ciaa/Hardware/README.md

Hardware
========

CIAA Hardware repository. It contains KiCad project files and documentation for each CIAA profile.

Folder structure:

[Doc](Doc): Common documents.

[PCB](PCB): KiCad PCB project files.

--[CIAA-ACC](PCB/ACC/CIAA_ACC): Xilinx Zynq XC7Z030 files.

--[EDU-FSL](PCB/EDU-FSL): EDU-CIAA-FSL (K60 MCU) files.

--[EDU-INTEL](PCB/EDU-INTEL): EDU-CIAA-INTEL (SOM Edison) files.

--[EDU-NXP](PCB/EDU-NXP): EDU-CIAA-NXP (LPC4337 MCU) files.

--[EDU-XILINX](PCB/EDU-XILINX): EDU-CIAA-XILINX (Artix7 FPGA) files.

--[FSL-MINI](PCB/FSL-MINI): CIAA-Freescale (K60 MCU) files.

--[FSL](PCB/FSL): CIAA-Freescale (K60 MCU) files.

--[NXP](PCB/NXP): CIAA-NXP (LPC4337 MCU) files.

--[PIC](PCB/PIC): CIAA-PIC (PIC32 MCU) files.

--[RX](PCB/RX): CIAA-Renesas files.

--[Safety](PCB/Safety): CIAA-Safety (RM48L952-PGE MCU) files.

--[Z3R0](PCB/Z3R0): CIAA-Z3R0 (EFM32HG MCU) files.

--[pico-CIAA](PCB/pico): pico-CIAA (LPC54102 MCU) files.
