ciaa/Hardware/PCB/Z3R0/README.md

# CIAA-Z3R0

Here you will find KiCad design files, [gerber files](gerbers) and [documentation](docs) for this board developed by Eric Pernia.

Also you can visit [CIAA-Z3R0 Wiki Page](http://www.proyecto-ciaa.com.ar/devwiki/doku.php?id=desarrollo:ciaa-z3r0).

 - [Authors](AUTHORS.md).
 - License: [CIAA Hardware license](LICENSE).

## Board description

This board is designed for low cost, low power consumption and robotics applications.

### Schematic

[Schematic in pdf](ciaa-z3r0.pdf)

board schematic

### 3D view

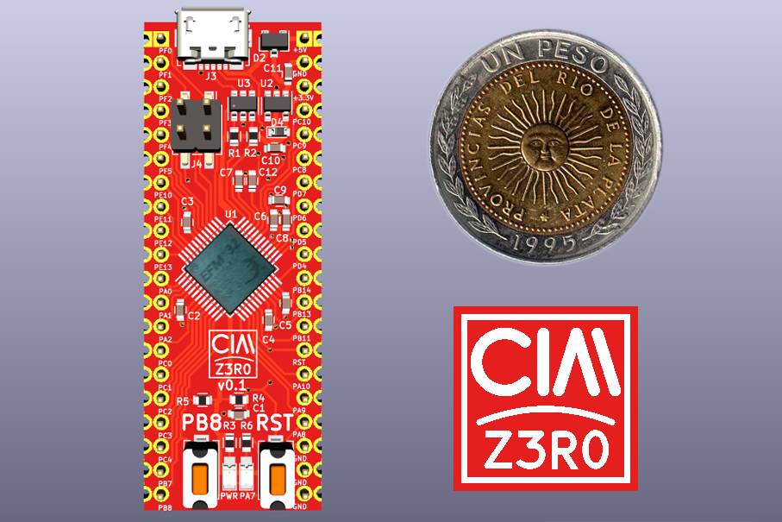
[picture p3: PCB/Z3R0/CIAA-Z3R0.png]
boar dimage
