ciaa/Hardware/PCB/ACC/CIAA_ACC/README.md

# CIAA-ACC

Here you will find KiCad design files, [gerber files](output_files) and some [documentation](doc) for this board
developed by [INTI Argentina](http://www.inti.gob.ar/) - [CMNB](http://www.inti.gob.ar/microynanoelectronica/) with the collaboration of [ACSE](http://www.sase.com.ar/asociacion-civil-sistemas-embebidos), [CADIEEL](http://www.cadieel.org.ar) and [Emtech S.A.](http://www.emtech.com.ar) as part of the [CIAA project](http://www.proyecto-ciaa.com.ar/).
Also you can visit [CIAA-ACC Wiki Page](http://www.proyecto-ciaa.com.ar/devwiki/doku.php?id=desarrollo:ciaa_acc:ciaa_acc_inicio).

 - [Authors](doc/AUTHORS.md).
 - License: [CIAA Hardware license](../../../LICENSE).
