ciaa/Hardware/PCB/FSL/CIAA_K60/doc/entradas_salidas/error_out_an.pdf

### Análsis sobre las salida analógica

El texto aquí presentado, tiene por finalidad analizar el funcionamiento en detalle del circuito de las salidas analógicas, comprender cuales son los elementos que causan el error mayor y elaborar una conclusión que justifique la elección de los componentes.

Circuito a analizar

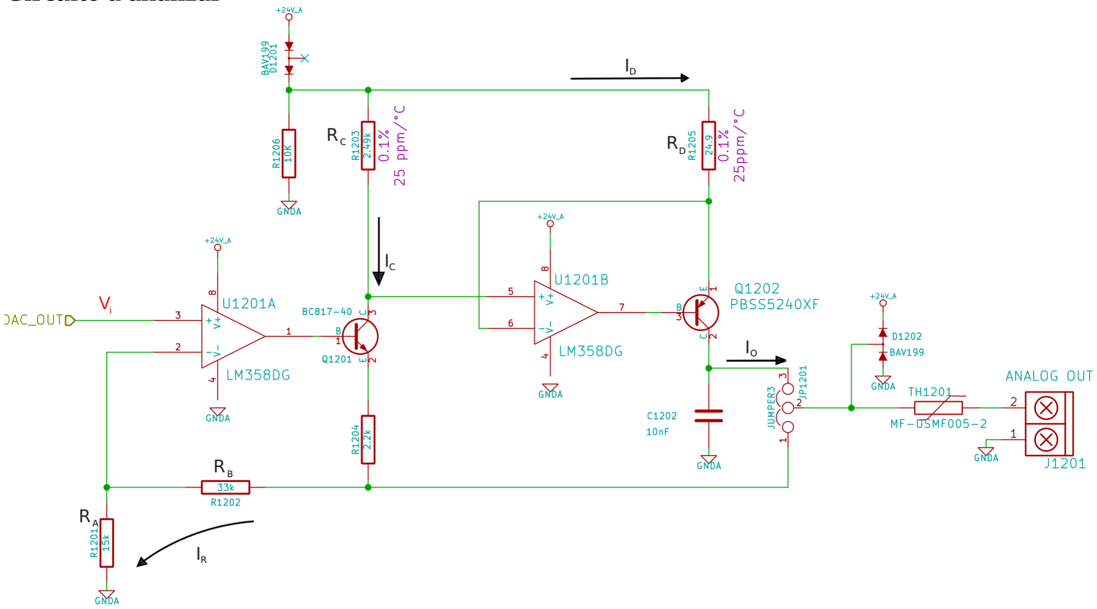
[picture p21: figure]

Si se toma al circuito ideal, pueden encontrarse las siguientes expresiones a través de su análisis:

I R=

Vi
RA
Si se estima que: IC≈I R

VR C=I R RC=VR D=I D RD

I D=I R

RC
RD

=Vi

RC
RA RD
Como I D≈I O

IO=Vi

RC
RA RD

Los 20mA se producen para una tensión de entrada de:

Vi

(20mA)=3V

Los 4 mA se producen para una tensión de entrada de: Vi

(4mA)=0,6V

Estimación de los errores:
A continuación, se resumen los elementos que provocan el mayor error en la conversión tensión/corriente, ya que en la conversión de

Error del DAC:
Teniendo un DAC de 12bit, el paso mínimo, con una tensión de alimentación de 3.3V es de: 805,664 µV. El error inferido por el DAC siempre será de medio bit, para el mejor de los casos, es decir de: 402,832 µV . Este error acompañará a Vi.

Error de Offset de los operacionales:
Para el LM358, a 25ºC, el offset máximo puede llegar a los 7mV.

Dispersión del hFE de los transistores:
El BC817 a 25ºC, tiene un hFE de 400
El PBSS5240XF a 25ºC, tiene un hFE de 450

Calculo real

I R=

Vi±(ΔV DAC+ΔV OP)
RA

Como: I R=

hfe1+1
hfe1

I C=

1
ΔQ1

IC

VR C=I C RC=Q1RC

Vi±(ΔV DAC +ΔV OP)
RA

I D=

V RC±ΔV OP
RD

=

Q1RC

Vi±(ΔV DAC+ΔV OP)
RA

±ΔV OP

RD

Como IO=I D

hfe2+1
hfe2

=I D Q2

IO=

Q1RC

Vi±(ΔV DAC+ΔV OP)
RA

±ΔV OP

RD

Q2

IO=Q1Q2RC

Vi
RA RD

±(Q1Q2

RC
(RA RD
)

(ΔV DAC+ΔV OP)+Q2

ΔV OP
RD

)

Puede verse en esta última expresión, que los transistores bipolares introducen una variación en el valor de la conversión de la corriente.
El corrimiento producido debido a los transistores, respecto al valor ideal absoluto, es:

EIOQ=100 %

Q1Q2RC

Vi
RA RD

−RC

Vi
RA RD

RC

Vi
RA RD

=100%(Q1Q2−1)

EI OQ=0,0278%
Mientras mayor sea el hFE de cada transistor, menor será este error.
Si se hacen las propagaciones de errores sobre la última expresión, se obtiene que el error relativo será:

EI O=

Δ I O
I O

=

Δ RA
RA

+

Δ RC
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
ΔV DAC
Vi

+

ΔV OP
Vi

+

ΔV OP
VR D

El error de cada resitencia será 0,1%, dado por el fabricante. Para los transistores, se sabe que:

Q1=

hfe1
hfe1+1

→

ΔQ1
Q1

=

Δhfe1
hfe1

(hfe1+1)

Si la dispersión del hfe puede causar una variación del 10% en el hfe, el error resulta:

ΔQ1
Q1

=0,025%

Q2=

hfe2+1
hfe2

→

ΔQ2
Q2

=

Δhfe 2
hfe2

(hfe2+1)

Si la dispersión del hfe puede causar una variación del 10% en el hfe, el error resulta:

ΔQ2
Q2

=0,0222%

El error del operacional y del DAC, se da para la mínima tensión de entrada, que son los 0,6V.
ΔV DAC

V DAC

=0,0671 %

ΔV OP
Vi

=1,1667%

ΔV OP
V RD

=

7mV
0,0996V

=7,0281%

El Error total de conversión, para la mínima corriente será:

EIO=

Δ I O
I O

=8,6091 %

Para el valor de máximo de corriente de salida (20mA) el error será:

EIO=

Δ I O
I O

=1,872%

Como puede observarse, todo el error se debe principalemente al operacional utilizado y son más severos mientras menor sea la tensión de entrada.

Conclusión:

En función de la precisión que se requiera en el circuito, deben tomarse precausiones en la elección de los componentes que introducen el mayor el error en la conversión. Ordenandolos según su participación en el error: Operacional, transistores, resolución del DAC .

Todos los errores introducidos por los operacionales y los transistores bipolares pueden reducirse por hardware, pero esto implica una calibración y puesta a punto de cada circuito antes de ser utilizado. Esto puede ser un ajuste mecánico al comienzo de su uso o una calibración por firmware. Una forma de reducir el error, mediante un circuito externo puede verse en:
Nulling Input Offset Voltage of Operational Amplifiers - Texas Instrument: http://www.ti.com/lit/an/sloa045/sloa045.pdf

Sería conveniente, para evitar esta puesta a punto, seleccionar operacionales con un offset de entrada menor a 1mV. Con estos, el error será menor al 2% para el caso más crítico.

También resulta conveniente utilizar FET en vez de BJT, para reducir más aún el error.
Se recomienda la nota
Convert 1 to 5V signal to 4-20mA output – EDN Network http://www.edn.com/design/power-management/4371307/Convert-1-to-5V-signal-to-4-to-20-mA-output (http://www.edn.com/design/power-management/4371307/Convert-1-to-5V-signal-to-4-to-20-mA-output)
