ciaa/Hardware/PCB/ACC/CIAA_ACC/doc/simulaciones/hyperlynx/Batch_report/ciaa_acc-Si.ods

Overview [Pass/Fail] | Net(s) | Coupled Net(s) | Driver(s) [RefDes.Pin] | Receiver [RefDes.Pin] | Simulation Corner | Rise Min Delay [ns] | Rise Max Delay [ns] | Rise Ref Time-to-Vmeas [ns] | Fall Min Delay [ns] | Fall Max Delay [ns] | Fall Ref Time-to-Vmeas [ns] | Flight Time Comp. [Yes/No] | Driver Meas [Pin/Die] | Receiver Meas [Pin/Die] | Diff Meas [Yes/No] | Rise Rail Overshoot [mV] | Rise Rail Overshoot Threshold [mV] | Rise Static Rail Overshoot Limit [mV] | Rise Static Rail Overshoot Margin [mV] | Rise Dynamic Rail Overshoot Limit [mV] | Rise Dynamic Rail Overshoot Margin [mV] | Rise Dynamic Rail Overshoot Time [ps] | Rise Dynamic Rail Overshoot Time Limit [ps] | Rise Dynamic Rail Overshoot Time Margin [ps] | Rise Rail Overshoot [Pass/Fail] | Rise SI Overshoot [mV] | Rise SI Overshoot [Pass/Fail] | Fall Rail Overshoot [mV] | Fall Rail Overshoot Threshold [mV] | Fall Static Rail Overshoot Limit [mV] | Fall Static Rail Overshoot Margin [mV] | Fall Dynamic Rail Overshoot Limit [mV] | Fall Dynamic Rail Overshoot Margin [mV] | Fall Dynamic Rail Overshoot Time [ps] | Fall Dynamic Rail Overshoot Time Limit [ps] | Fall Dynamic Rail Overshoot Time Margin [ps] | Fall Rail Overshoot [Pass/Fail] | Fall SI Overshoot [mV] | Fall SI Overshoot [Pass/Fail] | Ringback Delay [ps] | Rise Closest Ringback [mV] | Rise Closest Ringback Threshold [mV] | Rise Closest Ringback Limit [mV] | Rise Closest Ringback Margin [mV] | Fall Closest Ringback [mV] | Fall Closest Ringback Threshold [mV] | Fall Closest Ringback Limit [mV] | Fall Closest Ringback Margin [mV] | Ringback [Pass/Fail] | Rise/Fall Crosstalk [mV] | Rise/Fall Crosstalk Limit [mV] | Rise/Fall Crosstalk Margin [mV] | Rise/Fall Crosstalk [Pass/Fail] | Rise/Fall Monotonic [Pass/Fail] | Rise/Fall Multi Cross [Pass/Fail] | Rise/Fall Threshold [Pass/Fail] | Rise/Fall Delay Error [Pass/Fail] | Driver Model File | Driver Model Name
Pass | /Principal/BANK_502/DDR_A0 |  | U1.K22 | U2.N3 | Fast-Strong | 0,429 | 0,507 | 0,409 | 0,402 | 0,480 | 0,429 | Yes | Pin | Pin | No | -214 | 1575 | 300 | 514 | NA | NA | NA | NA | NA | Pass | 42 | Pass | -168 | 0 | 300 | 468 | NA | NA | NA | NA | NA | Pass | 39 | Pass | NA | NA | NA | NA | NA | NA | NA | NA | NA | Pass | NA | NA | NA | Pass | Pass | Pass | Pass | Pass | zynq_ddr3_diffpin.ibs | SSTL15_S_PSDDR
Pass | /Principal/BANK_502/DDR_A0 |  | U1.K22 | U3.N3 | Fast-Strong | 0,567 | 0,652 | 0,409 | 0,537 | 0,621 | 0,429 | Yes | Pin | Pin | No | -233 | 1575 | 300 | 533 | NA | NA | NA | NA | NA | Pass | 24 | Pass | -183 | 0 | 300 | 483 | NA | NA | NA | NA | NA | Pass | 25 | Pass | NA | NA | NA | NA | NA | NA | NA | NA | NA | Pass | NA | NA | NA | Pass | Pass | Pass | Pass | Pass | zynq_ddr3_diffpin.ibs | SSTL15_S_PSDDR
Pass | /Principal/BANK_502/DDR_A0 |  | U1.K22 | U2.N3 | Typical | 0,403 | 0,504 | 0,543 | 0,392 | 0,502 | 0,554 | Yes | Pin | Pin | No | -247 | 1500 | 300 | 547 | NA | NA | NA | NA | NA | Pass | 26 | Pass | -226 | 0 | 300 | 526 | NA | NA | NA | NA | NA | Pass | 21 | Pass | NA | NA | NA | NA | NA | NA | NA | NA | NA | Pass | NA | NA | NA | Pass | Pass | Pass | Pass | Pass | zynq_ddr3_diffpin.ibs | SSTL15_S_PSDDR
Pass | /Principal/BANK_502/DDR_A0 |  | U1.K22 | U3.N3 | Typical | 0,541 | 0,646 | 0,543 | 0,530 | 0,640 | 0,554 | Yes | Pin | Pin | No | -261 | 1500 | 300 | 561 | NA | NA | NA | NA | NA | Pass | 13 | Pass | -235 | 0 | 300 | 535 | NA | NA | NA | NA | NA | Pass | 12 | Pass | NA | NA | NA | NA | NA | NA | NA | NA | NA | Pass | NA | NA | NA | Pass | Pass | Pass | Pass | Pass | zynq_ddr3_diffpin.ibs | SSTL15_S_PSDDR
Pass | /Principal/BANK_502/DDR_A0 |  | U1.K22 | U2.N3 | Slow-Weak | 0,347 | 0,507 | 0,715 | 0,382 | 0,599 | 0,720 | Yes | Pin | Pin | No | -291 | 1425 | 300 | 591 | NA | NA | NA | NA | NA | Pass | 9 | Pass | -310 | 0 | 300 | 610 | NA | NA | NA | NA | NA | Pass | 4 | Pass | NA | NA | NA | NA | NA | NA | NA | NA | NA | Pass | NA | NA | NA | Pass | Pass | Pass | Pass | Pass | zynq_ddr3_diffpin.ibs | SSTL15_S_PSDDR
Pass | /Principal/BANK_502/DDR_A0 |  | U1.K22 | U3.N3 | Slow-Weak | 0,488 | 0,648 | 0,715 | 0,522 | 0,714 | 0,720 | Yes | Pin | Pin | No | -298 | 1425 | 300 | 598 | NA | NA | NA | NA | NA | Pass | 2 | Pass | -315 | 0 | 300 | 615 | NA | NA | NA | NA | NA | Pass | 0 | Pass | NA | NA | NA | NA | NA | NA | NA | NA | NA | Pass | NA | NA | NA | Pass | Pass | Pass | Pass | Pass | zynq_ddr3_diffpin.ibs | SSTL15_S_PSDDR
Pass | /Principal/BANK_502/DDR_A1 |  | U1.K20 | U2.P7 | Fast-Strong | 0,428 | 0,505 | 0,387 | 0,400 | 0,481 | 0,408 | Yes | Pin | Pin | No | -218 | 1575 | 300 | 518 | NA | NA | NA | NA | NA | Pass | 37 | Pass | -172 | 0 | 300 | 472 | NA | NA | NA | NA | NA | Pass | 34 | Pass | NA | NA | NA | NA | NA | NA | NA | NA | NA | Pass | NA | NA | NA | Pass | Pass | Pass | Pass | Pass | zynq_ddr3_diffpin.ibs | SSTL15_S_PSDDR
Pass | /Principal/BANK_502/DDR_A1 |  | U1.K20 | U3.P7 | Fast-Strong | 0,569 | 0,653 | 0,387 | 0,535 | 0,622 | 0,408 | Yes | Pin | Pin | No | -237 | 1575 | 300 | 537 | NA | NA | NA | NA | NA | Pass | 19 | Pass | -186 | 0 | 300 | 486 | NA | NA | NA | NA | NA | Pass | 21 | Pass | NA | NA | NA | NA | NA | NA | NA | NA | NA | Pass | NA | NA | NA | Pass | Pass | Pass | Pass | Pass | zynq_ddr3_diffpin.ibs | SSTL15_S_PSDDR
Pass | /Principal/BANK_502/DDR_A1 |  | U1.K20 | U2.P7 | Typical | 0,400 | 0,501 | 0,523 | 0,388 | 0,502 | 0,535 | Yes | Pin | Pin | No | -250 | 1500 | 300 | 550 | NA | NA | NA | NA | NA | Pass | 22 | Pass | -228 | 0 | 300 | 528 | NA | NA | NA | NA | NA | Pass | 18 | Pass | NA | NA | NA | NA | NA | NA | NA | NA | NA | Pass | NA | NA | NA | Pass | Pass | Pass | Pass | Pass | zynq_ddr3_diffpin.ibs | SSTL15_S_PSDDR
Pass | /Principal/BANK_502/DDR_A1 |  | U1.K20 | U3.P7 | Typical | 0,538 | 0,653 | 0,523 | 0,530 | 0,645 | 0,535 | Yes | Pin | Pin | No | -261 | 1500 | 300 | 561 | NA | NA | NA | NA | NA | Pass | 12 | Pass | -234 | 0 | 300 | 534 | NA | NA | NA | NA | NA | Pass | 12 | Pass | NA | NA | NA | NA | NA | NA | NA | NA | NA | Pass | NA | NA | NA | Pass | Pass | Pass | Pass | Pass | zynq_ddr3_diffpin.ibs | SSTL15_S_PSDDR
Pass | /Principal/BANK_502/DDR_A1 |  | U1.K20 | U2.P7 | Slow-Weak | 0,337 | 0,516 | 0,700 | 0,377 | 0,614 | 0,705 | Yes | Pin | Pin | No | -287 | 1425 | 300 | 587 | NA | NA | NA | NA | NA | Pass | 12 | Pass | -304 | 0 | 300 | 604 | NA | NA | NA | NA | NA | Pass | 10 | Pass | NA | NA | NA | NA | NA | NA | NA | NA | NA | Pass | NA | NA | NA | Pass | Pass | Pass | Pass | Pass | zynq_ddr3_diffpin.ibs | SSTL15_S_PSDDR
Pass | /Principal/BANK_502/DDR_A1 |  | U1.K20 | U3.P7 | Slow-Weak | 0,478 | 0,650 | 0,700 | 0,518 | 0,723 | 0,705 | Yes | Pin | Pin | No | -291 | 1425 | 300 | 591 | NA | NA | NA | NA | NA | Pass | 8 | Pass | -307 | 0 | 300 | 607 | NA | NA | NA | NA | NA | Pass | 8 | Pass | NA | NA | NA | NA | NA | NA | NA | NA | NA | Pass | NA | NA | NA | Pass | Pass | Pass | Pass | Pass | zynq_ddr3_diffpin.ibs | SSTL15_S_PSDDR
Pass | /Principal/BANK_502/DDR_A2 |  | U1.N21 | U2.P3 | Fast-Strong | 0,425 | 0,496 | 0,396 | 0,398 | 0,472 | 0,417 | Yes | Pin | Pin | No | -195 | 1575 | 300 | 495 | NA | NA | NA | NA | NA | Pass | 62 | Pass | -152 | 0 | 300 | 452 | NA | NA | NA | NA | NA | Pass | 55 | Pass | NA | NA | NA | NA | NA | NA | NA | NA | NA | Pass | NA | NA | NA | Pass | Pass | Pass | Pass | Pass | zynq_ddr3_diffpin.ibs | SSTL15_S_PSDDR
Pass | /Principal/BANK_502/DDR_A2 |  | U1.N21 | U3.P3 | Fast-Strong | 0,560 | 0,637 | 0,396 | 0,529 | 0,610 | 0,417 | Yes | Pin | Pin | No | -183 | 1575 | 300 | 483 | NA | NA | NA | NA | NA | Pass | 74 | Pass | -134 | 0 | 300 | 434 | NA | NA | NA | NA | NA | Pass | 74 | Pass | NA | NA | NA | NA | NA | NA | NA | NA | NA | Pass | NA | NA | NA | Pass | Pass | Pass | Pass | Pass | zynq_ddr3_diffpin.ibs | SSTL15_S_PSDDR
Pass | /Principal/BANK_502/DDR_A2 |  | U1.N21 | U2.P3 | Typical | 0,397 | 0,489 | 0,531 | 0,385 | 0,486 | 0,542 | Yes | Pin | Pin | No | -236 | 1500 | 300 | 536 | NA | NA | NA | NA | NA | Pass | 38 | Pass | -216 | 0 | 300 | 516 | NA | NA | NA | NA | NA | Pass | 31 | Pass | NA | NA | NA | NA | NA | NA | NA | NA | NA | Pass | NA | NA | NA | Pass | Pass | Pass | Pass | Pass | zynq_ddr3_diffpin.ibs | SSTL15_S_PSDDR
Pass | /Principal/BANK_502/DDR_A2 |  | U1.N21 | U3.P3 | Typical | 0,535 | 0,631 | 0,531 | 0,523 | 0,624 | 0,542 | Yes | Pin | Pin | No | -239 | 1500 | 300 | 539 | NA | NA | NA | NA | NA | Pass | 35 | Pass | -220 | 0 | 300 | 520 | NA | NA | NA | NA | NA | Pass | 28 | Pass | NA | NA | NA | NA | NA | NA | NA | NA | NA | Pass | NA | NA | NA | Pass | Pass | Pass | Pass | Pass | zynq_ddr3_diffpin.ibs | SSTL15_S_PSDDR
Pass | /Principal/BANK_502/DDR_A2 |  | U1.N21 | U2.P3 | Slow-Weak | 0,338 | 0,492 | 0,706 | 0,372 | 0,564 | 0,710 | Yes | Pin | Pin | No | -288 | 1425 | 300 | 588 | NA | NA | NA | NA | NA | Pass | 11 | Pass | -312 | 0 | 300 | 612 | NA | NA | NA | NA | NA | Pass | 3 | Pass | NA | NA | NA | NA | NA | NA | NA | NA | NA | Pass | NA | NA | NA | Pass | Pass | Pass | Pass | Pass | zynq_ddr3_diffpin.ibs | SSTL15_S_PSDDR
Pass | /Principal/BANK_502/DDR_A2 |  | U1.N21 | U3.P3 | Slow-Weak | 0,473 | 0,626 | 0,706 | 0,513 | 0,686 | 0,710 | Yes | Pin | Pin | No | -301 | 1425 | 300 | 601 | NA | NA | NA | NA | NA | Pass | 0 | Pass | -318 | 0 | 300 | 618 | NA | NA | NA | NA | NA | Pass | 0 | Pass | NA | NA | NA | NA | NA | NA | NA | NA | NA | Pass | NA | NA | NA | Pass | Pass | Pass | Pass | Pass | zynq_ddr3_diffpin.ibs | SSTL15_S_PSDDR
Pass | /Principal/BANK_502/DDR_A3 |  | U1.L22 | U2.N2 | Fast-Strong | 0,433 | 0,497 | 0,389 | 0,402 | 0,473 | 0,409 | Yes | Pin | Pin | No | -177 | 1575 | 300 | 477 | NA | NA | NA | NA | NA | Pass | 77 | Pass | -131 | 0 | 300 | 431 | NA | NA | NA | NA | NA | Pass | 74 | Pass | NA | NA | NA | NA | NA | NA | NA | NA | NA | Pass | NA | NA | NA | Pass | Pass | Pass | Pass | Pass | zynq_ddr3_diffpin.ibs | SSTL15_S_PSDDR
Pass | /Principal/BANK_502/DDR_A3 |  | U1.L22 | U3.N2 | Fast-Strong | 0,557 | 0,638 | 0,389 | 0,527 | 0,611 | 0,409 | Yes | Pin | Pin | No | -208 | 1575 | 300 | 508 | NA | NA | NA | NA | NA | Pass | 47 | Pass | -156 | 0 | 300 | 456 | NA | NA | NA | NA | NA | Pass | 50 | Pass | NA | NA | NA | NA | NA | NA | NA | NA | NA | Pass | NA | NA | NA | Pass | Pass | Pass | Pass | Pass | zynq_ddr3_diffpin.ibs | SSTL15_S_PSDDR
Pass | /Principal/BANK_502/DDR_A3 |  | U1.L22 | U2.N2 | Typical | 0,404 | 0,496 | 0,524 | 0,392 | 0,497 | 0,536 | Yes | Pin | Pin | No | -231 | 1500 | 300 | 531 | NA | NA | NA | NA | NA | Pass | 41 | Pass | -210 | 0 | 300 | 510 | NA | NA | NA | NA | NA | Pass | 35 | Pass | NA | NA | NA | NA | NA | NA | NA | NA | NA | Pass | NA | NA | NA | Pass | Pass | Pass | Pass | Pass | zynq_ddr3_diffpin.ibs | SSTL15_S_PSDDR
Pass | /Principal/BANK_502/DDR_A3 |  | U1.L22 | U3.N2 | Typical | 0,528 | 0,633 | 0,524 | 0,520 | 0,630 | 0,536 | Yes | Pin | Pin | No | -252 | 1500 | 300 | 552 | NA | NA | NA | NA | NA | Pass | 21 | Pass | -224 | 0 | 300 | 524 | NA | NA | NA | NA | NA | Pass | 22 | Pass | NA | NA | NA | NA | NA | NA | NA | NA | NA | Pass | NA | NA | NA | Pass | Pass | Pass | Pass | Pass | zynq_ddr3_diffpin.ibs | SSTL15_S_PSDDR
Pass | /Principal/BANK_502/DDR_A3 |  | U1.L22 | U2.N2 | Slow-Weak | 0,343 | 0,510 | 0,701 | 0,371 | 0,614 | 0,705 | Yes | Pin | Pin | No | -290 | 1425 | 300 | 590 | NA | NA | NA | NA | NA | Pass | 9 | Pass | -307 | 0 | 300 | 607 | NA | NA | NA | NA | NA | Pass | 6 | Pass | NA | NA | NA | NA | NA | NA | NA | NA | NA | Pass | NA | NA | NA | Pass | Pass | Pass | Pass | Pass | zynq_ddr3_diffpin.ibs | SSTL15_S_PSDDR
Pass | /Principal/BANK_502/DDR_A3 |  | U1.L22 | U3.N2 | Slow-Weak | 0,471 | 0,631 | 0,701 | 0,505 | 0,697 | 0,705 | Yes | Pin | Pin | No | -300 | 1425 | 300 | 600 | NA | NA | NA | NA | NA | Pass | 0 | Pass | -315 | 0 | 300 | 615 | NA | NA | NA | NA | NA | Pass | 0 | Pass | NA | NA | NA | NA | NA | NA | NA | NA | NA | Pass | NA | NA | NA | Pass | Pass | Pass | Pass | Pass | zynq_ddr3_diffpin.ibs | SSTL15_S_PSDDR
Pass | /Principal/BANK_502/DDR_A4 |  | U1.M20 | U2.P8 | Fast-Strong | 0,430 | 0,507 | 0,399 | 0,403 | 0,480 | 0,419 | Yes | Pin | Pin | No | -216 | 1575 | 300 | 516 | NA | NA | NA | NA | NA | Pass | 40 | Pass | -168 | 0 | 300 | 468 | NA | NA | NA | NA | NA | Pass | 38 | Pass | NA | NA | NA | NA | NA | NA | NA | NA | NA | Pass | NA | NA | NA | Pass | Pass | Pass | Pass | Pass | zynq_ddr3_diffpin.ibs | SSTL15_S_PSDDR
Pass | /Principal/BANK_502/DDR_A4 |  | U1.M20 | U3.P8 | Fast-Strong | 0,571 | 0,655 | 0,399 | 0,538 | 0,625 | 0,419 | Yes | Pin | Pin | No | -232 | 1575 | 300 | 532 | NA | NA | NA | NA | NA | Pass | 24 | Pass | -181 | 0 | 300 | 481 | NA | NA | NA | NA | NA | Pass | 26 | Pass | NA | NA | NA | NA | NA | NA | NA | NA | NA | Pass | NA | NA | NA | Pass | Pass | Pass | Pass | Pass | zynq_ddr3_diffpin.ibs | SSTL15_S_PSDDR
Pass | /Principal/BANK_502/DDR_A4 |  | U1.M20 | U2.P8 | Typical | 0,404 | 0,501 | 0,533 | 0,393 | 0,503 | 0,544 | Yes | Pin | Pin | No | -247 | 1500 | 300 | 547 | NA | NA | NA | NA | NA | Pass | 26 | Pass | -225 | 0 | 300 | 525 | NA | NA | NA | NA | NA | Pass | 21 | Pass | NA | NA | NA | NA | NA | NA | NA | NA | NA | Pass | NA | NA | NA | Pass | Pass | Pass | Pass | Pass | zynq_ddr3_diffpin.ibs | SSTL15_S_PSDDR
Pass | /Principal/BANK_502/DDR_A4 |  | U1.M20 | U3.P8 | Typical | 0,542 | 0,652 | 0,533 | 0,531 | 0,646 | 0,544 | Yes | Pin | Pin | No | -260 | 1500 | 300 | 560 | NA | NA | NA | NA | NA | Pass | 14 | Pass | -233 | 0 | 300 | 533 | NA | NA | NA | NA | NA | Pass | 14 | Pass | NA | NA | NA | NA | NA | NA | NA | NA | NA | Pass | NA | NA | NA | Pass | Pass | Pass | Pass | Pass | zynq_ddr3_diffpin.ibs | SSTL15_S_PSDDR
Pass | /Principal/BANK_502/DDR_A4 |  | U1.M20 | U2.P8 | Slow-Weak | 0,344 | 0,516 | 0,706 | 0,378 | 0,614 | 0,711 | Yes | Pin | Pin | No | -286 | 1425 | 300 | 586 | NA | NA | NA | NA | NA | Pass | 14 | Pass | -304 | 0 | 300 | 604 | NA | NA | NA | NA | NA | Pass | 10 | Pass | NA | NA | NA | NA | NA | NA | NA | NA | NA | Pass | NA | NA | NA | Pass | Pass | Pass | Pass | Pass | zynq_ddr3_diffpin.ibs | SSTL15_S_PSDDR
Pass | /Principal/BANK_502/DDR_A4 |  | U1.M20 | U3.P8 | Slow-Weak | 0,484 | 0,651 | 0,706 | 0,525 | 0,723 | 0,711 | Yes | Pin | Pin | No | -292 | 1425 | 300 | 592 | NA | NA | NA | NA | NA | Pass | 7 | Pass | -308 | 0 | 300 | 608 | NA | NA | NA | NA | NA | Pass | 6 | Pass | NA | NA | NA | NA | NA | NA | NA | NA | NA | Pass | NA | NA | NA | Pass | Pass | Pass | Pass | Pass | zynq_ddr3_diffpin.ibs | SSTL15_S_PSDDR
Pass | /Principal/BANK_502/DDR_A5 |  | U1.N22 | U2.P2 | Fast-Strong | 0,430 | 0,501 | 0,395 | 0,403 | 0,477 | 0,416 | Yes | Pin | Pin | No | -192 | 1575 | 300 | 492 | NA | NA | NA | NA | NA | Pass | 64 | Pass | -142 | 0 | 300 | 442 | NA | NA | NA | NA | NA | Pass | 64 | Pass | NA | NA | NA | NA | NA | NA | NA | NA | NA | Pass | NA | NA | NA | Pass | Pass | Pass | Pass | Pass | zynq_ddr3_diffpin.ibs | SSTL15_S_PSDDR
Pass | /Principal/BANK_502/DDR_A5 |  | U1.N22 | U3.P2 | Fast-Strong | 0,558 | 0,639 | 0,395 | 0,527 | 0,611 | 0,416 | Yes | Pin | Pin | No | -218 | 1575 | 300 | 518 | NA | NA | NA | NA | NA | Pass | 39 | Pass | -162 | 0 | 300 | 462 | NA | NA | NA | NA | NA | Pass | 45 | Pass | NA | NA | NA | NA | NA | NA | NA | NA | NA | Pass | NA | NA | NA | Pass | Pass | Pass | Pass | Pass | zynq_ddr3_diffpin.ibs | SSTL15_S_PSDDR
Pass | /Principal/BANK_502/DDR_A5 |  | U1.N22 | U2.P2 | Typical | 0,402 | 0,499 | 0,530 | 0,390 | 0,501 | 0,542 | Yes | Pin | Pin | No | -238 | 1500 | 300 | 538 | NA | NA | NA | NA | NA | Pass | 35 | Pass | -214 | 0 | 300 | 514 | NA | NA | NA | NA | NA | Pass | 32 | Pass | NA | NA | NA | NA | NA | NA | NA | NA | NA | Pass | NA | NA | NA | Pass | Pass | Pass | Pass | Pass | zynq_ddr3_diffpin.ibs | SSTL15_S_PSDDR
Pass | /Principal/BANK_502/DDR_A5 |  | U1.N22 | U3.P2 | Typical | 0,531 | 0,637 | 0,530 | 0,519 | 0,629 | 0,542 | Yes | Pin | Pin | No | -258 | 1500 | 300 | 558 | NA | NA | NA | NA | NA | Pass | 16 | Pass | -228 | 0 | 300 | 528 | NA | NA | NA | NA | NA | Pass | 19 | Pass | NA | NA | NA | NA | NA | NA | NA | NA | NA | Pass | NA | NA | NA | Pass | Pass | Pass | Pass | Pass | zynq_ddr3_diffpin.ibs | SSTL15_S_PSDDR
Pass | /Principal/BANK_502/DDR_A5 |  | U1.N22 | U2.P2 | Slow-Weak | 0,337 | 0,510 | 0,707 | 0,377 | 0,620 | 0,712 | Yes | Pin | Pin | No | -293 | 1425 | 300 | 593 | NA | NA | NA | NA | NA | Pass | 6 | Pass | -310 | 0 | 300 | 610 | NA | NA | NA | NA | NA | Pass | 4 | Pass | NA | NA | NA | NA | NA | NA | NA | NA | NA | Pass | NA | NA | NA | Pass | Pass | Pass | Pass | Pass | zynq_ddr3_diffpin.ibs | SSTL15_S_PSDDR
Pass | /Principal/BANK_502/DDR_A5 |  | U1.N22 | U3.P2 | Slow-Weak | 0,471 | 0,631 | 0,707 | 0,511 | 0,697 | 0,712 | Yes | Pin | Pin | No | -299 | 1425 | 300 | 599 | NA | NA | NA | NA | NA | Pass | 1 | Pass | -312 | 0 | 300 | 612 | NA | NA | NA | NA | NA | Pass | 3 | Pass | NA | NA | NA | NA | NA | NA | NA | NA | NA | Pass | NA | NA | NA | Pass | Pass | Pass | Pass | Pass | zynq_ddr3_diffpin.ibs | SSTL15_S_PSDDR
Pass | /Principal/BANK_502/DDR_A6 |  | U1.L20 | U2.R8 | Fast-Strong | 0,429 | 0,500 | 0,399 | 0,399 | 0,476 | 0,419 | Yes | Pin | Pin | No | -215 | 1575 | 300 | 515 | NA | NA | NA | NA | NA | Pass | 41 | Pass | -168 | 0 | 300 | 468 | NA | NA | NA | NA | NA | Pass | 39 | Pass | NA | NA | NA | NA | NA | NA | NA | NA | NA | Pass | NA | NA | NA | Pass | Pass | Pass | Pass | Pass | zynq_ddr3_diffpin.ibs | SSTL15_S_PSDDR
Pass | /Principal/BANK_502/DDR_A6 |  | U1.L20 | U3.R8 | Fast-Strong | 0,571 | 0,655 | 0,399 | 0,537 | 0,624 | 0,419 | Yes | Pin | Pin | No | -235 | 1575 | 300 | 535 | NA | NA | NA | NA | NA | Pass | 22 | Pass | -186 | 0 | 300 | 486 | NA | NA | NA | NA | NA | Pass | 22 | Pass | NA | NA | NA | NA | NA | NA | NA | NA | NA | Pass | NA | NA | NA | Pass | Pass | Pass | Pass | Pass | zynq_ddr3_diffpin.ibs | SSTL15_S_PSDDR
Pass | /Principal/BANK_502/DDR_A6 |  | U1.L20 | U2.R8 | Typical | 0,403 | 0,495 | 0,533 | 0,392 | 0,497 | 0,545 | Yes | Pin | Pin | No | -250 | 1500 | 300 | 550 | NA | NA | NA | NA | NA | Pass | 23 | Pass | -229 | 0 | 300 | 529 | NA | NA | NA | NA | NA | Pass | 18 | Pass | NA | NA | NA | NA | NA | NA | NA | NA | NA | Pass | NA | NA | NA | Pass | Pass | Pass | Pass | Pass | zynq_ddr3_diffpin.ibs | SSTL15_S_PSDDR
Pass | /Principal/BANK_502/DDR_A6 |  | U1.L20 | U3.R8 | Typical | 0,541 | 0,651 | 0,533 | 0,530 | 0,644 | 0,545 | Yes | Pin | Pin | No | -267 | 1500 | 300 | 567 | NA | NA | NA | NA | NA | Pass | 7 | Pass | -240 | 0 | 300 | 540 | NA | NA | NA | NA | NA | Pass | 7 | Pass | NA | NA | NA | NA | NA | NA | NA | NA | NA | Pass | NA | NA | NA | Pass | Pass | Pass | Pass | Pass | zynq_ddr3_diffpin.ibs | SSTL15_S_PSDDR
Pass | /Principal/BANK_502/DDR_A6 |  | U1.L20 | U2.R8 | Slow-Weak | 0,341 | 0,502 | 0,709 | 0,375 | 0,586 | 0,713 | Yes | Pin | Pin | No | -289 | 1425 | 300 | 589 | NA | NA | NA | NA | NA | Pass | 11 | Pass | -306 | 0 | 300 | 606 | NA | NA | NA | NA | NA | Pass | 8 | Pass | NA | NA | NA | NA | NA | NA | NA | NA | NA | Pass | NA | NA | NA | Pass | Pass | Pass | Pass | Pass | zynq_ddr3_diffpin.ibs | SSTL15_S_PSDDR
Pass | /Principal/BANK_502/DDR_A6 |  | U1.L20 | U3.R8 | Slow-Weak | 0,489 | 0,649 | 0,709 | 0,522 | 0,714 | 0,713 | Yes | Pin | Pin | No | -295 | 1425 | 300 | 595 | NA | NA | NA | NA | NA | Pass | 5 | Pass | -309 | 0 | 300 | 609 | NA | NA | NA | NA | NA | Pass | 6 | Pass | NA | NA | NA | NA | NA | NA | NA | NA | NA | Pass | NA | NA | NA | Pass | Pass | Pass | Pass | Pass | zynq_ddr3_diffpin.ibs | SSTL15_S_PSDDR
Pass | /Principal/BANK_502/DDR_A7 |  | U1.J21 | U2.R2 | Fast-Strong | 0,418 | 0,492 | 0,407 | 0,387 | 0,465 | 0,428 | Yes | Pin | Pin | No | -191 | 1575 | 300 | 491 | NA | NA | NA | NA | NA | Pass | 65 | Pass | -141 | 0 | 300 | 441 | NA | NA | NA | NA | NA | Pass | 66 | Pass | NA | NA | NA | NA | NA | NA | NA | NA | NA | Pass | NA | NA | NA | Pass | Pass | Pass | Pass | Pass | zynq_ddr3_diffpin.ibs | SSTL15_S_PSDDR
Pass | /Principal/BANK_502/DDR_A7 |  | U1.J21 | U3.R2 | Fast-Strong | 0,546 | 0,633 | 0,407 | 0,515 | 0,603 | 0,428 | Yes | Pin | Pin | No | -214 | 1575 | 300 | 514 | NA | NA | NA | NA | NA | Pass | 43 | Pass | -162 | 0 | 300 | 462 | NA | NA | NA | NA | NA | Pass | 46 | Pass | NA | NA | NA | NA | NA | NA | NA | NA | NA | Pass | NA | NA | NA | Pass | Pass | Pass | Pass | Pass | zynq_ddr3_diffpin.ibs | SSTL15_S_PSDDR
Pass | /Principal/BANK_502/DDR_A7 |  | U1.J21 | U2.R2 | Typical | 0,391 | 0,492 | 0,541 | 0,380 | 0,490 | 0,552 | Yes | Pin | Pin | No | -234 | 1500 | 300 | 534 | NA | NA | NA | NA | NA | Pass | 39 | Pass | -211 | 0 | 300 | 511 | NA | NA | NA | NA | NA | Pass | 36 | Pass | NA | NA | NA | NA | NA | NA | NA | NA | NA | Pass | NA | NA | NA | Pass | Pass | Pass | Pass | Pass | zynq_ddr3_diffpin.ibs | SSTL15_S_PSDDR
Pass | /Principal/BANK_502/DDR_A7 |  | U1.J21 | U3.R2 | Typical | 0,520 | 0,630 | 0,541 | 0,509 | 0,624 | 0,552 | Yes | Pin | Pin | No | -252 | 1500 | 300 | 552 | NA | NA | NA | NA | NA | Pass | 22 | Pass | -226 | 0 | 300 | 526 | NA | NA | NA | NA | NA | Pass | 21 | Pass | NA | NA | NA | NA | NA | NA | NA | NA | NA | Pass | NA | NA | NA | Pass | Pass | Pass | Pass | Pass | zynq_ddr3_diffpin.ibs | SSTL15_S_PSDDR
Pass | /Principal/BANK_502/DDR_A7 |  | U1.J21 | U2.R2 | Slow-Weak | 0,330 | 0,503 | 0,713 | 0,371 | 0,621 | 0,717 | Yes | Pin | Pin | No | -284 | 1425 | 300 | 584 | NA | NA | NA | NA | NA | Pass | 15 | Pass | -301 | 0 | 300 | 601 | NA | NA | NA | NA | NA | Pass | 13 | Pass | NA | NA | NA | NA | NA | NA | NA | NA | NA | Pass | NA | NA | NA | Pass | Pass | Pass | Pass | Pass | zynq_ddr3_diffpin.ibs | SSTL15_S_PSDDR
Pass | /Principal/BANK_502/DDR_A7 |  | U1.J21 | U3.R2 | Slow-Weak | 0,465 | 0,631 | 0,713 | 0,506 | 0,691 | 0,717 | Yes | Pin | Pin | No | -282 | 1425 | 300 | 582 | NA | NA | NA | NA | NA | Pass | 18 | Pass | -298 | 0 | 300 | 598 | NA | NA | NA | NA | NA | Pass | 17 | Pass | NA | NA | NA | NA | NA | NA | NA | NA | NA | Pass | NA | NA | NA | Pass | Pass | Pass | Pass | Pass | zynq_ddr3_diffpin.ibs | SSTL15_S_PSDDR
Pass | /Principal/BANK_502/DDR_A8 |  | U1.T20 | U2.T8 | Fast-Strong | 0,405 | 0,476 | 0,407 | 0,375 | 0,452 | 0,427 | Yes | Pin | Pin | No | -215 | 1575 | 300 | 515 | NA | NA | NA | NA | NA | Pass | 41 | Pass | -166 | 0 | 300 | 466 | NA | NA | NA | NA | NA | Pass | 41 | Pass | NA | NA | NA | NA | NA | NA | NA | NA | NA | Pass | NA | NA | NA | Pass | Pass | Pass | Pass | Pass | zynq_ddr3_diffpin.ibs | SSTL15_S_PSDDR
Pass | /Principal/BANK_502/DDR_A8 |  | U1.T20 | U3.T8 | Fast-Strong | 0,543 | 0,631 | 0,407 | 0,513 | 0,600 | 0,427 | Yes | Pin | Pin | No | -224 | 1575 | 300 | 524 | NA | NA | NA | NA | NA | Pass | 33 | Pass | -175 | 0 | 300 | 475 | NA | NA | NA | NA | NA | Pass | 33 | Pass | NA | NA | NA | NA | NA | NA | NA | NA | NA | Pass | NA | NA | NA | Pass | Pass | Pass | Pass | Pass | zynq_ddr3_diffpin.ibs | SSTL15_S_PSDDR
Pass | /Principal/BANK_502/DDR_A8 |  | U1.T20 | U2.T8 | Typical | 0,378 | 0,470 | 0,540 | 0,367 | 0,468 | 0,551 | Yes | Pin | Pin | No | -252 | 1500 | 300 | 552 | NA | NA | NA | NA | NA | Pass | 21 | Pass | -229 | 0 | 300 | 529 | NA | NA | NA | NA | NA | Pass | 17 | Pass | NA | NA | NA | NA | NA | NA | NA | NA | NA | Pass | NA | NA | NA | Pass | Pass | Pass | Pass | Pass | zynq_ddr3_diffpin.ibs | SSTL15_S_PSDDR
Pass | /Principal/BANK_502/DDR_A8 |  | U1.T20 | U3.T8 | Typical | 0,516 | 0,626 | 0,540 | 0,510 | 0,620 | 0,551 | Yes | Pin | Pin | No | -270 | 1500 | 300 | 570 | NA | NA | NA | NA | NA | Pass | 4 | Pass | -243 | 0 | 300 | 543 | NA | NA | NA | NA | NA | Pass | 4 | Pass | NA | NA | NA | NA | NA | NA | NA | NA | NA | Pass | NA | NA | NA | Pass | Pass | Pass | Pass | Pass | zynq_ddr3_diffpin.ibs | SSTL15_S_PSDDR
Pass | /Principal/BANK_502/DDR_A8 |  | U1.T20 | U2.T8 | Slow-Weak | 0,319 | 0,479 | 0,712 | 0,353 | 0,552 | 0,716 | Yes | Pin | Pin | No | -293 | 1425 | 300 | 593 | NA | NA | NA | NA | NA | Pass | 7 | Pass | -308 | 0 | 300 | 608 | NA | NA | NA | NA | NA | Pass | 6 | Pass | NA | NA | NA | NA | NA | NA | NA | NA | NA | Pass | NA | NA | NA | Pass | Pass | Pass | Pass | Pass | zynq_ddr3_diffpin.ibs | SSTL15_S_PSDDR
Pass | /Principal/BANK_502/DDR_A8 |  | U1.T20 | U3.T8 | Slow-Weak | 0,466 | 0,626 | 0,712 | 0,500 | 0,686 | 0,716 | Yes | Pin | Pin | No | -293 | 1425 | 300 | 593 | NA | NA | NA | NA | NA | Pass | 7 | Pass | -308 | 0 | 300 | 608 | NA | NA | NA | NA | NA | Pass | 6 | Pass | NA | NA | NA | NA | NA | NA | NA | NA | NA | Pass | NA | NA | NA | Pass | Pass | Pass | Pass | Pass | zynq_ddr3_diffpin.ibs | SSTL15_S_PSDDR
Pass | /Principal/BANK_502/DDR_A9 |  | U1.U20 | U2.R3 | Fast-Strong | 0,433 | 0,507 | 0,415 | 0,403 | 0,480 | 0,436 | Yes | Pin | Pin | No | -184 | 1575 | 300 | 484 | NA | NA | NA | NA | NA | Pass | 73 | Pass | -135 | 0 | 300 | 435 | NA | NA | NA | NA | NA | Pass | 73 | Pass | NA | NA | NA | NA | NA | NA | NA | NA | NA | Pass | NA | NA | NA | Pass | Pass | Pass | Pass | Pass | zynq_ddr3_diffpin.ibs | SSTL15_S_PSDDR
Pass | /Principal/BANK_502/DDR_A9 |  | U1.U20 | U3.R3 | Fast-Strong | 0,561 | 0,645 | 0,415 | 0,531 | 0,618 | 0,436 | Yes | Pin | Pin | No | -211 | 1575 | 300 | 511 | NA | NA | NA | NA | NA | Pass | 47 | Pass | -156 | 0 | 300 | 456 | NA | NA | NA | NA | NA | Pass | 53 | Pass | NA | NA | NA | NA | NA | NA | NA | NA | NA | Pass | NA | NA | NA | Pass | Pass | Pass | Pass | Pass | zynq_ddr3_diffpin.ibs | SSTL15_S_PSDDR
Pass | /Principal/BANK_502/DDR_A9 |  | U1.U20 | U2.R3 | Typical | 0,406 | 0,502 | 0,549 | 0,395 | 0,505 | 0,560 | Yes | Pin | Pin | No | -232 | 1500 | 300 | 532 | NA | NA | NA | NA | NA | Pass | 42 | Pass | -208 | 0 | 300 | 508 | NA | NA | NA | NA | NA | Pass | 39 | Pass | NA | NA | NA | NA | NA | NA | NA | NA | NA | Pass | NA | NA | NA | Pass | Pass | Pass | Pass | Pass | zynq_ddr3_diffpin.ibs | SSTL15_S_PSDDR
Pass | /Principal/BANK_502/DDR_A9 |  | U1.U20 | U3.R3 | Typical | 0,534 | 0,645 | 0,549 | 0,524 | 0,638 | 0,560 | Yes | Pin | Pin | No | -250 | 1500 | 300 | 550 | NA | NA | NA | NA | NA | Pass | 25 | Pass | -222 | 0 | 300 | 522 | NA | NA | NA | NA | NA | Pass | 27 | Pass | NA | NA | NA | NA | NA | NA | NA | NA | NA | Pass | NA | NA | NA | Pass | Pass | Pass | Pass | Pass | zynq_ddr3_diffpin.ibs | SSTL15_S_PSDDR
Pass | /Principal/BANK_502/DDR_A9 |  | U1.U20 | U2.R3 | Slow-Weak | 0,348 | 0,521 | 0,721 | 0,382 | 0,638 | 0,725 | Yes | Pin | Pin | No | -282 | 1425 | 300 | 582 | NA | NA | NA | NA | NA | Pass | 18 | Pass | -300 | 0 | 300 | 600 | NA | NA | NA | NA | NA | Pass | 15 | Pass | NA | NA | NA | NA | NA | NA | NA | NA | NA | Pass | NA | NA | NA | Pass | Pass | Pass | Pass | Pass | zynq_ddr3_diffpin.ibs | SSTL15_S_PSDDR
Pass | /Principal/BANK_502/DDR_A9 |  | U1.U20 | U3.R3 | Slow-Weak | 0,483 | 0,649 | 0,721 | 0,517 | 0,709 | 0,725 | Yes | Pin | Pin | No | -287 | 1425 | 300 | 587 | NA | NA | NA | NA | NA | Pass | 13 | Pass | -301 | 0 | 300 | 601 | NA | NA | NA | NA | NA | Pass | 15 | Pass | NA | NA | NA | NA | NA | NA | NA | NA | NA | Pass | NA | NA | NA | Pass | Pass | Pass | Pass | Pass | zynq_ddr3_diffpin.ibs | SSTL15_S_PSDDR
Pass | /Principal/BANK_502/DDR_A10 |  | U1.M22 | U2.L7 | Fast-Strong | 0,429 | 0,496 | 0,396 | 0,402 | 0,472 | 0,417 | Yes | Pin | Pin | No | -209 | 1575 | 300 | 509 | NA | NA | NA | NA | NA | Pass | 47 | Pass | -168 | 0 | 300 | 468 | NA | NA | NA | NA | NA | Pass | 39 | Pass | NA | NA | NA | NA | NA | NA | NA | NA | NA | Pass | NA | NA | NA | Pass | Pass | Pass | Pass | Pass | zynq_ddr3_diffpin.ibs | SSTL15_S_PSDDR
Pass | /Principal/BANK_502/DDR_A10 |  | U1.M22 | U3.L7 | Fast-Strong | 0,560 | 0,634 | 0,396 | 0,530 | 0,607 | 0,417 | Yes | Pin | Pin | No | -231 | 1575 | 300 | 531 | NA | NA | NA | NA | NA | Pass | 25 | Pass | -182 | 0 | 300 | 482 | NA | NA | NA | NA | NA | Pass | 26 | Pass | NA | NA | NA | NA | NA | NA | NA | NA | NA | Pass | NA | NA | NA | Pass | Pass | Pass | Pass | Pass | zynq_ddr3_diffpin.ibs | SSTL15_S_PSDDR
Pass | /Principal/BANK_502/DDR_A10 |  | U1.M22 | U2.L7 | Typical | 0,402 | 0,498 | 0,531 | 0,390 | 0,495 | 0,543 | Yes | Pin | Pin | No | -247 | 1500 | 300 | 547 | NA | NA | NA | NA | NA | Pass | 26 | Pass | -228 | 0 | 300 | 528 | NA | NA | NA | NA | NA | Pass | 18 | Pass | NA | NA | NA | NA | NA | NA | NA | NA | NA | Pass | NA | NA | NA | Pass | Pass | Pass | Pass | Pass | zynq_ddr3_diffpin.ibs | SSTL15_S_PSDDR
Pass | /Principal/BANK_502/DDR_A10 |  | U1.M22 | U3.L7 | Typical | 0,530 | 0,631 | 0,531 | 0,518 | 0,628 | 0,543 | Yes | Pin | Pin | No | -259 | 1500 | 300 | 559 | NA | NA | NA | NA | NA | Pass | 15 | Pass | -235 | 0 | 300 | 535 | NA | NA | NA | NA | NA | Pass | 12 | Pass | NA | NA | NA | NA | NA | NA | NA | NA | NA | Pass | NA | NA | NA | Pass | Pass | Pass | Pass | Pass | zynq_ddr3_diffpin.ibs | SSTL15_S_PSDDR
Pass | /Principal/BANK_502/DDR_A10 |  | U1.M22 | U2.L7 | Slow-Weak | 0,336 | 0,509 | 0,707 | 0,370 | 0,594 | 0,712 | Yes | Pin | Pin | No | -290 | 1425 | 300 | 590 | NA | NA | NA | NA | NA | Pass | 9 | Pass | -309 | 0 | 300 | 609 | NA | NA | NA | NA | NA | Pass | 5 | Pass | NA | NA | NA | NA | NA | NA | NA | NA | NA | Pass | NA | NA | NA | Pass | Pass | Pass | Pass | Pass | zynq_ddr3_diffpin.ibs | SSTL15_S_PSDDR
Pass | /Principal/BANK_502/DDR_A10 |  | U1.M22 | U3.L7 | Slow-Weak | 0,471 | 0,631 | 0,707 | 0,504 | 0,696 | 0,712 | Yes | Pin | Pin | No | -298 | 1425 | 300 | 598 | NA | NA | NA | NA | NA | Pass | 2 | Pass | -316 | 0 | 300 | 616 | NA | NA | NA | NA | NA | Pass | 0 | Pass | NA | NA | NA | NA | NA | NA | NA | NA | NA | Pass | NA | NA | NA | Pass | Pass | Pass | Pass | Pass | zynq_ddr3_diffpin.ibs | SSTL15_S_PSDDR
Pass | /Principal/BANK_502/DDR_A11 |  | U1.H21 | U2.R7 | Fast-Strong | 0,390 | 0,467 | 0,408 | 0,363 | 0,444 | 0,429 | Yes | Pin | Pin | No | -213 | 1575 | 300 | 513 | NA | NA | NA | NA | NA | Pass | 43 | Pass | -164 | 0 | 300 | 464 | NA | NA | NA | NA | NA | Pass | 42 | Pass | NA | NA | NA | NA | NA | NA | NA | NA | NA | Pass | NA | NA | NA | Pass | Pass | Pass | Pass | Pass | zynq_ddr3_diffpin.ibs | SSTL15_S_PSDDR
Pass | /Principal/BANK_502/DDR_A11 |  | U1.H21 | U3.R7 | Fast-Strong | 0,531 | 0,615 | 0,408 | 0,497 | 0,588 | 0,429 | Yes | Pin | Pin | No | -235 | 1575 | 300 | 535 | NA | NA | NA | NA | NA | Pass | 21 | Pass | -184 | 0 | 300 | 484 | NA | NA | NA | NA | NA | Pass | 23 | Pass | NA | NA | NA | NA | NA | NA | NA | NA | NA | Pass | NA | NA | NA | Pass | Pass | Pass | Pass | Pass | zynq_ddr3_diffpin.ibs | SSTL15_S_PSDDR
Pass | /Principal/BANK_502/DDR_A11 |  | U1.H21 | U2.R7 | Typical | 0,362 | 0,463 | 0,542 | 0,356 | 0,462 | 0,553 | Yes | Pin | Pin | No | -250 | 1500 | 300 | 550 | NA | NA | NA | NA | NA | Pass | 23 | Pass | -227 | 0 | 300 | 527 | NA | NA | NA | NA | NA | Pass | 19 | Pass | NA | NA | NA | NA | NA | NA | NA | NA | NA | Pass | NA | NA | NA | Pass | Pass | Pass | Pass | Pass | zynq_ddr3_diffpin.ibs | SSTL15_S_PSDDR
Pass | /Principal/BANK_502/DDR_A11 |  | U1.H21 | U3.R7 | Typical | 0,505 | 0,615 | 0,542 | 0,494 | 0,609 | 0,553 | Yes | Pin | Pin | No | -263 | 1500 | 300 | 563 | NA | NA | NA | NA | NA | Pass | 11 | Pass | -236 | 0 | 300 | 536 | NA | NA | NA | NA | NA | Pass | 11 | Pass | NA | NA | NA | NA | NA | NA | NA | NA | NA | Pass | NA | NA | NA | Pass | Pass | Pass | Pass | Pass | zynq_ddr3_diffpin.ibs | SSTL15_S_PSDDR
Pass | /Principal/BANK_502/DDR_A11 |  | U1.H21 | U2.R7 | Slow-Weak | 0,303 | 0,476 | 0,715 | 0,344 | 0,568 | 0,719 | Yes | Pin | Pin | No | -290 | 1425 | 300 | 590 | NA | NA | NA | NA | NA | Pass | 9 | Pass | -305 | 0 | 300 | 605 | NA | NA | NA | NA | NA | Pass | 9 | Pass | NA | NA | NA | NA | NA | NA | NA | NA | NA | Pass | NA | NA | NA | Pass | Pass | Pass | Pass | Pass | zynq_ddr3_diffpin.ibs | SSTL15_S_PSDDR
Pass | /Principal/BANK_502/DDR_A11 |  | U1.H21 | U3.R7 | Slow-Weak | 0,451 | 0,617 | 0,715 | 0,485 | 0,683 | 0,719 | Yes | Pin | Pin | No | -292 | 1425 | 300 | 592 | NA | NA | NA | NA | NA | Pass | 8 | Pass | -306 | 0 | 300 | 606 | NA | NA | NA | NA | NA | Pass | 9 | Pass | NA | NA | NA | NA | NA | NA | NA | NA | NA | Pass | NA | NA | NA | Pass | Pass | Pass | Pass | Pass | zynq_ddr3_diffpin.ibs | SSTL15_S_PSDDR
Pass | /Principal/BANK_502/DDR_A12 |  | U1.P20 | U2.N7 | Fast-Strong | 0,430 | 0,504 | 0,402 | 0,399 | 0,480 | 0,422 | Yes | Pin | Pin | No | -214 | 1575 | 300 | 514 | NA | NA | NA | NA | NA | Pass | 42 | Pass | -167 | 0 | 300 | 467 | NA | NA | NA | NA | NA | Pass | 39 | Pass | NA | NA | NA | NA | NA | NA | NA | NA | NA | Pass | NA | NA | NA | Pass | Pass | Pass | Pass | Pass | zynq_ddr3_diffpin.ibs | SSTL15_S_PSDDR
Pass | /Principal/BANK_502/DDR_A12 |  | U1.P20 | U3.N7 | Fast-Strong | 0,568 | 0,652 | 0,402 | 0,537 | 0,625 | 0,422 | Yes | Pin | Pin | No | -231 | 1575 | 300 | 531 | NA | NA | NA | NA | NA | Pass | 26 | Pass | -180 | 0 | 300 | 480 | NA | NA | NA | NA | NA | Pass | 27 | Pass | NA | NA | NA | NA | NA | NA | NA | NA | NA | Pass | NA | NA | NA | Pass | Pass | Pass | Pass | Pass | zynq_ddr3_diffpin.ibs | SSTL15_S_PSDDR
Pass | /Principal/BANK_502/DDR_A12 |  | U1.P20 | U2.N7 | Typical | 0,401 | 0,502 | 0,536 | 0,389 | 0,500 | 0,547 | Yes | Pin | Pin | No | -246 | 1500 | 300 | 546 | NA | NA | NA | NA | NA | Pass | 27 | Pass | -224 | 0 | 300 | 524 | NA | NA | NA | NA | NA | Pass | 22 | Pass | NA | NA | NA | NA | NA | NA | NA | NA | NA | Pass | NA | NA | NA | Pass | Pass | Pass | Pass | Pass | zynq_ddr3_diffpin.ibs | SSTL15_S_PSDDR
Pass | /Principal/BANK_502/DDR_A12 |  | U1.P20 | U3.N7 | Typical | 0,543 | 0,649 | 0,536 | 0,532 | 0,647 | 0,547 | Yes | Pin | Pin | No | -259 | 1500 | 300 | 559 | NA | NA | NA | NA | NA | Pass | 15 | Pass | -233 | 0 | 300 | 533 | NA | NA | NA | NA | NA | Pass | 14 | Pass | NA | NA | NA | NA | NA | NA | NA | NA | NA | Pass | NA | NA | NA | Pass | Pass | Pass | Pass | Pass | zynq_ddr3_diffpin.ibs | SSTL15_S_PSDDR
Pass | /Principal/BANK_502/DDR_A12 |  | U1.P20 | U2.N7 | Slow-Weak | 0,340 | 0,513 | 0,710 | 0,381 | 0,611 | 0,714 | Yes | Pin | Pin | No | -285 | 1425 | 300 | 585 | NA | NA | NA | NA | NA | Pass | 14 | Pass | -303 | 0 | 300 | 603 | NA | NA | NA | NA | NA | Pass | 11 | Pass | NA | NA | NA | NA | NA | NA | NA | NA | NA | Pass | NA | NA | NA | Pass | Pass | Pass | Pass | Pass | zynq_ddr3_diffpin.ibs | SSTL15_S_PSDDR
Pass | /Principal/BANK_502/DDR_A12 |  | U1.P20 | U3.N7 | Slow-Weak | 0,488 | 0,654 | 0,710 | 0,522 | 0,720 | 0,714 | Yes | Pin | Pin | No | -292 | 1425 | 300 | 592 | NA | NA | NA | NA | NA | Pass | 8 | Pass | -308 | 0 | 300 | 608 | NA | NA | NA | NA | NA | Pass | 7 | Pass | NA | NA | NA | NA | NA | NA | NA | NA | NA | Pass | NA | NA | NA | Pass | Pass | Pass | Pass | Pass | zynq_ddr3_diffpin.ibs | SSTL15_S_PSDDR
Pass | /Principal/BANK_502/DDR_A13 |  | U1.J20 | U2.T3 | Fast-Strong | 0,417 | 0,491 | 0,405 | 0,390 | 0,464 | 0,425 | Yes | Pin | Pin | No | -187 | 1575 | 300 | 487 | NA | NA | NA | NA | NA | Pass | 70 | Pass | -138 | 0 | 300 | 438 | NA | NA | NA | NA | NA | Pass | 69 | Pass | NA | NA | NA | NA | NA | NA | NA | NA | NA | Pass | NA | NA | NA | Pass | Pass | Pass | Pass | Pass | zynq_ddr3_diffpin.ibs | SSTL15_S_PSDDR
Pass | /Principal/BANK_502/DDR_A13 |  | U1.J20 | U3.T3 | Fast-Strong | 0,545 | 0,629 | 0,405 | 0,515 | 0,602 | 0,425 | Yes | Pin | Pin | No | -216 | 1575 | 300 | 516 | NA | NA | NA | NA | NA | Pass | 42 | Pass | -162 | 0 | 300 | 462 | NA | NA | NA | NA | NA | Pass | 46 | Pass | NA | NA | NA | NA | NA | NA | NA | NA | NA | Pass | NA | NA | NA | Pass | Pass | Pass | Pass | Pass | zynq_ddr3_diffpin.ibs | SSTL15_S_PSDDR
Pass | /Principal/BANK_502/DDR_A13 |  | U1.J20 | U2.T3 | Typical | 0,393 | 0,485 | 0,539 | 0,382 | 0,488 | 0,550 | Yes | Pin | Pin | No | -235 | 1500 | 300 | 535 | NA | NA | NA | NA | NA | Pass | 38 | Pass | -212 | 0 | 300 | 512 | NA | NA | NA | NA | NA | Pass | 35 | Pass | NA | NA | NA | NA | NA | NA | NA | NA | NA | Pass | NA | NA | NA | Pass | Pass | Pass | Pass | Pass | zynq_ddr3_diffpin.ibs | SSTL15_S_PSDDR
Pass | /Principal/BANK_502/DDR_A13 |  | U1.J20 | U3.T3 | Typical | 0,517 | 0,628 | 0,539 | 0,511 | 0,621 | 0,550 | Yes | Pin | Pin | No | -254 | 1500 | 300 | 554 | NA | NA | NA | NA | NA | Pass | 20 | Pass | -225 | 0 | 300 | 525 | NA | NA | NA | NA | NA | Pass | 22 | Pass | NA | NA | NA | NA | NA | NA | NA | NA | NA | Pass | NA | NA | NA | Pass | Pass | Pass | Pass | Pass | zynq_ddr3_diffpin.ibs | SSTL15_S_PSDDR
Pass | /Principal/BANK_502/DDR_A13 |  | U1.J20 | U2.T3 | Slow-Weak | 0,332 | 0,504 | 0,712 | 0,366 | 0,622 | 0,717 | Yes | Pin | Pin | No | -284 | 1425 | 300 | 584 | NA | NA | NA | NA | NA | Pass | 15 | Pass | -301 | 0 | 300 | 601 | NA | NA | NA | NA | NA | Pass | 13 | Pass | NA | NA | NA | NA | NA | NA | NA | NA | NA | Pass | NA | NA | NA | Pass | Pass | Pass | Pass | Pass | zynq_ddr3_diffpin.ibs | SSTL15_S_PSDDR
Pass | /Principal/BANK_502/DDR_A13 |  | U1.J20 | U3.T3 | Slow-Weak | 0,466 | 0,633 | 0,712 | 0,500 | 0,692 | 0,717 | Yes | Pin | Pin | No | -286 | 1425 | 300 | 586 | NA | NA | NA | NA | NA | Pass | 14 | Pass | -300 | 0 | 300 | 600 | NA | NA | NA | NA | NA | Pass | 15 | Pass | NA | NA | NA | NA | NA | NA | NA | NA | NA | Pass | NA | NA | NA | Pass | Pass | Pass | Pass | Pass | zynq_ddr3_diffpin.ibs | SSTL15_S_PSDDR
Pass | /Principal/BANK_502/DDR_A14 |  | U1.R20 | U2.T7 | Fast-Strong | 0,391 | 0,465 | 0,407 | 0,364 | 0,441 | 0,428 | Yes | Pin | Pin | No | -214 | 1575 | 300 | 514 | NA | NA | NA | NA | NA | Pass | 42 | Pass | -167 | 0 | 300 | 467 | NA | NA | NA | NA | NA | Pass | 40 | Pass | NA | NA | NA | NA | NA | NA | NA | NA | NA | Pass | NA | NA | NA | Pass | Pass | Pass | Pass | Pass | zynq_ddr3_diffpin.ibs | SSTL15_S_PSDDR
Pass | /Principal/BANK_502/DDR_A14 |  | U1.R20 | U3.T7 | Fast-Strong | 0,532 | 0,613 | 0,407 | 0,498 | 0,583 | 0,428 | Yes | Pin | Pin | No | -233 | 1575 | 300 | 533 | NA | NA | NA | NA | NA | Pass | 24 | Pass | -183 | 0 | 300 | 483 | NA | NA | NA | NA | NA | Pass | 25 | Pass | NA | NA | NA | NA | NA | NA | NA | NA | NA | Pass | NA | NA | NA | Pass | Pass | Pass | Pass | Pass | zynq_ddr3_diffpin.ibs | SSTL15_S_PSDDR
Pass | /Principal/BANK_502/DDR_A14 |  | U1.R20 | U2.T7 | Typical | 0,368 | 0,460 | 0,542 | 0,357 | 0,462 | 0,553 | Yes | Pin | Pin | No | -250 | 1500 | 300 | 550 | NA | NA | NA | NA | NA | Pass | 24 | Pass | -228 | 0 | 300 | 528 | NA | NA | NA | NA | NA | Pass | 19 | Pass | NA | NA | NA | NA | NA | NA | NA | NA | NA | Pass | NA | NA | NA | Pass | Pass | Pass | Pass | Pass | zynq_ddr3_diffpin.ibs | SSTL15_S_PSDDR
Pass | /Principal/BANK_502/DDR_A14 |  | U1.R20 | U3.T7 | Typical | 0,506 | 0,611 | 0,542 | 0,495 | 0,609 | 0,553 | Yes | Pin | Pin | No | -262 | 1500 | 300 | 562 | NA | NA | NA | NA | NA | Pass | 13 | Pass | -236 | 0 | 300 | 536 | NA | NA | NA | NA | NA | Pass | 12 | Pass | NA | NA | NA | NA | NA | NA | NA | NA | NA | Pass | NA | NA | NA | Pass | Pass | Pass | Pass | Pass | zynq_ddr3_diffpin.ibs | SSTL15_S_PSDDR
Pass | /Principal/BANK_502/DDR_A14 |  | U1.R20 | U2.T7 | Slow-Weak | 0,304 | 0,477 | 0,714 | 0,344 | 0,575 | 0,719 | Yes | Pin | Pin | No | -288 | 1425 | 300 | 588 | NA | NA | NA | NA | NA | Pass | 12 | Pass | -304 | 0 | 300 | 604 | NA | NA | NA | NA | NA | Pass | 11 | Pass | NA | NA | NA | NA | NA | NA | NA | NA | NA | Pass | NA | NA | NA | Pass | Pass | Pass | Pass | Pass | zynq_ddr3_diffpin.ibs | SSTL15_S_PSDDR
Pass | /Principal/BANK_502/DDR_A14 |  | U1.R20 | U3.T7 | Slow-Weak | 0,451 | 0,617 | 0,714 | 0,485 | 0,683 | 0,719 | Yes | Pin | Pin | No | -292 | 1425 | 300 | 592 | NA | NA | NA | NA | NA | Pass | 8 | Pass | -307 | 0 | 300 | 607 | NA | NA | NA | NA | NA | Pass | 8 | Pass | NA | NA | NA | NA | NA | NA | NA | NA | NA | Pass | NA | NA | NA | Pass | Pass | Pass | Pass | Pass | zynq_ddr3_diffpin.ibs | SSTL15_S_PSDDR
Pass | /Principal/BANK_502/DDR_BA0 |  | U1.U22 | U2.M2 | Fast-Strong | 0,427 | 0,495 | 0,411 | 0,400 | 0,471 | 0,431 | Yes | Pin | Pin | No | -211 | 1575 | 300 | 511 | NA | NA | NA | NA | NA | Pass | 46 | Pass | -158 | 0 | 300 | 458 | NA | NA | NA | NA | NA | Pass | 50 | Pass | NA | NA | NA | NA | NA | NA | NA | NA | NA | Pass | NA | NA | NA | Pass | Pass | Pass | Pass | Pass | zynq_ddr3_diffpin.ibs | SSTL15_S_PSDDR
Pass | /Principal/BANK_502/DDR_BA0 |  | U1.U22 | U3.M2 | Fast-Strong | 0,552 | 0,629 | 0,411 | 0,525 | 0,602 | 0,431 | Yes | Pin | Pin | No | -213 | 1575 | 300 | 513 | NA | NA | NA | NA | NA | Pass | 45 | Pass | -162 | 0 | 300 | 462 | NA | NA | NA | NA | NA | Pass | 47 | Pass | NA | NA | NA | NA | NA | NA | NA | NA | NA | Pass | NA | NA | NA | Pass | Pass | Pass | Pass | Pass | zynq_ddr3_diffpin.ibs | SSTL15_S_PSDDR
Pass | /Principal/BANK_502/DDR_BA0 |  | U1.U22 | U2.M2 | Typical | 0,401 | 0,493 | 0,545 | 0,390 | 0,496 | 0,556 | Yes | Pin | Pin | No | -234 | 1500 | 300 | 534 | NA | NA | NA | NA | NA | Pass | 40 | Pass | -210 | 0 | 300 | 510 | NA | NA | NA | NA | NA | Pass | 38 | Pass | NA | NA | NA | NA | NA | NA | NA | NA | NA | Pass | NA | NA | NA | Pass | Pass | Pass | Pass | Pass | zynq_ddr3_diffpin.ibs | SSTL15_S_PSDDR
Pass | /Principal/BANK_502/DDR_BA0 |  | U1.U22 | U3.M2 | Typical | 0,525 | 0,626 | 0,545 | 0,514 | 0,624 | 0,556 | Yes | Pin | Pin | No | -248 | 1500 | 300 | 548 | NA | NA | NA | NA | NA | Pass | 27 | Pass | -221 | 0 | 300 | 521 | NA | NA | NA | NA | NA | Pass | 27 | Pass | NA | NA | NA | NA | NA | NA | NA | NA | NA | Pass | NA | NA | NA | Pass | Pass | Pass | Pass | Pass | zynq_ddr3_diffpin.ibs | SSTL15_S_PSDDR
Pass | /Principal/BANK_502/DDR_BA0 |  | U1.U22 | U2.M2 | Slow-Weak | 0,346 | 0,512 | 0,717 | 0,380 | 0,642 | 0,721 | Yes | Pin | Pin | No | -278 | 1425 | 300 | 578 | NA | NA | NA | NA | NA | Pass | 22 | Pass | -297 | 0 | 300 | 597 | NA | NA | NA | NA | NA | Pass | 17 | Pass | NA | NA | NA | NA | NA | NA | NA | NA | NA | Pass | NA | NA | NA | Pass | Pass | Pass | Pass | Pass | zynq_ddr3_diffpin.ibs | SSTL15_S_PSDDR
Pass | /Principal/BANK_502/DDR_BA0 |  | U1.U22 | U3.M2 | Slow-Weak | 0,474 | 0,627 | 0,717 | 0,508 | 0,693 | 0,721 | Yes | Pin | Pin | No | -286 | 1425 | 300 | 586 | NA | NA | NA | NA | NA | Pass | 14 | Pass | -299 | 0 | 300 | 599 | NA | NA | NA | NA | NA | Pass | 16 | Pass | NA | NA | NA | NA | NA | NA | NA | NA | NA | Pass | NA | NA | NA | Pass | Pass | Pass | Pass | Pass | zynq_ddr3_diffpin.ibs | SSTL15_S_PSDDR
Pass | /Principal/BANK_502/DDR_BA1 |  | U1.T22 | U2.N8 | Fast-Strong | 0,425 | 0,496 | 0,417 | 0,398 | 0,472 | 0,437 | Yes | Pin | Pin | No | -216 | 1575 | 300 | 516 | NA | NA | NA | NA | NA | Pass | 41 | Pass | -172 | 0 | 300 | 472 | NA | NA | NA | NA | NA | Pass | 36 | Pass | NA | NA | NA | NA | NA | NA | NA | NA | NA | Pass | NA | NA | NA | Pass | Pass | Pass | Pass | Pass | zynq_ddr3_diffpin.ibs | SSTL15_S_PSDDR
Pass | /Principal/BANK_502/DDR_BA1 |  | U1.T22 | U3.N8 | Fast-Strong | 0,563 | 0,644 | 0,417 | 0,533 | 0,617 | 0,437 | Yes | Pin | Pin | No | -227 | 1575 | 300 | 527 | NA | NA | NA | NA | NA | Pass | 31 | Pass | -177 | 0 | 300 | 477 | NA | NA | NA | NA | NA | Pass | 31 | Pass | NA | NA | NA | NA | NA | NA | NA | NA | NA | Pass | NA | NA | NA | Pass | Pass | Pass | Pass | Pass | zynq_ddr3_diffpin.ibs | SSTL15_S_PSDDR
Pass | /Principal/BANK_502/DDR_BA1 |  | U1.T22 | U2.N8 | Typical | 0,400 | 0,492 | 0,551 | 0,389 | 0,490 | 0,561 | Yes | Pin | Pin | No | -248 | 1500 | 300 | 548 | NA | NA | NA | NA | NA | Pass | 26 | Pass | -228 | 0 | 300 | 528 | NA | NA | NA | NA | NA | Pass | 19 | Pass | NA | NA | NA | NA | NA | NA | NA | NA | NA | Pass | NA | NA | NA | Pass | Pass | Pass | Pass | Pass | zynq_ddr3_diffpin.ibs | SSTL15_S_PSDDR
Pass | /Principal/BANK_502/DDR_BA1 |  | U1.T22 | U3.N8 | Typical | 0,538 | 0,639 | 0,551 | 0,527 | 0,637 | 0,561 | Yes | Pin | Pin | No | -265 | 1500 | 300 | 565 | NA | NA | NA | NA | NA | Pass | 10 | Pass | -241 | 0 | 300 | 541 | NA | NA | NA | NA | NA | Pass | 7 | Pass | NA | NA | NA | NA | NA | NA | NA | NA | NA | Pass | NA | NA | NA | Pass | Pass | Pass | Pass | Pass | zynq_ddr3_diffpin.ibs | SSTL15_S_PSDDR
Pass | /Principal/BANK_502/DDR_BA1 |  | U1.T22 | U2.N8 | Slow-Weak | 0,341 | 0,495 | 0,722 | 0,376 | 0,574 | 0,726 | Yes | Pin | Pin | No | -291 | 1425 | 300 | 591 | NA | NA | NA | NA | NA | Pass | 9 | Pass | -312 | 0 | 300 | 612 | NA | NA | NA | NA | NA | Pass | 3 | Pass | NA | NA | NA | NA | NA | NA | NA | NA | NA | Pass | NA | NA | NA | Pass | Pass | Pass | Pass | Pass | zynq_ddr3_diffpin.ibs | SSTL15_S_PSDDR
Pass | /Principal/BANK_502/DDR_BA1 |  | U1.T22 | U3.N8 | Slow-Weak | 0,482 | 0,636 | 0,722 | 0,523 | 0,702 | 0,726 | Yes | Pin | Pin | No | -300 | 1425 | 300 | 600 | NA | NA | NA | NA | NA | Pass | 0 | Pass | -318 | 0 | 300 | 618 | NA | NA | NA | NA | NA | Pass | 0 | Pass | NA | NA | NA | NA | NA | NA | NA | NA | NA | Pass | NA | NA | NA | Pass | Pass | Pass | Pass | Pass | zynq_ddr3_diffpin.ibs | SSTL15_S_PSDDR
Pass | /Principal/BANK_502/DDR_BA2 |  | U1.R22 | U2.M3 | Fast-Strong | 0,427 | 0,487 | 0,398 | 0,396 | 0,467 | 0,419 | Yes | Pin | Pin | No | -200 | 1575 | 300 | 500 | NA | NA | NA | NA | NA | Pass | 56 | Pass | -158 | 0 | 300 | 458 | NA | NA | NA | NA | NA | Pass | 49 | Pass | NA | NA | NA | NA | NA | NA | NA | NA | NA | Pass | NA | NA | NA | Pass | Pass | Pass | Pass | Pass | zynq_ddr3_diffpin.ibs | SSTL15_S_PSDDR
Pass | /Principal/BANK_502/DDR_BA2 |  | U1.R22 | U3.M3 | Fast-Strong | 0,558 | 0,629 | 0,398 | 0,527 | 0,605 | 0,419 | Yes | Pin | Pin | No | -194 | 1575 | 300 | 494 | NA | NA | NA | NA | NA | Pass | 63 | Pass | -146 | 0 | 300 | 446 | NA | NA | NA | NA | NA | Pass | 62 | Pass | NA | NA | NA | NA | NA | NA | NA | NA | NA | Pass | NA | NA | NA | Pass | Pass | Pass | Pass | Pass | zynq_ddr3_diffpin.ibs | SSTL15_S_PSDDR
Pass | /Principal/BANK_502/DDR_BA2 |  | U1.R22 | U2.M3 | Typical | 0,395 | 0,487 | 0,533 | 0,383 | 0,484 | 0,545 | Yes | Pin | Pin | No | -242 | 1500 | 300 | 542 | NA | NA | NA | NA | NA | Pass | 32 | Pass | -221 | 0 | 300 | 521 | NA | NA | NA | NA | NA | Pass | 26 | Pass | NA | NA | NA | NA | NA | NA | NA | NA | NA | Pass | NA | NA | NA | Pass | Pass | Pass | Pass | Pass | zynq_ddr3_diffpin.ibs | SSTL15_S_PSDDR
Pass | /Principal/BANK_502/DDR_BA2 |  | U1.R22 | U3.M3 | Typical | 0,528 | 0,624 | 0,533 | 0,516 | 0,622 | 0,545 | Yes | Pin | Pin | No | -253 | 1500 | 300 | 553 | NA | NA | NA | NA | NA | Pass | 21 | Pass | -234 | 0 | 300 | 534 | NA | NA | NA | NA | NA | Pass | 14 | Pass | NA | NA | NA | NA | NA | NA | NA | NA | NA | Pass | NA | NA | NA | Pass | Pass | Pass | Pass | Pass | zynq_ddr3_diffpin.ibs | SSTL15_S_PSDDR
Pass | /Principal/BANK_502/DDR_BA2 |  | U1.R22 | U2.M3 | Slow-Weak | 0,335 | 0,489 | 0,708 | 0,369 | 0,574 | 0,713 | Yes | Pin | Pin | No | -292 | 1425 | 300 | 592 | NA | NA | NA | NA | NA | Pass | 8 | Pass | -310 | 0 | 300 | 610 | NA | NA | NA | NA | NA | Pass | 4 | Pass | NA | NA | NA | NA | NA | NA | NA | NA | NA | Pass | NA | NA | NA | Pass | Pass | Pass | Pass | Pass | zynq_ddr3_diffpin.ibs | SSTL15_S_PSDDR
Pass | /Principal/BANK_502/DDR_BA2 |  | U1.R22 | U3.M3 | Slow-Weak | 0,470 | 0,623 | 0,708 | 0,503 | 0,683 | 0,713 | Yes | Pin | Pin | No | -302 | 1425 | 300 | 602 | NA | NA | NA | NA | NA | Pass | 0 | Pass | -318 | 0 | 300 | 618 | NA | NA | NA | NA | NA | Pass | 0 | Pass | NA | NA | NA | NA | NA | NA | NA | NA | NA | Pass | NA | NA | NA | Pass | Pass | Pass | Pass | Pass | zynq_ddr3_diffpin.ibs | SSTL15_S_PSDDR
Pass | /Principal/BANK_502/DDR_CAS |  | U1.Y23 | U2.K3 | Fast-Strong | 0,426 | 0,490 | 0,436 | 0,399 | 0,467 | 0,456 | Yes | Pin | Pin | No | -231 | 1575 | 300 | 531 | NA | NA | NA | NA | NA | Pass | 27 | Pass | -188 | 0 | 300 | 488 | NA | NA | NA | NA | NA | Pass | 21 | Pass | NA | NA | NA | NA | NA | NA | NA | NA | NA | Pass | NA | NA | NA | Pass | Pass | Pass | Pass | Pass | zynq_ddr3_diffpin.ibs | SSTL15_S_PSDDR
Pass | /Principal/BANK_502/DDR_CAS |  | U1.Y23 | U3.K3 | Fast-Strong | 0,557 | 0,631 | 0,436 | 0,527 | 0,605 | 0,456 | Yes | Pin | Pin | No | -232 | 1575 | 300 | 532 | NA | NA | NA | NA | NA | Pass | 26 | Pass | -188 | 0 | 300 | 488 | NA | NA | NA | NA | NA | Pass | 22 | Pass | NA | NA | NA | NA | NA | NA | NA | NA | NA | Pass | NA | NA | NA | Pass | Pass | Pass | Pass | Pass | zynq_ddr3_diffpin.ibs | SSTL15_S_PSDDR
Pass | /Principal/BANK_502/DDR_CAS |  | U1.Y23 | U2.K3 | Typical | 0,399 | 0,487 | 0,570 | 0,384 | 0,485 | 0,580 | Yes | Pin | Pin | No | -256 | 1500 | 300 | 556 | NA | NA | NA | NA | NA | Pass | 19 | Pass | -235 | 0 | 300 | 535 | NA | NA | NA | NA | NA | Pass | 13 | Pass | NA | NA | NA | NA | NA | NA | NA | NA | NA | Pass | NA | NA | NA | Pass | Pass | Pass | Pass | Pass | zynq_ddr3_diffpin.ibs | SSTL15_S_PSDDR
Pass | /Principal/BANK_502/DDR_CAS |  | U1.Y23 | U3.K3 | Typical | 0,528 | 0,629 | 0,570 | 0,517 | 0,623 | 0,580 | Yes | Pin | Pin | No | -266 | 1500 | 300 | 566 | NA | NA | NA | NA | NA | Pass | 10 | Pass | -242 | 0 | 300 | 542 | NA | NA | NA | NA | NA | Pass | 7 | Pass | NA | NA | NA | NA | NA | NA | NA | NA | NA | Pass | NA | NA | NA | Pass | Pass | Pass | Pass | Pass | zynq_ddr3_diffpin.ibs | SSTL15_S_PSDDR
Pass | /Principal/BANK_502/DDR_CAS |  | U1.Y23 | U2.K3 | Slow-Weak | 0,342 | 0,489 | 0,740 | 0,377 | 0,582 | 0,743 | Yes | Pin | Pin | No | -284 | 1425 | 300 | 584 | NA | NA | NA | NA | NA | Pass | 16 | Pass | -303 | 0 | 300 | 603 | NA | NA | NA | NA | NA | Pass | 12 | Pass | NA | NA | NA | NA | NA | NA | NA | NA | NA | Pass | NA | NA | NA | Pass | Pass | Pass | Pass | Pass | zynq_ddr3_diffpin.ibs | SSTL15_S_PSDDR
Pass | /Principal/BANK_502/DDR_CAS |  | U1.Y23 | U3.K3 | Slow-Weak | 0,477 | 0,630 | 0,740 | 0,511 | 0,691 | 0,743 | Yes | Pin | Pin | No | -294 | 1425 | 300 | 594 | NA | NA | NA | NA | NA | Pass | 7 | Pass | -311 | 0 | 300 | 611 | NA | NA | NA | NA | NA | Pass | 4 | Pass | NA | NA | NA | NA | NA | NA | NA | NA | NA | Pass | NA | NA | NA | Pass | Pass | Pass | Pass | Pass | zynq_ddr3_diffpin.ibs | SSTL15_S_PSDDR
Pass | /Principal/BANK_502/DDR_CKE | /Principal/BANK_502/DDR_CLK_P;/Principal/BANK_502/DDR_CLK_N | U1.U21 | U2.K9 | Fast-Strong | 0,426 | 0,497 | 0,402 | 0,399 | 0,473 | 0,423 | Yes | Pin | Pin | No | -217 | 1575 | 300 | 517 | NA | NA | NA | NA | NA | Pass | 39 | Pass | -174 | 0 | 300 | 474 | NA | NA | NA | NA | NA | Pass | 33 | Pass | NA | NA | NA | NA | NA | NA | NA | NA | NA | Pass | -26 | 150 | 124 | Pass | Pass | Pass | Pass | Pass | zynq_ddr3_diffpin.ibs | SSTL15_S_PSDDR
Pass | /Principal/BANK_502/DDR_CKE | /Principal/BANK_502/DDR_CLK_P;/Principal/BANK_502/DDR_CLK_N | U1.U21 | U3.K9 | Fast-Strong | 0,557 | 0,635 | 0,402 | 0,527 | 0,608 | 0,423 | Yes | Pin | Pin | No | -236 | 1575 | 300 | 536 | NA | NA | NA | NA | NA | Pass | 22 | Pass | -186 | 0 | 300 | 486 | NA | NA | NA | NA | NA | Pass | 22 | Pass | NA | NA | NA | NA | NA | NA | NA | NA | NA | Pass | 16 | 150 | 134 | Pass | Pass | Pass | Pass | Pass | zynq_ddr3_diffpin.ibs | SSTL15_S_PSDDR
Pass | /Principal/BANK_502/DDR_CKE | /Principal/BANK_502/DDR_CLK_P;/Principal/BANK_502/DDR_CLK_N | U1.U21 | U2.K9 | Typical | 0,400 | 0,497 | 0,536 | 0,389 | 0,495 | 0,548 | Yes | Pin | Pin | No | -250 | 1500 | 300 | 550 | NA | NA | NA | NA | NA | Pass | 24 | Pass | -230 | 0 | 300 | 530 | NA | NA | NA | NA | NA | Pass | 17 | Pass | NA | NA | NA | NA | NA | NA | NA | NA | NA | Pass | NA | NA | NA | Pass | Pass | Pass | Pass | Pass | zynq_ddr3_diffpin.ibs | SSTL15_S_PSDDR
Pass | /Principal/BANK_502/DDR_CKE | /Principal/BANK_502/DDR_CLK_P;/Principal/BANK_502/DDR_CLK_N | U1.U21 | U3.K9 | Typical | 0,529 | 0,630 | 0,536 | 0,522 | 0,628 | 0,548 | Yes | Pin | Pin | No | -261 | 1500 | 300 | 561 | NA | NA | NA | NA | NA | Pass | 13 | Pass | -237 | 0 | 300 | 537 | NA | NA | NA | NA | NA | Pass | 11 | Pass | NA | NA | NA | NA | NA | NA | NA | NA | NA | Pass | NA | NA | NA | Pass | Pass | Pass | Pass | Pass | zynq_ddr3_diffpin.ibs | SSTL15_S_PSDDR
Pass | /Principal/BANK_502/DDR_CKE | /Principal/BANK_502/DDR_CLK_P;/Principal/BANK_502/DDR_CLK_N | U1.U21 | U2.K9 | Slow-Weak | 0,340 | 0,507 | 0,710 | 0,374 | 0,592 | 0,714 | Yes | Pin | Pin | No | -292 | 1425 | 300 | 592 | NA | NA | NA | NA | NA | Pass | 8 | Pass | -311 | 0 | 300 | 611 | NA | NA | NA | NA | NA | Pass | 3 | Pass | NA | NA | NA | NA | NA | NA | NA | NA | NA | Pass | NA | NA | NA | Pass | Pass | Pass | Pass | Pass | zynq_ddr3_diffpin.ibs | SSTL15_S_PSDDR
Pass | /Principal/BANK_502/DDR_CKE | /Principal/BANK_502/DDR_CLK_P;/Principal/BANK_502/DDR_CLK_N | U1.U21 | U3.K9 | Slow-Weak | 0,475 | 0,628 | 0,710 | 0,508 | 0,694 | 0,714 | Yes | Pin | Pin | No | -298 | 1425 | 300 | 598 | NA | NA | NA | NA | NA | Pass | 2 | Pass | -316 | 0 | 300 | 616 | NA | NA | NA | NA | NA | Pass | 0 | Pass | NA | NA | NA | NA | NA | NA | NA | NA | NA | Pass | NA | NA | NA | Pass | Pass | Pass | Pass | Pass | zynq_ddr3_diffpin.ibs | SSTL15_S_PSDDR
Pass | /Principal/BANK_502/DDR_CS |  | U1.Y21 | U2.L2 | Fast-Strong | 0,429 | 0,496 | 0,430 | 0,402 | 0,473 | 0,450 | Yes | Pin | Pin | No | -208 | 1575 | 300 | 508 | NA | NA | NA | NA | NA | Pass | 51 | Pass | -158 | 0 | 300 | 458 | NA | NA | NA | NA | NA | Pass | 51 | Pass | NA | NA | NA | NA | NA | NA | NA | NA | NA | Pass | NA | NA | NA | Pass | Pass | Pass | Pass | Pass | zynq_ddr3_diffpin.ibs | SSTL15_S_PSDDR
Pass | /Principal/BANK_502/DDR_CS |  | U1.Y21 | U3.L2 | Fast-Strong | 0,553 | 0,634 | 0,430 | 0,523 | 0,608 | 0,450 | Yes | Pin | Pin | No | -214 | 1575 | 300 | 514 | NA | NA | NA | NA | NA | Pass | 45 | Pass | -162 | 0 | 300 | 462 | NA | NA | NA | NA | NA | Pass | 48 | Pass | NA | NA | NA | NA | NA | NA | NA | NA | NA | Pass | NA | NA | NA | Pass | Pass | Pass | Pass | Pass | zynq_ddr3_diffpin.ibs | SSTL15_S_PSDDR
Pass | /Principal/BANK_502/DDR_CS |  | U1.Y21 | U2.L2 | Typical | 0,401 | 0,493 | 0,563 | 0,390 | 0,496 | 0,574 | Yes | Pin | Pin | No | -242 | 1500 | 300 | 542 | NA | NA | NA | NA | NA | Pass | 33 | Pass | -216 | 0 | 300 | 516 | NA | NA | NA | NA | NA | Pass | 33 | Pass | NA | NA | NA | NA | NA | NA | NA | NA | NA | Pass | NA | NA | NA | Pass | Pass | Pass | Pass | Pass | zynq_ddr3_diffpin.ibs | SSTL15_S_PSDDR
Pass | /Principal/BANK_502/DDR_CS |  | U1.Y21 | U3.L2 | Typical | 0,530 | 0,631 | 0,563 | 0,519 | 0,625 | 0,574 | Yes | Pin | Pin | No | -252 | 1500 | 300 | 552 | NA | NA | NA | NA | NA | Pass | 24 | Pass | -224 | 0 | 300 | 524 | NA | NA | NA | NA | NA | Pass | 25 | Pass | NA | NA | NA | NA | NA | NA | NA | NA | NA | Pass | NA | NA | NA | Pass | Pass | Pass | Pass | Pass | zynq_ddr3_diffpin.ibs | SSTL15_S_PSDDR
Pass | /Principal/BANK_502/DDR_CS |  | U1.Y21 | U2.L2 | Slow-Weak | 0,348 | 0,508 | 0,734 | 0,376 | 0,620 | 0,738 | Yes | Pin | Pin | No | -290 | 1425 | 300 | 590 | NA | NA | NA | NA | NA | Pass | 11 | Pass | -308 | 0 | 300 | 608 | NA | NA | NA | NA | NA | Pass | 7 | Pass | NA | NA | NA | NA | NA | NA | NA | NA | NA | Pass | NA | NA | NA | Pass | Pass | Pass | Pass | Pass | zynq_ddr3_diffpin.ibs | SSTL15_S_PSDDR
Pass | /Principal/BANK_502/DDR_CS |  | U1.Y21 | U3.L2 | Slow-Weak | 0,476 | 0,630 | 0,734 | 0,511 | 0,696 | 0,738 | Yes | Pin | Pin | No | -298 | 1425 | 300 | 598 | NA | NA | NA | NA | NA | Pass | 3 | Pass | -314 | 0 | 300 | 614 | NA | NA | NA | NA | NA | Pass | 2 | Pass | NA | NA | NA | NA | NA | NA | NA | NA | NA | Pass | NA | NA | NA | Pass | Pass | Pass | Pass | Pass | zynq_ddr3_diffpin.ibs | SSTL15_S_PSDDR
Pass | /Principal/BANK_502/DDR_ODT |  | U1.Y22 | U2.K1 | Fast-Strong | 0,425 | 0,493 | 0,437 | 0,399 | 0,469 | 0,457 | Yes | Pin | Pin | No | -231 | 1575 | 300 | 531 | NA | NA | NA | NA | NA | Pass | 27 | Pass | -185 | 0 | 300 | 485 | NA | NA | NA | NA | NA | Pass | 24 | Pass | NA | NA | NA | NA | NA | NA | NA | NA | NA | Pass | NA | NA | NA | Pass | Pass | Pass | Pass | Pass | zynq_ddr3_diffpin.ibs | SSTL15_S_PSDDR
Pass | /Principal/BANK_502/DDR_ODT |  | U1.Y22 | U3.K1 | Fast-Strong | 0,557 | 0,634 | 0,437 | 0,530 | 0,608 | 0,457 | Yes | Pin | Pin | No | -219 | 1575 | 300 | 519 | NA | NA | NA | NA | NA | Pass | 40 | Pass | -173 | 0 | 300 | 473 | NA | NA | NA | NA | NA | Pass | 36 | Pass | NA | NA | NA | NA | NA | NA | NA | NA | NA | Pass | NA | NA | NA | Pass | Pass | Pass | Pass | Pass | zynq_ddr3_diffpin.ibs | SSTL15_S_PSDDR
Pass | /Principal/BANK_502/DDR_ODT |  | U1.Y22 | U2.K1 | Typical | 0,399 | 0,486 | 0,570 | 0,388 | 0,489 | 0,581 | Yes | Pin | Pin | No | -252 | 1500 | 300 | 552 | NA | NA | NA | NA | NA | Pass | 23 | Pass | -230 | 0 | 300 | 530 | NA | NA | NA | NA | NA | Pass | 19 | Pass | NA | NA | NA | NA | NA | NA | NA | NA | NA | Pass | NA | NA | NA | Pass | Pass | Pass | Pass | Pass | zynq_ddr3_diffpin.ibs | SSTL15_S_PSDDR
Pass | /Principal/BANK_502/DDR_ODT |  | U1.Y22 | U3.K1 | Typical | 0,532 | 0,628 | 0,570 | 0,522 | 0,627 | 0,581 | Yes | Pin | Pin | No | -263 | 1500 | 300 | 563 | NA | NA | NA | NA | NA | Pass | 12 | Pass | -239 | 0 | 300 | 539 | NA | NA | NA | NA | NA | Pass | 10 | Pass | NA | NA | NA | NA | NA | NA | NA | NA | NA | Pass | NA | NA | NA | Pass | Pass | Pass | Pass | Pass | zynq_ddr3_diffpin.ibs | SSTL15_S_PSDDR
Pass | /Principal/BANK_502/DDR_ODT |  | U1.Y22 | U2.K1 | Slow-Weak | 0,342 | 0,489 | 0,740 | 0,377 | 0,575 | 0,744 | Yes | Pin | Pin | No | -284 | 1425 | 300 | 584 | NA | NA | NA | NA | NA | Pass | 17 | Pass | -303 | 0 | 300 | 603 | NA | NA | NA | NA | NA | Pass | 12 | Pass | NA | NA | NA | NA | NA | NA | NA | NA | NA | Pass | NA | NA | NA | Pass | Pass | Pass | Pass | Pass | zynq_ddr3_diffpin.ibs | SSTL15_S_PSDDR
Pass | /Principal/BANK_502/DDR_ODT |  | U1.Y22 | U3.K1 | Slow-Weak | 0,476 | 0,630 | 0,740 | 0,517 | 0,690 | 0,744 | Yes | Pin | Pin | No | -293 | 1425 | 300 | 593 | NA | NA | NA | NA | NA | Pass | 8 | Pass | -310 | 0 | 300 | 610 | NA | NA | NA | NA | NA | Pass | 6 | Pass | NA | NA | NA | NA | NA | NA | NA | NA | NA | Pass | NA | NA | NA | Pass | Pass | Pass | Pass | Pass | zynq_ddr3_diffpin.ibs | SSTL15_S_PSDDR
Pass | /Principal/BANK_502/DDR_RAS |  | U1.V23 | U2.J3 | Fast-Strong | 0,426 | 0,490 | 0,426 | 0,399 | 0,466 | 0,446 | Yes | Pin | Pin | No | -225 | 1575 | 300 | 525 | NA | NA | NA | NA | NA | Pass | 32 | Pass | -183 | 0 | 300 | 483 | NA | NA | NA | NA | NA | Pass | 25 | Pass | NA | NA | NA | NA | NA | NA | NA | NA | NA | Pass | NA | NA | NA | Pass | Pass | Pass | Pass | Pass | zynq_ddr3_diffpin.ibs | SSTL15_S_PSDDR
Pass | /Principal/BANK_502/DDR_RAS |  | U1.V23 | U3.J3 | Fast-Strong | 0,557 | 0,631 | 0,426 | 0,527 | 0,604 | 0,446 | Yes | Pin | Pin | No | -236 | 1575 | 300 | 536 | NA | NA | NA | NA | NA | Pass | 22 | Pass | -191 | 0 | 300 | 491 | NA | NA | NA | NA | NA | Pass | 18 | Pass | NA | NA | NA | NA | NA | NA | NA | NA | NA | Pass | NA | NA | NA | Pass | Pass | Pass | Pass | Pass | zynq_ddr3_diffpin.ibs | SSTL15_S_PSDDR
Pass | /Principal/BANK_502/DDR_RAS |  | U1.V23 | U2.J3 | Typical | 0,395 | 0,487 | 0,560 | 0,385 | 0,486 | 0,570 | Yes | Pin | Pin | No | -252 | 1500 | 300 | 552 | NA | NA | NA | NA | NA | Pass | 23 | Pass | -233 | 0 | 300 | 533 | NA | NA | NA | NA | NA | Pass | 15 | Pass | NA | NA | NA | NA | NA | NA | NA | NA | NA | Pass | NA | NA | NA | Pass | Pass | Pass | Pass | Pass | zynq_ddr3_diffpin.ibs | SSTL15_S_PSDDR
Pass | /Principal/BANK_502/DDR_RAS |  | U1.V23 | U3.J3 | Typical | 0,529 | 0,630 | 0,560 | 0,518 | 0,624 | 0,570 | Yes | Pin | Pin | No | -264 | 1500 | 300 | 564 | NA | NA | NA | NA | NA | Pass | 11 | Pass | -241 | 0 | 300 | 541 | NA | NA | NA | NA | NA | Pass | 8 | Pass | NA | NA | NA | NA | NA | NA | NA | NA | NA | Pass | NA | NA | NA | Pass | Pass | Pass | Pass | Pass | zynq_ddr3_diffpin.ibs | SSTL15_S_PSDDR
Pass | /Principal/BANK_502/DDR_RAS |  | U1.V23 | U2.J3 | Slow-Weak | 0,339 | 0,493 | 0,730 | 0,374 | 0,579 | 0,734 | Yes | Pin | Pin | No | -284 | 1425 | 300 | 584 | NA | NA | NA | NA | NA | Pass | 17 | Pass | -303 | 0 | 300 | 603 | NA | NA | NA | NA | NA | Pass | 12 | Pass | NA | NA | NA | NA | NA | NA | NA | NA | NA | Pass | NA | NA | NA | Pass | Pass | Pass | Pass | Pass | zynq_ddr3_diffpin.ibs | SSTL15_S_PSDDR
Pass | /Principal/BANK_502/DDR_RAS |  | U1.V23 | U3.J3 | Slow-Weak | 0,480 | 0,627 | 0,730 | 0,515 | 0,694 | 0,734 | Yes | Pin | Pin | No | -294 | 1425 | 300 | 594 | NA | NA | NA | NA | NA | Pass | 7 | Pass | -311 | 0 | 300 | 611 | NA | NA | NA | NA | NA | Pass | 4 | Pass | NA | NA | NA | NA | NA | NA | NA | NA | NA | Pass | NA | NA | NA | Pass | Pass | Pass | Pass | Pass | zynq_ddr3_diffpin.ibs | SSTL15_S_PSDDR
Pass | /Principal/BANK_502/DDR_WE |  | U1.V22 | U2.L3 | Fast-Strong | 0,427 | 0,491 | 0,428 | 0,400 | 0,468 | 0,448 | Yes | Pin | Pin | No | -225 | 1575 | 300 | 525 | NA | NA | NA | NA | NA | Pass | 34 | Pass | -182 | 0 | 300 | 482 | NA | NA | NA | NA | NA | Pass | 28 | Pass | NA | NA | NA | NA | NA | NA | NA | NA | NA | Pass | NA | NA | NA | Pass | Pass | Pass | Pass | Pass | zynq_ddr3_diffpin.ibs | SSTL15_S_PSDDR
Pass | /Principal/BANK_502/DDR_WE |  | U1.V22 | U3.L3 | Fast-Strong | 0,559 | 0,633 | 0,428 | 0,528 | 0,606 | 0,448 | Yes | Pin | Pin | No | -210 | 1575 | 300 | 510 | NA | NA | NA | NA | NA | Pass | 50 | Pass | -165 | 0 | 300 | 465 | NA | NA | NA | NA | NA | Pass | 45 | Pass | NA | NA | NA | NA | NA | NA | NA | NA | NA | Pass | NA | NA | NA | Pass | Pass | Pass | Pass | Pass | zynq_ddr3_diffpin.ibs | SSTL15_S_PSDDR
Pass | /Principal/BANK_502/DDR_WE |  | U1.V22 | U2.L3 | Typical | 0,398 | 0,485 | 0,562 | 0,387 | 0,488 | 0,573 | Yes | Pin | Pin | No | -250 | 1500 | 300 | 550 | NA | NA | NA | NA | NA | Pass | 26 | Pass | -230 | 0 | 300 | 530 | NA | NA | NA | NA | NA | Pass | 19 | Pass | NA | NA | NA | NA | NA | NA | NA | NA | NA | Pass | NA | NA | NA | Pass | Pass | Pass | Pass | Pass | zynq_ddr3_diffpin.ibs | SSTL15_S_PSDDR
Pass | /Principal/BANK_502/DDR_WE |  | U1.V22 | U3.L3 | Typical | 0,531 | 0,628 | 0,562 | 0,520 | 0,626 | 0,573 | Yes | Pin | Pin | No | -263 | 1500 | 300 | 563 | NA | NA | NA | NA | NA | Pass | 13 | Pass | -240 | 0 | 300 | 540 | NA | NA | NA | NA | NA | Pass | 10 | Pass | NA | NA | NA | NA | NA | NA | NA | NA | NA | Pass | NA | NA | NA | Pass | Pass | Pass | Pass | Pass | zynq_ddr3_diffpin.ibs | SSTL15_S_PSDDR
Pass | /Principal/BANK_502/DDR_WE |  | U1.V22 | U2.L3 | Slow-Weak | 0,343 | 0,490 | 0,733 | 0,377 | 0,582 | 0,737 | Yes | Pin | Pin | No | -282 | 1425 | 300 | 582 | NA | NA | NA | NA | NA | Pass | 19 | Pass | -303 | 0 | 300 | 603 | NA | NA | NA | NA | NA | Pass | 13 | Pass | NA | NA | NA | NA | NA | NA | NA | NA | NA | Pass | NA | NA | NA | Pass | Pass | Pass | Pass | Pass | zynq_ddr3_diffpin.ibs | SSTL15_S_PSDDR
Pass | /Principal/BANK_502/DDR_WE |  | U1.V22 | U3.L3 | Slow-Weak | 0,477 | 0,625 | 0,733 | 0,512 | 0,691 | 0,737 | Yes | Pin | Pin | No | -294 | 1425 | 300 | 594 | NA | NA | NA | NA | NA | Pass | 8 | Pass | -311 | 0 | 300 | 611 | NA | NA | NA | NA | NA | Pass | 5 | Pass | NA | NA | NA | NA | NA | NA | NA | NA | NA | Pass | NA | NA | NA | Pass | Pass | Pass | Pass | Pass | zynq_ddr3_diffpin.ibs | SSTL15_S_PSDDR
Fail | /Principal/BANK_502/DDR_CLK_N;/Principal/BANK_502/DDR_CLK_P | /Principal/BANK_502/DDR_RAS | U1.P21 | U2.K7 | Fast-Strong | 0,385 | 0,448 | 0,398 | 0,385 | 0,448 | 0,398 | Yes | Pin | Pin | Yes | -201 | 1575 | 300 | 501 | NA | NA | NA | NA | NA | Pass | 427 | Fail | -123 | 0 | 300 | 423 | NA | NA | NA | NA | NA | Pass | 430 | Fail | NA | NA | NA | NA | NA | NA | NA | NA | NA | Pass | -31 | 150 | 119 | Pass | Pass | Pass | Pass | Pass | zynq_ddr3_diffpin.ibs | SSTL15_F_PSDDR
Pass | /Principal/BANK_502/DDR_CLK_N;/Principal/BANK_502/DDR_CLK_P | /Principal/BANK_502/DDR_RAS | U1.P21 | U3.K7 | Fast-Strong | 0,511 | 0,596 | 0,398 | 0,513 | 0,596 | 0,398 | Yes | Pin | Pin | Yes | -383 | 1575 | 300 | 683 | NA | NA | NA | NA | NA | Pass | 133 | Pass | -257 | 0 | 300 | 557 | NA | NA | NA | NA | NA | Pass | 137 | Pass | NA | NA | NA | NA | NA | NA | NA | NA | NA | Pass | 17 | 150 | 133 | Pass | Pass | Pass | Pass | Pass | zynq_ddr3_diffpin.ibs | SSTL15_F_PSDDR
Fail | /Principal/BANK_502/DDR_CLK_N;/Principal/BANK_502/DDR_CLK_P | /Principal/BANK_502/DDR_RAS | U1.R21 | U2.J7 | Fast-Strong | 0,385 | 0,448 | 0,398 | 0,385 | 0,448 | 0,398 | Yes | Pin | Pin | Yes | -202 | 1575 | 300 | 502 | NA | NA | NA | NA | NA | Pass | 430 | Fail | -124 | 0 | 300 | 424 | NA | NA | NA | NA | NA | Pass | 427 | Fail | NA | NA | NA | NA | NA | NA | NA | NA | NA | Pass | 31 | 150 | 119 | Pass | Pass | Pass | Pass | Pass | zynq_ddr3_diffpin.ibs | SSTL15_F_PSDDR
Pass | /Principal/BANK_502/DDR_CLK_N;/Principal/BANK_502/DDR_CLK_P | /Principal/BANK_502/DDR_RAS | U1.R21 | U3.J7 | Fast-Strong | 0,513 | 0,596 | 0,398 | 0,511 | 0,596 | 0,398 | Yes | Pin | Pin | Yes | -365 | 1575 | 300 | 665 | NA | NA | NA | NA | NA | Pass | 137 | Pass | -242 | 0 | 300 | 542 | NA | NA | NA | NA | NA | Pass | 133 | Pass | NA | NA | NA | NA | NA | NA | NA | NA | NA | Pass | -17 | 150 | 133 | Pass | Pass | Pass | Pass | Pass | zynq_ddr3_diffpin.ibs | SSTL15_F_PSDDR
Fail | /Principal/BANK_502/DDR_CLK_N;/Principal/BANK_502/DDR_CLK_P | /Principal/BANK_502/DDR_RAS | U1.P21 | U2.K7 | Typical | 0,351 | 0,443 | 0,519 | 0,351 | 0,443 | 0,519 | Yes | Pin | Pin | Yes | -286 | 1500 | 300 | 586 | NA | NA | NA | NA | NA | Pass | 329 | Fail | -188 | 0 | 300 | 488 | NA | NA | NA | NA | NA | Pass | 333 | Fail | NA | NA | NA | NA | NA | NA | NA | NA | NA | Pass | NA | NA | NA | Pass | Pass | Pass | Pass | Pass | zynq_ddr3_diffpin.ibs | SSTL15_F_PSDDR
Pass | /Principal/BANK_502/DDR_CLK_N;/Principal/BANK_502/DDR_CLK_P | /Principal/BANK_502/DDR_RAS | U1.P21 | U3.K7 | Typical | 0,480 | 0,593 | 0,519 | 0,480 | 0,593 | 0,519 | Yes | Pin | Pin | Yes | -398 | 1500 | 300 | 698 | NA | NA | NA | NA | NA | Pass | 85 | Pass | -286 | 0 | 300 | 586 | NA | NA | NA | NA | NA | Pass | 88 | Pass | NA | NA | NA | NA | NA | NA | NA | NA | NA | Pass | NA | NA | NA | Pass | Pass | Pass | Pass | Pass | zynq_ddr3_diffpin.ibs | SSTL15_F_PSDDR
Fail | /Principal/BANK_502/DDR_CLK_N;/Principal/BANK_502/DDR_CLK_P | /Principal/BANK_502/DDR_RAS | U1.R21 | U2.J7 | Typical | 0,351 | 0,443 | 0,519 | 0,351 | 0,443 | 0,519 | Yes | Pin | Pin | Yes | -288 | 1500 | 300 | 588 | NA | NA | NA | NA | NA | Pass | 333 | Fail | -190 | 0 | 300 | 490 | NA | NA | NA | NA | NA | Pass | 329 | Fail | NA | NA | NA | NA | NA | NA | NA | NA | NA | Pass | NA | NA | NA | Pass | Pass | Pass | Pass | Pass | zynq_ddr3_diffpin.ibs | SSTL15_F_PSDDR
Pass | /Principal/BANK_502/DDR_CLK_N;/Principal/BANK_502/DDR_CLK_P | /Principal/BANK_502/DDR_RAS | U1.R21 | U3.J7 | Typical | 0,480 | 0,593 | 0,519 | 0,480 | 0,593 | 0,519 | Yes | Pin | Pin | Yes | -401 | 1500 | 300 | 701 | NA | NA | NA | NA | NA | Pass | 88 | Pass | -271 | 0 | 300 | 571 | NA | NA | NA | NA | NA | Pass | 85 | Pass | NA | NA | NA | NA | NA | NA | NA | NA | NA | Pass | NA | NA | NA | Pass | Pass | Pass | Pass | Pass | zynq_ddr3_diffpin.ibs | SSTL15_F_PSDDR
Pass | /Principal/BANK_502/DDR_CLK_N;/Principal/BANK_502/DDR_CLK_P | /Principal/BANK_502/DDR_RAS | U1.P21 | U2.K7 | Slow-Weak | 0,321 | 0,448 | 0,671 | 0,321 | 0,452 | 0,671 | Yes | Pin | Pin | Yes | -370 | 1425 | 300 | 670 | NA | NA | NA | NA | NA | Pass | 230 | Pass | -277 | 0 | 300 | 577 | NA | NA | NA | NA | NA | Pass | 232 | Pass | NA | NA | NA | NA | NA | NA | NA | NA | NA | Pass | NA | NA | NA | Pass | Pass | Pass | Pass | Pass | zynq_ddr3_diffpin.ibs | SSTL15_F_PSDDR
Pass | /Principal/BANK_502/DDR_CLK_N;/Principal/BANK_502/DDR_CLK_P | /Principal/BANK_502/DDR_RAS | U1.P21 | U3.K7 | Slow-Weak | 0,443 | 0,607 | 0,671 | 0,443 | 0,612 | 0,671 | Yes | Pin | Pin | Yes | -432 | 1425 | 300 | 732 | NA | NA | NA | NA | NA | Pass | 58 | Pass | -342 | 0 | 300 | 642 | NA | NA | NA | NA | NA | Pass | 60 | Pass | NA | NA | NA | NA | NA | NA | NA | NA | NA | Pass | NA | NA | NA | Pass | Pass | Pass | Pass | Pass | zynq_ddr3_diffpin.ibs | SSTL15_F_PSDDR
Pass | /Principal/BANK_502/DDR_CLK_N;/Principal/BANK_502/DDR_CLK_P | /Principal/BANK_502/DDR_RAS | U1.R21 | U2.J7 | Slow-Weak | 0,321 | 0,452 | 0,671 | 0,321 | 0,448 | 0,671 | Yes | Pin | Pin | Yes | -371 | 1425 | 300 | 671 | NA | NA | NA | NA | NA | Pass | 232 | Pass | -279 | 0 | 300 | 579 | NA | NA | NA | NA | NA | Pass | 230 | Pass | NA | NA | NA | NA | NA | NA | NA | NA | NA | Pass | NA | NA | NA | Pass | Pass | Pass | Pass | Pass | zynq_ddr3_diffpin.ibs | SSTL15_F_PSDDR
Pass | /Principal/BANK_502/DDR_CLK_N;/Principal/BANK_502/DDR_CLK_P | /Principal/BANK_502/DDR_RAS | U1.R21 | U3.J7 | Slow-Weak | 0,443 | 0,612 | 0,671 | 0,443 | 0,607 | 0,671 | Yes | Pin | Pin | Yes | -435 | 1425 | 300 | 735 | NA | NA | NA | NA | NA | Pass | 60 | Pass | -332 | 0 | 300 | 632 | NA | NA | NA | NA | NA | Pass | 58 | Pass | NA | NA | NA | NA | NA | NA | NA | NA | NA | Pass | NA | NA | NA | Pass | Pass | Pass | Pass | Pass | zynq_ddr3_diffpin.ibs | SSTL15_F_PSDDR
Fail | /Principal/BANK_502/DDR_RESET
Fail | /Principal/BANK_502/DDR_DQ1 |  | U1.F25 | U2.A3 | Fast-Strong | 0,341 | 0,390 | 0,448 | 0,335 | 0,385 | 0,437 | Yes | Pin | Pin | No | 473 | 1575 | 300 | -173 | NA | NA | NA | NA | NA | Fail | 475 | Fail | 500 | 0 | 300 | -200 | NA | NA | NA | NA | NA | Fail | 500 | Fail | NA | NA | NA | NA | NA | NA | NA | NA | NA | Pass | NA | NA | NA | Pass | Pass | Pass | Pass | Pass | zynq_ddr3_diffpin.ibs | SSTL15_DCI_F_PSDDR_O
Fail | /Principal/BANK_502/DDR_DQ1 |  | U1.F25 | U2.A3 | Typical | 0,361 | 0,425 | 0,543 | 0,362 | 0,421 | 0,516 | Yes | Pin | Pin | No | 247 | 1500 | 300 | 53 | NA | NA | NA | NA | NA | Pass | 249 | Pass | 340 | 0 | 300 | -40 | NA | NA | NA | NA | NA | Fail | 340 | Fail | NA | NA | NA | NA | NA | NA | NA | NA | NA | Pass | NA | NA | NA | Pass | Pass | Pass | Pass | Pass | zynq_ddr3_diffpin.ibs | SSTL15_DCI_F_PSDDR_O
Pass | /Principal/BANK_502/DDR_DQ1 |  | U1.F25 | U2.A3 | Slow-Weak | 0,406 | 0,510 | 0,663 | 0,416 | 0,515 | 0,606 | Yes | Pin | Pin | No | 27 | 1425 | 300 | 273 | NA | NA | NA | NA | NA | Pass | 29 | Pass | 27 | 0 | 300 | 273 | NA | NA | NA | NA | NA | Pass | 27 | Pass | NA | NA | NA | NA | NA | NA | NA | NA | NA | Pass | NA | NA | NA | Pass | Pass | Pass | Pass | Pass | zynq_ddr3_diffpin.ibs | SSTL15_DCI_F_PSDDR_O
Pass | /Principal/BANK_502/DDR_DM0 |  | U1.G24 | U2.D3 | Fast-Strong | 0,264 | 0,339 | 0,443 | 0,248 | 0,321 | 0,432 | Yes | Pin | Pin | No | -236 | 1575 | 300 | 536 | NA | NA | NA | NA | NA | Pass | 12 | Pass | -202 | 0 | 300 | 502 | NA | NA | NA | NA | NA | Pass | 15 | Pass | NA | NA | NA | NA | NA | NA | NA | NA | NA | Pass | NA | NA | NA | Pass | Pass | Pass | Pass | Pass | zynq_ddr3_diffpin.ibs | SSTL15_DCI_F_PSDDR_O
Pass | /Principal/BANK_502/DDR_DM0 |  | U1.G24 | U2.D3 | Typical | 0,260 | 0,353 | 0,538 | 0,261 | 0,350 | 0,511 | Yes | Pin | Pin | No | -221 | 1500 | 300 | 521 | NA | NA | NA | NA | NA | Pass | 19 | Pass | -194 | 0 | 300 | 494 | NA | NA | NA | NA | NA | Pass | 24 | Pass | NA | NA | NA | NA | NA | NA | NA | NA | NA | Pass | NA | NA | NA | Pass | Pass | Pass | Pass | Pass | zynq_ddr3_diffpin.ibs | SSTL15_DCI_F_PSDDR_O
Pass | /Principal/BANK_502/DDR_DM0 |  | U1.G24 | U2.D3 | Slow-Weak | 0,242 | 0,388 | 0,658 | 0,270 | 0,404 | 0,601 | Yes | Pin | Pin | No | -261 | 1425 | 300 | 561 | NA | NA | NA | NA | NA | Pass | 0 | Pass | -231 | 0 | 300 | 531 | NA | NA | NA | NA | NA | Pass | 10 | Pass | NA | NA | NA | NA | NA | NA | NA | NA | NA | Pass | NA | NA | NA | Pass | Pass | Pass | Pass | Pass | zynq_ddr3_diffpin.ibs | SSTL15_DCI_F_PSDDR_O
Fail | /Principal/BANK_502/DDR_DQS0_N;/Principal/BANK_502/DDR_DQS0_P |  | U1.G25 | U2.B7 | Fast-Strong | 0,339 | 0,391 | 0,420 | 0,339 | 0,391 | 0,420 | Yes | Pin | Pin | Yes | 450 | 1575 | 300 | -150 | NA | NA | NA | NA | NA | Fail | 932 | Fail | 480 | 0 | 300 | -180 | NA | NA | NA | NA | NA | Fail | 933 | Fail | NA | NA | NA | NA | NA | NA | NA | NA | NA | Pass | NA | NA | NA | Pass | Pass | Pass | Pass | Pass | zynq_ddr3_diffpin.ibs | SSTL15_DCI_F_PSDDR_O
Fail | /Principal/BANK_502/DDR_DQS0_N;/Principal/BANK_502/DDR_DQS0_P |  | U1.H24 | U2.C7 | Fast-Strong | 0,339 | 0,391 | 0,420 | 0,339 | 0,391 | 0,420 | Yes | Pin | Pin | Yes | 451 | 1575 | 300 | -151 | NA | NA | NA | NA | NA | Fail | 933 | Fail | 481 | 0 | 300 | -181 | NA | NA | NA | NA | NA | Fail | 932 | Fail | NA | NA | NA | NA | NA | NA | NA | NA | NA | Pass | NA | NA | NA | Pass | Pass | Pass | Pass | Pass | zynq_ddr3_diffpin.ibs | SSTL15_DCI_F_PSDDR_O
Fail | /Principal/BANK_502/DDR_DQS0_N;/Principal/BANK_502/DDR_DQS0_P |  | U1.G25 | U2.B7 | Typical | 0,361 | 0,428 | 0,509 | 0,361 | 0,428 | 0,509 | Yes | Pin | Pin | Yes | 205 | 1500 | 300 | 95 | NA | NA | NA | NA | NA | Pass | 513 | Fail | 305 | 0 | 300 | -5 | NA | NA | NA | NA | NA | Fail | 514 | Fail | NA | NA | NA | NA | NA | NA | NA | NA | NA | Pass | NA | NA | NA | Pass | Pass | Pass | Pass | Pass | zynq_ddr3_diffpin.ibs | SSTL15_DCI_F_PSDDR_O
Fail | /Principal/BANK_502/DDR_DQS0_N;/Principal/BANK_502/DDR_DQS0_P |  | U1.H24 | U2.C7 | Typical | 0,361 | 0,428 | 0,509 | 0,361 | 0,428 | 0,509 | Yes | Pin | Pin | Yes | 208 | 1500 | 300 | 92 | NA | NA | NA | NA | NA | Pass | 514 | Fail | 307 | 0 | 300 | -7 | NA | NA | NA | NA | NA | Fail | 513 | Fail | NA | NA | NA | NA | NA | NA | NA | NA | NA | Pass | NA | NA | NA | Pass | Pass | Pass | Pass | Pass | zynq_ddr3_diffpin.ibs | SSTL15_DCI_F_PSDDR_O
Pass | /Principal/BANK_502/DDR_DQS0_N;/Principal/BANK_502/DDR_DQS0_P |  | U1.G25 | U2.B7 | Slow-Weak | 0,413 | 0,529 | 0,615 | 0,413 | 0,529 | 0,615 | Yes | Pin | Pin | Yes | 37 | 1425 | 300 | 263 | NA | NA | NA | NA | NA | Pass | 78 | Pass | 40 | 0 | 300 | 260 | NA | NA | NA | NA | NA | Pass | 79 | Pass | NA | NA | NA | NA | NA | NA | NA | NA | NA | Pass | NA | NA | NA | Pass | Pass | Pass | Pass | Pass | zynq_ddr3_diffpin.ibs | SSTL15_DCI_F_PSDDR_O
Pass | /Principal/BANK_502/DDR_DQS0_N;/Principal/BANK_502/DDR_DQS0_P |  | U1.H24 | U2.C7 | Slow-Weak | 0,413 | 0,529 | 0,615 | 0,413 | 0,529 | 0,615 | Yes | Pin | Pin | Yes | 37 | 1425 | 300 | 263 | NA | NA | NA | NA | NA | Pass | 79 | Pass | 39 | 0 | 300 | 261 | NA | NA | NA | NA | NA | Pass | 78 | Pass | NA | NA | NA | NA | NA | NA | NA | NA | NA | Pass | NA | NA | NA | Pass | Pass | Pass | Pass | Pass | zynq_ddr3_diffpin.ibs | SSTL15_DCI_F_PSDDR_O
Fail | /Principal/BANK_502/DDR_DQ3 |  | U1.G26 | U2.C2 | Fast-Strong | 0,347 | 0,396 | 0,442 | 0,341 | 0,387 | 0,431 | Yes | Pin | Pin | No | 467 | 1575 | 300 | -167 | NA | NA | NA | NA | NA | Fail | 469 | Fail | 487 | 0 | 300 | -187 | NA | NA | NA | NA | NA | Fail | 487 | Fail | NA | NA | NA | NA | NA | NA | NA | NA | NA | Pass | NA | NA | NA | Pass | Pass | Pass | Pass | Pass | zynq_ddr3_diffpin.ibs | SSTL15_DCI_F_PSDDR_O
Fail | /Principal/BANK_502/DDR_DQ3 |  | U1.G26 | U2.C2 | Typical | 0,367 | 0,431 | 0,537 | 0,368 | 0,427 | 0,510 | Yes | Pin | Pin | No | 246 | 1500 | 300 | 54 | NA | NA | NA | NA | NA | Pass | 247 | Pass | 334 | 0 | 300 | -34 | NA | NA | NA | NA | NA | Fail | 334 | Fail | NA | NA | NA | NA | NA | NA | NA | NA | NA | Pass | NA | NA | NA | Pass | Pass | Pass | Pass | Pass | zynq_ddr3_diffpin.ibs | SSTL15_DCI_F_PSDDR_O
Pass | /Principal/BANK_502/DDR_DQ3 |  | U1.G26 | U2.C2 | Slow-Weak | 0,411 | 0,515 | 0,658 | 0,422 | 0,521 | 0,600 | Yes | Pin | Pin | No | 31 | 1425 | 300 | 269 | NA | NA | NA | NA | NA | Pass | 32 | Pass | 31 | 0 | 300 | 269 | NA | NA | NA | NA | NA | Pass | 31 | Pass | NA | NA | NA | NA | NA | NA | NA | NA | NA | Pass | NA | NA | NA | Pass | Pass | Pass | Pass | Pass | zynq_ddr3_diffpin.ibs | SSTL15_DCI_F_PSDDR_O
Fail | /Principal/BANK_502/DDR_DQ5 |  | U1.H23 | U2.A2 | Fast-Strong | 0,340 | 0,396 | 0,442 | 0,338 | 0,387 | 0,431 | Yes | Pin | Pin | No | 459 | 1575 | 300 | -159 | NA | NA | NA | NA | NA | Fail | 461 | Fail | 485 | 0 | 300 | -185 | NA | NA | NA | NA | NA | Fail | 485 | Fail | NA | NA | NA | NA | NA | NA | NA | NA | NA | Pass | NA | NA | NA | Pass | Pass | Pass | Pass | Pass | zynq_ddr3_diffpin.ibs | SSTL15_DCI_F_PSDDR_O
Fail | /Principal/BANK_502/DDR_DQ5 |  | U1.H23 | U2.A2 | Typical | 0,362 | 0,435 | 0,537 | 0,363 | 0,427 | 0,511 | Yes | Pin | Pin | No | 234 | 1500 | 300 | 66 | NA | NA | NA | NA | NA | Pass | 236 | Pass | 328 | 0 | 300 | -28 | NA | NA | NA | NA | NA | Fail | 328 | Fail | NA | NA | NA | NA | NA | NA | NA | NA | NA | Pass | NA | NA | NA | Pass | Pass | Pass | Pass | Pass | zynq_ddr3_diffpin.ibs | SSTL15_DCI_F_PSDDR_O
Pass | /Principal/BANK_502/DDR_DQ5 |  | U1.H23 | U2.A2 | Slow-Weak | 0,411 | 0,521 | 0,658 | 0,422 | 0,521 | 0,600 | Yes | Pin | Pin | No | 26 | 1425 | 300 | 274 | NA | NA | NA | NA | NA | Pass | 28 | Pass | 27 | 0 | 300 | 273 | NA | NA | NA | NA | NA | Pass | 27 | Pass | NA | NA | NA | NA | NA | NA | NA | NA | NA | Pass | NA | NA | NA | Pass | Pass | Pass | Pass | Pass | zynq_ddr3_diffpin.ibs | SSTL15_DCI_F_PSDDR_O
Fail | /Principal/BANK_502/DDR_DQ4 |  | U1.H26 | U2.C3 | Fast-Strong | 0,341 | 0,387 | 0,441 | 0,336 | 0,378 | 0,430 | Yes | Pin | Pin | No | 476 | 1575 | 300 | -176 | NA | NA | NA | NA | NA | Fail | 478 | Fail | 503 | 0 | 300 | -203 | NA | NA | NA | NA | NA | Fail | 503 | Fail | NA | NA | NA | NA | NA | NA | NA | NA | NA | Pass | NA | NA | NA | Pass | Pass | Pass | Pass | Pass | zynq_ddr3_diffpin.ibs | SSTL15_DCI_F_PSDDR_O
Fail | /Principal/BANK_502/DDR_DQ4 |  | U1.H26 | U2.C3 | Typical | 0,359 | 0,419 | 0,536 | 0,360 | 0,415 | 0,510 | Yes | Pin | Pin | No | 249 | 1500 | 300 | 51 | NA | NA | NA | NA | NA | Pass | 250 | Pass | 340 | 0 | 300 | -40 | NA | NA | NA | NA | NA | Fail | 340 | Fail | NA | NA | NA | NA | NA | NA | NA | NA | NA | Pass | NA | NA | NA | Pass | Pass | Pass | Pass | Pass | zynq_ddr3_diffpin.ibs | SSTL15_DCI_F_PSDDR_O
Pass | /Principal/BANK_502/DDR_DQ4 |  | U1.H26 | U2.C3 | Slow-Weak | 0,401 | 0,505 | 0,656 | 0,417 | 0,510 | 0,599 | Yes | Pin | Pin | No | 30 | 1425 | 300 | 270 | NA | NA | NA | NA | NA | Pass | 32 | Pass | 29 | 0 | 300 | 271 | NA | NA | NA | NA | NA | Pass | 29 | Pass | NA | NA | NA | NA | NA | NA | NA | NA | NA | Pass | NA | NA | NA | Pass | Pass | Pass | Pass | Pass | zynq_ddr3_diffpin.ibs | SSTL15_DCI_F_PSDDR_O
Fail | /Principal/BANK_502/DDR_DQ7 | /Principal/BANK_500/UART_485_RX | U1.J23 | U2.B8 | Fast-Strong | 0,365 | 0,421 | 0,420 | 0,360 | 0,412 | 0,409 | Yes | Pin | Pin | No | 478 | 1575 | 300 | -178 | NA | NA | NA | NA | NA | Fail | 480 | Fail | 515 | 0 | 300 | -215 | NA | NA | NA | NA | NA | Fail | 515 | Fail | NA | NA | NA | NA | NA | NA | NA | NA | NA | Pass | NA | NA | NA | Pass | Pass | Pass | Pass | Pass | zynq_ddr3_diffpin.ibs | SSTL15_DCI_F_PSDDR_O
Fail | /Principal/BANK_502/DDR_DQ7 | /Principal/BANK_500/UART_485_RX | U1.J23 | U2.B8 | Typical | 0,384 | 0,460 | 0,516 | 0,389 | 0,453 | 0,489 | Yes | Pin | Pin | No | 235 | 1500 | 300 | 65 | NA | NA | NA | NA | NA | Pass | 236 | Pass | 328 | 0 | 300 | -28 | NA | NA | NA | NA | NA | Fail | 328 | Fail | NA | NA | NA | NA | NA | NA | NA | NA | NA | Pass | NA | NA | NA | Pass | Pass | Pass | Pass | Pass | zynq_ddr3_diffpin.ibs | SSTL15_DCI_F_PSDDR_O
Pass | /Principal/BANK_502/DDR_DQ7 | /Principal/BANK_500/UART_485_RX | U1.J23 | U2.B8 | Slow-Weak | 0,430 | 0,540 | 0,639 | 0,449 | 0,548 | 0,579 | Yes | Pin | Pin | No | 26 | 1425 | 300 | 274 | NA | NA | NA | NA | NA | Pass | 27 | Pass | 27 | 0 | 300 | 273 | NA | NA | NA | NA | NA | Pass | 27 | Pass | NA | NA | NA | NA | NA | NA | NA | NA | NA | Pass | NA | NA | NA | Pass | Pass | Pass | Pass | Pass | zynq_ddr3_diffpin.ibs | SSTL15_DCI_F_PSDDR_O
Fail | /Principal/BANK_502/DDR_DQ6 |  | U1.J24 | U2.D7 | Fast-Strong | 0,340 | 0,383 | 0,422 | 0,334 | 0,377 | 0,411 | Yes | Pin | Pin | No | 453 | 1575 | 300 | -153 | NA | NA | NA | NA | NA | Fail | 455 | Fail | 479 | 0 | 300 | -179 | NA | NA | NA | NA | NA | Fail | 479 | Fail | NA | NA | NA | NA | NA | NA | NA | NA | NA | Pass | NA | NA | NA | Pass | Pass | Pass | Pass | Pass | zynq_ddr3_diffpin.ibs | SSTL15_DCI_F_PSDDR_O
Fail | /Principal/BANK_502/DDR_DQ6 |  | U1.J24 | U2.D7 | Typical | 0,356 | 0,420 | 0,518 | 0,357 | 0,417 | 0,491 | Yes | Pin | Pin | No | 226 | 1500 | 300 | 74 | NA | NA | NA | NA | NA | Pass | 227 | Pass | 316 | 0 | 300 | -16 | NA | NA | NA | NA | NA | Fail | 316 | Fail | NA | NA | NA | NA | NA | NA | NA | NA | NA | Pass | NA | NA | NA | Pass | Pass | Pass | Pass | Pass | zynq_ddr3_diffpin.ibs | SSTL15_DCI_F_PSDDR_O
Pass | /Principal/BANK_502/DDR_DQ6 |  | U1.J24 | U2.D7 | Slow-Weak | 0,400 | 0,504 | 0,640 | 0,412 | 0,511 | 0,581 | Yes | Pin | Pin | No | 35 | 1425 | 300 | 265 | NA | NA | NA | NA | NA | Pass | 36 | Pass | 36 | 0 | 300 | 264 | NA | NA | NA | NA | NA | Pass | 36 | Pass | NA | NA | NA | NA | NA | NA | NA | NA | NA | Pass | NA | NA | NA | Pass | Pass | Pass | Pass | Pass | zynq_ddr3_diffpin.ibs | SSTL15_DCI_F_PSDDR_O
Fail | /Principal/BANK_502/DDR_DQ2 |  | U1.J25 | U2.A7 | Fast-Strong | 0,346 | 0,395 | 0,429 | 0,340 | 0,390 | 0,418 | Yes | Pin | Pin | No | 468 | 1575 | 300 | -168 | NA | NA | NA | NA | NA | Fail | 470 | Fail | 490 | 0 | 300 | -190 | NA | NA | NA | NA | NA | Fail | 490 | Fail | NA | NA | NA | NA | NA | NA | NA | NA | NA | Pass | NA | NA | NA | Pass | Pass | Pass | Pass | Pass | zynq_ddr3_diffpin.ibs | SSTL15_DCI_F_PSDDR_O
Fail | /Principal/BANK_502/DDR_DQ2 |  | U1.J25 | U2.A7 | Typical | 0,366 | 0,430 | 0,525 | 0,367 | 0,427 | 0,498 | Yes | Pin | Pin | No | 247 | 1500 | 300 | 53 | NA | NA | NA | NA | NA | Pass | 249 | Pass | 333 | 0 | 300 | -33 | NA | NA | NA | NA | NA | Fail | 333 | Fail | NA | NA | NA | NA | NA | NA | NA | NA | NA | Pass | NA | NA | NA | Pass | Pass | Pass | Pass | Pass | zynq_ddr3_diffpin.ibs | SSTL15_DCI_F_PSDDR_O
Pass | /Principal/BANK_502/DDR_DQ2 |  | U1.J25 | U2.A7 | Slow-Weak | 0,411 | 0,515 | 0,646 | 0,423 | 0,521 | 0,588 | Yes | Pin | Pin | No | 31 | 1425 | 300 | 269 | NA | NA | NA | NA | NA | Pass | 33 | Pass | 32 | 0 | 300 | 268 | NA | NA | NA | NA | NA | Pass | 32 | Pass | NA | NA | NA | NA | NA | NA | NA | NA | NA | Pass | NA | NA | NA | Pass | Pass | Pass | Pass | Pass | zynq_ddr3_diffpin.ibs | SSTL15_DCI_F_PSDDR_O
Fail | /Principal/BANK_502/DDR_DQ0 |  | U1.J26 | U2.C8 | Fast-Strong | 0,346 | 0,395 | 0,433 | 0,340 | 0,386 | 0,422 | Yes | Pin | Pin | No | 473 | 1575 | 300 | -173 | NA | NA | NA | NA | NA | Fail | 475 | Fail | 493 | 0 | 300 | -193 | NA | NA | NA | NA | NA | Fail | 493 | Fail | NA | NA | NA | NA | NA | NA | NA | NA | NA | Pass | NA | NA | NA | Pass | Pass | Pass | Pass | Pass | zynq_ddr3_diffpin.ibs | SSTL15_DCI_F_PSDDR_O
Fail | /Principal/BANK_502/DDR_DQ0 |  | U1.J26 | U2.C8 | Typical | 0,363 | 0,431 | 0,528 | 0,364 | 0,423 | 0,501 | Yes | Pin | Pin | No | 254 | 1500 | 300 | 46 | NA | NA | NA | NA | NA | Pass | 256 | Pass | 346 | 0 | 300 | -46 | NA | NA | NA | NA | NA | Fail | 346 | Fail | NA | NA | NA | NA | NA | NA | NA | NA | NA | Pass | NA | NA | NA | Pass | Pass | Pass | Pass | Pass | zynq_ddr3_diffpin.ibs | SSTL15_DCI_F_PSDDR_O
Pass | /Principal/BANK_502/DDR_DQ0 |  | U1.J26 | U2.C8 | Slow-Weak | 0,409 | 0,513 | 0,648 | 0,425 | 0,518 | 0,591 | Yes | Pin | Pin | No | 29 | 1425 | 300 | 271 | NA | NA | NA | NA | NA | Pass | 31 | Pass | 30 | 0 | 300 | 270 | NA | NA | NA | NA | NA | Pass | 30 | Pass | NA | NA | NA | NA | NA | NA | NA | NA | NA | Pass | NA | NA | NA | Pass | Pass | Pass | Pass | Pass | zynq_ddr3_diffpin.ibs | SSTL15_DCI_F_PSDDR_O
Fail | /Principal/BANK_502/DDR_DQ11 |  | U1.K23 | U2.E3 | Fast-Strong | 0,318 | 0,361 | 0,411 | 0,313 | 0,355 | 0,400 | Yes | Pin | Pin | No | 446 | 1575 | 300 | -146 | NA | NA | NA | NA | NA | Fail | 448 | Fail | 482 | 0 | 300 | -182 | NA | NA | NA | NA | NA | Fail | 482 | Fail | NA | NA | NA | NA | NA | NA | NA | NA | NA | Pass | NA | NA | NA | Pass | Pass | Pass | Pass | Pass | zynq_ddr3_diffpin.ibs | SSTL15_DCI_F_PSDDR_O
Pass | /Principal/BANK_502/DDR_DQ11 |  | U1.K23 | U2.E3 | Typical | 0,334 | 0,393 | 0,507 | 0,335 | 0,394 | 0,480 | Yes | Pin | Pin | No | 198 | 1500 | 300 | 102 | NA | NA | NA | NA | NA | Pass | 200 | Pass | 286 | 0 | 300 | 14 | NA | NA | NA | NA | NA | Pass | 286 | Pass | NA | NA | NA | NA | NA | NA | NA | NA | NA | Pass | NA | NA | NA | Pass | Pass | Pass | Pass | Pass | zynq_ddr3_diffpin.ibs | SSTL15_DCI_F_PSDDR_O
Pass | /Principal/BANK_502/DDR_DQ11 |  | U1.K23 | U2.E3 | Slow-Weak | 0,375 | 0,480 | 0,629 | 0,394 | 0,481 | 0,570 | Yes | Pin | Pin | No | 32 | 1425 | 300 | 268 | NA | NA | NA | NA | NA | Pass | 33 | Pass | 34 | 0 | 300 | 266 | NA | NA | NA | NA | NA | Pass | 34 | Pass | NA | NA | NA | NA | NA | NA | NA | NA | NA | Pass | NA | NA | NA | Pass | Pass | Pass | Pass | Pass | zynq_ddr3_diffpin.ibs | SSTL15_DCI_F_PSDDR_O
Pass | /Principal/BANK_502/DDR_DM1 |  | U1.K25 | U2.E7 | Fast-Strong | 0,239 | 0,311 | 0,434 | 0,224 | 0,296 | 0,423 | Yes | Pin | Pin | No | -231 | 1575 | 300 | 531 | NA | NA | NA | NA | NA | Pass | 15 | Pass | -195 | 0 | 300 | 495 | NA | NA | NA | NA | NA | Pass | 20 | Pass | NA | NA | NA | NA | NA | NA | NA | NA | NA | Pass | NA | NA | NA | Pass | Pass | Pass | Pass | Pass | zynq_ddr3_diffpin.ibs | SSTL15_DCI_F_PSDDR_O
Pass | /Principal/BANK_502/DDR_DM1 |  | U1.K25 | U2.E7 | Typical | 0,234 | 0,324 | 0,529 | 0,235 | 0,320 | 0,503 | Yes | Pin | Pin | No | -217 | 1500 | 300 | 517 | NA | NA | NA | NA | NA | Pass | 22 | Pass | -191 | 0 | 300 | 491 | NA | NA | NA | NA | NA | Pass | 27 | Pass | NA | NA | NA | NA | NA | NA | NA | NA | NA | Pass | NA | NA | NA | Pass | Pass | Pass | Pass | Pass | zynq_ddr3_diffpin.ibs | SSTL15_DCI_F_PSDDR_O
Pass | /Principal/BANK_502/DDR_DM1 |  | U1.K25 | U2.E7 | Slow-Weak | 0,216 | 0,355 | 0,650 | 0,244 | 0,377 | 0,592 | Yes | Pin | Pin | No | -257 | 1425 | 300 | 557 | NA | NA | NA | NA | NA | Pass | 0 | Pass | -227 | 0 | 300 | 527 | NA | NA | NA | NA | NA | Pass | 12 | Pass | NA | NA | NA | NA | NA | NA | NA | NA | NA | Pass | NA | NA | NA | Pass | Pass | Pass | Pass | Pass | zynq_ddr3_diffpin.ibs | SSTL15_DCI_F_PSDDR_O
Fail | /Principal/BANK_502/DDR_DQ8 |  | U1.K26 | U2.H3 | Fast-Strong | 0,316 | 0,365 | 0,433 | 0,314 | 0,360 | 0,422 | Yes | Pin | Pin | No | 480 | 1575 | 300 | -180 | NA | NA | NA | NA | NA | Fail | 482 | Fail | 500 | 0 | 300 | -200 | NA | NA | NA | NA | NA | Fail | 500 | Fail | NA | NA | NA | NA | NA | NA | NA | NA | NA | Pass | NA | NA | NA | Pass | Pass | Pass | Pass | Pass | zynq_ddr3_diffpin.ibs | SSTL15_DCI_F_PSDDR_O
Fail | /Principal/BANK_502/DDR_DQ8 |  | U1.K26 | U2.H3 | Typical | 0,333 | 0,401 | 0,528 | 0,338 | 0,393 | 0,502 | Yes | Pin | Pin | No | 261 | 1500 | 300 | 39 | NA | NA | NA | NA | NA | Pass | 263 | Pass | 345 | 0 | 300 | -45 | NA | NA | NA | NA | NA | Fail | 345 | Fail | NA | NA | NA | NA | NA | NA | NA | NA | NA | Pass | NA | NA | NA | Pass | Pass | Pass | Pass | Pass | zynq_ddr3_diffpin.ibs | SSTL15_DCI_F_PSDDR_O
Pass | /Principal/BANK_502/DDR_DQ8 |  | U1.K26 | U2.H3 | Slow-Weak | 0,378 | 0,483 | 0,650 | 0,396 | 0,489 | 0,591 | Yes | Pin | Pin | No | 33 | 1425 | 300 | 267 | NA | NA | NA | NA | NA | Pass | 35 | Pass | 34 | 0 | 300 | 266 | NA | NA | NA | NA | NA | Pass | 34 | Pass | NA | NA | NA | NA | NA | NA | NA | NA | NA | Pass | NA | NA | NA | Pass | Pass | Pass | Pass | Pass | zynq_ddr3_diffpin.ibs | SSTL15_DCI_F_PSDDR_O
Fail | /Principal/BANK_502/DDR_DQ9 |  | U1.L23 | U2.H8 | Fast-Strong | 0,359 | 0,405 | 0,413 | 0,357 | 0,399 | 0,402 | Yes | Pin | Pin | No | 505 | 1575 | 300 | -205 | NA | NA | NA | NA | NA | Fail | 508 | Fail | 521 | 0 | 300 | -221 | NA | NA | NA | NA | NA | Fail | 521 | Fail | NA | NA | NA | NA | NA | NA | NA | NA | NA | Pass | NA | NA | NA | Pass | Pass | Pass | Pass | Pass | zynq_ddr3_diffpin.ibs | SSTL15_DCI_F_PSDDR_O
Fail | /Principal/BANK_502/DDR_DQ9 |  | U1.L23 | U2.H8 | Typical | 0,378 | 0,442 | 0,509 | 0,379 | 0,439 | 0,482 | Yes | Pin | Pin | No | 281 | 1500 | 300 | 19 | NA | NA | NA | NA | NA | Pass | 283 | Pass | 364 | 0 | 300 | -64 | NA | NA | NA | NA | NA | Fail | 364 | Fail | NA | NA | NA | NA | NA | NA | NA | NA | NA | Pass | NA | NA | NA | Pass | Pass | Pass | Pass | Pass | zynq_ddr3_diffpin.ibs | SSTL15_DCI_F_PSDDR_O
Pass | /Principal/BANK_502/DDR_DQ9 |  | U1.L23 | U2.H8 | Slow-Weak | 0,419 | 0,535 | 0,632 | 0,439 | 0,537 | 0,572 | Yes | Pin | Pin | No | 38 | 1425 | 300 | 262 | NA | NA | NA | NA | NA | Pass | 39 | Pass | 35 | 0 | 300 | 265 | NA | NA | NA | NA | NA | Pass | 35 | Pass | NA | NA | NA | NA | NA | NA | NA | NA | NA | Pass | NA | NA | NA | Pass | Pass | Pass | Pass | Pass | zynq_ddr3_diffpin.ibs | SSTL15_DCI_F_PSDDR_O
Fail | /Principal/BANK_502/DDR_DQS1_P;/Principal/BANK_502/DDR_DQS1_N |  | U1.L24 | U2.F3 | Fast-Strong | 0,304 | 0,347 | 0,412 | 0,304 | 0,347 | 0,412 | Yes | Pin | Pin | Yes | 425 | 1575 | 300 | -125 | NA | NA | NA | NA | NA | Fail | 890 | Fail | 466 | 0 | 300 | -166 | NA | NA | NA | NA | NA | Fail | 888 | Fail | NA | NA | NA | NA | NA | NA | NA | NA | NA | Pass | NA | NA | NA | Pass | Pass | Pass | Pass | Pass | zynq_ddr3_diffpin.ibs | SSTL15_DCI_F_PSDDR_O
Fail | /Principal/BANK_502/DDR_DQS1_P;/Principal/BANK_502/DDR_DQS1_N |  | U1.L25 | U2.G3 | Fast-Strong | 0,304 | 0,347 | 0,412 | 0,304 | 0,347 | 0,412 | Yes | Pin | Pin | Yes | 424 | 1575 | 300 | -124 | NA | NA | NA | NA | NA | Fail | 888 | Fail | 467 | 0 | 300 | -167 | NA | NA | NA | NA | NA | Fail | 890 | Fail | NA | NA | NA | NA | NA | NA | NA | NA | NA | Pass | NA | NA | NA | Pass | Pass | Pass | Pass | Pass | zynq_ddr3_diffpin.ibs | SSTL15_DCI_F_PSDDR_O
Fail | /Principal/BANK_502/DDR_DQS1_P;/Principal/BANK_502/DDR_DQS1_N |  | U1.L24 | U2.F3 | Typical | 0,322 | 0,381 | 0,501 | 0,322 | 0,381 | 0,501 | Yes | Pin | Pin | Yes | 158 | 1500 | 300 | 142 | NA | NA | NA | NA | NA | Pass | 411 | Fail | 252 | 0 | 300 | 48 | NA | NA | NA | NA | NA | Pass | 411 | Fail | NA | NA | NA | NA | NA | NA | NA | NA | NA | Pass | NA | NA | NA | Pass | Pass | Pass | Pass | Pass | zynq_ddr3_diffpin.ibs | SSTL15_DCI_F_PSDDR_O
Fail | /Principal/BANK_502/DDR_DQS1_P;/Principal/BANK_502/DDR_DQS1_N |  | U1.L25 | U2.G3 | Typical | 0,322 | 0,381 | 0,501 | 0,322 | 0,381 | 0,501 | Yes | Pin | Pin | Yes | 157 | 1500 | 300 | 143 | NA | NA | NA | NA | NA | Pass | 411 | Fail | 251 | 0 | 300 | 49 | NA | NA | NA | NA | NA | Pass | 411 | Fail | NA | NA | NA | NA | NA | NA | NA | NA | NA | Pass | NA | NA | NA | Pass | Pass | Pass | Pass | Pass | zynq_ddr3_diffpin.ibs | SSTL15_DCI_F_PSDDR_O
Pass | /Principal/BANK_502/DDR_DQS1_P;/Principal/BANK_502/DDR_DQS1_N |  | U1.L24 | U2.F3 | Slow-Weak | 0,374 | 0,485 | 0,607 | 0,374 | 0,485 | 0,607 | Yes | Pin | Pin | Yes | 37 | 1425 | 300 | 263 | NA | NA | NA | NA | NA | Pass | 84 | Pass | 45 | 0 | 300 | 255 | NA | NA | NA | NA | NA | Pass | 83 | Pass | NA | NA | NA | NA | NA | NA | NA | NA | NA | Pass | NA | NA | NA | Pass | Pass | Pass | Pass | Pass | zynq_ddr3_diffpin.ibs | SSTL15_DCI_F_PSDDR_O
Pass | /Principal/BANK_502/DDR_DQS1_P;/Principal/BANK_502/DDR_DQS1_N |  | U1.L25 | U2.G3 | Slow-Weak | 0,374 | 0,485 | 0,607 | 0,374 | 0,485 | 0,607 | Yes | Pin | Pin | Yes | 37 | 1425 | 300 | 263 | NA | NA | NA | NA | NA | Pass | 83 | Pass | 45 | 0 | 300 | 255 | NA | NA | NA | NA | NA | Pass | 84 | Pass | NA | NA | NA | NA | NA | NA | NA | NA | NA | Pass | NA | NA | NA | Pass | Pass | Pass | Pass | Pass | zynq_ddr3_diffpin.ibs | SSTL15_DCI_F_PSDDR_O
Fail | /Principal/BANK_502/DDR_DQ14 |  | U1.M24 | U2.H7 | Fast-Strong | 0,310 | 0,359 | 0,426 | 0,307 | 0,353 | 0,415 | Yes | Pin | Pin | No | 465 | 1575 | 300 | -165 | NA | NA | NA | NA | NA | Fail | 467 | Fail | 489 | 0 | 300 | -189 | NA | NA | NA | NA | NA | Fail | 489 | Fail | NA | NA | NA | NA | NA | NA | NA | NA | NA | Pass | NA | NA | NA | Pass | Pass | Pass | Pass | Pass | zynq_ddr3_diffpin.ibs | SSTL15_DCI_F_PSDDR_O
Fail | /Principal/BANK_502/DDR_DQ14 |  | U1.M24 | U2.H7 | Typical | 0,327 | 0,391 | 0,521 | 0,332 | 0,388 | 0,495 | Yes | Pin | Pin | No | 232 | 1500 | 300 | 68 | NA | NA | NA | NA | NA | Pass | 234 | Pass | 322 | 0 | 300 | -22 | NA | NA | NA | NA | NA | Fail | 322 | Fail | NA | NA | NA | NA | NA | NA | NA | NA | NA | Pass | NA | NA | NA | Pass | Pass | Pass | Pass | Pass | zynq_ddr3_diffpin.ibs | SSTL15_DCI_F_PSDDR_O
Pass | /Principal/BANK_502/DDR_DQ14 |  | U1.M24 | U2.H7 | Slow-Weak | 0,374 | 0,479 | 0,642 | 0,385 | 0,484 | 0,585 | Yes | Pin | Pin | No | 32 | 1425 | 300 | 268 | NA | NA | NA | NA | NA | Pass | 34 | Pass | 34 | 0 | 300 | 266 | NA | NA | NA | NA | NA | Pass | 34 | Pass | NA | NA | NA | NA | NA | NA | NA | NA | NA | Pass | NA | NA | NA | Pass | Pass | Pass | Pass | Pass | zynq_ddr3_diffpin.ibs | SSTL15_DCI_F_PSDDR_O
Fail | /Principal/BANK_502/DDR_DQ12 | /Principal/BANK_502/DDR_DQ10 | U1.M25 | U2.F7 | Fast-Strong | 0,313 | 0,359 | 0,432 | 0,308 | 0,354 | 0,421 | Yes | Pin | Pin | No | 470 | 1575 | 300 | -170 | NA | NA | NA | NA | NA | Fail | 472 | Fail | 493 | 0 | 300 | -193 | NA | NA | NA | NA | NA | Fail | 493 | Fail | NA | NA | NA | NA | NA | NA | NA | NA | NA | Pass | -55 | 150 | 95 | Pass | Pass | Pass | Pass | Pass | zynq_ddr3_diffpin.ibs | SSTL15_DCI_F_PSDDR_O
Fail | /Principal/BANK_502/DDR_DQ12 | /Principal/BANK_502/DDR_DQ10 | U1.M25 | U2.F7 | Typical | 0,329 | 0,393 | 0,528 | 0,330 | 0,390 | 0,501 | Yes | Pin | Pin | No | 237 | 1500 | 300 | 63 | NA | NA | NA | NA | NA | Pass | 239 | Pass | 322 | 0 | 300 | -22 | NA | NA | NA | NA | NA | Fail | 322 | Fail | NA | NA | NA | NA | NA | NA | NA | NA | NA | Pass | NA | NA | NA | Pass | Pass | Pass | Pass | Pass | zynq_ddr3_diffpin.ibs | SSTL15_DCI_F_PSDDR_O
Pass | /Principal/BANK_502/DDR_DQ12 | /Principal/BANK_502/DDR_DQ10 | U1.M25 | U2.F7 | Slow-Weak | 0,373 | 0,483 | 0,649 | 0,391 | 0,484 | 0,591 | Yes | Pin | Pin | No | 34 | 1425 | 300 | 266 | NA | NA | NA | NA | NA | Pass | 35 | Pass | 35 | 0 | 300 | 265 | NA | NA | NA | NA | NA | Pass | 35 | Pass | NA | NA | NA | NA | NA | NA | NA | NA | NA | Pass | NA | NA | NA | Pass | Pass | Pass | Pass | Pass | zynq_ddr3_diffpin.ibs | SSTL15_DCI_F_PSDDR_O
Fail | /Principal/BANK_502/DDR_DQ10 | /Principal/BANK_502/DDR_DQ12;/Principal/BANK_502/DDR_DQ18 | U1.M26 | U2.F8 | Fast-Strong | 0,315 | 0,361 | 0,441 | 0,309 | 0,355 | 0,430 | Yes | Pin | Pin | No | 478 | 1575 | 300 | -178 | NA | NA | NA | NA | NA | Fail | 480 | Fail | 500 | 0 | 300 | -200 | NA | NA | NA | NA | NA | Fail | 500 | Fail | NA | NA | NA | NA | NA | NA | NA | NA | NA | Pass | -97 | 150 | 53 | Pass | Pass | Pass | Pass | Pass | zynq_ddr3_diffpin.ibs | SSTL15_DCI_F_PSDDR_O
Fail | /Principal/BANK_502/DDR_DQ10 | /Principal/BANK_502/DDR_DQ12;/Principal/BANK_502/DDR_DQ18 | U1.M26 | U2.F8 | Typical | 0,334 | 0,397 | 0,536 | 0,335 | 0,390 | 0,510 | Yes | Pin | Pin | No | 251 | 1500 | 300 | 49 | NA | NA | NA | NA | NA | Pass | 253 | Pass | 341 | 0 | 300 | -41 | NA | NA | NA | NA | NA | Fail | 341 | Fail | NA | NA | NA | NA | NA | NA | NA | NA | NA | Pass | NA | NA | NA | Pass | Pass | Pass | Pass | Pass | zynq_ddr3_diffpin.ibs | SSTL15_DCI_F_PSDDR_O
Pass | /Principal/BANK_502/DDR_DQ10 | /Principal/BANK_502/DDR_DQ12;/Principal/BANK_502/DDR_DQ18 | U1.M26 | U2.F8 | Slow-Weak | 0,377 | 0,482 | 0,656 | 0,388 | 0,487 | 0,599 | Yes | Pin | Pin | No | 31 | 1425 | 300 | 269 | NA | NA | NA | NA | NA | Pass | 33 | Pass | 30 | 0 | 300 | 270 | NA | NA | NA | NA | NA | Pass | 30 | Pass | NA | NA | NA | NA | NA | NA | NA | NA | NA | Pass | NA | NA | NA | Pass | Pass | Pass | Pass | Pass | zynq_ddr3_diffpin.ibs | SSTL15_DCI_F_PSDDR_O
Fail | /Principal/BANK_502/DDR_DQ15 |  | U1.N23 | U2.G2 | Fast-Strong | 0,316 | 0,362 | 0,420 | 0,311 | 0,357 | 0,409 | Yes | Pin | Pin | No | 465 | 1575 | 300 | -165 | NA | NA | NA | NA | NA | Fail | 467 | Fail | 491 | 0 | 300 | -191 | NA | NA | NA | NA | NA | Fail | 491 | Fail | NA | NA | NA | NA | NA | NA | NA | NA | NA | Pass | NA | NA | NA | Pass | Pass | Pass | Pass | Pass | zynq_ddr3_diffpin.ibs | SSTL15_DCI_F_PSDDR_O
Fail | /Principal/BANK_502/DDR_DQ15 |  | U1.N23 | U2.G2 | Typical | 0,334 | 0,397 | 0,515 | 0,335 | 0,390 | 0,488 | Yes | Pin | Pin | No | 239 | 1500 | 300 | 61 | NA | NA | NA | NA | NA | Pass | 241 | Pass | 325 | 0 | 300 | -25 | NA | NA | NA | NA | NA | Fail | 325 | Fail | NA | NA | NA | NA | NA | NA | NA | NA | NA | Pass | NA | NA | NA | Pass | Pass | Pass | Pass | Pass | zynq_ddr3_diffpin.ibs | SSTL15_DCI_F_PSDDR_O
Pass | /Principal/BANK_502/DDR_DQ15 |  | U1.N23 | U2.G2 | Slow-Weak | 0,374 | 0,484 | 0,637 | 0,392 | 0,485 | 0,578 | Yes | Pin | Pin | No | 33 | 1425 | 300 | 267 | NA | NA | NA | NA | NA | Pass | 34 | Pass | 34 | 0 | 300 | 266 | NA | NA | NA | NA | NA | Pass | 34 | Pass | NA | NA | NA | NA | NA | NA | NA | NA | NA | Pass | NA | NA | NA | Pass | Pass | Pass | Pass | Pass | zynq_ddr3_diffpin.ibs | SSTL15_DCI_F_PSDDR_O
Fail | /Principal/BANK_502/DDR_DQ13 |  | U1.N24 | U2.F2 | Fast-Strong | 0,317 | 0,363 | 0,428 | 0,312 | 0,358 | 0,417 | Yes | Pin | Pin | No | 462 | 1575 | 300 | -162 | NA | NA | NA | NA | NA | Fail | 464 | Fail | 488 | 0 | 300 | -188 | NA | NA | NA | NA | NA | Fail | 488 | Fail | NA | NA | NA | NA | NA | NA | NA | NA | NA | Pass | NA | NA | NA | Pass | Pass | Pass | Pass | Pass | zynq_ddr3_diffpin.ibs | SSTL15_DCI_F_PSDDR_O
Fail | /Principal/BANK_502/DDR_DQ13 |  | U1.N24 | U2.F2 | Typical | 0,333 | 0,397 | 0,524 | 0,335 | 0,394 | 0,497 | Yes | Pin | Pin | No | 235 | 1500 | 300 | 65 | NA | NA | NA | NA | NA | Pass | 237 | Pass | 321 | 0 | 300 | -21 | NA | NA | NA | NA | NA | Fail | 321 | Fail | NA | NA | NA | NA | NA | NA | NA | NA | NA | Pass | NA | NA | NA | Pass | Pass | Pass | Pass | Pass | zynq_ddr3_diffpin.ibs | SSTL15_DCI_F_PSDDR_O
Pass | /Principal/BANK_502/DDR_DQ13 |  | U1.N24 | U2.F2 | Slow-Weak | 0,377 | 0,487 | 0,645 | 0,395 | 0,488 | 0,587 | Yes | Pin | Pin | No | 32 | 1425 | 300 | 268 | NA | NA | NA | NA | NA | Pass | 34 | Pass | 33 | 0 | 300 | 267 | NA | NA | NA | NA | NA | Pass | 33 | Pass | NA | NA | NA | NA | NA | NA | NA | NA | NA | Pass | NA | NA | NA | Pass | Pass | Pass | Pass | Pass | zynq_ddr3_diffpin.ibs | SSTL15_DCI_F_PSDDR_O
Fail | /Principal/BANK_502/DDR_DQ18 | /Principal/BANK_502/DDR_DM2;/Principal/BANK_502/DDR_DQ10 | U1.N26 | U3.A3 | Fast-Strong | 0,328 | 0,380 | 0,451 | 0,326 | 0,372 | 0,440 | Yes | Pin | Pin | No | 482 | 1575 | 300 | -182 | NA | NA | NA | NA | NA | Fail | 484 | Fail | 504 | 0 | 300 | -204 | NA | NA | NA | NA | NA | Fail | 504 | Fail | NA | NA | NA | NA | NA | NA | NA | NA | NA | Pass | 100 | 150 | 50 | Pass | Pass | Pass | Pass | Pass | zynq_ddr3_diffpin.ibs | SSTL15_DCI_F_PSDDR_O
Fail | /Principal/BANK_502/DDR_DQ18 | /Principal/BANK_502/DDR_DM2;/Principal/BANK_502/DDR_DQ10 | U1.N26 | U3.A3 | Typical | 0,349 | 0,413 | 0,546 | 0,350 | 0,410 | 0,519 | Yes | Pin | Pin | No | 264 | 1500 | 300 | 36 | NA | NA | NA | NA | NA | Pass | 266 | Pass | 355 | 0 | 300 | -55 | NA | NA | NA | NA | NA | Fail | 355 | Fail | NA | NA | NA | NA | NA | NA | NA | NA | NA | Pass | NA | NA | NA | Pass | Pass | Pass | Pass | Pass | zynq_ddr3_diffpin.ibs | SSTL15_DCI_F_PSDDR_O
Pass | /Principal/BANK_502/DDR_DQ18 | /Principal/BANK_502/DDR_DM2;/Principal/BANK_502/DDR_DQ10 | U1.N26 | U3.A3 | Slow-Weak | 0,391 | 0,501 | 0,666 | 0,407 | 0,500 | 0,609 | Yes | Pin | Pin | No | 26 | 1425 | 300 | 274 | NA | NA | NA | NA | NA | Pass | 27 | Pass | 24 | 0 | 300 | 276 | NA | NA | NA | NA | NA | Pass | 24 | Pass | NA | NA | NA | NA | NA | NA | NA | NA | NA | Pass | NA | NA | NA | Pass | Pass | Pass | Pass | Pass | zynq_ddr3_diffpin.ibs | SSTL15_DCI_F_PSDDR_O
Fail | /Principal/BANK_502/DDR_DQ19 |  | U1.P23 | U3.A2 | Fast-Strong | 0,336 | 0,392 | 0,419 | 0,334 | 0,383 | 0,408 | Yes | Pin | Pin | No | 453 | 1575 | 300 | -153 | NA | NA | NA | NA | NA | Fail | 456 | Fail | 480 | 0 | 300 | -180 | NA | NA | NA | NA | NA | Fail | 480 | Fail | NA | NA | NA | NA | NA | NA | NA | NA | NA | Pass | NA | NA | NA | Pass | Pass | Pass | Pass | Pass | zynq_ddr3_diffpin.ibs | SSTL15_DCI_F_PSDDR_O
Pass | /Principal/BANK_502/DDR_DQ19 |  | U1.P23 | U3.A2 | Typical | 0,359 | 0,431 | 0,515 | 0,360 | 0,424 | 0,488 | Yes | Pin | Pin | No | 200 | 1500 | 300 | 100 | NA | NA | NA | NA | NA | Pass | 202 | Pass | 298 | 0 | 300 | 2 | NA | NA | NA | NA | NA | Pass | 298 | Pass | NA | NA | NA | NA | NA | NA | NA | NA | NA | Pass | NA | NA | NA | Pass | Pass | Pass | Pass | Pass | zynq_ddr3_diffpin.ibs | SSTL15_DCI_F_PSDDR_O
Pass | /Principal/BANK_502/DDR_DQ19 |  | U1.P23 | U3.A2 | Slow-Weak | 0,408 | 0,513 | 0,637 | 0,421 | 0,520 | 0,578 | Yes | Pin | Pin | No | 26 | 1425 | 300 | 274 | NA | NA | NA | NA | NA | Pass | 28 | Pass | 28 | 0 | 300 | 272 | NA | NA | NA | NA | NA | Pass | 28 | Pass | NA | NA | NA | NA | NA | NA | NA | NA | NA | Pass | NA | NA | NA | Pass | Pass | Pass | Pass | Pass | zynq_ddr3_diffpin.ibs | SSTL15_DCI_F_PSDDR_O
Fail | /Principal/BANK_502/DDR_DQ17 | /Principal/BANK_502/DDR_DM2 | U1.P24 | U3.C2 | Fast-Strong | 0,378 | 0,434 | 0,426 | 0,376 | 0,426 | 0,415 | Yes | Pin | Pin | No | 497 | 1575 | 300 | -197 | NA | NA | NA | NA | NA | Fail | 499 | Fail | 511 | 0 | 300 | -211 | NA | NA | NA | NA | NA | Fail | 511 | Fail | NA | NA | NA | NA | NA | NA | NA | NA | NA | Pass | 21 | 150 | 129 | Pass | Pass | Pass | Pass | Pass | zynq_ddr3_diffpin.ibs | SSTL15_DCI_F_PSDDR_O
Fail | /Principal/BANK_502/DDR_DQ17 | /Principal/BANK_502/DDR_DM2 | U1.P24 | U3.C2 | Typical | 0,399 | 0,467 | 0,522 | 0,400 | 0,464 | 0,495 | Yes | Pin | Pin | No | 287 | 1500 | 300 | 13 | NA | NA | NA | NA | NA | Pass | 289 | Pass | 369 | 0 | 300 | -69 | NA | NA | NA | NA | NA | Fail | 369 | Fail | NA | NA | NA | NA | NA | NA | NA | NA | NA | Pass | NA | NA | NA | Pass | Pass | Pass | Pass | Pass | zynq_ddr3_diffpin.ibs | SSTL15_DCI_F_PSDDR_O
Pass | /Principal/BANK_502/DDR_DQ17 | /Principal/BANK_502/DDR_DM2 | U1.P24 | U3.C2 | Slow-Weak | 0,443 | 0,553 | 0,643 | 0,461 | 0,559 | 0,585 | Yes | Pin | Pin | No | 31 | 1425 | 300 | 269 | NA | NA | NA | NA | NA | Pass | 33 | Pass | 41 | 0 | 300 | 259 | NA | NA | NA | NA | NA | Pass | 41 | Pass | NA | NA | NA | NA | NA | NA | NA | NA | NA | Pass | NA | NA | NA | Pass | Pass | Pass | Pass | Pass | zynq_ddr3_diffpin.ibs | SSTL15_DCI_F_PSDDR_O
Fail | /Principal/BANK_502/DDR_DQS2_P;/Principal/BANK_502/DDR_DQS2_N |  | U1.P25 | U3.C7 | Fast-Strong | 0,358 | 0,411 | 0,424 | 0,358 | 0,411 | 0,424 | Yes | Pin | Pin | Yes | 366 | 1575 | 300 | -66 | NA | NA | NA | NA | NA | Fail | 793 | Fail | 433 | 0 | 300 | -133 | NA | NA | NA | NA | NA | Fail | 789 | Fail | NA | NA | NA | NA | NA | NA | NA | NA | NA | Pass | NA | NA | NA | Pass | Pass | Pass | Pass | Pass | zynq_ddr3_diffpin.ibs | SSTL15_DCI_F_PSDDR_O
Fail | /Principal/BANK_502/DDR_DQS2_P;/Principal/BANK_502/DDR_DQS2_N |  | U1.R25 | U3.B7 | Fast-Strong | 0,358 | 0,411 | 0,424 | 0,358 | 0,411 | 0,424 | Yes | Pin | Pin | Yes | 371 | 1575 | 300 | -71 | NA | NA | NA | NA | NA | Fail | 789 | Fail | 426 | 0 | 300 | -126 | NA | NA | NA | NA | NA | Fail | 793 | Fail | NA | NA | NA | NA | NA | NA | NA | NA | NA | Pass | NA | NA | NA | Pass | Pass | Pass | Pass | Pass | zynq_ddr3_diffpin.ibs | SSTL15_DCI_F_PSDDR_O
Pass | /Principal/BANK_502/DDR_DQS2_P;/Principal/BANK_502/DDR_DQS2_N |  | U1.P25 | U3.C7 | Typical | 0,383 | 0,450 | 0,513 | 0,383 | 0,450 | 0,513 | Yes | Pin | Pin | Yes | 93 | 1500 | 300 | 207 | NA | NA | NA | NA | NA | Pass | 293 | Pass | 195 | 0 | 300 | 105 | NA | NA | NA | NA | NA | Pass | 289 | Pass | NA | NA | NA | NA | NA | NA | NA | NA | NA | Pass | NA | NA | NA | Pass | Pass | Pass | Pass | Pass | zynq_ddr3_diffpin.ibs | SSTL15_DCI_F_PSDDR_O
Pass | /Principal/BANK_502/DDR_DQS2_P;/Principal/BANK_502/DDR_DQS2_N |  | U1.R25 | U3.B7 | Typical | 0,383 | 0,450 | 0,513 | 0,383 | 0,450 | 0,513 | Yes | Pin | Pin | Yes | 112 | 1500 | 300 | 188 | NA | NA | NA | NA | NA | Pass | 289 | Pass | 202 | 0 | 300 | 98 | NA | NA | NA | NA | NA | Pass | 293 | Pass | NA | NA | NA | NA | NA | NA | NA | NA | NA | Pass | NA | NA | NA | Pass | Pass | Pass | Pass | Pass | zynq_ddr3_diffpin.ibs | SSTL15_DCI_F_PSDDR_O
Pass | /Principal/BANK_502/DDR_DQS2_P;/Principal/BANK_502/DDR_DQS2_N |  | U1.P25 | U3.C7 | Slow-Weak | 0,433 | 0,549 | 0,618 | 0,433 | 0,549 | 0,618 | Yes | Pin | Pin | Yes | 28 | 1425 | 300 | 272 | NA | NA | NA | NA | NA | Pass | 59 | Pass | 32 | 0 | 300 | 268 | NA | NA | NA | NA | NA | Pass | 61 | Pass | NA | NA | NA | NA | NA | NA | NA | NA | NA | Pass | NA | NA | NA | Pass | Pass | Pass | Pass | Pass | zynq_ddr3_diffpin.ibs | SSTL15_DCI_F_PSDDR_O
Pass | /Principal/BANK_502/DDR_DQS2_P;/Principal/BANK_502/DDR_DQS2_N |  | U1.R25 | U3.B7 | Slow-Weak | 0,433 | 0,549 | 0,618 | 0,433 | 0,549 | 0,618 | Yes | Pin | Pin | Yes | 27 | 1425 | 300 | 273 | NA | NA | NA | NA | NA | Pass | 61 | Pass | 29 | 0 | 300 | 271 | NA | NA | NA | NA | NA | Pass | 59 | Pass | NA | NA | NA | NA | NA | NA | NA | NA | NA | Pass | NA | NA | NA | Pass | Pass | Pass | Pass | Pass | zynq_ddr3_diffpin.ibs | SSTL15_DCI_F_PSDDR_O
Pass | /Principal/BANK_502/DDR_DM2 | /Principal/BANK_502/DDR_DQ17;/Principal/BANK_502/DDR_DQ18 | U1.P26 | U3.D3 | Fast-Strong | 0,258 | 0,334 | 0,444 | 0,246 | 0,319 | 0,434 | Yes | Pin | Pin | No | -233 | 1575 | 300 | 533 | NA | NA | NA | NA | NA | Pass | 14 | Pass | -198 | 0 | 300 | 498 | NA | NA | NA | NA | NA | Pass | 17 | Pass | NA | NA | NA | NA | NA | NA | NA | NA | NA | Pass | 59 | 150 | 91 | Pass | Pass | Pass | Pass | Pass | zynq_ddr3_diffpin.ibs | SSTL15_DCI_F_PSDDR_O
Pass | /Principal/BANK_502/DDR_DM2 | /Principal/BANK_502/DDR_DQ17;/Principal/BANK_502/DDR_DQ18 | U1.P26 | U3.D3 | Typical | 0,258 | 0,347 | 0,539 | 0,255 | 0,344 | 0,513 | Yes | Pin | Pin | No | -222 | 1500 | 300 | 522 | NA | NA | NA | NA | NA | Pass | 17 | Pass | -196 | 0 | 300 | 496 | NA | NA | NA | NA | NA | Pass | 23 | Pass | NA | NA | NA | NA | NA | NA | NA | NA | NA | Pass | NA | NA | NA | Pass | Pass | Pass | Pass | Pass | zynq_ddr3_diffpin.ibs | SSTL15_DCI_F_PSDDR_O
Pass | /Principal/BANK_502/DDR_DM2 | /Principal/BANK_502/DDR_DQ17;/Principal/BANK_502/DDR_DQ18 | U1.P26 | U3.D3 | Slow-Weak | 0,240 | 0,385 | 0,660 | 0,268 | 0,402 | 0,603 | Yes | Pin | Pin | No | -260 | 1425 | 300 | 560 | NA | NA | NA | NA | NA | Pass | 0 | Pass | -235 | 0 | 300 | 535 | NA | NA | NA | NA | NA | Pass | 5 | Pass | NA | NA | NA | NA | NA | NA | NA | NA | NA | Pass | NA | NA | NA | Pass | Pass | Pass | Pass | Pass | zynq_ddr3_diffpin.ibs | SSTL15_DCI_F_PSDDR_O
Fail | /Principal/BANK_502/DDR_DQ23 |  | U1.R23 | U3.A7 | Fast-Strong | 0,334 | 0,383 | 0,422 | 0,328 | 0,378 | 0,411 | Yes | Pin | Pin | No | 468 | 1575 | 300 | -168 | NA | NA | NA | NA | NA | Fail | 470 | Fail | 491 | 0 | 300 | -191 | NA | NA | NA | NA | NA | Fail | 491 | Fail | NA | NA | NA | NA | NA | NA | NA | NA | NA | Pass | NA | NA | NA | Pass | Pass | Pass | Pass | Pass | zynq_ddr3_diffpin.ibs | SSTL15_DCI_F_PSDDR_O
Fail | /Principal/BANK_502/DDR_DQ23 |  | U1.R23 | U3.A7 | Typical | 0,353 | 0,421 | 0,517 | 0,354 | 0,413 | 0,490 | Yes | Pin | Pin | No | 234 | 1500 | 300 | 66 | NA | NA | NA | NA | NA | Pass | 236 | Pass | 324 | 0 | 300 | -24 | NA | NA | NA | NA | NA | Fail | 324 | Fail | NA | NA | NA | NA | NA | NA | NA | NA | NA | Pass | NA | NA | NA | Pass | Pass | Pass | Pass | Pass | zynq_ddr3_diffpin.ibs | SSTL15_DCI_F_PSDDR_O
Pass | /Principal/BANK_502/DDR_DQ23 |  | U1.R23 | U3.A7 | Slow-Weak | 0,395 | 0,506 | 0,638 | 0,413 | 0,512 | 0,580 | Yes | Pin | Pin | No | 32 | 1425 | 300 | 268 | NA | NA | NA | NA | NA | Pass | 33 | Pass | 33 | 0 | 300 | 267 | NA | NA | NA | NA | NA | Pass | 33 | Pass | NA | NA | NA | NA | NA | NA | NA | NA | NA | Pass | NA | NA | NA | Pass | Pass | Pass | Pass | Pass | zynq_ddr3_diffpin.ibs | SSTL15_DCI_F_PSDDR_O
Fail | /Principal/BANK_502/DDR_DQ16 |  | U1.R26 | U3.C3 | Fast-Strong | 0,328 | 0,374 | 0,441 | 0,322 | 0,368 | 0,430 | Yes | Pin | Pin | No | 468 | 1575 | 300 | -168 | NA | NA | NA | NA | NA | Fail | 471 | Fail | 491 | 0 | 300 | -191 | NA | NA | NA | NA | NA | Fail | 491 | Fail | NA | NA | NA | NA | NA | NA | NA | NA | NA | Pass | NA | NA | NA | Pass | Pass | Pass | Pass | Pass | zynq_ddr3_diffpin.ibs | SSTL15_DCI_F_PSDDR_O
Fail | /Principal/BANK_502/DDR_DQ16 |  | U1.R26 | U3.C3 | Typical | 0,346 | 0,410 | 0,536 | 0,347 | 0,407 | 0,510 | Yes | Pin | Pin | No | 244 | 1500 | 300 | 56 | NA | NA | NA | NA | NA | Pass | 245 | Pass | 335 | 0 | 300 | -35 | NA | NA | NA | NA | NA | Fail | 335 | Fail | NA | NA | NA | NA | NA | NA | NA | NA | NA | Pass | NA | NA | NA | Pass | Pass | Pass | Pass | Pass | zynq_ddr3_diffpin.ibs | SSTL15_DCI_F_PSDDR_O
Pass | /Principal/BANK_502/DDR_DQ16 |  | U1.R26 | U3.C3 | Slow-Weak | 0,388 | 0,498 | 0,657 | 0,405 | 0,498 | 0,599 | Yes | Pin | Pin | No | 33 | 1425 | 300 | 267 | NA | NA | NA | NA | NA | Pass | 35 | Pass | 34 | 0 | 300 | 266 | NA | NA | NA | NA | NA | Pass | 34 | Pass | NA | NA | NA | NA | NA | NA | NA | NA | NA | Pass | NA | NA | NA | Pass | Pass | Pass | Pass | Pass | zynq_ddr3_diffpin.ibs | SSTL15_DCI_F_PSDDR_O
Fail | /Principal/BANK_502/DDR_DQ22 |  | U1.T23 | U3.C8 | Fast-Strong | 0,332 | 0,384 | 0,417 | 0,326 | 0,376 | 0,406 | Yes | Pin | Pin | No | 464 | 1575 | 300 | -164 | NA | NA | NA | NA | NA | Fail | 466 | Fail | 488 | 0 | 300 | -188 | NA | NA | NA | NA | NA | Fail | 488 | Fail | NA | NA | NA | NA | NA | NA | NA | NA | NA | Pass | NA | NA | NA | Pass | Pass | Pass | Pass | Pass | zynq_ddr3_diffpin.ibs | SSTL15_DCI_F_PSDDR_O
Fail | /Principal/BANK_502/DDR_DQ22 |  | U1.T23 | U3.C8 | Typical | 0,353 | 0,421 | 0,512 | 0,354 | 0,414 | 0,486 | Yes | Pin | Pin | No | 228 | 1500 | 300 | 72 | NA | NA | NA | NA | NA | Pass | 229 | Pass | 317 | 0 | 300 | -17 | NA | NA | NA | NA | NA | Fail | 317 | Fail | NA | NA | NA | NA | NA | NA | NA | NA | NA | Pass | NA | NA | NA | Pass | Pass | Pass | Pass | Pass | zynq_ddr3_diffpin.ibs | SSTL15_DCI_F_PSDDR_O
Pass | /Principal/BANK_502/DDR_DQ22 |  | U1.T23 | U3.C8 | Slow-Weak | 0,394 | 0,504 | 0,634 | 0,412 | 0,511 | 0,575 | Yes | Pin | Pin | No | 31 | 1425 | 300 | 269 | NA | NA | NA | NA | NA | Pass | 33 | Pass | 33 | 0 | 300 | 267 | NA | NA | NA | NA | NA | Pass | 33 | Pass | NA | NA | NA | NA | NA | NA | NA | NA | NA | Pass | NA | NA | NA | Pass | Pass | Pass | Pass | Pass | zynq_ddr3_diffpin.ibs | SSTL15_DCI_F_PSDDR_O
Fail | /Principal/BANK_502/DDR_DQ20 |  | U1.T24 | U3.B8 | Fast-Strong | 0,379 | 0,431 | 0,429 | 0,373 | 0,426 | 0,418 | Yes | Pin | Pin | No | 507 | 1575 | 300 | -207 | NA | NA | NA | NA | NA | Fail | 510 | Fail | 521 | 0 | 300 | -221 | NA | NA | NA | NA | NA | Fail | 521 | Fail | NA | NA | NA | NA | NA | NA | NA | NA | NA | Pass | NA | NA | NA | Pass | Pass | Pass | Pass | Pass | zynq_ddr3_diffpin.ibs | SSTL15_DCI_F_PSDDR_O
Fail | /Principal/BANK_502/DDR_DQ20 |  | U1.T24 | U3.B8 | Typical | 0,400 | 0,468 | 0,525 | 0,401 | 0,465 | 0,498 | Yes | Pin | Pin | No | 285 | 1500 | 300 | 15 | NA | NA | NA | NA | NA | Pass | 287 | Pass | 366 | 0 | 300 | -66 | NA | NA | NA | NA | NA | Fail | 366 | Fail | NA | NA | NA | NA | NA | NA | NA | NA | NA | Pass | NA | NA | NA | Pass | Pass | Pass | Pass | Pass | zynq_ddr3_diffpin.ibs | SSTL15_DCI_F_PSDDR_O
Pass | /Principal/BANK_502/DDR_DQ20 |  | U1.T24 | U3.B8 | Slow-Weak | 0,446 | 0,562 | 0,646 | 0,463 | 0,562 | 0,588 | Yes | Pin | Pin | No | 32 | 1425 | 300 | 268 | NA | NA | NA | NA | NA | Pass | 33 | Pass | 28 | 0 | 300 | 272 | NA | NA | NA | NA | NA | Pass | 28 | Pass | NA | NA | NA | NA | NA | NA | NA | NA | NA | Pass | NA | NA | NA | Pass | Pass | Pass | Pass | Pass | zynq_ddr3_diffpin.ibs | SSTL15_DCI_F_PSDDR_O
Fail | /Principal/BANK_502/DDR_DQ21 |  | U1.T25 | U3.D7 | Fast-Strong | 0,369 | 0,415 | 0,439 | 0,364 | 0,410 | 0,428 | Yes | Pin | Pin | No | 499 | 1575 | 300 | -199 | NA | NA | NA | NA | NA | Fail | 501 | Fail | 513 | 0 | 300 | -213 | NA | NA | NA | NA | NA | Fail | 513 | Fail | NA | NA | NA | NA | NA | NA | NA | NA | NA | Pass | NA | NA | NA | Pass | Pass | Pass | Pass | Pass | zynq_ddr3_diffpin.ibs | SSTL15_DCI_F_PSDDR_O
Fail | /Principal/BANK_502/DDR_DQ21 |  | U1.T25 | U3.D7 | Typical | 0,387 | 0,450 | 0,534 | 0,388 | 0,447 | 0,508 | Yes | Pin | Pin | No | 288 | 1500 | 300 | 12 | NA | NA | NA | NA | NA | Pass | 290 | Pass | 371 | 0 | 300 | -71 | NA | NA | NA | NA | NA | Fail | 371 | Fail | NA | NA | NA | NA | NA | NA | NA | NA | NA | Pass | NA | NA | NA | Pass | Pass | Pass | Pass | Pass | zynq_ddr3_diffpin.ibs | SSTL15_DCI_F_PSDDR_O
Pass | /Principal/BANK_502/DDR_DQ21 |  | U1.T25 | U3.D7 | Slow-Weak | 0,431 | 0,536 | 0,655 | 0,442 | 0,541 | 0,597 | Yes | Pin | Pin | No | 34 | 1425 | 300 | 266 | NA | NA | NA | NA | NA | Pass | 35 | Pass | 41 | 0 | 300 | 259 | NA | NA | NA | NA | NA | Pass | 41 | Pass | NA | NA | NA | NA | NA | NA | NA | NA | NA | Pass | NA | NA | NA | Pass | Pass | Pass | Pass | Pass | zynq_ddr3_diffpin.ibs | SSTL15_DCI_F_PSDDR_O
Fail | /Principal/BANK_502/DDR_DQ26 |  | U1.U24 | U3.G2 | Fast-Strong | 0,334 | 0,380 | 0,431 | 0,329 | 0,375 | 0,420 | Yes | Pin | Pin | No | 467 | 1575 | 300 | -167 | NA | NA | NA | NA | NA | Fail | 469 | Fail | 495 | 0 | 300 | -195 | NA | NA | NA | NA | NA | Fail | 495 | Fail | NA | NA | NA | NA | NA | NA | NA | NA | NA | Pass | NA | NA | NA | Pass | Pass | Pass | Pass | Pass | zynq_ddr3_diffpin.ibs | SSTL15_DCI_F_PSDDR_O
Fail | /Principal/BANK_502/DDR_DQ26 |  | U1.U24 | U3.G2 | Typical | 0,352 | 0,416 | 0,526 | 0,353 | 0,408 | 0,500 | Yes | Pin | Pin | No | 241 | 1500 | 300 | 59 | NA | NA | NA | NA | NA | Pass | 243 | Pass | 333 | 0 | 300 | -33 | NA | NA | NA | NA | NA | Fail | 333 | Fail | NA | NA | NA | NA | NA | NA | NA | NA | NA | Pass | NA | NA | NA | Pass | Pass | Pass | Pass | Pass | zynq_ddr3_diffpin.ibs | SSTL15_DCI_F_PSDDR_O
Pass | /Principal/BANK_502/DDR_DQ26 |  | U1.U24 | U3.G2 | Slow-Weak | 0,393 | 0,497 | 0,647 | 0,410 | 0,503 | 0,589 | Yes | Pin | Pin | No | 32 | 1425 | 300 | 268 | NA | NA | NA | NA | NA | Pass | 33 | Pass | 32 | 0 | 300 | 268 | NA | NA | NA | NA | NA | Pass | 32 | Pass | NA | NA | NA | NA | NA | NA | NA | NA | NA | Pass | NA | NA | NA | Pass | Pass | Pass | Pass | Pass | zynq_ddr3_diffpin.ibs | SSTL15_DCI_F_PSDDR_O
Fail | /Principal/BANK_502/DDR_DQ27 |  | U1.U25 | U3.H7 | Fast-Strong | 0,345 | 0,391 | 0,440 | 0,339 | 0,385 | 0,429 | Yes | Pin | Pin | No | 462 | 1575 | 300 | -162 | NA | NA | NA | NA | NA | Fail | 464 | Fail | 484 | 0 | 300 | -184 | NA | NA | NA | NA | NA | Fail | 484 | Fail | NA | NA | NA | NA | NA | NA | NA | NA | NA | Pass | NA | NA | NA | Pass | Pass | Pass | Pass | Pass | zynq_ddr3_diffpin.ibs | SSTL15_DCI_F_PSDDR_O
Fail | /Principal/BANK_502/DDR_DQ27 |  | U1.U25 | U3.H7 | Typical | 0,360 | 0,423 | 0,536 | 0,361 | 0,420 | 0,509 | Yes | Pin | Pin | No | 242 | 1500 | 300 | 58 | NA | NA | NA | NA | NA | Pass | 244 | Pass | 333 | 0 | 300 | -33 | NA | NA | NA | NA | NA | Fail | 333 | Fail | NA | NA | NA | NA | NA | NA | NA | NA | NA | Pass | NA | NA | NA | Pass | Pass | Pass | Pass | Pass | zynq_ddr3_diffpin.ibs | SSTL15_DCI_F_PSDDR_O
Pass | /Principal/BANK_502/DDR_DQ27 |  | U1.U25 | U3.H7 | Slow-Weak | 0,406 | 0,511 | 0,657 | 0,418 | 0,516 | 0,599 | Yes | Pin | Pin | No | 31 | 1425 | 300 | 269 | NA | NA | NA | NA | NA | Pass | 33 | Pass | 31 | 0 | 300 | 269 | NA | NA | NA | NA | NA | Pass | 31 | Pass | NA | NA | NA | NA | NA | NA | NA | NA | NA | Pass | NA | NA | NA | Pass | Pass | Pass | Pass | Pass | zynq_ddr3_diffpin.ibs | SSTL15_DCI_F_PSDDR_O
Fail | /Principal/BANK_502/DDR_DQ25 |  | U1.U26 | U3.H8 | Fast-Strong | 0,334 | 0,380 | 0,448 | 0,329 | 0,375 | 0,437 | Yes | Pin | Pin | No | 456 | 1575 | 300 | -156 | NA | NA | NA | NA | NA | Fail | 458 | Fail | 484 | 0 | 300 | -184 | NA | NA | NA | NA | NA | Fail | 484 | Fail | NA | NA | NA | NA | NA | NA | NA | NA | NA | Pass | NA | NA | NA | Pass | Pass | Pass | Pass | Pass | zynq_ddr3_diffpin.ibs | SSTL15_DCI_F_PSDDR_O
Fail | /Principal/BANK_502/DDR_DQ25 |  | U1.U26 | U3.H8 | Typical | 0,348 | 0,412 | 0,543 | 0,354 | 0,409 | 0,516 | Yes | Pin | Pin | No | 232 | 1500 | 300 | 68 | NA | NA | NA | NA | NA | Pass | 233 | Pass | 319 | 0 | 300 | -19 | NA | NA | NA | NA | NA | Fail | 319 | Fail | NA | NA | NA | NA | NA | NA | NA | NA | NA | Pass | NA | NA | NA | Pass | Pass | Pass | Pass | Pass | zynq_ddr3_diffpin.ibs | SSTL15_DCI_F_PSDDR_O
Pass | /Principal/BANK_502/DDR_DQ25 |  | U1.U26 | U3.H8 | Slow-Weak | 0,394 | 0,498 | 0,663 | 0,410 | 0,498 | 0,606 | Yes | Pin | Pin | No | 29 | 1425 | 300 | 271 | NA | NA | NA | NA | NA | Pass | 31 | Pass | 29 | 0 | 300 | 271 | NA | NA | NA | NA | NA | Pass | 29 | Pass | NA | NA | NA | NA | NA | NA | NA | NA | NA | Pass | NA | NA | NA | Pass | Pass | Pass | Pass | Pass | zynq_ddr3_diffpin.ibs | SSTL15_DCI_F_PSDDR_O
Fail | /Principal/BANK_502/DDR_DQ24 |  | U1.V24 | U3.H3 | Fast-Strong | 0,335 | 0,381 | 0,437 | 0,329 | 0,375 | 0,426 | Yes | Pin | Pin | No | 472 | 1575 | 300 | -172 | NA | NA | NA | NA | NA | Fail | 474 | Fail | 499 | 0 | 300 | -199 | NA | NA | NA | NA | NA | Fail | 499 | Fail | NA | NA | NA | NA | NA | NA | NA | NA | NA | Pass | NA | NA | NA | Pass | Pass | Pass | Pass | Pass | zynq_ddr3_diffpin.ibs | SSTL15_DCI_F_PSDDR_O
Fail | /Principal/BANK_502/DDR_DQ24 |  | U1.V24 | U3.H3 | Typical | 0,354 | 0,414 | 0,532 | 0,355 | 0,410 | 0,506 | Yes | Pin | Pin | No | 246 | 1500 | 300 | 54 | NA | NA | NA | NA | NA | Pass | 248 | Pass | 338 | 0 | 300 | -38 | NA | NA | NA | NA | NA | Fail | 338 | Fail | NA | NA | NA | NA | NA | NA | NA | NA | NA | Pass | NA | NA | NA | Pass | Pass | Pass | Pass | Pass | zynq_ddr3_diffpin.ibs | SSTL15_DCI_F_PSDDR_O
Pass | /Principal/BANK_502/DDR_DQ24 |  | U1.V24 | U3.H3 | Slow-Weak | 0,398 | 0,497 | 0,653 | 0,409 | 0,502 | 0,596 | Yes | Pin | Pin | No | 30 | 1425 | 300 | 270 | NA | NA | NA | NA | NA | Pass | 32 | Pass | 29 | 0 | 300 | 271 | NA | NA | NA | NA | NA | Pass | 29 | Pass | NA | NA | NA | NA | NA | NA | NA | NA | NA | Pass | NA | NA | NA | Pass | Pass | Pass | Pass | Pass | zynq_ddr3_diffpin.ibs | SSTL15_DCI_F_PSDDR_O
Pass | /Principal/BANK_502/DDR_DM3 |  | U1.V26 | U3.E7 | Fast-Strong | 0,275 | 0,354 | 0,444 | 0,263 | 0,335 | 0,434 | Yes | Pin | Pin | No | -234 | 1575 | 300 | 534 | NA | NA | NA | NA | NA | Pass | 14 | Pass | -201 | 0 | 300 | 501 | NA | NA | NA | NA | NA | Pass | 15 | Pass | NA | NA | NA | NA | NA | NA | NA | NA | NA | Pass | NA | NA | NA | Pass | Pass | Pass | Pass | Pass | zynq_ddr3_diffpin.ibs | SSTL15_DCI_F_PSDDR_O
Pass | /Principal/BANK_502/DDR_DM3 |  | U1.V26 | U3.E7 | Typical | 0,271 | 0,364 | 0,539 | 0,272 | 0,361 | 0,513 | Yes | Pin | Pin | No | -218 | 1500 | 300 | 518 | NA | NA | NA | NA | NA | Pass | 22 | Pass | -190 | 0 | 300 | 490 | NA | NA | NA | NA | NA | Pass | 28 | Pass | NA | NA | NA | NA | NA | NA | NA | NA | NA | Pass | NA | NA | NA | Pass | Pass | Pass | Pass | Pass | zynq_ddr3_diffpin.ibs | SSTL15_DCI_F_PSDDR_O
Pass | /Principal/BANK_502/DDR_DM3 |  | U1.V26 | U3.E7 | Slow-Weak | 0,252 | 0,397 | 0,660 | 0,286 | 0,414 | 0,603 | Yes | Pin | Pin | No | -250 | 1425 | 300 | 550 | NA | NA | NA | NA | NA | Pass | 8 | Pass | -223 | 0 | 300 | 523 | NA | NA | NA | NA | NA | Pass | 17 | Pass | NA | NA | NA | NA | NA | NA | NA | NA | NA | Pass | NA | NA | NA | Pass | Pass | Pass | Pass | Pass | zynq_ddr3_diffpin.ibs | SSTL15_DCI_F_PSDDR_O
Fail | /Principal/BANK_502/DDR_DQ31 |  | U1.W23 | U3.F7 | Fast-Strong | 0,345 | 0,394 | 0,437 | 0,343 | 0,386 | 0,426 | Yes | Pin | Pin | No | 464 | 1575 | 300 | -164 | NA | NA | NA | NA | NA | Fail | 466 | Fail | 488 | 0 | 300 | -188 | NA | NA | NA | NA | NA | Fail | 488 | Fail | NA | NA | NA | NA | NA | NA | NA | NA | NA | Pass | NA | NA | NA | Pass | Pass | Pass | Pass | Pass | zynq_ddr3_diffpin.ibs | SSTL15_DCI_F_PSDDR_O
Fail | /Principal/BANK_502/DDR_DQ31 |  | U1.W23 | U3.F7 | Typical | 0,363 | 0,427 | 0,532 | 0,364 | 0,424 | 0,506 | Yes | Pin | Pin | No | 239 | 1500 | 300 | 61 | NA | NA | NA | NA | NA | Pass | 241 | Pass | 324 | 0 | 300 | -24 | NA | NA | NA | NA | NA | Fail | 324 | Fail | NA | NA | NA | NA | NA | NA | NA | NA | NA | Pass | NA | NA | NA | Pass | Pass | Pass | Pass | Pass | zynq_ddr3_diffpin.ibs | SSTL15_DCI_F_PSDDR_O
Pass | /Principal/BANK_502/DDR_DQ31 |  | U1.W23 | U3.F7 | Slow-Weak | 0,410 | 0,520 | 0,653 | 0,421 | 0,520 | 0,595 | Yes | Pin | Pin | No | 32 | 1425 | 300 | 268 | NA | NA | NA | NA | NA | Pass | 34 | Pass | 33 | 0 | 300 | 267 | NA | NA | NA | NA | NA | Pass | 33 | Pass | NA | NA | NA | NA | NA | NA | NA | NA | NA | Pass | NA | NA | NA | Pass | Pass | Pass | Pass | Pass | zynq_ddr3_diffpin.ibs | SSTL15_DCI_F_PSDDR_O
Fail | /Principal/BANK_502/DDR_DQS3_P;/Principal/BANK_502/DDR_DQS3_N |  | U1.W24 | U3.F3 | Fast-Strong | 0,335 | 0,378 | 0,433 | 0,335 | 0,378 | 0,433 | Yes | Pin | Pin | Yes | 442 | 1575 | 300 | -142 | NA | NA | NA | NA | NA | Fail | 918 | Fail | 474 | 0 | 300 | -174 | NA | NA | NA | NA | NA | Fail | 919 | Fail | NA | NA | NA | NA | NA | NA | NA | NA | NA | Pass | NA | NA | NA | Pass | Pass | Pass | Pass | Pass | zynq_ddr3_diffpin.ibs | SSTL15_DCI_F_PSDDR_O
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
