ciaa/Hardware/Readme/HACKING.md

# Pautas generales para desarrolladores y contribuciones al repositorio #

## Uso del git ##

### Mensajes Commit ###
*  Commit messages en inglés.
*  Siempre citar, como mínimo un issue en el commit, a fin de hacer un seguimiento de los cambios que vamos haciendo.

### Archivos de texto ###
*  Utilizar preferentemente UTF-8.
