ciaa/Hardware/PCB/NXP/docs/gabinete-pablo.pptx

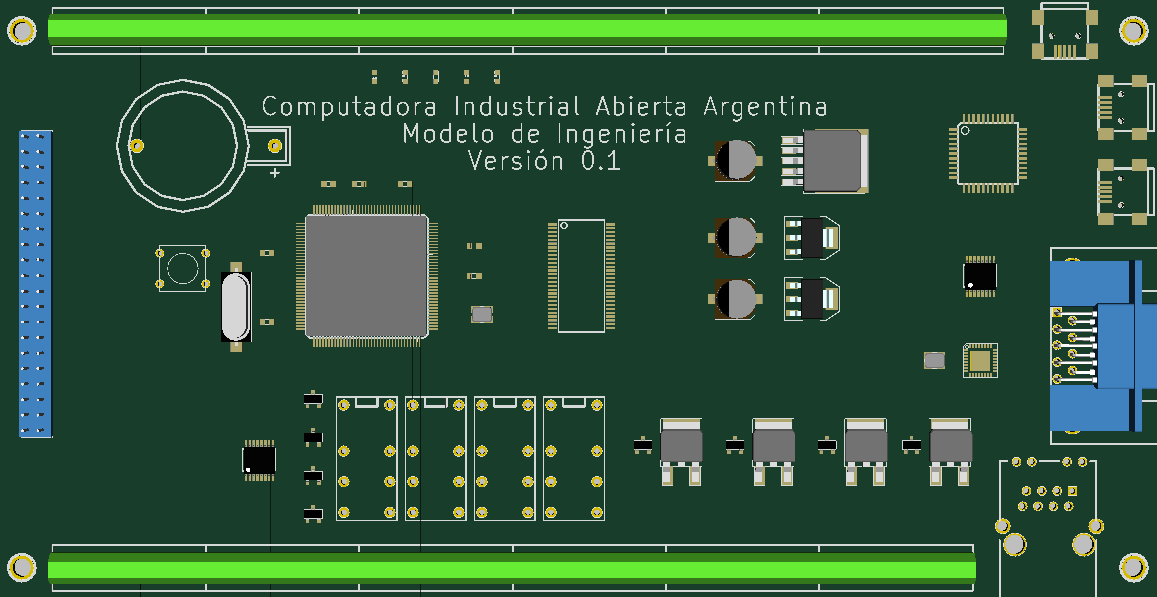
[picture p22: figure]
