ciaa/Hardware/PCB/ACC/CIAA_ACC/doc/stackup/EDADOC_calculos.pdf

=============================================================================================================== 阻抗模型表 | 档案号：101208248

### 文档密级:企密A

Impedance value: | OHMS | Tol +/-
| 40 | +/-5.0 Ω
Layer | Ref Layer
L3 | L2 / L4

## 内层单线 1

Nominal (mm)
Er1 | 4.15
Er2 | 3.85
H1 | 0.130
H2 | 0.149
T1 | 0.031
W1 | 0.155
W2 | 0.135
Zo | 40

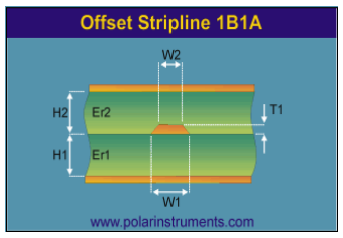
[picture p23: figure]

Impedance value: | OHMS | Tol +/-
| 40 | +/-5.0 Ω
Layer | Ref Layer
L10 | L11 / L9

## 内层单线 2

Nominal (mm)
Er1 | 4.15
Er2 | 3.85
H1 | 0.130
H2 | 0.149
T1 | 0.031
W1 | 0.155
W2 | 0.135
Zo | 40

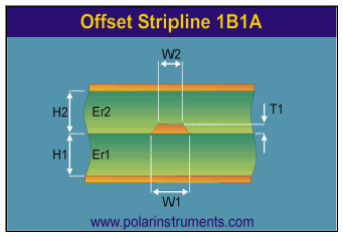
[picture p24: figure]

Impedance value: | OHMS | Tol +/-
| 40 | +/-5.0 Ω
Layer | Ref Layer
L5 | L4 / L6

## 内层单线 3

Nominal (mm)
Er1 | 4.15
Er2 | 3.85
H1 | 0.130
H2 | 0.156
T1 | 0.031
W1 | 0.160
W2 | 0.140
Zo | 40
Impedance value: | OHMS | Tol +/-
| 40 | +/-5.0 Ω
Layer | Ref Layer
L8 | L9 / L7

## 内层单线 4

Nominal (mm)
Er1 | 4.15
Er2 | 3.85
H1 | 0.130
H2 | 0.148
T1 | 0.031
W1 | 0.152
W2 | 0.132
Zo | 40
Impedance value: | OHMS | Tol +/-
| 40 | +/-5.0 Ω
Layer | Ref Layer
L1 | L2
第1页,共8页 | 此资料属无锡深南电路有限公司所有,未经许可,不得扩散。

## 外层单线(含绿油) 5

## ★ 半成品:43.8Ω

Nominal (mm)
C1 | 0.070
C2 | 0.017
CEr | 4.00
Er1 | 4.25
H1 | 0.118
T1 | 0.070
W1 | 0.254
W2 | 0.214
Zo | 41
Impedance value: | OHMS | Tol +/-
| 40 | +/-5.0 Ω
Layer | Ref Layer
L12 | L11

## 外层单线(含绿油) 6

## ★ 半成品:43.8Ω

Nominal (mm)
C1 | 0.070
C2 | 0.017
CEr | 4.00
Er1 | 4.25
H1 | 0.118
T1 | 0.070
W1 | 0.254
W2 | 0.214
Zo | 41

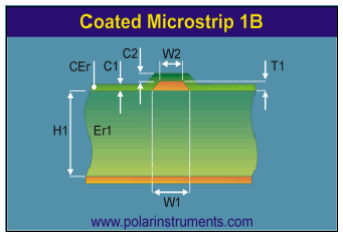
[picture p25: figure]

Impedance value: | OHMS | Tol +/-
| 50 | +/-10.0%
Layer | Ref Layer
L5 | L4 / L6

## 内层单线 7

Nominal (mm)
Er1 | 4.15
Er2 | 3.85
H1 | 0.130
H2 | 0.156
T1 | 0.031
W1 | 0.102
W2 | 0.082
Zo | 50

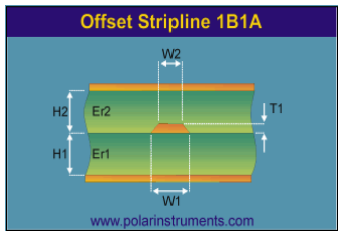
[picture p26: figure]

Impedance value: | OHMS | Tol +/-
| 50 | +/-10.0%
Layer | Ref Layer
L8 | L9 / L7

## 内层单线 8

Nominal (mm)
Er1 | 4.15
Er2 | 3.85
H1 | 0.130
H2 | 0.148
T1 | 0.031
W1 | 0.097
W2 | 0.077
Zo | 50
Impedance value: | OHMS | Tol +/-
| 50 | +/-10.0%
Layer | Ref Layer
L3 | L2 / L4
第2页,共8页 | 此资料属无锡深南电路有限公司所有,未经许可,不得扩散。

## 内层单线 9

Nominal (mm)
Er1 | 4.15
Er2 | 3.85
H1 | 0.130
H2 | 0.149
T1 | 0.031
W1 | 0.097
W2 | 0.077
Zo | 50
Impedance value: | OHMS | Tol +/-
| 50 | +/-10.0%
Layer | Ref Layer
L10 | L11 / L9

## 内层单线 10

Nominal (mm)
Er1 | 4.15
Er2 | 3.85
H1 | 0.130
H2 | 0.149
T1 | 0.031
W1 | 0.097
W2 | 0.077
Zo | 50
Impedance value: | OHMS | Tol +/-
| 56 | +/-10.0%
Layer | Ref Layer
L1 | L2

## 外层单线(含绿油) 11

## ★ 半成品:62.7Ω

Nominal (mm)
C1 | 0.070
C2 | 0.017
CEr | 4.00
Er1 | 4.25
H1 | 0.118
T1 | 0.070
W1 | 0.122
W2 | 0.082
Zo | 56

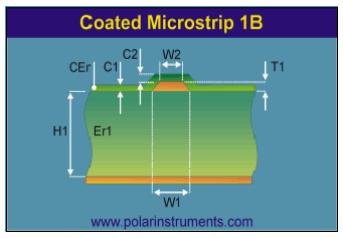
[picture p27: figure]

Impedance value: | OHMS | Tol +/-
| 56 | +/-10.0%
Layer | Ref Layer
L12 | L11

## 外层单线(含绿油) 12

## ★ 半成品:62.7Ω

Nominal (mm)
C1 | 0.070
C2 | 0.017
CEr | 4.00
Er1 | 4.25
H1 | 0.118
T1 | 0.070
W1 | 0.122
W2 | 0.082
Zo | 56
Impedance value: | OHMS | Tol +/-
| 80 | +/-10.0%
Layer | Ref Layer
L5 | L4 / L6
第3页,共8页 | 此资料属无锡深南电路有限公司所有,未经许可,不得扩散。

## 内层差分 13

Nominal (mm)
Er1 | 4.15
Er2 | 3.85
H1 | 0.130
H2 | 0.156
S1 | 0.203
T1 | 0.031
W1 | 0.147
W2 | 0.127
original_S | 0.203
Zo | 80
Impedance value: | OHMS | Tol +/-
| 80 | +/-10.0%
Layer | Ref Layer
L3 | L2 / L4

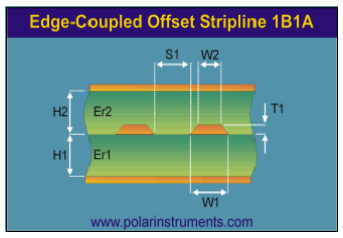
[picture p28: figure]

## 内层差分 14

Nominal (mm)
Er1 | 4.15
Er2 | 3.85
H1 | 0.130
H2 | 0.149
S1 | 0.208
T1 | 0.031
W1 | 0.142
W2 | 0.122
original_S | 0.203
Zo | 80
Impedance value: | OHMS | Tol +/-
| 80 | +/-10.0%
Layer | Ref Layer
L10 | L11 / L9

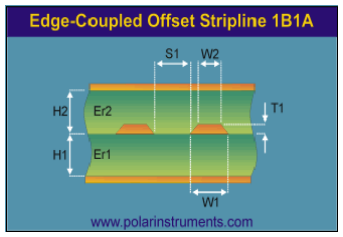
[picture p29: figure]

## 内层差分 15

Nominal (mm)
Er1 | 4.15
Er2 | 3.85
H1 | 0.130
H2 | 0.149
S1 | 0.208
T1 | 0.031
W1 | 0.142
W2 | 0.122
original_S | 0.203
Zo | 80
Impedance value: | OHMS | Tol +/-
| 80 | +/-10.0%
Layer | Ref Layer
L1 | L2

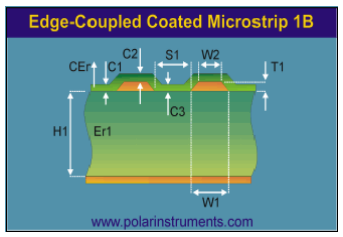
[picture p30: figure]

## 外层差分(含绿油) 16

## ★ 半成品:92.0Ω

Nominal (mm)
C1 | 0.070
C2 | 0.017
C3 | 0.070
CEr | 4.00
Er1 | 4.25
H1 | 0.118
S1 | 0.152
T1 | 0.070
W1 | 0.165
W2 | 0.125
original_S | 0.152
Zo | 80
Impedance value: | OHMS | Tol +/-
| 85 | +/-10.0%
Layer | Ref Layer
第4页,共8页 | 此资料属无锡深南电路有限公司所有,未经许可,不得扩散。

L3 L2 / L4

## 内层差分 17

Nominal (mm)
Er1 | 4.15
Er2 | 3.85
H1 | 0.130
H2 | 0.149
S1 | 0.198
T1 | 0.031
W1 | 0.124
W2 | 0.104
original_S | 0.191
Zo | 85
Impedance value: | OHMS | Tol +/-
| 85 | +/-10.0%
Layer | Ref Layer
L1 | L2

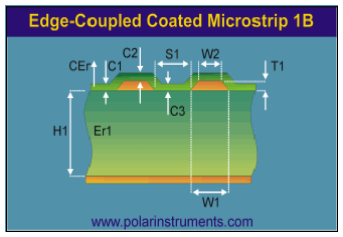
[picture p31: figure]

## 外层差分(含绿油) 18

## ★ 半成品:96.7Ω

Nominal (mm)
C1 | 0.070
C2 | 0.017
C3 | 0.070
CEr | 4.00
Er1 | 4.25
H1 | 0.118
S1 | 0.203
T1 | 0.070
W1 | 0.165
W2 | 0.125
original_S | 0.203
Zo | 86
Impedance value: | OHMS | Tol +/-
| 85 | +/-10.0%
Layer | Ref Layer
L12 | L11

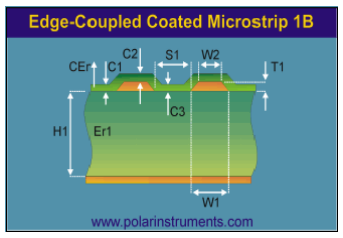
[picture p32: figure]

## 外层差分(含绿油) 19

## ★ 半成品:96.7Ω

Nominal (mm)
C1 | 0.070
C2 | 0.017
C3 | 0.070
CEr | 4.00
Er1 | 4.25
H1 | 0.118
S1 | 0.203
T1 | 0.070
W1 | 0.165
W2 | 0.125
original_S | 0.203
Zo | 86
Impedance value: | OHMS | Tol +/-
| 90 | +/-10.0%
Layer | Ref Layer
L3 | L2 / L4

## 内层差分 20

Nominal (mm)
Er1 | 4.15
Er2 | 3.85
H1 | 0.130
H2 | 0.149
S1 | 0.196
T1 | 0.031
W1 | 0.109
W2 | 0.089
original_S | 0.191
Zo | 90
第5页,共8页 | 此资料属无锡深南电路有限公司所有,未经许可,不得扩散。

Impedance value: | OHMS | Tol +/-
| 90 | +/-10.0%
Layer | Ref Layer
L1 | L2

## 外层差分(含绿油) 21

## ★ 半成品:102.0Ω

Nominal (mm)
C1 | 0.070
C2 | 0.017
C3 | 0.070
CEr | 4.00
Er1 | 4.25
H1 | 0.118
S1 | 0.229
T1 | 0.070
W1 | 0.152
W2 | 0.112
original_S | 0.229
Zo | 90
Impedance value: | OHMS | Tol +/-
| 90 | +/-10.0%
Layer | Ref Layer
L12 | L11

## 外层差分(含绿油) 22

## ★ 半成品:102.0Ω

Nominal (mm)
C1 | 0.070
C2 | 0.017
C3 | 0.070
CEr | 4.00
Er1 | 4.25
H1 | 0.118
S1 | 0.229
T1 | 0.070
W1 | 0.152
W2 | 0.112
original_S | 0.229
Zo | 90
Impedance value: | OHMS | Tol +/-
| 100 | +/-10.0%
Layer | Ref Layer
L5 | L4 / L6

## 内层差分 23

Nominal (mm)
Er1 | 4.15
Er2 | 3.85
H1 | 0.130
H2 | 0.156
S1 | 0.193
T1 | 0.031
W1 | 0.086
W2 | 0.066
original_S | 0.191
Zo | 100
Impedance value: | OHMS | Tol +/-
| 100 | +/-10.0%
Layer | Ref Layer
L1 | L2
第6页,共8页 | 此资料属无锡深南电路有限公司所有,未经许可,不得扩散。

## 外层差分(含绿油) 24

## ★ 半成品:114.1Ω

Nominal (mm)
C1 | 0.070
C2 | 0.017
C3 | 0.070
CEr | 4.00
Er1 | 4.25
H1 | 0.118
S1 | 0.259
T1 | 0.070
W1 | 0.122
W2 | 0.082
original_S | 0.254
Zo | 100
Impedance value: | OHMS | Tol +/-
| 100 | +/-10.0%
Layer | Ref Layer
L12 | L11

## 外层差分(含绿油) 25

## ★ 半成品:114.1Ω

Nominal (mm)
C1 | 0.070
C2 | 0.017
C3 | 0.070
CEr | 4.00
Er1 | 4.25
H1 | 0.118
S1 | 0.259
T1 | 0.070
W1 | 0.122
W2 | 0.082
original_S | 0.254
Zo | 100
Impedance value: | OHMS | Tol +/-
| 100 | +/-10.0%
Layer | Ref Layer
L8 | L9 / L7

## 内层差分 26

Nominal (mm)
Er1 | 4.15
Er2 | 3.85
H1 | 0.130
H2 | 0.148
S1 | 0.196
T1 | 0.031
W1 | 0.084
W2 | 0.064
original_S | 0.191
Zo | 100
Impedance value: | OHMS | Tol +/-
| 100 | +/-10.0%
Layer | Ref Layer
L3 | L2 / L4

## 内层差分 27

Nominal (mm)
Er1 | 4.15
Er2 | 3.85
H1 | 0.130
H2 | 0.149
S1 | 0.196
T1 | 0.031
W1 | 0.084
W2 | 0.064
original_S | 0.191
Zo | 101
第7页,共8页 | 此资料属无锡深南电路有限公司所有,未经许可,不得扩散。

Impedance value: | OHMS | Tol +/-
| 100 | +/-10.0%
Layer | Ref Layer
L10 | L11 / L9

## 内层差分 28

Nominal (mm)
Er1 | 4.15
Er2 | 3.85
H1 | 0.130
H2 | 0.149
S1 | 0.196
T1 | 0.031
W1 | 0.084
W2 | 0.064
original_S | 0.191
Zo | 101
第8页,共8页 | 此资料属无锡深南电路有限公司所有,未经许可,不得扩散。
