ciaa/Hardware/PCB/ACC/CIAA_ACC/output_files/vistas_3D/ciaa-acc_v1.1_top.png

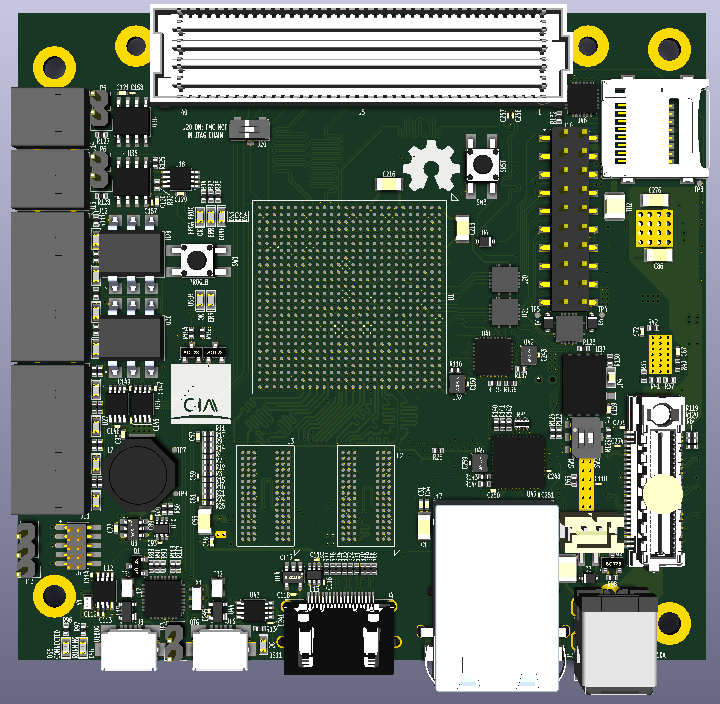
PCB/ACC/CIAA_ACC/output_files/vistas_3D/ciaa-acc_v1.1_top.png
