ciaa/Hardware/PCB/ACC/CIAA_ACC/output_files/vistas_3D/ciaa_acc_bot_con_bga.png

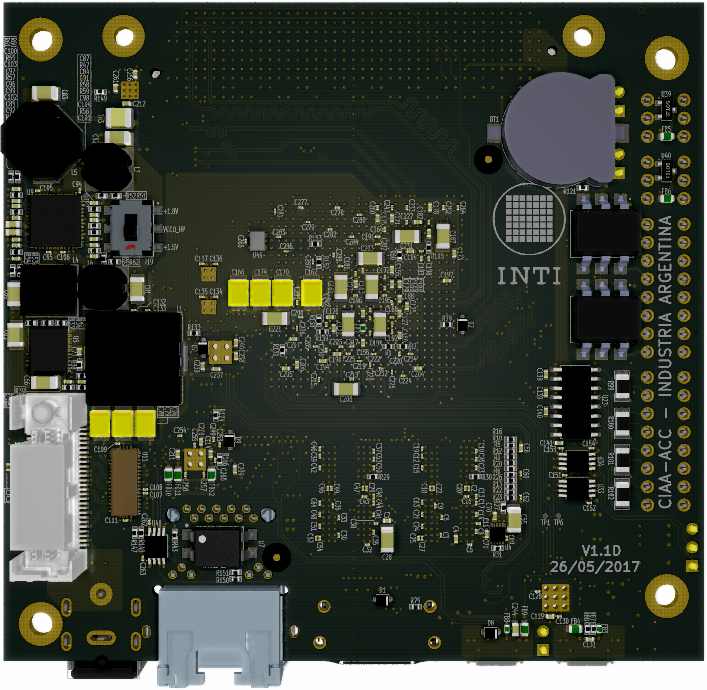
PCB/ACC/CIAA_ACC/output_files/vistas_3D/ciaa_acc_bot_con_bga.png
