ciaa/Hardware/PCB/ACC/CIAA_ACC/output_files/vistas_3D/ciaa_acc_v1.1_iso.png

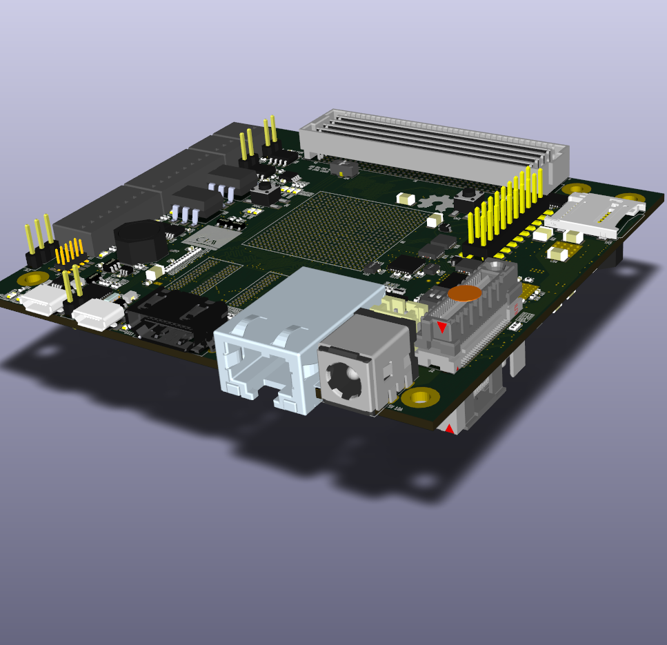
PCB/ACC/CIAA_ACC/output_files/vistas_3D/ciaa_acc_v1.1_iso.png
