ciaa/Hardware/PCB/ACC/CIAA_ACC/output_files/vistas_3D/PCIe104.png

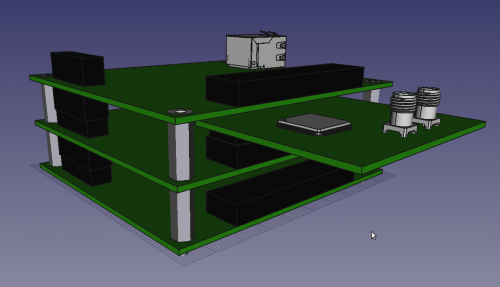
PCB/ACC/CIAA_ACC/output_files/vistas_3D/PCIe104.png
