ciaa/Hardware/PCB/EDU-FPGA/Images/UTN Haedo - ASE.bmp

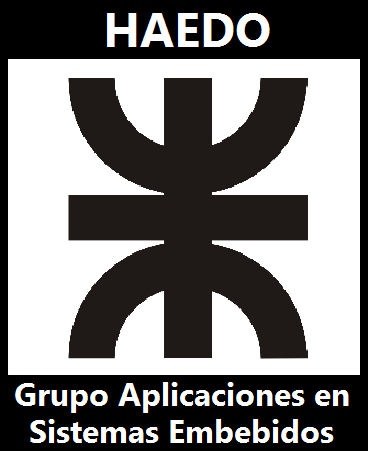
PCB/EDU-FPGA/Images/UTN Haedo - ASE.bmp
