ciaa/Hardware/PCB/EDU-INTEL/doc/2015-03-12 12.09.56.jpg

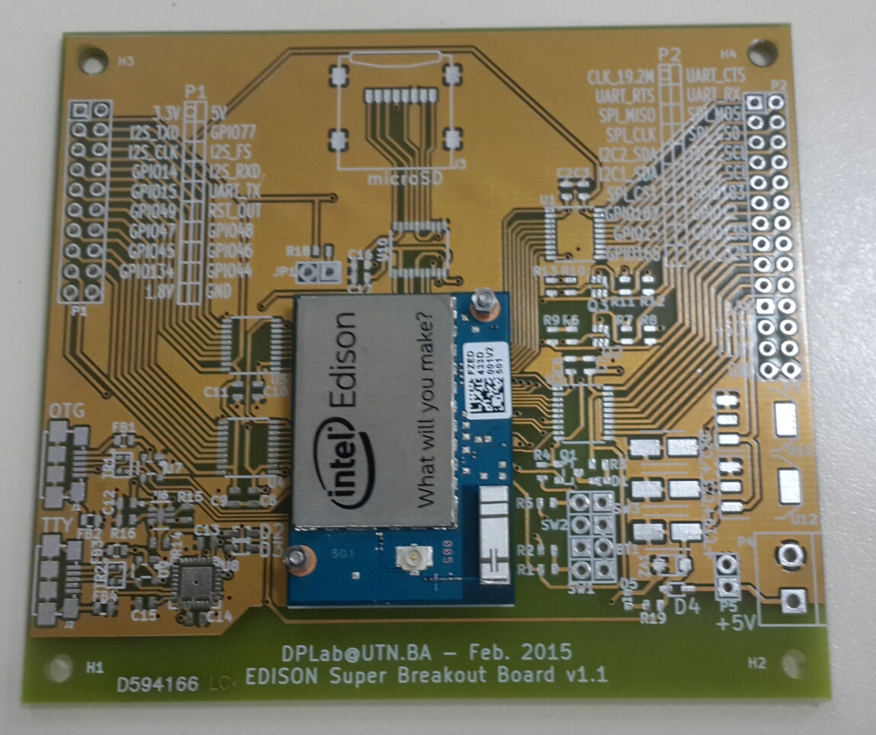
PCB/EDU-INTEL/doc/2015-03-12 12.09.56.jpg
