ciaa/Hardware/PCB/EDU-INTEL/doc/20150417_000237.jpg

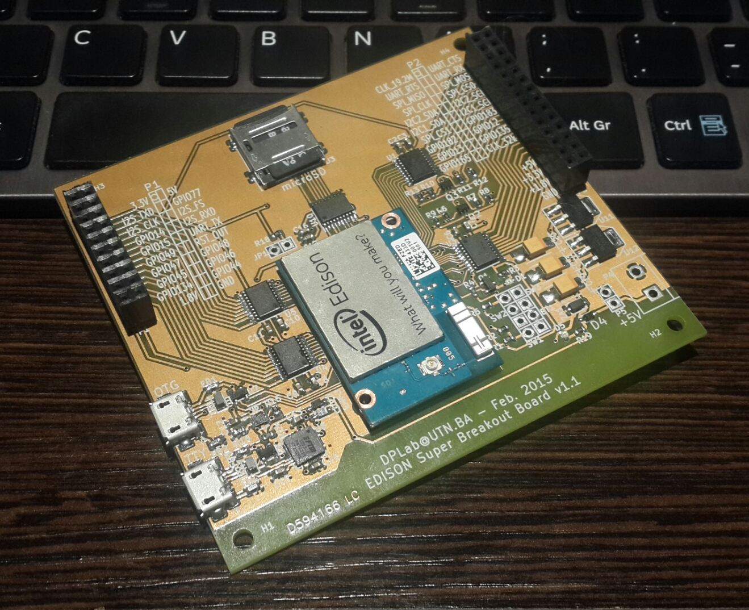
PCB/EDU-INTEL/doc/20150417_000237.jpg
