ciaa/Hardware/PCB/EDU-INTEL/doc/edk-back.png

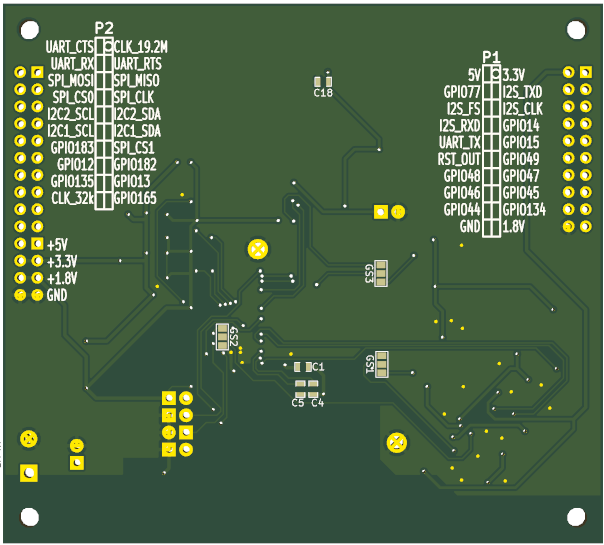
PCB/EDU-INTEL/doc/edk-back.png
