ciaa/Hardware/PCB/EDU-INTEL/doc/edk-front.png

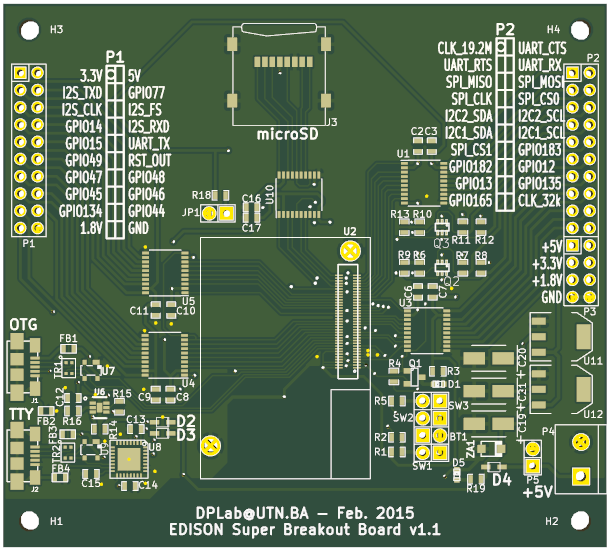
PCB/EDU-INTEL/doc/edk-front.png
