ciaa/Hardware/PCB/NXP/docs/3D/ciaa-nxp-BOT.jpg

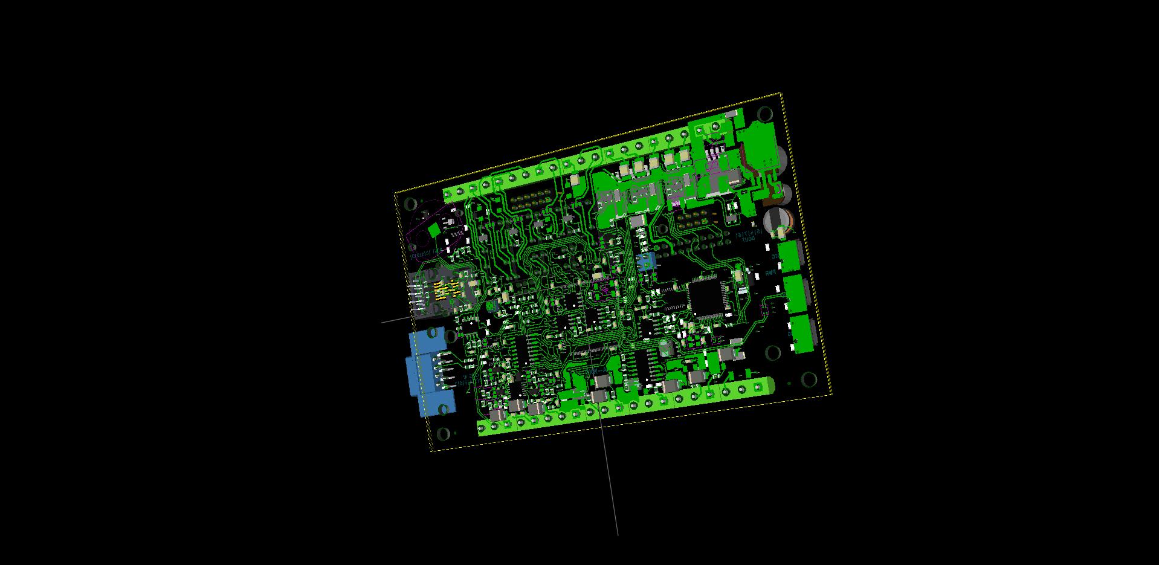
PCB/NXP/docs/3D/ciaa-nxp-BOT.jpg
