ciaa/Hardware/PCB/NXP/docs/3D/ciaa-nxp-TOP.jpg

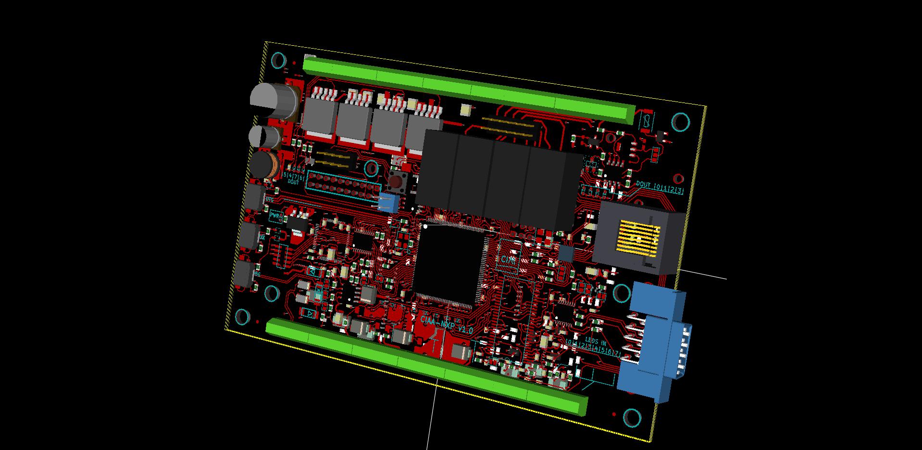
PCB/NXP/docs/3D/ciaa-nxp-TOP.jpg
