ciaa/Hardware/PCB/NXP/docs/3D/ciaa-nxp.jpg

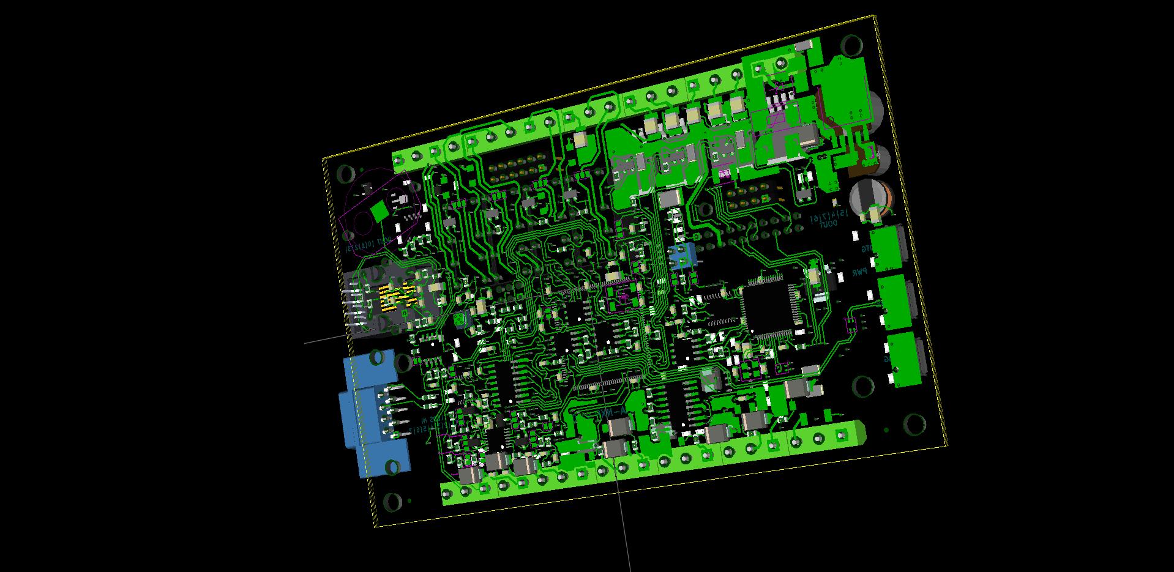
PCB/NXP/docs/3D/ciaa-nxp.jpg
