ciaa/Hardware/PCB/NXP/docs/ciaa-gabinete.png

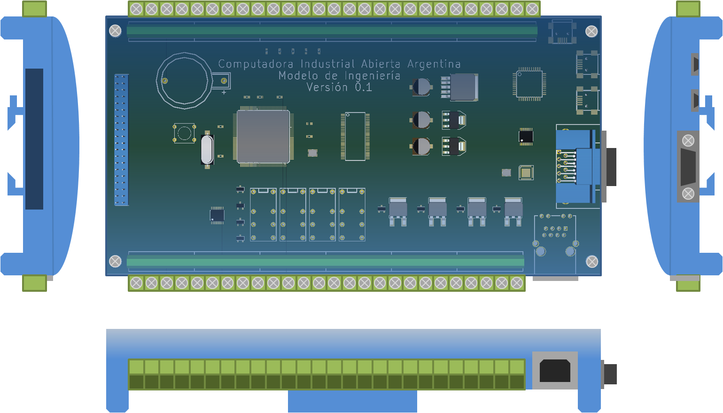
PCB/NXP/docs/ciaa-gabinete.png
