ciaa/Hardware/PCB/NXP/docs/ciaa-nxp-mi.png

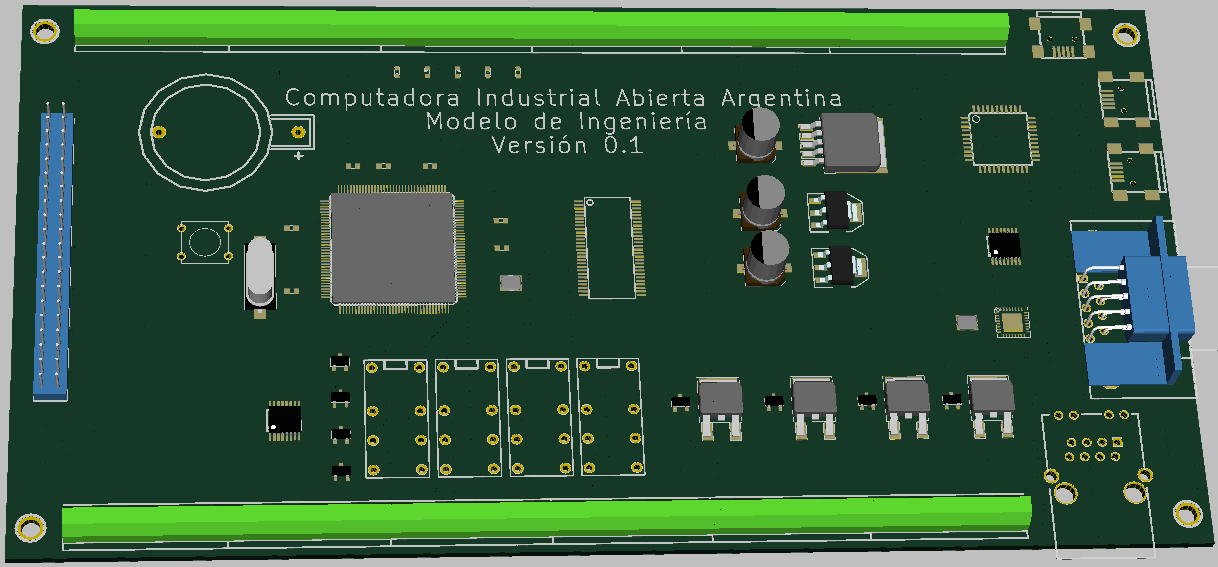
PCB/NXP/docs/ciaa-nxp-mi.png
