ciaa/Hardware/PCB/PIC/Documents/ciaa-picAll.png

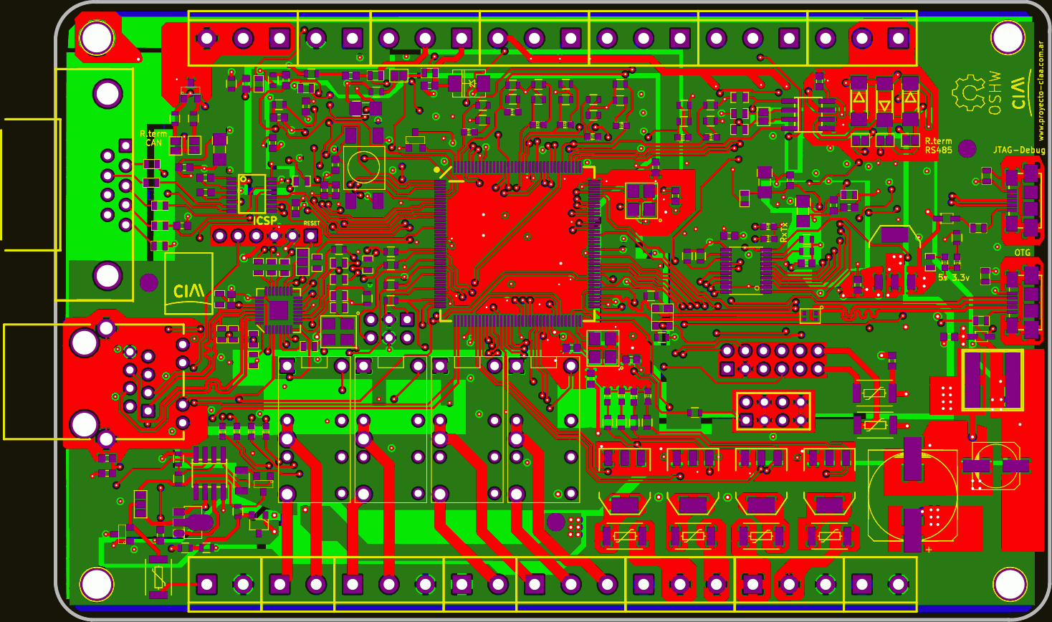
PCB/PIC/Documents/ciaa-picAll.png
