ciaa/Hardware/PCB/PIC/Documents/ciaa-picB.png

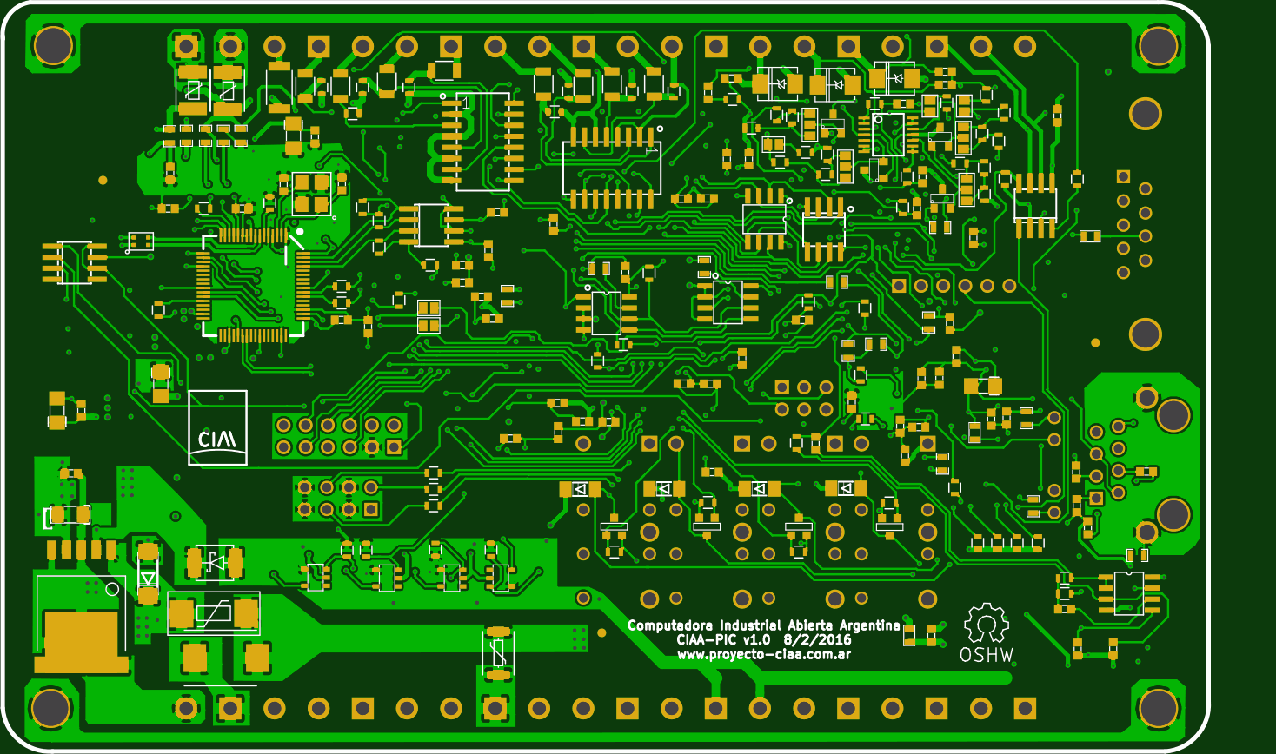
PCB/PIC/Documents/ciaa-picB.png
