ciaa/Hardware/PCB/PIC/Documents/ciaa-picGND.png

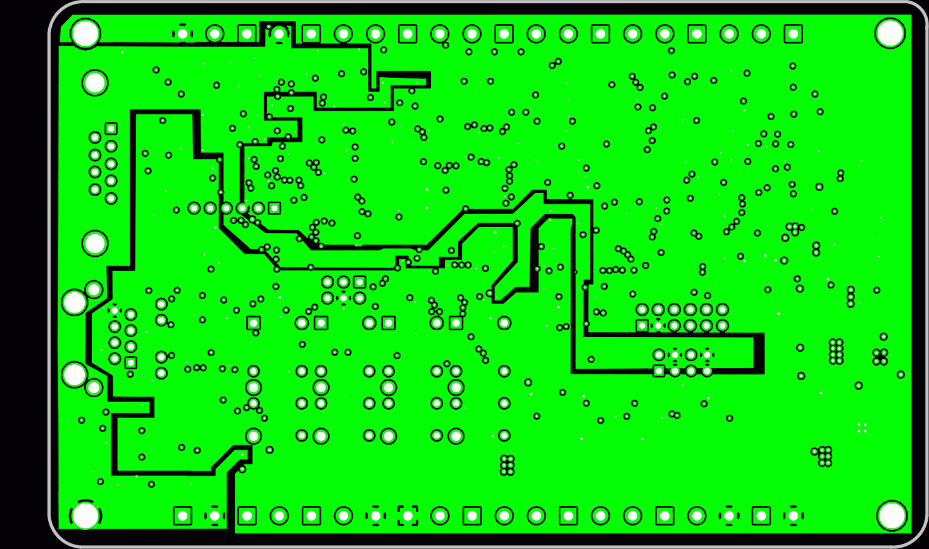
PCB/PIC/Documents/ciaa-picGND.png
