ciaa/Hardware/PCB/PIC/Documents/ciaa-picPWR.png

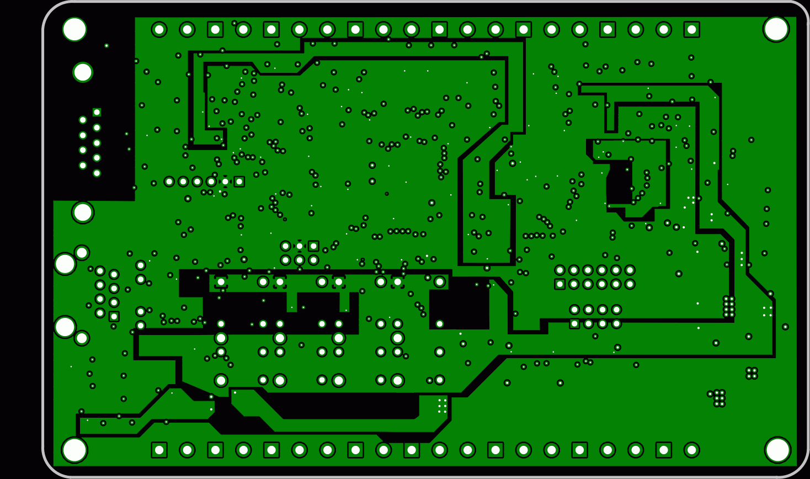
PCB/PIC/Documents/ciaa-picPWR.png
