ciaa/Hardware/PCB/PIC/Documents/ciaa-picTop.png

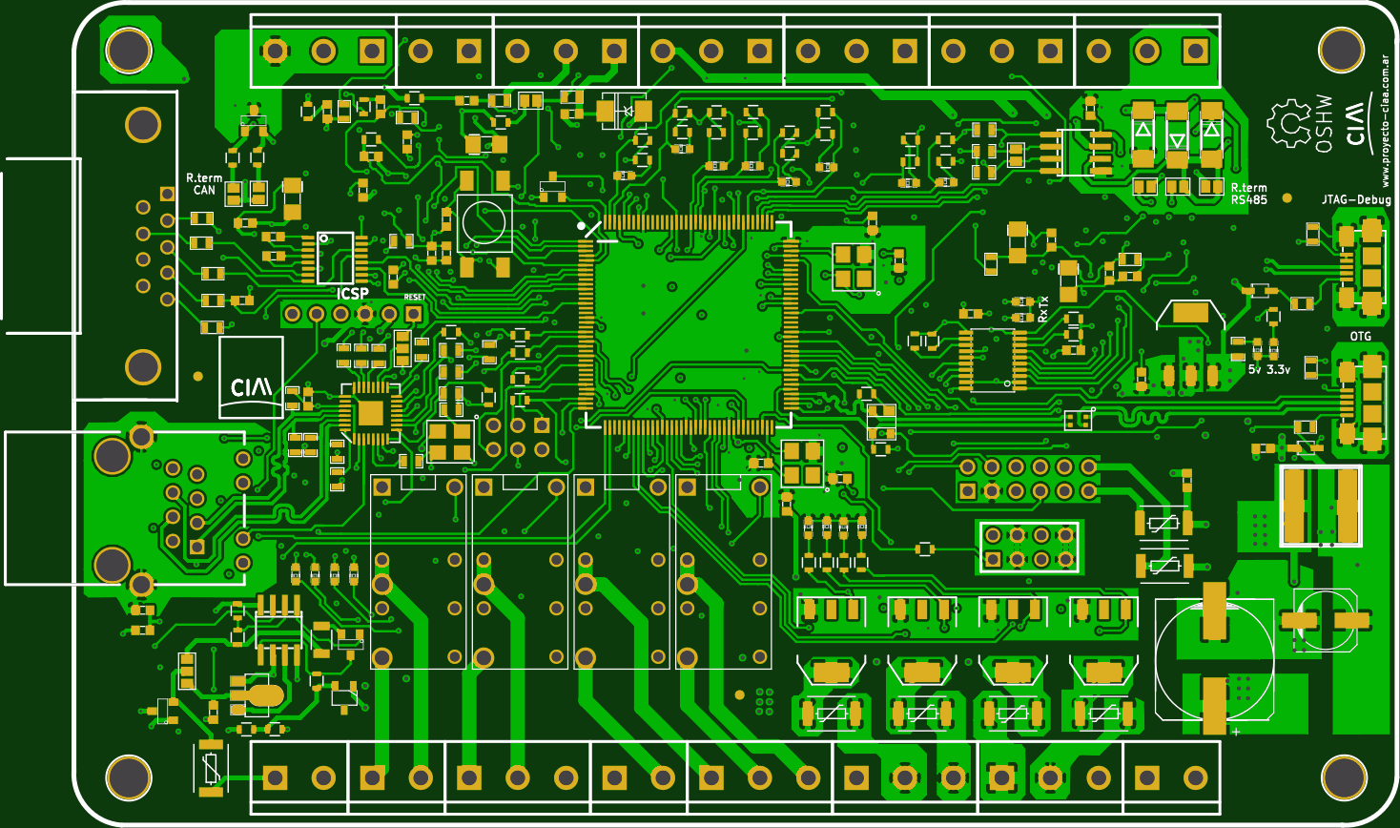
PCB/PIC/Documents/ciaa-picTop.png
