ciaa/Hardware/PCB/pico/doc/picociaa_back.png

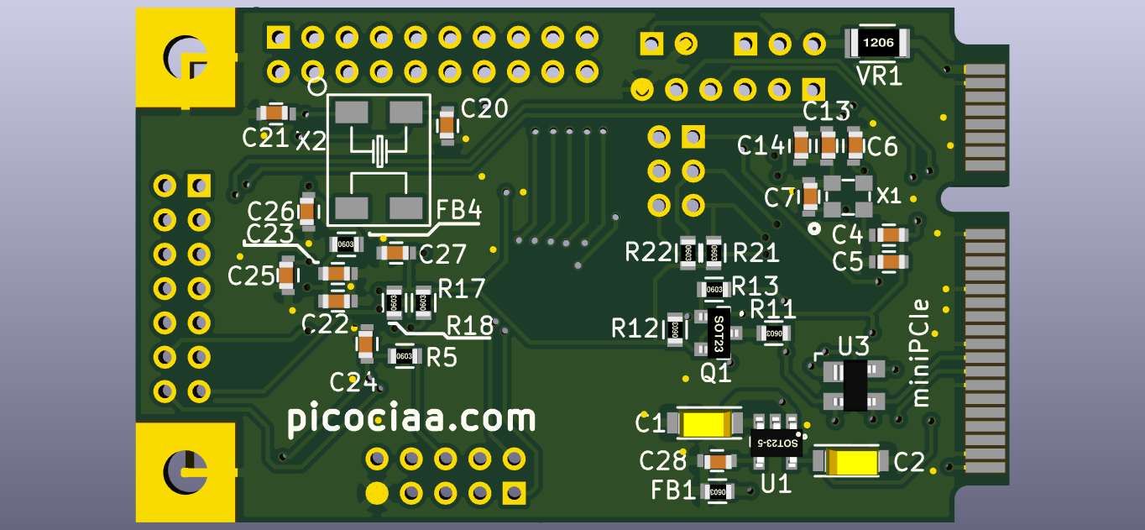
PCB/pico/doc/picociaa_back.png
