ciaa/Hardware/PCB/pico/doc/picociaa_front.png

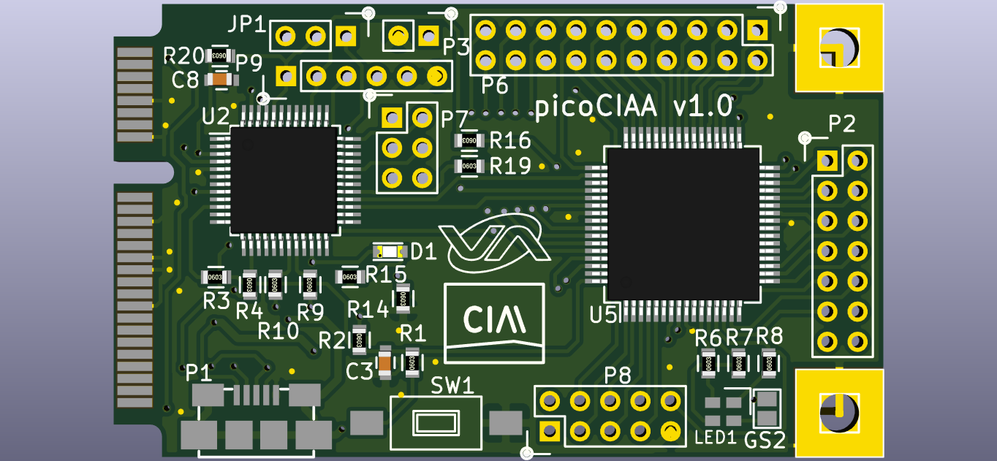
PCB/pico/doc/picociaa_front.png
