ciaa/Hardware/PCB/Z3R0/CIAA-Z3R0_0.png

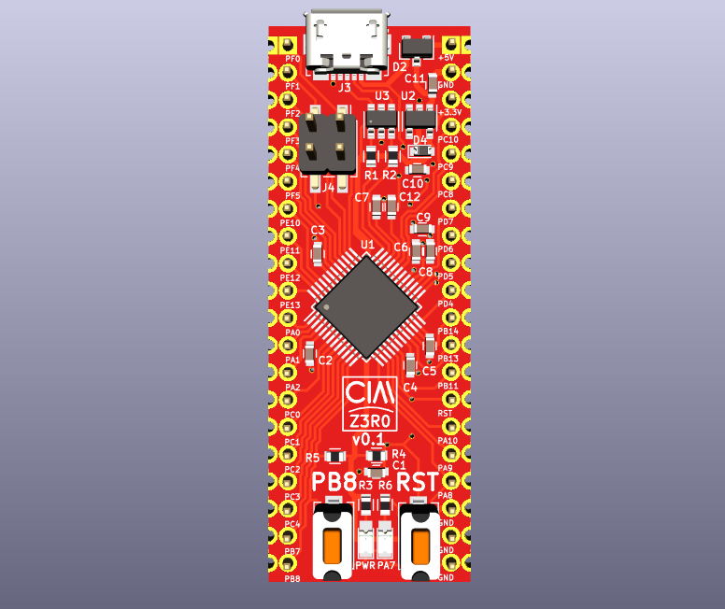
PCB/Z3R0/CIAA-Z3R0_0.png
