ciaa/Hardware/PCB/Z3R0/CIAA-Z3R0_1.jpg

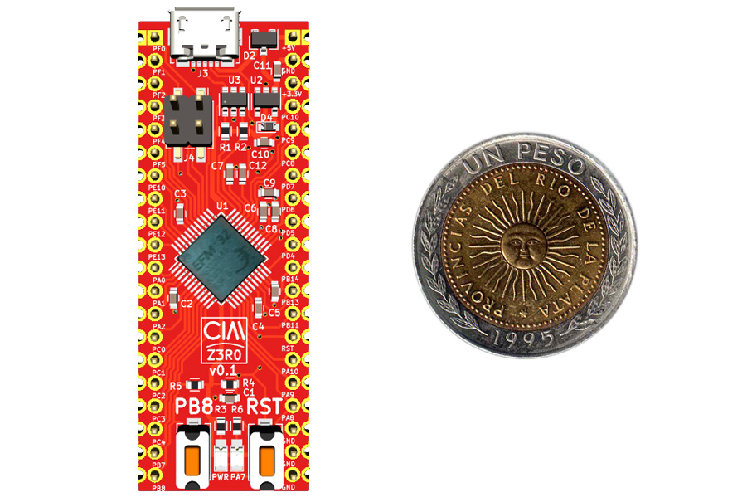
PCB/Z3R0/CIAA-Z3R0_1.jpg
