ciaa/Hardware/PCB/Z3R0/docs/3dview001.png

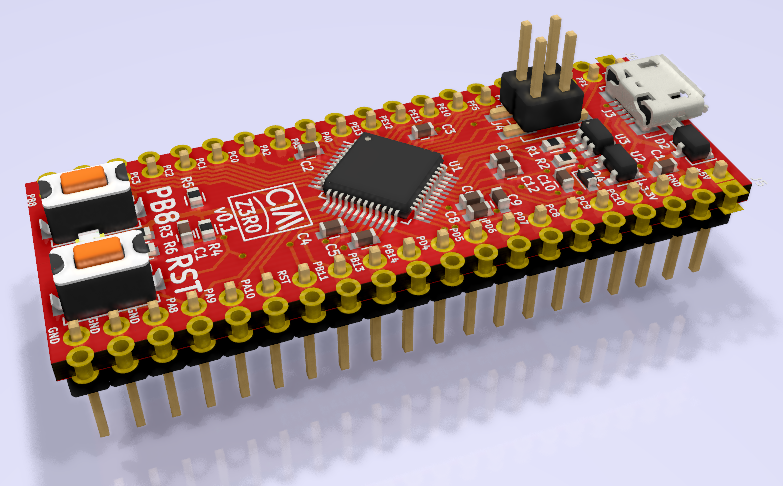
PCB/Z3R0/docs/3dview001.png
