ciaa/Hardware/PCB/Z3R0/docs/3dview002.png

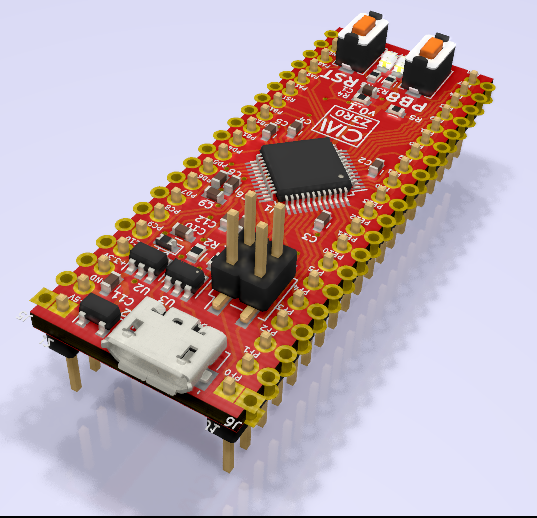
PCB/Z3R0/docs/3dview002.png
