ciaa/Hardware/PCB/pico/doc/picociaa-bom.ods

Item | Qty | Reference(s) | Value | Link Mouser | Nro. Parte
1 | 2 | C1, C2 | 10uF | T491A106K010AT (http://ar.mouser.com/Search/Refine.aspx?Keyword=) | T491A106K010AT
2 | 9 | C13, C23, C24, C25, C26, C27, C3, C4, C8 | 100nF | 80-C0603C104K5R (http://ar.mouser.com/Search/Refine.aspx?Keyword=) | 80-C0603C104K5R
3 | 4 | C14, C22, C28, C5 | 10nF | 80-C0603C103K5R (http://ar.mouser.com/Search/Refine.aspx?Keyword=) | 80-C0603C103K5R
4 | 2 | C20, C21 | 20pF | 81-GRM39C200J50 (http://ar.mouser.com/Search/Refine.aspx?Keyword=) | 81-GRM39C200J50
5 | 2 | C6, C7 | 18pF | 81-GRM39C180J50 (http://ar.mouser.com/Search/Refine.aspx?Keyword=) | 81-GRM39C180J50
6 | 1 | D1 | LED | 78-VLMS1300-GS08 (http://ar.mouser.com/Search/Refine.aspx?Keyword=) | 78-VLMS1300-GS08
7 | 2 | FB1, FB4 | FILTER | 810-MMZ1608B601C (http://ar.mouser.com/Search/Refine.aspx?Keyword=) | 810-MMZ1608B601C
8 | 1 | G1 | LOGO | 0 (http://ar.mouser.com/Search/Refine.aspx?Keyword=)
9 | 1 | GS2 | GS2 | 0 (http://ar.mouser.com/Search/Refine.aspx?Keyword=)
10 | 1 | J1 | PCIE-MINI | 0 (http://ar.mouser.com/Search/Refine.aspx?Keyword=)
11 | 1 | JP1 | VDD Sel. JUMPER | 855-M22-1920005 (http://ar.mouser.com/Search/Refine.aspx?Keyword=) | 855-M22-1920005
 |  |  | VDD Sel. Pines | 855-M22-2510305 (http://ar.mouser.com/Search/Refine.aspx?Keyword=) | 855-M22-2510305 | pines 2mm 1 fila
12 | 1 | LED1 | RGB | 859-LTST-C19FD1WT (http://ar.mouser.com/Search/Refine.aspx?Keyword=) | 859-LTST-C19FD1WT
13 | 1 | P1 | MicroUSB tipo B | 649-10118192-0001LF (http://ar.mouser.com/Search/Refine.aspx?Keyword=) | 649-10118192-0001LF |  | housings
14 | 1 | P2 | IO2 | 855-M22-2520705 (http://ar.mouser.com/Search/Refine.aspx?Keyword=) | 855-M22-2520705 | pines 2mm 2 filas | 538-511101451
15 | 1 | P3 | PWR | 855-M22-2510205 (http://ar.mouser.com/Search/Refine.aspx?Keyword=) | 855-M22-2510205 | pines 2mm 1 fila | 538-51090-0200
16 | 2 | P4, P5 | MOUNTING_HOLE | 0 (http://ar.mouser.com/Search/Refine.aspx?Keyword=)
17 | 1 | P6 | IO1 | 855-M22-2521005 (http://ar.mouser.com/Search/Refine.aspx?Keyword=) | 855-M22-2521005 | pines 2mm 2 filas | 538-511102051
18 | 1 | P7 | DBG_IO | 855-M22-2520305 (http://ar.mouser.com/Search/Refine.aspx?Keyword=) | 855-M22-2520305 | pines 2mm 2 filas | 538-51110-0660
19 | 1 | P8 | IO3 | 855-M22-2520505 (http://ar.mouser.com/Search/Refine.aspx?Keyword=) | 855-M22-2520505 | pines 2mm 2 filas | 538-51110-1050
20 | 1 | P9 | DBG_SWD | 855-M22-2510605 (http://ar.mouser.com/Search/Refine.aspx?Keyword=) | 855-M22-2510605 | pines 2mm 1 fila | 538-51090-0600
21 | 1 | Q1 | BC857 | 863-BC857BLT1G (http://ar.mouser.com/Search/Refine.aspx?Keyword=) | 863-BC857BLT1G
22 | 2 | R1, R3 | 100 | 71-CRCW0603-100-E3 (http://ar.mouser.com/Search/Refine.aspx?Keyword=) | 71-CRCW0603-100-E3
23 | 2 | R10, R9 | 33 | 71-CRCW0603-33-E3 (http://ar.mouser.com/Search/Refine.aspx?Keyword=) | 71-CRCW0603-33-E3
24 | 2 | R11, R8 | 1.5k | 71-CRCW0603-1.5K-E3 (http://ar.mouser.com/Search/Refine.aspx?Keyword=) | 71-CRCW0603-1.5K-E3
25 | 3 | R12, R16, R19 | 24k | 71-CRCW0603-24K-E3 (http://ar.mouser.com/Search/Refine.aspx?Keyword=) | 71-CRCW0603-24K-E3
26 | 5 | R13, R15, R4, R21, R22 | 2k | 71-CRCW0603-2.0K-E3 (http://ar.mouser.com/Search/Refine.aspx?Keyword=) | 71-CRCW0603-2.0K-E3
27 | 1 | R14 | UL | 0 (http://ar.mouser.com/Search/Refine.aspx?Keyword=)
28 | 2 | R17, R18 | 2.2k | 71-CRCW0603-2.2K-E3 (http://ar.mouser.com/Search/Refine.aspx?Keyword=) | 71-CRCW0603-2.2K-E3
29 | 2 | R2, R5 | 100k | 71-CRCW0603-100K-E3 (http://ar.mouser.com/Search/Refine.aspx?Keyword=) | 71-CRCW0603-100K-E3
30 | 1 | R20 | 10k | 71-CRCW0603-10K-E3 (http://ar.mouser.com/Search/Refine.aspx?Keyword=) | 71-CRCW0603-10K-E3
31 | 2 | R6, R7 | 270 | 71-CRCW0603-270-E3 (http://ar.mouser.com/Search/Refine.aspx?Keyword=) | 71-CRCW0603-270-E3
32 | 1 | SW1 | RESET | 506-FSMSM (http://ar.mouser.com/Search/Refine.aspx?Keyword=) | 506-FSMSM
33 | 1 | U1 | MIC5319-3.3YD5 | 998-MIC5319-3.3YD5TR (http://ar.mouser.com/Search/Refine.aspx?Keyword=) | 998-MIC5319-3.3YD5TR
34 | 1 | U2 | LPC11U35FBD48 | 771-LPC11U35FBD48401 (http://ar.mouser.com/Search/Refine.aspx?Keyword=) | 771-LPC11U35FBD48401
35 | 1 | U3 | PRTR5V0U2X | 771-PRTR5V0U2X-T/R (http://ar.mouser.com/Search/Refine.aspx?Keyword=) | 771-PRTR5V0U2X-T/R
36 | 1 | U5 | LPC54102J512BD64 | 771-LPC54102J512BD64 (http://ar.mouser.com/Search/Refine.aspx?Keyword=) | 771-LPC54102J512BD64
37 | 1 | VR1 | VR | 504-PTS12066V100 (http://ar.mouser.com/Search/Refine.aspx?Keyword=) | 504-PTS12066V100
38 | 1 | X1 | 12MHz | 581-CX2520DB1C0WLSC1 (http://ar.mouser.com/Search/Refine.aspx?Keyword=) | 581-CX2520DB1C0WLSC1
39 | 1 | X2 | 32.768kHz | 815-ABS25-32.768KHZT (http://ar.mouser.com/Search/Refine.aspx?Keyword=) | 815-ABS25-32.768KHZT
