ciaa/Hardware/PCB/EDU-NXP/Doc/edu-ciaa-bom_x100_v2.5.ods

Componente | Cantidad por PCB | Referencia | Descripción | Código Digi-Key
BK-913 | 1 | BT1 | Soporte batería CR2032 | BK-913-ND (http://www.digikey.com/product-search/en?KeyWords=BK-913-ND)
20pF | 6 | C11 C12 C13 C14 C15 C16 | Cap. Cerámico 0805 | 399-8033-1-ND (http://www.digikey.com/product-detail/en/C0805C200J5GACTU/399-8033-1-ND/3471756)
100nF | 37 | C2 C4 C7 C8 C9 C10 C17 C18 C19 C20 C21 C22 C23 C24 C25 C26 C27 C28 C29 C30 C31 C32 C34 C36 C38 C40 C41 C42 C43 C44 C45 C46 C47 C48 C49 C50 C51 | Cap. Cerámico 0805 | 399-1167-1-ND (http://www.digikey.com/product-detail/en/C0805C104K4RACTU/399-1167-1-ND/411442)
3.3uF | 1 | C35 | Cap. Cerámico 0805 | 445-7582-1-ND (http://www.digikey.com/product-detail/en/C2012X7R1C335K125AB/445-7582-1-ND/2733654)
10uF | 5 | C1 C3 C33 C37 C39 | Cap. Cerámico 1206 | 399-3525-1-ND (http://www.digikey.com/product-detail/en/C1206C106K4RACTU/399-3525-1-ND/789665)
10uF | 2 | C5 C6 | Cap. Tantalio 1206 | 399-3684-2-ND (http://www.digikey.com/product-detail/en/T491A106K010AT/399-3684-2-ND/818545)
PSD12C | 3 | D1 D2 D3 | TVS | P6SMB12CAT3GOSCT-ND (http://www.digikey.com/product-detail/en/P6SMB12CAT3G/P6SMB12CAT3GOSCT-ND/1967278)
PMEG3020EH | 3 | D4 D5 D10 | Diodo Schottky | 568-4129-1-ND (http://www.digikey.com/product-detail/en/PMEG3020EH,115/568-4129-1-ND/1589944)
LED | 2 | D6 D8 | LED Rojo 0805 | 1080-1412-1-ND (http://www.digikey.com/product-detail/en/QTLP630C7TR/1080-1412-1-ND/2676146)
LED | 1 | D7 | LED Amarillo 0805 | 1080-1410-1-ND (http://www.digikey.com/product-detail/en/QTLP630C3TR/1080-1410-1-ND/2676144)
LED | 1 | D9 | LED Verde 0805 | 1080-1411-1-ND (http://www.digikey.com/product-detail/en/QTLP630C4TR/1080-1411-1-ND/2676145)
LL4148 | 1 | D11 | Diodo propósito general | LL4148FSTR-ND (http://www.digikey.com/product-detail/es/LL4148/LL4148FSCT-ND/1923118)
MI0805M221R-10 | 5 | FB1 FB5 FB6 FB9 FB10 | EMI Filter 0805 | 240-2392-1-ND (http://www.digikey.com/product-detail/en/MI0805M221R-10/240-2392-1-ND/806752)
HZ0805E601R-10 | 5 | FB2 FB3 FB4 FB7 FB8 | EMI Filter 0805 | 240-2399-1-ND (http://www.digikey.com/product-detail/en/HZ0805E601R-10/240-2399-1-ND/806759)
TB_1X3 | 1 | J1 | Bornera 1x3 | ED2610-ND (http://www.digikey.com/product-search/en?KeyWords=ED2610-ND)
ZX62D-AB-5P8 | 2 | J2 J3 | Conector micro USB tipo AB | H11494CT-ND (http://www.digikey.com/product-detail/en/ZX62D-AB-5P8/H11494CT-ND/1589864)
LED RGB | 1 | LED1 | led RGB SDM | 160-2022-1-ND (http://www.digikey.com/product-detail/en/LTST-C19FD1WT/160-2022-1-ND/3711419)
Conector IDE | 1 | P3 | Conector 2x5 1.27mm SMD para DEBUG | FTSH-105-01-L-DV-K-TR-ND (http://www.digikey.com/product-search/en?KeyWords=FTSH-105-01-L-DV-K-TR-ND&WT.z_header=search_go)
USMF020 | 2 | PS1 PS2 | Polyswitch | MF-USMF020-2CT-ND (http://www.digikey.com/product-detail/en/MF-USMF020-2/MF-USMF020-2CT-ND/1014928)
2N7002 | 6 | Q1 Q3 Q4 Q5 Q9 Q10 | Mosfet canal N SOT23 | 2N7002NCT-ND (http://www.digikey.com/product-detail/en/2N7002/2N7002NCT-ND/244664)
0 | 6 | R107 R108 R109 R110 R11 R15 | Resistor SMD 0805 | 311-0.0ARCT-ND (http://www.digikey.com/product-detail/en/RC0805JR-070RL/311-0.0ARCT-ND/731163)
4K7 | 3 | R1 R2 R3 | Resistor SMD 0805 | 1276-5544-1-ND (http://www.digikey.com/product-detail/en/RC2012J472CS/1276-5544-1-ND/3968516)
100K | 3 | R4 R5 R90 | Resistor SMD 0805 | P100KACT-ND (http://www.digikey.com/product-detail/en/ERJ-6GEYJ104V/P100KACT-ND/692)
680 | 6 | R68 R72 R73 R76 R84 R85 | Resistor SMD 0805 | RR12P680DCT-ND (http://www.digikey.com/product-detail/en/RR1220P-681-D/RR12P680DCT-ND/432826)
390 | 2 | R6 R8 | Resistor SMD 0805 | RR12P390DCT-ND (http://www.digikey.com/product-detail/en/RR1220P-391-D/RR12P390DCT-ND/432820)
200 | 1 | R7 | Resistor SMD 0805 | RR12P200DCT-ND (http://www.digikey.com/product-detail/en/RR1220P-201-D/RR12P200DCT-ND/432813)
100 1/2W | 1 | R9 | Resistor SMD 0805 1/2W | P16057CT-ND (http://www.digikey.com/product-detail/en/ERJ-P06F1000V/P16057CT-ND/3982404)
330K | 6 | R10 R12 R13 R14 R18 R19 | Resistor SMD 0805 | RMCF0805JT330KCT-ND (http://www.digikey.com/product-detail/en/RMCF0805JT330K/RMCF0805JT330KCT-ND/1942597)
470 | 1 | R20 | Resistor SMD 0805 | P470ACT-ND (http://www.digikey.com/product-detail/en/ERJ-6GEYJ471V/P470ACT-ND/90029)
1K2 | 3 | R21 R22 R23 | Resistor SMD 0805 | RMCF0805JT1K20CT-ND (http://www.digikey.com/product-detail/en/RMCF0805JT1K20/RMCF0805JT1K20CT-ND/1942559)
1K | 6 | R57 R58 R59 R60 R61 R104 | Resistor SMD 0805 | 311-1.0KARCT-ND (http://www.digikey.com/product-detail/en/RC0805JR-071KL/311-1.0KARCT-ND/731165)
10K | 18 | R16 R17 R62 R63 R64 R65 R66 R70 R71 R74 R82 R83 R93 R94 R99 R100 R102 R106 | Resistor SMD 0805 | P10KACT-ND (http://www.digikey.com/product-detail/en/ERJ-6GEYJ103V/P10KACT-ND/43118)
10M | 1 | R91 | Resistor SMD 0805 | RMCF0805JT10M0CT-ND (http://www.digikey.com/product-detail/en/RMCF0805JT10M0/RMCF0805JT10M0CT-ND/1942604)
12K | 2 | R92 R103 | Resistor SMD 0805 1% | 311-12.0KCRCT-ND (http://www.digikey.com/product-detail/en/RC0805FR-0712KL/311-12.0KCRCT-ND/730515)
2K2 | 3 | R95 R97 R101 | Resistor SMD 0805 | RMCF0805JT2K20CT-ND (http://www.digikey.com/product-detail/en/RMCF0805JT2K20/RMCF0805JT2K20CT-ND/1942563)
15K | 2 | R96 R98 | Resistor SMD 0805 | RR12P15.0KDCT-ND (http://www.digikey.com/product-detail/en/RR1220P-153-D/RR12P15.0KDCT-ND/432858)
270 | 1 | R105 | Resistor SMD 0805 | RHM270CPCT-ND (http://www.digikey.com/product-detail/en/MCR10ERTJ271/RHM270CPCT-ND/4085165)
PULSADOR | 5 | TEC_1 TEC_2 TEC_3 TEC_4 RESET | Tact switch | 450-1804-ND (http://www.digikey.com/product-detail/en/1825910-7/450-1804-ND/1731414)
MF-MSMF030-2 | 4 | TH1 TH2 TH3 TH3 | Polyswitch 0.3A SMD | MF-MSMF030-2CT-ND (http://www.digikey.com/product-detail/en/MF-MSMF030-2/MF-MSMF030-2CT-ND/662841)
DLW21HN900SQ2 | 2 | TR1 TR2 | Choke USB | 490-1064-2-ND (http://www.digikey.com/product-detail/en/DLW21HN900SQ2L/490-1064-1-ND/584510)
SN65HVD1176DR | 1 | U1 | Transceptor RS485 SOIC8 | 296-26337-1-ND (http://www.digikey.com/product-detail/en/SN65HVD1176DR/296-26337-1-ND/2254974)
PRTR5V0U2X | 2 | U2 U8 | TVS para USB SOT143 | 568-4140-1-ND (http://www.digikey.com/product-detail/en/PRTR5V0U2X,215/568-4140-1-ND/1589981)
NCP1117ST33T3G | 1 | U3 | Regulador 3.3V SOT223 | NCP1117ST33T3GOSCT-ND (http://www.digikey.com/product-detail/en/NCP1117ST33T3G/NCP1117ST33T3GOSCT-ND/660708)
LPC4337JBD144 | 1 | U4 | Microcontrolador LQFP144 | 568-10159-ND (http://www.digikey.com/product-search/en?KeyWords=568-10159-ND)
93C46 | 1 | U5 | EEPROM SOIC8 | AT93C46DN-SH-TCT-ND (http://www.digikey.com/product-detail/en/AT93C46DN-SH-T/AT93C46DN-SH-TCT-ND/3440828)
FT2232H | 1 | U6 | USB IC 64-LQFP | 768-1024-1-ND (http://www.digikey.com/product-detail/en/FT2232HL-REEL/768-1024-1-ND/1986057)
TXB0108 | 1 | U7 | Buffer bidireccional 20-TSSOP | 296-21527-1-ND (http://www.digikey.com/product-detail/en/TXB0108PWR/296-21527-1-ND/1305700)
32.768K | 1 | X1 | Cristal 4SOJ | 535-9166-1-ND (http://www.digikey.com/product-detail/en/ABS25-32.768KHZ-T/535-9166-1-ND/675683)
12MHz | 2 | X2 X3 | Cristal SMD | 887-1831-1-ND (http://www.digikey.com/product-detail/en/7S-12.000MAHE-T/887-1831-1-ND/3598028)
SMAZ5V6 | 1 | ZA1 | Zener SMD | MMSZ5V6T1GOSCT-ND (http://www.digikey.com/product-detail/en/MMSZ5V6T1G/MMSZ5V6T1GOSCT-ND/919785)
MIC2025 | 1 | U9 | Power distribution IC | 576-1058-ND (http://www.digikey.com/product-detail/en/MIC2025-2YM/576-1058-ND/771527)
5125 | 1 | TP1 | TEST POINT | 36-5125-ND (http://www.digikey.com/product-detail/en/5125/36-5125-ND/2170328)
