ciaa/Hardware/PCB/NXP/docs/ciaa-nxp-bom.xls

Sheet: ciaa-nxp
Componente | Cantidad por PCB | Referencia | Descripción | Código Digi-Key | Código Mouser | Cantidad para 100 PCBs | Costo unitario (USD FOB DigiKey) | Costo por PCB (USD FOB DigiKey)
BK-913 | 1 | BT1 | Soporte batería CR2032 | BK-913-ND | 534-3003 | 100 | $0.27000 | $0.27000 | BK-913-ND | 534-3003
15p | 2 | C79 C81 | Cap. Cerámico 0603 | 1276-1296-1-ND | 77-VJ0603A150JXACBC | 200 | $0.01210 | $0.02420 | 1276-1296-1-ND | 77-VJ0603A150JXACBC
18pF | 4 | C11 C12 C13 C14 | Cap. Cerámico 0603 | 399-1052-1-ND | 80-C0603C180J5G | 400 | $0.01540 | $0.06160 | 399-1052-1-ND | 80-C0603C180J5G
20p | 2 | C82 C83 | Cap. Cerámico 0603 | 1276-1187-1-ND | 81-GRM39C200J50 | 200 | $0.01380 | $0.02760 | 1276-1187-1-ND | 81-GRM39C200J50
22p | 2 | C84 C85 | Cap. Cerámico 0603 | 445-1273-1-ND | 80-C0603C220J5G | 200 | $0.01380 | $0.02760 | 445-1273-1-ND | 80-C0603C220J5G
470pF | 5 | C7 C38 C40 C44 C92 | Cap. Cerámico 0603 | 399-1075-1-ND | 80-C0603C471K5R | 500 | $0.01652 | $0.08260 | 399-1075-1-ND | 80-C0603C471K5R
1nF | 5 | C8 C36 C42 C91 C93 | Cap. Cerámico 0603 | 399-1082-1-ND | 80-C0603C102K5R | 500 | $0.01120 | $0.05600 | 399-1082-1-ND | 80-C0603C102K5R
10nF | 2 | C69 C88 | Cap. Cerámico 0603 | 399-1091-1-ND | 80-C0603C103K5R | 200 | $0.00900 | $0.01800 | 399-1091-1-ND | 80-C0603C103K5R
100nF | 61 | C2 C3 C4 C6 C9 C10 C15 C19 C20 C22 C23 C24 C25 C26 C27 C29 C30 C32 C33 C35 C37 C39 C41 C43 C45 C46 C47 C48 C49 C50 C51 C52 C53 C54 C55 C56 C57 C58 C59 C61 C62 C63 C64 C65 C66 C67 C70 C71 C72 C73 C74 C75 C76 C77 C86 C87 C89 C90 C94 C95 C96 | Cap. Cerámico 0603 | 399-5089-1-ND | 80-C0603C104K5R | 6100 | $0.00782 | $0.47702 | 399-5089-1-ND | 80-C0603C104K5R
1uF | 4 | C97 C98 C99 C100 | Cap. Cerámico 0603 | 399-7848-1-ND | 80-C0603C105K9P | 400 | $0.01836 | $0.07344 | 399-7848-1-ND | 80-C0603C105K9P
3.3uF | 1 | C80 | Cap. Cerámico SMD | 399-5502-1-ND | 80-C0603C335M9P | 100 | $0.01470 | $0.01470 | 399-5502-1-ND | 80-C0603C335M9P
10uF | 10 | C1 C5 C18 C31 C34 C60 C68 C78 C21 C28 | Cap. Tantáleo SMD | 399-10116-1-ND | 80-T491A106K0067280 | 1000 | $0.09200 | $0.92000 | 399-10116-1-ND | 80-T491A106K0067280
330uF/16V | 1 | C17 | Cap. Aluminio SMD | 493-9415-1-ND | 647-UCW1C331MNL1GS | 100 | $0.40610 | $0.40610 | 493-9415-1-ND | 647-UCW1C331MNL1GS
470uF/35V | 1 | C16 | Cap. Aluminio SMD | 493-3961-1-ND | 647-UCL1V471MNL1GS | 100 | $1.51700 | $1.51700 | 493-3961-1-ND | 647-UCL1V471MNL1GS
BAV199 | 6 | D9 D10 D11 D12 D46 D48 | Array de diodos SMD | BAV199LT1GOSCT-ND | 863-BAV199LT1G | 600 | $0.08646 | $0.51876 | BAV199LT1GOSCT-ND | 863-BAV199LT1G
PMEG3020EH | 3 | D1 D5 D45 | Diodo Schottky | 568-4129-1-ND | 771-PMEG3020EH-T/R | 300 | $0.20752 | $0.62256 | 568-4129-1-ND | 771-PMEG3020EH-T/R
MURS360T3G | 1 | D2 | Diodo 600V 3A | MURS360T3GOSCT-ND | 863-MURS360T3G | 100 | $0.46700 | $0.46700 | MURS360T3GOSCT-ND | 863-MURS360T3G
B540C-13-F | 1 | D3 | Diodo Schottky | B540C-FDICT-ND | 621-B540C-F | 100 | $0.73440 | $0.73440 | B540C-FDICT-ND | 621-B540C-F
LED red | 17 | D4 D13 D14 D15 D16 D17 D18 D19 D20 D21 D22 D23 D24 D33 D34 D35 D36 | LED Rojo 0603 | 1080-1400-1-ND | 78-VLMS1300-GS08 | 1700 | $0.07500 | $1.27500 | 1080-1400-1-ND | 78-VLMS1300-GS08
PSD12C | 3 | D6 D7 D8 | TVS | P6SMB12CAT3GOSCT-ND | 863-P6SMB12CAT3G | 300 | $0.23832 | $0.71496 | P6SMB12CAT3GOSCT-ND | 863-P6SMB12CAT3G
LL4148 | 4 | D27 D28 D30 D31 | Diodo SOD80 | LL4148FSCT-ND | 78-LL4148 | 400 | $0.01483 | $0.05932 | LL4148FSCT-ND | 78-LL4148
MMZ1608B601C | 11 | FB8 FB9 FB1 FB2 FB3 FB4 FB5 FB6 FB10 FB20 FB21 | EMI Filter 0603 | 445-2166-1-ND | 810-MMZ1608B601C | 1100 | $0.02508 | $0.27588 | 445-2166-1-ND | 810-MMZ1608B601C
BLM18KG221SN1 | 5 | FB7 FB11 FB14 FB15 FB16 | EMI Filter 0603 | 490-5255-1-ND | 81-BLM18KG221SN1D | 500 | $0.03484 | $0.17420 | 490-5255-1-ND | 81-BLM18KG221SN1D
BLM18BD470SN1 | 5 | FB12 FB13 FB17 FB18 FB19 | EMI Filter 0603 | 490-5211-1-ND | 81-BLM18BD470SN1D | 500 | $0.03484 | $0.17420 | 490-5211-1-ND | 81-BLM18BD470SN1D
PS2805C-4 | 2 | IC1 IC2 | Optoacoplador SMD AC. | PS2805C-4-A-ND | 551-PS2805C-4-F3-A | 200 | $2.09100 | $4.18200 | PS2805C-4-A-ND | 551-PS2805C-4-F3-A
DB9 | 1 | J3 | Conector DB9 macho para PCB Thru-hole | S9575-ND | 806-K22X-E9P-NJ | 100 | $0.54450 | $0.54450 | S9575-ND | 806-K22X-E9P-NJ
ZX62-AB-5PA | 1 | J6 | Conector micro USB tipo AB | H11635TR-ND | 798-ZX62-AB-5PA11 | 100 | $0.77440 | $0.77440 | H11635TR-ND | 798-ZX62-AB-5PA11
ZX62-B-5PA | 2 | J7 P16 | Conector micro USB tipo B | H11634CT-ND | 798-ZX62-B-5PA11 | 200 | $0.72600 | $1.45200 | H11634CT-ND | 798-ZX62-B-5PA11
TB_1X3 | 10 | J1 J8 J9 J10 J12 J13 J15 J16 J2 J4 | Bornes fijos x3 | ED2610-ND | FIX | 1000 | $0.26400 | $2.64000 | ED2610-ND | FIX
TB_1X2 | 5 | J11 J14 J17 J18 J19 | Bornes fijos x2 | ED2609-ND | FIX | 500 | $0.23100 | $1.15500 | ED2609-ND | FIX
JUMPER | 5 | JP1 JP2 JP4 JP5 JP6 | Jumper | 3M9580-ND | 649-68786-102LF | 500 | $0.04200 | $0.21000 | 3M9580-ND | 649-68786-102LF
PINES 1x40 | 1 | JP1 JP2 JP4 JP5 JP6 | Tira de pines 1x40 2.54mm | S1212EC-40-ND | 855-M20-9994045 | 100 | $0.47040 | $0.47040 | S1212EC-40-ND | 855-M20-9994045
G5V-2-DC5 | 4 | K1 K2 K3 K4 | Relé DPDT | Z767-ND | 653-G5V-2-DC5 | 400 | $1.98024 | $7.92096 | Z767-ND | 653-G5V-2-DC5
47uH | 1 | L2 | Inductor 3A SMD | SRN1060-470MCT-ND | 652-SRN1060-470M | 100 | $0.45000 | $0.45000 | SRN1060-470MCT-ND | 652-SRN1060-470M
BK1608HS220-T | 1 | L1 | Ferrite | MH1608-221YCT-ND | 963-BK1608HS220-T | 100 | $0.03480 | $0.03480 | MH1608-221YCT-ND | 963-BK1608HS220-T
SI-52003-F | 1 | P1 | Conector Ethernet con trafos y LEDs integrados con salidas PoE. | 380-1119-ND | Ver en ARROW | 100 | $4.68600 | $4.68600 | 380-1119-ND | FIX | Ver en ARROW!!!
PINES 2x40 | 2 | P2 P3 P12 P13 P14 P15 | Tira de pines 2x40 2.54mm | S2012EC-40-ND | 571-41037770 | 200 | $0.83370 | $1.66740 | S2012EC-40-ND | 571-41037770
Cortex-Debug | 1 | P8 | Conector 10 pines SMD 1.27mm | 952-1389-ND | 855-M50-3600542 | 100 | $0.88000 | $0.88000 | 952-1389-ND | 855-M50-3600542
USMF020 | 2 | PS1 PS2 | Polyswitch | MF-USMF020-2CT-ND | 652-MF-USMF020-2 | 200 | $0.22640 | $0.45280 | MF-USMF020-2CT-ND | 652-MF-USMF020-2
PBSS5240XF | 1 | Q1 | Transistor PNP 40V 2A | 568-10522-1-ND | 771-PBSS5240XF | 100 | $0.21770 | $0.21770 | 568-10522-1-ND | 771-PBSS5240XF
BC817-40 | 1 | Q14 | Transistor NPN 45V 0.5A | BC817-40LT3GOSCT-ND | 863-BC817-40LT3G | 100 | $0.07970 | $0.07970 | BC817-40LT3GOSCT-ND | 863-BC817-40LT3G
FQT13N06L | 4 | Q2 Q3 Q4 Q5 | MOSFET-N de potencia SMD | FQT13N06LTFCT-ND | 512-FQT13N06LTF | 400 | $1.00600 | $4.02400 | FQT13N06LTFCT-ND | 512-FQT13N06LTF
NDS7002A | 4 | Q6 Q7 Q11 Q12 | MOSFET-N SMD SOT-23 | NDS7002ACT-ND | 512-NDS7002A | 400 | $0.11542 | $0.46168 | NDS7002ACT-ND | 512-NDS7002A
0 | 17 | R7 R8 R9 R13 R14 R23 R24 R25 R26 R27 R28 R29 R30 R86 R87 R88 R89 | Resistor SMD 0603 | 311-0.0GRCT-ND | 71-CRCW0603-0-E3 | 1700 | $0.00204 | $0.03468 | 311-0.0GRCT-ND | 71-CRCW0603-0-E3
4.7 | 4 | R53 R61 R123 R128 | Resistor SMD 0603 | 311-4.7GRCT-ND | 71-CRCW0603-4.7 | 400 | $0.00348 | $0.01392 | 311-4.7GRCT-ND | 71-CRCW0603-4.7
22 | 3 | R10 R11 R12 | Resistor SMD 0603 | 311-22GRCT-ND | 71-CRCW060322R0FKEAH | 300 | $0.00348 | $0.01044 | 311-22GRCT-ND | 71-CRCW060322R0FKEAH
24.9 0.1% 25ppm/°C | 2 | R20 R83 | Resistor SMD 0603 | A109954CT-ND | 660-RN731JTTD24R9B25 | 200 | $0.28230 | $0.56460 | A109954CT-ND | 660-RN731JTTD24R9B25
50 | 4 | R3 R4 R5 R6 | Resistor SMD 0603 | 311-49.9HRCT-ND | 71-CRCW0603-50-E3 | 400 | $0.00456 | $0.01824 | 311-49.9HRCT-ND | 71-CRCW0603-50-E3
60 | 2 | R43 R46 | Resistor SMD 0603 | 311-59.0HRCT-ND | 71-CRCW0603-59-E3 | 200 | $0.00600 | $0.01200 | 311-59.0HRCT-ND | 71-CRCW0603-59-E3
100 | 4 | R51 R54 R57 R60 | Resistor SMD 0603 | 311-100GRCT-ND | 71-CRCW0603-100-E3 | 400 | $0.00204 | $0.00816 | 311-100GRCT-ND | 71-CRCW0603-100-E3
220 | 1 | R35 | Resistor SMD 0603 | 311-220GRCT-ND | 71-CRCW0603-220-E3 | 100 | $0.00450 | $0.00450 | 311-220GRCT-ND | 71-CRCW0603-220-E3
237 0.1% 25ppm/°C | 4 | R55 R62 R124 R129 | Resistor SMD 0603 | P237DBCT-ND | 667-ERA-3AEB2370V | 400 | $0.11000 | $0.44000 | P237DBCT-ND | 667-ERA-3AEB2370V
270 | 4 | R17 R18 R84 R44 | Resistor SMD 0603 | 311-270GRCT-ND | 71-CRCW0603-270-E3 | 400 | $0.00348 | $0.01392 | 311-270GRCT-ND | 71-CRCW0603-270-E3
330 | 8 | R131 R132 R133 R134 R135 R136 R137 R138 | Resistor SMD 0603 | 311-330GRCT-ND | 71-CRCW0603-330-E3 | 800 | $0.00278 | $0.02224 | 311-330GRCT-ND | 71-CRCW0603-330-E3
390 | 2 | R32 R39 | Resistor SMD 0603 | 311-390GRCT-ND | 71-CRCW0603-390-E3 | 200 | $0.00450 | $0.00900 | 311-390GRCT-ND | 71-CRCW0603-390-E3
1k | 2 | R22 R98 | Resistor SMD 0603 | 311-1.0KGRCT-ND | 71-CRCW0603-1.0K-E3 | 200 | $0.00450 | $0.00900 | 311-1.0KGRCT-ND | 71-CRCW0603-1.0K-E3
1k5 | 3 | R1 R42 R45 | Resistor SMD 0603 | 311-1.5KGRCT-ND | 71-CRCW0603-1.5K-E3 | 300 | $0.00348 | $0.01044 | 311-1.5KGRCT-ND | 71-CRCW0603-1.5K-E3
2.2k 250mW | 1 | R107 | Resistor SMD 1206 | P2.2KECT-ND | 667-ERJ-8GEYJ222V | 100 | $0.02100 | $0.02100 | P2.2KECT-ND | 667-ERJ-8GEYJ222V
2.2k | 11 | R99 R100 R141 R142 R144 R146 R148 R150 R152 R154 R104 | Resistor SMD 0603 | 311-2.2KGRCT-ND | 71-CRCW0603-2.2K-E3 | 1100 | $0.00348 | $0.03828 | 311-2.2KGRCT-ND | 71-CRCW0603-2.2K-E3
2.49k 0.1% 25ppm/°C | 1 | R105 | Resistor SMD 0603 | P2.49KDBCT-ND | 756-PCF0603R-2K49BT1 | 100 | $0.14340 | $0.14340 | P2.49KDBCT-ND | 756-PCF0603R-2K49BT1
3.3k 250mW | 8 | R65 R66 R67 R68 R69 R70 R71 R72 | Resistor SMD 1206 | P3.3KECT-ND | 667-ERJ-8GEYJ332V | 800 | $0.01152 | $0.09216 | P3.3KECT-ND | 667-ERJ-8GEYJ332V
4.7k | 13 | R34 R36 R37 R41 R47 R73 R74 R75 R76 R77 R78 R79 R140 | Resistor SMD 0603 | 311-4.7KGRCT-ND | 71-CRCW0603-4.7K-E3 | 1300 | $0.00278 | $0.03614 | 311-4.7KGRCT-ND | 71-CRCW0603-4.7K-E3
10k | 15 | R2 R15 R16 R48 R49 R85 R117 R118 R119 R120 R91 R101 R102 R103 R109 | Resistor SMD 0603 | 311-10KGRCT-ND | 71-CRCW0603-10K-E3 | 1500 | $0.00177 | $0.02655 | 311-10KGRCT-ND | 71-CRCW0603-10K-E3
12.1k 1% | 3 | R19 R95 R97 | Resistor SMD 0603 | 311-12.1KHRCT-ND | 71-CRCW0603-12.1K-E3 | 300 | $0.00456 | $0.01368 | 311-12.1KHRCT-ND | 71-CRCW0603-12.1K-E3
15k | 15 | R50 R52 R56 R58 R59 R63 R82 R121 R122 R125 R126 R127 R130 R93 R94 | Resistor SMD 0603 | RG16P15.0KBCT-ND | 756-PCF0603R-15KBT1 | 1500 | $0.07461 | $1.11915 | RG16P15.0KBCT-ND | 756-PCF0603R-15KBT1
33k | 1 | R80 | Resistor SMD 0603 | P33KDBCT-ND | 754-RG1608P-333-BT5 | 100 | $0.14340 | $0.14340 | P33KDBCT-ND | 754-RG1608P-333-BT5
100k | 21 | R21 R31 R64 R81 R106 R108 R111 R112 R115 R116 R143 R145 R147 R149 R151 R153 R155 R33 R38 R90 R92 | Resistor SMD 0603 | 311-100KGRCT-ND | 71-CRCW0603-100K-E3 | 2100 | $0.00204 | $0.04284 | 311-100KGRCT-ND | 71-CRCW0603-100K-E3
10M | 1 | R96 | Resistor SMD 0603 | 311-10MGRCT-ND | 71-CRCW0603-10M-E3 | 100 | $0.00450 | $0.00450 | 311-10MGRCT-ND | 71-CRCW0603-10M-E3
100 / 1/2W | 1 | R40 | Resistor SMD 2010 | CR2010-JW-101ELFCT-ND | 660-SG73P2ETTD1000F | 100 | $0.13780 | $0.13780 | CR2010-JW-101ELFCT-ND | 660-SG73P2ETTD1000F
SW_PUSH | 1 | SW1 | Tact switch SPST | 450-1792-1-ND | 612-TL3301BF260QG | 100 | $0.15820 | $0.15820 | 450-1792-1-ND | 612-TL3301BF260QG
MF-USMF005-2 | 1 | TH10 | Polyswitch 50mA | MF-USMF005-2CT-ND | 652-MF-USMF005-2 | 100 | $0.22640 | $0.22640 | MF-USMF005-2CT-ND | 652-MF-USMF005-2
PTS18126V300 | 1 | TH1 | Polyswitch 3A SMD | MF-SM300-2CT-ND | 504-PTS18126V300 | 100 | $0.41580 | $0.41580 | MF-SM300-2CT-ND | 504-PTS18126V300
PTS12066V100 | 6 | TH3 TH4 TH5 TH6 TH7 TH9 | Polyswitch 1A SMD | MF-USMF110-2CT-ND | 504-PTS12066V100 | 600 | $0.16800 | $1.00800 | MF-USMF110-2CT-ND | 504-PTS12066V100
MF-MSMF030-2 | 1 | TH8 | Polyswitch 0.3A SMD | MF-MSMF030-2CT-ND | 652-MF-MSMF030-2 | 100 | $0.24260 | $0.24260 | MF-MSMF030-2CT-ND | 652-MF-MSMF030-2
DLW21HN900SQ2 | 3 | TR1 TR2 TR3 | Choke USB | SRF2012-900YCT-ND | 81-DLW21HN900SQ2L | 300 | $0.29924 | $0.89772 | SRF2012-900YCT-ND | 81-DLW21HN900SQ2L
LAN8720A-CP | 1 | U1 | Ethernet PHY | LAN8720A-CP-CT-ND | 886-LAN8720A-CP-TR | 100 | $0.76000 | $0.76000 | LAN8720A-CP-CT-ND | 886-LAN8720A-CP-TR
ST3232E | 1 | U6 | Transceiver RS232 16-TSSOP | 497-6538-1-ND | 511-ST3232EC | 100 | $0.71820 | $0.71820 | 497-6538-1-ND | 511-ST3232EC
TJA1040 | 1 | U7 | Transceiver CAN 8-SOIC | 568-10289-1-ND | 771-TJA1040T/CM118 | 100 | $0.92330 | $0.92330 | 568-10289-1-ND | 771-TJA1040T/CM118
PESD1CAN | 1 | U8 | TVS para CAN | 568-4032-1-ND | 771-PESD1CAN-T/R | 100 | $0.25370 | $0.25370 | 568-4032-1-ND | 771-PESD1CAN-T/R
MIC2025-2YM | 1 | U10 | Switch USB 8-TSSOP | 576-1058-ND | 998-MIC2025-2YMTR | 100 | $0.76710 | $0.76710 | 576-1058-ND | 998-MIC2025-2YMTR
MCP6024 | 1 | U11 | OpAmp 14-TSSOP | MCP6024-I/ST-ND | 579-MCP6024-I/ST | 100 | $1.44000 | $1.44000 | MCP6024-I/ST-ND | 579-MCP6024-I/ST
24AA1025 | 1 | U12 | EEPROM 1Mb | 24AA1025-I/SN-ND | 579-24AA1025T-I/SN | 100 | $2.67500 | $2.67500 | 24AA1025-I/SN-ND | 579-24AA1025T-I/SN
24AA025E48 | 1 | U13 | EEPROM 2kb | 24AA025E48-I/SN-ND | 579-24AA025E48T-I/SN | 100 | $0.26520 | $0.26520 | 24AA025E48-I/SN-ND | 579-24AA025E48T-I/SN
TXB0108 | 1 | U14 | Buffer bidireccional 20-TSSOP | 296-21527-1-ND | 595-TXB0108PWR | 100 | $1.67040 | $1.67040 | 296-21527-1-ND | 595-TXB0108PWR
IS42S16800F-7TL | 1 | U15 | SDRAM 128Mb 54-TSOP | IS42S16800F-7TL-TR | 870-IS42S16800F-7TL | 100 | $3.53760 | $3.53760 | IS42S16800F-7TL-TR | 870-IS42S16800F-7TL
FT2232H | 1 | U17 | USB IC 64-LQFP | 768-1024-1-ND | 895-FT2232HL | 100 | $5.40000 | $5.40000 | 768-1024-1-ND | 895-FT2232HL
LM358 | 1 | U18 | Dual OpAmp | LM358DGOS-ND | 863-LM358DG | 100 | $0.26050 | $0.26050 | LM358DGOS-ND | 863-LM358DG
93C46 | 1 | U19 | EEPROM 8-TSSOP, MicroWire | AT93C46DN-SH-B-ND | 579-93C46A-I/SN | 100 | $0.20860 | $0.20860 | AT93C46DN-SH-B-ND | 579-93C46A-I/SN
SN75HVD1176DR | 1 | U5 | Transceiver RS485/Profibus 8-SOIC | SN75HVD1176DR | 595-SN75HVD1176DR | 100 | $3.10170 | $3.10170 | SN75HVD1176DR | 595-SN75HVD1176DR
SI502 | 1 | U2 | Oscilador 50MHz SMD, 30ppm | 535-10829-1-ND | 815-ASV-50.000M-EK-T | 100 | $1.00170 | $1.00170 | 535-10829-1-ND | 815-ASV-50.000M-EK-T
LM2596-5.0 | 1 | U3 | Regulador 5V TO263-5 | LM2596SX-5.0/NOPBCT-ND | 926-LM2596SX-5.0NOPB | 100 | $3.41820 | $3.41820 | LM2596SX-5.0/NOPBCT-ND | 926-LM2596SX-5.0NOPB
NCP1117ST33T3G | 1 | U4 | Regulador 3.3V SOT223 | NCP1117ST33T3GOSCT-ND | 863-NCP1117ST33T3G | 100 | $0.31270 | $0.31270 | NCP1117ST33T3GOSCT-ND | 863-NCP1117ST33T3G
PRTR5V0U2X | 1 | U9 | TVS para USB | 568-4140-1-ND | 771-PRTR5V0U2X-T/R | 100 | $0.35780 | $0.35780 | 568-4140-1-ND | 771-PRTR5V0U2X-T/R
LPC4337JBD144 rev. A | 1 | U16 | Microcontrolador LPC4337 Rev. A | 568-10159-ND | 771-LPC4337JBD144E | 100 | $11.05000 | $11.05000 | 568-10159-ND | 771-LPC4337JBD144E
S25FL127SABNFI101 | 1 | U20 | Flash qSPI 128Mb WSON-8 | 1274-1046-ND | 797-25FL127SABNFI101 | 100 | $2.12000 | $2.12000 | 1274-1046-ND | 797-25FL127SABNFI101
MCP1416T | 4 | U21 U22 U23 U24 | Driver MOSFET | MCP1416T-E/OTCT-ND | 579-MCP1416T-E/OT | 400 | $0.47000 | $1.88000 | MCP1416T-E/OTCT-ND | 579-MCP1416T-E/OT
32.768K | 1 | X1 | Cristal SMD | 535-9166-1-ND | 815-ABS25-32.768KHZT | 100 | $0.43200 | $0.43200 | 535-9166-1-ND | 815-ABS25-32.768KHZT
12MHz | 2 | X2 X3 | Cristal SMD | SER3683CT-ND | 732-FA-238V12MB-W3 | 200 | $0.80000 | $1.60000 | SER3683CT-ND | 732-FA-238V12MB-W3
SMBJ20CA | 4 | ZA2 ZA3 ZA4 ZA5 | TVS SMD | P6SMB20CAT3GOSCT-ND | 576-P6SMB20CA | 400 | $0.24968 | $0.99872 | P6SMB20CAT3GOSCT-ND | 576-P6SMB20CA
P6SMB33CA | 1 | ZA1 | TVS SMD | P6SMB33CA-E3/52GICT-ND | 576-P6SMB33CA | 100 | $0.22992 | $0.22992 | P6SMB33CA-E3/52GICT-ND | 576-P6SMB33CA
SMAZ5V6 | 1 | ZA14 | Zener SMD | MMSZ5V6T1GOSCT-ND | 78-BZT52C5V6-E3-08 | 100 | $0.12470 | $0.12470 | MMSZ5V6T1GOSCT-ND | 78-BZT52C5V6-E3-08
 |  |  |  |  |  | Costo de componentes FOB: |  | $92.74128
 |  |  |  |  |  |  | Envío: | $40.00
 |  |  |  |  |  | Impuestos de importación (%): |  | 30%
 |  |  |  |  |  |  | Impuestos de importación ($): | $27.94238
 |  |  |  |  |  |  | Montaje: | tbd
 |  |  |  |  |  |  | PCB: | tbd
 |  |  |  |  |  |  | Gabinete: | tbd
 |  |  |  |  | Costo por CIAA, fabricando 100 CIAAs: |  |  | $121.08
Opción: CIAA con Borneras Desmontables
TBP_1X8 | 4 |  | Borneras enchufables 8P (bornes) | ED1723-ND | 538-39530-0008 | 400 | $3.03624 | $12.14496 | ED1723-ND | 538-39530-0008
TBP_1X4 | 2 |  | Borneras enchufables 4P (bornes) | ED2910-ND | 538-39530-0004 | 200 | $1.19700 | $2.39400 | ED2910-ND | 538-39530-0004
TBH_1X8 | 4 |  | Borneras enchufables 8P (header) | 277-1101-ND | 651-1757307 | 400 | $1.86740 | $7.46960 | 277-1101-ND | 651-1757307
TBH_1X4 | 2 |  | Borneras enchufables 4P (header) | A98067-ND | 571-282814-4 | 200 | $0.79400 | $1.58800 | A98067-ND | 571-282814-4
 |  |  |  |  | Costo de componentes FOB: |  |  | $112.54284
 |  |  |  |  |  | Diferencia usando bornes fijos: |  | $19.80156
 |  |  |  |  |  |  | Impuestos de importación ($): | $33.88285
 |  |  |  |  | Costo por CIAA, fabricando 100 CIAAs: |  |  | $146.83

Sheet: ciaa-nxp-industrial
Componente | Cantidad por PCB | Referencia | Descripción | Código Digi-Key | Código Mouser | Cantidad para 100 PCBs | Costo unitario (USD FOB DigiKey) | Costo por PCB (USD FOB DigiKey)
LAN8720AI-CP | 1 | U1 | Ethernet PHY | LAN8720AI-CP-TR-ND | 886-LAN8720AI-CP-TR | 100 |  | $0.00000 | LAN8720AI-CP-TR-ND | 886-LAN8720AI-CP-TR
ST3232E | 1 | U6 | Transceiver RS232 16-TSSOP | 497-6536-1-ND | 511-ST3232EB | 100 |  | $0.00000 | 497-6536-1-ND | 511-ST3232EB
TXB0108 | 1 | U14 | Buffer bidireccional 20-TSSOP | 296-21527-1-ND | 595-TXB0108PWR | 100 |  | $0.00000 | 296-21527-1-ND | 595-TXB0108PWR
IS42S16400F | 1 | U15 | SDRAM 64Mb 54-TSOP | IS42S16400F-7TLI | 870-42S16400F-7TLI | 100 |  | $0.00000 | IS42S16400F-7TLI | 870-42S16400F-7TLI
LM258 | 1 | U18 | Dual OpAmp | LM258DGOS-ND | 863-LM258DG | 100 |  | $0.00000 | LM258DGOS-ND | 863-LM258DG
SN65HVD1176DR | 1 | U5 | Transceiver RS485/Profibus 8-SOIC | 296-26337-1-ND | 595-SN65HVD1176DR | 100 |  | $0.00000 | 296-26337-1-ND | 595-SN65HVD1176DR
SI502 | 1 | U2 | Oscilador 50MHz SMD 30ppm | 535-10829-1-ND | 815-ASV-50.000M-NK-T | 100 |  | $0.00000 | 535-10829-1-ND | 815-ASV-50.000M-NK-T
NCV1117ST33T3G | 1 | U4 | Regulador 3.3V SOT223 | NCV1117ST33T3GOSCT-ND | 863-NCV1117ST33T3G | 100 |  | $0.00000 | NCV1117ST33T3GOSCT-ND | 863-NCV1117ST33T3G
