ciaa/Hardware/PCB/EDU-INTEL/doc/edk-bom.ods

Value | Qty | Ref | Part Link | PN | Unit Price | Price
BATTERY | 1 | BT1 | Not mounted |  |  | $0,00
100nF | 17 | C1 C2 C3 C4 C5 C6 C7 C8 C9 C10 C11 C13 C14 C15 C16 C17 C18 | VJ0603Y104JXJPW1BC (http://www.mouser.com/Search/Refine.aspx?Keyword=) | VJ0603Y104JXJPW1BC | $0,06 | $1,02
2.2uF | 1 | C12 | 06036C225KAT2A (http://www.mouser.com/Search/Refine.aspx?Keyword=) | 06036C225KAT2A | $0,10 | $0,10
10uF | 3 | C19 C20 C21 | TAJB106K016RNJ (http://www.mouser.com/Search/Refine.aspx?Keyword=) | TAJB106K016RNJ | $0,10 | $0,30
5V_IN | 1 | P5 | KLDX-0202-AP-LT (http://www.mouser.com/Search/Refine.aspx?Keyword=) | KLDX-0202-AP-LT | $0,79 | $0,79
LED | 2 | D1 D5 | VLMS1300-GS08 (http://www.mouser.com/Search/Refine.aspx?Keyword=) | VLMS1300-GS08 | $0,08 | $0,16
PMEG3020EJ | 3 | D2 D3 D4 | PMEG3020EJ (http://www.mouser.com/Search/Refine.aspx?Keyword=) | PMEG3020EJ | $0,42 | $1,26
BLM18KG221SN1D | 2 | FB1 FB3 | BLM18KG221SN1D (http://www.mouser.com/Search/Refine.aspx?Keyword=) | BLM18KG221SN1D | $0,11 | $0,22
MMZ1608B601C | 2 | FB2 FB4 | MMZ1608B601C (http://www.mouser.com/Search/Refine.aspx?Keyword=) | MMZ1608B601C | $0,10 | $0,20
GS3 | 3 | GS1 GS2 GS3 | Not mounted |  |  | $0,00
SD-CON | 1 | J3 | 47219-2001 (http://www.mouser.com/Search/Refine.aspx?Keyword=) | 47219-2001 | $1,11 | $1,11
ZX62-AB-5PA | 2 | J1 J2 | ZX62-AB-5PA(11) (http://www.mouser.com/Search/Refine.aspx?Keyword=) | ZX62-AB-5PA(11) | $0,92 | $1,84
CARD_DET | 1 | JP1 | Not mounted |  |  | $0,00
I/O | 2 | P1 P2 | Not mounted |  |  | $0,00
BSS138DP | 2 | Q2 Q3 | BSS138DW-7-F (http://www.mouser.com/Search/Refine.aspx?Keyword=) | BSS138DW-7-F | $0,50 | $1,00
BSS138 | 1 | Q1 | BSS138 (http://www.mouser.com/Search/Refine.aspx?Keyword=) | BSS138 | $0,22 | $0,22
220 | 2 | R2 R5 | MCT06030C2200FP500 (http://www.mouser.com/Search/Refine.aspx?Keyword=) | MCT06030C2200FP500 | $0,06 | $0,12
1k | 1 | R19 | CRCW06031K00FKEA (http://www.mouser.com/Search/Refine.aspx?Keyword=) | CRCW06031K00FKEA | $0,08 | $0,08
4.7k | 8 | R6 R7 R8 R9 R10 R11 R12 R13 | MCT06030C4701FP500 (http://www.mouser.com/Search/Refine.aspx?Keyword=) | MCT06030C4701FP500 | $0,03 | $0,24
10k | 6 | R1 R3 R4 R14 R17 R18 | CRCW060310K0FKEA (http://www.mouser.com/Search/Refine.aspx?Keyword=) | CRCW060310K0FKEA | $0,08 | $0,48
100k | 1 | R15 | CRCW0603100KFKEA (http://www.mouser.com/Search/Refine.aspx?Keyword=) | CRCW0603100KFKEA | $0,08 | $0,08
576 1% | 1 | R16 | CRCW0603576RFKEA (http://www.mouser.com/Search/Refine.aspx?Keyword=) | CRCW0603576RFKEA | $0,08 | $0,08
POWER_BTN | 1 | SW1 | Not mounted |  |  | $0,00
RCVR_MODE | 1 | SW2 | Not mounted |  |  | $0,00
FWR_RCVR | 1 | SW3 | Not mounted |  |  | $0,00
SRF2012 | 2 | TR1 TR2 | SRF2012-900YA (http://www.mouser.com/Search/Refine.aspx?Keyword=) | SRF2012-900YA | $0,26 | $0,52
TXS0206-29 | 1 | U10 | TXS0206-29YFPRB (http://www.mouser.com/Search/Refine.aspx?Keyword=) | TXS0206-29YFPRB | $1,87 | $1,87
MIC2039EYMT | 1 | U6 | MIC2039EYMT T5 (http://www.mouser.com/Search/Refine.aspx?Keyword=) | MIC2039EYMT T5 | $1,75 | $1,75
INTEL_EDISON | 1 | U2 | EDI1.SPON.AL.S (http://www.mouser.com/Search/Refine.aspx?Keyword=) | EDI1.SPON.AL.S | $59,19 | $59,19
EDISON_CONN | 1 |  | DF40C(2.0)-70DS-0.4V(51) (http://www.mouser.com/Search/Refine.aspx?Keyword=) | DF40C(2.0)-70DS-0.4V(51) | $1,33 | $1,33
EDISON_SCREW | 2 |  | Not mounted |  |  | $0,00
PRTR5V0U2X | 2 | U7 U9 | PRTR5V0U2X (http://www.mouser.com/Search/Refine.aspx?Keyword=) | PRTR5V0U2X | $0,50 | $1,00
FT232RQ | 1 | U8 | FT232RQ-REEL (http://www.mouser.com/Search/Refine.aspx?Keyword=) | FT232RQ-REEL | $4,50 | $4,50
NCP1117ST33T3G | 1 | U11 | NCP1117ST33T3G (http://www.mouser.com/Search/Refine.aspx?Keyword=) | NCP1117ST33T3G | $0,48 | $0,48
NCP1117ST18T3G | 1 | U12 | NCP1117ST18T3G (http://www.mouser.com/Search/Refine.aspx?Keyword=) | NCP1117ST18T3G | $0,48 | $0,48
TXB0108 | 4 | U1 U3 U4 U5 | TXB0108PWR (http://www.mouser.com/Search/Refine.aspx?Keyword=) | TXB0108PWR | $2,30 | $9,20
BZT52C5V6 | 1 | ZA1 | BZT52C5V6-E3-08 (http://www.mouser.com/Search/Refine.aspx?Keyword=) | BZT52C5V6-E3-08 | $0,09 | $0,09
 |  |  |  |  | Total | $89,71
