ciaa/Hardware/PCB/EDU-FPGA/Schematic/BOM/BOM.ods

BOM – EDU-FPGA v1.2 – 19/04/2020
Component | Part | Description | References | Value | Quantity Per PCB | DatasheetName | DatasheetLink | Manufacturer | OrderCode | ProviderLink | ProviderOrderCode | ComponentTechnology
1 | C | Decoupling cap | C2 C5 C13 C15 C17 C18 C19 C20 C21 C22 C23 C24 C30 C35 C37 C42 C47 C49 C54 C56 C57 C58 C59 | 100nF | 23 | SURFACE-MOUNT CERAMIC MULTILAYER CAPACITORS | https://ar.mouser.com/datasheet/2/447/UPY-GPHC_X7R_6.3V-to-50V_18-1154002.pdf | YAGEO | CC0805KRX7R5BB104 | https://ar.mouser.com/ProductDetail/Yageo/CC0805KRX7R5BB104?qs=UgE%2F0m3bTsYCB3fBtxx4RA%3D%3D | 603-CC0805KRX75BB104 | Ceramic - X7R TC material
2 | C | Decoupling cap | C1 C25 C27 C31 C32 C33 C38 C39 C40 C43 C44 C45 C50 C51 C52 | 10nF | 15 | SURFACE-MOUNT CERAMIC MULTILAYER CAPACITORS | https://ar.mouser.com/datasheet/2/447/UPY-GPHC_X7R_6.3V-to-50V_18-1154002.pdf | YAGEO | CC0805KRX7R7BB103 | https://ar.mouser.com/ProductDetail/Yageo/CC0805KRX7R7BB103 | 603-CC0805KRX77BB103 | Ceramic - X7R TC material
3 | C | Debouncing and decoupling caps | C8 C9 C10 C11 C34 C46 | 10uF | 6 | SURFACE MOUNT MULTILAYER CERAMIC CAPACITORS | https://ar.mouser.com/datasheet/2/447/UPY-GPHC_X5R_4V-to-50V_25-1131599.pdf | YAGEO | CC0805KFX5R5BB106 | https://ar.mouser.com/ProductDetail/Yageo/CC0805KFX5R5BB106 | 603-CC805KFX5R5BB106 | ceramic - X5R series chip capacitors
4 | CP1_Small | Decoupling capacitor | C3 C4 C6 C7 | 10uF | 4 | TPS SeriesLow ESR | https://ar.mouser.com/datasheet/2/40/tps-776850.pdf | AVX | TPSR106K006R1000 | https://ar.mouser.com/ProductDetail/AVX/TPSR106K006R1000?qs=sGAEpiMZZMuEN2agSAc2pkIWJcW2hAcik2daETREIlI%3D | 581-TPSR106K006R1000 | Tantalum
5 | C | Decoupling cap | C26 C28 C29 C36 C41 C48 C53 C55 | 1uF | 8 | SURFACE MOUNT MULTILAYER CERAMIC CAPACITORS | https://ar.mouser.com/datasheet/2/447/UPY-GPHC_X5R_4V-to-50V_25-1131599.pdf | YAGEO | CC0805KKX5R5BB105 | https://ar.mouser.com/ProductDetail/Yageo/CC0805KKX5R5BB105?qs=sGAEpiMZZMs0AnBnWHyRQItaX7oCOlrYATfCxbY6oYM%3D | 603-CC0805KR5BB105 | ceramic - X5R series chip capacitors
6 | C | Multilayer Ceramic Capacitors MLCC - SMD/SMT 3.3uF Y5V -20/+80% 10V – for FTDI 1.8V output | C16 | 3.3uF | 1 | SURFACE-MOUNT CERAMIC MULTILAYER CAPACITORS | https://ar.mouser.com/datasheet/2/447/UPY-GPHC_Y5V_6.3V-to-50V_8-1280790.pdf | YAGEO | CC0805ZKY5V6BB335 | https://ar.mouser.com/ProductDetail/Yageo/CC0805ZKY5V6BB335 | 603-CC805ZKY5V6BB335 | Y5Vseries chip capacitors with lead-free terminations
7 | CP1_Small | Decoupling capacitor for FTDI VPHY and VPLL | C12 C14 | 4.7uF | 2 | TPS SeriesLow ESR | https://ar.mouser.com/datasheet/2/40/tps-776850.pdf | AVX | TPSR475K010R3000 | https://ar.mouser.com/ProductDetail/AVX/TPSR475K010R3000?qs=sGAEpiMZZMuEN2agSAc2pkIWJcW2hAciSH1NL3QtlaI%3D | 581-TPSR475K010R3000 | Tantalum
8 | D_Schottky | Schottky Diodes & Rectifiers 40volts 0.5A SIZE 0805 | D7 | D_Schottky | 1 | Schottky Barrier Rectifier Diode | https://ar.mouser.com/datasheet/2/40/schottky-776407.pdf | AVX | SD0805S040S0R5 | https://ar.mouser.com/ProductDetail/AVX/SD0805S040S0R5 | 581-SD0805S040S0R5 | -
9 | D_Zener | Zener Diodes 5.6V 1W – Protection | D1 | D_Zener | 1 | SMAZ5V1 -SMAZ39 - 1.0W SURFACE MOUNT ZENER DIODE | https://ar.mouser.com/datasheet/2/115/ds18015-38228.pdf | Diodes Incorporated | SMAZ5V6-13-F | https://ar.mouser.com/ProductDetail/Diodes-Incorporated/SMAZ5V6-13-F | 621-SMAZ5V6-F | -
10 | LED_ALT | Standard LEDs - SMD Blue 470nm 36mcd InGaN 68mW 2.9V | D2 | LED_ALT | 1 | SML-M13x/MN2x Series | https://ar.mouser.com/datasheet/2/348/sml-m13x_mn2x-e-1139175.pdf | ROHM Semiconductor | SMLMN2BCTT86C | https://ar.mouser.com/ProductDetail/ROHM-Semiconductor/SMLMN2BCTT86C | 755-SMLMN2BCTT86C | InGaN
11 | LED_ALT | Standard LEDs - SMD 2.0X1.2MM LOW CRNT | D3 | LED_ALT | 1 | APT2012LVBC/D | https://ar.mouser.com/datasheet/2/216/APT2012LVBC-D-535767.pdf | Kingbright | APT2012LVBC/D | https://ar.mouser.com/ProductDetail/Kingbright/APT2012LVBC-D | 604-APT2012LVBCD | InGaN
12 | LED_ALT | YELLOW 1.9V - 2mA smd 0805 LED | D4 | LED_ALT | 1 | SURFACE MOUNT LED YELLOW, 0805 PACKAGE, 2mA | https://ar.mouser.com/datasheet/2/50/SM0805YCL-881017.pdf | Bivar | SM0805YCL | https://ar.mouser.com/ProductDetail/Bivar/SM0805YCL?qs=sGAEpiMZZMuCm2JlHBGefs8jWBpsrBhrCjZpwmPMDI8%3D | 749-SM0805YCL | AlGaInP
13 | LED_ALT | RED 1.9V - 2mA smd 0805 LED | D5 | LED_ALT | 1 | SURFACE MOUNT LED HE RED, 0805 PACKAGE, 2mA | https://ar.mouser.com/datasheet/2/50/SM0805HCL-880819.pdf | Bivar | SM0805HCL | https://ar.mouser.com/ProductDetail/Bivar/SM0805HCL?qs=jaLxTFIJCiunRhy8mE7Amw%3D%3D | 749-SM0805HCL | AlGaInP
14 | LED_ALT | GREEN 1.9V - 2mA smd 0805 LED | D6 D8 | LED_ALT | 2 | SURFACE MOUNT LED GREEN, 0805 PACKAGE, 2mA | https://ar.mouser.com/datasheet/2/50/SM0805GCL-880857.pdf | Bivar | SM0805GCL | https://ar.mouser.com/ProductDetail/Bivar/SM0805GCL | 749-SM0805GCL | AlGaInP
15 | Ferrite_Bead | Núcleos de ferrita WE-CBF 0805 SMD Bead 100MHz 1500Ohm 1KmA | FB1 FB2 FB3 FB4 FB5 | Ferrite_Bead | 5 | WE-CBF SMD EMI Suppression Ferrite Bead | https://ar.mouser.com/datasheet/2/445/742792097-538337.pdf | Wurth Electronics | 742792097 | https://ar.mouser.com/ProductDetail/Wurth-Electronics/742792097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 | 710-742792097 | FerriteBead
16 | 2x6_pmod | Headers & Wire Housings 06+06 DIL VERTICAL SOCKET TIN | J5 J6 | 2x6_pmod | 2 | 2.54mm PITCH DIL VERTICAL PC TAIL SOCKET ASSEMBLY | https://www.mouser.com/datasheet/2/181/M20-783-1133465.pdf | Harwin | M20-7830646 | https://www.mouser.com/ProductDetail/Harwin/M20-7830646 | 855-M20-7830646 | -
17 | Conn_01x08 | 8 Position Header Connector 0.100" (2.54mm) Through Hole Tin | J4 | Conn_01x08 | 1 | 2.54mm PITCH SIL VERTICAL PC TAIL SOCKET ASSEMBLY | https://ar.mouser.com/datasheet/2/181/M20-782-1220556.pdf | Harwin | M20-7820842 | https://ar.mouser.com/ProductDetail/Harwin/M20-7820842 | 855-M20-7820842 | -
18 | Conn_02x08_Odd_Even | 16 Position Header Connector 0.100" (2.54mm) Through Hole Tin | J3 | Conn_02x08_Odd_Even | 1 | 2.54mm PITCH DIL VERTICAL PC TAIL SOCKET ASSEMBLY | https://ar.mouser.com/datasheet/2/181/M20-783-1133465.pdf | Harwin | M20-7830846 | https://ar.mouser.com/ProductDetail/Harwin/M20-7830846 | 855-M20-7830846 | -
19 | Conn_02x10_Odd_Even | 20 Position Header Connector 0.100" (2.54mm) Through Hole Gold | J2 | Conn_02x10_Odd_Even | 1 | 2.54mm PITCH DIL VERTICAL PC TAIL SOCKET ASSEMBLY | https://ar.mouser.com/datasheet/2/181/M20-783-1133465.pdf | Harwin | M20-7831046 | https://ar.mouser.com/ProductDetail/Harwin/M20-7831046?qs=sGAEpiMZZMu6TJb8E8Cjr5%2F8vbP7TedM | 855-M20-7831046 | -
20 | micro_usb_b | USB Connectors MICRO AB RECEPT RA TH BTTM MNT | J1 | micro_usb_b | 1 | ZX62D-AB-5P8(30) Datasheet | https://ar.mouser.com/datasheet/2/185/X_CL0242-0027-5-30_2d-1620404.pdf | Hirose Connector | ZX62D-AB-5P8(30) | https://ar.mouser.com/ProductDetail/Hirose-Connector/ZX62D-AB-5P830 | 798-ZX62D-AB-5P830 | -
21 | R_Small | 0 ohm resistor | R1 R36 | 0 | 2 | THICK FILM CHIP RESISTORS AUTOMOTIVE GRADE | https://ar.mouser.com/datasheet/2/447/PYu-AC_51_RoHS_L_6-1152827.pdf | YAGEO | AC0805JR-070RL | https://ar.mouser.com/ProductDetail/Yageo/AC0805JR-070RL | 603-AC0805JR-070RL | Thick film chip resistor
22 | R | Thick Film Resistors - SMD 100 OHM 1% | R34 R35 | 100 | 2 | GENERAL PURPOSE CHIP RESISTORS | https://ar.mouser.com/datasheet/2/447/PYu-RC_Group_51_RoHS_L_10-1527934.pdf | YAGEO | RC0805FR-13100RL | https://ar.mouser.com/ProductDetail/Yageo/RC0805FR-13100RL | 603-RC0805FR-13100RL | -
23 | R | Thin Film Resistors - SMD 1/8W 10K ohm 1% 50ppm | R9 R11 R13 R15 R18 R19 R20 R22 R23 R29 R32 R33 | 10k | 12 | THIN FILMCHIP RESISTORS High precision-high stability | https://ar.mouser.com/datasheet/2/447/PYu-RT_1-to-0.01_RoHS_L_9-1222720.pdf | YAGEO | RT0805FRE0710KL | https://ar.mouser.com/ProductDetail/Yageo/RT0805FRE0710KL?qs=sGAEpiMZZMu61qfTUdNhGxEjuuBLd0B41oWml1pU2QE%3D | 603-RT0805FRE0710KL | THIN FILMCHIP RESISTORS
24 | R | 1.2V Regulator output resistor – Tolerance 1% | R3 | 120 | 1 | THICK FILM CHIP RESISTORS AUTOMOTIVE GRADE | https://ar.mouser.com/datasheet/2/447/PYu-AC_51_RoHS_L_6-1152827.pdf | YAGEO | AC0805FR-07120RL | https://ar.mouser.com/ProductDetail/Yageo/AC0805FR-07120RL?qs=sGAEpiMZZMu61qfTUdNhG19HzxXL1i6iscRfwJYXkks%3D | 603-AC0805FR-07120RL | Thick film chip resistor
25 | R | Thin Film Resistors - SMD 1/8W 12K ohm .5% 50ppm | R16 | 12k | 1 | THIN FILMCHIP RESISTORS High precision-high stability | https://ar.mouser.com/datasheet/2/447/PYu-RT_1-to-0.01_RoHS_L_9-1222720.pdf | YAGEO | RT0805DRE0712KL | https://ar.mouser.com/ProductDetail/Yageo/RT0805DRE0712KL?qs=sGAEpiMZZMu61qfTUdNhGxEjuuBLd0B4O1bYpE0Lxxo%3D | 603-RT0805DRE0712KL | THIN FILMCHIP RESISTORS
26 | R | Resistor 1k – 0805 | R2 R17 R24 | 1k | 3 | THICK FILM CHIP RESISTORS AUTOMOTIVE GRADE | https://ar.mouser.com/datasheet/2/447/PYu-AC_51_RoHS_L_6-1152827.pdf | YAGEO | AC0805JR-071KL | https://ar.mouser.com/ProductDetail/Yageo/AC0805JR-071KL?qs=sGAEpiMZZMu61qfTUdNhG2gsBIEdmNIDDxLhejvEQGw%3D | 603-AC0805JR-071KL | Thick film chip resistor
27 | R | Thin Film Resistors - SMD 1/8W 220 ohm 1% 50ppm | R4 R5 R6 R7 R8 R10 R12 R14 R25 R26 R27 R28 R30 R31 | 220 | 14 | THIN FILMCHIP RESISTORS High precision-high stability | https://ar.mouser.com/datasheet/2/447/PYu-RT_1-to-0.01_RoHS_L_9-1222720.pdf | YAGEO | RT0805FRE07220RL | https://ar.mouser.com/ProductDetail/Yageo/RT0805FRE07220RL?qs=sGAEpiMZZMu61qfTUdNhGzNxiTetzVBnVuRR09dJyS0%3D | 603-RT0805FRE07220RL | THIN FILM CHIP RESISTORS
28 | R | Thin Film Resistors - SMD 1/8W 2.2K ohm 1% 50ppm | R21 | 2k2 | 1 | THIN FILMCHIP RESISTORS High precision-high stability | https://ar.mouser.com/datasheet/2/447/PYu-RT_1-to-0.01_RoHS_L_9-1222720.pdf | YAGEO | RT0805FRE072K2L | https://ar.mouser.com/ProductDetail/Yageo/RT0805FRE072K2L | 603-RT0805FRE072K2L | THIN FILMCHIP RESISTORS
30 | SW_Push | Tactile Switches FLAT ACT 2.6NF 6x6x4.3mm | S1 S2 S3 S4 | SW_Push | 4 | 6mm Square Middle Travel SMD - Light Touch Switch | https://ar.mouser.com/datasheet/2/315/ATK0000C432-1596775.pdf | Panasonic Electronic Components | EVP-BFAC1A000 | https://ar.mouser.com/ProductDetail/Panasonic/EVP-BFAC1A000 | 667-EVP-BFAC1A000 | -
31 | W25X40CL | NOR Flash spiFlash, 4M-bit, 4Kb Uniform Sector | U6 | W25X40CL | 1 | 2.5/3/3.3 V 4M-Bit Serial Flash Memory With 4kb sectors and dual i/o spi | https://ar.mouser.com/datasheet/2/949/w25x40cl_f_20140325-1489812.pdf | Winbond | W25X40CLSNIG | https://ar.mouser.com/ProductDetail/Winbond/W25X40CLSNIG | 454-W25X40CLSNIG | -
32 | Interface_USB_FT2232H | USB Interface IC USB HS to Dual UART/ FIFO/SPI/JTAG/I2C | U4 | Interface_USB_FT2232H | 1 | Future Technology Devices International Ltd FT2232H Dual High Speed USB to Multipurpose UART/FIFO IC | https://ar.mouser.com/datasheet/2/163/DS_FT2232H-17353.pdf | FTDI | FT2232HL-REEL | https://ar.mouser.com/ProductDetail/FTDI/FT2232HL-REEL?qs=sGAEpiMZZMs5ceO8zL%252BTx6ksD1BB0CN5 | 895-FT2232HL | -
33 | LD1117S12 | 5V in to 3.3V, 1.2V output | U2 | LD1117S12CTR_SOT223 | 1 | LD1117 - Adjustable and fixed low drop positive voltage regulator | http://www.st.com/st-web-ui/static/active/en/resource/technical/document/datasheet/CD00000544.pdf | STMicroelectronics | LD1117S12CTR | https://ar.mouser.com/ProductDetail/STMicroelectronics/LD1117S12CTR | 511-LD1117S12CTR | -
34 | LD1117S33 | 5V in to 3.3V output | U1 | LD1117S33CTR_SOT223 | 1 | LD1117 - Adjustable and fixed low drop positive voltage regulator | http://www.st.com/st-web-ui/static/active/en/resource/technical/document/datasheet/CD00000544.pdf | STMicroelectronics | LD1117S33CTR | https://ar.mouser.com/ProductDetail/STMicroelectronics/LD1117S33CTR?qs=sGAEpiMZZMv1cg40gLeF3niL8zTTD8ml | 511-LD1117S33C | -
35 | M93C66 | EEPROM 2.5 V to 5.5 V 4K | U5 | M93C66 | 1 | 16-Kbit, 8-Kbit, 4-Kbit, 2-Kbit and 1-Kbit (8-bit or 16-bit wide) MICROWIRE™ serial access EEPROM | https://ar.mouser.com/datasheet/2/389/m93c46-w-955034.pdf | STMicroelectronics | M93C66-WMN6TP | https://ar.mouser.com/ProductDetail/STMicroelectronics/M93C66-WMN6TP | 511-M93C66-WMN6TP | -
36 | iCE40-HX4K-TQ144 | FPGA - Field Programmable Gate Array iCE40HX 3520 LUTs 1.2V Ultra Low-Power | U3 | iCE40-HX4K-TQ144 | 1 | iCE40 LP/HX Family | https://ar.mouser.com/datasheet/2/225/FPGA-DS-02029-3-5-iCE40-LP-HX-Family-Data-Sheet-1022803.pdf | Lattice | iCE40HX4K-TQ144 | https://ar.mouser.com/ProductDetail/Lattice/iCE40HX4K-TQ144 | 842-ICE40HX4K-TQ144 | -
37 | ECS-3225MV-120-CN-TR | Standard Clock Oscillators 12MHz 1.6-3.6V 25ppm -40C +85C | X1 | ECS-3225MV-120-CN-TR | 1 | ECS-3225MV-120-CN-TR Datasheet | https://ar.mouser.com/datasheet/2/122/ECS-3225MV-1479682.pdf | ECS | ECS-3225MV-120-CN-TR | https://ar.mouser.com/ProductDetail/ECS/ECS-3225MV-120-CN-TR | 520-3225MV-120-CNT | -
Component Groups: |  | 33
Component Count: |  | 125
Fitted Components: |  | 125
Number of PCBs: |  | 1
Total components: |  | 125
