ciaa/Hardware/PCB/ACC/CIAA_ACC/output_files/BOM_ciaa_acc_v1.3.xlsx

Source: | /home/noelia/git/CIAA_gitlab/CIAA-ACC/pcb/ciaa_acc.sch
Date: | Fri 29 Mar 2019 08:47:07 AM -03
Tool: | Eeschema 5.0.2+dfsg1-1~bpo9+1
Generator: | bom_csv_grouped_by_value.py
Component Count: | 561
Item | Qty | Reference(s) | Value | Footprint | Desc | Digikey# | Manf | Manf# | Mouser# | Reemplazo
1 | 1 | BT1 | CR1220 | conn:BC501SM | HOLDER COIN CELL FOR CR1220 SMD | BC501SM-ND | MPD | BC501SM
2 | 23 | C1, C28, C55, C56, C65, C66, C80, C81, C82, C83, C86, C161, C163, C167, C180, C199, C203, C208, C216, C218, C221, C231, C276 | 100uF | chip_rlc:c_1206 | 100µF ±20% 6.3V X6T Ceramic Capacitor -55°C ~ 105°C Surface Mount, MLCC 1206 (3216 Metric) 0.126" L x 0.063" W (3.20mm x 1.60mm) | 490-10525-1-ND | Murata | GRM31CD80J107ME39L
3 | 97 | C2, C5, C10, C13, C16, C19, C22, C25, C29, C32, C37, C40, C43, C46, C49, C52, C59, C60, C69, C89, C93, C94, C95, C105, C106, C107, C108, C109, C110, C111, C114, C115, C116, C117, C118, C128, C130, C132, C133, C134, C135, C136, C137, C146, C147, C148, C149, C151, C152, C153, C154, C157, C158, C220, C222, C224, C226, C227, C228, C229, C230, C232, C233, C234, C245, C246, C247, C248, C249, C250, C251, C252, C253, C254, C255, C257, C258, C260, C262, C263, C264, C265, C266, C267, C268, C277, C278, C279, C280, C281, C282, C283, C284, C285, C286, C287, C288 | 100nF | chip_rlc:c_0201 | CAP CER 0.1UF 10V X5R 0201 | 490-5405-1-ND | Murata | GRM033R61A104ME15D
4 | 47 | C3, C6, C8, C9, C11, C12, C14, C15, C17, C18, C20, C21, C23, C24, C26, C27, C30, C33, C35, C36, C38, C39, C41, C42, C44, C45, C47, C48, C50, C51, C53, C54, C61, C62, C63, C64, C150, C223, C225, C242, C243, C259, C269, C270, C273, C274, C275 | 10nF | chip_rlc:c_0201 | 10000pF ±10% 16V X5R Ceramic Capacitor -55°C ~ 85°C Surface Mount, MLCC 0201 (0603 Metric) 0.024" L x 0.012" W (0.60mm x 0.30mm) | 490-7223-1-ND | Murata | GRM033R61C103KA12D
5 | 45 | C4, C7, C31, C34, C57, C58, C68, C70, C77, C90, C96, C119, C120, C121, C122, C123, C124, C125, C126, C127, C155, C156, C160, C165, C169, C171, C173, C175, C178, C182, C184, C186, C188, C190, C194, C197, C204, C205, C206, C207, C209, C210, C211, C212, C214 | 10uF | chip_rlc:c_0402 | 10µF 6.3V Ceramic Capacitor X6S 0402 (1005 Metric) 0.039" L x 0.020" W (1.00mm x 0.50mm) | 490-13233-1-ND | Murata | GRM155C80J106ME11D
6 | 1 | C67 | 470nF | chip_rlc:c_0402 | 0.47µF ±10% 35V X5R Ceramic Capacitor -55°C ~ 85°C Surface Mount, MLCC 0402 (1005 Metric) 0.039" L x 0.020" W (1.00mm x 0.50mm) | 490-10462-1-ND | Murata | GRM155R6YA474KE01D
7 | 1 | C71 | 220nF | chip_rlc:c_0402 | 0.22µF ±10% 35V X6S Ceramic Capacitor -55°C ~ 105°C Surface Mount, MLCC 0402 (1005 Metric) 0.039" L x 0.020" W (1.00mm x 0.50mm) | 490-10445-1-ND | Murata | GRM155C8YA224KE01D
8 | 2 | C72, C87 | 2.2nF | chip_rlc:c_0402 | 2200pF ±10% 16V X7R Ceramic Capacitor -55°C ~ 125°C Surface Mount, MLCC 0402 (1005 Metric) 0.039" L x 0.020" W (1.00mm x 0.50mm) | 490-6330-1-ND | Murata | GRM155R71C222KA01D
9 | 1 | C73 | 47nF | chip_rlc:c_0402 | 0.047µF ±10% 25V X7R Ceramic Capacitor -55°C ~ 125°C Surface Mount, MLCC 0402 (1005 Metric) 0.039" L x 0.020" W (1.00mm x 0.50mm) | 490-6347-1-ND | Murata | GRM155R71E473KA88J
10 | 1 | C74 | 22nF | chip_rlc:c_0402 | 0.022µF ±10% 50V X7R Ceramic Capacitor -55°C ~ 125°C Surface Mount, MLCC 0402 (1005 Metric) 0.039" L x 0.020" W (1.00mm x 0.50mm) | 490-3884-1-ND | Murata | GRM155R71H223KA12D
11 | 1 | C75 | 1nF | chip_rlc:c_0402 | CAP CER 1000PF 50V NP0 0402 | 399-10034-1-ND | Murata | C0402C102J5GACTU
12 | 7 | C76, C78, C79, C162, C166, C170, C174 | 330uF | tantalum:tant_B_3528 | CAP TANT 330UF 2.5V 20% SMD | 399-11709-1-ND | Kemet | T520B337M2R5ATE009
13 | 4 | C84, C85, C97, C98 | 68nF | chip_rlc:c_0402 | 0.068µF ±10% 50V X7R Ceramic Capacitor -55°C ~ 125°C Surface Mount, MLCC 0402 (1005 Metric) 0.039" L x 0.020" W (1.00mm x 0.50mm) | 490-12709-1-ND | Murata | GRM155R71H683KE14D
14 | 2 | C88, C101 | 1.2nF | chip_rlc:c_0402 | 1200pF ±10% 50V X7R Ceramic Capacitor -55°C ~ 125°C Surface Mount, MLCC 0402 (1005 Metric) 0.039" L x 0.020" W (1.00mm x 0.50mm) | 490-1304-1-ND | Murata | GRM155R71H122KA01D
15 | 1 | C91 | 24pF | chip_rlc:c_0402 | 24pF ±5% 50V C0G, NP0 Ceramic Capacitor -55°C ~ 125°C Surface Mount, MLCC 0402 (1005 Metric) 0.039" L x 0.020" W (1.00mm x 0.50mm) | 490-5931-1-ND | Murata | GRM1555C1H240JA01D
16 | 1 | C92 | 11pF | chip_rlc:c_0402 | 11pF ±5% 50V C0G, NP0 Ceramic Capacitor -55°C ~ 125°C Surface Mount, MLCC 0402 (1005 Metric) 0.039" L x 0.020" W (1.00mm x 0.50mm) | 490-5923-1-ND | Murata | GRM1555C1H110JA01D
17 | 2 | C99, C244 | 4.7uF | chip_rlc:c_0603 | CAP CER 4.7UF 10V X5R 0603 | 490-10477-1-ND | Murata | GRM188R61A475KE15D
18 | 5 | C100, C138, C139, C140, C141 | 1.5nF | chip_rlc:c_0402 | 1500pF ±10% 50V X7R Ceramic Capacitor -55°C ~ 125°C Surface Mount, MLCC 0402 (1005 Metric) 0.039" L x 0.020" W (1.00mm x 0.50mm) | 490-3245-1-ND | Murata | GRM155R71H152KA01D
19 | 1 | C102 | 3.3uF | chip_rlc:c_0603 | 3.3µF ±10% 10V X5R Ceramic Capacitor -55°C ~ 85°C Surface Mount, MLCC 0603 (1608 Metric) 0.063" L x 0.031" W (1.60mm x 0.80mm) | 490-6411-1-ND | Murata | GRM188R61A335KE15D
20 | 1 | C103 | 16pF | chip_rlc:c_0402 | 16pF ±5% 50V C0G, NP0 Ceramic Capacitor -55°C ~ 125°C Surface Mount, MLCC 0402 (1005 Metric) 0.039" L x 0.020" W (1.00mm x 0.50mm) | 490-5926-1-ND | Murata | GRM1555C1H160JA01D
21 | 1 | C104 | 13pF | chip_rlc:c_0402 | 13pF ±5% 50V C0G, NP0 Ceramic Capacitor -55°C ~ 125°C Surface Mount, MLCC 0402 (1005 Metric) 0.039" L x 0.020" W (1.00mm x 0.50mm) | 490-5925-1-ND | Murata | GRM1555C1H130JA01D
22 | 2 | C112, C113 | 18pF | chip_rlc:c_0201 | CAP CER 18PF 50V NP0 0201 | 490-6117-2-ND | Murata | GRM0335C1H180JA01D
23 | 8 | C129, C131, C159, C238, C239, C240, C256, C261 | 100nF | chip_rlc:c_0402 | CAP CER 0.1UF 10V X5R 0402 | 311-1336-1-ND | Yageo | CC0402KRX5R6BB104
24 | 27 | C164, C168, C172, C176, C177, C179, C181, C183, C185, C187, C189, C191, C192, C193, C195, C196, C198, C200, C201, C202, C213, C215, C217, C219, C235, C236, C241 | 1uF | chip_rlc:c_0201 | 1µF 10V Ceramic Capacitor X5R 0201 (0603 Metric) 0.024" L x 0.012" W (0.60mm x 0.30mm) | 1276-6816-1-ND | Samsung | CL03A105MP3ZSNH
25 | 1 | C237 | 2.2uF | chip_rlc:c_0402 | CAP CER 2.2UF 6.3V X5R 0402 | 490-12532-2-ND | Murata | GRM155R60J225KE95D
26 | 3 | D1, D4, D5 | PESD3V3U1UA | to-sod-sot:SOD-323 | TVS DIODE 3.3VWM SOD323 | 568-4667-1-ND | NXP | PESD3V3U1UA,115
27 | 5 | D2, D3, D6, D7, D9 | 1N4148 | to-sod-sot:SOD-323 | DIODE GEN PURP 75V 150MA SOD323 | 1N4148WXTPMSCT-ND | Micro Commercial | 1N4148WX-TP
28 | 1 | D8 | SD05T1G | to-sod-sot:SOD-323 | TVS DIODE 5VWM 9.8VC SOD323 | SD05T1GOSCT-ND | ON Semiconductor | SD05T1G
29 | 2 | DS2, DS13 | ERR | misc:LED-0603 | LED RED CLEAR 0603 SMD | 1080-1400-1-ND | Everlight | QTLP600C7TR
30 | 2 | DS3, DS12 | OK | misc:LED-0603 | LED GREEN CLEAR 0603 SMD | 1080-1399-1-ND | Everlight | QTLP600C4TR
31 | 1 | DS4 | DONE | misc:LED-0603 | LED BLUE CLEAR 0603 SMD | 1080-1401-1-ND | Everlight | QTLP600CBTR
32 | 1 | DS5 | CONNECTED | misc:LED-0603 | LED GREEN CLEAR 0603 SMD | 1080-1399-1-ND | Everlight | QTLP600C4TR
33 | 1 | DS6 | RUNNING | misc:LED-0603 | LED BLUE CLEAR 0603 SMD | 1080-1401-1-ND | Everlight | QTLP600CBTR
34 | 8 | DS7, DS8, DS9, DS10, DS14, DS15, DS16, DS17 | LED | misc:LED-0603 | LED RED CLEAR 0603 SMD | 1080-1400-1-ND | Everlight | QTLP600C7TR
35 | 1 | DS11 | OVERCURRENT | misc:LED-0603 | LED RED CLEAR 0603 SMD | 1080-1400-1-ND | Everlight | QTLP600C7TR
36 | 4 | F1, F2, F3, F4 | FIDUCIAL | misc:Fiducial_1mm | FIDUCIAL
37 | 3 | FB3, FB7, FB8 | BLM15PX221SN1D | chip_rlc:l_0402 | 220 Ohm Impedance Ferrite Bead 0402 (1005 Metric) Surface Mount Power Line 1.4A 1 Lines 100 mOhm Max DCR -55°C ~ 125°C | 490-11021-1-ND | Murata | BLM15PX221SN1D
38 | 4 | FB4, FB5, FB6, FB9 | MMZ1608B601CTAH0 | chip_rlc:l_0603 | FERRITE BEAD 600 OHM 0603 1LN | 445-2166-1-ND | TDK | MMZ1608B601CTAH0
39 | 3 | FB10, FB11, FB12 | MPZ1608S601ATA00 | chip_rlc:l_0603 | FERRITE BEAD 600 OHM 0603 1LN | 445-2205-1-ND | TDK | MPZ1608S601ATA00
44 | 1 | J1 | 5V 10A | conn:PJ-082BH | Power Barrel Connector Jack 2.50mm ID (0.098"), 5.50mm OD (0.217") Through Hole, Right Angle | CP-082BHCT-ND | CUI | PJ-082BH
45 | 1 | J2 | OneBank Top | samtec:ASP-129637-13 | PCIe104 OneBank Top |  | Samtec | ASP-129637-13
46 | 1 | J3 | OneBank Bottom | samtec:ASP-129646-22 | PCIe104 OneBank Bottom |  | Samtec | ASP-129646-22
47 | 1 | J4 | HDMI | conn:10029449-111RLF | HDMI Receptacle Connector 19 Position Surface Mount, Right Angle, Horizontal | 609-4614-1-ND | Amphenol FCI | 10029449-111RLF
48 | 1 | J5 | FMC_HPC | samtec:ASP-134486-01 | FMC HPC |  | Samtec | ASP-134486-01 |  | ASP-134485-01
49 | 1 | J6 | JTAG DIRECT | conn:PIN_ARRAY_5x2_1.27_SMD | CONN HDR 1.27MM SMD AU 10POS | 952-1389-ND | Harwin | M50-3600542
50 | 1 | J7 | CAS-D20TA | misc:CAS-D20TA | SLIDE SWITCH SPDT 2POS J HOOK 6V | CASD20JCT-ND | Copal Electronics | CAS-D20TA
51 | 1 | J8 | USB Micro B | conn:ZX62-AB-5PA | USB - micro B USB 2.0 Receptacle Connector 5 Position Surface Mount, Right Angle, Horizontal | H125270CT-ND | Hirose | ZX62-B-5PA(33)
52 | 1 | J9 | FAN | conn:B2B-PH-SM4-TB | 2 Positions Header, Shrouded Connector 0.079" (2.00mm) Surface Mount Tin | 455-1734-1-ND | JST | B2B-PH-SM4-TB(LF)(SN)
53 | 1 | J10 | DNP | conn:Pin_Header_Straight_2x10_SMD | 20 Positions Header, Unshrouded, Breakaway Connector 0.100" (2.54mm) Surface Mount Gold | 952-2550-ND | Harwin | M20-8761042
54 | 1 | J11 | DIGITAL IN | conn:1770940 | CONN TERM BLK 8POS 2.5MM | 277-2085-1-ND | Phoenix Contact | 1770940
55 | 1 | J12 | DIGITAL OUT | conn:1770940 | CONN TERM BLK 8POS 2.5MM | 277-2085-1-ND | Phoenix Contact | 1770940
56 | 1 | J13 | UART2 | conn:Pin_Header_Straight_1x03 | CONN HEADER 3POS .100 VERT GOLD | WM50016-03-ND | Molex | 22284033
57 | 1 | J14 | CAN | conn:1770898 | CONN TERM BLK 3POS 2.5MM | 277-2080-1-ND | Phoenix Contact | 1770898
58 | 1 | J15 | RS485 | conn:1770898 | CONN TERM BLK 3POS 2.5MM | 277-2080-1-ND | Phoenix Contact | 1770898
59 | 1 | J16 | USB Micro AB | conn:ZX62-AB-5PA | USB - micro AB USB 2.0 Receptacle Connector 5 Position Surface Mount, Right Angle, Horizontal | H125279CT-ND | Hirose | ZX62-AB-5PA(31)
60 | 1 | J17 | 1840461-1 | conn:1840461-1 | 1x1 GIGABIT TAB DOWN LOW PROFILE OFFSET W/LED | 1419-1060-1-ND | BEL TRP | 1840461-1 | 530-1840437-1 | 1840437-1
61 | 1 | J18 | microSD | conn:MicroSD_Hinged | CONN MICRO SD CARD HINGED TYPE | WM6698CT-ND | Molex | 472192001
62 | 1 | J19 | 452403012014 | misc:452403012014 | Slide Switch DPDT Surface Mount | 732-10145-1-ND | Wurth Electronics | 452403012014
63 | 1 | J20 | CJS-1200TA | misc:CJS-1200TA | SWITCH SLIDE SPDT SMD J-LEAD 6V | 563-1021-1-ND | Copal Electronics | CJS-1200TA
64 | 3 | JP3, JP5, JP6 | JUMPER | conn:Pin_Header_Straight_1x02 | CONN HEADER 2POS .100 VERT GOLD | WM50016-02-ND | Molex | 22284023
65 | 1 | JP4 | PLL | misc:JUMPER3_0603 | RES 20K OHM 5% 1/10W 0603 | RMCF0603JT20K0CT-ND | Stackpole | RMCF0603JT20K0
66 | 1 | L1 | 220nH | inductor:SRP1238A | FIXED IND 220NH 38.5A 0.81 MOHM | SRP1238A-R22MCT-ND | Bourns | SRP1238A-R22M
67 | 2 | L2, L5 | 3uH | inductor:SRU1048 | FIXED IND 3UH 6.2A 7.2 MOHM SMD | SRU1048-3R0YCT-ND | Bourns | SRU1048-3R0Y
68 | 2 | L3, L6 | 4.7uH | inductor:SRN6045 | FIXED IND 4.7UH 3A 37.6 MOHM SMD | SRN6045-4R7YCT-ND | Bourns | SRN6045-4R7Y
69 | 1 | L4 | 6.2uH | inductor:SRR6038 | FIXED IND 6.2UH 2.5A 27 MOHM SMD | SRR6038-6R2YCT-ND | Bourns | SRR6038-6R2Y
70 | 1 | Q1 | DMP3099L | to-sod-sot:SOT-23 | MOSFET P-CH 30V SOT23 | DMP3099L-7DICT-ND | Diodes Incorporated | DMP3099L-7
71 | 3 | Q2, Q3, Q4 | BSS806N | to-sod-sot:SOT-23 | MOSFET N-CH 20V 2.3A SOT23 | BSS806N H6327CT-ND | Infineon | BSS806N H6327
72 | 3 | R1, R2, R27 | 80.6 | chip_rlc:r_0402 | RES SMD 80.6 OHM 1% 1/16W 0402 | 311-80.6LRCT-ND | Yageo | RC0402FR-0780R6L
73 | 24 | R3, R4, R5, R6, R7, R8, R9, R10, R11, R12, R13, R14, R15, R16, R17, R18, R19, R20, R21, R22, R23, R24, R25, R26 | 40.2 | chip_rlc:r_0402 | RES SMD 40.2 OHM 1% 1/16W 0402 | 311-40.2LRCT-ND | Yageo | RC0402FR-0740R2L
74 | 9 | R28, R79, R80, R92, R125, R130, R131, R133, R140 | 4.7K | chip_rlc:r_0402 | RES SMD 4.7K OHM 5% 1/16W 0402 | 311-4.7KJRCT-ND | Yageo | RC0402JR-074K7L
75 | 2 | R29, R30 | 240 | chip_rlc:r_0402 | RES SMD 240 OHM 1% 1/16W 0402 | 311-240LRCT-ND | Yageo | RC0402FR-07240RL
76 | 13 | R31, R45, R46, R50, R57, R59, R64, R65, R119, R120, R141, R142, R146 | 10K | chip_rlc:r_0402 | RES SMD 10K OHM 5% 1/16W 0402 | 311-10KJRCT-ND | Yageo | RC0402JR-0710KL
77 | 1 | R33 | 200K | chip_rlc:r_0402 | RES SMD 200K OHM 5% 1/16W 0402 | 311-200KJRCT-ND | Yageo | RC0402JR-07200KL
78 | 4 | R34, R36, R49, R98 | 100K | chip_rlc:r_0402 | RES SMD 100K OHM 5% 1/16W 0402 | 311-100KJRCT-ND | Yageo | RC0402JR-07100KL
79 | 9 | R35, R103, R104, R105, R106, R135, R147, R148, R152 | 1K | chip_rlc:r_0402 | RES SMD 1K OHM 5% 1/16W 0402 | 311-1.0KJRCT-ND | Yageo | RC0402JR-071KL
80 | 1 | R37 | 309K | chip_rlc:r_0402 | RES SMD 309K OHM 1% 1/16W 0402 | YAG3108CT-ND | Yageo | RC0402FR-07309KL
81 | 1 | R38 | 2 | chip_rlc:r_0402 | RES SMD 2 OHM 5% 1/16W 0402 | 311-2.0JRCT-ND | Yageo | RC0402JR-072RL
82 | 1 | R39 | 10.7K | chip_rlc:r_0402 | RES SMD 10.7K OHM 1% 1/16W 0402 | 311-10.7KLRCT-ND | Yageo | RC0402FR-0710K7L
83 | 1 | R40 | 174K | chip_rlc:r_0402 | RES SMD 174K OHM 1% 1/16W 0402 | YAG3008CT-ND | Yageo | RC0402FR-07174KL
84 | 1 | R41 | 39.2K | chip_rlc:r_0402 | RES SMD 39.2K OHM 1% 1/16W 0402 | 311-39.2KLRCT-ND | Yageo | RC0402FR-0739K2L
85 | 1 | R42 | 3 | chip_rlc:r_0402 | RES SMD 3 OHM 5% 1/16W 0402 | 311-3.0JRCT-ND | Yageo | RC0402JR-073RL
86 | 6 | R43, R115, R116, R137, R143, R153 | 100 | chip_rlc:r_0402 | RES SMD 100 OHM 1% 1/16W 0402 | 311-100LRCT-ND | Yageo | RC0402FR-07100RL
87 | 1 | R44 | 6.49K | chip_rlc:r_0402 | RES SMD 6.49K OHM 1% 1/16W 0402 | 311-6.49KLRCT-ND | Yageo | RC0402FR-076K49L
88 | 1 | R47 | 6.81K | chip_rlc:r_0402 | RES SMD 6.81K OHM 1% 1/16W 0402 | 311-6.81KLRCT-ND | Yageo | RC0402FR-076K81L | 603-RC0402FR-076K81L
89 | 1 | R48 | 8.87K | chip_rlc:r_0402 | RES SMD 8.87K OHM 1% 1/16W 0402 | 311-8.87KLRCT-ND | Yageo | RC0402FR-078K87L
90 | 7 | R51, R121, R122, R123, R124, R126, R129 | 20K | chip_rlc:r_0402 | RES SMD 20K OHM 1% 1/16W 0402 | 311-20.0KLRCT-ND | Yageo | RC0402FR-0720KL
91 | 2 | R52, R63 | 16K | chip_rlc:r_0402 | RES SMD 16K OHM 1% 1/16W 0402 | 311-16.0KLRCT-ND | Yageo | RC0402FR-0716KL
92 | 1 | R53 | 6.65K | chip_rlc:r_0402 | RES SMD 6.65K OHM 1% 1/16W 0402 | YAG3219CT-ND | Yageo | RC0402FR-076K65L
93 | 1 | R54 | 13.3K | chip_rlc:r_0402 | RES SMD 13.3K OHM 1% 1/16W 0402 | YAG2974CT-ND | Yageo | RC0402FR-0713K3L
94 | 1 | R55 | 11.3K | chip_rlc:r_0402 | RES SMD 11.3K OHM 1% 1/16W 0402 | 311-11.3KLRCT-ND | Yageo | RC0402FR-0711K3L
95 | 1 | R56 | 11K | chip_rlc:r_0402 | RES SMD 11K OHM 1% 1/16W 0402 | 311-11.0KLRCT-ND | Yageo | RC0402FR-0711KL
96 | 1 | R58 | 182K | chip_rlc:r_0402 | RES SMD 182K OHM 1% 1/16W 0402 | YAG3015CT-ND | Yageo | RC0402FR-07182KL
97 | 1 | R60 | 75K | chip_rlc:r_0402 | RES SMD 75K OHM 1% 1/16W 0402 | 311-75KLRCT-ND | Yageo | RC0402FR-0775KL
98 | 1 | R61 | 24K | chip_rlc:r_0402 | RES SMD 24K OHM 1% 1/16W 0402 | 311-24KLRCT-ND | Yageo | RC0402FR-0724KL
99 | 1 | R62 | 14K | chip_rlc:r_0402 | RES SMD 14K OHM 1% 1/16W 0402 | 311-14.0KLRCT-ND | Yageo | RC0402FR-0714KL
100 | 2 | R66, R149 | DNP | chip_rlc:r_0402
101 | 9 | R68, R69, R70, R71, R72, R73, R74, R76, R132 | 49R9 | chip_rlc:r_0402 | RES SMD 49.9 OHM 1% 1/16W 0402 | 311-49.9LRCT-ND | Yageo | RC0402FR-0749R9L
102 | 1 | R75 | 51K | chip_rlc:r_0402 | RES SMD 51K OHM 5% 1/16W 0402 | 311-51KJRCT-ND | Yageo | RC0402JR-0751KL
103 | 1 | R77 | 27K | chip_rlc:r_0402 | 27k Ohm ±5% 0.063W, 1/16W Surface Mount Resistor Thick Film ±100ppm/°C 0402 | 311-27KJRCT-ND | Yageo | RC0402JR-0727KL
104 | 1 | R87 | 2K2 | chip_rlc:r_0402 | RES SMD 2.2K OHM 5% 1/16W 0402 | 311-2.2KJRCT-ND | Yageo | RC0402JR-072K2L
105 | 1 | R88 | 3K3 | chip_rlc:r_0402 | RES SMD 3.3K OHM 5% 1/16W 0402 | 311-3.3KJRCT-ND | Yageo | RC0402JR-073K3L
106 | 1 | R89 | 1.5K | chip_rlc:r_0402 | RES SMD 1.5K OHM 5% 1/16W 0402 | 311-1.5KJRCT-ND | Yageo | RC0402JR-071K5L
107 | 4 | R90, R91, R95, R97 | 33 | chip_rlc:r_0402 | RES SMD 33 OHM 5% 1/16W 0402 | 311-33JRCT-ND | Yageo | RC0402JR-0733RL
108 | 2 | R93, R155 | 330 | chip_rlc:r_0402 | 330 Ohm ±5% 0.063W, 1/16W Surface Mount Resistor Thick Film ±100ppm/°C 0402 | 311-330JRCT-ND | Yageo | RC0402JR-07330RL
109 | 5 | R94, R96, R150, R151, R154 | 220 | chip_rlc:r_0402 | RES SMD 220 OHM 5% 1/16W 0402 | 311-220JRCT-ND | Yageo | RC0402JR-07220RL
110 | 4 | R99, R100, R101, R102 | 3.3K 1/4W | chip_rlc:r_1206 | RES SMD 3.3K OHM 5% 1/4W 1206 | 311-3.3KERCT-ND | Yageo | RC1206JR-073K3L
111 | 4 | R107, R108, R109, R110 | 33K | chip_rlc:r_0402 | RES SMD 33K OHM 5% 1/16W 0402 | 311-33KJRCT-ND | Yageo | RC0402JR-0733KL
112 | 4 | R111, R112, R113, R114 | 39 | chip_rlc:r_0402 | RES SMD 39 OHM 5% 1/16W 0402 | 311-39JRCT-ND | Yageo | RC0402JR-0739RL
113 | 2 | R117, R118 | 2.2K | chip_rlc:r_0402 | RES SMD 2.2K OHM 5% 1/16W 0402 | 311-2.2KJRCT-ND | Yageo | RC0402JR-072K2L
114 | 2 | R127, R128 | 120 | chip_rlc:r_0402 | RES SMD 120 OHM 5% 1/16W 0402 | 311-120JRCT-ND | Yageo | RC0402JR-07120RL
115 | 1 | R134 | 680 | chip_rlc:r_0402 | RES SMD 680 OHM 5% 1/16W 0402 | 311-680JRCT-ND | Yageo | RC0402JR-07680RL
116 | 1 | R136 | 8.06K | chip_rlc:r_0402 | RES SMD 8.06K OHM 1% 1/16W 0402 | 311-8.06KLRCT-ND | Yageo | RC0402FR-078K06L
117 | 2 | R138, R139 | 1.0K | chip_rlc:r_0402 | RES SMD 1K OHM 1% 1/16W 0402 | 311-1.00KLRCT-ND | Yageo | RC0402FR-071KL
118 | 1 | R144 | 12.1K | chip_rlc:r_0402 | RES SMD 12.1K OHM 1% 1/16W 0402 | 311-12.1KLRCT-ND | Yageo | RC0402FR-0712K1L
119 | 1 | RP1 | 10K | chip_rlc:r_0402_4 | RES ARRAY 4 RES 10K OHM 0804 | CAT10-103J4LFCT-ND | Bourns | CAT10-103J4LF
120 | 1 | SW1 | PROG_B | misc:TACT_SMD_4.5X4.5 | SWITCH TACTILE SPST-NO 0.05A 12V | 732-7003-1-ND | Wurth Electronics | 430181038816
121 | 1 | SW3 | SRST | misc:TACT_SMD_4.5X4.5 | SWITCH TACTILE SPST-NO 0.05A 12V | 732-7003-1-ND | Wurth Electronics | 430181038816
122 | 3 | TH1, TH2, TH3 | PTC 0.5A | misc:ptc_1210 | PTC RESTTBLE 0.50A 16V CHIP 1210 | 507-1786-1-ND | Bel Fuse | 0ZCH0050FF2G
123 | 2 | TR1, TR2 | SRF2012 | misc:SRF2012 | INDUCTOR COMMON MODE 90 OHM 25% | SRF2012-900YCT-ND | Bourns Inc. | SRF2012-900Y
124 | 1 | U1 | XC7Z030-2FBG676I | bga:FBG676 | IC SOC CORTEX-A9 KINTEX7 676FBGA | XC7Z030-2FBG676I-ND | Xilinx | XC7Z030-2FBG676I
125 | 2 | U2, U3 | MT41K256M16TW-107 IT | bga:FBGA96 | IC DDR3 SDRAM 4GBIT 800MHZ FBGA |  | Micron | MT41K256M16TW-107 IT | 913-A4C25616D3B12BAN | AS4C256M16D3B-12BAN
126 | 1 | U4 | TPS51206 | dfn-qfn:TPS51206 | IC REG SINK/SOURCE DDR 10SON | 296-28767-1-ND | Texas Instruments | TPS51206DSQR
127 | 1 | U5 | TPS53355 | dfn-qfn:TPS53355 | IC REG BUCK ADJ 30A SYNC 22SON | 296-29538-1-ND | Texas Instruments | TPS53355DQPR |  | TPS53355DQPT
128 | 1 | U7 | LTV-817S | misc:OPTO_SMD | OPTOISOLATR 5KV TRANSISTOR 4-SMD | 160-1367-5-ND | Lite-On | LTV-817S
129 | 1 | U8 | TPS563209 | to-sod-sot:SOT-23-6 | IC REG BUCK ADJ 3A SYNC SOT23 | 296-40813-1-ND | Texas Instruments | TPS563209DDCR
130 | 1 | U9 | TPS65400 | dfn-qfn:TPS65400 | IC REG BUCK ADJ 4A/2A QD 48VQFN | 296-40902-1-ND | Texas Instruments | TPS65400RGZR |  | TPS65400RGZT
131 | 1 | U10 | MCP4017 | to-sod-sot:SC-70-6 | IC DGTL POT 50K 128TAPS SC70-6 | MCP4017T-503E/LTCT-ND | Microchip | MCP4017T-503E/LT
132 | 1 | U11 | CBTL04083A | dfn-qfn:HVQFN42 | IC MUX/DEMUX 2:1 4CH 42HVQFN | 568-6655-1-ND | NXP | CBTL04083ABS,518
133 | 1 | U12 | MCP79410 | soic-sop-tssop:MSOP-8 | IC RTC CLK/CALENDAR I2C 8-MSOP | MCP79410-I/MS-ND | Microchip | MCP79410-I/MS
134 | 1 | U13 | TXB0101 | to-sod-sot:SC-70-6 | IC VOLT-LVL TRANSL BI-DIR SC70-6 | 296-22861-1-ND | Texas Instruments | TXB0101DCKR
135 | 1 | U14 | MIC2090 | to-sod-sot:SOT-23-5 | IC DISTRIBUTION SW 50MA SOT-23-5 | 576-3890-1-ND | Microchip | MIC2090-1YM5-TR
136 | 1 | U17 | LPC11U35FHI33 | dfn-qfn:LPC11U35 | IC MCU 32BIT 64KB FLASH 32HVQFN | 568-9586-ND | NXP | LPC11U35FHI33/501
137 | 6 | U18, U26, U27, U33, U34, U48 | 74AVC2T45 | soic-sop-tssop:MSOP-8 | IC BUS TRANSCVR TRI-ST DL 8TSSOP | 568-8845-1-ND | NXP | 74AVC2T45DP,125
138 | 2 | U19, U44 | CM1213A | to-sod-sot:SOT-143 | TVS DIODE 3.3VWM 10VC SOT1434 | CM1213A-02SROSCT-ND | ON Semiconductor | CM1213A-02SR
139 | 3 | U20, U21, U22 | LSF0204D | dfn-qfn:LSF0204D | IC LEVEL TRANSLATOR 4BIT 14VQFN | 296-40401-1-ND | Texas Instruments | LSF0204DRGYR
140 | 1 | U23 | TLP290-4 | soic-sop-tssop:SOIC-16 | OPTOISOLTR 2.5KV 4CH TRANS 16-SO | TLP290-4(TPECT-ND | Toshiba | TLP290-4(TP,E
141 | 4 | U28, U29, U30, U31 | VO14642AABTR | soic-sop-tssop:DIP-6-SMD | RELAY SSR SPST-NO 2A 60V 6SMD | VO14642AABCT-ND | Vishay | VO14642AABTR
142 | 1 | U32 | 33.33MHz | xtal-res-osc:ABRACON-ASDMB | OSC MEMS 33.333MHZ CMOS SMD | 535-11196-1-ND | Abracon | ASDMB-33.333MHZ-LY-T
143 | 1 | U35 | XR33038 | soic-sop-tssop:SOIC-8 | IC TXRX RS422/RS485 8SOIC | 1016-2002-5-ND | Exar | XR33038ID-F
144 | 1 | U36 | TCAN332 | soic-sop-tssop:SOIC-8 | IC TXRX CAN 3.3V 8SOIC | 296-43711-1-ND | Texas Instruments | TCAN332DR
145 | 1 | U37 | QSPI | dfn-qfn:WSON-8 | IC FLASH 128MBIT 133MHZ 8WSON | S25FL128SAGNFI011-ND | Spansion | S25FL128SAGNFI011
146 | 2 | U39, U40 | PESD1CAN | to-sod-sot:SOT-23 | TVS DIODE 24VWM 70VC SOT23 | 568-4032-1-ND | NXP | PESD1CAN,215
147 | 1 | U41 | USB3320C | dfn-qfn:USB3320C | MULTI-FREQ USB 2.0 ULPI PHY | USB3320C-EZK-ND | Microchip | USB3320C-EZK
148 | 1 | U42 | 24MHz | xtal-res-osc:ABRACON-ASDMB | OSC MEMS 24.000MHZ CMOS SMD 10ppm | 535-11186-1-ND | Abracon | ASDMB-24.000MHZ-LY-T
149 | 1 | U43 | MIC2025 | soic-sop-tssop:MSOP-8 | IC DISTRIBUTION SW SGL 8-MSOP | 576-1691-5-ND | Microchip | MIC2025-1YMM
150 | 1 | U45 | KSZ9031RNXIC | dfn-qfn:KSZ9031RNX | Gigabit Ethernet PHY RGMII | KSZ9031RNXIC-ND | Microchip | KSZ9031RNXIC
151 | 1 | U46 | TXS02612 | dfn-qfn:TXS02612 | IC SDIO PORT EXPANDER 24WQFN | 296-23869-1-ND | Texas Instruments | TXS02612RTWR
152 | 1 | U47 | 25MHz | xtal-res-osc:ABRACON-ASDMB | OSC MEMS 25.000MHZ CMOS SMD 10ppm | 535-11188-1-ND | Abracon | ASDMB-25.000MHZ-LY-T
153 | 1 | U49 | DSC1123DL5-200.0000 | xtal-res-osc:DSC1123D | OSC MEMS 200.000MHZ LVDS SMD | DSC1123DL5-200.0000-ND | Microchip | DSC1123DL5-200.0000
154 | 1 | X1 | 12MHz | xtal-res-osc:CSTCE_G | CER RES 12.0000MHZ 33PF SMD | 490-1220-1-ND | Murata | CSTCE12M0G55Z-R0 |  | CSTCE12M0G55-R0
155 | 1 | Y1 | 32.768kHz | xtal-res-osc:ABRACON-ABS06 | 32.768kHz ±10ppm Crystal 9pF 90 kOhm -40°C ~ 85°C Surface Mount 2-SMD | 535-10247-1-ND | Abracon | ABS06-32.768KHZ-9-1-T
