ciaa/Hardware/PCB/FSL/CIAA_K60/doc/CIAA_K60_KiCost.xlsx

 |  |  |  |  |  |  | Board Qty: | 50
 |  |  |  |  |  |  | Total Cost: | $5075.21 | $5282.03 |  | $11539.60 |  | $4071.50
 |  |  |  |  |  |  | Unit Cost: | $101.50
Global Part Info
Refs | Value | Desc | Footprint | Manf | Manf# | Qty | Unit$ | Ext$ | Ext$ |  | Ext$ |  | Ext$
J902 | ANALOG INPUT 2 | TERM BLOCK 5.08MM VERT 2POS PCB | bornier2 | TE Connectivity | 796949-2 | 50 | $0.54 | $27.10 | $31.19 | http://www.digikey.com/scripts/DkSearch/dksus.dll?WT.z_header=search_go&lang=en | $29.50 | http://www.mouser.com/ProductDetail/TE-Connectivity/796949-2/ | $27.10
Q1001 | FDN340P | MOSFET P-CH 20V 2A SSOT3 | SOT-23 | ON Semiconductor | FDN340P | 50 | $0.29 | $14.35 | $15.75 | http://www.digikey.com/scripts/DkSearch/dksus.dll?WT.z_header=search_go&lang=en | $14.35 | http://www.mouser.com/ProductDetail/Fairchild-Semiconductor/FDN340P/ | $14.40
U701,U702 | TLP290-4 | OPTOISOLTR 2.5KV 4CH TRANS 16-SO | SSOP-16 | Toshiba Semiconductor and Storage | TLP290-4(TP,E | 100 | $1.11 | $111.38 | $111.38
R801-R803,R807,R809,R814-R816,R1101 | 1k | RES 1.0K OHM 1/10W 5% 0603 SMD | r_0603 | Yageo | RC0603JR-071KL | 450 | $0.003 | $1.35 | $1.51 | http://www.digikey.com/scripts/DkSearch/dksus.dll?WT.z_header=search_go&lang=en | $1.35 | http://www.mouser.com/Search/Refine.aspx?Keyword=RC0603JR-071KL%20Yageo | $1.35
J803 | RELAY_OUTD | TERM BLOCK 5.08MM VERT 3POS PCB | bornier3 | TE Connectivity | 796949-3 | 50 | $0.88 | $44.00 | $54.33 | http://www.digikey.com/scripts/DkSearch/dksus.dll?WT.z_header=search_go&lang=en | $53.50 | http://www.mouser.com/ProductDetail/TE-Connectivity/796949-3/ | $44.00
R411 | 270R | RES 270 OHM 1/10W 5% 0603 SMD | r_0603 | Yageo | RC0603JR-07270RL | 50 | $0.01 | $0.35 | $0.40 | http://www.digikey.com/scripts/DkSearch/dksus.dll?WT.z_header=search_go&lang=en | $0.40 | http://www.mouser.com/Search/Refine.aspx?Keyword=RC0603JR-07270RL%20Yageo | $0.35
JP901-JP904 | JUMPER | JUMPER 2 TERM | PIN_ARRAY_2x1 |  |  | 200 | $0.00 | $0.00
D1107 | P6SMB33CA | TVS DIODE 28.2VWM 45.7VC SMB | DO-214AA_SMB | Vishay Semiconductor Diodes Division | P6SMB33CA-E3/52 | 50 | $0.32 | $16.20 | $17.90 | http://www.digikey.com/scripts/DkSearch/dksus.dll?WT.z_header=search_go&lang=en | $16.20
FB402-FB405 | BLM18BD470SN1 | FERRITE CHIP 47 OHM 500MA 0603 | fb_0603 | Murata Electronics North America | BLM18BD470SN1D | 200 | $0.05 | $10.46 | $10.46
J301 | ETHERNET | CONN MAGJACK 1PORT 100 BASE-TX | RJ45_Pulse_J403-A | Pulse | J0011D01BNL | 50 | $6.58 | $329.00 | $330.00 | http://www.digikey.com/scripts/DkSearch/dksus.dll?WT.z_header=search_go&lang=en | $329.00
U302 | KSZ8041TLI | Ethernet 10/100 PHY W/AUTO MDIX | TQFP48 | Micrel | KSZ8041TLI | 50 | $2.31 | $115.50 | $117.00 | http://www.digikey.com/scripts/DkSearch/dksus.dll?WT.z_header=search_go&lang=en | $115.50
D202 | ST1 | LED GRN WATER CLEAR 0603 SMD | LED-0603 | Everlight Electronics Co Ltd | QTLP600C4TR | 50 | $0.28 | $14.04 | $14.04
C1104,C1302,C1305-C1307,C1311-C1318 | 100nF | CAP CER 0,1UF 16V 10% X7R | c_0603 | Kemet | C0603C104K4RACTU | 650 | $0.01 | $4.51 | $4.51 | http://www.digikey.com/scripts/DkSearch/dksus.dll?WT.z_header=search_go&lang=en | $4.55 | http://www.mouser.com/ProductDetail/Kemet/C0603C104K4RACTU/ | $5.20
C201,C205,C206,C209,C210,C213,C214,C217,C218,C221,C223,C224,C227,C230,C1106,C1301 | 100nF | CAP CER 0.1UF 16V 10% X7R | c_0603 | Kemet | C0603C104K4RACTU | 800 | $0.01 | $5.55 | $5.55 | http://www.digikey.com/scripts/DkSearch/dksus.dll?WT.z_header=search_go&lang=en | $5.60 | http://www.mouser.com/ProductDetail/Kemet/C0603C104K4RACTU/ | $6.40
FB1101,FB1102,FB1201 | MMZ1608B601C | FERRITE CHIP 600 OHM 500MA 0603 | fb_0603 | TDK | MMZ1608B601C | 150 | $0.03 | $4.35 | $6.54 | http://www.digikey.com/scripts/DkSearch/dksus.dll?WT.z_header=search_go&lang=en | $4.35 | http://www.mouser.com/ProductDetail/TDK/MMZ1608B601C/ | $8.55
J1303 | JTAG DIRECTO | CONECTOR HDR 1,27MM SMD AU 10POS | PIN_ARRAY_5x2_1.27_SMD | HARWIN | M50-3600542 | 50 | $0.95 | $47.75 | $53.70 | http://www.digikey.com/scripts/DkSearch/dksus.dll?WT.z_header=search_go&lang=en | $47.75 | http://www.mouser.com/ProductDetail/Harwin/M50-3600542/ | $48.45
J1302 | JTAG DEBUG USB | CONNECTOR RECEPTACLE MICRO USB B SMD | USB_MicroAB | HIROSE ELECTRIC | ZX62-B-5PA(11) | 50 | $0.57 | $28.40 |  | http://www.digikey.com/scripts/DkSearch/dksus.dll?WT.z_header=search_go&lang=en | $28.40
C501,C503,C1319 | 100nF | CAP CER 0,1UF 16V X7R 10% 0603 | c_0603 | Kemet | C0603C104K4RACTU | 150 | $0.01 | $1.05 | $1.49 | http://www.digikey.com/scripts/DkSearch/dksus.dll?WT.z_header=search_go&lang=en | $1.05 | http://www.mouser.com/ProductDetail/Kemet/C0603C104K4RACTU/ | $1.50
R901-R904 | 4.7 | RES 4.7 OHM 1/10W 5% 0603 SMD | r_0603 | Yageo | RC0603JR-074R7L | 200 | $0.003 | $0.60 | $0.88 | http://www.digikey.com/scripts/DkSearch/dksus.dll?WT.z_header=search_go&lang=en | $0.60 | http://www.mouser.com/Search/Refine.aspx?Keyword=RC0603JR-074R7L%20Yageo | $0.80
U1304 | PRTR5V0U2X | IC TVS DIODE 2 CHANNEL 10V CLAMP SOT1434 | SOT-143-4 | NXP | PRTR5V0U2X,215 | 50 | $0.41 | $20.60 | $22.40 | http://www.digikey.com/scripts/DkSearch/dksus.dll?WT.z_header=search_go&lang=en | $20.60 | http://www.mouser.com/Search/Refine.aspx?Keyword=PRTR5V0U2X%2C215%20NXP | $20.90
C1105,C1201 | 100nF | CAP CER 0.1UF 50V 10% X7R 0603 | c_0603 | Samsung | CL10B104KB8SFNC | 100 | $0.01 | $1.25 | $1.25
R301,R1206 | 10K | RES 10K OHM 1/10W 5% 0603 SMD | r_0603 | Yageo | RC0603JR-0710KL | 100 | $0.003 | $0.30 | $0.44 | http://www.digikey.com/scripts/DkSearch/dksus.dll?WT.z_header=search_go&lang=en | $0.30 | http://www.mouser.com/Search/Refine.aspx?Keyword=RC0603JR-0710KL%20Yageo | $0.40
C203 | 2.2uF | CAP CER 2.2UF 10V 10% X7R 0603 | c_0603 | Taiyo Yuden | LMK107B7225KA-T | 50 | $0.12 | $5.97 | $5.97 | http://www.digikey.com/scripts/DkSearch/dksus.dll?WT.z_header=search_go&lang=en | $6.05
R709-R716,R1304 | 1K | RES 1.0K OHM 1/10W 5% 0603 SMD | r_0603 | Yageo | RC0603JR-071KL | 450 | $0.003 | $1.35 | $1.51 | http://www.digikey.com/scripts/DkSearch/dksus.dll?WT.z_header=search_go&lang=en | $1.35 | http://www.mouser.com/Search/Refine.aspx?Keyword=RC0603JR-071KL%20Yageo | $1.35
U303 | NB2304AI2DG | 3.3 V Zero Delay Clock Buffer | SOIC-8 | ON Semi | NB2304A | 50 | $1.07 | $53.50 | $57.75 | http://www.digikey.com/scripts/DkSearch/dksus.dll?WT.z_header=search_go&lang=en | $53.50 | http://www.mouser.com/ProductDetail/ON-Semiconductor/NB2304AI2DG/ | $66.50
R309 | 6,49k 1% | RES 6,49K OHM 1/10W 1% 0603 SMD | r_0603 | Yageo | RC0603FR-076K49L | 50 | $0.01 | $0.50 | $0.50 | http://www.digikey.com/scripts/DkSearch/dksus.dll?WT.z_header=search_go&lang=en | $0.50
D201,D301,D302 | LL4148 | DIODE SMALL SIG 100V 0.2A | SOD-123 | Fairchild | LL4148 | 150 | $0.03 | $3.75 | $6.30 | http://www.digikey.com/scripts/DkSearch/dksus.dll?WT.z_header=search_go&lang=en | $3.90 | http://www.mouser.com/ProductDetail/Fairchild-Semiconductor/LL4148/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 | $3.75
C905-C908 | 470pF | CAP CER 470PF 50V 10% X7R 0603 | c_0603 | Kemet | C0603C471K5RACTU | 200 | $0.01 | $2.80 | $3.96 | http://www.digikey.com/scripts/DkSearch/dksus.dll?WT.z_header=search_go&lang=en | $2.80 | http://www.mouser.com/ProductDetail/Kemet/C0603C471K5RACTU/ | $2.80
J1001 | SD CARD | CONN MEMORY CARD R/A 8POS SMD | MicroSD_Hinged | Molex Inc. | 0472192001 | 50 | $0.44 | $22.20 |  |  | $47.05 | http://www.mouser.com/ProductDetail/Molex/47219-2001/?qs=sGAEpiMZZMtaN%252bleAIfjrFeXAX1l9kTj | $22.20
Q1201 | BC817-40 | TRANS NPN 45V 500MA SOT-23 | SOT-23 | ON Semiconductor | BC817-40LT3G | 50 | $0.10 | $4.95 | $5.25 | http://www.digikey.com/product-detail/en/on-semiconductor/BC817-40LT3G/BC817-40LT3GOSCT-ND/2704954 | $4.95
D1201,D1202 | BAV199 | DIODE ARRAY 70V 215MA SOT23 | SOT-23 | ON Semiconductor | BAV199LT1G | 100 | $0.08 | $7.80 | $12.15 | http://www.digikey.com/product-detail/en/on-semiconductor/BAV199LT1G/BAV199LT1GOSCT-ND/917816 | $7.80 | http://www.mouser.com/ProductDetail/ON-Semiconductor/BAV199LT1G/ | $8.10
BT1101 | CR2032 | HOLDER BATTERY FOR 2032 CELL | 2032batPTH | MPD | BH32T-C | 50 | $1.10 | $55.00 | $55.00
C909,C1103 | 10uF | CAP TANT 10UF 6.3V 10% 1206 | c_1206POL | Kemet | T491A106K006AT7280 | 100 | $0.13 | $13.40 |  |  | $13.40
J1102 | DC-OUT | BORNERA 5.08MM VERT 2 POS PCB | bornier2 | TE Connectivity | 796949-2 | 50 | $0.54 | $27.10 | $31.19 | http://www.digikey.com/scripts/DkSearch/dksus.dll?WT.z_header=search_go&lang=en | $29.50 | http://www.mouser.com/ProductDetail/TE-Connectivity/796949-2/ | $27.10
D404 | PESD1CAN | TVS DIODE 24VWM 70VC SOT23 | SOT-23 | NXP Semiconductors | PESD1CAN,215 | 50 | $0.31 | $15.65 | $17.60 | http://www.digikey.com/scripts/DkSearch/dksus.dll?WT.z_header=search_go&lang=en | $15.65
X202 | 32.768KHZ | CRYSTAL 32.768KHZ 12.5PF | 4SOJ | Abracon Corporation | ABS25-32.768KHZ-T | 50 | $0.28 | $14.16 | $14.16 | http://www.digikey.com/scripts/DkSearch/dksus.dll?WT.z_header=search_go&lang=en |  |  | $24.70
FB502,FB1301-FB1303 | MMZ1608B601C | FERRITE CHIP 600 OHM 500MA 0603 | fb_0603 | TDK | MMZ1608B601C | 200 | $0.03 | $5.80 | $8.72 | http://www.digikey.com/scripts/DkSearch/dksus.dll?WT.z_header=search_go&lang=en | $5.80 | http://www.mouser.com/ProductDetail/TDK/MMZ1608B601C/ | $11.40
J602 | I2C | CONN HEADER .100" DUAL STR 80POS | PIN_ARRAY_2x2 | Sullins Connector Solutions | S2012EC-40-ND | 50 | $1.01 | $50.60 | $50.60 | http://www.digikey.com/scripts/DkSearch/dksus.dll?WT.z_header=search_go&lang=en | $121.00
R203,R921-R924,R1302 | 100 | RES 100 OHM 1/10W 5% 0603 SMD | r_0603 | Yageo | RC0603JR-07100RL | 300 | $0.003 | $0.90 | $1.01 | http://www.digikey.com/scripts/DkSearch/dksus.dll?WT.z_header=search_go&lang=en | $0.90 | http://www.mouser.com/Search/Refine.aspx?Keyword=RC0603JR-07100RL%20Yageo | $0.90
U1002 | 24AA1025 | IC EEPROM 1MBIT 400KHZ 8SOIC | SOIC-8 | Microchip Technology | 24AA1025-I/SN | 50 | $2.73 | $136.50 | $138.00 | http://www.digikey.com/scripts/DkSearch/dksus.dll?WT.z_header=search_go&lang=en | $136.50
D1106 | MMSZ5V6T1G | DIODE ZENER 5.6V 500MW SOD123 | SOD-123 | ON Semiconductor | MMSZ5V6T1G | 50 | $0.16 | $7.90 | $9.60 | http://www.digikey.com/scripts/DkSearch/dksus.dll?WT.z_header=search_go&lang=en | $7.90 | http://www.mouser.com/ProductDetail/ON-Semiconductor/MMSZ5V6T1G/ | $8.00
D1108 | BAT54C | DIODE SCHOTTKY 30V 200MA | SOT-23 | Fairchild Semiconductor | BAT54 | 50 | $0.13 | $6.45 | $6.75 | http://www.digikey.com/scripts/DkSearch/dksus.dll?WT.z_header=search_go&lang=en | $6.45
U401 | SP1486EEN-L | IC TXRX RS485/422 PROFIBUS 8SOIC | SOIC-8 | Exar Corporation | SP1486EEN-L | 50 | $1.73 | $86.50 | $86.50
Q805-Q808 | FQT13N06L | MOSFET N-CH 60V 2.8A SOT-223 | SOT-223 | Fairchild | FQT13N06LTF | 200 | $0.33 | $65.00 | $85.54 | http://www.digikey.com/scripts/DkSearch/dksus.dll?WT.z_header=search_go&lang=en | $65.00 | http://www.mouser.com/Search/Refine.aspx?Keyword=FQT13N06LTF%20Fairchild | $121.20
R804-R806,R808 | 100k | RES 100K OHM 1/10W 5% 0603 SMD | r_0603 | Yageo | RC0603JR-07100KL | 200 | $0.003 | $0.60 | $0.88 | http://www.digikey.com/scripts/DkSearch/dksus.dll?WT.z_header=search_go&lang=en | $0.60 | http://www.mouser.com/Search/Refine.aspx?Keyword=RC0603JR-07100KL%20Yageo | $0.80
R1301,R1309-R1311 | 10K | RES 10K 1/10W 5% 0603 SMD | r_0603 | Yageo | RC0603JR-0710KL | 200 | $0.003 | $0.60 | $0.88 | http://www.digikey.com/scripts/DkSearch/dksus.dll?WT.z_header=search_go&lang=en | $0.60 | http://www.mouser.com/Search/Refine.aspx?Keyword=RC0603JR-0710KL%20Yageo | $0.80
TH1101 | MF-SM300 | FUSE RESETTABLE 3.0A HOLD SMD | MF-SM300 | Bourns | MF-SM300-2 | 50 | $0.50 | $25.02 | $25.02 | http://www.digikey.com/scripts/DkSearch/dksus.dll?WT.z_header=search_go&lang=en | $25.85 | http://www.mouser.com/ProductDetail/Bourns/MF-SM300-2/ | $25.05
R413,R414 | 1K5 | RES 1.5K OHM 1/10W 5% 0603 SMD | r_0603 | Yageo | RC0603JR-071K5L | 100 | $0.003 | $0.30 | $0.44 | http://www.digikey.com/scripts/DkSearch/dksus.dll?WT.z_header=search_go&lang=en | $0.30 | http://www.mouser.com/Search/Refine.aspx?Keyword=RC0603JR-071K5L%20Yageo | $0.40
C1101 | 470uF | CAP ALUM 470UF 35V 20% SMD | c_elec_10x13_5 | Nichicon | UCL1V471MNL1GS | 50 | $0.72 | $36.10 | $36.18 | http://www.digikey.com/scripts/DkSearch/dksus.dll?WT.z_header=search_go&lang=en | $36.10 | http://www.mouser.com/Search/Refine.aspx?Keyword=UCL1V471MNL1GS%20Nichicon | $44.65
JP401-JP406 | JUMPER | JUMPER 2 TERM | PIN_ARRAY_2x1 | Sullins Connector Solutions | PREC040SFAN-RC | 300 | $0.47 | $141.12 | $141.12 | http://www.digikey.com/scripts/DkSearch/dksus.dll?WT.z_header=search_go&lang=en | $4665.00
R206 | 10K | RES 4.7K OHM 1/10W 5% | r_0603 | Yageo | RC0603JR-0710KL | 50 | $0.01 | $0.35 | $0.40 | http://www.digikey.com/scripts/DkSearch/dksus.dll?WT.z_header=search_go&lang=en | $0.40 | http://www.mouser.com/Search/Refine.aspx?Keyword=RC0603JR-0710KL%20Yageo | $0.35
R1303 | 12K 1% | RES 12.0K OHM 1/10W 1% 0603 SMD | r_0603 | Yageo | RC0603FR-0712KL | 50 | $0.01 | $0.50 | $0.50 | http://www.digikey.com/scripts/DkSearch/dksus.dll?WT.z_header=search_go&lang=en | $0.50 | http://www.mouser.com/Search/Refine.aspx?Keyword=RC0603FR-0712KL%20Yageo | $0.50
U901 | MCP6024 | IC OPAMP GP 10MHZ RRO 14TSSOP | TSSOP-14 | Microchip Technology | MCP6024-I/ST | 50 | $1.57 | $78.50 | $79.50 | http://www.digikey.com/scripts/DkSearch/dksus.dll?WT.z_header=search_go&lang=en | $78.50
R415,R416 | 60 1% | RES 59.0 OHM 1/10W 1% 0603 SMD | r_0603 | Yageo | RC0603FR-0759RL | 100 | $0.003 | $0.30 | $0.57 | http://www.digikey.com/scripts/DkSearch/dksus.dll?WT.z_header=search_go&lang=en | $0.30
R1202 | 33k | RES 33.0K OHM 1/10W .1% 0603 SMD | r_0603 | Susumu | RG1608P-333-B-T5 | 50 | $0.18 | $9.05 | $9.05 | http://www.digikey.com/scripts/DkSearch/dksus.dll?WT.z_header=search_go&lang=en | $10.25
TH605,TH801-TH804,TH1102 | 1812L110/33MR | PTC RESETTABLE 33V 1.10A 1812L | ptc_1812 | Littelfuse Inc | 1812L110/33MR | 300 | $0.34 | $101.44 | $101.44 | http://www.digikey.com/scripts/DkSearch/dksus.dll?WT.z_header=search_go&lang=en |  | http://www.mouser.com/Search/Refine.aspx?Keyword=1812L110%2F33MR%20Littelfuse%20Inc | $101.70
C303 | 10uF | CAP TANT 10UF 6.3V 10% 1206 | c_1206POL | Kemet | T491A106K006AT7280 | 50 | $0.20 | $10.20 |  |  | $10.20
JP1201 | JUMPER3 | JUMPER 3 TERM | PIN_ARRAY_3x1 | Sullins Connector Solutions | PREC040SFAN-RC | 50 | $0.57 | $28.55 | $28.55 | http://www.digikey.com/scripts/DkSearch/dksus.dll?WT.z_header=search_go&lang=en | $821.00
U1101 | LM2596-5.0 | IC REG BUCK 5V 3A TO263-5 | LM2596 | Texas Instruments | LM2596SX-5.0/NOPB | 50 | $3.72 | $186.00 | $220.50 | http://www.digikey.com/scripts/DkSearch/dksus.dll?WT.z_header=search_go&lang=en | $186.00 | http://www.mouser.com/ProductDetail/Texas-Instruments/LM2596SX-50-NOPB/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 | $189.00
FB301-FB304,FB501,FB1304 | BLM18KG221SN1D | FERRITE CHIP 220 OHM 2200MA 0603 | fb_0603 | MURATA | BLM18KG221SN1D | 300 | $0.03 | $7.80 | $9.82 | http://www.digikey.com/scripts/DkSearch/dksus.dll?WT.z_header=search_go&lang=en | $10.50 | http://www.mouser.com/Search/Refine.aspx?Keyword=BLM18KG221SN1D%20MURATA | $7.80
C1303,C1308,C1309 | 4,7uF | CAP TANT 4,7UF 6,3V 10% 1206 | c_1206POL | Kemet | T491A475K006AT | 150 | $0.11 | $16.05 | $22.05 | http://www.digikey.com/scripts/DkSearch/dksus.dll?WT.z_header=search_go&lang=en | $16.05 | http://www.mouser.com/ProductDetail/Kemet/T491A475K006AT/?qs=sGAEpiMZZMuEN2agSAc2phEL9R1A1xf6yqKTKEm9DDg%3D | $22.50
U502 | PRTR5V0U2X | IC TVS DIODE 2 CHANNEL 10V CLAMP SOT1434 | SOT-143-4 | ON SEMICONDUCTOR | CM1213A-02SR | 50 | $0.37 | $18.40 | $20.05 | http://www.digikey.com/scripts/DkSearch/dksus.dll?WT.z_header=search_go&lang=en | $18.40
U1102 | NCP1117ST33T3G | IC REG LDO 3.3V 1A SOT223 | SOT-223 | ON Semiconductor | NCP1117ST33T3G | 50 | $0.36 | $18.00 | $19.60 | http://www.digikey.com/scripts/DkSearch/dksus.dll?WT.z_header=search_go&lang=en | $18.00 | http://www.mouser.com/Search/Refine.aspx?Keyword=NCP1117ST33T3G%20ON%20Semiconductor | $18.30
C701-C708 | 1,5nF | CAP CER 1500PF 50V 10% X7R 0603 | c_0603 | Kemet | C0603C152K5RACTU | 400 | $0.01 | $4.80 | $5.22 | http://www.digikey.com/scripts/DkSearch/dksus.dll?WT.z_header=search_go&lang=en | $4.80 | http://www.mouser.com/ProductDetail/Kemet/C0603C152K5RACTU/?qs=sGAEpiMZZMs0AnBnWHyRQKPqox8s7SFQcAbfUCQjQ6M%3D | $5.20
TP1101,TP1102 | TESTPOINT_PDN |  | TESTPOINT_PDN |  |  | 100 | $0.00 | $0.00
D801,D803,D805,D807 | LL4148 | DIODE SMALL SIG 100V 0.2A SOD80 | SOD-123 | Fairchild | LL4148 | 200 | $0.03 | $5.00 | $8.40 | http://www.digikey.com/scripts/DkSearch/dksus.dll?WT.z_header=search_go&lang=en | $5.20 | http://www.mouser.com/ProductDetail/Fairchild-Semiconductor/LL4148/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 | $5.00
H1-H4 | PCB_HOLE | PCB HOLE | PCB_HOLE |  |  | 200 | $0.00 | $0.00
K801-K804 | 1461353-2 | RELAY GENERAL PURPOSE SPST 5A 5V | 1461353-2 | TE Connectivity | 1461353-2 | 200 | $1.09 | $218.00 | $218.00 | http://www.digikey.com/scripts/DkSearch/dksus.dll?WT.z_header=search_go&lang=en | $226.00
JP905-JP908 | JUMPER3 | JUMPER 3 TERM | PIN_ARRAY_3x1 |  |  | 200 | $0.00 | $0.00
D401-D403 | P6SMB12CAT3G | TVS DIODE 10.2VWM 16.7VC SMB | DO-214AA_SMB | ON Semiconductor | P6SMB12CAT3G | 150 | $0.18 | $27.45 | $38.27 | http://www.digikey.com/scripts/DkSearch/dksus.dll?WT.z_header=search_go&lang=en | $27.45 | http://www.mouser.com/ProductDetail/ON-Semiconductor/P6SMB12CAT3G/?qs=sGAEpiMZZMtqO%252bWUGLBzeL0IHlZqTEbU | $28.65
Q801-Q804 | NDS7002A | MOSFET N-CH 60V 280MA SOT-23 | SOT-23 | Fairchild | NDS7002A | 200 | $0.11 | $22.20 | $35.10 | http://www.digikey.com/scripts/DkSearch/dksus.dll?WT.z_header=search_go&lang=en | $22.20 | http://www.mouser.com/Search/Refine.aspx?Keyword=NDS7002A%20Fairchild | $23.00
R406,R408 | 390 | RES 390 OHM 1/10W 5% 0603 SMD | r_0603 | Yageo | RC0603JR-07390RL | 100 | $0.003 | $0.30 | $0.44 | http://www.digikey.com/scripts/DkSearch/dksus.dll?WT.z_header=search_go&lang=en | $0.30 | http://www.mouser.com/Search/Refine.aspx?Keyword=RC0603JR-07390RL%20Yageo | $0.40
J1101 | DC-INPUT | TERM BLOCK 5.08MM VERT 3POS PCB | bornier3 | TE Connectivity | 796949-3 | 50 | $0.88 | $44.00 | $54.33 | http://www.digikey.com/scripts/DkSearch/dksus.dll?WT.z_header=search_go&lang=en | $53.50 | http://www.mouser.com/ProductDetail/TE-Connectivity/796949-3/ | $44.00
F1-F6 | FIDUCIAL | FIDUCIAL | Fiducial_1mm |  |  | 300 | $0.00 | $0.00
J401 | RS485 | TERM BLOCK 5.08MM VERT 3POS PCB | bornier3 | TE Connectivity | 796949-3 | 50 | $0.88 | $44.00 | $54.33 | http://www.digikey.com/scripts/DkSearch/dksus.dll?WT.z_header=search_go&lang=en | $53.50 | http://www.mouser.com/ProductDetail/TE-Connectivity/796949-3/ | $44.00
R401 | 4K7 | RES 4.7K OHM 1/10W 5% 0603 SMD | r_0603 | Yageo | RC0603JR-074K7L | 50 | $0.01 | $0.35 | $0.40 | http://www.digikey.com/scripts/DkSearch/dksus.dll?WT.z_header=search_go&lang=en | $0.40 | http://www.mouser.com/Search/Refine.aspx?Keyword=RC0603JR-074K7L%20Yageo | $0.35
FB201,FB202 | ACML0603101 | FERRITE CHIP 100 OHM 200MA 0603 | fb_0603 | Abracon Corporation | ACML-0603-101-T | 100 | $0.04 | $4.36 | $4.36
R410 | 100 | RES 100 OHM 1/2W 5% 2010 SMD | r_2010 | Bourns | CR2010-JW-101ELF | 50 | $0.19 | $9.27 | $9.27 | http://www.digikey.com/scripts/DkSearch/dksus.dll?WT.z_header=search_go&lang=en | $9.60
R204,R207,R1016 | 680 | RES 680 OHM 1/10W 5% 0603 SMD | r_0603 | Yageo | RC0603JR-07680RL | 150 | $0.003 | $0.45 | $0.66 | http://www.digikey.com/scripts/DkSearch/dksus.dll?WT.z_header=search_go&lang=en | $0.45 | http://www.mouser.com/Search/Refine.aspx?Keyword=RC0603JR-07680RL%20Yageo | $0.60
J402 | DB9 | CONN D-SUB RCPT 9POS RA GOLD | DB9_F_TH | Sullins | SDS107-PRP1-F09-SN63-11 | 50 | $0.00 | $0.00
TH601 | MF-USMF035-2 | FUSE RESETTABLE .35A HOLD SMD | ptc_1210 | Bourns | MF-USMF035-2 | 50 | $0.24 | $12.16 | $12.16 | http://www.digikey.com/scripts/DkSearch/dksus.dll?WT.z_header=search_go&lang=en | $12.60
R1203 | 2.49k | RES 2.49K OHM 1/10W .1% 0603 SMD | r_0603 | Susumu | RG1608P-2491-B-T5 | 50 | $0.17 | $8.56 | $8.56 | http://www.digikey.com/scripts/DkSearch/dksus.dll?WT.z_header=search_go&lang=en | $10.25
L1101 | 47uH | INDUCTOR POWER SHIELD 47UH SMD | L_10x9.8_SMD | Bourns | SRN1060-470M | 50 | $0.52 | $26.00 | $26.00 | http://www.digikey.com/scripts/DkSearch/dksus.dll?WT.z_header=search_go&lang=en | $26.80 | http://www.mouser.com/Search/Refine.aspx?Keyword=SRN1060-470M%20Bourns | $27.80
C402-C404,C406-C410 | 100nF | CAP CER 0.1UF 16V 10% X7R 0603 | c_0603 | Kemet | C0603C104K4RACTU | 400 | $0.01 | $2.80 | $3.25 | http://www.digikey.com/scripts/DkSearch/dksus.dll?WT.z_header=search_go&lang=en | $2.80 | http://www.mouser.com/ProductDetail/Kemet/C0603C104K4RACTU/ | $3.20
D905-D908 | P6SMB20CAT3G | TVS DIODE 17.1VWM 27.7VC SMB | DO-214AA_SMB | ON Semiconductor | P6SMB20CAT3G | 200 | $0.19 | $38.00 | $52.94 | http://www.digikey.com/scripts/DkSearch/dksus.dll?WT.z_header=search_go&lang=en | $38.00
J901 | ANALOG INPUT 1 | TERM BLOCK 5.08MM VERT 3POS PCB | bornier3 | TE Connectivity | 796949-3 | 50 | $0.88 | $44.00 | $54.33 | http://www.digikey.com/scripts/DkSearch/dksus.dll?WT.z_header=search_go&lang=en | $53.50 | http://www.mouser.com/ProductDetail/TE-Connectivity/796949-3/ | $44.00
U1003 | 24AA025E48 | IC EEPROM 2KBIT 400KHZ 8SOIC | SOIC-8 | Microchip Technology | 24AA025E48-I/SN | 50 | $0.27 | $13.30 | $13.50 | http://www.digikey.com/scripts/DkSearch/dksus.dll?WT.z_header=search_go&lang=en | $13.30 | http://www.mouser.com/ProductDetail/Microchip-Technology/24AA025E48-I-SN/ | $13.80
R909-R920,R1201 | 15k | RES 15.0K OHM 1/10W .1% 0603 SMD | r_0603 | Susumu | RG1608P-153-B-T5 | 650 | $0.09 | $57.13 | $57.13 | http://www.digikey.com/scripts/DkSearch/dksus.dll?WT.z_header=search_go&lang=en | $66.30
J703 | DIG_INC | TERM BLOCK 5.08MM VERT 3POS PCB | bornier3 | TE Connectivity | 796949-3 | 50 | $0.88 | $44.00 | $54.33 | http://www.digikey.com/scripts/DkSearch/dksus.dll?WT.z_header=search_go&lang=en | $53.50 | http://www.mouser.com/ProductDetail/TE-Connectivity/796949-3/ | $44.00
D501 | SMAJ5.0A | TVS DIODE 5VWM SMD | DO-214AC_SMA | Bourns | SMAJ5.0A | 50 | $0.29 | $14.35 | $15.48 | http://www.digikey.com/scripts/DkSearch/dksus.dll?WT.z_header=search_go&lang=en | $14.35 | http://www.mouser.com/Search/Refine.aspx?Keyword=SMAJ5.0A%20Bourns | $15.50
R302-R305,R307,R308 | 33 | RES 33 OHM 1/10W 5% 0603 SMD | r_0603 | Bourns | CR0603-JW-330GLF | 300 | $0.01 | $2.10 | $2.68 | http://www.digikey.com/scripts/DkSearch/dksus.dll?WT.z_header=search_go&lang=en | $2.70 | http://www.mouser.com/Search/Refine.aspx?Keyword=CR0603-JW-330GLF%20Bourns | $2.10
U301 | FXO-HC735-25 | HCMOS 7 x 5mm 3.3V Oscillator | FXODFN4 | Fox Electronics | FXO-HC735-25 | 50 | $0.88 | $43.96 | $43.96
C204,C207 | 18pF | CAP CER 18PF 50V 5% NP0 0603 | c_0603 | Kemet | C0603C180J5GACTU | 100 | $0.01 | $1.10 | $1.54 | http://www.digikey.com/scripts/DkSearch/dksus.dll?WT.z_header=search_go&lang=en | $1.10 | http://www.mouser.com/ProductDetail/Kemet/C0603C180J5GACTU/?qs=sGAEpiMZZMs0AnBnWHyRQJIiGvDVk92VyAyEaQH0tQM%3D | $1.50
R310-R313 | 49,9 1% | RES 49,9 OHM 1/10W 1% 0603 SMD | r_0603 | Yageo | RC0603FR-0749R9L | 200 | $0.003 | $0.60 | $1.14 | http://www.digikey.com/scripts/DkSearch/dksus.dll?WT.z_header=search_go&lang=en | $0.60 | http://www.mouser.com/Search/Refine.aspx?Keyword=RC0603FR-0749R9L%20Yageo | $1.20
D1103,D1104 | MBRS130LT3G | DIODE SCHOTTKY 30V 2A SMB | DO-214AA_SMB | ON Semiconductor | MBRS130LT3G | 100 | $0.13 | $13.30 | $19.80 | http://www.digikey.com/scripts/DkSearch/dksus.dll?WT.z_header=search_go&lang=en | $13.30 | http://www.mouser.com/ProductDetail/ON-Semiconductor/MBRS130LT3G/ | $13.40
G101 | OSHWA | LOGO DE OPEN SOURCE HARDWARE | OSHWA |  |  | 50 | $0.00 | $0.00
SW201 | RESET | SWITCH TACTILE SPST-NO 0.05A 12V | TACT_SMD_4 | TE Connectivity | 2-1437565-9 | 50 | $0.23 | $11.60 | $11.60 | http://www.digikey.com/product-detail/en/te-connectivity-alcoswitch-switches/FSM2JSMAATR/450-1792-1-ND/3503931 | $12.10 | http://www.mouser.com/Search/Refine.aspx?Keyword=2-1437565-9%20TE%20Connectivity | $11.60
R1001-R1007,R1014 | 0R | RES 0.0 OHM 1/10W JUMP 0603 SMD | r_0603 | Yageo | RC0603JR-070RL | 400 | $0.003 | $1.20 | $1.39 | http://www.digikey.com/scripts/DkSearch/dksus.dll?WT.z_header=search_go&lang=en | $1.20 | http://www.mouser.com/Search/Refine.aspx?Keyword=RC0603JR-070RL%20Yageo | $1.20
R717-R724 | 33K | RES 33K OHM 1/10W 5% 0603 SMD | r_0603 | Yageo | RC0603JR-0733KL | 400 | $0.003 | $1.20 | $1.34 | http://www.digikey.com/scripts/DkSearch/dksus.dll?WT.z_header=search_go&lang=en | $1.20 | http://www.mouser.com/Search/Refine.aspx?Keyword=RC0603JR-0733KL%20Yageo | $1.20
J603 | ANALOG AUX | CONN HEADER .100" DUAL STR 80POS | PIN_ARRAY_4x2 | Sullins Connector Solutions | S2012EC-40-ND | 50 | $1.01 | $50.60 | $50.60 | http://www.digikey.com/scripts/DkSearch/dksus.dll?WT.z_header=search_go&lang=en | $121.00
C208,C212,C1202 | 10nF | CAP CER 10000PF 50V 10% X7R | c_0603 | Kemet | C0603C103K5RACTU | 150 | $0.01 | $1.05 | $1.32 | http://www.digikey.com/scripts/DkSearch/dksus.dll?WT.z_header=search_go&lang=en | $1.05 | http://www.mouser.com/ProductDetail/Kemet/C0603C103K5RACTU/ | $1.50
J502 | USB OTG | CONNECTOR RECEPTACLE MICRO USB AB SMD BOTTOM MOUNT | USB_MicroAB | HIROSE ELECTRIC | ZX62-AB-5PA(11) | 50 | $0.46 | $23.20 | $23.20 | http://www.digikey.com/scripts/DkSearch/dksus.dll?WT.z_header=search_go&lang=en | $28.40
C308,C311,C313,C316 | 22uF | CAP TANT 22UF 6.3V 10% 1206 | c_1206POL | Kemet | T491A226K006AT | 200 | $0.13 | $26.00 | $36.20 | http://www.digikey.com/scripts/DkSearch/dksus.dll?WT.z_header=search_go&lang=en | $26.00 | http://www.mouser.com/ProductDetail/Kemet/T491A226K006AT/?qs=sGAEpiMZZMuEN2agSAc2plg9mRgM350BaRAWDx4lClw%3D | $26.00
R317 | 1M | RES 1.0M OHM 1/10W 5% 0603 SMD | r_0603 | Yageo | RC0603JR-071ML | 50 | $0.01 | $0.35 | $0.40 | http://www.digikey.com/scripts/DkSearch/dksus.dll?WT.z_header=search_go&lang=en | $0.40 | http://www.mouser.com/Search/Refine.aspx?Keyword=RC0603JR-071ML%20Yageo | $0.35
J601 | GPIO | CONN HEADER .100" DUAL STR 80POS | PIN_ARRAY_11x2 | Sullins Connector Solutions | S2012EC-40-ND | 50 | $1.01 | $50.60 | $50.60 | http://www.digikey.com/scripts/DkSearch/dksus.dll?WT.z_header=search_go&lang=en | $121.00
TR501,TR1301 | SRF2012 | INDUCTOR COMMON MODE 90 OHM SMD | SRF2012 | BOURNS | SRF2012-900Y | 100 | $0.20 | $19.70 | $33.60 | http://www.digikey.com/scripts/DkSearch/dksus.dll?WT.z_header=search_go&lang=en | $34.70 | http://www.mouser.com/ProductDetail/Bourns/SRF2012-900Y/ | $19.70
J1201 | ANALOG OUT | TERM BLOCK 5.08MM VERT 2POS PCB | bornier2 | TE Connectivity | 796949-2 | 50 | $0.54 | $27.10 | $31.19 | http://www.digikey.com/scripts/DkSearch/dksus.dll?WT.z_header=search_go&lang=en | $29.50 | http://www.mouser.com/ProductDetail/TE-Connectivity/796949-2/ | $27.10
C401,C405 | 10uF | CAP TANT 10UF 6.3V 10% 1206 | c_1206POL | Kemet | T491A106K006AT7280 | 100 | $0.13 | $13.40 |  |  | $13.40
U1302 | FT2232H | IC FT2232H DUAL HIGH SPEED USB TO MULTIPURPOSE UART/FIFO | TQFP64 | FTDI CHIP | FT2232HL | 50 | $5.76 | $288.00 | $288.50 | http://www.digikey.com/scripts/DkSearch/dksus.dll?WT.z_header=search_go&lang=en | $288.00
C301 | 10nF | CAP CER 10000PF 50V 10% X7R 0603 | c_0603 | Kemet | C0603C103K5RACTU | 50 | $0.01 | $0.52 | $0.52 | http://www.digikey.com/scripts/DkSearch/dksus.dll?WT.z_header=search_go&lang=en | $0.55 | http://www.mouser.com/ProductDetail/Kemet/C0603C103K5RACTU/ | $0.60
C502,C1310 | 4,7uF | CAP TANT 4,7uF 6,3V 10% 1206 | c_1206POL | Kemet | T491A475K006AT | 100 | $0.11 | $10.70 | $14.70 | http://www.digikey.com/scripts/DkSearch/dksus.dll?WT.z_header=search_go&lang=en | $10.70 | http://www.mouser.com/ProductDetail/Kemet/T491A475K006AT/?qs=sGAEpiMZZMuEN2agSAc2phEL9R1A1xf6yqKTKEm9DDg%3D | $15.00
R817-R820 | 0R-DNP | RES 0.0 OHM 1/10W JUMP 0603 SMD | r_0603 | Yageo | RC0603JR-070RL | 200 | $0.003 | $0.60 | $0.90 | http://www.digikey.com/scripts/DkSearch/dksus.dll?WT.z_header=search_go&lang=en | $0.60 | http://www.mouser.com/Search/Refine.aspx?Keyword=RC0603JR-070RL%20Yageo | $0.80
R601-R604,R1008,R1010-R1013,R1015 | 10k | RES 10K OHM 1/10W 5% 0603 SMD | r_0603 | Yageo | RC0603JR-0710KL | 500 | $0.0027 | $1.35 | $1.35 | http://www.digikey.com/scripts/DkSearch/dksus.dll?WT.z_header=search_go&lang=en | $1.50 | http://www.mouser.com/Search/Refine.aspx?Keyword=RC0603JR-0710KL%20Yageo | $1.50
U402 | ST3232E | IC DRVR/RCVR RS232 ESD 16-TSSOP | TSSOP-16 | STMicroelectronics | ST3232ECTR | 50 | $0.79 | $39.35 | $43.30 | http://www.digikey.com/scripts/DkSearch/dksus.dll?WT.z_header=search_go&lang=en | $39.35
J802 | OPDRAIN_OUTB | BORNERA 5.08MM VERT 2 POS PCB | bornier2 | TE Connectivity | 796949-2 | 50 | $0.54 | $27.10 | $31.19 | http://www.digikey.com/scripts/DkSearch/dksus.dll?WT.z_header=search_go&lang=en | $29.50 | http://www.mouser.com/ProductDetail/TE-Connectivity/796949-2/ | $27.10
U1301 | 74HC244 | IC BUFF/DVR TRI-ST DUAL 20TSSOP | TSSOP-20 | NXP | 74HC244PW,112 | 50 | $0.36 | $18.05 | $19.05 | http://www.digikey.com/scripts/DkSearch/dksus.dll?WT.z_header=search_go&lang=en | $18.05
J604 | SPI | CONN HEADER .100" DUAL STR 80POS | PIN_ARRAY_3x2 | Sullins Connector Solutions | S2012EC-40-ND | 50 | $1.01 | $50.60 | $50.60 | http://www.digikey.com/scripts/DkSearch/dksus.dll?WT.z_header=search_go&lang=en | $121.00
FB901-FB904 | MMZ1608B601C | FERRITE CHIP 600 OHM 500MA 0603 | fb_0603 | TDK | MMZ1608B601C | 200 | $0.03 | $5.80 | $8.72 | http://www.digikey.com/scripts/DkSearch/dksus.dll?WT.z_header=search_go&lang=en | $5.80 | http://www.mouser.com/ProductDetail/TDK/MMZ1608B601C/ | $11.40
D1102 | MBRS540T3G | DIODE SCHOTTKY 40V 5A SMC | DO-214AB_SMC | ON Semiconductor | MBRS540T3G | 50 | $0.50 | $25.10 | $27.25 | http://www.digikey.com/scripts/DkSearch/dksus.dll?WT.z_header=search_go&lang=en | $25.10 | http://www.mouser.com/Search/Refine.aspx?Keyword=MBRS540T3G%20ON%20Semiconductor | $25.45
U1201 | LM358DG | IC OPAMP GP 1MHZ 8SOIC | SOIC-8 | ON Semiconductor | LM358DG | 50 | $0.21 | $10.60 | $17.55 | http://www.digikey.com/scripts/DkSearch/dksus.dll?WT.z_header=search_go&lang=en | $15.40 | http://www.mouser.com/ProductDetail/ON-Semiconductor/LM358DG/ | $10.60
J702 | DIG_INB | TERM BLOCK 5.08MM VERT 3POS PCB | bornier3 | TE Connectivity | 796949-3 | 50 | $0.88 | $44.00 | $54.33 | http://www.digikey.com/scripts/DkSearch/dksus.dll?WT.z_header=search_go&lang=en | $53.50 | http://www.mouser.com/ProductDetail/TE-Connectivity/796949-3/ | $44.00
D1101,D1109 | MURS360 | DIODE ULTRAFAST 600V 3A SMC | DO-214AB_SMC | ON Semiconductor | MURS360T3G | 100 | $0.33 | $33.10 | $43.68 | http://www.digikey.com/scripts/DkSearch/dksus.dll?WT.z_header=search_go&lang=en | $33.10 | http://www.mouser.com/Search/Refine.aspx?Keyword=MURS360T3G%20ON%20Semiconductor | $33.60
J804,J805 | RELAY_OUTB | TERM BLOCK 5.08MM VERT 3POS PCB | bornier3 | TE Connectivity | 796949-3 | 100 | $0.81 | $81.00 | $106.00 | http://www.digikey.com/scripts/DkSearch/dksus.dll?WT.z_header=search_go&lang=en | $101.00 | http://www.mouser.com/ProductDetail/TE-Connectivity/796949-3/ | $81.00
U501 | MIC2025-2YM | IC SINGLE CHANNEL POWER DISTRIBUTION SWITCH 500mA | SOIC-8 | MICREL | MIC2025-2YM | 50 | $0.67 | $33.50 | $34.00 | http://www.digikey.com/scripts/DkSearch/dksus.dll?WT.z_header=search_go&lang=en | $33.50 | http://www.mouser.com/ProductDetail/Microchip-Technology-Micrel/MIC2025-2YM/ | $47.75
TH603 | MF-USMF110-2 | FUSE RESETTABLE 1.10A 6V HLD SMD | ptc_1210 | Bourns | MF-USMF110-2 | 50 | $0.21 | $10.40 | $12.16 | http://www.digikey.com/scripts/DkSearch/dksus.dll?WT.z_header=search_go&lang=en | $12.60 | http://www.mouser.com/Search/Refine.aspx?Keyword=MF-USMF110-2%20Bourns | $10.40
C910-C914,C1001-C1003,C1005 | 100nF | CAP CER 0,1UF 16V 10% X7R 0603 | c_0603 | Kemet | C0603C104K4RACTU | 450 | $0.01 | $3.15 | $3.65 | http://www.digikey.com/scripts/DkSearch/dksus.dll?WT.z_header=search_go&lang=en | $3.15 | http://www.mouser.com/ProductDetail/Kemet/C0603C104K4RACTU/ | $3.60
C901-C904 | 1nF | CAP CER 1000PF 50V 10% X7R 0603 | c_0603 | Kemet | C0603C102K5RACTU | 200 | $0.01 | $1.60 | $2.20 | http://www.digikey.com/scripts/DkSearch/dksus.dll?WT.z_header=search_go&lang=en | $1.60 | http://www.mouser.com/ProductDetail/Kemet/C0603C102K5RACTU/?qs=sGAEpiMZZMs0AnBnWHyRQI7HfOv1V98Mz5yd65dk19I%3D | $2.00
C805-C808 | 1uF | CAP CER 1UF 16V 10% X7R 0603 | c_0603 | Kemet | C0603C105K4RACTU | 200 | $0.03 | $6.60 | $13.86 | http://www.digikey.com/scripts/DkSearch/dksus.dll?WT.z_header=search_go&lang=en | $14.00 | http://www.mouser.com/ProductDetail/Kemet/C0603C105K4RACTU/ | $6.60
TH401,TH402 | USMF020 | FUSE RESETTABLE .20A 30V HLD SMD | ptc_1210 | Bourns | MF-USMF020-2 | 100 | $0.21 | $21.40 | $22.64 | http://www.digikey.com/scripts/DkSearch/dksus.dll?WT.z_header=search_go&lang=en | $23.40 | http://www.mouser.com/Search/Refine.aspx?Keyword=MF-USMF020-2%20Bourns | $21.40
G102 | LOGO_CIAA | LOGO CIAA | LOGO-CIAA |  |  | 50 | $0.00 | $0.00
R1009 | 750k | RES 750K OHM 1/10W 5% 0603 SMD | r_0603 | Yageo | RC0603JR-07750KL | 50 | $0.01 | $0.40 | $0.40 | http://www.digikey.com/scripts/DkSearch/dksus.dll?WT.z_header=search_go&lang=en | $0.40
C302,C304-C307,C310,C312,C314,C315,C317,C801-C804 | 100nF | CAP CER 0,1UF 16V 10% X7R 0603 | c_0603 | Kemet | C0603C104K4RACTU | 700 | $0.01 | $4.86 | $4.86 | http://www.digikey.com/scripts/DkSearch/dksus.dll?WT.z_header=search_go&lang=en | $4.90 | http://www.mouser.com/ProductDetail/Kemet/C0603C104K4RACTU/ | $5.60
U1303 | 93C56 | IC EEPROM 1KBIT 2MHZ 8SOIC | SOIC-8 | ATMEL | AT93C46DN-SH-B | 50 | $0.23 | $11.62 | $11.62 | http://www.digikey.com/scripts/DkSearch/dksus.dll?WT.z_header=search_go&lang=en |  | http://www.mouser.com/ProductDetail/Atmel/AT93C46DN-SH-B/?qs=sGAEpiMZZMuVhdAcoizlRQCaxkOsAon3BDCZyNl1pHY%3D | $11.65
R402,R403 | 4K7 | RES 4.7K OHM 1/10W 5% 0603 SMD | r_0603 | Yageo | RC0603JR-074K7L | 100 | $0.003 | $0.30 | $0.44 | http://www.digikey.com/scripts/DkSearch/dksus.dll?WT.z_header=search_go&lang=en | $0.30 | http://www.mouser.com/Search/Refine.aspx?Keyword=RC0603JR-074K7L%20Yageo | $0.40
C231 | 10uF | CAP TANT 10UF 6.3V 10% | c_1206POL | Kemet | T491A106K006AT7280 | 50 | $0.20 | $10.20 |  |  | $10.20
U201 | MK60FX512VLQ15 | MCU ARM 512KB FLASH | LQFP144 | Freescale Semiconductor | MCIMX6D5EYM10AC | 50 | $12.75 | $637.60 | $637.60 | http://www.digikey.com/scripts/DkSearch/dksus.dll?WT.z_header=search_go&lang=en | $1864.00 | http://www.mouser.com/ProductDetail/NXP-Freescale/MCIMX6D5EYM10AC/ | $1950.50
J403 | CAN | TERM BLOCK 5.08MM VERT 3POS PCB | bornier3 | TE Connectivity | 796949-3 | 50 | $0.88 | $44.00 | $54.33 | http://www.digikey.com/scripts/DkSearch/dksus.dll?WT.z_header=search_go&lang=en | $53.50 | http://www.mouser.com/ProductDetail/TE-Connectivity/796949-3/ | $44.00
TH1201 | MF-USMF005-2 | FUSE RESETTABLE .05A 30V HLD SMD | ptc_1210 | Bourns | MF-USMF005-2 | 50 | $0.24 | $12.16 | $12.16 | http://www.digikey.com/scripts/DkSearch/dksus.dll?WT.z_header=search_go&lang=en | $12.60 | http://www.mouser.com/Search/Refine.aspx?Keyword=MF-USMF005-2%20Bourns | $13.40
R701-R708 | 4,7K 1/4W | RES 4.7K OHM 1/4W 5% 1206 SMD | r_1206 | Yageo | RC1206JR-074K7L | 400 | $0.01 | $2.80 | $3.01 | http://www.digikey.com/scripts/DkSearch/dksus.dll?WT.z_header=search_go&lang=en | $2.80 | http://www.mouser.com/Search/Refine.aspx?Keyword=RC1206JR-074K7L%20Yageo | $2.80
D1105 | LED +5V | LED ALG RED WTR CLR 0603 SMD | LED-0603 | Everlight Electronics Co Ltd | QTLP600C7TR | 50 | $0.23 | $11.38 | $11.38
J801 | OPDRAIN_OUTA | BORNERA 5.08MM VERT 2 POS PCB | bornier2 | TE Connectivity | 796949-2 | 50 | $0.54 | $27.10 | $31.19 | http://www.digikey.com/scripts/DkSearch/dksus.dll?WT.z_header=search_go&lang=en | $29.50 | http://www.mouser.com/ProductDetail/TE-Connectivity/796949-2/ | $27.10
D601-D607,D609,D611,D612,D614-D622,D624,D626,D627,D629-D632,D901-D904 | BAV199 | DIODE ARRAY 70V 215MA SOT23 | SOT-23 | ON Semiconductor | BAV199LT1G | 1500 | $0.05 | $79.50 | $81.66 | http://www.digikey.com/product-detail/en/on-semiconductor/BAV199LT1G/BAV199LT1GOSCT-ND/917816 | $79.50 | http://www.mouser.com/ProductDetail/ON-Semiconductor/BAV199LT1G/ | $82.50
R205 | 22 | RES 22 OHM 1/10W 5% | r_0603 | Yageo | RC0603JR-0722RL | 50 | $0.01 | $0.35 | $0.40 | http://www.digikey.com/scripts/DkSearch/dksus.dll?WT.z_header=search_go&lang=en | $0.40 | http://www.mouser.com/Search/Refine.aspx?Keyword=RC0603JR-0722RL%20Yageo | $0.35
Q1202 | PBSS5240XF | TRANS PNP 40V 2A SOT89 | SOT-89 | NXP Semiconductors | PBSS5240XF | 50 | $0.26 | $13.20 | $14.60 | http://www.digikey.com/scripts/DkSearch/dksus.dll?WT.z_header=search_go&lang=en | $13.20
R201,R202 | 2K2 | RES 2.2K OHM 1/10W 5% | r_0603 | Yageo | RC0603JR-072K2L | 100 | $0.003 | $0.30 | $0.44 | http://www.digikey.com/scripts/DkSearch/dksus.dll?WT.z_header=search_go&lang=en | $0.30 | http://www.mouser.com/Search/Refine.aspx?Keyword=RC0603JR-072K2L%20Yageo | $0.50
U801-U804 | MCP1416T | IC MOSFET DVR 1.5A HS SOT23-5 | SOT-23-5 | Microchip | MCP1416T-E/OT | 200 | $0.46 | $92.60 | $94.00 | http://www.digikey.com/scripts/DkSearch/dksus.dll?WT.z_header=search_go&lang=en | $92.60 | http://www.mouser.com/Search/Refine.aspx?Keyword=MCP1416T-E%2FOT%20Microchip | $109.60
R1312 | 2K2 | RES 2.2K OHM 1/10W 5% 0603 SMD | r_0603 | Yageo | RC0603JR-072K2L | 50 | $0.01 | $0.40 | $0.40 | http://www.digikey.com/scripts/DkSearch/dksus.dll?WT.z_header=search_go&lang=en | $0.40 | http://www.mouser.com/Search/Refine.aspx?Keyword=RC0603JR-072K2L%20Yageo | $0.40
D203 | ST2 | LED ALG RED WTR CLR 0603 SMD | LED-0603 | Everlight Electronics Co Ltd | QTLP600C7TR | 50 | $0.23 | $11.38 | $11.38
R306,R316,R810-R813 | 4K7 | RES 4,7K OHM 1/10W 5% 0603 SMD | r_0603 | Yageo | RC0603JR-074K7L | 300 | $0.003 | $0.90 | $1.01 | http://www.digikey.com/scripts/DkSearch/dksus.dll?WT.z_header=search_go&lang=en | $0.90 | http://www.mouser.com/Search/Refine.aspx?Keyword=RC0603JR-074K7L%20Yageo | $0.90
C1102 | 330uF | CAP ALUM 330UF 25V 20% SMD | c_elec_8x10 | Nichicon | UCW1E331MNL1GS | 50 | $0.42 | $21.20 | $21.22 | http://www.digikey.com/scripts/DkSearch/dksus.dll?WT.z_header=search_go&lang=en | $21.20
R409 | 4K7 | RES 4.7K OHM 1/10W 5% 0603 SMD | r_0603 | Yageo | RC0603JR-074K7L | 50 | $0.01 | $0.35 | $0.40 | http://www.digikey.com/scripts/DkSearch/dksus.dll?WT.z_header=search_go&lang=en | $0.40 | http://www.mouser.com/Search/Refine.aspx?Keyword=RC0603JR-074K7L%20Yageo | $0.35
D1001 | SD CARD | LED GRN WATER CLEAR 0603 SMD | LED-0603 | Everlight Electronics Co Ltd | QTLP600C4TR | 50 | $0.28 | $14.04 | $14.04
U202,U1305 | SI501 | OSC MEMS 12.000MHZ CMOS SMD | SI501_C | Silicon Laboratories | 501HCA12M0000CAG | 100 | $0.79 | $78.70 | $97.60 | http://www.digikey.com/scripts/DkSearch/dksus.dll?WT.z_header=search_go&lang=en | $78.70
U1001 | S25FL032P0XMFI013 | IC NOR FLASH 32MBIT 104MHZ | SOIC-8_WIDE | Spansion Inc. | S25FL032P0XMFI013 | 50 | $1.77 | $88.50 |  |  | $99.00 | http://www.mouser.com/ProductDetail/Cypress-Semiconductor/S25FL032P0XMFI013/ | $88.50
R905-R908 | 237 | RES 237 OHM 1/10W .1% 0603 SMD | r_0603 | Panasonic Electronic Components | ERA-3AEB2370V | 200 | $0.10 | $21.00 | $38.48 | http://www.digikey.com/scripts/DkSearch/dksus.dll?WT.z_header=search_go&lang=en | $21.00
R407 | 220 | RES 220 OHM 1/10W 5% 0603 SMD | r_0603 | Yageo | RC0603JR-07220RL | 50 | $0.01 | $0.35 | $0.40 | http://www.digikey.com/scripts/DkSearch/dksus.dll?WT.z_header=search_go&lang=en | $0.40 | http://www.mouser.com/Search/Refine.aspx?Keyword=RC0603JR-07220RL%20Yageo | $0.35
C1004 | 10uF | CAP TANT 10UF 6.3V 10% 1206 | c_1206POL | Kemet | T491A106K006AT7280 | 50 | $0.20 | $10.20 |  |  | $10.20
R314,R315 | 270 | RES 270 OHM 1/10W 5% 0603 SMD | r_0603 | Yageo | RC0603JR-07270RL | 100 | $0.003 | $0.30 | $0.44 | http://www.digikey.com/scripts/DkSearch/dksus.dll?WT.z_header=search_go&lang=en | $0.30 | http://www.mouser.com/Search/Refine.aspx?Keyword=RC0603JR-07270RL%20Yageo | $0.40
R501,R502 | 10k | RESISTOR 10k 1/10W 5% 0603 | r_0603 | Yageo | RC0603JR-0710KL | 100 | $0.003 | $0.30 | $0.44 | http://www.digikey.com/scripts/DkSearch/dksus.dll?WT.z_header=search_go&lang=en | $0.30 | http://www.mouser.com/Search/Refine.aspx?Keyword=RC0603JR-0710KL%20Yageo | $0.40
C309 | 100pF | CAP CER 100PF 50V 10% X7R 0603 | c_0603 | Kemet | C0603C101K5RACTU | 50 | $0.10 | $4.95 | $5.00 | http://www.digikey.com/scripts/DkSearch/dksus.dll?WT.z_header=search_go&lang=en | $4.95
J701 | DIG_INA | TERM BLOCK 5.08MM VERT 3POS PCB | bornier3 | TE Connectivity | 796949-3 | 50 | $0.88 | $44.00 | $54.33 | http://www.digikey.com/scripts/DkSearch/dksus.dll?WT.z_header=search_go&lang=en | $53.50 | http://www.mouser.com/ProductDetail/TE-Connectivity/796949-3/ | $44.00
U403 | AMIS42665TJAA1RG | TRANSCEIVER CAN HS LO PWR 8-SOIC | SOIC-8 | ON Semiconductor | AMIS42665TJAA1RG | 50 | $0.97 | $48.35 | $53.20 | http://www.digikey.com/scripts/DkSearch/dksus.dll?WT.z_header=search_go&lang=en | $48.35 | http://www.mouser.com/Search/Refine.aspx?Keyword=AMIS42665TJAA1RG%20ON%20Semiconductor | $49.00
R1205 | 24.9 | RES 24.9 OHM 1/10W .1% SMD 0603 | r_0603 | Yageo | RT0603BRD0724R9L | 50 | $0.06 | $2.79 | $2.79
D701-D708,D802,D804,D806,D808-D812 | LED red | LED ALG RED WTR CLR 0603 SMD | LED-0603 | Everlight Electronics Co Ltd | QTLP600C7TR | 800 | $0.09 | $73.92 | $73.92
R1204 | 2.2k | RES 2.2K OHM 1/10W 5% 0603 SMD | r_0603 | Yageo | RC0603JR-072K2L | 50 | $0.01 | $0.40 | $0.40 | http://www.digikey.com/scripts/DkSearch/dksus.dll?WT.z_header=search_go&lang=en | $0.40 | http://www.mouser.com/Search/Refine.aspx?Keyword=RC0603JR-072K2L%20Yageo | $0.40
