ciaa/Hardware/PCB/EDU-XILINX/UserGuides/xtp306-MIG-IP-7-Series-Design-Checklist.xlsx

Sheet: Title & Project Page
 |  | MIG 7 Series Design Checklist
 |  | XTP306 -- Revision 1.0.3
 |  | Release 2014.2
Instructions: |  | Review the items in each section to ensure that you have followed the MIG IP design rules. Read the appropriate sections of the UG 586 for more information about any of the issues.
Customer Design Information
Customer name:
Design Project Name:
Project Revision:
Date:
Key Contacts:
Notes:
 |  | Xilinx, Inc. Xilinx, the Xilinx logo, Artix, ISE, Kintex, Spartan, Virtex, Vivado, Zynq, and other designated brands included herein are trademarks of Xilinx in the United States and other countries. All other trademarks are the property of their respective owners.
 |  | DISCLAIMER
 |  | The information disclosed to you hereunder (the “Materials”) is provided solely for the selection and use of Xilinx products. To the maximum extent permitted by applicable law: (1) Materials are made available "AS IS" and with all faults, Xilinx hereby DISCLAIMS ALL WARRANTIES AND CONDITIONS, EXPRESS, IMPLIED, OR STATUTORY, INCLUDING BUT NOT LIMITED TO WARRANTIES OF MERCHANTABILITY, NON-INFRINGEMENT, OR FITNESS FOR ANY PARTICULAR PURPOSE; and (2) Xilinx shall not be liable (whether in contract or tort, including negligence, or under any other theory of liability) for any loss or damage of any kind or nature related to, arising under, or in connection with, the Materials (including your use of the Materials), including for any direct, indirect, special, incidental, or consequential loss or damage (including loss of data, profits, goodwill, or any type of loss or damage suffered as a result of any action brought by a third party) even if such damage or loss was reasonably foreseeable or Xilinx had been advised of the possibility of the same. Xilinx assumes no obligation to correct any errors contained in the Materials or to notify you of updates to the Materials or to product specifications. You may not reproduce, modify, distribute, or publicly display the Materials without prior written consent. Certain products are subject to the terms and conditions of Xilinx’s limited warranty, please refer to Xilinx’s Terms of Sale which can be viewed at http://www.xilinx.com/legal.htm#tos; IP cores may be subject to war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
Revision History
Date | Revision |  | Software Release
2013-10-24 | 1.0.2 |  | 2013.3
2014-07-10 | 1.0.3 |  | 2014.2

Sheet: 1.0 DDR3_DDR2 IP Def.&Generate
Core Definition and Generation for DDR3 and DDR2
ID | Description and Actions to Take | Links to Relevant Information | More Details | Status and Notes
1.1 | Xilinx Documentation and Training
1.1.1 | Read Users Guides and Datasheets
 | 7 Series FPGA Memory Interface User Guide - UG586 | MIG 7 Series Documentation (http://www.xilinx.com/support/index.html/content/xilinx/en/supportNav/ip_documentation/memory_interface_and_storage_element/memory_interface_and_controller/mi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)
 | 7 Series FPGA Memory Interface Data Sheet - DS176 | MIG 7 Series Documentation (http://www.xilinx.com/support/index.html/content/xilinx/en/supportNav/ip_documentation/memory_interface_and_storage_element/memory_interface_and_controller/mi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)
 | 7 Series FPGA AC and DC Switching Characteristics Datasheets. Includes memory interface performance specifications by device and package - See Maximum Physical Interface (PHY) Rate for Memory Interfaces. | 7 Series Data Sheets > Select the appropriate DC and AC Switching Characteristics datasheet (http://www.xilinx.com/cgi-bin/search/support.pl?proxystylesheet=support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) | Maximum data rate is based on the device, package, I/O column and target memory interface. The DC and AC Switching Characteristics datasheet and the MIG 7 Series tool include the correct limits.
1.1.2 | Check the Xilinx MIG Solution Center | Xilinx Answer 34243 (http://www.xilinx.com/support/answers/34243.html) | Whether starting a new design with MIG or troubleshooting a problem, use the MIG Solution Center to guide you to the right information
 | Design Assistant | Xilinx Answer 51313 (http://www.xilinx.com/support/answers/51313.html) | Helpful design and debug information for MIG 7 Series
 | Top Issues | Xilinx Answer 46227 (http://www.xilinx.com/support/answers/46227.html) | Browse through common questions on MIG 7 Series
1.1.3 | Read MIG 7 Series Release Notes |  | Includes release information as well as known and resolved issues per release.
 | ISE MIG 7 Series Releases (Includes Vivado 2012.4 and earlier) | Xilinx Answer 45195 (http://www.xilinx.com/support/answers/45195.html)
 | Vivado MIG 7 Series Releases (Starting with Vivado 2013.1) | Xilinx Answer 54025 (http://www.xilinx.com/support/answers/54025.html)
1.1.4 | Read Device and IP Notifications
 | Have you subscribed to appropriate Design Advisories? | Xilinx Answer 18683 (http://www.xilinx.com/support/answers/18683.htm)
 | MIG Design Advisories - See issues that are important to designs currently in progress | Xilinx Answer 33566 (http://www.xilinx.com/support/answers/33566.html)
1.1.5 | See Video Demonstrations and White Papers | http://www.xilinx.com/products/technology/memory-interfacing/index.htm
1.2 | Understand Core Generation
1.2.1 | Using the MIG 7 Series Tool | UG586 > DDR3/DDR2 > Getting Started (http://www.xilinx.com/cgi-bin/docs/ipdoc?c=mig_7series;v=latest;d=ug586_7Series_MIS.pdf)
 | Create Design | UG586 > DDR3/DDR2 > Getting Started (http://www.xilinx.com/cgi-bin/docs/ipdoc?c=mig_7series;v=latest;d=ug586_7Series_MIS.pdf)
 | Pin Compatible FPGAs - Use to create UCF/XDC files for compatible FPGAs | UG586 > DDR3/DDR2 > Getting Started (http://www.xilinx.com/cgi-bin/docs/ipdoc?c=mig_7series;v=latest;d=ug586_7Series_MIS.pdf)
 | NOTE: Available max data rate may be reduced in pin compatible designs due to inabilty to meet the trace matching requirements | See 2.1 PCB Layout Requirements
 | Memory Selection - Select the target memory standard | UG586 > DDR3/DDR2 > Getting Started (http://www.xilinx.com/cgi-bin/docs/ipdoc?c=mig_7series;v=latest;d=ug586_7Series_MIS.pdf)
 | Controller Option - Configure the memory interface | UG586 > DDR3/DDR2 > Getting Started (http://www.xilinx.com/cgi-bin/docs/ipdoc?c=mig_7series;v=latest;d=ug586_7Series_MIS.pdf) | MIG supports up to 72-bit interfaces
 | Create Custom Part - Use when the desired memory part is not selectable in the MIG 7 Series tool. | UG586 > DDR3/DDR2 > Getting Started (http://www.xilinx.com/cgi-bin/docs/ipdoc?c=mig_7series;v=latest;d=ug586_7Series_MIS.pdf) | Customize a base part to meet the target part's datasheet requirements.
 | Memory Options - Customize how the controller interfaces with the memory | UG586 > DDR3/DDR2 > Getting Started (http://www.xilinx.com/cgi-bin/docs/ipdoc?c=mig_7series;v=latest;d=ug586_7Series_MIS.pdf)
 | FPGA Options | UG586 > DDR3/DDR2 > Getting Started (http://www.xilinx.com/cgi-bin/docs/ipdoc?c=mig_7series;v=latest;d=ug586_7Series_MIS.pdf)
 | Define the clocking structure for the memory interface | 1.3 Clocks
 | Set the Reset Polarity | 1.4 Resets
 | Debug Signals - Enable to use the provided Chipscope debug cores for calibration failure and data error debug. | 5.0 Hardware Debug
 | Internal Vref - Supported below 800Mbps | UG586 > DDR3/DDR2 Design Guidelines (http://www.xilinx.com/cgi-bin/docs/ipdoc?c=mig_7series;v=latest;d=ug586_7Series_MIS.pdf)
 | IO Power Reduction - Enabled by default to reduce the average IO power | UG586 > DDR3/DDR2 > Getting Started (http://www.xilinx.com/cgi-bin/docs/ipdoc?c=mig_7series;v=latest;d=ug586_7Series_MIS.pdf) | Disables the DQ/DQS IBUF and internal termination during writes and idle periods
 | XADC Instantiation | UG586 > DDR3/DDR2 > Getting Started (http://www.xilinx.com/cgi-bin/docs/ipdoc?c=mig_7series;v=latest;d=ug586_7Series_MIS.pdf)
 | Extended FPGA Options | UG586 > DDR3/DDR2 > Getting Started (http://www.xilinx.com/cgi-bin/docs/ipdoc?c=mig_7series;v=latest;d=ug586_7Series_MIS.pdf)
 | IO Planning Options | UG586 > DDR3/DDR2 > Getting Started (http://www.xilinx.com/cgi-bin/docs/ipdoc?c=mig_7series;v=latest;d=ug586_7Series_MIS.pdf)
 | New Design - Use for new boards where pin locations are not yet defined. | UG586 > DDR3/DDR2 > Getting Started (http://www.xilinx.com/cgi-bin/docs/ipdoc?c=mig_7series;v=latest;d=ug586_7Series_MIS.pdf)
 | Fixed Pin-Out - Use for boards where pin locations are defined. Manually entering pins or uploading a UCF/XDC are both supported. | UG586 > DDR3/DDR2 > Getting Started (http://www.xilinx.com/cgi-bin/docs/ipdoc?c=mig_7series;v=latest;d=ug586_7Series_MIS.pdf)
 | DRC check ensures pin/bank rules are followed | UG586 > DDR3/DDR2 Design Guidelines (http://www.xilinx.com/cgi-bin/docs/ipdoc?c=mig_7series;v=latest;d=ug586_7Series_MIS.pdf)
 | Bank Selection - Use to select the banks and byte groups for the memory interface signal groups | UG586 > DDR3/DDR2 > Getting Started (http://www.xilinx.com/cgi-bin/docs/ipdoc?c=mig_7series;v=latest;d=ug586_7Series_MIS.pdf)
 | DRC check ensures pin/bank rules are followed | UG586 > DDR3/DDR2 Design Guidelines (http://www.xilinx.com/cgi-bin/docs/ipdoc?c=mig_7series;v=latest;d=ug586_7Series_MIS.pdf)
 | System Signals Selection | UG586 > DDR3/DDR2 > Getting Started (http://www.xilinx.com/cgi-bin/docs/ipdoc?c=mig_7series;v=latest;d=ug586_7Series_MIS.pdf)
 | System and Reference Clocks | 2.2.3 Clock Pin Planning
 | Status Signals - May be connected internally or driven to an external IO | UG586 > DDR3/DDR2 > Getting Started (http://www.xilinx.com/cgi-bin/docs/ipdoc?c=mig_7series;v=latest;d=ug586_7Series_MIS.pdf)
 | Verify Pin Changes and Update Design - Use to verify any pin changes and generate an updated design to match the new pin-out. Additionally, use to upgrade a MIG 7 Series IP to a newer release. | UG586 > DDR3/DDR2 > Getting Started (http://www.xilinx.com/cgi-bin/docs/ipdoc?c=mig_7series;v=latest;d=ug586_7Series_MIS.pdf)
 |  | UG586 > DDR3/DDR2 Design Guidelines (http://www.xilinx.com/cgi-bin/docs/ipdoc?c=mig_7series;v=latest;d=ug586_7Series_MIS.pdf)
1.3 | Understand Clocks
1.3.1 | Check Clocking Requirements | Xilinx Answer 40603 (http://www.xilinx.com/support/answers/40603.htm)
1.3.2 | Clocking Architecture | UG586 > DDDR3/DDR2 > Core Architecture > Clocking Architecture (http://www.xilinx.com/cgi-bin/docs/ipdoc?c=mig_7series;v=latest;d=ug586_7Series_MIS.pdf)
1.3.3 | Clocking Parameters and RTL | UG586 > DDR3/DDR2 > Customizing the Core (http://www.xilinx.com/cgi-bin/docs/ipdoc?c=mig_7series;v=latest;d=ug586_7Series_MIS.pdf)
 | All clock parameters are set based on the MIG 7 Series tool settings. Items such as the frequencies of the input and clocks, how the IDELYCTRL reference clock is generated, etc. Changes to the clocking should be done through the MIG 7 Series tool and not by making manual changes to these parameters.
 | Clock pin and placement planning | See 2.2.3 Clock Pin Planning and 2.2.4 Clock Resource Planning
1.4 | Understand Resets
1.4.1 | System Reset (sys_rst) - Used to reset the MIG 7 Series core and restart initialization and calibration |  | Asynchronous assertion. Synchronous deassertion
 | Can be internally or externally generated
 | Can be selected through the MIG 7 Series tool as either active high or active low. Drives top level rtl parameter RST_ACT_LOW (1=Active Low; 0=Active High) | UG586 > DDR3/DDR2 > Customizing the Core (http://www.xilinx.com/cgi-bin/docs/ipdoc?c=mig_7series;v=latest;d=ug586_7Series_MIS.pdf)
 | Reset synchronization handled within MIG 7 Series rtl | Generated Design Directory = core_name/user_design/rtl/clocking/mig_7series_vx_x_infrastructure.v
1.4.2 | ui_clk_sync_rst - User Interface Active High Reset. Synchronous to ui_clk (User Interface Clock). | UG586 > DDR3/DDR2 > Core Architecture > User Interface (http://www.xilinx.com/cgi-bin/docs/ipdoc?c=mig_7series;v=latest;d=ug586_7Series_MIS.pdf)
1.4.3 | RESET_N - DDR3 Reset | 2.0 Pin and Board Planning
1.5 | Understand XADC and Temperature Monitor
1.5.1 | The XADC block is a required part of the temperature monitor system which keeps the read DQS centered in the read DQ window across temperature drift | UG586 > DDR3/DDR2 > Core Architecture > PHY (http://www.xilinx.com/cgi-bin/docs/ipdoc?c=mig_7series;v=latest;d=ug586_7Series_MIS.pdf)
 | MIG 7 Series can instantiate the XADC or, if the user design already includes the XADC, receive the device temperature on a device_temp input to the MIG 7 Series core | Xilinx Answer 51867 (http://www.xilinx.com/support/answers/51687.html)
1.6 | Understand Top-Level RTL Parameters
1.6.1 | The MIG 7 Series lower level rtl source files do not change. The options selected within the MIG 7 Series tool are used to set top-level rtl parameters to properly configure the lower level rtl source code. For information on these parameters, reference the relevant documenation. | UG586 > DDR3/DDR2 > Customizing the Core (http://www.xilinx.com/cgi-bin/docs/ipdoc?c=mig_7series;v=latest;d=ug586_7Series_MIS.pdf)
1.7 | Understand PHY Only Support
1.7.1 | Usage of the MIG 7 Series PHY independently is supported.
 | The MIG 7 Series tool will always generate the full design with controller and user interface included. The PHY rtl is broken out for independent usage. | Generated Design Directory = core_name/user_design/rtl/phy
 | Full documentation on the PHY only solution is available. | UG586 > DDR3/DDR2 > Interfacing to the Core > Physical Layer Interface (http://www.xilinx.com/cgi-bin/docs/ipdoc?c=mig_7series;v=latest;d=ug586_7Series_MIS.pdf)

Sheet: 1.1 QDRII+IP Def&Generate
Core Definition and Generation for QDR II+
ID | Description and Actions to Take | Links to Relevant Information | More Details | Status and Notes
1.1 | Xilinx Documentation and Training
1.1.1 | Read Users Guides and Datasheets
 | 7 Series FPGA Memory Interface User Guide - UG586 | MIG 7 Series Documentation (http://www.xilinx.com/support/index.html/content/xilinx/en/supportNav/ip_documentation/memory_interface_and_storage_element/memory_interface_and_controller/mi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)
 | 7 Series FPGA Memory Interface Data Sheet - DS176 | MIG 7 Series Documentation (http://www.xilinx.com/support/index.html/content/xilinx/en/supportNav/ip_documentation/memory_interface_and_storage_element/memory_interface_and_controller/mi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)
 | 7 Series FPGA AC and DC Switching Characteristics Datasheets. Includes memory interface performance specifications by device - See Maximum Physical Interface (PHY) Rate for Memory Interfaces. | 7 Series Data Sheets > Select the appropriate DC and AC Switching Characteristics datasheet (http://www.xilinx.com/cgi-bin/search/support.pl?proxystylesheet=support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)
1.1.2 | Check Xilinx MIG Solution Center | Xilinx Answer 34243 (http://www.xilinx.com/support/answers/34243.html)
 | Design Assistant - Helpful design and debug information for MIG 7 Series | Xilinx Answer 51313 (http://www.xilinx.com/support/answers/51313.html)
 | Top Issues - Browse through common questions on MIG 7 Series | Xilinx Answer 46227 (http://www.xilinx.com/support/answers/46227.html)
 | Design Advisories - See issues that are important to designs currently in progress | Xilinx Answer 33566 (http://www.xilinx.com/support/answers/33566.html)
1.1.3 | Read MIG 7 Series Release Notes
 | ISE MIG 7 Series Releases (Includes Vivado 2012.4 and earlier) | Xilinx Answer 45195 (http://www.xilinx.com/support/answers/45195.html)
 | Vivado MIG 7 Series Releases (Starting with Vivado 2013.1) | Xilinx Answer 54025 (http://www.xilinx.com/support/answers/54025.html)
1.1.4 | Read Device and IP Notifications
 | Have you subscribed to appropriate Design Advisories? | http://www.xilinx.com/support/myalerts
 | MIG Design Advisories - See issues that are important to designs currently in progress | Xilinx Answer 33566 (http://www.xilinx.com/support/answers/33566.html)
1.1.5 | See Video Demonstrations and White Papers | http://www.xilinx.com/products/technology/memory-interfacing/index.htm
1.2 | Understand Core Generation
1.2.1 | Using the MIG 7 Series Tool | UG586 > QDRII+ > Getting Started (http://www.xilinx.com/cgi-bin/docs/ipdoc?c=mig_7series;v=latest;d=ug586_7Series_MIS.pdf)
 | Create Design | UG586 > QDRII+ > Getting Started (http://www.xilinx.com/cgi-bin/docs/ipdoc?c=mig_7series;v=latest;d=ug586_7Series_MIS.pdf)
 | Pin Compatible FPGAs - Use to create UCF/XDC files for compatible FPGAs | UG586 > QDRII+ > Getting Started (http://www.xilinx.com/cgi-bin/docs/ipdoc?c=mig_7series;v=latest;d=ug586_7Series_MIS.pdf)
 | NOTE: Available max data rate may be reduced in pin compatible designs due to inabilty to meet the trace matching requirements | See 2.1 PCB Layout Requirements
 | Memory Selection - Select the target memory standard | UG586 > QDRII+ > Getting Started (http://www.xilinx.com/cgi-bin/docs/ipdoc?c=mig_7series;v=latest;d=ug586_7Series_MIS.pdf)
 | Controller Option - Configure the memory interface | UG586 > QDRII+ > Getting Started (http://www.xilinx.com/cgi-bin/docs/ipdoc?c=mig_7series;v=latest;d=ug586_7Series_MIS.pdf)
 | Create Custom Part - Use when the desired memory part is not selectable in the MIG 7 Series tool. | UG586 > QDRII+ > Getting Started (http://www.xilinx.com/cgi-bin/docs/ipdoc?c=mig_7series;v=latest;d=ug586_7Series_MIS.pdf) | Customize a base part to meet the target part's datasheet requirements.
 | Memory Options - Customize how the controller interfaces with the memory | UG586 > QDRII+ > Getting Started (http://www.xilinx.com/cgi-bin/docs/ipdoc?c=mig_7series;v=latest;d=ug586_7Series_MIS.pdf)
 | FPGA Options | UG586 > QDRII+ > Getting Started (http://www.xilinx.com/cgi-bin/docs/ipdoc?c=mig_7series;v=latest;d=ug586_7Series_MIS.pdf)
 | Define the clocking structure for the memory interface | 1.3 Clocks
 | Set the Reset Polarity | 1.4 Resets
 | Debug Signals - Enable to use the provided Chipscope debug cores for calibration failure and data error debug. | 5.0 Hardware Debug
 | Internal Vref - Supported below 400MHz | UG586 > QDRII+ > Getting Started (http://www.xilinx.com/cgi-bin/docs/ipdoc?c=mig_7series;v=latest;d=ug586_7Series_MIS.pdf)
 | Extended FPGA Options | UG586 > QDRII+ > Getting Started (http://www.xilinx.com/cgi-bin/docs/ipdoc?c=mig_7series;v=latest;d=ug586_7Series_MIS.pdf)
 | IO Planning Options | UG586 > QDRII+ > Getting Started (http://www.xilinx.com/cgi-bin/docs/ipdoc?c=mig_7series;v=latest;d=ug586_7Series_MIS.pdf)
 | New Design - Use for new boards where pin locations are not yet defined. | UG586 > QDRII+ > Getting Started (http://www.xilinx.com/cgi-bin/docs/ipdoc?c=mig_7series;v=latest;d=ug586_7Series_MIS.pdf)
 | Fixed Pin-Out - Use for boards where pin locations are defined. Manually entering pins or uploading a UCF/XDC are both supported. | UG586 > QDRII+ > Getting Started (http://www.xilinx.com/cgi-bin/docs/ipdoc?c=mig_7series;v=latest;d=ug586_7Series_MIS.pdf)
 | DRC check ensures pin/bank rules are followed | UG586 > QDRII+ > Design Guidelines (http://www.xilinx.com/cgi-bin/docs/ipdoc?c=mig_7series;v=latest;d=ug586_7Series_MIS.pdf)
 | Bank Selection - Use to select the banks and byte groups for the memory interface signal groups | UG586 > QDRII+ > Getting Started (http://www.xilinx.com/cgi-bin/docs/ipdoc?c=mig_7series;v=latest;d=ug586_7Series_MIS.pdf)
 | DRC check ensures pin/bank rules are followed | UG586 > QDRII+ > Design Guidelines (http://www.xilinx.com/cgi-bin/docs/ipdoc?c=mig_7series;v=latest;d=ug586_7Series_MIS.pdf)
 | System Signals Selection | UG586 > QDRII+ > Getting Started (http://www.xilinx.com/cgi-bin/docs/ipdoc?c=mig_7series;v=latest;d=ug586_7Series_MIS.pdf)
 | System and Reference Clocks | 2.2.2 Clock Pin Planning
 | Status Signals - May be connected internally or driven to an external IO | UG586 > QDRII+ > Getting Started (http://www.xilinx.com/cgi-bin/docs/ipdoc?c=mig_7series;v=latest;d=ug586_7Series_MIS.pdf)
 | Verify Pin Changes and Update Design - Use to verify any pin changes and generate an updated design to match the new pin-out. Additionally, use to upgrade a MIG 7 Series IP to a newer release. | UG586 > QDRII+ > Getting Started (http://www.xilinx.com/cgi-bin/docs/ipdoc?c=mig_7series;v=latest;d=ug586_7Series_MIS.pdf)
 |  | UG586 > QDRII+ > Design Guidelines (http://www.xilinx.com/cgi-bin/docs/ipdoc?c=mig_7series;v=latest;d=ug586_7Series_MIS.pdf)
1.3 | Understand Clocks
1.3.1 | Clocking Requirements | UG586 > QDRII+ Design Guidelines > Pinout Requirements (http://www.xilinx.com/cgi-bin/docs/ipdoc?c=mig_7series;v=latest;d=ug586_7Series_MIS.pdf)
 |  | AR40603 (http://www.xilinx.com/support/answers/40603.htm)
1.3.2 | Clocking Architecture | UG586 > QDRII+ Design Guidelines > Core Architecture > Clocking Architecture (http://www.xilinx.com/cgi-bin/docs/ipdoc?c=mig_7series;v=latest;d=ug586_7Series_MIS.pdf)
1.3.3 | Clocking Parameters and RTL | UG586 > QDRII+ Design Guidelines > Customizing the Core (http://www.xilinx.com/cgi-bin/docs/ipdoc?c=mig_7series;v=latest;d=ug586_7Series_MIS.pdf)
 | All clock parameters are set based on the MIG 7 Series tool settings. Items such as the frequencies of the input and clocks, how the IDELYCTRL reference clock is generated, etc. Changes to the clocking should be done through the MIG 7 Series tool and not by making manual changes to these parameters.
 | Clock pin and placement planning | See 2.2.2 Clock Pin Planning
1.4 | Understand Resets
1.4.1 | System Reset (sys_rst) - Used to reset the MIG 7 Series core and restart initialization and calibration |  | Asynchronous assertion. Synchronous deassertion
 | Can be internally or externally generated
 | Can be selected through the MIG 7 Series tool as either active high or active low. Drives top level rtl parameter RST_ACT_LOW (1=Active Low; 0=Active High) | UG586 > QDRII+ Design Guidelines > Customizing the Core (http://www.xilinx.com/cgi-bin/docs/ipdoc?c=mig_7series;v=latest;d=ug586_7Series_MIS.pdf)
 | Reset synchronization handled within MIG 7 Series rtl | Generated Design Directory = core_name/user_design/rtl/clocking/mig_7series_vx_x_infrastructure.v
1.4.2 | ui_clk_sync_rst - User Interface Active High Reset. Synchronous to ui_clk (User Interface Clock). | UG586 > QDRII+ Design Guidelines > Core Architecture > Client Interface (http://www.xilinx.com/cgi-bin/docs/ipdoc?c=mig_7series;v=latest;d=ug586_7Series_MIS.pdf)
1.5 | Understand Top-Level RTL Parameters
1.5.1 | The MIG 7 Series lower level rtl source files do not change. The options selected within the MIG 7 Series tool are used to set top-level rtl parameters to properly configure the lower level rtl source code. For information on these parameters, reference the relevant documenation. | UG586 > QDRII+ Design Guidelines > Customizing the Core (http://www.xilinx.com/cgi-bin/docs/ipdoc?c=mig_7series;v=latest;d=ug586_7Series_MIS.pdf)

Sheet: 1.2 RLDRAM II_III IP Def.&Gen.
Core Definition and Generation for RLDRAM II and RLDRAM III
ID | Description and Actions to Take | Links to Relevant Information | More Details | Status and Notes
1.1 | Xilinx Documentation and Training
1.1.1 | Read Users Guides and Datasheets
 | 7 Series FPGA Memory Interface User Guide - UG586 | MIG 7 Series Documentation (http://www.xilinx.com/support/index.html/content/xilinx/en/supportNav/ip_documentation/memory_interface_and_storage_element/memory_interface_and_controller/mi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)
 | 7 Series FPGA Memory Interface Data Sheet - DS176 | MIG 7 Series Documentation (http://www.xilinx.com/support/index.html/content/xilinx/en/supportNav/ip_documentation/memory_interface_and_storage_element/memory_interface_and_controller/mi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)
 | 7 Series FPGA AC and DC Switching Characteristics Datasheets. Includes memory interface performance specifications by device - See Maximum Physical Interface (PHY) Rate for Memory Interfaces. | 7 Series Data Sheets > Select the appropriate DC and AC Switching Characteristics datasheet (http://www.xilinx.com/cgi-bin/search/support.pl?proxystylesheet=support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)
1.1.2 | Check Xilinx MIG Solution Center | Xilinx Answer 34243 (http://www.xilinx.com/support/answers/34243.html)
 | Design Assistant - Helpful design and debug information for MIG 7 Series | Xilinx Answer 51313 (http://www.xilinx.com/support/answers/51313.html)
 | Top Issues - Browse through common questions on MIG 7 Series | Xilinx Answer 46227 (http://www.xilinx.com/support/answers/46227.html)
 | Design Advisories - See issues that are important to designs currently in progress | Xilinx Answer 33566 (http://www.xilinx.com/support/answers/33566.html)
1.1.3 | Read MIG 7 Series Release Notes
 | ISE MIG 7 Series Releases (Includes Vivado 2012.4 and earlier) | Xilinx Answer 45195 (http://www.xilinx.com/support/answers/45195.html)
 | Vivado MIG 7 Series Releases (Starting with Vivado 2013.1) | Xilinx Answer 54025 (http://www.xilinx.com/support/answers/54025.html)
1.1.4 | Read Device and IP Notifications
 | Have you subscribed to appropriate Design Advisories? | http://www.xilinx.com/support/myalerts
 | MIG Design Advisories - See issues that are important to designs currently in progress | Xilinx Answer 33566 (http://www.xilinx.com/support/answers/33566.html)
1.1.5 | See Video Demonstrations and White Papers | http://www.xilinx.com/products/technology/memory-interfacing/index.htm
1.2 | Understand Core Generation
1.2.1 | Using the MIG 7 Series Tool | UG586 > RLDRAM II and RLDRAM III > Getting Started (http://www.xilinx.com/cgi-bin/docs/ipdoc?c=mig_7series;v=latest;d=ug586_7Series_MIS.pdf)
 | Create Design | UG586 > RLDRAM II and RLDRAM III > Getting Started (http://www.xilinx.com/cgi-bin/docs/ipdoc?c=mig_7series;v=latest;d=ug586_7Series_MIS.pdf)
 | Pin Compatible FPGAs - Use to create UCF/XDC files for compatible FPGAs | UG586 > RLDRAM II and RLDRAM III > Getting Started (http://www.xilinx.com/cgi-bin/docs/ipdoc?c=mig_7series;v=latest;d=ug586_7Series_MIS.pdf)
 | NOTE: Available max data rate may be reduced in pin compatible designs due to inabilty to meet the trace matching requirements | See 2.1 PCB Layout Requirements
 | Memory Selection - Select the target memory standard | UG586 > RLDRAM II and RLDRAM III > Getting Started (http://www.xilinx.com/cgi-bin/docs/ipdoc?c=mig_7series;v=latest;d=ug586_7Series_MIS.pdf)
 | Controller Option - Configure the memory interface | UG586 > RLDRAM II and RLDRAM III > Getting Started (http://www.xilinx.com/cgi-bin/docs/ipdoc?c=mig_7series;v=latest;d=ug586_7Series_MIS.pdf)
 | Create Custom Part - Use when the desired memory part is not selectable in the MIG 7 Series tool. | UG586 > RLDRAM II and RLDRAM III > Getting Started (http://www.xilinx.com/cgi-bin/docs/ipdoc?c=mig_7series;v=latest;d=ug586_7Series_MIS.pdf) | Customize a base part to meet the target part's datasheet requirements.
 | Memory Options - Customize how the controller interfaces with the memory | UG586 > RLDRAM II and RLDRAM III > Getting Started (http://www.xilinx.com/cgi-bin/docs/ipdoc?c=mig_7series;v=latest;d=ug586_7Series_MIS.pdf)
 | FPGA Options | UG586 > RLDRAM II and RLDRAM III > Getting Started (http://www.xilinx.com/cgi-bin/docs/ipdoc?c=mig_7series;v=latest;d=ug586_7Series_MIS.pdf)
 | Define the clocking structure for the memory interface | 1.3 Clocks
 | Set the Reset Polarity | 1.4 Resets
 | Debug Signals - Enable to use the provided Chipscope debug cores for calibration failure and data error debug. | 5.0 Hardware Debug
 | Internal Vref - Supported below 400MHz | UG586 > RLDRAM II and RLDRAM III > Getting Started (http://www.xilinx.com/cgi-bin/docs/ipdoc?c=mig_7series;v=latest;d=ug586_7Series_MIS.pdf)
 | Extended FPGA Options | UG586 > RLDRAM II and RLDRAM III > Getting Started (http://www.xilinx.com/cgi-bin/docs/ipdoc?c=mig_7series;v=latest;d=ug586_7Series_MIS.pdf)
 | IO Planning Options | UG586 > RLDRAM II and RLDRAM III > Getting Started (http://www.xilinx.com/cgi-bin/docs/ipdoc?c=mig_7series;v=latest;d=ug586_7Series_MIS.pdf)
 | New Design - Use for new boards where pin locations are not yet defined. | UG586 > RLDRAM II and RLDRAM III > Getting Started (http://www.xilinx.com/cgi-bin/docs/ipdoc?c=mig_7series;v=latest;d=ug586_7Series_MIS.pdf)
 | Fixed Pin-Out - Use for boards where pin locations are defined. Manually entering pins or uploading a UCF/XDC are both supported. | UG586 > RLDRAM II and RLDRAM III > Getting Started (http://www.xilinx.com/cgi-bin/docs/ipdoc?c=mig_7series;v=latest;d=ug586_7Series_MIS.pdf)
 | DRC check ensures pin/bank rules are followed | UG586 > RLDRAMII and RLDRAM III > Design Guidelines (http://www.xilinx.com/cgi-bin/docs/ipdoc?c=mig_7series;v=latest;d=ug586_7Series_MIS.pdf)
 | Bank Selection - Use to select the banks and byte groups for the memory interface signal groups | UG586 > RLDRAM II and RLDRAM III > Getting Started (http://www.xilinx.com/cgi-bin/docs/ipdoc?c=mig_7series;v=latest;d=ug586_7Series_MIS.pdf)
 | DRC check ensures pin/bank rules are followed | UG586 > RLDRAMII and RLDRAM III > Design Guidelines (http://www.xilinx.com/cgi-bin/docs/ipdoc?c=mig_7series;v=latest;d=ug586_7Series_MIS.pdf)
 | System Signals Selection | UG586 > RLDRAM II and RLDRAM III > Getting Started (http://www.xilinx.com/cgi-bin/docs/ipdoc?c=mig_7series;v=latest;d=ug586_7Series_MIS.pdf)
 | System and Reference Clocks | 2.2.2 Clock Pin Planning
 | Status Signals - May be connected internally or driven to an external IO | UG586 > RLDRAM II and RLDRAM III > Getting Started (http://www.xilinx.com/cgi-bin/docs/ipdoc?c=mig_7series;v=latest;d=ug586_7Series_MIS.pdf)
 | Verify Pin Changes and Update Design - Use to verify any pin changes and generate an updated design to match the new pin-out. Additionally, use to upgrade a MIG 7 Series IP to a newer release. | UG586 > RLDRAM II and RLDRAM III > Getting Started (http://www.xilinx.com/cgi-bin/docs/ipdoc?c=mig_7series;v=latest;d=ug586_7Series_MIS.pdf)
 |  | UG586 > RLDRAMII and RLDRAM III > Design Guidelines (http://www.xilinx.com/cgi-bin/docs/ipdoc?c=mig_7series;v=latest;d=ug586_7Series_MIS.pdf)
1.3 | Understand Clocks
1.3.1 | Clocking Requirements | UG586 > RLDRAM II and RLDRAM III Design Guidelines > Pinout Requirements (http://www.xilinx.com/cgi-bin/docs/ipdoc?c=mig_7series;v=latest;d=ug586_7Series_MIS.pdf)
 |  | AR40603 (http://www.xilinx.com/support/answers/40603.htm)
1.3.2 | Clocking Architecture | UG586 > RLDRAM II and RLDRAM III Design Guidelines > Core Architecture > Clocking Architecture (http://www.xilinx.com/cgi-bin/docs/ipdoc?c=mig_7series;v=latest;d=ug586_7Series_MIS.pdf)
1.3.3 | Clocking Parameters and RTL | UG586 > RLDRAM II and RLDRAM III Design Guidelines > Customizing the Core (http://www.xilinx.com/cgi-bin/docs/ipdoc?c=mig_7series;v=latest;d=ug586_7Series_MIS.pdf)
 | All clock parameters are set based on the MIG 7 Series tool settings. Items such as the frequencies of the input and clocks, how the IDELYCTRL reference clock is generated, etc. Changes to the clocking should be done through the MIG 7 Series tool and not by making manual changes to these parameters.
 | Clock pin and placement planning | See 2.2.2 Clock Pin Planning
1.4 | Understand Resets
1.4.1 | System Reset (sys_rst) - Used to reset the MIG 7 Series core and restart initialization and calibration |  | Asynchronous assertion. Synchronous deassertion
 | Can be internally or externally generated
 | Can be selected through the MIG 7 Series tool as either active high or active low. Drives top level rtl parameter RST_ACT_LOW (1=Active Low; 0=Active High) | UG586 > RLDRAM II and RLDRAM III Design Guidelines > Customizing the Core (http://www.xilinx.com/cgi-bin/docs/ipdoc?c=mig_7series;v=latest;d=ug586_7Series_MIS.pdf)
 | Reset synchronization handled within MIG 7 Series rtl | Generated Design Directory = core_name/user_design/rtl/clocking/mig_7series_vx_x_infrastructure.v
1.4.2 | ui_clk_sync_rst - User Interface Active High Reset. Synchronous to ui_clk (User Interface Clock). | UG586 > RLDRAM II and RLDRAM III Design Guidelines > Core Architecture > Client Interface (http://www.xilinx.com/cgi-bin/docs/ipdoc?c=mig_7series;v=latest;d=ug586_7Series_MIS.pdf)
1.5 | Understand Top-Level RTL Parameters
1.5.1 | The MIG 7 Series lower level rtl source files do not change. The options selected within the MIG 7 Series tool are used to set top-level rtl parameters to properly configure the lower level rtl source code. For information on these parameters, reference the relevant documenation. | UG586 > RLDRAM II and RLDRAM III Design Guidelines > Customizing the Core (http://www.xilinx.com/cgi-bin/docs/ipdoc?c=mig_7series;v=latest;d=ug586_7Series_MIS.pdf)

Sheet: 2.0 DDR3_DDR2 Pin and Board
Pin and Board Planning for DDR3 and DDR2
ID | Description and Actions to Take | Links to Relevant Information | More Details | Status and Notes
2.1 | Check PCB Layout Requirements
2.1.1 | Termination | UG586 > DDR3/DDR2 Design Guidelines (http://www.xilinx.com/cgi-bin/docs/ipdoc?c=mig_7series;v=latest;d=ug586_7Series_MIS.pdf)
 | DQ/DQS/DM - DCI (HP Banks) or IN_TERM (HR Banks) are required at the FPGA. ODT is required at the memory
 | Addr/Cont/Cmd/CK - External termination is required. See relevant link for additional requirements at the memory.
 | RESET_N is not terminated but should be pulled low during memory initialization. See relavant link for requirements
 | CKE requirements vary between DDR3 and DDR2. DDR3 CKE should be terminated similar to addr/cont. DDR2 CKE should be pulled low during memory initialization. See relavant link for requirements.
2.1.2 | IBIS Simulation is highly recommended for all interfaces | UG586 > DDR3/DDR2 Design Guidelines (http://www.xilinx.com/cgi-bin/docs/ipdoc?c=mig_7series;v=latest;d=ug586_7Series_MIS.pdf)
 | Ensure DQ/DQS lines and addr/cont lines are all simulated
2.1.3 | Fly-By Topology is required for all DDR3 interfaces | UG586 > DDR3/DDR2 Design Guidelines (http://www.xilinx.com/cgi-bin/docs/ipdoc?c=mig_7series;v=latest;d=ug586_7Series_MIS.pdf)
 | MIG 7 Series performs write leveling for all DDR3 interfaces
2.1.4 | 40 Ohm Trace Impedance is required for interfaces above 1333Mbps. Below 1333Mbps can use 50 Ohm Trace Impedance. | UG586 > DDR3/DDR2 Design Guidelines (http://www.xilinx.com/cgi-bin/docs/ipdoc?c=mig_7series;v=latest;d=ug586_7Series_MIS.pdf)
 | NOTE: 40 Ohm traces required 80 Ohm VRN/VRP resistors
2.1.5 | Internal Vref is supported below 800Mbps. Above 800Mbps requires external Vref. | UG586 > DDR3/DDR2 Design Guidelines (http://www.xilinx.com/cgi-bin/docs/ipdoc?c=mig_7series;v=latest;d=ug586_7Series_MIS.pdf)
2.1.6 | VCCAUX_IO can be set to either 2.0V or 1.8V depending on device, I/O Column, and target memory data rate. | 7 Series Data Sheets (http://www.xilinx.com/cgi-bin/search/support.pl?proxystylesheet=support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)
2.1.7 | Power System and Plane Disontinuities | UG483 7 Series FPGAs PCB Design and Pin Planning Guide (http://www.xilinx.com/support/documentation/user_guides/ug483_7Series_PCB.pdf)
2.1.8 | Optimal SelectIO Interface VREF Generation Circuits | XAPP1087 (http://www.xilinx.com/support/documentation/application_notes/xapp1087-optimal-selectio-vref.pdf)
2.1.9 | Trace Length Matching is required and must include package delays. Trace length matching is required between the following groups. The relavant documentation should be referenced for specific delays. | UG586 > DDR3/DDR2 Design Guidelines (http://www.xilinx.com/cgi-bin/docs/ipdoc?c=mig_7series;v=latest;d=ug586_7Series_MIS.pdf)
 | DQ/DM and assoiciated DQS/DQS#
 | Address and Control and the corresponding CK/CK#
 | CK/CK# and the DQS/DQS# signals
 | Package Delays can be found running PartGen or within the Vivado Pinout Table
 | Trace length matching can be derated when running below the maximum supported data rate for a given configuration. Review the Trace Derating tables for derating details. | UG586 > DDR3/DDR2 Design Guidelines (http://www.xilinx.com/cgi-bin/docs/ipdoc?c=mig_7series;v=latest;d=ug586_7Series_MIS.pdf)
 | For Pin Compatible Designs, because package delays vary across parts, the max available data rate may be reduced due to the inability to meet the trace matching reqruiements. The worst case delays should be used to determine the available max data rate. | UG586 > DDR3/DDR2 Design Guidelines (http://www.xilinx.com/cgi-bin/docs/ipdoc?c=mig_7series;v=latest;d=ug586_7Series_MIS.pdf)
2.1.10 | Understand Simultaneous Switching Noise (SSN) | Xilinx Answer 34569 (http://www.xilinx.com/support/answers/34569.html)
2.2 | Understand I/O and Clock Pin Planning
2.2.1 | I/O Pin Planning
 | MIG 7 Series requires specific pin/bank placement. The MIG 7 Series tool must be used to generate or modify a pin-out. The generated design (UCF/XDC constraints and rtl parameters) are custom to the selected pin-out. | UG586 > DDR3/DDR2 Design Guidelines (http://www.xilinx.com/cgi-bin/docs/ipdoc?c=mig_7series;v=latest;d=ug586_7Series_MIS.pdf)
 | New Design option in the MIG 7 Series tool creates a pin-out based on banks selected. | UG586 > DDR3/DDR2 > Getting Started (http://www.xilinx.com/cgi-bin/docs/ipdoc?c=mig_7series;v=latest;d=ug586_7Series_MIS.pdf)
 | Fixed Pin-Out flow can be used to upload a desired pin-out and run a DRC check | UG586 > DDR3/DDR2 > Getting Started (http://www.xilinx.com/cgi-bin/docs/ipdoc?c=mig_7series;v=latest;d=ug586_7Series_MIS.pdf)
 | Verify UCF and Update Design can be used to verify a modified pin-out, run a DRC check and create an updated design to match the modified pin-out. | UG586 > DDR3/DDR2 > Getting Started (http://www.xilinx.com/cgi-bin/docs/ipdoc?c=mig_7series;v=latest;d=ug586_7Series_MIS.pdf)
 | Fitting a x16 in a single bank. | Xilinx Answer 41752 (http://www.xilinx.com/support/answers/41752.htm)
 | Sharing banks between multiple memory interfaces is not permitted | UG586 > DDR3/DDR2 Design Guidelines (http://www.xilinx.com/cgi-bin/docs/ipdoc?c=mig_7series;v=latest;d=ug586_7Series_MIS.pdf)
 |  | Xilinx Answer 41706 (http://www.xilinx.com/support/answers/41706.htm)
 | Usage of unused VRN/VRP I/O (HP banks) when DCI Cascade is used or non-byte group I/O (HR banks) is permitted for Address/Control or Reset_N pins. See the referenced documentation for specific rules. | UG586 > DDR3/DDR2 Design Guidelines (http://www.xilinx.com/cgi-bin/docs/ipdoc?c=mig_7series;v=latest;d=ug586_7Series_MIS.pdf)
 | Enabling Dynamic ODT special use case to remove ODT pin | Xilinx Answer 46082 (http://www.xilinx.com/support/answers/46082.htm)
 | Usage of the PUDC_B configuration pin | Xilinx Answer 50739 (http://www.xilinx.com/support/answers/50739.htm)
 | For Artix-7/Kintex-7, when CFGBVS is set to VCCO of Bank 0, then Banks 14 and 15 are limited to 3.3V or 2.5V for Configuration | Xilinx Answer 57045 (http://www.xilinx.com/support/answers/57045.htm)
2.2.2 | RESET_N Pin Planning
 | RESET_N can be connected to any available pin within the device, including the VRN/VRP pins if DCI cascade is used, as long as timing is met and an appropriate I/O voltage standard is used. The GUI restricts this pin to the banks used for the interface to help with timing, but this is not a requirement. | UG586 > DDR3 Design Guidelines (http://www.xilinx.com/cgi-bin/docs/ipdoc?c=mig_7series;v=latest;d=ug586_7Series_MIS.pdf)
 | RESET_N Termination - Pull low with 4.7 kΩ resistor | UG586 > DDR3 Design Guidelines (http://www.xilinx.com/cgi-bin/docs/ipdoc?c=mig_7series;v=latest;d=ug586_7Series_MIS.pdf)
 | Driving a 1.35V LVCMOS Reset to a DDR3L device | Xilinx Answer 47232 (http://www.xilinx.com/support/answers/47232.html)
2.2.3 | Clock Pin Planning
 | MIG 7 Series has specific requirements for the system input clock (sys_clk). All supported clocking structures can be generated through the MIG 7 Series tool. | Xilinx Answer 40603 (http://www.xilinx.com/support/answers/40603.htm)
 | CCIO Input placement requirements | Xilinx Answer 40603 (http://www.xilinx.com/support/answers/40603.htm)
 | Sys_clk sharing requirements | Xilinx Answer 40603 (http://www.xilinx.com/support/answers/40603.htm)
 | Sys_clk jitter requirements | Xilinx Answer 40603 (http://www.xilinx.com/support/answers/40603.htm)
 | PLL multiply and divide requirements to reduce jitter | Xilinx Answer 40603 (http://www.xilinx.com/support/answers/40603.htm)
 | MIG 7 Series requires a 200MHz IDELAYCTRL reference clock (ref_clk). The general FPGA requirements of this clock must be followed. | 7 Series Data Sheets > Select the appropriate DC and AC Switching Characteristics datasheet (http://www.xilinx.com/cgi-bin/search/support.pl?proxystylesheet=support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)
 | If the input sys_clk and memory data rate allow generation of a 200MHz clock, the ref_clk can be generated by the MIG 7 Series clocking structure. | UG586 > DDR3/DDR2 > Getting Started (http://www.xilinx.com/cgi-bin/docs/ipdoc?c=mig_7series;v=latest;d=ug586_7Series_MIS.pdf)
2.2.4 | Clock Resource Planning
 | MIG 7 Series requires a PLL and an MMCM for each interface within the bank selected for Address/Control | UG586 > DDR3 Design Guidelines (http://www.xilinx.com/cgi-bin/docs/ipdoc?c=mig_7series;v=latest;d=ug586_7Series_MIS.pdf)
 | The generated MIG UCF/XDC file includes all appropriate placement constraints. | UG586 > DDR3 Design Guidelines (http://www.xilinx.com/cgi-bin/docs/ipdoc?c=mig_7series;v=latest;d=ug586_7Series_MIS.pdf)
2.3 | Understand Power Planning and Analysis | Power Efficiency Website (http://www.xilinx.com/products/technology/power/index.htm)
2.3.1 | Design
 | Power System Design | UG483 7 Series FPGAs PCB Design and Pin Planning Guide (http://www.xilinx.com/support/documentation/user_guides/ug483_7Series_PCB.pdf)
2.3.2 | Analysis
 | Power Analysis | ISE - UG440 Xilinx Power Estimator User Guide (http://www.xilinx.com/cgi-bin/docs/rdoc?v=latest;d=ug440-xilinx-power-estimator.pdf)
 |  | Vivado - UG907 Power Analysis and Optimization (http://www.xilinx.com/cgi-bin/docs/rdoc?v=latest;d=ug907-vivado-power-analysis-optimization.pdf)
 | Download XPE | Power Efficiency Website (http://www.xilinx.com/products/technology/power/index.htm)
2.4 | Understand XADC Board Setup
2.4.1 | XADC is required with the continuous Temperature Monitor calibration | Xilinx Answer 51867 (http://www.xilinx.com/support/answers/51687.html)
 |  | LogiCORE IP XADC Wizard Product Guide - PG091 (http://www.xilinx.com/cgi-bin/docs/ipdoc?c=xadc_wiz;v=latest;d=pg091-xadc-wiz.pdf)
 |  | UG586 > Core Architecture > PHY (http://www.xilinx.com/cgi-bin/docs/ipdoc?c=mig_7series;v=latest;d=ug586_7Series_MIS.pdf)

Sheet: 2.1 QDRII+ Pin and Board
Pin and Board Planning for QDR II+
ID | Description and Actions to Take | Links to Relevant Information | More Details | Status and Notes
2.1 | Check PCB Layout Requirements
 | Termination - DCI (HP Banks) or IN_TERM (HR Banks) are required at the FPGA. See relevant link for additional requirements at the memory. | UG586 > QDRII+ > Design Guidelines (http://www.xilinx.com/cgi-bin/docs/ipdoc?c=mig_7series;v=latest;d=ug586_7Series_MIS.pdf)
 | IBIS Simulation is highly recommended for all interfaces | UG586 > QDRII+ > Design Guidelines (http://www.xilinx.com/cgi-bin/docs/ipdoc?c=mig_7series;v=latest;d=ug586_7Series_MIS.pdf)
 | Internal Vref is supported below 400MHz. Above 400MHz requires external Vref. | UG586 > QDRII+ > Design Guidelines (http://www.xilinx.com/cgi-bin/docs/ipdoc?c=mig_7series;v=latest;d=ug586_7Series_MIS.pdf)
 | VCCAUX_IO can be set to either 2.0V or 1.8V depending on device, I/O Column, and target memory data rate.
 | Power System and Plane Disontinuities | UG586 > QDRII+ > Design Guidelines (http://www.xilinx.com/cgi-bin/docs/ipdoc?c=mig_7series;v=latest;d=ug586_7Series_MIS.pdf)
 | Trace Length Matching is required and must include package delays | 7 Series Data Sheets (http://www.xilinx.com/cgi-bin/search/support.pl?proxystylesheet=support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)
 | Package Delays can be found running PartGen or within the Vivado Pinout Table | UG483 7 Series FPGAs PCB Design and Pin Planning Guide (http://www.xilinx.com/support/documentation/user_guides/ug483_7Series_PCB.pdf)
 | Review Trace Derating tables for slower data rates | UG586 > QDRII+ > Design Guidelines (http://www.xilinx.com/cgi-bin/docs/ipdoc?c=mig_7series;v=latest;d=ug586_7Series_MIS.pdf)
 | For Pin Compatible Designs, because package delays vary across parts, the max available data rate may be reduced due to the inability to meet the trace matching reqruiements. The worst case delays should be used to determine the available max data rate. | UG586 > QDRII+ > Design Guidelines (http://www.xilinx.com/cgi-bin/docs/ipdoc?c=mig_7series;v=latest;d=ug586_7Series_MIS.pdf)
 | Simutaneous Switching Noise (SSN) | Xilinx Answer 34569 (http://www.xilinx.com/support/answers/34569.html)
2.2 | Understand I/O and Clock Pin Planning
2.2.1 | I/O Pin Planning
 | MIG 7 Series requires specific pin/bank placement. The MIG 7 Series tool must be used to generate or modify a pin-out. The generated design (UCF/XDC constraints and rtl parameters) are custom to the selected pin-out. | UG586 > QDRII+ > Design Guidelines (http://www.xilinx.com/cgi-bin/docs/ipdoc?c=mig_7series;v=latest;d=ug586_7Series_MIS.pdf)
 | New Design option in the MIG 7 Series tool creates a pin-out based on banks selected. | UG586 > QDRII+ > Design Guidelines (http://www.xilinx.com/cgi-bin/docs/ipdoc?c=mig_7series;v=latest;d=ug586_7Series_MIS.pdf)
 | Fixed Pin-Out flow can be used to upload a desired pin-out and run a DRC check | UG586 > QDRII+ > Design Guidelines (http://www.xilinx.com/cgi-bin/docs/ipdoc?c=mig_7series;v=latest;d=ug586_7Series_MIS.pdf)
 | Verify UCF and Update Design can be used to verify a modified pin-out, run a DRC check and create an updated design to match the modified pin-out. | UG586 > QDRII+ > Design Guidelines (http://www.xilinx.com/cgi-bin/docs/ipdoc?c=mig_7series;v=latest;d=ug586_7Series_MIS.pdf)
 | Fitting a x18 in a single bank. | Xilinx Answer 53811 (http://www.xilinx.com/support/answers/53811.htm)
 | Sharing banks between multiple memory interfaces is not permitted | UG586 > QDRII+ > Design Guidelines (http://www.xilinx.com/cgi-bin/docs/ipdoc?c=mig_7series;v=latest;d=ug586_7Series_MIS.pdf)
 | Try to avoid using configuration Bank(s) 14, 15. If bank(s) 14, 15 are selected for your memory controller, UCF/XDC should be verified to ensure no conflicts with the configuration pin. For more information please refer to UG586 Bank and Pin Rules and UG470 7 Series Configuration User Guide. | UG586 > QDRII+ > Design Guidelines (http://www.xilinx.com/cgi-bin/docs/ipdoc?c=mig_7series;v=latest;d=ug586_7Series_MIS.pdf)
 |  | UG470 7 Series FPGAs Configuration User Guide (http://www.xilinx.com/support/documentation/user_guides/ug470_7Series_Config.pdf)
 | Avoid using PUDC_B pin located in Bank 14, Byte T0. | AR50739 (http://www.xilinx.com/support/answers/50739.htm) | This pin requires a strong pull-up or pull-down during configuration and cannot be used for memory pins.
 | MIG 7 Series has specific requirements for the system input clock (sys_clk). All supported clocking structures can be generated through the MIG 7 Series tool. | UG586 > QDRII+ Design Guidelines > Pinout Requirements (http://www.xilinx.com/cgi-bin/docs/ipdoc?c=mig_7series;v=latest;d=ug586_7Series_MIS.pdf)
 | CCIO Input placement requirements | UG586 > QDRII+ Design Guidelines > Pinout Requirements (http://www.xilinx.com/cgi-bin/docs/ipdoc?c=mig_7series;v=latest;d=ug586_7Series_MIS.pdf)
 | Sys_clk sharing requirements | Xilinx Answer 40603 (http://www.xilinx.com/support/answers/40603.htm)
 | PLL multiply and divide requirements to reduce jitter | Xilinx Answer 40603 (http://www.xilinx.com/support/answers/40603.htm)
 | MIG 7 Series requires a 200MHz IDELAYCTRL reference clock (ref_clk). The general FPGA requirements of this clock must be followed. | 7 Series Data Sheets > Select the appropriate DC and AC Switching Characteristics datasheet (http://www.xilinx.com/cgi-bin/search/support.pl?proxystylesheet=support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)
 | MIG 7 Series requires a PLL and an MMCM for each interface within the bank selected for Address/Control | UG586 > QDRII+ > Design Guidelines (http://www.xilinx.com/cgi-bin/docs/ipdoc?c=mig_7series;v=latest;d=ug586_7Series_MIS.pdf)
 | The generated MIG UCF/XDC file includes the appropriate placement constraints. | UG586 > QDRII+ > Design Guidelines (http://www.xilinx.com/cgi-bin/docs/ipdoc?c=mig_7series;v=latest;d=ug586_7Series_MIS.pdf)
2.3 | Understand Power Planning and Analysis
2.3.1 | Up Front Power Considerations
 | Has XPE been run? Does the result from XPE fit within the power budget of the board? | FPGA Device Power and the Overall System Design Process. For the latest XPE spreadsheet - www.xilinx.com/power
 | Has the design exceeded Max Junction Temperature? | Environmental Factors Impacting Power: Cooling Strategies
2.3.1 | Design
 |  | Vivado - UG907 Power Analysis and Optimization (http://www.xilinx.com/cgi-bin/docs/rdoc?v=latest;d=ug907-vivado-power-analysis-optimization.pdf)

Sheet: 2.2 RLDRAM II_III Pin and Board
Pin and Board Planning
ID | Description and Actions to Take | Links to Relevant Information | More Details | Status and Notes
2.1 | Check PCB Layout Requirements
 | Termination - DCI (HP Banks) or IN_TERM (HR Banks) are required at the FPGA. See relevant link for additional requirements at the memory. | UG586 > RLDRAM II and RLDRAM III > Design Guidelines (http://www.xilinx.com/cgi-bin/docs/ipdoc?c=mig_7series;v=latest;d=ug586_7Series_MIS.pdf)
 | IBIS Simulation is highly recommended for all interfaces | UG586 > RLDRAM II and RLDRAM III > Design Guidelines (http://www.xilinx.com/cgi-bin/docs/ipdoc?c=mig_7series;v=latest;d=ug586_7Series_MIS.pdf)
 | Internal Vref is supported below 400MHz. Above 400MHz requires external Vref. | UG586 > RLDRAM II and RLDRAM III > Design Guidelines (http://www.xilinx.com/cgi-bin/docs/ipdoc?c=mig_7series;v=latest;d=ug586_7Series_MIS.pdf)
 | VCCAUX_IO can be set to either 2.0V or 1.8V depending on device, I/O Column, and target memory data rate.
 | Power System and Plane Disontinuities | UG586 > RLDRAM II and RLDRAM III > Design Guidelines (http://www.xilinx.com/cgi-bin/docs/ipdoc?c=mig_7series;v=latest;d=ug586_7Series_MIS.pdf)
 | Trace Length Matching is required and must include package delays | 7 Series Data Sheets (http://www.xilinx.com/cgi-bin/search/support.pl?proxystylesheet=support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)
 | Package Delays can be found running PartGen or within the Vivado Pinout Table | UG483 7 Series FPGAs PCB Design and Pin Planning Guide (http://www.xilinx.com/support/documentation/user_guides/ug483_7Series_PCB.pdf)
 | Review Trace Derating tables for slower data rates | UG586 > RLDRAM II and RLDRAM III > Design Guidelines (http://www.xilinx.com/cgi-bin/docs/ipdoc?c=mig_7series;v=latest;d=ug586_7Series_MIS.pdf)
 | For Pin Compatible Designs, because package delays vary across parts, the max available data rate may be reduced due to the inability to meet the trace matching reqruiements. The worst case delays should be used to determine the available max data rate. | UG586 > RLDRAM II and RLDRAM III > Design Guidelines (http://www.xilinx.com/cgi-bin/docs/ipdoc?c=mig_7series;v=latest;d=ug586_7Series_MIS.pdf)
 | Simutaneous Switching Noise (SSN) | Xilinx Answer 34569 (http://www.xilinx.com/support/answers/34569.html)
2.2 | Understand I/O and Clock Pin Planning
2.2.1 | I/O Pin Planning
 | MIG 7 Series requires specific pin/bank placement. The MIG 7 Series tool must be used to generate or modify a pin-out. The generated design (UCF/XDC constraints and rtl parameters) are custom to the selected pin-out. | UG586 > RLDRAM II and RLDRAM III > Design Guidelines (http://www.xilinx.com/cgi-bin/docs/ipdoc?c=mig_7series;v=latest;d=ug586_7Series_MIS.pdf)
 | New Design option in the MIG 7 Series tool creates a pin-out based on banks selected. | UG586 > RLDRAM II and RLDRAM III > Getting Started (http://www.xilinx.com/cgi-bin/docs/ipdoc?c=mig_7series;v=latest;d=ug586_7Series_MIS.pdf)
 | Fixed Pin-Out flow can be used to upload a desired pin-out and run a DRC check | UG586 > RLDRAM II and RLDRAM III > Getting Started (http://www.xilinx.com/cgi-bin/docs/ipdoc?c=mig_7series;v=latest;d=ug586_7Series_MIS.pdf)
 | Verify UCF and Update Design can be used to verify a modified pin-out, run a DRC check and create an updated design to match the modified pin-out. | UG586 > RLDRAM II and RLDRAM III > Getting Started (http://www.xilinx.com/cgi-bin/docs/ipdoc?c=mig_7series;v=latest;d=ug586_7Series_MIS.pdf)
 | Fitting a x18 in a single bank. | Xilinx Answer 53811 (http://www.xilinx.com/support/answers/53811.htm)
 | Sharing banks between multiple memory interfaces is not permitted | UG586 > RLDRAM II and RLDRAM III > Design Guidelines (http://www.xilinx.com/cgi-bin/docs/ipdoc?c=mig_7series;v=latest;d=ug586_7Series_MIS.pdf)
 | Try to avoid using configuration Bank(s) 14, 15. If bank(s) 14, 15 are selected for your memory controller, UCF/XDC should be verified to ensure no conflicts with the configuration pin. For more information please refer to UG586 Bank and Pin Rules and UG470 7 Series Configuration User Guide. | UG586 > RLDRAMII and RLDRAM III > Design Guidelines (http://www.xilinx.com/cgi-bin/docs/ipdoc?c=mig_7series;v=latest;d=ug586_7Series_MIS.pdf)
 |  | UG470 7 Series FPGAs Configuration User Guide (http://www.xilinx.com/support/documentation/user_guides/ug470_7Series_Config.pdf)
 | Avoid using PUDC_B pin located in Bank 14, Byte T0. | AR50739 (http://www.xilinx.com/support/answers/50739.htm) | This pin requires a strong pull-up or pull-down during configuration and cannot be used for memory pins.
 | MIG 7 Series has specific requirements for the system input clock (sys_clk). All supported clocking structures can be generated through the MIG 7 Series tool. | UG586 > RLDRAM II and RLDRAM III Design Guidelines > Pinout Requirements (http://www.xilinx.com/cgi-bin/docs/ipdoc?c=mig_7series;v=latest;d=ug586_7Series_MIS.pdf)
 | CCIO Input placement requirements | UG586 > RLDRAM II and RLDRAM III Design Guidelines > Pinout Requirements (http://www.xilinx.com/cgi-bin/docs/ipdoc?c=mig_7series;v=latest;d=ug586_7Series_MIS.pdf)
 | Sys_clk sharing requirements | Xilinx Answer 40603 (http://www.xilinx.com/support/answers/40603.htm)
 | PLL multiply and divide requirements to reduce jitter | Xilinx Answer 40603 (http://www.xilinx.com/support/answers/40603.htm)
 | MIG 7 Series requires a 200MHz IDELAYCTRL reference clock (ref_clk). The general FPGA requirements of this clock must be followed. | 7 Series Data Sheets > Select the appropriate DC and AC Switching Characteristics datasheet (http://www.xilinx.com/cgi-bin/search/support.pl?proxystylesheet=support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)
 | MIG 7 Series requires a PLL and an MMCM for each interface within the bank selected for Address/Control | UG586 > RLDRAM II and RLDRAM III > Design Guidelines (http://www.xilinx.com/cgi-bin/docs/ipdoc?c=mig_7series;v=latest;d=ug586_7Series_MIS.pdf)
 | The generated MIG UCF/XDC file includes the appropriate placement constraints. | UG586 > RLDRAM II and RLDRAM III > Design Guidelines (http://www.xilinx.com/cgi-bin/docs/ipdoc?c=mig_7series;v=latest;d=ug586_7Series_MIS.pdf)
2.3 | Understand Power Planning and Analysis
2.3.1 | Up Front Power Considerations
 | Has XPE been run? Does the result from XPE fit within the power budget of the board? | FPGA Device Power and the Overall System Design Process. For the latest XPE spreadsheet - www.xilinx.com/power
 | Has the design exceeded Max Junction Temperature? | Environmental Factors Impacting Power: Cooling Strategies
2.3.1 | Design
 |  | Vivado - UG907 Power Analysis and Optimization (http://www.xilinx.com/cgi-bin/docs/rdoc?v=latest;d=ug907-vivado-power-analysis-optimization.pdf)

Sheet: 3.0 DDR3_DDR2 Simulation
Simulation for DDR3 and DDR2
ID | Description and Actions to Take | Links to Relevant Information | More Details | Status and Notes
3.1 | Understand Supported Simulators | 7 Series FPGAs Memory Interface Solutions Datasheet - DS176 (http://www.xilinx.com/support/documentation/ip_documentation/mig_7series/v1_9/ds176_7Series_MIS.pdf)
3.1.1 | Additional Information | Xilinx Answer 51671 (http://www.xilinx.com/support/answers/51671.html)
 | Timing Simulation is not supported for MIG 7 Series IP
3.2 | Check Simulation Parameters | Xilinx Answer 51668 (http://www.xilinx.com/support/answers/51668.html)
3.2.1 | Speeding up simulation run time | UG586 > Customizing the Core (http://www.xilinx.com/cgi-bin/docs/ipdoc?c=mig_7series;v=latest;d=ug586_7Series_MIS.pdf)
 | Set SIM_BYPASS_INIT_CAL = "FAST";
3.3 | Understand Simulation Analysis
 | Using the provided Example Design with Traffic Generator | UG586 > DDR3/DDR2 > Getting Started > Quick Start Example Design (http://www.xilinx.com/cgi-bin/docs/ipdoc?c=mig_7series;v=latest;d=ug586_7Series_MIS.pdf)
 |  | UG586 > DDR3/DDR2 > Getting Started > Modifying the Example Design (http://www.xilinx.com/cgi-bin/docs/ipdoc?c=mig_7series;v=latest;d=ug586_7Series_MIS.pdf)
 | Calculating and Improving Efficiency | Xilinx Answer 36719 (http://www.xilinx.com/support/answers/36719.html)
 | Simulation Debug | Xilinx Answer 51667 (http://www.xilinx.com/support/answers/51667.html)

Sheet: 3.1 QDRII+ Simulation
Simulation for QDR II+
ID | Description and Actions to Take | Links to Relevant Information | More Details | Status and Notes
3.1 | Understand Supported Simulators | 7 Series FPGAs Memory Interface Solutions Datasheet - DS176 (http://www.xilinx.com/support/documentation/ip_documentation/mig_7series/v1_9/ds176_7Series_MIS.pdf)
3.1.1 | Additional Information | Xilinx Answer 51671 (http://www.xilinx.com/support/answers/51671.html)
 | Timing Simulation is not supported for MIG 7 Series IP
3.2 | Check Simulation Parameters | Xilinx Answer 51668 (http://www.xilinx.com/support/answers/51668.html)
3.2.1 | Speeding up simulation run time | UG586 > QDRII+ Design Guidelines > Customizing the Core (http://www.xilinx.com/cgi-bin/docs/ipdoc?c=mig_7series;v=latest;d=ug586_7Series_MIS.pdf)
 | Set SIM_BYPASS_INIT_CAL = "FAST";
3.3 | Understand Simulation Analysis
 | Using the provided Example Design with Traffic Generator | UG586 > QDRII+ > Getting Started > Quick Start Example Design (http://www.xilinx.com/cgi-bin/docs/ipdoc?c=mig_7series;v=latest;d=ug586_7Series_MIS.pdf)
 |  | UG586 > QDRII+ > Getting Started > Modifying the Example Design (http://www.xilinx.com/cgi-bin/docs/ipdoc?c=mig_7series;v=latest;d=ug586_7Series_MIS.pdf)
 | Calculating and Improving Efficiency | Xilinx Answer 36719 (http://www.xilinx.com/support/answers/36719.html)
 | Simulation Debug | UG586 > QDRII+ > Debugging > Simulation Debug (http://www.xilinx.com/cgi-bin/docs/ipdoc?c=mig_7series;v=latest;d=ug586_7Series_MIS.pdf)

Sheet: 3.2 RLDRAM II_III Simulation
Simulation for RLDRAM II and RLDRAM III
ID | Description and Actions to Take | Links to Relevant Information | More Details | Status and Notes
3.1 | Understand Supported Simulators | 7 Series FPGAs Memory Interface Solutions Datasheet - DS176 (http://www.xilinx.com/support/documentation/ip_documentation/mig_7series/v1_9/ds176_7Series_MIS.pdf)
3.1.1 | Additional Information | Xilinx Answer 51671 (http://www.xilinx.com/support/answers/51671.html)
 | Timing Simulation is not supported for MIG 7 Series IP
3.2 | Check Simulation Parameters | Xilinx Answer 51668 (http://www.xilinx.com/support/answers/51668.html)
3.2.1 | Speeding up simulation run time | UG586 > RLDRAM II and RLDRAM III Design Guidelines > Customizing the Core (http://www.xilinx.com/cgi-bin/docs/ipdoc?c=mig_7series;v=latest;d=ug586_7Series_MIS.pdf)
 | Set SIM_BYPASS_INIT_CAL = "FAST";
3.3 | Understand Simulation Analysis
 | Using the provided Example Design with Traffic Generator | UG586 > RLDRAM II and RLDRAM III > Getting Started > Quick Start Example Design (http://www.xilinx.com/cgi-bin/docs/ipdoc?c=mig_7series;v=latest;d=ug586_7Series_MIS.pdf)
 |  | UG586 > RLDRAM II and RLDRAM III > Getting Started > Modifying the Example Design (http://www.xilinx.com/cgi-bin/docs/ipdoc?c=mig_7series;v=latest;d=ug586_7Series_MIS.pdf)
 | Calculating and Improving Efficiency | Xilinx Answer 36719 (http://www.xilinx.com/support/answers/36719.html)
 | Simulation Debug | UG586 > RLDRAM II and RLDRAM III > Debugging > Simulation Debug (http://www.xilinx.com/cgi-bin/docs/ipdoc?c=mig_7series;v=latest;d=ug586_7Series_MIS.pdf)

Sheet: 4.0 DDR3 _DDR2 Design Flow
Design Flows for DDR3 and DDR2
ID | Description and Actions to Take | Links to Relevant Information | More Details | Status and Notes
4.1 | Understand Design Flow Options
4.1.1 | ISE Flow Options
 | CORE Generator Flow | UG586 > DDR3/DDR2 > Getting Started (http://www.xilinx.com/cgi-bin/docs/ipdoc?c=mig_7series;v=latest;d=ug586_7Series_MIS.pdf)
 | Generating a MIG 7 Series core from an existing ISE project | Xilinx Answer 37424 (http://www.xilinx.com/support/answers/37424.htm)
 | Creating an ISE project with a generated MIG 7 Series core | UG586 > Creating ISE Project Navigator Flow for MIG Example Design (http://www.xilinx.com/cgi-bin/docs/ipdoc?c=mig_7series;v=latest;d=ug586_7Series_MIS.pdf)
4.1.2 | Vivado Flow Options | UG586 > Using MIG in Vivado Design Suite (http://www.xilinx.com/cgi-bin/docs/ipdoc?c=mig_7series;v=latest;d=ug586_7Series_MIS.pdf)
 | Generate the MIG Example Design using the Open IP Example Design Vivado option | UG586 > Using MIG in Vivado Design Suite (http://www.xilinx.com/cgi-bin/docs/ipdoc?c=mig_7series;v=latest;d=ug586_7Series_MIS.pdf)
4.2 | Running Synthesis and Implementation
4.2.1 | ISE Synthesis and Implementation
 | Execute the ise_flow.bat/.sh script file located in the example_design/par directory. The ise_flow.bat/.sh script file ensures the necessary synthesis and implementation options are enabled. | UG586 > DDR3/DDR2 > Getting Started (http://www.xilinx.com/cgi-bin/docs/ipdoc?c=mig_7series;v=latest;d=ug586_7Series_MIS.pdf)
 | OR
 | Use the generated ISE project to implement the design | See 4.1.1 ISE Flow Options
4.2.2 | Vivado Synthesis and Implementation
 | Generate with either the user or example design Vivado project | See 4.1.2 Vivado Flow Options
4.2.3 | Debugging the Synthesized/Implemented Design
 | Does the design close timing post-synthesis or post-implementation? If not, was any portion of the generated design modified? The generated design will not fail timing. | See 4.4 Timing Closure
 | Were any rtl parameters or code modified? The generated design will not fail synthesis or implementation. | UG586 > DDR3/DDR2 > Customizing the Core (http://www.xilinx.com/cgi-bin/docs/ipdoc?c=mig_7series;v=latest;d=ug586_7Series_MIS.pdf)
 | The top-level parameters and UCF/XDC constraints are generated based on the user input within the MIG 7 Series tool. Any required modifications must be made through the MIG 7 Series tool to generate a new set of rtl and constraints. | UG586 > DDR3/DDR2 > Getting Started (http://www.xilinx.com/cgi-bin/docs/ipdoc?c=mig_7series;v=latest;d=ug586_7Series_MIS.pdf)
4.3 | Understand IP Constraints
4.3.1 | MIG 7 Series cores are generated with required UCF/XDC constraints. | See the example_design/par and user_design/constraints directories
 | Constraint Documentation | UG586 > DDR3/DDR2 Design Guidelines (http://www.xilinx.com/cgi-bin/docs/ipdoc?c=mig_7series;v=latest;d=ug586_7Series_MIS.pdf)
4.3.2 | When DCI Cascade is implemented, users must manually enter the appropraite DCI Cascade constraint specifying the master and slave banks within the generated UCF/XDC. | Xilinx Constraints Guide (http://www.xilinx.com/support/index.html/content/xilinx/en/supportNav/design_tools.html)
4.3.3 | Compatible UCF/XDC files will be generated if a device is selected on the Pin Compatible FPGAs screen within the MIG 7 Series tool | See the example_design/par/compatible_ucf and user_design/constraint/compatible_ucf directories
4.4 | Understand Timing Closure
4.5.1 | Preliminary Timing Closure
 | The MIG 7 Series IP should not fail timing out of the box. If there is a timing error in the default configuration, please open a webcase. | Webcase (http://www.xilinx.com/support/clearexpress/websupport.htm)
 | Ensure all timing constraints provided in the MIG 7 Series generated UCF/XDC are being applied. MIG 7 Series provides all necessary constraints for the IP. | See 4.3 Constraints
 | Determine if the timing error is within the user logic or the MIG 7 Series design.
4.5 | Understand Floorplanning
 | Floorplanning is generally not needed to close timing with the MIG core.
4.6 | Migrating to new Software Releases
4.6.1 | ISE
 | Use the Verify UCF and Update Design MIG 7 Series feature | UG586 > DDR3/DDR2 > Getting Started (http://www.xilinx.com/cgi-bin/docs/ipdoc?c=mig_7series;v=latest;d=ug586_7Series_MIS.pdf)
4.6.2 | Vivado
 | Upgrading ISE/CORE Generator MIG 7 Series cores in Vivado | UG586 > Upgrading the ISE/CORE Generator MIG Core in Vivado (http://www.xilinx.com/cgi-bin/docs/ipdoc?c=mig_7series;v=latest;d=ug586_7Series_MIS.pdf)
4.7 | Working with Third Party Tools
4.7.1 | Third Party Synthesis Tools
 | MIG 7 Series can be synthesized with Synplify Pro | Search www.xilinx.com/support for answer records on Synplify Pro support
 | Other Third party synthesis tools have not been tested with MIG 7 Series IP
4.7.2 | Third Party Simulation Tools
 | MIG 7 Series can be simulated using Modelsim | 7 Series FPGAs Memory Interface Solutions Datasheet - DS176 (http://www.xilinx.com/cgi-bin/docs/ipdoc?c=mig_7series;v=latest;d=ds176_7Series_MIS.pdf)
 | Other third party simulation tools as VCS from Synopsys or NC-Sim from Cadence Design Systems have not been tested with MIG 7 Series IP | Xilinx Answer 51671 (http://www.xilinx.com/support/answers/51671.html)
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
