ciaa/Hardware/PCB/ACC/CIAA_ACC/doc/leer_fabricadas.txt

En este archivo se documenta quiénes tienen los PCBs fabricados al momento.

Última actualización: 19/09/2019

PRIMERA TANDA 5 PCBS ARMADOS EN ASEMBLI
17W30L165INT001 EDGARDO MARCHI INTI
17W30L165INT002 RODRIGO MELO INTI
17W30L165INT003 RODRIGO MELO INTI
17W30L165INT004/5 GUILLERMO GUICHAL EMTECH
17W30L165INT004/5 GUILLERMO GUICHAL EMTECH

SEGUNDA TANDA 5 PCBS ARMADOS EN ASEMBLI
18W33L202INT001 JUAN MAYA (ACTUALMENTE EN MANOS DE DIEGO ALAMON SATELLOGIC)
18W33L202INT002	ARIEL LUTENBERG (ACTUALMENTE EN MANOS DE GUICHAL EMTECH)
18W33L202INT003 ARIEL LUTENBERG (ACTUALMENTE EN MANOS DE GUICHAL EMTECH)
18W33L202INT004 ARIEL LUTENBERG (ACTUALMENTE EN MANOS DE NOELIA SCOTTI INTI)
18W33L202INT005 ARIEL LUTENBERG (ACTUALMENTE EN MANOS DE NOELIA SCOTTI INTI)

Marking code de las Zynq de la segunda tanda:
Placa 18W33L202INT002
XC7Z030 FBG676ABX1745 DD5476638A

Placa 18W33L202INT003 y 18W33L202INT004
XC7Z030 FBG676ABX1745 DD5500874A
