ciaa/Hardware/PCB/ACC/CIAA_ACC/doc/simulaciones/hyperlynx/DDR_Results_Jan-23-2018_10h-07m/DRV_Waveforms_Typ/net-_Principal_BANK_502_DDR_A0_drv-U1.K22_W1.csv

.HEADER
..NAMES
Time | V U1.K22
.DATA
0.0e+000 | 0.2440
4.59e-011 | 0.2440
9.18e-011 | 0.2440
1.378e-010 | 0.2440
1.837e-010 | 0.2440
2.296e-010 | 0.2440
2.755e-010 | 0.2440
3.215e-010 | 0.2440
3.674e-010 | 0.2447
4.133e-010 | 0.3174
4.592e-010 | 0.4914
5.052e-010 | 0.6291
5.511e-010 | 0.8130
5.970e-010 | 0.9769
6.430e-010 | 1.0873
6.889e-010 | 1.1594
7.348e-010 | 1.1892
7.807e-010 | 1.2099
8.266e-010 | 1.2206
8.726e-010 | 1.2256
9.185e-010 | 1.2301
9.644e-010 | 1.2263
1.0104e-009 | 1.2162
1.0563e-009 | 1.2228
1.1022e-009 | 1.2314
1.1481e-009 | 1.2449
1.1940e-009 | 1.2639
1.2400e-009 | 1.2488
1.2859e-009 | 1.2180
1.3318e-009 | 1.1839
1.3778e-009 | 1.1526
1.4237e-009 | 1.1539
1.4696e-009 | 1.1765
1.5155e-009 | 1.2024
1.5614e-009 | 1.2189
1.6074e-009 | 1.2111
1.6533e-009 | 1.1929
1.6992e-009 | 1.1734
1.7452e-009 | 1.1657
1.7911e-009 | 1.1813
1.8370e-009 | 1.2068
1.8829e-009 | 1.2312
1.9288e-009 | 1.2468
1.9748e-009 | 1.2463
2.0207e-009 | 1.2389
2.0666e-009 | 1.2340
2.1125e-009 | 1.2298
2.1585e-009 | 1.2287
2.2044e-009 | 1.2278
2.2503e-009 | 1.2243
2.2963e-009 | 1.2230
2.3422e-009 | 1.2236
2.3881e-009 | 1.2298
2.4340e-009 | 1.2399
2.4800e-009 | 1.2472
2.5259e-009 | 1.2496
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
