ciaa/Hardware/PCB/ACC/CIAA_ACC/doc/simulaciones/hyperlynx/DDR_Results_Jan-23-2018_10h-07m/DRV_Waveforms_Typ/net-_Principal_BANK_502_DDR_A10_drv-U1.M22_W1.csv

.HEADER
..NAMES
Time | V U1.M22
.DATA
0.0e+000 | 1.2291
4.59e-011 | 1.2291
9.18e-011 | 1.2291
1.378e-010 | 1.2291
1.837e-010 | 1.2291
2.296e-010 | 1.2291
2.755e-010 | 1.2291
3.215e-010 | 1.2291
3.674e-010 | 1.2159
4.133e-010 | 1.1025
4.592e-010 | 0.9585
5.052e-010 | 0.8323
5.511e-010 | 0.6854
5.970e-010 | 0.5354
6.430e-010 | 0.4041
6.889e-010 | 0.3299
7.348e-010 | 0.2842
7.807e-010 | 0.2634
8.266e-010 | 0.2511
8.726e-010 | 0.2458
9.185e-010 | 0.2495
9.644e-010 | 0.2512
1.0104e-009 | 0.2427
1.0563e-009 | 0.2317
1.1022e-009 | 0.2192
1.1481e-009 | 0.2141
1.1940e-009 | 0.2149
1.2400e-009 | 0.2350
1.2859e-009 | 0.2632
1.3318e-009 | 0.2854
1.3778e-009 | 0.2861
1.4237e-009 | 0.2740
1.4696e-009 | 0.2719
1.5155e-009 | 0.2726
1.5614e-009 | 0.2745
1.6074e-009 | 0.2690
1.6533e-009 | 0.2656
1.6992e-009 | 0.2663
1.7452e-009 | 0.2643
1.7911e-009 | 0.2546
1.8370e-009 | 0.2398
1.8829e-009 | 0.2292
1.9288e-009 | 0.2262
1.9748e-009 | 0.2279
2.0207e-009 | 0.2317
2.0666e-009 | 0.2363
2.1125e-009 | 0.2421
2.1585e-009 | 0.2459
2.2044e-009 | 0.2467
2.2503e-009 | 0.2585
2.2963e-009 | 0.3905
2.3422e-009 | 0.5409
2.3881e-009 | 0.6944
2.4340e-009 | 0.8703
2.4800e-009 | 1.0220
2.5259e-009 | 1.1210
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
