ciaa/Hardware/PCB/ACC/CIAA_ACC/doc/simulaciones/hyperlynx/DDR_Results_Jan-23-2018_10h-07m/DRV_Waveforms_Typ/net-_Principal_BANK_502_DDR_A11_drv-U1.H21_W1.csv

.HEADER
..NAMES
Time | V U1.H21
.DATA
0.0e+000 | 1.2292
4.59e-011 | 1.2292
9.18e-011 | 1.2292
1.378e-010 | 1.2292
1.837e-010 | 1.2292
2.296e-010 | 1.2292
2.755e-010 | 1.2292
3.215e-010 | 1.2292
3.674e-010 | 1.2266
4.133e-010 | 1.1568
4.592e-010 | 1.0180
5.052e-010 | 0.8759
5.511e-010 | 0.7214
5.970e-010 | 0.5518
6.430e-010 | 0.3977
6.889e-010 | 0.3020
7.348e-010 | 0.2403
7.807e-010 | 0.2095
8.266e-010 | 0.1961
8.726e-010 | 0.1976
9.185e-010 | 0.1938
9.644e-010 | 0.1923
1.0104e-009 | 0.1913
1.0563e-009 | 0.1956
1.1022e-009 | 0.2076
1.1481e-009 | 0.2350
1.1940e-009 | 0.2679
1.2400e-009 | 0.2967
1.2859e-009 | 0.3127
1.3318e-009 | 0.3114
1.3778e-009 | 0.2962
1.4237e-009 | 0.2773
1.4696e-009 | 0.2650
1.5155e-009 | 0.2644
1.5614e-009 | 0.2757
1.6074e-009 | 0.2903
1.6533e-009 | 0.2978
1.6992e-009 | 0.2919
1.7452e-009 | 0.2746
1.7911e-009 | 0.2520
1.8370e-009 | 0.2326
1.8829e-009 | 0.2225
1.9288e-009 | 0.2236
1.9748e-009 | 0.2328
2.0207e-009 | 0.2462
2.0666e-009 | 0.2586
2.1125e-009 | 0.2654
2.1585e-009 | 0.2641
2.2044e-009 | 0.2560
2.2503e-009 | 0.2447
2.2963e-009 | 0.2348
2.3422e-009 | 0.2304
2.3881e-009 | 0.2324
2.4340e-009 | 0.2387
2.4800e-009 | 0.2454
2.5259e-009 | 0.2487
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
