ciaa/Hardware/PCB/ACC/CIAA_ACC/doc/simulaciones/hyperlynx/DDR_Results_Jan-23-2018_10h-07m/DRV_Waveforms_Typ/net-_Principal_BANK_502_DDR_A12_drv-U1.P20_W1.csv

.HEADER
..NAMES
Time | V U1.P20
.DATA
0.0e+000 | 0.2439
4.59e-011 | 0.2439
9.18e-011 | 0.2439
1.378e-010 | 0.2439
1.837e-010 | 0.2439
2.296e-010 | 0.2439
2.755e-010 | 0.2439
3.215e-010 | 0.2439
3.674e-010 | 0.2475
4.133e-010 | 0.3314
4.592e-010 | 0.4909
5.052e-010 | 0.6582
5.511e-010 | 0.8398
5.970e-010 | 1.0255
6.430e-010 | 1.1439
6.889e-010 | 1.2079
7.348e-010 | 1.2454
7.807e-010 | 1.2618
8.266e-010 | 1.2631
8.726e-010 | 1.2702
9.185e-010 | 1.2759
9.644e-010 | 1.2767
1.0104e-009 | 1.2763
1.0563e-009 | 1.2790
1.1022e-009 | 1.2799
1.1481e-009 | 1.2796
1.1940e-009 | 1.2722
1.2400e-009 | 1.2488
1.2859e-009 | 1.2135
1.3318e-009 | 1.1802
1.3778e-009 | 1.1607
1.4237e-009 | 1.1639
1.4696e-009 | 1.1859
1.5155e-009 | 1.2101
1.5614e-009 | 1.2205
1.6074e-009 | 1.2111
1.6533e-009 | 1.1873
1.6992e-009 | 1.1646
1.7452e-009 | 1.1587
1.7911e-009 | 1.1742
1.8370e-009 | 1.2035
1.8829e-009 | 1.2329
1.9288e-009 | 1.2503
1.9748e-009 | 1.2513
2.0207e-009 | 1.2409
2.0666e-009 | 1.2276
2.1125e-009 | 1.2176
2.1585e-009 | 1.2136
2.2044e-009 | 1.2147
2.2503e-009 | 1.2048
2.2963e-009 | 1.1118
2.3422e-009 | 0.9742
2.3881e-009 | 0.8300
2.4340e-009 | 0.6777
2.4800e-009 | 0.5050
2.5259e-009 | 0.3738
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
