ciaa/Hardware/PCB/ACC/CIAA_ACC/doc/CHANGES.txt

Cambios realizados a la CIAA-ACC
================================

* Fecha: 18/07/2016
* Archivos: Archivos Kicad del esquemático y el PCB V0.0 con sus librerías. 
* Autores: Diego Alamon (INTI-CMNB) <dalamon EN inti.gob.ar>
* Descripción: Se publica la primera versión V0.0 sin revisar del esquemático finalizado y del PCB ruteado.

* Fecha: 11/10/2016
* Archivos: Archivos Kicad del esquemático y el PCB V1.0 con sus librerías. 
* Autores: Diego Alamon (INTI-CMNB) <dalamon EN inti.gob.ar>
* Descripción: Se publica la versión V1.0 del esquemático finalizado y del PCB ruteado. 

* Fecha: 17/10/2016
* Archivos: Archivos Kicad del esquemático y el PCB V1.1 con sus librerías. 
* Autores: Diego Alamon (INTI-CMNB) <dalamon EN inti.gob.ar>
* Descripción: Se publica la versión V1.1 con el cambio del conector de power.

* Fecha: 10/05/2017
* Archivos: Archivos Kicad del PCB V1.1B. Se agregó la identificación de capas en cobre. 
* Autores: Diego Alamon (INTI-CMNB) <dalamon EN inti.gob.ar>
* Descripción: Se publica la versión V1.1B con la identificación de capas.

* Fecha: 22/05/2017
* Archivos: Archivos Kicad del PCB V1.1C. Se agregaron cuatro fiduciales. 
* Autores: Diego Alamon (INTI-CMNB) <dalamon EN inti.gob.ar>
* Descripción: Se publica la versión V1.1C con los fiduciales.

* Fecha: 05/06/2017
* Archivos: Archivos Kicad del PCB V1.1D con gerber files. 
* Autores: Diego Alamon (INTI-CMNB) <dalamon EN inti.gob.ar>
* Descripción: Se publica la versión V1.1D con las modificaciones que solicitó
el fabricante del PCB en la máscara antisoldante y la pasta. 

* Fecha: 21/06/2017
* Archivos: Gerber editados por el fabricante del PCB EDADOC. Versión V1.1E. 
* Autores: EDADOC 
* Descripción: Se publica la versión V1.1E con las modificaciones que realizó el fabricante
EDADOC.

* Fecha: 24/05/18
* Archivos: Archivos Kicad del esquemático V1.2. 
* Autores: Diego Alamon (INTI-CMNB) <dalamon EN inti.gob.ar>
* Descripción: Se publica la versión V1.2 con el cambio del jumper JP4 y correcciones en 
el diagrama en bloques. Se cambian los códigos de Digikey de los componentes obsoletos. 

* Fecha: 28/03/2019
* Archivos: Archivos Kicad del esquemático V1.3. 
* Autores: Noelia Scotti (INTI-CMNB) <nscotti EN inti.gob.ar>
* Descripción: Se publica la versión V1.3 adecuada para Kicad 5. Corrección de
campos para Kicost. Notas aclaratorias sobre algunos componentes.

* Fecha: 29/03/2019
* Archivos: PCB, footprints y gerber files. Versión V1.1F. 
* Autores: Noelia Scotti (INTI-CMNB) <nscotti EN inti.gob.ar>
Bruno Valinoti  (INTI-CMNB) <valinoti EN inti.gob.ar>
* Descripción: Se publica la versión V1.1F con modificaciones menores. Se cambiaron
los componentes SMD que no aparecían en los pos files. Se corrigió la ubicación
de los designators U45 y U47. Se cambió el texto IND. ARG. por DISEÑADO EN ARG.  

* Fecha: 28/08/2019
* Archivos: Archivos Kicad del esquemático V1.4. 
* Autores: Noelia Scotti (INTI-CMNB) <nscotti EN inti.gob.ar>
* Descripción: Se publica la versión V1.4 del sch con una corrección en la hoja 
UART acerca del jumper JP4.
