ciaa/Hardware/(threads)

Thread 41 (2014-08-16):

Change gate voltage for IRF820 mosfets to +5V instead of +24V. Remove CCRs.

pridolfi, 2014-08-16:

pridolfi, 2015-04-20:
This issue has been enhanced in the production-candidate design. We can close this issue.

Closed 2015-04-20.

Thread 44 (2014-08-18):

MOSFET IRF820 son obsoletos, cambiar por FQT13N06L

jcecconi, 2014-08-18:
Actualmente existen MOSFET con mucha menor Rds (incluso con menor Vgs), menor Qg, menor disipación para igual ID, menor footprint,  etc...incluso a menor precio. Por lo tanto estuvimos viendo un poco lo disponible y encontramos los siguientes transistores (bajamos la Vds requerida a 60V aprox. porque la CIAA esta pensado para un tablero de 24V, no tiene sentido tener Vds de 500V)

Opcion para 60V: FQT13N06L

Opcion para 100V (alternativa 2): FDT86106LZ

La Rds en general pasó de 3 ohm a 100mOhm aprox. como dato más relevante y el footprint se redujo de D2PAK (TO-263) a SOT223

pridolfi, 2015-03-25:
Done, closed.

Closed 2015-03-25.

Thread 45 (2014-08-18):

Pines de Expansion con soporte para módulo PoE

jcecconi, 2014-08-18:
Agregar el ruteo de los pines del RJ45 ethernet para llevar eventualmente la entrada de PoE a un modulo de expansión y que luego este baje nuevamente hacia la CIAA alimentación de 24V => PoE opcional x expansión

pridolfi, 2015-03-25:
Done, closed.

Closed 2015-03-25.

Thread 47 (2014-08-21):

Jumpers para terminaciones en RS485 / CAN mediante pines de .1

jcecconi, 2014-08-21:
De esta manera se puede modificar en el campo, sin necesidad de tener un soldador!
Aquellos jumpers que no requieren modificación en el campo y que deben permanecer fijas, como por ejemplo una asignación de una GPIO para otra función, pueden realizarse con el puente de estaño

pridolfi, 2015-04-20:
Done, closed.

Closed 2015-04-20.

Thread 49 (2015-01-29):

CIAA-FSL: Entradas digitales

nscotti, 2015-01-29:
Los desarrolladores que tengan en sus manos una CIAA-FSL CEIBO v1.0 con wire wrap en las entradas digitales tengan en consideración lo siguiente:
Luego de las pruebas efectuadas a la versión CEIBO V1.0, se detectó que los pines utilizados para las entradas digitales, eran únicamente para entradas analógicas diferenciales. Por este motivo, se cablearon con wire wrap todas las placas armadas hasta el momento utilizando el conector de expansión GPIO de la siguiente manera:

Nro. Entrada | Pin GPIO Expansión |  Pin CPU
------------ | ------------- | -------------
I0 |GPIO14|PTC4
I1 |GPIO12|PTC5
I2 |GPIO10|PTC6
I3 |GPIO8|PTC7
I4 |GPIO6|PTC8
I5 |GPIO4|PTC9
I6 |GPIO2|PTC10
I7 |GPIO0|PTC11

Aunque este inconveniente está solucionado en la versión CEIBO v1.1, no se pudo mantener la misma disposición de pines aquí presentada.

Closed 2015-04-27.

Thread 53 (2015-04-27):

CIAA-FSL: Test points

nscotti, 2015-04-27:
The PDN test points like TP1101 and TP1102 have a 0.75 mm hole and 1.05 mm pad width in CIAA-FSL CEIBO 1.0 and CIAA-FSL CEIBO 1.1.
Ernesto Mayer S.A., the PCB manufacturer, told us that they will change the hole test points to 0.7 mm because of their manufacturing limitations.
It would be better to change the test points in the future PCB versions.

Thread 55 (2015-05-21):

CIAA-NXP: DOUT0 ~ 3 LED indicators are inverted, should be corrected

elpablogomez, 2015-05-21:
Regarding DOUT0 ~ DOUT3, the silkscreens in the PCB seems not to be correspondent with the ones in the schematics.

For instance, DOUT0 is related to led D23 but in the PCB silkscreen below D0 the led is named D35.

Here some pictures of this issue:
https://drive.google.com/file/d/0BzDUEsyhMBU3c1Z1dURrYkVFSjA/view?usp=sharing
https://drive.google.com/file/d/0BzDUEsyhMBU3aVppNEZtdnozMWM/view?usp=sharing

jcecconi, 2015-05-21:
Please check Terminal Blocks and LEDs of digital inputs (DINx), related
with this pdf file. I think They are wrong too.
POSIX dio driver must be checked too with this file.

2015-05-21 10:13 GMT-03:00 elpablogomez <notifications@github.com>:

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

Thread 56 (2015-05-24):

CIAA-NXP and EDU-CIAA-NXP: 15kOhm pull-down resistors are required for USB Host operation

pridolfi, 2015-05-24:
Current schematic for EDU-CIAA-NXP:
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

Current schematic for CIAA-NXP:
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

See reference (Xplorer LPC43xx):
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

pridolfi, 2015-05-24:
False alarm: Pull-down resistors are located in CPU sheet. :-)
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

Closed 2015-05-24.

Thread 57 (2015-06-02):

CIAA-FSL and CIAA-NXP: Input PTC should be replaced.

nscotti, 2015-06-02:
MF-SM300 (TH1101 in CIAA-FSL, TH1 in CIAA-NXP) should be replaced by another PTC because of the VDC parameter. VDC should be greater than 24 V.
One option is use the Littelfuse part number **1812110/33** (http://www.littelfuse.com/~/media/electronics/datasheets/resettable_ptcs/littelfuse_ptc_1812l_datasheet.pdf.pdf). This part number is already used in CIAA-FSL board. **The footprint is smaller** but is the best option for not adding a new component.
Another option is use a Bourns part number with the same size of MF-SM300: **MF-SM100** (http://www.bourns.com/data/global/pdfs/mfsm.pdf).

pridolfi, 2015-06-02:
We need to check all PTCs, VDC parameter seems to be wrong. :-(

pridolfi, 2015-08-10:
TH1 recomendable: 2A 24V 2920
0ZCF0200FF2C
http://ar.mouser.com/ProductDetail/Bel-Fuse/0ZCF0200FF2C/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

Thread 58 (2015-06-05):

CIAA-FSL: D1108 Digikey code

nscotti, 2015-06-05:
Replace the Digikey field value of the D1108 diode in the schematics and generate a new BOM.
WRONG: BAT54FSCT-ND
CORRECT: BAT54CLT1GOSCT-ND

Thread 59 (2015-06-12):

Reset al tocar battery holder

mirkovich0, 2015-06-12:
Se resetea el microcontrolador (no necesariamente siempre) al tocar con la mano el zócalo de la batería (metálico, accesible desde afuera) si no se encuentra la batería presente (posiblemente poniendo la batería no suceda).

Se encuentra que el pin está conectado directo al micro, sin ningún filtrado.

cuencagonzalo, 2015-06-18:
Revisando los esquemáticos, veo que ambas NXP (CIAA y EDU-CIAA), están conectadas de la misma manera.  La CIAA-FSL tiene un capacitor de 100nF filtrando.

mabeett, 2016-11-08:
Confirmo problema con edu-ciaa-nxp A45570756.

mabeett, 2016-11-09:
Confirmo el problema en CIAA-NXP sin número de serie, de prelanzamiento, con soporte para batería y sin batería montada.
También en CIAA-NXP Número de código de barras CIAA0192, que tiene pila soldada. La pila tiene poca carga (0.9V en vez de 3) la inestabilidad con el ruido existe también.

Thread 60 (2015-07-16):

Flash qSPI (U20) package should be replaced.

pridolfi, 2015-07-16:
WSOIC8 (S25FL127SABMFI101) is too big for current footprint. WSON8 (S25FL127SABNFI101) may fit better.

Thread 61 (2015-07-21):

CR2032 battery shorts resistor R137

elpablogomez, 2015-07-21:
When the CR2032 battery is inserted in the slot and pushed all the way, GND (back part of the battery) shorts one terminal of resistor R137.

After inserting the battery, the prototype I´m using doesn´t seem to work anymore.

pridolfi, 2015-08-03:
CR2032 battery should be placed with the board unplugged and taking care of this issue. R137 is tied to +5V and possibly made a shortcircuit with VBAT pin on LPC4337 :-(
@elpablogomez, can you confirm that the microcontroller in your board is not working anymore?

elpablogomez, 2015-08-05:
@pridolfi I don't have the board with me anymore.
Thank you!

Thread 64 (2015-11-06):

CIAA-FSL: D301 is inverted on CEIBO 1.0 and CEIBO 1.1 schematics.

nscotti, 2015-11-06:
D301 is connected to the Ethernet PHY Reset but it is inverted. It has to be corrected in the next version.

Thread 73 (2017-08-05):

Problemas en arranque cuando se usa el oscilador a XT (CIAA NXP y EDU CIAA NXP)

jcecconi, 2017-08-05:
Descripción:
    Cuando la placa se pone a funcionar con el código de arranque de lpcopen, el mismo a veces es errático. Hay que resetearlo varias veces para que funcione porque parece quedarse colgada

Causa:
        Por un problema de HW, el cristal indicado como X2 que se ha colocado es incorrecto. El LPC4337 indica en su datasheet que la Max. ESR tolerable para el cristal es de 160 ohm, si esto no se respeta el arranque puede no ocurrir, o bien en vez de hacerlo en pocos uS puede tardar varios mS

- **BOM CIAA NXP Full**: Los XT de 12MHz indicados son
    mouser: [732-FA-238V12MB-W3](http://www.mouser.com/ProductDetail/Epson/FA-238V-120000MB-W3/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)
   digikey: [SER3683CT-ND](https://www.digikey.com/products/en?keywords=SER3683CT-ND)
    Ambos corresponden al mismo Nro de Parte FA-238V 12.0000MB-W3 , que en TEORIA sería el correcto, tiene ESR 100 ohm (max. admisible x datasheet 160 ohm)

    **Conclusión CIAA NXP Full**:
            Respetando la BOM debería funcionar. Posiblemente los componentes de reemplazo que se utilizaron no fueron verificados que cumplan dicha condición. Se encontré fallas en algunos que se los pudo identificar como de la marca [NDK](http://www.ndk.com/en/products/search/crystal/index.html) aunque se desconoce el modelo exacto elegido.

    **Workaround**:
           Para quien no le anda, tiene que usar un retardo luego que se habilita el XT ([ver issue de FW](https://github.com/ciaa/firmware_v2/issues/35))

- **BOM EDU CIAA NXP**: Los XT de 12MHz indicados son
    mouser: [732-FA-238V12MB-W3](http://www.mouser.com/ProductDetail/Epson/FA-238V-120000MB-W3/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)
    digikey: [887-1831-1-ND](https://www.digikey.com/products/en?keywords=887-1831-1-ND)

Ambos corresponden al DISTINTO Nro de Parte, el de mouser es igual al original de la BOM de la CIAA NXP full FA-238V 12.0000MB-W3 , que en TEORIA sería el correcto (ESR 100 ohm). Pero el de MOUSER ES INCORRECTO, tiene ESR 200 ohm (max. admisible x datasheet 160 ohm)

    **Conclusión EDU CIAA NXP**:
     Problema en la BOM para XT de Digikey!!!...Se detectó que el XT colocado está fuera de las especificaciones, tal como se ve en una de las imagenes adjuntas

    **Workaround**:
     Para quien no le anda, puede usarlo en modo IRC o bien tiene que usar un retardo luego que se habilita el XT ([ver issue de FW](https://github.com/ciaa/firmware_v2/issues/35))

**Solución de fondo**:
    Cambiar el XT por el que corresponde

X2 encontrado en EDU-CIAA-NXP de Digikey
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

Arranque lento (7,5ms) debido a X2 incorrecto
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

Arranque correcto (300 uS) usando un X2 correcto
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

Cristal usado cno arranque correcto  (footprint incompatible, solo para prueba)
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

Thread 76 (2017-10-30):

CIAA-ACC: JP4 resistor must be a 20K resistor.

nscotti, 2017-10-30:
The BOM includes a 0 ohm resistor for JP4 but this pin is also used for QSPI_SCK signal. Replace JP4 jumper with a 20K resistor.

nscotti, 2019-03-29:
This bug is fixed on schematic V1.3 and BOM V1.3.

Closed 2019-03-29.

Thread 77 (2017-10-30):

CIAA-ACC: SD card detect signal is necessary for booting from SD.

nscotti, 2017-10-30:
In the 1.0 schematic version the SD card detect signal was not considered.
Although some boards boot fine from SD, others don't boot (perhaps because of different chip versions). In the future schematic versions it is recommended to connect the MIO_0 pin to SD card detect signal.
https://www.xilinx.com/support/answers/52016.html
https://www.xilinx.com/support/answers/61064.html
https://www.xilinx.com/support/answers/59476.html

Thread 79 (2018-10-08):

RESET GPIO

martinribelotta, 2018-10-08:
### Description

The reset state of GPIO pins contains weak pullup (40-47K ~80uA). This cause spureous output activation in reset state and program download.

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

The output pulldown is 100K for CIAA-NXP and 330K for EDU-CIAA. this put the FET or BJT in polarized state.

### FIX recomendation

  - Shrink the pulldown to ~10K due to prevent output transistor polarization, or...
  - Invert activation polarity of output circuit, or...
  - Detect in and-fashion circuit reset condition and disable all outputs

Thread 80 (2019-03-28):

CIAA-ACC: There is no 12V on FMC connector.

nscotti, 2019-03-28:
The hardware designer decided to not use 12V on board in order to achieve the maximal efficiency of the power supply. In future versions of the board it is necessary to evaluate the 12V voltage need.

Thread 81 (2019-07-06):

Not an issue: Would you want your project geographically re-annotated?

BrianAtDocumentedDesigns, 2019-07-06:
Hello

I am Brian Piccioni. I wrote a utility RenumKiCadPCB (www.documenteddesigns.com) which re-annotates PCBs geographically and back-annotates the schematics. Because components are ordered logically (left to right, top to bottom usually) this makes assembly and debug much easier. I hope to integrate the function into KiCad V6.

I was directed to your project because it is complex so I use it to test my software. Most test projects I use such as icezum and DIY-Laptop are already geographically annotated however I noticed yours is not.  If you wish, please email me at brian@documenteddesigns.com and I will re-annotate your project for you. If you wish you can download RenumKiCadPCB from https://github.com/BrianAtDocumentedDesigns/RenumKiCadPCBo410 and do it yourself.

regards

Brian Piccioni

Closed 2020-02-19.

Thread 82 (2019-10-08):

The schematic v1.4 (pdf) was turned to the left and is not possible to find text on it

rodrigomelo9, 2019-10-08:
Check the [schematic v1.4](https://github.com/ciaa/Hardware/blob/master/PCB/ACC/CIAA_ACC/output_files/ciaa_acc_sch_v1.4.pdf) to see the problem. v1.3 is ok.

nscotti, 2019-10-18:
Fixed!

Closed 2019-10-18.

Thread 83 (2019-11-26):

CIAA-ACC: 3.3V to CAN IC U36 feeds through to VCCO_HR (Vadj) on FPGA banks.

gguichal, 2019-11-26:
#CIAA-ACC

3.3V at U36 feeds through to VCCO_HR on the FPGA input pins. Potential solutions include reviewing U36 to find an alternative chip that allows using variable voltage levels at VCC or using a level shifter on the Rx pin.

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

Thread 87 (2020-05-23):

BOM Consolidation

hjf, 2020-05-23:
Buenas. Este proyecto fue mostrado como ejemplo de una mala consolidacion de BOM por el youtuber EEVBlog y dio varios consejos para simplificar el proyecto para manufactura. Link del video: https://www.youtube.com/watch?v=RwVzLOI4cmA

En particular, el BOM para este producto contiene 161 componentes distintos. Las pick and place mas avanzadas tienen espacio para 80 componentes como maximo y 161 valores implicaria 3 pasadas por la maquina, por UN componente, en lugar de dos, aumentando significativamente el costo.

Las sugerencias que da:

Existen varios valores de componentes muy especificos que pueden ser reemplazados, en particular en los pines de compensacion de los reguladores de voltaje, que requieren de valores de capacitanciad de 11 y 13pf. El autor del video se pregunta si es necesario en este pin, que es basicamente un filtro, que los valores sean tan criticos.

Para el feedback de voltaje se usa 2 valores de resistencias E96 pudiendo reducirse a solo 1 valor, si se fija una de ellas a un valor E12 estandar (10K) y se elige otra (o una combinacion) para la otra resistencia del divisor de feedback.

nscotti, 2020-05-26:
Muchas Gracias por las sugerencias!
Saludos,
Noelia

Quoting hjf <notifications@github.com>:

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

Thread 88 (2020-09-10):

CIAA-Safety V1.0: U1 and U3 have no connection to GND on pin 2.

nscotti, 2020-09-10:
In order to use CAN interfaces it is necessary to connect U1 and U3 to GND. In the V2.0 version it will be fixed.

Thread 91 (2020-10-10):

Include construction layout

juhas83, 2020-10-10:
It would be useful to include an image, that shows the PCB board with important distances. For example: distances from mounting holes, distances from connectors, overall board dimensions, etc.

Thread 94 (2024-10-18):

Updating the files to KiCAD V8

Daniel-Ismail, 2024-10-18:
This issue involves updating existing KiCad project files to be **compatible** with **KiCad V8**. The update process includes:

1. Ensuring all schematic and PCB layout files are migrated without data loss or errors.
2. Verifying the integrity of libraries and footprints to align with the latest version.
3. Resolving any symbol or footprint conflicts that may arise from the update.
4. Updating custom scripts or plugins, if applicable, to ensure compatibility with KiCad V8.
