ciaa/Hardware/PCB/EDU-FPGA/Pinout/Pinout EDU FPGA.pdf

# Asignación de Pines

## UART

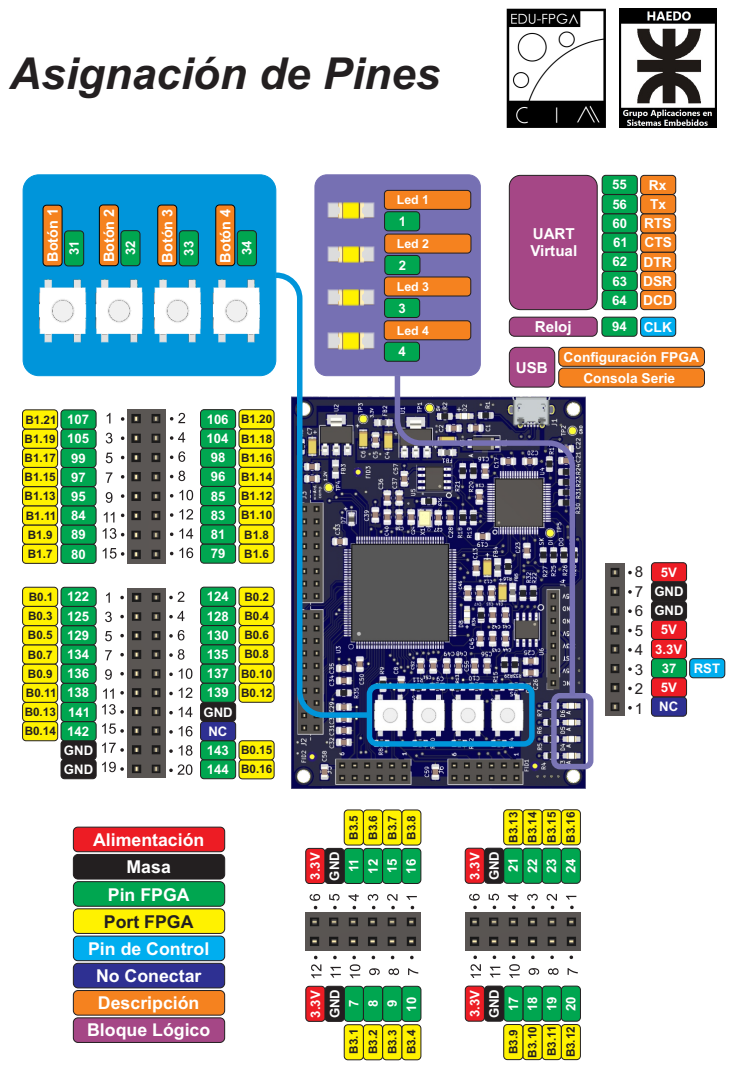
[picture p94: page 1]
GND; Consola Serie; Botón 1; Botón 3; Botón 2; Botón 4; 37 RST; Led 1; CLK; DCD; DSR; DTR; CTS; RTS; Virtual; Reloj; Led 2; Led 3; Led 4

USB Configuración FPGA

Alimentación
Masa
Pin FPGA
Port FPGA
Pin de Control
No Conectar
Descripción
Bloque Lógico
