ciaa/Hardware/PCB/EDU-XILINX/OtherBoards/Arty/Schematics-Artix-35T-Arty.pdf

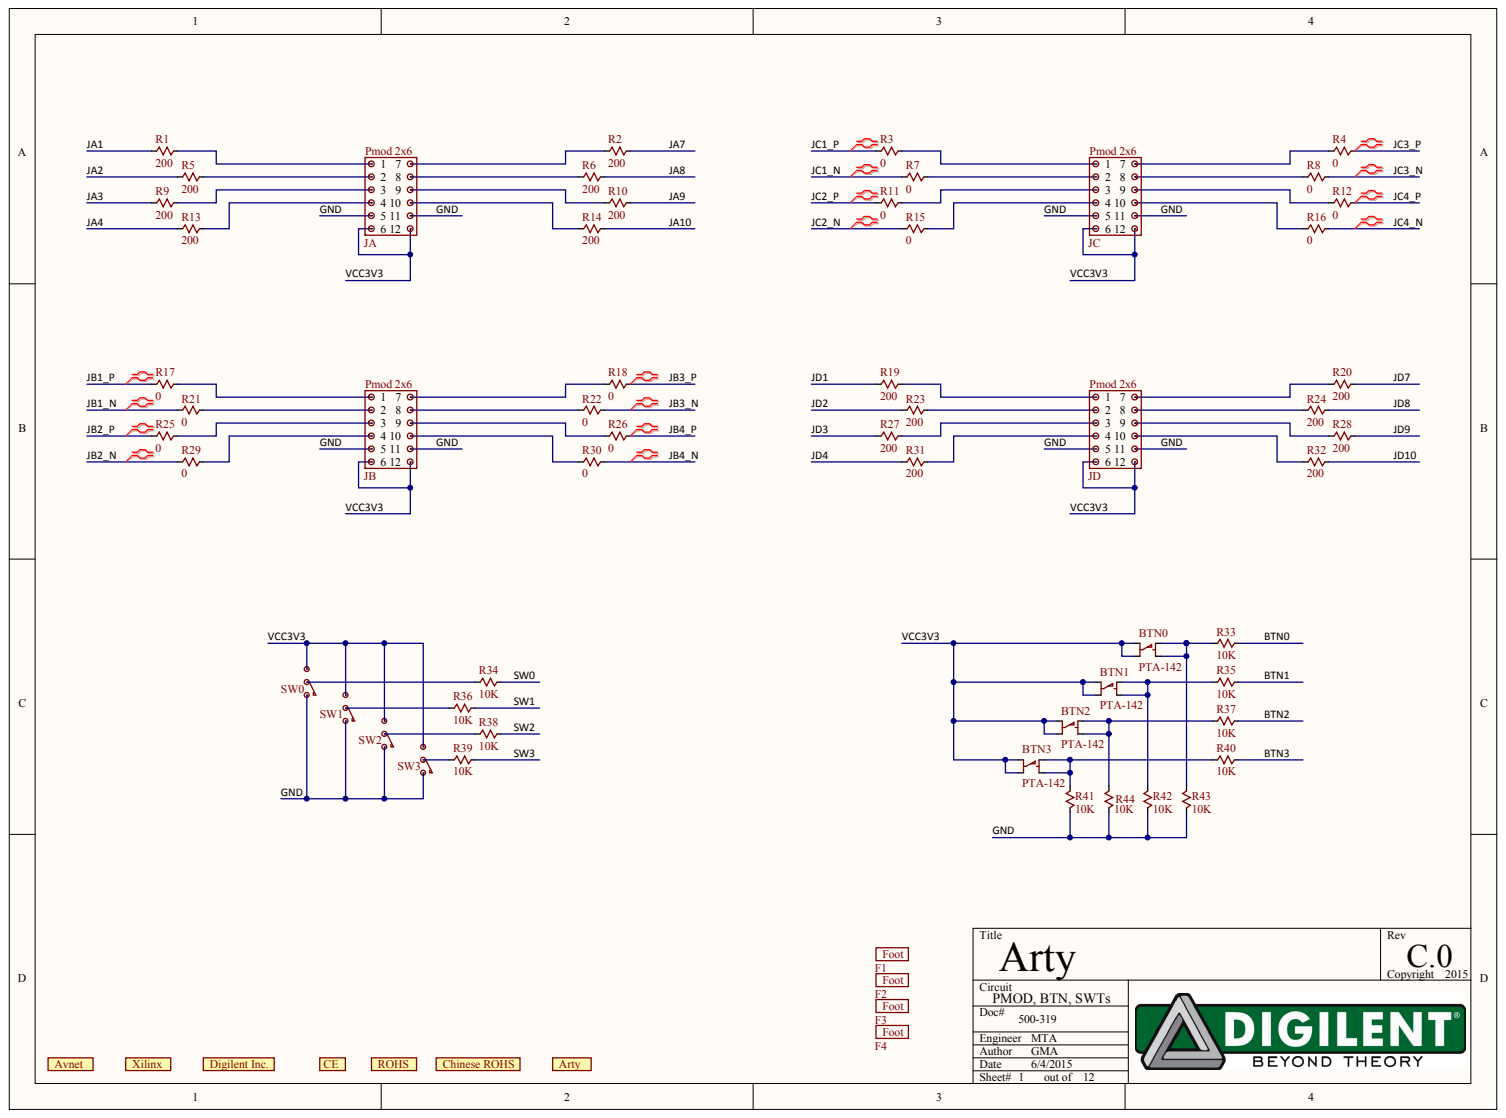
[picture p95: page 1]

Title Arty | Rev C.0 Copyright 2015

Circuit PMOD, BTN, SWTs

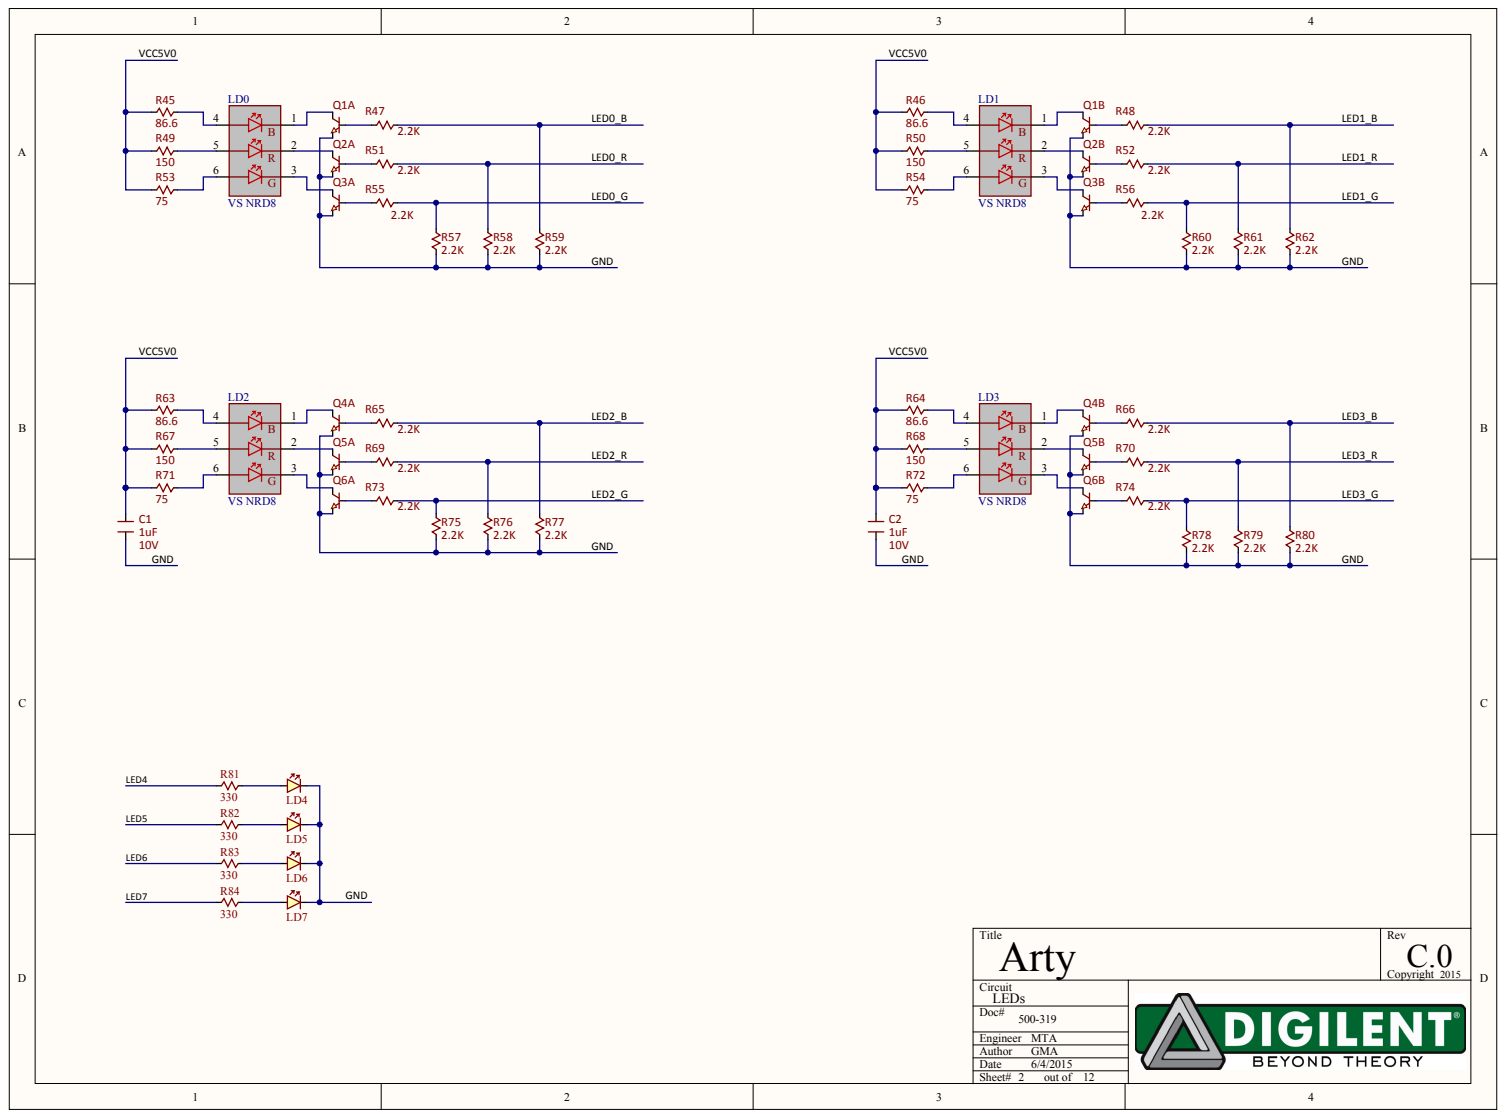
[picture p96: page 2]

Title | Rev Co p yrig h t 2015
Arty Circuit LED s | C.0 out of 12

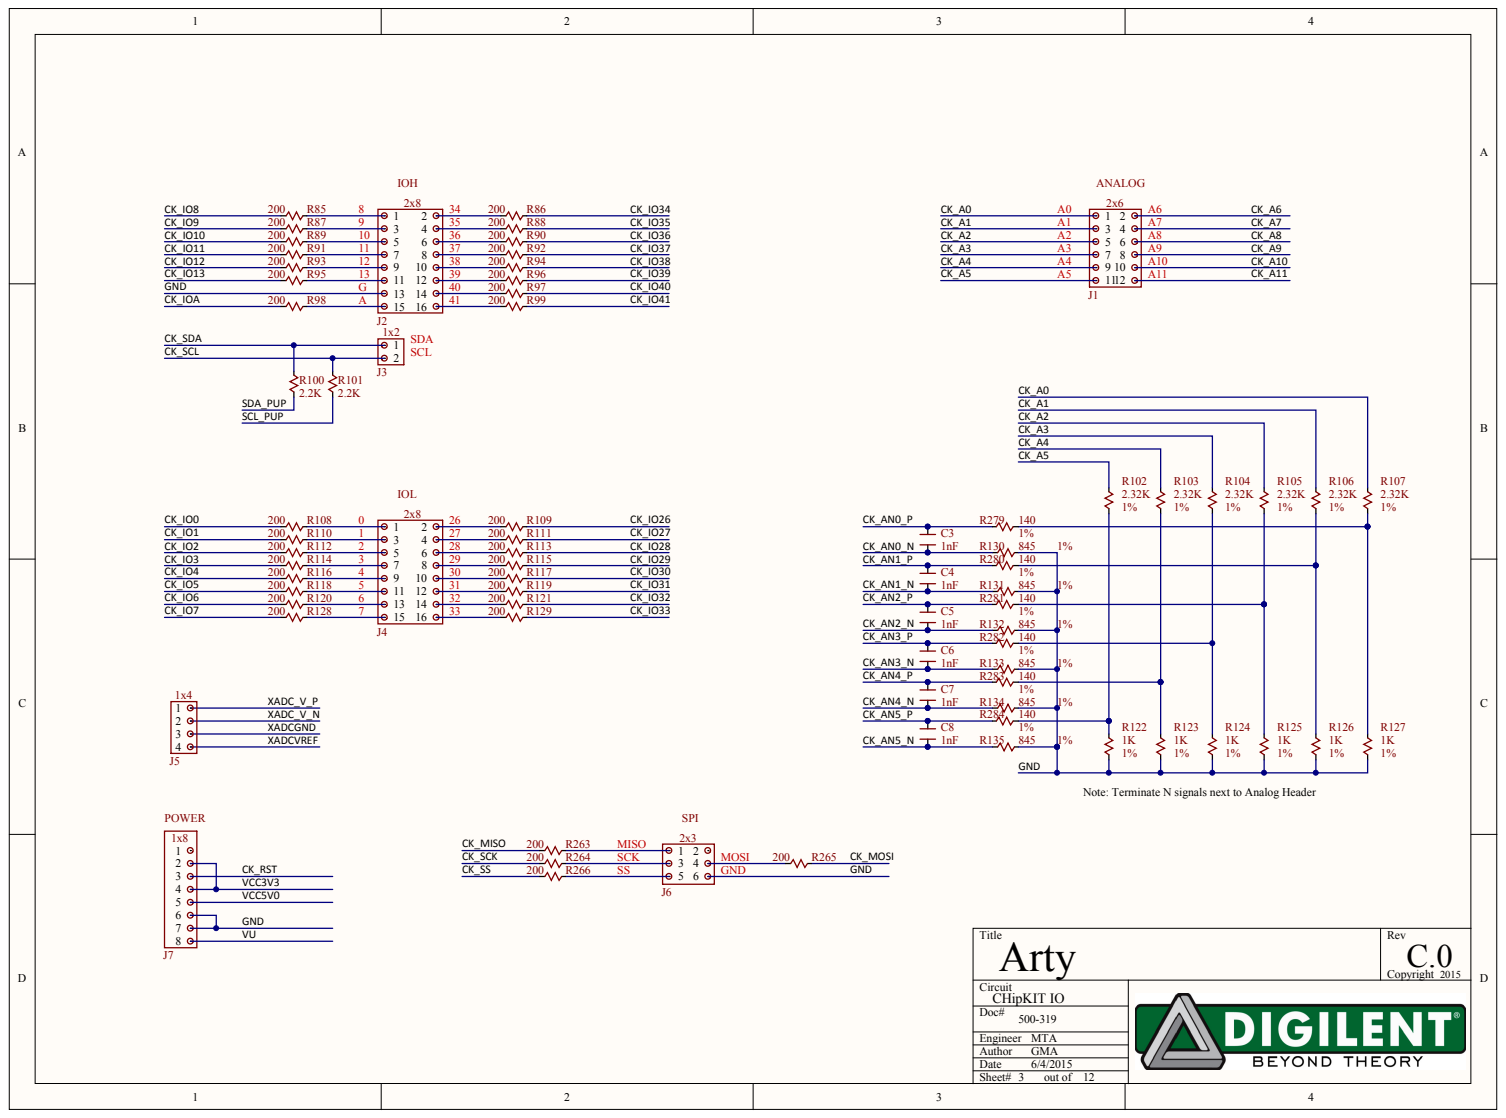
[picture p97: page 3]

nals next to Analo

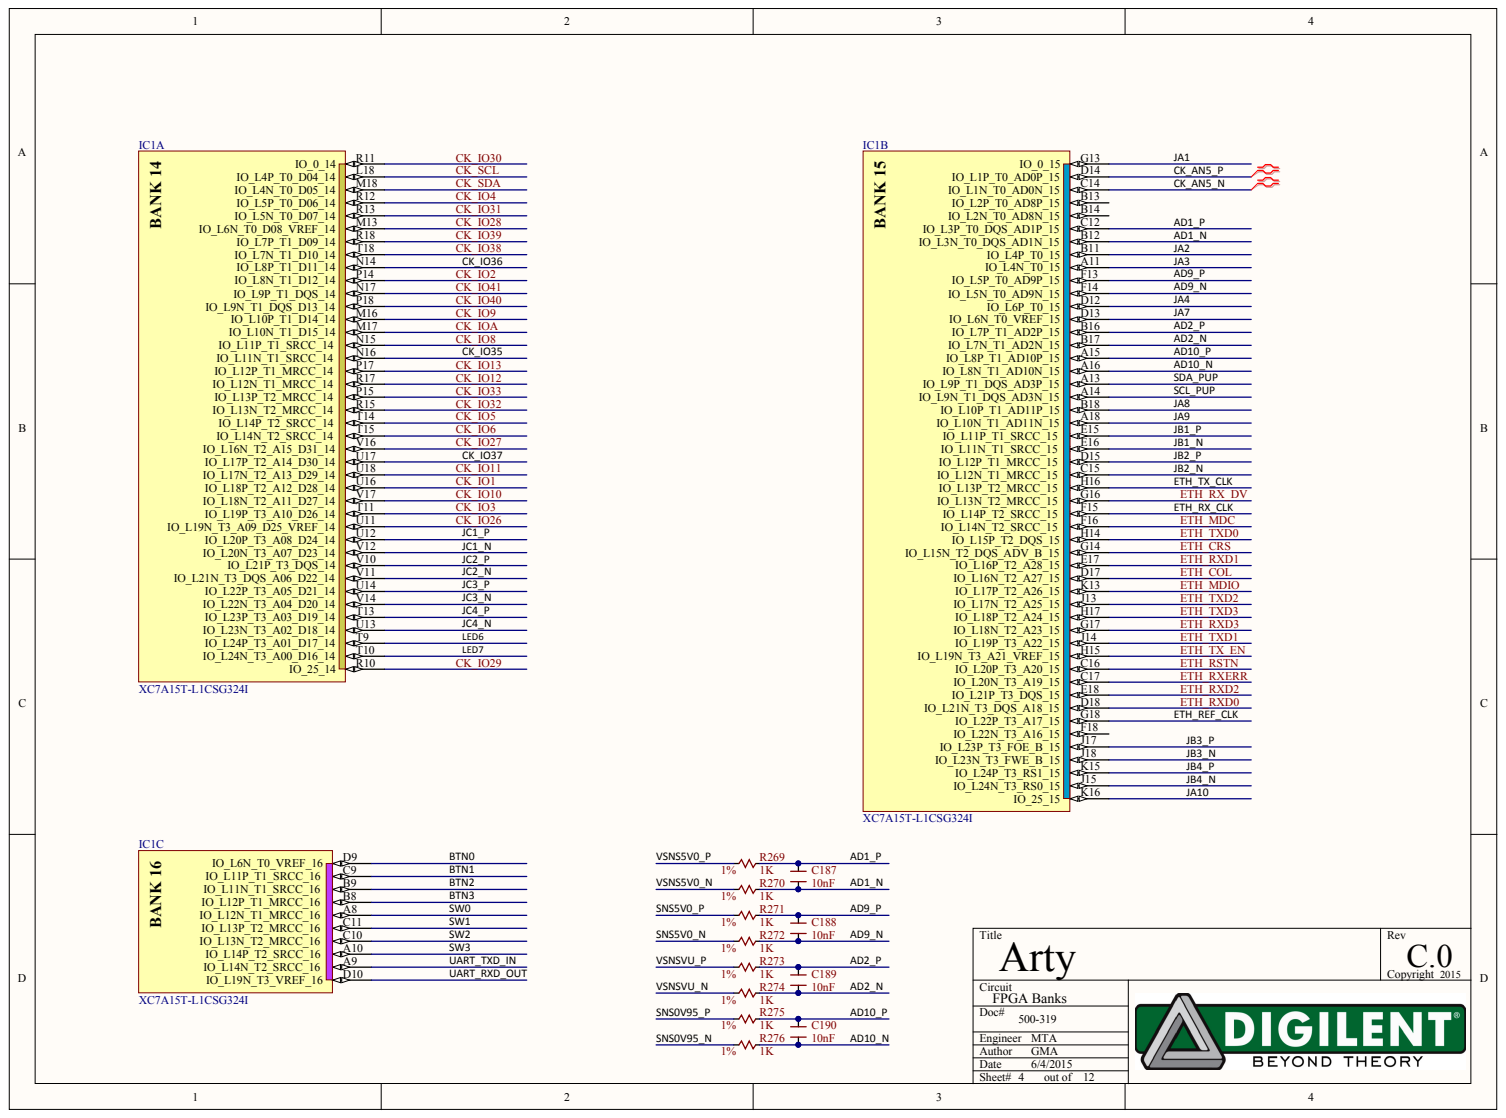
[picture p98: page 4]

Title | Rev Co p yrig h t 2015
Arty Circuit A Banks | C.0 out of 12

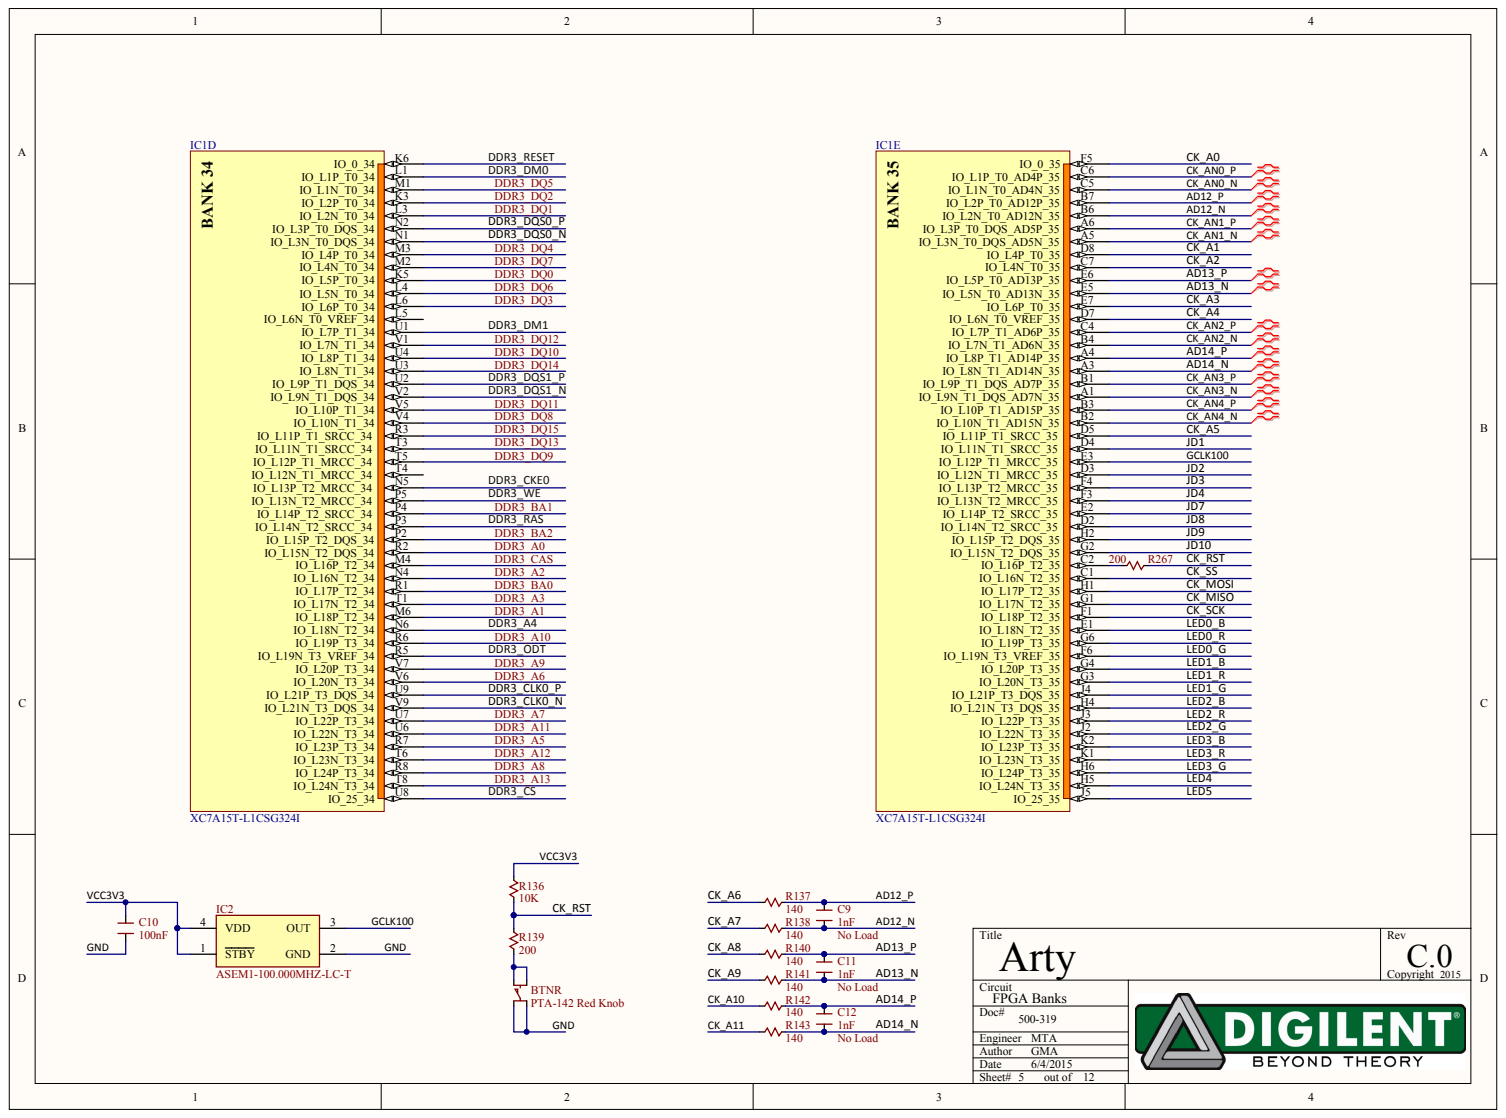
[picture p99: page 5]

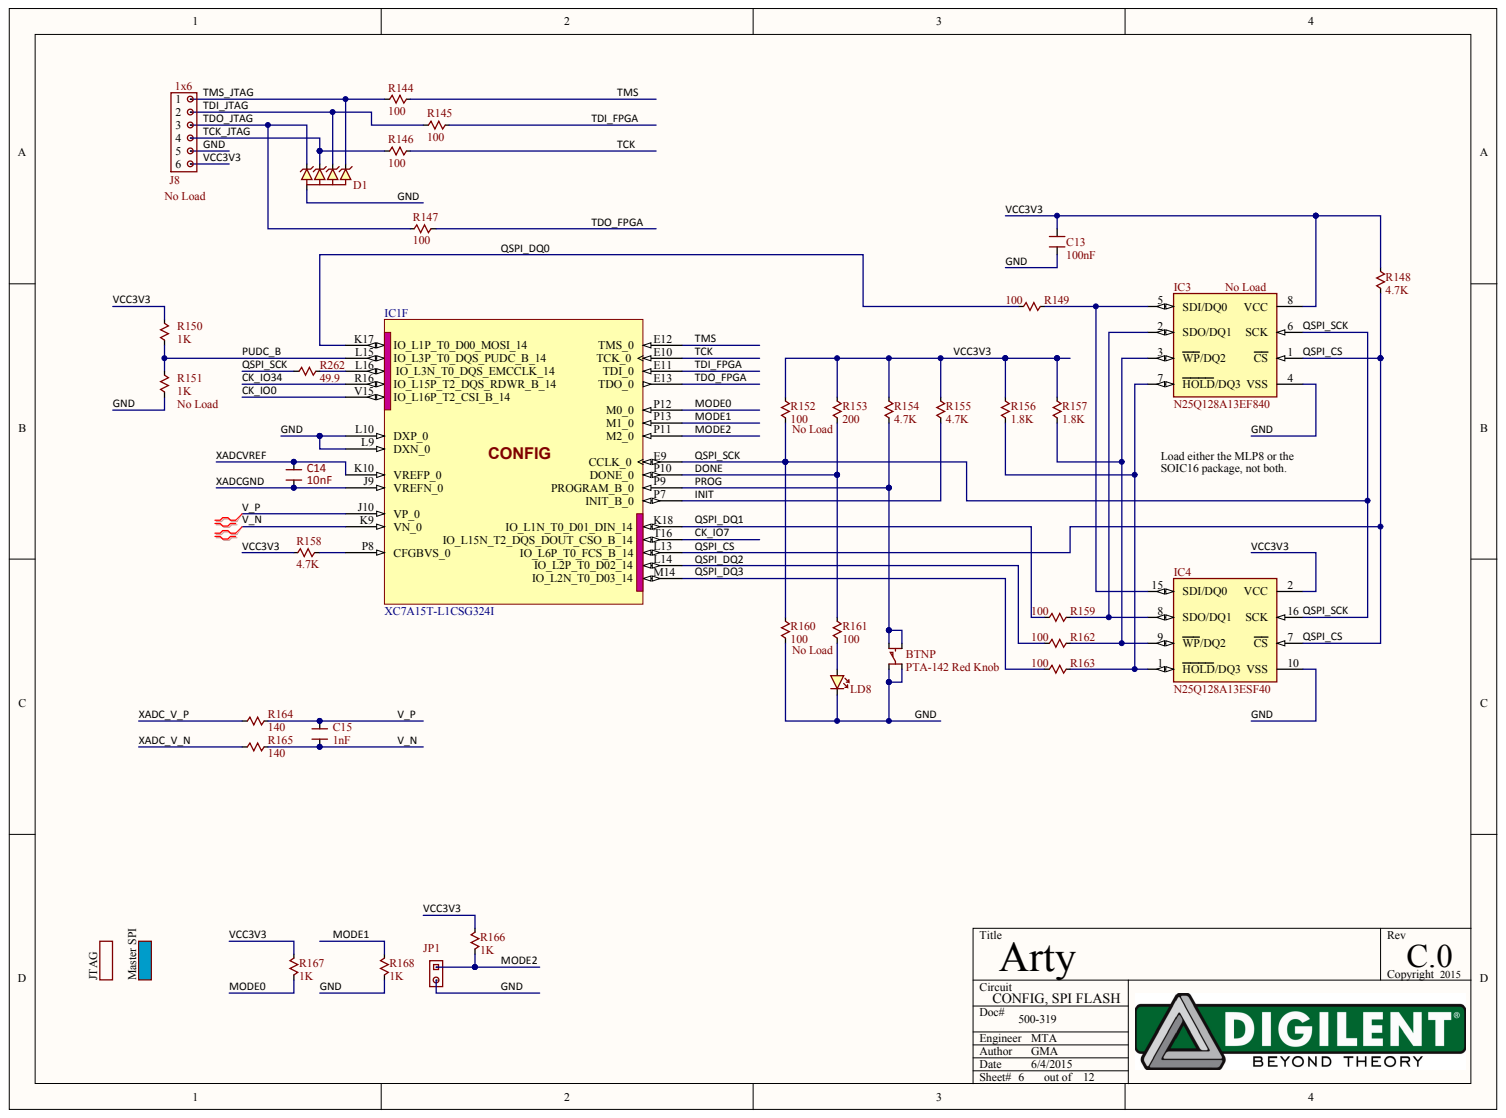
[picture p100: page 6]

TDO_JTAG
TCK_JTAG
R146 GND
VCC3V3 | | D1

Load either the MLP8 or the
SOIC16 package, not both.

VP_0 J10 VN_0 K9 CFGBVS_0 P8 | | INIT

QSPI_DQ1
CK_IO7 | | VCC3V3

QSPI_DQ2 | IC4 | QSPI_SCK
QSPI_DQ3

No Load | BTNP

LD8 | GND

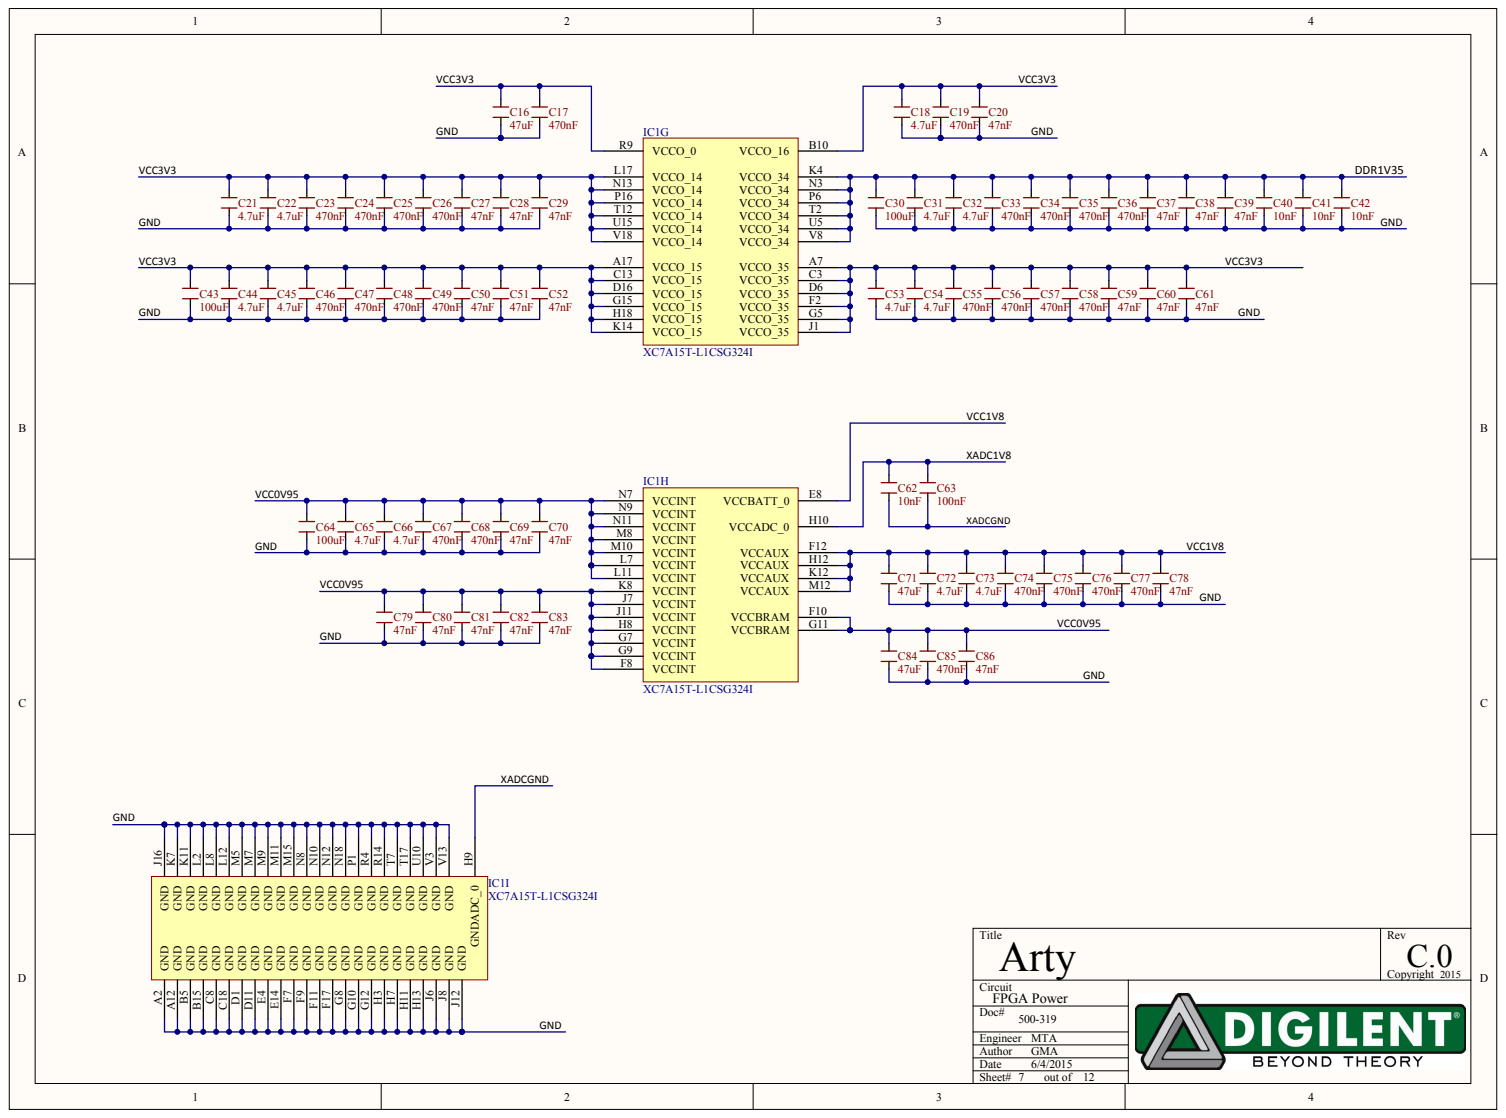
[picture p101: page 7]

GND M15 GND M11 GND M9 GND M7 GND M5

GND N18 GND N12 GND N10 GND N8

Title Arty | Rev C.0 Copyright 2015

GND F17 GND F11 GND F9 GND F7

GND H13 GND H11 GND H7 GND H3

Circuit FPGA Power

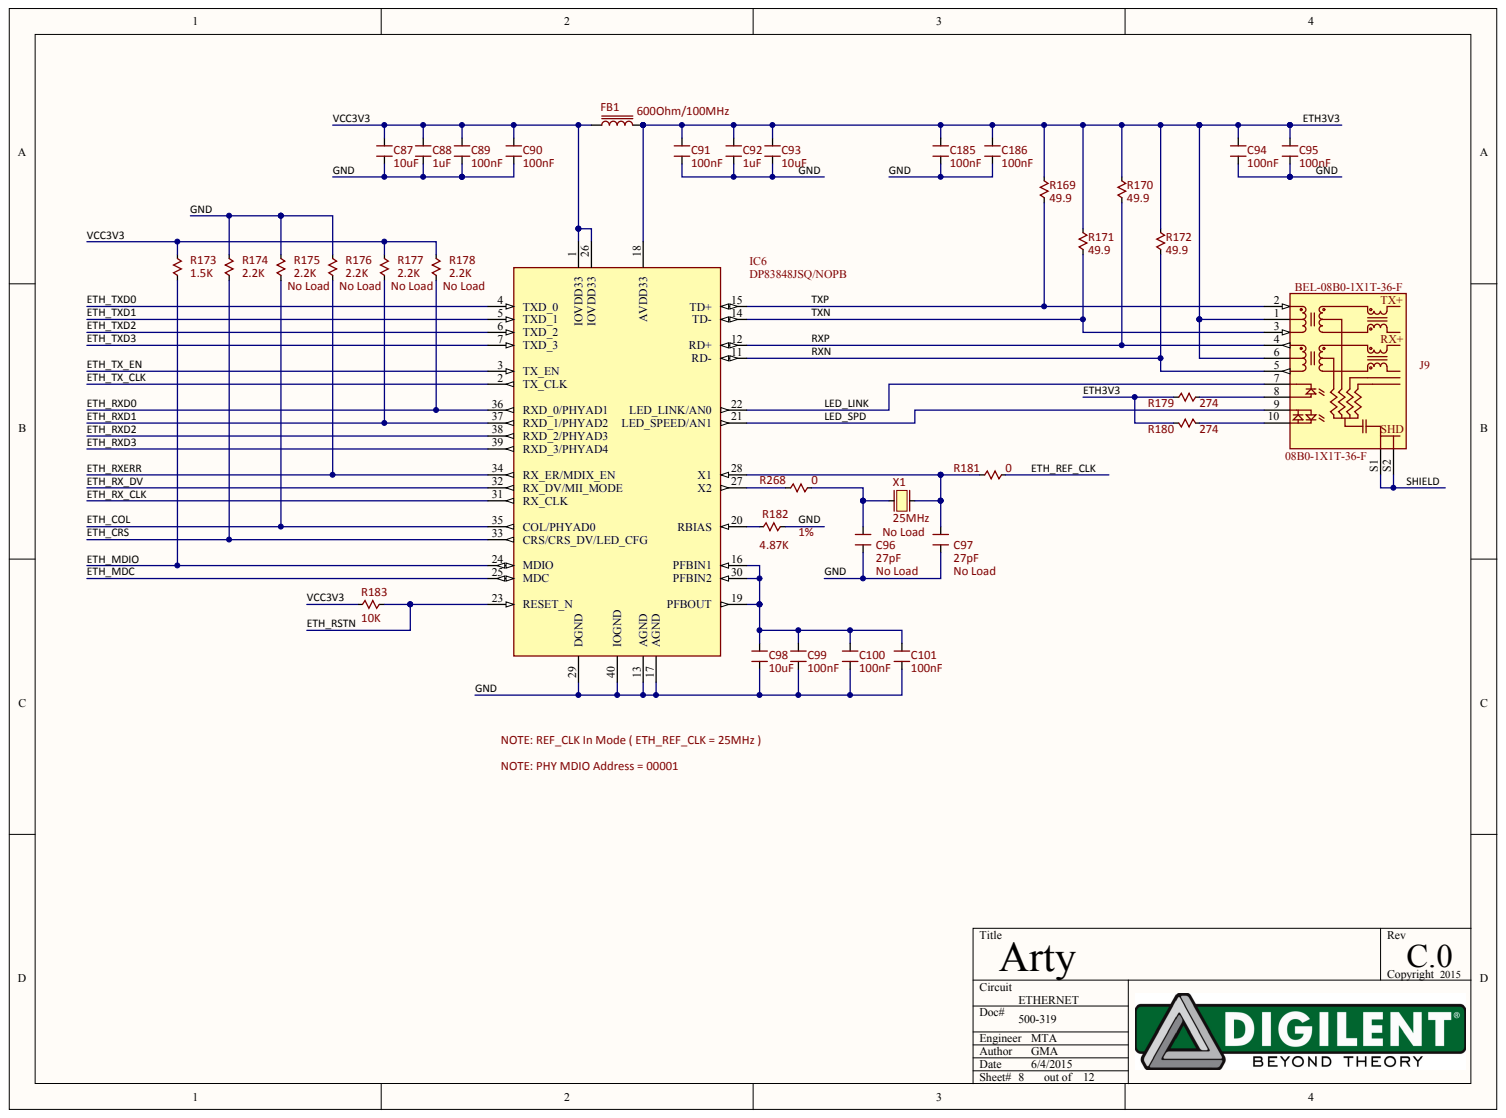
[picture p102: page 8]

TXD_1 5
TXD_2 6 | RXN
TXD_3 7

TX_CLK 2 TX_EN 3

RXD_1/PHYAD2 37 | LED_SPD | 10
RXD_2/PHYAD3 38

RX_ER/MDIX_EN 34

GND | 27pF No Load

RESET_N 23

NOTE: PHY MDIO Address = 00001

Title Arty | Rev C.0 Copyright 2015

Circuit ETHERNET

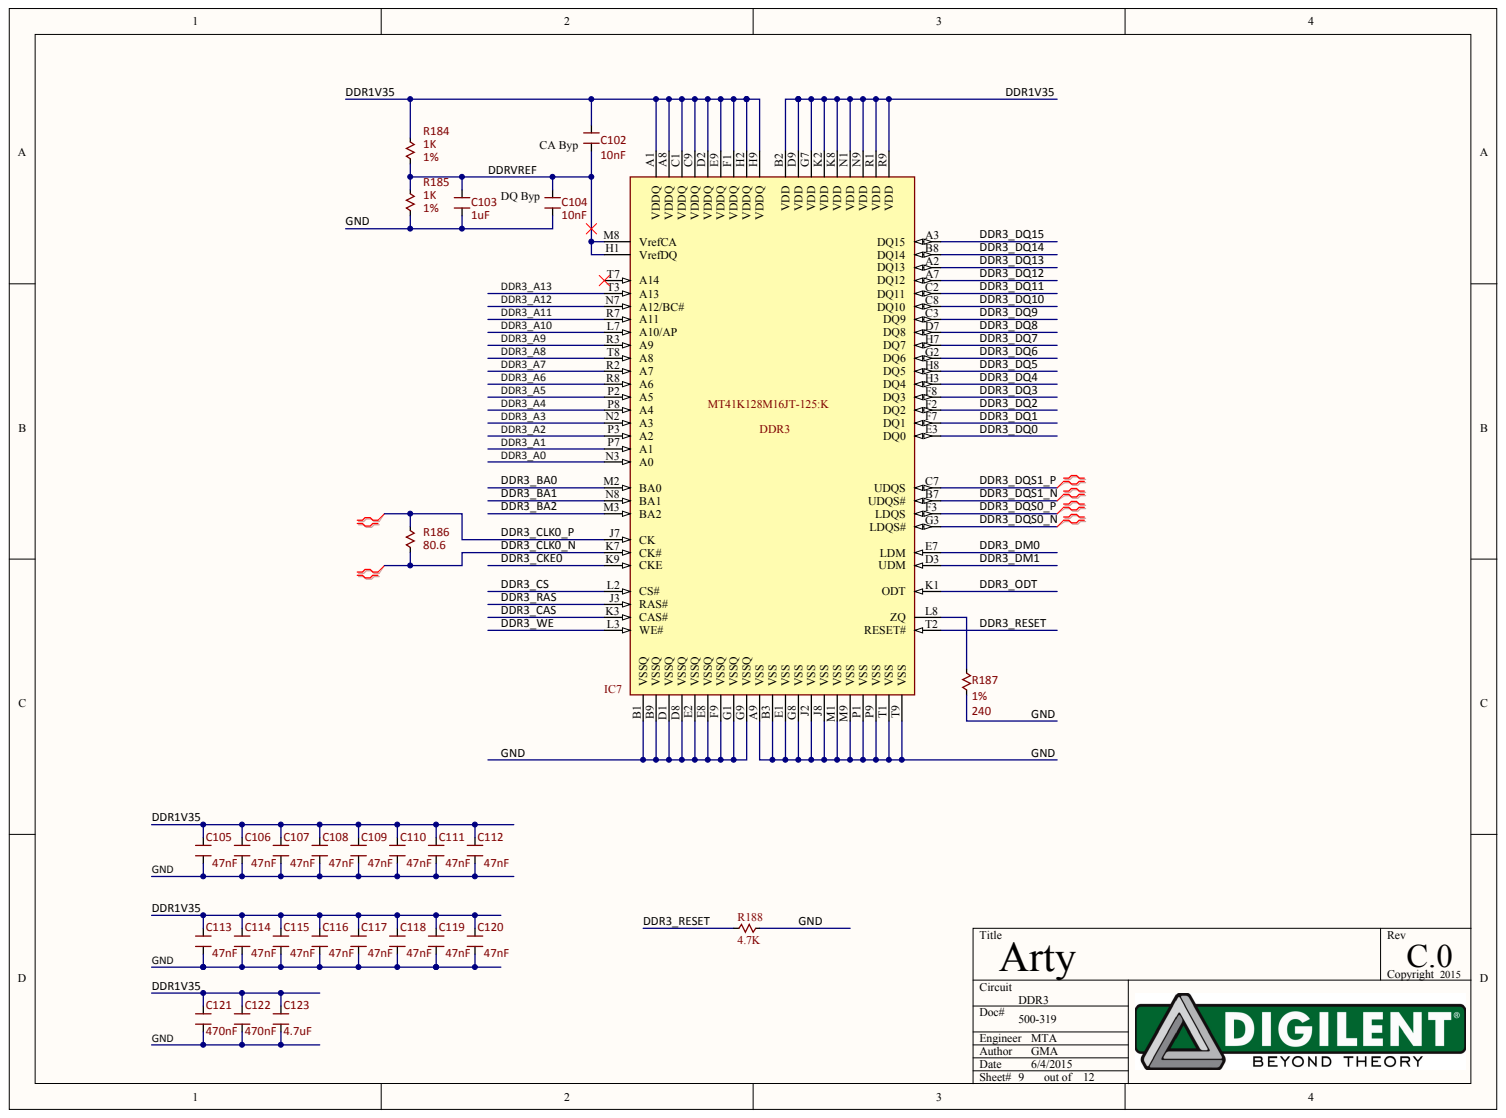
[picture p103: page 9]

R186 DDR3_CLK0_P | CK J7

DDR3_CKE0 | CKE K9

Title Arty | Rev C.0 Copyright 2015

Circuit DDR3

# This Page Intentionally Left Blank

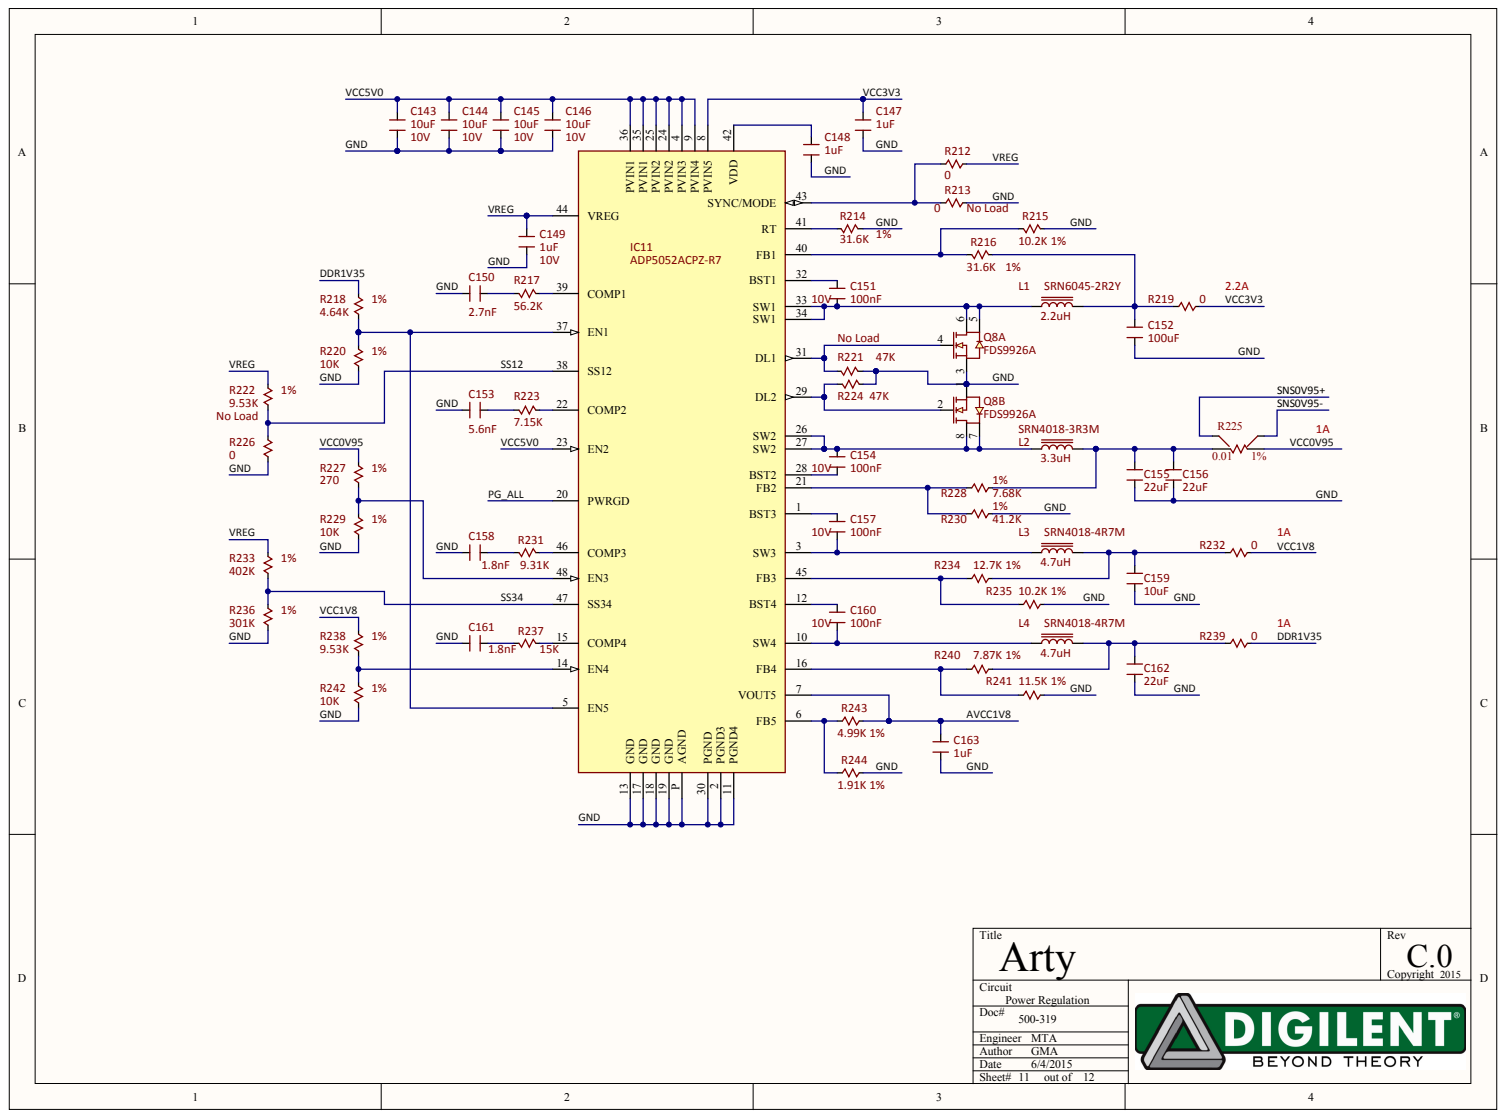
[picture p104: page 11]

GN D | C153 GND R223 7.15K | 2 2 2 3

C158 GND R231 1.8nF 9.31K | 4 6 4 8

C161 GND | R237 | 1 5 1 4

Title | Rev Co p yrig h t 2015
Arty Circuit Power Reg ulatio n | C.0 out of 12

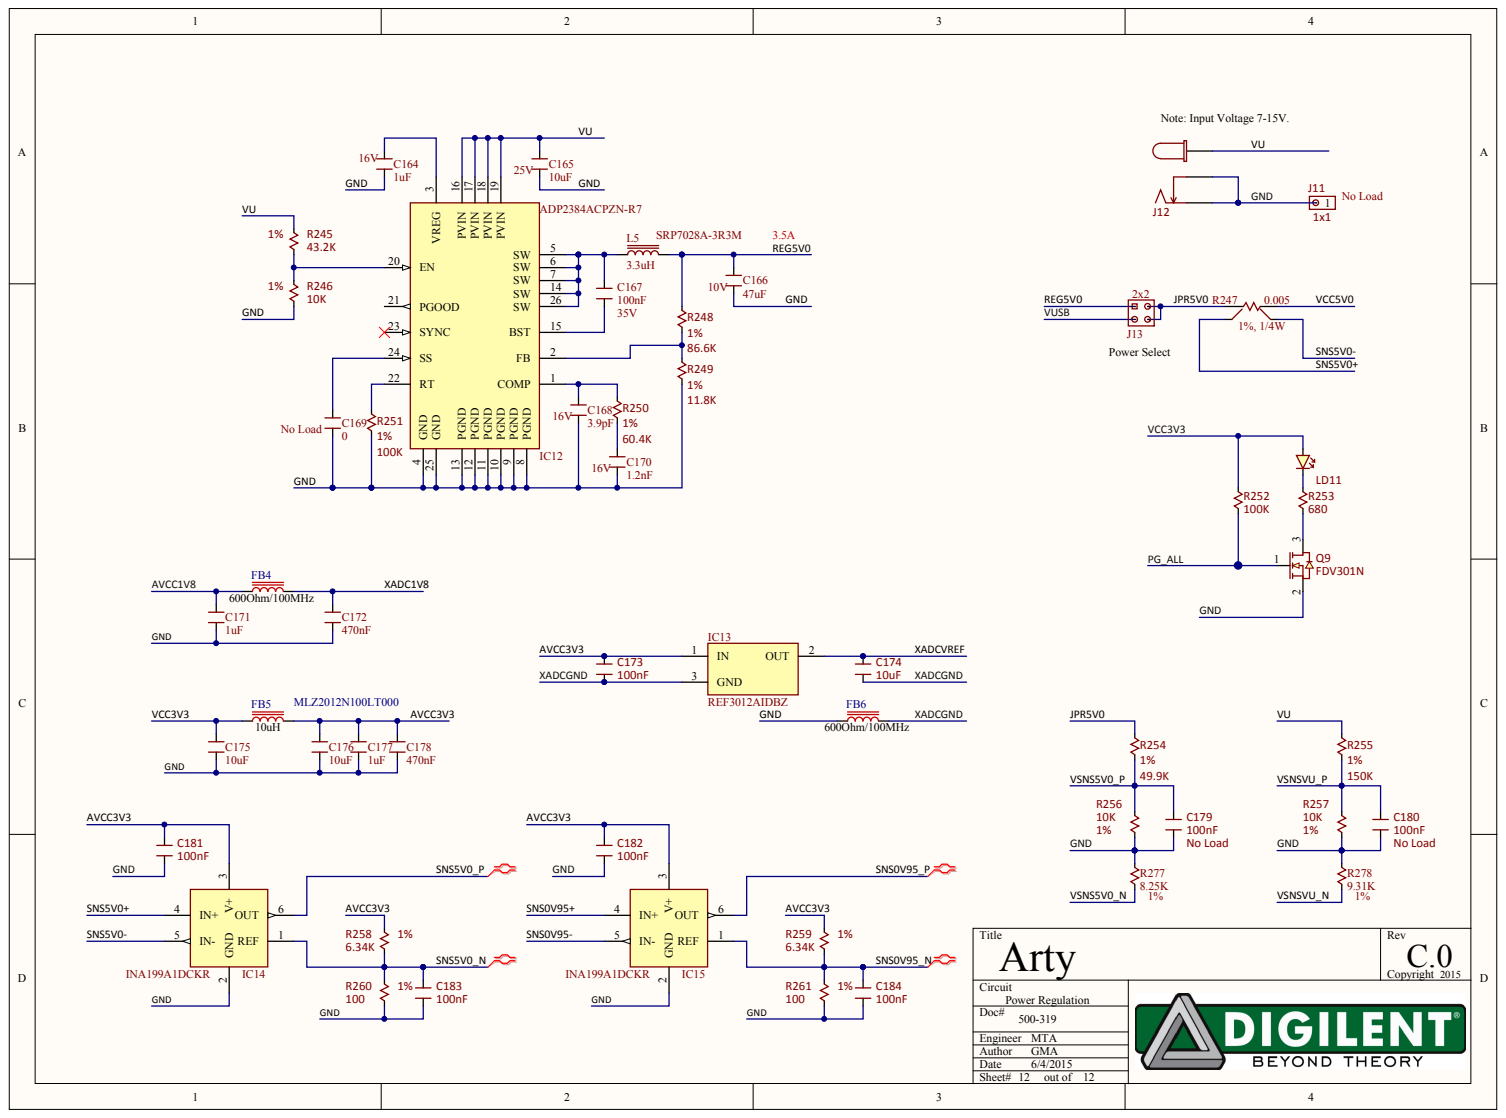
[picture p105: page 12]

1%, 1/4W | SNS5V0-

PGND 9 PGND 10 PGND 11 PGND 12 PGND 13
