ciaa/Hardware/PCB/Safety/doc/CIAA_Safety_VTI_1.0.pdf

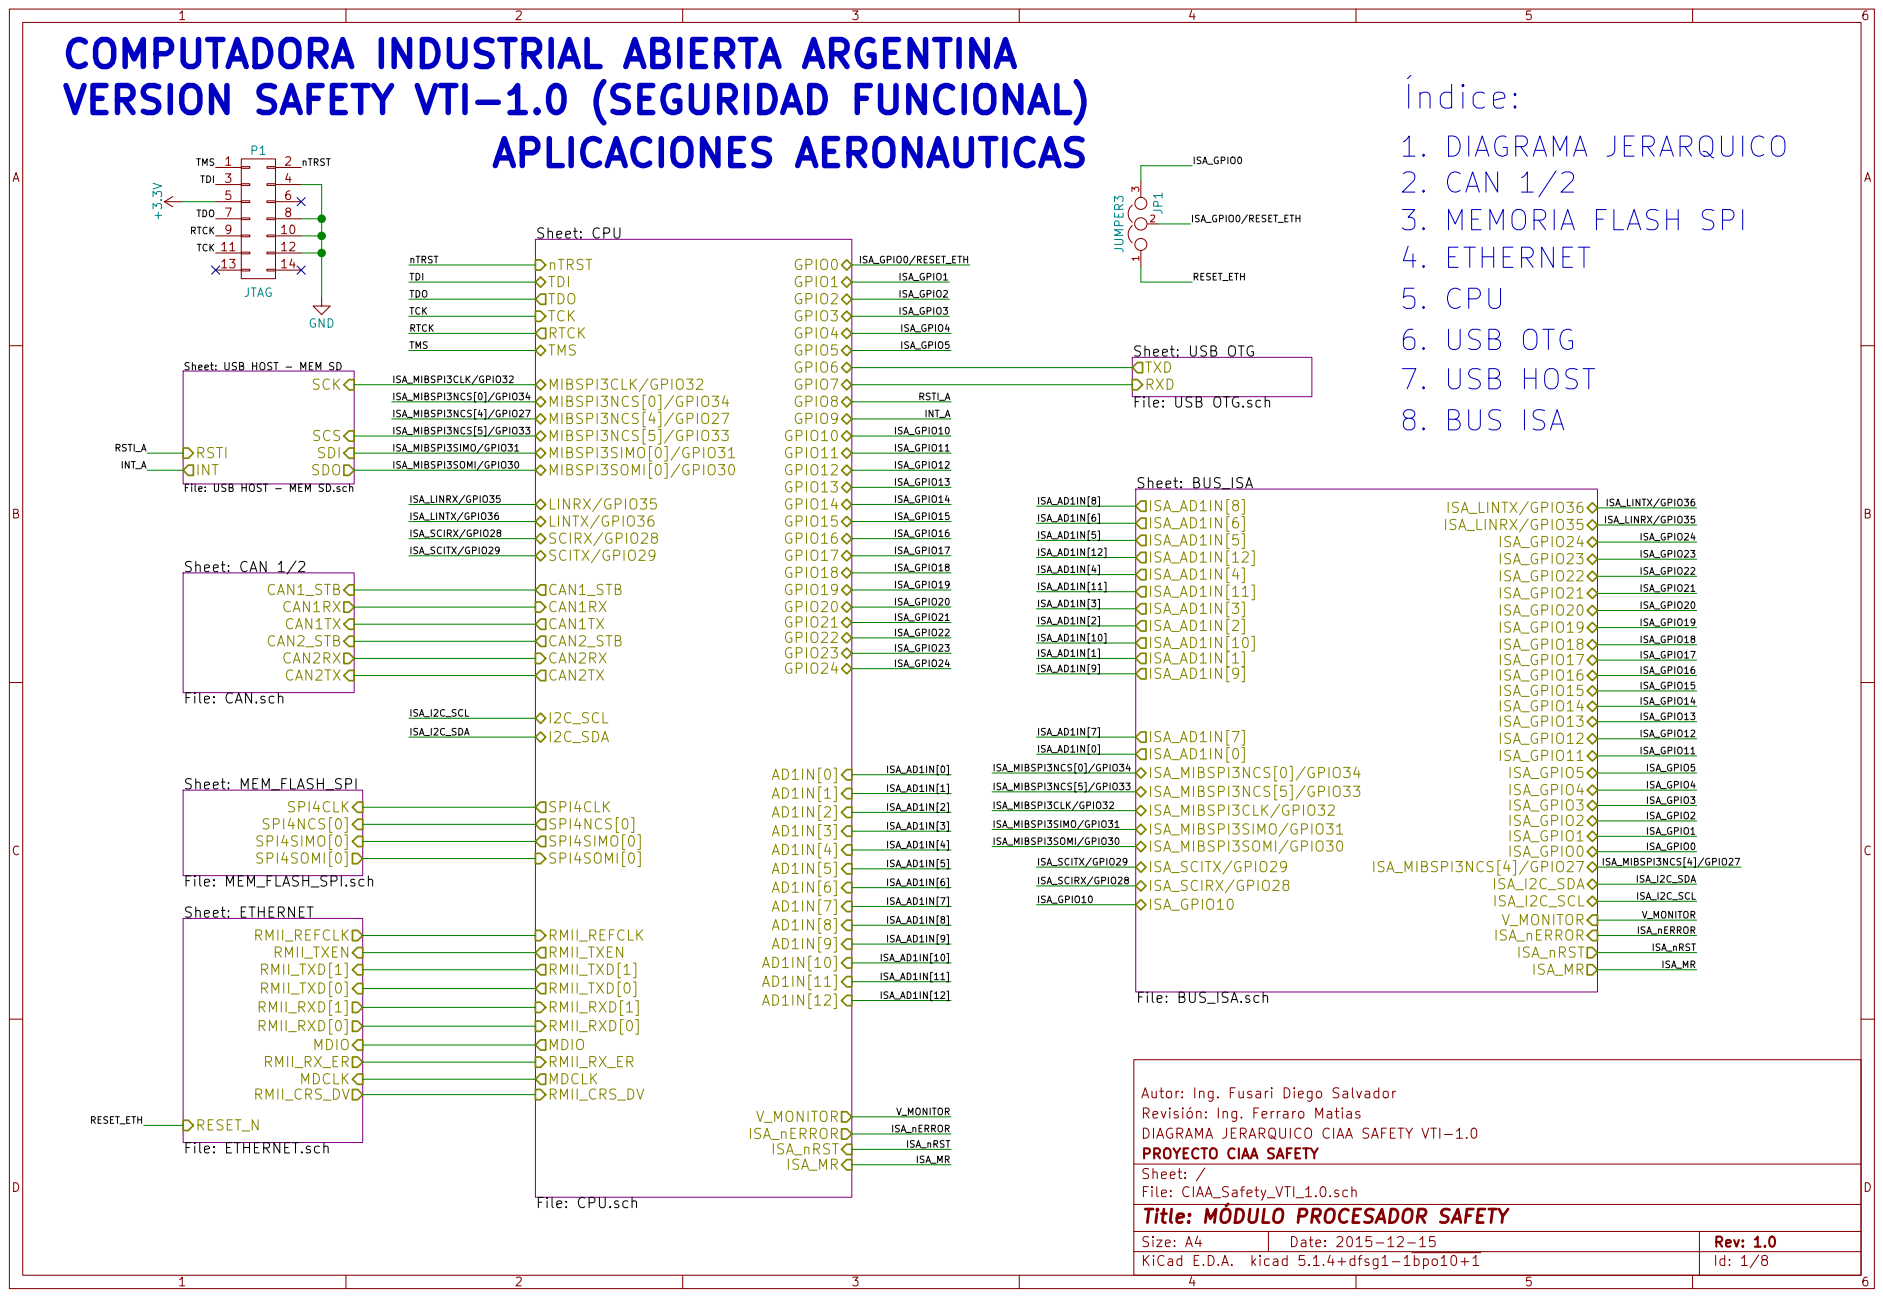
[picture p106: page 1]

COMPUTADORA INDUSTRIAL ABIERTA ARGENTINA
VERSION SAFETY VTI-1.0 (SEGURIDAD FUNCIONAL)

Sheet: USB HOST - MEM SD

File: USB OTG.sch TXD
RXD

RSTI
File: USB HOST - MEM SD.sch SDO

Autor: Ing. Fusari Diego Salvador
Revisión: Ing. Ferraro Matias
File: CIAA_Safety_VTI_1.0.sch Sheet: / PROYECTO CIAA SAFETY DIAGRAMA JERARQUICO CIAA SAFETY VTI-1.0

Id: 1/8 Title: MÓDULO PROCESADOR SAFETY

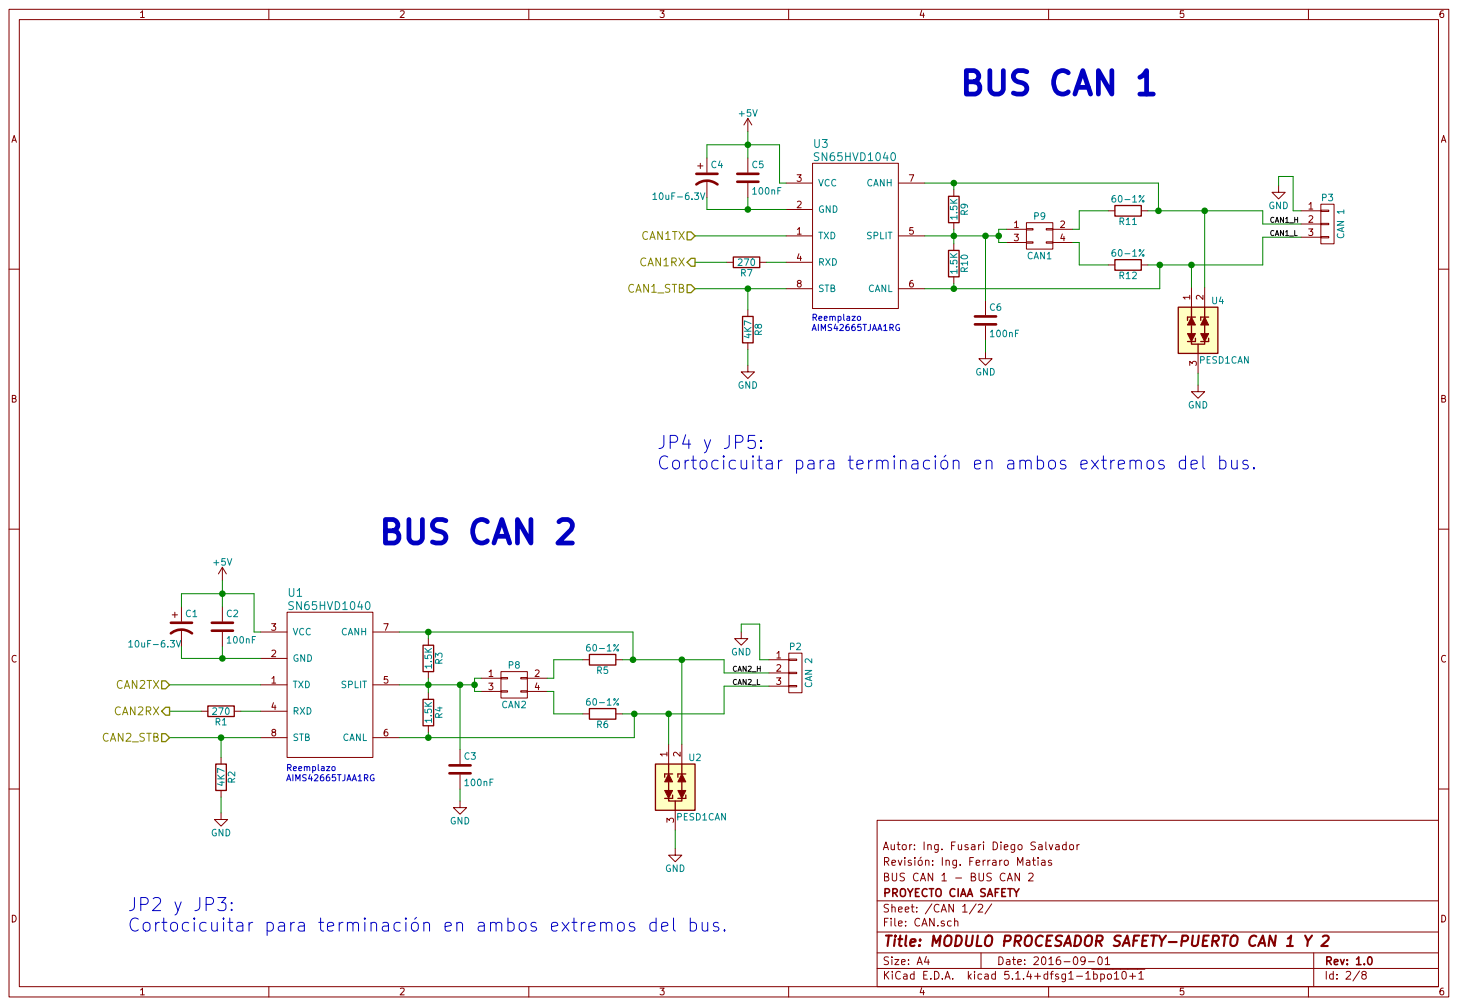
[picture p107: page 2]

CAN1_STB
Cortocicuitar para terminación en ambos extremos del bus. Reemplazo AIMS42665TJAA1RG

Autor: Ing. Fusari Diego Salvador GND

BUS CAN 1 - BUS CAN 2 Revisión: Ing. Ferraro Matias

File: CAN.sch Sheet: /CAN 1/2/ PROYECTO CIAA SAFETY

Cortocicuitar para terminación en ambos extremos del bus.

Id: 2/8 Title: MODULO PROCESADOR SAFETY-PUERTO CAN 1 Y 2

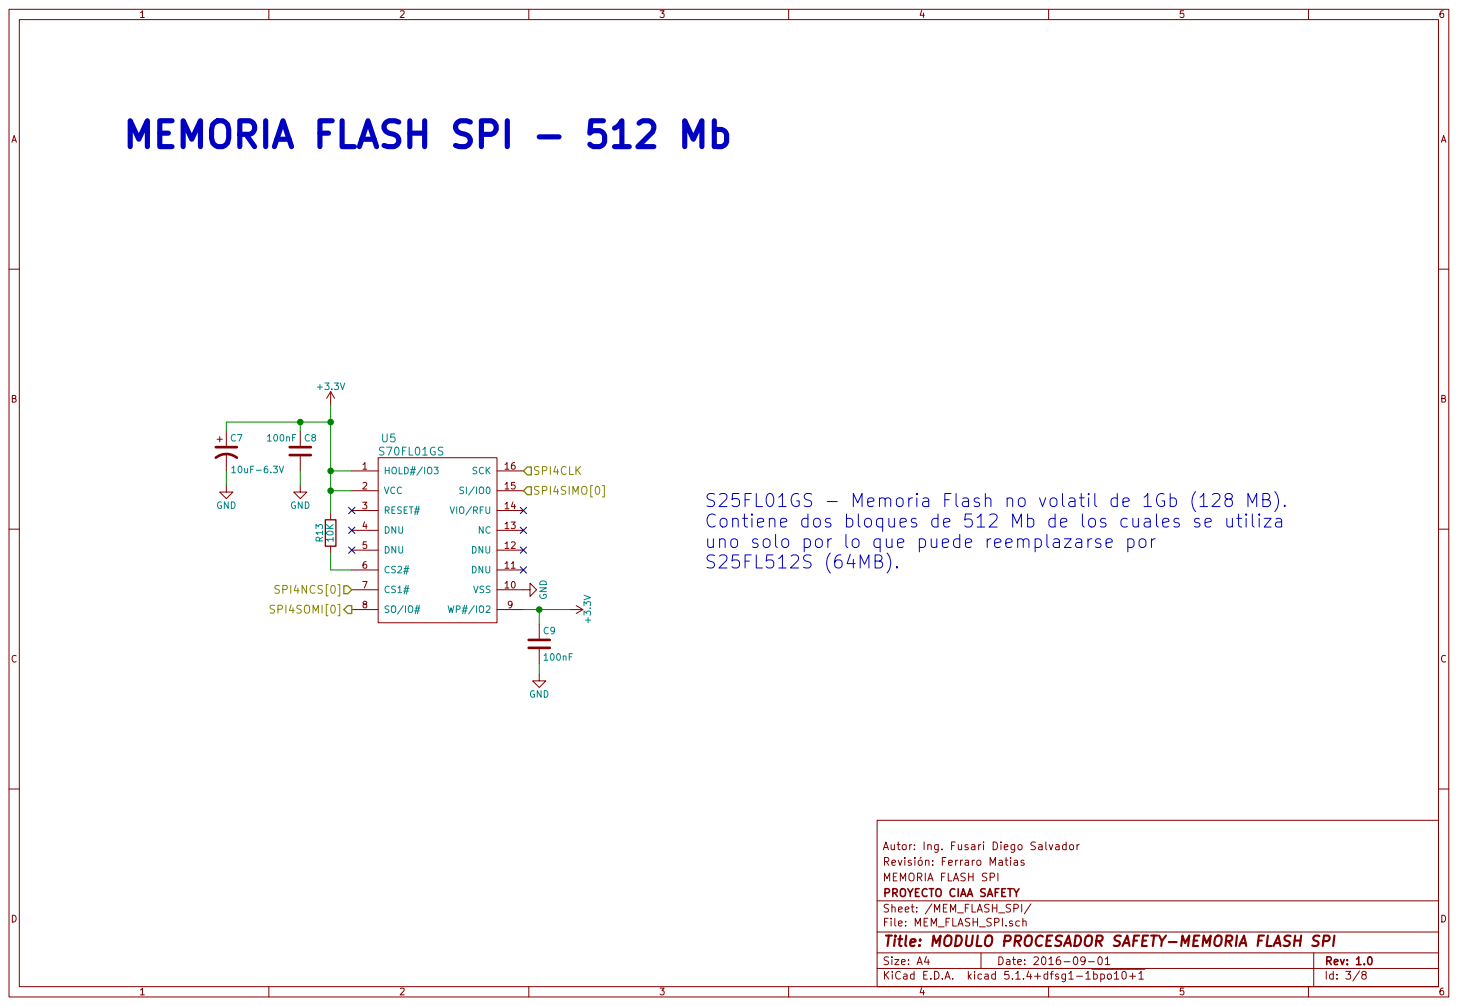
[picture p108: page 3]

MEMORIA FLASH SPI - 512 Mb

S25FL01GS - Memoria Flash no volatil de 1Gb (128 MB).
Contiene dos bloques de 512 Mb de los cuales se utiliza
uno solo por lo que puede reemplazarse por

Sheet: /MEM_FLASH_SPI/ PROYECTO CIAA SAFETY MEMORIA FLASH SPI Revisión: Ferraro Matias Autor: Ing. Fusari Diego Salvador C9

File: MEM_FLASH_SPI.sch
Id: 3/8 Title: MODULO PROCESADOR SAFETY-MEMORIA FLASH SPI

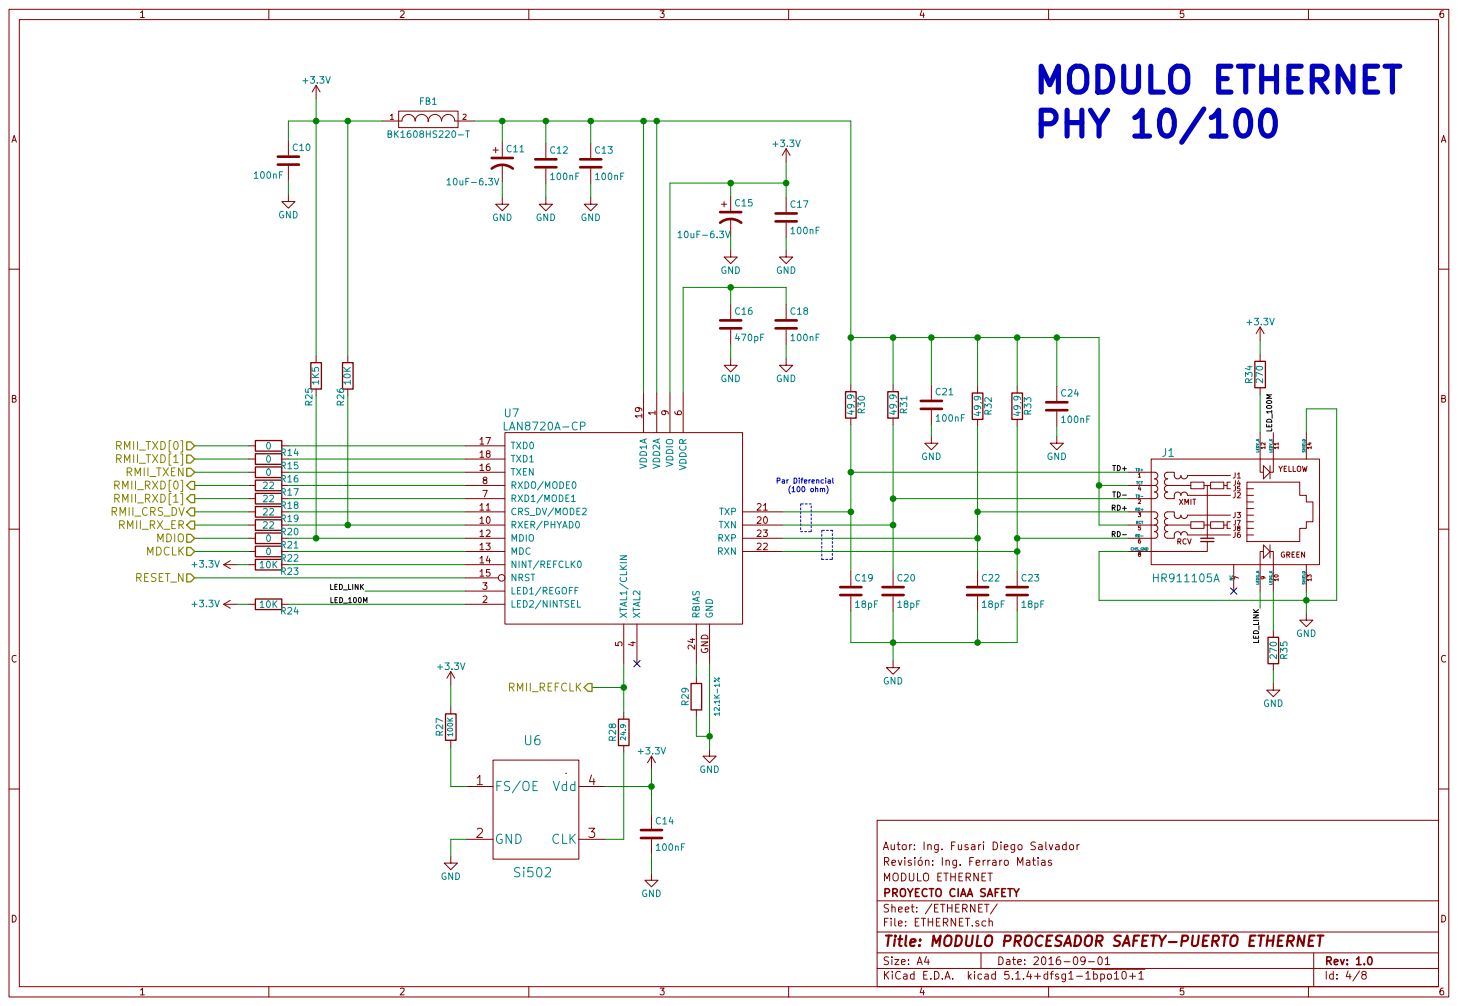
[picture p109: page 4]

1 RXER/PHYAD0 10 CRS_DV/MODE2 11 MDIO 12 MDC 13 NINT/REFCLK0 14 NRST 15 TXEN 16 TXD0 17 TXD1 18 VDD1A 19

TCT4

File: ETHERNET.sch Sheet: /ETHERNET/ PROYECTO CIAA SAFETY MODULO ETHERNET Revisión: Ing. Ferraro Matias

Id: 4/8 Title: MODULO PROCESADOR SAFETY-PUERTO ETHERNET

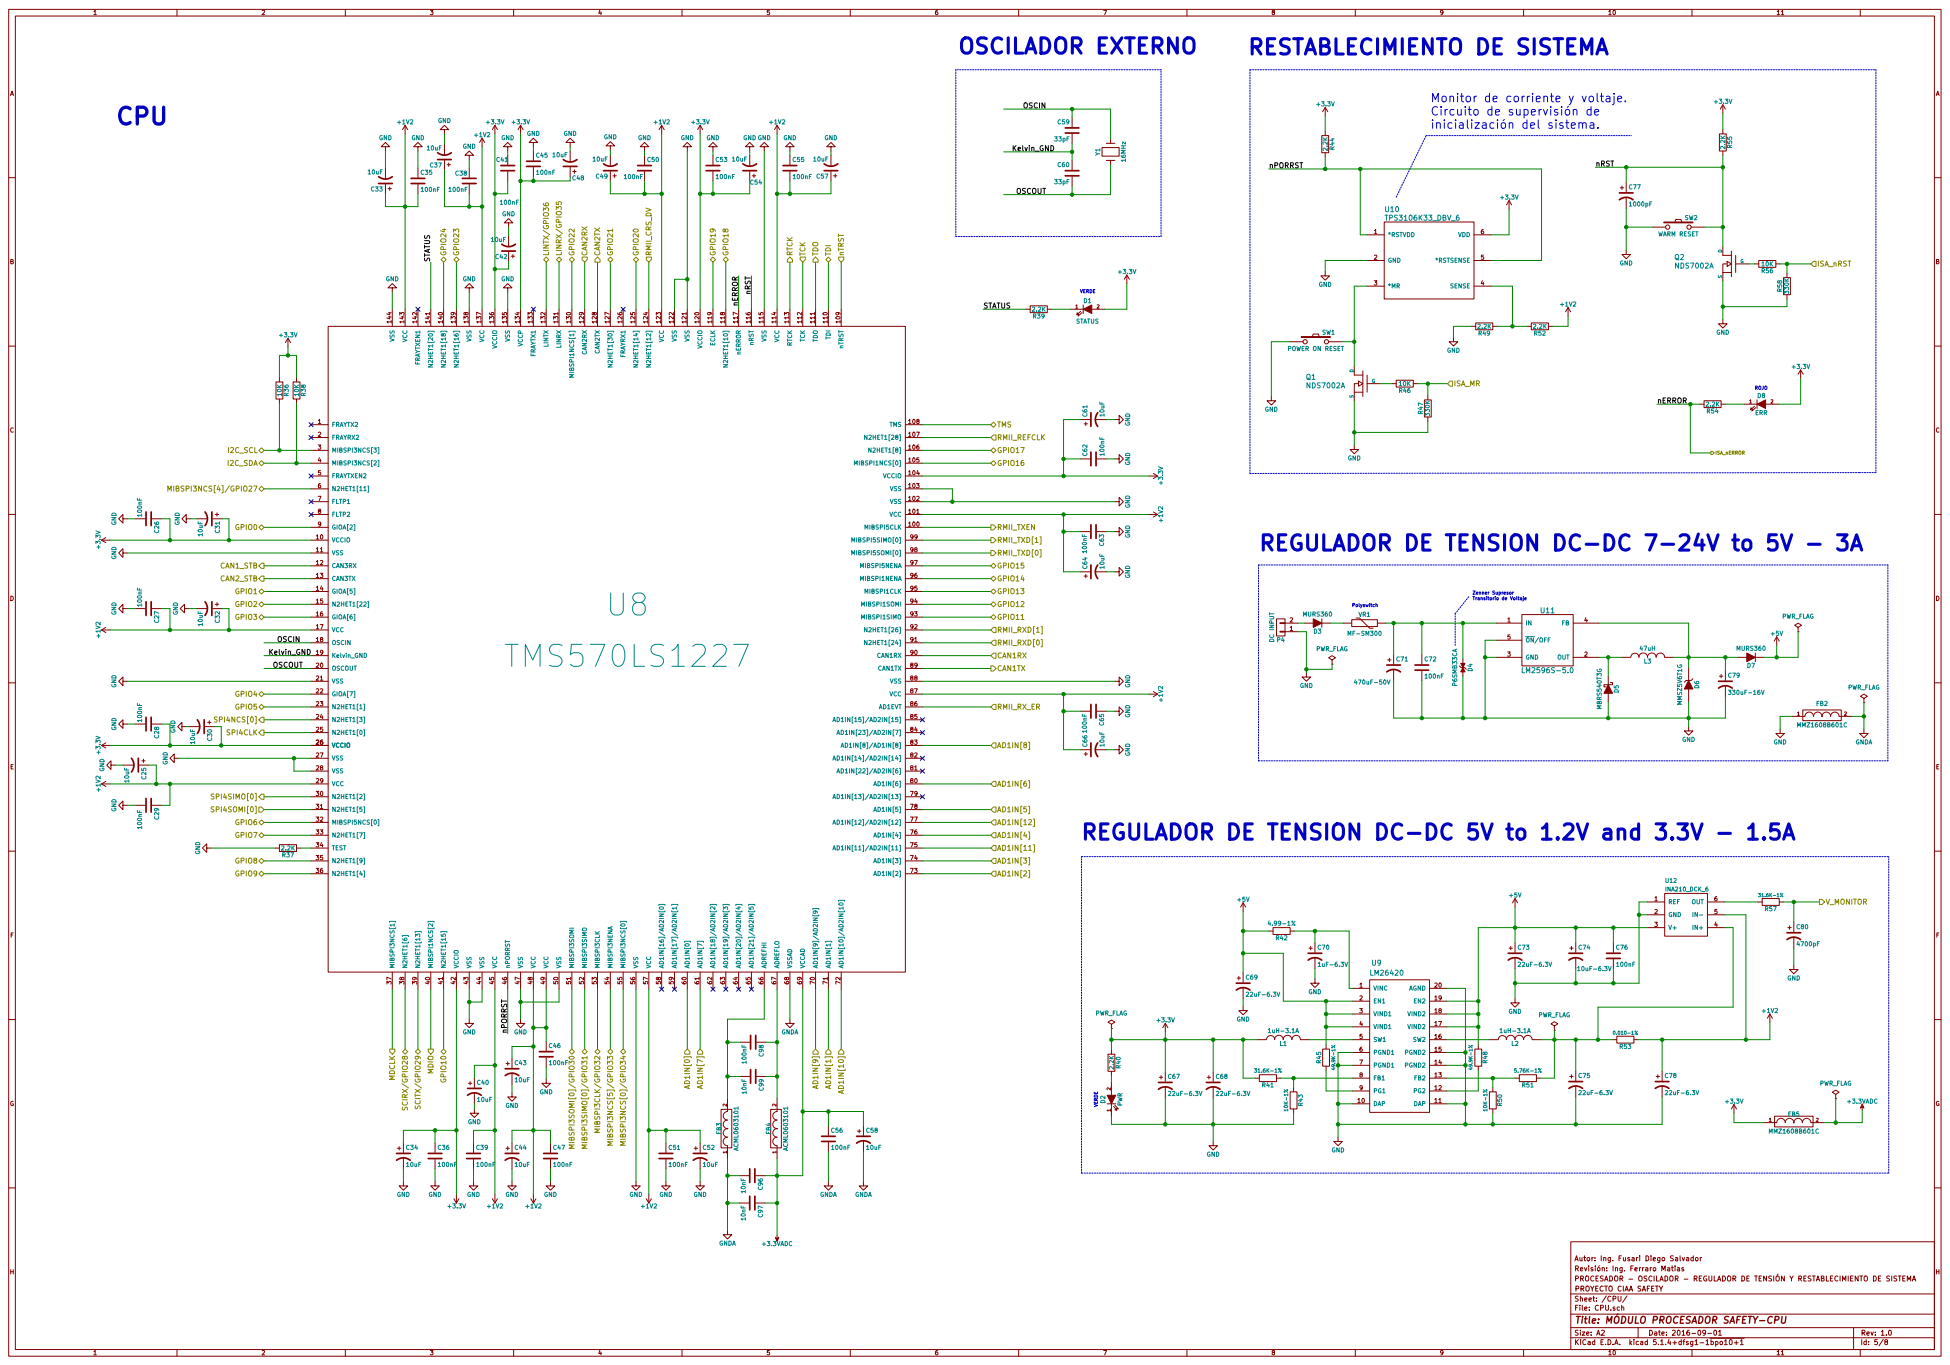
[picture p110: page 5]

OSCILADOR EXTERNO VERDE
Kelvin_GND OSCOUT OSCIN
inicialización del sistema. REGULADOR DE TENSION DC-DC 5V to 1.2V and 3.3V - 1.5A

Monitor de corriente y voltaje.
Circuito de supervisión de

Zenner Supresor Transitorio de Voltaje REGULADOR DE TENSION DC-DC 7-24V to 5V - 3A

PROCESADOR - OSCILADOR - REGULADOR DE TENSIÓN Y RESTABLECIMIENTO DE SISTEMA Revisión: Ing. Ferraro Matias Autor: Ing. Fusari Diego Salvador

File: CPU.sch Sheet: /CPU/ PROYECTO CIAA SAFETY

Id: 5/8 Title: MÓDULO PROCESADOR SAFETY-CPU

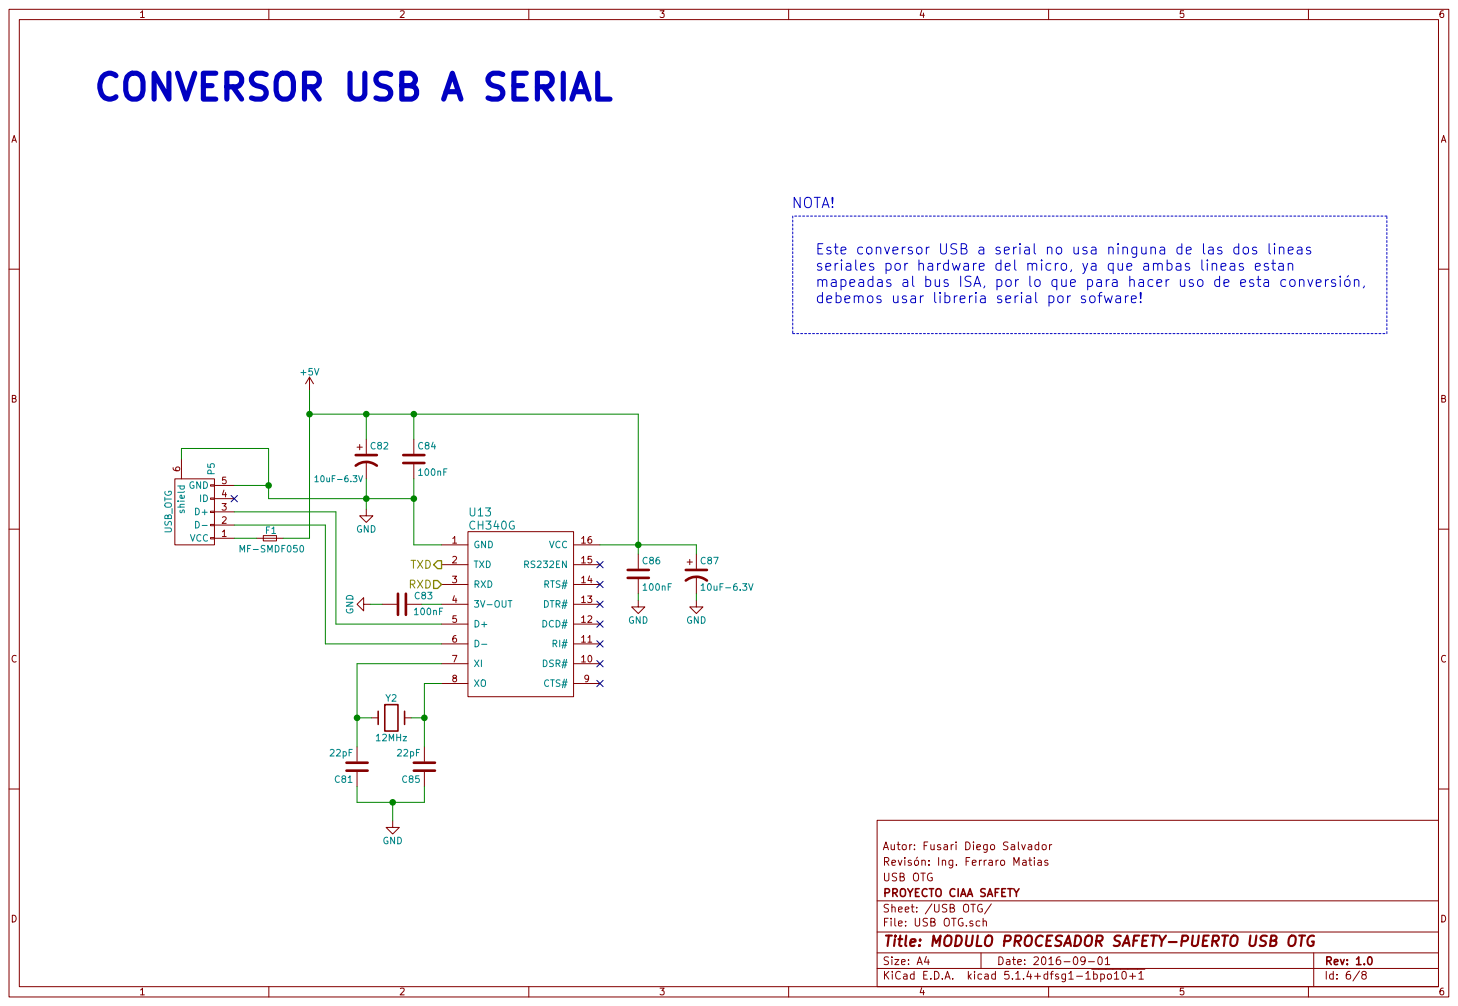
[picture p111: page 6]

RXD CONVERSOR USB A SERIAL

Este conversor USB a serial no usa ninguna de las dos lineas
seriales por hardware del micro, ya que ambas lineas estan
mapeadas al bus ISA, por lo que para hacer uso de esta conversión,
debemos usar libreria serial por sofware!

Autor: Fusari Diego Salvador C84

Revisón: Ing. Ferraro Matias
File: USB OTG.sch Sheet: /USB OTG/ PROYECTO CIAA SAFETY USB OTG

Id: 6/8 Title: MODULO PROCESADOR SAFETY-PUERTO USB OTG

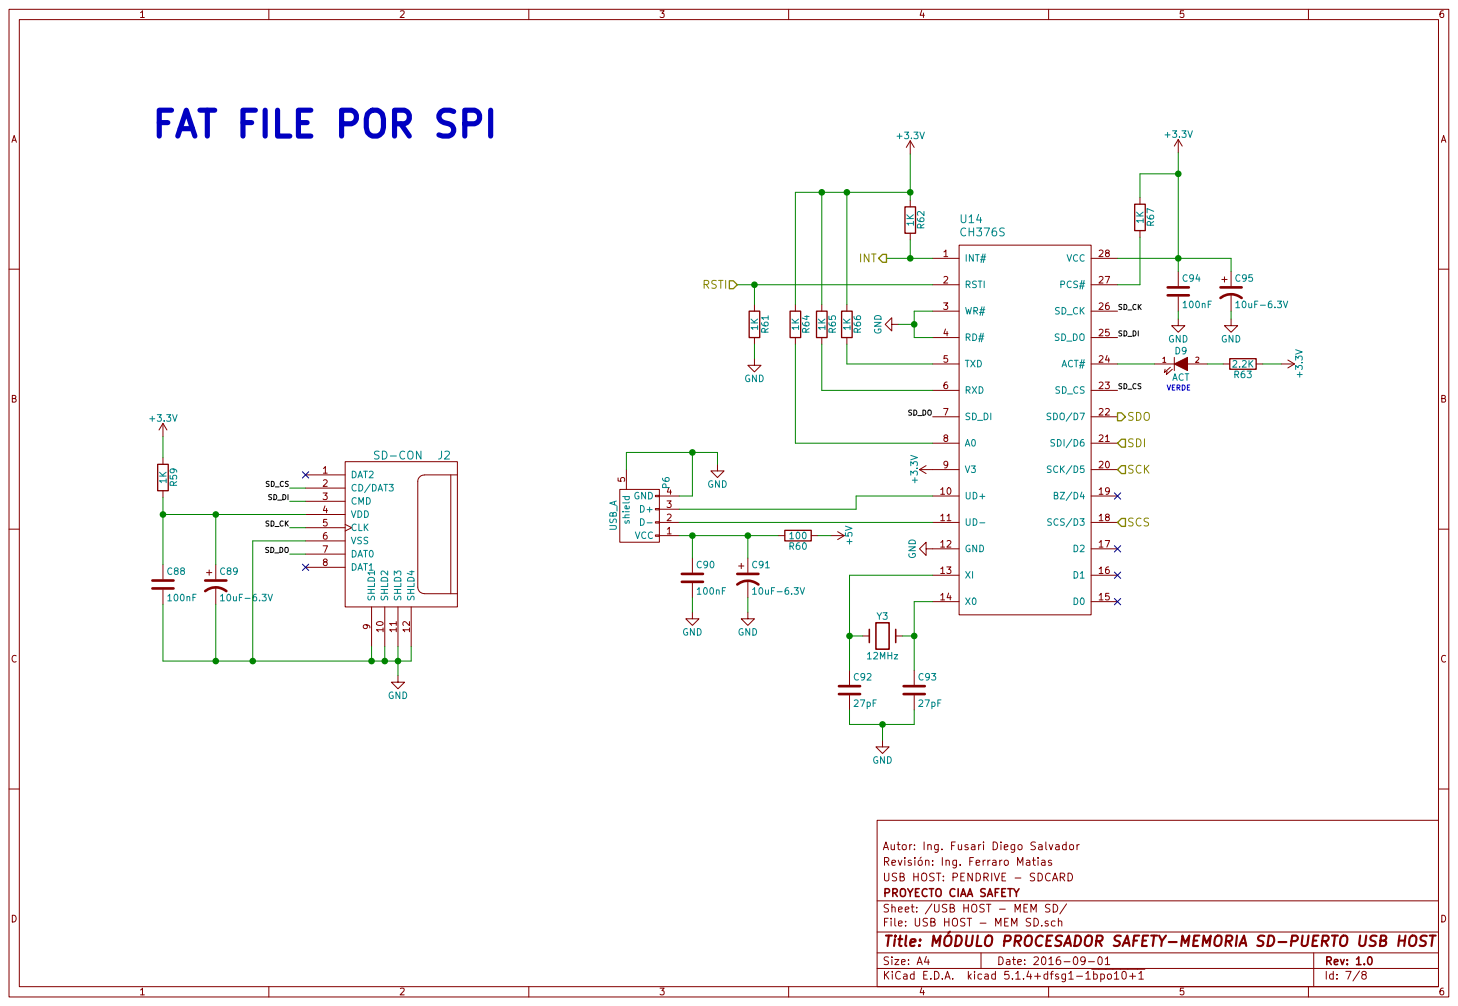
[picture p112: page 7]

VERDE FAT FILE POR SPI

Revisión: Ing. Ferraro Matias
File: USB HOST - MEM SD.sch Sheet: /USB HOST - MEM SD/ PROYECTO CIAA SAFETY USB HOST: PENDRIVE - SDCARD

Id: 7/8 Title: MÓDULO PROCESADOR SAFETY-MEMORIA SD-PUERTO USB HOST

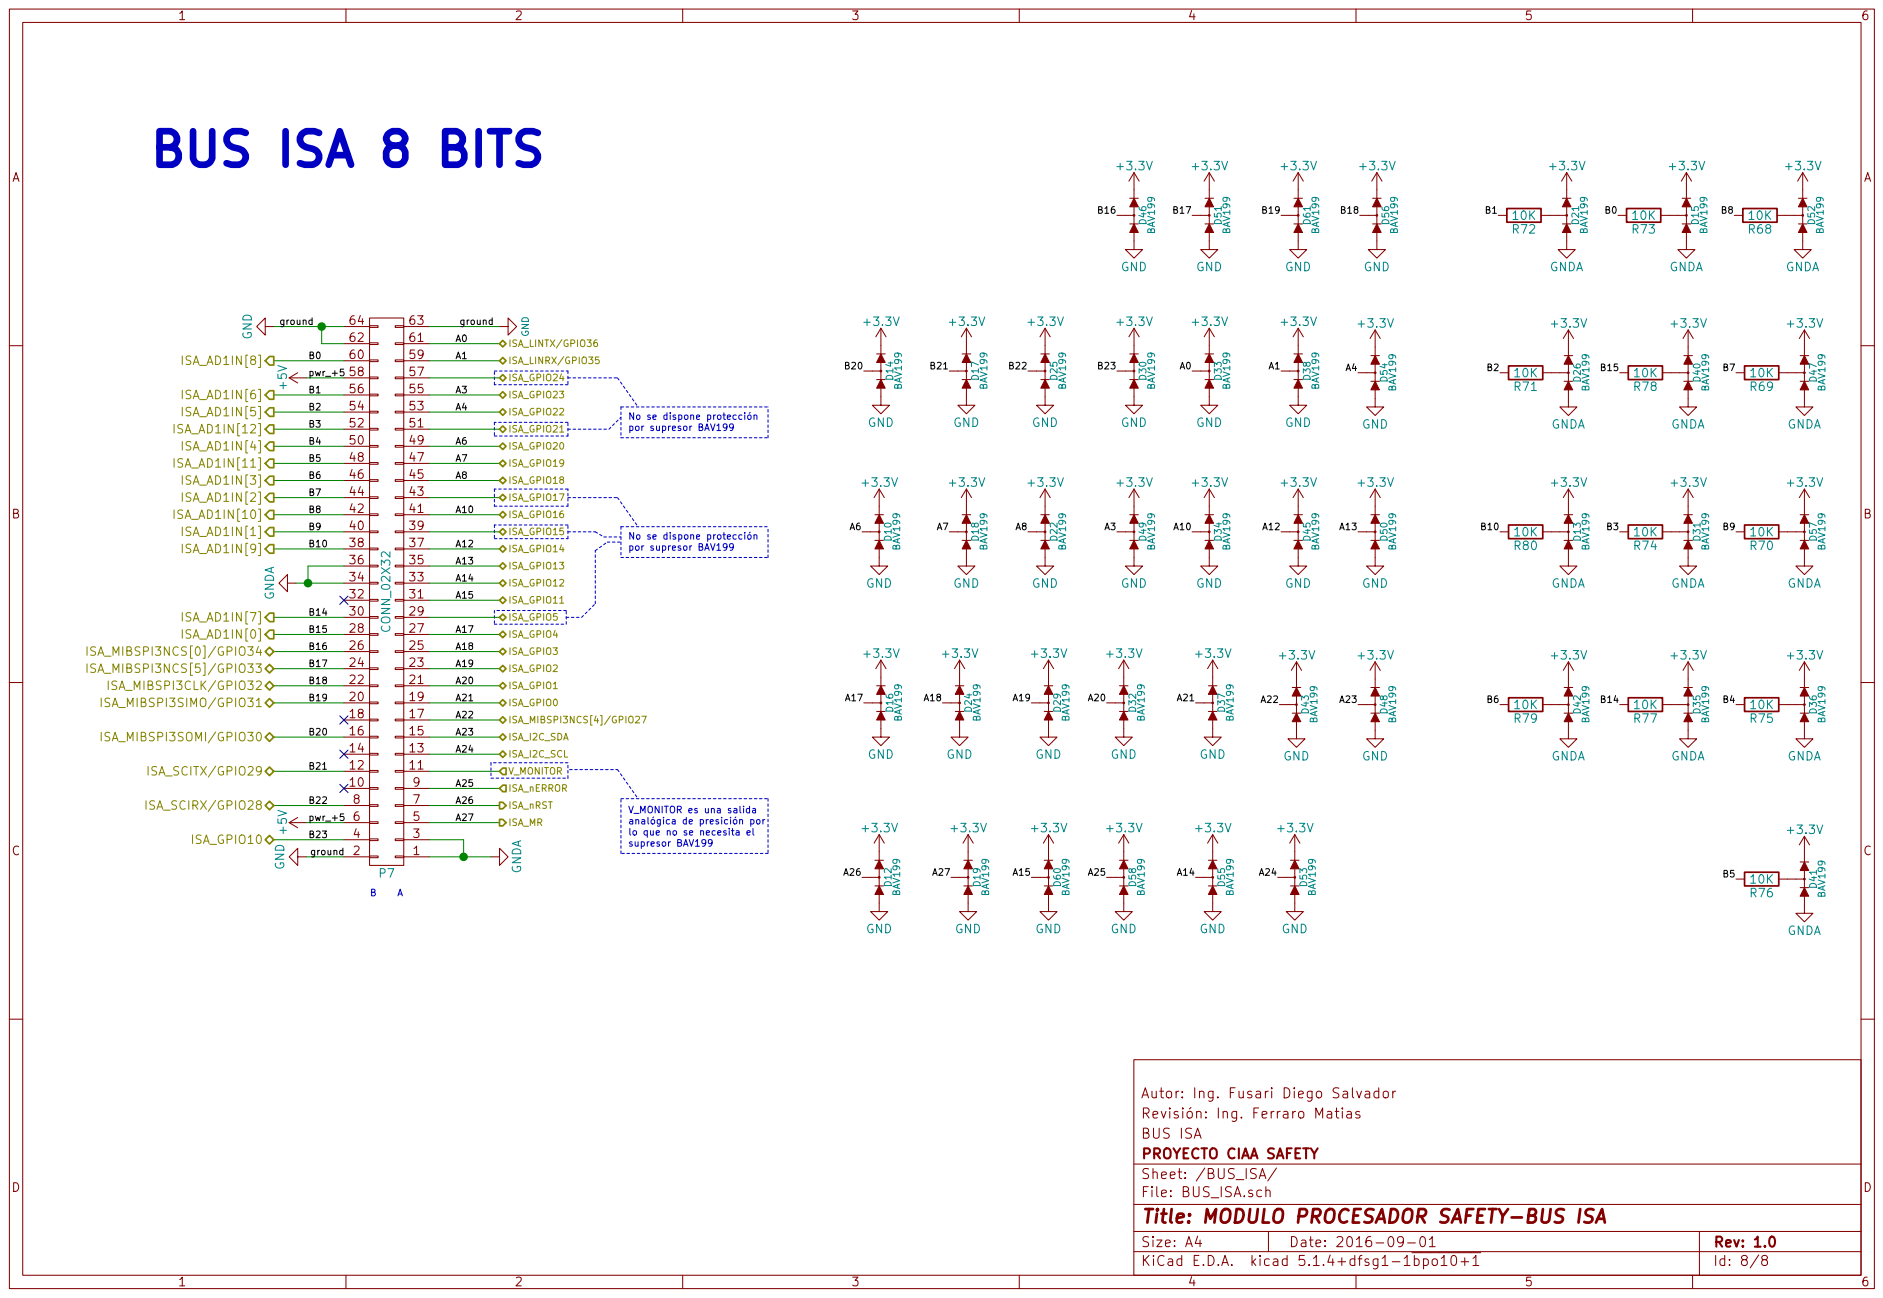
[picture p113: page 8]

No se dispone protección por supresor BAV199

Autor: Ing. Fusari Diego Salvador
BUS ISA Revisión: Ing. Ferraro Matias

Sheet: /BUS_ISA/ PROYECTO CIAA SAFETY

File: BUS_ISA.sch
Id: 8/8 Title: MODULO PROCESADOR SAFETY-BUS ISA
