ciaa/Hardware/PCB/EDU-INTEL/doc/edk.pdf

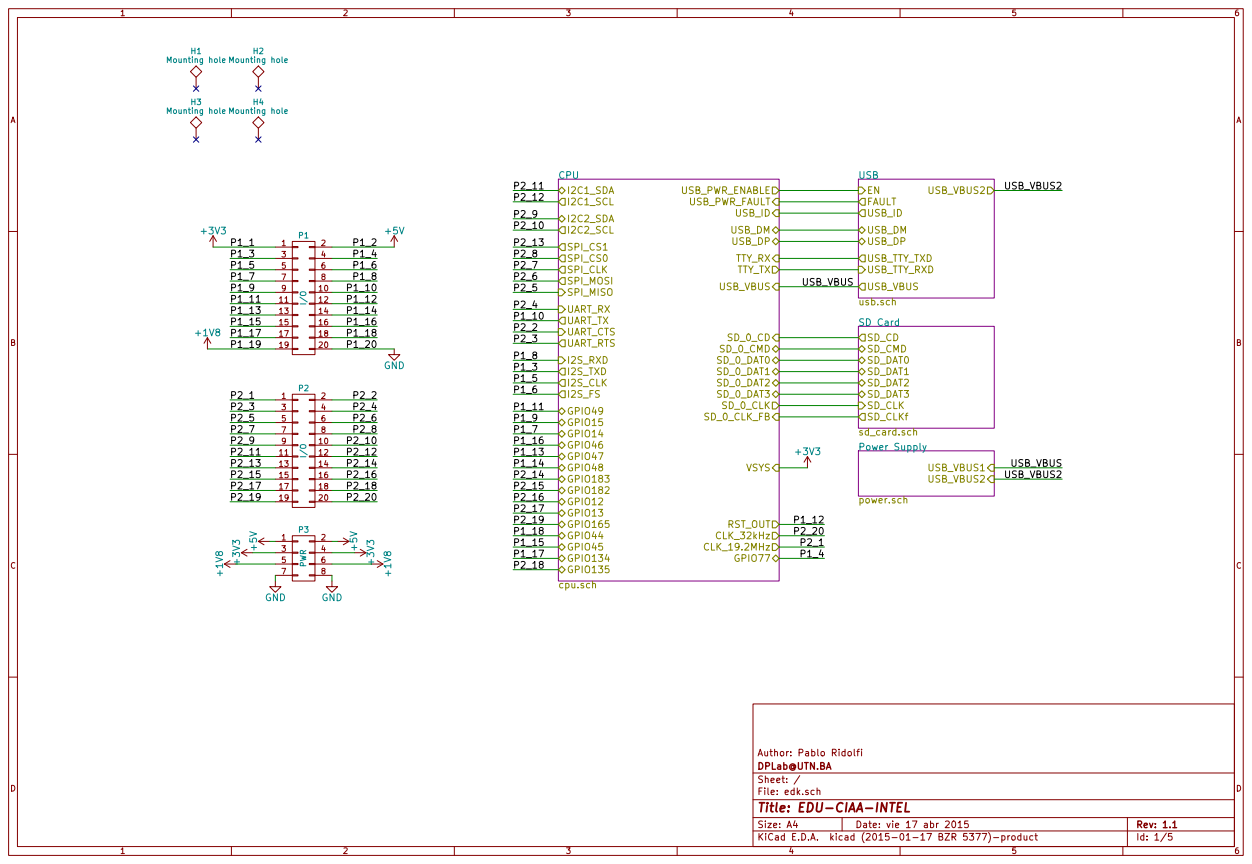
[picture p126: page 1]

Author: Pablo Ridolfi
File: edk.sch Sheet: / DPLab@UTN.BA

Id: 1/5 Title: EDU-CIAA-INTEL

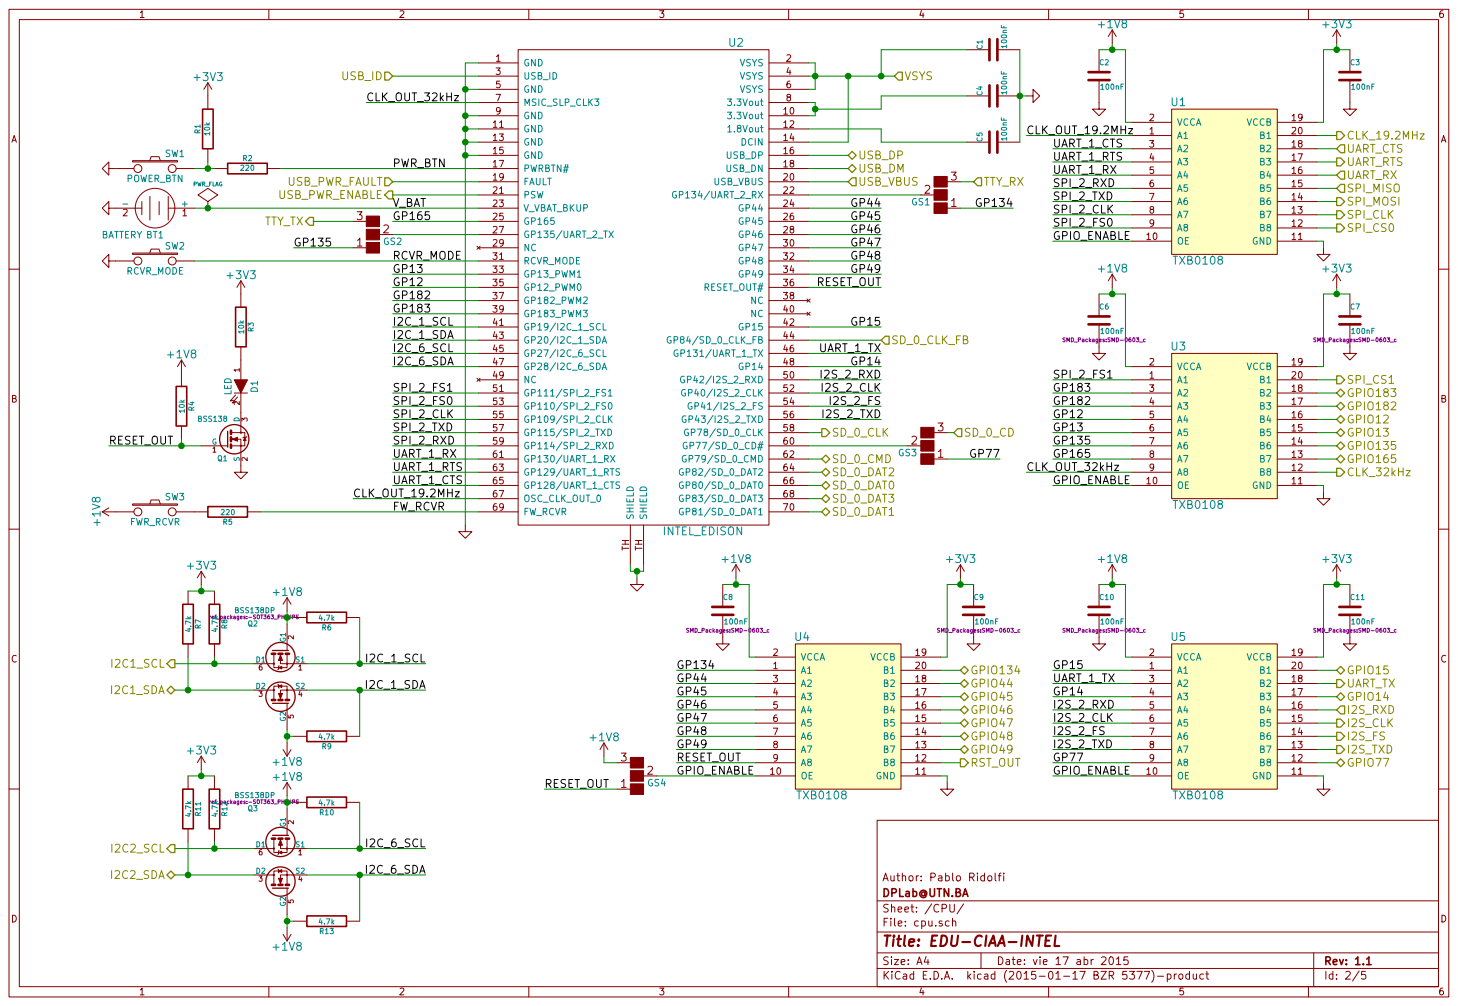
[picture p127: page 2]

I2C_1_SCL
I2C_1_SDA
I2C_6_SCL
I2C_6_SDA | GP14

Author: Pablo Ridolfi
File: cpu.sch Sheet: /CPU/ DPLab@UTN.BA

Id: 2/5 Title: EDU-CIAA-INTEL

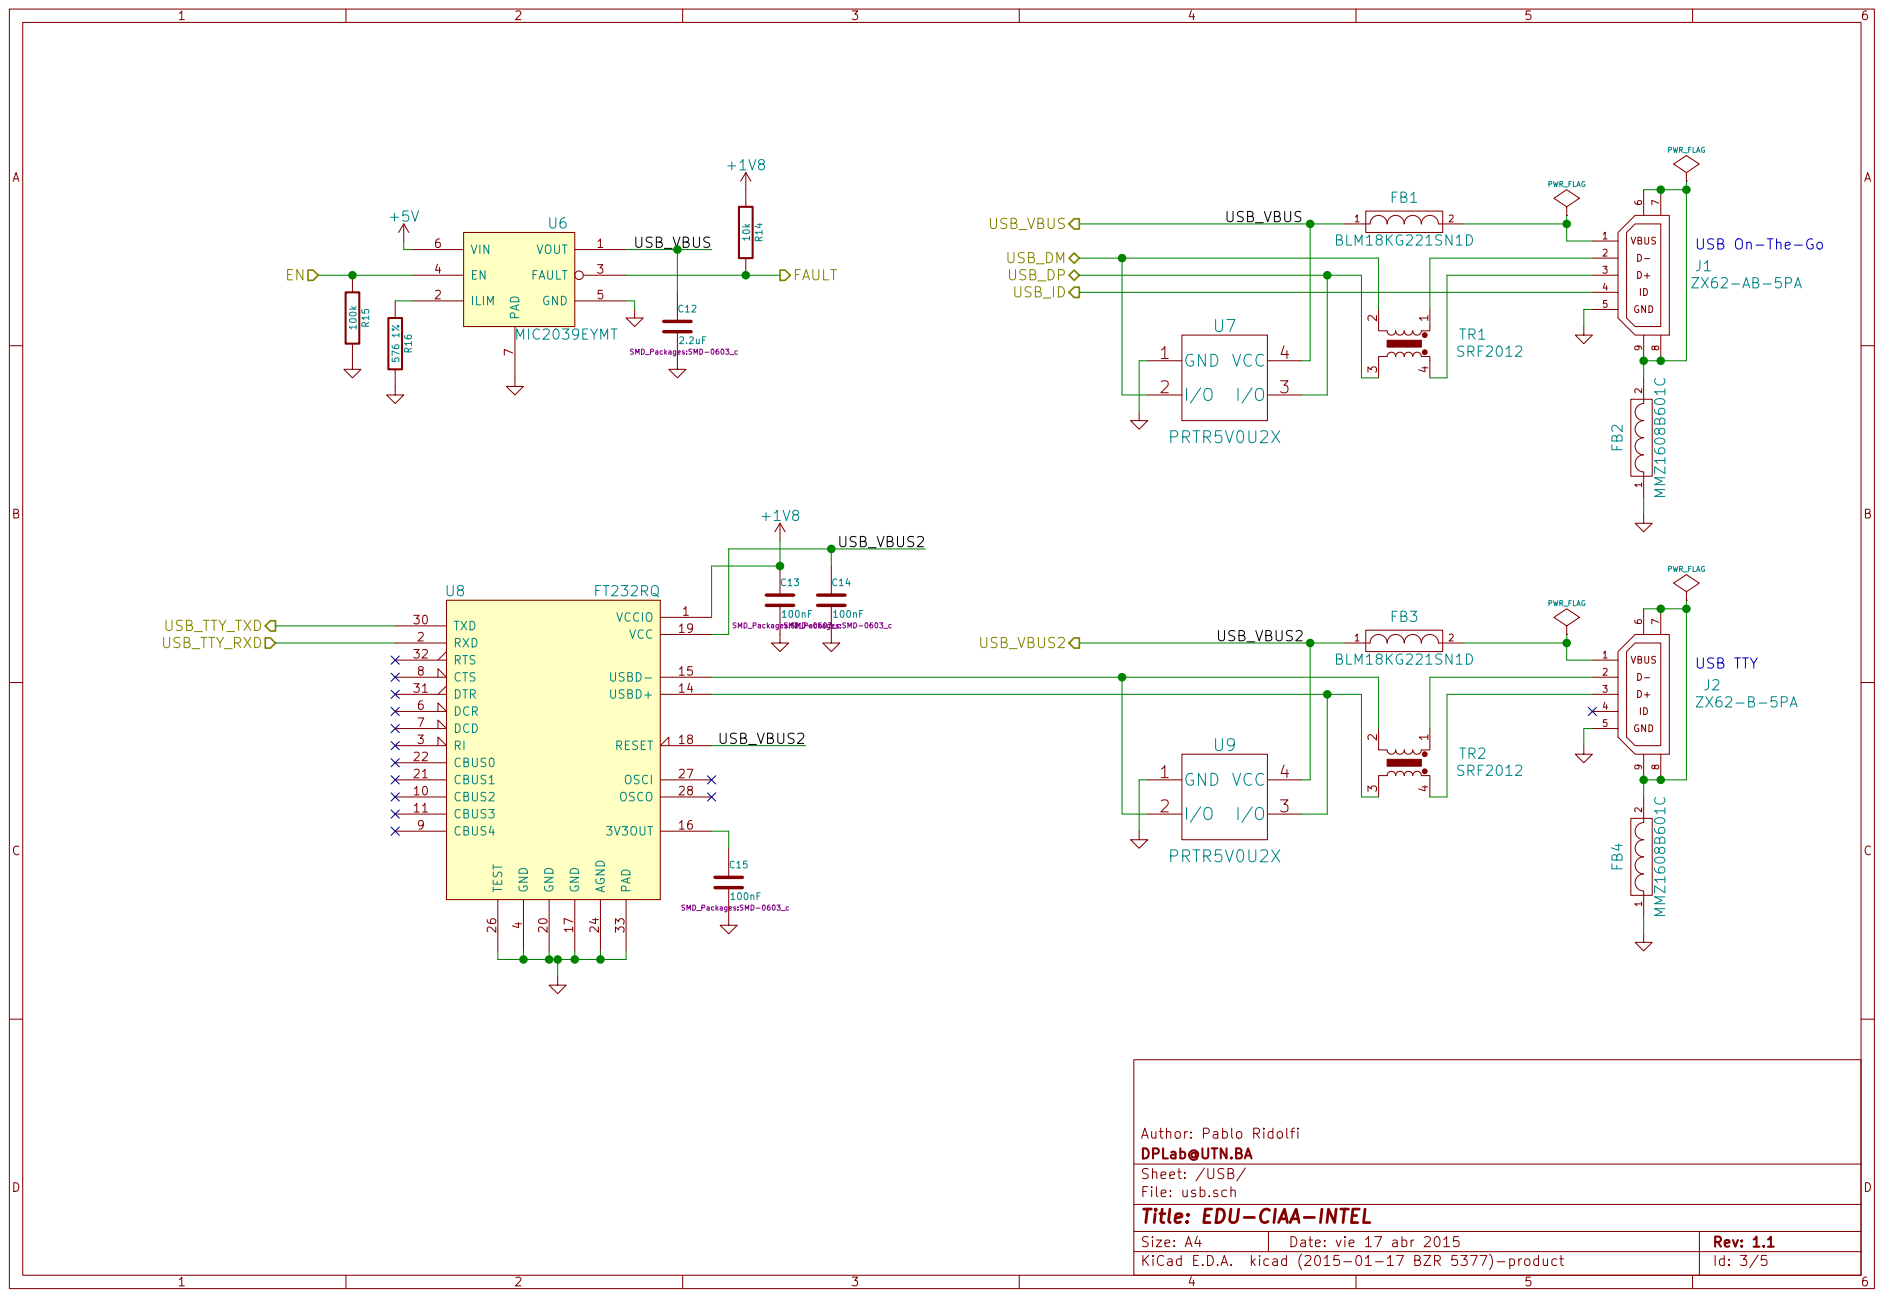
[picture p128: page 3]

USB On-The-Go

4 DCR 6 DCD 7 CTS 8 CBUS4 9 CBUS2 10 GND 20 TXD 30 CBUS3 11 CBUS1 21 DTR 31 CBUS0 22 RTS 32 PAD 33 USBD+ 14 AGND 24 USBD- 15

Author: Pablo Ridolfi
File: usb.sch Sheet: /USB/ DPLab@UTN.BA

Id: 3/5 Title: EDU-CIAA-INTEL

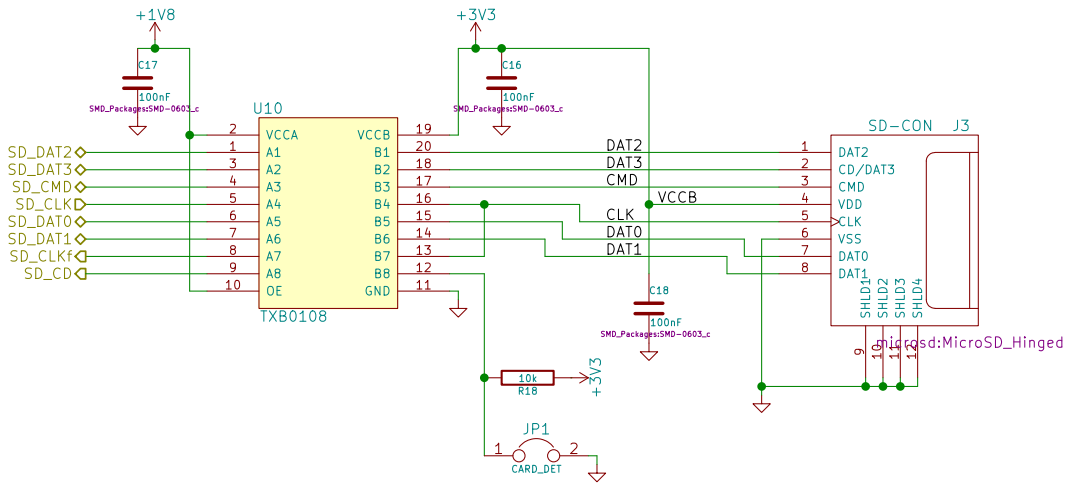
[picture p129: page 4]

Author: Pablo Ridolfi
File: sd_card.sch Sheet: /SD Card/ DPLab@UTN.BA

Id: 4/5 Title: EDU-CIAA-INTEL

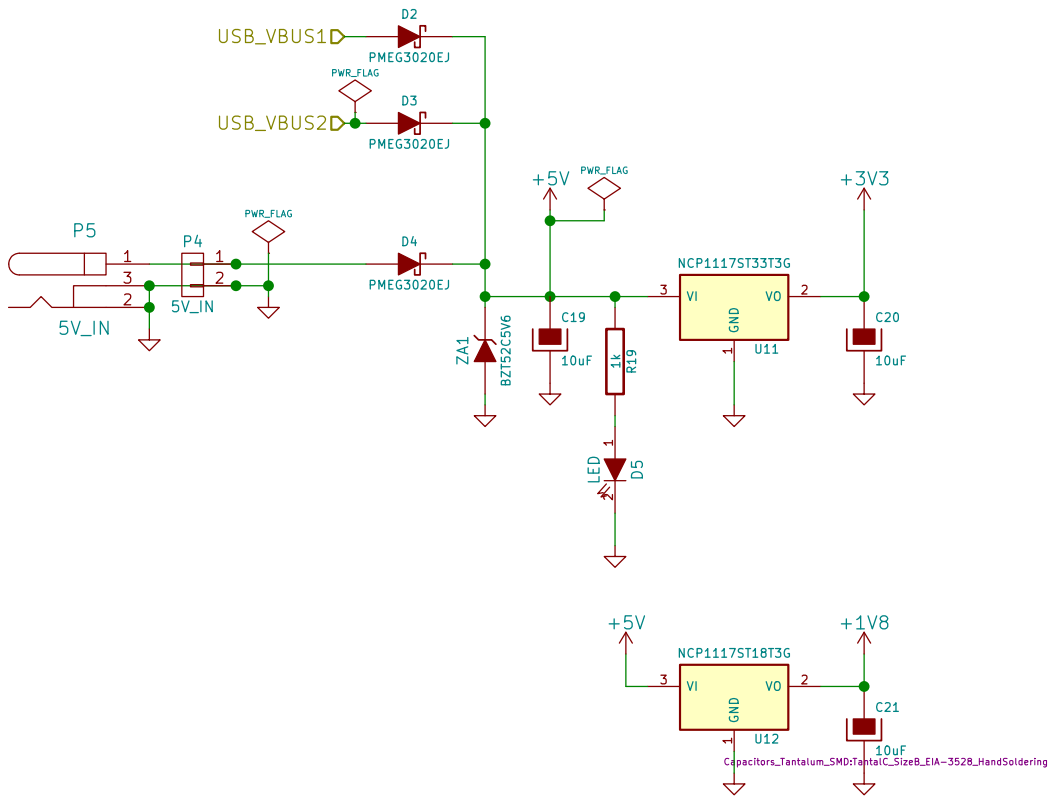
[picture p130: page 5]

Author: Pablo Ridolfi GND

DPLab@UTN.BA
Sheet: /Power Supply/
File: power.sch
Id: 5/5 Title: EDU-CIAA-INTEL
