ciaa/Hardware/PCB/ACC/CIAA_ACC/output_files/ciaa_acc_sch_v1.4.pdf

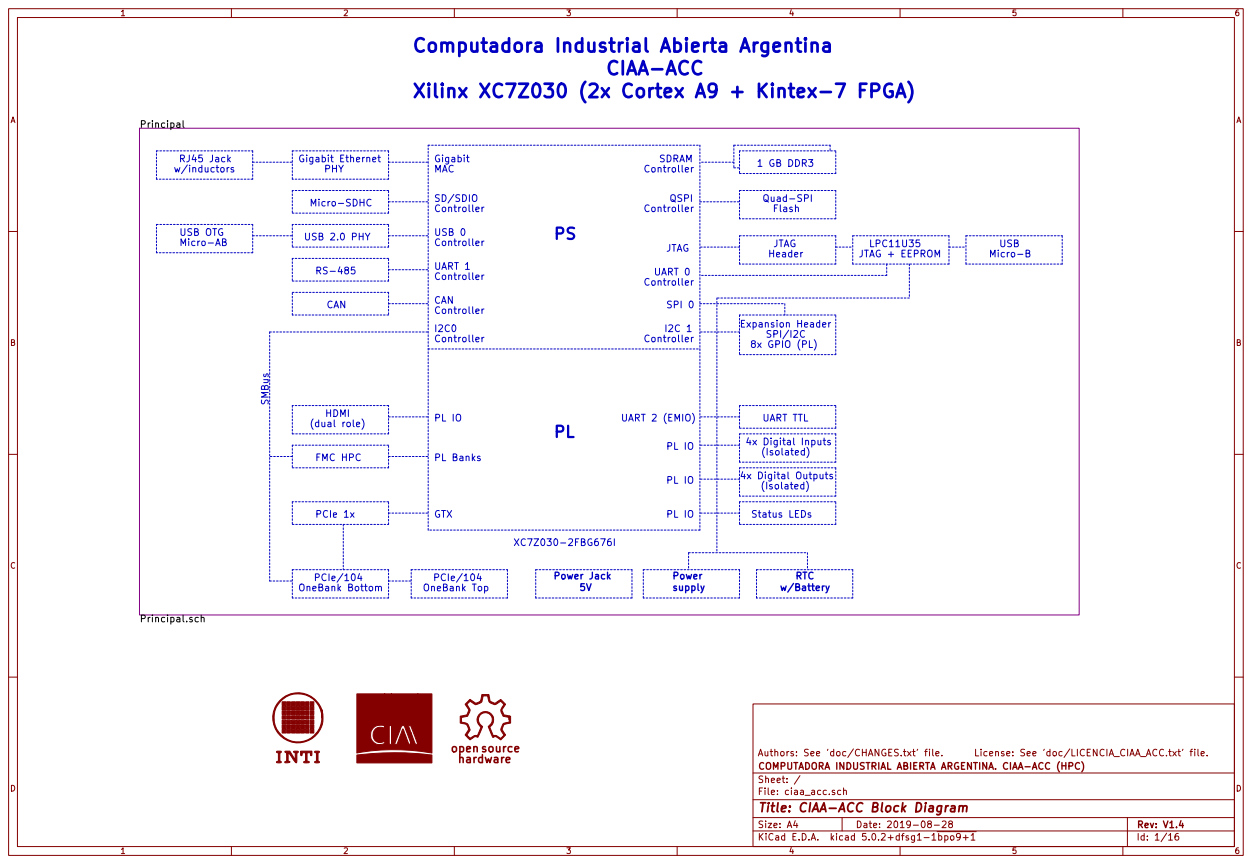
[picture p131: page 1]

open source Computadora Industrial Abierta Argentina

Xilinx XC7Z030 (2x Cortex A9 + Kintex-7 FPGA)

Expansion Header
SPI/I2C
8x GPIO (PL) UART TTL

Status LEDs Power Jack

File: ciaa_acc.sch Sheet: / COMPUTADORA INDUSTRIAL ABIERTA ARGENTINA. CIAA-ACC (HPC)

Id: 1/16 Title: CIAA-ACC Block Diagram

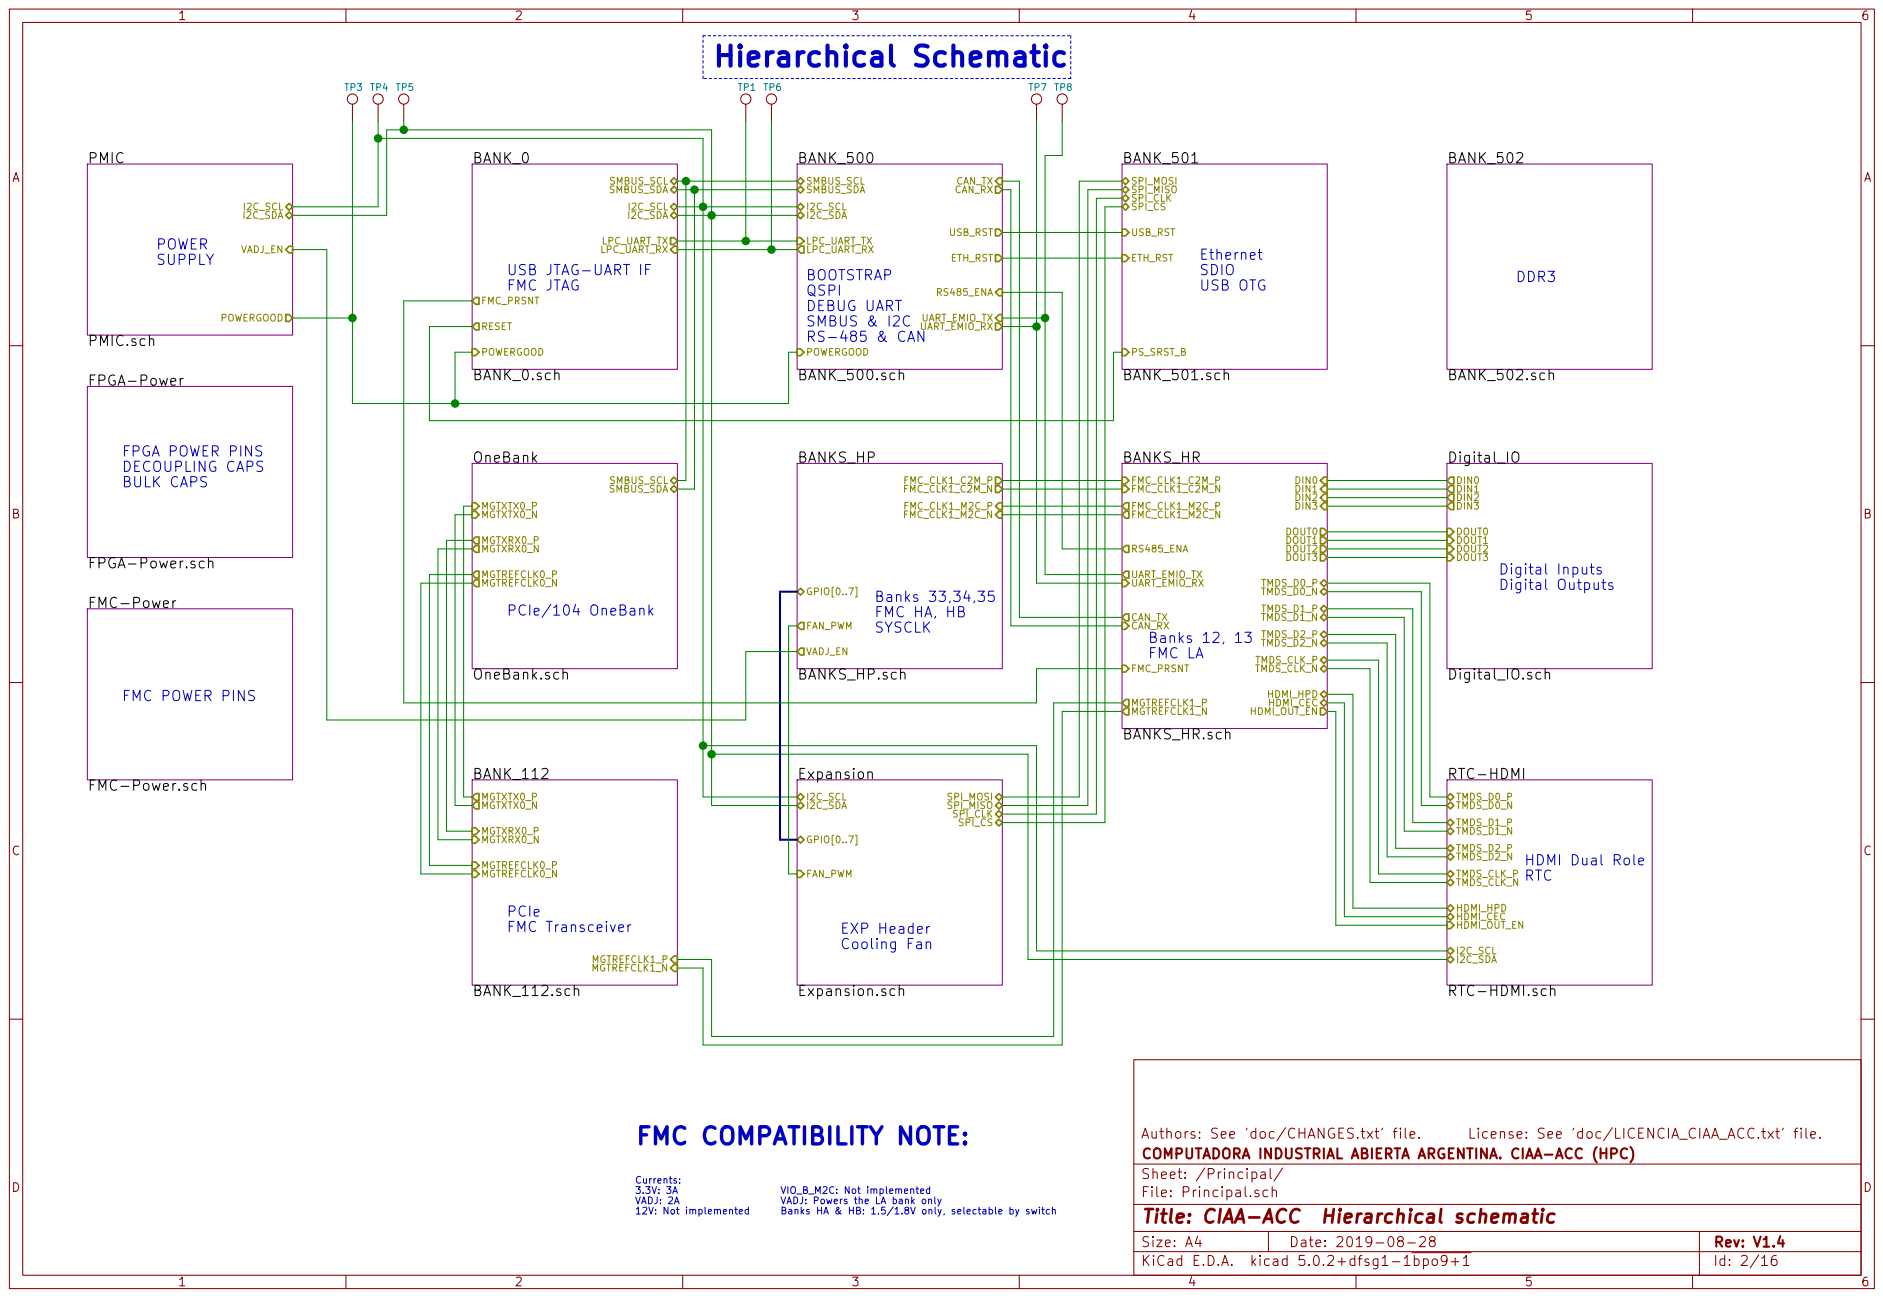
[picture p132: page 2]

LPC_UART_RX RESET
DDR3 USB JTAG-UART IF
FMC JTAG

BANK_502.sch
Digital Outputs HDMI Dual Role RTC

COMPUTADORA INDUSTRIAL ABIERTA ARGENTINA. CIAA-ACC (HPC)
Sheet: /Principal/
File: Principal.sch
Id: 2/16 Title: CIAA-ACC Hierarchical schematic

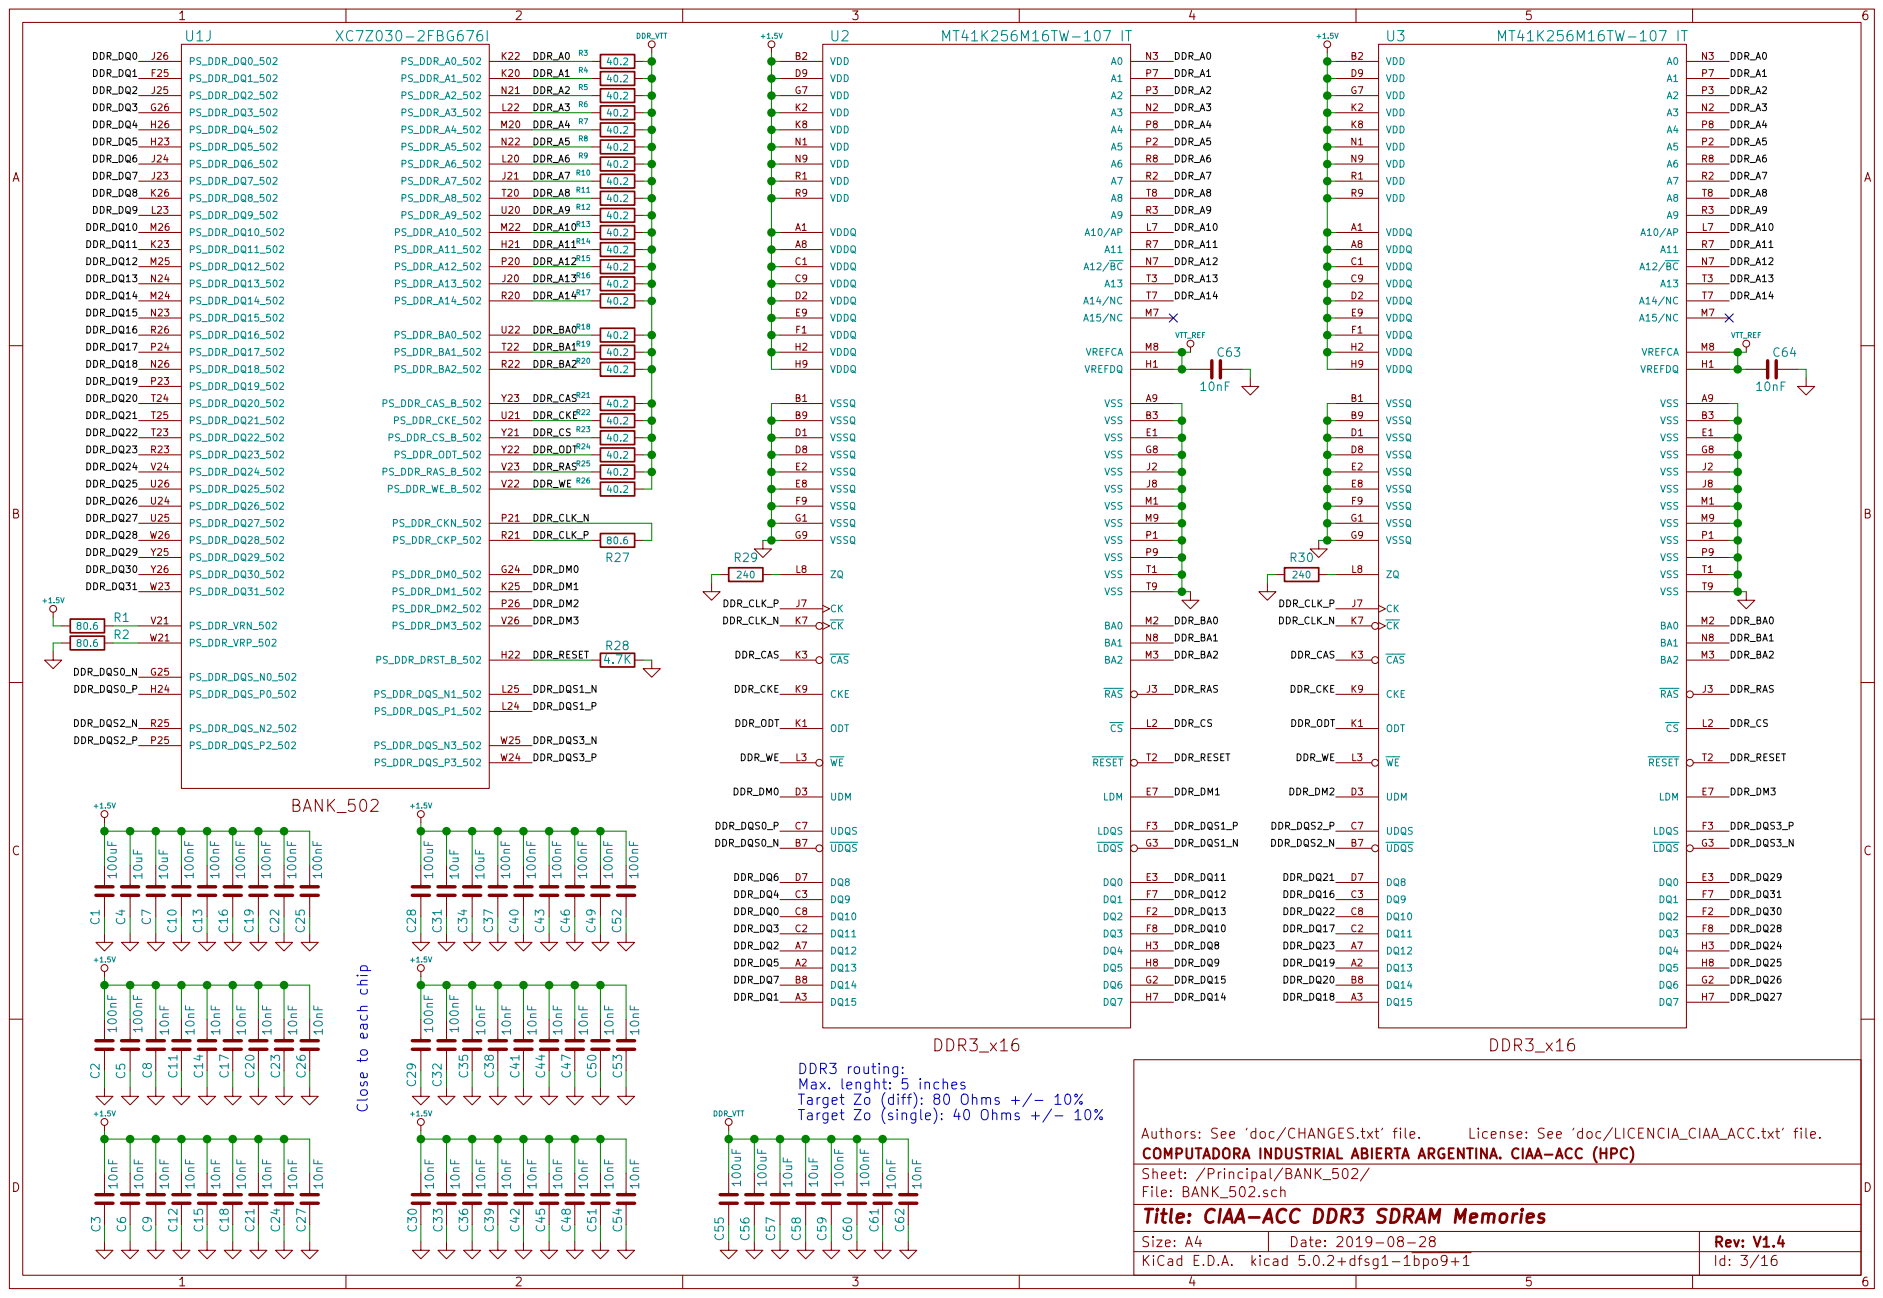
[picture p133: page 3]

DDR3 routing:
Max. lenght: 5 inches
Target Zo (diff): 80 Ohms +/- 10%

COMPUTADORA INDUSTRIAL ABIERTA ARGENTINA. CIAA-ACC (HPC)
Sheet: /Principal/BANK_502/
File: BANK_502.sch
Id: 3/16 Title: CIAA-ACC DDR3 SDRAM Memories

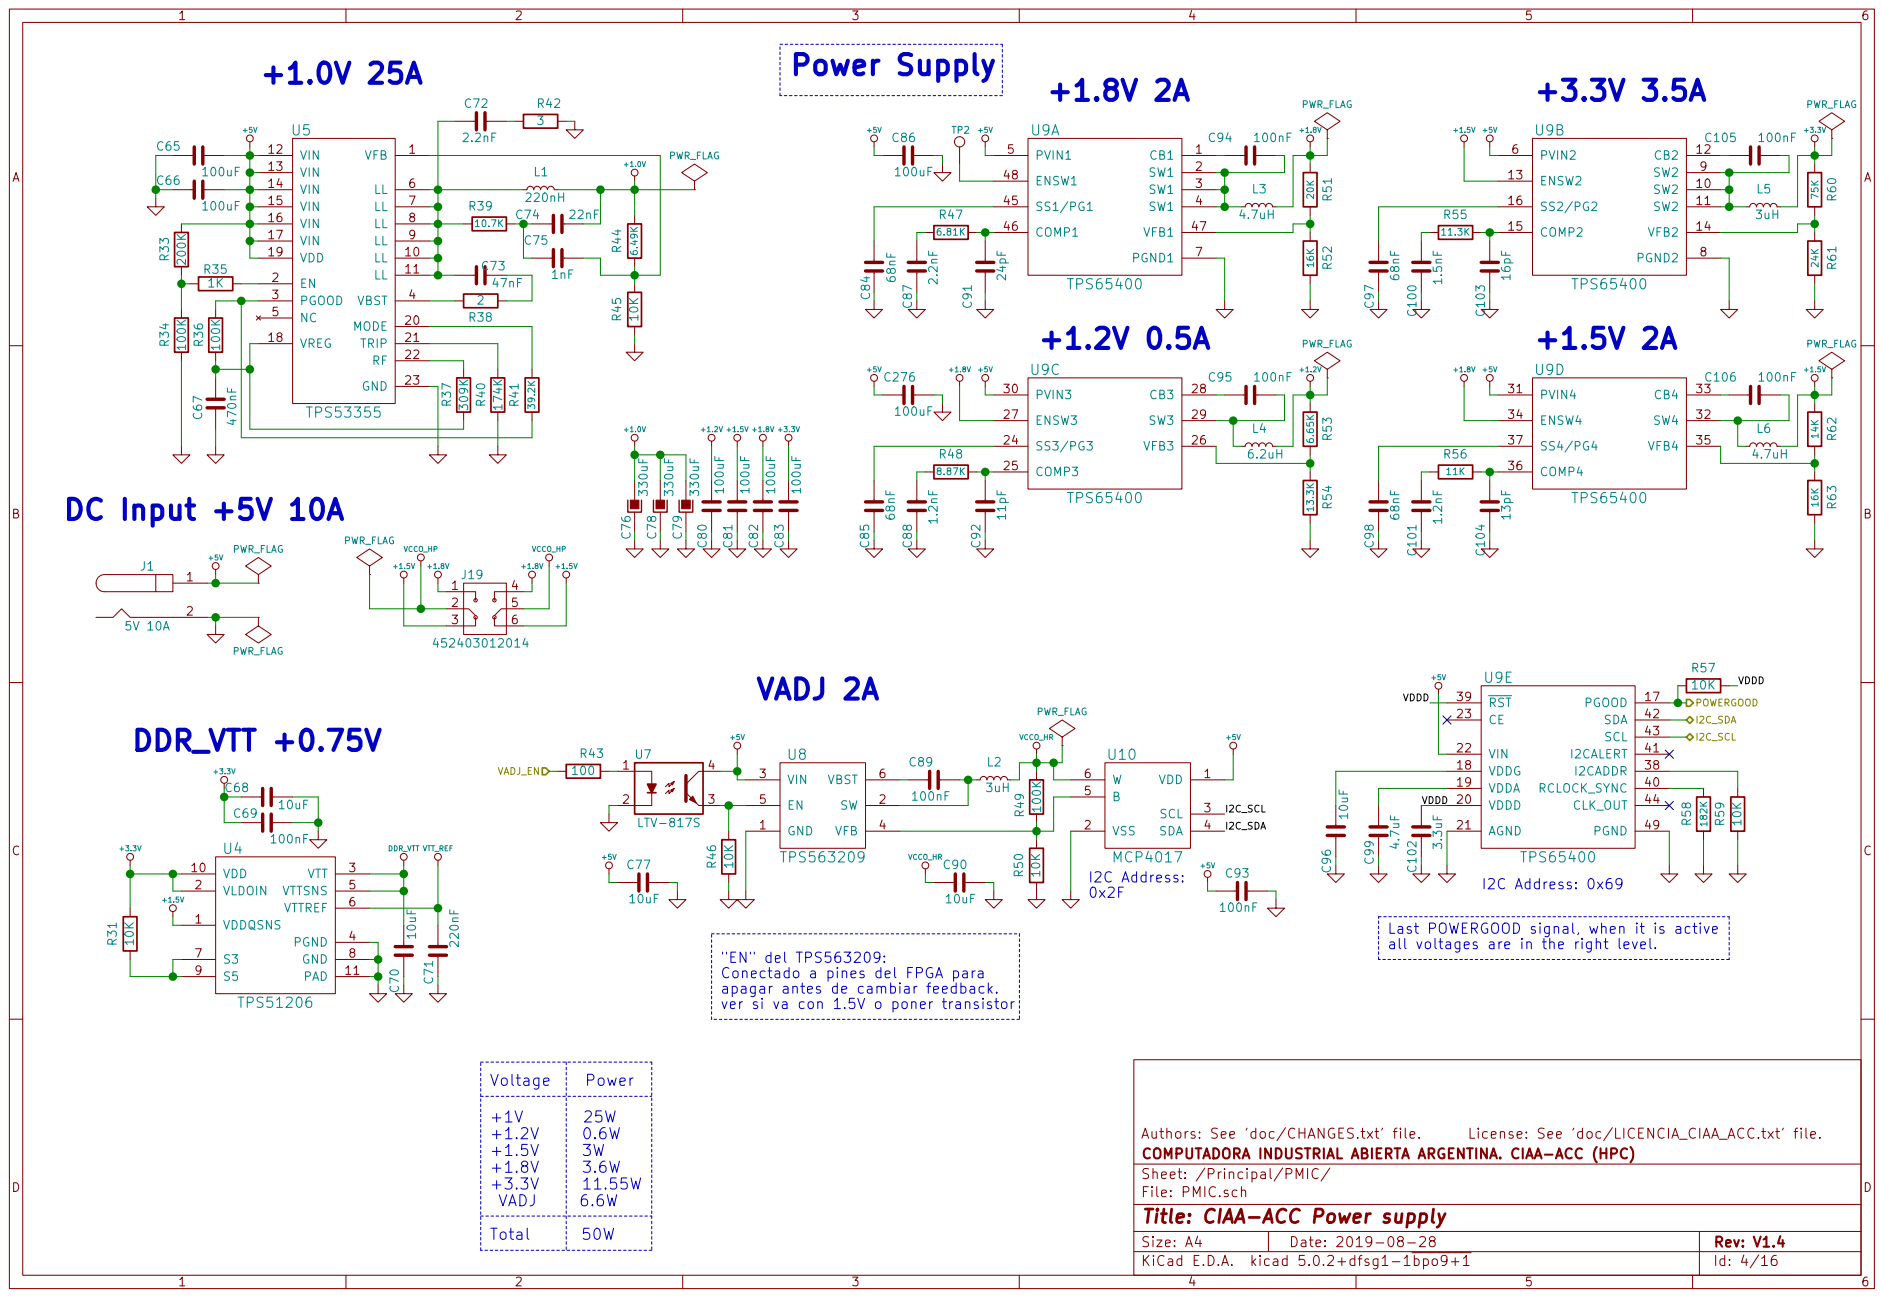
[picture p134: page 4]

Last POWERGOOD signal, when it is active
all voltages are in the right level.

"EN" del TPS563209:
Conectado a pines del FPGA para
apagar antes de cambiar feedback.

COMPUTADORA INDUSTRIAL ABIERTA ARGENTINA. CIAA-ACC (HPC)
File: PMIC.sch Sheet: /Principal/PMIC/
Id: 4/16 Title: CIAA-ACC Power supply

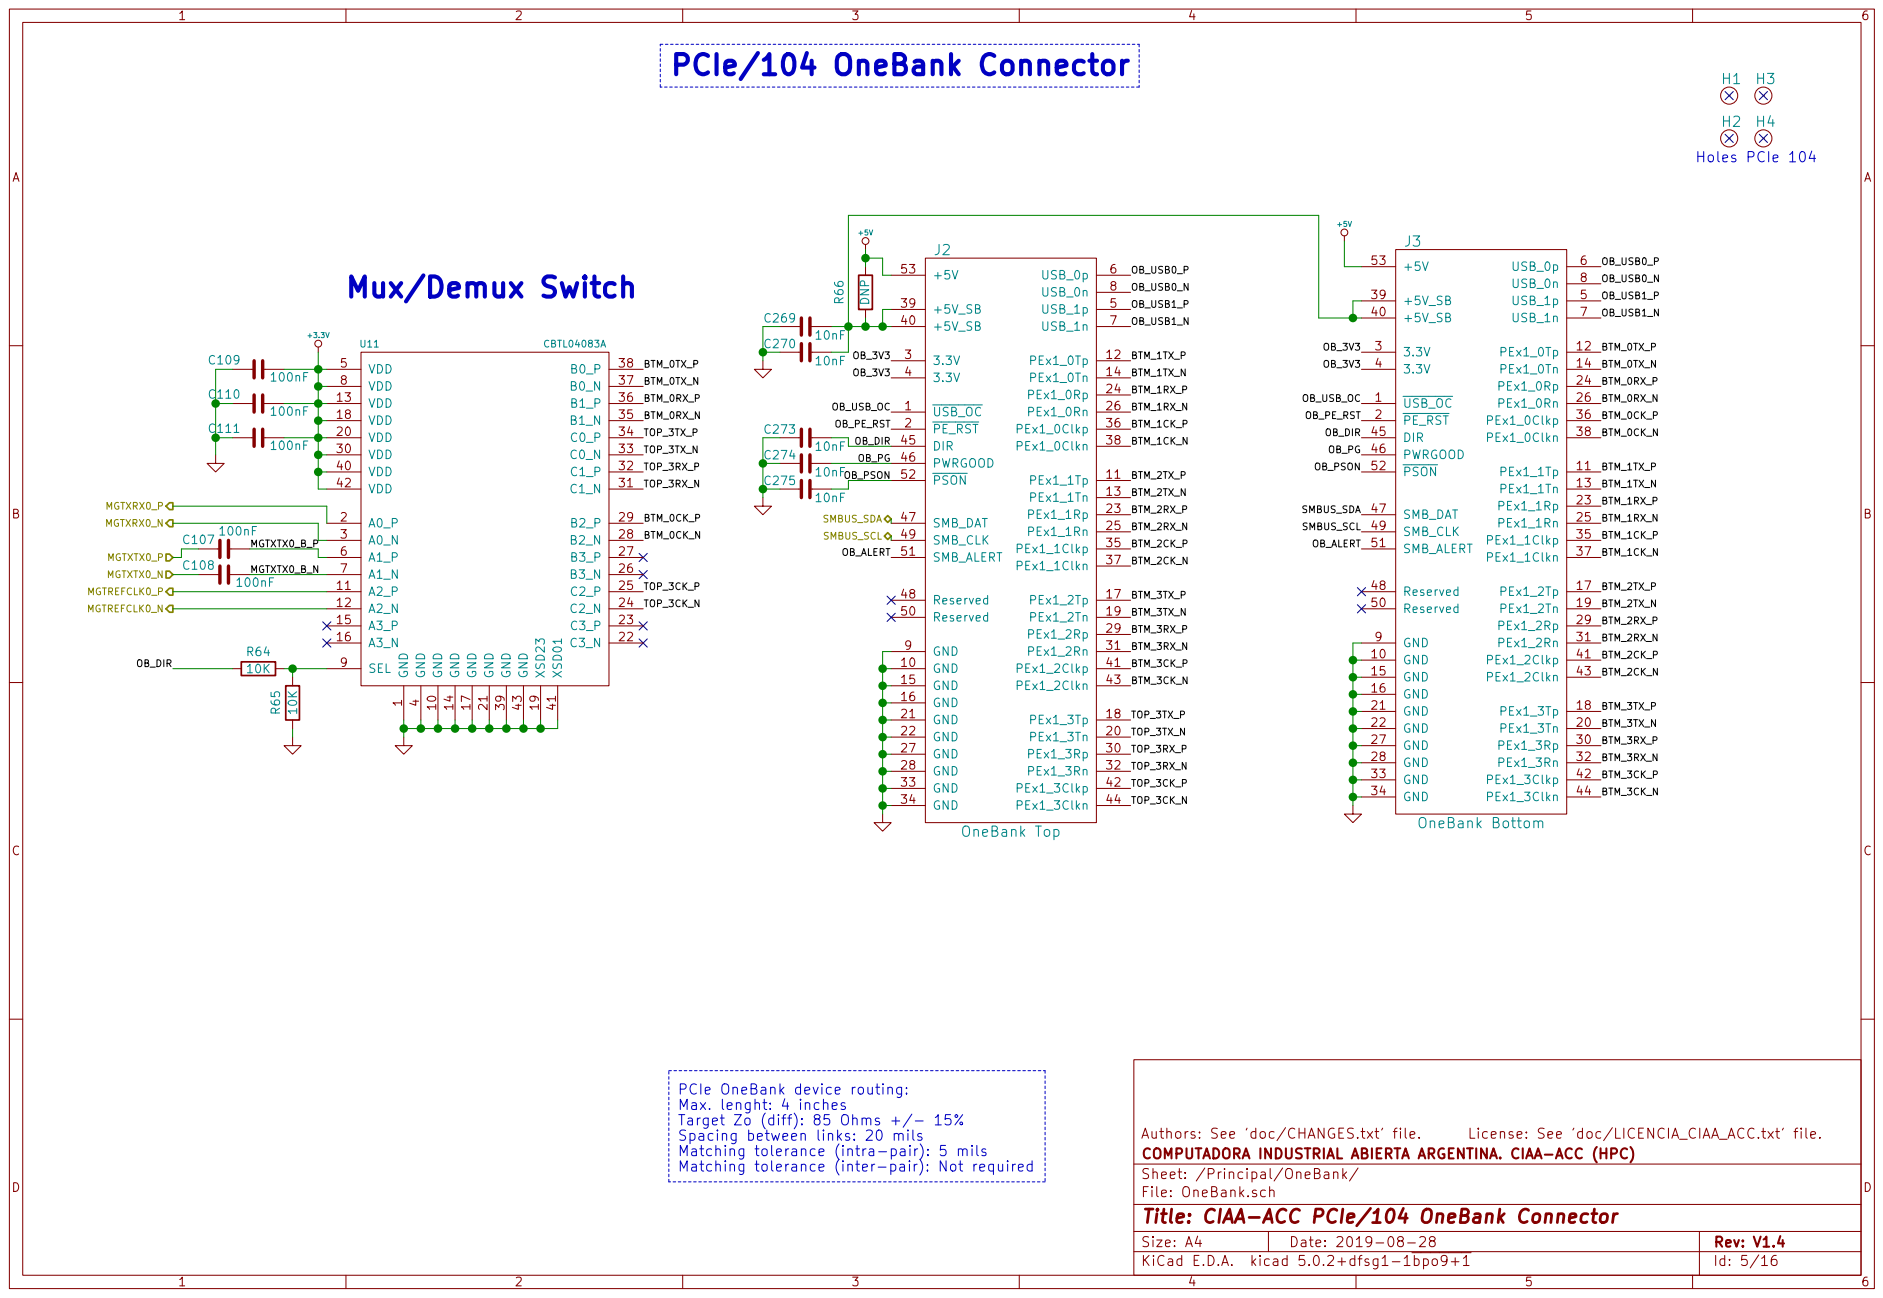
[picture p135: page 5]

4 VDD 5 A1_P 6 A1_N 7 VDD 8 SEL 9 GND 10 VDD 20 VDD 30 VDD 40 A2_P 11 GND 21 C1_N 31 XSD01 41 A2_N 12 C3_N 22 C1_P 32 VDD 42 VDD 13 C3_P 23 C0_N 33 GND 43 GND 14 C2_N 24 C0_P 34 A3_P 15 C2_P 25 B1_N 35 A3_N 16 B3_N 26 B1_P 36 GND 17 B3_P 27 B0_N 37 VDD 18 B2_N 28 B0_P 38 XSD23 19 B2_P 29 GND 39 U11 CBTL04083A

Max. lenght: 4 inches
Target Zo (diff): 85 Ohms +/- 15%
Spacing between links: 20 mils
Matching tolerance (intra-pair): 5 mils
Matching tolerance (inter-pair): Not required

COMPUTADORA INDUSTRIAL ABIERTA ARGENTINA. CIAA-ACC (HPC)
Id: 5/16 Title: CIAA-ACC PCIe/104 OneBank Connector File: OneBank.sch Sheet: /Principal/OneBank/

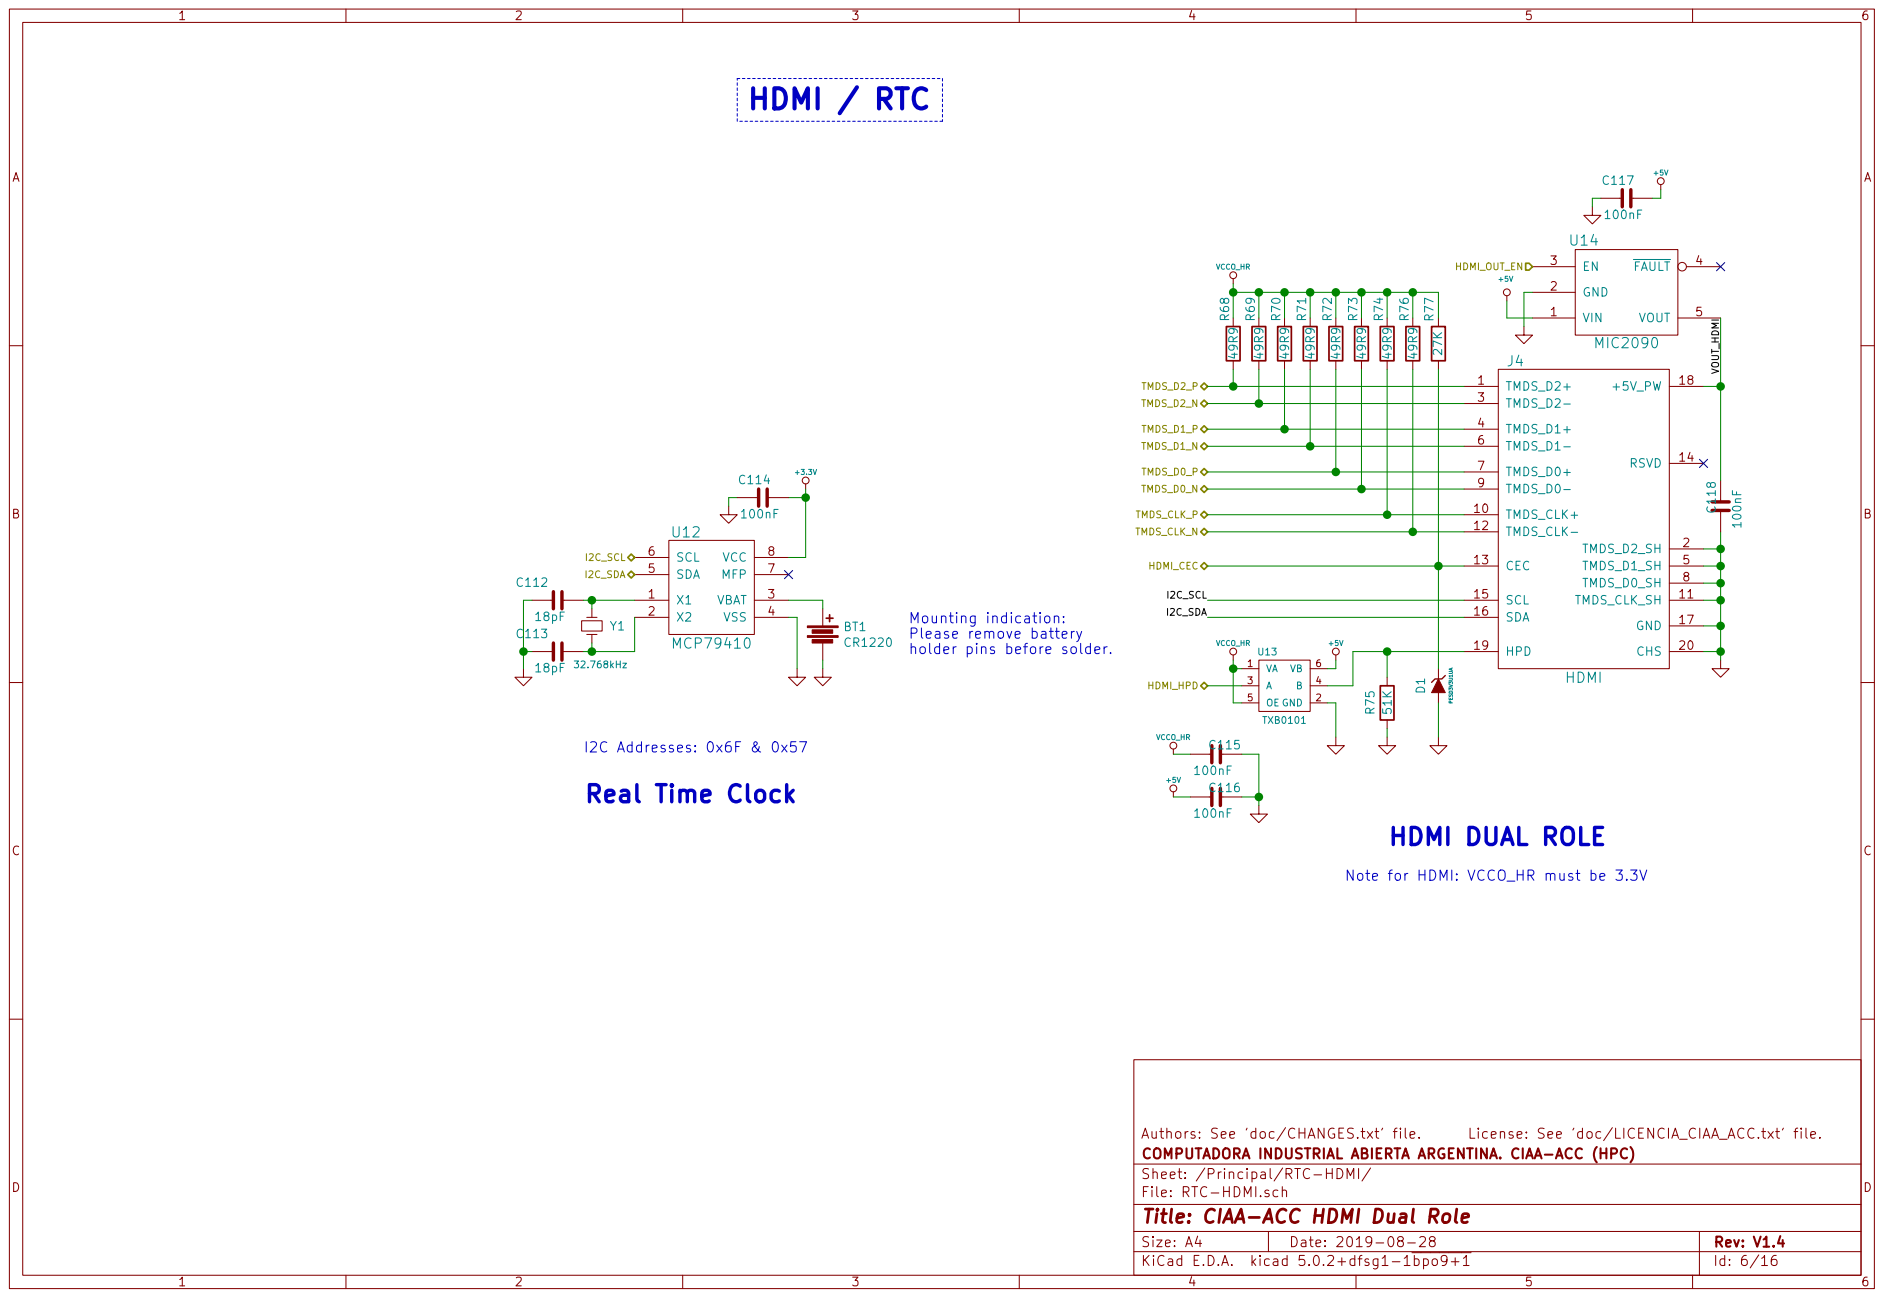
[picture p136: page 6]

Mounting indication:
Please remove battery
holder pins before solder.

COMPUTADORA INDUSTRIAL ABIERTA ARGENTINA. CIAA-ACC (HPC)
File: RTC-HDMI.sch Sheet: /Principal/RTC-HDMI/
Id: 6/16 Title: CIAA-ACC HDMI Dual Role

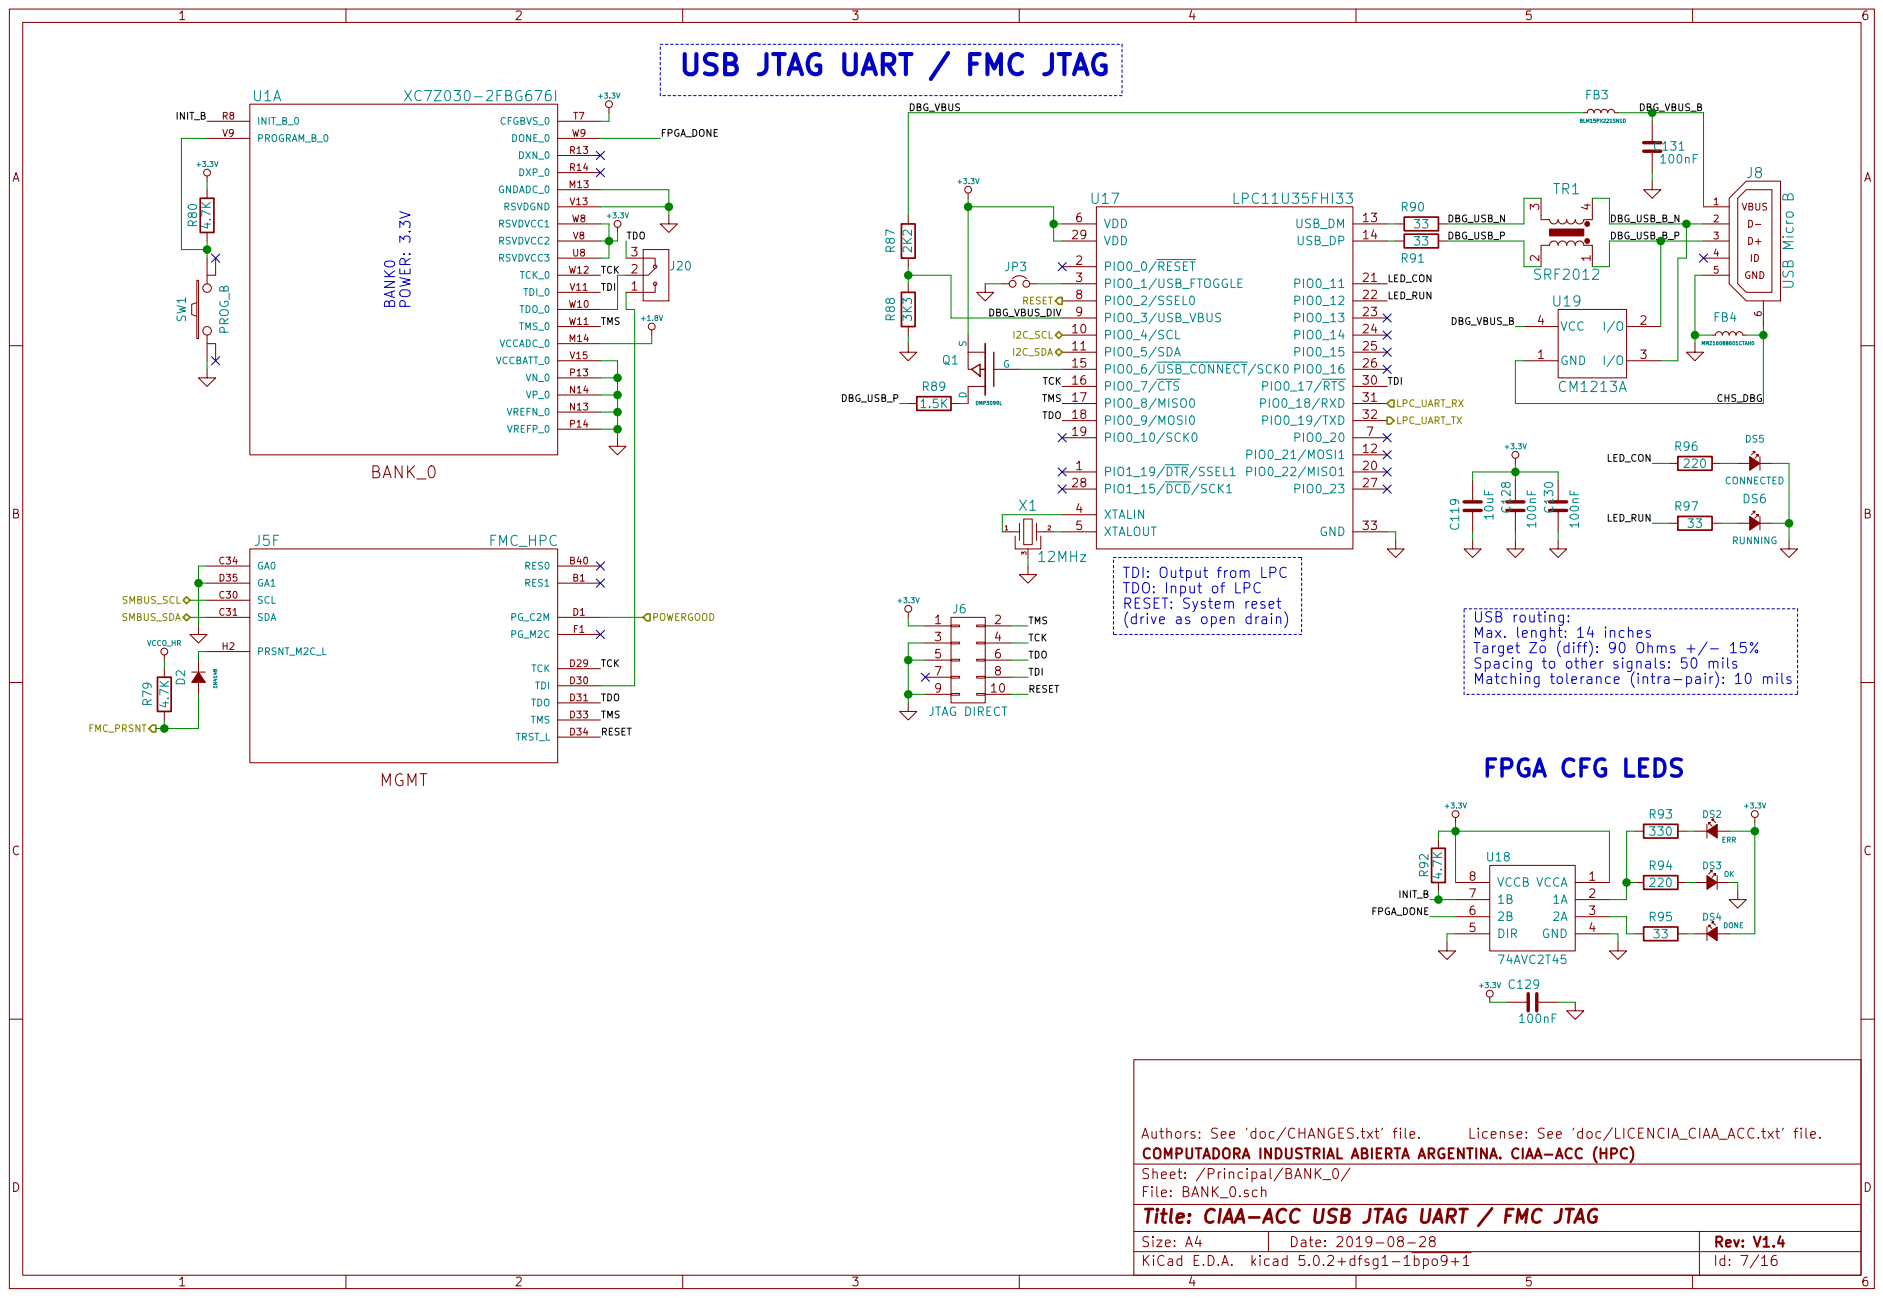
[picture p137: page 7]

USB JTAG UART / FMC JTAG

TDO: Input of LPC
RESET: System reset

Max. lenght: 14 inches
Target Zo (diff): 90 Ohms +/- 15%
Spacing to other signals: 50 mils
Matching tolerance (intra-pair): 10 mils

COMPUTADORA INDUSTRIAL ABIERTA ARGENTINA. CIAA-ACC (HPC)
Sheet: /Principal/BANK_0/
File: BANK_0.sch
Id: 7/16 Title: CIAA-ACC USB JTAG UART / FMC JTAG

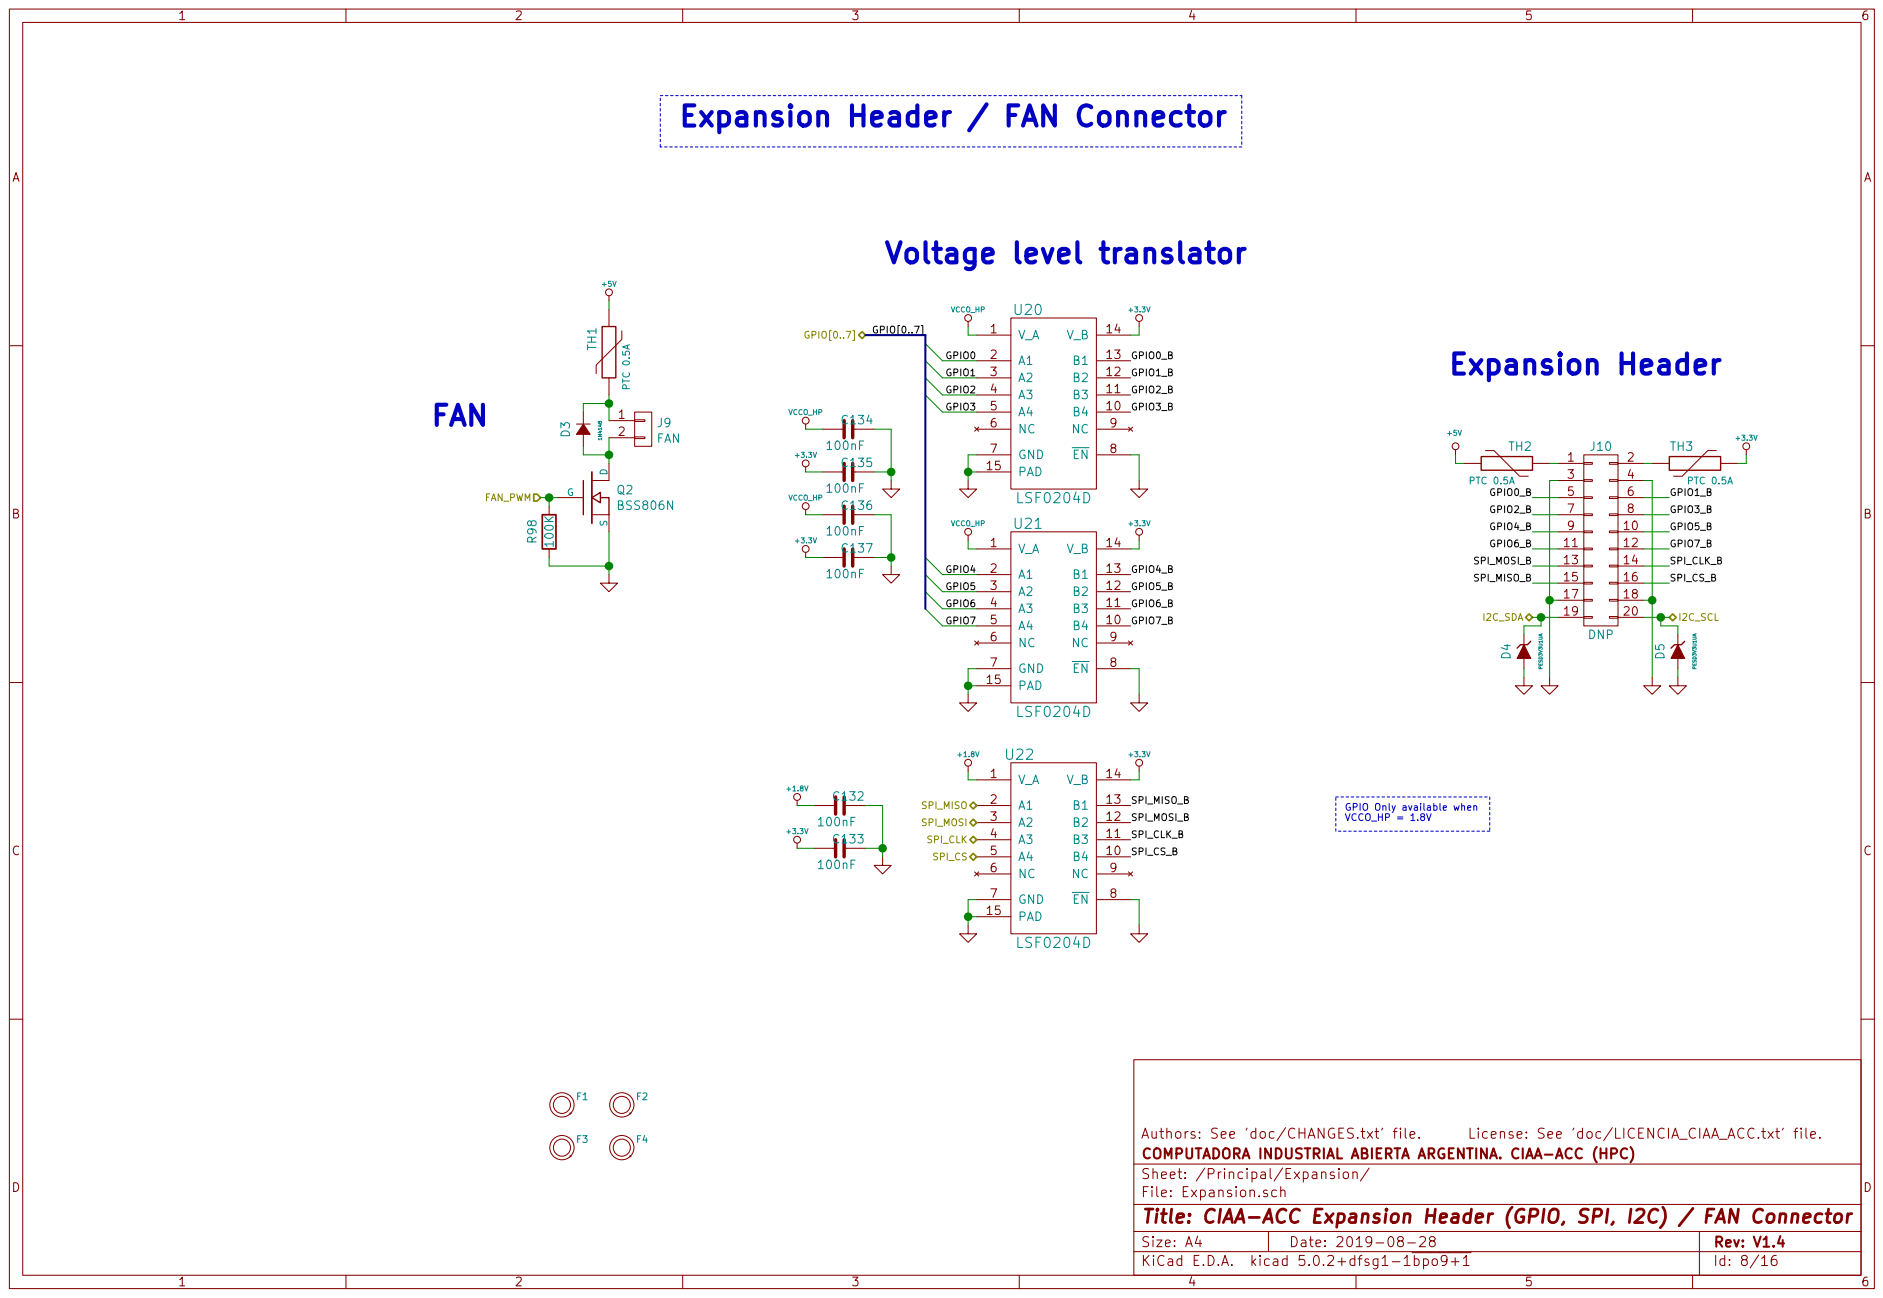
[picture p138: page 8]

VCCO_HP Expansion Header / FAN Connector

9 | 10
11 | 12
13 | 14
15 | 16
17 | 18

COMPUTADORA INDUSTRIAL ABIERTA ARGENTINA. CIAA-ACC (HPC)
Sheet: /Principal/Expansion/
File: Expansion.sch
Id: 8/16 Title: CIAA-ACC Expansion Header (GPIO, SPI, I2C) / FAN Connector

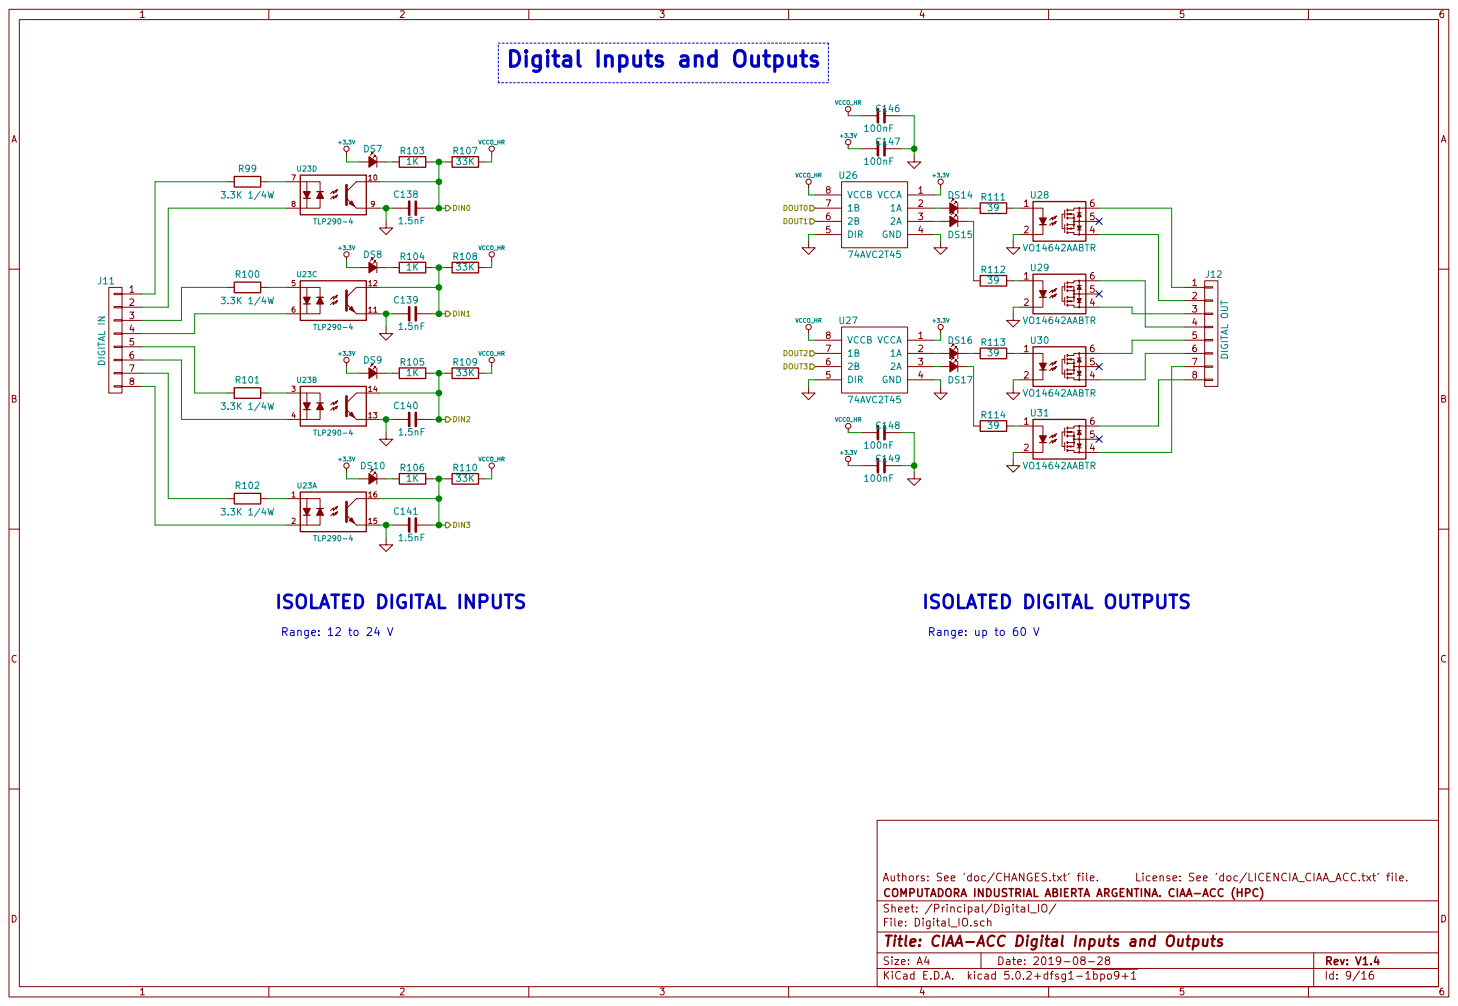
[picture p139: page 9]

COMPUTADORA INDUSTRIAL ABIERTA ARGENTINA. CIAA-ACC (HPC)
Sheet: /Principal/Digital_IO/
File: Digital_IO.sch
Id: 9/16 Title: CIAA-ACC Digital Inputs and Outputs

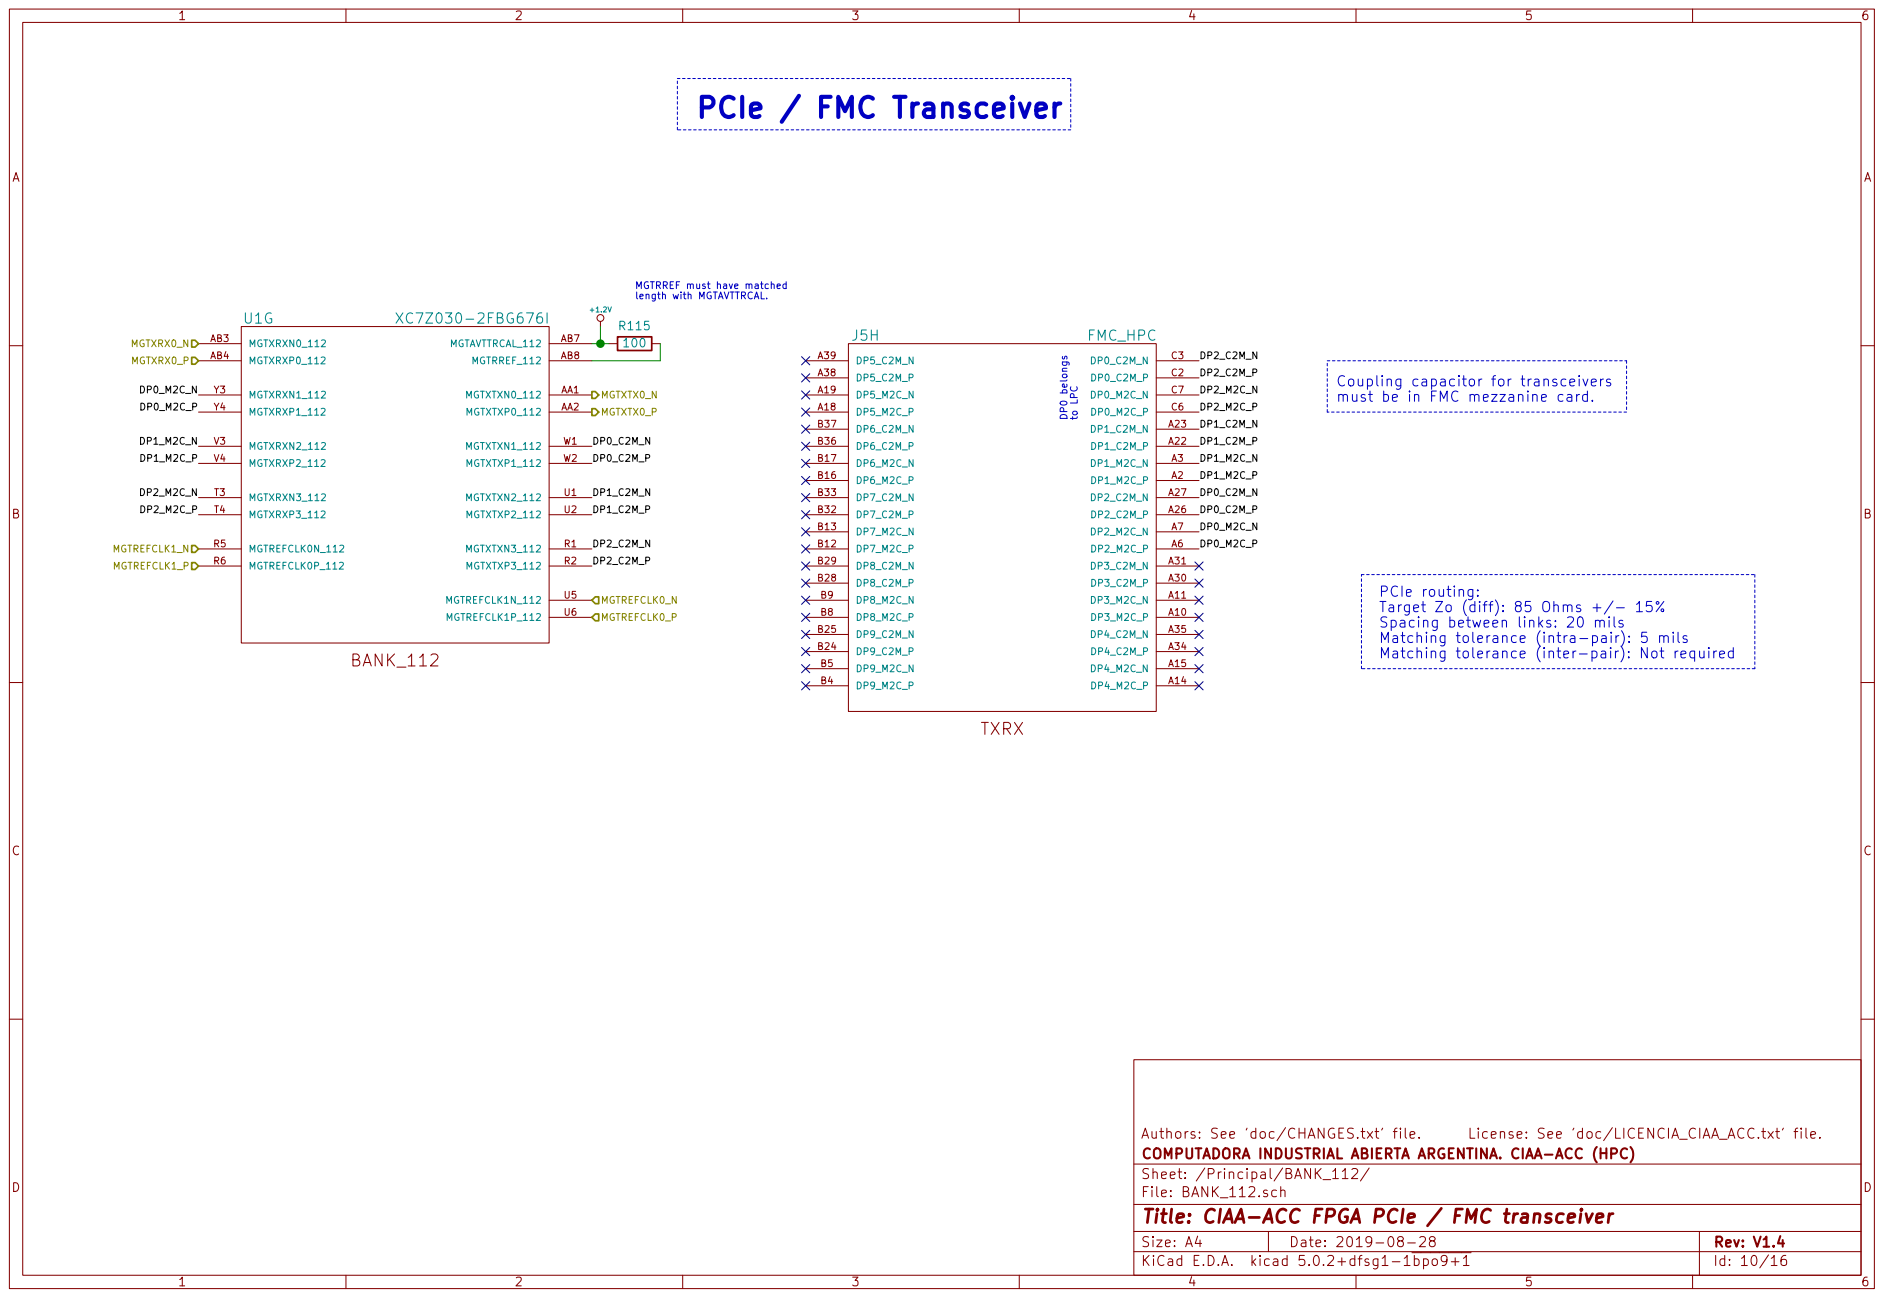
[picture p140: page 10]

length with MGTAVTTRCAL. PCIe / FMC Transceiver

must be in FMC mezzanine card. R115

Coupling capacitor for transceivers

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

COMPUTADORA INDUSTRIAL ABIERTA ARGENTINA. CIAA-ACC (HPC)
Sheet: /Principal/BANK_112/
File: BANK_112.sch
Id: 10/16 Title: CIAA-ACC FPGA PCIe / FMC transceiver

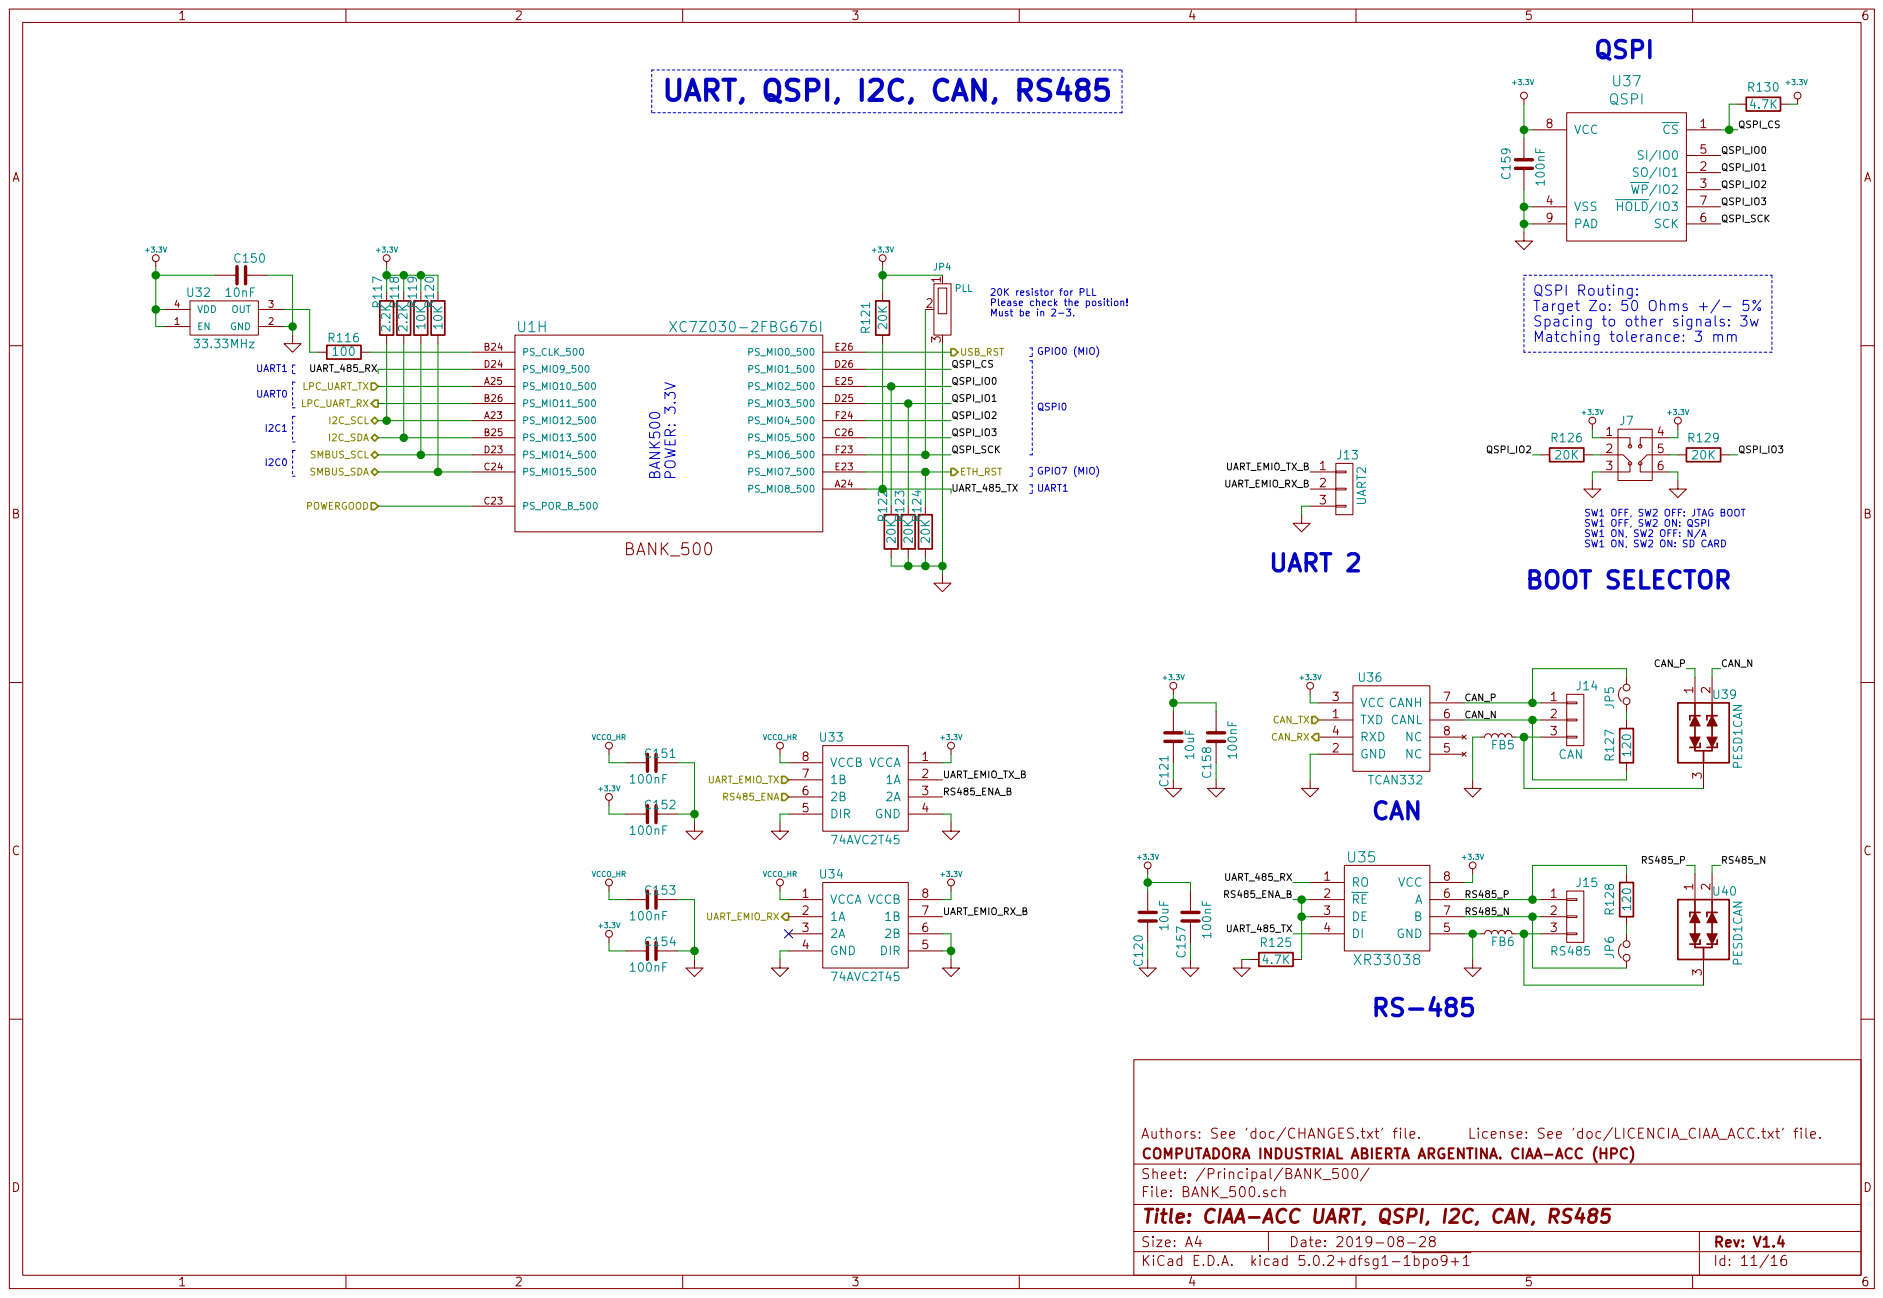
[picture p141: page 11]

20K resistor for PLL Please check the position! Must be in 2-3.

QSPI Routing:
Target Zo: 50 Ohms +/- 5%
Spacing to other signals: 3w
Matching tolerance: 3 mm

+3.3V SW1 OFF, SW2 OFF: JTAG BOOT SW1 OFF, SW2 ON: QSPI SW1 ON, SW2 OFF: N/A

SW1 ON, SW2 ON: SD CARD

COMPUTADORA INDUSTRIAL ABIERTA ARGENTINA. CIAA-ACC (HPC)
Sheet: /Principal/BANK_500/
File: BANK_500.sch
Id: 11/16 Title: CIAA-ACC UART, QSPI, I2C, CAN, RS485

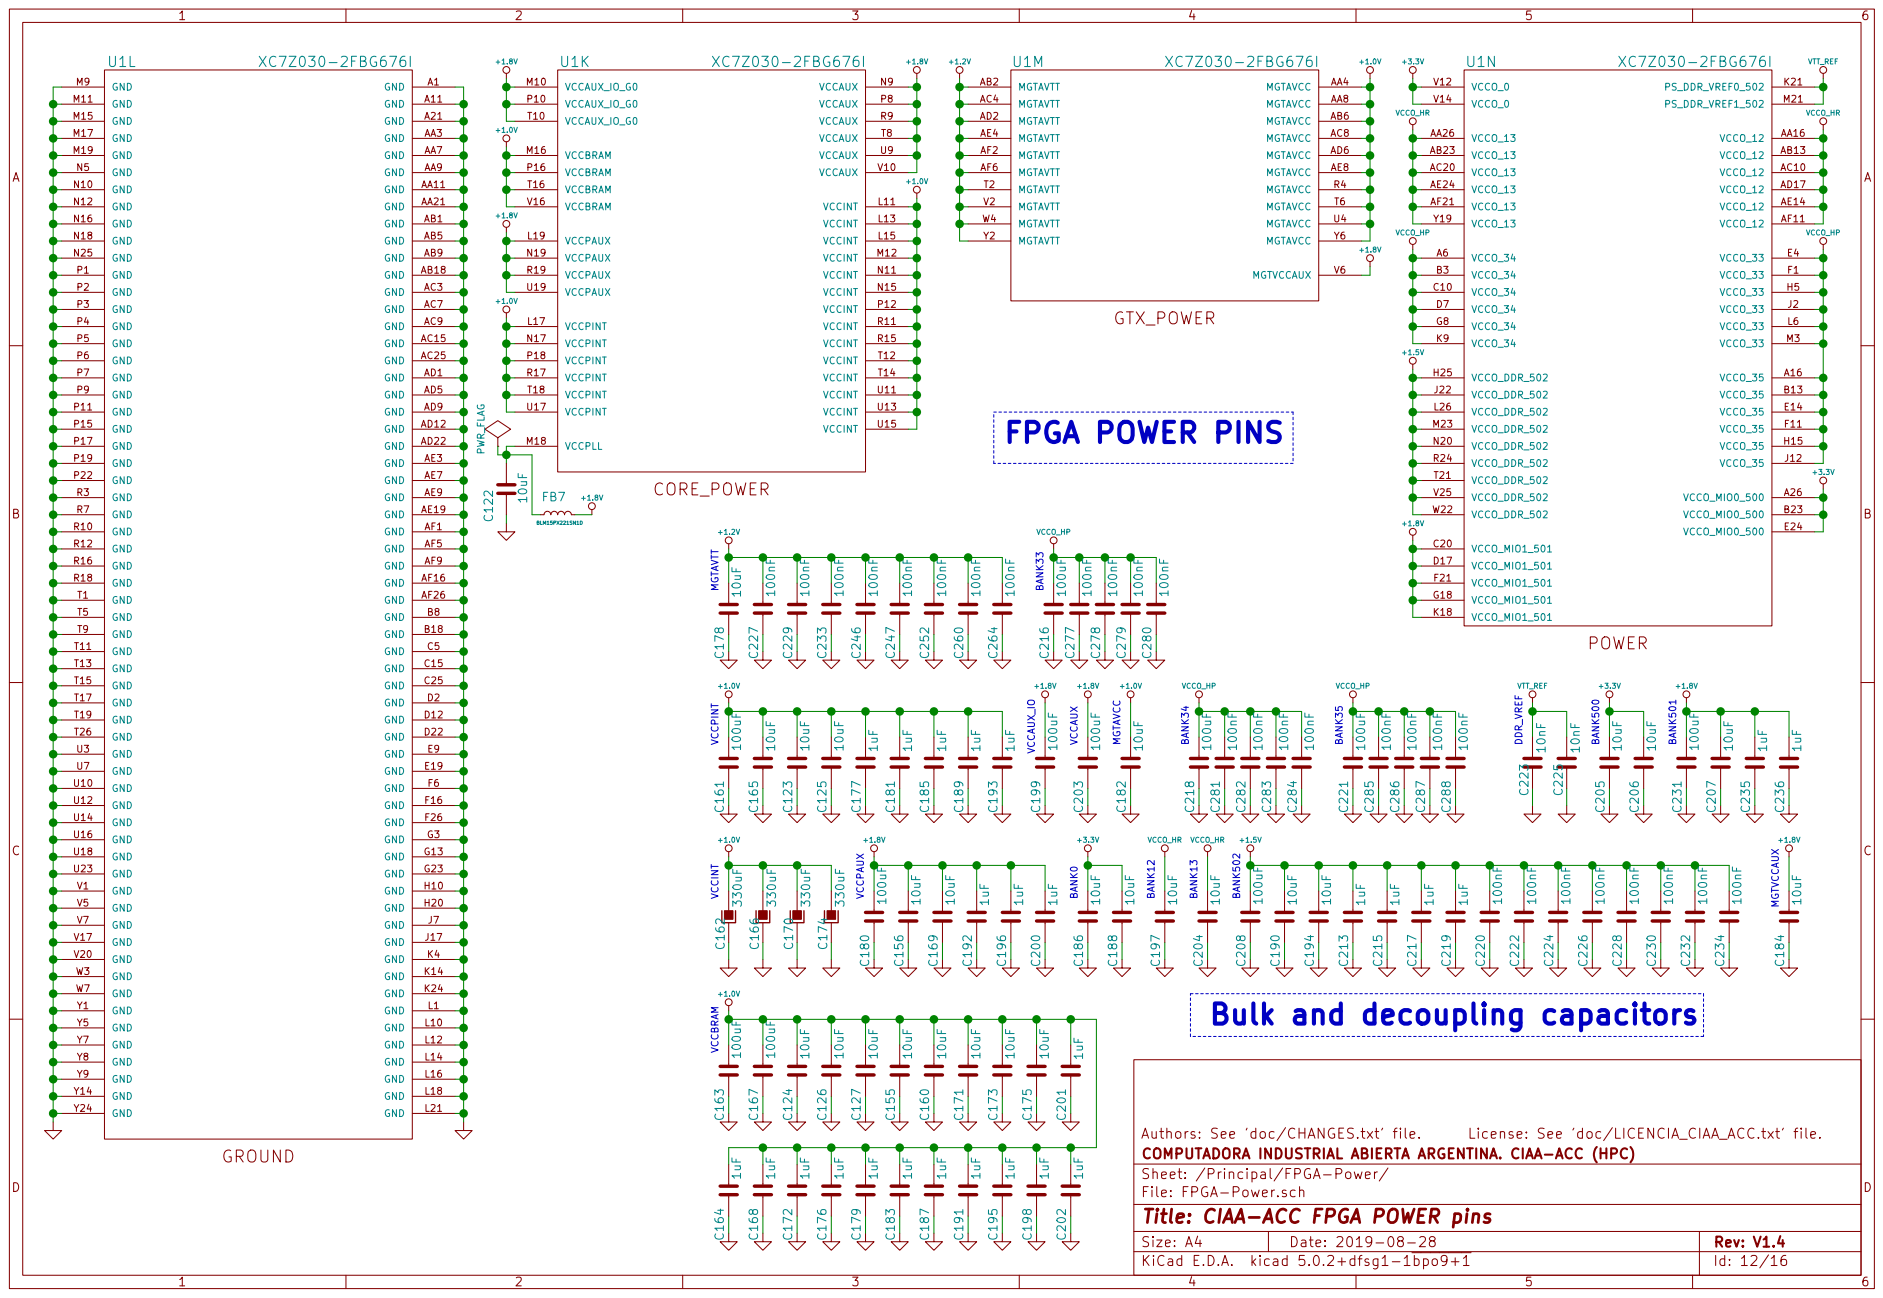
[picture p142: page 12]

Bulk and decoupling capacitors

COMPUTADORA INDUSTRIAL ABIERTA ARGENTINA. CIAA-ACC (HPC)
File: FPGA-Power.sch Sheet: /Principal/FPGA-Power/
Id: 12/16 Title: CIAA-ACC FPGA POWER pins

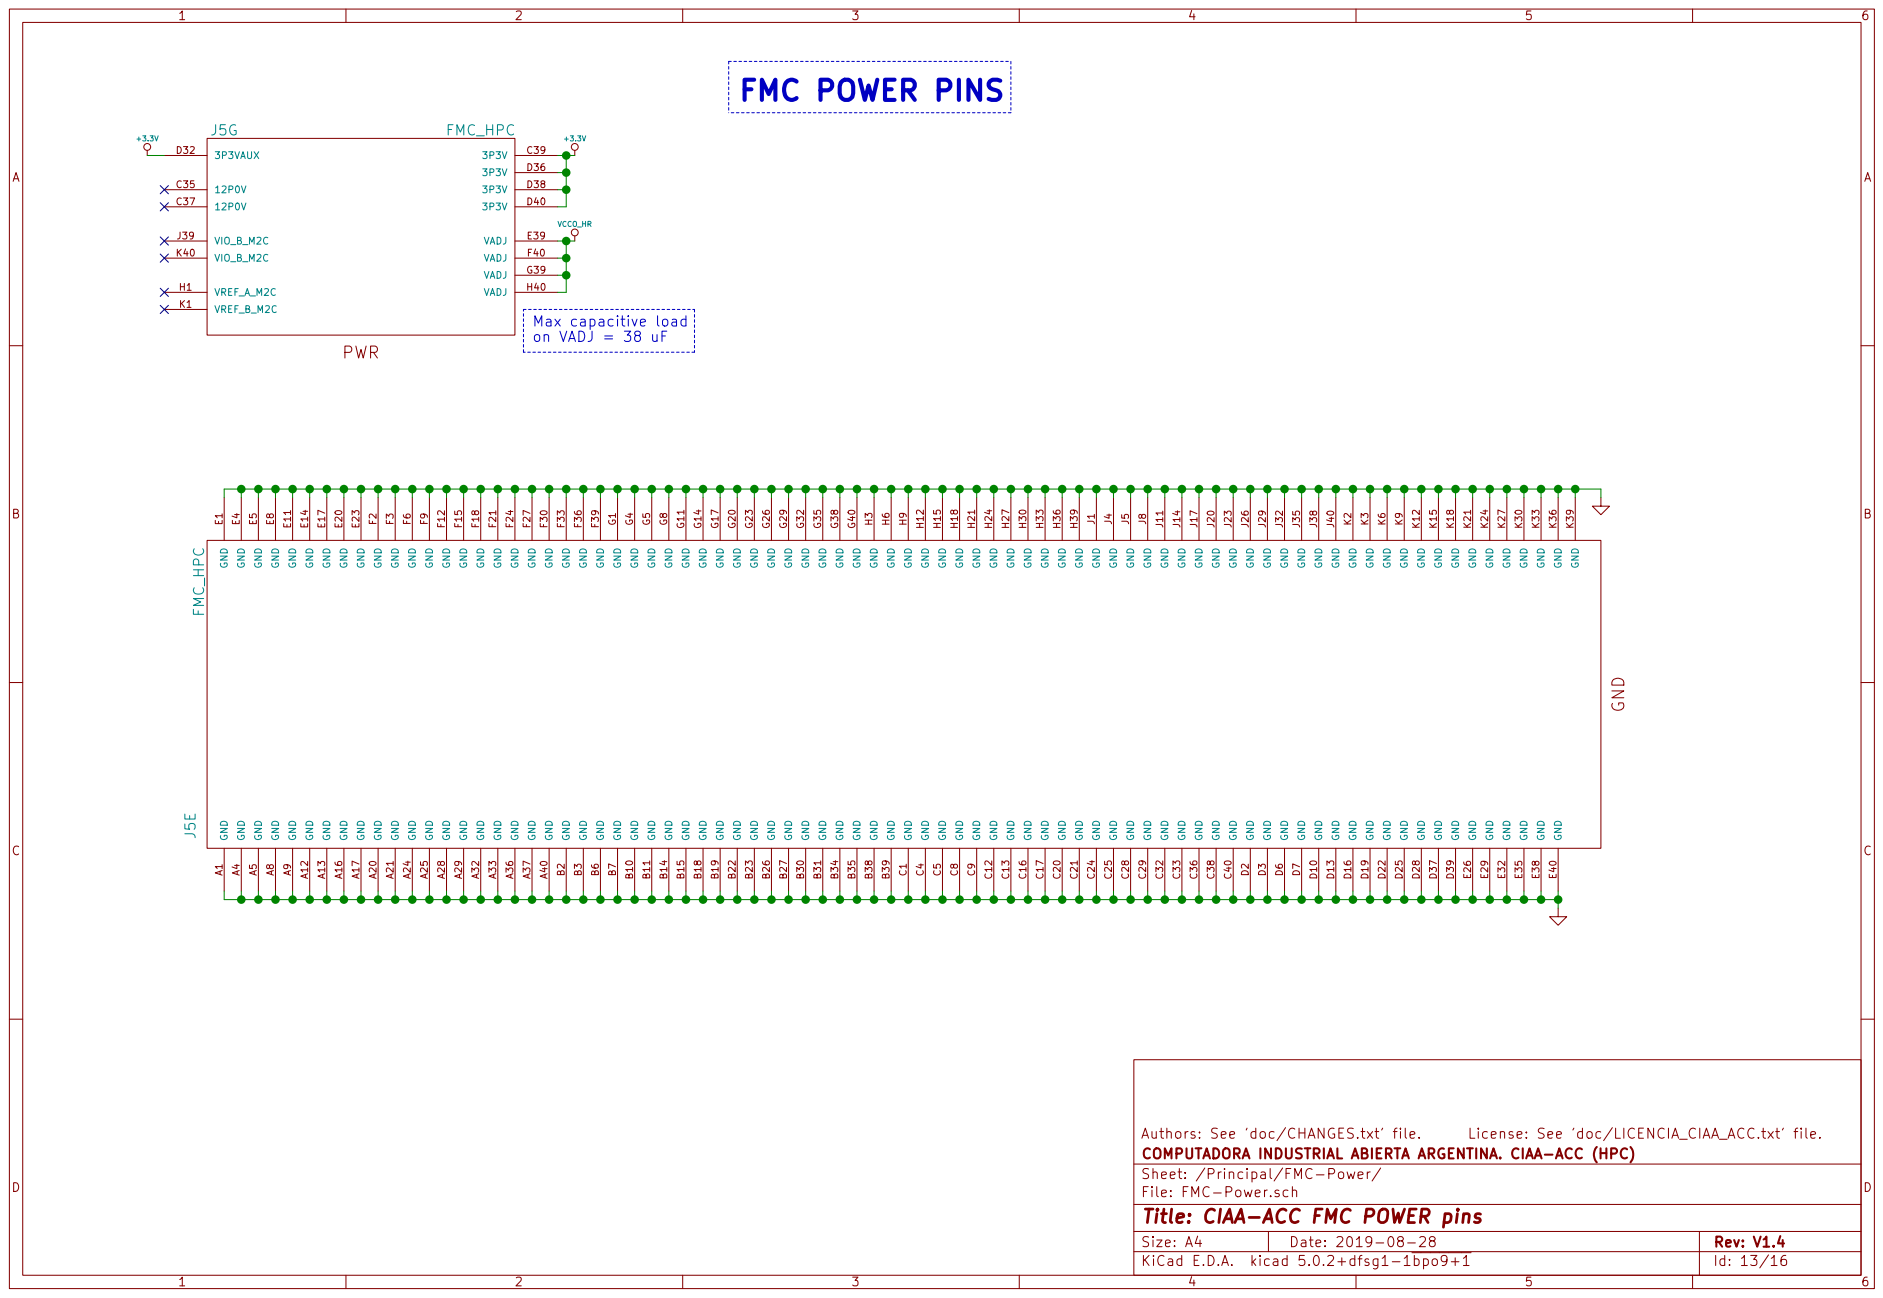
[picture p143: page 13]

Max capacitive load on VADJ = 38 uF

COMPUTADORA INDUSTRIAL ABIERTA ARGENTINA. CIAA-ACC (HPC)
File: FMC-Power.sch Sheet: /Principal/FMC-Power/
Id: 13/16 Title: CIAA-ACC FMC POWER pins

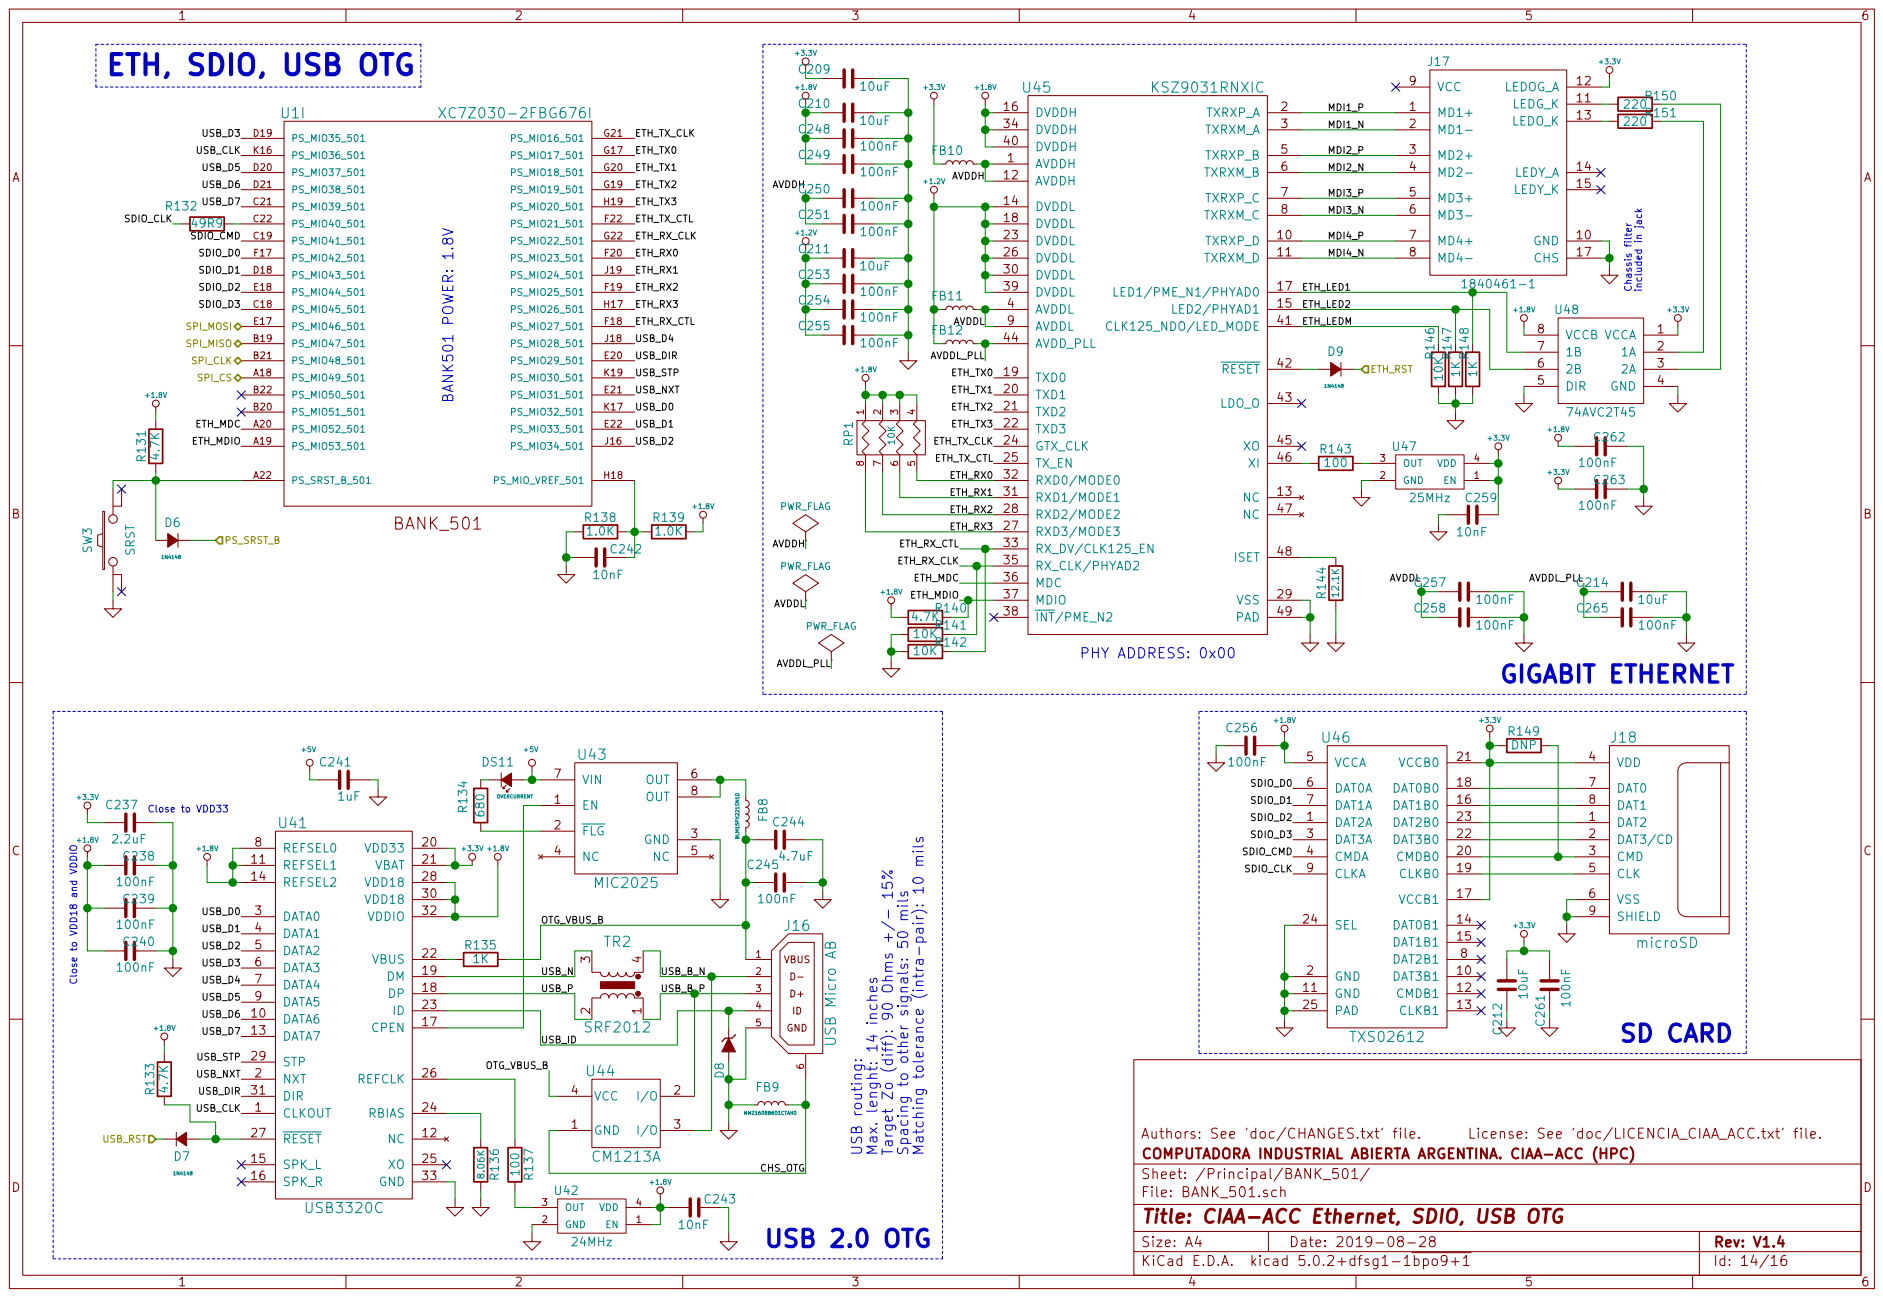
[picture p144: page 14]

100nF ETH, SDIO, USB OTG

6 J16 USB Micro AB D8 USB routing: Max. lenght: 14 inches Target Zo (diff): 90 Ohms +/- 15% Spacing to other signals: 50 mils Matching tolerance (intra-pair): 10 mils DAT2 1 DAT3/CD 2 CMD 3 VDD 4 CLK 5 VSS 6 DAT0 7 DAT1 8 SHIELD 9 J18 microSD

+3.3V Close to VDD18 and VDDIO

COMPUTADORA INDUSTRIAL ABIERTA ARGENTINA. CIAA-ACC (HPC)
Sheet: /Principal/BANK_501/
File: BANK_501.sch
Id: 14/16 Title: CIAA-ACC Ethernet, SDIO, USB OTG

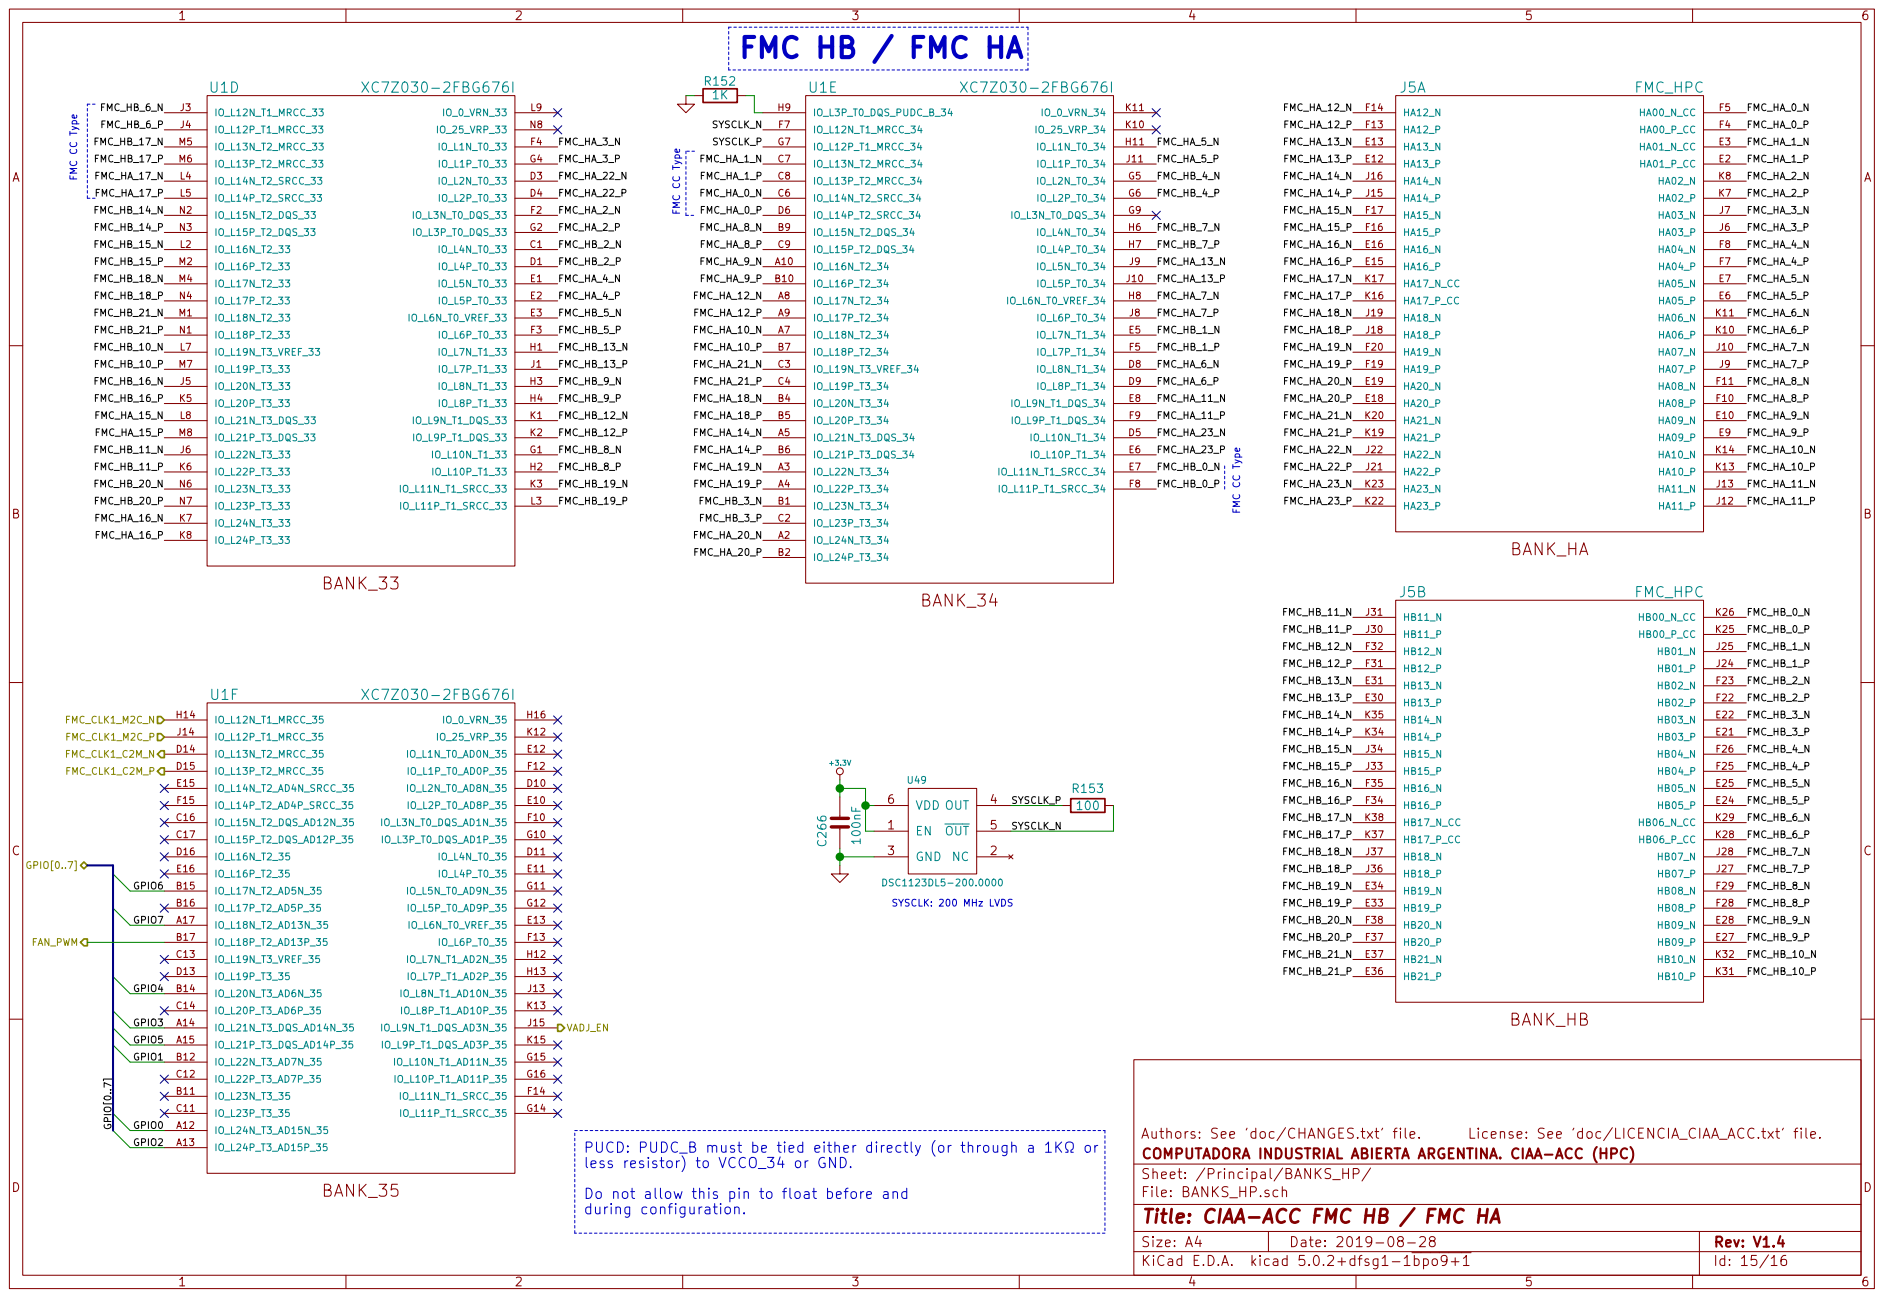
[picture p145: page 15]

FMC HB / FMC HA

COMPUTADORA INDUSTRIAL ABIERTA ARGENTINA. CIAA-ACC (HPC)
Sheet: /Principal/BANKS_HP/
File: BANKS_HP.sch
Id: 15/16 Title: CIAA-ACC FMC HB / FMC HA

less resistor) to VCCO_34 or GND.
Do not allow this pin to float before and
during configuration.

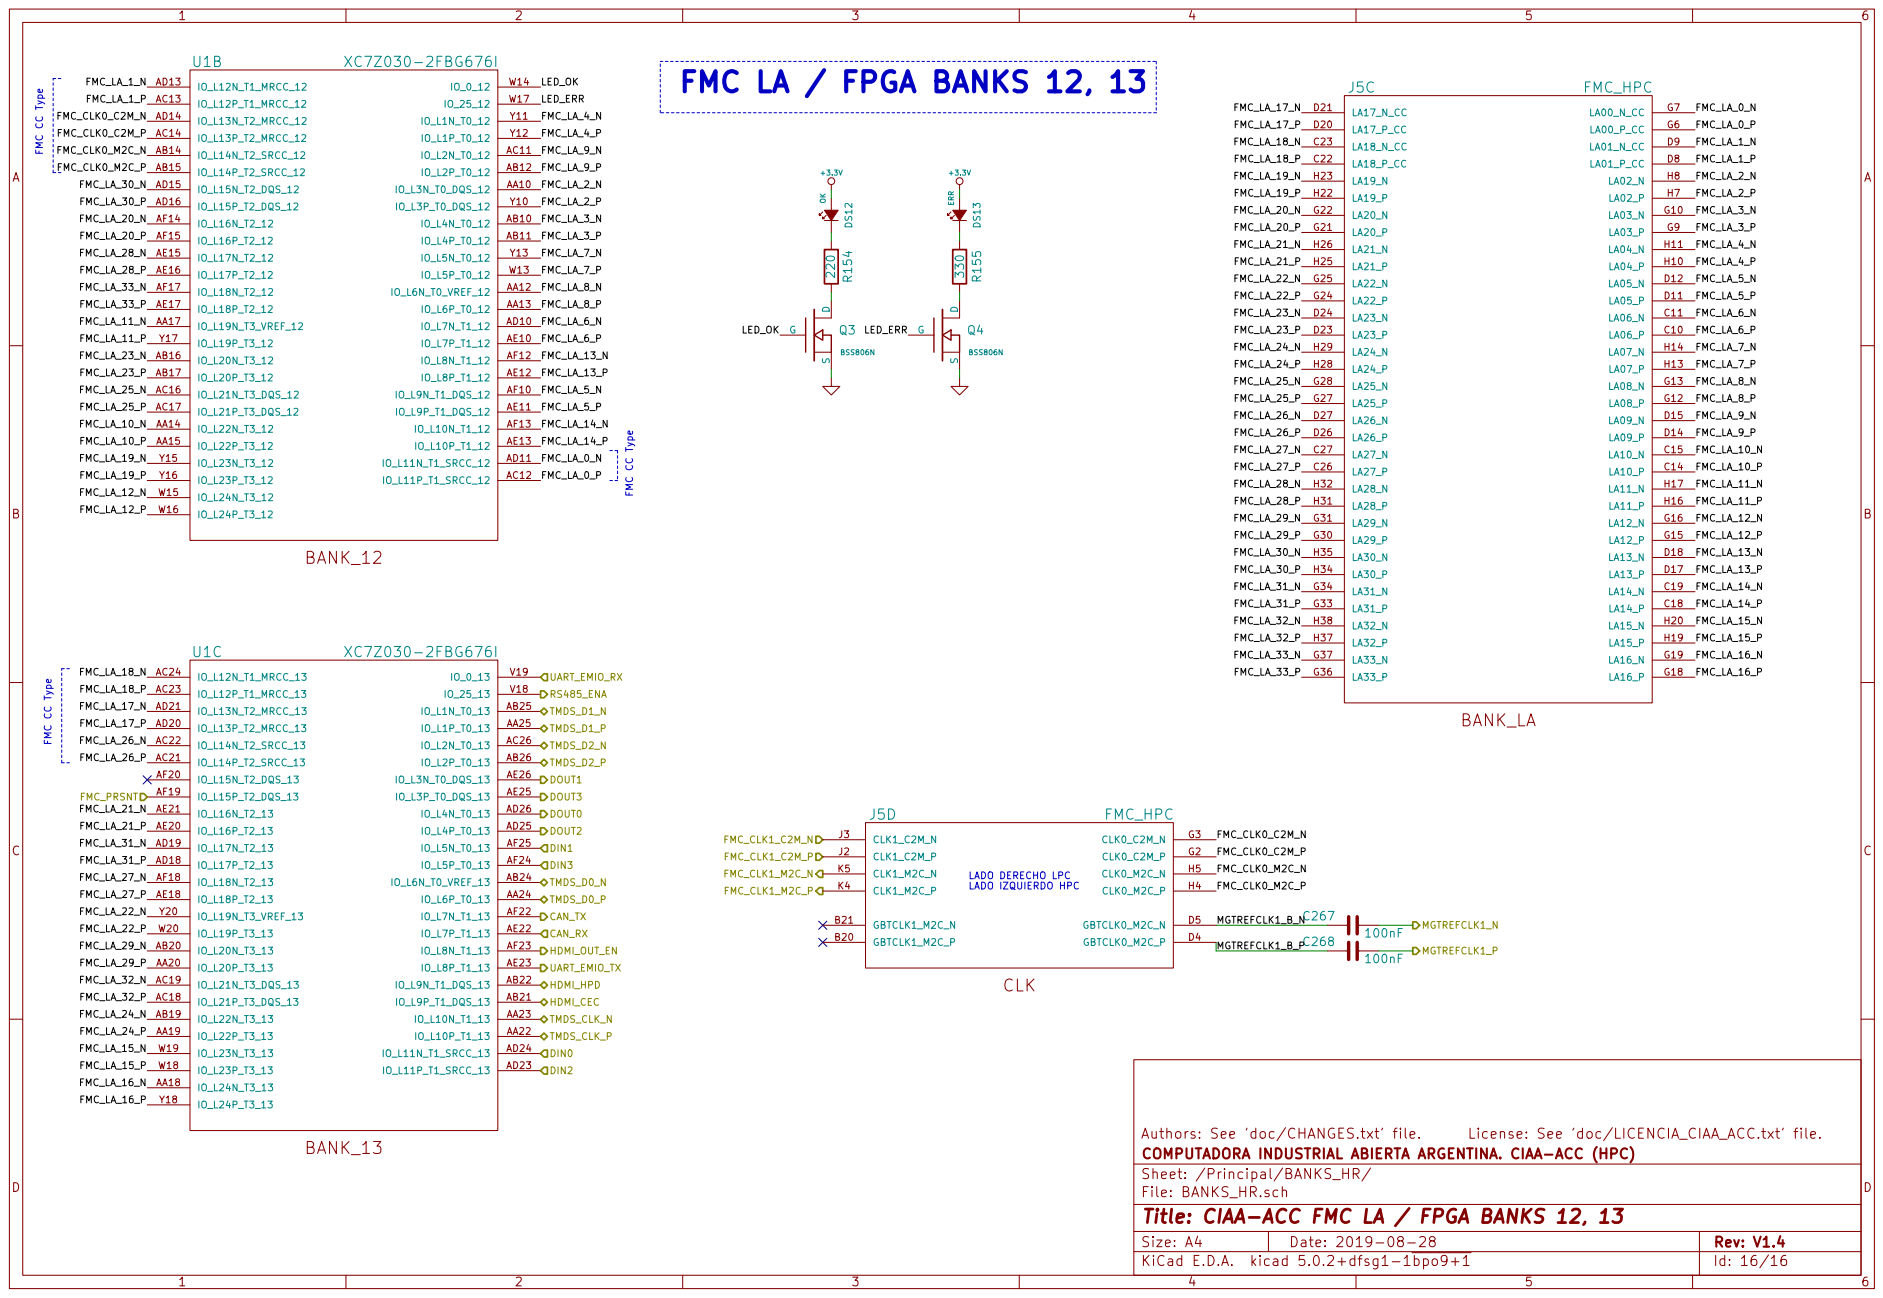
[picture p146: page 16]

FMC LA / FPGA BANKS 12, 13

COMPUTADORA INDUSTRIAL ABIERTA ARGENTINA. CIAA-ACC (HPC)
Sheet: /Principal/BANKS_HR/
File: BANKS_HR.sch
Id: 16/16 Title: CIAA-ACC FMC LA / FPGA BANKS 12, 13
