ciaa/Hardware/PCB/EDU-XILINX/OtherBoards/Basys3/basys_3_sch_public.pdf

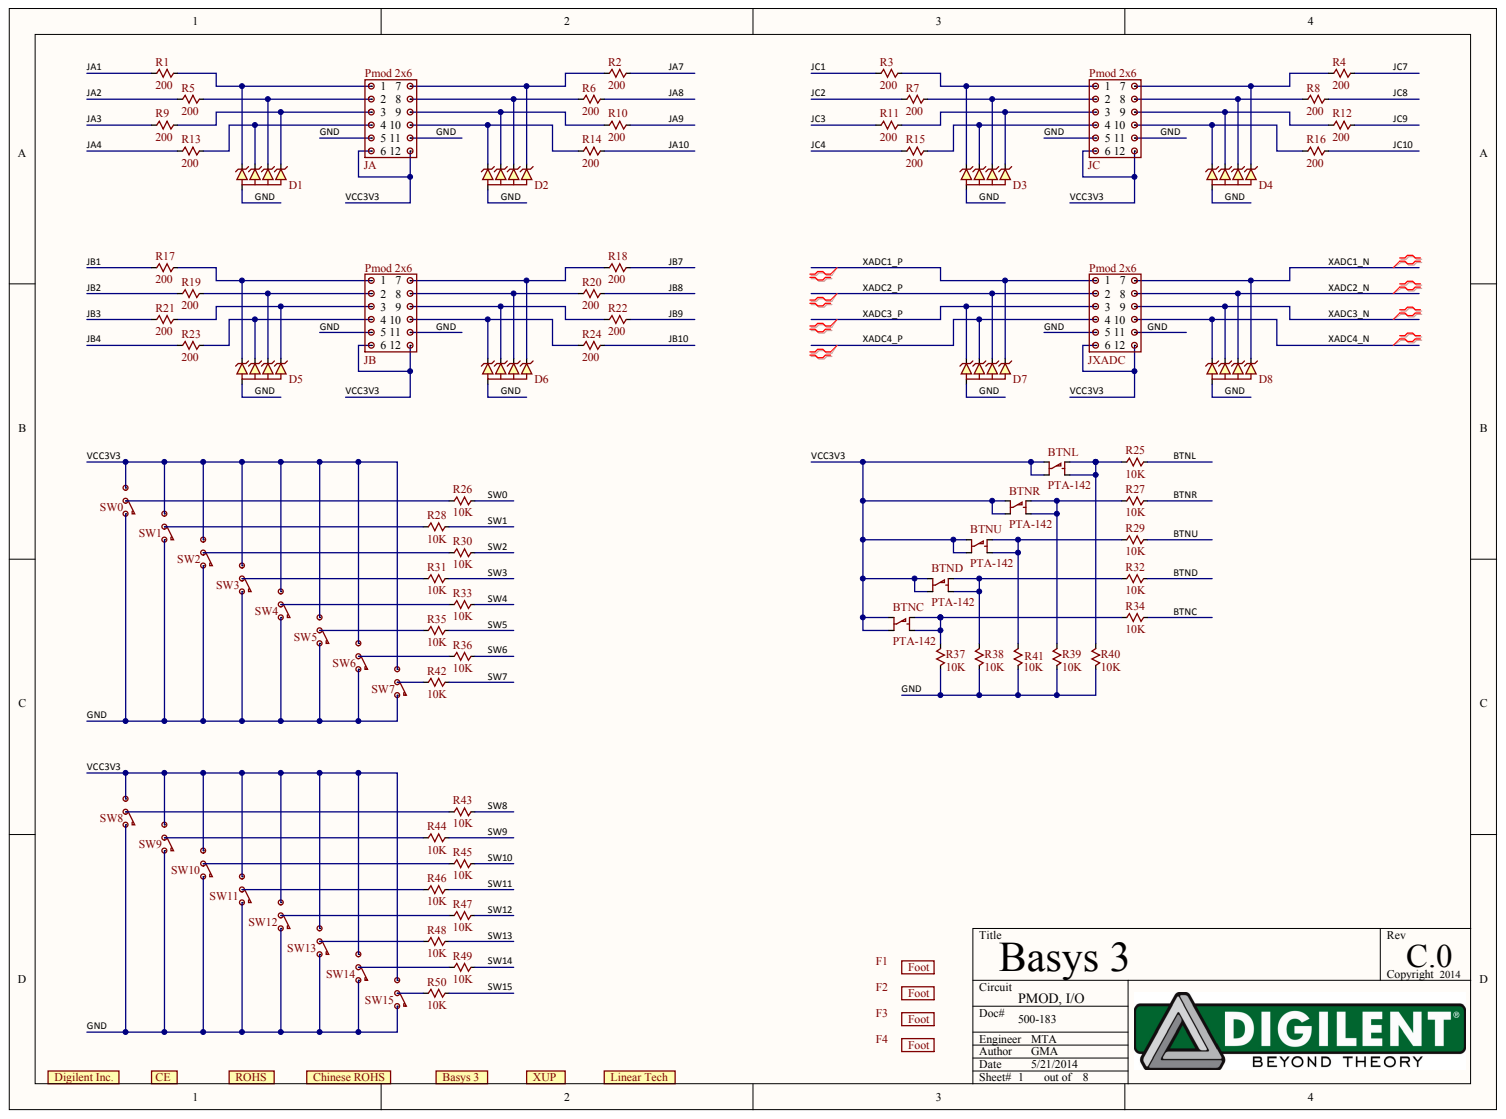
[picture p147: page 1]

Title Basys 3 | Rev C.0 Copyright 2014

Circuit PMOD, I/O

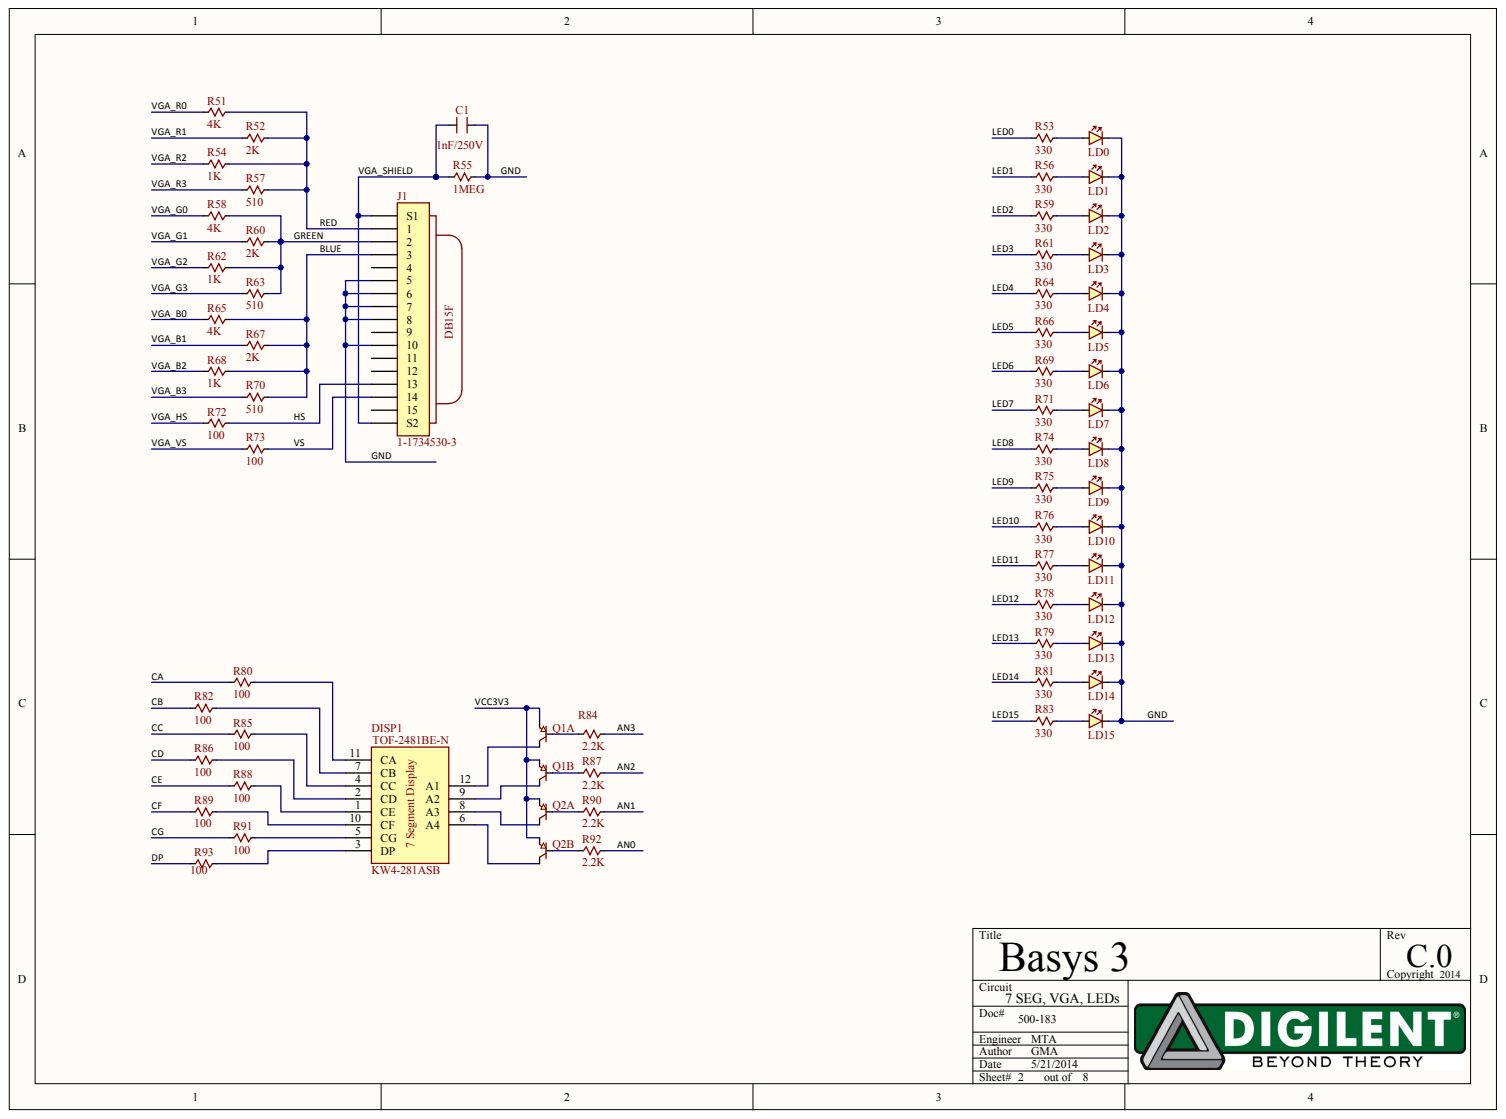
[picture p148: page 2]

Title | Rev Co p yrig h t 2014
Basys 3 Circuit 7 SEG, V G A, LED s | C.0 out of 8

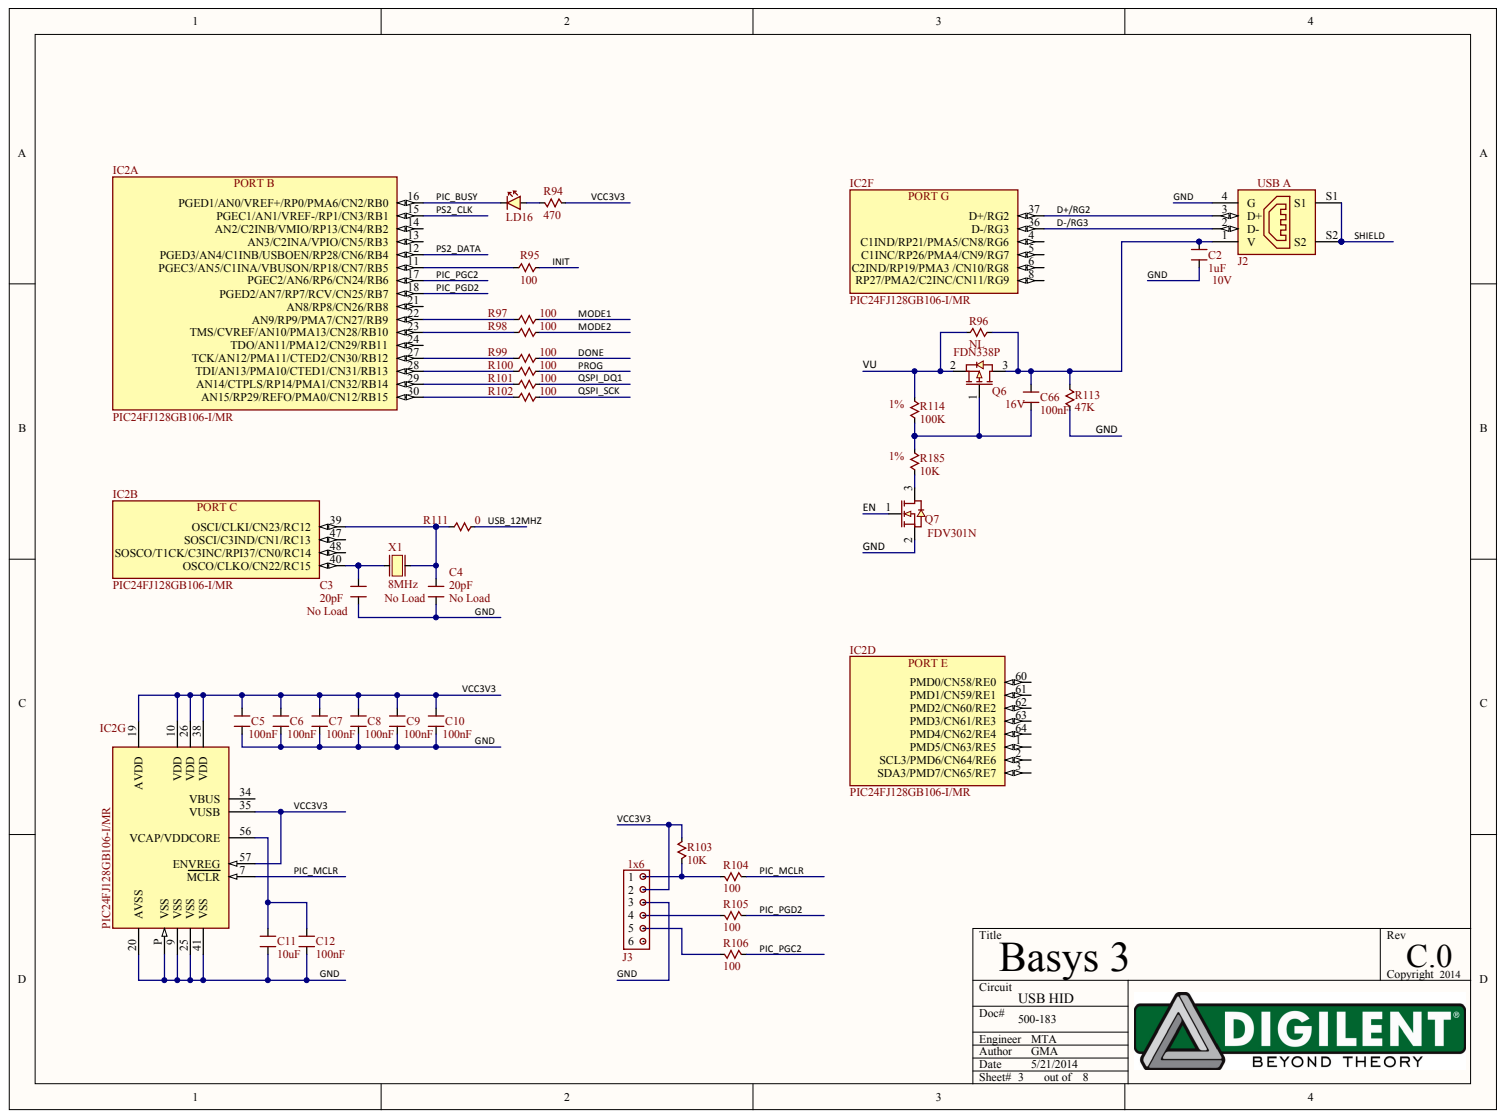
[picture p149: page 3]

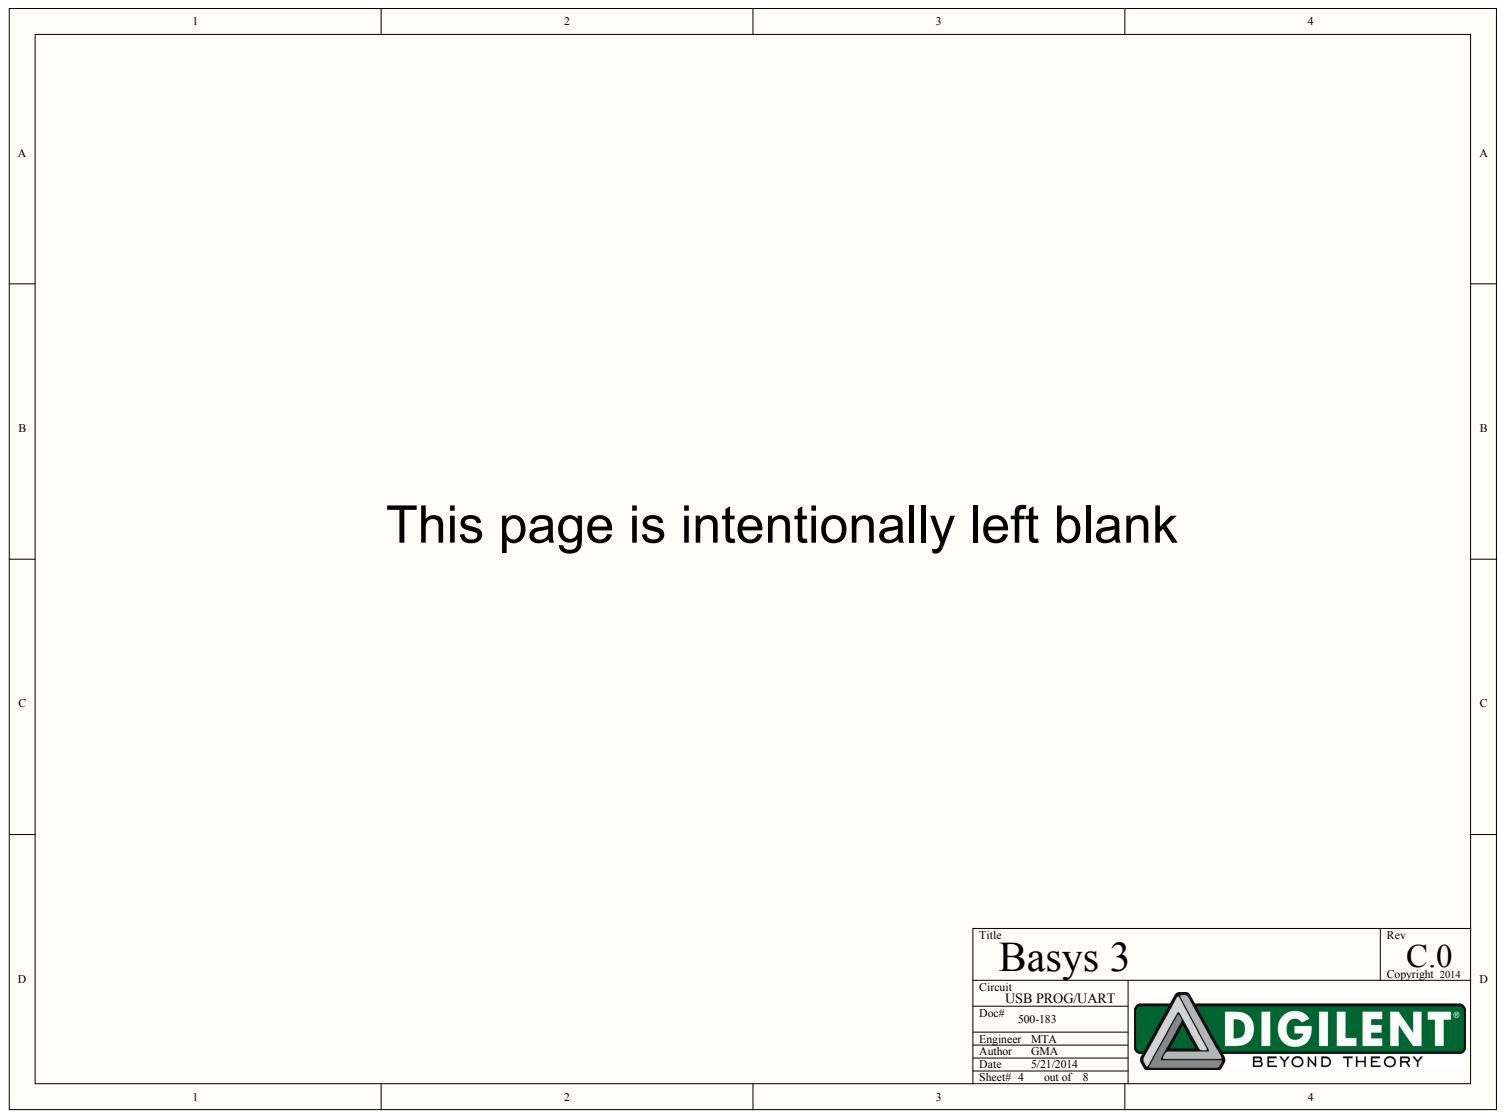
[picture p150: page 4]

This page is intentionally left blank

Title Basys 3 | Rev C.0 Copyright 2014

Circuit USB PROG/UART

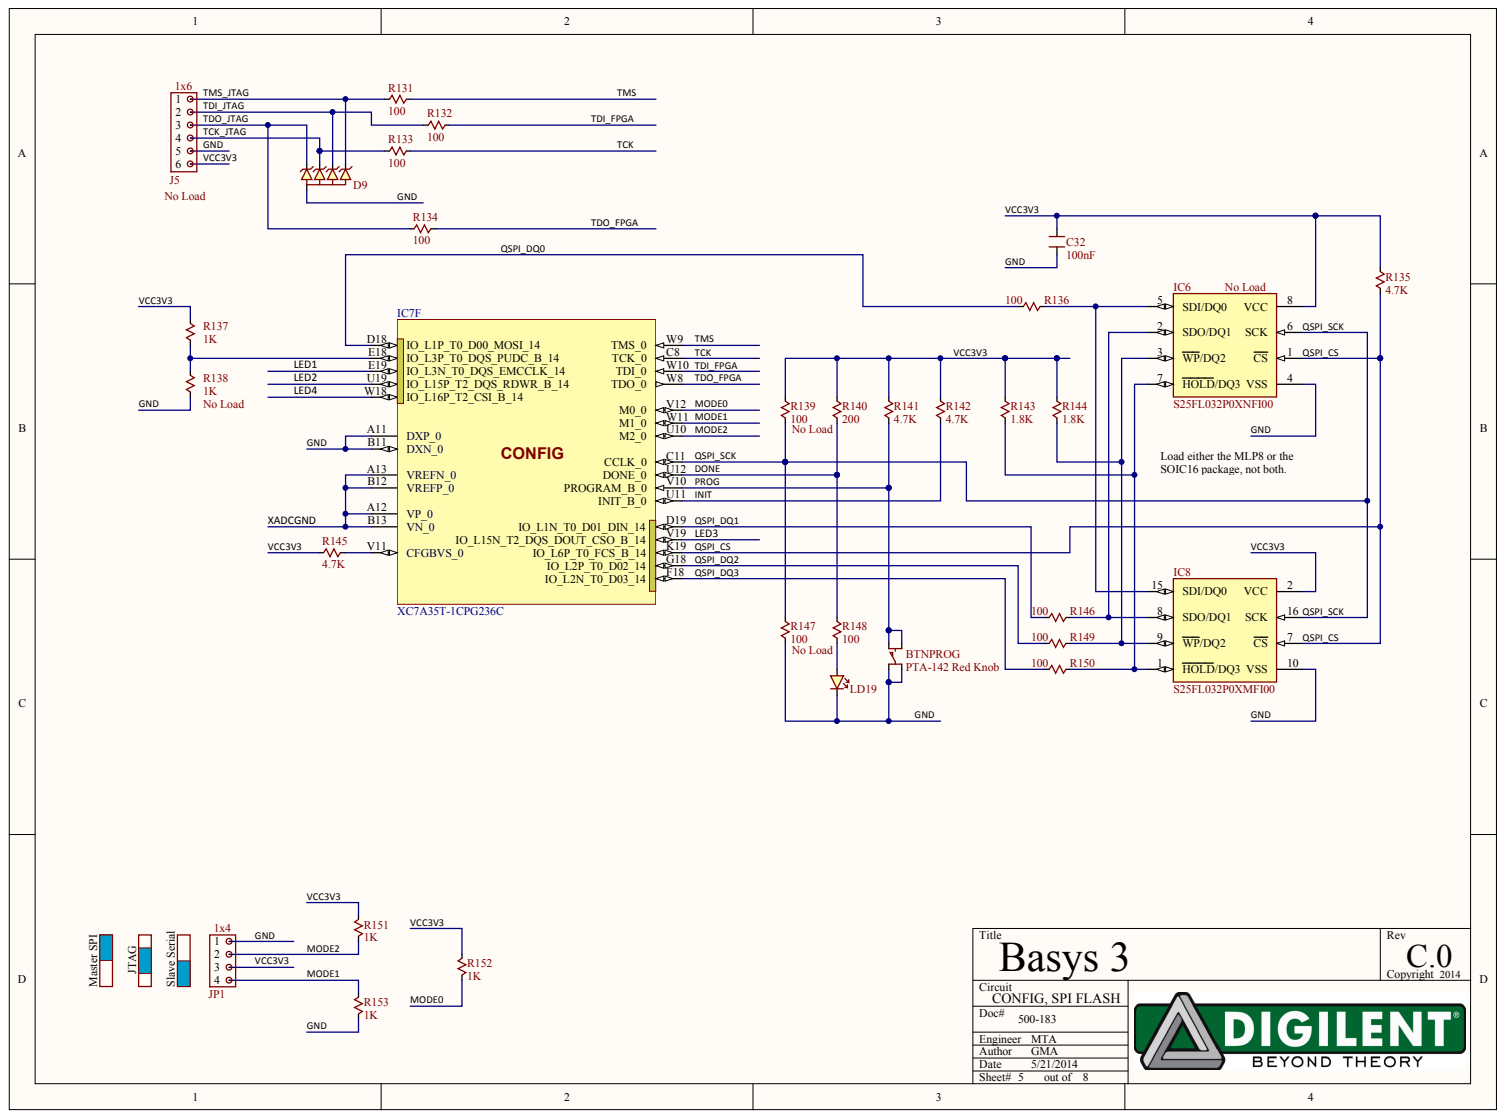
[picture p151: page 5]

TDO_JTAG
TCK_JTAG
R133 GND
VCC3V3 | | D9

Load either the MLP8 or the
SOIC16 package, not both.

VP_0 A12 | INIT

QSPI_DQ1

QSPI_DQ2 | IC8 | QSPI_SCK
QSPI_DQ3

No Load | BTNPROG

LD19 | GND

Title Basys 3 | Rev C.0 Copyright 2014

Circuit CONFIG, SPI FLASH

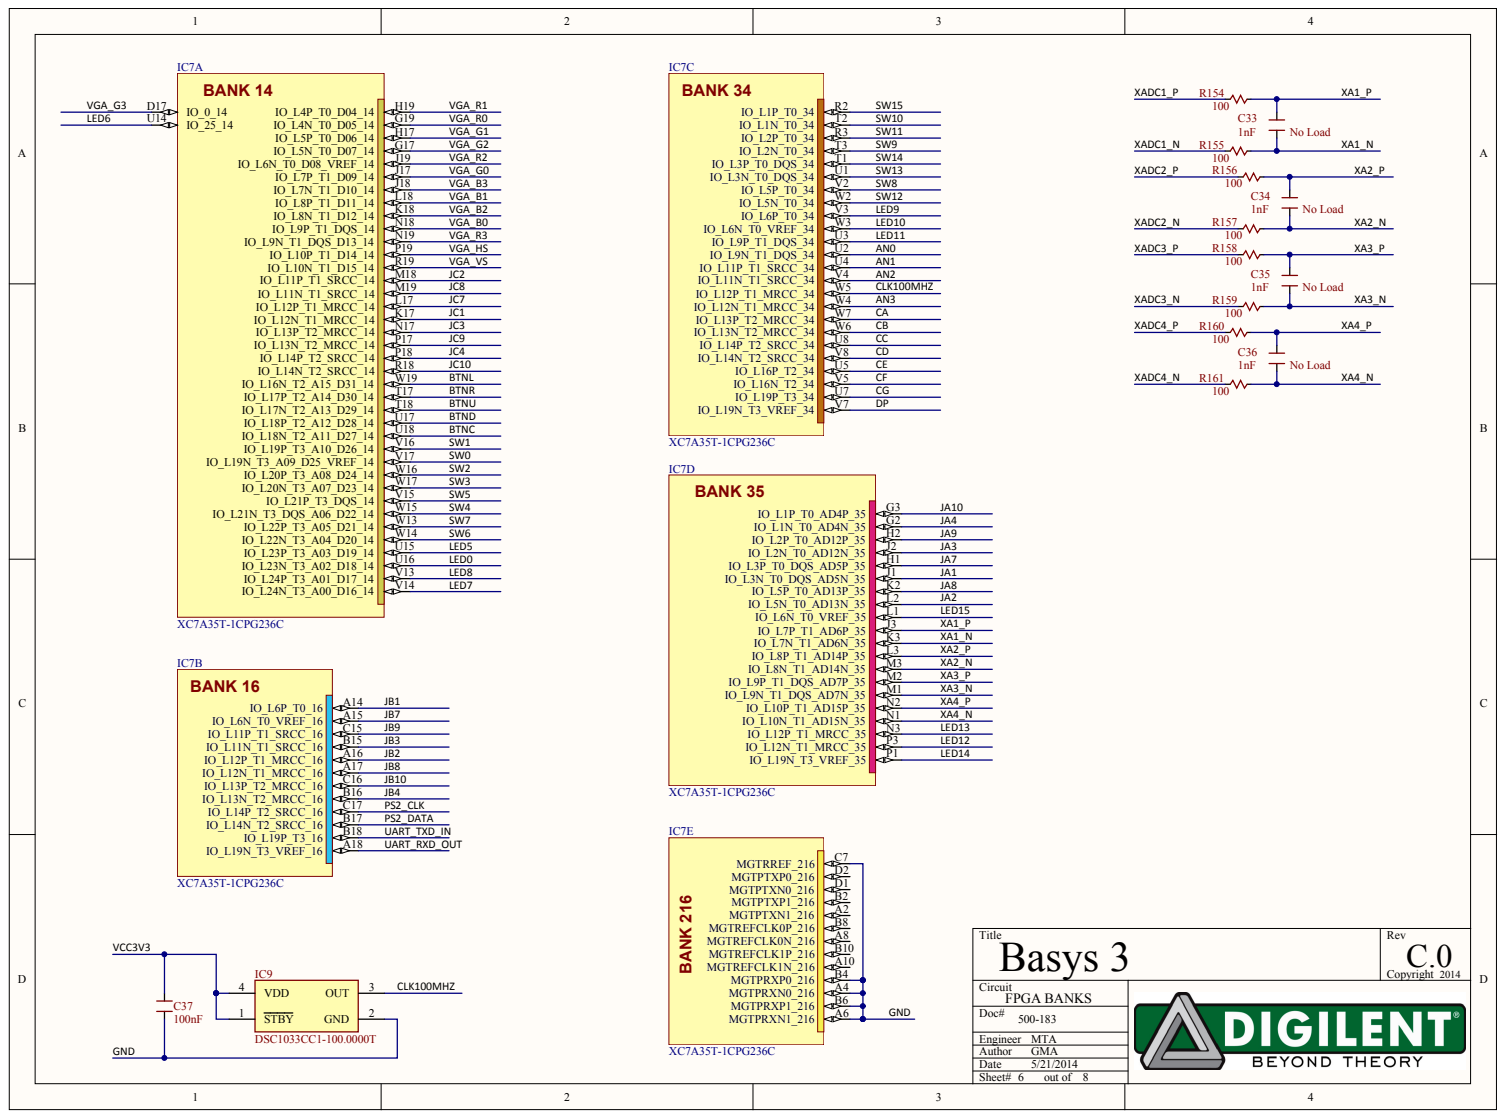
[picture p152: page 6]

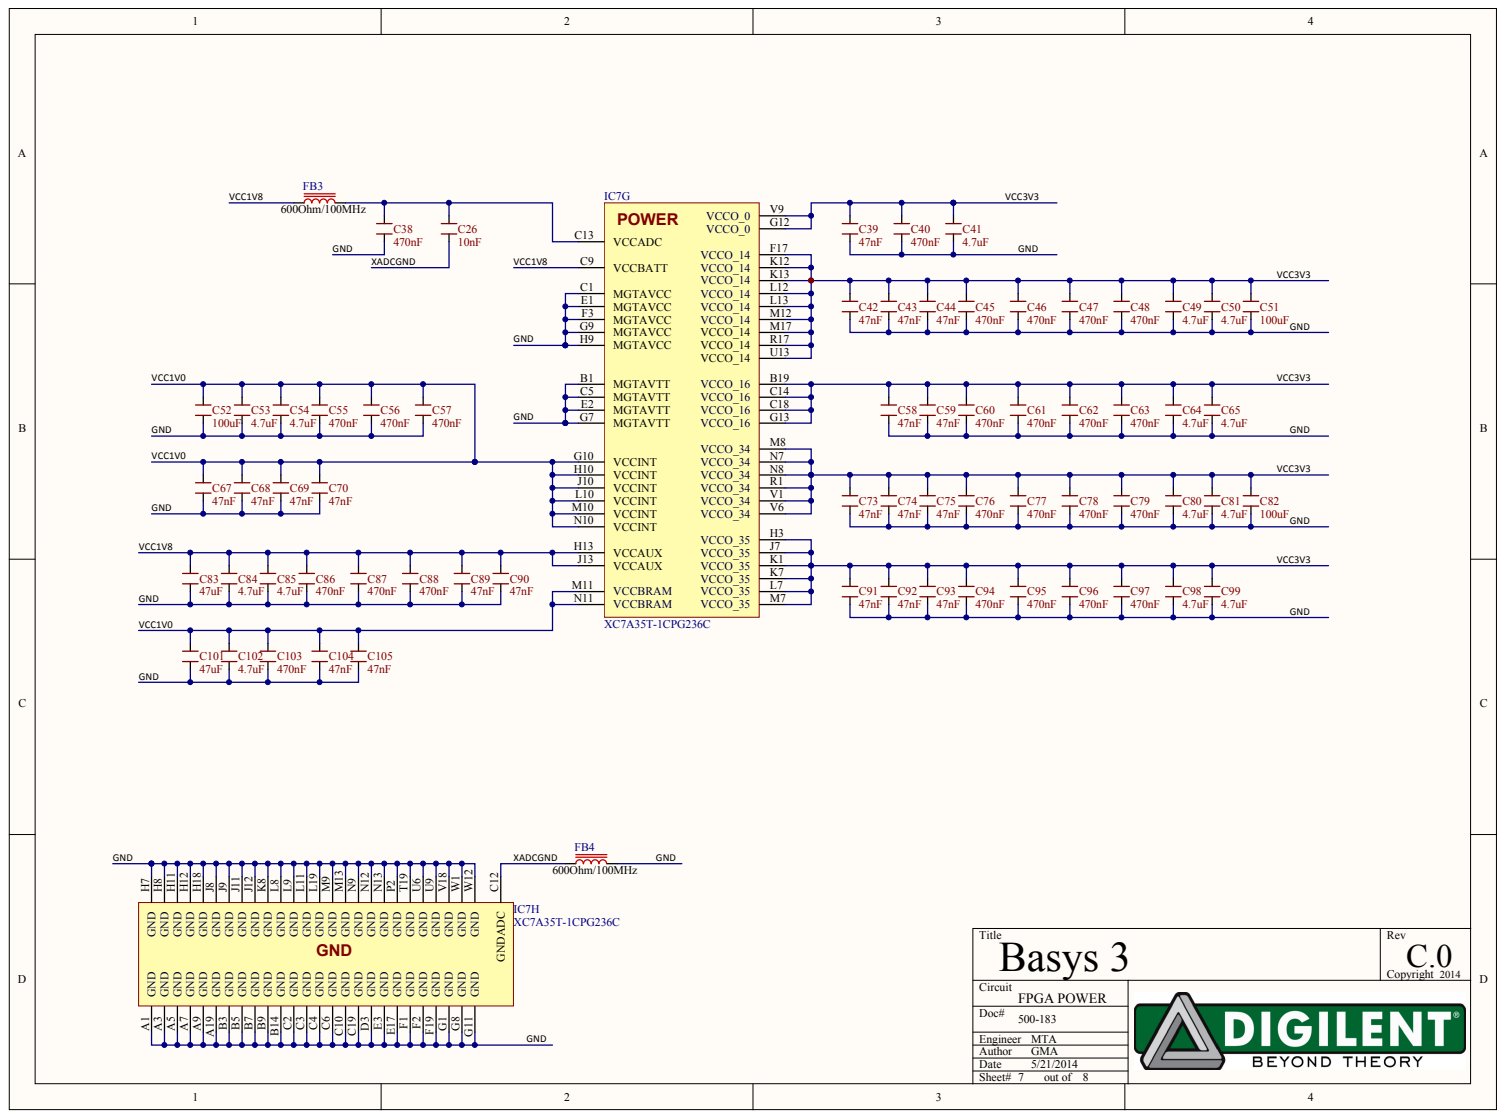
[picture p153: page 7]

MGTAVTT E2
MGTAVTT G7

VCCINT H10

VCCINT L10

VCCINT N10 | GND

GND | 4.7uF
VCC1V0 | | GND

GND W12 GND W1 GND V18 GND U9 GND U6 GND T19 GND P2 GND N13 GND N12 GND N9

GND H18 GND H12 GND H11 GND H8 GND H7

GND L19 GND L11 GND L9 GND L8

Title Basys 3 | Rev C.0 Copyright 2014

GND B14 GND B9 GND B7 GND B5

GND G11 GND G8 GND G1 GND F19 GND F2 GND F1 GND E17 GND E3 GND D3

Circuit FPGA POWER

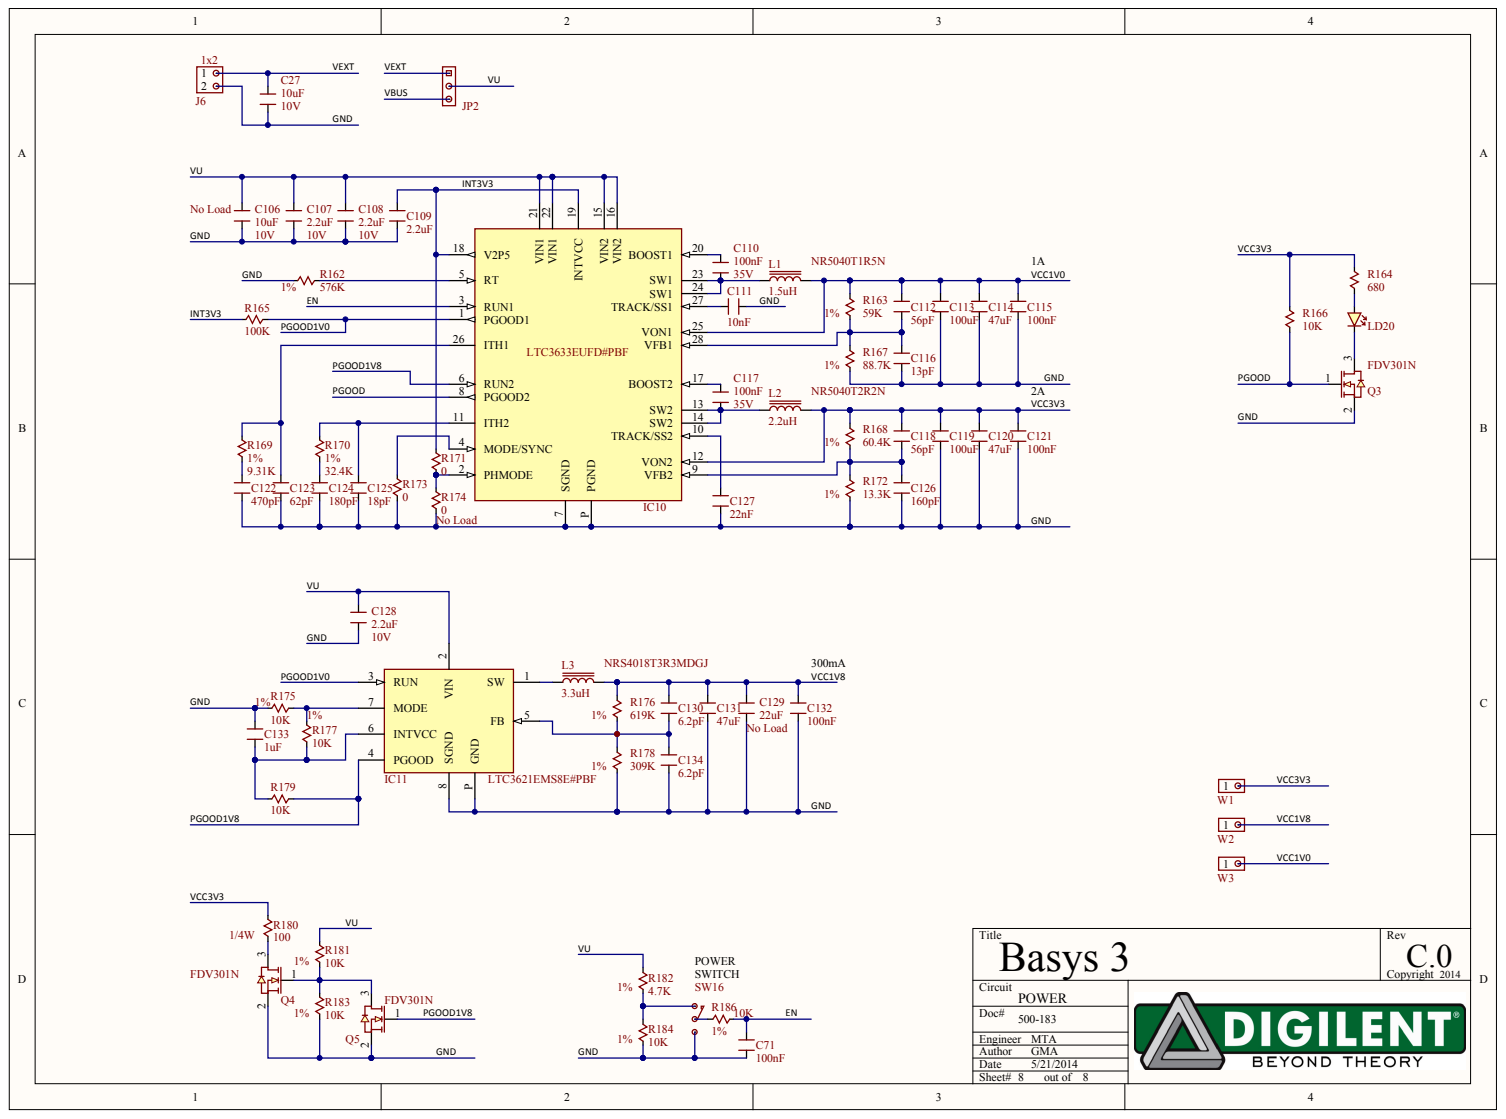
[picture p154: page 8]

PGOOD1V8 | RUN2 6

GND
