ciaa/Hardware/PCB/FSL/CIAA_K60/doc/CIAA_K60.pdf

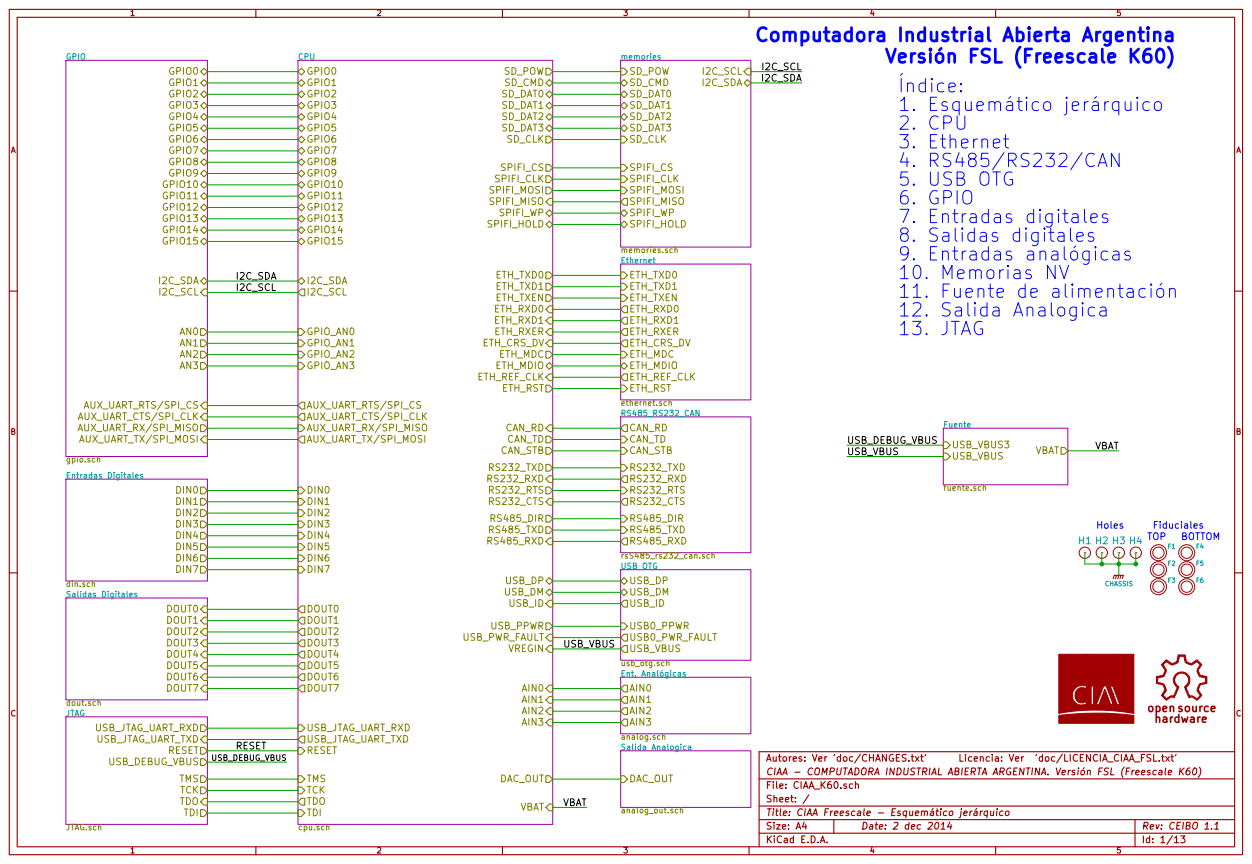
[picture p155: page 1]

Computadora Industrial Abierta Argentina

RESET

CIAA - COMPUTADORA INDUSTRIAL ABIERTA ARGENTINA. Versión FSL (Freescale K60)
File: CIAA_K60.sch
Sheet: /
Title: CIAA Freescale - Esquemático jerárquico

DAC_OUT

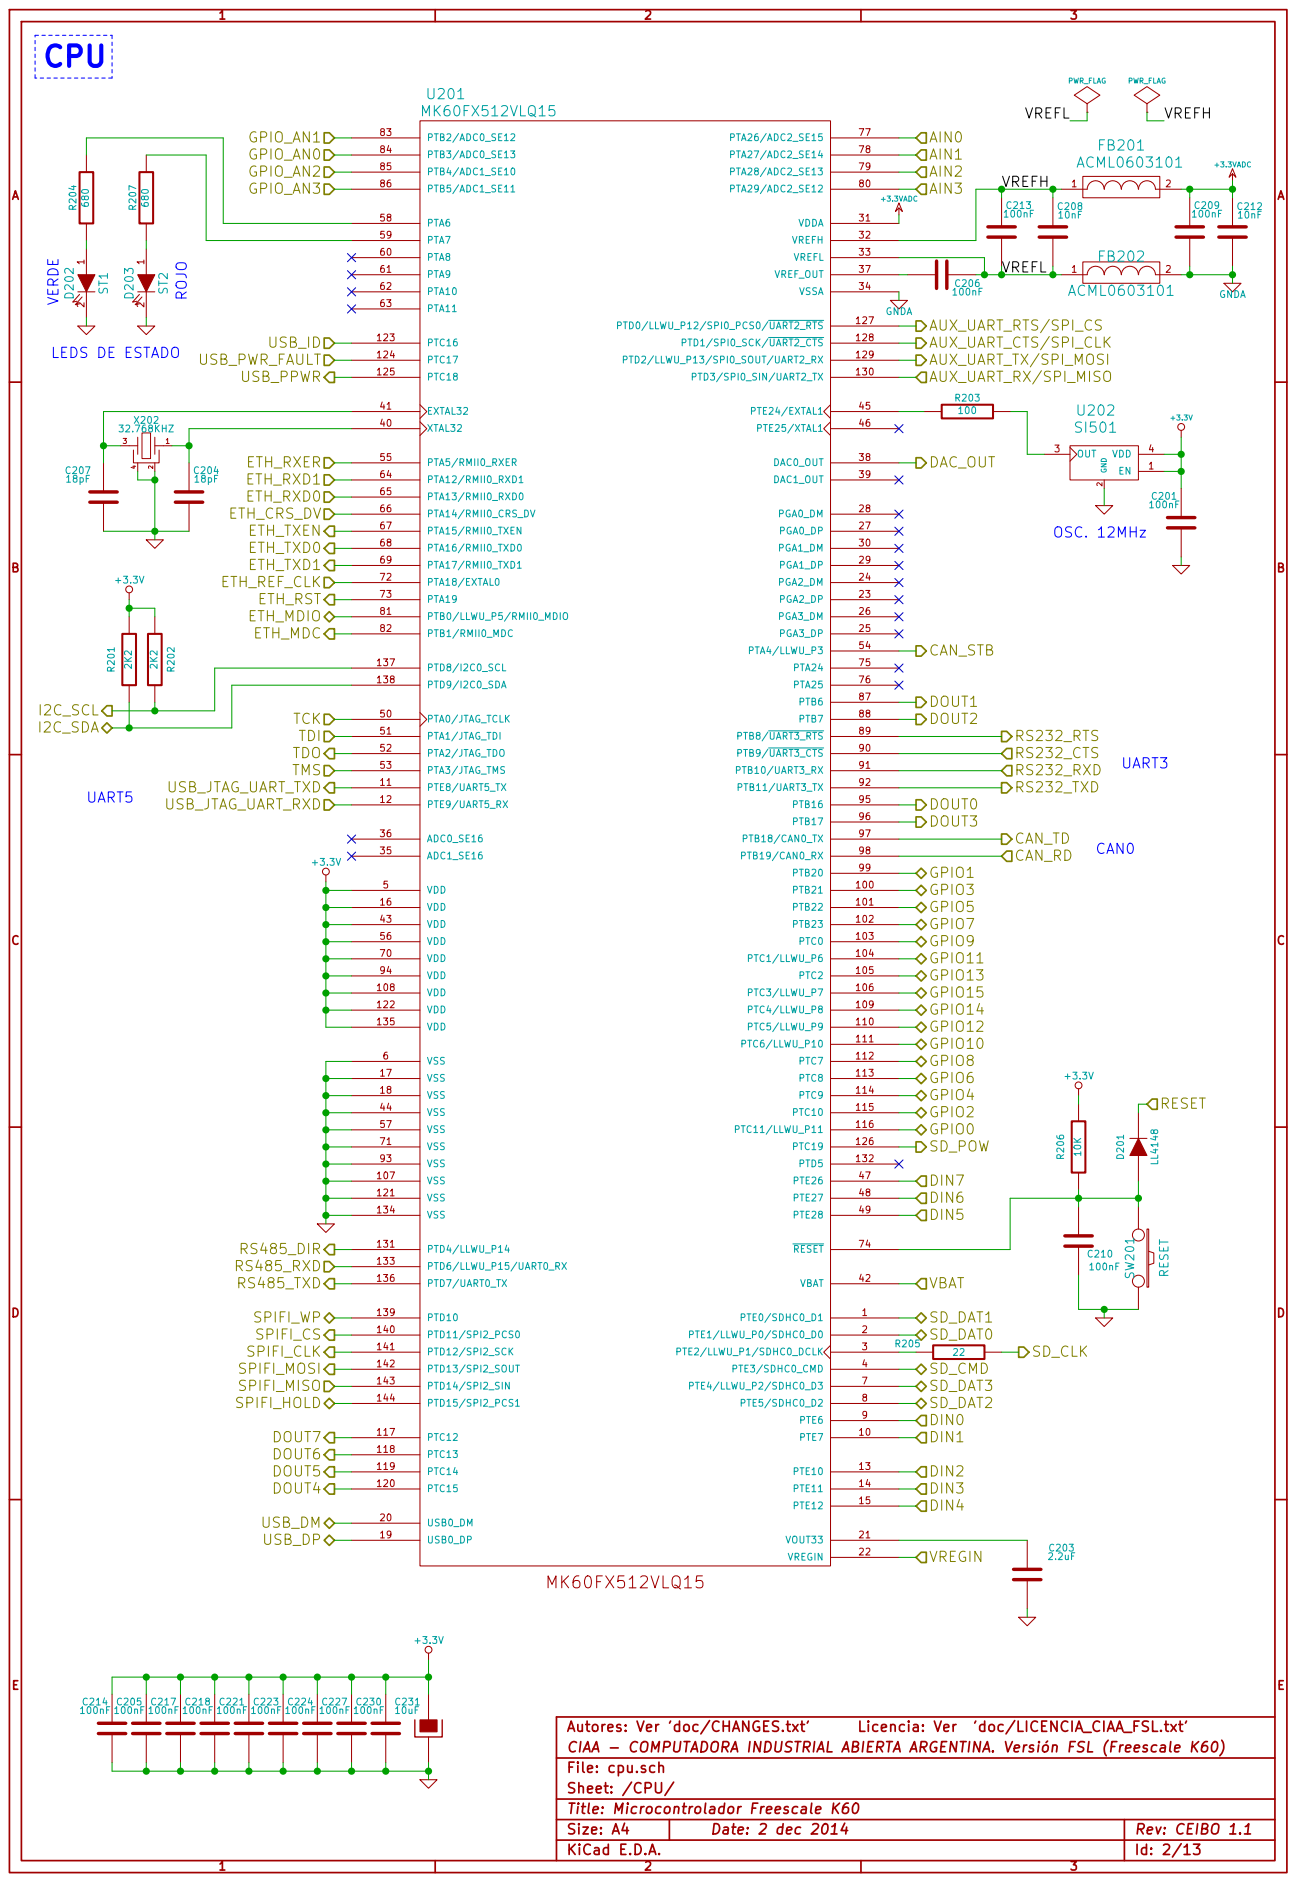
[picture p156: page 2]

CIAA - COMPUTADORA INDUSTRIAL ABIERTA ARGENTINA. Versión FSL (Freescale K60)
Id: 2/13 Title: Microcontrolador Freescale K60 File: cpu.sch
Sheet: /CPU/

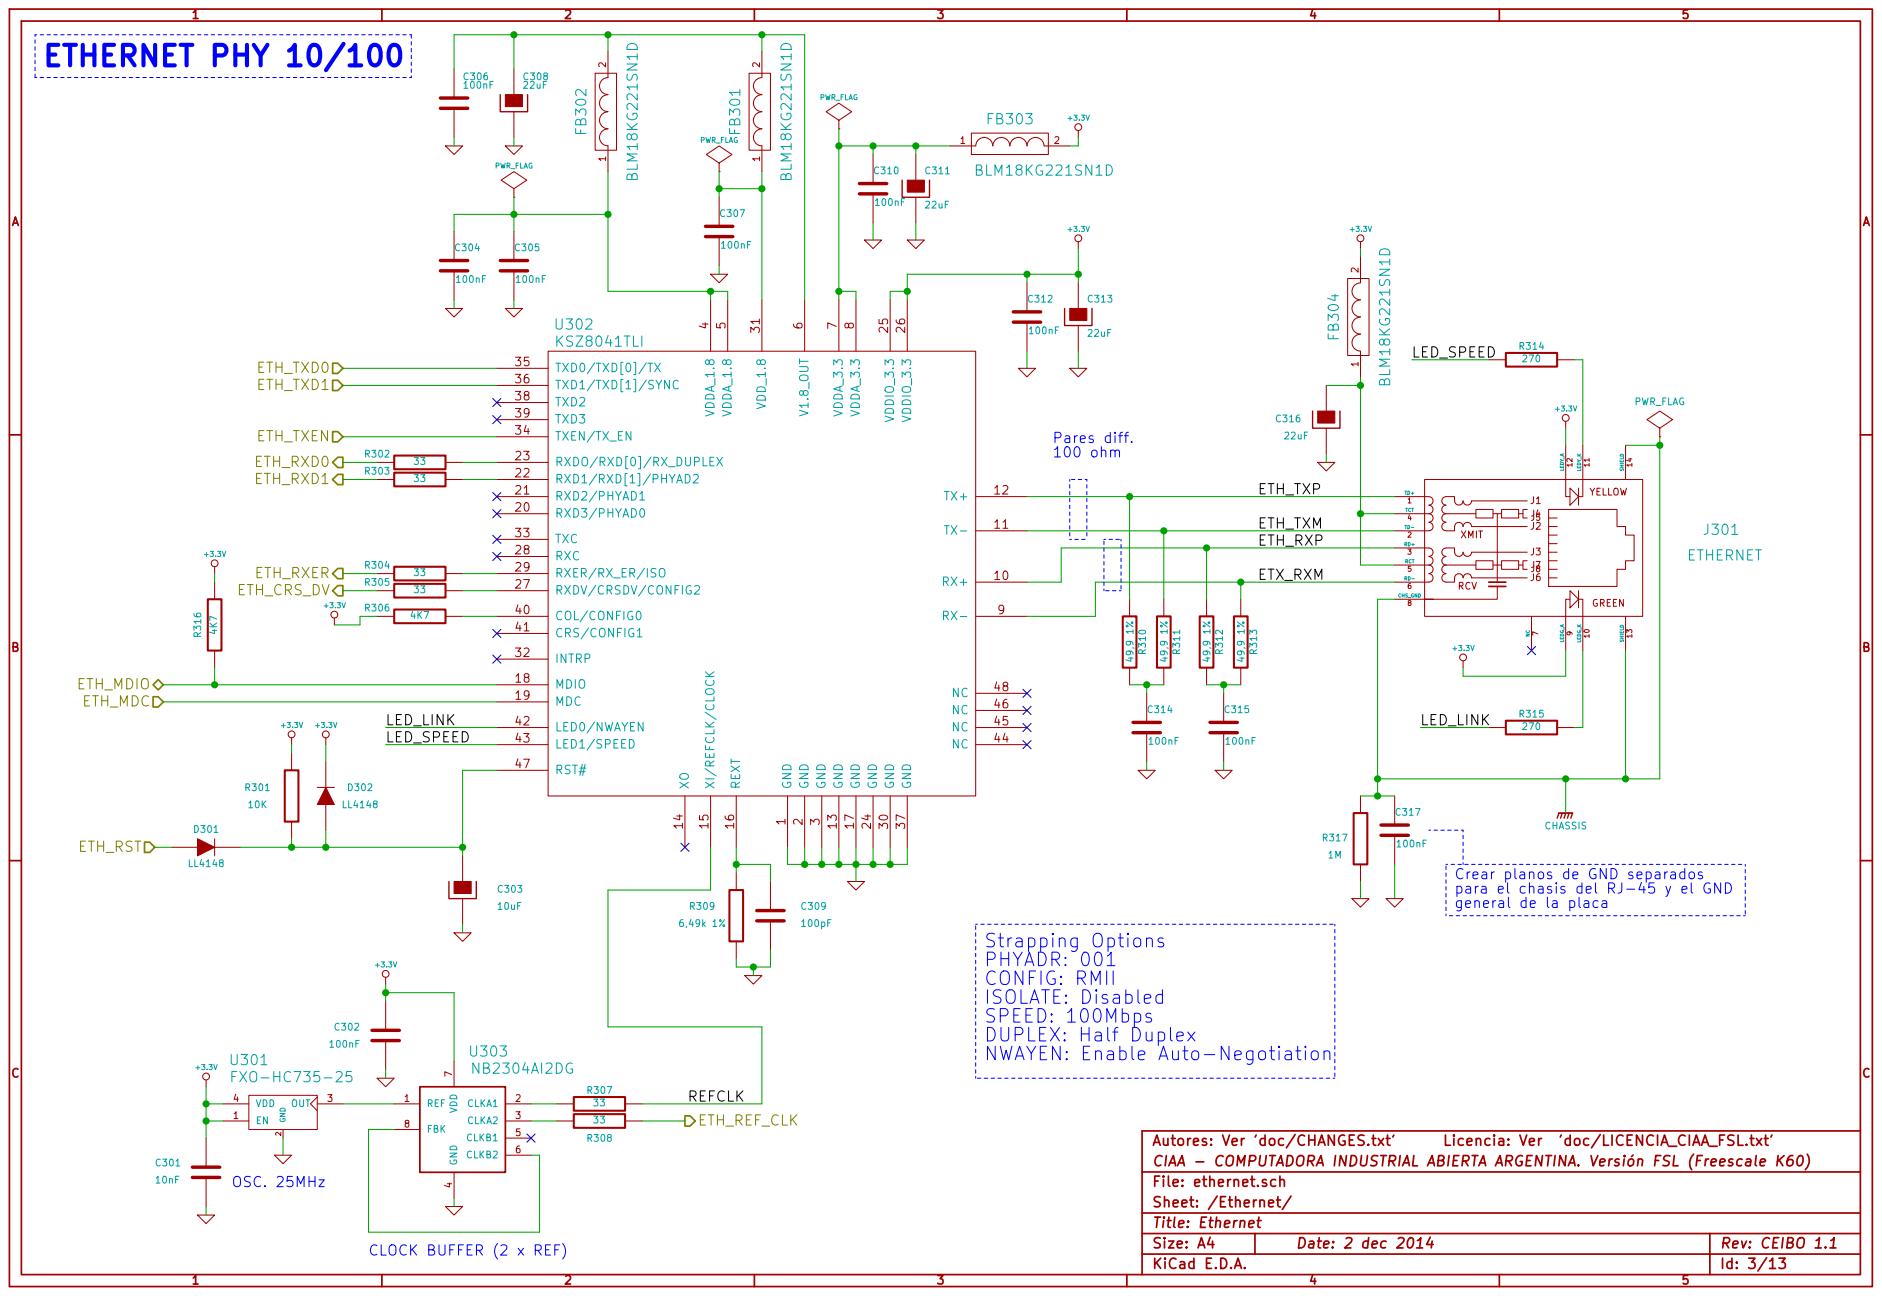
[picture p157: page 3]

8 RX- 9 RX+ 10 RXD3/PHYAD0 20 GND 30 COL/CONFIG0 40 TX- 11 RXD2/PHYAD1 21 VDD_1.8 31 CRS/CONFIG1 41 TX+ 12 RXD1/RXD[1]/PHYAD2 22

para el chasis del RJ-45 y el GND

Strapping Options
PHYADR: 001
CONFIG: RMII
ISOLATE: Disabled
SPEED: 100Mbps
DUPLEX: Half Duplex
NWAYEN: Enable Auto-Negotiation

CIAA - COMPUTADORA INDUSTRIAL ABIERTA ARGENTINA. Versión FSL (Freescale K60)
Id: 3/13 Title: Ethernet File: ethernet.sch Sheet: /Ethernet/

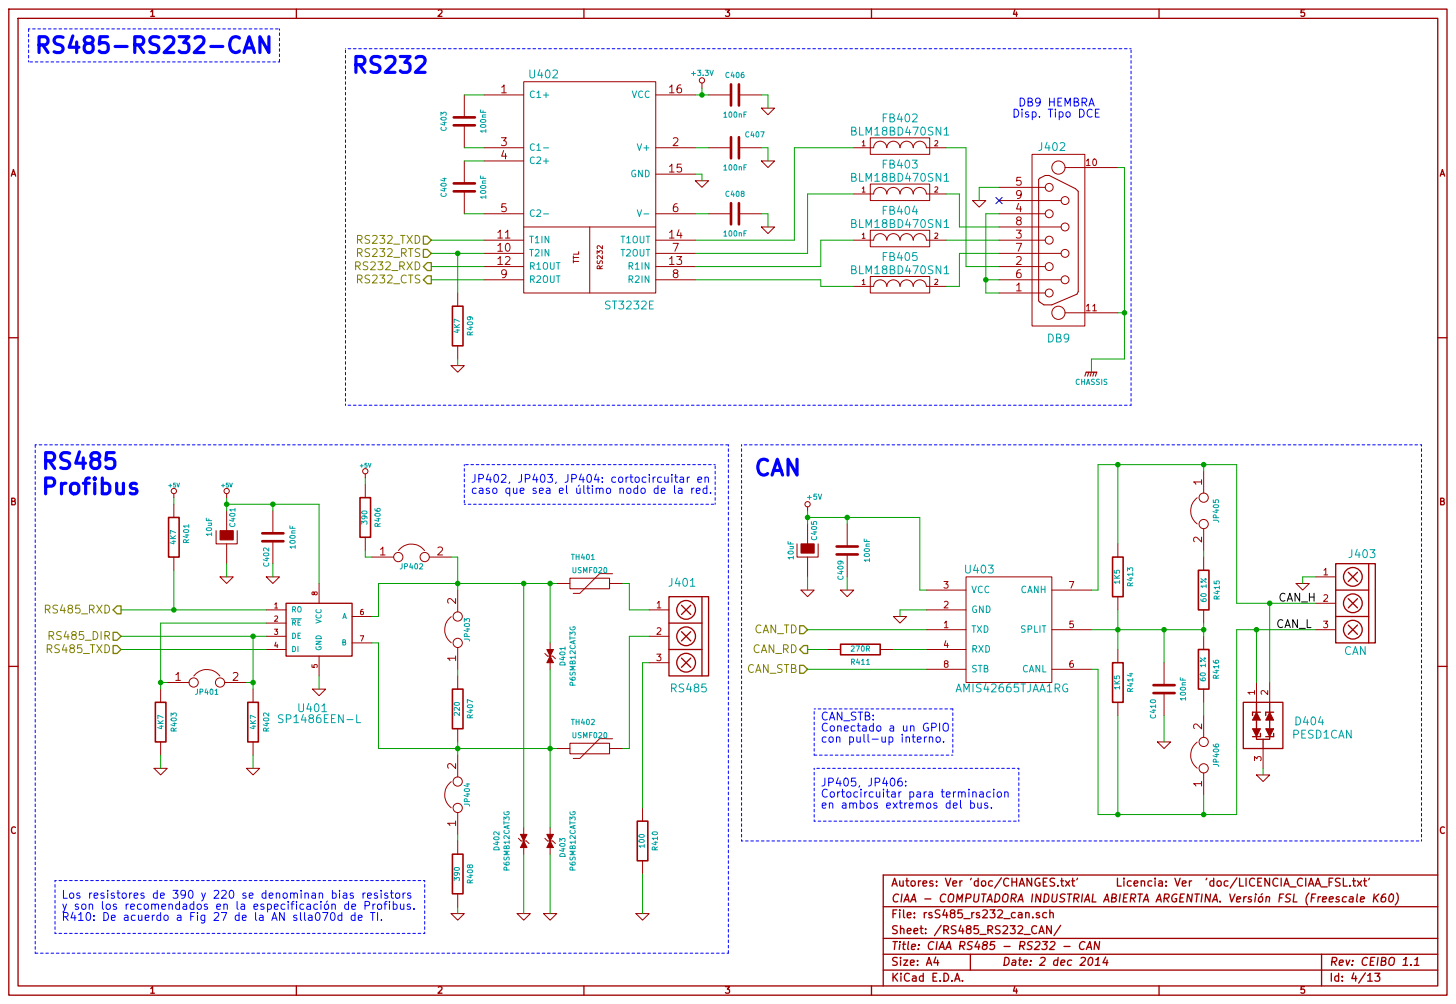
[picture p158: page 4]

DB9 HEMBRA Disp. Tipo DCE R408 390

Conectado a un GPIO
con pull-up interno.

Los resistores de 390 y 220 se denominan bias resistors
y son los recomendados en la especificación de Profibus.
R410: De acuerdo a Fig 27 de la AN slla070d de TI.

CIAA - COMPUTADORA INDUSTRIAL ABIERTA ARGENTINA. Versión FSL (Freescale K60)
File: rsS485_rs232_can.sch
Sheet: /RS485_RS232_CAN/
Title: CIAA RS485 - RS232 - CAN

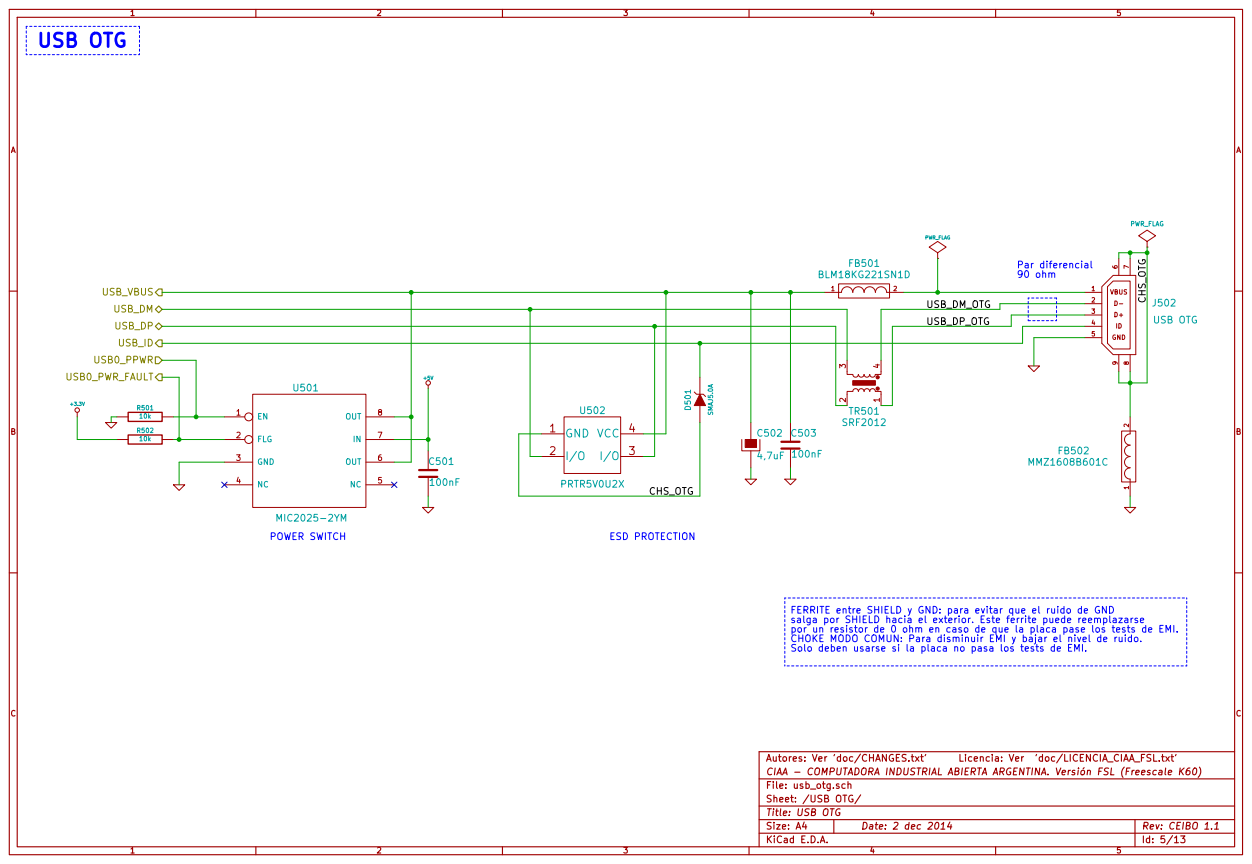
[picture p159: page 5]

FERRITE entre SHIELD y GND: para evitar que el ruido de GND
salga por SHIELD hacia el exterior. Este ferrite puede reemplazarse
por un resistor de 0 ohm en caso de que la placa pase los tests de EMI.
CHOKE MODO COMUN: Para disminuir EMI y bajar el nivel de ruido.
Solo deben usarse si la placa no pasa los tests de EMI.

CIAA - COMPUTADORA INDUSTRIAL ABIERTA ARGENTINA. Versión FSL (Freescale K60)
File: usb_otg.sch
Sheet: /USB OTG/
Title: USB OTG

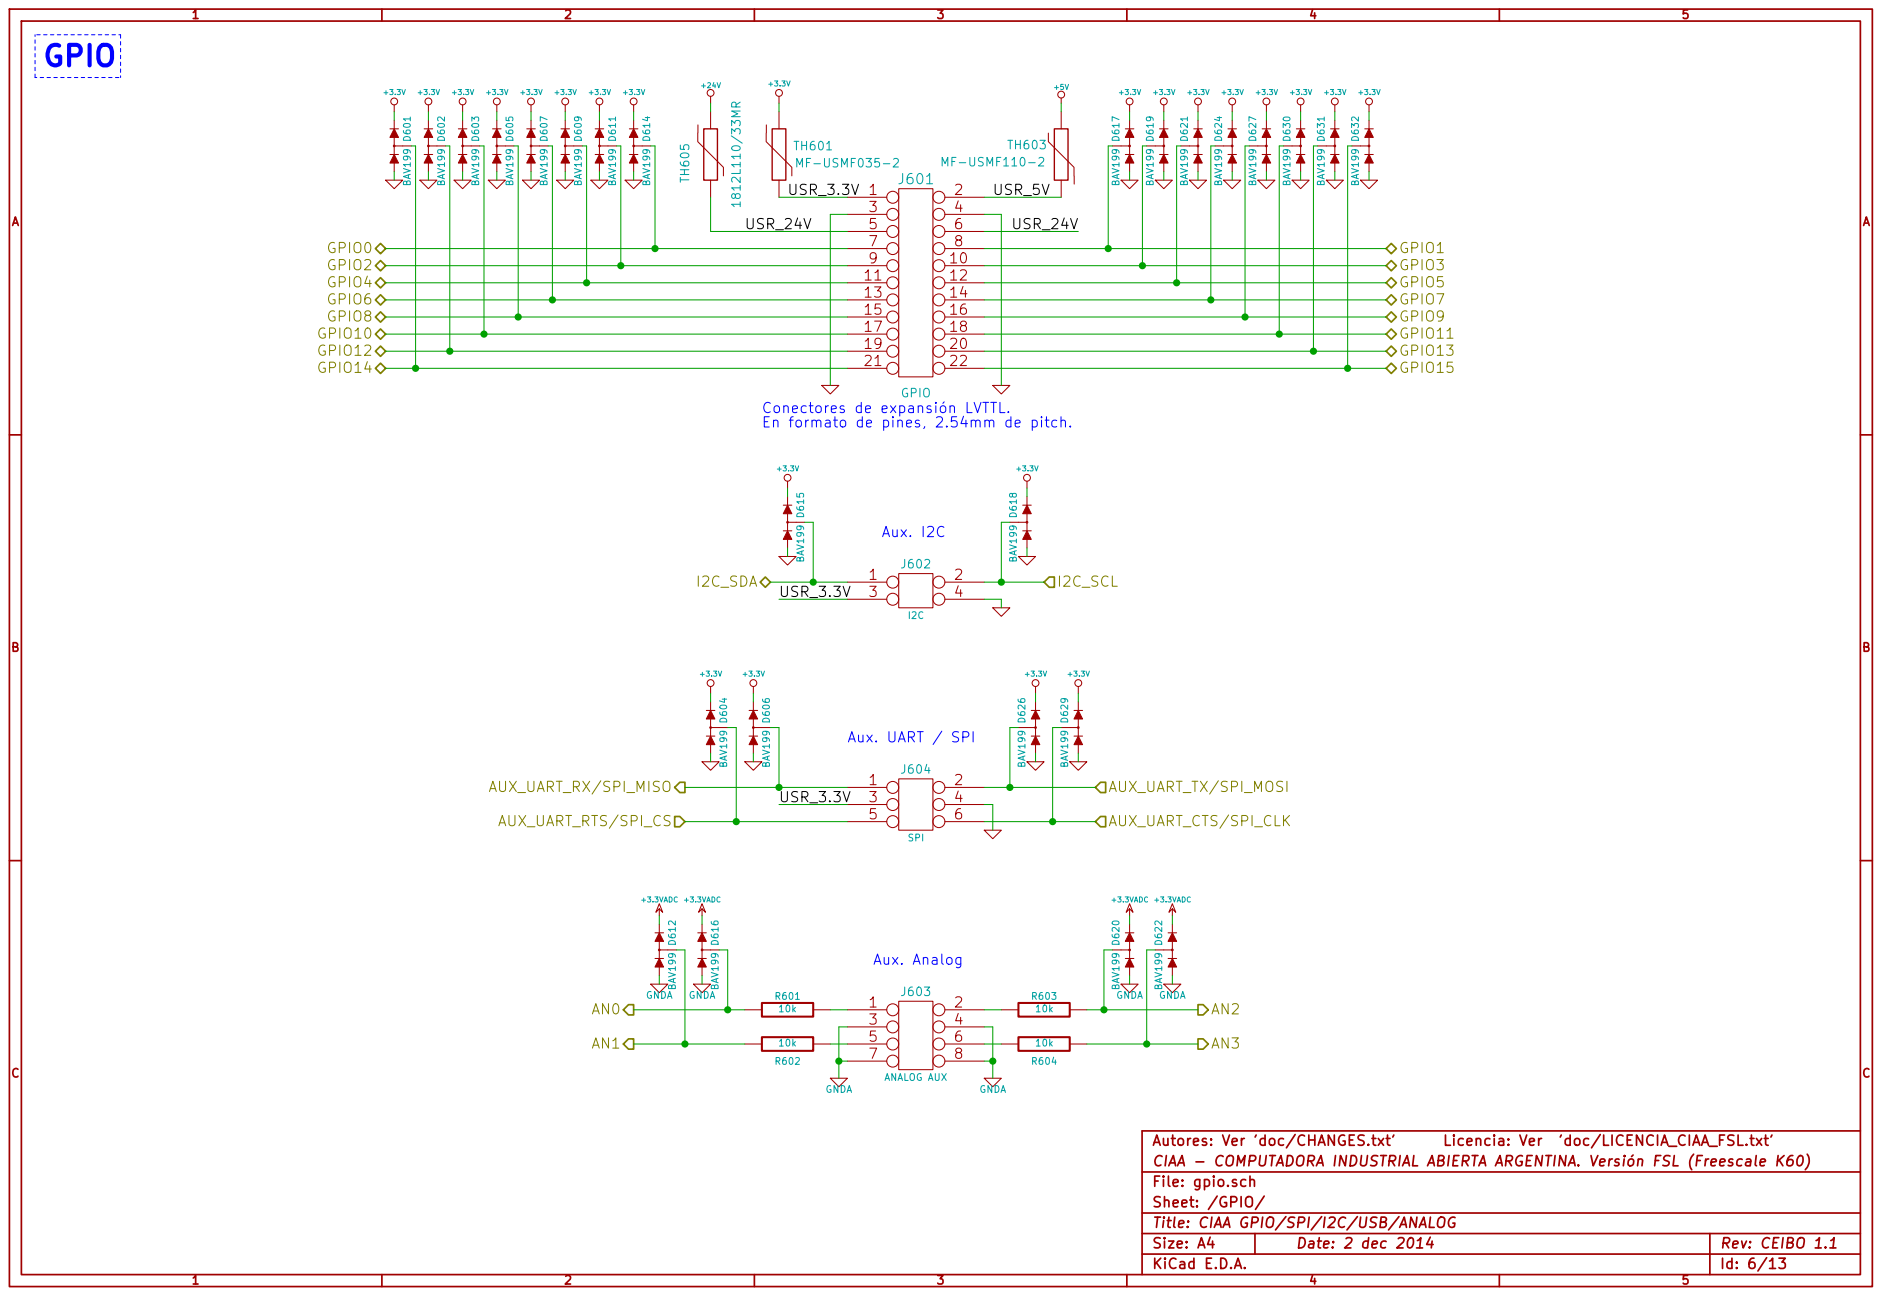
[picture p160: page 6]

+24V GPIO
J601 GPIO
ANALOG AUX Conectores de expansión LVTTL.
En formato de pines, 2.54mm de pitch.

CIAA - COMPUTADORA INDUSTRIAL ABIERTA ARGENTINA. Versión FSL (Freescale K60)
File: gpio.sch
Sheet: /GPIO/
Title: CIAA GPIO/SPI/I2C/USB/ANALOG

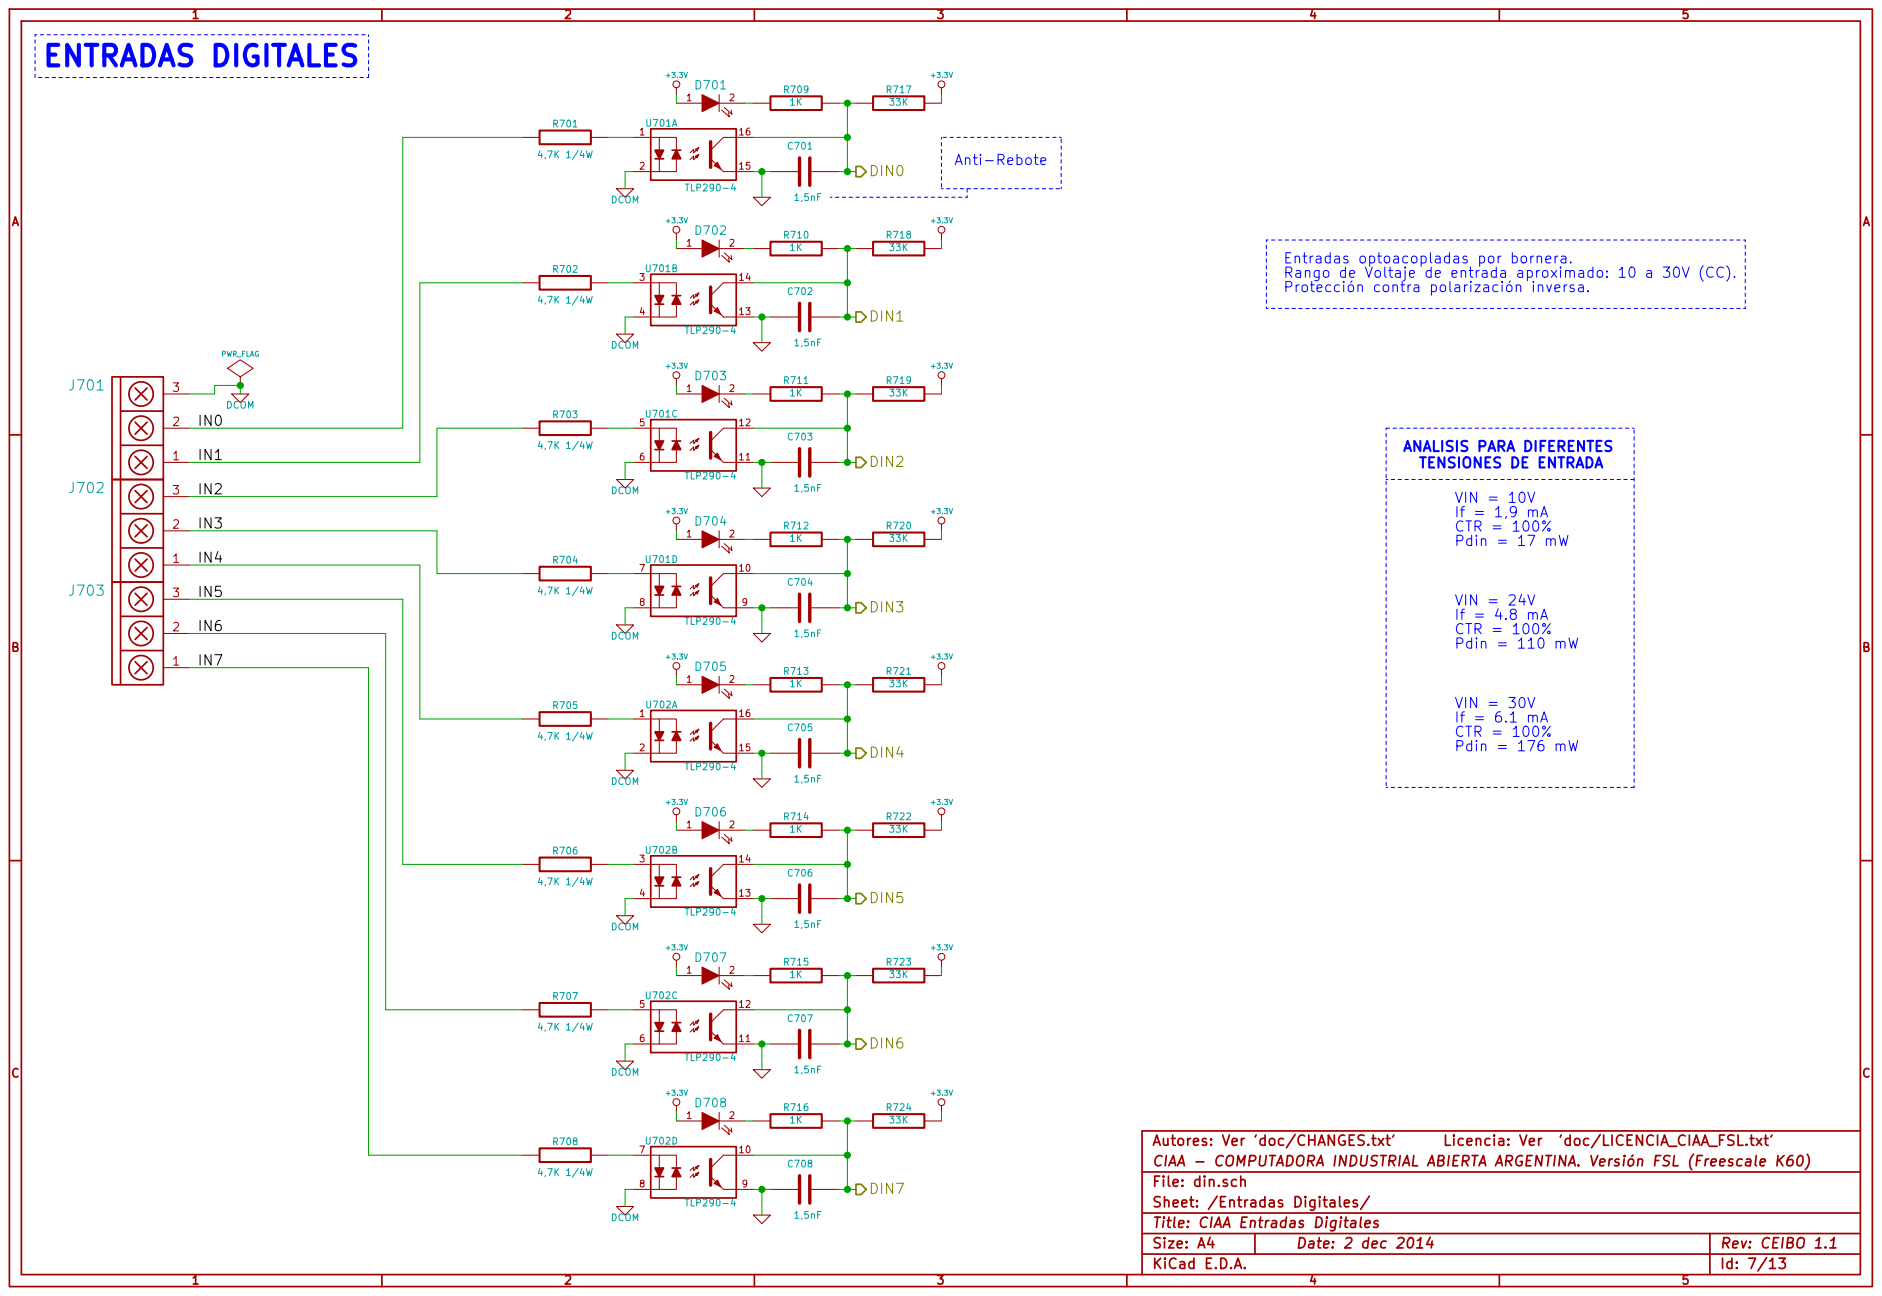
[picture p161: page 7]

Pdin = 176 mW ENTRADAS DIGITALES

Rango de Voltaje de entrada aproximado: 10 a 30V (CC).

CIAA - COMPUTADORA INDUSTRIAL ABIERTA ARGENTINA. Versión FSL (Freescale K60)
Title: CIAA Entradas Digitales File: din.sch Sheet: /Entradas Digitales/

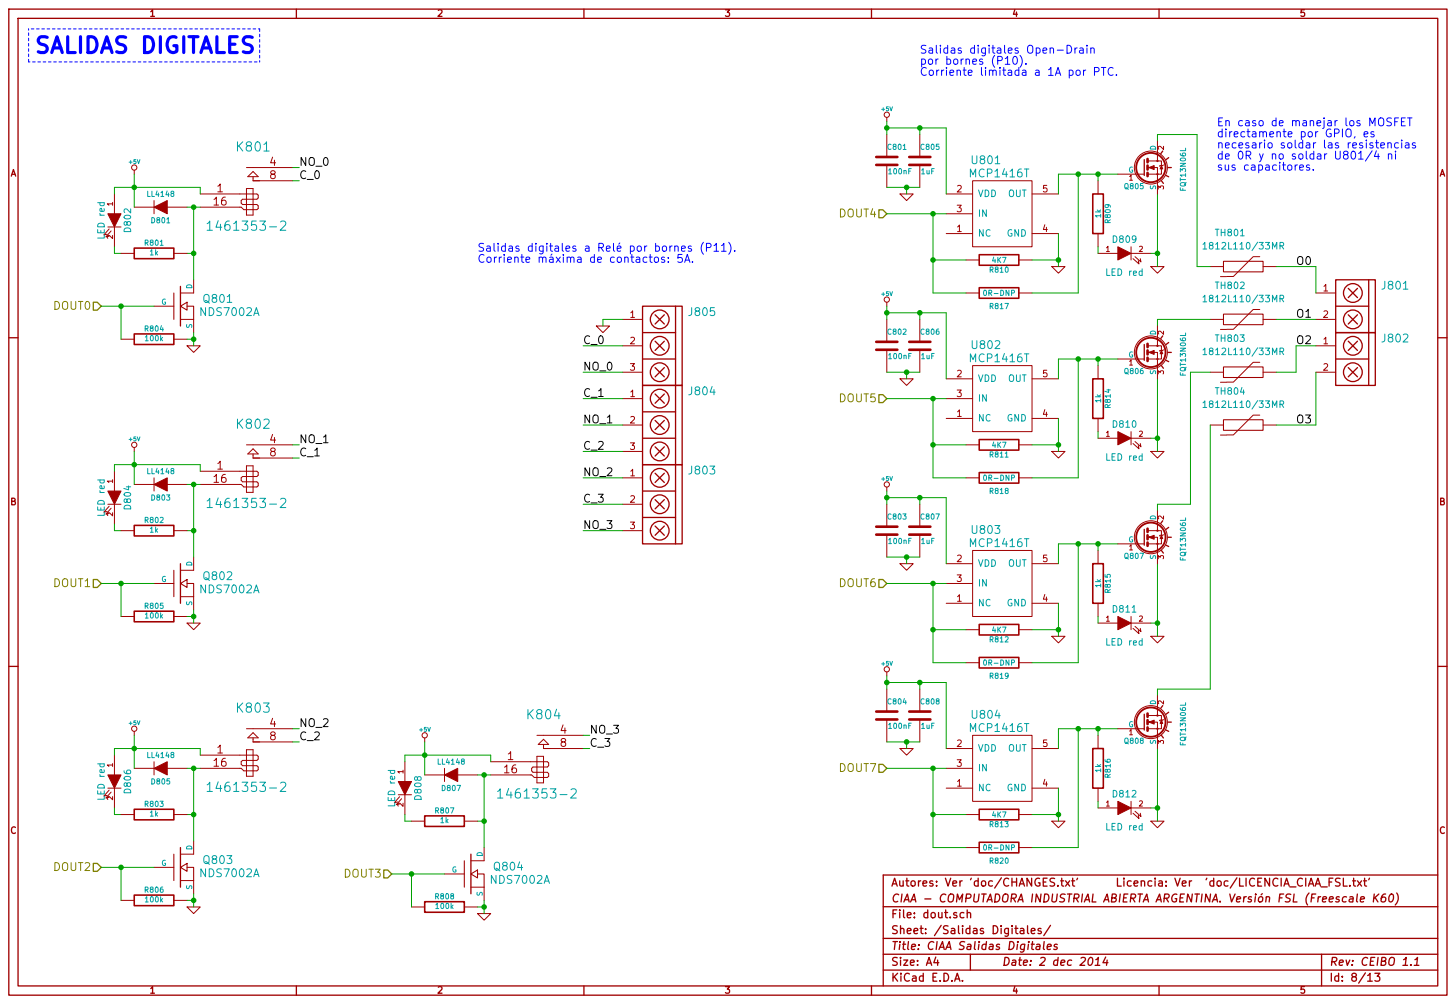
[picture p162: page 8]

Corriente limitada a 1A por PTC. 1

En caso de manejar los MOSFET
directamente por GPIO, es necesario soldar las resistencias de 0R y no soldar U801/4 ni

Salidas digitales a Relé por bornes (P11).

CIAA - COMPUTADORA INDUSTRIAL ABIERTA ARGENTINA. Versión FSL (Freescale K60)
Title: CIAA Salidas Digitales File: dout.sch Sheet: /Salidas Digitales/

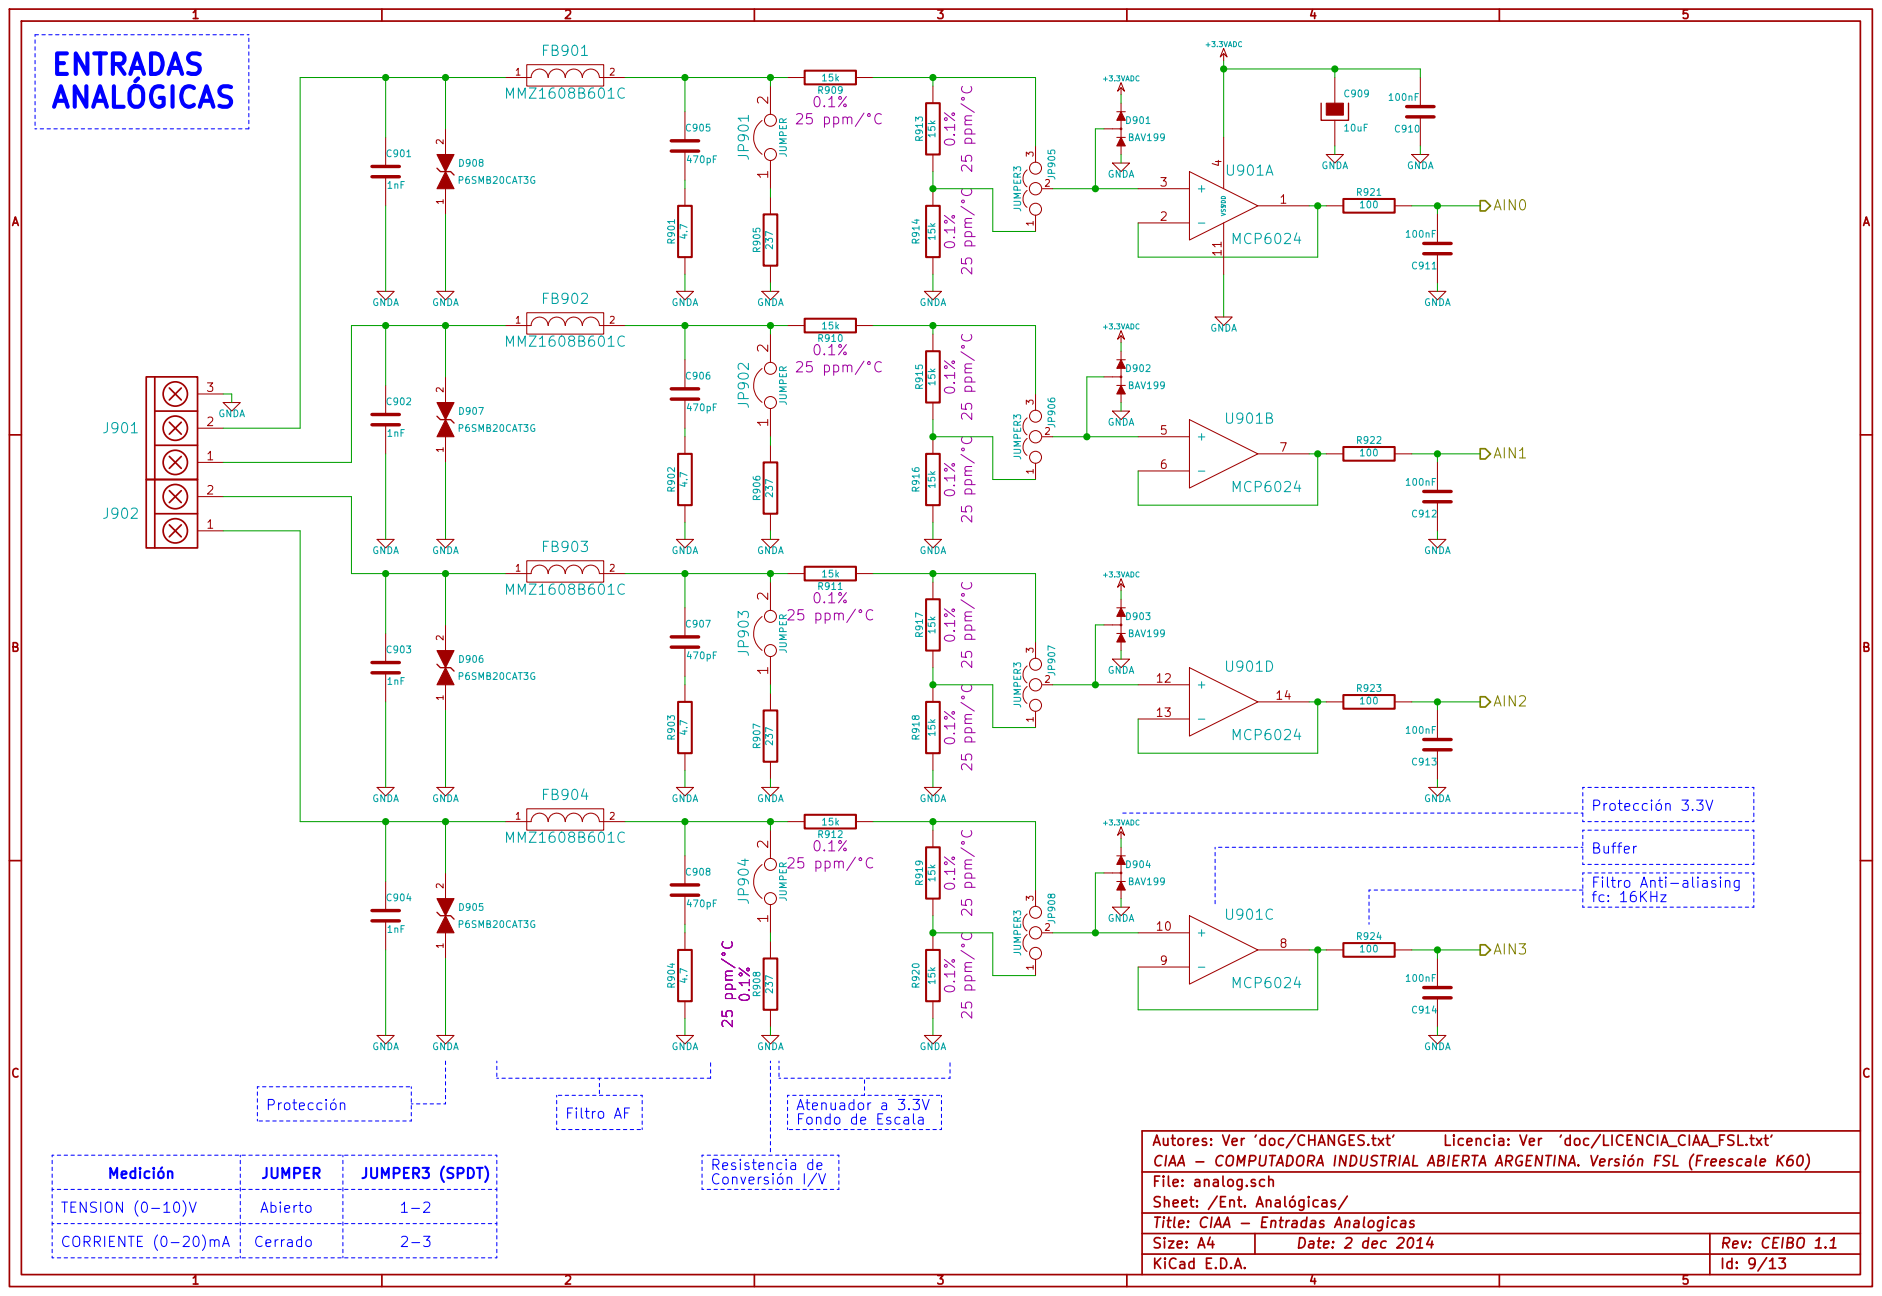
[picture p163: page 9]

Buffer Filtro Anti-aliasing

CIAA - COMPUTADORA INDUSTRIAL ABIERTA ARGENTINA. Versión FSL (Freescale K60)
File: analog.sch
Sheet: /Ent. Analógicas/
Title: CIAA - Entradas Analogicas

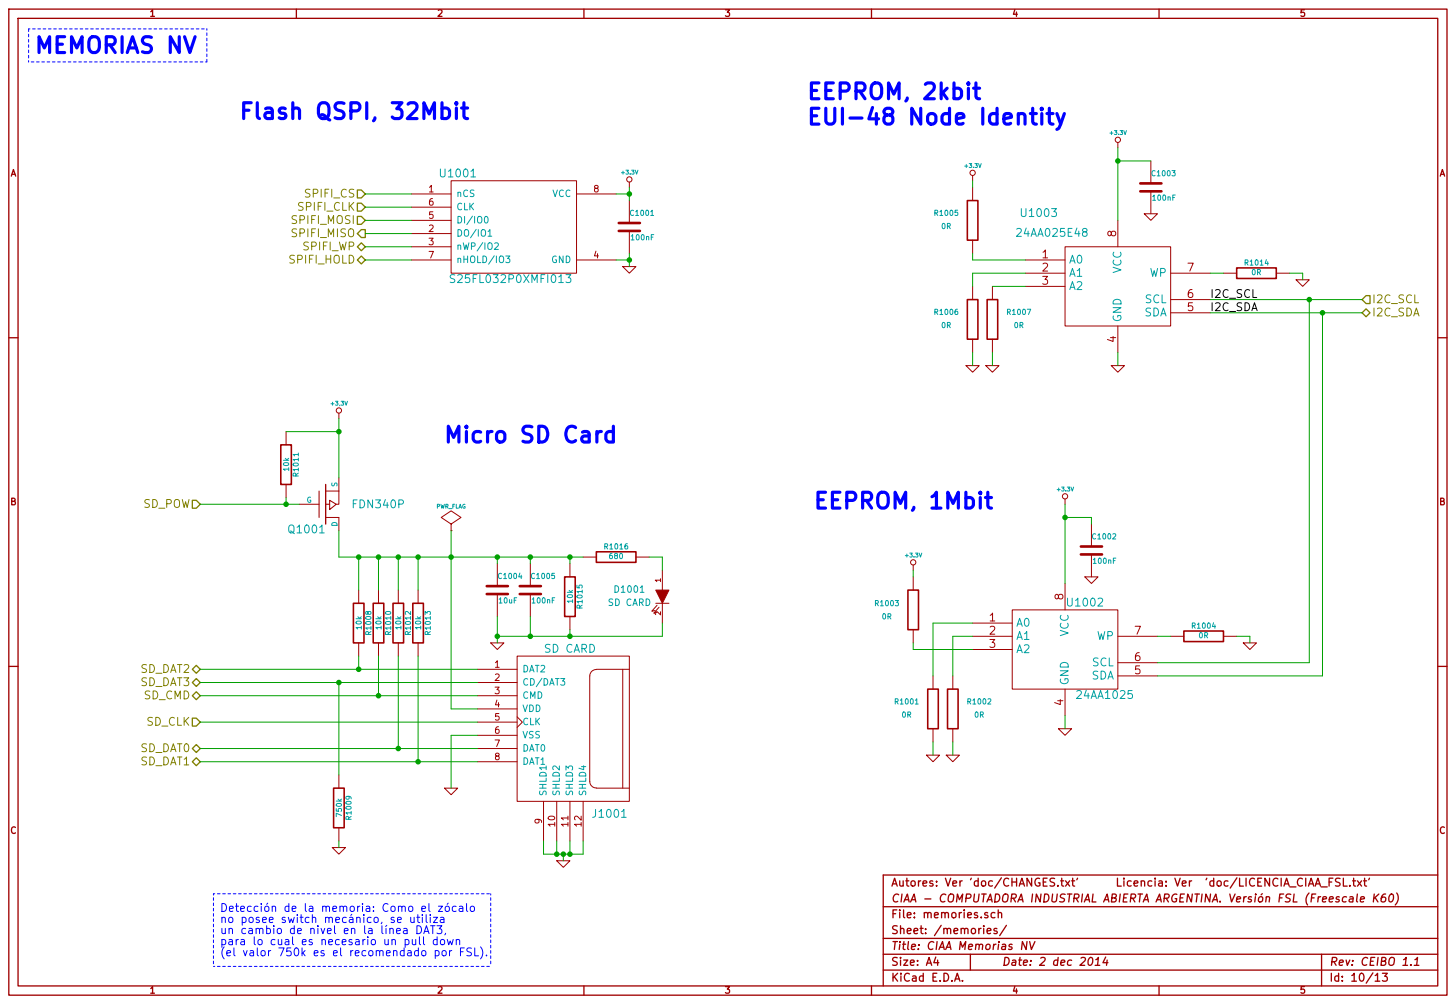
[picture p164: page 10]

PWR_FLAG Detección de la memoria: Como el zócalo

(el valor 750k es el recomendado por FSL). R1009 750k

CIAA - COMPUTADORA INDUSTRIAL ABIERTA ARGENTINA. Versión FSL (Freescale K60)
File: memories.sch Sheet: /memories/

no posee switch mecánico, se utiliza
un cambio de nivel en la línea DAT3,
para lo cual es necesario un pull down

Title: CIAA Memorias NV

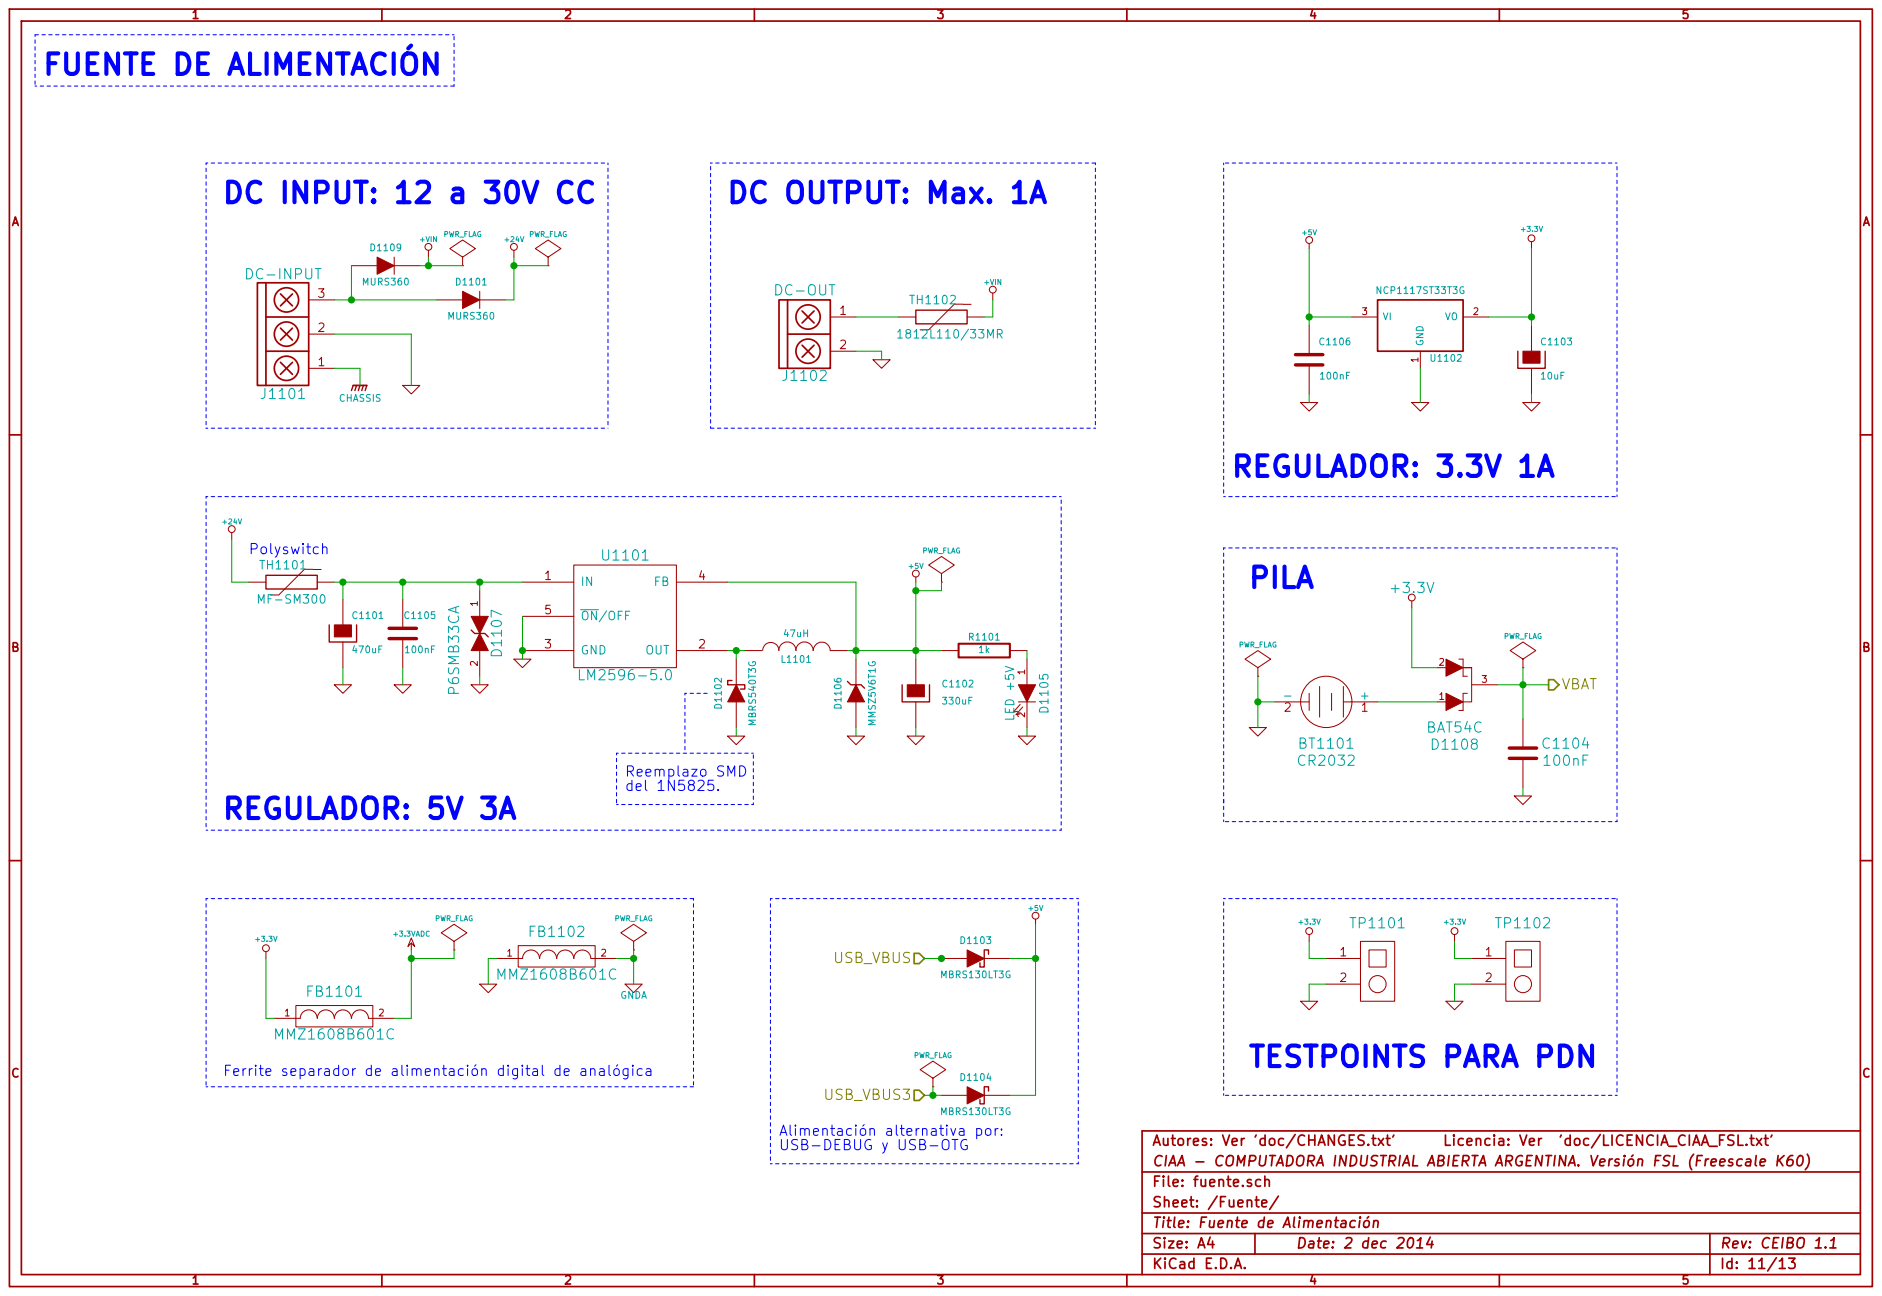
[picture p165: page 11]

1 VO 2 VI 3 U1102 NCP1117ST33T3G FUENTE DE ALIMENTACIÓN

+VIN DC OUTPUT: Max. 1A

USB-DEBUG y USB-OTG

CIAA - COMPUTADORA INDUSTRIAL ABIERTA ARGENTINA. Versión FSL (Freescale K60)
Title: Fuente de Alimentación File: fuente.sch Sheet: /Fuente/

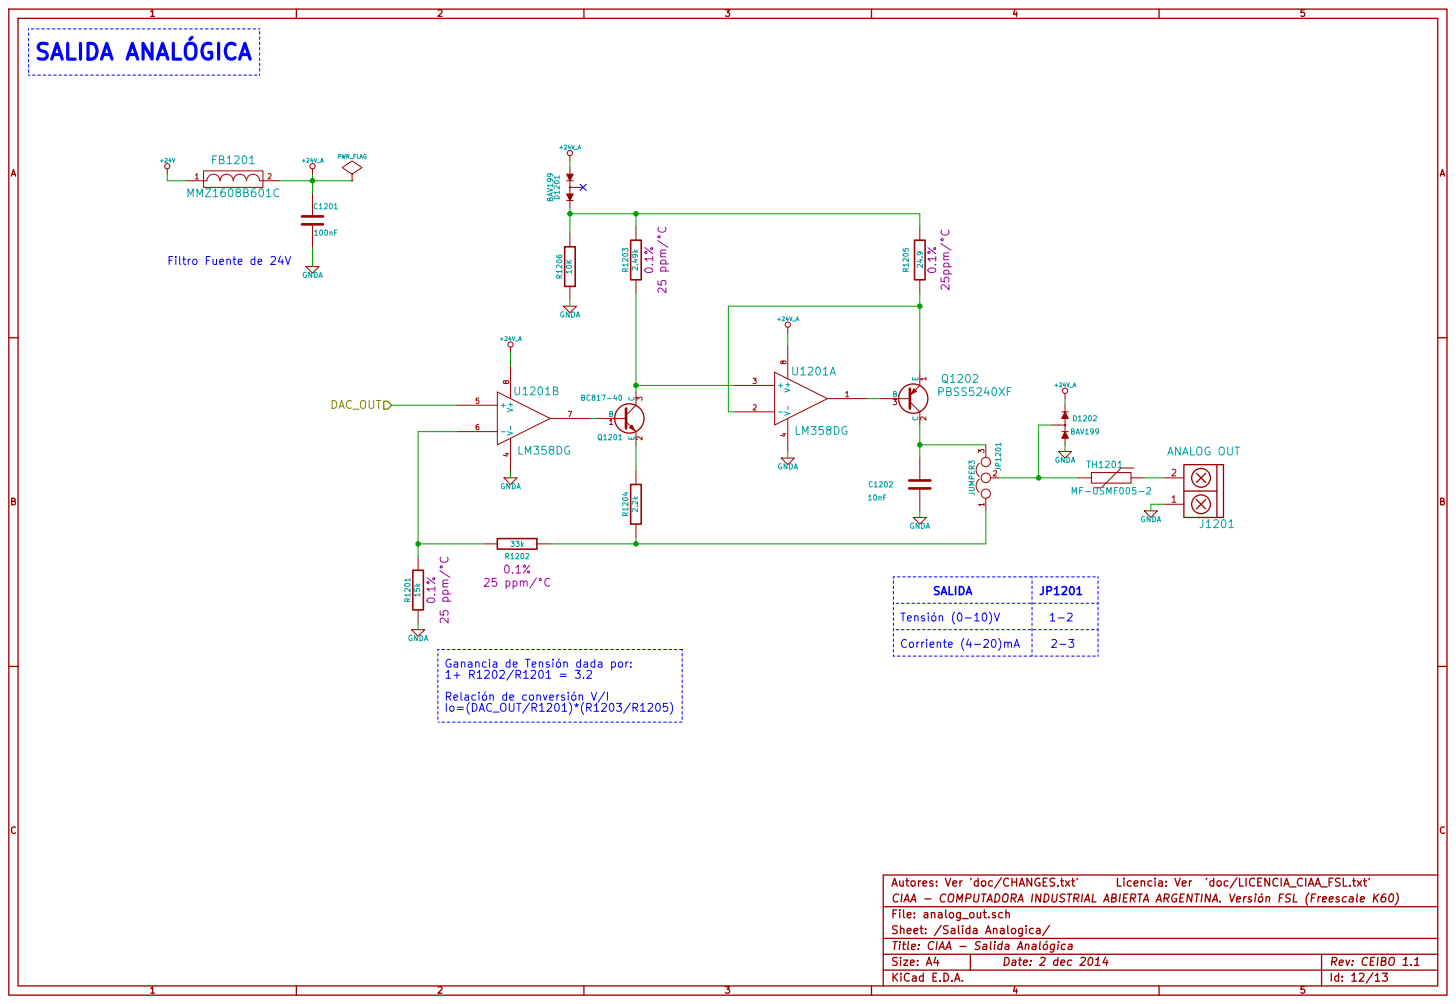
[picture p166: page 12]

CIAA - COMPUTADORA INDUSTRIAL ABIERTA ARGENTINA. Versión FSL (Freescale K60)
File: analog_out.sch
Sheet: /Salida Analogica/
Title: CIAA - Salida Analógica

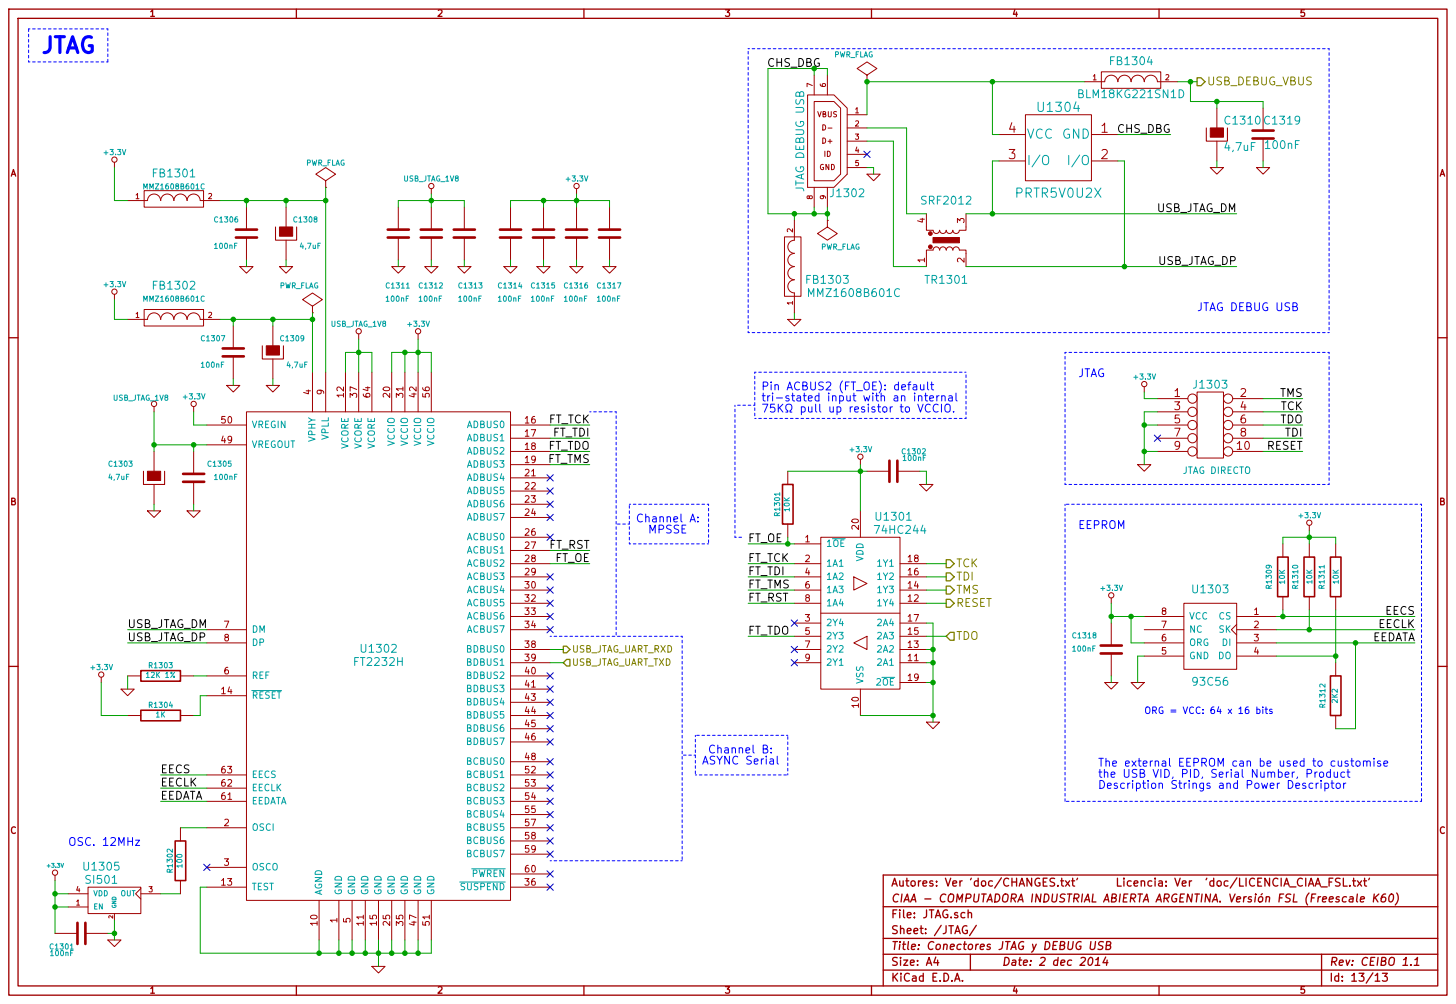
[picture p167: page 13]

9 AGND 10 VCCIO 20 ACBUS4 30 BDBUS2 40 VREGIN 50 PWREN 60 GND 11 ADBUS4 21 VCCIO 31 BDBUS3 41 GND 51 EEDATA 61 VCORE 12 ADBUS5 22 ACBUS5 32 VCCIO 42 BCBUS1 52 EECLK 62 TEST 13 ADBUS6 23 ACBUS6 33 BDBUS4 43 BCBUS2 53 EECS 63 RESET 14 ADBUS7 24 ACBUS7 34 BDBUS5 44 BCBUS3 54 VCORE 64 GND 15 GND 25 GND 35 BDBUS6 45 BCBUS4 55 ADBUS0 16 ACBUS0 26 SUSPEND 36 BDBUS7 46 VCCIO 56 ADBUS1 17 ACBUS1 27 VCORE 37 GND 47 BCBUS5 57 ADBUS2 18 ACBUS2 28 BDBUS0 38 BCBUS0 48 BCBUS6 58 ADBUS3 19 ACBUS3 29 BDBUS1 39 VREGOUT 49 BCBUS7 59 U1302 FT2232H

Pin ACBUS2 (FT_OE): default tri-stated input with an internal

75K pull up resistor to VCCIO. R1301 10K

5 | 6 TDO

5 REF 6 DM 7 DP 8 VPLL

ORG = VCC: 64 x 16 bits C1305 1A1 2

FT_TDI | 1A2 4

The external EEPROM can be used to customise
the USB VID, PID, Serial Number, Product
Description Strings and Power Descriptor

EECLK
EEDATA

CIAA - COMPUTADORA INDUSTRIAL ABIERTA ARGENTINA. Versión FSL (Freescale K60)
File: JTAG.sch
Sheet: /JTAG/
Title: Conectores JTAG y DEBUG USB
