ciaa/Hardware/PCB/EDU-FPGA/Schematic/schematic.pdf

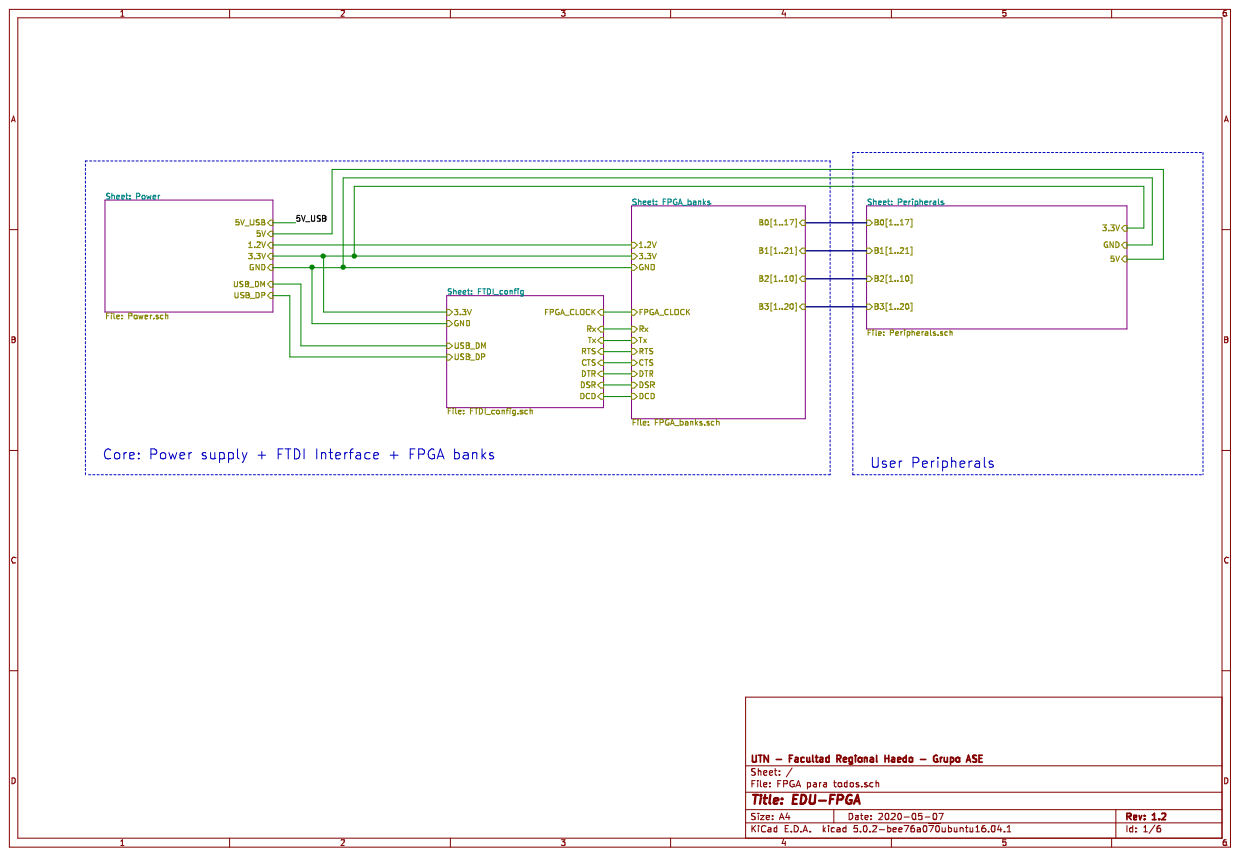
[picture p168: page 1]

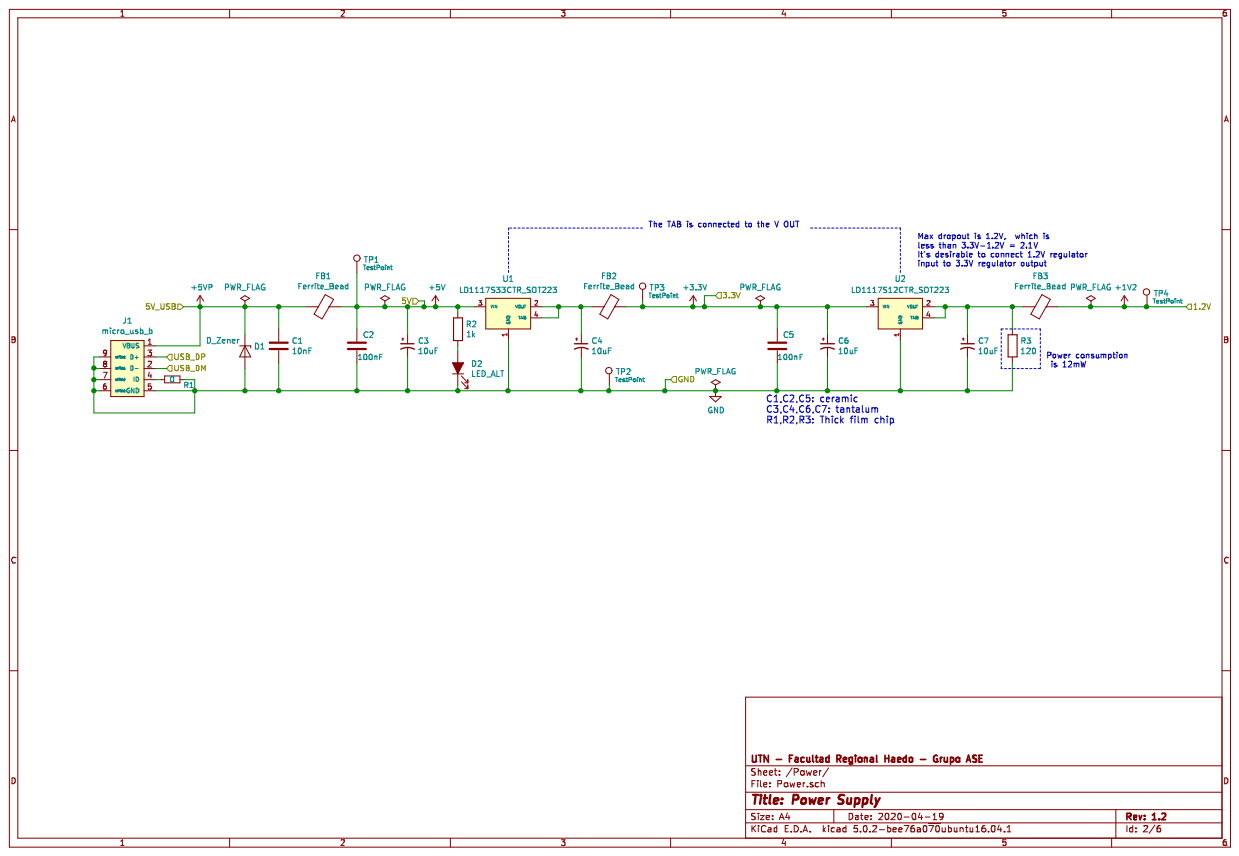
[picture p169: page 2]

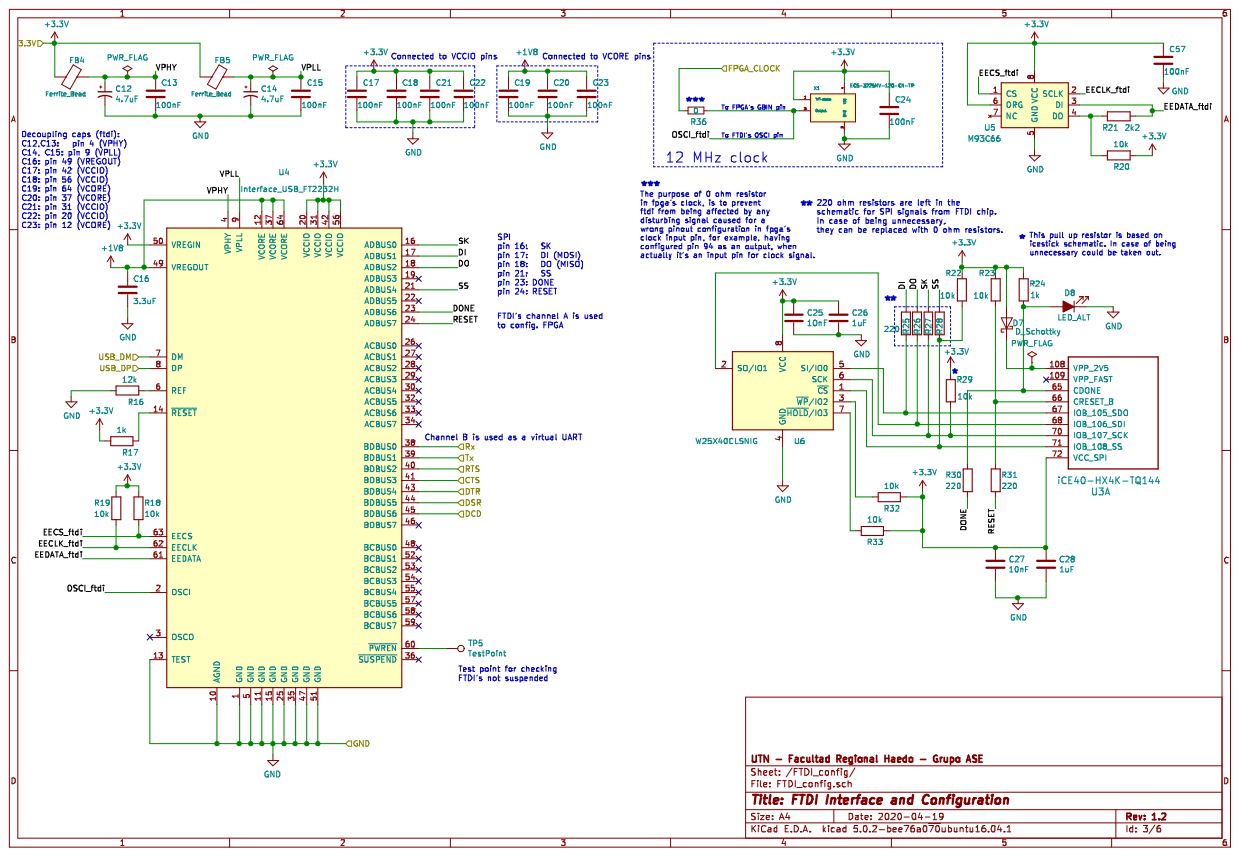
[picture p170: page 3]

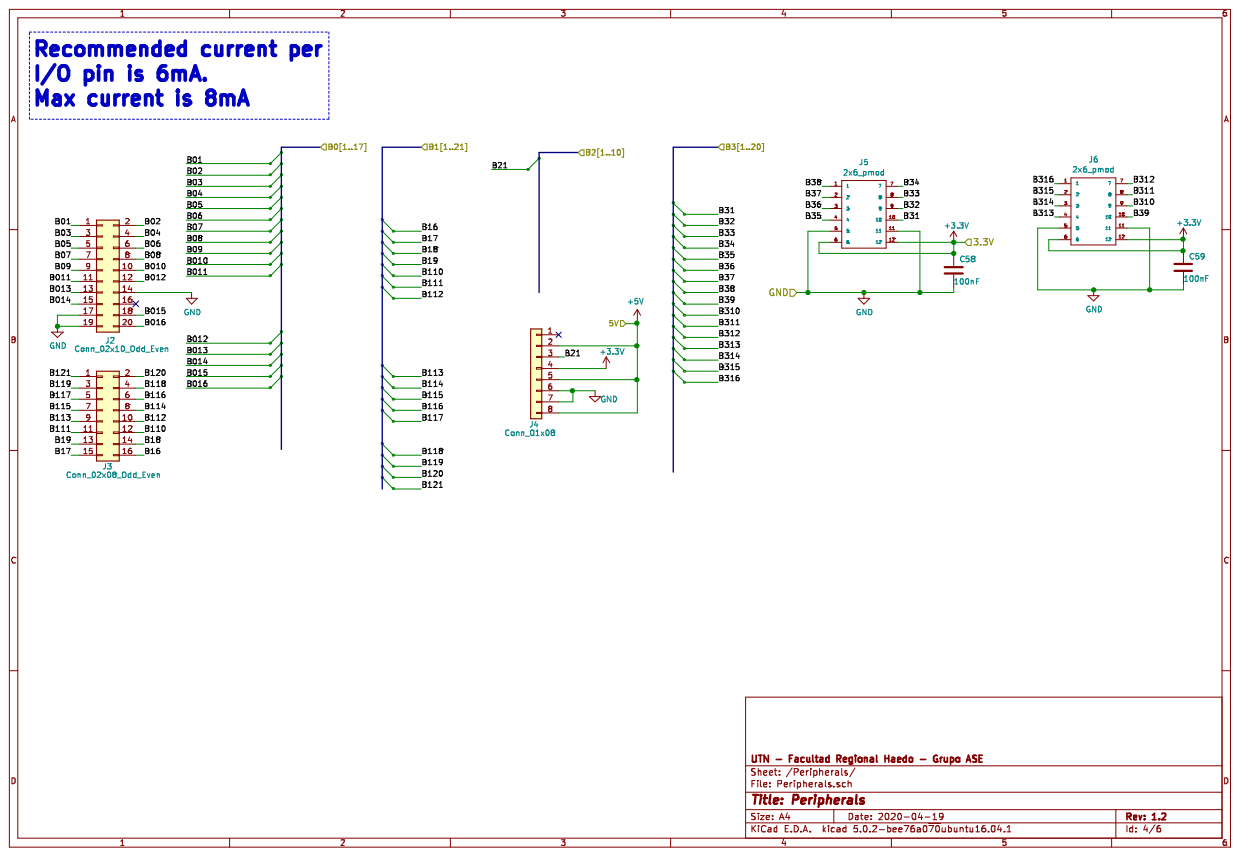
[picture p171: page 4]

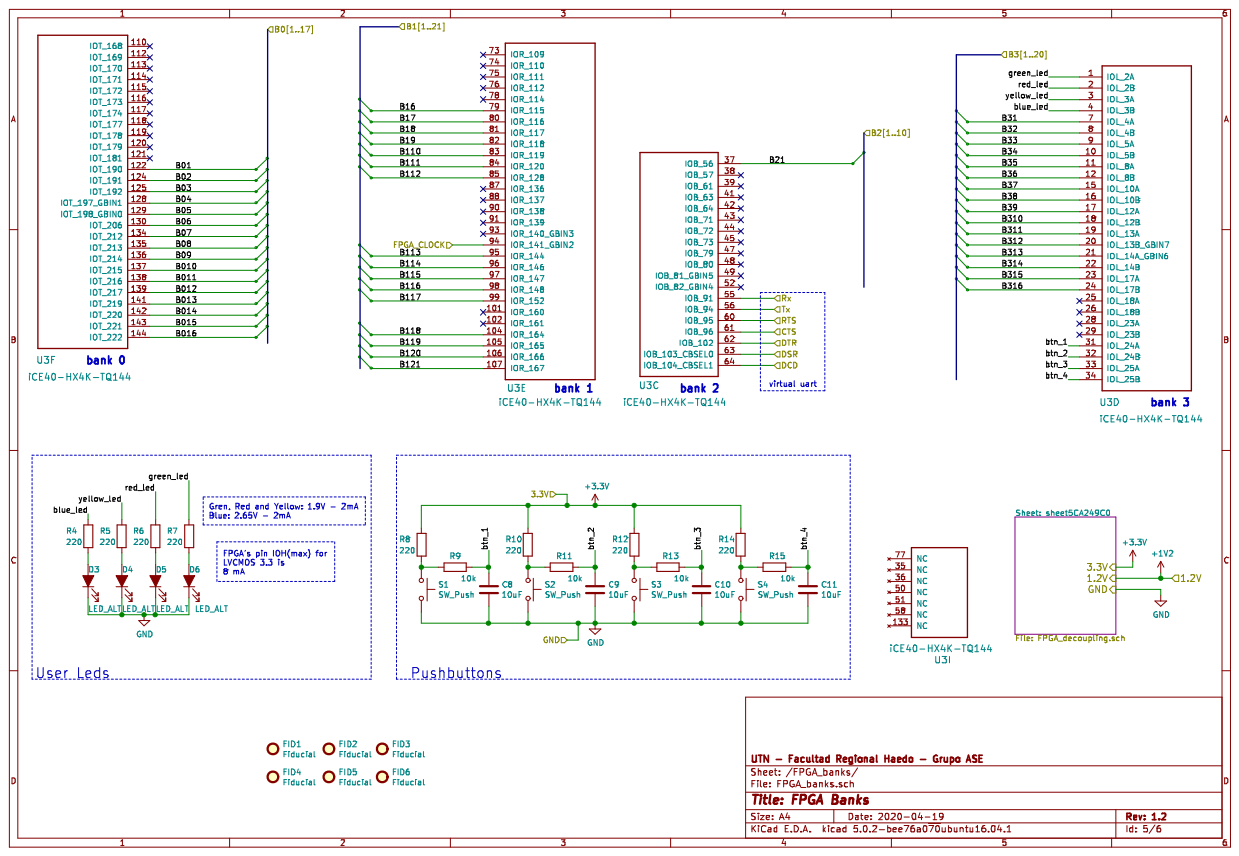
[picture p172: page 5]

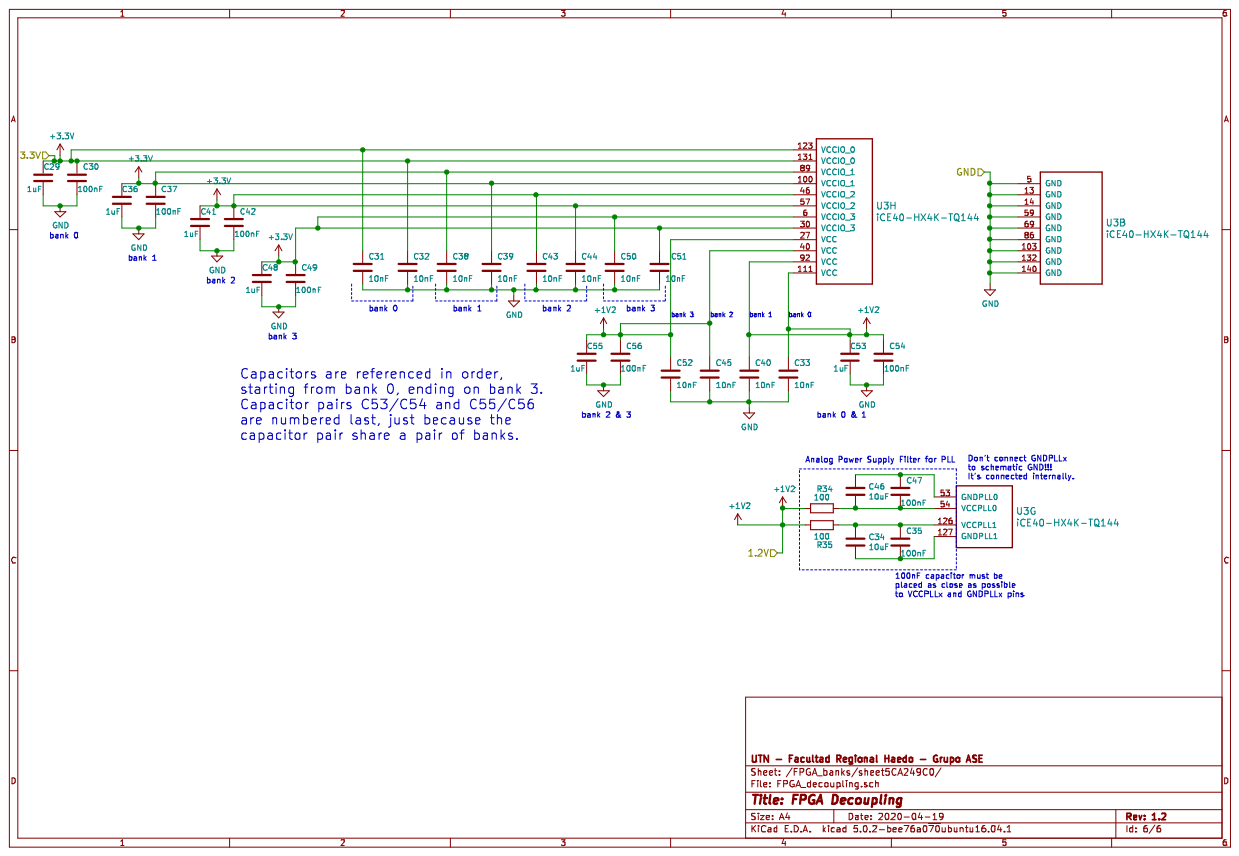
[picture p173: page 6]
