ciaa/Hardware/PCB/EDU-NXP/Doc/Schematic.pdf

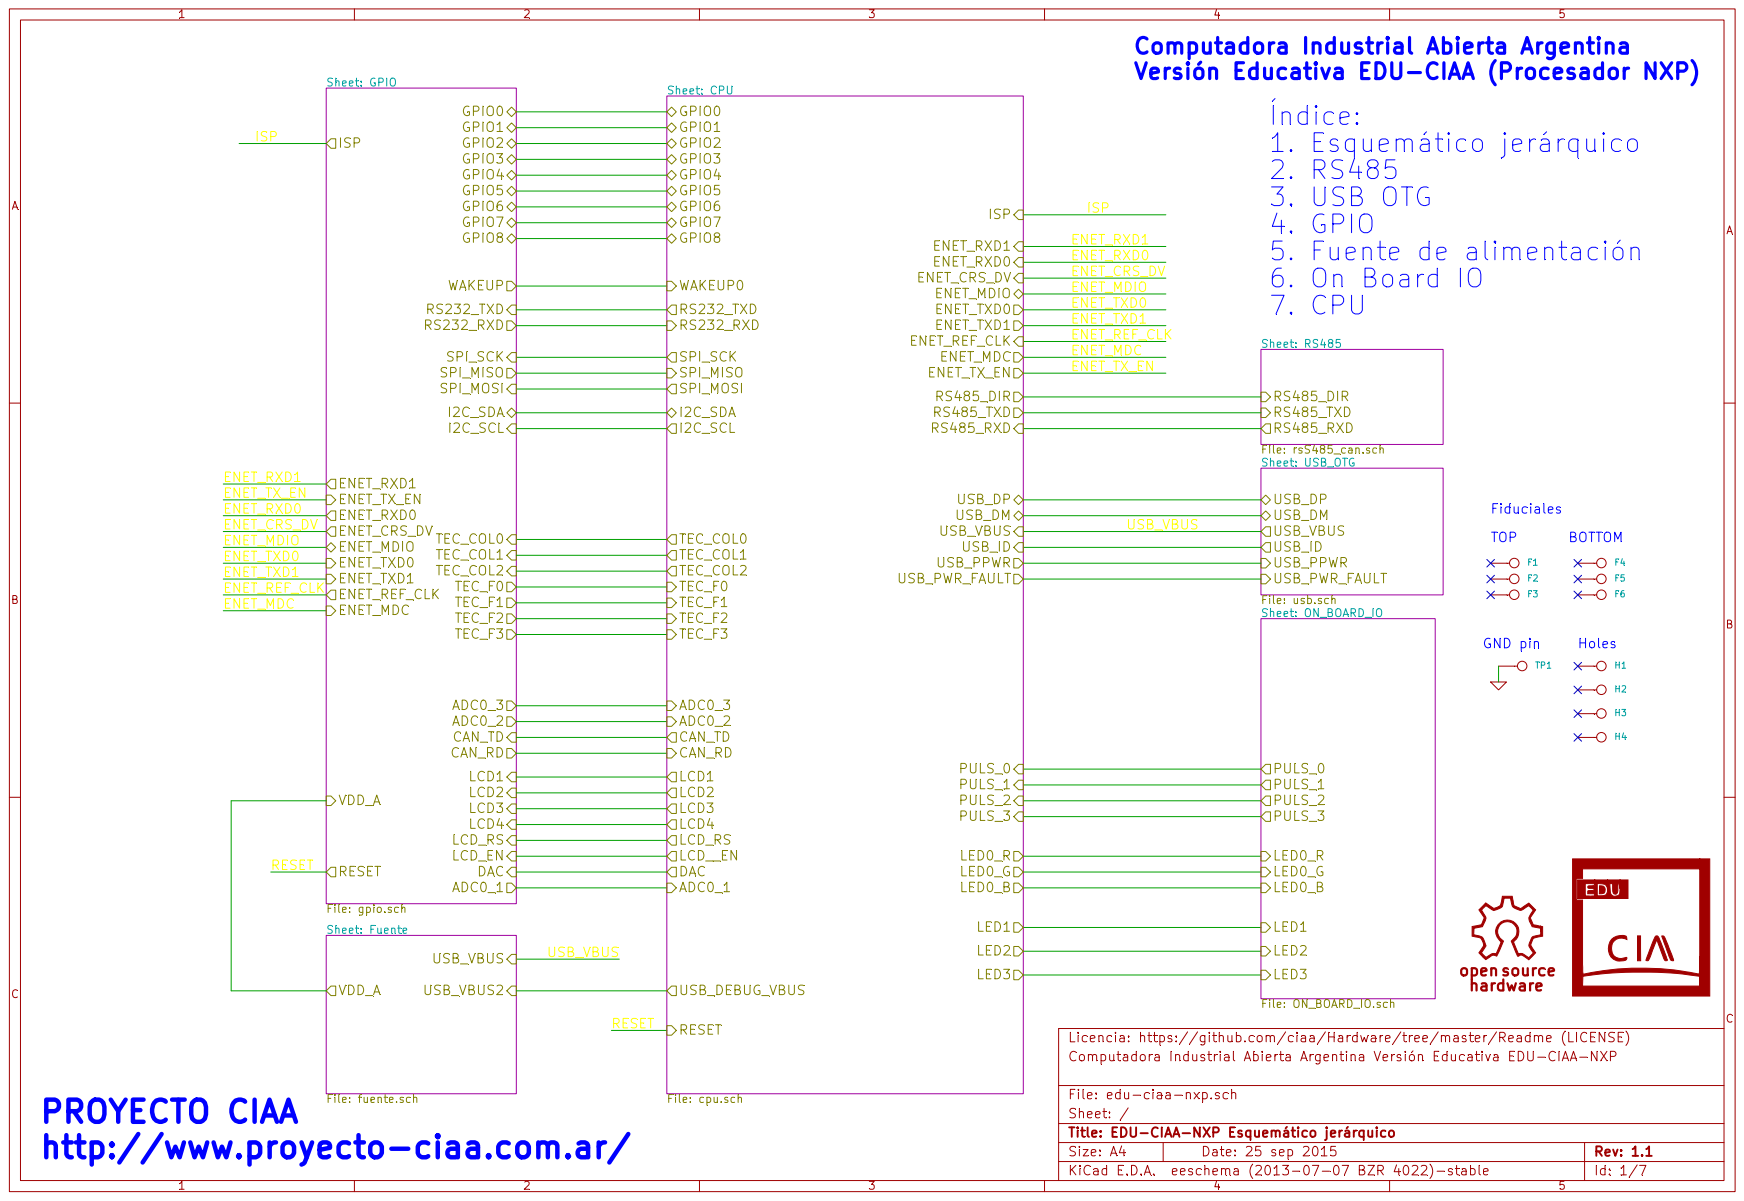
[picture p182: page 1]

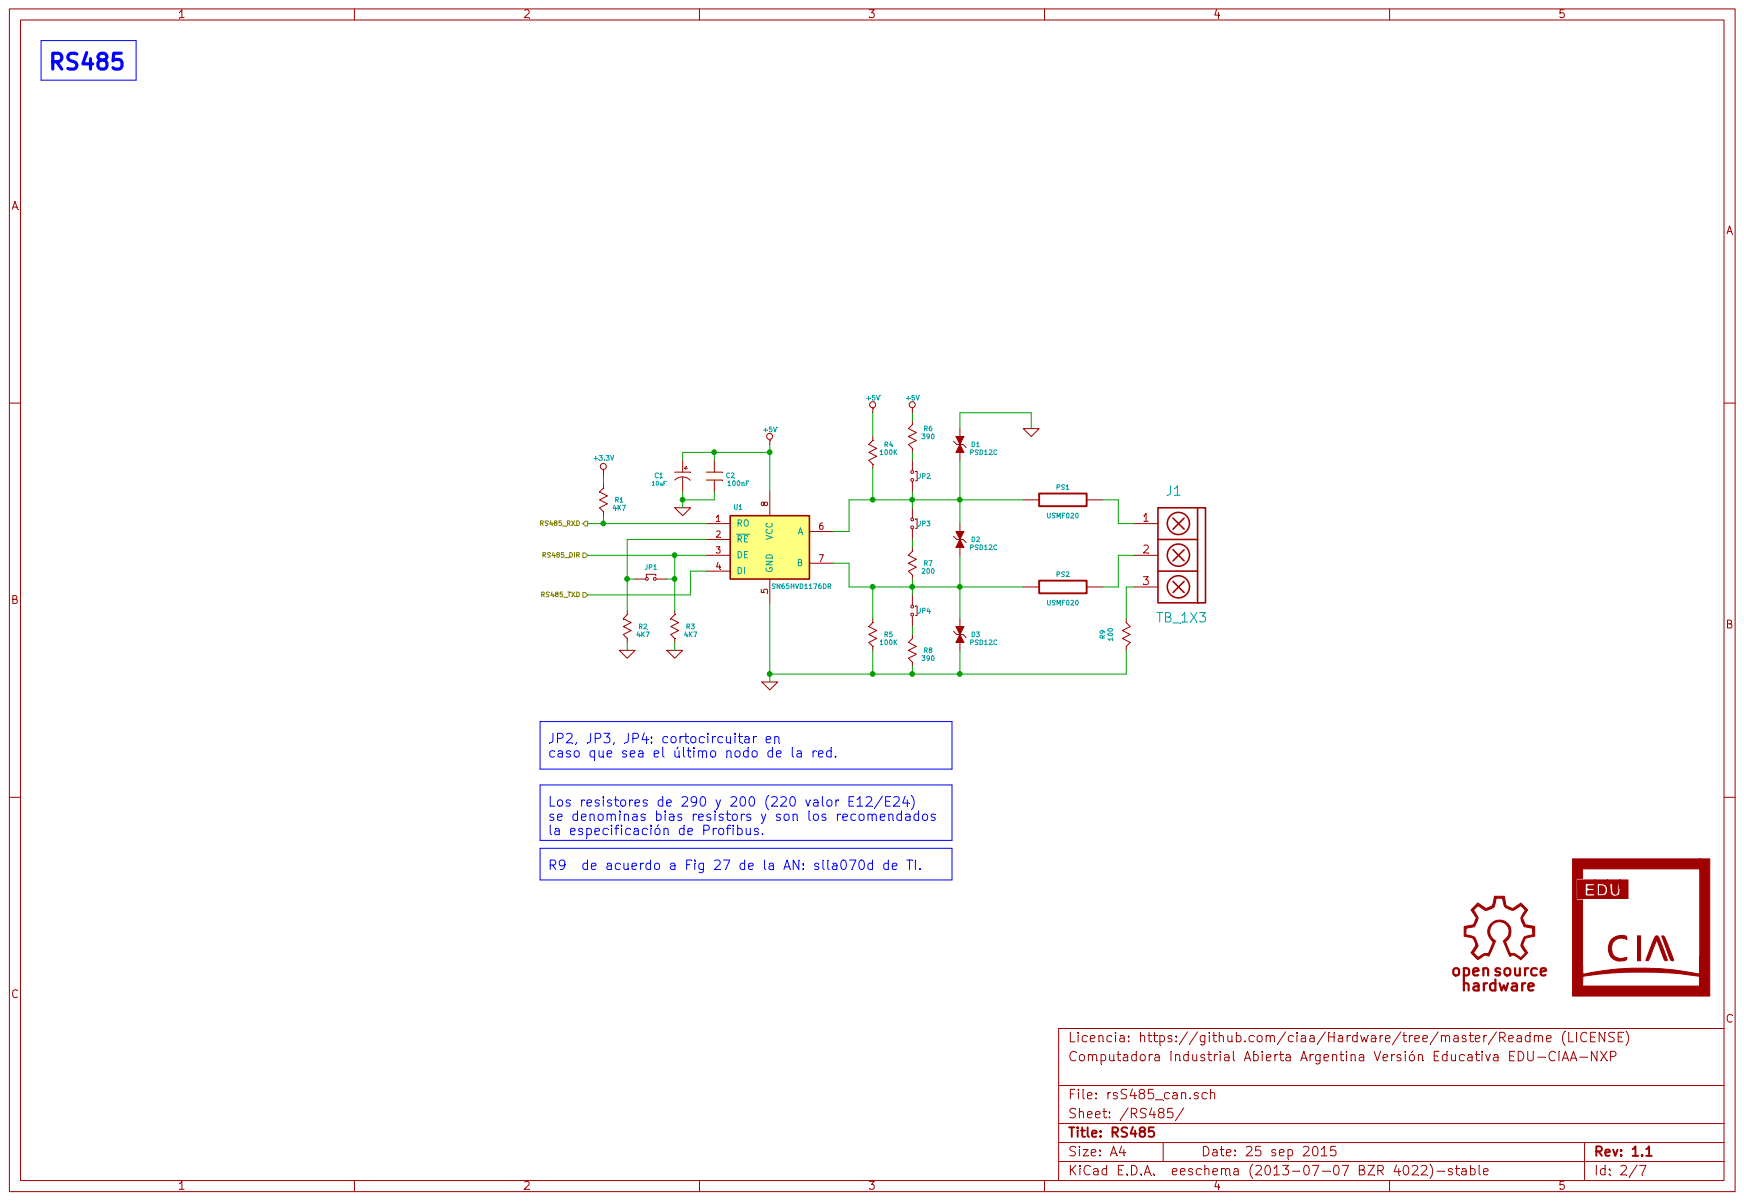
[picture p183: page 2]

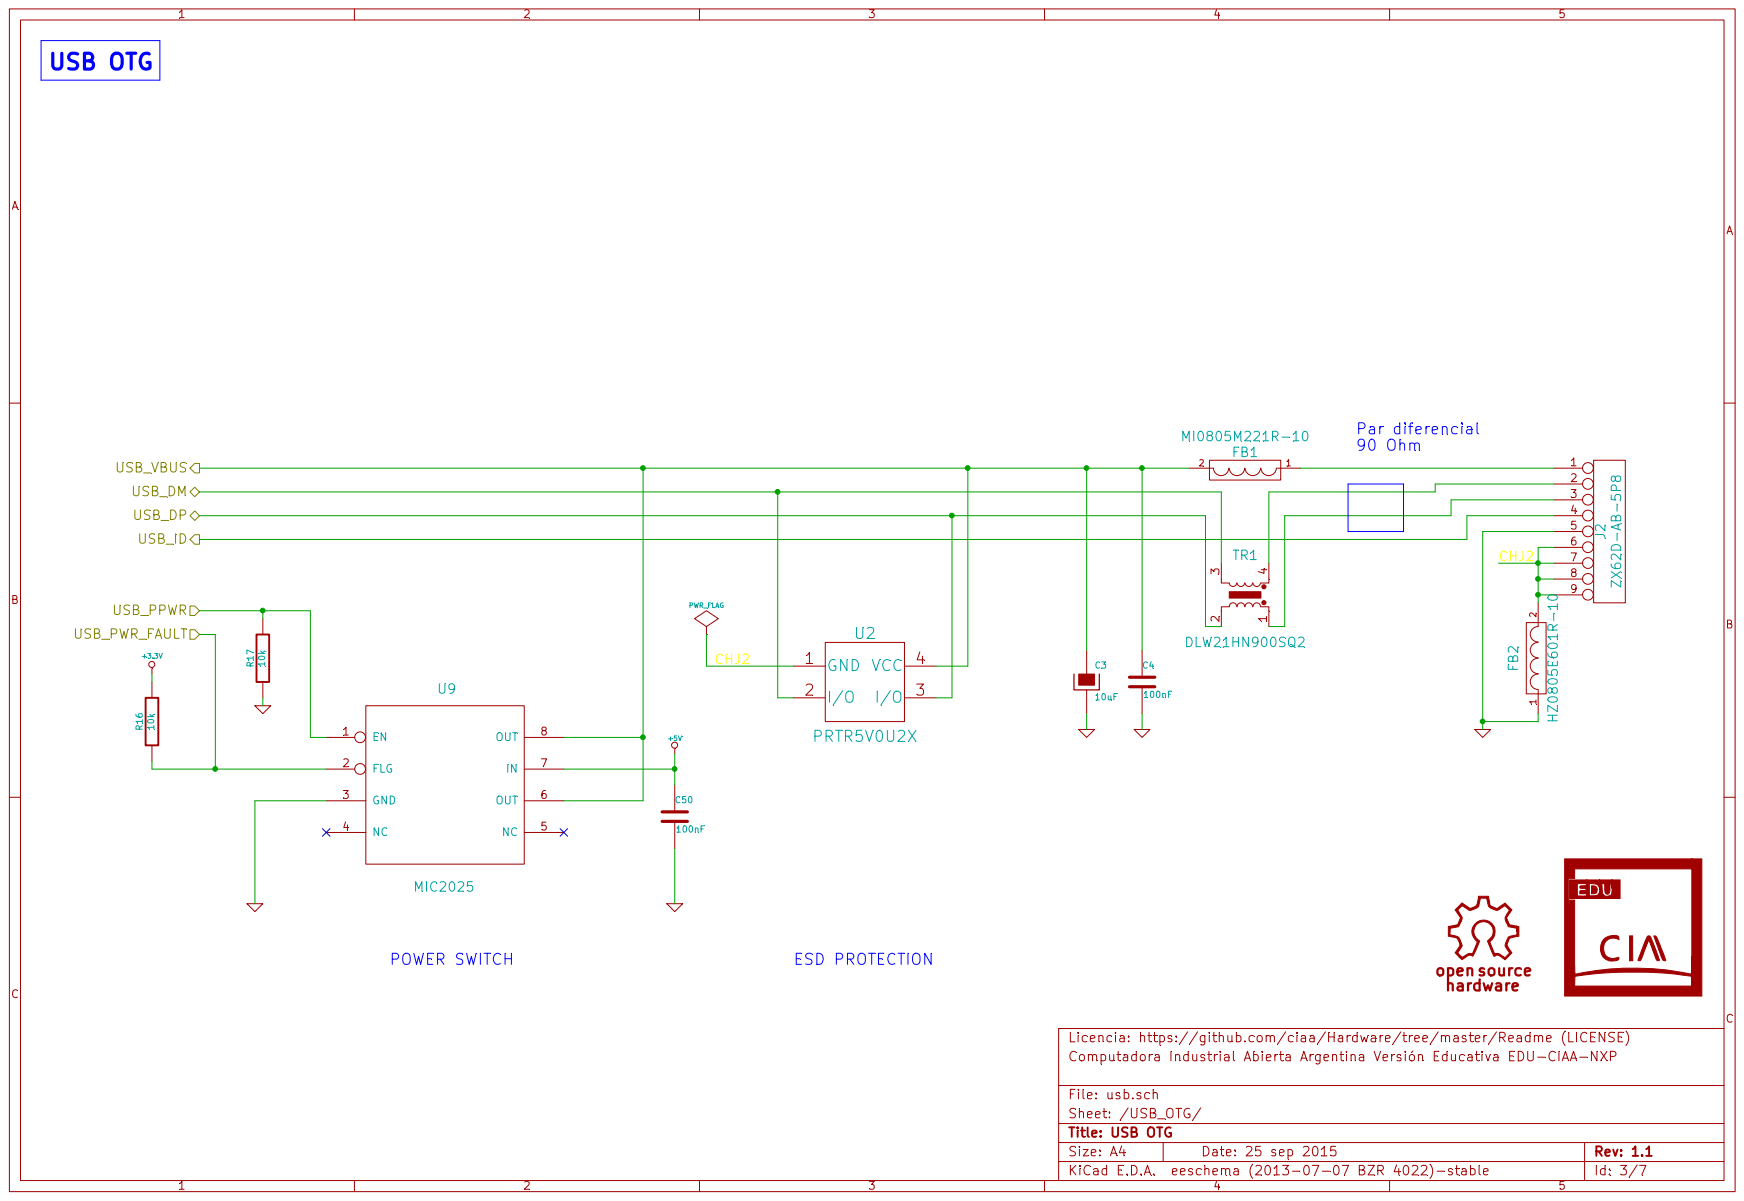
[picture p184: page 3]

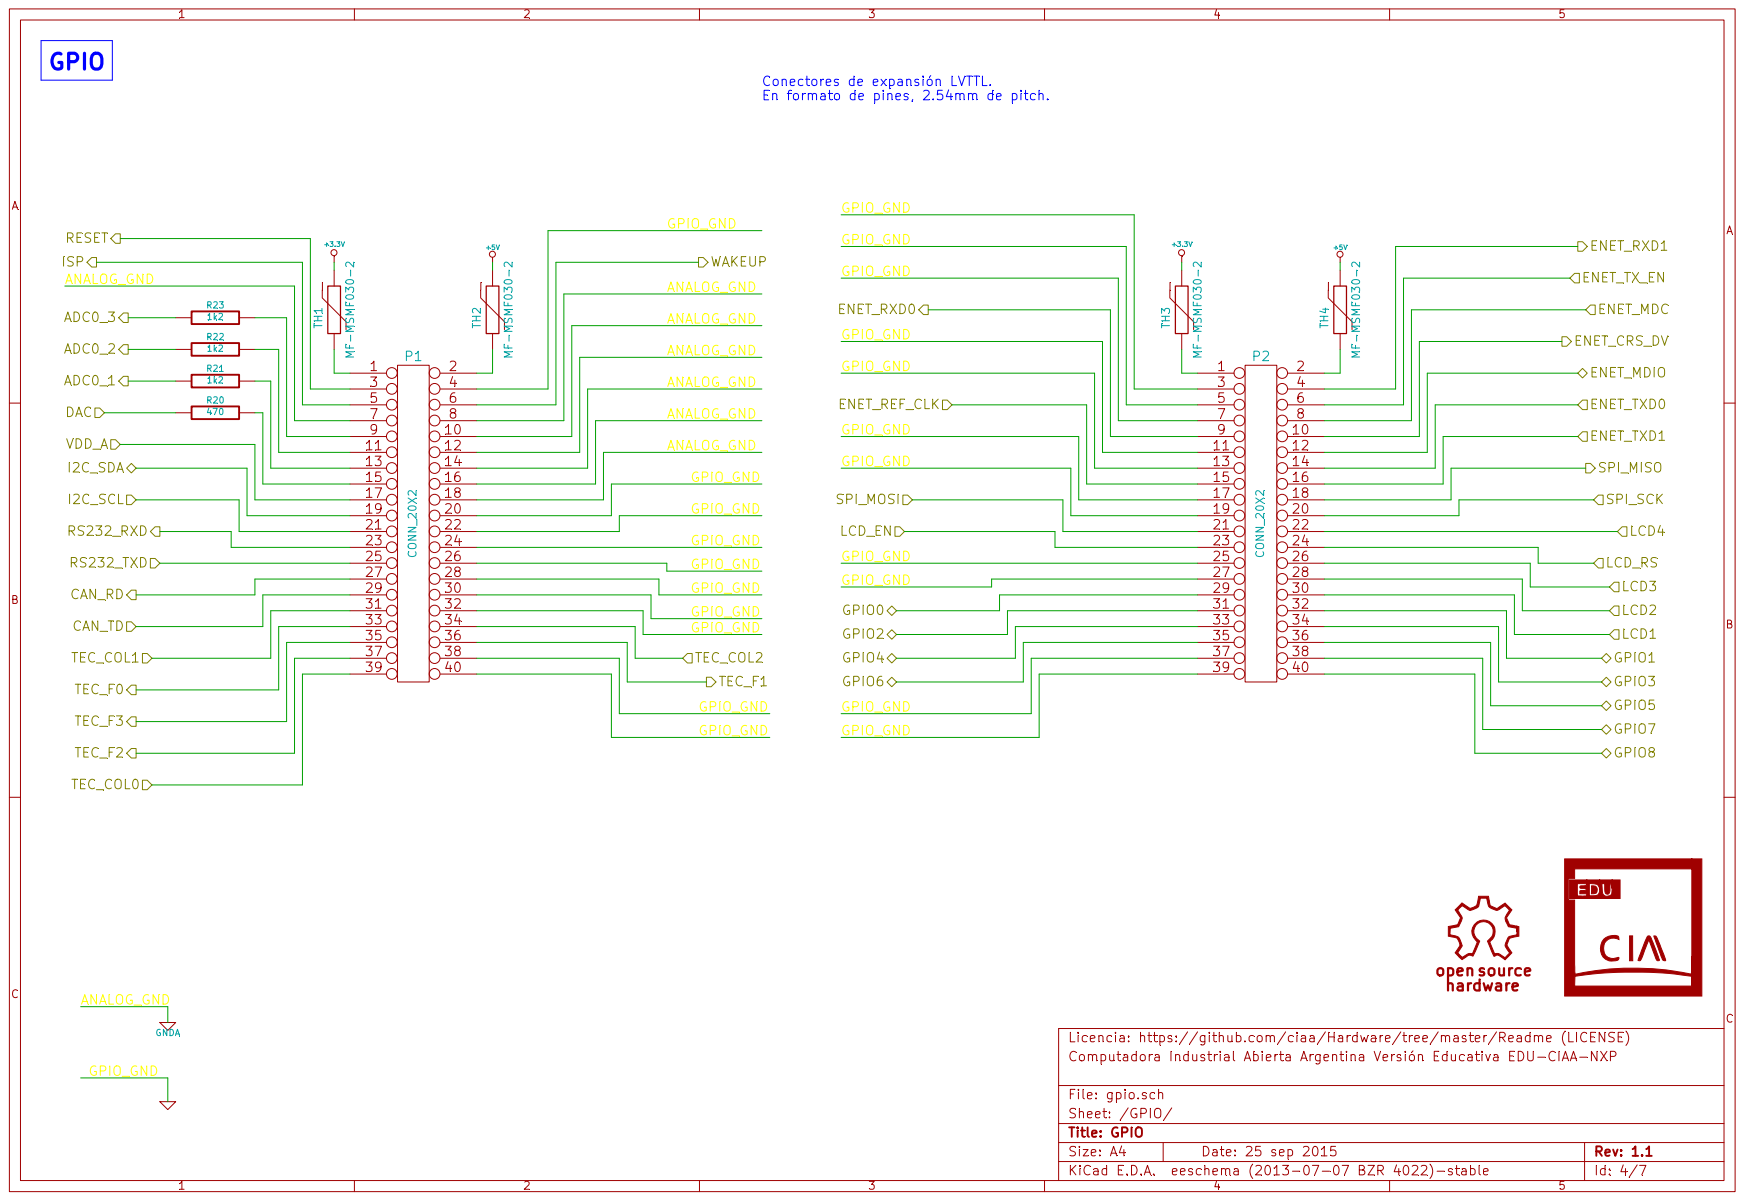
[picture p185: page 4]

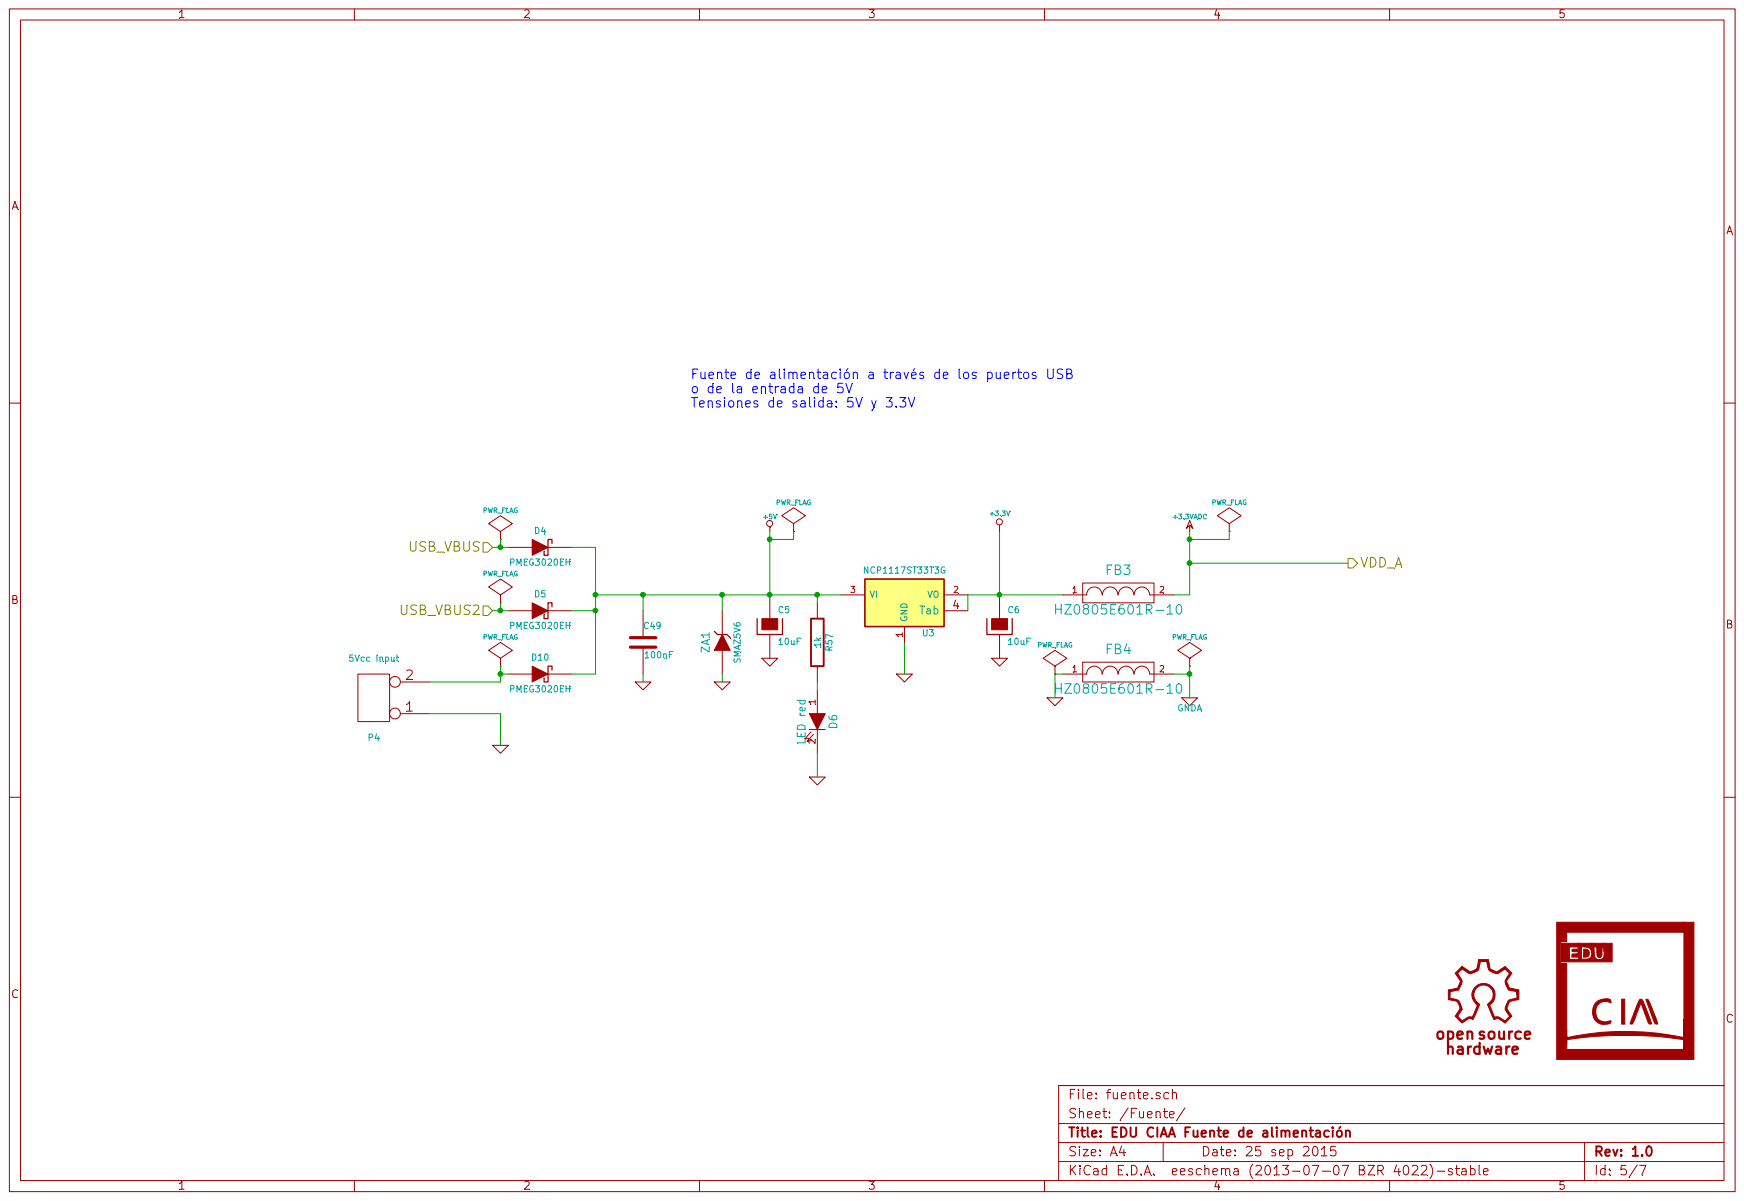
[picture p186: page 5]

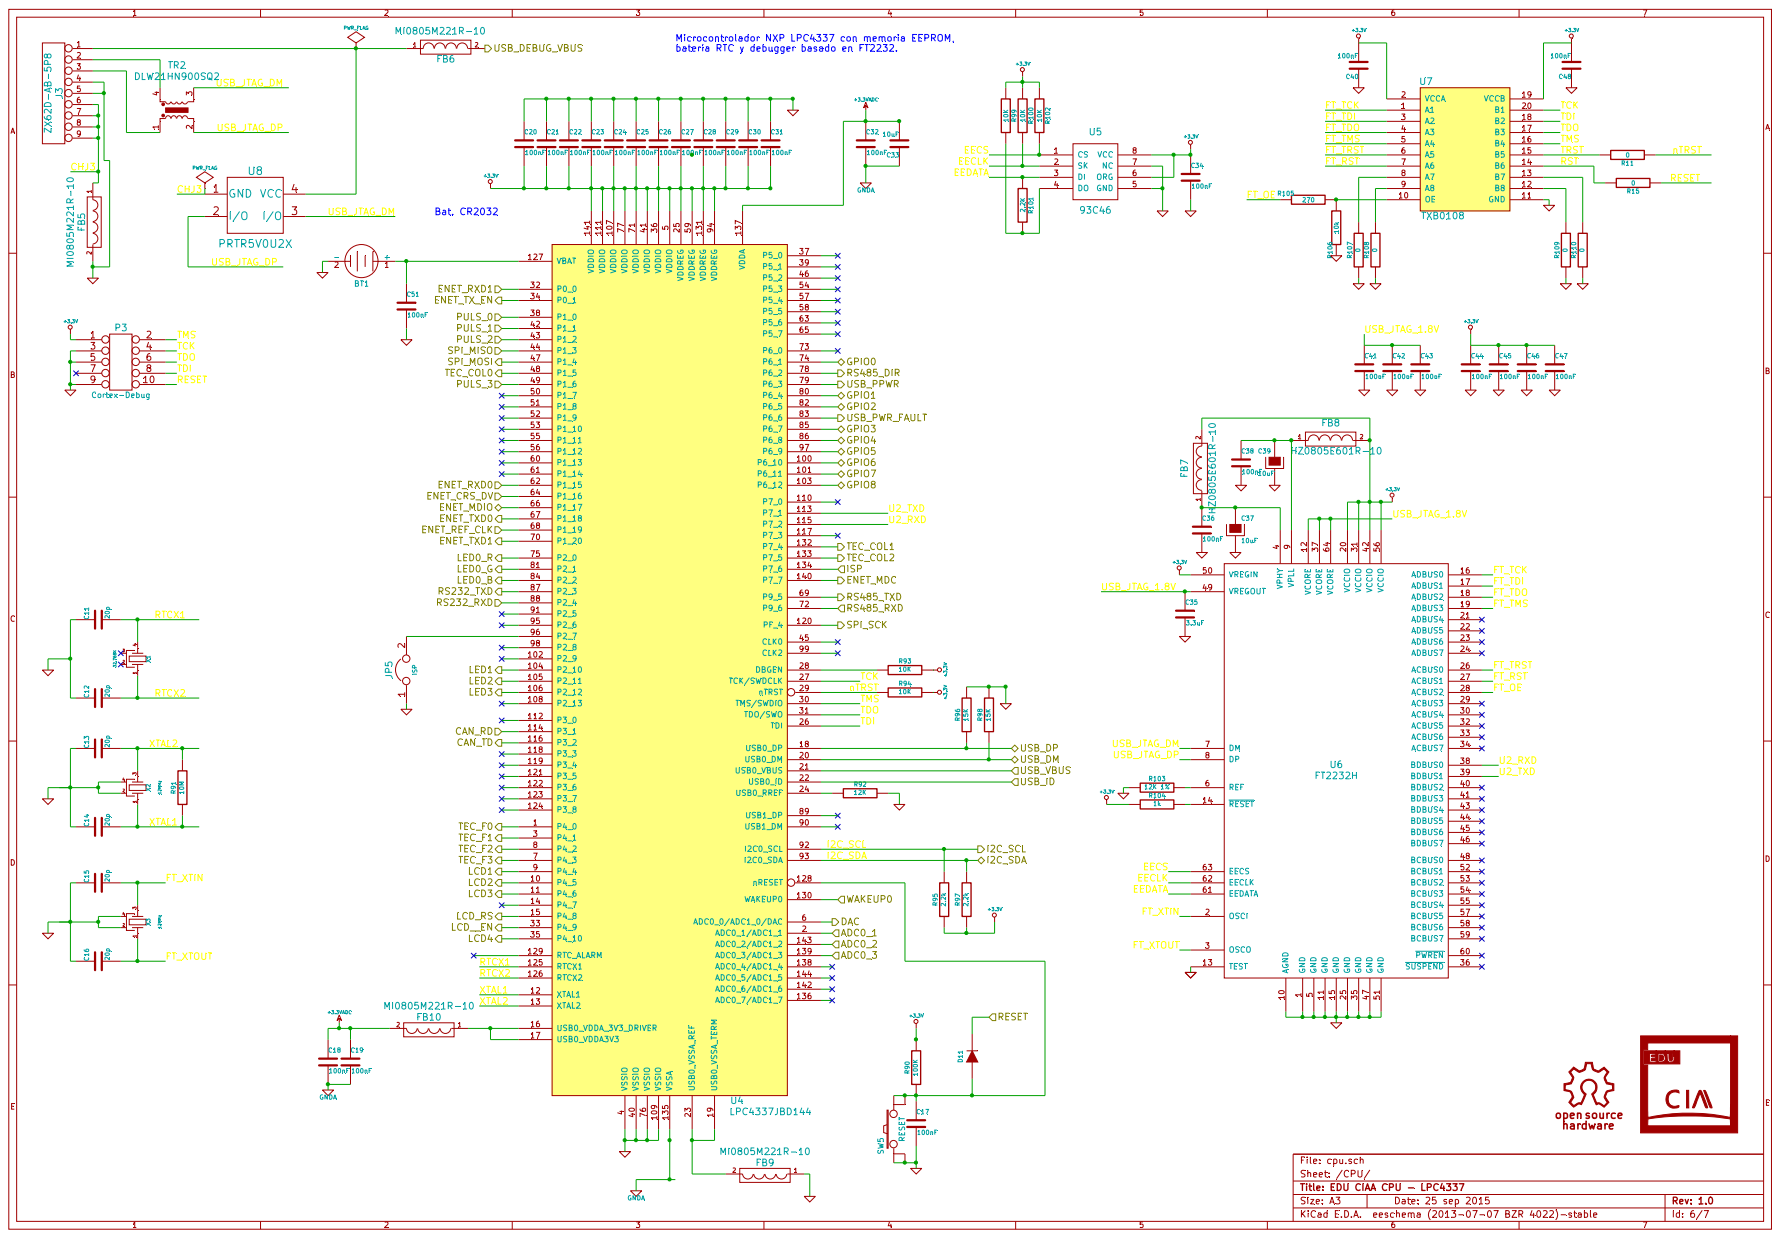
[picture p187: page 6]

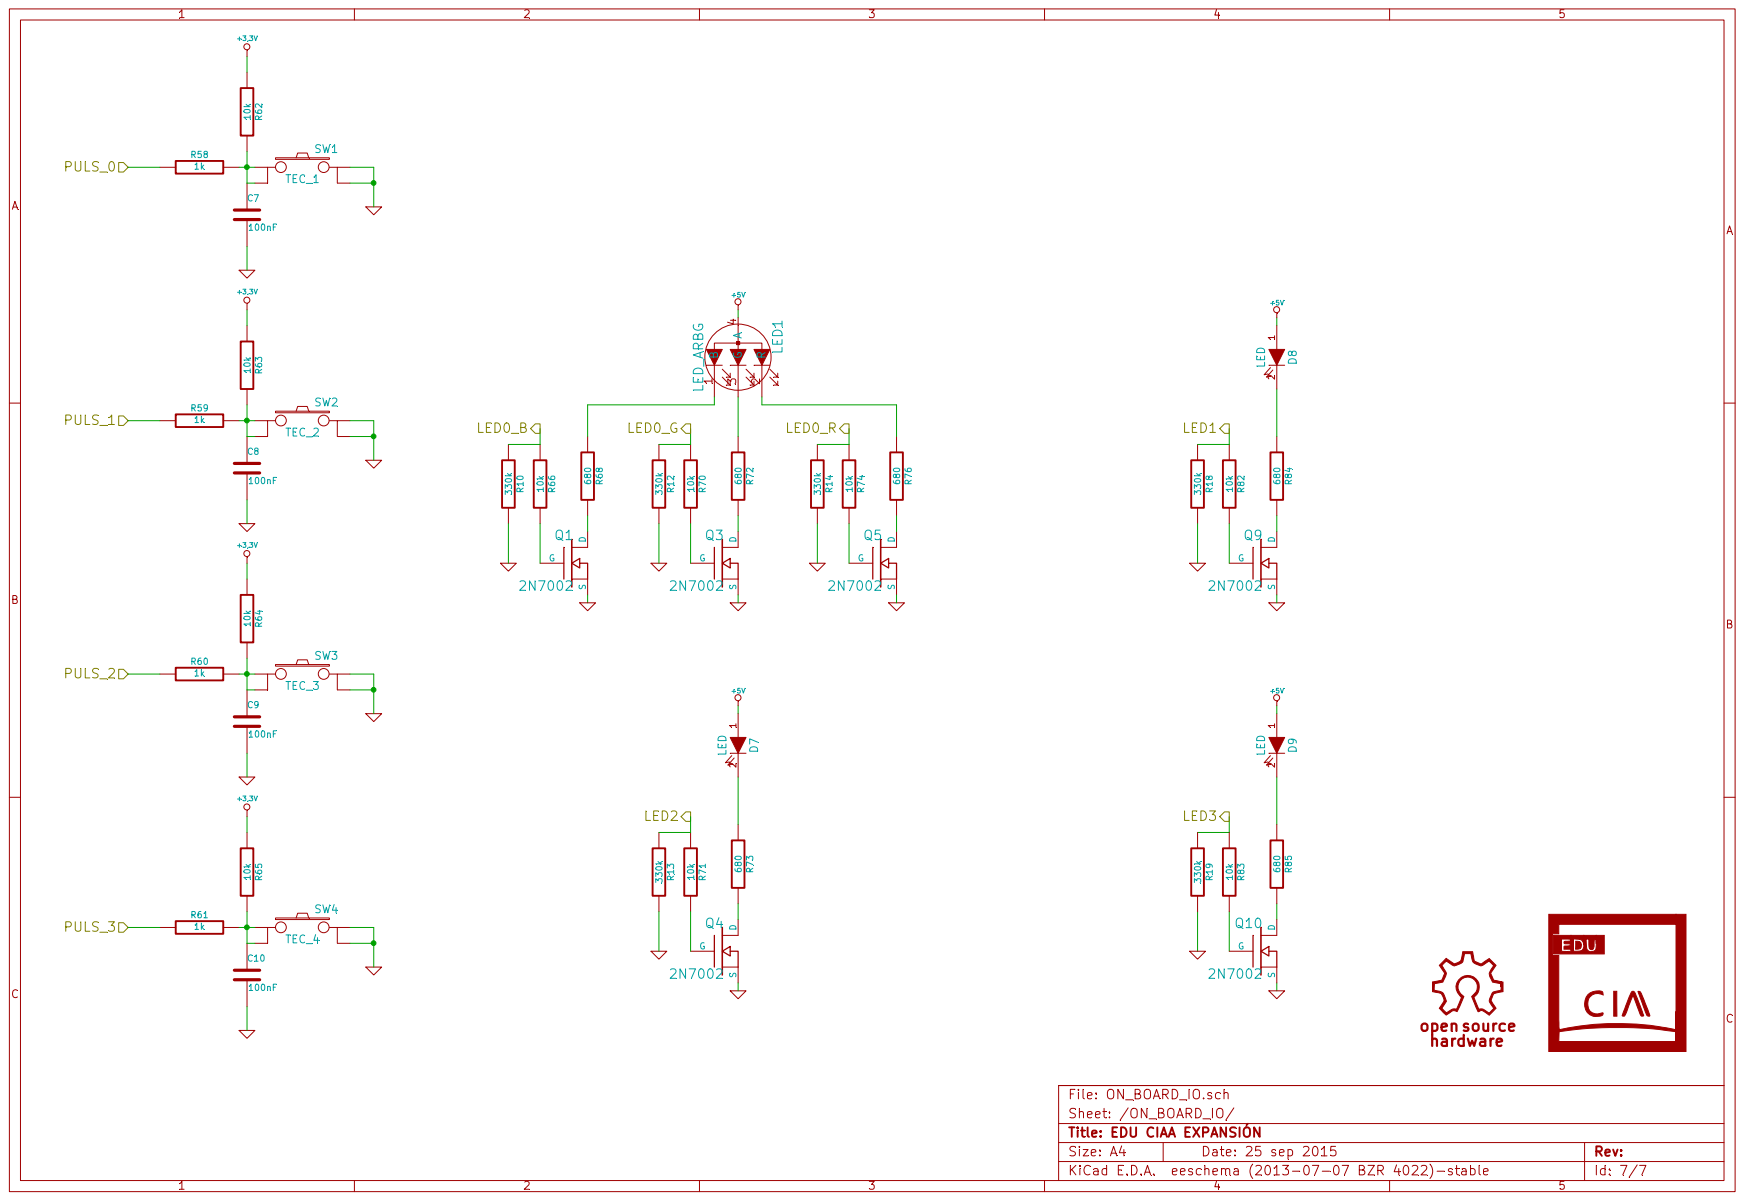
[picture p188: page 7]
