ciaa/Hardware/PCB/FSL/CIAA_K60/doc/fabricacion/panelizado/CIAA_K60_PANEL.pdf

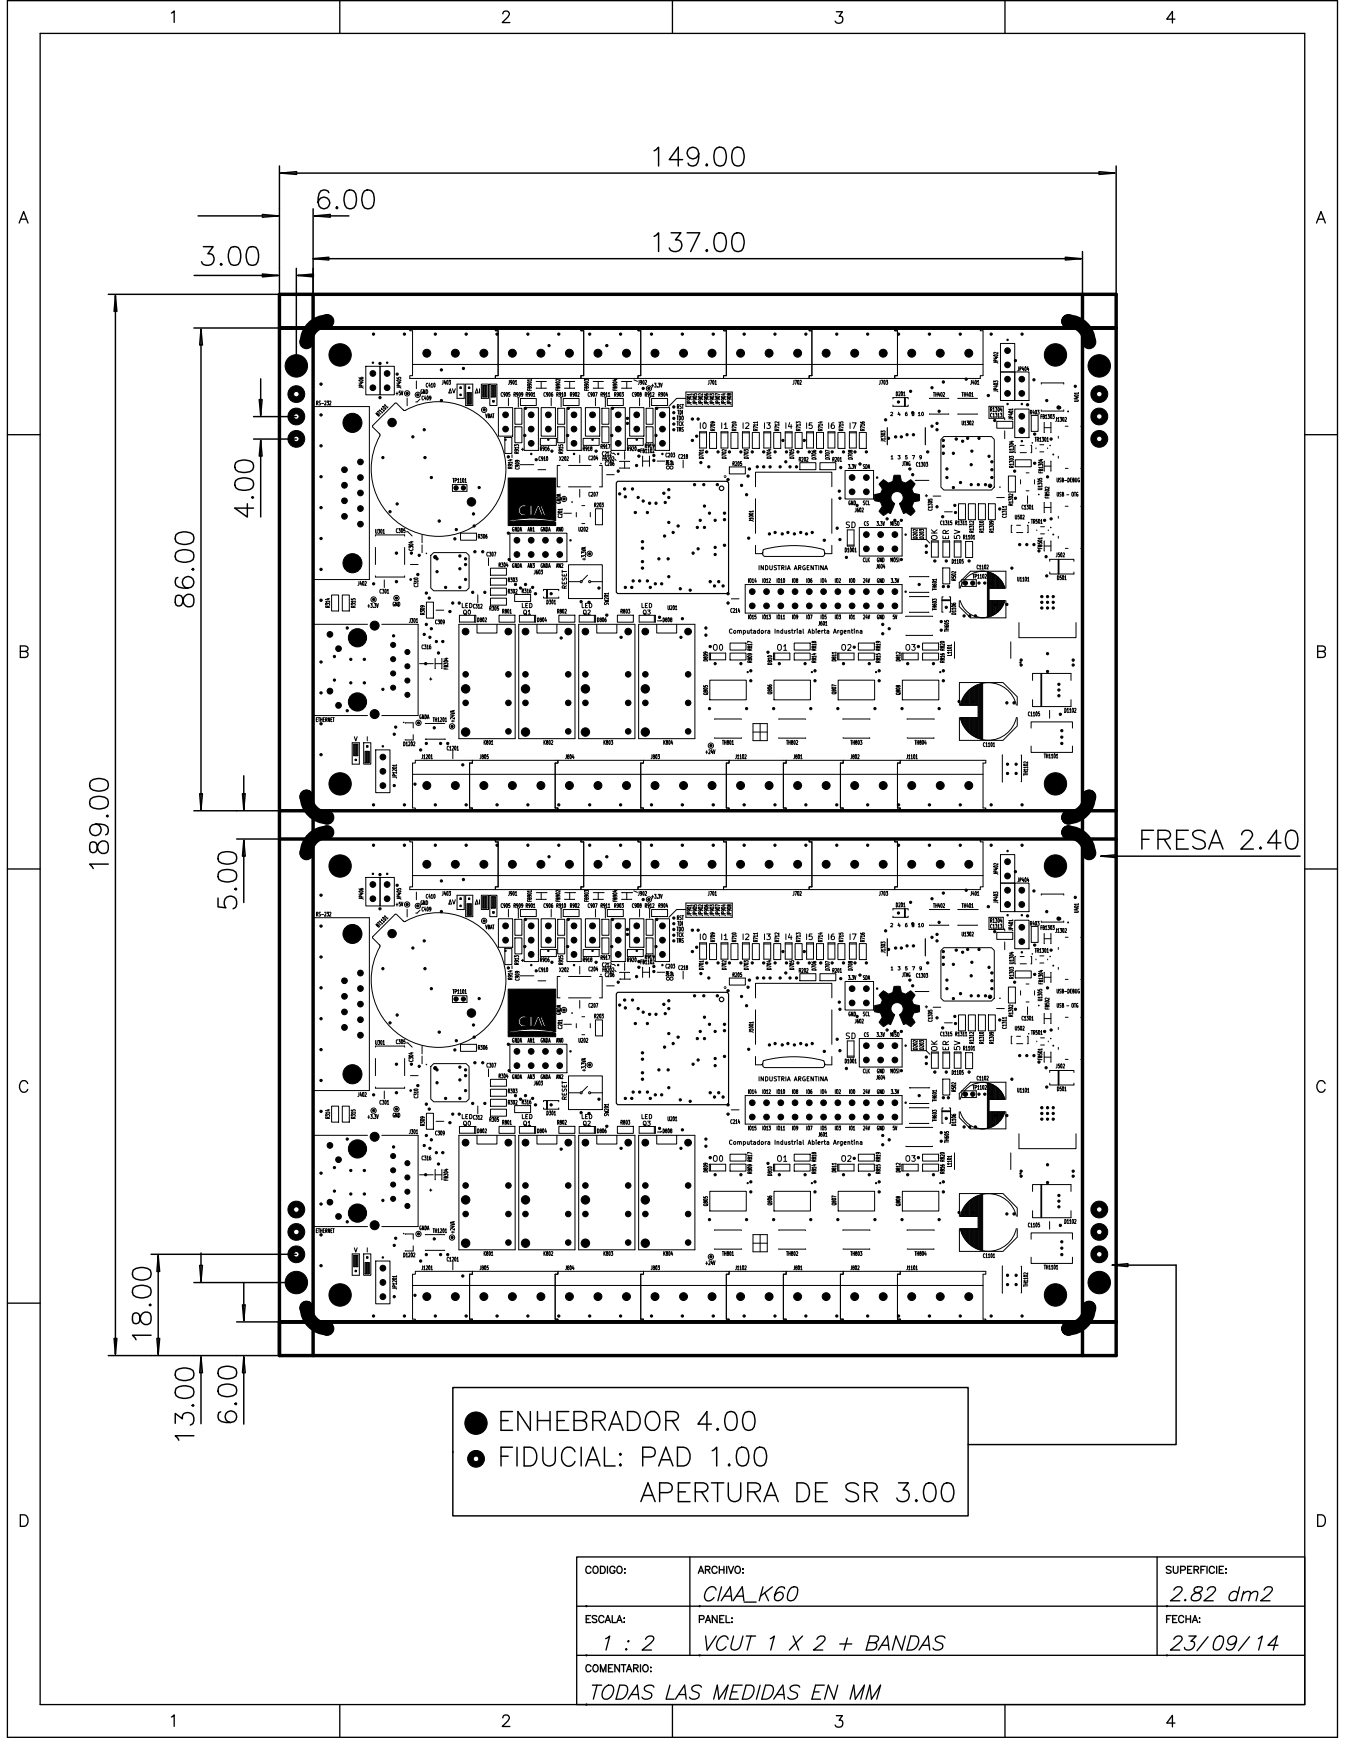
[picture p189: page 1]
