ciaa/Hardware/PCB/FSL/CIAA_K60/doc/fabricacion/panelizado/CUPONES_OPC1.pdf

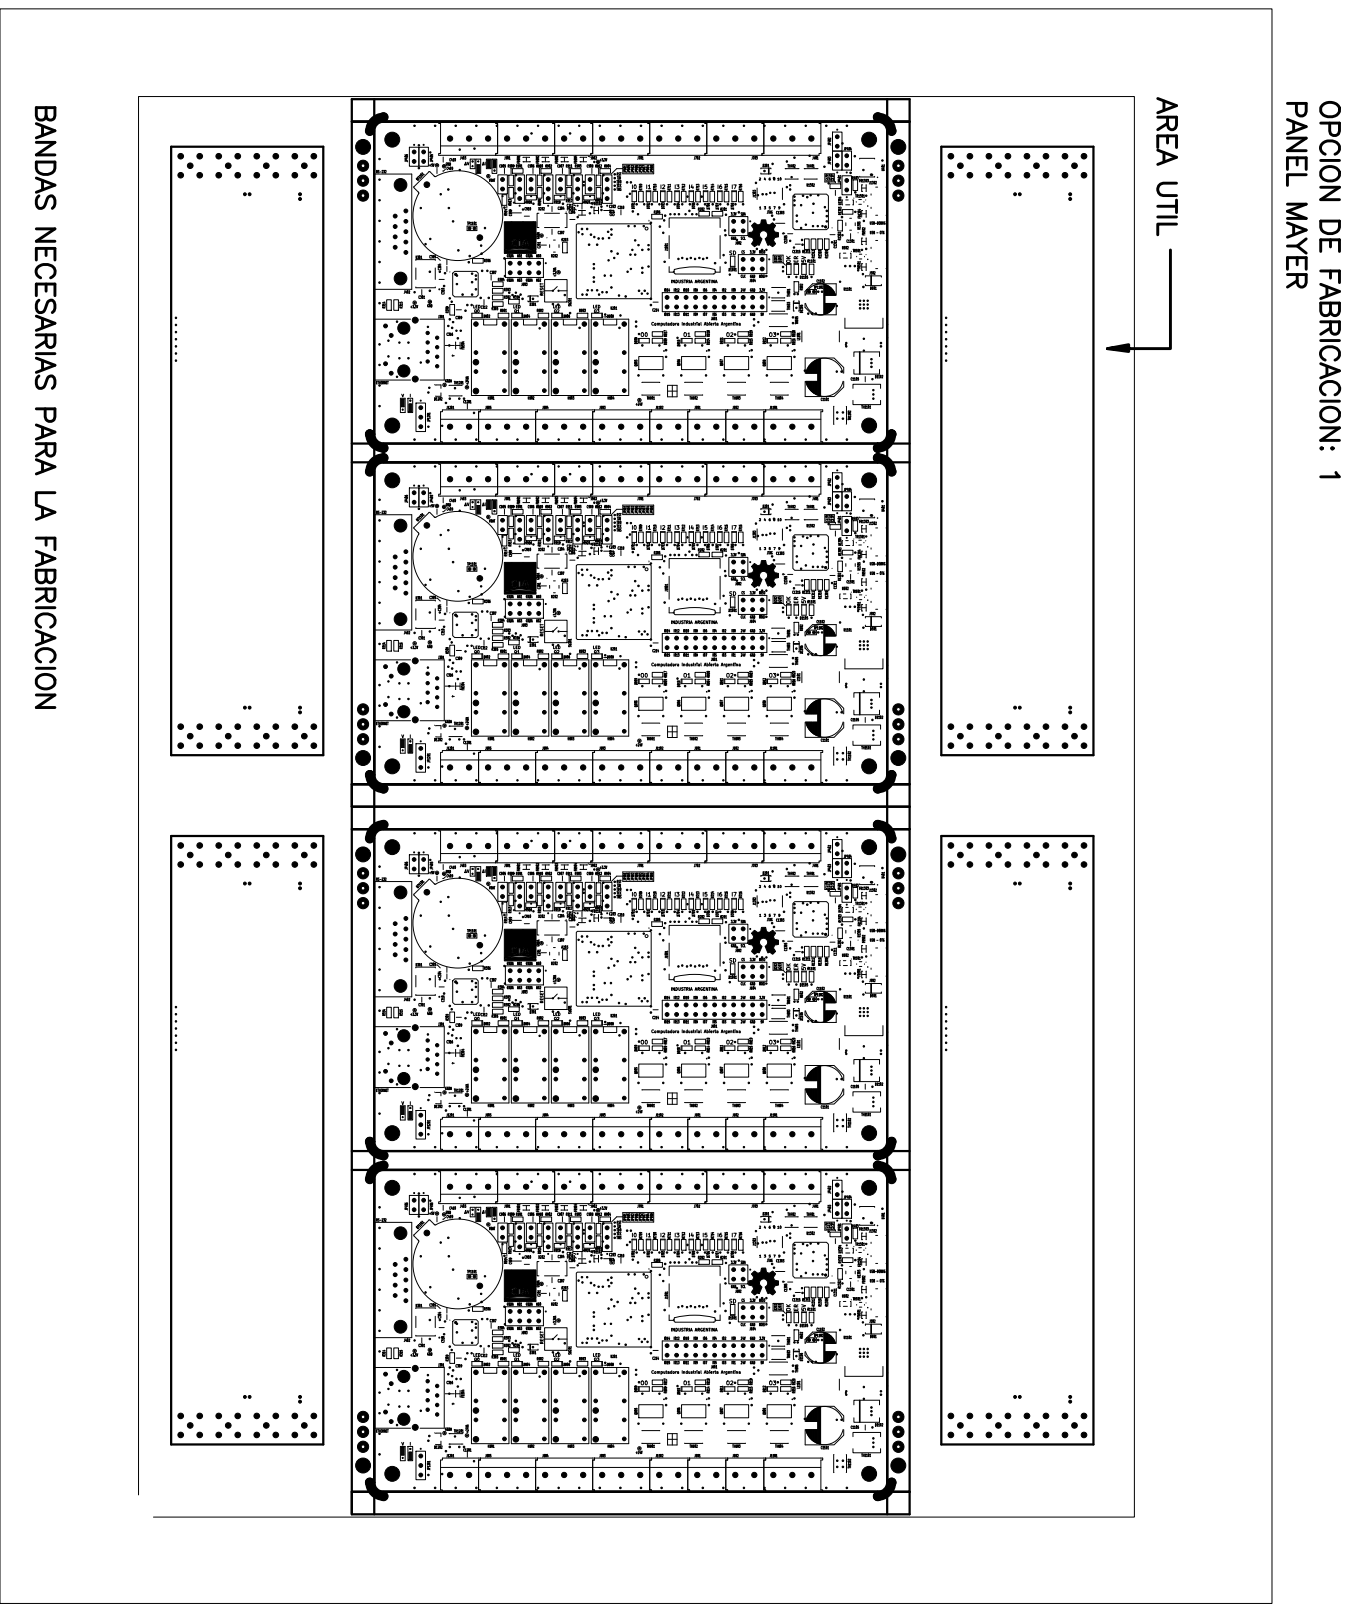
[picture p190: page 1]
