ciaa/Hardware/PCB/FSL/CIAA_K60/doc/fabricacion/panelizado/CUPONES_OPC2_opcion_elegida.pdf

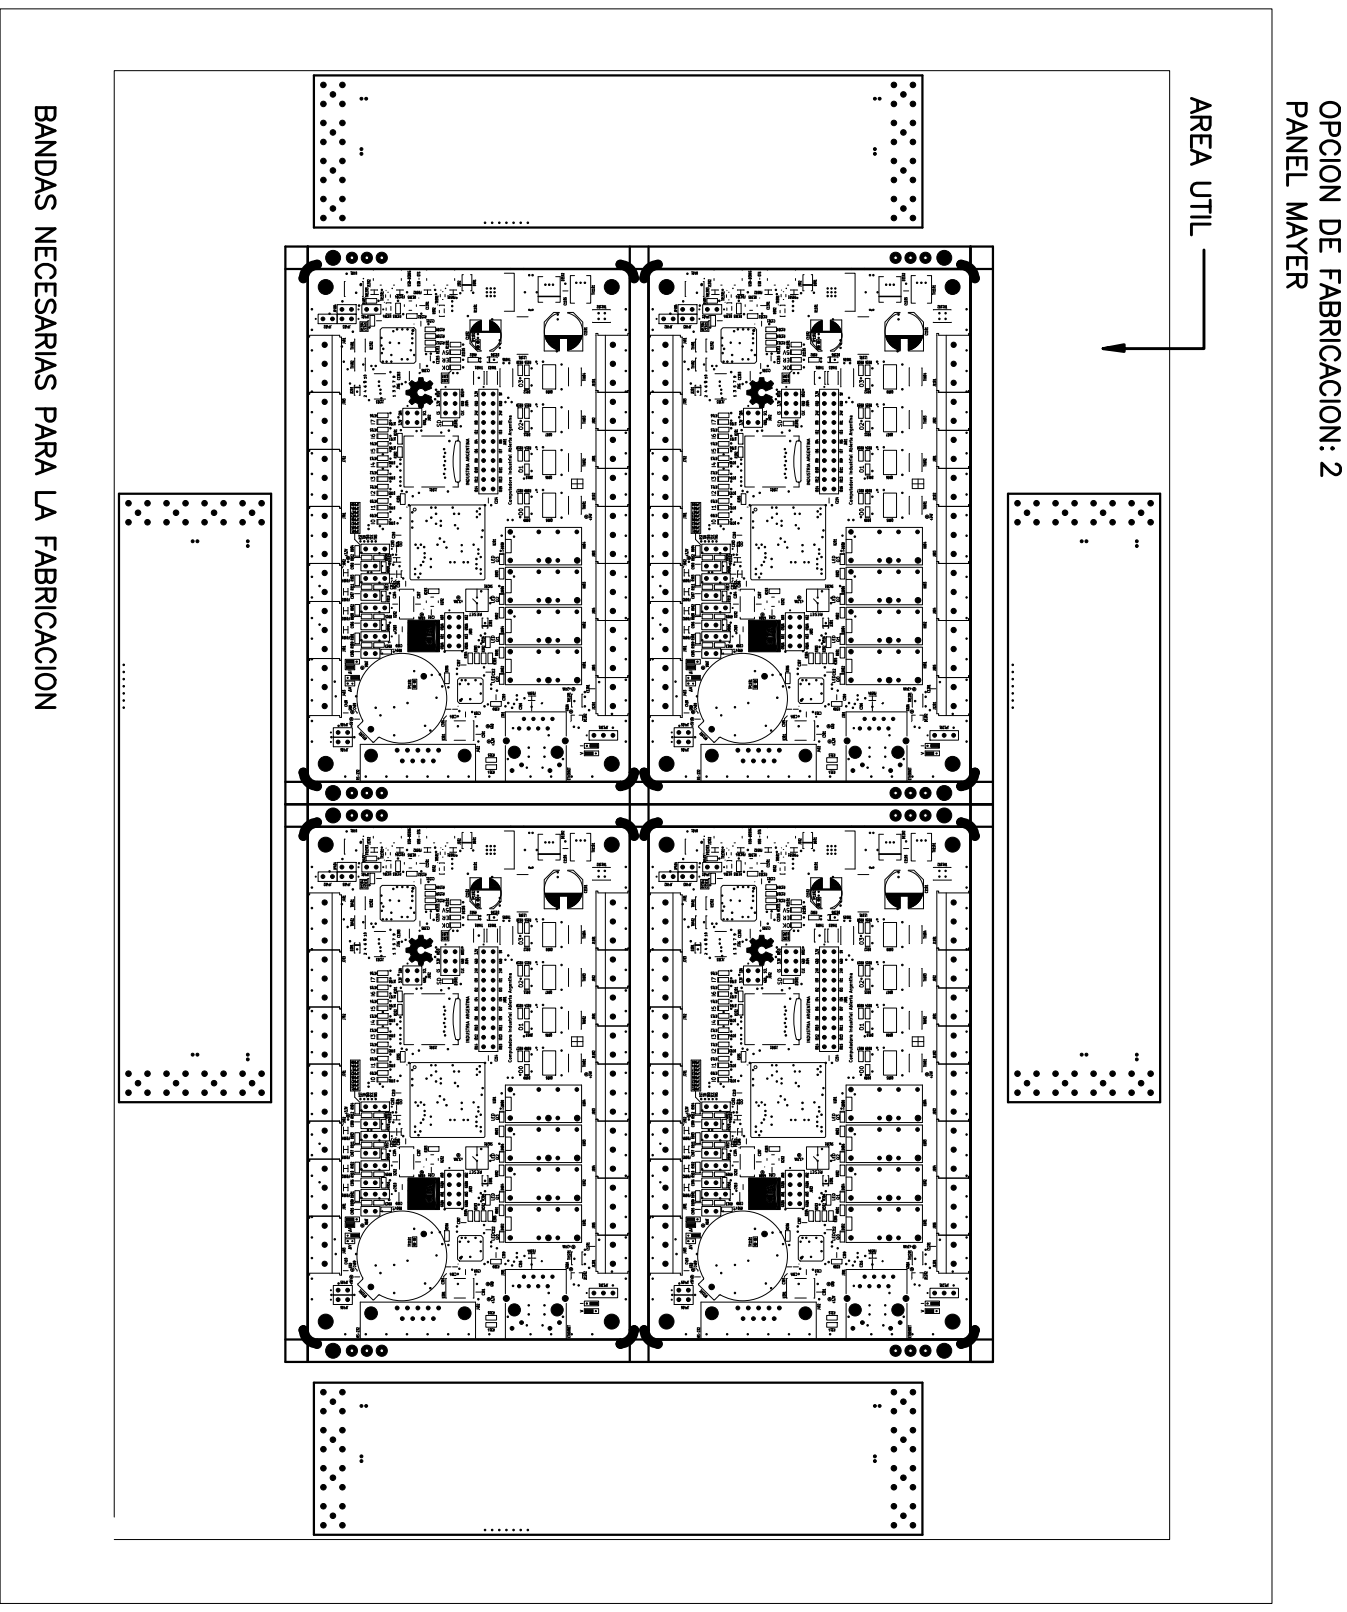
[picture p191: page 1]
