ciaa/Hardware/PCB/FSL/CIAA_K60/doc/fabricacion/panelizado/Numeracion_cupones.pdf

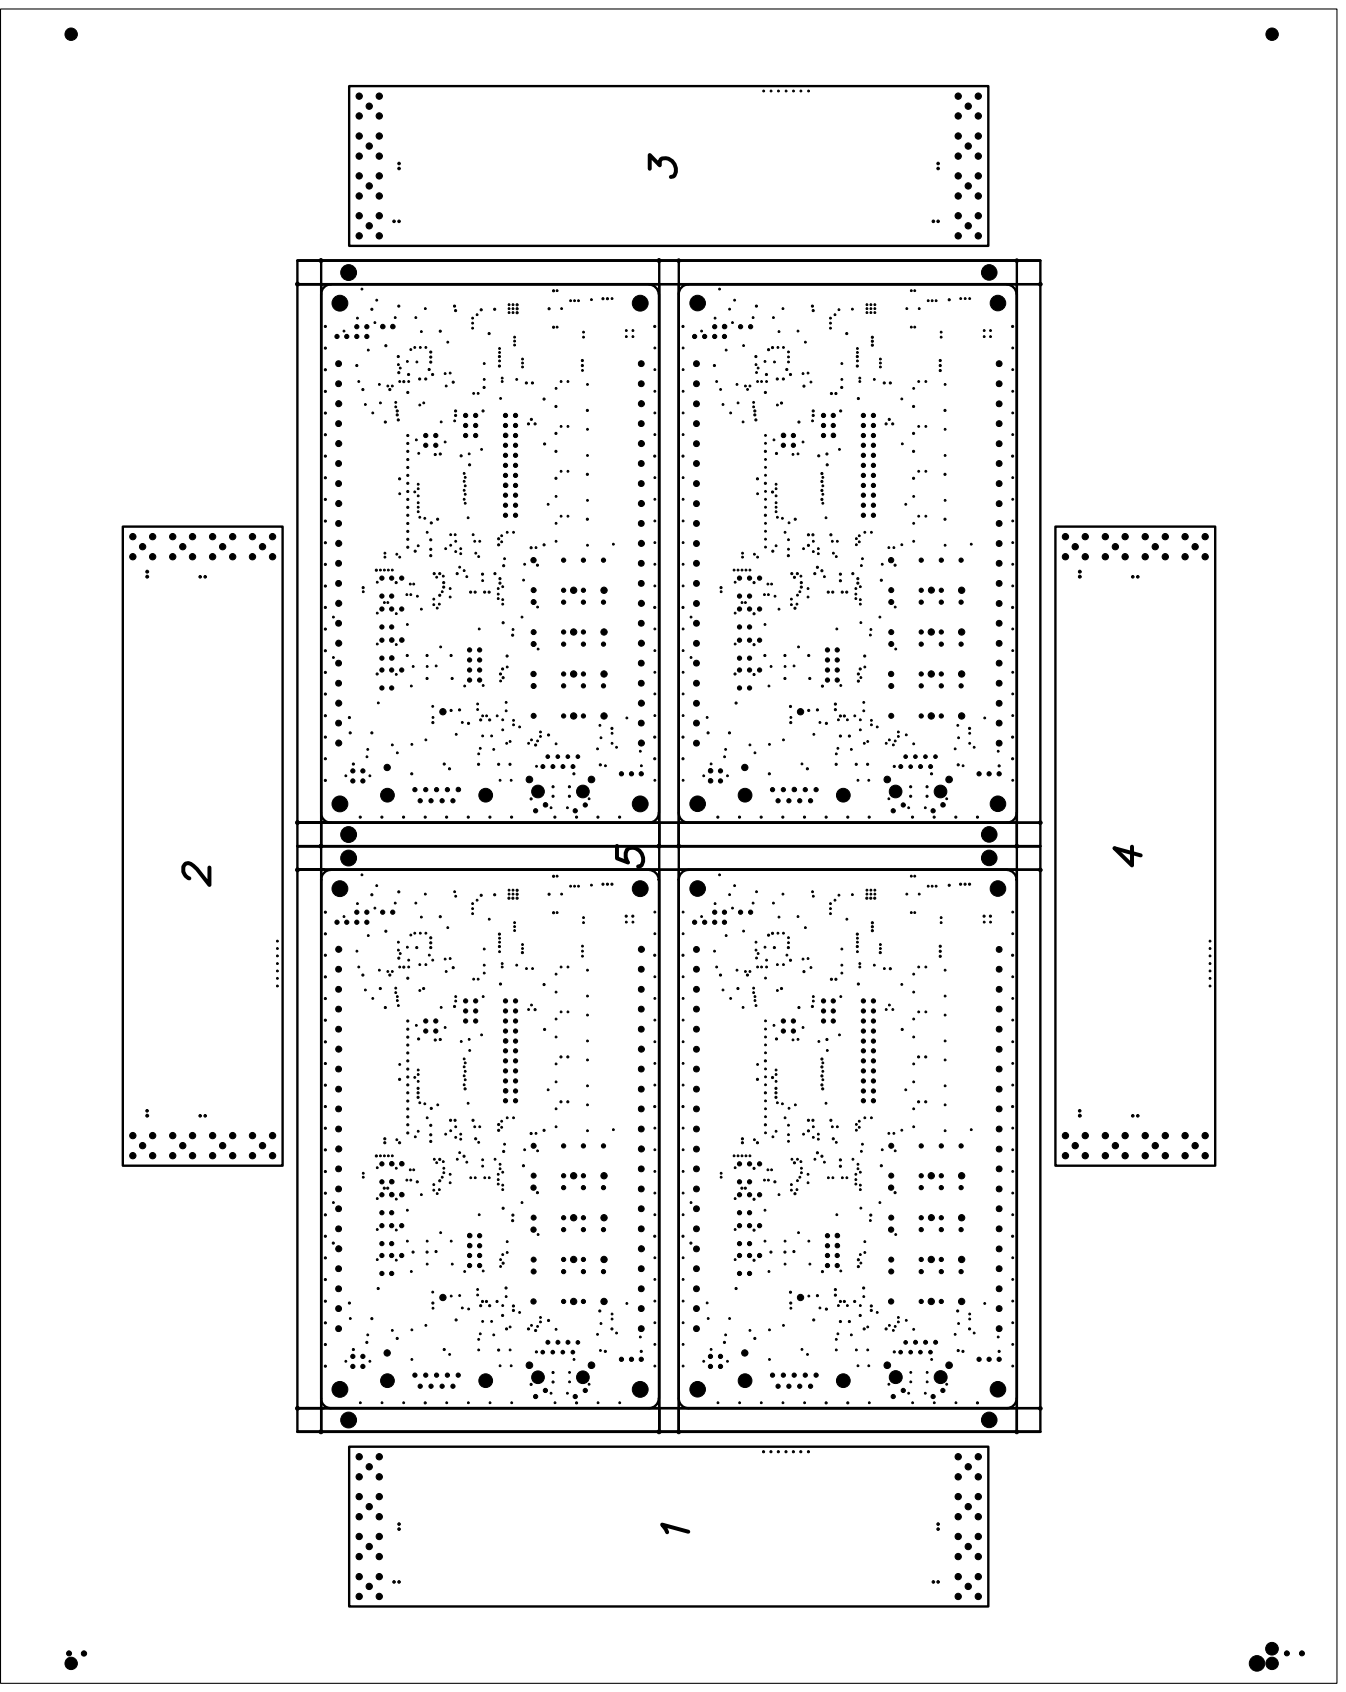
[picture p192: page 1]
