ciaa/Hardware/PCB/Z3R0/ciaa-z3r0.pdf

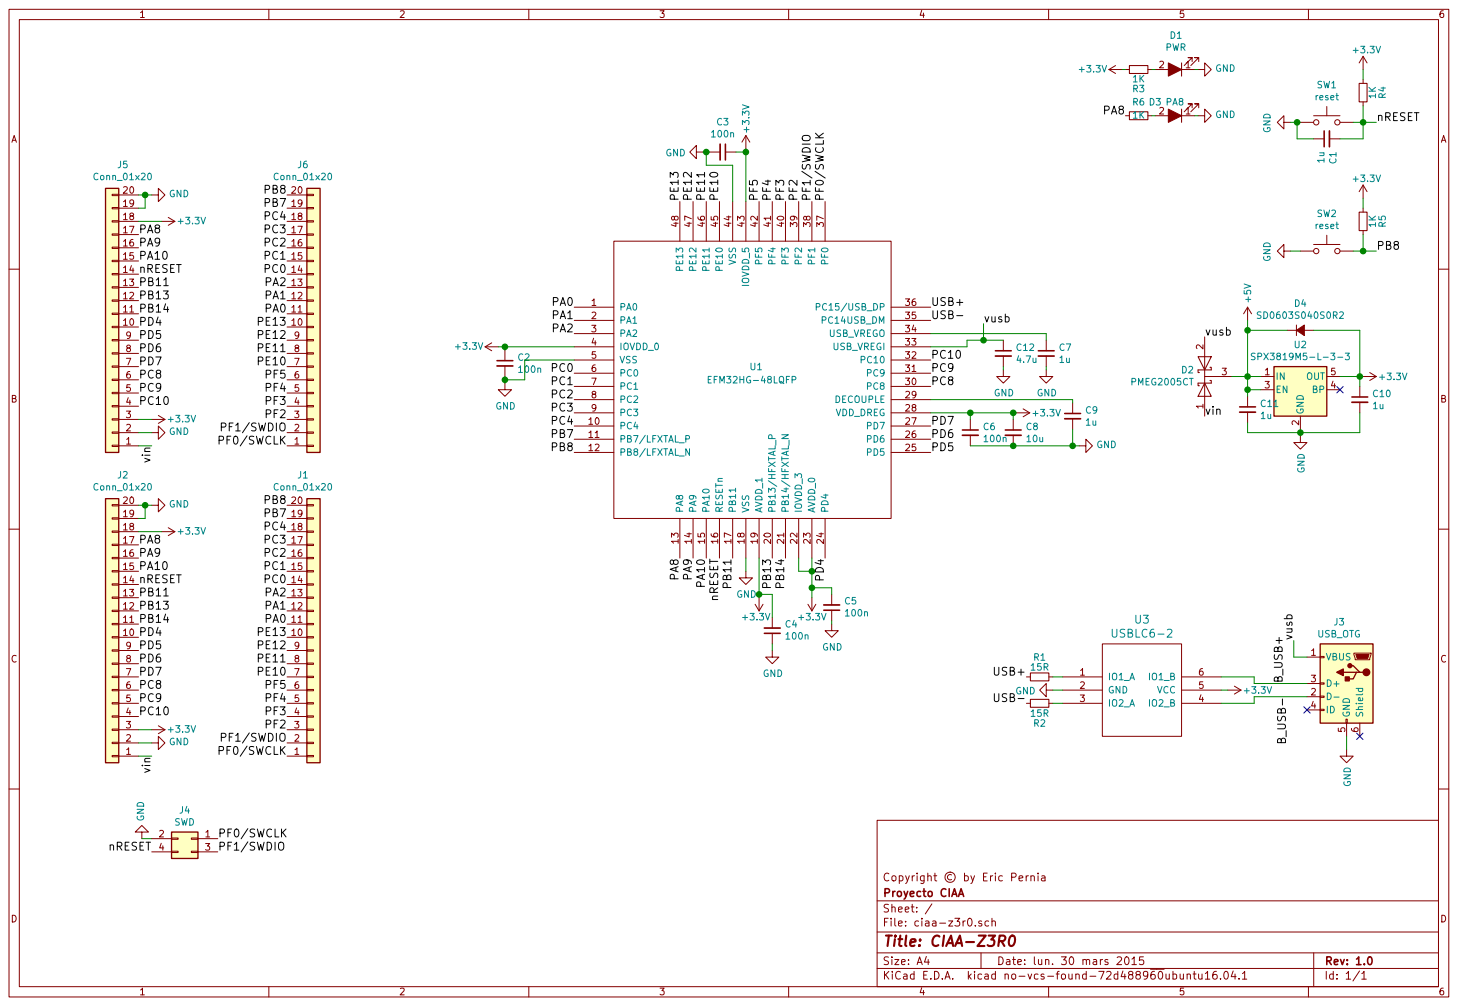
[picture p193: page 1]

Copyright © by Eric Pernia
File: ciaa-z3r0.sch Sheet: / Proyecto CIAA
