ciaa/Hardware/PCB/pico/doc/picociaa.pdf

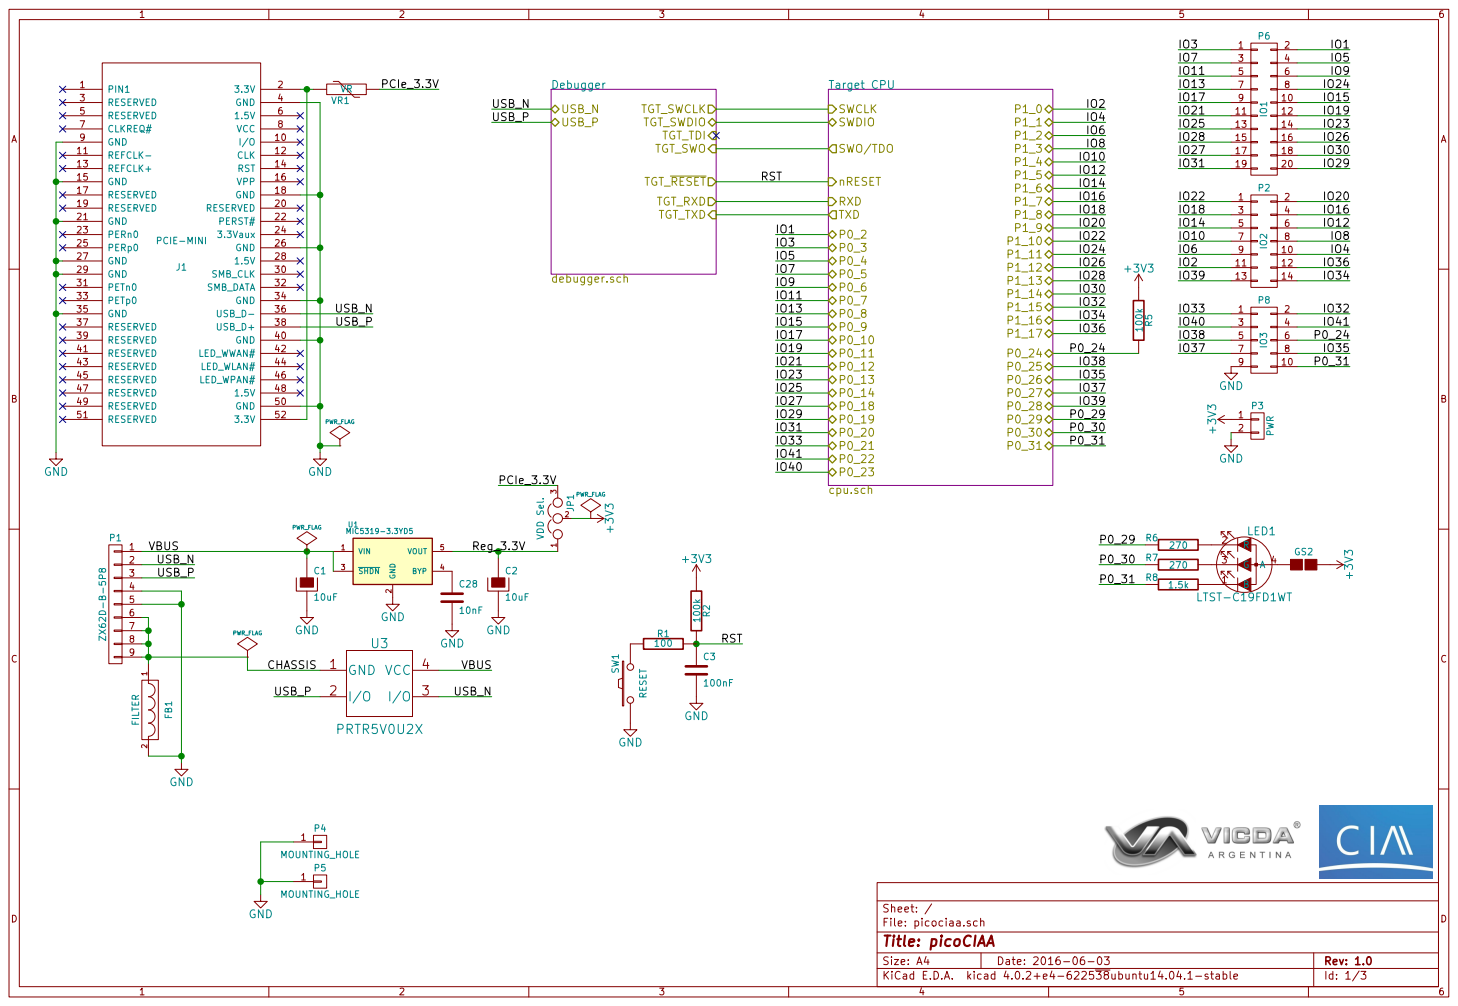
[picture p194: page 1]

File: picociaa.sch Sheet: /
Id: 1/3 Title: picoCIAA

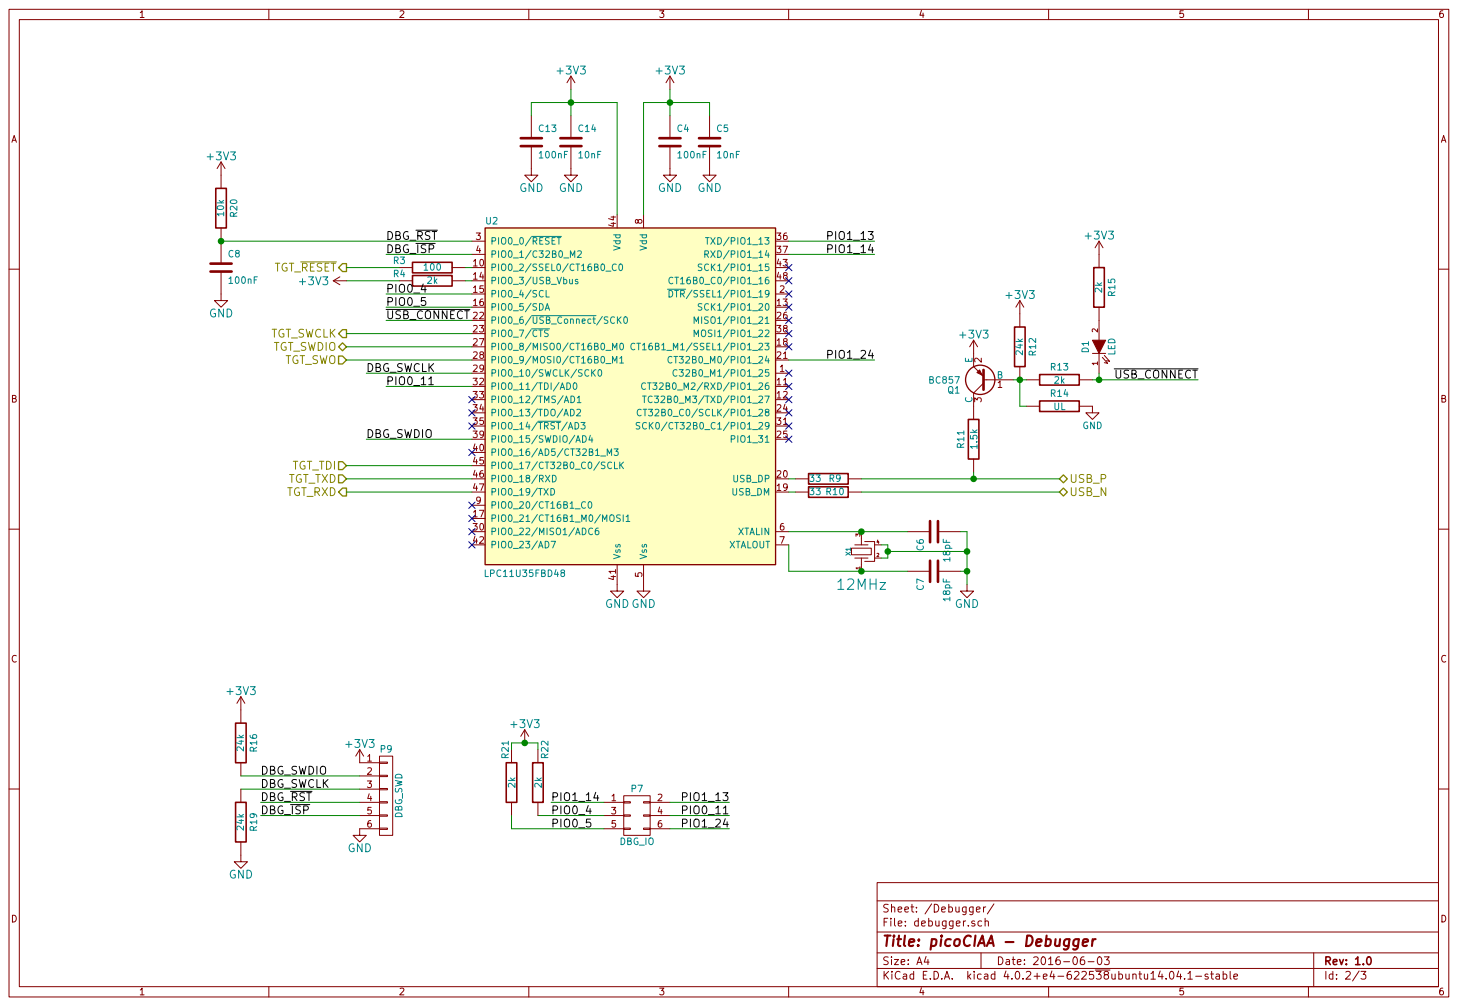
[picture p195: page 2]

8 PIO0_20/CT16B1_C0 9 PIO0_2/SSEL0/CT16B0_C0 10 USB_DP 20 PIO0_22/MISO1/ADC6 30 PIO0_16/AD5/CT32B1_M3 40 CT32B0_M2/RXD/PIO1_26 11 CT32B0_M0/PIO1_24 21 SCK0/CT32B0_C1/PIO1_29 31 Vss 41 TC32B0_M3/TXD/PIO1_27 12 PIO0_6/USB_Connect/SCK0 22 PIO0_11/TDI/AD0 32 PIO0_23/AD7 42 SCK1/PIO1_20 13 PIO0_7/CTS 23 PIO0_12/TMS/AD1 33 SCK1/PIO1_15 43 PIO0_3/USB_Vbus 14 CT32B0_C0/SCLK/PIO1_28 24 PIO0_13/TDO/AD2 34 Vdd 44 PIO0_4/SCL 15 PIO1_31 25 PIO0_14/TRST/AD3 35 PIO0_17/CT32B0_C0/SCLK 45 PIO0_5/SDA 16 MISO1/PIO1_21 26 TXD/PIO1_13 36 PIO0_18/RXD 46 PIO0_21/CT16B1_M0/MOSI1 17 PIO0_8/MISO0/CT16B0_M0 27 RXD/PIO1_14 37 PIO0_19/TXD 47 CT16B1_M1/SSEL1/PIO1_23 18 PIO0_9/MOSI0/CT16B0_M1 28 MOSI1/PIO1_22 38 CT16B0_C0/PIO1_16 48 USB_DM 19 PIO0_10/SWCLK/SCK0 29 PIO0_15/SWDIO/AD4 39 U2

Sheet: /Debugger/
File: debugger.sch
Id: 2/3 Title: picoCIAA - Debugger

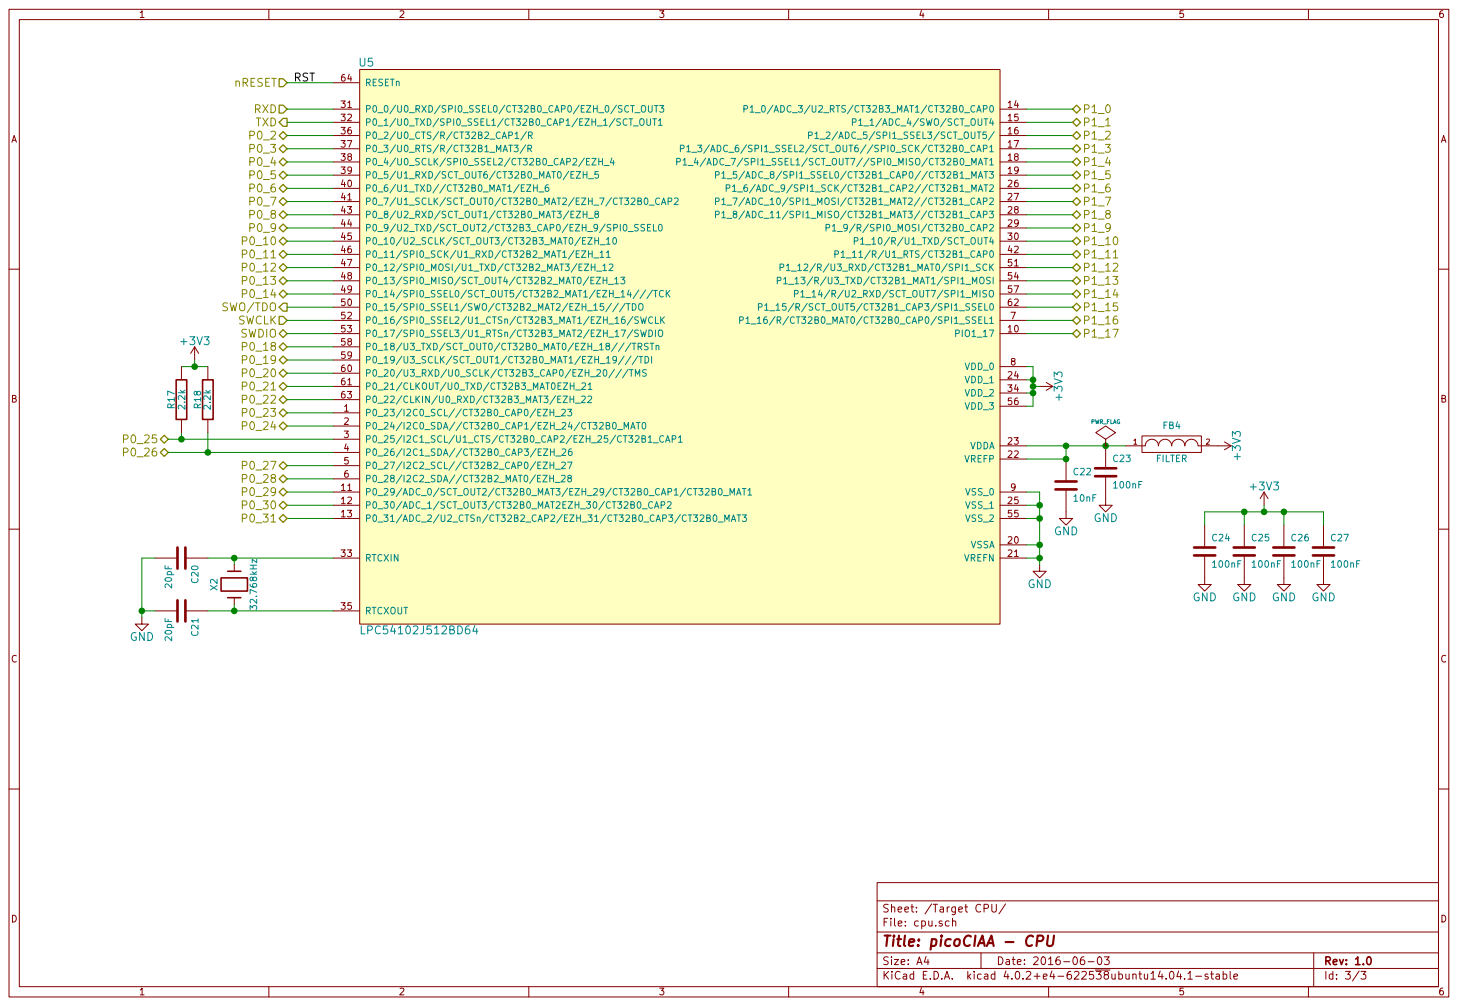
[picture p196: page 3]

Sheet: /Target CPU/
File: cpu.sch
Id: 3/3 Title: picoCIAA - CPU
