ciaa/Hardware/PCB/EDU-NXP/Doc/dimensiones.pdf

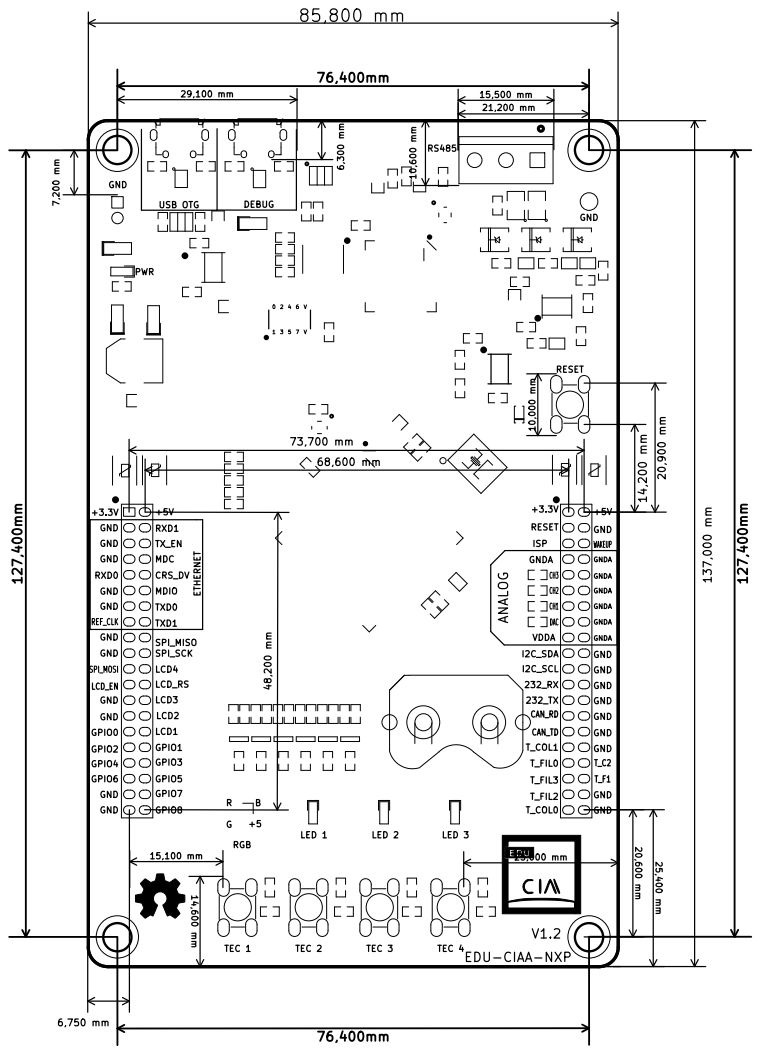
[picture p197: page 1]

RXD0 | TX_EN SPI_MISO ETHERNET REF_CLK TXD1 TXD0 MDIO CRS_DV MDC

LCD4 SPI_SCK
