ciaa/Hardware/PCB/EDU-NXP/Doc/PCB.pdf

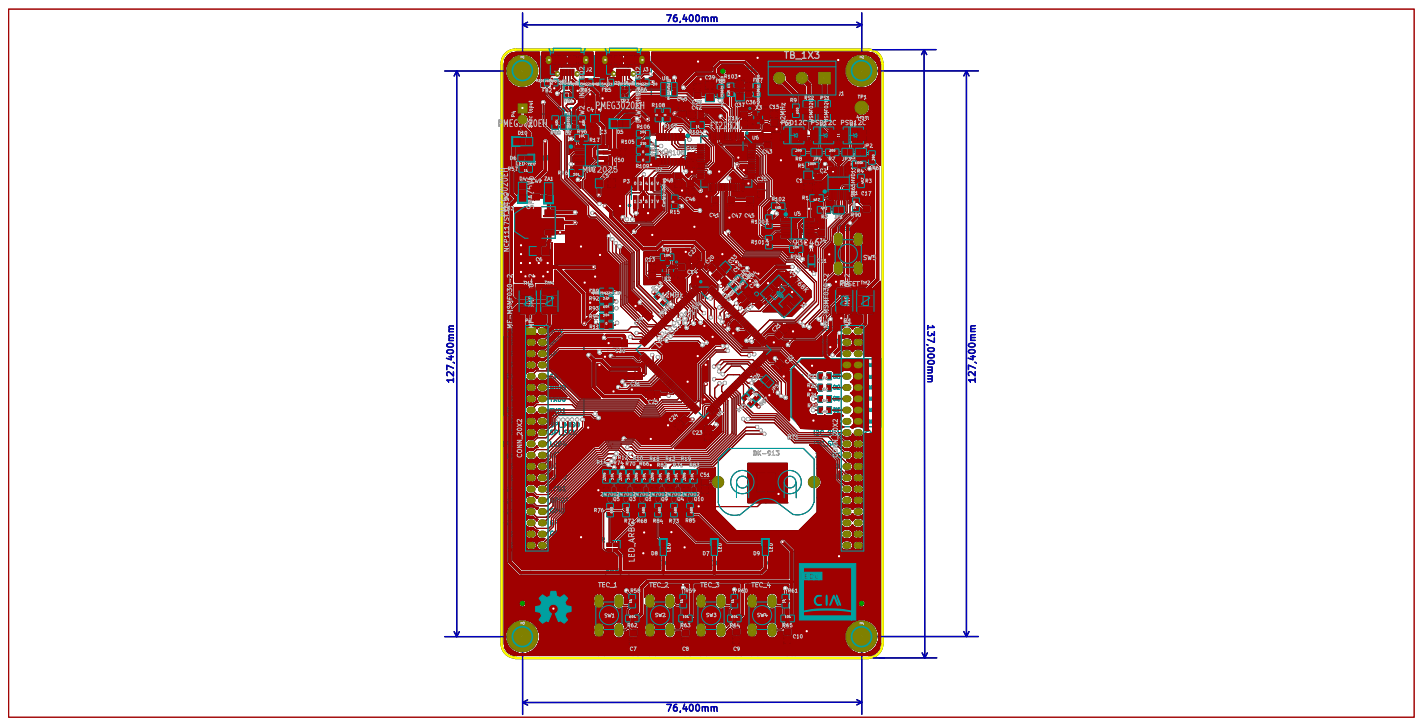
[picture p198: page 1]
