ciaa/Hardware/PCB/EDU-FSL/EDU_CIAA_K60/doc/EDU_CIAA_K60.pdf

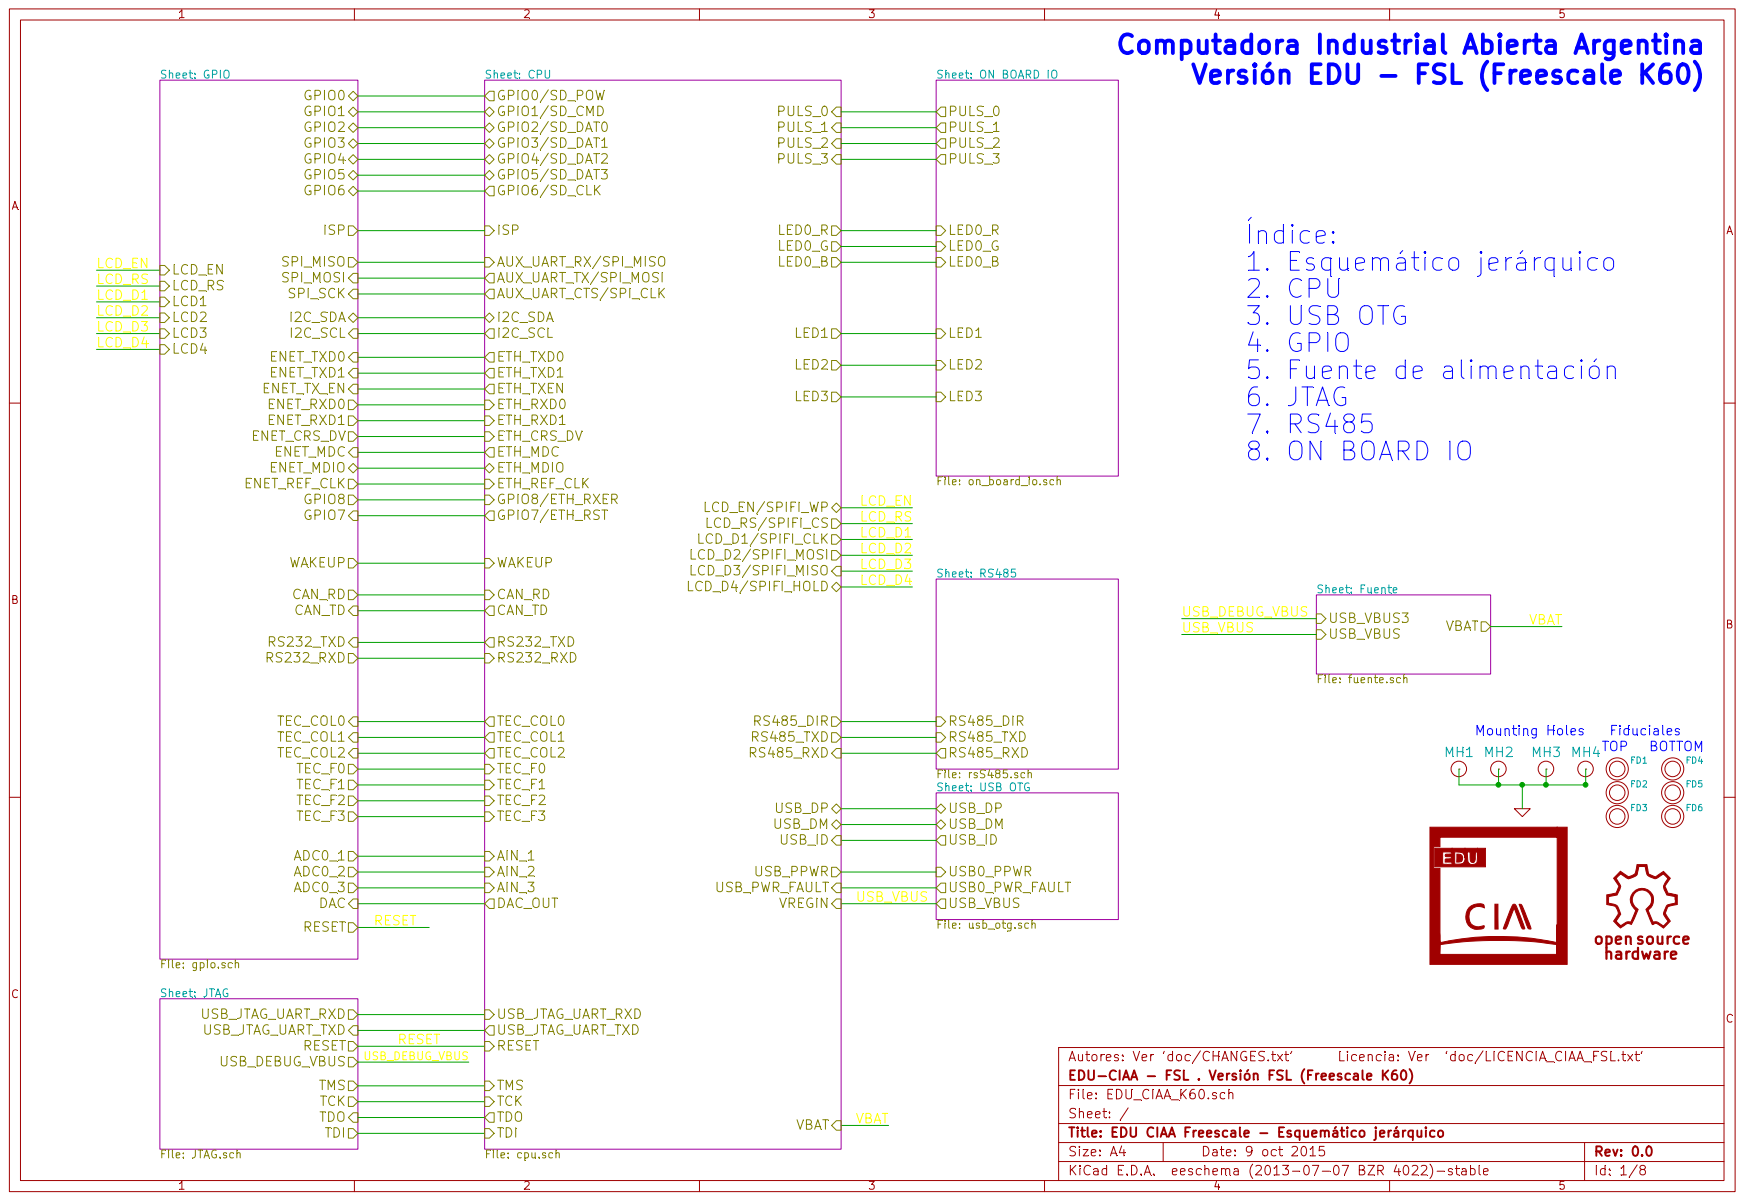
[picture p199: page 1]

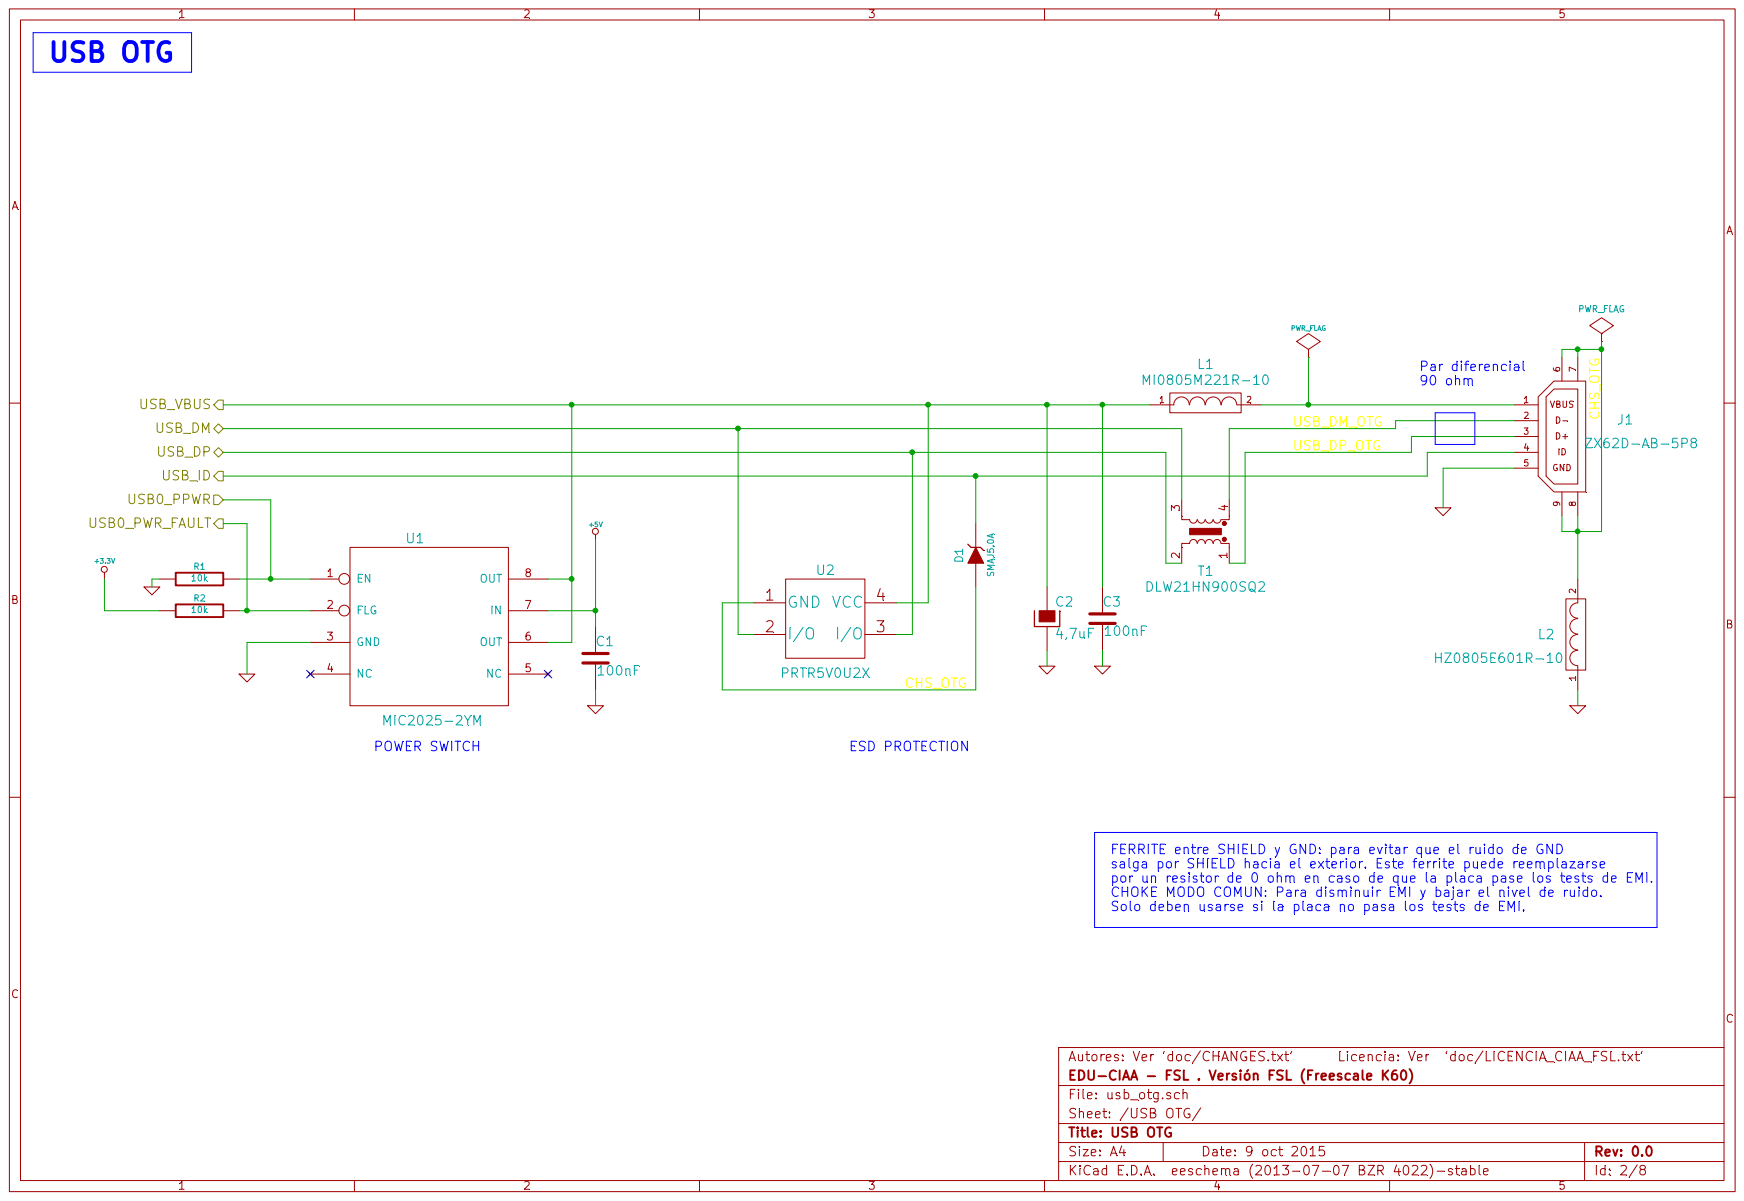
[picture p200: page 2]

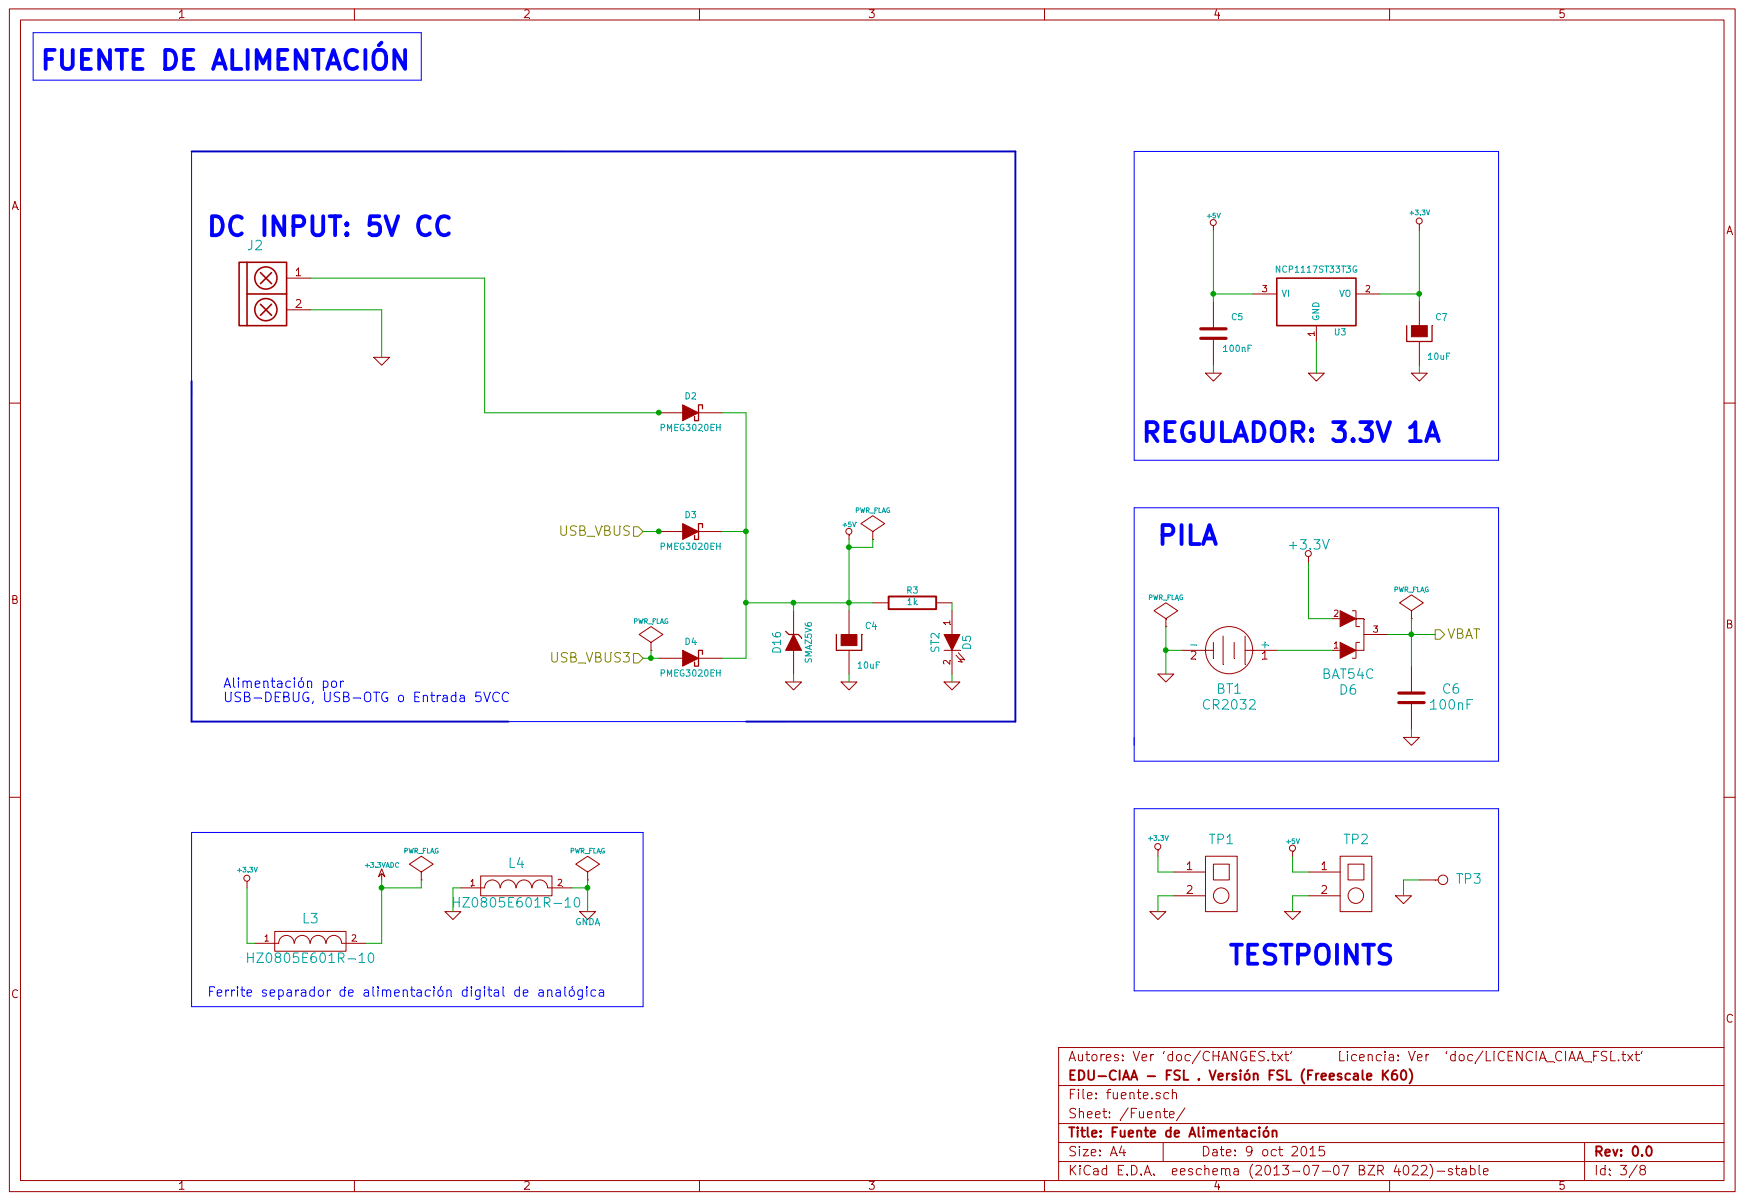
[picture p201: page 3]

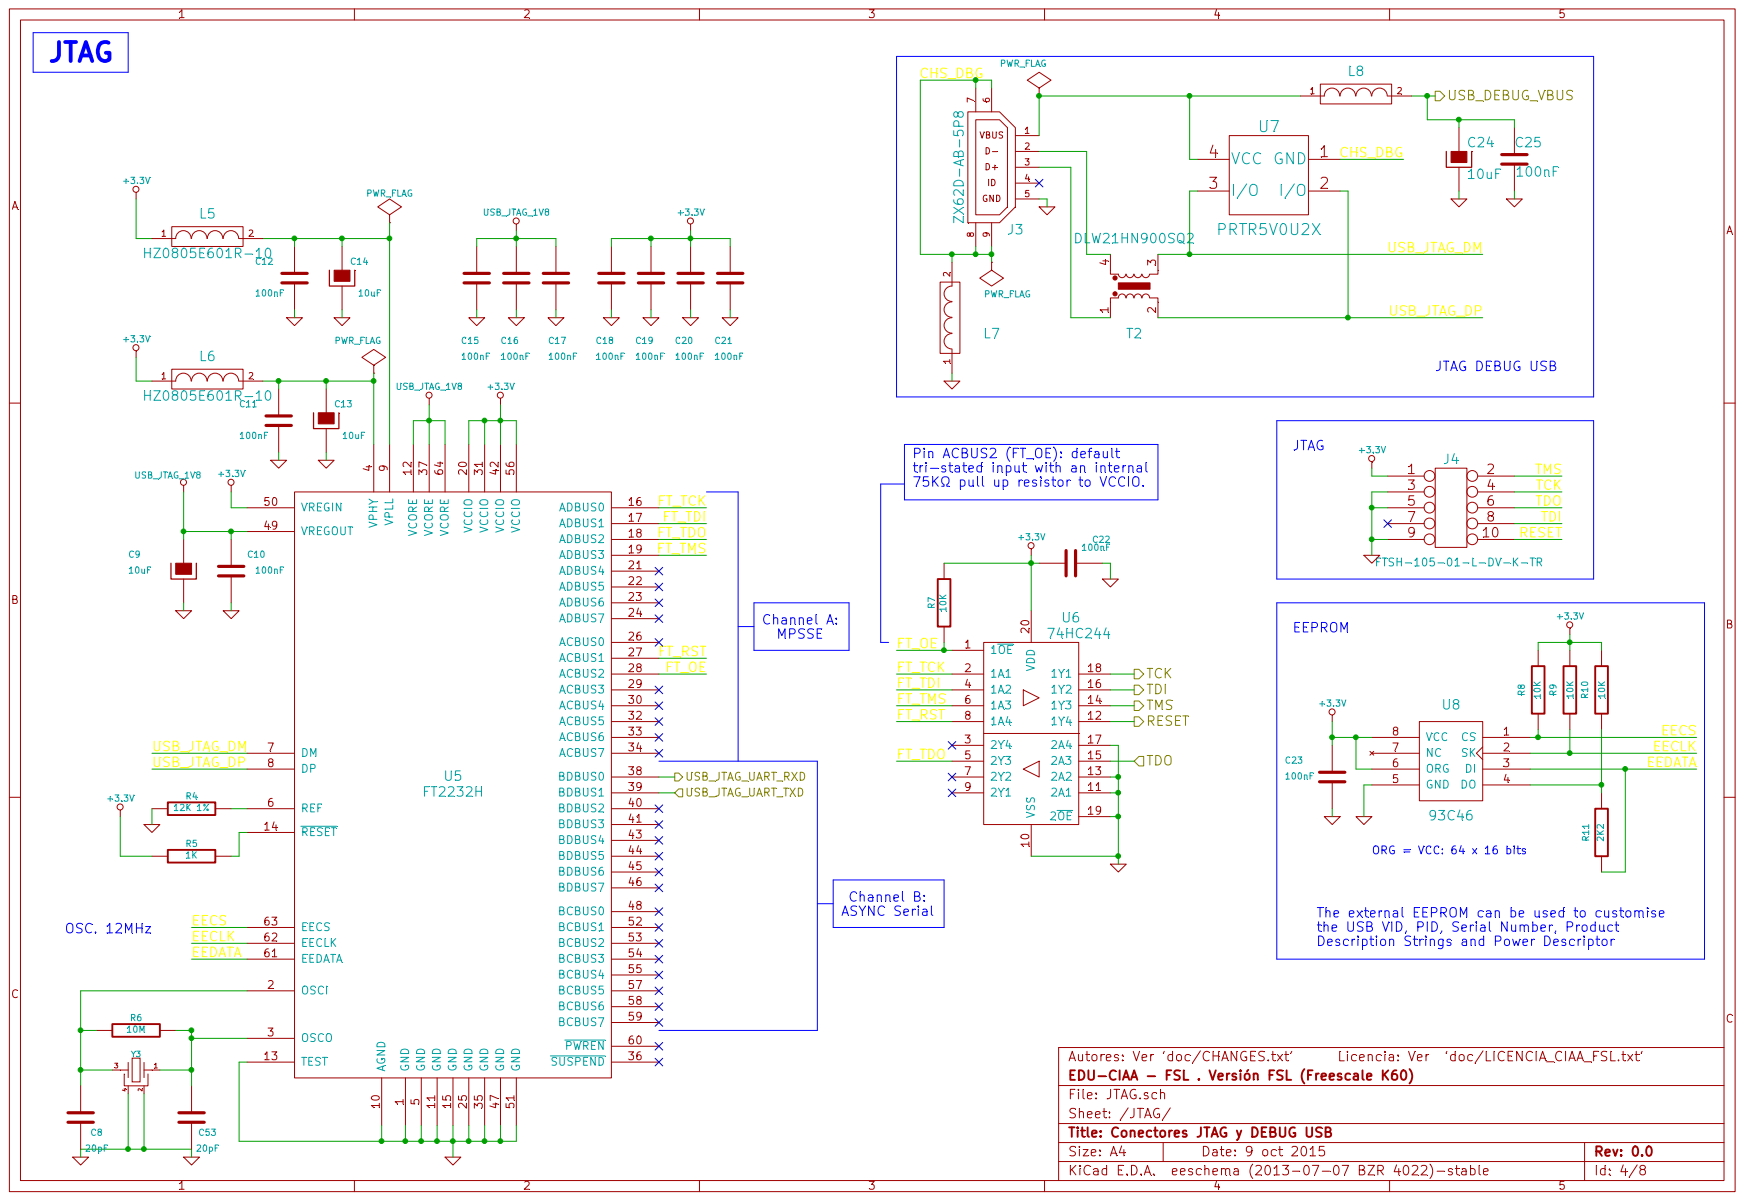
[picture p202: page 4]

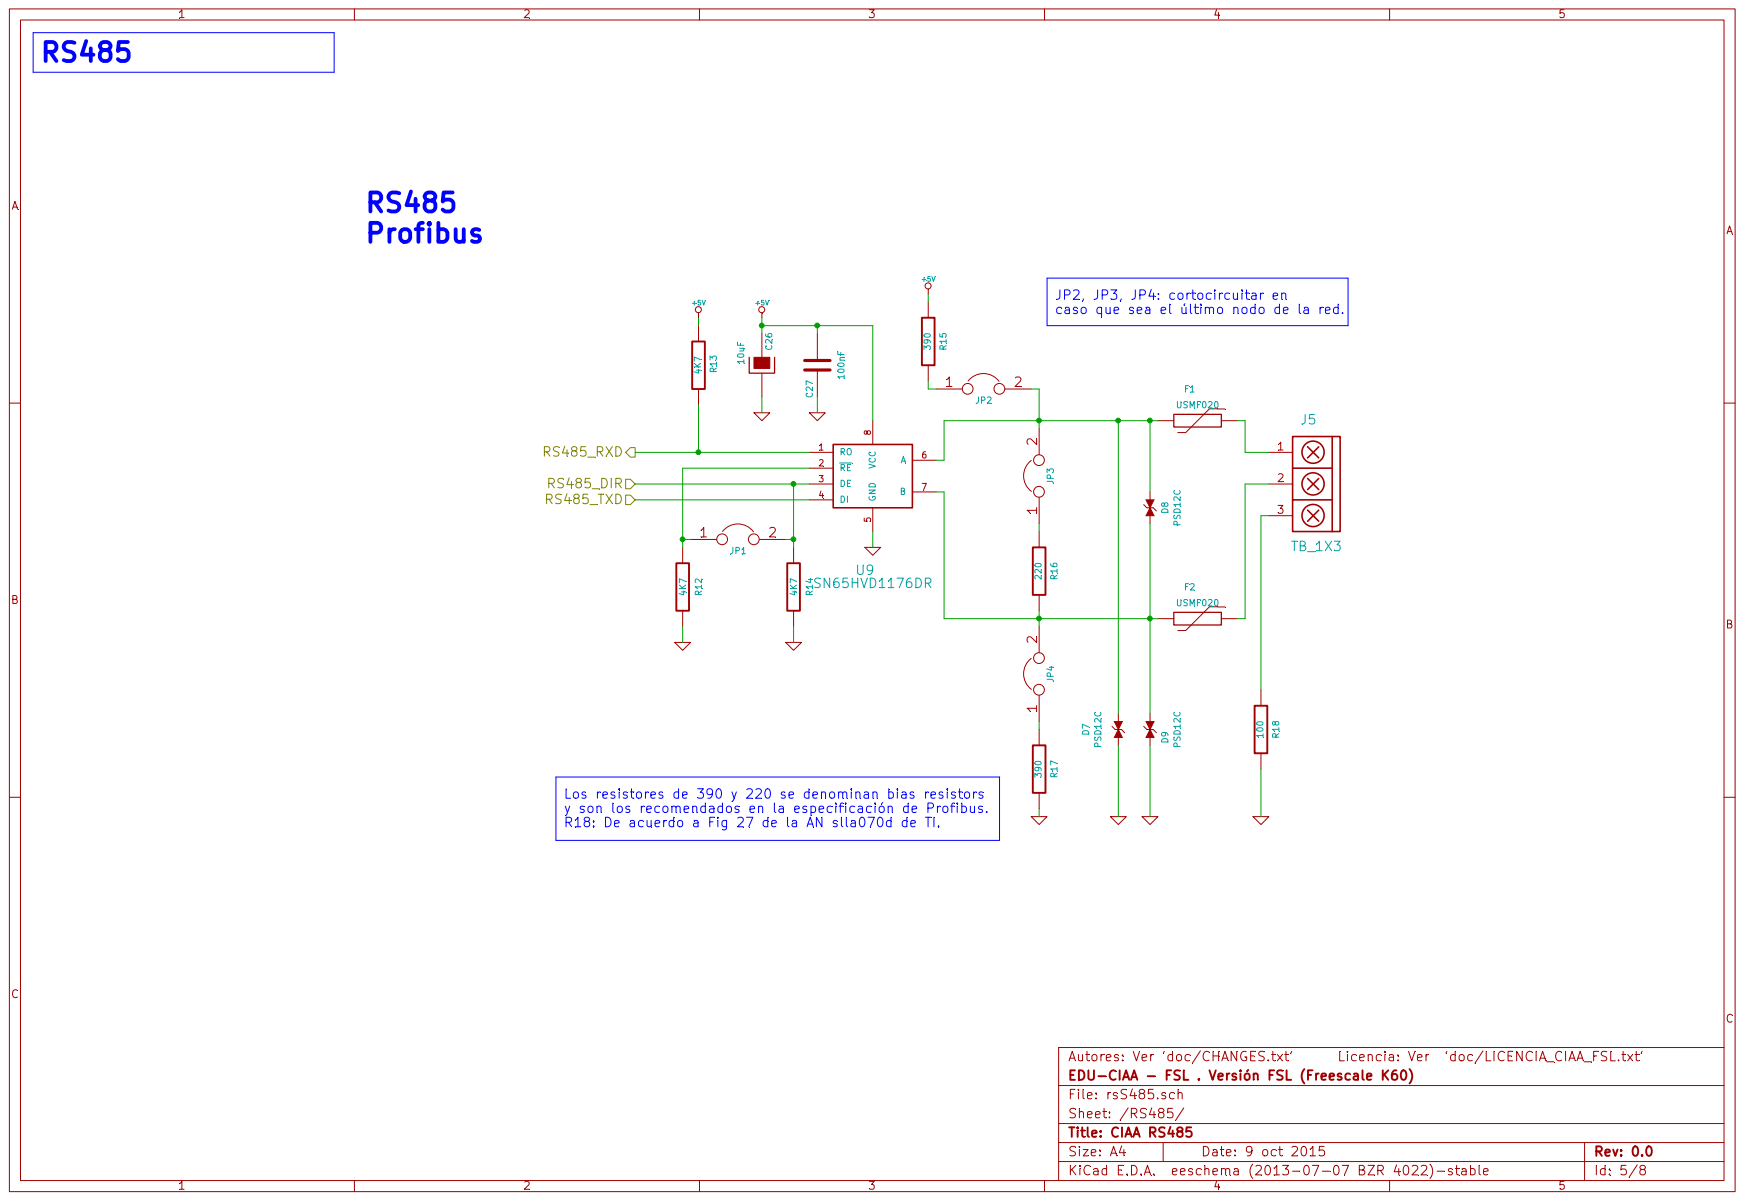
[picture p203: page 5]

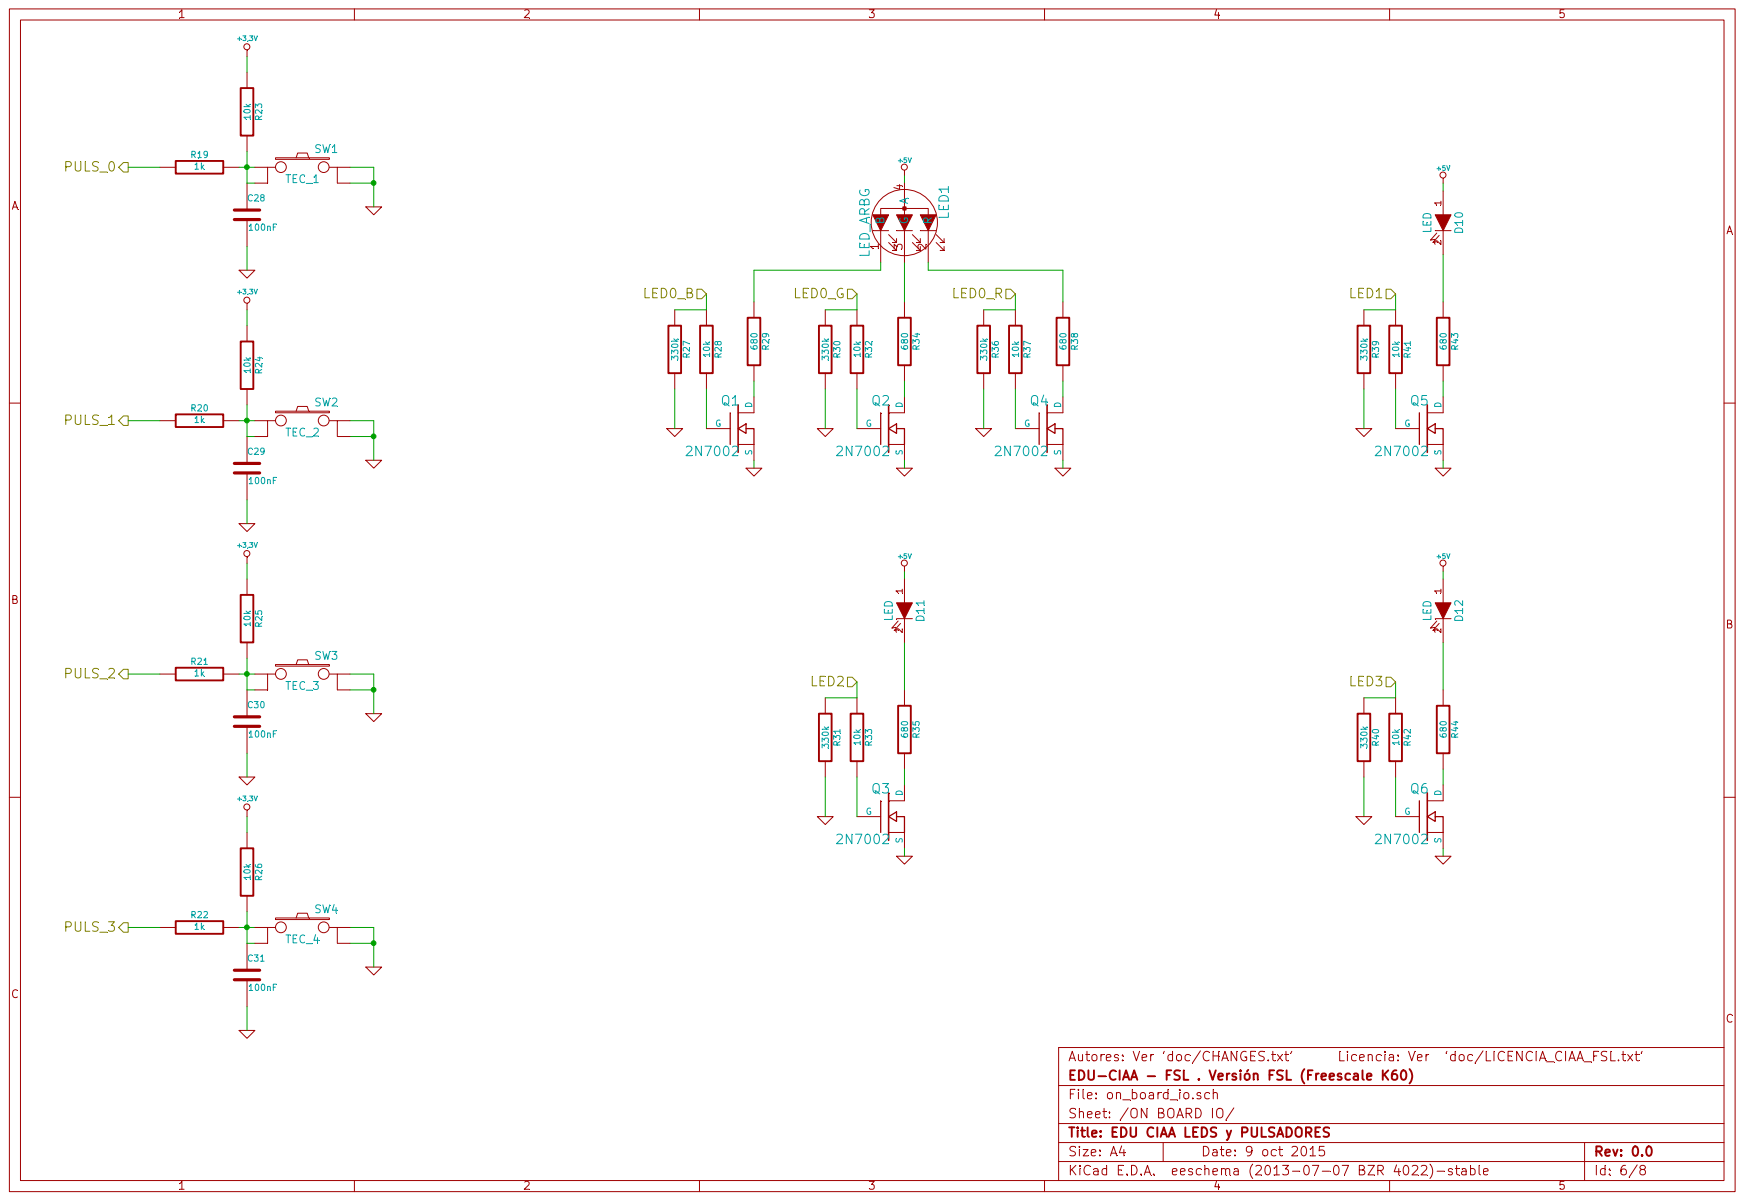
[picture p204: page 6]

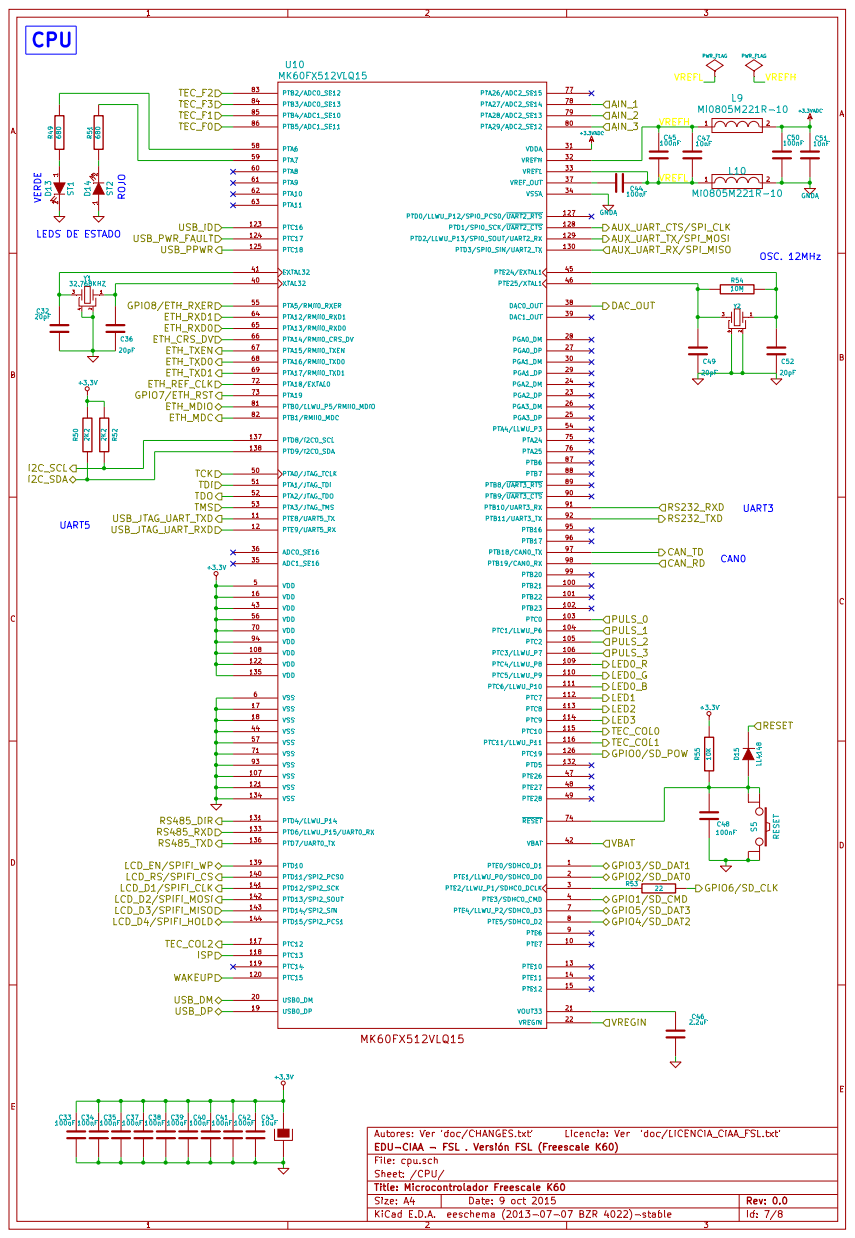
[picture p205: page 7]

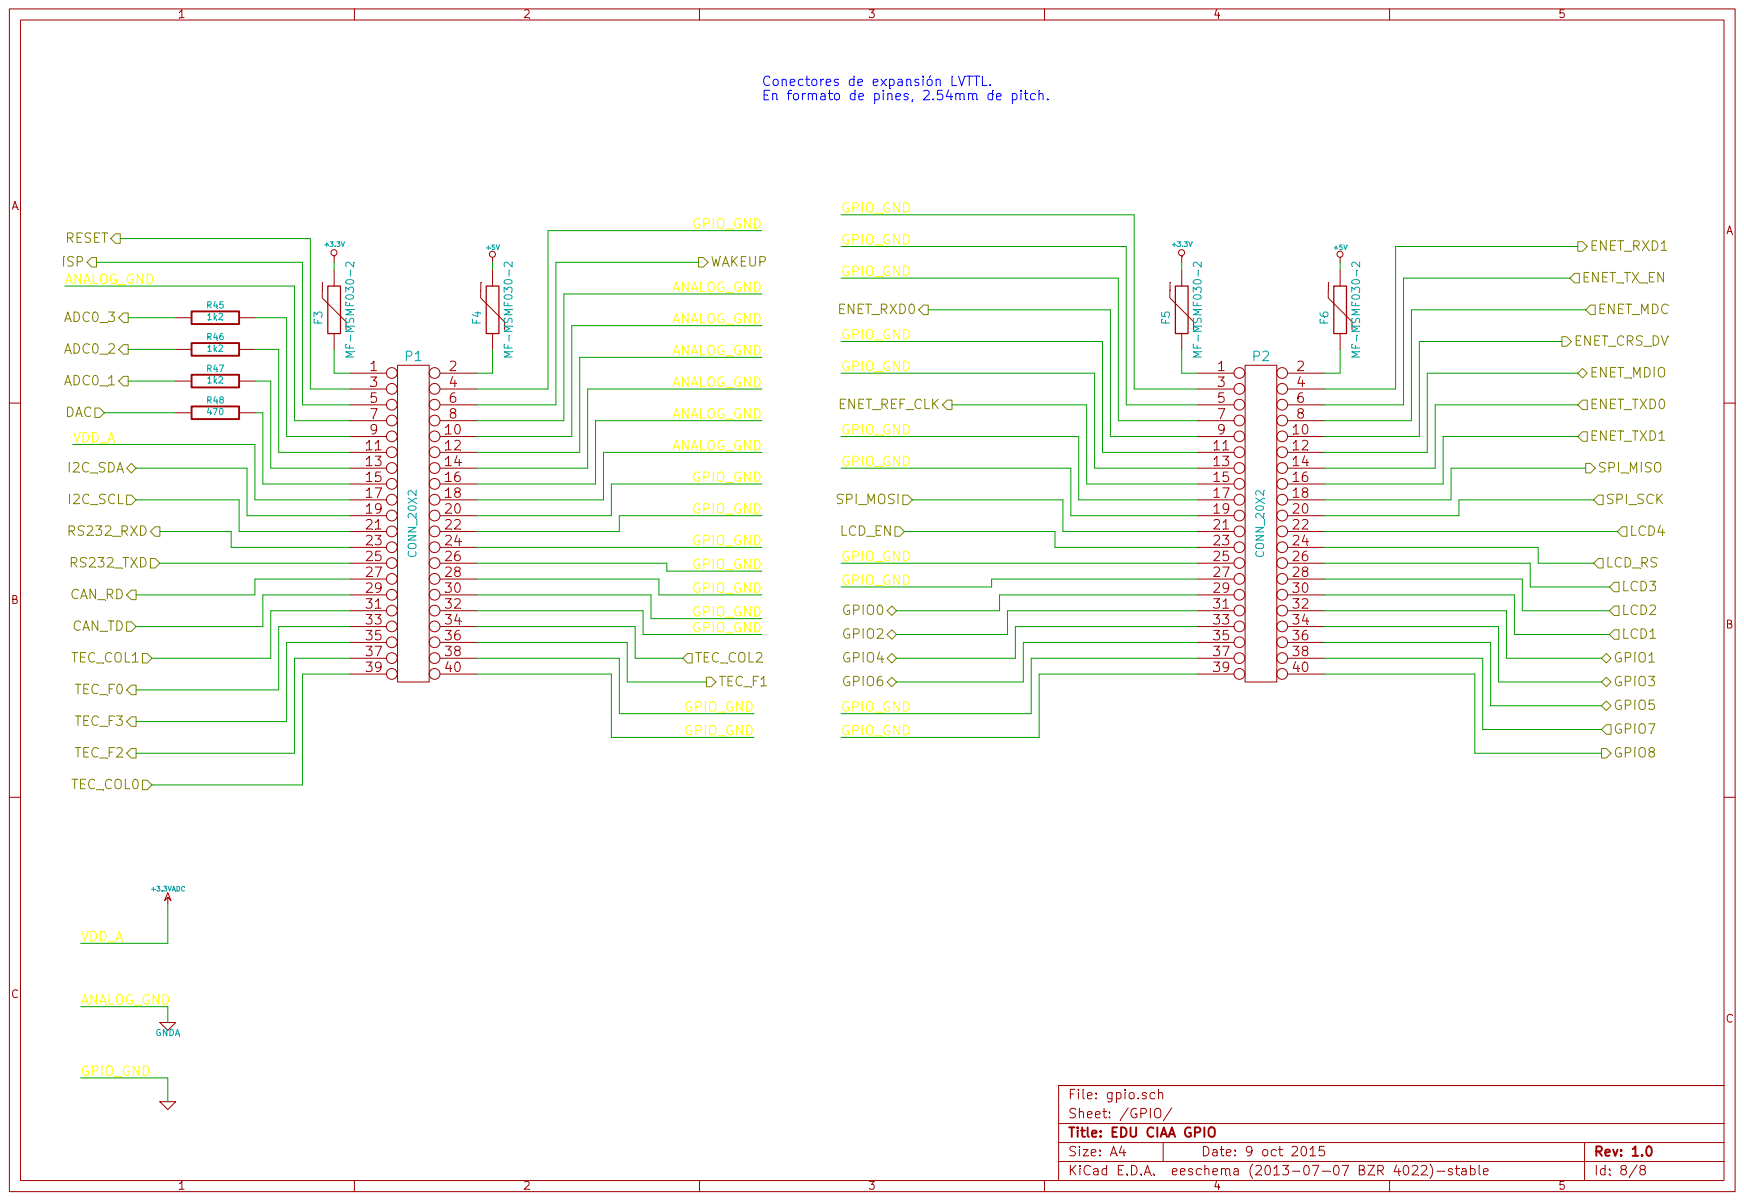
[picture p206: page 8]
