ciaa/Hardware/PCB/EDU-FPGA/Schematic/FPGA para todos.kicad_pcb

## KiCad design PCB/EDU-FPGA/Schematic/FPGA para todos.kicad_pcb (2020-05-08)

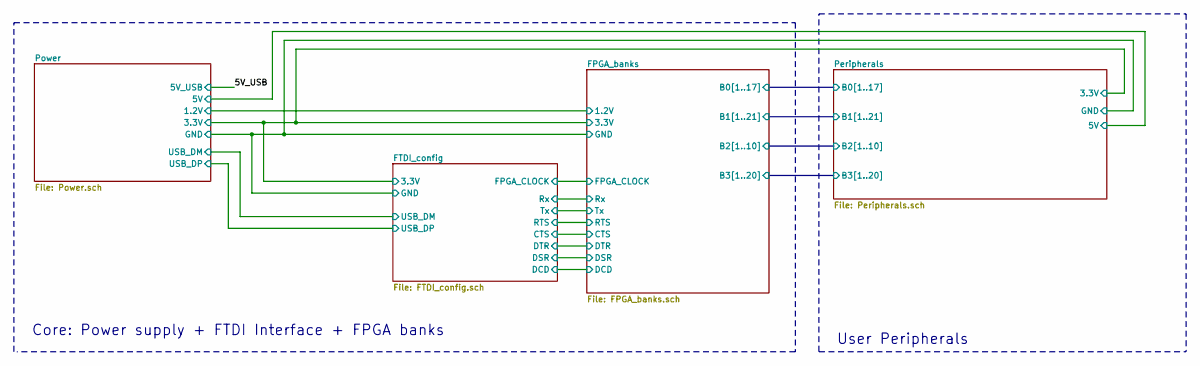
[picture p239: schematic FPGA para todos.sch, EDU-FPGA]

Notes on the sheet:
Core: Power supply + FTDI Interface + FPGA banks
User Peripherals

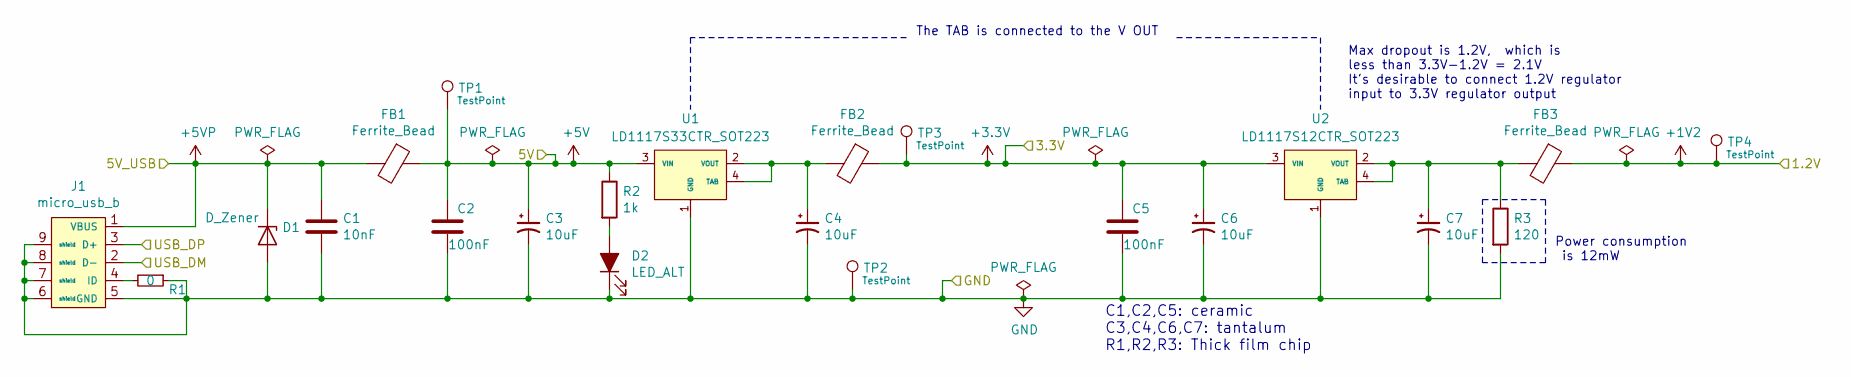
[picture p240: schematic Power.sch, Power Supply]

Parts:
C1: 10nF; C_0805_2012Metric_Pad1.15x1.40mm_HandSolder
C2, C5: 100nF; C_0805_2012Metric_Pad1.15x1.40mm_HandSolder
C3, C4, C6, C7: 10uF; C_0805_AVX_Tantalum
D1: D_Zener; D_SMA
D2: LED_ALT; led_0805_recommended_land_pattern
FB1, FB2, FB3: Ferrite_Bead; Ferrite_bead_0805
J1: micro_usb_b; micro_usb_b_recpt_bttm_mnt_smt_th_tabs
R1: 0; R_0805_2012Metric_Pad1.15x1.40mm_HandSolder
R2: 1k; R_0805_2012Metric_Pad1.15x1.40mm_HandSolder
R3: 120; R_0805_2012Metric_Pad1.15x1.40mm_HandSolder
TP1, TP2, TP3, TP4: TestPoint; TestPoint_Pad_D1.5mm
U1: LD1117S33CTR_SOT223; SOT-223
U2: LD1117S12CTR_SOT223; SOT-223

Connections:
+1V2: FB3.1, TP4.1; also elsewhere on the board
+3V3: C5.1, C6.1, FB2.1, TP3.1, U2.3 (VIN); also elsewhere on the board
+5V: C2.1, C3.1, FB1.1, R2.1, TP1.1, U1.3 (VIN); also elsewhere on the board
+5VP: C1.1, D1.2 (K), FB1.2, J1.1 (VBUS)
/FTDI_config/USB_DM: J1.2 (D-); also elsewhere on the board
/FTDI_config/USB_DP: J1.3 (D+); also elsewhere on the board
GND: C1.2, C2.2, C3.2, C4.2, C5.2, C6.2, C7.2, D1.1 (A), D2.2 (K), J1.5 (GND), J1.6 (shield), J1.7 (shield), J1.8 (shield), J1.9 (shield), R1.1, R3.2, TP2.1, U1.1 (GND), U2.1 (GND); also elsewhere on the board
unnamed: C4.1, FB2.2, U1.2 (VOUT), U1.4 (TAB)
unnamed: C7.1, FB3.2, R3.1, U2.2 (VOUT), U2.4 (TAB)
unnamed: D2.1 (A), R2.2
unnamed: J1.4 (ID), R1.2

Notes on the sheet:
Power consumption is 12mW
Max dropout is 1.2V, which is less than 3.3V-1.2V = 2.1V It's desirable to connect 1.2V regulator input to 3.3V regulator output
The TAB is connected to the V OUT
C1,C2,C5: ceramic C3,C4,C6,C7: tantalum R1,R2,R3: Thick film chip

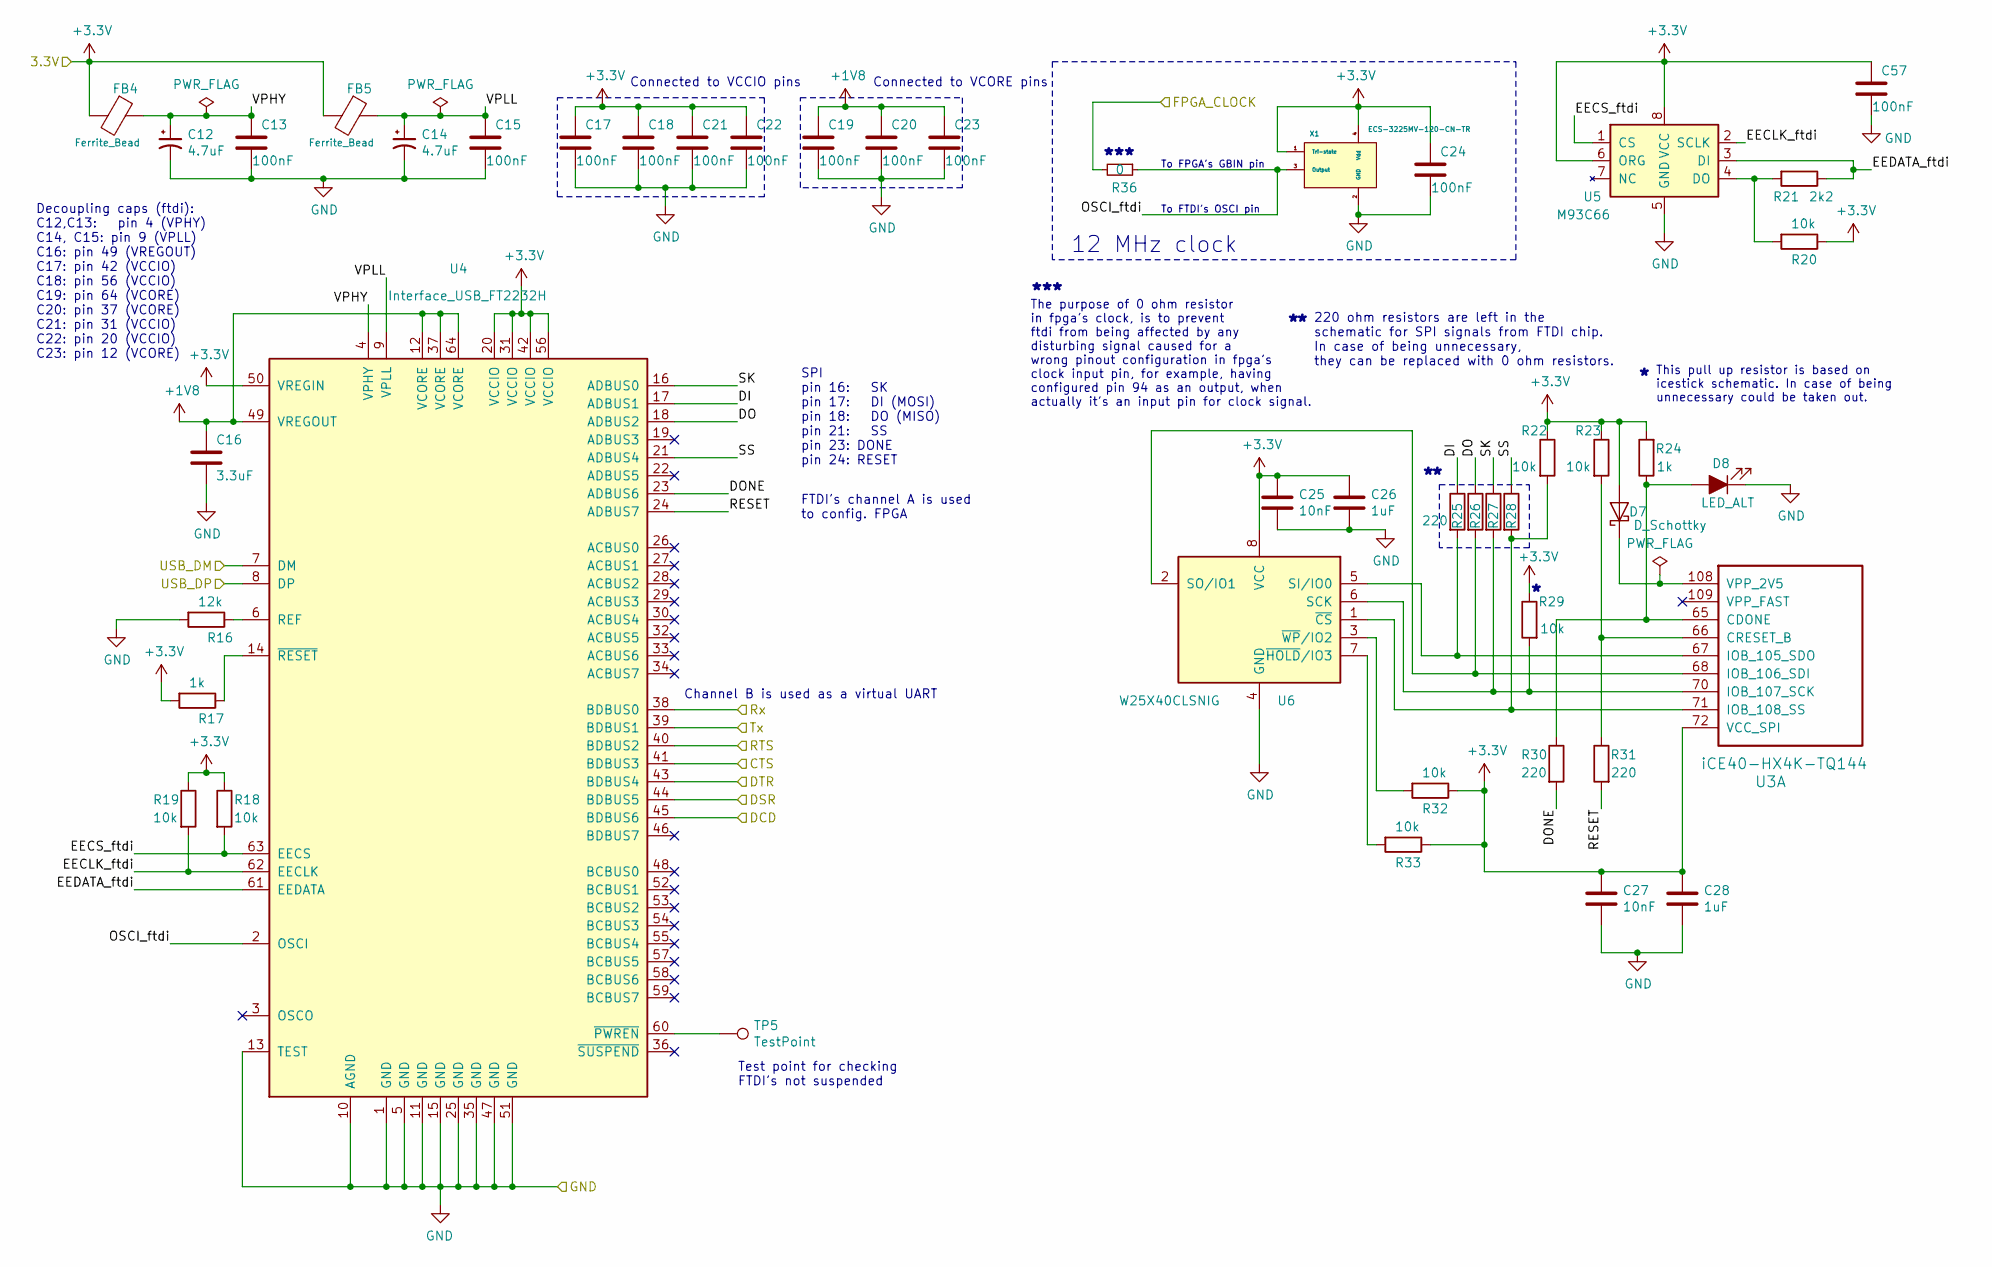
[picture p241: schematic FTDI_config.sch, FTDI Interface and Configuration]

Parts:
C12, C14: 4.7uF; C_0805_AVX_Tantalum
C13, C15, C17, C18, C19, C20, C21, C22, C23, C24, C57: 100nF; C_0805_2012Metric_Pad1.15x1.40mm_HandSolder
C16: 3.3uF; C_0805_2012Metric_Pad1.15x1.40mm_HandSolder
C25, C27: 10nF; C_0805_2012Metric_Pad1.15x1.40mm_HandSolder
C26, C28: 1uF; C_0805_2012Metric_Pad1.15x1.40mm_HandSolder
D7: D_Schottky; D_0805_2012Metric
D8: LED_ALT; led_0805_recommended_land_pattern
FB4, FB5: Ferrite_Bead; Ferrite_bead_0805
R16: 12k; R_0805_2012Metric_Pad1.15x1.40mm_HandSolder
R17, R24: 1k; R_0805_2012Metric_Pad1.15x1.40mm_HandSolder
R18, R19, R20, R22, R23, R29, R32, R33: 10k; R_0805_2012Metric_Pad1.15x1.40mm_HandSolder
R21: 2k2; R_0805_2012Metric_Pad1.15x1.40mm_HandSolder
R25, R26, R27, R28, R30, R31: 220; R_0805_2012Metric_Pad1.15x1.40mm_HandSolder
R36: 0; R_0805_2012Metric_Pad1.15x1.40mm_HandSolder
TP5: TestPoint; TestPoint_Pad_D1.5mm
U3: iCE40-HX4K-TQ144; QFP50P2200X2200X160-144N
U4: Interface_USB_FT2232H; LQFP-64_10x10mm_P0.5mm
U5: M93C66; m93c66_SO8N_package
U6: W25X40CLSNIG; SOIC-8
X1: ECS-3225MV-120-CN-TR; ECS-3225MV

Connections:
+1V8: C16.1, C19.1, C20.1, C23.1, U4.12 (VCORE), U4.37 (VCORE), U4.49 (VREGOUT), U4.64 (VCORE)
+3V3: C17.1, C18.1, C21.1, C22.1, C24.1, C25.1, C26.1, C27.1, C28.1, C57.1, D7.1 (A), FB4.2, FB5.2, R17.2, R18.1, R19.1, R20.1, R22.1, R23.1, R24.2, R29.1, R32.1, R33.1, U3.72 (VCC_SPI), U4.20 (VCCIO), U4.31 (VCCIO), U4.42 (VCCIO), U4.50 (VREGIN), U4.56 (VCCIO), U5.6 (ORG), U5.8 (VCC), U6.8 (VCC), X1.1 (Tri-state), X1.4 (Vdd); also elsewhere on the board
/FPGA_banks/CTS: U4.41 (BDBUS3); also elsewhere on the board
/FPGA_banks/DCD: U4.45 (BDBUS6); also elsewhere on the board
/FPGA_banks/DSR: U4.44 (BDBUS5); also elsewhere on the board
/FPGA_banks/DTR: U4.43 (BDBUS4); also elsewhere on the board
/FPGA_banks/FPGA_CLOCK: R36.2; also elsewhere on the board
/FPGA_banks/RTS: U4.40 (BDBUS2); also elsewhere on the board
/FPGA_banks/Rx: U4.38 (BDBUS0); also elsewhere on the board
/FPGA_banks/Tx: U4.39 (BDBUS1); also elsewhere on the board
/FTDI_config/DI: R25.1, U4.17 (ADBUS1)
/FTDI_config/DO: R26.1, U4.18 (ADBUS2)
/FTDI_config/DONE: R30.2, U4.23 (ADBUS6)
/FTDI_config/EECLK_ftdi: R19.2, U4.62 (EECLK), U5.2 (SCLK)
/FTDI_config/EECS_ftdi: R18.2, U4.63 (EECS), U5.1 (CS)
/FTDI_config/EEDATA_ftdi: R21.1, U4.61 (EEDATA), U5.3 (DI)
/FTDI_config/OSCI_ftdi: R36.1, U4.2 (OSCI), X1.3 (Output)
/FTDI_config/RESET: R31.2, U4.24 (ADBUS7)
/FTDI_config/SK: R27.1, U4.16 (ADBUS0)
/FTDI_config/SS: R28.1, U4.21 (ADBUS4)
/FTDI_config/USB_DM: U4.7 (DM); also elsewhere on the board
/FTDI_config/USB_DP: U4.8 (DP); also elsewhere on the board
/FTDI_config/VPHY: C12.1, C13.1, FB4.1, U4.4 (VPHY)
/FTDI_config/VPLL: C14.1, C15.1, FB5.1, U4.9 (VPLL)
GND: C12.2, C13.2, C14.2, C15.2, C16.2, C17.2, C18.2, C19.2, C20.2, C21.2, C22.2, C23.2, C24.2, C25.2, C26.2, C27.2, C28.2, C57.2, D8.2 (K), R16.2, U4.1 (GND), U4.5 (GND), U4.10 (AGND), U4.11 (GND), U4.13 (TEST), U4.15 (GND), U4.25 (GND), U4.35 (GND), U4.47 (GND), U4.51 (GND), U5.5 (GND), U6.4 (GND), X1.2 (GND); also elsewhere on the board
unnamed: D7.2 (K), U3.108 (VPP_2V5)
unnamed: D8.1 (A), R24.1, R30.1, U3.65 (CDONE)
unnamed: R16.1, U4.6 (REF)
unnamed: R17.1, U4.14 (~RESET)
unnamed: R20.2, R21.2, U5.4 (DO)
unnamed: R22.2, R28.2, U3.71 (IOB_108_SS), U6.1 (~CS)
unnamed: R23.2, R31.1, U3.66 (CRESET_B)
unnamed: R25.2, U3.67 (IOB_105_SDO), U6.5 (SI/IO0)
unnamed: R26.2, U3.68 (IOB_106_SDI), U6.2 (SO/IO1)
unnamed: R27.2, R29.2, U3.70 (IOB_107_SCK), U6.6 (SCK)
unnamed: R32.2, U6.3 (~WP~/IO2)
unnamed: R33.2, U6.7 (~HOLD~/IO3)
unnamed: TP5.1, U4.60 (~PWREN)

Notes on the sheet:
Connected to VCCIO pins
Connected to VCORE pins
FTDI's channel A is used to config. FPGA
SPI pin 16: SK pin 17: DI (MOSI) pin 18: DO (MISO) pin 21: SS pin 23: DONE pin 24: RESET
Channel B is used as a virtual UART
Test point for checking FTDI's not suspended
To FPGA's GBIN pin
To FTDI's OSCI pin
This pull up resistor is based on icestick schematic. In case of being unnecessary could be taken out.
220 ohm resistors are left in the schematic for SPI signals from FTDI chip. In case of being unnecessary, they can be replaced with 0 ohm resistors.
Decoupling caps (ftdi): C12,C13: pin 4 (VPHY) C14, C15: pin 9 (VPLL) C16: pin 49 (VREGOUT) C17: pin 42 (VCCIO) C18: pin 56 (VCCIO) C19: pin 64 (VCORE) C20: pin 37 (VCORE) C21: pin 31 (VCCIO) C22: pin 20 (VCCIO) C23: pin 12 (VCORE)
12 MHz clock
***
The purpose of 0 ohm resistor in fpga's clock, is to prevent ftdi from being affected by any disturbing signal caused for a wrong pinout configuration in fpga's clock input pin, for example, having configured pin 94 as an output, when actually it's an input pin for clock signal.

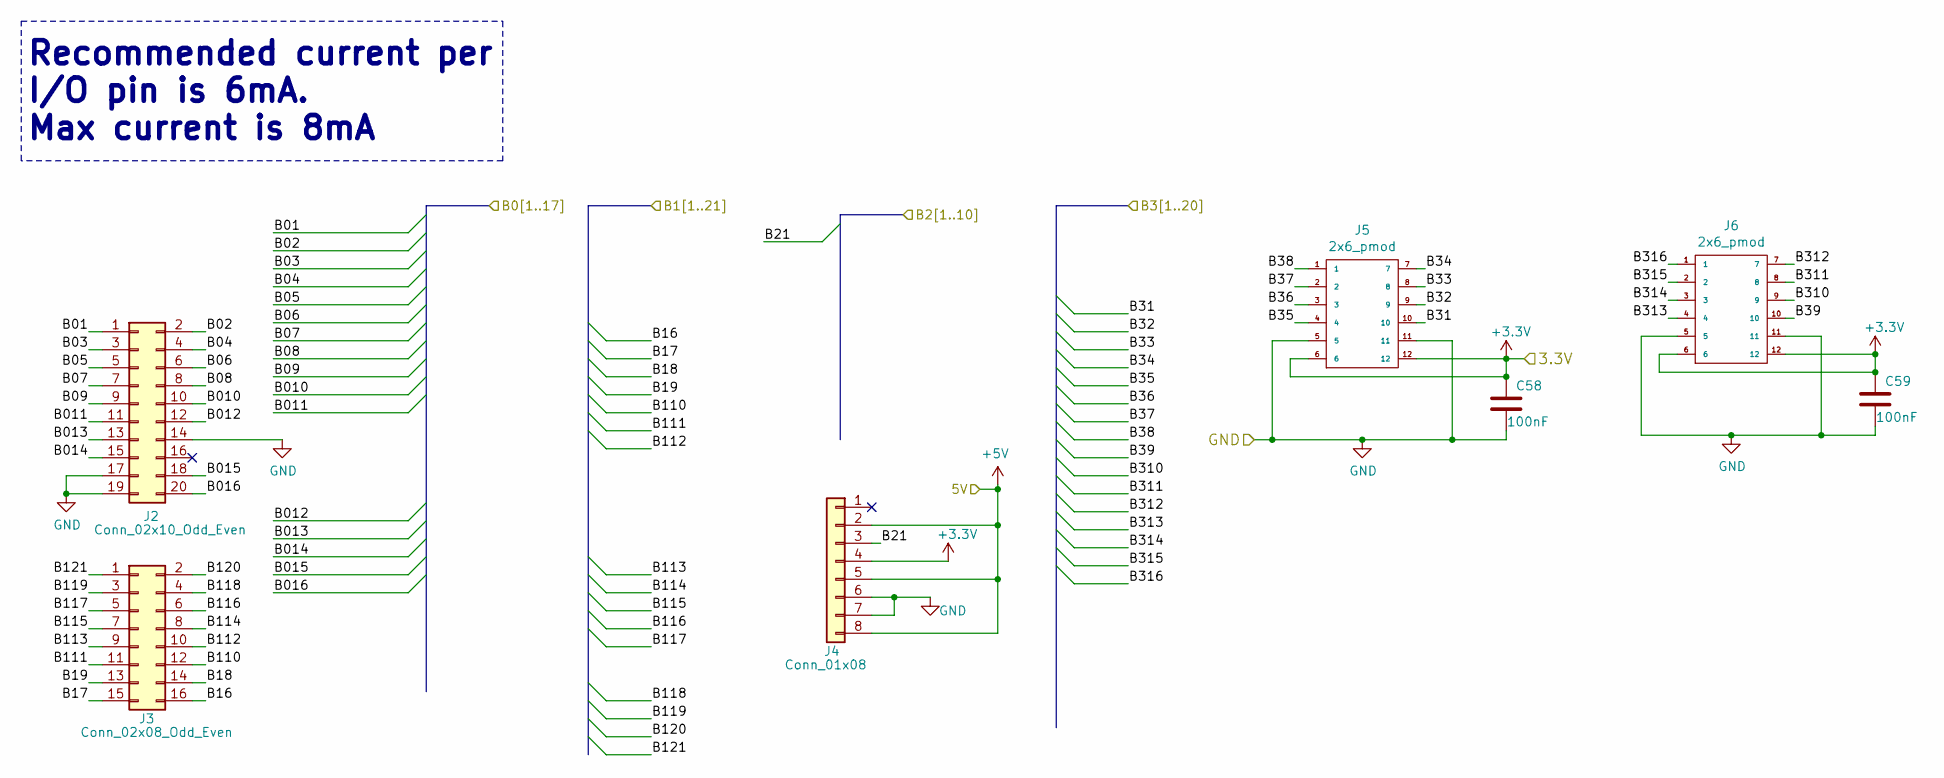
[picture p242: schematic Peripherals.sch]

Parts:
C58, C59: 100nF; C_0805_2012Metric_Pad1.15x1.40mm_HandSolder
J2: Conn_02x10_Odd_Even; PinSocket_2x10_P2.54mm_Vertical_mirror
J3: Conn_02x08_Odd_Even; PinSocket_2x08_P2.54mm_Vertical_mirror
J4: Conn_01x08; PinSocket_1x08_P2.54mm_Vertical
J5: 2x6_pmod; PinSocket_2x06_P2.54mm_Vertical_Mirror
J6: 2x6_pmod; PinSocket_2x06_P2.54mm_Horizontal_PMOD

Connections:
+3V3: C58.1, C59.1, J4.4, J5.6, J5.12, J6.6, J6.12; also elsewhere on the board
+5V: J4.2, J4.5, J4.8; also elsewhere on the board
/FPGA_banks/B01: J2.1; also elsewhere on the board
/FPGA_banks/B02: J2.2; also elsewhere on the board
/FPGA_banks/B03: J2.3; also elsewhere on the board
/FPGA_banks/B04: J2.4; also elsewhere on the board
/FPGA_banks/B05: J2.5; also elsewhere on the board
/FPGA_banks/B06: J2.6; also elsewhere on the board
/FPGA_banks/B07: J2.7; also elsewhere on the board
/FPGA_banks/B08: J2.8; also elsewhere on the board
/FPGA_banks/B09: J2.9; also elsewhere on the board
/FPGA_banks/B010: J2.10; also elsewhere on the board
/FPGA_banks/B011: J2.11; also elsewhere on the board
/FPGA_banks/B012: J2.12; also elsewhere on the board
/FPGA_banks/B013: J2.13; also elsewhere on the board
/FPGA_banks/B014: J2.15; also elsewhere on the board
/FPGA_banks/B015: J2.18; also elsewhere on the board
/FPGA_banks/B016: J2.20; also elsewhere on the board
/FPGA_banks/B16: J3.16; also elsewhere on the board
/FPGA_banks/B17: J3.15; also elsewhere on the board
/FPGA_banks/B18: J3.14; also elsewhere on the board
/FPGA_banks/B19: J3.13; also elsewhere on the board
/FPGA_banks/B21: J4.3; also elsewhere on the board
/FPGA_banks/B31: J5.10; also elsewhere on the board
/FPGA_banks/B32: J5.9; also elsewhere on the board
/FPGA_banks/B33: J5.8; also elsewhere on the board
/FPGA_banks/B34: J5.7; also elsewhere on the board
/FPGA_banks/B35: J5.4; also elsewhere on the board
/FPGA_banks/B36: J5.3; also elsewhere on the board
/FPGA_banks/B37: J5.2; also elsewhere on the board
/FPGA_banks/B38: J5.1; also elsewhere on the board
/FPGA_banks/B39: J6.10; also elsewhere on the board
/FPGA_banks/B110: J3.12; also elsewhere on the board
/FPGA_banks/B111: J3.11; also elsewhere on the board
/FPGA_banks/B112: J3.10; also elsewhere on the board
/FPGA_banks/B113: J3.9; also elsewhere on the board
/FPGA_banks/B114: J3.8; also elsewhere on the board
/FPGA_banks/B115: J3.7; also elsewhere on the board
/FPGA_banks/B116: J3.6; also elsewhere on the board
/FPGA_banks/B117: J3.5; also elsewhere on the board
/FPGA_banks/B118: J3.4; also elsewhere on the board
/FPGA_banks/B119: J3.3; also elsewhere on the board
/FPGA_banks/B120: J3.2; also elsewhere on the board
/FPGA_banks/B121: J3.1; also elsewhere on the board
/FPGA_banks/B310: J6.9; also elsewhere on the board
/FPGA_banks/B311: J6.8; also elsewhere on the board
/FPGA_banks/B312: J6.7; also elsewhere on the board
/FPGA_banks/B313: J6.4; also elsewhere on the board
/FPGA_banks/B314: J6.3; also elsewhere on the board
/FPGA_banks/B315: J6.2; also elsewhere on the board
/FPGA_banks/B316: J6.1; also elsewhere on the board
GND: C58.2, C59.2, J2.14, J2.17, J2.19, J4.6, J4.7, J5.5, J5.11, J6.5, J6.11; also elsewhere on the board

Notes on the sheet:
Recommended current per I/O pin is 6mA. Max current is 8mA

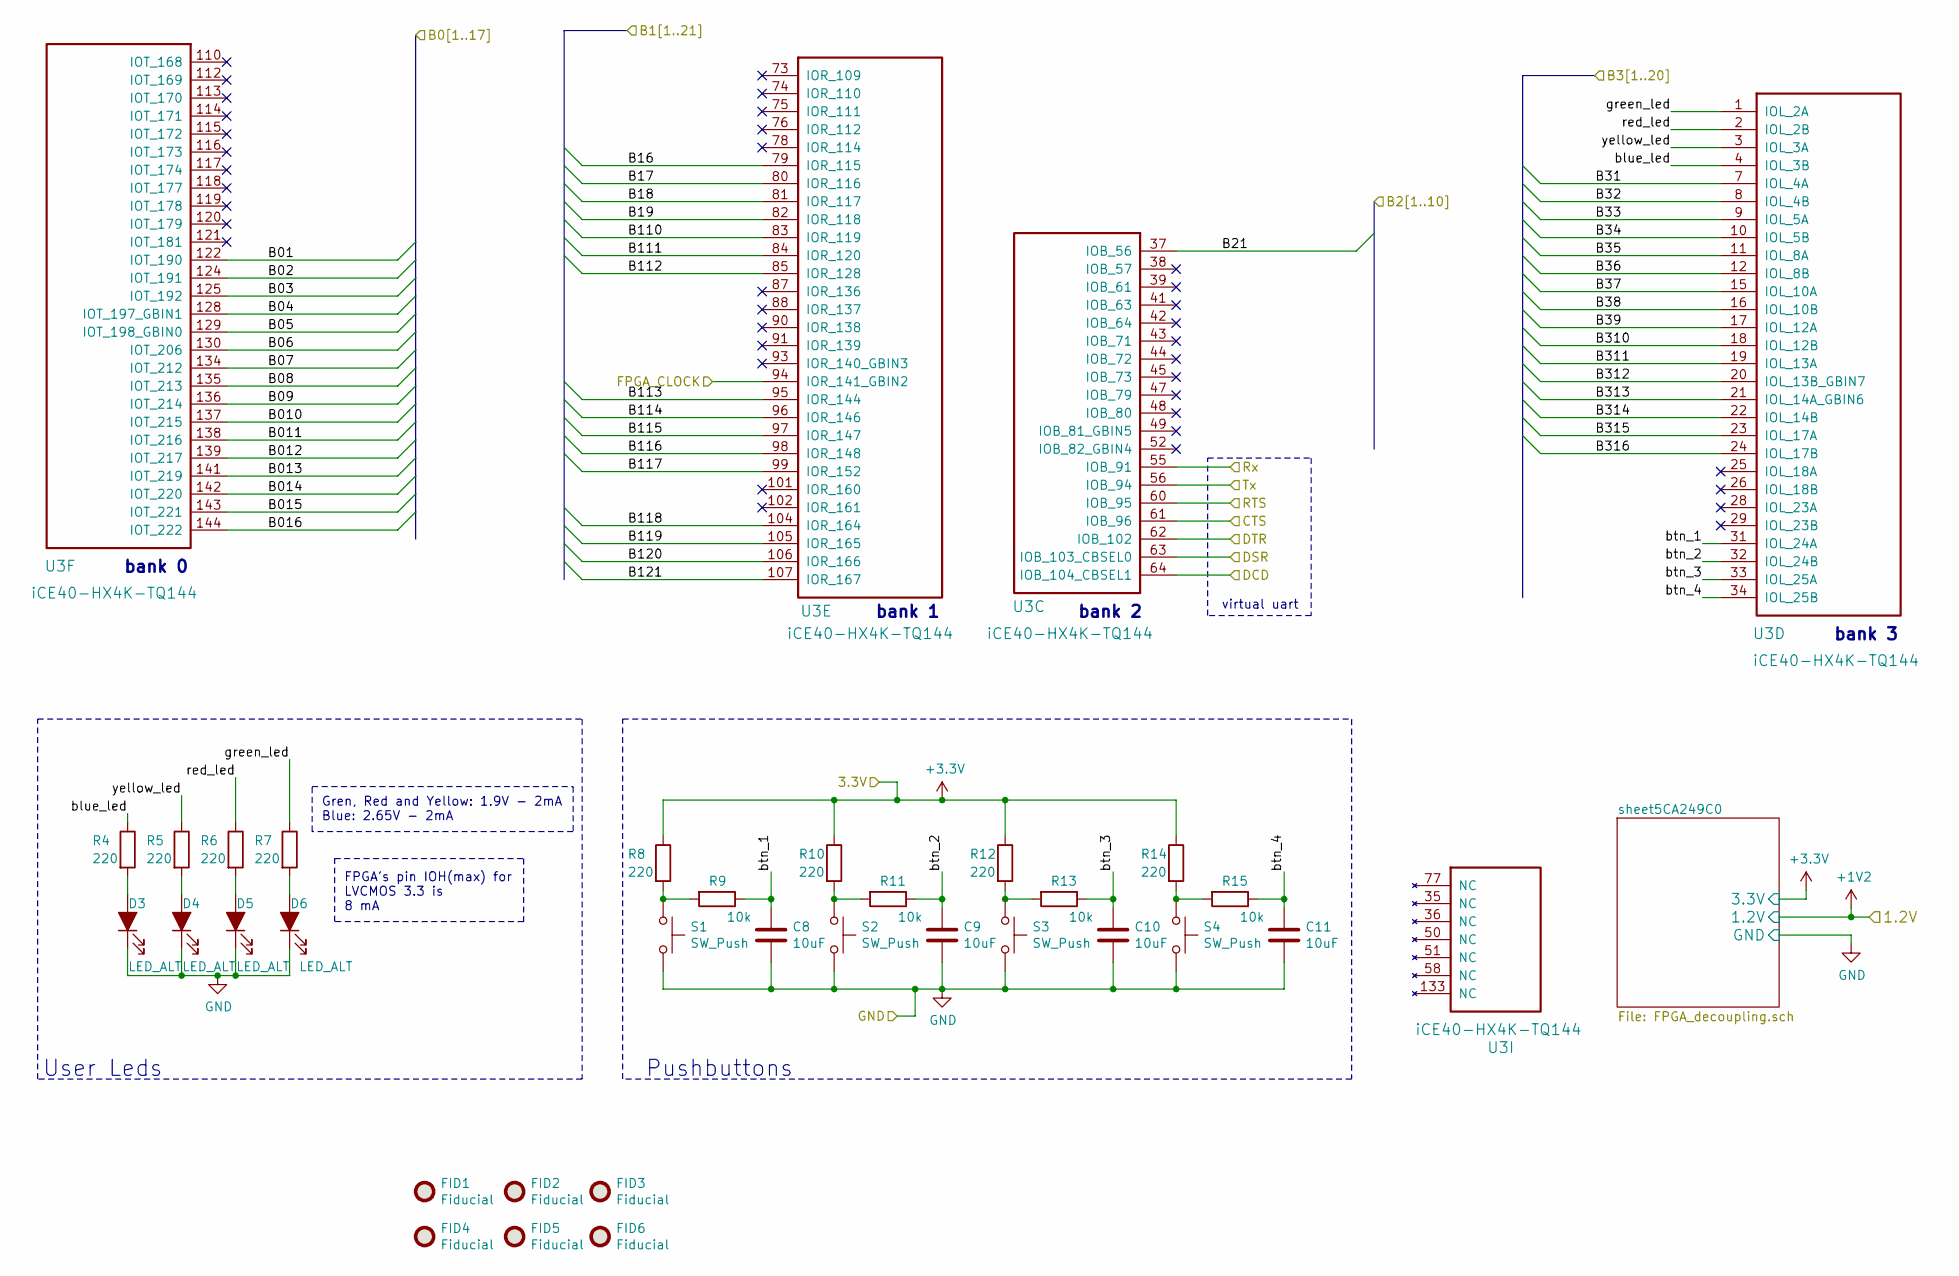
[picture p243: schematic FPGA_banks.sch, FPGA Banks]

Parts:
C8, C9, C10, C11: 10uF; C_0805_2012Metric_Pad1.15x1.40mm_HandSolder
D3, D4, D5, D6: LED_ALT; led_0805_recommended_land_pattern
FID1, FID2, FID3, FID4, FID5, FID6: Fiducial; Fiducial_1mm_Mask2mm
R4, R5, R6, R7, R8, R10, R12, R14: 220; R_0805_2012Metric_Pad1.15x1.40mm_HandSolder
R9, R11, R13, R15: 10k; R_0805_2012Metric_Pad1.15x1.40mm_HandSolder
S1, S2, S3, S4: SW_Push; PANASONIC_EVPBF_6MM_SMD
U3: iCE40-HX4K-TQ144; QFP50P2200X2200X160-144N

Connections:
+3V3: R8.1, R10.1, R12.1, R14.1; also elsewhere on the board
/FPGA_banks/B01: U3.122 (IOT_190); also elsewhere on the board
/FPGA_banks/B02: U3.124 (IOT_191); also elsewhere on the board
/FPGA_banks/B03: U3.125 (IOT_192); also elsewhere on the board
/FPGA_banks/B04: U3.128 (IOT_197_GBIN1); also elsewhere on the board
/FPGA_banks/B05: U3.129 (IOT_198_GBIN0); also elsewhere on the board
/FPGA_banks/B06: U3.130 (IOT_206); also elsewhere on the board
/FPGA_banks/B07: U3.134 (IOT_212); also elsewhere on the board
/FPGA_banks/B08: U3.135 (IOT_213); also elsewhere on the board
/FPGA_banks/B09: U3.136 (IOT_214); also elsewhere on the board
/FPGA_banks/B010: U3.137 (IOT_215); also elsewhere on the board
/FPGA_banks/B011: U3.138 (IOT_216); also elsewhere on the board
/FPGA_banks/B012: U3.139 (IOT_217); also elsewhere on the board
/FPGA_banks/B013: U3.141 (IOT_219); also elsewhere on the board
/FPGA_banks/B014: U3.142 (IOT_220); also elsewhere on the board
/FPGA_banks/B015: U3.143 (IOT_221); also elsewhere on the board
/FPGA_banks/B016: U3.144 (IOT_222); also elsewhere on the board
/FPGA_banks/B16: U3.79 (IOR_115); also elsewhere on the board
/FPGA_banks/B17: U3.80 (IOR_116); also elsewhere on the board
/FPGA_banks/B18: U3.81 (IOR_117); also elsewhere on the board
/FPGA_banks/B19: U3.82 (IOR_118); also elsewhere on the board
/FPGA_banks/B21: U3.37 (IOB_56); also elsewhere on the board
/FPGA_banks/B31: U3.7 (IOL_4A); also elsewhere on the board
/FPGA_banks/B32: U3.8 (IOL_4B); also elsewhere on the board
/FPGA_banks/B33: U3.9 (IOL_5A); also elsewhere on the board
/FPGA_banks/B34: U3.10 (IOL_5B); also elsewhere on the board
/FPGA_banks/B35: U3.11 (IOL_8A); also elsewhere on the board
/FPGA_banks/B36: U3.12 (IOL_8B); also elsewhere on the board
/FPGA_banks/B37: U3.15 (IOL_10A); also elsewhere on the board
/FPGA_banks/B38: U3.16 (IOL_10B); also elsewhere on the board
/FPGA_banks/B39: U3.17 (IOL_12A); also elsewhere on the board
/FPGA_banks/B110: U3.83 (IOR_119); also elsewhere on the board
/FPGA_banks/B111: U3.84 (IOR_120); also elsewhere on the board
/FPGA_banks/B112: U3.85 (IOR_128); also elsewhere on the board
/FPGA_banks/B113: U3.95 (IOR_144); also elsewhere on the board
/FPGA_banks/B114: U3.96 (IOR_146); also elsewhere on the board
/FPGA_banks/B115: U3.97 (IOR_147); also elsewhere on the board
/FPGA_banks/B116: U3.98 (IOR_148); also elsewhere on the board
/FPGA_banks/B117: U3.99 (IOR_152); also elsewhere on the board
/FPGA_banks/B118: U3.104 (IOR_164); also elsewhere on the board
/FPGA_banks/B119: U3.105 (IOR_165); also elsewhere on the board
/FPGA_banks/B120: U3.106 (IOR_166); also elsewhere on the board
/FPGA_banks/B121: U3.107 (IOR_167); also elsewhere on the board
/FPGA_banks/B310: U3.18 (IOL_12B); also elsewhere on the board
/FPGA_banks/B311: U3.19 (IOL_13A); also elsewhere on the board
/FPGA_banks/B312: U3.20 (IOL_13B_GBIN7); also elsewhere on the board
/FPGA_banks/B313: U3.21 (IOL_14A_GBIN6); also elsewhere on the board
/FPGA_banks/B314: U3.22 (IOL_14B); also elsewhere on the board
/FPGA_banks/B315: U3.23 (IOL_17A); also elsewhere on the board
/FPGA_banks/B316: U3.24 (IOL_17B); also elsewhere on the board
/FPGA_banks/CTS: U3.61 (IOB_96); also elsewhere on the board
/FPGA_banks/DCD: U3.64 (IOB_104_CBSEL1); also elsewhere on the board
/FPGA_banks/DSR: U3.63 (IOB_103_CBSEL0); also elsewhere on the board
/FPGA_banks/DTR: U3.62 (IOB_102); also elsewhere on the board
/FPGA_banks/FPGA_CLOCK: U3.94 (IOR_141_GBIN2); also elsewhere on the board
/FPGA_banks/RTS: U3.60 (IOB_95); also elsewhere on the board
/FPGA_banks/Rx: U3.55 (IOB_91); also elsewhere on the board
/FPGA_banks/Tx: U3.56 (IOB_94); also elsewhere on the board
/FPGA_banks/blue_led: R4.1, U3.4 (IOL_3B)
/FPGA_banks/btn_1: C8.1, R9.1, U3.31 (IOL_24A)
/FPGA_banks/btn_2: C9.1, R11.1, U3.32 (IOL_24B)
/FPGA_banks/btn_3: C10.1, R13.1, U3.33 (IOL_25A)
/FPGA_banks/btn_4: C11.1, R15.1, U3.34 (IOL_25B)
/FPGA_banks/green_led: R7.1, U3.1 (IOL_2A)
/FPGA_banks/red_led: R6.1, U3.2 (IOL_2B)
/FPGA_banks/yellow_led: R5.1, U3.3 (IOL_3A)
GND: C8.2, C9.2, C10.2, C11.2, D3.2 (K), D4.2 (K), D5.2 (K), D6.2 (K), S1.2, S2.2, S3.2, S4.2; also elsewhere on the board
unnamed: D3.1 (A), R4.2
unnamed: D4.1 (A), R5.2
unnamed: D5.1 (A), R6.2
unnamed: D6.1 (A), R7.2
unnamed: R8.2, R9.2, S1.1
unnamed: R10.2, R11.2, S2.1
unnamed: R12.2, R13.2, S3.1
unnamed: R14.2, R15.2, S4.1

Notes on the sheet:
bank 1
bank 0
virtual uart
bank 2
bank 3
Gren, Red and Yellow: 1.9V - 2mA Blue: 2.65V - 2mA
FPGA's pin IOH(max) for LVCMOS 3.3 is 8 mA
User Leds
Pushbuttons

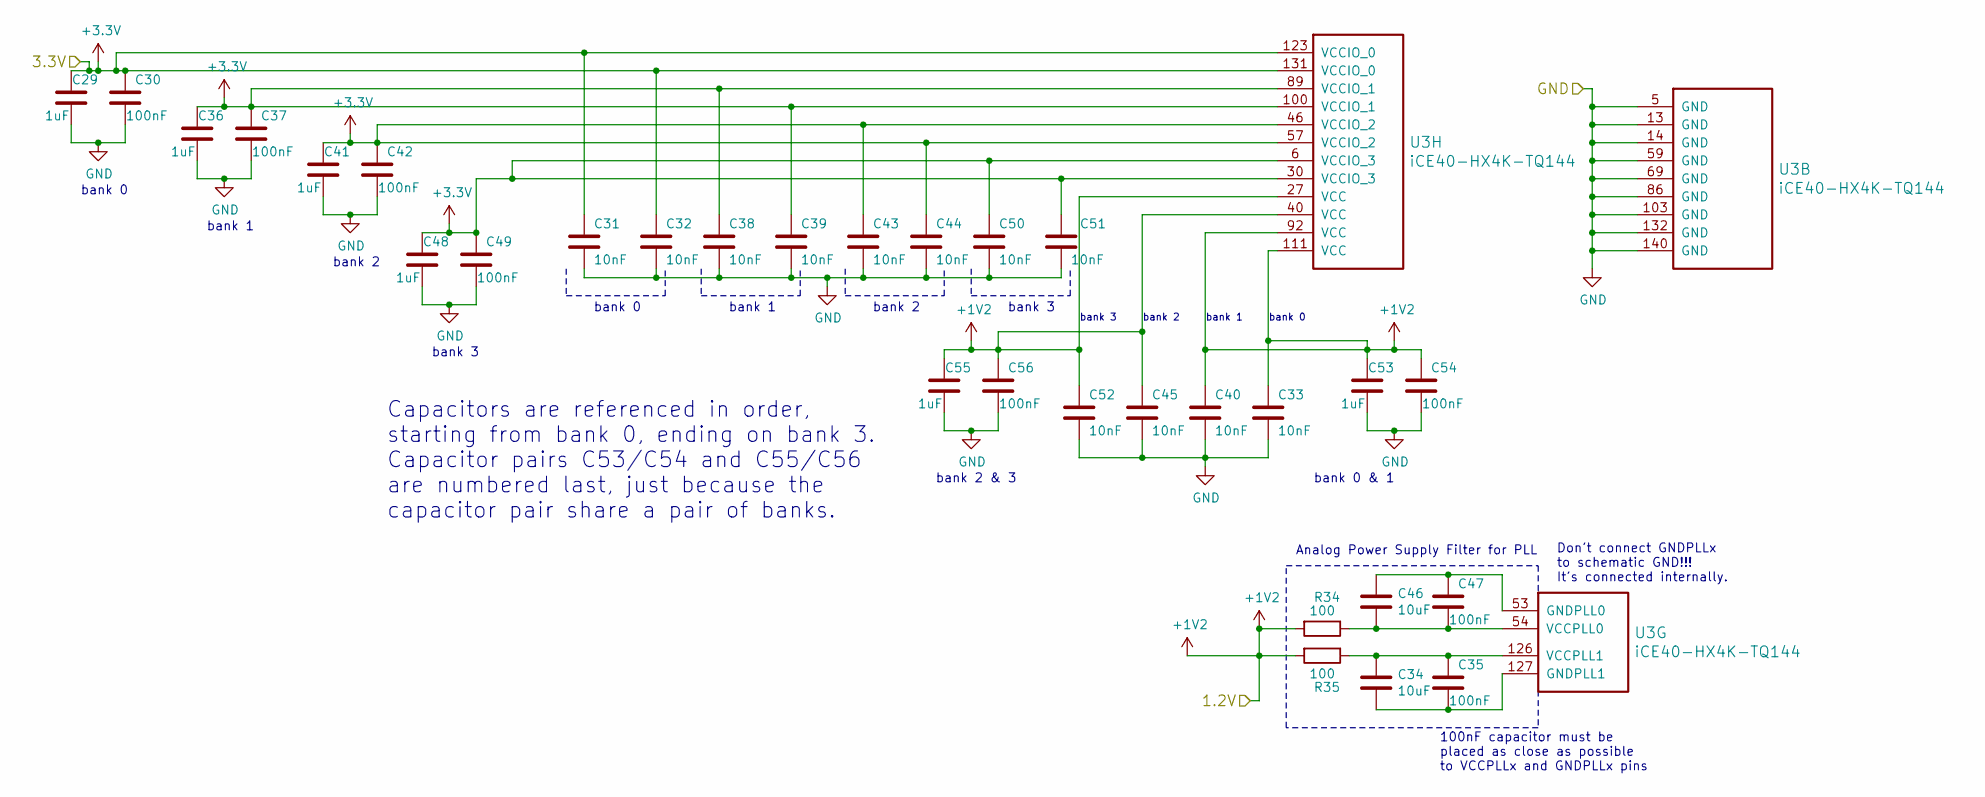
[picture p244: schematic FPGA_decoupling.sch, FPGA Decoupling]

Parts:
C29, C36, C41, C48, C53, C55: 1uF; C_0805_2012Metric_Pad1.15x1.40mm_HandSolder
C30, C35, C37, C42, C47, C49, C54, C56: 100nF; C_0805_2012Metric_Pad1.15x1.40mm_HandSolder
C31, C32, C33, C38, C39, C40, C43, C44, C45, C50, C51, C52: 10nF; C_0805_2012Metric_Pad1.15x1.40mm_HandSolder
C34, C46: 10uF; C_0805_2012Metric_Pad1.15x1.40mm_HandSolder
R34, R35: 100; R_0805_2012Metric_Pad1.15x1.40mm_HandSolder
U3: iCE40-HX4K-TQ144; QFP50P2200X2200X160-144N

Connections:
+1V2: C33.1, C40.1, C45.1, C52.1, C53.1, C54.1, C55.1, C56.1, R34.2, R35.2, U3.27 (VCC), U3.40 (VCC), U3.92 (VCC), U3.111 (VCC); also elsewhere on the board
+3V3: C29.1, C30.1, C31.1, C32.1, C36.1, C37.1, C38.1, C39.1, C41.1, C42.1, C43.1, C44.1, C48.1, C49.1, C50.1, C51.1, U3.6 (VCCIO_3), U3.30 (VCCIO_3), U3.46 (VCCIO_2), U3.57 (VCCIO_2), U3.89 (VCCIO_1), U3.100 (VCCIO_1), U3.123 (VCCIO_0), U3.131 (VCCIO_0); also elsewhere on the board
GND: C29.2, C30.2, C31.2, C32.2, C33.2, C36.2, C37.2, C38.2, C39.2, C40.2, C41.2, C42.2, C43.2, C44.2, C45.2, C48.2, C49.2, C50.2, C51.2, C52.2, C53.2, C54.2, C55.2, C56.2, U3.5 (GND), U3.13 (GND), U3.14 (GND), U3.59 (GND), U3.69 (GND), U3.86 (GND), U3.103 (GND), U3.132 (GND), U3.140 (GND); also elsewhere on the board
unnamed: C34.1, C35.1, R35.1, U3.126 (VCCPLL1)
unnamed: C34.2, C35.2, U3.127 (GNDPLL1)
unnamed: C46.1, C47.1, U3.53 (GNDPLL0)
unnamed: C46.2, C47.2, R34.1, U3.54 (VCCPLL0)

Notes on the sheet:
bank 0
bank 1
bank 2
bank 3
bank 2 & 3
bank 0 & 1
Analog Power Supply Filter for PLL
100nF capacitor must be placed as close as possible to VCCPLLx and GNDPLLx pins
Don't connect GNDPLLx to schematic GND!!! It's connected internally.
Capacitors are referenced in order, starting from bank 0, ending on bank 3. Capacitor pairs C53/C54 and C55/C56 are numbered last, just because the capacitor pair share a pair of banks.

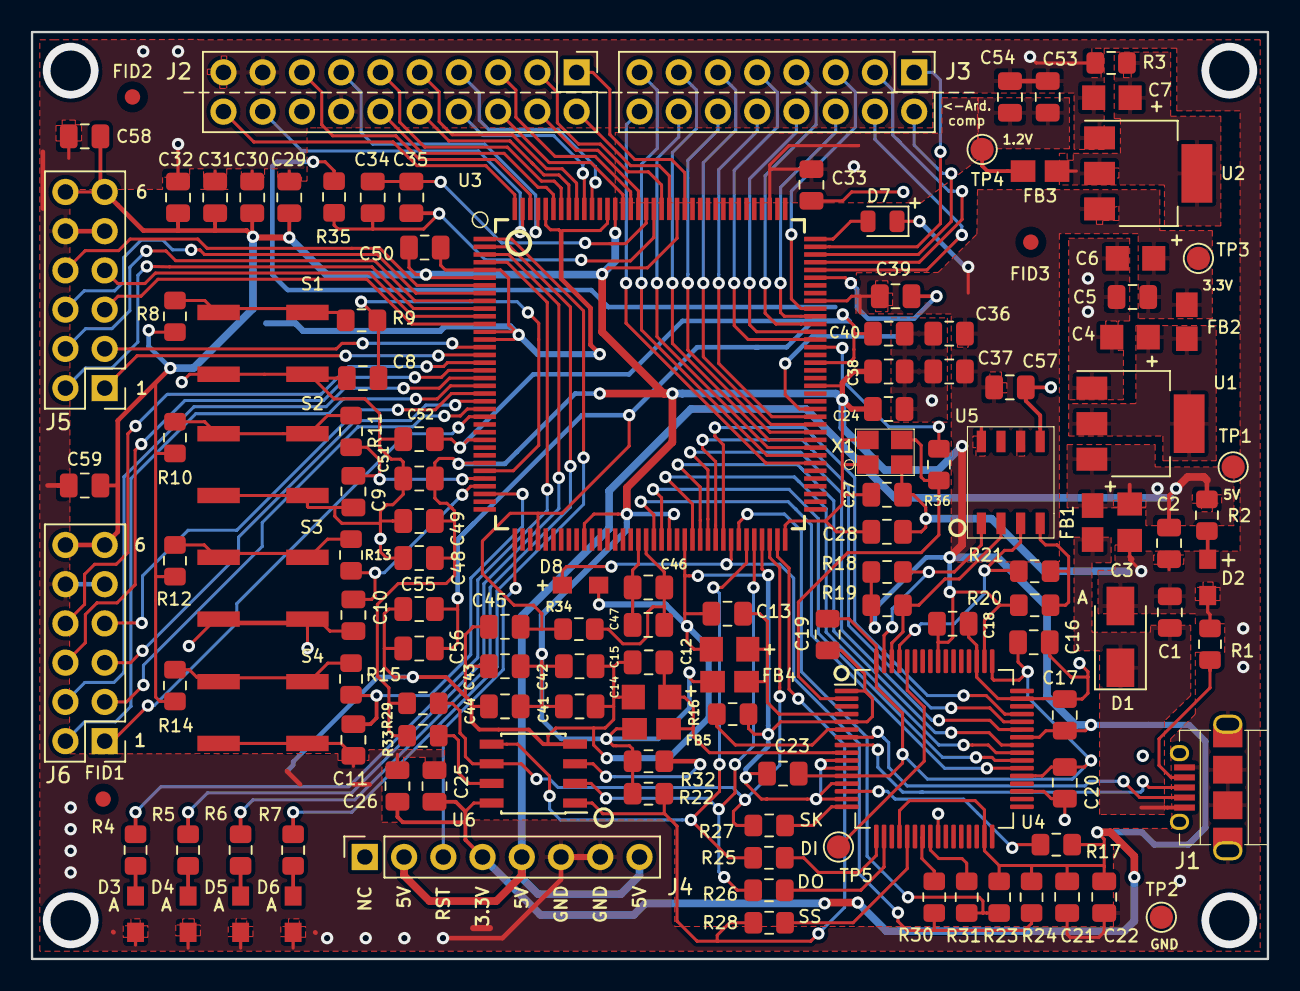
[picture p245: board FPGA para todos.kicad_pcb from above]

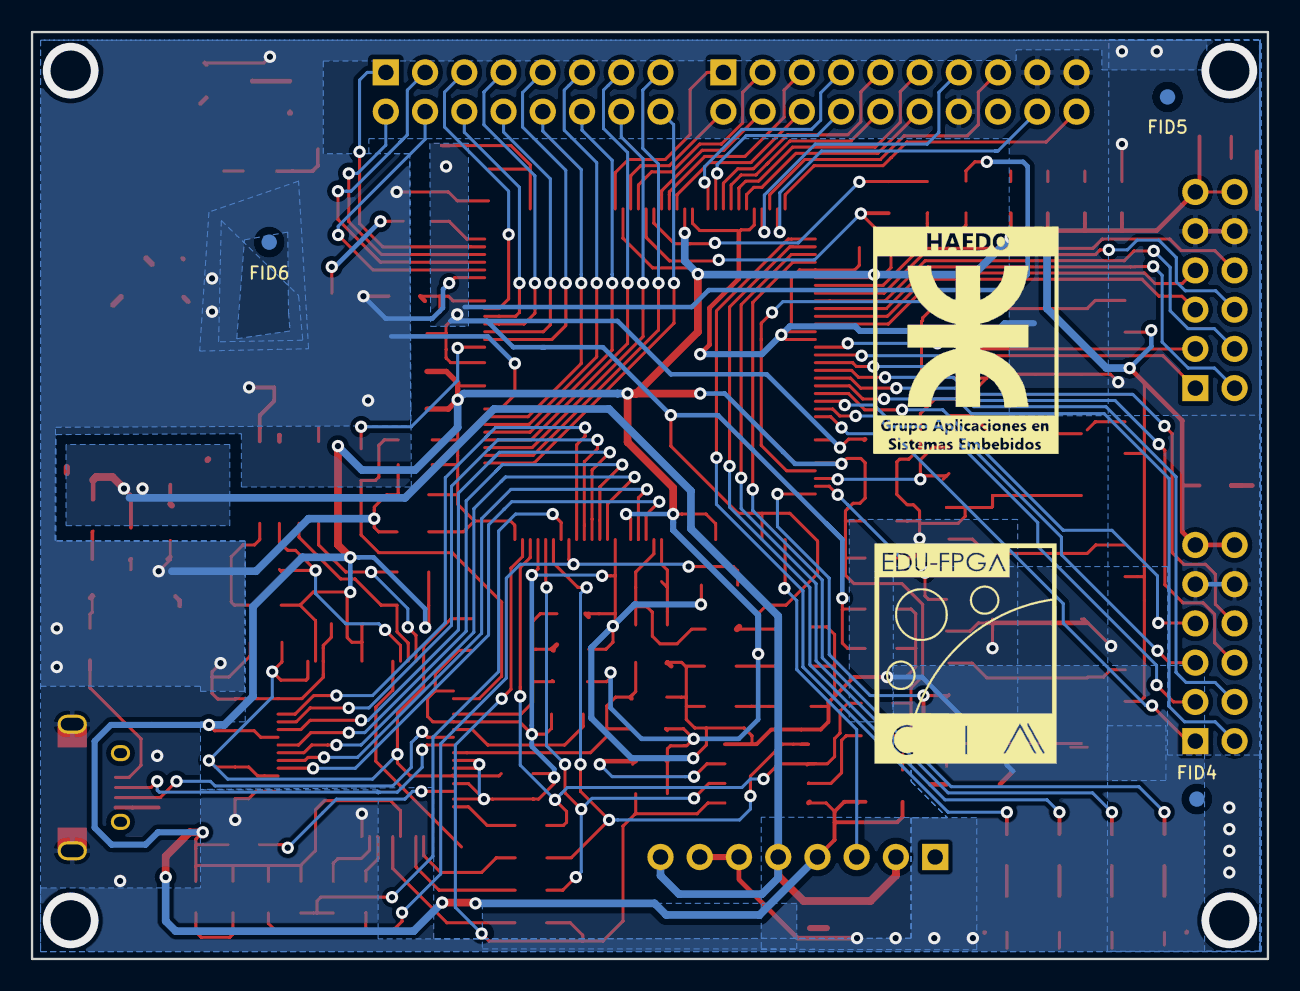
[picture p246: board FPGA para todos.kicad_pcb from below]

Board: 2 copper layers, 80.0 x 60.0 mm, 136 parts (3 on the bottom side), 114 nets.
