ciaa/Hardware/PCB/NXP/ciaa-nxp.kicad_pcb

## KiCad design PCB/NXP/ciaa-nxp.kicad_pcb (2020-03-30)

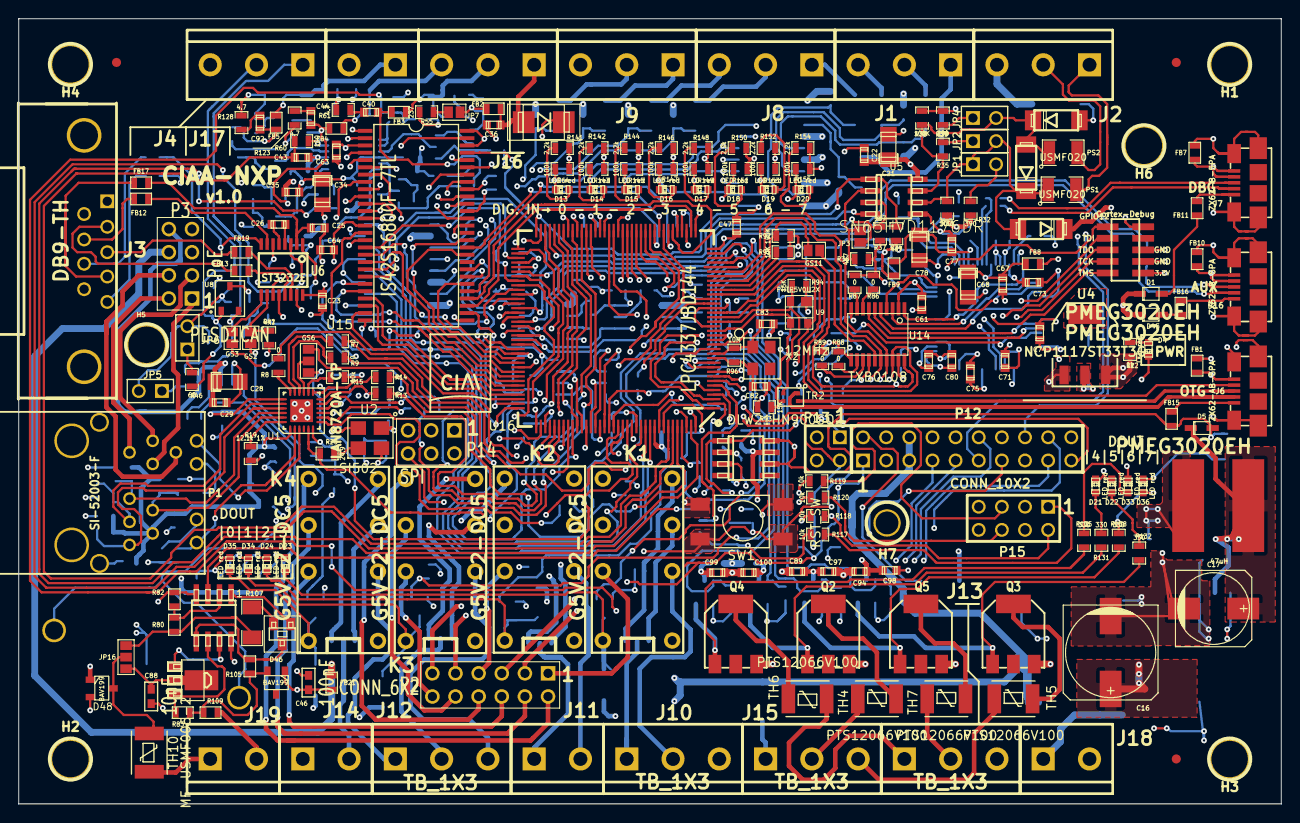
[picture p247: board ciaa-nxp.kicad_pcb from above]

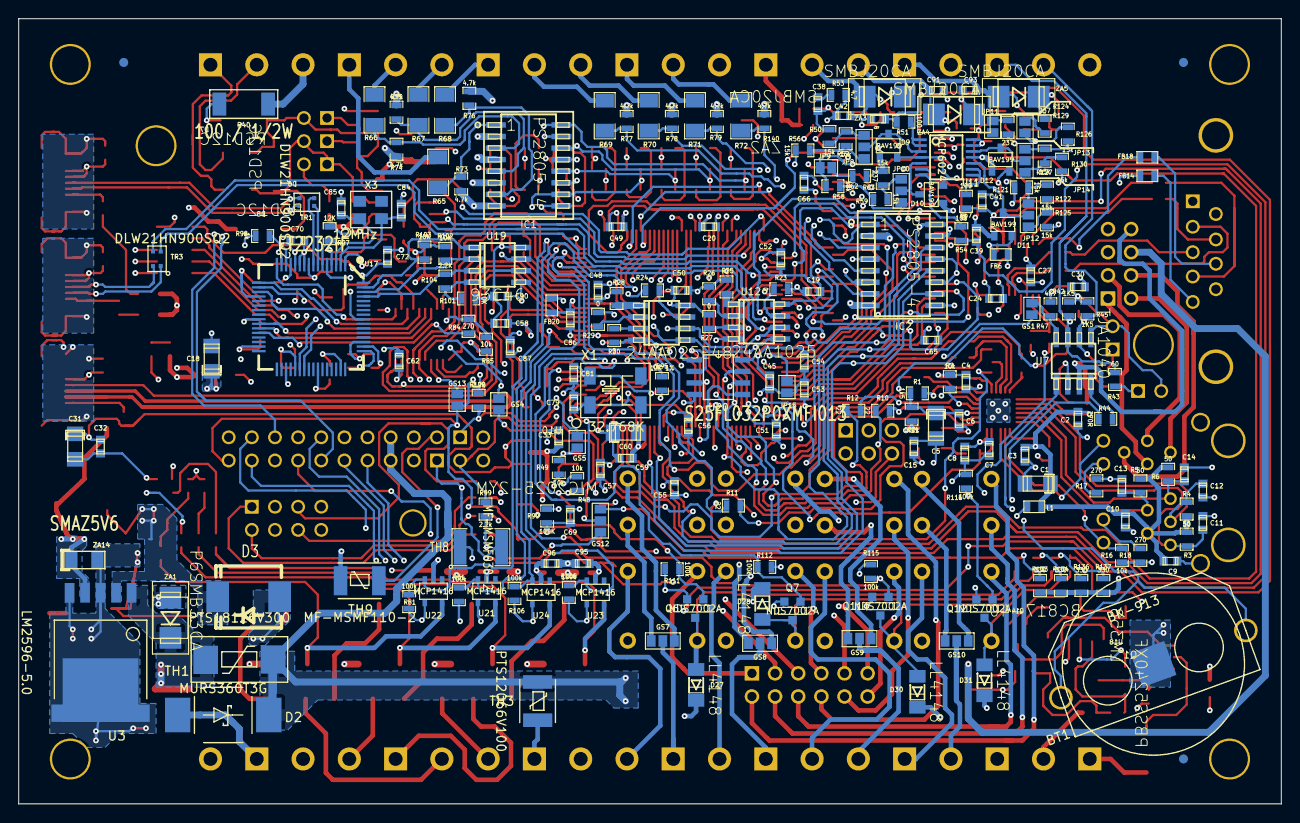
[picture p248: board ciaa-nxp.kicad_pcb from below]

Board: 4 copper layers, 138.6 x 86.2 mm, 443 parts (212 on the bottom side), 375 nets.

Parts:
BT1: BK-913; BK-913-ND
C1, C5, C18, C31, C34, C68, C78: 10uF; c_1206_tantalio_1
C2, C3, C4, C6, C9, C10, C15, C19, C20, C22, C23, C24, C25, C26, C27, C29, C30, C32, C33, C35, C37, C39, C41, C43, C45, C47, C48, C49, C50, C51, C52, C53, C54, C55, C56, C57, C58, C59, C61, C62, C63, C64, C65, C66, C67, C70, C71, C72, C73, C74, C75, C76, C77, C86, C87, C89, C90, C94, C95, C96: 100nF; c_0603
C7, C38, C40, C44, C92: 470pF; c_0603
C8, C36, C42, C91, C93: 1nF; c_0603
C11, C12, C13, C14: 18pF; c_0603
C16: 470uF; c_elec_10x10.5
C17: 330uF; c_elec_8x10
C21, C28: 10uF / 6V3; c_1206_tantalio
C46: 100nF; SMC0603
C60: 10uF; c_1206_tantalio
C69: 10nF; c_0603
C79, C81: 15p; c_0603
C80: 3.3uF; c_0603
C82, C83: 20p; c_0603
C84, C85: 22p; c_0603
C88: 10nF; SMC0603
C97, C98, C99, C100: 1uF; c_0603
D1, D5, D45: PMEG3020EH; SOD323
D2: MURS360T3G; CASE-403-03
D3: B540C-13-F; Diode-SMC_Standard_RevA_26July2010
D4, D13, D14, D15, D16, D17, D18, D19, D20, D21, D22, D23, D24, D33, D34, D35, D36: LED red; LED-0603
D6, D7, D8: PSD12C; DO214AA-1-2
D9, D10, D11, D12, D46, D48: BAV199; SOT23-DIODE
D27, D28, D30, D31: LL4148; MiniMelf
F1, F2, F3: fiducial; Fiducial_1mm_TOP
F4, F5, F6: fiducial; Fiducial_1mm_BOT
FB1, FB2, FB3, FB4, FB5, FB6, FB8, FB9, FB10, FB20, FB21: MMZ1608B601C; SM0603
FB7, FB11, FB14, FB15, FB16: BLM18KG221SN1; SM0603
FB12, FB13, FB17, FB18, FB19: BLM18BD470SN1; SM0603
GS1, GS2, GS3, GS4, GS5, GS11, GS13: GS2
GS6, GS7, GS8, GS9, GS10, GS12: GS3
H1, H2, H3, H4, H5, H6, H7: 4mm; 1pin
IC1, IC2: PS2805-4; -SOP16
J1, J2, J4, J8, J9, J10, J12, J13, J15, J16: TB_1X3; bornier3
J3: DB9-TH; K22X-E9P-NJ
J6: ZX62-AB-5PA; USB_microAB_ZX62-AB&B-5PA-11
J7: ZX62-B-5PA; USB_microAB_ZX62-AB&B-5PA-11
J11, J14, J17, J18, J19: TB_1X2; bornier2
JP1, JP2, JP4, JP5, JP6: JUMPER-2; PIN_ARRAY_2X1
JP3: JUMPER-2; GS2
JP7, JP9, JP11, JP13: JUMPER; GS2
JP8, JP10, JP12, JP14, JP16: JUMPER3; GS3
JP15: ISP; GS2
K1, K2, K3, K4: G5V-2-DC5; G5V-2
L1: BK1608HS220-T; SM0603
L2: 47uH; SRN1060
P1: SI-52003-F; RJ45_SI-52003-F_PoE_ETH
P2: CONN_6X2; PIN_ARRAY_6X2
P3: PoE; PIN_ARRAY_4X2
P8: Cortex-Debug; Pin_Array_5x2_1.27mm_SMD
P12: CONN_10X2; pin_array_10x2
P13: I2C; PIN_ARRAY_2X2
P14: SPI; PIN_ARRAY_3X2
P15: Analog; pin_array_4x2
P16: ZX62-B-5PA; USB_microAB_ZX62-AB&B-5PA-11
PS1, PS2: USMF020; SM1210
Q1: PBSS5240XF; -SOT89-321
Q2, Q3, Q4, Q5: FQT13N06L; SOT223_Opendous
Q6, Q7, Q11, Q12: NDS7002A; SOT23GDS
Q14: BC817-40; -SOT23
R1: 1k5; SM0603_Resistor
R2, R15, R16, R48, R49, R85, R117, R118, R119, R120: 10k; SM0603_Resistor
R3, R4, R5, R6: 50; SM0603_Resistor
R7, R8, R9, R13, R14, R23, R24, R25, R26, R27, R28, R29, R30, R86, R87, R88, R89: 0; SM0603_Resistor
R10, R11, R12: 22; SM0603_Resistor
R17, R18, R84: 270; SM0603_Resistor
R19: 12.1k 1%; SM0603_Resistor
R20: 24.9; SM0603_Resistor
R21, R31, R64, R81, R106, R108, R111, R112, R115, R116, R143, R145, R147, R149, R151, R153, R155: 100k; SM0603_Resistor
R22, R98: 1k; SM0603_Resistor
R32, R39: 390; SM0603_Resistor
R33, R38, R90, R92: 100K; SM0603_Resistor
R34, R36, R37, R41, R47: 4K7; SM0603_Resistor
R35: 220; SM0603_Resistor
R40: 100 / 1/2W; SMR2010
R42, R45: 1K5; SM0603_Resistor
R43, R46: 60; SM0603_Resistor
R44: 270R; SM0603_Resistor
R50, R52, R56, R58, R59, R63, R121, R122, R125, R126, R127, R130: 15k; SM0603_Resistor
R51, R54, R57, R60: 100; SM0603_Resistor
R53, R61, R123, R128: 4.7; SM0603_Resistor
R55, R62, R124, R129: 237; SM0603_Resistor
R65, R66, R67, R68, R69, R70, R71, R72: 3.3k; SM1206
R73, R74, R75, R76, R77, R78, R79, R140: 4.7k; SM0603_Resistor
R80: 33k; SM0603
R82: 15k; SM0603
R83: 24.9; SM0603
R91, R101, R102, R103: 10K; SM0603_Resistor
R93, R94: 15K; SM0603_Resistor
R95: 12K 1%; SM0603_Resistor
R96: 10M; SM0603_Resistor
R97: 12K; SM0603_Resistor
R99, R100, R141, R142, R144, R146, R148, R150, R152, R154: 2.2k; SM0603_Resistor
R104: 2.2K; SM0603_Resistor
R105: 2.49k; SM0603
R107: 2.2k; SM1206
R109: 10K; SM0603
R131, R132, R133, R134, R135, R136, R137, R138: 330; SM0603_Resistor
SW1: RST_SW; PUSH_SWITCH
TH1: PTS18126V300; MF-SM030
TH3, TH4, TH5, TH6, TH7: PTS12066V100; MF-MSMF
TH8: MF-MSMF030-2; SM1812
TH9: MF-MSMF110-2; MF-MSMF
TH10: MF-USMF005-2; MF-MSMF
TR1, TR2, TR3: DLW21HN900SQ2; SRF2012
U1: LAN8720A-CP; QFN24
U2: SI502; 4SMD
U3: LM2596-5.0; D2PACK5-LM2596
U4: NCP1117ST33T3G; SOT223
U5: SN65HVD1176DR; -SOIC8
U6: ST3232E; TSSOP16
U7: TJA1040; -SOIC8
U8: PESD1CAN; SOT23-3
U9: PRTR5V0U2X; sot143B
U10: MIC2025-2YM; -SOIC8
U11: MCP6024; TSSOP14
U12: 24AA1025; -SOIC8
U13: 24AA025E48; -SOIC8
U14: TXB0108; tssop-20
U15: IS42S16800F-7TL; TSOP54-M08-T2
U16: LPC4337JBD144; LQFP144-M05
U17: FT2232H; LQFP64-M05
U18: LM358; -SOIC8
U19: 93C46; -SOIC8
U20: S25FL032P0XMFI013; SO8
U21, U22, U23, U24: MCP1416; SOT23-5
X1: 32.768K; 4SOJ
X2, X3: 12MHz; FA238V-XTAL
ZA1: P6SMB33CA; -SMB
ZA2, ZA3, ZA4, ZA5: SMBJ20CA; -SMB
ZA14: SMAZ5V6; SOD123F

Connections:
+3.3V: C4.1, C5.1, C6.1, C15.1, C18.1, C19.1, C20.1, C23.1, C45.1, C47.2, C48.2, C49.2, C50.2, C51.2, C52.2, C53.2, C54.2, C55.2, C56.2, C57.2, C58.2, C61.2, C62.2, C63.1, C64.1, C65.1, C66.1, C73.1, C74.1, C75.1, C76.1, C90.1, FB6.1, FB8.2, FB9.2, L1.1, P8.1, R1.1, R2.1, R15.1, R16.1, R18.2, R21.2, R27.1, R28.1, R34.1, R49.1, R64.2, R90.2, R91.2, R92.2, R98.1, R99.1, R100.1, R101.1, R102.1, R103.1, R141.2, R142.2, R143.2, R144.2, R145.2, R146.2, R147.2, R148.2, R149.2, R150.2, R151.2, R152.2, R153.2, R154.2, R155.2, TH8.1, U1.9, U2.4, U4.2, U6.16, U12.8, U13.8, U14.2, U14.19, U15.1, U15.3, U15.9, U15.14, U15.27, U15.43, U15.49, U16.5, U16.25, U16.36, U16.41, U16.59, U16.71, U16.77, U16.94, U16.107, U16.111, U16.131, U16.141, U17.20, U17.31, U17.42, U17.50, U17.56, U19.6, U19.8, U20.8
+3.3VADC: C34.1, C35.1, C59.1, C60.2, C86.1, C87.1, D9.1, D10.1, D11.1, D12.1, FB6.2, U11.4, U16.16, U16.17, U16.137
+5V: C17.1, C21.2, C22.1, C28.2, C29.2, C33.1, C89.2, C94.2, C95.2, C96.2, C97.2, C98.2, C99.2, C100.2, D1.2, D5.2, D8.1, D27.2, D28.2, D30.2, D31.2, D45.2, K1.1, K2.1, K3.1, K4.1, L2.2, P3.8, R22.1, R32.1, R33.1, R133.2, R134.2, R136.2, R137.2, TH9.2, U3.4, U4.3, U5.8, U7.3, U10.7, U21.2, U22.2, U23.2, U24.2, ZA14.2
+24V: D2.2, FB21.1, P3.6, P12.5, P12.6, TH1.1, TH3.2
/CPU/AIN0: C37.1, R51.2, U16.2
/CPU/AIN1: C39.1, R54.2, U16.143
/CPU/AIN2: C41.1, R57.2, U16.139
/CPU/AIN3: C43.1, R60.2, U16.138
/CPU/AUX_CLK: P12.16, U16.99
/CPU/CAN_RD: R44.1, U16.114
/CPU/CAN_TD: U7.1, U16.116
/CPU/DIN0: D13.2, IC1.16, R64.1, U16.1
/CPU/DIN1: D14.2, IC1.14, R143.1, U16.3
/CPU/DIN2: D15.2, IC1.12, R145.1, U16.8
/CPU/DIN3: D16.2, IC1.10, R147.1, U16.7
/CPU/DIN4: D17.2, IC2.16, R149.1, U16.117
/CPU/DIN5: D18.2, IC2.14, R151.1, U16.132
/CPU/DIN6: D19.2, IC2.12, R153.1, U16.133
/CPU/DIN7: D20.2, IC2.10, R155.1, U16.134
/CPU/DOUT0: Q6.G, R111.1, U16.9
/CPU/DOUT1: Q7.G, R112.1, U16.10
/CPU/DOUT2: Q11.G, R115.1, U16.11
/CPU/DOUT3: Q12.G, R116.1, U16.81
/CPU/DOUT4: R106.1, U16.15, U24.3
/CPU/DOUT5: R81.1, U16.33, U22.3
/CPU/DOUT6: R108.1, U16.35, U23.3
/CPU/DOUT7: R31.1, U16.48, U21.3
/CPU/EECLK: R102.2, U17.62, U19.2
/CPU/EECS: R103.2, U17.63, U19.1
/CPU/EEDATA: R104.1, U17.61, U19.3
/CPU/EMA_A1: U15.24, U16.104
/CPU/EMA_A2: U15.25, U16.105
/CPU/EMA_A6: U15.31, U16.42
/CPU/EMC_A0: U15.23, U16.102
/CPU/EMC_A3: U15.26, U16.106
/CPU/EMC_A4: U15.29, U16.108
/CPU/EMC_A5: U15.30, U16.38
/CPU/EMC_A7: U15.32, U16.43
/CPU/EMC_A8: U15.33, U16.98
/CPU/EMC_A9: JP15.2, U15.34, U16.96
/CPU/EMC_A10: U15.22, U16.95
/CPU/EMC_A11: U15.35, U16.84
/CPU/EMC_A13: U15.20, U16.75
/CPU/EMC_A14: U15.21, U16.86
/CPU/EMC_CAS: U15.17, U16.80
/CPU/EMC_CKE: U15.37, U16.101
/CPU/EMC_CLK0: U15.38, U16.45
/CPU/EMC_D0: U15.2, U16.50
/CPU/EMC_D1: U15.4, U16.51
/CPU/EMC_D2: U15.5, U16.52
/CPU/EMC_D3: U15.7, U16.53
/CPU/EMC_D4: U15.8, U16.55
/CPU/EMC_D5: U15.10, U16.56
/CPU/EMC_D6: U15.11, U16.60
/CPU/EMC_D7: U15.13, U16.61
/CPU/EMC_D8: U15.42, U16.57
/CPU/EMC_D9: U15.44, U16.58
/CPU/EMC_D10: U15.45, U16.63
/CPU/EMC_D11: U15.47, U16.65
/CPU/EMC_D12: U15.48, U16.37
/CPU/EMC_D13: U15.50, U16.39
/CPU/EMC_D14: U15.51, U16.46
/CPU/EMC_D15: U15.53, U16.54
/CPU/EMC_DYCS: U15.19, U16.97
/CPU/EMC_LDQM: U15.15, U16.103
/CPU/EMC_RAS: U15.18, U16.82
/CPU/EMC_UDQM: U15.39, U16.100
/CPU/EMC_WE: U15.16, U16.49
/CPU/ENET_CRS_DV: R12.1, U16.64
/CPU/ENET_MDC: R14.1, U16.140
/CPU/ENET_MDIO: R13.1, U16.66
/CPU/ENET_REF_CLK: R20.2, U1.5, U16.68
/CPU/ENET_RXD0: R10.1, U16.62
/CPU/ENET_RXD1: R11.1, U16.32
/CPU/ENET_TXD0: R7.1, U16.67
/CPU/ENET_TXD1: R8.1, U16.70
/CPU/ENET_TX_EN: R9.1, U16.34
/CPU/FT_OE: R84.2, U17.28
/CPU/FT_RST: U14.7, U17.27
/CPU/FT_TCK: U14.1, U17.16
/CPU/FT_TDI: U14.3, U17.17
/CPU/FT_TDO: U14.4, U17.18
/CPU/FT_TMS: U14.5, U17.19
/CPU/FT_TRST: U14.6, U17.26
/CPU/FT_XTIN: C84.2, U17.2, X3.2
/CPU/FT_XTOUT: C85.2, U17.3, X3.1
/CPU/GPIO0: GS6.3, P12.7, U16.74
/CPU/GPIO1: GS1.1, P12.8, U16.91
/CPU/GPIO2: GS2.1, P12.9, U16.110
/CPU/GPIO3: GS3.1, P12.10, P14.5, U16.85
/CPU/GPIO_AIN0_DAC: GS12.2, U16.6
/CPU/I2C_SCL: P13.2, R99.2, U12.6, U13.6, U16.92
/CPU/I2C_SDA: P13.1, R100.2, U12.5, U13.5, U16.93
/CPU/RS232_RXD: U6.12, U16.88
/CPU/RS232_TXD: U6.11, U16.87
/CPU/RS485_DIR: JP3.1, R37.1, U5.3, U16.78
/CPU/RS485_RXD: R34.2, U5.1, U16.72
/CPU/RS485_TXD: U5.4, U16.69
/CPU/RST: GS13.1, U14.14
/CPU/RTCX1: C81.2, U16.125, X1.4
/CPU/RTCX2: C79.2, U16.126, X1.1
/CPU/SPIFI_CS: U16.124, U20.1
/CPU/SPIFI_IO2: U16.121, U20.3
/CPU/SPIFI_IO3: U16.119, U20.7
/CPU/SPIFI_MISO: U16.122, U20.2
/CPU/SPIFI_MOSI: U16.123, U20.5
/CPU/SPI_MISO: P14.1, U16.44
/CPU/SPI_MOSI: P14.2, U16.47
/CPU/SPI_SCK: P14.6, U16.120
/CPU/TCK: P8.4, U14.20, U16.27
/CPU/TDI: P8.8, U14.18, U16.26
/CPU/TDO: P8.6, U14.17, U16.31
/CPU/TMS: P8.2, U14.16, U16.30
/CPU/TRST: GS11.1, U14.15
/CPU/U2_RXD: U16.115, U17.38
/CPU/U2_TXD: U16.113, U17.39
/CPU/USB_AUX_DM: TR3.2, U16.90
/CPU/USB_AUX_DP: TR3.3, U16.89
/CPU/USB_DEBUG_VBUS: D1.1, FB11.2
/CPU/USB_DM: R94.1, TR2.2, U9.2, U16.20
/CPU/USB_DP: R93.1, TR2.3, U9.3, U16.18
/CPU/USB_ID: J6.4, U16.22
/CPU/USB_JTAG_1.8V: C70.1, C71.1, C72.1, C80.1, U17.12, U17.37, U17.49, U17.64
/CPU/USB_JTAG_DM: TR1.2, U17.7
/CPU/USB_JTAG_DP: TR1.3, U17.8
/CPU/USB_VBUS: C31.1, C32.1, D5.1, FB15.2, U9.4, U10.6, U10.8, U16.21
/CPU/XTAL1: C82.2, R96.2, U16.12, X2.2
/CPU/XTAL2: C83.2, R96.1, U16.13, X2.1
/CPU/nTRST: GS11.2, R92.1, U16.29
/Entradas Digitales/COM: IC1.2, IC1.4, IC1.6, IC1.8, IC2.2, IC2.4, IC2.6, IC2.8, J9.3, R73.1, R74.1, R75.1, R76.1, R77.1, R78.1, R79.1, R140.1
/Entradas Digitales/IN0: J1.1, R65.1
/Entradas Digitales/IN1: J1.2, R66.1
/Entradas Digitales/IN2: J1.3, R67.1
/Entradas Digitales/IN3: J8.1, R68.1
/Entradas Digitales/IN4: J8.2, R69.1
/Entradas Digitales/IN5: J8.3, R70.1
/Entradas Digitales/IN6: J9.1, R71.1
/Entradas Digitales/IN7: J9.2, R72.1
/Ethernet/LED_100M: P1.15, R16.2, U1.2
/Ethernet/LED_LINK: P1.12, U1.3
/Ethernet/PHY_nRESET: GS6.2, U1.15
/GPIO/AN0: GS12.3, R117.1
/GPIO/AN1: R119.1, U16.144
/GPIO/AN2: R118.1, U16.142
/GPIO/AN3: R120.1, U16.136
/GPIO/GPIO4: P12.11, U16.73
/GPIO/GPIO5: P12.12, U16.112
/GPIO/GPIO6: P12.13, U16.14
/GPIO/GPIO7: GS4.1, P12.14, U16.79
/GPIO/GPIO8: GS5.1, P12.15, U16.83
/GPIO/GPIO10: P12.17, U16.129
/GPIO/GPIO11: P12.18, U16.130
/GPIO/GPIO12: C69.1, GS6.1, GS13.2, P8.10, P12.19, R90.1, SW1.1, SW1.2, U16.128
/GPIO/USB_VBUS: D45.1, FB16.2
/GPIO/USR_3.3V: P12.1, P13.3, P14.3, TH8.2
/GPIO/USR_5V: P12.2, TH9.1
/Memorias NV/SPIFI_CLK: U16.118, U20.6
/RS485_RS232_CAN/CAN_H: J4.1, R42.2, R43.1, U7.7, U8.2
/RS485_RS232_CAN/CAN_L: J4.2, R45.1, R46.1, U7.6, U8.1
/RS485_RS232_CAN/CAN_STB: GS1.2, R47.2, U7.8
/RS485_RS232_CAN/RS232_CTS: GS3.2, U6.9
/RS485_RS232_CAN/RS232_RTS: GS2.2, R41.1, U6.10
/Salida Analógica/24V_A: C46.1, D46.3, D48.1, FB21.2, U18.8
/Salida Analógica/DAC_OUT: GS12.1, U18.3
/Salidas Digitales/C1A: J10.2, K1.4
/Salidas Digitales/C1B: K1.13, P2.1
/Salidas Digitales/C2A: J11.2, K2.4
/Salidas Digitales/C2B: K2.13, P2.7
/Salidas Digitales/C3A: J12.3, K3.4
/Salidas Digitales/C3B: K3.13, P2.12
/Salidas Digitales/C4A: J12.1, K4.4
/Salidas Digitales/C4B: K4.13, P2.6
/Salidas Digitales/NC1A: GS7.1, K1.6
/Salidas Digitales/NC1B: K1.11, P2.3
/Salidas Digitales/NC2A: GS8.1, K2.6
/Salidas Digitales/NC2B: K2.11, P2.9
/Salidas Digitales/NC3A: GS9.1, K3.6
/Salidas Digitales/NC3B: K3.11, P2.10
/Salidas Digitales/NC4A: GS10.1, K4.6
/Salidas Digitales/NC4B: K4.11, P2.4
/Salidas Digitales/NO1A: GS7.3, K1.8
/Salidas Digitales/NO1B: K1.9, P2.5
/Salidas Digitales/NO2A: GS8.3, K2.8
/Salidas Digitales/NO2B: K2.9, P2.11
/Salidas Digitales/NO3A: GS9.3, K3.8
/Salidas Digitales/NO3B: K3.9, P2.8
/Salidas Digitales/NO4A: GS10.3, K4.8
/Salidas Digitales/NO4B: K4.9, P2.2
/USB OTG/USB0_PPWR: GS4.2, R48.2, U10.1
/USB OTG/USB0_PWR_FAULT: GS5.2, R49.2, U10.2
GND: BT1.2, C1.2, C2.2, C3.2, C4.2, C5.2, C6.2, C7.2, C8.2, C9.2, C10.2, C11.2, C12.2, C13.2, C14.2, C15.2, C16.2, C17.2, C18.2, C19.2, C20.2, C21.1, C22.2, C23.2, C25.2, C27.2, C28.1, C29.1, C30.2, C31.2, C32.2, C33.2, C45.2, C47.1, C48.1, C49.1, C50.1, C51.1, C52.1, C53.1, C54.1, C55.1, C56.1, C57.1, C58.1, C61.1, C62.1, C63.2, C64.2, C65.2, C66.2, C67.2, C68.2, C69.2, C70.2, C71.2, C72.2, C73.2, C74.2, C75.2, C76.2, C77.2, C78.2, C79.1, C80.2, C81.1, C82.1, C83.1, C84.1, C85.1, C89.1, C90.2, C94.1, C95.1, C96.1, C97.1, C98.1, C99.1, C100.1, D3.1, D4.2, D7.2, D21.2, D22.2, D33.2, D36.2, FB1.1, FB7.2, FB10.1, FB14.2, FB20.1, IC1.9, IC1.11, IC1.13, IC1.15, IC2.9, IC2.11, IC2.13, IC2.15, J3.10, J3.11, J4.3, J6.5, J7.4, J7.5, J10.3, J14.1, J18.2, JP15.1, P1.6, P1.7, P1.16, P1.17, P3.5, P3.7, P8.3, P8.5, P8.9, P12.3, P12.4, P13.4, P14.4, P16.4, P16.5, Q2.3, Q3.3, Q4.3, Q5.3, Q6.S, Q7.S, Q11.S, Q12.S, R17.1, R19.2, R23.2, R24.2, R25.1, R26.1, R29.1, R30.1, R31.2, R36.2, R37.2, R38.2, R39.2, R40.1, R41.2, R47.1, R48.1, R81.2, R85.2, R86.1, R87.1, R88.1, R89.1, R93.2, R94.2, R95.2, R97.1, R106.2, R108.2, R111.2, R112.2, R115.2, R116.2, SW1.3, SW1.4, U1.GND, U2.2, U3.3, U3.5, U4.1, U5.5, U6.15, U7.2, U8.3, U9.1, U10.3, U12.4, U13.4, U14.11, U15.6, U15.12, U15.28, U15.41, U15.46, U15.52, U15.54, U16.4, U16.40, U16.76, U16.109, U17.1, U17.5, U17.10, U17.11, U17.13, U17.15, U17.25, U17.35, U17.47, U17.51, U19.5, U19.7, U20.4, U21.4, U22.4, U23.4, U24.4, ZA1.2, ZA14.1
GNDA: C34.2, C35.2, C36.2, C37.2, C39.2, C41.2, C42.2, C43.2, C46.2, C59.2, C60.1, C86.2, C87.2, C88.1, C91.2, C93.2, D9.3, D10.3, D11.3, D12.3, D48.3, FB20.2, J17.2, J19.2, P15.3, P15.4, P15.7, P15.8, R53.1, R55.1, R56.1, R61.1, R62.1, R63.1, R82.1, R109.1, R123.1, R124.1, R125.1, R128.1, R129.1, R130.1, U11.11, U16.19, U16.23, U16.135, U18.4, ZA2.1, ZA3.1, ZA4.1, ZA5.1
unnamed: R84.1, R85.1, U14.10
unnamed: R89.2, U14.13
unnamed: R86.2, U14.8
unnamed: R88.2, U14.12
unnamed: R87.2, U14.9
unnamed: R97.2, U17.6
unnamed: R98.2, U17.14
unnamed: R101.2, R104.2, U19.4
unnamed: FB7.1, J7.6, J7.7
unnamed: J7.3, TR1.4
unnamed: J7.2, TR1.1
unnamed: BT1.1, U16.127
unnamed: C67.1, C68.1, FB8.1, U17.9
unnamed: FB11.1, J7.1
unnamed: C77.1, C78.1, FB9.1, U17.4
unnamed: R91.1, U16.28
unnamed: R95.1, U16.24
unnamed: C24.1, U6.1
unnamed: C26.1, U6.4
unnamed: C24.2, U6.3
unnamed: J2.2, PS2.2
unnamed: JP3.2, R36.1, U5.2
unnamed: J2.3, R40.2
unnamed: J2.1, PS1.2
unnamed: C26.2, U6.5
unnamed: D6.2, D7.1, JP4.2, PS2.1, R35.2, R38.1, U5.7
unnamed: JP4.1, R39.1
unnamed: JP1.2, R32.2
unnamed: JP2.1, R35.1
unnamed: D6.1, D8.2, JP1.1, JP2.2, PS1.1, R33.2, U5.6
unnamed: JP5.1, R43.2
unnamed: JP6.1, R46.2
unnamed: FB13.1, U6.13
unnamed: FB12.1, U6.7
unnamed: FB18.1, U6.8
unnamed: FB18.2, J3.8
unnamed: FB19.1, U6.14
unnamed: FB17.2, J3.4
unnamed: C25.1, FB17.1, U6.2
unnamed: FB19.2, J3.3
unnamed: R44.2, U7.4
unnamed: FB14.1, J3.5
unnamed: FB13.2, J3.2
unnamed: FB12.2, J3.7
unnamed: C30.1, JP5.2, JP6.2, R42.1, R45.2, U7.5
unnamed: C27.1, U6.6
unnamed: R28.2, U13.1
unnamed: R29.2, U13.2
unnamed: R30.2, U13.3
unnamed: R24.1, U13.7
unnamed: R27.2, U12.3
unnamed: R25.2, U12.1
unnamed: R26.2, U12.2
unnamed: R23.1, U12.7
unnamed: C16.1, TH1.2, U3.1, ZA1.1
unnamed: D2.1, J18.1
unnamed: D3.2, L2.1, U3.2
unnamed: D4.1, R22.2
unnamed: R19.1, U1.24
unnamed: C12.1, P1.3, R4.2, U1.20
unnamed: P1.14, R18.1
unnamed: P1.13, R17.2
unnamed: R11.2, U1.7
unnamed: R12.2, U1.11
unnamed: R14.2, U1.13
unnamed: R1.2, R13.2, U1.12
unnamed: R10.2, U1.8
unnamed: R7.2, U1.17
unnamed: R8.2, U1.18
unnamed: R9.2, U1.16
unnamed: R2.2, U1.10
unnamed: C14.1, P1.5, R6.2, U1.22
unnamed: C11.1, P1.1, R3.2, U1.21
unnamed: P1.11, P3.4
unnamed: P1.8, P3.1
unnamed: C1.1, C2.1, C3.1, C9.1, C10.1, L1.2, P1.2, R3.1, R4.1, R5.1, R6.1, U1.1, U1.19
unnamed: C13.1, P1.4, R5.2, U1.23
unnamed: P1.10, P3.3
unnamed: P1.9, P3.2
unnamed: R20.1, U2.3
unnamed: R15.2, U1.14
unnamed: R21.1, U2.1
unnamed: C7.1, C8.1, U1.6
unnamed: FB1.2, J6.6, J6.7
unnamed: J6.2, TR2.1
unnamed: J6.3, TR2.4
unnamed: FB15.1, J6.1
unnamed: C40.2, R61.2
unnamed: JP9.1, R62.2
unnamed: JP10.3, R58.1, R59.2
unnamed: JP10.1, R59.1, R63.2
unnamed: JP8.3, R50.1, R52.2
unnamed: JP8.1, R52.1, R56.2
unnamed: C42.1, FB3.1, J16.2, ZA3.2
unnamed: C44.2, R123.2
unnamed: JP11.1, R124.2
unnamed: JP12.3, R121.1, R122.2
unnamed: C40.1, FB3.2, JP9.2, R58.2
unnamed: D10.2, JP10.2, U11.5
unnamed: R57.1, U11.8, U11.9
unnamed: R60.1, U11.13, U11.14
unnamed: C36.1, FB2.1, J16.1, ZA2.2
unnamed: R54.1, U11.6, U11.7
unnamed: JP7.1, R55.2
unnamed: D9.2, JP8.2, U11.3
unnamed: R51.1, U11.1, U11.2
unnamed: C38.1, FB2.2, JP7.2, R50.2
unnamed: C38.2, R53.2
unnamed: JP14.3, R126.1, R127.2
unnamed: JP14.1, R127.1, R130.2
unnamed: C91.1, FB4.1, J16.3, ZA4.2
unnamed: C93.1, FB5.1, J17.1, ZA5.2
unnamed: JP12.1, R122.1, R125.2
unnamed: D11.2, JP12.2, U11.10
unnamed: C92.1, FB5.2, JP13.2, R126.2
unnamed: C44.1, FB4.2, JP11.2, R121.2
unnamed: D12.2, JP14.2, U11.12
unnamed: JP13.1, R129.2
unnamed: C92.2, R128.2
unnamed: FB16.1, P16.1
unnamed: P16.3, TR3.4
unnamed: P16.2, TR3.1
unnamed: P15.5, R119.2
unnamed: P15.2, R118.2
unnamed: P15.6, R120.2
unnamed: P15.1, R117.2
unnamed: FB10.2, P16.6, P16.7
unnamed: IC2.3, R70.2, R78.2
unnamed: D17.1, R148.1
unnamed: D18.1, R150.1
unnamed: D16.1, R146.1
unnamed: IC2.1, R69.2, R77.2
unnamed: D20.1, R154.1
unnamed: IC2.7, R72.2, R140.2
unnamed: D19.1, R152.1
unnamed: IC2.5, R71.2, R79.2
unnamed: D13.1, R141.1
unnamed: IC1.1, R65.2, R73.2
unnamed: IC1.3, R66.2, R74.2
unnamed: D15.1, R144.1
unnamed: IC1.7, R68.2, R76.2
unnamed: IC1.5, R67.2, R75.2
unnamed: D14.1, R142.1
unnamed: Q3.4, TH5.1
unnamed: Q4.4, TH6.1
unnamed: Q2.4, TH4.1
unnamed: D22.1, R132.1
unnamed: Q3.1, R132.2, U22.5
unnamed: D21.1, R131.1
unnamed: Q2.1, R131.2, U24.5
unnamed: J15.2, TH4.2
unnamed: J15.1, TH3.1
unnamed: J13.2, TH7.2
unnamed: J13.1, TH6.2
unnamed: D30.1, D34.2, K3.16, Q11.D
unnamed: D34.1, R136.1
unnamed: GS9.2, J12.2
unnamed: GS8.2, J11.1
unnamed: GS7.2, J10.1
unnamed: GS10.2, J14.2
unnamed: D36.1, R138.1
unnamed: D23.1, R133.1
unnamed: Q5.1, R138.2, U21.5
unnamed: D23.2, D27.1, K1.16, Q6.D
unnamed: D33.1, R135.1
unnamed: Q4.1, R135.2, U23.5
unnamed: D31.1, D35.2, K4.16, Q12.D
unnamed: D35.1, R137.1
unnamed: D24.2, D28.1, K2.16, Q7.D
unnamed: D24.1, R134.1
unnamed: Q5.4, TH7.1
unnamed: J15.3, TH5.2
unnamed: Q14.3, R105.1, U18.5
unnamed: Q14.1, U18.1
unnamed: Q14.2, R107.2
unnamed: JP16.1, R80.1, R107.1
unnamed: Q1.3, U18.7
unnamed: Q1.1, R83.1, U18.6
unnamed: D46.1, R83.2, R105.2, R109.2
unnamed: R80.2, R82.2, U18.2
unnamed: J19.1, TH10.2
unnamed: D48.2, JP16.2, TH10.1
unnamed: C88.2, JP16.3, Q1.2
