ciaa/Hardware/PCB/Safety/CIAA_Safety_VTI_1.0.kicad_pcb

## KiCad design PCB/Safety/CIAA_Safety_VTI_1.0.kicad_pcb (2020-02-26)

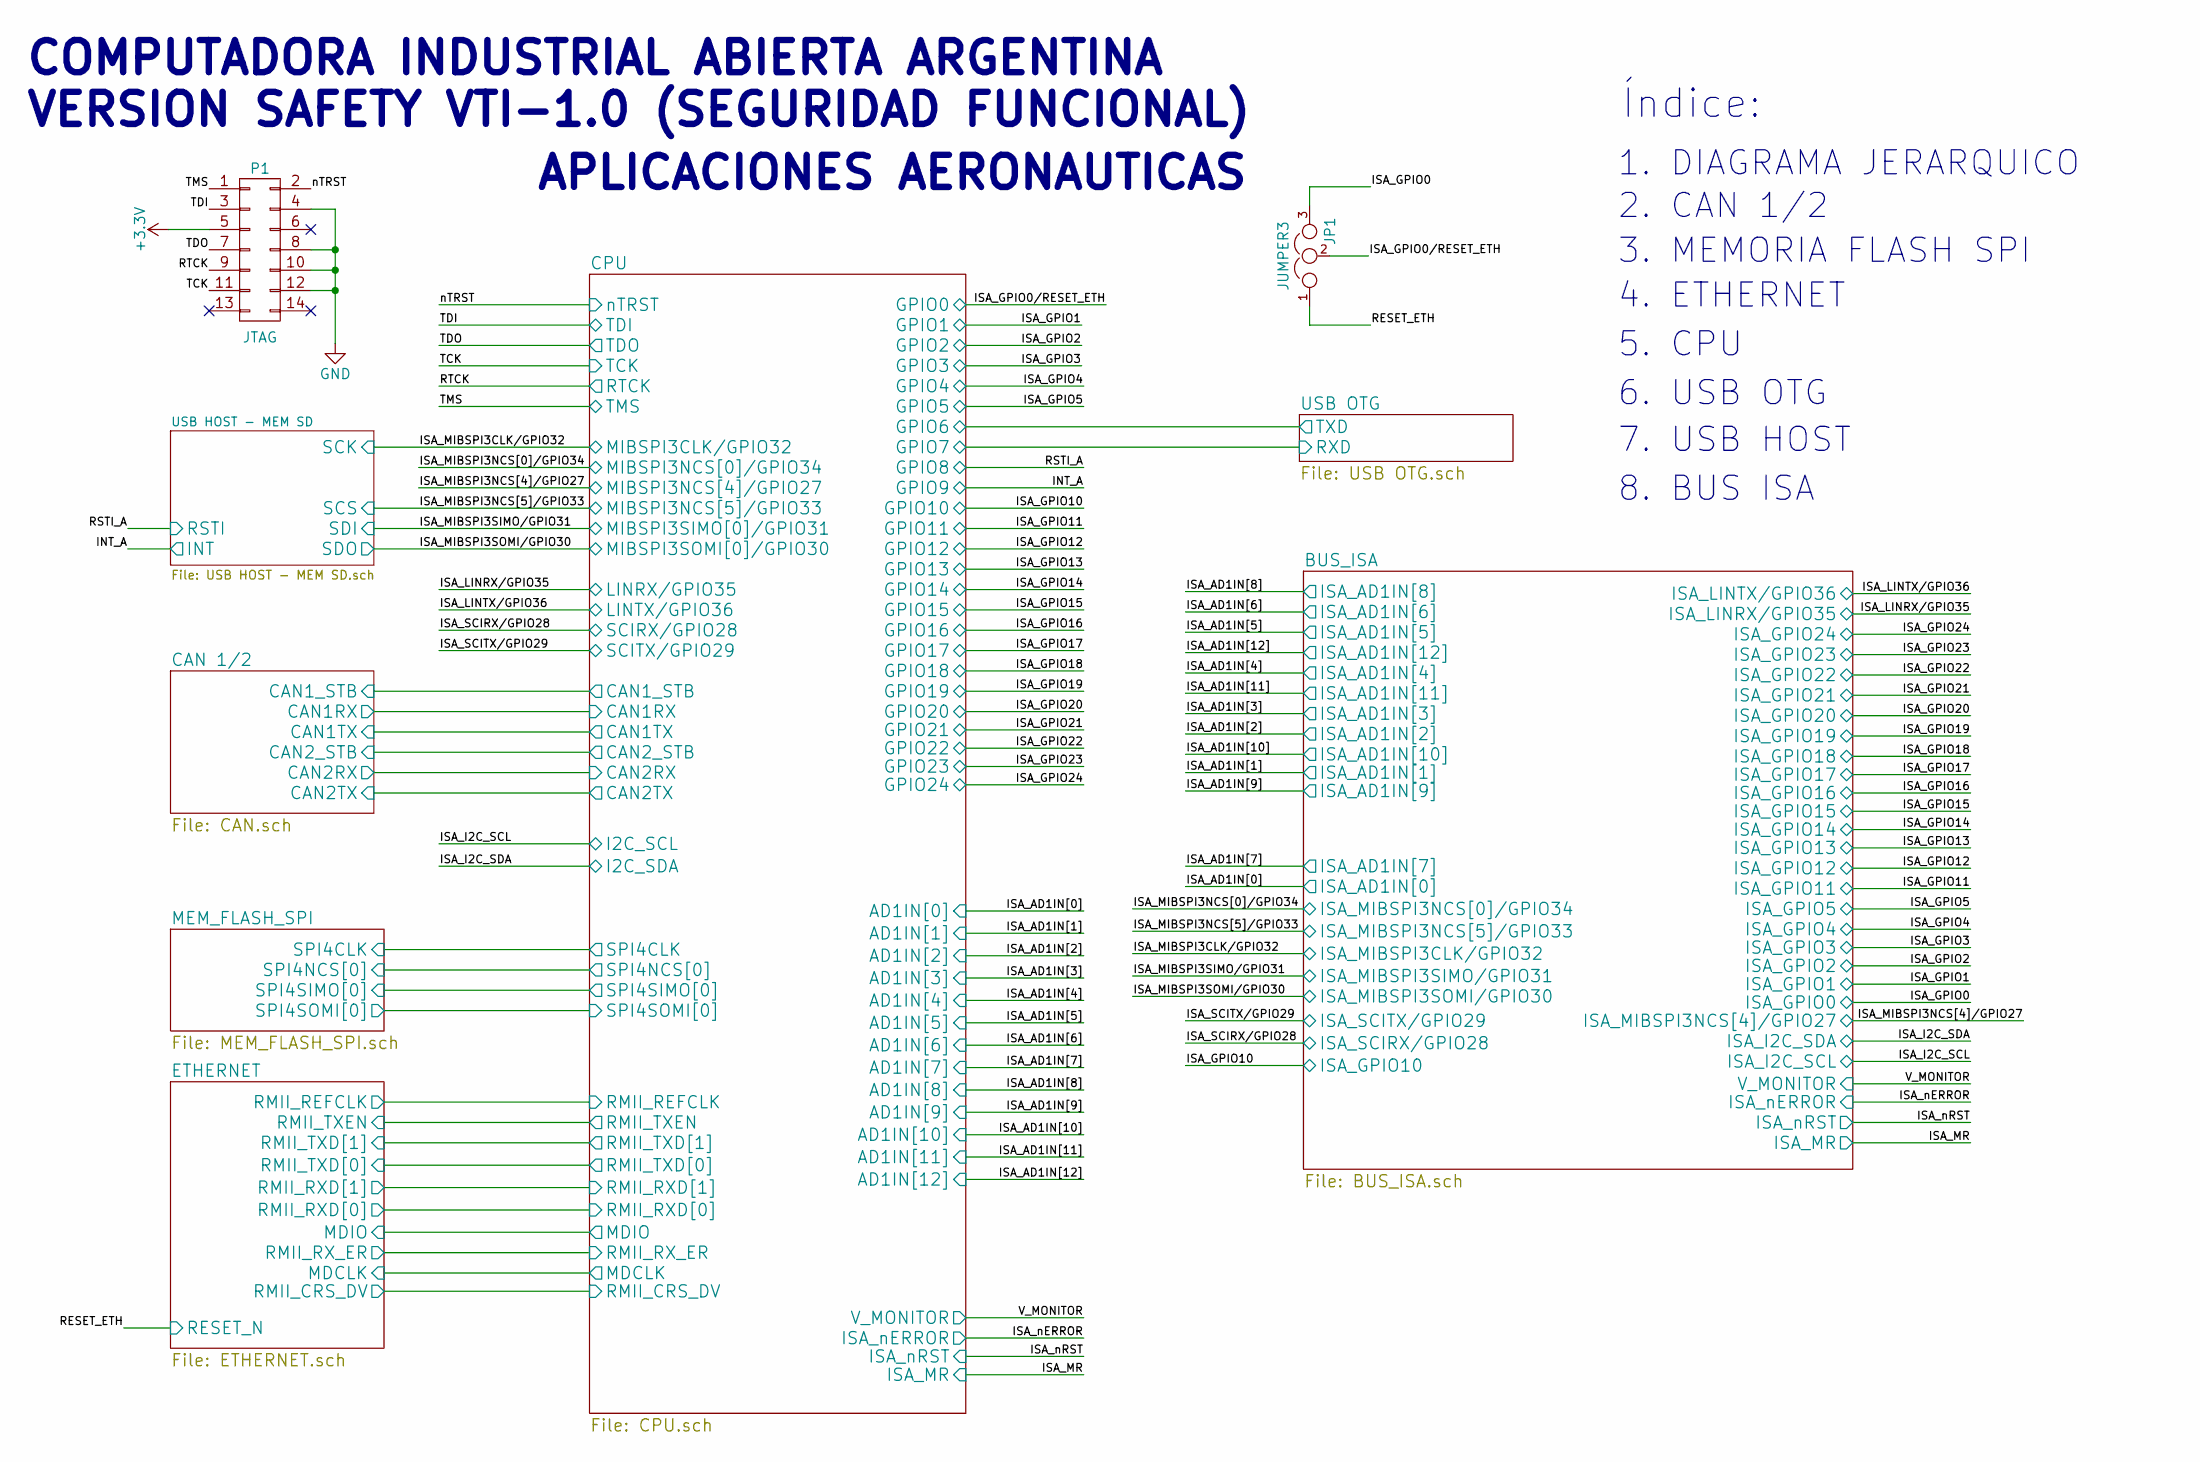
[picture p249: schematic CIAA_Safety_VTI_1.0.sch, MÓDULO PROCESADOR SAFETY]

Parts:
JP1: JUMPER3; pin_strip_3; Digikey 952-2263-ND
P1: JTAG; vasch_strip_7x2_90

Connections:
+3V3: P1.5; also elsewhere on the board
/ISA_GPIO0: JP1.3; also elsewhere on the board
/ISA_GPIO0/RESET_ETH: JP1.2; also elsewhere on the board
/RESET_ETH: JP1.1; also elsewhere on the board
/RTCK: P1.9; also elsewhere on the board
/TCK: P1.11; also elsewhere on the board
/TDI: P1.3; also elsewhere on the board
/TDO: P1.7; also elsewhere on the board
/TMS: P1.1; also elsewhere on the board
/nTRST: P1.2; also elsewhere on the board
GND: P1.4, P1.8, P1.10, P1.12; also elsewhere on the board

Notes on the sheet:
COMPUTADORA INDUSTRIAL ABIERTA ARGENTINA VERSION SAFETY VTI-1.0 (SEGURIDAD FUNCIONAL)
Índice:
1. DIAGRAMA JERARQUICO
2. CAN 1/2
3. MEMORIA FLASH SPI
4. ETHERNET
5. CPU
6. USB OTG
7. USB HOST
8. BUS ISA
APLICACIONES AERONAUTICAS

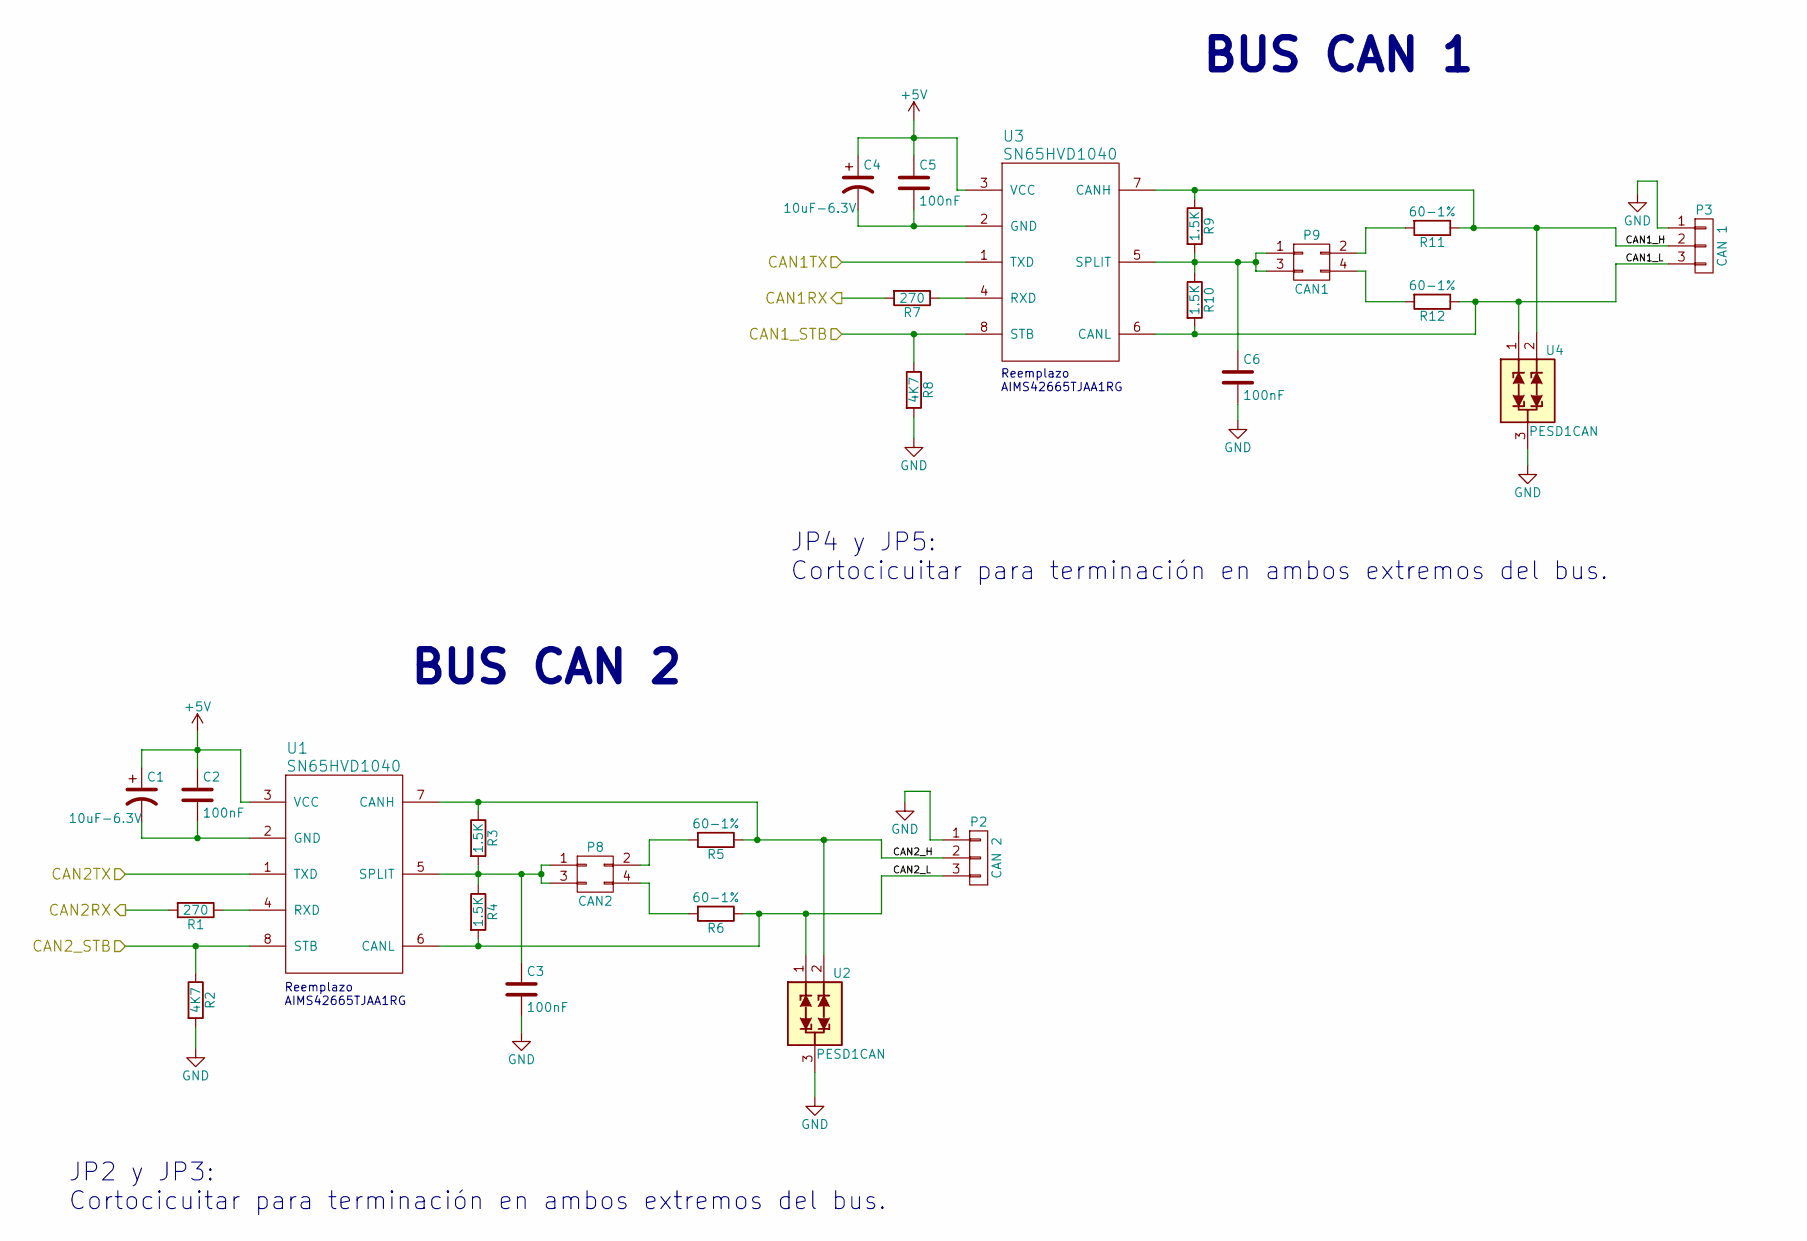
[picture p250: schematic CAN.sch, MODULO PROCESADOR SAFETY-PUERTO CAN 1 Y 2]

Parts:
C1, C4: 10uF-6.3V; c_tant_A; Digikey 399-3685-1-ND
C2, C3, C5, C6: 100nF; c_0603; Digikey 478-5266-1-ND
P2: CAN 2; mkds_1,5-3; Digikey 277-1248-ND
P3: CAN 1; mkds_1,5-3; Digikey 277-1248-ND
P8: CAN2; pin_socket_2x2; Digikey WM8152-ND
P9: CAN1; pin_socket_2x2; Digikey WM8152-ND
R1, R7: 270; r_0603; Digikey P270AGCT-ND
R2, R8: 4K7; r_0603; Digikey P4.70KABCT-ND
R3, R4, R9, R10: 1.5K; r_0603; Digikey 311-1.5KGRCT-ND
R5, R6, R11, R12: 60-1%; r_0603; Digikey 311-60.4HRCT-ND
U1, U3: SN65HVD1040; so-8; Digikey 296-21804-1-ND
U2, U4: PESD1CAN; sot23; Digikey 1727-3817-1-ND

Connections:
+5V: C1.1, C2.1, C4.1, C5.1, U1.3 (VCC), U3.3 (VCC); also elsewhere on the board
/CAN 1/2/CAN1RX: R7.2; also elsewhere on the board
/CAN 1/2/CAN1TX: U3.1 (TXD); also elsewhere on the board
/CAN 1/2/CAN1_H: P3.2, R9.1, R11.1, U3.7 (CANH), U4.2
/CAN 1/2/CAN1_L: P3.3, R10.2, R12.1, U3.6 (CANL), U4.1
/CAN 1/2/CAN1_STB: R8.1, U3.8 (STB); also elsewhere on the board
/CAN 1/2/CAN2RX: R1.2; also elsewhere on the board
/CAN 1/2/CAN2TX: U1.1 (TXD); also elsewhere on the board
/CAN 1/2/CAN2_H: P2.2, R3.1, R5.1, U1.7 (CANH), U2.2
/CAN 1/2/CAN2_L: P2.3, R4.2, R6.1, U1.6 (CANL), U2.1
/CAN 1/2/CAN2_STB: R2.1, U1.8 (STB); also elsewhere on the board
GND: C3.2, C6.2, P2.1, P3.1, R2.2, R8.2, U2.3, U4.3; also elsewhere on the board
unnamed: C1.2, C2.2, U1.2 (GND)
unnamed: C3.1, P8.1, P8.3, R3.2, R4.1, U1.5 (SPLIT)
unnamed: C4.2, C5.2, U3.2 (GND)
unnamed: C6.1, P9.1, P9.3, R9.2, R10.1, U3.5 (SPLIT)
unnamed: P8.2, R5.2
unnamed: P8.4, R6.2
unnamed: P9.2, R11.2
unnamed: P9.4, R12.2
unnamed: R1.1, U1.4 (RXD)
unnamed: R7.1, U3.4 (RXD)

Notes on the sheet:
BUS CAN 1
BUS CAN 2
JP2 y JP3: Cortocicuitar para terminación en ambos extremos del bus.
JP4 y JP5: Cortocicuitar para terminación en ambos extremos del bus.
Reemplazo AIMS42665TJAA1RG

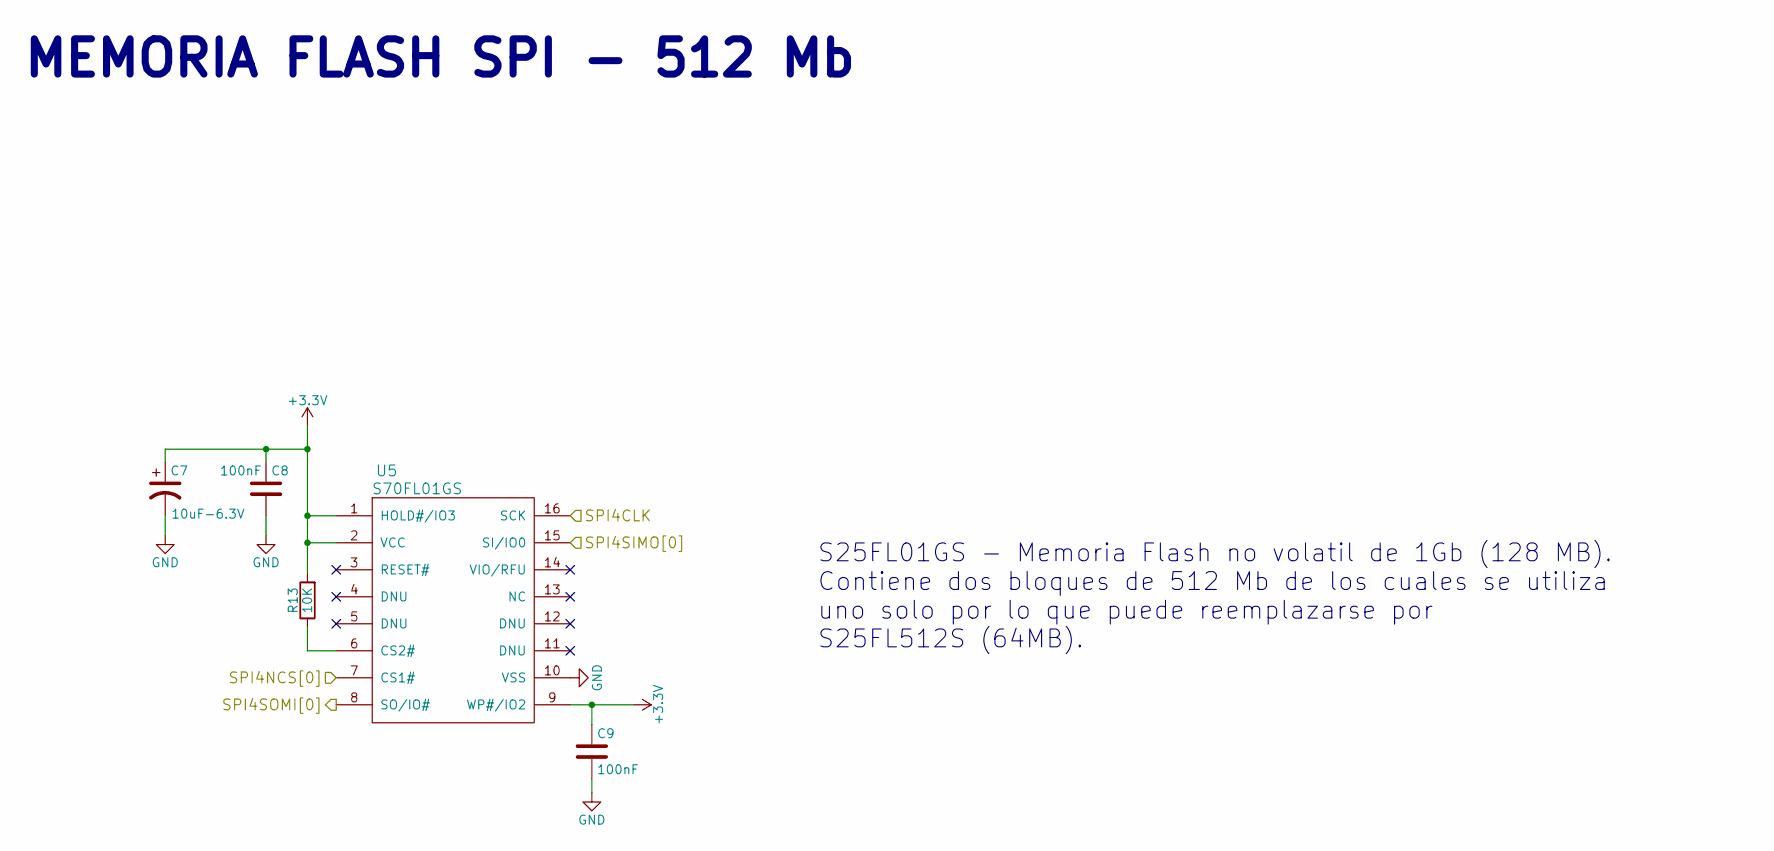
[picture p251: schematic MEM_FLASH_SPI.sch, MODULO PROCESADOR SAFETY-MEMORIA FLASH SPI]

Parts:
C7: 10uF-6.3V; c_tant_A; Digikey 399-3685-1-ND
C8, C9: 100nF; c_0603; Digikey 478-5266-1-ND
R13: 10K; r_0603; Digikey 311-10KGRCT-ND
U5: S70FL01GS; soic-16; Digikey 428-4016-1-ND

Connections:
+3V3: C7.1, C8.1, C9.1, R13.2, U5.1 (HOLD#/IO3), U5.2 (VCC), U5.9 (WP#/IO2); also elsewhere on the board
/CPU/SPI4CLK: U5.16 (SCK); also elsewhere on the board
/CPU/SPI4NCS[0]: U5.7 (CS1#); also elsewhere on the board
/CPU/SPI4SIMO[0]: U5.15 (SI/IO0); also elsewhere on the board
/CPU/SPI4SOMI[0]: U5.8 (SO/IO#); also elsewhere on the board
GND: C7.2, C8.2, C9.2, U5.10 (VSS); also elsewhere on the board
unnamed: R13.1, U5.6 (CS2#)

Notes on the sheet:
MEMORIA FLASH SPI - 512 Mb
S25FL01GS - Memoria Flash no volatil de 1Gb (128 MB). Contiene dos bloques de 512 Mb de los cuales se utiliza uno solo por lo que puede reemplazarse por S25FL512S (64MB).
