ciaa/Hardware/PCB/Safety/CIAA_Safety_VTI_1.0.kicad_pcb

## KiCad design PCB/Safety/CIAA_Safety_VTI_1.0.kicad_pcb (continued)

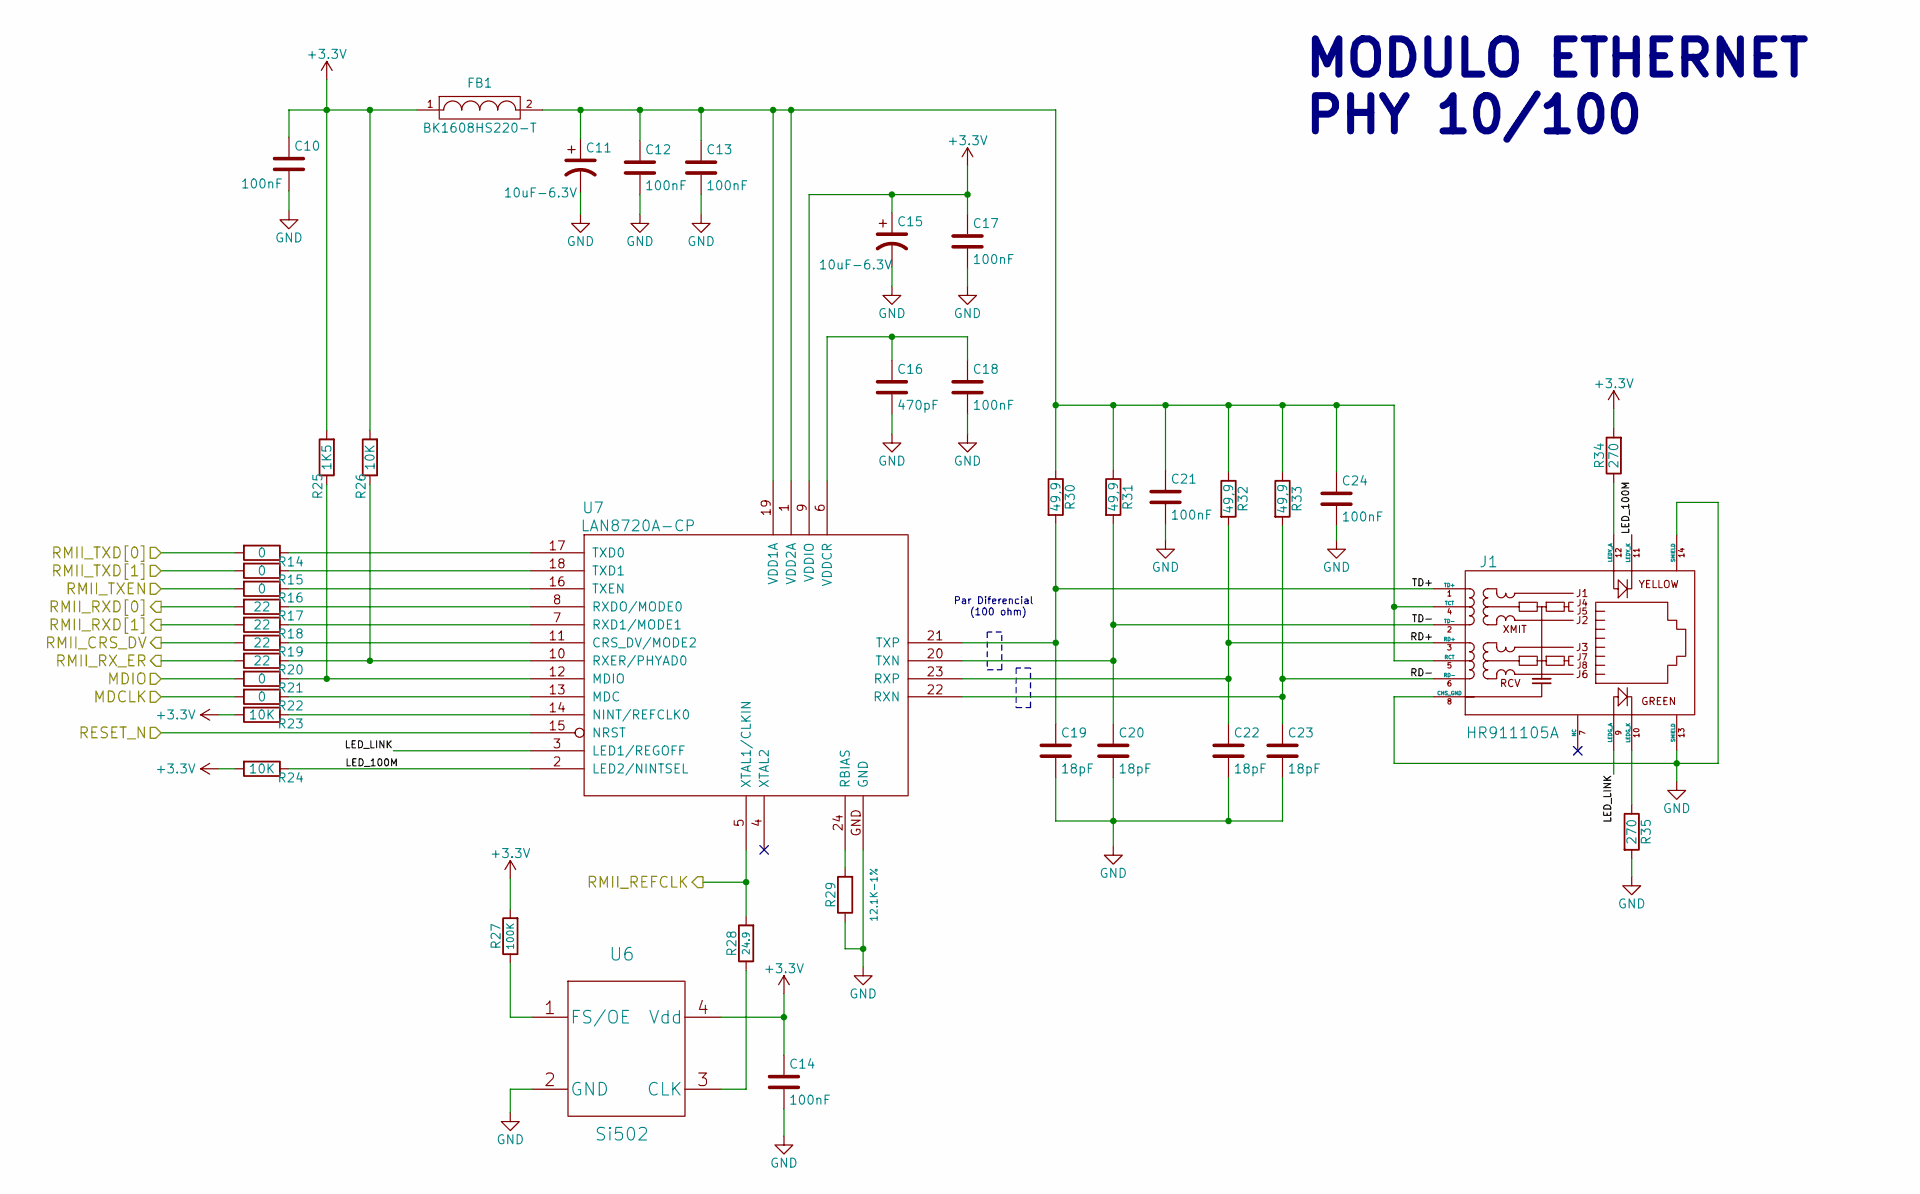
[picture p252: schematic ETHERNET.sch, MODULO PROCESADOR SAFETY-PUERTO ETHERNET]

Parts:
C10, C12, C13, C14, C17, C18, C21, C24: 100nF; c_0603; Digikey 478-5266-1-ND
C11, C15: 10uF-6.3V; c_tant_A; Digikey 399-3685-1-ND
C16: 470pF; c_0603; Digikey 490-6150-1-ND
C19, C20, C22, C23: 18pF; c_0603; Digikey 445-1272-1-ND
FB1: BK1608HS220-T; inductor_smd_0603; Digikey 587-1869-1-ND
J1: HR911105A; Digikey DFR0125-ND
R14, R15, R16, R21, R22: 0; r_0603; Digikey 311-0.0GRCT-ND
R17, R18, R19, R20: 22; r_0603; Digikey 311-22GRCT-ND
R23, R24, R26: 10K; r_0603; Digikey 311-10KGRCT-ND
R25: 1K5; r_0603; Digikey 311-1.5KGRCT-ND
R27: 100K; r_0603; Digikey 311-100KGRCT-ND
R28: 24.9; r_0603; Digikey 311-24.9HRCT-ND
R29: 12.1K-1%; r_0603; Digikey 311-12.1HRCT-ND
R30, R31, R32, R33: 49,9; r_0603; Digikey 311-49.9HRCT-ND
R34, R35: 270; r_0603; Digikey P270AGCT-ND
U6: Si502; Crystal_SMD_7050_4Pads; Digikey 535-10072-1-ND
U7: LAN8720A-CP; qfn-24; Digikey LAN8720AI-CP-CT-ND

Connections:
+3V3: C10.1, C14.1, C15.1, C17.1, FB1.1, R23.2, R24.2, R25.2, R26.2, R27.2, R34.2, U6.4 (Vdd), U7.9 (VDDIO); also elsewhere on the board
/CPU/MDCLK: R22.2; also elsewhere on the board
/CPU/MDIO: R21.2; also elsewhere on the board
/CPU/RMII_CRS_DV: R19.2; also elsewhere on the board
/CPU/RMII_REFCLK: R28.2, U7.5 (XTAL1/CLKIN); also elsewhere on the board
/CPU/RMII_RXD[0]: R17.2; also elsewhere on the board
/CPU/RMII_RXD[1]: R18.2; also elsewhere on the board
/CPU/RMII_RX_ER: R20.2; also elsewhere on the board
/CPU/RMII_TXD[0]: R14.2; also elsewhere on the board
/CPU/RMII_TXD[1]: R15.2; also elsewhere on the board
/CPU/RMII_TXEN: R16.2; also elsewhere on the board
/ETHERNET/LED_100M: J1.11 (LEDY_K), R24.1, U7.2 (LED2/NINTSEL)
/ETHERNET/LED_LINK: J1.9 (LEDG_A), U7.3 (LED1/REGOFF)
/ETHERNET/RD+: C22.1, J1.3 (RD+), R32.2, U7.23 (RXP)
/ETHERNET/RD-: C23.1, J1.6 (RD-), R33.2, U7.22 (RXN)
/ETHERNET/TD+: C19.1, J1.1 (TD+), R30.2, U7.21 (TXP)
/ETHERNET/TD-: C20.1, J1.2 (TD-), R31.2, U7.20 (TXN)
/RESET_ETH: U7.15 (NRST); also elsewhere on the board
GND: C10.2, C11.2, C12.2, C13.2, C14.2, C15.2, C16.2, C17.2, C18.2, C19.2, C20.2, C21.2, C22.2, C23.2, C24.2, J1.8 (CHS_GND), J1.13 (SHIELD), J1.14 (SHIELD), R29.1, R35.2, U6.2 (GND), U7.GND; also elsewhere on the board
unnamed: C11.1, C12.1, C13.1, C21.1, C24.1, FB1.2, J1.4 (TCT), J1.5 (RCT), R30.1, R31.1, R32.1, R33.1, U7.1 (VDD2A), U7.19 (VDD1A)
unnamed: C16.1, C18.1, U7.6 (VDDCR)
unnamed: J1.10 (LEDG_K), R35.1
unnamed: J1.12 (LEDY_A), R34.1
unnamed: R14.1, U7.17 (TXD0)
unnamed: R15.1, U7.18 (TXD1)
unnamed: R16.1, U7.16 (TXEN)
unnamed: R17.1, U7.8 (RXDO/MODE0)
unnamed: R18.1, U7.7 (RXD1/MODE1)
unnamed: R19.1, U7.11 (CRS_DV/MODE2)
unnamed: R20.1, R26.1, U7.10 (RXER/PHYAD0)
unnamed: R21.1, R25.1, U7.12 (MDIO)
unnamed: R22.1, U7.13 (MDC)
unnamed: R23.1, U7.14 (NINT/REFCLK0)
unnamed: R27.1, U6.1 (FS/OE)
unnamed: R28.1, U6.3 (CLK)
unnamed: R29.2, U7.24 (RBIAS)

Notes on the sheet:
MODULO ETHERNET PHY 10/100
Par Diferencial (100 ohm)

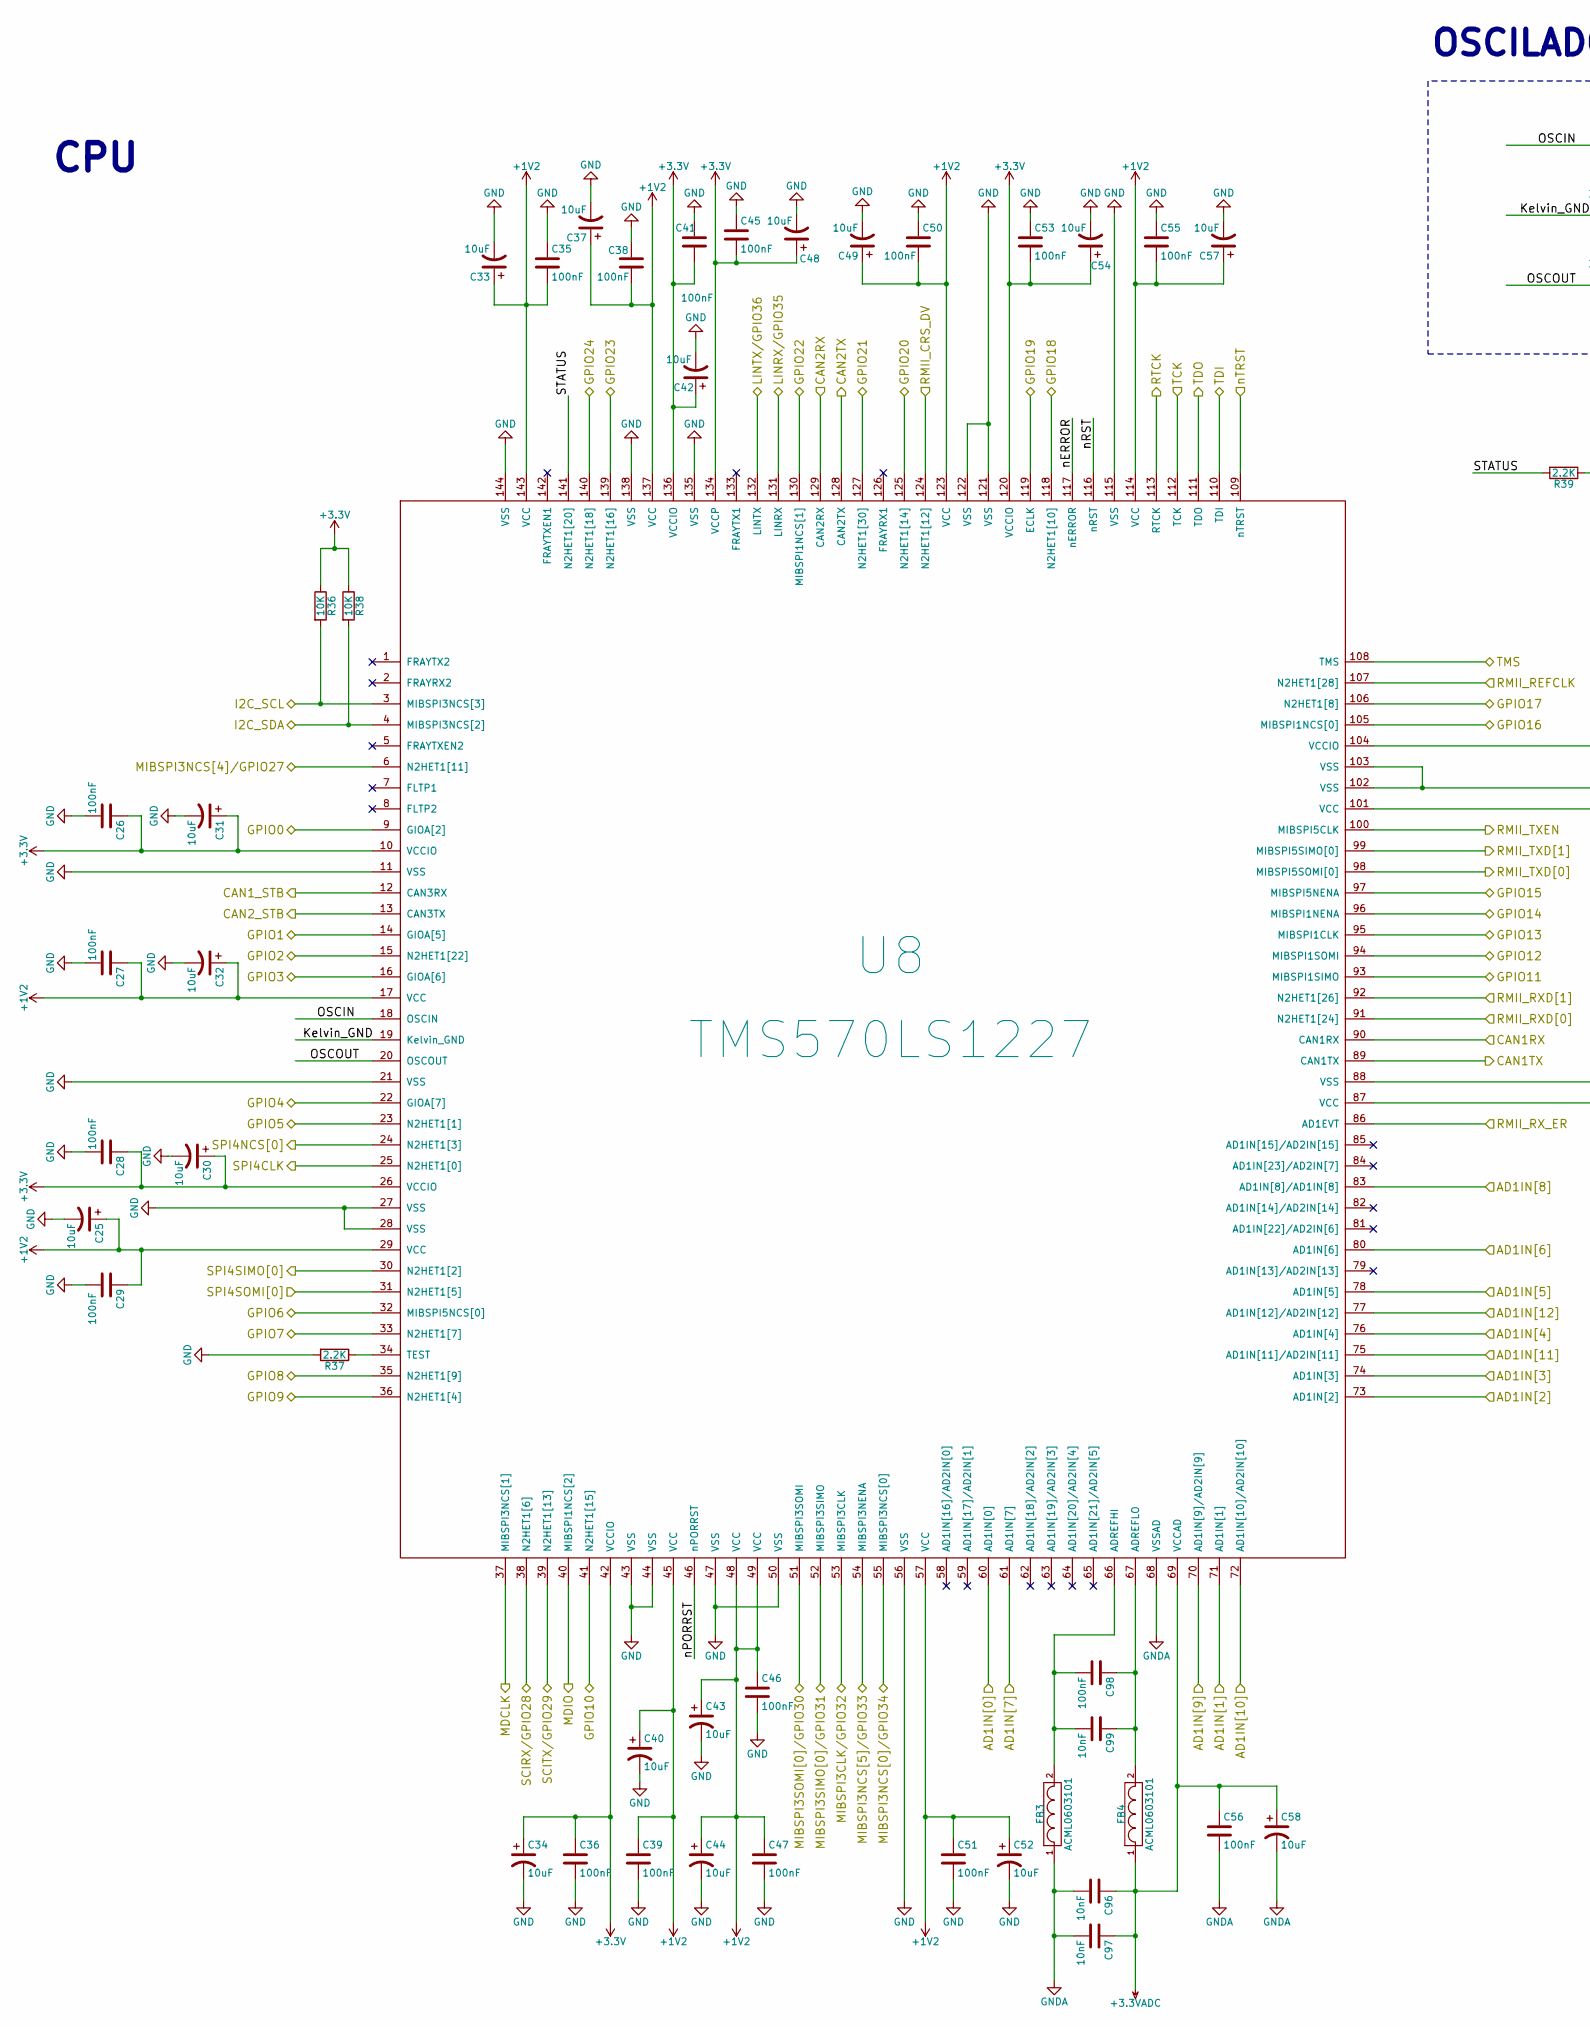
[picture p253: schematic CPU.sch, MÓDULO PROCESADOR SAFETY-CPU, part in row 1, column 1]

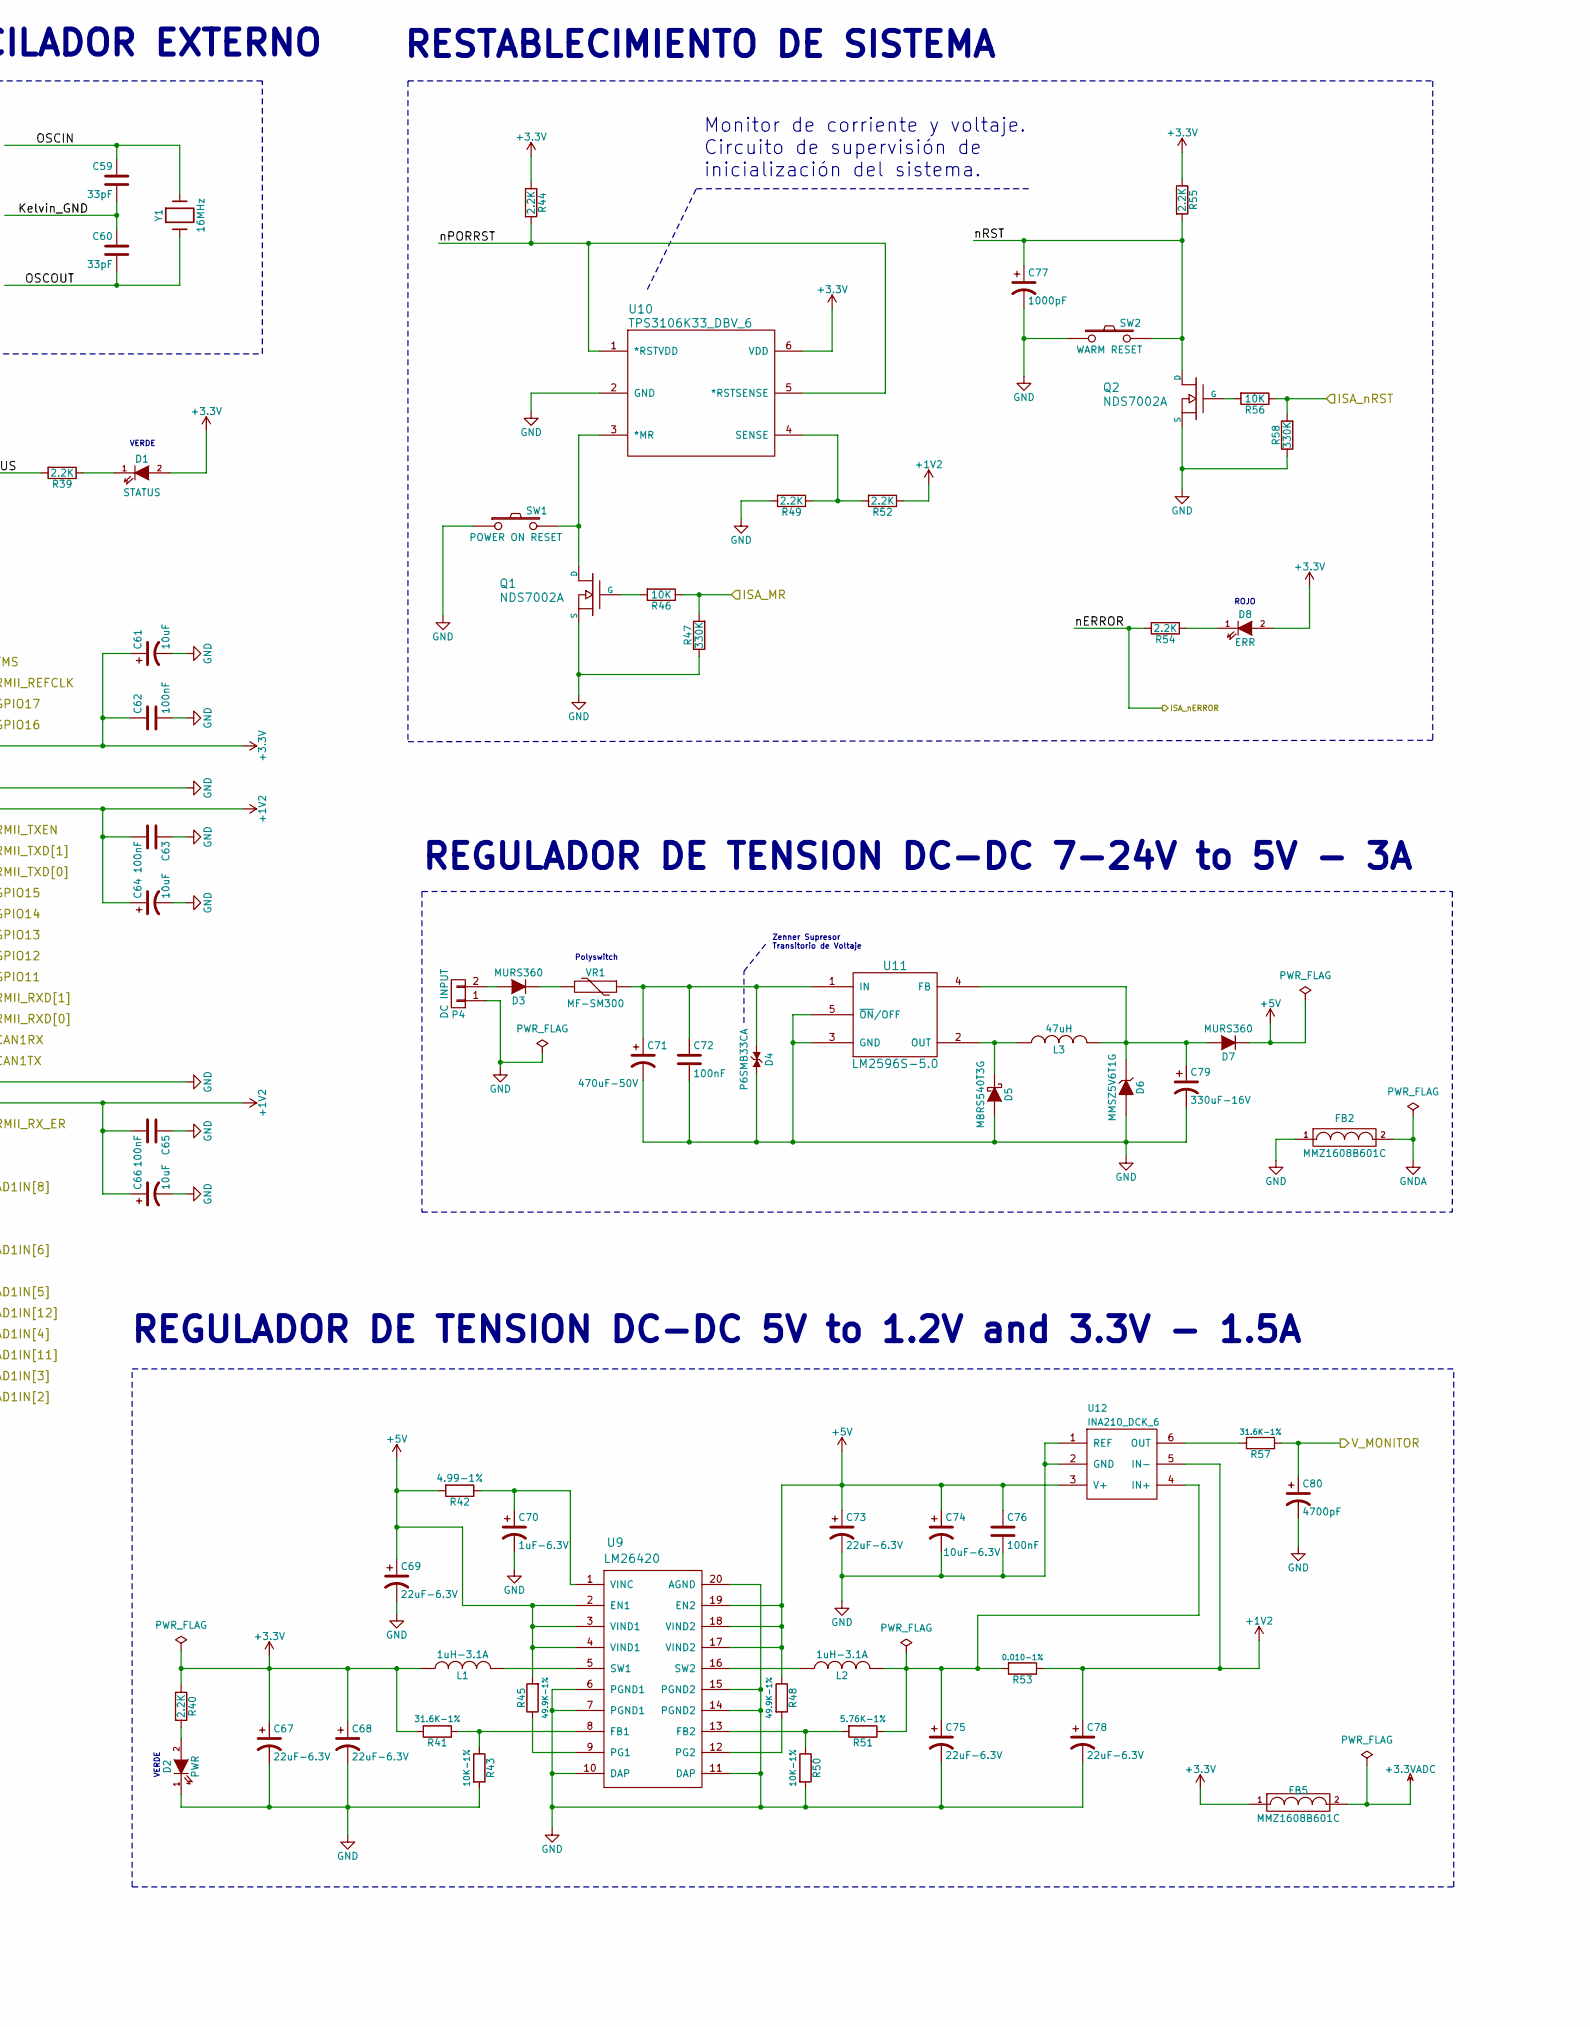
[picture p254: schematic CPU.sch, MÓDULO PROCESADOR SAFETY-CPU, part in row 1, column 2]

Parts:
C25, C30, C31, C32, C33, C34, C37, C40, C42, C43, C44, C48, C49, C52, C54, C57, C58, C61, C64, C66: 10uF; c_tant_A; Digikey 399-3685-1-ND
C26, C27, C28, C29, C35, C36, C38, C39, C41, C45, C46, C47, C50, C51, C53, C55, C56, C62, C63, C65, C72, C76, C98: 100nF; c_0603; Digikey 478-5266-1-ND
C59, C60: 33pF; c_0603; Digikey 490-8068-1-ND
C67, C68, C69, C73, C75, C78: 22uF-6.3V; c_tant_A; Digikey 399-8279-1-ND
C70: 1uF-6.3V; c_tant_A; Digikey 399-9449-1-ND
C71: 470uF-50V; c_elec_8x10; Digikey 565-2136-1-ND
C74: 10uF-6.3V; c_tant_A; Digikey 399-3685-1-ND
C77: 1000pF; c_0603; Digikey 490-6147-1-ND
C79: 330uF-16V; c_elec_8x10; Digikey P15095CT-ND
C80: 4700pF; c_0603; Digikey 490-3192-1-ND
C96, C97, C99: 10nF; c_0603; Digikey 490-3194-1-ND
D1: STATUS; Led_0603; Digikey 160-1446-1-ND
D2: PWR; Led_0603; Digikey 160-1446-1-ND
D3, D7: MURS360; do214ab; Digikey MURS360-E3/57TGICT-ND
D4: P6SMB33CA; do214aa; Digikey P6SMB33CABBCT-ND
D5: MBRS540T3G; do214ab; Digikey MBRS540T3GOSCT-ND
D6: MMSZ5V6T1G; sod123; Digikey MMSZ5V6T1GOSCT-ND
D8: ERR; Led_0603; Digikey 160-1446-1-ND
FB2, FB5: MMZ1608B601C; inductor_smd_0603; Digikey 445-2166-1-ND
FB3, FB4: ACML0603101; inductor_smd_0603; Digikey CML-0603-101-TCT-ND
L1, L2: 1uH-3.1A; inductor_smd_4.8x2.8mm; Digikey 490-9932-1-ND
L3: 47uH; SELF-WE-PD-XXL; Digikey SRR1208-470YLCT-ND
P4: DC INPUT; mkds_1,5-2; Digikey 277-1247-ND
Q1, Q2: NDS7002A; sot23; Digikey NDS7002ACT-ND
R36, R38, R46, R56: 10K; r_0603; Digikey 311-10KGRCT-ND
R37, R39, R40, R44, R49, R52, R54, R55: 2.2K; r_0603; Digikey 311-2.20KHRCT-ND
R41, R57: 31.6K-1%; r_0603; Digikey 311-31.6KHRCT-ND
R42: 4.99-1%; r_0603; Digikey RMCF0603FT4R99CT-ND
R43, R50: 10K-1%; r_0603; Digikey 311-10KGRCT-ND
R45, R48: 49.9K-1%; r_0603; Digikey 311-4.99KHRCT-ND
R47, R58: 330K; r_0603; Digikey 311-330KGRCT-ND
R51: 5.76K-1%; r_0603; Digikey 311-5.76KHRCT-ND
R53: 0.010-1%; r_0603; Digikey CSM0603FT10L0CT-ND
SW1: POWER ON RESET; smd_push; Digikey CKN10384CT-ND
SW2: WARM RESET; smd_push; Digikey CKN10384CT-ND
U8: TMS570LS1227; TQFP-144; Digikey 296-37041-ND
U9: LM26420; tssop-20; Digikey 296-35263-1-ND
U10: TPS3106K33_DBV_6; sot23-6; Digikey 296-13399-1-ND
U11: LM2596S-5.0; TO-263-5Lead; Digikey LM2596S-5.0-ND
U12: INA210_DCK_6; sc70-6; Digikey 296-38954-1-ND
VR1: MF-SM300; Digikey MF-SM300-2CT-ND
Y1: 16MHz; hc-49_smd; Digikey 535-13436-1-ND

Connections:
+1V2: C25.1, C27.1, C29.1, C32.1, C33.1, C35.2, C37.1, C38.2, C39.1, C40.1, C43.1, C44.1, C46.1, C47.1, C49.1, C50.2, C51.1, C52.1, C55.2, C57.1, C63.2, C64.1, C65.2, C66.1, C78.1, R52.1, R53.1, U8.17 (VCC), U8.29 (VCC), U8.45 (VCC), U8.48 (VCC), U8.49 (VCC), U8.57 (VCC), U8.87 (VCC), U8.101 (VCC), U8.114 (VCC), U8.123 (VCC), U8.137 (VCC), U8.143 (VCC), U12.5 (IN-)
+3.3VADC: C56.1, C58.1, C96.1, C97.1, FB4.1, FB5.2, U8.69 (VCCAD)
+3V3: C26.1, C28.1, C30.1, C31.1, C34.1, C36.1, C41.2, C42.1, C45.2, C48.1, C53.2, C54.1, C61.1, C62.1, C67.1, C68.1, D1.2 (A), D8.2 (A), FB5.1, L1.1, R36.1, R38.1, R40.1, R41.2, R44.1, R55.1, U8.10 (VCCIO), U8.26 (VCCIO), U8.42 (VCCIO), U8.104 (VCCIO), U8.120 (VCCIO), U8.134 (VCCP), U8.136 (VCCIO), U10.6 (VDD); also elsewhere on the board
+5V: C69.1, C73.1, C74.1, C76.1, D7.1 (K), R42.2, R45.2, R48.1, U9.2 (EN1), U9.3 (VIND1), U9.4 (VIND1), U9.17 (VIND2), U9.18 (VIND2), U9.19 (EN2), U12.3 (V+); also elsewhere on the board
/CAN 1/2/CAN1RX: U8.90 (CAN1RX); also elsewhere on the board
/CAN 1/2/CAN1TX: U8.89 (CAN1TX); also elsewhere on the board
/CAN 1/2/CAN1_STB: U8.12 (CAN3RX); also elsewhere on the board
/CAN 1/2/CAN2RX: U8.129 (CAN2RX); also elsewhere on the board
/CAN 1/2/CAN2TX: U8.128 (CAN2TX); also elsewhere on the board
/CAN 1/2/CAN2_STB: U8.13 (CAN3TX); also elsewhere on the board
/CPU/GPIO6: U8.32 (MIBSPI5NCS[0]); also elsewhere on the board
/CPU/GPIO7: U8.33 (N2HET1[7]); also elsewhere on the board
/CPU/Kelvin_GND: C59.2, C60.1, U8.19 (Kelvin_GND)
/CPU/MDCLK: U8.37 (MIBSPI3NCS[1]); also elsewhere on the board
/CPU/MDIO: U8.40 (MIBSPI1NCS[2]); also elsewhere on the board
/CPU/OSCIN: C59.1, U8.18 (OSCIN), Y1.1
/CPU/OSCOUT: C60.2, U8.20 (OSCOUT), Y1.2
/CPU/RMII_CRS_DV: U8.124 (N2HET1[12]); also elsewhere on the board
/CPU/RMII_REFCLK: U8.107 (N2HET1[28]); also elsewhere on the board
/CPU/RMII_RXD[0]: U8.91 (N2HET1[24]); also elsewhere on the board
/CPU/RMII_RXD[1]: U8.92 (N2HET1[26]); also elsewhere on the board
/CPU/RMII_RX_ER: U8.86 (AD1EVT); also elsewhere on the board
/CPU/RMII_TXD[0]: U8.98 (MIBSPI5SOMI[0]); also elsewhere on the board
/CPU/RMII_TXD[1]: U8.99 (MIBSPI5SIMO[0]); also elsewhere on the board
/CPU/RMII_TXEN: U8.100 (MIBSPI5CLK); also elsewhere on the board
/CPU/SPI4CLK: U8.25 (N2HET1[0]); also elsewhere on the board
/CPU/SPI4NCS[0]: U8.24 (N2HET1[3]); also elsewhere on the board
/CPU/SPI4SIMO[0]: U8.30 (N2HET1[2]); also elsewhere on the board
/CPU/SPI4SOMI[0]: U8.31 (N2HET1[5]); also elsewhere on the board
/CPU/STATUS: R39.2, U8.141 (N2HET1[20])
/CPU/nPORRST: R44.2, U8.46 (nPORRST), U10.1 (*RSTVDD), U10.5 (*RSTSENSE)
/CPU/nRST: C77.1, Q2.D, R55.2, SW2.2, U8.116 (nRST)
/INT_A: U8.36 (N2HET1[4]); also elsewhere on the board
/ISA_AD1IN[0]: U8.60 (AD1IN[0]); also elsewhere on the board
/ISA_AD1IN[1]: U8.71 (AD1IN[1]); also elsewhere on the board
/ISA_AD1IN[2]: U8.73 (AD1IN[2]); also elsewhere on the board
/ISA_AD1IN[3]: U8.74 (AD1IN[3]); also elsewhere on the board
/ISA_AD1IN[4]: U8.76 (AD1IN[4]); also elsewhere on the board
/ISA_AD1IN[5]: U8.78 (AD1IN[5]); also elsewhere on the board
/ISA_AD1IN[6]: U8.80 (AD1IN[6]); also elsewhere on the board
/ISA_AD1IN[7]: U8.61 (AD1IN[7]); also elsewhere on the board
/ISA_AD1IN[8]: U8.83 (AD1IN[8]/AD1IN[8]); also elsewhere on the board
/ISA_AD1IN[9]: U8.70 (AD1IN[9]/AD2IN[9]); also elsewhere on the board
/ISA_AD1IN[10]: U8.72 (AD1IN[10]/AD2IN[10]); also elsewhere on the board
/ISA_AD1IN[11]: U8.75 (AD1IN[11]/AD2IN[11]); also elsewhere on the board
/ISA_AD1IN[12]: U8.77 (AD1IN[12]/AD2IN[12]); also elsewhere on the board
/ISA_GPIO0/RESET_ETH: U8.9 (GIOA[2]); also elsewhere on the board
/ISA_GPIO1: U8.14 (GIOA[5]); also elsewhere on the board
/ISA_GPIO2: U8.15 (N2HET1[22]); also elsewhere on the board
/ISA_GPIO3: U8.16 (GIOA[6]); also elsewhere on the board
/ISA_GPIO4: U8.22 (GIOA[7]); also elsewhere on the board
/ISA_GPIO5: U8.23 (N2HET1[1]); also elsewhere on the board
/ISA_GPIO10: U8.41 (N2HET1[15]); also elsewhere on the board
/ISA_GPIO11: U8.93 (MIBSPI1SIMO); also elsewhere on the board
/ISA_GPIO12: U8.94 (MIBSPI1SOMI); also elsewhere on the board
/ISA_GPIO13: U8.95 (MIBSPI1CLK); also elsewhere on the board
/ISA_GPIO14: U8.96 (MIBSPI1NENA); also elsewhere on the board
/ISA_GPIO15: U8.97 (MIBSPI5NENA); also elsewhere on the board
/ISA_GPIO16: U8.105 (MIBSPI1NCS[0]); also elsewhere on the board
/ISA_GPIO17: U8.106 (N2HET1[8]); also elsewhere on the board
/ISA_GPIO18: U8.118 (N2HET1[10]); also elsewhere on the board
/ISA_GPIO19: U8.119 (ECLK); also elsewhere on the board
/ISA_GPIO20: U8.125 (N2HET1[14]); also elsewhere on the board
/ISA_GPIO21: U8.127 (N2HET1[30]); also elsewhere on the board
/ISA_GPIO22: U8.130 (MIBSPI1NCS[1]); also elsewhere on the board
/ISA_GPIO23: U8.139 (N2HET1[16]); also elsewhere on the board
/ISA_GPIO24: U8.140 (N2HET1[18]); also elsewhere on the board
/ISA_I2C_SCL: R36.2, U8.3 (MIBSPI3NCS[3]); also elsewhere on the board
/ISA_I2C_SDA: R38.2, U8.4 (MIBSPI3NCS[2]); also elsewhere on the board
/ISA_LINRX/GPIO35: U8.131 (LINRX); also elsewhere on the board
/ISA_LINTX/GPIO36: U8.132 (LINTX); also elsewhere on the board
/ISA_MIBSPI3CLK/GPIO32: U8.53 (MIBSPI3CLK); also elsewhere on the board
/ISA_MIBSPI3NCS[0]/GPIO34: U8.55 (MIBSPI3NCS[0]); also elsewhere on the board
/ISA_MIBSPI3NCS[4]/GPIO27: U8.6 (N2HET1[11]); also elsewhere on the board
/ISA_MIBSPI3NCS[5]/GPIO33: U8.54 (MIBSPI3NENA); also elsewhere on the board
/ISA_MIBSPI3SIMO/GPIO31: U8.52 (MIBSPI3SIMO); also elsewhere on the board
/ISA_MIBSPI3SOMI/GPIO30: U8.51 (MIBSPI3SOMI); also elsewhere on the board
/ISA_MR: R46.1, R47.2; also elsewhere on the board
/ISA_SCIRX/GPIO28: U8.38 (N2HET1[6]); also elsewhere on the board
/ISA_SCITX/GPIO29: U8.39 (N2HET1[13]); also elsewhere on the board
/ISA_nERROR: R54.2, U8.117 (nERROR); also elsewhere on the board
/ISA_nRST: R56.1, R58.2; also elsewhere on the board
/RSTI_A: U8.35 (N2HET1[9]); also elsewhere on the board
/RTCK: U8.113 (RTCK); also elsewhere on the board
/TCK: U8.112 (TCK); also elsewhere on the board
/TDI: U8.110 (TDI); also elsewhere on the board
/TDO: U8.111 (TDO); also elsewhere on the board
/TMS: U8.108 (TMS); also elsewhere on the board
/V_MONITOR: C80.1, R57.1; also elsewhere on the board
/nTRST: U8.109 (nTRST); also elsewhere on the board
GND: C25.2, C26.2, C27.2, C28.2, C29.2, C30.2, C31.2, C32.2, C33.2, C34.2, C35.1, C36.2, C37.2, C38.1, C39.2, C40.2, C41.1, C42.2, C43.2, C44.2, C45.1, C46.2, C47.2, C48.2, C49.2, C50.1, C51.2, C52.2, C53.1, C54.2, C55.1, C57.2, C61.2, C62.2, C63.1, C64.2, C65.1, C66.2, C67.2, C68.2, C69.2, C70.2, C71.2, C72.2, C73.2, C74.2, C75.2, C76.2, C77.2, C78.2, C79.2, C80.2, D2.1 (K), D4.1 (cathode), D5.2 (A), D6.2 (A), FB2.1, P4.1, Q1.S, Q2.S, R37.2, R43.2, R47.1, R49.2, R50.2, R58.1, SW1.1, SW2.1, U8.11 (VSS), U8.21 (VSS), U8.27 (VSS), U8.28 (VSS), U8.43 (VSS), U8.44 (VSS), U8.47 (VSS), U8.50 (VSS), U8.56 (VSS), U8.88 (VSS), U8.102 (VSS), U8.103 (VSS), U8.115 (VSS), U8.121 (VSS), U8.122 (VSS), U8.135 (VSS), U8.138 (VSS), U8.144 (VSS), U9.6 (PGND1), U9.7 (PGND1), U9.10 (DAP), U9.11 (DAP), U9.14 (PGND2), U9.15 (PGND2), U9.20 (AGND), U10.2 (GND), U11.3 (GND), U11.5 (~ON~/OFF), U12.1 (REF), U12.2 (GND); also elsewhere on the board
GNDA: C56.2, C58.2, C96.2, C97.2, FB2.2, FB3.1, U8.68 (VSSAD); also elsewhere on the board
unnamed: C70.1, R42.1, U9.1 (VINC)
unnamed: C71.1, C72.1, D4.2 (Anode), U11.1 (IN), VR1.1
unnamed: C75.1, L2.2, R51.1, R53.2, U12.4 (IN+)
unnamed: C79.1, D6.1 (K), D7.2 (A), L3.2, U11.4 (FB)
unnamed: C98.1, C99.1, FB4.2, U8.67 (ADREFLO)
unnamed: C98.2, C99.2, FB3.2, U8.66 (ADREFHI)
unnamed: D1.1 (K), R39.1
unnamed: D2.2 (A), R40.2
unnamed: D3.1 (K), VR1.2
unnamed: D3.2 (A), P4.2
unnamed: D5.1 (K), L3.1, U11.2 (OUT)
unnamed: D8.1 (K), R54.1
unnamed: L1.2, U9.5 (SW1)
unnamed: L2.1, U9.16 (SW2)
unnamed: Q1.D, SW1.2, U10.3 (*MR)
unnamed: Q1.G, R46.2
unnamed: Q2.G, R56.2
unnamed: R37.1, U8.34 (TEST)
unnamed: R41.1, R43.1, U9.8 (FB1)
unnamed: R45.1, U9.9 (PG1)
unnamed: R48.2, U9.12 (PG2)
unnamed: R49.1, R52.2, U10.4 (SENSE)
unnamed: R50.1, R51.2, U9.13 (FB2)
unnamed: R57.2, U12.6 (OUT)

Notes on the sheet:
OSCILADOR EXTERNO
RESTABLECIMIENTO DE SISTEMA
REGULADOR DE TENSION DC-DC 5V to 1.2V and 3.3V - 1.5A
CPU
Monitor de corriente y voltaje. Circuito de supervisión de inicialización del sistema.
Polyswitch
REGULADOR DE TENSION DC-DC 7-24V to 5V - 3A
Zenner Supresor Transitorio de Voltaje
ROJO
VERDE

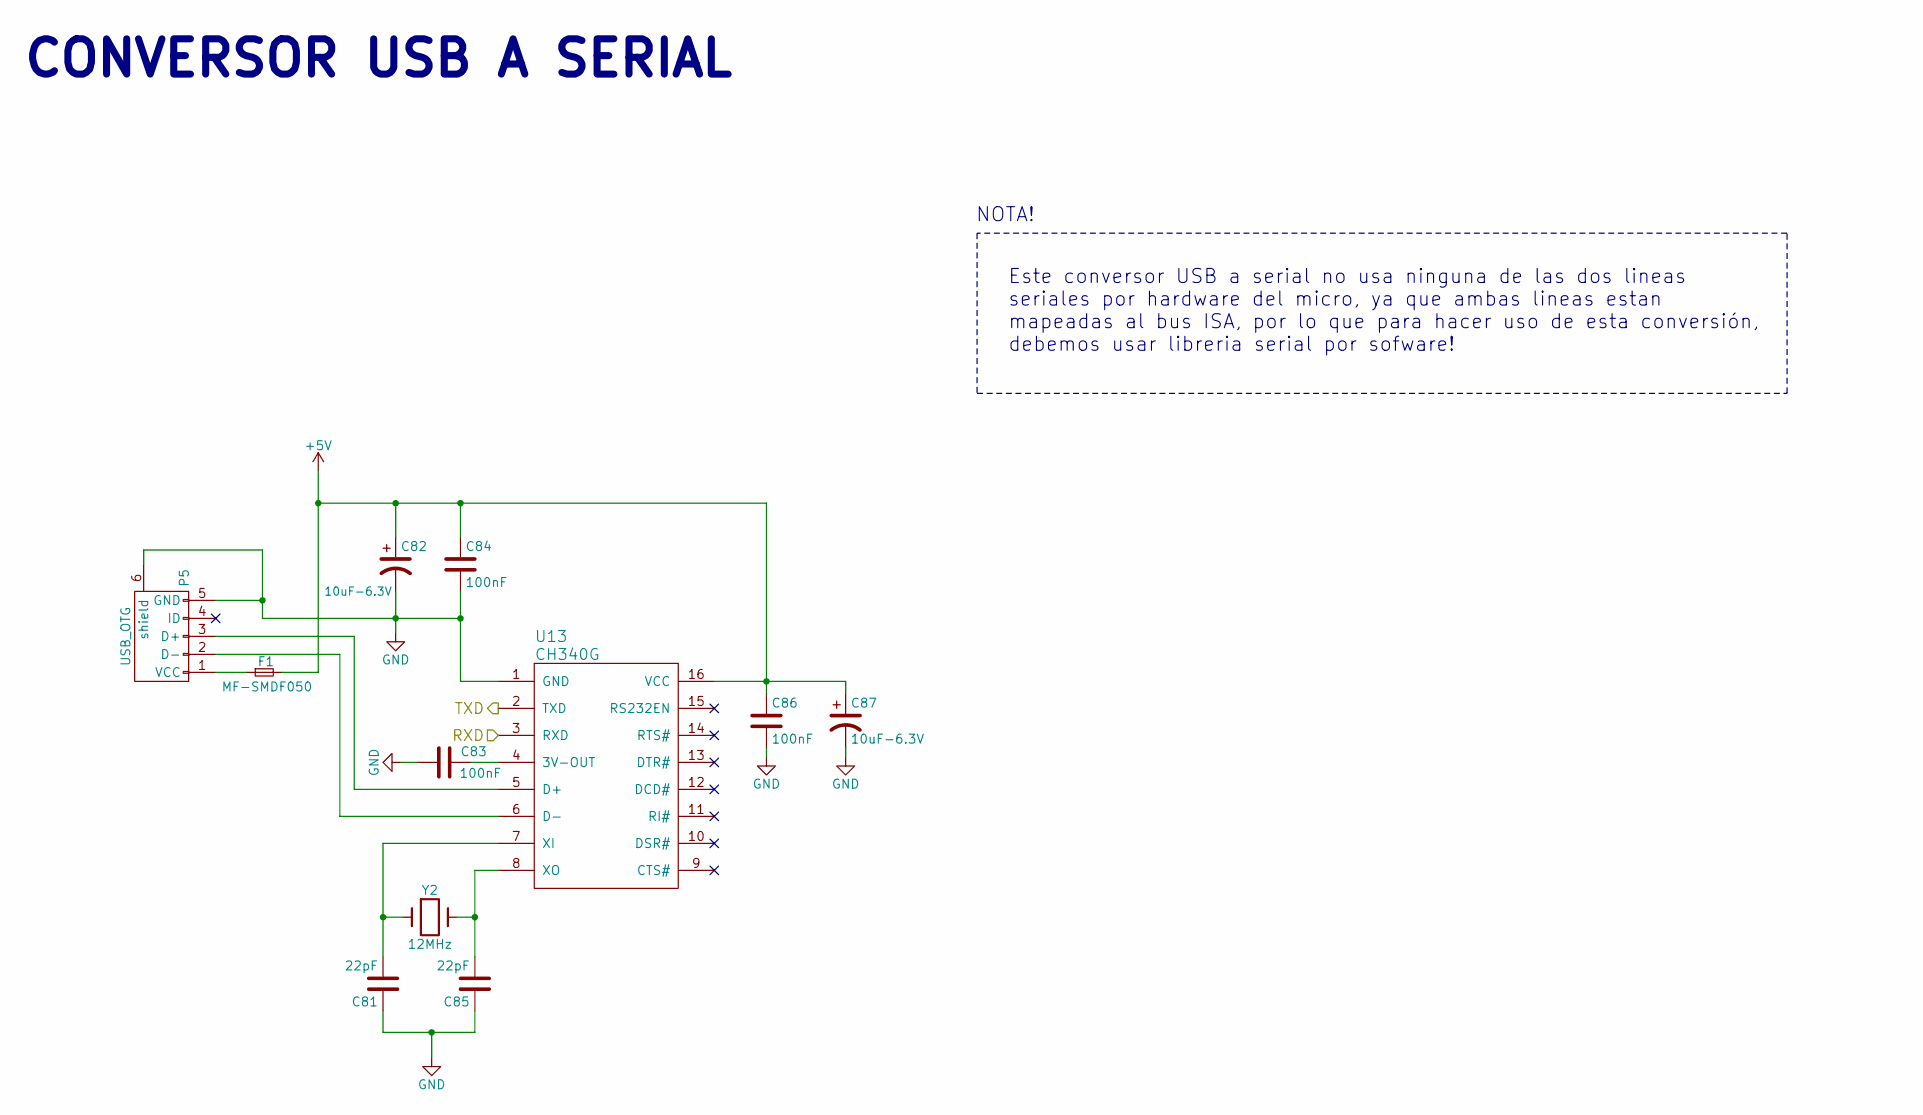
[picture p255: schematic USB OTG.sch, MODULO PROCESADOR SAFETY-PUERTO USB OTG]

Parts:
C81, C85: 22pF; c_0603; Digikey 490-6068-1-ND
C82, C87: 10uF-6.3V; c_tant_A; Digikey 399-3685-1-ND
C83, C84, C86: 100nF; c_0603; Digikey 478-5266-1-ND
F1: MF-SMDF050; Digikey MF-SMDF050-2CT-ND
P5: USB_OTG; conn_usb_B_micro_smd-2; Digikey 609-4613-1-ND
U13: CH340G; so-16
Y2: 12MHz; hc-49_smd; Digikey 535-9067-1-ND

Connections:
+5V: C82.1, C84.1, C86.1, C87.1, F1.2, U13.16 (VCC); also elsewhere on the board
/CPU/GPIO6: U13.2 (TXD); also elsewhere on the board
/CPU/GPIO7: U13.3 (RXD); also elsewhere on the board
GND: C81.1, C82.2, C83.1, C84.2, C85.1, C86.2, C87.2, P5.5 (GND), P5.6 (shield), U13.1 (GND); also elsewhere on the board
unnamed: C81.2, U13.7 (XI), Y2.1
unnamed: C83.2, U13.4 (3V-OUT)
unnamed: C85.2, U13.8 (XO), Y2.2
unnamed: F1.1, P5.1 (VCC)
unnamed: P5.2 (D-), U13.6 (D-)
unnamed: P5.3 (D+), U13.5 (D+)

Notes on the sheet:
CONVERSOR USB A SERIAL
Este conversor USB a serial no usa ninguna de las dos lineas seriales por hardware del micro, ya que ambas lineas estan mapeadas al bus ISA, por lo que para hacer uso de esta conversión, debemos usar libreria serial por sofware!
NOTA!

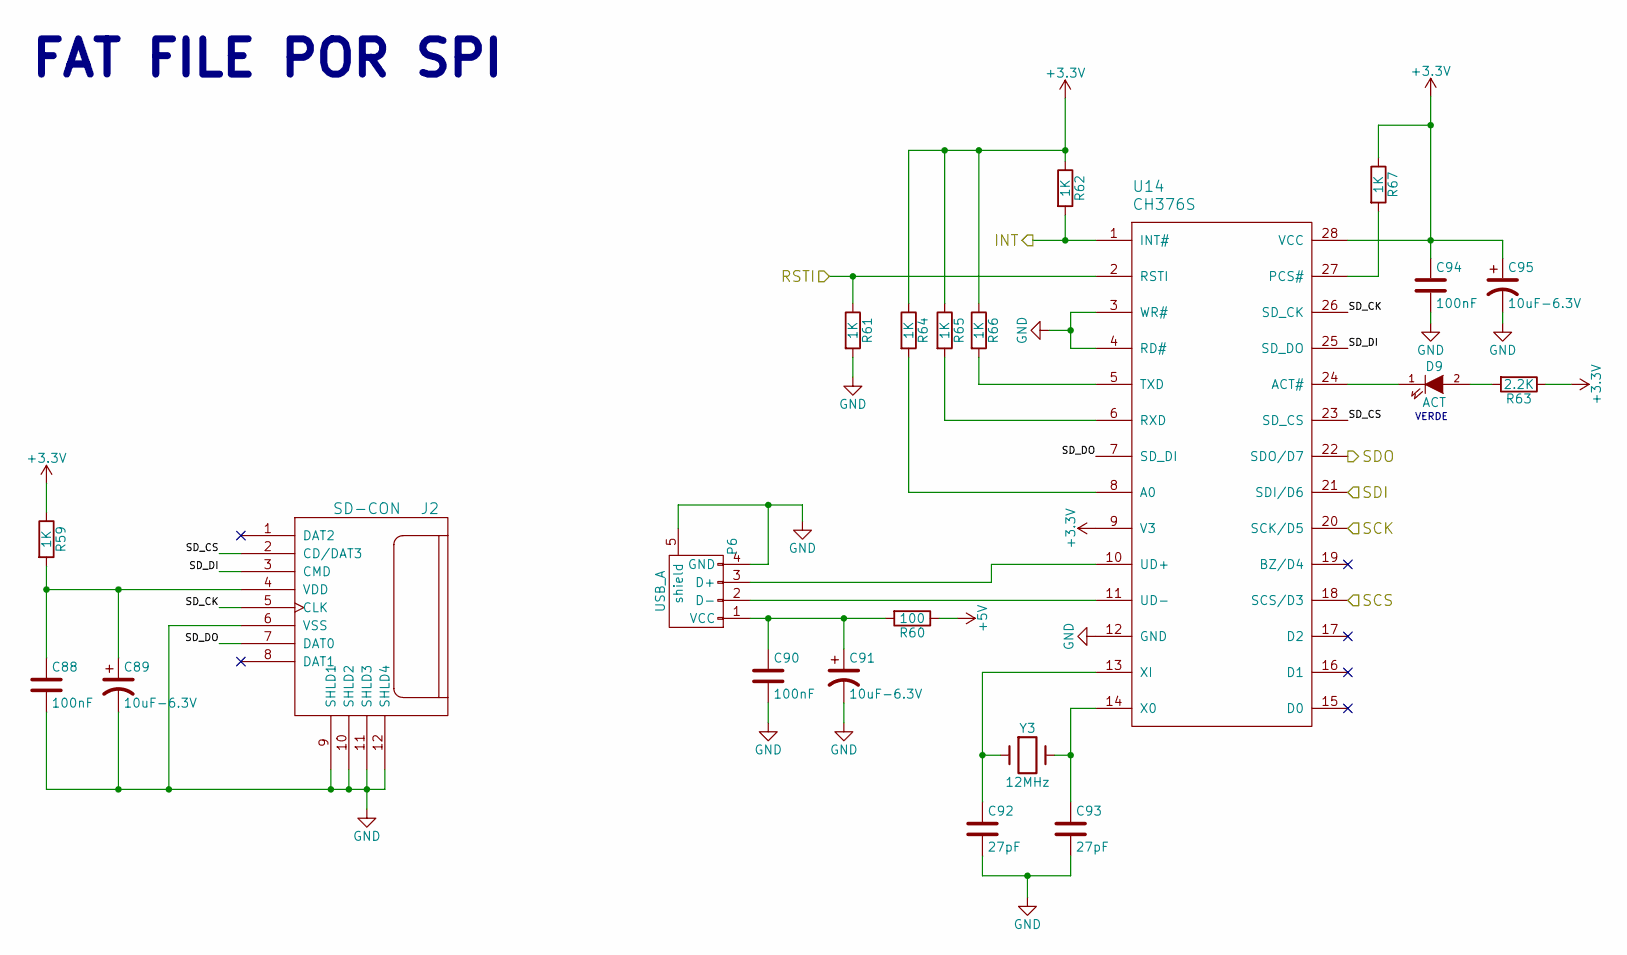
[picture p256: schematic USB HOST - MEM SD.sch, MÓDULO PROCESADOR SAFETY-MEMORIA SD-PUERTO USB HOST]

Parts:
C88, C90, C94: 100nF; c_0603; Digikey 478-5266-1-ND
C89, C91, C95: 10uF-6.3V; c_tant_A; Digikey 399-3685-1-ND
C92, C93: 27pF; c_0603; Digikey 490-8067-1-ND
D9: ACT; Led_0603; Digikey 160-1446-1-ND
J2: SD-CON; microsd_socket; Digikey HR1964CT-ND
P6: USB_A; conn_usb_A; Digikey 609-4946-1-ND
R59, R61, R62, R64, R65, R66, R67: 1K; r_0603; Digikey 311-1.0KGRCT-ND
R60: 100; r_0603; Digikey 311-100HRCT-ND
R63: 2.2K; r_0603; Digikey 311-2.20KHRCT-ND
U14: CH376S; soic-28
Y3: 12MHz; hc-49_smd; Digikey 535-9067-1-ND

Connections:
+3V3: C94.1, C95.1, R59.1, R62.1, R63.1, R64.1, R65.1, R66.1, R67.1, U14.9 (V3), U14.28 (VCC); also elsewhere on the board
+5V: R60.1; also elsewhere on the board
/INT_A: R62.2, U14.1 (INT#); also elsewhere on the board
/ISA_MIBSPI3CLK/GPIO32: U14.20 (SCK/D5); also elsewhere on the board
/ISA_MIBSPI3NCS[5]/GPIO33: U14.18 (SCS/D3); also elsewhere on the board
/ISA_MIBSPI3SIMO/GPIO31: U14.21 (SDI/D6); also elsewhere on the board
/ISA_MIBSPI3SOMI/GPIO30: U14.22 (SDO/D7); also elsewhere on the board
/RSTI_A: R61.1, U14.2 (RSTI); also elsewhere on the board
/USB HOST - MEM SD/SD_CK: J2.5 (CLK), U14.26 (SD_CK)
/USB HOST - MEM SD/SD_CS: J2.2 (CD/DAT3), U14.23 (SD_CS)
/USB HOST - MEM SD/SD_DI: J2.3 (CMD), U14.25 (SD_DO)
/USB HOST - MEM SD/SD_DO: J2.7 (DAT0), U14.7 (SD_DI)
GND: C88.2, C89.2, C90.2, C91.2, C92.2, C93.2, C94.2, C95.2, J2.6 (VSS), J2.9 (SHLD1), J2.10 (SHLD2), J2.11 (SHLD3), J2.12 (SHLD4), P6.4 (GND), P6.5 (shield), R61.2, U14.3 (WR#), U14.4 (RD#), U14.12 (GND); also elsewhere on the board
unnamed: C88.1, C89.1, J2.4 (VDD), R59.2
unnamed: C90.1, C91.1, P6.1 (VCC), R60.2
unnamed: C92.1, U14.13 (XI), Y3.1
unnamed: C93.1, U14.14 (X0), Y3.2
unnamed: D9.1 (K), U14.24 (ACT#)
unnamed: D9.2 (A), R63.2
unnamed: P6.2 (D-), U14.11 (UD-)
unnamed: P6.3 (D+), U14.10 (UD+)
unnamed: R64.2, U14.8 (A0)
unnamed: R65.2, U14.6 (RXD)
unnamed: R66.2, U14.5 (TXD)
unnamed: R67.2, U14.27 (PCS#)

Notes on the sheet:
VERDE
FAT FILE POR SPI
