ciaa/Hardware/PCB/Safety/CIAA_Safety_VTI_1.0.kicad_pcb

## KiCad design PCB/Safety/CIAA_Safety_VTI_1.0.kicad_pcb (continued)

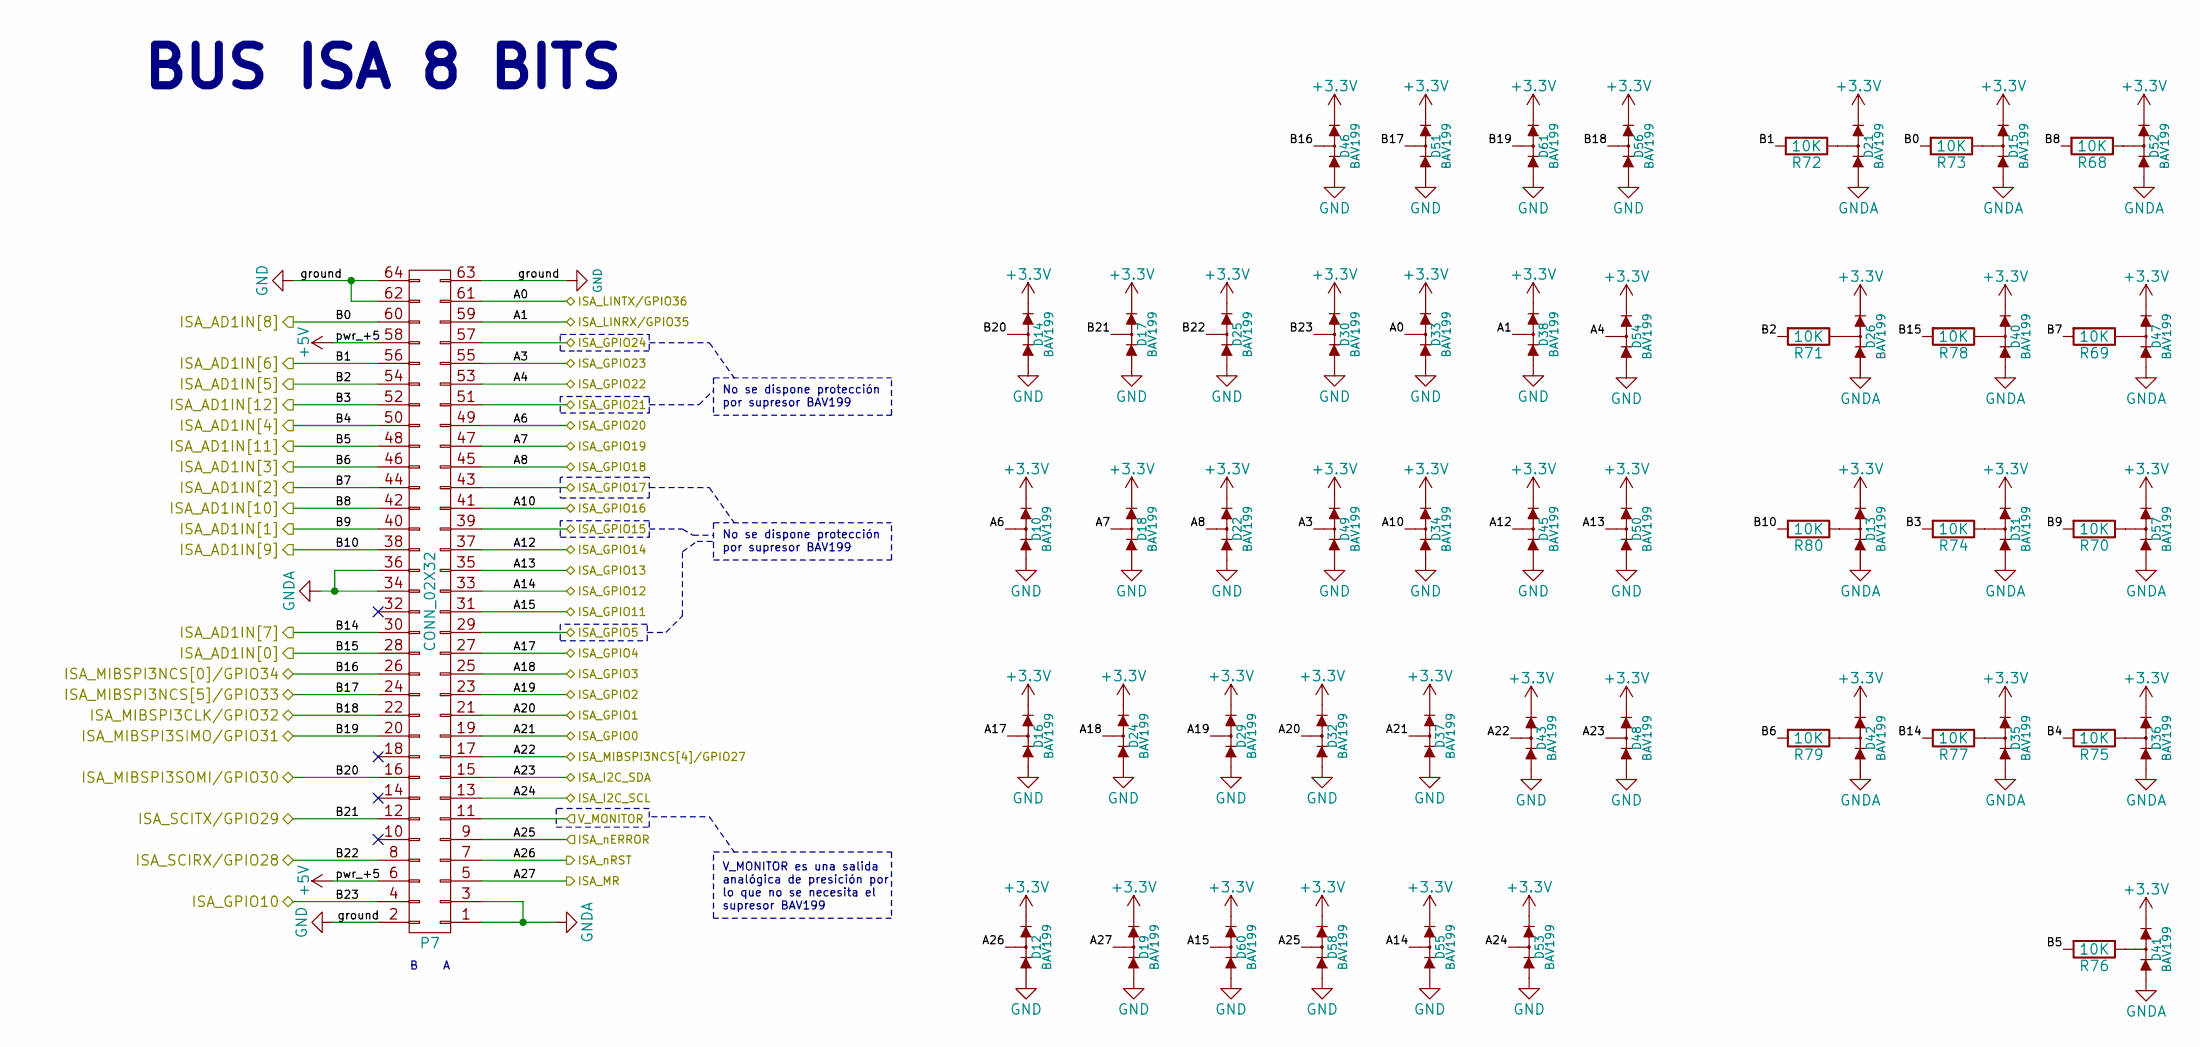
[picture p257: schematic BUS_ISA.sch, MODULO PROCESADOR SAFETY-BUS ISA]

Parts:
D10, D12, D13, D14, D15, D16, D17, D18, D19, D21, D22, D24, D25, D26, D29, D30, D31, D32, D33, D34, D35, D36, D37, D38, D40, D41, D42, D43, D45, D46, D47, D48, D49, D50, D51, D52, D53, D54, D55, D56, D57, D58, D60, D61: BAV199; Digikey BAV199E6327HTSA1CT-ND
P7: CONN_02X32; bus_ISA_8bits
R68, R69, R70, R71, R72, R73, R74, R75, R76, R77, R78, R79, R80: 10K; r_0603; Digikey 311-10KGRCT-ND

Connections:
+3V3: D10.1 (K), D12.1 (K), D13.1 (K), D14.1 (K), D15.1 (K), D16.1 (K), D17.1 (K), D18.1 (K), D19.1 (K), D21.1 (K), D22.1 (K), D24.1 (K), D25.1 (K), D26.1 (K), D29.1 (K), D30.1 (K), D31.1 (K), D32.1 (K), D33.1 (K), D34.1 (K), D35.1 (K), D36.1 (K), D37.1 (K), D38.1 (K), D40.1 (K), D41.1 (K), D42.1 (K), D43.1 (K), D45.1 (K), D46.1 (K), D47.1 (K), D48.1 (K), D49.1 (K), D50.1 (K), D51.1 (K), D52.1 (K), D53.1 (K), D54.1 (K), D55.1 (K), D56.1 (K), D57.1 (K), D58.1 (K), D60.1 (K), D61.1 (K); also elsewhere on the board
+5V: P7.6, P7.58; also elsewhere on the board
/ISA_AD1IN[0]: P7.28, R78.2; also elsewhere on the board
/ISA_AD1IN[1]: P7.40, R70.2; also elsewhere on the board
/ISA_AD1IN[2]: P7.44, R69.2; also elsewhere on the board
/ISA_AD1IN[3]: P7.46, R79.2; also elsewhere on the board
/ISA_AD1IN[4]: P7.50, R75.2; also elsewhere on the board
/ISA_AD1IN[5]: P7.54, R71.2; also elsewhere on the board
/ISA_AD1IN[6]: P7.56, R72.2; also elsewhere on the board
/ISA_AD1IN[7]: P7.30, R77.2; also elsewhere on the board
/ISA_AD1IN[8]: P7.60, R73.2; also elsewhere on the board
/ISA_AD1IN[9]: P7.38, R80.2; also elsewhere on the board
/ISA_AD1IN[10]: P7.42, R68.2; also elsewhere on the board
/ISA_AD1IN[11]: P7.48, R76.2; also elsewhere on the board
/ISA_AD1IN[12]: P7.52, R74.2; also elsewhere on the board
/ISA_GPIO0: D37.2 (KA), P7.19; also elsewhere on the board
/ISA_GPIO1: D32.2 (KA), P7.21; also elsewhere on the board
/ISA_GPIO2: D29.2 (KA), P7.23; also elsewhere on the board
/ISA_GPIO3: D24.2 (KA), P7.25; also elsewhere on the board
/ISA_GPIO4: D16.2 (KA), P7.27; also elsewhere on the board
/ISA_GPIO5: P7.29; also elsewhere on the board
/ISA_GPIO10: D30.2 (KA), P7.4; also elsewhere on the board
/ISA_GPIO11: D60.2 (KA), P7.31; also elsewhere on the board
/ISA_GPIO12: D55.2 (KA), P7.33; also elsewhere on the board
/ISA_GPIO13: D50.2 (KA), P7.35; also elsewhere on the board
/ISA_GPIO14: D45.2 (KA), P7.37; also elsewhere on the board
/ISA_GPIO15: P7.39; also elsewhere on the board
/ISA_GPIO16: D34.2 (KA), P7.41; also elsewhere on the board
/ISA_GPIO17: P7.43; also elsewhere on the board
/ISA_GPIO18: D22.2 (KA), P7.45; also elsewhere on the board
/ISA_GPIO19: D18.2 (KA), P7.47; also elsewhere on the board
/ISA_GPIO20: D10.2 (KA), P7.49; also elsewhere on the board
/ISA_GPIO21: P7.51; also elsewhere on the board
/ISA_GPIO22: D54.2 (KA), P7.53; also elsewhere on the board
/ISA_GPIO23: D49.2 (KA), P7.55; also elsewhere on the board
/ISA_GPIO24: P7.57; also elsewhere on the board
/ISA_I2C_SCL: D53.2 (KA), P7.13; also elsewhere on the board
/ISA_I2C_SDA: D48.2 (KA), P7.15; also elsewhere on the board
/ISA_LINRX/GPIO35: D38.2 (KA), P7.59; also elsewhere on the board
/ISA_LINTX/GPIO36: D33.2 (KA), P7.61; also elsewhere on the board
/ISA_MIBSPI3CLK/GPIO32: D56.2 (KA), P7.22; also elsewhere on the board
/ISA_MIBSPI3NCS[0]/GPIO34: D46.2 (KA), P7.26; also elsewhere on the board
/ISA_MIBSPI3NCS[4]/GPIO27: D43.2 (KA), P7.17; also elsewhere on the board
/ISA_MIBSPI3NCS[5]/GPIO33: D51.2 (KA), P7.24; also elsewhere on the board
/ISA_MIBSPI3SIMO/GPIO31: D61.2 (KA), P7.20; also elsewhere on the board
/ISA_MIBSPI3SOMI/GPIO30: D14.2 (KA), P7.16; also elsewhere on the board
/ISA_MR: D19.2 (KA), P7.5; also elsewhere on the board
/ISA_SCIRX/GPIO28: D25.2 (KA), P7.8; also elsewhere on the board
/ISA_SCITX/GPIO29: D17.2 (KA), P7.12; also elsewhere on the board
/ISA_nERROR: D58.2 (KA), P7.9; also elsewhere on the board
/ISA_nRST: D12.2 (KA), P7.7; also elsewhere on the board
/V_MONITOR: P7.11; also elsewhere on the board
GND: D10.3 (A), D12.3 (A), D14.3 (A), D16.3 (A), D17.3 (A), D18.3 (A), D19.3 (A), D22.3 (A), D24.3 (A), D25.3 (A), D29.3 (A), D30.3 (A), D32.3 (A), D33.3 (A), D34.3 (A), D37.3 (A), D38.3 (A), D43.3 (A), D45.3 (A), D46.3 (A), D48.3 (A), D49.3 (A), D50.3 (A), D51.3 (A), D53.3 (A), D54.3 (A), D55.3 (A), D56.3 (A), D58.3 (A), D60.3 (A), D61.3 (A), P7.2, P7.62, P7.63, P7.64; also elsewhere on the board
GNDA: D13.3 (A), D15.3 (A), D21.3 (A), D26.3 (A), D31.3 (A), D35.3 (A), D36.3 (A), D40.3 (A), D41.3 (A), D42.3 (A), D47.3 (A), D52.3 (A), D57.3 (A), P7.1, P7.3, P7.34, P7.36; also elsewhere on the board
unnamed: D13.2 (KA), R80.1
unnamed: D15.2 (KA), R73.1
unnamed: D21.2 (KA), R72.1
unnamed: D26.2 (KA), R71.1
unnamed: D31.2 (KA), R74.1
unnamed: D35.2 (KA), R77.1
unnamed: D36.2 (KA), R75.1
unnamed: D40.2 (KA), R78.1
unnamed: D41.2 (KA), R76.1
unnamed: D42.2 (KA), R79.1
unnamed: D47.2 (KA), R69.1
unnamed: D52.2 (KA), R68.1
unnamed: D57.2 (KA), R70.1

Notes on the sheet:
BUS ISA 8 BITS
V_MONITOR es una salida analógica de presición por lo que no se necesita el supresor BAV199
No se dispone protección por supresor BAV199

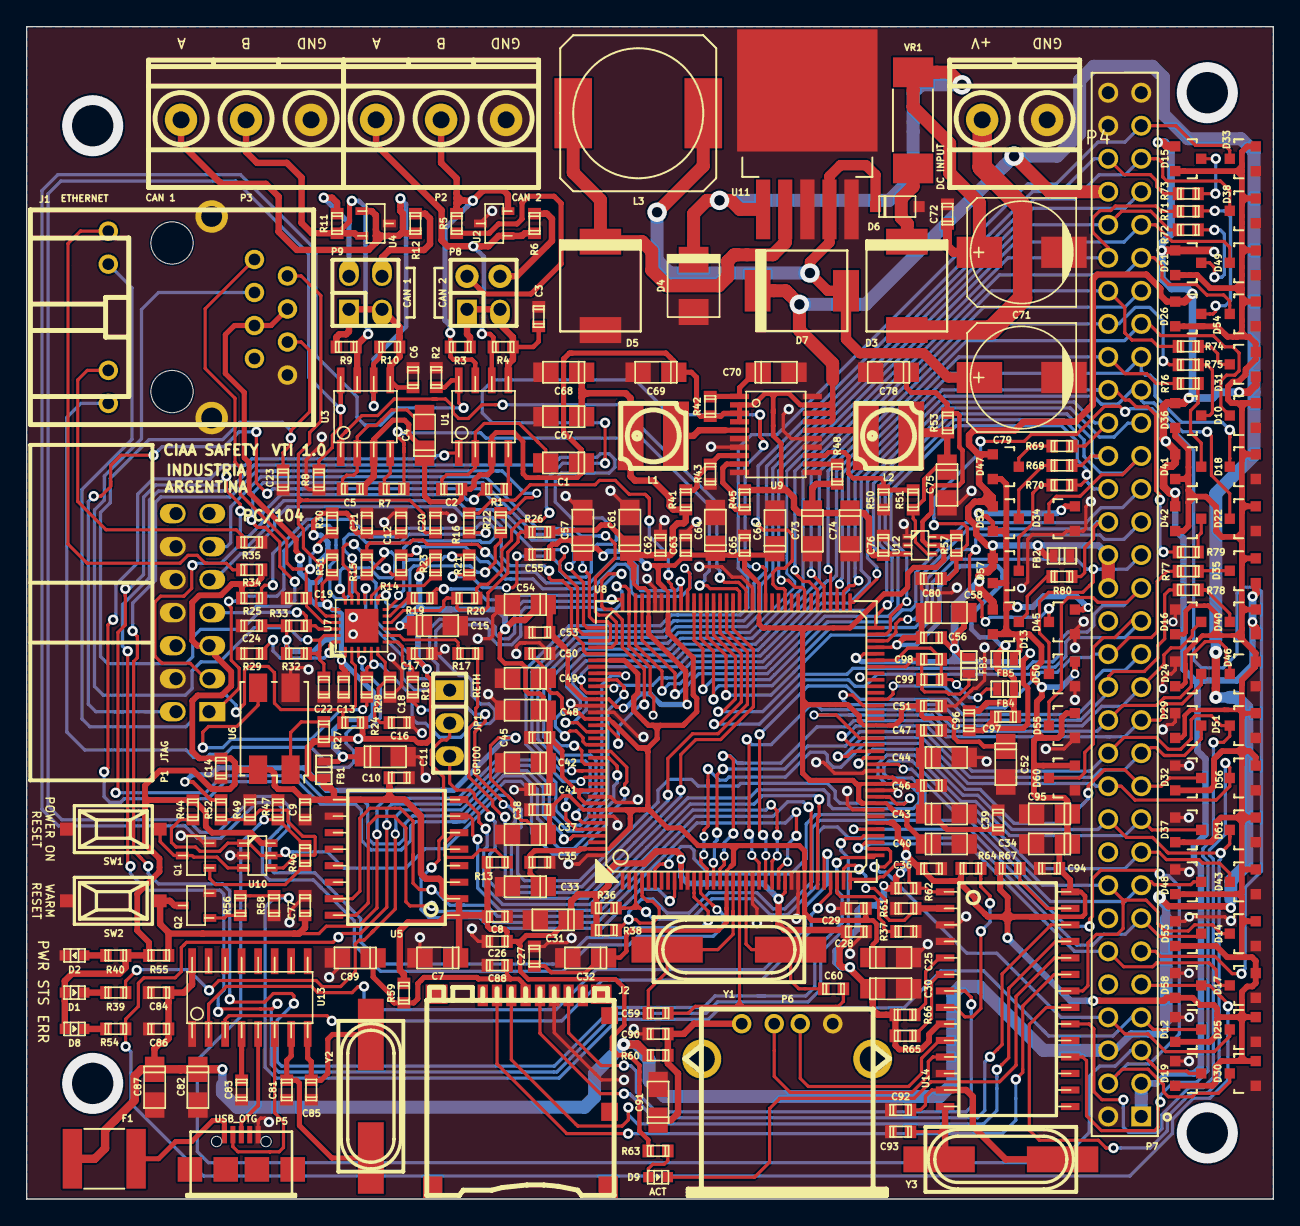
[picture p258: board CIAA_Safety_VTI_1.0.kicad_pcb from above]

Board: 2 copper layers, 95.9 x 90.2 mm, 275 parts (0 on the bottom side), 191 nets.
