ciaa/Hardware/PCB/Z3R0/ciaa-z3r0.kicad_pcb

## KiCad design PCB/Z3R0/ciaa-z3r0.kicad_pcb (2017-12-08)

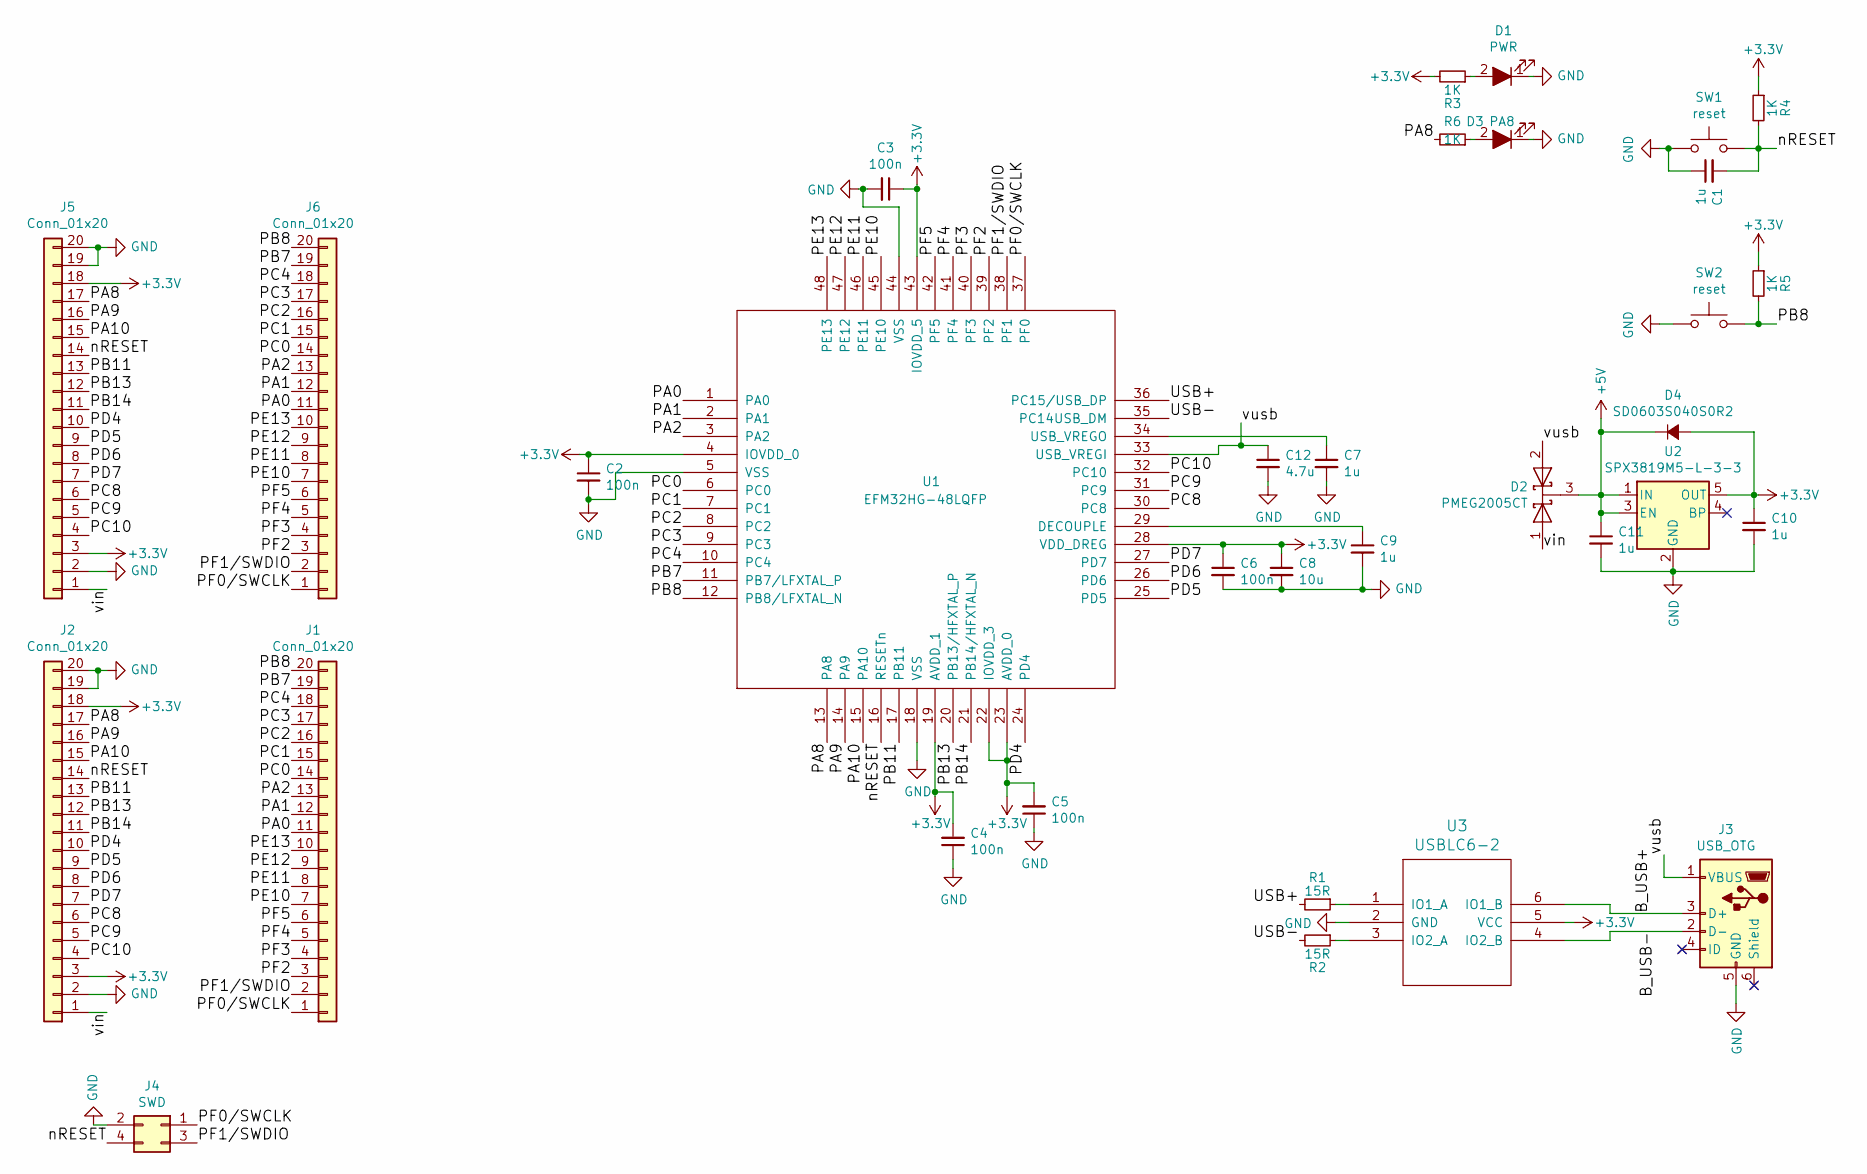
[picture p259: schematic ciaa-z3r0.sch]

Parts:
C1, C7, C9, C10, C11: 1u; C_0603
C2, C3, C4, C5, C6: 100n; C_0603
C8: 10u; C_0603
C12: 4.7u; C_0603
D1: PWR; LED_0805
D2: PMEG2005CT; SOT-23
D3: PA8; LED_0805
D4: SD0603S040S0R2; D_0603
J1, J2: Conn_01x20; Pin_Header_Straight_1x20_Pitch2.54mm
J3: USB_OTG; USB_Micro-B_Molex_47346-0001
J4: SWD; Pin_Header_Straight_2x02_Pitch2.54mm_SMD
J5, J6: Conn_01x20; Pin_Header_Straight_1x20_Pitch2.54mm_nosilkscreen
R1, R2: 15R; R_0603
R3, R4, R5, R6: 1K; R_0603
SW1, SW2: reset; SW_SPST_EVQPE1
U1: EFM32HG-48LQFP; LQFP-48_7x7mm_Pitch0.5mm
U2: SPX3819M5-L-3-3; SOT-23-5
U3: USBLC6-2; SOT-23-6

Connections:
+3V3: C2.1, C3.1, C4.2, C5.2, C6.1, C8.1, C10.1, D4.2 (A), J2.3, J2.18, J5.3, J5.18, R3.2, R4.1, R5.1, U1.4 (IOVDD_0), U1.19 (AVDD_1), U1.22 (IOVDD_3), U1.23 (AVDD_0), U1.28 (VDD_DREG), U1.43 (IOVDD_5), U2.5 (OUT), U3.5 (VCC)
+5V: C11.1, D2.3 (K), D4.1 (K), U2.1 (IN), U2.3 (EN)
/B_USB+: J3.3 (D+), U3.6 (IO1_B)
/B_USB-: J3.2 (D-), U3.4 (IO2_B)
/PA0: J1.11, J6.11, U1.1 (PA0)
/PA1: J1.12, J6.12, U1.2 (PA1)
/PA2: J1.13, J6.13, U1.3 (PA2)
/PA8: J2.17, J5.17, R6.2, U1.13 (PA8)
/PA9: J2.16, J5.16, U1.14 (PA9)
/PA10: J2.15, J5.15, U1.15 (PA10)
/PB7: J1.19, J6.19, U1.11 (PB7/LFXTAL_P)
/PB8: J1.20, J6.20, R5.2, SW2.2, U1.12 (PB8/LFXTAL_N)
/PB11: J2.13, J5.13, U1.17 (PB11)
/PB13: J2.12, J5.12, U1.20 (PB13/HFXTAL_P)
/PB14: J2.11, J5.11, U1.21 (PB14/HFXTAL_N)
/PC0: J1.14, J6.14, U1.6 (PC0)
/PC1: J1.15, J6.15, U1.7 (PC1)
/PC2: J1.16, J6.16, U1.8 (PC2)
/PC3: J1.17, J6.17, U1.9 (PC3)
/PC4: J1.18, J6.18, U1.10 (PC4)
/PC8: J2.6, J5.6, U1.30 (PC8)
/PC9: J2.5, J5.5, U1.31 (PC9)
/PC10: J2.4, J5.4, U1.32 (PC10)
/PD4: J2.10, J5.10, U1.24 (PD4)
/PD5: J2.9, J5.9, U1.25 (PD5)
/PD6: J2.8, J5.8, U1.26 (PD6)
/PD7: J2.7, J5.7, U1.27 (PD7)
/PE10: J1.7, J6.7, U1.45 (PE10)
/PE11: J1.8, J6.8, U1.46 (PE11)
/PE12: J1.9, J6.9, U1.47 (PE12)
/PE13: J1.10, J6.10, U1.48 (PE13)
/PF0/SWCLK: J1.1, J4.1, J6.1, U1.37 (PF0)
/PF1/SWDIO: J1.2, J4.3, J6.2, U1.38 (PF1)
/PF2: J1.3, J6.3, U1.39 (PF2)
/PF3: J1.4, J6.4, U1.40 (PF3)
/PF4: J1.5, J6.5, U1.41 (PF4)
/PF5: J1.6, J6.6, U1.42 (PF5)
/USB+: R1.2, U1.36 (PC15/USB_DP)
/USB-: R2.2, U1.35 (PC14USB_DM)
/nRESET: C1.2, J2.14, J4.4, J5.14, R4.2, SW1.2, U1.16 (RESETn)
/vin: D2.1 (A), J2.1, J5.1
/vusb: C12.1, D2.2 (A), J3.1 (VBUS), U1.33 (USB_VREGI)
GND: C1.1, C2.2, C3.2, C4.1, C5.1, C6.2, C7.2, C8.2, C9.2, C10.2, C11.2, C12.2, D1.1 (K), D3.1 (K), J2.2, J2.19, J2.20, J3.5 (GND), J4.2, J5.2, J5.19, J5.20, SW1.1, SW2.1, U1.5 (VSS), U1.18 (VSS), U1.44 (VSS), U2.2 (GND), U3.2 (GND)
unnamed: C7.1, U1.34 (USB_VREGO)
unnamed: C9.1, U1.29 (DECOUPLE)
unnamed: D1.2 (A), R3.1
unnamed: D3.2 (A), R6.1
unnamed: R1.1, U3.1 (IO1_A)
unnamed: R2.1, U3.3 (IO2_A)

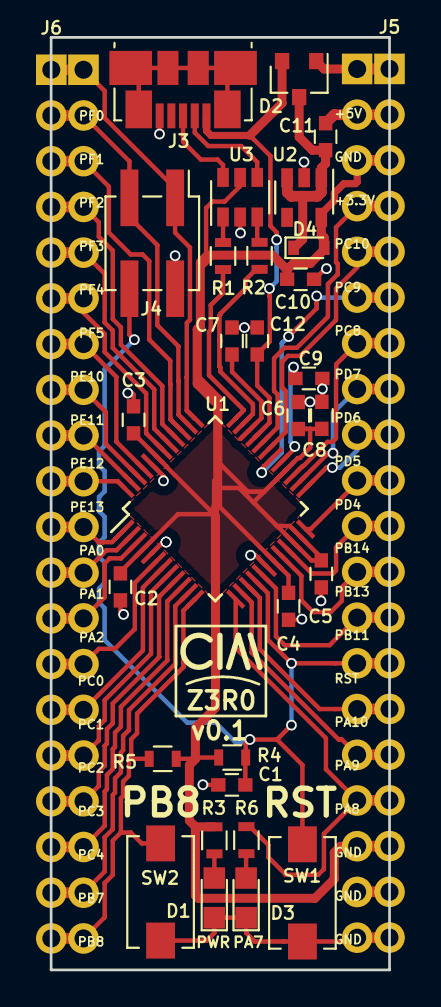
[picture p260: board ciaa-z3r0.kicad_pcb from above]

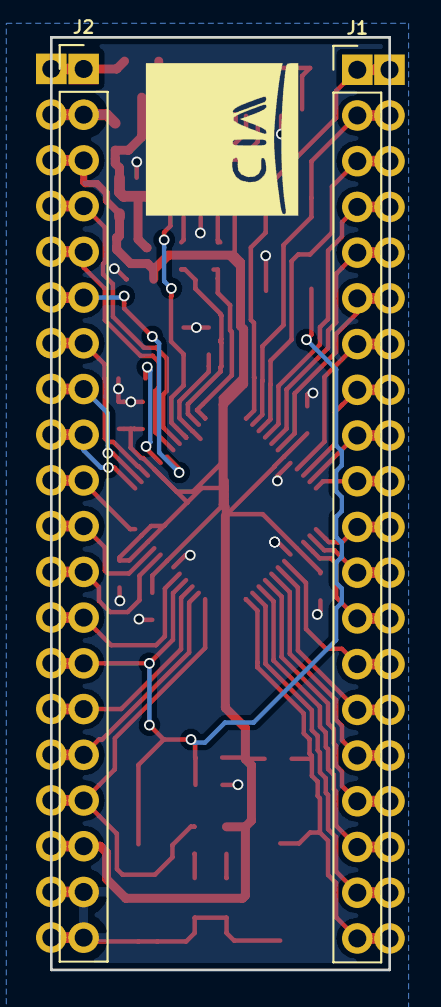
[picture p261: board ciaa-z3r0.kicad_pcb from below]

Board: 2 copper layers, 18.8 x 51.8 mm, 34 parts (3 on the bottom side), 49 nets.

Other parts of the board:
G102: LOGO_CIAA; LOGO-CIAA
