ciaa/Hardware/PCB/pico/picociaa.kicad_pcb

## KiCad design PCB/pico/picociaa.kicad_pcb (2017-05-08)

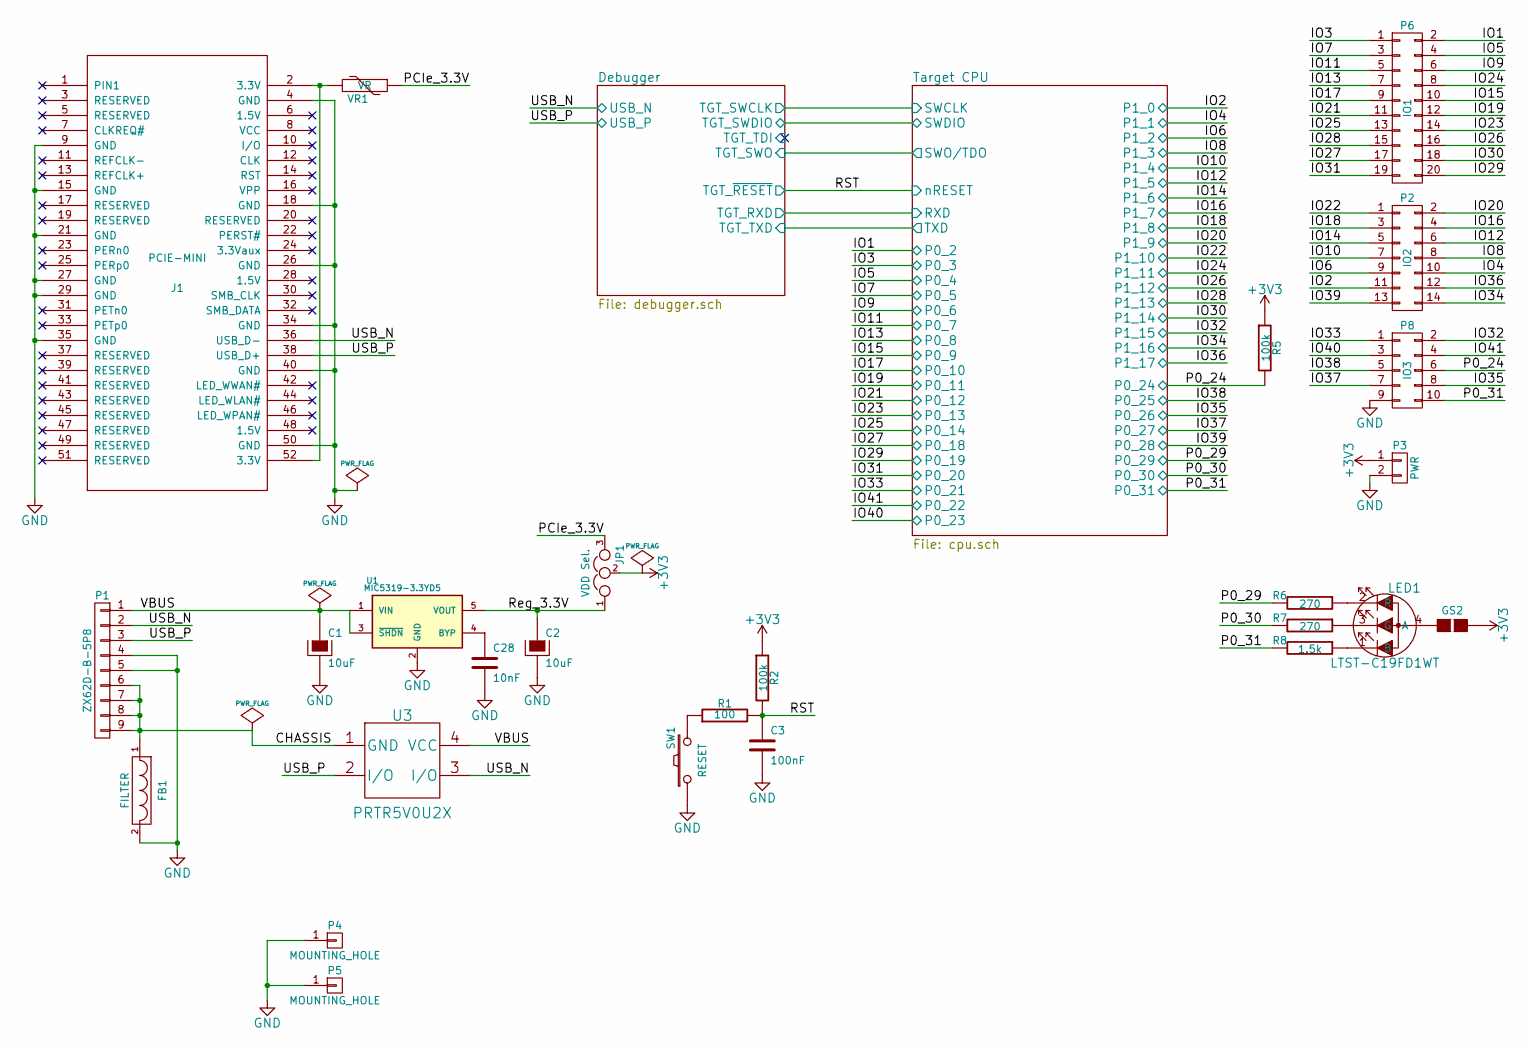
[picture p270: schematic picociaa.sch]

Parts:
C1, C2: 10uF; TantalC_SizeA_EIA-3216_Reflow
C3: 100nF; C_0603
C28: 10nF; C_0603
FB1: FILTER; R_0603
GS2: GS2
J1: PCIE-MINI; miniPCIeConn
JP1: VDD Sel.; Pin_Header_Straight_1x03_Pitch2.00mm
LED1: LTST-C19FD1WT; PLCC-4
P1: ZX62D-B-5P8; USB_microAB_ZX62-AB&B-5PA-11
P2: IO2; Pin_Header_Straight_2x07_Pitch2.00mm
P3: PWR; Pin_Header_Straight_1x02_Pitch2.00mm
P4, P5: MOUNTING_HOLE; PIN_ARRAY_1
P6: IO1; Pin_Header_Straight_2x10_Pitch2.00mm
P8: IO3; Pin_Header_Straight_2x05_Pitch2.00mm
R1: 100; R_0603
R2, R5: 100k; R_0603
R6, R7: 270; R_0603
R8: 1.5k; R_0603
SW1: RESET; SW_SPST_FSMSM
U1: MIC5319-3.3YD5; SOT-23-5
U3: PRTR5V0U2X; SOT-143
VR1: VR; R_1206

Connections:
+3V3: GS2.2 (G2), JP1.2, P3.1, R2.1, R5.1; also elsewhere on the board
/CHASSIS: FB1.1, P1.6, P1.7, P1.8, P1.9, U3.1 (GND)
/Debugger/TGT_~RESET~: C3.1, R1.2, R2.2; also elsewhere on the board
/Debugger/USB_N: J1.36 (USB_D-), P1.2, U3.3 (I/O); also elsewhere on the board
/Debugger/USB_P: J1.38 (USB_D+), P1.3, U3.2 (I/O); also elsewhere on the board
/PCIe_3.3V: JP1.3, VR1.1
/Reg_3.3V: C2.1, JP1.1, U1.5 (VOUT)
/Target CPU/P0_2: P6.2; also elsewhere on the board
/Target CPU/P0_3: P6.1; also elsewhere on the board
/Target CPU/P0_4: P6.4; also elsewhere on the board
/Target CPU/P0_5: P6.3; also elsewhere on the board
/Target CPU/P0_6: P6.6; also elsewhere on the board
/Target CPU/P0_7: P6.5; also elsewhere on the board
/Target CPU/P0_8: P6.7; also elsewhere on the board
/Target CPU/P0_9: P6.10; also elsewhere on the board
/Target CPU/P0_10: P6.9; also elsewhere on the board
/Target CPU/P0_11: P6.12; also elsewhere on the board
/Target CPU/P0_12: P6.11; also elsewhere on the board
/Target CPU/P0_13: P6.14; also elsewhere on the board
/Target CPU/P0_14: P6.13; also elsewhere on the board
/Target CPU/P0_18: P6.17; also elsewhere on the board
/Target CPU/P0_19: P6.20; also elsewhere on the board
/Target CPU/P0_20: P6.19; also elsewhere on the board
/Target CPU/P0_21: P8.1; also elsewhere on the board
/Target CPU/P0_22: P8.4; also elsewhere on the board
/Target CPU/P0_23: P8.3; also elsewhere on the board
/Target CPU/P0_24: P8.6, R5.2; also elsewhere on the board
/Target CPU/P0_25: P8.5; also elsewhere on the board
/Target CPU/P0_26: P8.8; also elsewhere on the board
/Target CPU/P0_27: P8.7; also elsewhere on the board
/Target CPU/P0_28: P2.13; also elsewhere on the board
/Target CPU/P0_29: R6.2; also elsewhere on the board
/Target CPU/P0_30: R7.2; also elsewhere on the board
/Target CPU/P0_31: P8.10, R8.2; also elsewhere on the board
/Target CPU/P1_0: P2.11; also elsewhere on the board
/Target CPU/P1_1: P2.10; also elsewhere on the board
/Target CPU/P1_2: P2.9; also elsewhere on the board
/Target CPU/P1_3: P2.8; also elsewhere on the board
/Target CPU/P1_4: P2.7; also elsewhere on the board
/Target CPU/P1_5: P2.6; also elsewhere on the board
/Target CPU/P1_6: P2.5; also elsewhere on the board
/Target CPU/P1_7: P2.4; also elsewhere on the board
/Target CPU/P1_8: P2.3; also elsewhere on the board
/Target CPU/P1_9: P2.2; also elsewhere on the board
/Target CPU/P1_10: P2.1; also elsewhere on the board
/Target CPU/P1_11: P6.8; also elsewhere on the board
/Target CPU/P1_12: P6.16; also elsewhere on the board
/Target CPU/P1_13: P6.15; also elsewhere on the board
/Target CPU/P1_14: P6.18; also elsewhere on the board
/Target CPU/P1_15: P8.2; also elsewhere on the board
/Target CPU/P1_16: P2.14; also elsewhere on the board
/Target CPU/P1_17: P2.12; also elsewhere on the board
/VBUS: C1.1, P1.1, U1.1 (VIN), U1.3 (~SHDN~), U3.4 (VCC)
GND: C1.2, C2.2, C3.2, C28.2, FB1.2, J1.4 (GND), J1.9 (GND), J1.15 (GND), J1.18 (GND), J1.21 (GND), J1.26 (GND), J1.27 (GND), J1.29 (GND), J1.34 (GND), J1.35 (GND), J1.40 (GND), J1.50 (GND), P1.4, P1.5, P3.2, P4.1, P5.1, P8.9, SW1.1, U1.2 (GND); also elsewhere on the board
unnamed: C28.1, U1.4 (BYP)
unnamed: GS2.1 (G1), LED1.4 (A)
unnamed: J1.2 (3.3V), J1.52 (3.3V), VR1.2
unnamed: LED1.1 (B), R8.1
unnamed: LED1.2 (R), R6.1
unnamed: LED1.3 (G), R7.1
unnamed: R1.1, SW1.2

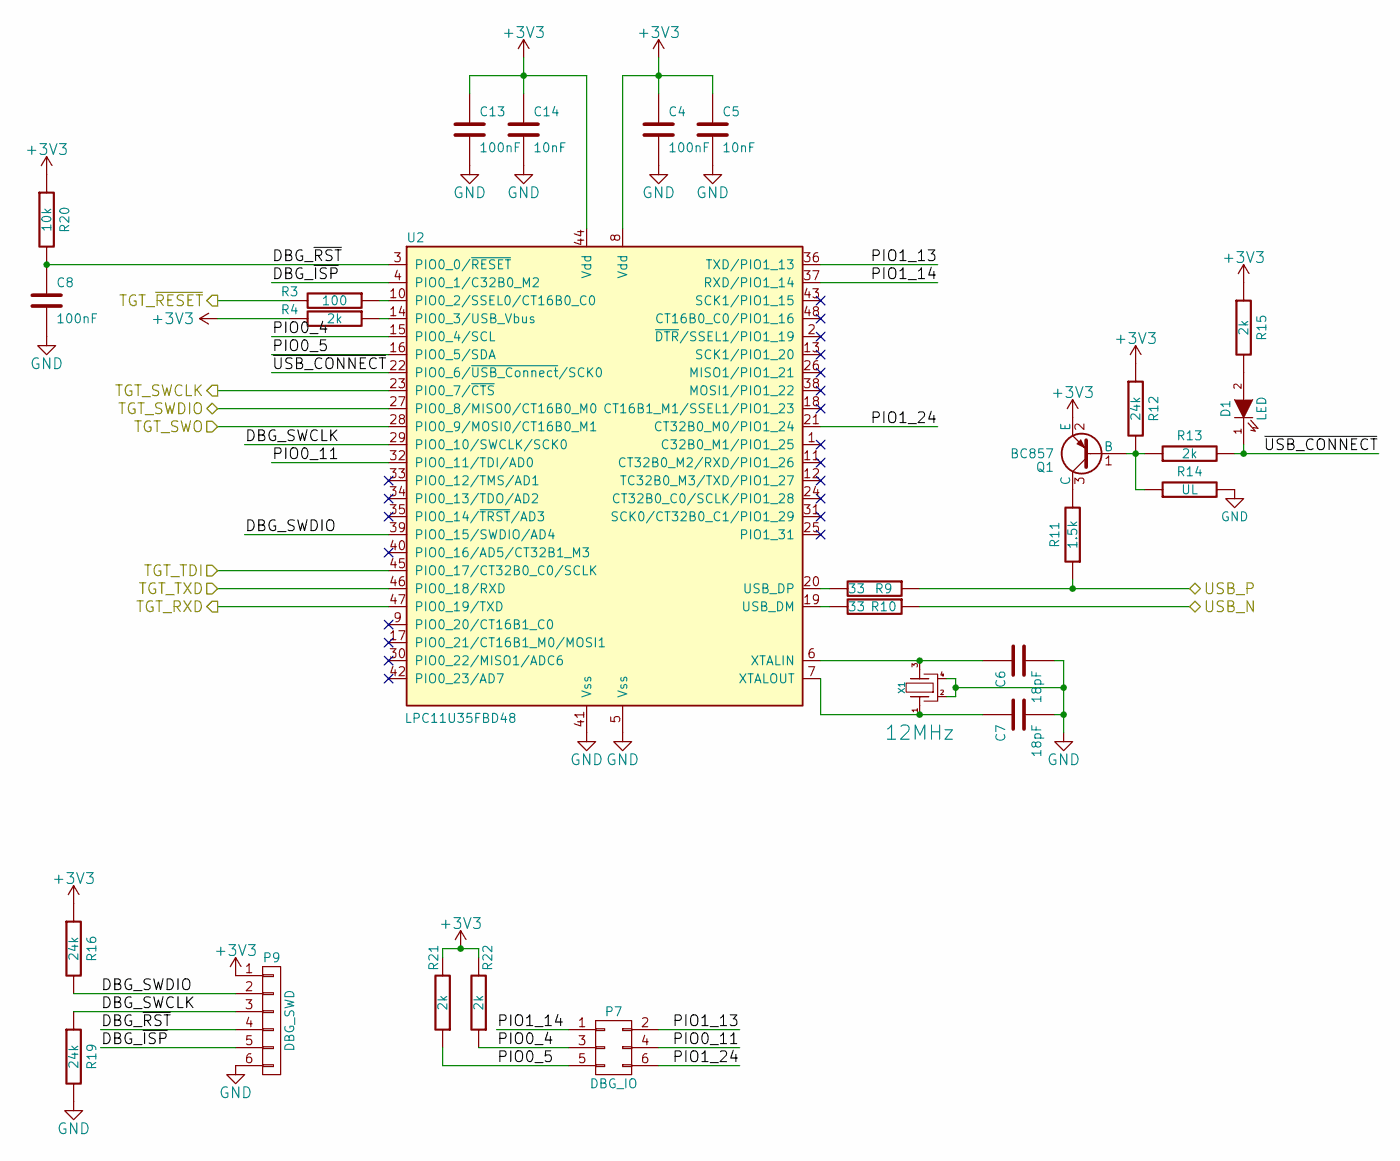
[picture p271: schematic debugger.sch, picoCIAA - Debugger]

Parts:
C4, C8, C13: 100nF; C_0603
C5, C14: 10nF; C_0603
C6, C7: 18pF; C_0603
D1: LED; LED_0603
P7: DBG_IO; Pin_Header_Straight_2x03_Pitch2.00mm
P9: DBG_SWD; Pin_Header_Straight_1x06_Pitch2.00mm
Q1: BC857; SOT-23
R3: 100; R_0603
R4, R13, R15, R21, R22: 2k; R_0603
R9, R10: 33; R_0603
R11: 1.5k; R_0603
R12, R16, R19: 24k; R_0603
R14: UL; R_0603
R20: 10k; R_0603
U2: LPC11U35FBD48; LQFP-48_7x7mm_Pitch0.5mm
X1: 12MHz; FA238V-XTAL; Digikey/Mouser 887-1831-1-ND

Connections:
+3V3: C4.1, C5.1, C13.1, C14.1, P9.1, Q1.2 (E), R4.2, R12.1, R15.1, R16.1, R20.1, R21.2, R22.2, U2.8 (Vdd), U2.44 (Vdd); also elsewhere on the board
/Debugger/DBG_SWCLK: P9.3, R19.1, U2.29 (PIO0_10/SWCLK/SCK0)
/Debugger/DBG_SWDIO: P9.2, R16.2, U2.39 (PIO0_15/SWDIO/AD4)
/Debugger/DBG_~ISP~: P9.5, U2.4 (PIO0_1/C32B0_M2)
/Debugger/DBG_~RST~: C8.1, P9.4, R20.2, U2.3 (PIO0_0/~RESET)
/Debugger/PIO0_4: P7.3, R22.1, U2.15 (PIO0_4/SCL)
/Debugger/PIO0_5: P7.5, R21.1, U2.16 (PIO0_5/SDA)
/Debugger/PIO0_11: P7.4, U2.32 (PIO0_11/TDI/AD0)
/Debugger/PIO1_13: P7.2, U2.36 (TXD/PIO1_13)
/Debugger/PIO1_14: P7.1, U2.37 (RXD/PIO1_14)
/Debugger/PIO1_24: P7.6, U2.21 (CT32B0_M0/PIO1_24)
/Debugger/TGT_TXD: U2.46 (PIO0_18/RXD); also elsewhere on the board
/Debugger/TGT_~RESET~: R3.2; also elsewhere on the board
/Debugger/USB_N: R10.1; also elsewhere on the board
/Debugger/USB_P: R9.1, R11.1; also elsewhere on the board
/Debugger/~USB_CONNECT~: D1.1 (K), R13.2, U2.22 (PIO0_6/~USB_Connect~/SCK0)
/Target CPU/RXD: U2.47 (PIO0_19/TXD); also elsewhere on the board
/Target CPU/SWCLK: U2.23 (PIO0_7/~CTS); also elsewhere on the board
/Target CPU/SWDIO: U2.27 (PIO0_8/MISO0/CT16B0_M0); also elsewhere on the board
/Target CPU/SWO/TDO: U2.28 (PIO0_9/MOSI0/CT16B0_M1); also elsewhere on the board
GND: C4.2, C5.2, C6.2, C7.2, C8.2, C13.2, C14.2, P9.6, R14.2, R19.2, U2.5 (Vss), U2.41 (Vss), X1.2 (GND), X1.4 (GND); also elsewhere on the board
unnamed: C6.1, U2.6 (XTALIN), X1.3 (B)
unnamed: C7.1, U2.7 (XTALOUT), X1.1 (A)
unnamed: D1.2 (A), R15.2
unnamed: Q1.1 (B), R12.2, R13.1, R14.1
unnamed: Q1.3 (C), R11.2
unnamed: R3.1, U2.10 (PIO0_2/SSEL0/CT16B0_C0)
unnamed: R4.1, U2.14 (PIO0_3/USB_Vbus)
unnamed: R9.2, U2.20 (USB_DP)
unnamed: R10.2, U2.19 (USB_DM)

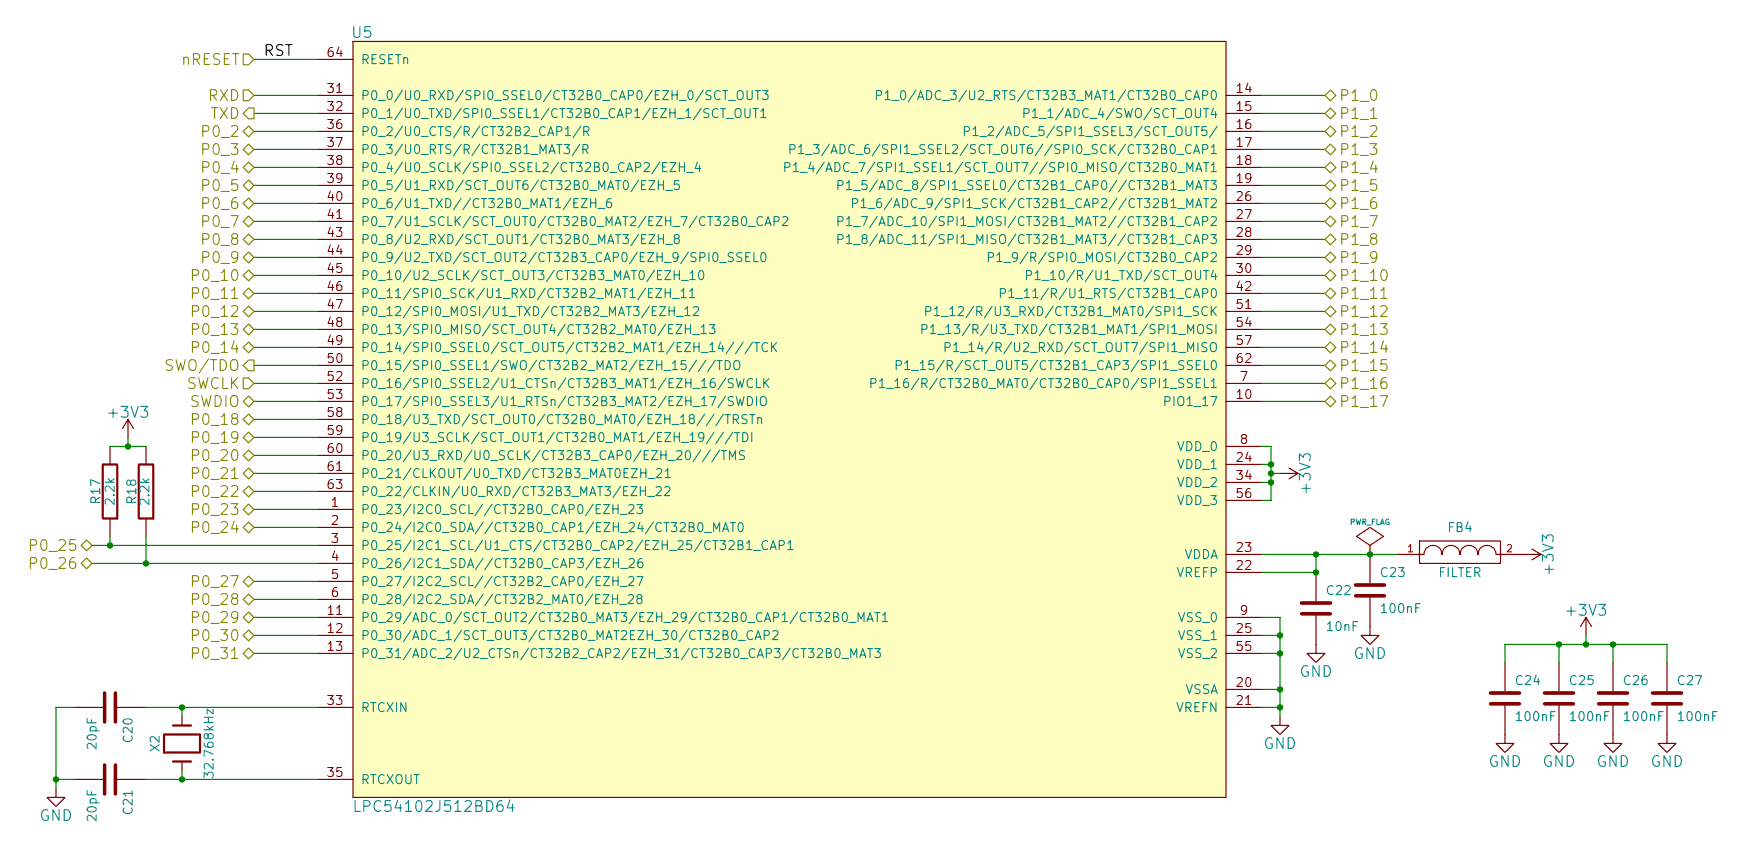
[picture p272: schematic cpu.sch, picoCIAA - CPU]

Parts:
C20, C21: 20pF; C_0603
C22: 10nF; C_0603
C23, C24, C25, C26, C27: 100nF; C_0603
FB4: FILTER; R_0603
R17, R18: 2.2k; R_0603
U5: LPC54102J512BD64; TQFP-64_10x10mm_Pitch0.5mm
X2: 32.768kHz; 4SOJ

Connections:
+3V3: C24.1, C25.1, C26.1, C27.1, FB4.2, R17.2, R18.2, U5.8 (VDD_0), U5.24 (VDD_1), U5.34 (VDD_2), U5.56 (VDD_3); also elsewhere on the board
/Debugger/TGT_TXD: U5.32 (P0_1/U0_TXD/SPI0_SSEL1/CT32B0_CAP1/EZH_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); also elsewhere on the board
/Debugger/TGT_~RESET~: U5.64 (RESETn); also elsewhere on the board
/Target CPU/P0_2: U5.36 (P0_2/U0_CTS/R/CT32B2_CAP1/R); also elsewhere on the board
/Target CPU/P0_3: U5.37 (P0_3/U0_RTS/R/CT32B1_MAT3/R); also elsewhere on the board
/Target CPU/P0_4: U5.38 (P0_4/U0_SCLK/SPI0_SSEL2/CT32B0_CAP2/EZH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); also elsewhere on the board
/Target CPU/P0_5: U5.39 (P0_5/U1_RXD/SCT_OUT6/CT32B0_MAT0/EZH_5); also elsewhere on the board
/Target CPU/P0_6: U5.40 (P0_6/U1_TXD//CT32B0_MAT1/EZH_6); also elsewhere on the board
/Target CPU/P0_7: U5.41 (P0_7/U1_SCLK/SCT_OUT0/CT32B0_MAT2/EZH_7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); also elsewhere on the board
/Target CPU/P0_8: U5.43 (P0_8/U2_RXD/SCT_OUT1/CT32B0_MAT3/EZH_8); also elsewhere on the board
/Target CPU/P0_9: U5.44 (P0_9/U2_TXD/SCT_OUT2/CT32B3_CAP0/EZH_9/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); also elsewhere on the board
/Target CPU/P0_10: U5.45 (P0_10/U2_SCLK/SCT_OUT3/CT32B3_MAT0/EZH_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); also elsewhere on the board
/Target CPU/P0_11: U5.46 (P0_11/SPI0_SCK/U1_RXD/CT32B2_MAT1/EZH_11); also elsewhere on the board
/Target CPU/P0_12: U5.47 (P0_12/SPI0_MOSI/U1_TXD/CT32B2_MAT3/EZH_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); also elsewhere on the board
/Target CPU/P0_13: U5.48 (P0_13/SPI0_MISO/SCT_OUT4/CT32B2_MAT0/EZ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); also elsewhere on the board
/Target CPU/P0_14: U5.49 (P0_14/SPI0_SSEL0/SCT_OUT5/CT32B2_MAT1/E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); also elsewhere on the board
/Target CPU/P0_18: U5.58 (P0_18/U3_TXD/SCT_OUT0/CT32B0_MAT0/EZH_1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); also elsewhere on the board
/Target CPU/P0_19: U5.59 (P0_19/U3_SCLK/SCT_OUT1/CT32B0_MAT1/EZH_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); also elsewhere on the board
/Target CPU/P0_20: U5.60 (P0_20/U3_RXD/U0_SCLK/CT32B3_CAP0/EZH_20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); also elsewhere on the board
/Target CPU/P0_21: U5.61 (P0_21/CLKOUT/U0_TXD/CT32B3_MAT0EZH_21); also elsewhere on the board
/Target CPU/P0_22: U5.63 (P0_22/CLKIN/U0_RXD/CT32B3_MAT3/EZH_22); also elsewhere on the board
/Target CPU/P0_23: U5.1 (P0_23/I2C0_SCL//CT32B0_CAP0/EZH_23); also elsewhere on the board
/Target CPU/P0_24: U5.2 (P0_24/I2C0_SDA//CT32B0_CAP1/EZH_24/CT32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); also elsewhere on the board
/Target CPU/P0_25: R17.1, U5.3 (P0_25/I2C1_SCL/U1_CTS/CT32B0_CAP2/EZH_2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); also elsewhere on the board
/Target CPU/P0_26: R18.1, U5.4 (P0_26/I2C1_SDA//CT32B0_CAP3/EZH_26); also elsewhere on the board
/Target CPU/P0_27: U5.5 (P0_27/I2C2_SCL//CT32B2_CAP0/EZH_27); also elsewhere on the board
/Target CPU/P0_28: U5.6 (P0_28/I2C2_SDA//CT32B2_MAT0/EZH_28); also elsewhere on the board
/Target CPU/P0_29: U5.11 (P0_29/ADC_0/SCT_OUT2/CT32B0_MAT3/EZH_29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); also elsewhere on the board
/Target CPU/P0_30: U5.12 (P0_30/ADC_1/SCT_OUT3/CT32B0_MAT2EZH_30/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); also elsewhere on the board
/Target CPU/P0_31: U5.13 (P0_31/ADC_2/U2_CTSn/CT32B2_CAP2/EZH_31/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); also elsewhere on the board
/Target CPU/P1_0: U5.14 (P1_0/ADC_3/U2_RTS/CT32B3_MAT1/CT32B0_CA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); also elsewhere on the board
/Target CPU/P1_1: U5.15 (P1_1/ADC_4/SWO/SCT_OUT4); also elsewhere on the board
/Target CPU/P1_2: U5.16 (P1_2/ADC_5/SPI1_SSEL3/SCT_OUT5/); also elsewhere on the board
/Target CPU/P1_3: U5.17 (P1_3/ADC_6/SPI1_SSEL2/SCT_OUT6//SPI0_SC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); also elsewhere on the board
/Target CPU/P1_4: U5.18 (P1_4/ADC_7/SPI1_SSEL1/SCT_OUT7//SPI0_MI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); also elsewhere on the board
/Target CPU/P1_5: U5.19 (P1_5/ADC_8/SPI1_SSEL0/CT32B1_CAP0//CT32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); also elsewhere on the board
/Target CPU/P1_6: U5.26 (P1_6/ADC_9/SPI1_SCK/CT32B1_CAP2//CT32B1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); also elsewhere on the board
/Target CPU/P1_7: U5.27 (P1_7/ADC_10/SPI1_MOSI/CT32B1_MAT2//CT32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); also elsewhere on the board
/Target CPU/P1_8: U5.28 (P1_8/ADC_11/SPI1_MISO/CT32B1_MAT3//CT32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); also elsewhere on the board
/Target CPU/P1_9: U5.29 (P1_9/R/SPI0_MOSI/CT32B0_CAP2); also elsewhere on the board
/Target CPU/P1_10: U5.30 (P1_10/R/U1_TXD/SCT_OUT4); also elsewhere on the board
/Target CPU/P1_11: U5.42 (P1_11/R/U1_RTS/CT32B1_CAP0); also elsewhere on the board
/Target CPU/P1_12: U5.51 (P1_12/R/U3_RXD/CT32B1_MAT0/SPI1_SCK); also elsewhere on the board
/Target CPU/P1_13: U5.54 (P1_13/R/U3_TXD/CT32B1_MAT1/SPI1_MOSI); also elsewhere on the board
/Target CPU/P1_14: U5.57 (P1_14/R/U2_RXD/SCT_OUT7/SPI1_MISO); also elsewhere on the board
/Target CPU/P1_15: U5.62 (P1_15/R/SCT_OUT5/CT32B1_CAP3/SPI1_SSEL0); also elsewhere on the board
/Target CPU/P1_16: U5.7 (P1_16/R/CT32B0_MAT0/CT32B0_CAP0/SPI1_SS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); also elsewhere on the board
/Target CPU/P1_17: U5.10 (PIO1_17); also elsewhere on the board
/Target CPU/RXD: U5.31 (P0_0/U0_RXD/SPI0_SSEL0/CT32B0_CAP0/EZH_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); also elsewhere on the board
/Target CPU/SWCLK: U5.52 (P0_16/SPI0_SSEL2/U1_CTSn/CT32B3_MAT1/EZ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); also elsewhere on the board
/Target CPU/SWDIO: U5.53 (P0_17/SPI0_SSEL3/U1_RTSn/CT32B3_MAT2/EZ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); also elsewhere on the board
/Target CPU/SWO/TDO: U5.50 (P0_15/SPI0_SSEL1/SWO/CT32B2_MAT2/EZH_15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); also elsewhere on the board
GND: C20.2, C21.2, C22.2, C23.2, C24.2, C25.2, C26.2, C27.2, U5.9 (VSS_0), U5.20 (VSSA), U5.21 (VREFN), U5.25 (VSS_1), U5.55 (VSS_2); also elsewhere on the board
unnamed: C20.1, U5.33 (RTCXIN), X2.2
unnamed: C21.1, U5.35 (RTCXOUT), X2.1
unnamed: C22.1, C23.1, FB4.1, U5.22 (VREFP), U5.23 (VDDA)

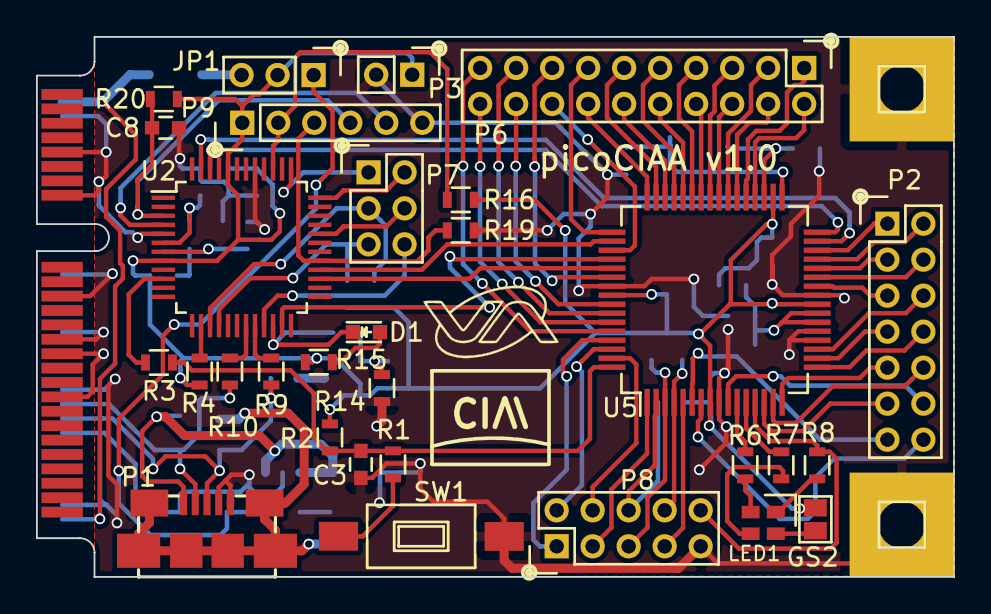
[picture p273: board picociaa.kicad_pcb from above]

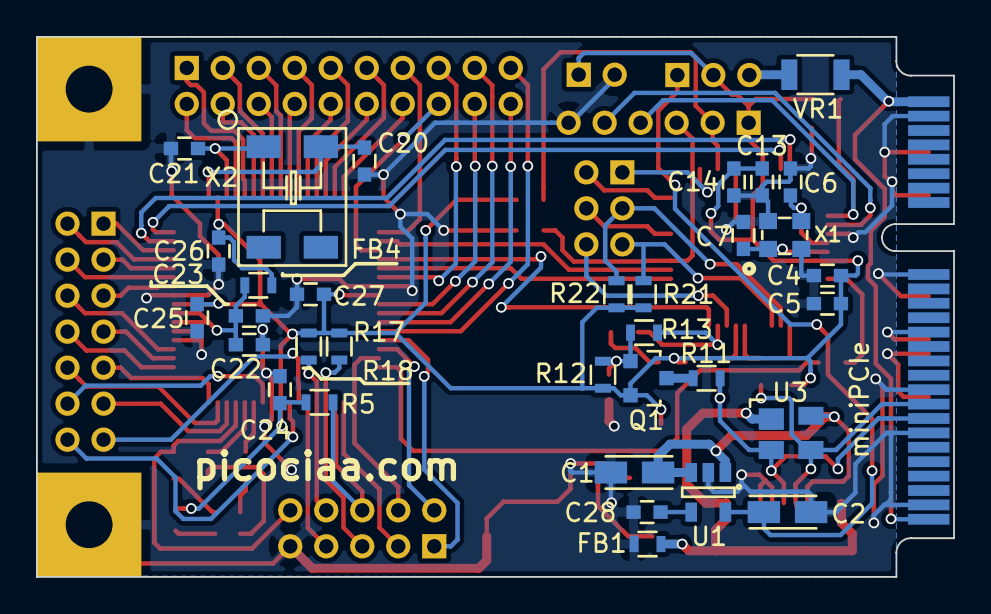
[picture p274: board picociaa.kicad_pcb from below]

Board: 2 copper layers, 51.0 x 30.0 mm, 66 parts (33 on the bottom side), 89 nets.
