ciaa/Hardware/PCB/EDU-FSL/EDU_CIAA_K60/EDU_CIAA_K60.kicad_pcb

## KiCad design PCB/EDU-FSL/EDU_CIAA_K60/EDU_CIAA_K60.kicad_pcb (2017-05-08)

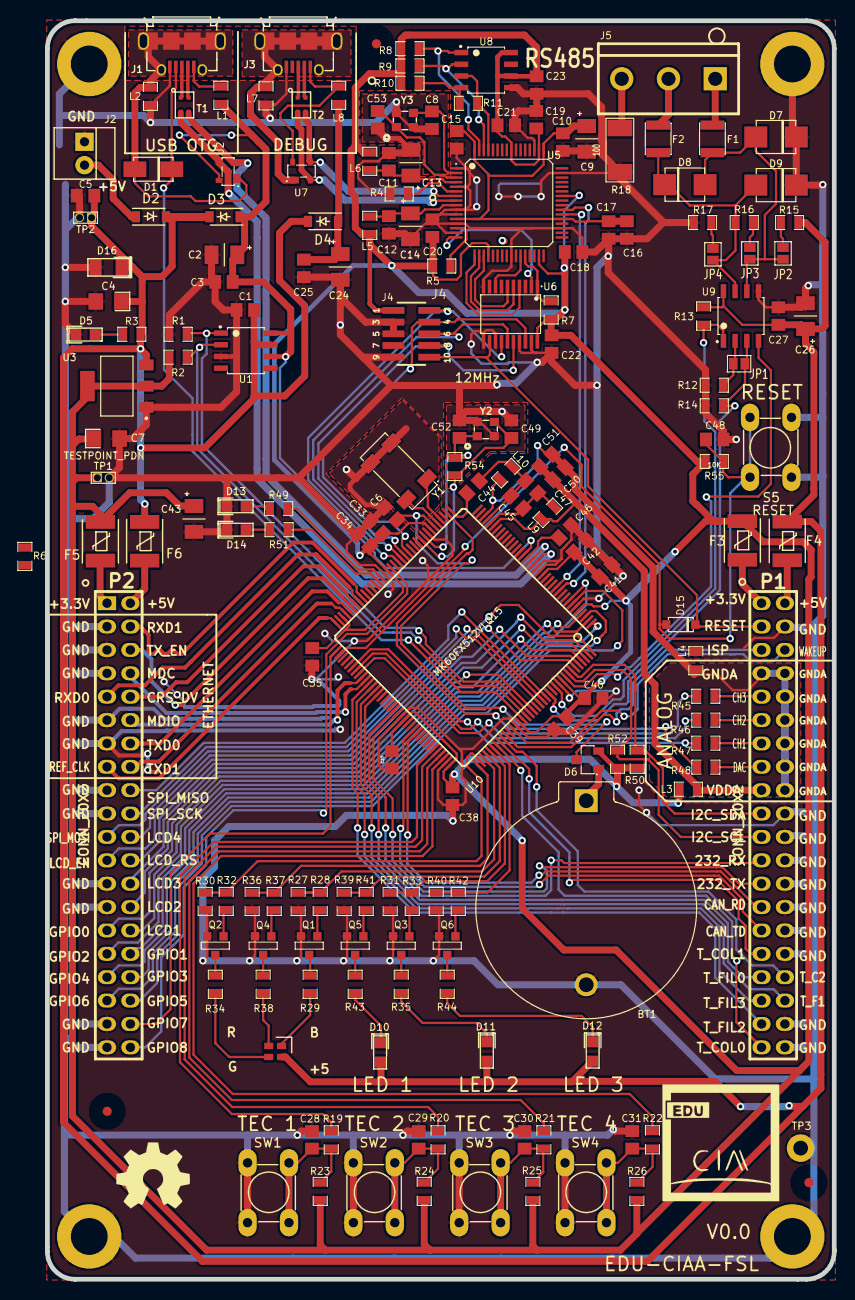
[picture p275: board EDU_CIAA_K60.kicad_pcb from above]

Board: 2 copper layers, 85.5 x 136.8 mm, 187 parts (0 on the bottom side), 162 nets.

Parts:
BT1: CR2032; 2032batPTH
C1, C3, C5, C6, C10, C11, C12, C15, C16, C17, C18, C19, C20, C21, C22, C23, C25, C27, C28, C29, C30, C31, C33, C34, C35, C37, C38, C39, C40, C41, C42, C44, C45, C48, C50: 100nF; c_0805
C2: 4,7uF; c_1206POL
C4, C7: 10uF; c_1206_tantalio
C8, C49, C52, C53: 20pF; c_0805
C9, C13, C14, C24, C26, C43: 10uF; c_1206POL
C46: 2.2uF; c_0805
C47, C51: 10nF; c_0805
D1: SMAJ5.0A; DO-214AC_SMA
D2, D3, D4: PMEG3020EH; SOD-123
D5, D14: ST2; LED-0805
D6: BAT54C; SOT-23
D7, D8, D9: P6SMB12CAT3G; DO-214AA_SMB
D10, D11, D12: LED; LED-0805
D13: ST1; LED-0805
D15: LL4148; SOD-123
D16: SMAZ5V6; SOD123F
F1, F2: USMF020; ptc_1210
F3, F4, F5, F6: MF-MSMF030-2; MF-MSMF
FD1, FD2, FD3: FIDUCIAL; Fiducial_1mm
G1: LOGO
G2: OSHWA
J1, J3: ZX62D-AB-5P8; USB_microAB_ZX62-AB-5P8
J2: 0022232021; Con_2P
J4: FTSH-105-01-L-DV-K-TR; PIN_ARRAY_5x2_1.27_SMD
J5: TB_1X3; bornier3
JP1, JP2, JP3, JP4: JUMPER-2; GS2
L1, L7, L8, L9, L10: MI0805M221R-10; SM0805
L2, L3, L4, L5, L6: HZ0805E601R-10; SM0805
LED1: LED_ARBG; PLCC-4
MH1, MH2, MH3, MH4: PCB_HOLE
P1, P2: CONN_20X2; PIN_ARRAY_20X2
Q1, Q2, Q3, Q4, Q5, Q6: 2N7002; SOT23GDS
R1, R2: 10k; r_0805
R3: 1k; r_0805
R4: 12K 1%; r_0805
R5: 1K; r_0805
R6, R11, R50, R52: 2K2; r_0805
R7, R8, R9, R10, R55: 10K; r_0805
R12, R13, R14: 4K7; r_0805
R15, R17: 390; r_0805
R16: 220; r_0805
R18: 100; r_2010
R19, R20, R21, R22: 1k; SM0805
R23, R24, R25, R26, R28, R32, R33, R37, R41, R42: 10k; SM0805
R27, R30, R31, R36, R39, R40: 330k; SM0805
R29, R34, R35, R38, R43, R44: 680; SM0805
R45, R46, R47: 1k2; SM0805
R48: 470; SM0805
R49, R51: 680; r_0805
R54: 10M; r_0805
S5: RESET; PUSH_SWITCH_THT
SW1: TEC_1; PUSH_SWITCH_THT
SW2: TEC_2; PUSH_SWITCH_THT
SW3: TEC_3; PUSH_SWITCH_THT
SW4: TEC_4; PUSH_SWITCH_THT
T1, T2: DLW21HN900SQ2; SRF2012
TP1, TP2: TESTPOINT_PDN
TP3: 4mm
U1: MIC2025-2YM; SOIC-8
U2, U7: PRTR5V0U2X; SOT-143-4
U3: NCP1117ST33T3G; SOT-223
U5: FT2232H; TQFP64
U6: 74HC244; TSSOP-20
U8: 93C46; SOIC-8
U9: SN65HVD1176DR; SOIC-8
U10: MK60FX512VLQ15; LQFP144
Y1: 32.768KHZ; 4SOJ
Y2, Y3: 12MHz; FA238V-XTAL

Connections:
+3.3V: C7.1, C18.1, C19.1, C20.1, C21.1, C22.1, C23.1, C33.1, C34.1, C35.1, C37.1, C38.1, C39.1, C40.1, C41.1, C42.1, C43.1, D6.2, F3.2, F5.2, J4.1, L3.1, L5.1, L6.1, R2.1, R5.1, R6.1, R7.2, R8.1, R9.1, R10.1, R23.1, R24.1, R25.1, R26.1, R50.1, R52.1, R55.1, TP1.1, U3.2, U5.20, U5.31, U5.42, U5.50, U5.56, U6.20, U8.6, U8.8, U10.5, U10.16, U10.43, U10.56, U10.70, U10.94, U10.108, U10.122, U10.135
+3.3VADC: C50.1, C51.2, L3.2, L9.2, P1.17, U10.31
+5V: C1.1, C4.1, C5.1, C26.1, C27.2, D2.1, D3.1, D4.1, D10.1, D11.1, D12.1, D16.2, F4.2, F6.2, LED1.4, R3.1, R13.1, R15.1, TP2.1, U1.7, U3.3, U9.8
+USB_JTAG_1V8: C9.1, C10.1, C15.1, C16.1, C17.1, U5.12, U5.37, U5.49, U5.64
/CPU/AUX_UART_CTS/SPI_CLK: P2.20, U10.128
/CPU/AUX_UART_RX/SPI_MISO: P2.18, U10.130
/CPU/AUX_UART_TX/SPI_MOSI: P2.21, U10.129
/CPU/CAN_RD: P1.27, U10.98
/CPU/CAN_TD: P1.29, U10.97
/CPU/GPIO9: P1.5, U10.118
/CPU/I2C_SCL: P1.21, R52.2, U10.137
/CPU/I2C_SDA: P1.19, R50.2, U10.138
/CPU/LED0_B: R27.1, R28.1, U10.111
/CPU/LED0_G: R30.1, R32.1, U10.110
/CPU/LED0_R: R36.1, R37.1, U10.109
/CPU/LED1: R39.1, R41.1, U10.112
/CPU/LED2: R31.1, R33.1, U10.113
/CPU/LED3: R40.1, R42.1, U10.114
/CPU/PULS_0: R19.1, U10.103
/CPU/PULS_1: R20.1, U10.104
/CPU/PULS_2: R21.1, U10.105
/CPU/PULS_3: R22.1, U10.106
/CPU/RESET: D15.2, J4.10, P1.3, U6.12
/CPU/RS232_RXD: P1.23, U10.91
/CPU/RS232_TXD: P1.25, U10.92
/CPU/RS485_DIR: JP1.2, R14.2, U9.3, U10.131
/CPU/RS485_RXD: R13.2, U9.1, U10.133
/CPU/RS485_TXD: U9.4, U10.136
/CPU/TCK: J4.4, U6.18, U10.50
/CPU/TDI: J4.8, U6.16, U10.51
/CPU/TDO: J4.6, U6.15, U10.52
/CPU/TEC_COL0: P1.39, U10.115
/CPU/TEC_COL1: P1.31, U10.116
/CPU/TEC_COL2: P1.34, U10.117
/CPU/TEC_F0: P1.33, U10.86
/CPU/TEC_F1: P1.36, U10.85
/CPU/TEC_F2: P1.37, U10.83
/CPU/TEC_F3: P1.35, U10.84
/CPU/TMS: J4.2, U6.14, U10.53
/CPU/USB_DM: T1.3, U2.2, U10.20
/CPU/USB_DP: T1.2, U2.3, U10.19
/CPU/USB_ID: D1.2, J1.4, U10.123
/CPU/USB_JTAG_UART_RXD: U5.38, U10.12
/CPU/USB_JTAG_UART_TXD: U5.39, U10.11
/CPU/VBAT: C6.1, D6.3, U10.42
/CPU/VREFH: C45.1, C47.2, L9.1, U10.32
/CPU/VREFL: C44.2, C45.2, C47.1, L10.1, U10.33
/CPU/WAKEUP: P1.6, U10.120
/Fuente/USB_VBUS: C2.1, C3.1, D3.2, L1.1, U1.6, U1.8, U2.4, U10.22
/GPIO/ADC0_1: R47.1, U10.78
/GPIO/ADC0_2: R46.1, U10.79
/GPIO/ADC0_3: R45.1, U10.80
/GPIO/DAC: R48.1, U10.38
/GPIO/ENET_CRS_DV: P2.10, U10.66
/GPIO/ENET_MDC: P2.8, U10.82
/GPIO/ENET_MDIO: P2.12, U10.81
/GPIO/ENET_REF_CLK: P2.15, U10.72
/GPIO/ENET_RXD0: P2.9, U10.65
/GPIO/ENET_RXD1: P2.4, U10.64
/GPIO/ENET_TXD0: P2.14, U10.68
/GPIO/ENET_TXD1: P2.16, U10.69
/GPIO/ENET_TX_EN: P2.6, U10.67
/GPIO/GPIO0: P2.29, U10.126
/GPIO/GPIO1: P2.32, U10.4
/GPIO/GPIO2: P2.31, U10.2
/GPIO/GPIO3: P2.34, U10.1
/GPIO/GPIO4: P2.33, U10.8
/GPIO/GPIO5: P2.36, U10.7
/GPIO/GPIO6: P2.35, U10.3
/GPIO/GPIO7: P2.38, U10.73
/GPIO/GPIO8: P2.40, U10.55
/GPIO/LCD1: P2.30, U10.141
/GPIO/LCD2: P2.28, U10.142
/GPIO/LCD3: P2.26, U10.143
/GPIO/LCD4: P2.22, U10.144
/GPIO/LCD_EN: P2.23, U10.139
/GPIO/LCD_RS: P2.24, U10.140
/JTAG/CHS_DBG: J3.6, J3.7, J3.8, J3.9, L7.2, U7.1
/JTAG/EECLK: R9.2, U5.62, U8.2
/JTAG/EECS: R8.2, U5.63, U8.1
/JTAG/EEDATA: R11.1, U5.61, U8.3
/JTAG/FT_OE: R7.1, U5.28, U6.1
/JTAG/FT_RST: U5.27, U6.8
/JTAG/FT_TCK: U5.16, U6.2
/JTAG/FT_TDI: U5.17, U6.4
/JTAG/FT_TDO: U5.18, U6.5
/JTAG/FT_TMS: U5.19, U6.6
/JTAG/USB_DEBUG_VBUS: C24.1, C25.1, D4.2, L8.2
/JTAG/USB_JTAG_DM: T2.3, U5.7, U7.3
/JTAG/USB_JTAG_DP: T2.2, U5.8, U7.2
/USB OTG/CHS_OTG: D1.1, J1.6, J1.7, J1.8, J1.9, L2.2, U2.1
/USB OTG/USB0_PPWR: R1.2, U1.1, U10.125
/USB OTG/USB0_PWR_FAULT: R2.2, U1.2, U10.124
/USB OTG/USB_DM_OTG: J1.2, T1.4
/USB OTG/USB_DP_OTG: J1.3, T1.1
GND: BT1.2, C1.2, C2.2, C3.2, C4.2, C5.2, C6.2, C7.2, C8.2, C9.2, C10.2, C11.2, C12.2, C13.2, C14.2, C15.2, C16.2, C17.2, C18.2, C19.2, C20.2, C21.2, C22.2, C23.2, C24.2, C25.2, C26.2, C27.1, C28.2, C29.2, C30.2, C31.2, C33.2, C34.2, C35.2, C37.2, C38.2, C39.2, C40.2, C41.2, C42.2, C43.2, C46.2, C48.1, C49.2, C52.2, C53.2, D5.2, D7.2, D9.2, D13.2, D14.2, D16.1, J1.5, J2.1, J3.5, J4.3, J4.5, J4.9, L2.1, L4.1, L7.1, MH1.1, MH2.1, MH3.1, MH4.1, P1.4, P1.20, P1.22, P1.24, P1.26, P1.28, P1.30, P1.32, P1.38, P1.40, P2.3, P2.5, P2.7, P2.11, P2.13, P2.17, P2.19, P2.25, P2.27, P2.37, P2.39, Q1.S, Q2.S, Q3.S, Q4.S, Q5.S, Q6.S, R1.1, R4.1, R12.1, R14.1, R17.2, R18.2, R27.2, R30.2, R31.2, R36.2, R39.2, R40.2, S5.3, S5.4, SW1.3, SW1.4, SW2.3, SW2.4, SW3.3, SW3.4, SW4.3, SW4.4, TP1.2, TP2.2, TP3.1, U1.3, U3.1, U5.1, U5.5, U5.10, U5.11, U5.13, U5.15, U5.25, U5.35, U5.47, U5.51, U6.10, U6.11, U6.13, U6.17, U6.19, U8.5, U9.5, U10.6, U10.17, U10.18, U10.44, U10.57, U10.71, U10.93, U10.107, U10.121, U10.134, Y1.2, Y1.4, Y2.2, Y2.4, Y3.2, Y3.4
GNDA: C50.2, C51.1, L4.2, L10.2, P1.7, P1.8, P1.10, P1.12, P1.14, P1.16, P1.18, U10.34
unnamed: BT1.1, D6.1
unnamed: C8.1, U5.2, Y3.3
unnamed: C11.1, C13.1, L6.2, U5.4
unnamed: C12.1, C14.1, L5.2, U5.9
unnamed: C28.1, R19.2, R23.2, SW1.1, SW1.2
unnamed: C29.1, R20.2, R24.2, SW2.1, SW2.2
unnamed: C30.1, R21.2, R25.2, SW3.1, SW3.2
unnamed: C31.1, R22.2, R26.2, SW4.1, SW4.2
unnamed: C44.1, U10.37
unnamed: C46.1, U10.21
unnamed: C48.2, D15.1, R55.2, S5.1, S5.2, U10.74
unnamed: C49.1, R54.1, U10.46, Y2.3
unnamed: C52.1, R54.2, U10.45, Y2.1
unnamed: C53.1, U5.3, Y3.1
unnamed: D2.2, J2.2
unnamed: D5.1, R3.2
unnamed: D7.1, D8.1, F1.1, JP2.2, JP3.2, U9.6
unnamed: D8.2, D9.1, F2.1, JP4.2, R16.2, U9.7
unnamed: D10.2, R43.1
unnamed: D11.2, R35.1
unnamed: D12.2, R44.1
unnamed: D13.1, R49.1
unnamed: D14.1, R51.1
unnamed: F1.2, J5.1
unnamed: F2.2, J5.2
unnamed: F3.1, P1.1
unnamed: F4.1, P1.2
unnamed: F5.1, P2.1
unnamed: F6.1, P2.2
unnamed: J1.1, L1.2
unnamed: J3.1, L8.1, U7.4
unnamed: J3.2, T2.4
unnamed: J3.3, T2.1
unnamed: J5.3, R18.1
unnamed: JP1.1, R12.2, U9.2
unnamed: JP2.1, R15.2
unnamed: JP3.1, R16.1
unnamed: JP4.1, R17.1
unnamed: LED1.1, R29.1
unnamed: LED1.2, R38.1
unnamed: LED1.3, R34.1
unnamed: P1.9, R45.2
unnamed: P1.11, R46.2
unnamed: P1.13, R47.2
unnamed: P1.15, R48.2
unnamed: Q1.D, R29.2
unnamed: Q1.G, R28.2
unnamed: Q2.D, R34.2
unnamed: Q2.G, R32.2
unnamed: Q3.D, R35.2
unnamed: Q3.G, R33.2
unnamed: Q4.D, R38.2
unnamed: Q4.G, R37.2
unnamed: Q5.D, R43.2
unnamed: Q5.G, R41.2
unnamed: Q6.D, R44.2
unnamed: Q6.G, R42.2
unnamed: R4.2, U5.6
unnamed: R5.2, U5.14
unnamed: R6.2, U10.54
unnamed: R10.2, R11.2, U8.4
unnamed: R49.2, U10.58
unnamed: R51.2, U10.59
unnamed: U10.40, Y1.1
unnamed: U10.41, Y1.3
