ciaa/Hardware/PCB/EDU-NXP/edu-ciaa-nxp.kicad_pcb

## KiCad design PCB/EDU-NXP/edu-ciaa-nxp.kicad_pcb (2017-05-08)

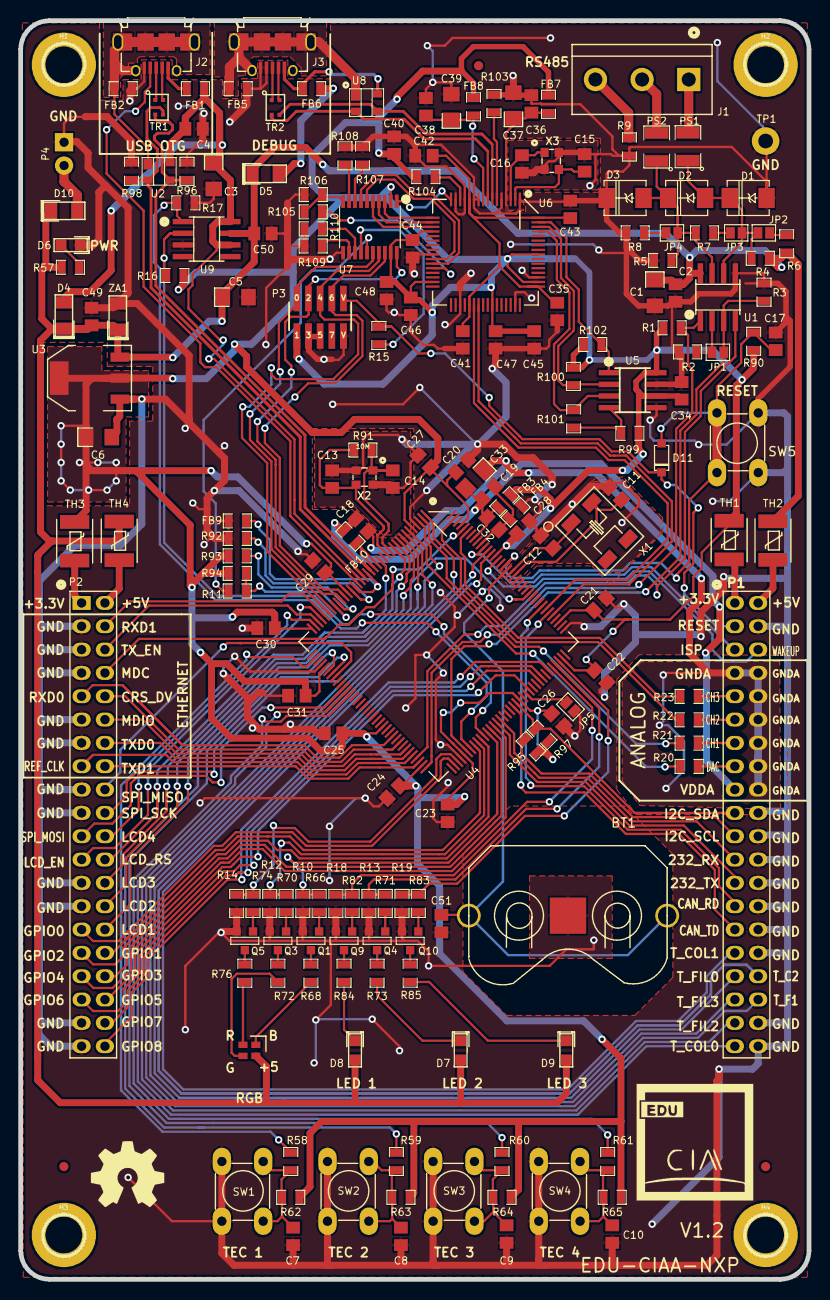
[picture p276: board edu-ciaa-nxp.kicad_pcb from above]

Board: 2 copper layers, 85.8 x 137.0 mm, 195 parts (0 on the bottom side), 166 nets.

Parts:
BT1: BK-913; BK-913-ND
C1: 10uF; c_1206_tantalio
C2, C4, C7, C8, C9, C10, C17, C18, C19, C20, C21, C22, C23, C24, C25, C26, C27, C28, C29, C30, C31, C32, C34, C36, C38, C40, C41, C42, C43, C44, C45, C46, C47, C48, C49, C50, C51: 100nF; c_0805
C3, C5, C6, C33, C37, C39: 10uF; c_1206_tantalio_1
C11, C12, C13, C14, C15, C16: 20p; c_0805
C35: 3.3uF; c_0805
D1, D2, D3: PSD12C; DO-214AA(SMB)
D4, D5, D10: PMEG3020EH; SOD123F
D6: LED red; LED-0805
D7, D8, D9: LED; LED-0805
D11: LL4148; SOD-123
F1, F2, F3: fiducial; Fiducial_1mm_TOP
F4, F5, F6: fiducial; Fiducial_1mm_BOT
FB1, FB5, FB6, FB9, FB10: MI0805M221R-10; SM0805
FB2, FB3, FB4, FB7, FB8: HZ0805E601R-10; SM0805
G101: OSHWA
H1, H2, H3, H4: 4mm; 1pin
J1: TB_1X3; bornier3
J2, J3: ZX62D-AB-5P8; USB_microAB_ZX62-AB-5P8
JP1, JP2, JP3, JP4: JUMPER-2; GS2
JP5: ISP; GS2
LED1: LED_ARBG; PLCC-4
P1, P2: CONN_20X2; PIN_ARRAY_20X2
P3: Cortex-Debug; Pin_Array_5x2_1.27mm_SMD
P4: 5Vcc Input; Con_2P
PS1, PS2: USMF020; SM1210
Q1, Q3, Q4, Q5, Q9, Q10: 2N7002; SOT23GDS
R1, R2, R3: 4K7; SM0805
R4, R5, R90: 100K; SM0805
R6, R8: 390; SM0805
R7: 200; SM0805
R9: 100; SM0805
R10, R12, R13, R14, R18, R19: 330k; SM0805
R11, R15, R107, R108, R109, R110: 0; SM0805
R16, R17, R62, R63, R64, R65, R66, R70, R71, R74, R82, R83, R106: 10k; SM0805
R20: 470; SM0805
R21, R22, R23: 1k2; SM0805
R57, R58, R59, R60, R61, R104: 1k; SM0805
R68, R72, R73, R76, R84, R85: 680; SM0805
R91: 10M; SM0805
R92: 12K; SM0805
R93, R94, R99, R100, R102: 10K; SM0805
R95, R97: 2.2k; SM0805
R96, R98: 15K; SM0805
R101: 2.2K; SM0805
R103: 12K 1%; SM0805
R105: 270; SM0805
SW1: TEC_1; PUSH_SWITCH_THT
SW2: TEC_2; PUSH_SWITCH_THT
SW3: TEC_3; PUSH_SWITCH_THT
SW4: TEC_4; PUSH_SWITCH_THT
SW5: RESET; PUSH_SWITCH_THT
TH1, TH2, TH3, TH4: MF-MSMF030-2; MF-MSMF
TP1: 4mm; GNDpin
TR1, TR2: DLW21HN900SQ2; SRF2012
U1: SN65HVD1176DR; -SOIC8
U2, U8: PRTR5V0U2X; sot143B
U3: NCP1117ST33T3G; SOT223
U4: LPC4337JBD144; LQFP144-M05
U5: 93C46; -SOIC8
U6: FT2232H; LQFP64-M05
U7: TXB0108; tssop-20
U9: MIC2025; -SOIC8
X1: 32.768K; 4SOJ
X2, X3: 12MHz; FA238V-XTAL
ZA1: SMAZ5V6; SOD123F

Connections:
+3.3V: C6.1, C20.2, C21.2, C22.2, C23.2, C24.2, C25.2, C26.2, C27.2, C28.2, C29.2, C30.2, C31.2, C34.1, C40.2, C44.1, C45.1, C46.1, C47.1, C48.2, FB3.1, FB7.2, FB8.2, P3.1, R1.1, R16.2, R62.1, R63.1, R64.1, R65.1, R90.2, R93.2, R94.2, R95.1, R97.1, R99.1, R100.1, R102.1, R104.1, TH1.2, TH3.2, U3.2, U3.4, U4.5, U4.25, U4.36, U4.41, U4.59, U4.71, U4.77, U4.94, U4.107, U4.111, U4.131, U4.141, U5.6, U5.8, U6.20, U6.31, U6.42, U6.50, U6.56, U7.2, U7.19
+3.3VADC: C18.1, C19.1, C32.1, C33.2, FB3.2, FB10.2, P1.17, U4.137
+5V: C1.2, C2.1, C5.1, C49.1, C50.1, D4.2, D5.2, D7.1, D8.1, D9.1, D10.2, LED1.4, R4.1, R6.1, R57.1, TH2.2, TH4.2, U1.8, U3.3, U9.7, ZA1.2
/CPU/ADC0_1: R21.1, U4.2
/CPU/ADC0_2: R22.1, U4.143
/CPU/ADC0_3: R23.1, U4.139
/CPU/CAN_RD: P1.27, U4.114
/CPU/CAN_TD: P1.29, U4.116
/CPU/CHJ3: FB5.1, J3.7, J3.8, J3.9, U8.1
/CPU/DAC: R20.1, U4.6
/CPU/EECLK: R100.2, U5.2, U6.62
/CPU/EECS: R102.2, U5.1, U6.63
/CPU/EEDATA: R101.1, U5.3, U6.61
/CPU/ENET_CRS_DV: P2.10, U4.64
/CPU/ENET_MDC: P2.8, U4.140
/CPU/ENET_MDIO: P2.12, U4.66
/CPU/ENET_REF_CLK: P2.15, U4.68
/CPU/ENET_RXD0: P2.9, U4.62
/CPU/ENET_RXD1: P2.4, U4.32
/CPU/ENET_TXD0: P2.14, U4.67
/CPU/ENET_TXD1: P2.16, U4.70
/CPU/ENET_TX_EN: P2.6, U4.34
/CPU/FT_OE: R105.2, U6.28
/CPU/FT_RST: U6.27, U7.7
/CPU/FT_TCK: U6.16, U7.1
/CPU/FT_TDI: U6.17, U7.3
/CPU/FT_TDO: U6.18, U7.4
/CPU/FT_TMS: U6.19, U7.5
/CPU/FT_TRST: U6.26, U7.6
/CPU/FT_XTIN: C15.2, U6.2, X3.3
/CPU/FT_XTOUT: C16.2, U6.3, X3.1
/CPU/GPIO0: P2.29, U4.74
/CPU/GPIO1: P2.32, U4.80
/CPU/GPIO2: P2.31, U4.82
/CPU/GPIO3: P2.34, U4.85
/CPU/GPIO4: P2.33, U4.86
/CPU/GPIO5: P2.36, U4.97
/CPU/GPIO6: P2.35, U4.100
/CPU/GPIO7: P2.38, U4.101
/CPU/GPIO8: P2.40, U4.103
/CPU/I2C_SCL: P1.21, R95.2, U4.92
/CPU/I2C_SDA: P1.19, R97.2, U4.93
/CPU/ISP: P1.5, U4.134
/CPU/LCD1: P2.30, U4.9
/CPU/LCD2: P2.28, U4.10
/CPU/LCD3: P2.26, U4.11
/CPU/LCD4: P2.22, U4.35
/CPU/LCD_RS: P2.24, U4.15
/CPU/LED0_B: R10.1, R66.1, U4.84
/CPU/LED0_G: R12.1, R70.1, U4.81
/CPU/LED0_R: R14.1, R74.1, U4.75
/CPU/LED1: R18.1, R82.1, U4.104
/CPU/LED2: R13.1, R71.1, U4.105
/CPU/LED3: R19.1, R83.1, U4.106
/CPU/PULS_0: R58.1, U4.38
/CPU/PULS_1: R59.1, U4.42
/CPU/PULS_2: R60.1, U4.43
/CPU/PULS_3: R61.1, U4.49
/CPU/RESET: D11.2, P1.3, P3.10, R15.1
/CPU/RS232_RXD: P1.23, U4.88
/CPU/RS232_TXD: P1.25, U4.87
/CPU/RS485_DIR: JP1.1, R3.1, U1.3, U4.78
/CPU/RS485_RXD: R1.2, U1.1, U4.72
/CPU/RS485_TXD: U1.4, U4.69
/CPU/RST: R15.2, U7.14
/CPU/RTCX1: C11.2, U4.125, X1.4
/CPU/RTCX2: C12.2, U4.126, X1.1
/CPU/SPI_MISO: P2.18, U4.44
/CPU/SPI_MOSI: P2.21, U4.47
/CPU/SPI_SCK: P2.20, U4.120
/CPU/TCK: P3.4, U4.27, U7.20
/CPU/TDI: P3.8, U4.26, U7.18
/CPU/TDO: P3.6, U4.31, U7.17
/CPU/TEC_COL0: P1.39, U4.48
/CPU/TEC_COL1: P1.31, U4.132
/CPU/TEC_COL2: P1.34, U4.133
/CPU/TEC_F0: P1.33, U4.1
/CPU/TEC_F1: P1.36, U4.3
/CPU/TEC_F2: P1.37, U4.8
/CPU/TEC_F3: P1.35, U4.7
/CPU/TMS: P3.2, U4.30, U7.16
/CPU/TRST: R11.2, U7.15
/CPU/U2_RXD: U4.115, U6.38
/CPU/U2_TXD: U4.113, U6.39
/CPU/USB_DEBUG_VBUS: D5.1, FB6.2
/CPU/USB_DM: R98.1, TR1.3, U2.2, U4.20
/CPU/USB_DP: R96.1, TR1.2, U2.3, U4.18
/CPU/USB_ID: J2.4, U4.22
/CPU/USB_JTAG_1.8V: C35.1, C41.1, C42.1, C43.1, U6.12, U6.37, U6.49, U6.64
/CPU/USB_JTAG_DM: TR2.3, U6.7, U8.3
/CPU/USB_JTAG_DP: TR2.2, U6.8, U8.2
/CPU/USB_PPWR: R17.2, U4.79, U9.1
/CPU/USB_PWR_FAULT: R16.1, U4.83, U9.2
/CPU/USB_VBUS: C3.1, C4.1, D4.1, FB1.2, U2.4, U4.21, U9.6, U9.8
/CPU/XTAL1: C14.2, R91.1, U4.12, X2.1
/CPU/XTAL2: C13.2, R91.2, U4.13, X2.3
/CPU/nTRST: R11.1, R94.1, U4.29
/GPIO/LCD_EN: P2.23, U4.33
/GPIO/WAKEUP: P1.6, U4.130
/USB_OTG/CHJ2: FB2.2, J2.7, J2.8, J2.9, U2.1
GND: BT1.2, C1.1, C2.2, C3.2, C4.2, C5.2, C6.2, C7.2, C8.2, C9.2, C10.2, C11.1, C12.1, C13.1, C14.1, C15.1, C16.1, C17.2, C20.1, C21.1, C22.1, C23.1, C24.1, C25.1, C26.1, C27.1, C28.1, C29.1, C30.1, C31.1, C34.2, C35.2, C36.2, C37.2, C38.2, C39.2, C40.1, C41.2, C42.2, C43.2, C44.2, C45.2, C46.2, C47.2, C48.1, C49.2, C50.2, C51.2, D1.1, D3.2, D6.2, FB2.1, FB4.1, FB5.2, FB9.1, J2.5, J3.4, J3.5, JP5.1, P1.4, P1.20, P1.22, P1.24, P1.26, P1.28, P1.30, P1.32, P1.38, P1.40, P2.3, P2.5, P2.7, P2.11, P2.13, P2.17, P2.19, P2.25, P2.27, P2.37, P2.39, P3.3, P3.5, P3.9, P4.1, Q1.S, Q3.S, Q4.S, Q5.S, Q9.S, Q10.S, R2.2, R3.2, R5.2, R8.2, R9.1, R10.2, R12.2, R13.2, R14.2, R17.1, R18.2, R19.2, R92.2, R96.2, R98.2, R103.1, R106.2, R107.1, R108.1, R109.1, R110.1, SW1.3, SW1.4, SW2.3, SW2.4, SW3.3, SW3.4, SW4.3, SW4.4, SW5.3, SW5.4, TP1.1, U1.5, U3.1, U4.4, U4.40, U4.76, U4.109, U5.5, U5.7, U6.1, U6.5, U6.10, U6.11, U6.13, U6.15, U6.25, U6.35, U6.47, U6.51, U7.11, U9.3, X2.2, X2.4, X3.2, X3.4, ZA1.1
GNDA: C18.2, C19.2, C32.2, C33.1, FB4.2, P1.7, P1.8, P1.10, P1.12, P1.14, P1.16, P1.18, U4.135
unnamed: JP5.2, U4.96
unnamed: J3.3, TR2.1
unnamed: J3.2, TR2.4
unnamed: C38.1, C39.1, FB8.1, U6.9
unnamed: R103.2, U6.6
unnamed: R104.2, U6.14
unnamed: R99.2, R101.2, U5.4
unnamed: R107.2, U7.8
unnamed: C36.1, C37.1, FB7.1, U6.4
unnamed: R110.2, U7.13
unnamed: R109.2, U7.12
unnamed: R105.1, R106.1, U7.10
unnamed: R108.2, U7.9
unnamed: FB9.2, U4.19, U4.23
unnamed: BT1.1, C51.1, U4.127
unnamed: FB10.1, U4.16, U4.17
unnamed: FB6.1, J3.1, U8.4
unnamed: R92.1, U4.24
unnamed: R93.1, U4.28
unnamed: C17.1, D11.1, R90.1, SW5.1, SW5.2, U4.128
unnamed: J1.3, R9.2
unnamed: JP4.1, R8.1
unnamed: JP3.1, R7.1
unnamed: J1.2, PS2.2
unnamed: J1.1, PS1.2
unnamed: JP2.2, R6.2
unnamed: JP1.2, R2.1, U1.2
unnamed: D1.2, D2.1, JP2.1, JP3.2, PS1.1, R4.2, U1.6
unnamed: D2.2, D3.1, JP4.2, PS2.1, R5.1, R7.2, U1.7
unnamed: D10.1, P4.2
unnamed: D6.1, R57.2
unnamed: FB1.1, J2.1
unnamed: J2.2, TR1.4
unnamed: J2.3, TR1.1
unnamed: P1.1, TH1.1
unnamed: P1.2, TH2.1
unnamed: P1.15, R20.2
unnamed: P1.13, R21.2
unnamed: P1.11, R22.2
unnamed: P1.9, R23.2
unnamed: P2.2, TH4.1
unnamed: P2.1, TH3.1
unnamed: LED1.3, R72.1
unnamed: D7.2, R73.1
unnamed: Q4.G, R71.2
unnamed: Q4.D, R73.2
unnamed: Q5.G, R74.2
unnamed: LED1.2, R76.1
unnamed: Q3.G, R70.2
unnamed: Q3.D, R72.2
unnamed: Q5.D, R76.2
unnamed: Q10.G, R83.2
unnamed: Q10.D, R85.2
unnamed: D9.2, R85.1
unnamed: D8.2, R84.1
unnamed: C8.1, R59.2, R63.2, SW2.1, SW2.2
unnamed: C7.1, R58.2, R62.2, SW1.1, SW1.2
unnamed: Q9.G, R82.2
unnamed: Q9.D, R84.2
unnamed: Q1.G, R66.2
unnamed: LED1.1, R68.1
unnamed: Q1.D, R68.2
unnamed: C9.1, R60.2, R64.2, SW3.1, SW3.2
unnamed: C10.1, R61.2, R65.2, SW4.1, SW4.2
