ciaa/Hardware/PCB/FSL/CIAA_K60/CIAA_K60.kicad_pcb

## KiCad design PCB/FSL/CIAA_K60/CIAA_K60.kicad_pcb (2016-05-29)

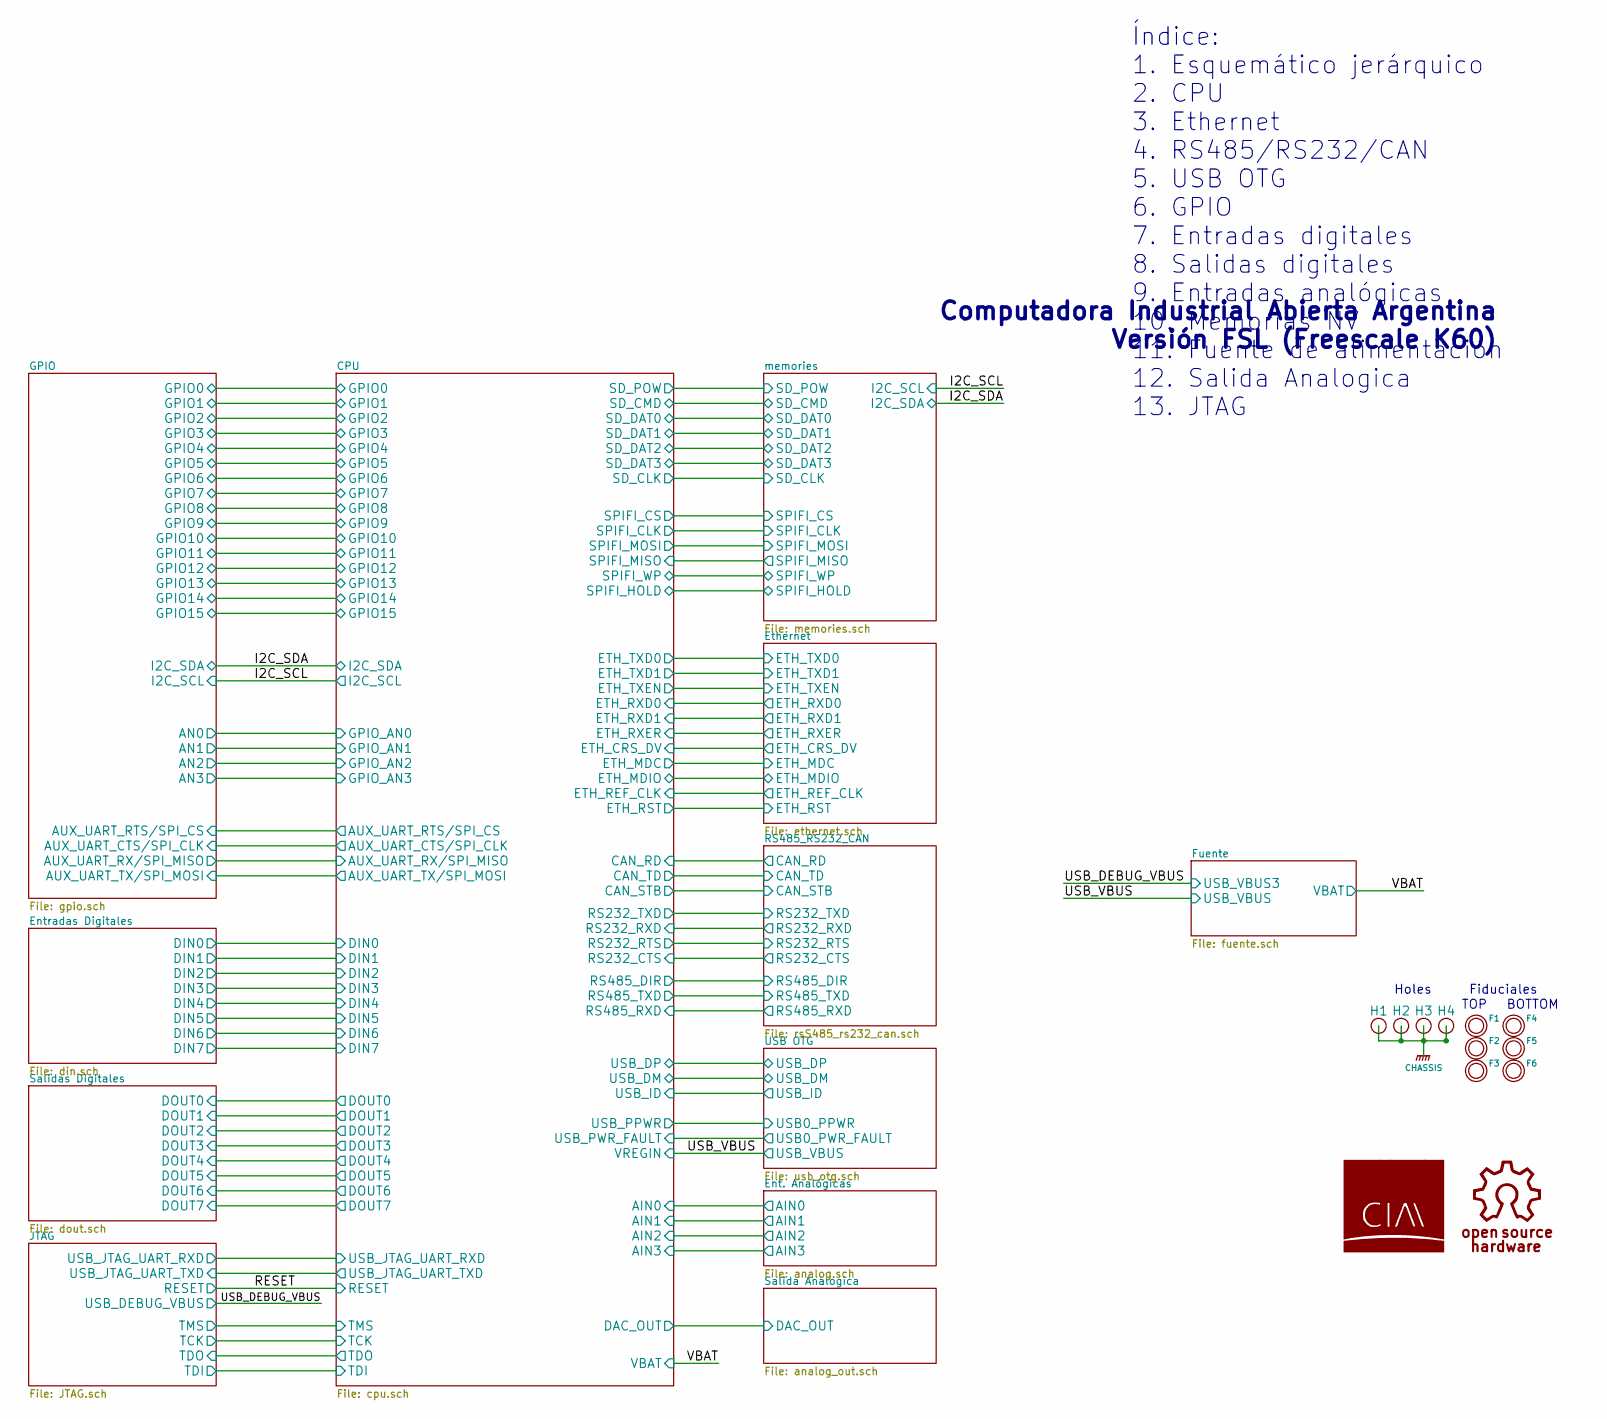
[picture p277: schematic CIAA_K60.sch, CIAA Freescale - Esquemático jerárquico]

Parts:
F1, F2, F3, F4, F5, F6: FIDUCIAL; Fiducial_1mm
G101: OSHWA
G102: LOGO_CIAA; LOGO-CIAA
H1, H2, H3, H4: PCB_HOLE

Connections:
GNDPWR: H1.1, H2.1, H3.1, H4.1; also elsewhere on the board

Notes on the sheet:
Índice: 1. Esquemático jerárquico 2. CPU 3. Ethernet 4. RS485/RS232/CAN 5. USB OTG 6. GPIO 7. Entradas digitales 8. Salidas digitales 9. Entradas analógicas 10. Memorias NV 11. Fuente de alimentación 12. Salida Analogica 13. JTAG
Computadora Industrial Abierta Argentina Versión FSL (Freescale K60)
Fiduciales
TOP
BOTTOM
Holes

Schematic: cpu.sch, Microcontrolador Freescale K60

Parts:
C201, C205, C206, C209, C210, C213, C214, C217, C218, C221, C223, C224, C227, C230: 100nF; c_0603; Digikey/Mouser 399-1096-1-ND
C203: 2.2uF; c_0603; Digikey/Mouser 587-2983-1-ND
C204, C207: 18pF; c_0603; Digikey/Mouser 399-1052-1-ND
C208, C212: 10nF; c_0603; Digikey/Mouser 399-1091-1-ND
C231: 10uF; c_1206POL; Digikey/Mouser 399-10116-1-ND
D201: LL4148; SOD-123; Digikey/Mouser LL4148FSCT-ND
D202: ST1; LED-0603; Digikey/Mouser 1080-1399-1-ND
D203: ST2; LED-0603; Digikey/Mouser 1080-1400-1-ND
FB201, FB202: ACML0603101; fb_0603; Digikey/Mouser ACML-0603-101-TCT-ND
R201, R202: 2K2; r_0603; Digikey/Mouser 311-2.2KGRCT-ND
R203: 100; r_0603; Digikey/Mouser 311-100GRCT-ND
R204, R207: 680; r_0603; Digikey/Mouser 311-680GRCT-ND
R205: 22; r_0603; Digikey/Mouser 311-22GRCT-ND
R206: 10K; r_0603; Digikey/Mouser 311-10KGRCT-ND
SW201: RESET; TACT_SMD_4; Digikey/Mouser 2-1437565-9
U201: MK60FX512VLQ15; LQFP144; Digikey/Mouser MK60FX512VLQ15-ND
U202: SI501; SI501_C; Digikey/Mouser 336-2889-ND
X202: 32.768KHZ; 4SOJ; Digikey/Mouser 535-9166-1-ND

Connections:
+3.3VADC: C209.1, C212.2, FB201.2, U201.31 (VDDA); also elsewhere on the board
/CPU/AIN0: U201.77 (PTA26/ADC2_SE15); also elsewhere on the board
/CPU/AIN1: U201.78 (PTA27/ADC2_SE14); also elsewhere on the board
/CPU/AIN2: U201.79 (PTA28/ADC2_SE13); also elsewhere on the board
/CPU/AIN3: U201.80 (PTA29/ADC2_SE12); also elsewhere on the board
/CPU/AUX_UART_CTS/SPI_CLK: U201.128 (PTD1/SPI0_SCK/~UART2_CTS); also elsewhere on the board
/CPU/AUX_UART_RTS/SPI_CS: U201.127 (PTD0/LLWU_P12/SPI0_PCS0/~UART2_RTS); also elsewhere on the board
/CPU/AUX_UART_RX/SPI_MISO: U201.130 (PTD3/SPI0_SIN/UART2_TX); also elsewhere on the board
/CPU/AUX_UART_TX/SPI_MOSI: U201.129 (PTD2/LLWU_P13/SPI0_SOUT/UART2_RX); also elsewhere on the board
/CPU/CAN_RD: U201.98 (PTB19/CAN0_RX); also elsewhere on the board
/CPU/CAN_STB: U201.54 (PTA4/LLWU_P3); also elsewhere on the board
/CPU/CAN_TD: U201.97 (PTB18/CAN0_TX); also elsewhere on the board
/CPU/DAC_OUT: U201.38 (DAC0_OUT); also elsewhere on the board
/CPU/DIN0: U201.9 (PTE6); also elsewhere on the board
/CPU/DIN1: U201.10 (PTE7); also elsewhere on the board
/CPU/DIN2: U201.13 (PTE10); also elsewhere on the board
/CPU/DIN3: U201.14 (PTE11); also elsewhere on the board
/CPU/DIN4: U201.15 (PTE12); also elsewhere on the board
/CPU/DIN5: U201.49 (PTE28); also elsewhere on the board
/CPU/DIN6: U201.48 (PTE27); also elsewhere on the board
/CPU/DIN7: U201.47 (PTE26); also elsewhere on the board
/CPU/DOUT0: U201.95 (PTB16); also elsewhere on the board
/CPU/DOUT1: U201.87 (PTB6); also elsewhere on the board
/CPU/DOUT2: U201.88 (PTB7); also elsewhere on the board
/CPU/DOUT3: U201.96 (PTB17); also elsewhere on the board
/CPU/DOUT4: U201.120 (PTC15); also elsewhere on the board
/CPU/DOUT5: U201.119 (PTC14); also elsewhere on the board
/CPU/DOUT6: U201.118 (PTC13); also elsewhere on the board
/CPU/DOUT7: U201.117 (PTC12); also elsewhere on the board
/CPU/ETH_CRS_DV: U201.66 (PTA14/RMII0_CRS_DV); also elsewhere on the board
/CPU/ETH_MDC: U201.82 (PTB1/RMII0_MDC); also elsewhere on the board
/CPU/ETH_MDIO: U201.81 (PTB0/LLWU_P5/RMII0_MDIO); also elsewhere on the board
/CPU/ETH_REF_CLK: U201.72 (PTA18/EXTAL0); also elsewhere on the board
/CPU/ETH_RST: U201.73 (PTA19); also elsewhere on the board
/CPU/ETH_RXD0: U201.65 (PTA13/RMII0_RXD0); also elsewhere on the board
/CPU/ETH_RXD1: U201.64 (PTA12/RMII0_RXD1); also elsewhere on the board
/CPU/ETH_RXER: U201.55 (PTA5/RMII0_RXER); also elsewhere on the board
/CPU/ETH_TXD0: U201.68 (PTA16/RMII0_TXD0); also elsewhere on the board
/CPU/ETH_TXD1: U201.69 (PTA17/RMII0_TXD1); also elsewhere on the board
/CPU/ETH_TXEN: U201.67 (PTA15/RMII0_TXEN); also elsewhere on the board
/CPU/GPIO0: U201.116 (PTC11/LLWU_P11); also elsewhere on the board
/CPU/GPIO1: U201.99 (PTB20); also elsewhere on the board
/CPU/GPIO2: U201.115 (PTC10); also elsewhere on the board
/CPU/GPIO3: U201.100 (PTB21); also elsewhere on the board
/CPU/GPIO4: U201.114 (PTC9); also elsewhere on the board
/CPU/GPIO5: U201.101 (PTB22); also elsewhere on the board
/CPU/GPIO6: U201.113 (PTC8); also elsewhere on the board
/CPU/GPIO7: U201.102 (PTB23); also elsewhere on the board
/CPU/GPIO8: U201.112 (PTC7); also elsewhere on the board
/CPU/GPIO9: U201.103 (PTC0); also elsewhere on the board
/CPU/GPIO10: U201.111 (PTC6/LLWU_P10); also elsewhere on the board
/CPU/GPIO11: U201.104 (PTC1/LLWU_P6); also elsewhere on the board
/CPU/GPIO12: U201.110 (PTC5/LLWU_P9); also elsewhere on the board
/CPU/GPIO13: U201.105 (PTC2); also elsewhere on the board
/CPU/GPIO14: U201.109 (PTC4/LLWU_P8); also elsewhere on the board
/CPU/GPIO15: U201.106 (PTC3/LLWU_P7); also elsewhere on the board
/CPU/I2C_SCL: R202.2, U201.137 (PTD8/I2C0_SCL); also elsewhere on the board
/CPU/I2C_SDA: R201.2, U201.138 (PTD9/I2C0_SDA); also elsewhere on the board
/CPU/RESET: D201.2 (K); also elsewhere on the board
/CPU/RS232_CTS: U201.90 (PTB9/~UART3_CTS); also elsewhere on the board
/CPU/RS232_RTS: U201.89 (PTB8/~UART3_RTS); also elsewhere on the board
/CPU/RS232_RXD: U201.91 (PTB10/UART3_RX); also elsewhere on the board
/CPU/RS232_TXD: U201.92 (PTB11/UART3_TX); also elsewhere on the board
/CPU/RS485_DIR: U201.131 (PTD4/LLWU_P14); also elsewhere on the board
/CPU/RS485_RXD: U201.133 (PTD6/LLWU_P15/UART0_RX); also elsewhere on the board
/CPU/RS485_TXD: U201.136 (PTD7/UART0_TX); also elsewhere on the board
/CPU/SD_CLK: R205.2; also elsewhere on the board
/CPU/SD_CMD: U201.4 (PTE3/SDHC0_CMD); also elsewhere on the board
/CPU/SD_DAT0: U201.2 (PTE1/LLWU_P0/SDHC0_D0); also elsewhere on the board
/CPU/SD_DAT1: U201.1 (PTE0/SDHC0_D1); also elsewhere on the board
/CPU/SD_DAT2: U201.8 (PTE5/SDHC0_D2); also elsewhere on the board
/CPU/SD_DAT3: U201.7 (PTE4/LLWU_P2/SDHC0_D3); also elsewhere on the board
/CPU/SD_POW: U201.126 (PTC19); also elsewhere on the board
/CPU/SPIFI_CLK: U201.141 (PTD12/SPI2_SCK); also elsewhere on the board
/CPU/SPIFI_CS: U201.140 (PTD11/SPI2_PCS0); also elsewhere on the board
/CPU/SPIFI_HOLD: U201.144 (PTD15/SPI2_PCS1); also elsewhere on the board
/CPU/SPIFI_MISO: U201.143 (PTD14/SPI2_SIN); also elsewhere on the board
/CPU/SPIFI_MOSI: U201.142 (PTD13/SPI2_SOUT); also elsewhere on the board
/CPU/SPIFI_WP: U201.139 (PTD10); also elsewhere on the board
/CPU/TCK: U201.50 (PTA0/JTAG_TCLK); also elsewhere on the board
/CPU/TDI: U201.51 (PTA1/JTAG_TDI); also elsewhere on the board
/CPU/TDO: U201.52 (PTA2/JTAG_TDO); also elsewhere on the board
/CPU/TMS: U201.53 (PTA3/JTAG_TMS); also elsewhere on the board
/CPU/USB_DM: U201.20 (USB0_DM); also elsewhere on the board
/CPU/USB_DP: U201.19 (USB0_DP); also elsewhere on the board
/CPU/USB_ID: U201.123 (PTC16); also elsewhere on the board
/CPU/USB_JTAG_UART_RXD: U201.12 (PTE9/UART5_RX); also elsewhere on the board
/CPU/USB_JTAG_UART_TXD: U201.11 (PTE8/UART5_TX); also elsewhere on the board
/CPU/VBAT: U201.42 (VBAT); also elsewhere on the board
/CPU/VREFH: C208.2, C213.1, FB201.1, U201.32 (VREFH)
/CPU/VREFL: C206.2, C208.1, C213.2, FB202.1, U201.33 (VREFL)
/Fuente/USB_VBUS: U201.22 (VREGIN); also elsewhere on the board
/GPIO/AN0: U201.84 (PTB3/ADC0_SE13); also elsewhere on the board
/GPIO/AN1: U201.83 (PTB2/ADC0_SE12); also elsewhere on the board
/GPIO/AN2: U201.85 (PTB4/ADC1_SE10); also elsewhere on the board
/GPIO/AN3: U201.86 (PTB5/ADC1_SE11); also elsewhere on the board
/USB OTG/USB0_PPWR: U201.125 (PTC18); also elsewhere on the board
/USB OTG/USB0_PWR_FAULT: U201.124 (PTC17); also elsewhere on the board
GND: C201.2, C203.2, C204.2, C205.2, C207.2, C210.1, C214.2, C217.2, C218.2, C221.2, C223.2, C224.2, C227.2, C230.2, C231.2, D202.2 (K), D203.2 (K), SW201.2, U201.6 (VSS), U201.17 (VSS), U201.18 (VSS), U201.44 (VSS), U201.57 (VSS), U201.71 (VSS), U201.93 (VSS), U201.107 (VSS), U201.121 (VSS), U201.134 (VSS), U202.2 (GND), X202.2, X202.4; also elsewhere on the board
GNDA: C209.2, C212.1, FB202.2, U201.34 (VSSA); also elsewhere on the board
unnamed: C207.1, U201.41 (EXTAL32), X202.3
unnamed: C204.1, U201.40 (XTAL32), X202.1
unnamed: C210.2, D201.1 (A), R206.2, SW201.1, U201.74 (~RESET)
unnamed: C203.1, U201.21 (VOUT33)
unnamed: D202.1 (A), R204.1
unnamed: D203.1 (A), R207.1
unnamed: R207.2, U201.59 (PTA7)
unnamed: R204.2, U201.58 (PTA6)
unnamed: R203.1, U201.45 (PTE24/EXTAL1)
unnamed: R203.2, U202.3 (OUT)
unnamed: C206.1, U201.37 (VREF_OUT)
unnamed: R205.1, U201.3 (PTE2/LLWU_P1/SDHC0_DCLK)

Notes on the sheet:
CPU
VERDE
ROJO
LEDS DE ESTADO
CAN0
UART3
UART5
OSC. 12MHz

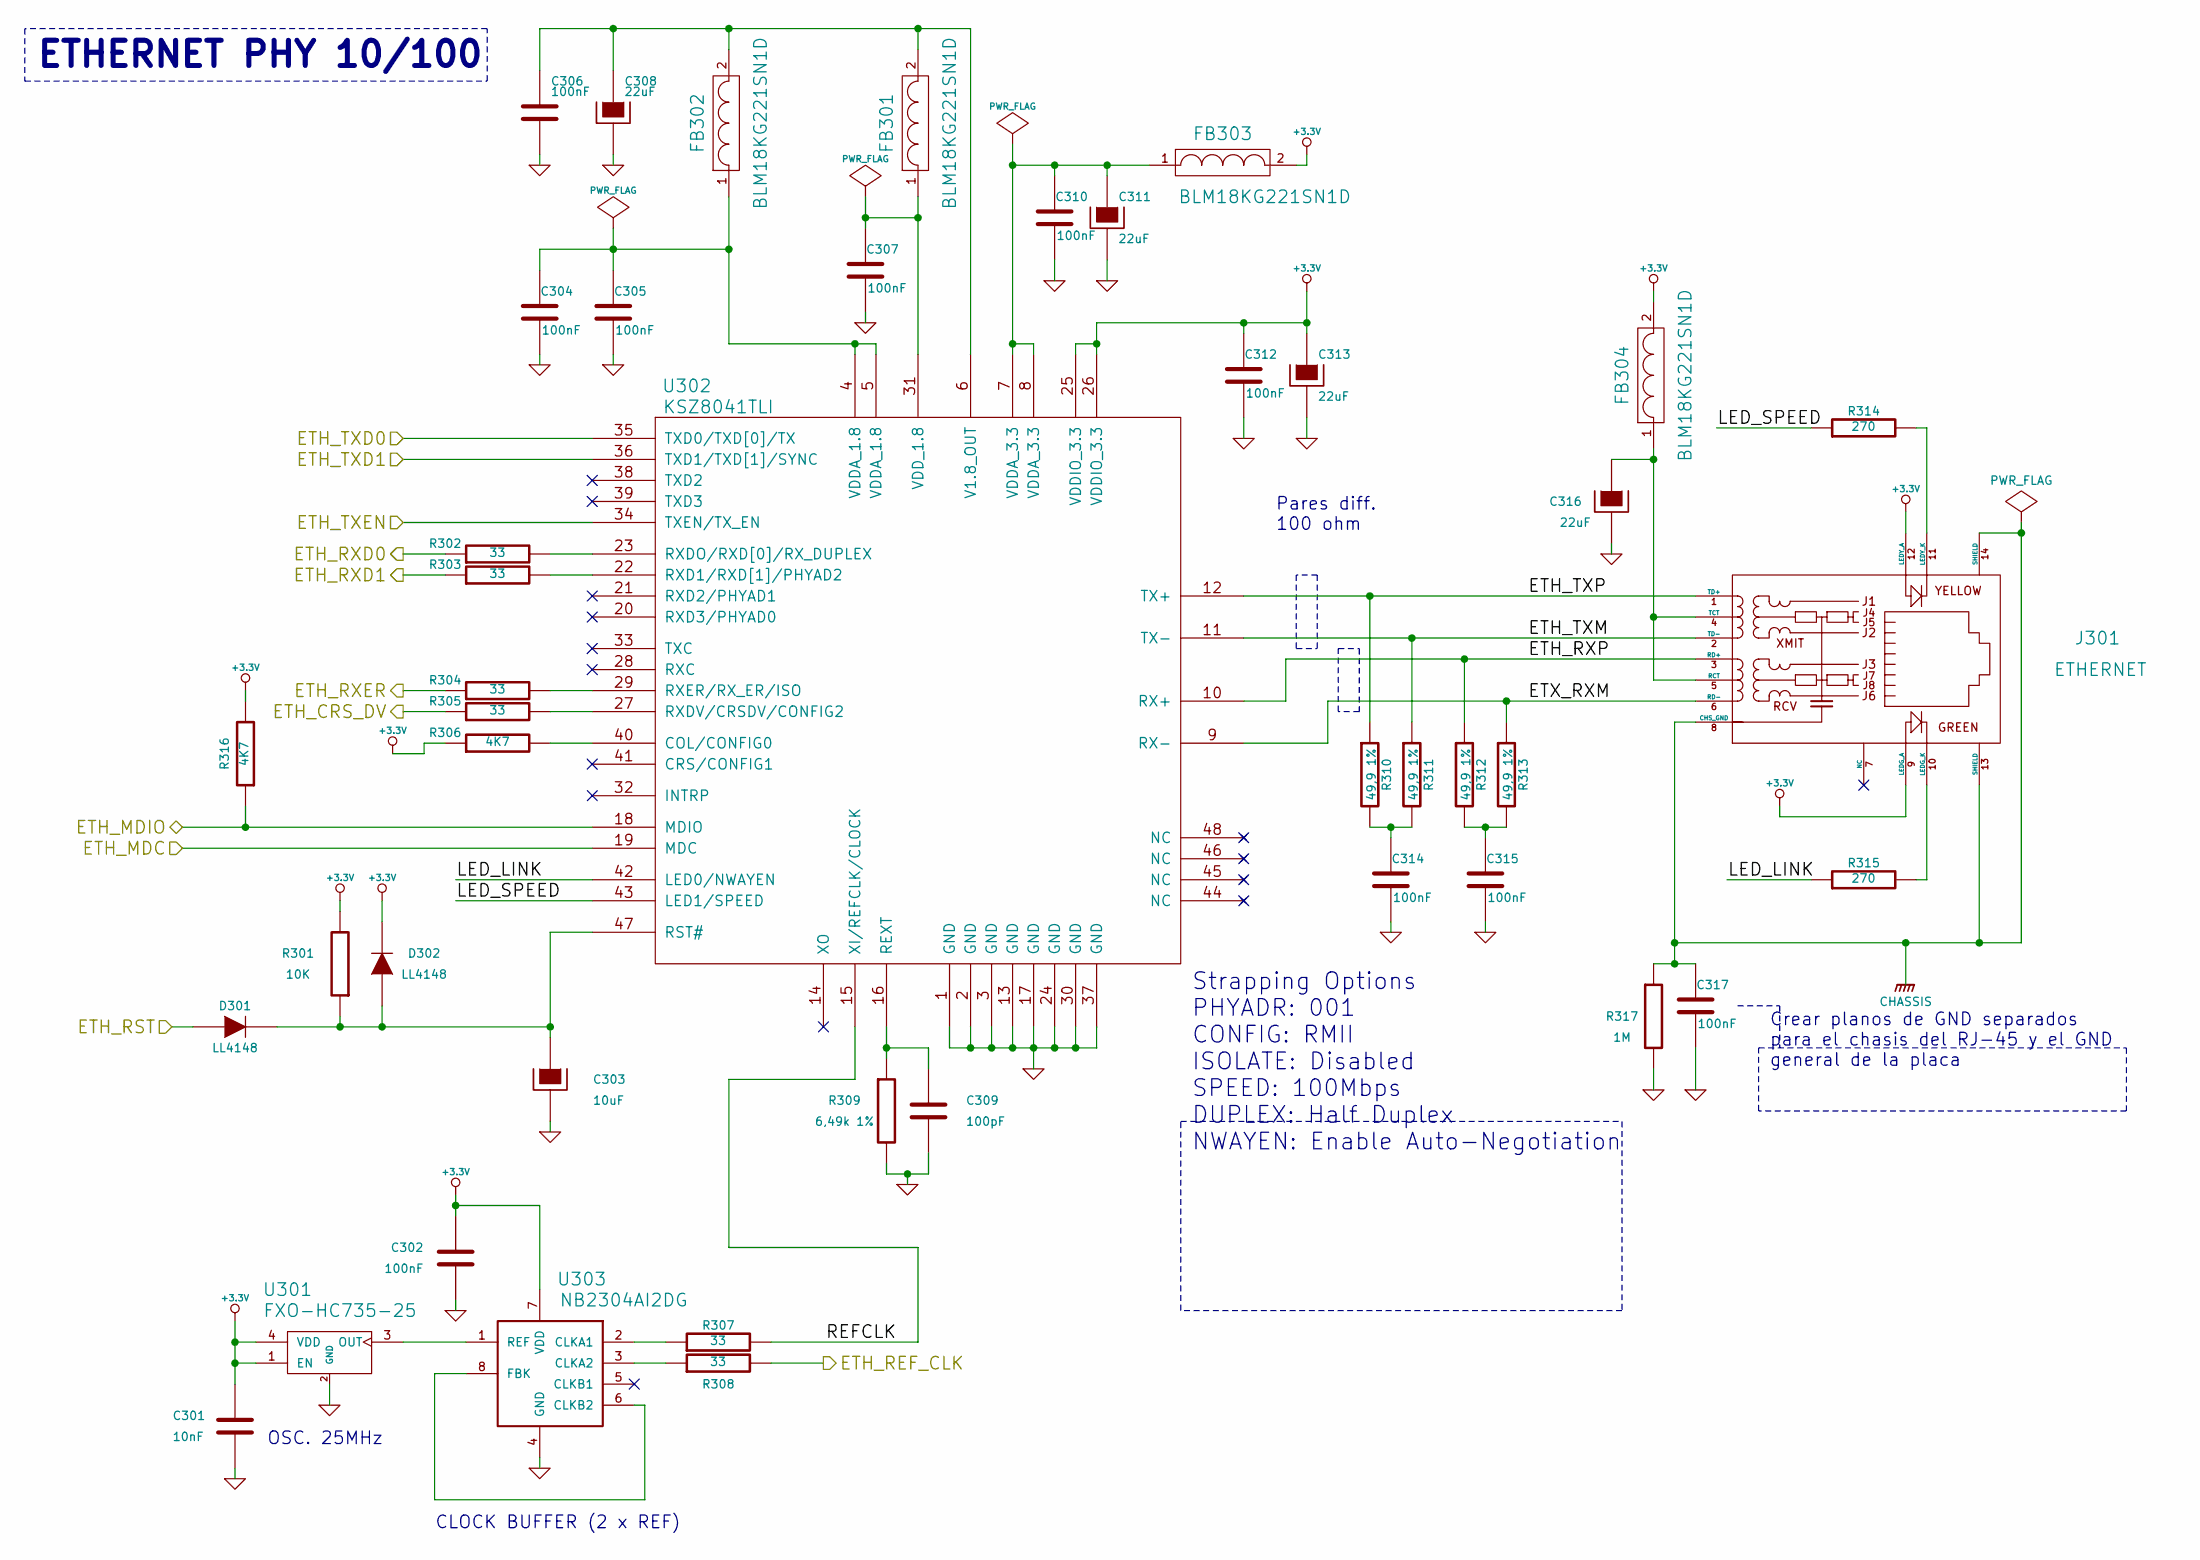
[picture p278: schematic ethernet.sch]

Parts:
C301: 10nF; c_0603; Digikey/Mouser 399-1091-1-ND
C302, C304, C305, C306, C307, C310, C312, C314, C315, C317: 100nF; c_0603; Digikey/Mouser 399-1096-1-ND
C303: 10uF; c_1206POL; Digikey/Mouser 399-10116-1-ND
C308, C311, C313, C316: 22uF; c_1206POL; Digikey/Mouser 399-8279-1-ND
C309: 100pF; c_0603; Digikey/Mouser 399-7824-1-ND
D301, D302: LL4148; SOD-123; Digikey/Mouser LL4148FSCT-ND
FB301, FB302, FB303, FB304: BLM18KG221SN1D; fb_0603; Digikey/Mouser 490-5255-1-ND
J301: ETHERNET; RJ45_Pulse_J403-A; Digikey/Mouser 553-1483-ND
R301: 10K; r_0603; Digikey/Mouser 311-10KGRCT-ND
R302, R303, R304, R305, R307, R308: 33; r_0603; Digikey/Mouser CR0603-JW-330GLFCT-ND
R306, R316: 4K7; r_0603; Digikey/Mouser 311-4.7KGRCT-ND
R309: 6,49k 1%; r_0603; Digikey/Mouser 311-6.49KHRCT-ND
R310, R311, R312, R313: 49,9 1%; r_0603; Digikey/Mouser 311-49.9HRCT-ND
R314, R315: 270; r_0603; Digikey/Mouser 311-270GRCT-ND
R317: 1M; r_0603; Digikey/Mouser 311-1.0MGRCT-ND
U301: FXO-HC735-25; FXODFN4; Digikey/Mouser 631-1055-1-ND
U302: KSZ8041TLI; TQFP48; Digikey/Mouser 576-2971-5-ND
U303: NB2304AI2DG; SOIC-8; Digikey/Mouser NB2304AI2DGOS-ND

Connections:
/CPU/ETH_CRS_DV: R305.1; also elsewhere on the board
/CPU/ETH_MDC: U302.19 (MDC); also elsewhere on the board
/CPU/ETH_MDIO: R316.1, U302.18 (MDIO); also elsewhere on the board
/CPU/ETH_REF_CLK: R308.2; also elsewhere on the board
/CPU/ETH_RST: D301.1 (A); also elsewhere on the board
/CPU/ETH_RXD0: R302.1; also elsewhere on the board
/CPU/ETH_RXD1: R303.1; also elsewhere on the board
/CPU/ETH_RXER: R304.1; also elsewhere on the board
/CPU/ETH_TXD0: U302.35 (TXD0/TXD[0]/TX); also elsewhere on the board
/CPU/ETH_TXD1: U302.36 (TXD1/TXD[1]/SYNC); also elsewhere on the board
/CPU/ETH_TXEN: U302.34 (TXEN/TX_EN); also elsewhere on the board
/Ethernet/ETH_RXP: J301.3 (RD+), R312.1, U302.10 (RX+)
/Ethernet/ETH_TXM: J301.2 (TD-), R311.1, U302.11 (TX-)
/Ethernet/ETH_TXP: J301.1 (TD+), R310.1, U302.12 (TX+)
/Ethernet/ETX_RXM: J301.6 (RD-), R313.1, U302.9 (RX-)
/Ethernet/LED_LINK: R315.1, U302.42 (LED0/NWAYEN)
/Ethernet/LED_SPEED: R314.1, U302.43 (LED1/SPEED)
/Ethernet/REFCLK: R307.2, U302.15 (XI/REFCLK/CLOCK)
GND: C301.2, C302.1, C303.2, C304.2, C305.2, C306.2, C307.2, C308.2, C309.2, C310.2, C311.2, C312.2, C313.2, C314.2, C315.2, C316.2, C317.2, R309.2, R317.2, U301.2 (GND), U302.1 (GND), U302.2 (GND), U302.3 (GND), U302.13 (GND), U302.17 (GND), U302.24 (GND), U302.30 (GND), U302.37 (GND), U303.4 (GND); also elsewhere on the board
GNDPWR: C317.1, J301.8 (CHS_GND), J301.13 (SHIELD), J301.14 (SHIELD), R317.1; also elsewhere on the board
unnamed: R307.1, U303.2 (CLKA1)
unnamed: C316.1, FB304.1, J301.4 (TCT), J301.5 (RCT)
unnamed: J301.10 (LEDG_K), R315.2
unnamed: R308.1, U303.3 (CLKA2)
unnamed: C309.1, R309.1, U302.16 (REXT)
unnamed: C315.1, R312.2, R313.2
unnamed: C314.1, R310.2, R311.2
unnamed: U303.6 (CLKB2), U303.8 (FBK)
unnamed: U301.3 (OUT), U303.1 (REF)
unnamed: R305.2, U302.27 (RXDV/CRSDV/CONFIG2)
unnamed: R304.2, U302.29 (RXER/RX_ER/ISO)
unnamed: C310.1, C311.1, FB303.1, U302.7 (VDDA_3.3), U302.8 (VDDA_3.3)
unnamed: R303.2, U302.22 (RXD1/RXD[1]/PHYAD2)
unnamed: R306.2, U302.40 (COL/CONFIG0)
unnamed: R302.2, U302.23 (RXDO/RXD[0]/RX_DUPLEX)
unnamed: J301.11 (LEDY_K), R314.2
unnamed: C303.1, D301.2 (K), D302.1 (A), R301.1, U302.47 (RST#)
unnamed: C304.1, C305.1, FB302.1, U302.4 (VDDA_1.8), U302.5 (VDDA_1.8)
unnamed: C307.1, FB301.1, U302.31 (VDD_1.8)
unnamed: C306.1, C308.1, FB301.2, FB302.2, U302.6 (V1.8_OUT)

Notes on the sheet:
Strapping Options PHYADR: 001 CONFIG: RMII ISOLATE: Disabled SPEED: 100Mbps DUPLEX: Half Duplex NWAYEN: Enable Auto-Negotiation
Crear planos de GND separados para el chasis del RJ-45 y el GND general de la placa
ETHERNET PHY 10/100
OSC. 25MHz
CLOCK BUFFER (2 x REF)
Pares diff. 100 ohm
