ciaa/Hardware/PCB/FSL/CIAA_K60/CIAA_K60.kicad_pcb

## KiCad design PCB/FSL/CIAA_K60/CIAA_K60.kicad_pcb (continued)

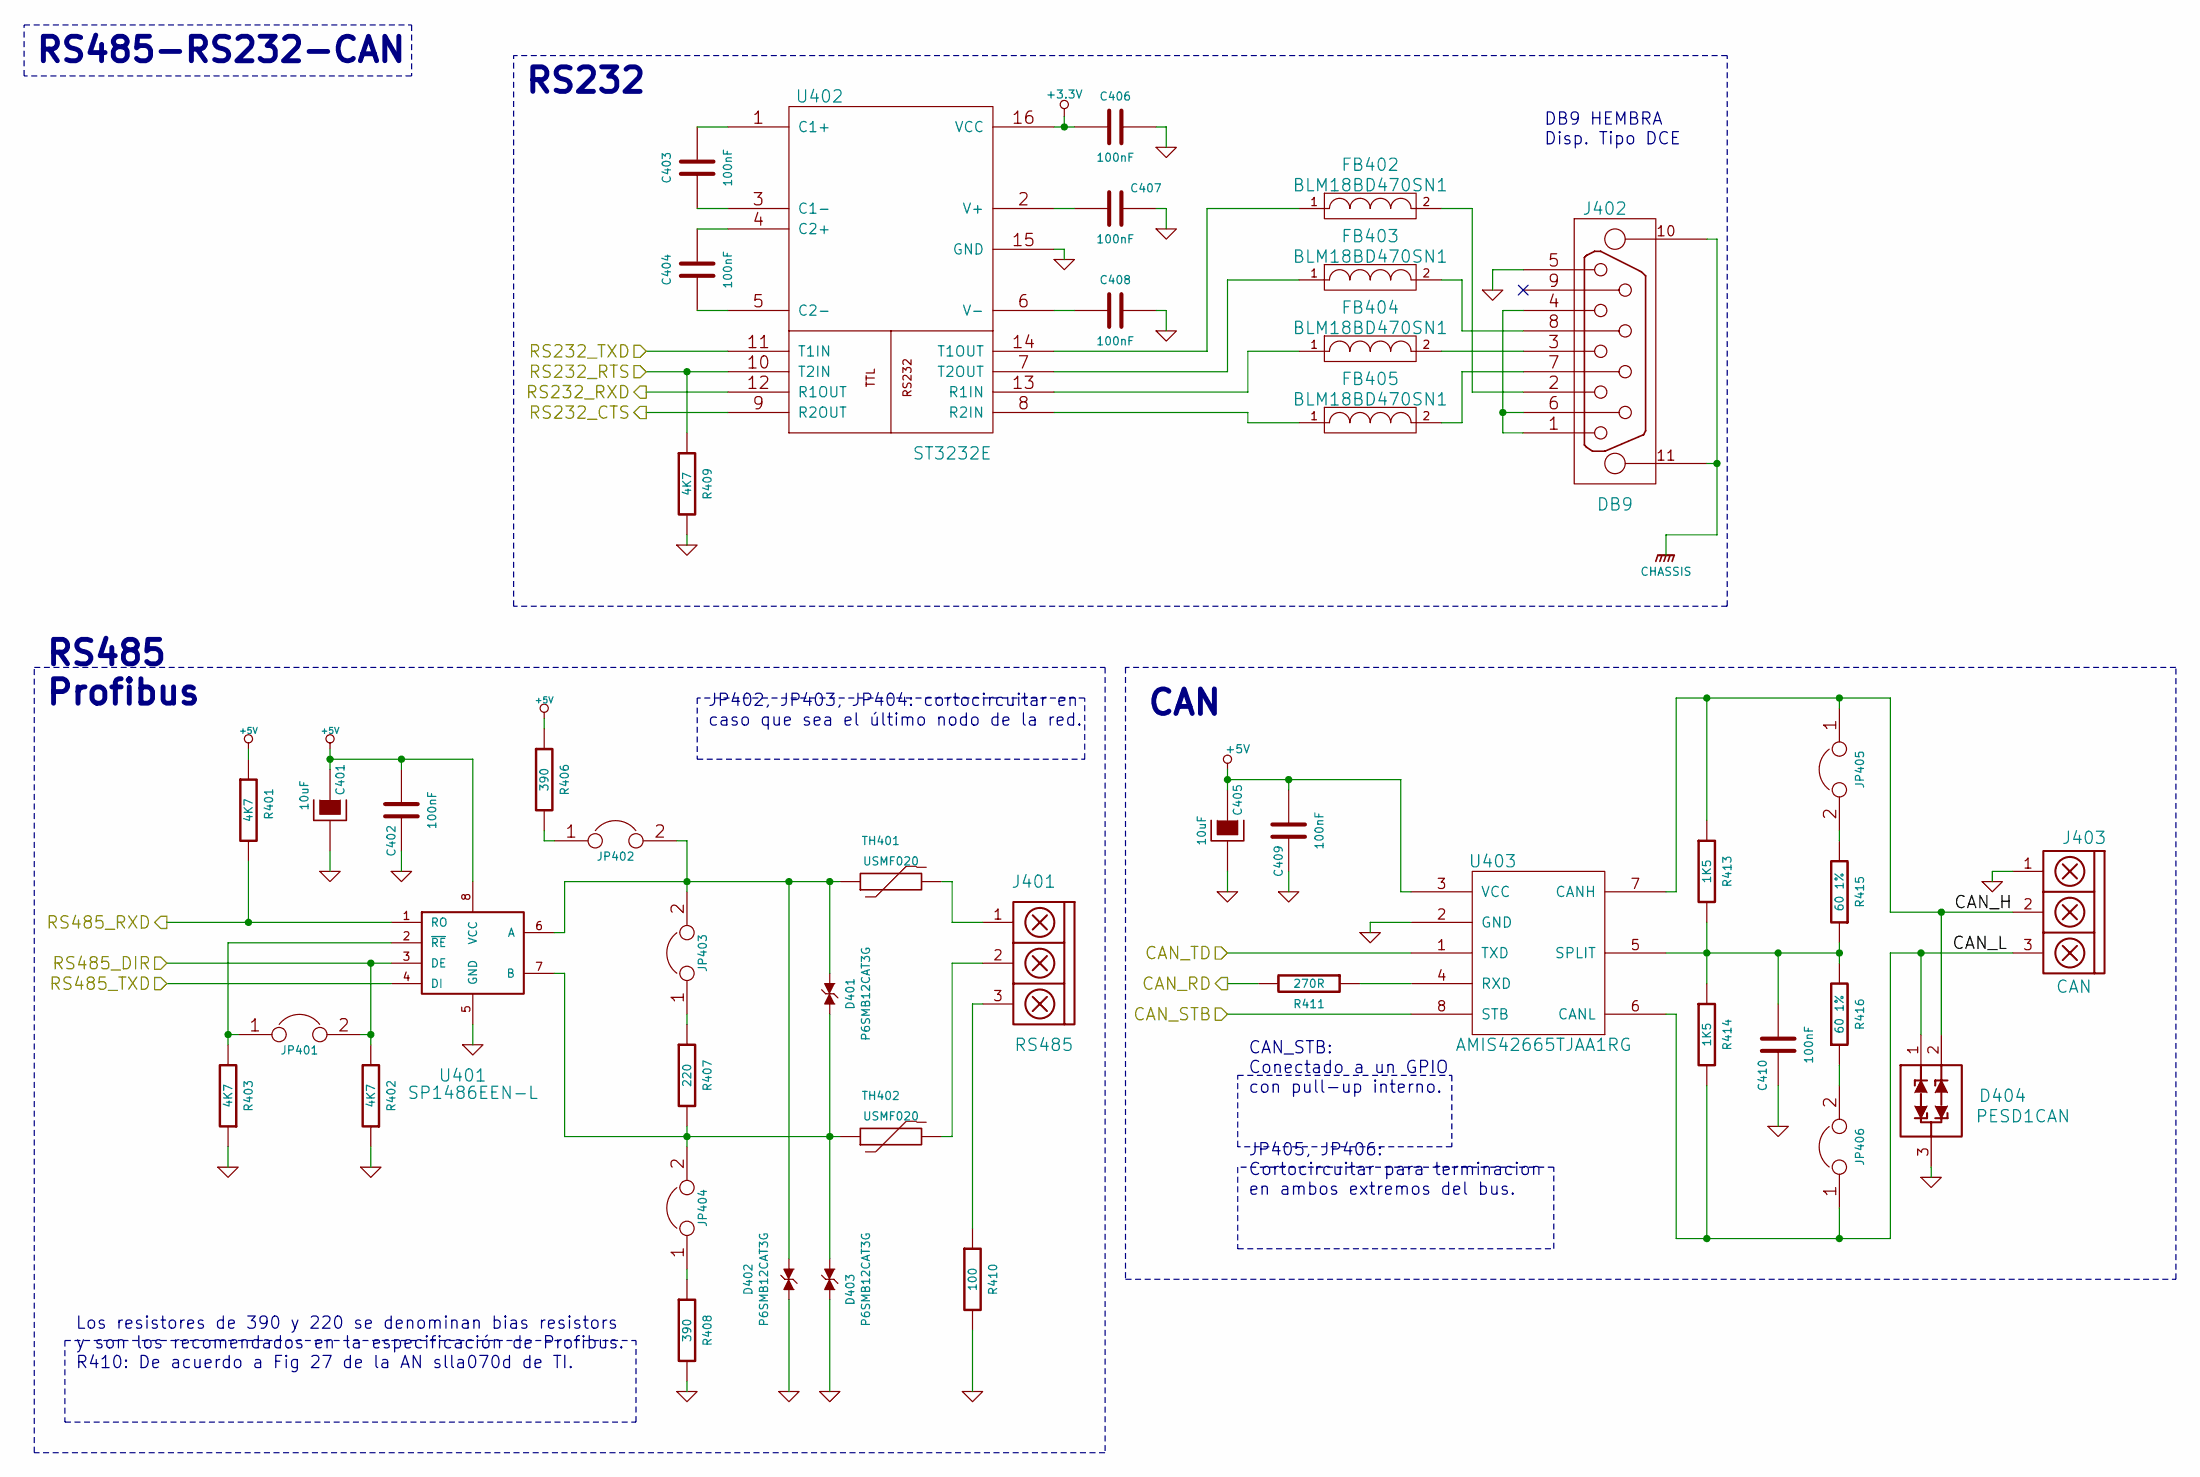
[picture p279: schematic rsS485_rs232_can.sch, CIAA RS485 - RS232 - CAN]

Parts:
C401, C405: 10uF; c_1206POL; Digikey/Mouser 399-10116-1-ND
C402, C403, C404, C406, C407, C408, C409, C410: 100nF; c_0603; Digikey/Mouser 399-1096-1-ND
D401, D402, D403: P6SMB12CAT3G; DO-214AA_SMB; Digikey/Mouser P6SMB12CAT3GOSCT-ND
D404: PESD1CAN; SOT-23; Digikey/Mouser 568-4032-1-ND
FB402, FB403, FB404, FB405: BLM18BD470SN1; fb_0603; Digikey/Mouser 490-5211-1-ND
J401: RS485; bornier3; Digikey/Mouser 571-7969493
J402: DB9; DB9_F_TH; Digikey/Mouser S9554-ND
J403: CAN; bornier3; Digikey/Mouser 571-7969493
JP401, JP402, JP403, JP404, JP405, JP406: JUMPER; PIN_ARRAY_2x1; Digikey/Mouser S1212EC-40-ND
R401, R402, R403, R409: 4K7; r_0603; Digikey/Mouser 311-4.7KGRCT-ND
R406, R408: 390; r_0603; Digikey/Mouser 311-390GRCT-ND
R407: 220; r_0603; Digikey/Mouser 311-220GRCT-ND
R410: 100; r_2010; Digikey/Mouser CR2010-JW-101ELFCT-ND
R411: 270R; r_0603; Digikey/Mouser 311-270GRCT-ND
R413, R414: 1K5; r_0603; Digikey/Mouser 311-1.5KGRCT-ND
R415, R416: 60 1%; r_0603; Digikey/Mouser 311-59.0HRCT-ND
TH401, TH402: USMF020; ptc_1210; Digikey/Mouser MF-USMF020-2CT-ND
U401: SP1486EEN-L; SOIC-8; Digikey/Mouser 1016-1003-5-ND
U402: ST3232E; TSSOP-16; Digikey/Mouser 497-6538-1-ND
U403: AMIS42665TJAA1RG; SOIC-8; Digikey/Mouser 766-1006-1-ND

Connections:
+5V: C401.1, C402.2, C405.1, C409.2, R401.1, R406.1, U401.8 (VCC), U403.3 (VCC); also elsewhere on the board
/CPU/CAN_RD: R411.2; also elsewhere on the board
/CPU/CAN_STB: U403.8 (STB); also elsewhere on the board
/CPU/CAN_TD: U403.1 (TXD); also elsewhere on the board
/CPU/RS232_CTS: U402.9 (R2OUT); also elsewhere on the board
/CPU/RS232_RTS: R409.1, U402.10 (T2IN); also elsewhere on the board
/CPU/RS232_RXD: U402.12 (R1OUT); also elsewhere on the board
/CPU/RS232_TXD: U402.11 (T1IN); also elsewhere on the board
/CPU/RS485_DIR: JP401.2, R402.2, U401.3 (DE); also elsewhere on the board
/CPU/RS485_RXD: R401.2, U401.1 (RO); also elsewhere on the board
/CPU/RS485_TXD: U401.4 (DI); also elsewhere on the board
/RS485_RS232_CAN/CAN_H: D404.2, J403.2, JP405.1, R413.1, U403.7 (CANH)
/RS485_RS232_CAN/CAN_L: D404.1, J403.3, JP406.1, R414.2, U403.6 (CANL)
GND: C401.2, C402.1, C405.2, C406.2, C407.2, C408.2, C409.1, C410.2, D402.2 (Anode), D403.2 (Anode), D404.3, J402.5 (Signal_Ground), J403.1, R402.1, R403.1, R408.2, R409.2, R410.2, U401.5 (GND), U402.15 (GND), U403.2 (GND); also elsewhere on the board
GNDPWR: J402.10 (chassis_pin), J402.11 (chassis_pin); also elsewhere on the board
unnamed: FB405.1, U402.8 (R2IN)
unnamed: FB405.2, J402.7 (RTS)
unnamed: FB404.1, U402.13 (R1IN)
unnamed: FB402.1, U402.14 (T1OUT)
unnamed: FB403.1, U402.7 (T2OUT)
unnamed: C408.1, U402.6 (V-)
unnamed: FB403.2, J402.8 (CTS)
unnamed: C404.1, U402.4 (C2+)
unnamed: C404.2, U402.5 (C2-)
unnamed: C407.1, U402.2 (V+)
unnamed: FB402.2, J402.2 (Receive_Data)
unnamed: JP404.1, R408.1
unnamed: FB404.2, J402.3 (Transmit_Data)
unnamed: J402.1 (Data_Carrier_Detect), J402.4 (DTR), J402.6 (DSR)
unnamed: JP402.1, R406.2
unnamed: R411.1, U403.4 (RXD)
unnamed: JP403.1, R407.1
unnamed: D401.1 (cathode), D402.1 (cathode), JP402.2, JP403.2, TH401.1, U401.6 (A)
unnamed: C403.1, U402.1 (C1+)
unnamed: C403.2, U402.3 (C1-)
unnamed: JP405.2, R415.2
unnamed: JP406.2, R416.1
unnamed: J401.1, TH401.2
unnamed: J401.2, TH402.2
unnamed: J401.3, R410.1
unnamed: JP401.1, R403.2, U401.2 (~RE~)
unnamed: C410.1, R413.2, R414.1, R415.1, R416.2, U403.5 (SPLIT)
unnamed: D401.2 (Anode), D403.1 (cathode), JP404.2, R407.2, TH402.1, U401.7 (B)

Notes on the sheet:
RS232
RS485 Profibus
CAN
JP405, JP406: Cortocircuitar para terminacion en ambos extremos del bus.
JP402, JP403, JP404: cortocircuitar en caso que sea el último nodo de la red.
RS485-RS232-CAN
DB9 HEMBRA Disp. Tipo DCE
Los resistores de 390 y 220 se denominan bias resistors y son los recomendados en la especificación de Profibus. R410: De acuerdo a Fig 27 de la AN slla070d de TI.
CAN_STB: Conectado a un GPIO con pull-up interno.

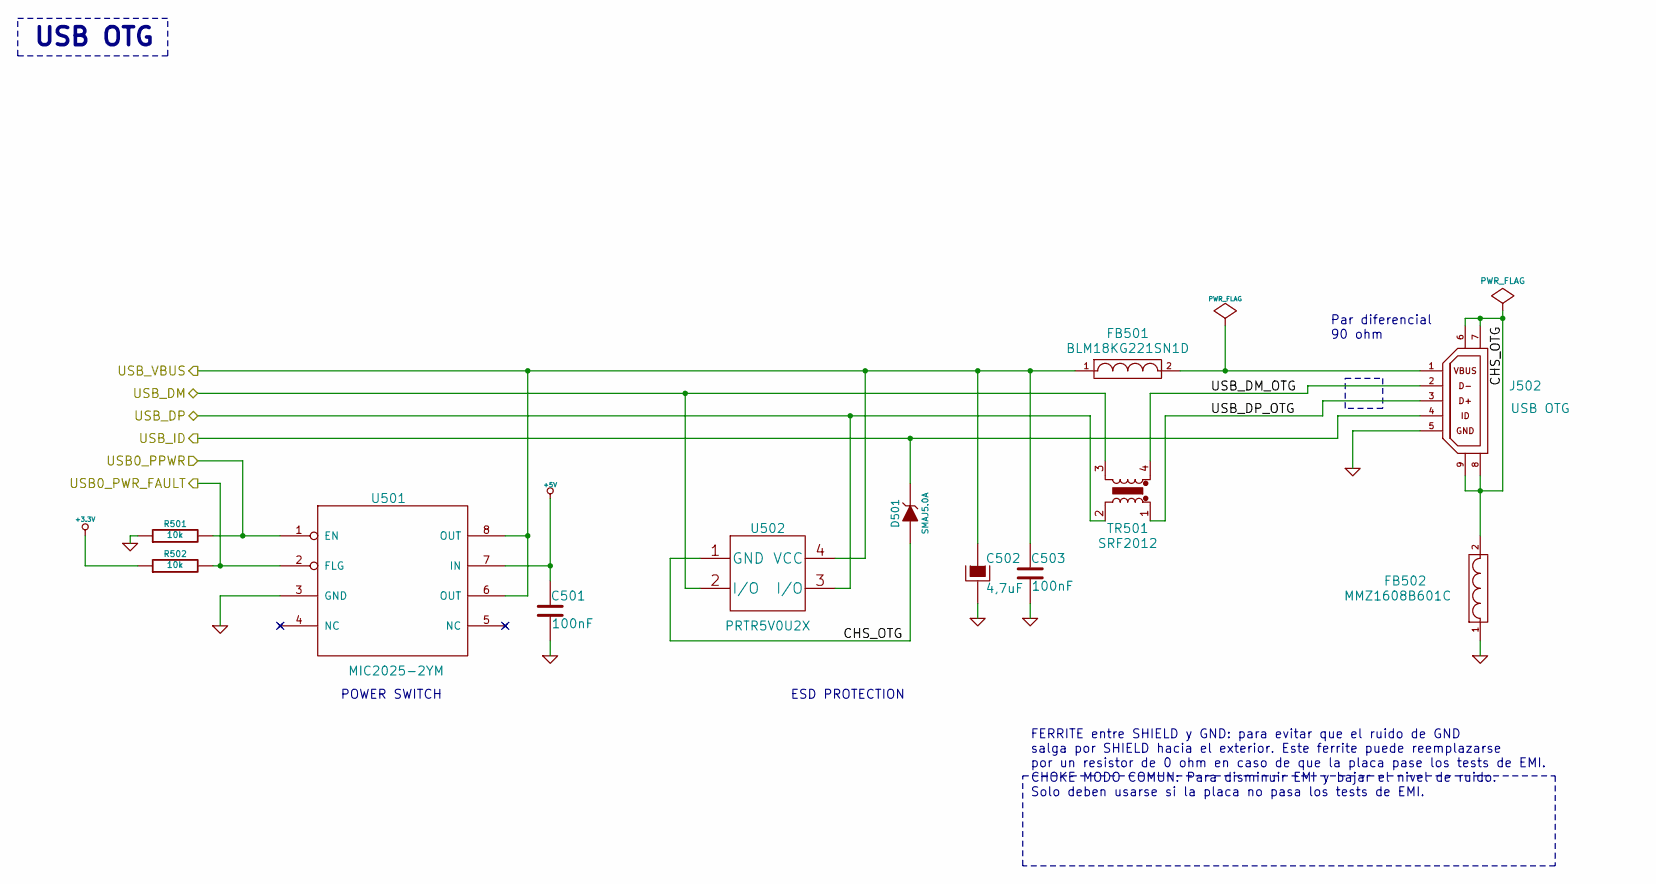
[picture p280: schematic usb_otg.sch, USB OTG]

Parts:
C501, C503: 100nF; c_0603; Digikey/Mouser 399-1096-1-ND
C502: 4,7uF; c_1206POL; Digikey/Mouser 399-9717-1-ND
D501: SMAJ5.0A; DO-214AC_SMA; Digikey/Mouser SMAJ5.0ABCT-ND
FB501: BLM18KG221SN1D; fb_0603; Digikey/Mouser 490-5255-1-ND
FB502: MMZ1608B601C; fb_0603; Digikey/Mouser 445-2166-1-ND
J502: USB OTG; USB_MicroAB; Digikey/Mouser H11635TR-ND
R501, R502: 10k; r_0603; Digikey/Mouser 311-10KGRCT-ND
TR501: SRF2012; Digikey/Mouser SRF2012-900YCT-ND
U501: MIC2025-2YM; SOIC-8; Digikey/Mouser 576-1058-ND
U502: PRTR5V0U2X; SOT-143-4; Digikey/Mouser CM1213A-02SROSCT-ND

Connections:
+5V: C501.1, U501.7 (IN); also elsewhere on the board
/CPU/USB_DM: TR501.3, U502.2 (I/O); also elsewhere on the board
/CPU/USB_DP: TR501.2, U502.3 (I/O); also elsewhere on the board
/CPU/USB_ID: D501.2 (K), J502.4 (USB_ID); also elsewhere on the board
/Fuente/USB_VBUS: C502.1, C503.1, FB501.1, U501.6 (OUT), U501.8 (OUT), U502.4 (VCC); also elsewhere on the board
/USB OTG/CHS_OTG: D501.1 (A), FB502.2, J502.6 (S2), J502.7 (S1), J502.8 (S3), J502.9 (S4), U502.1 (GND)
/USB OTG/USB0_PPWR: R501.2, U501.1 (EN); also elsewhere on the board
/USB OTG/USB0_PWR_FAULT: R502.2, U501.2 (FLG); also elsewhere on the board
/USB OTG/USB_DM_OTG: J502.2 (USB_DN), TR501.4
/USB OTG/USB_DP_OTG: J502.3 (USB_DP), TR501.1
GND: C501.2, C502.2, C503.2, FB502.1, J502.5 (GND), R501.1, U501.3 (GND); also elsewhere on the board
unnamed: FB501.2, J502.1 (VBUS)

Notes on the sheet:
USB OTG
Par diferencial 90 ohm
FERRITE entre SHIELD y GND: para evitar que el ruido de GND salga por SHIELD hacia el exterior. Este ferrite puede reemplazarse por un resistor de 0 ohm en caso de que la placa pase los tests de EMI. CHOKE MODO COMUN: Para disminuir EMI y bajar el nivel de ruido. Solo deben usarse si la placa no pa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
POWER SWITCH
ESD PROTECTION

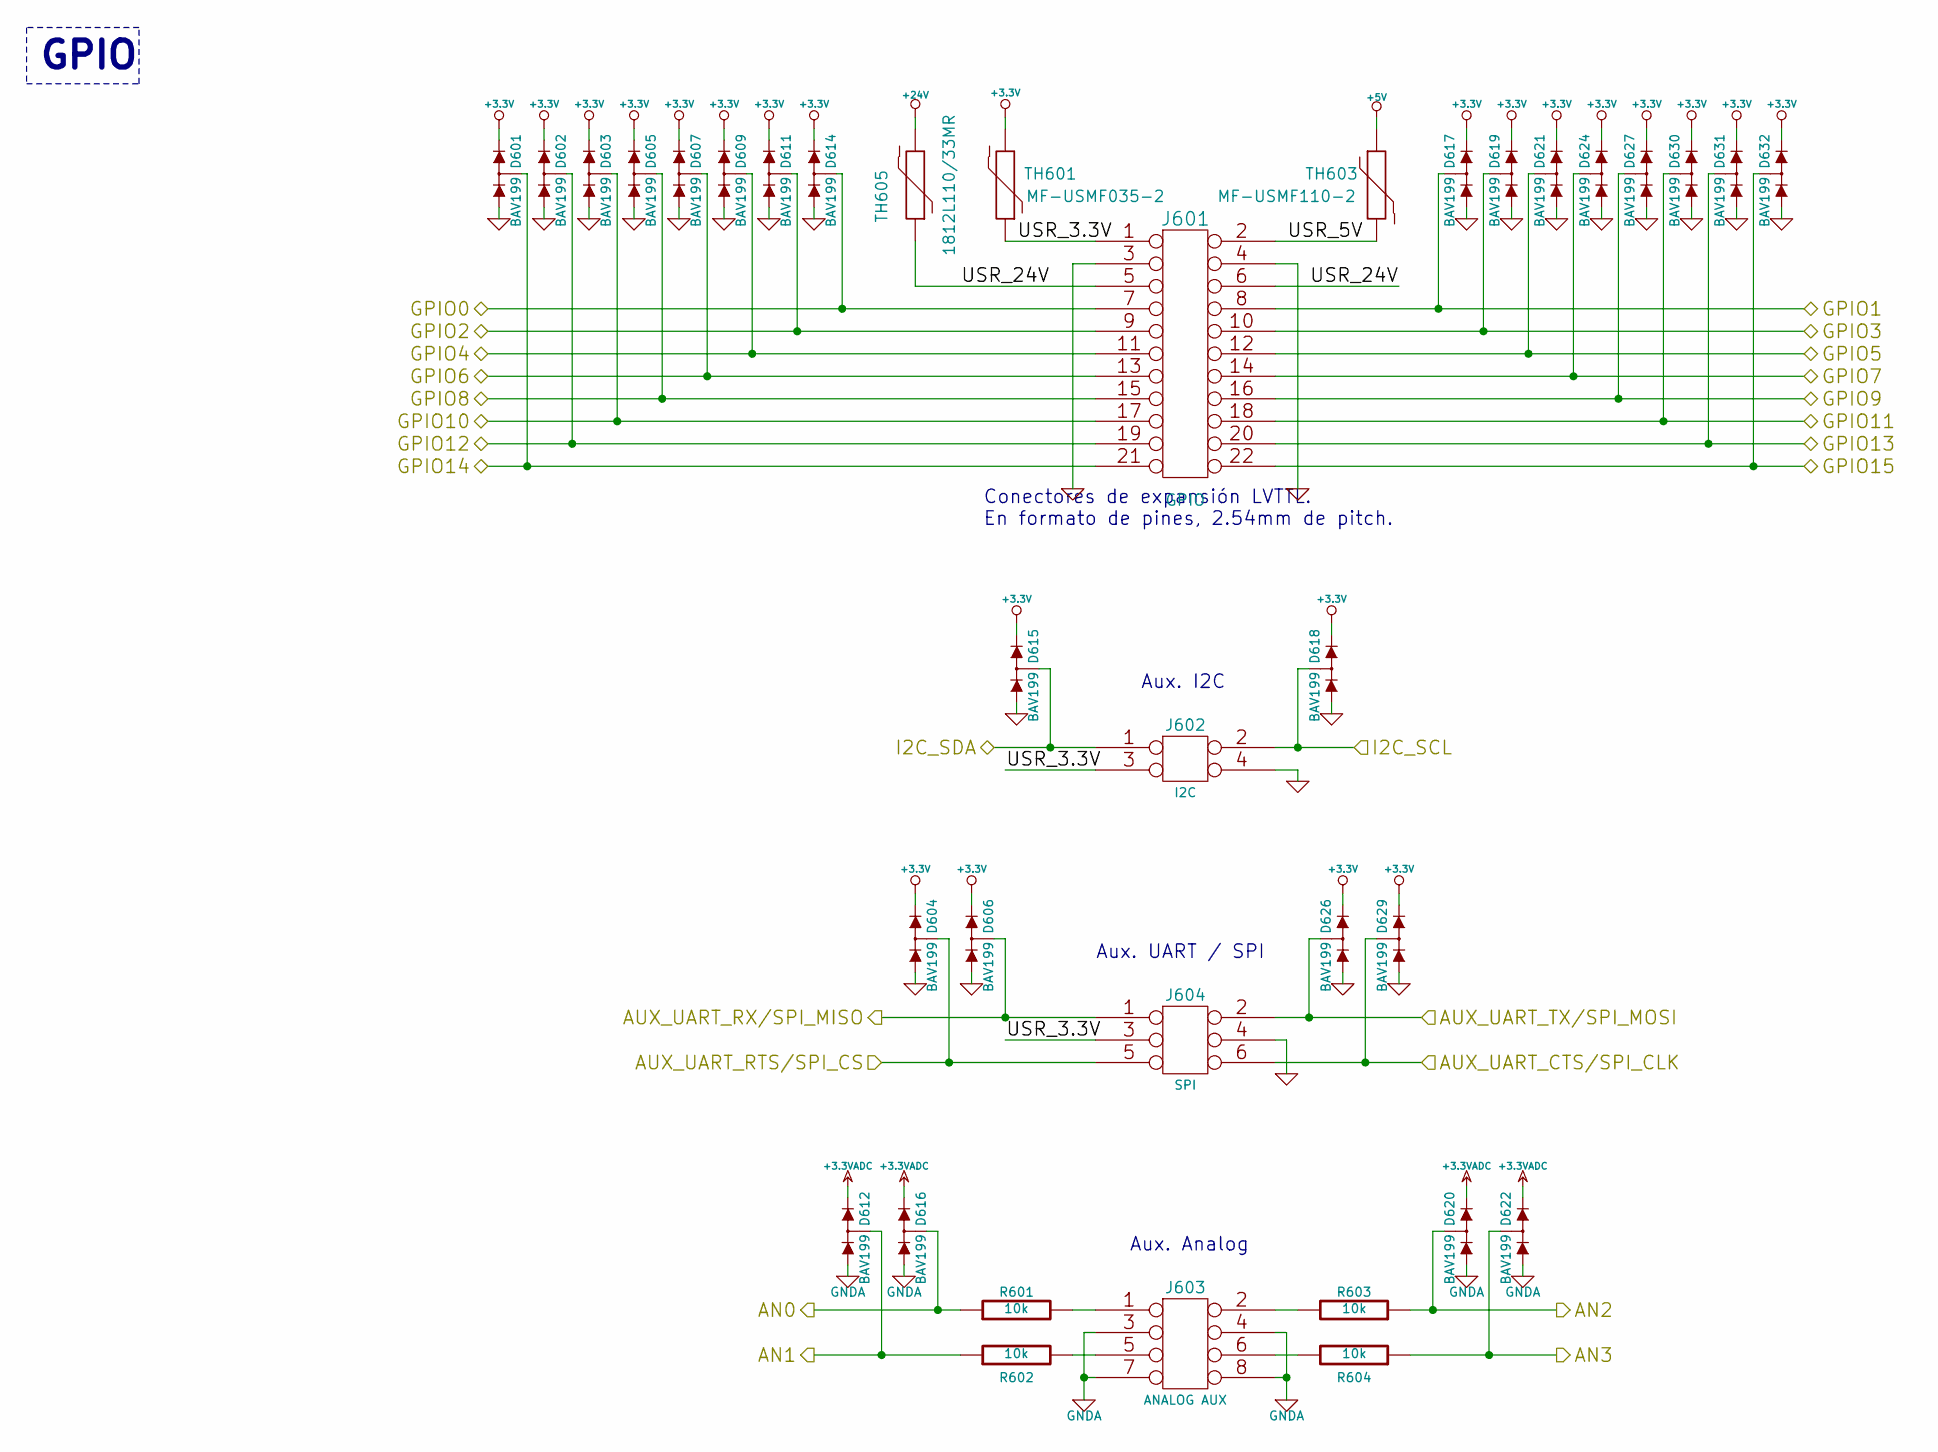
[picture p281: schematic gpio.sch, CIAA GPIO/SPI/I2C/USB/ANALOG]

Parts:
D601, D602, D603, D604, D605, D606, D607, D609, D611, D612, D614, D615, D616, D617, D618, D619, D620, D621, D622, D624, D626, D627, D629, D630, D631, D632: BAV199; SOT-23; Digikey/Mouser BAV199LT1GOSCT-ND
J601: GPIO; PIN_ARRAY_11x2; Digikey/Mouser S2012EC-40-ND
J602: I2C; PIN_ARRAY_2x2; Digikey/Mouser S2012EC-40-ND
J603: ANALOG AUX; PIN_ARRAY_4x2; Digikey/Mouser S2012EC-40-ND
J604: SPI; PIN_ARRAY_3x2; Digikey/Mouser S2012EC-40-ND
R601, R602, R603, R604: 10k; r_0603; Digikey/Mouser 311-10KGRCT-ND
TH601: MF-USMF035-2; ptc_1210; Digikey/Mouser MF-USMF035-2CT-ND
TH603: MF-USMF110-2; ptc_1210; Digikey/Mouser MF-USMF110-2CT-ND
TH605: 1812L110/33MR; ptc_1812; Digikey/Mouser F3486CT-ND

Connections:
+3.3VADC: D612.2 (K), D616.2 (K), D620.2 (K), D622.2 (K); also elsewhere on the board
+5V: TH603.1; also elsewhere on the board
+24V: TH605.2; also elsewhere on the board
/CPU/AUX_UART_CTS/SPI_CLK: D629.3 (KA), J604.6; also elsewhere on the board
/CPU/AUX_UART_RTS/SPI_CS: D604.3 (KA), J604.5; also elsewhere on the board
/CPU/AUX_UART_RX/SPI_MISO: D606.3 (KA), J604.1; also elsewhere on the board
/CPU/AUX_UART_TX/SPI_MOSI: D626.3 (KA), J604.2; also elsewhere on the board
/CPU/GPIO0: D614.3 (KA), J601.7; also elsewhere on the board
/CPU/GPIO1: D617.3 (KA), J601.8; also elsewhere on the board
/CPU/GPIO2: D611.3 (KA), J601.9; also elsewhere on the board
/CPU/GPIO3: D619.3 (KA), J601.10; also elsewhere on the board
/CPU/GPIO4: D609.3 (KA), J601.11; also elsewhere on the board
/CPU/GPIO5: D621.3 (KA), J601.12; also elsewhere on the board
/CPU/GPIO6: D607.3 (KA), J601.13; also elsewhere on the board
/CPU/GPIO7: D624.3 (KA), J601.14; also elsewhere on the board
/CPU/GPIO8: D605.3 (KA), J601.15; also elsewhere on the board
/CPU/GPIO9: D627.3 (KA), J601.16; also elsewhere on the board
/CPU/GPIO10: D603.3 (KA), J601.17; also elsewhere on the board
/CPU/GPIO11: D630.3 (KA), J601.18; also elsewhere on the board
/CPU/GPIO12: D602.3 (KA), J601.19; also elsewhere on the board
/CPU/GPIO13: D631.3 (KA), J601.20; also elsewhere on the board
/CPU/GPIO14: D601.3 (KA), J601.21; also elsewhere on the board
/CPU/GPIO15: D632.3 (KA), J601.22; also elsewhere on the board
/CPU/I2C_SCL: D618.3 (KA), J602.2; also elsewhere on the board
/CPU/I2C_SDA: D615.3 (KA), J602.1; also elsewhere on the board
/GPIO/AN0: D616.3 (KA), R601.1; also elsewhere on the board
/GPIO/AN1: D612.3 (KA), R602.1; also elsewhere on the board
/GPIO/AN2: D620.3 (KA), R603.1; also elsewhere on the board
/GPIO/AN3: D622.3 (KA), R604.1; also elsewhere on the board
/GPIO/USR_3.3V: J601.1, J602.3, J604.3, TH601.1
/GPIO/USR_5V: J601.2, TH603.2
/GPIO/USR_24V: J601.5, J601.6, TH605.1
GND: D601.1 (A), D602.1 (A), D603.1 (A), D604.1 (A), D605.1 (A), D606.1 (A), D607.1 (A), D609.1 (A), D611.1 (A), D614.1 (A), D615.1 (A), D617.1 (A), D618.1 (A), D619.1 (A), D621.1 (A), D624.1 (A), D626.1 (A), D627.1 (A), D629.1 (A), D630.1 (A), D631.1 (A), D632.1 (A), J601.3, J601.4, J602.4, J604.4; also elsewhere on the board
GNDA: D612.1 (A), D616.1 (A), D620.1 (A), D622.1 (A), J603.3, J603.4, J603.7, J603.8; also elsewhere on the board
unnamed: J603.1, R601.2
unnamed: J603.2, R603.2
unnamed: J603.5, R602.2
unnamed: J603.6, R604.2

Notes on the sheet:
Conectores de expansión LVTTL. En formato de pines, 2.54mm de pitch.
Aux. UART / SPI
GPIO
Aux. I2C
Aux. Analog

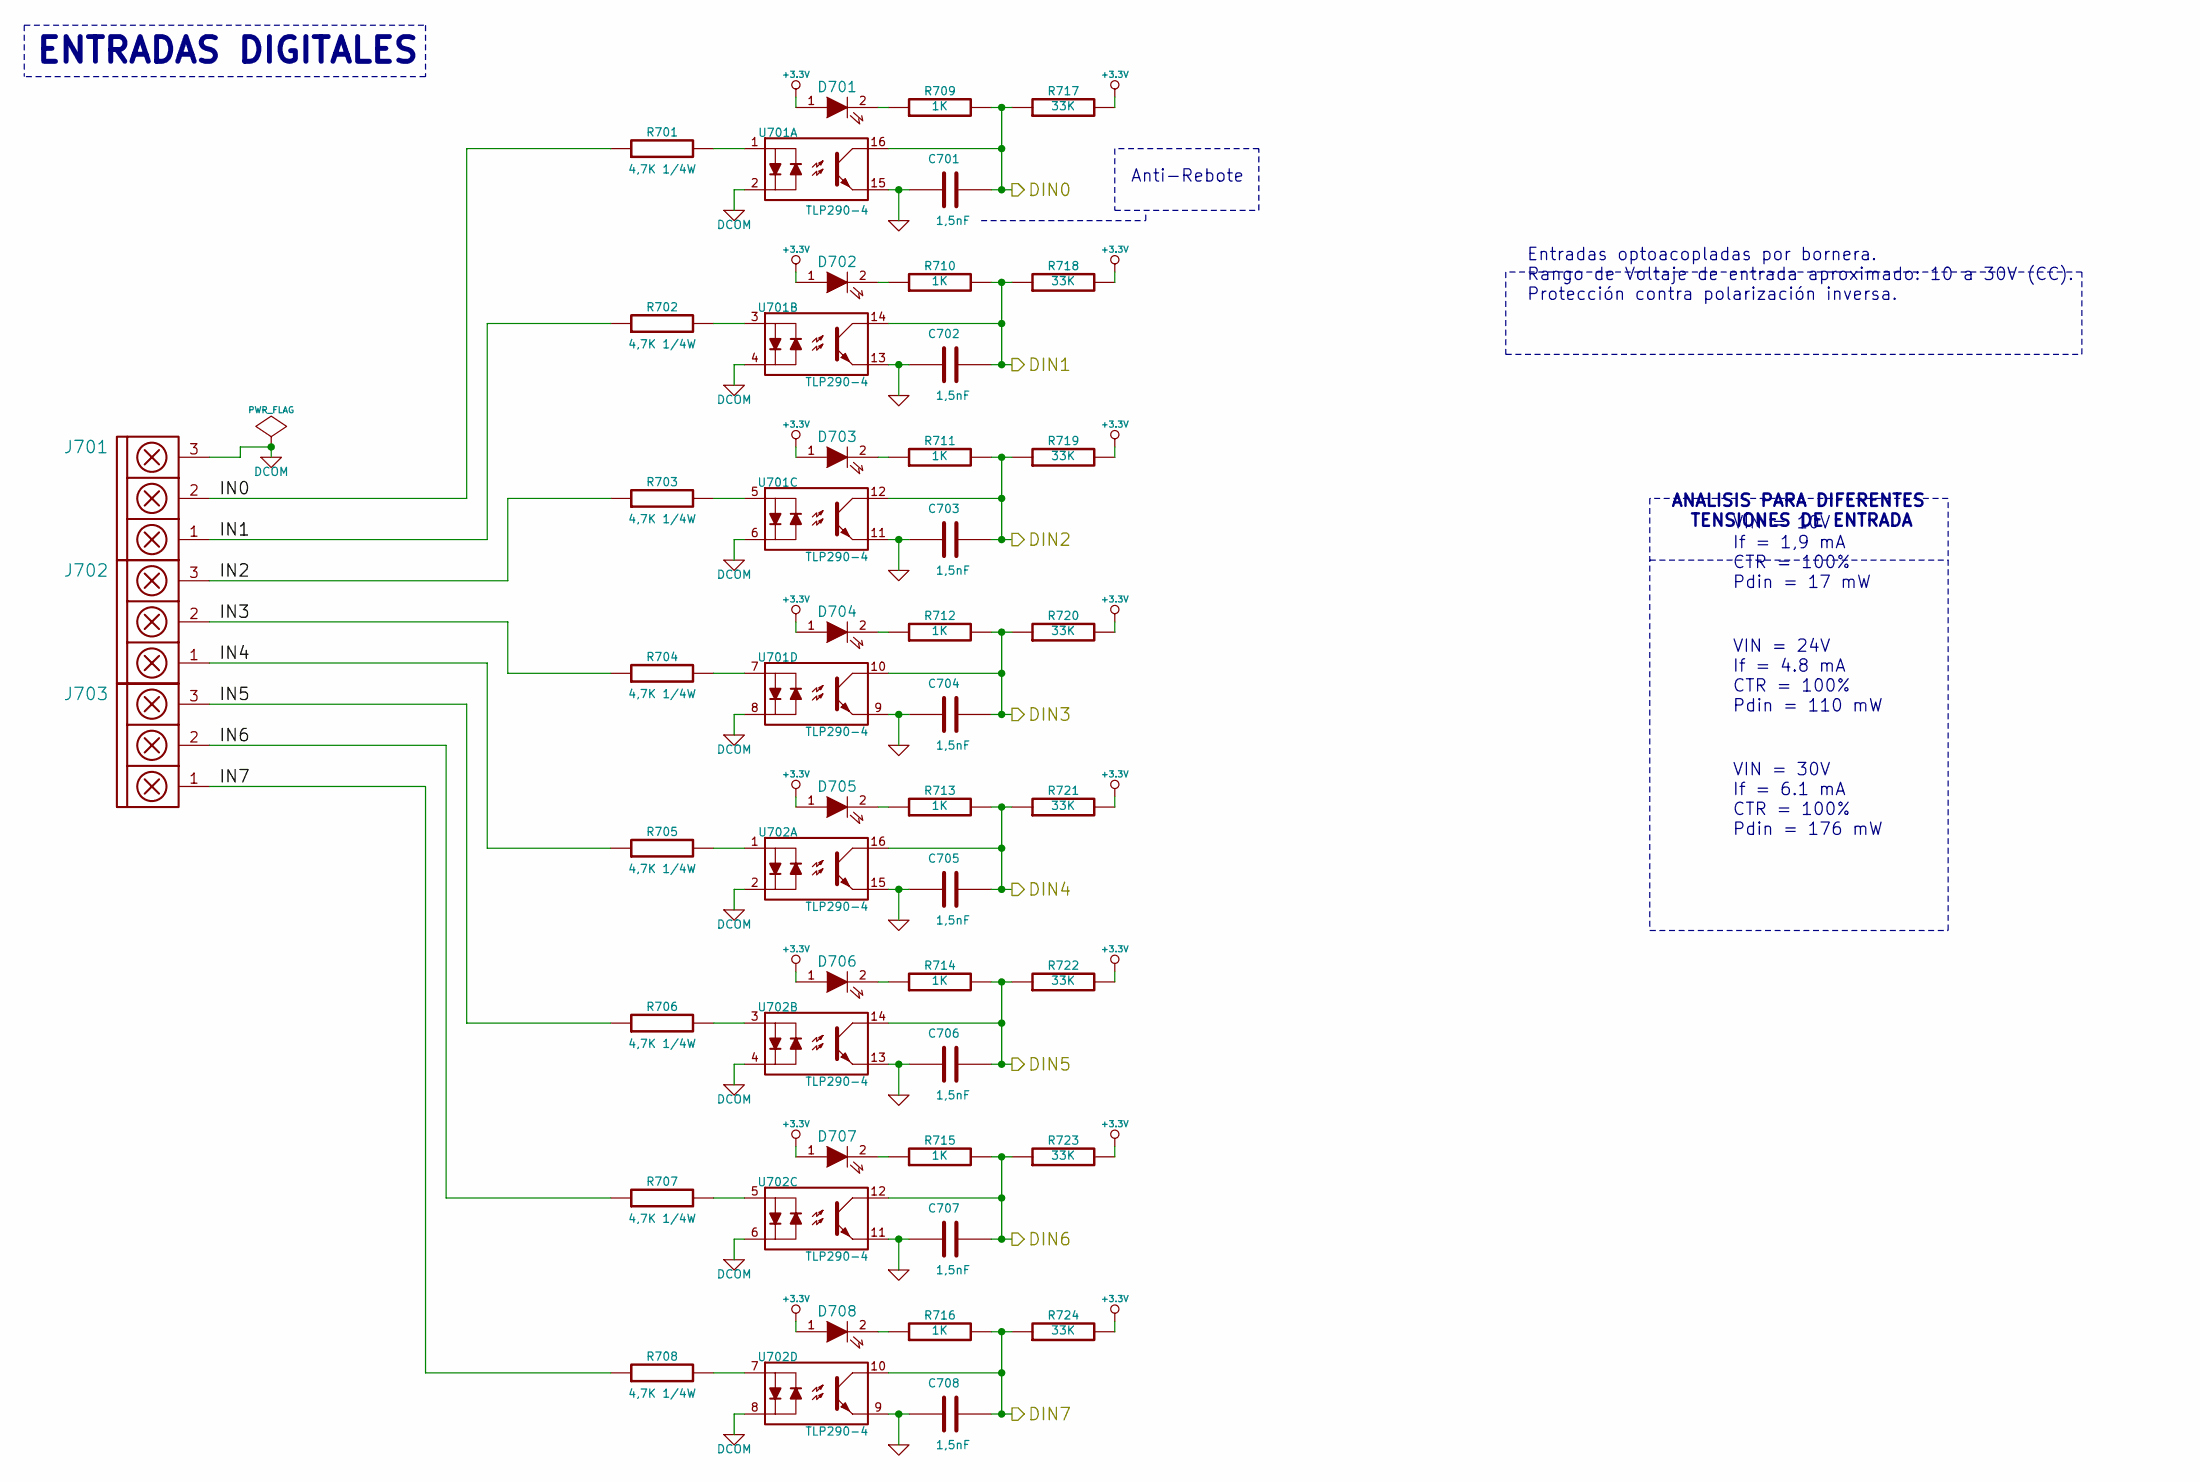
[picture p282: schematic din.sch, CIAA Entradas Digitales]

Parts:
C701, C702, C703, C704, C705, C706, C707, C708: 1,5nF; c_0603; Digikey/Mouser 399-1084-1-ND
D701, D702, D703, D704, D705, D706, D707, D708: LED red; LED-0603; Digikey/Mouser 1080-1400-1-ND
J701: DIG_INA; bornier3; Digikey/Mouser 571-7969493
J702: DIG_INB; bornier3; Digikey/Mouser 571-7969493
J703: DIG_INC; bornier3; Digikey/Mouser 571-7969493
R701, R702, R703, R704, R705, R706, R707, R708: 4,7K 1/4W; r_1206; Digikey/Mouser 311-4.7KERCT-ND
R709, R710, R711, R712, R713, R714, R715, R716: 1K; r_0603; Digikey/Mouser 311-1.0KGRCT-ND
R717, R718, R719, R720, R721, R722, R723, R724: 33K; r_0603; Digikey/Mouser 311-33KGRCT-ND
U701, U702: TLP290-4; SSOP-16; Digikey/Mouser TLP290-4(TPETR-ND

Connections:
/CPU/DIN0: C701.2, R709.2, R717.1, U701.16; also elsewhere on the board
/CPU/DIN1: C702.2, R710.2, R718.1, U701.14; also elsewhere on the board
/CPU/DIN2: C703.2, R711.2, R719.1, U701.12; also elsewhere on the board
/CPU/DIN3: C704.2, R712.2, R720.1, U701.10; also elsewhere on the board
/CPU/DIN4: C705.2, R713.2, R721.1, U702.16; also elsewhere on the board
/CPU/DIN5: C706.2, R714.2, R722.1, U702.14; also elsewhere on the board
/CPU/DIN6: C707.2, R715.2, R723.1, U702.12; also elsewhere on the board
/CPU/DIN7: C708.2, R716.2, R724.1, U702.10; also elsewhere on the board
/Entradas Digitales/IN0: J701.2, R701.1
/Entradas Digitales/IN1: J701.1, R702.1
/Entradas Digitales/IN2: J702.3, R703.1
/Entradas Digitales/IN3: J702.2, R704.1
/Entradas Digitales/IN4: J702.1, R705.1
/Entradas Digitales/IN5: J703.3, R706.1
/Entradas Digitales/IN6: J703.2, R707.1
/Entradas Digitales/IN7: J703.1, R708.1
DCOM: J701.3, U701.2, U701.4, U701.6, U701.8, U702.2, U702.4, U702.6, U702.8
GND: C701.1, C702.1, C703.1, C704.1, C705.1, C706.1, C707.1, C708.1, U701.9, U701.11, U701.13, U701.15, U702.9, U702.11, U702.13, U702.15; also elsewhere on the board
unnamed: R706.2, U702.3
unnamed: R705.2, U702.1
unnamed: D706.2 (K), R714.1
unnamed: D705.2 (K), R713.1
unnamed: D704.2 (K), R712.1
unnamed: R704.2, U701.7
unnamed: D708.2 (K), R716.1
unnamed: R708.2, U702.7
unnamed: D707.2 (K), R715.1
unnamed: R707.2, U702.5
unnamed: D701.2 (K), R709.1
unnamed: R701.2, U701.1
unnamed: D703.2 (K), R711.1
unnamed: R703.2, U701.5
unnamed: D702.2 (K), R710.1
unnamed: R702.2, U701.3

Notes on the sheet:
Entradas optoacopladas por bornera. Rango de Voltaje de entrada aproximado: 10 a 30V (CC). Protección contra polarización inversa.
ANALISIS PARA DIFERENTES TENSIONES DE ENTRADA
VIN = 10V If = 1,9 mA CTR = 100% Pdin = 17 mW
VIN = 24V If = 4.8 mA CTR = 100% Pdin = 110 mW
VIN = 30V If = 6.1 mA CTR = 100% Pdin = 176 mW
ENTRADAS DIGITALES
Anti-Rebote

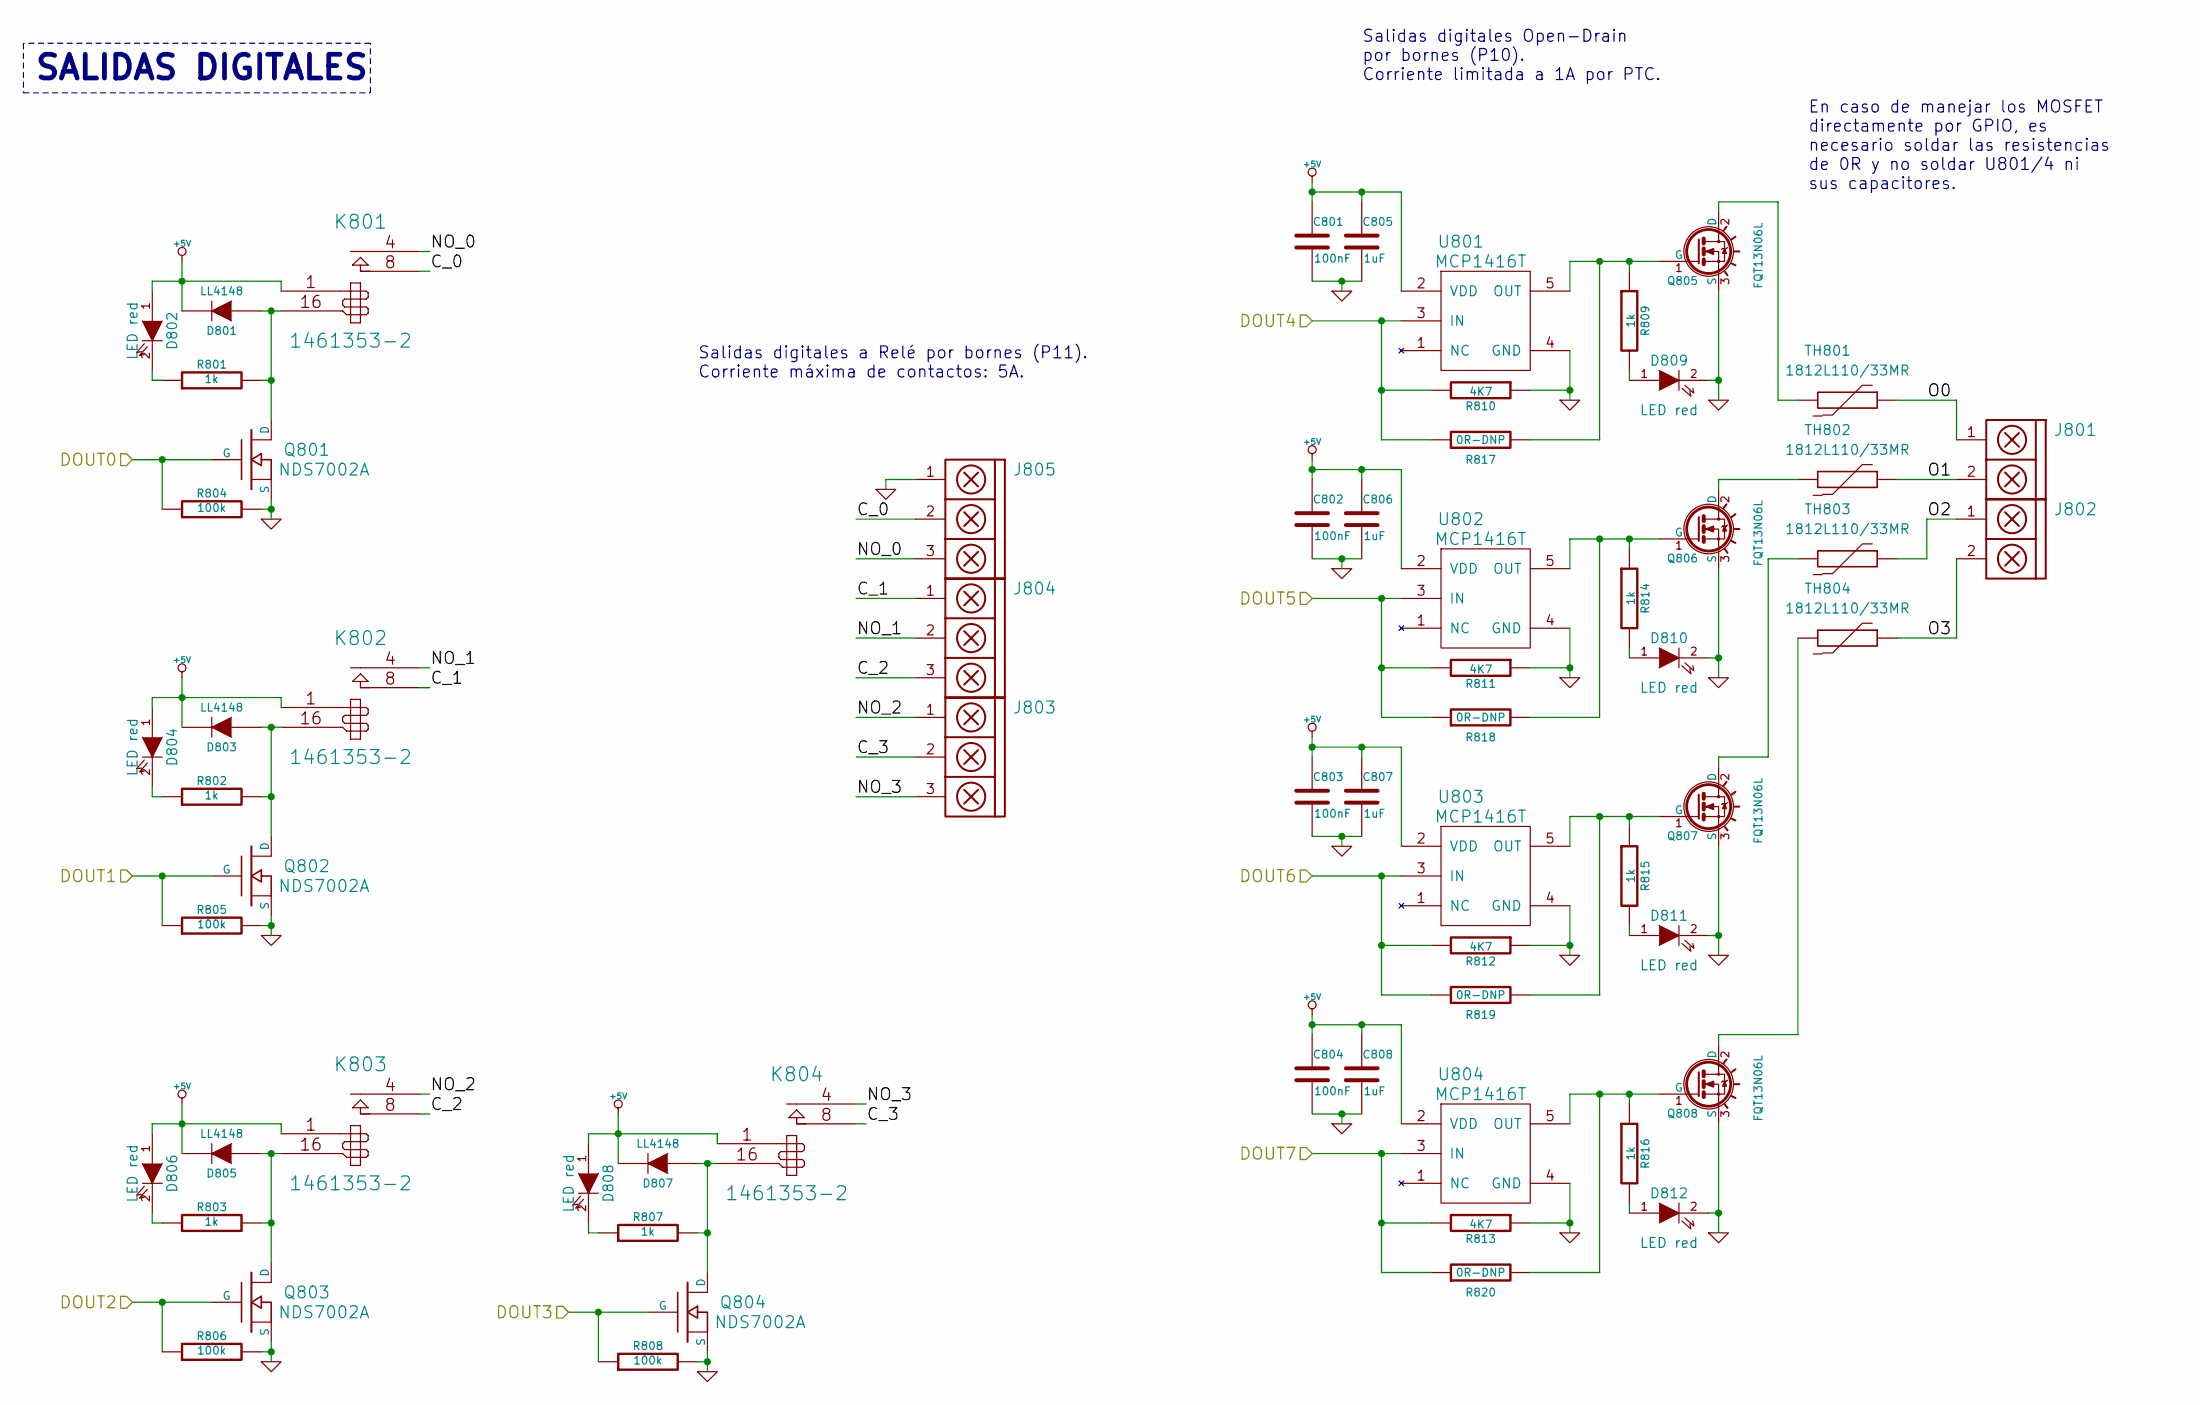
[picture p283: schematic dout.sch, CIAA Salidas Digitales]

Parts:
C801, C802, C803, C804: 100nF; c_0603; Digikey/Mouser 399-1096-1-ND
C805, C806, C807, C808: 1uF; c_0603; Digikey/Mouser 399-7847-1-ND
D801, D803, D805, D807: LL4148; SOD-123; Digikey/Mouser LL4148FSCT-ND
D802, D804, D806, D808, D809, D810, D811, D812: LED red; LED-0603; Digikey/Mouser 1080-1400-1-ND
J801: OPDRAIN_OUTA; bornier2; Digikey/Mouser 571-7969492
J802: OPDRAIN_OUTB; bornier2; Digikey/Mouser 571-7969492
J803: RELAY_OUTD; bornier3; Digikey/Mouser 571-7969493
J804, J805: RELAY_OUTB; bornier3; Digikey/Mouser 571-7969493
K801, K802, K803, K804: 1461353-2; Digikey/Mouser PB1652-ND
Q801, Q802, Q803, Q804: NDS7002A; SOT-23; Digikey/Mouser NDS7002ACT-ND
Q805, Q806, Q807, Q808: FQT13N06L; SOT-223; Digikey/Mouser FQT13N06LTFCT-ND
R801, R802, R803, R807, R809, R814, R815, R816: 1k; r_0603; Digikey/Mouser 311-1.0KGRCT-ND
R804, R805, R806, R808: 100k; r_0603; Digikey/Mouser 311-100KGRCT-ND
R810, R811, R812, R813: 4K7; r_0603; Digikey/Mouser 311-4.7KGRCT-ND
R817, R818, R819, R820: 0R-DNP; r_0603; Digikey/Mouser 311-0.0GRCT-ND
TH801, TH802, TH803, TH804: 1812L110/33MR; ptc_1812; Digikey/Mouser F3486CT-ND
U801, U802, U803, U804: MCP1416T; SOT-23-5; Digikey/Mouser MCP1416T-E/OTCT-ND

Connections:
+5V: C801.1, C802.1, C803.1, C804.1, C805.1, C806.1, C807.1, C808.1, D801.2 (K), D802.1 (A), D803.2 (K), D804.1 (A), D805.2 (K), D806.1 (A), D807.2 (K), D808.1 (A), K801.1, K802.1, K803.1, K804.1, U801.2 (VDD), U802.2 (VDD), U803.2 (VDD), U804.2 (VDD); also elsewhere on the board
/CPU/DOUT0: Q801.1 (G), R804.1; also elsewhere on the board
/CPU/DOUT1: Q802.1 (G), R805.1; also elsewhere on the board
/CPU/DOUT2: Q803.1 (G), R806.1; also elsewhere on the board
/CPU/DOUT3: Q804.1 (G), R808.1; also elsewhere on the board
/CPU/DOUT4: R810.2, R817.1, U801.3 (IN); also elsewhere on the board
/CPU/DOUT5: R811.2, R818.1, U802.3 (IN); also elsewhere on the board
/CPU/DOUT6: R812.2, R819.1, U803.3 (IN); also elsewhere on the board
/CPU/DOUT7: R813.2, R820.1, U804.3 (IN); also elsewhere on the board
/Salidas Digitales/C_0: J805.2, K801.8 (T1)
/Salidas Digitales/C_1: J804.1, K802.8 (T1)
/Salidas Digitales/C_2: J804.3, K803.8 (T1)
/Salidas Digitales/C_3: J803.2, K804.8 (T1)
/Salidas Digitales/NO_0: J805.3, K801.4 (C1)
/Salidas Digitales/NO_1: J804.2, K802.4 (C1)
/Salidas Digitales/NO_2: J803.1, K803.4 (C1)
/Salidas Digitales/NO_3: J803.3, K804.4 (C1)
/Salidas Digitales/O0: J801.1, TH801.1
/Salidas Digitales/O1: J801.2, TH802.1
/Salidas Digitales/O2: J802.1, TH803.1
/Salidas Digitales/O3: J802.2, TH804.1
GND: C801.2, C802.2, C803.2, C804.2, C805.2, C806.2, C807.2, C808.2, D809.2 (K), D810.2 (K), D811.2 (K), D812.2 (K), J805.1, Q801.2 (S), Q802.2 (S), Q803.2 (S), Q804.2 (S), Q805.3 (S), Q806.3 (S), Q807.3 (S), Q808.3 (S), R804.2, R805.2, R806.2, R808.2, R810.1, R811.1, R812.1, R813.1, U801.4 (GND), U802.4 (GND), U803.4 (GND), U804.4 (GND); also elsewhere on the board
unnamed: D809.1 (A), R809.2
unnamed: D811.1 (A), R815.2
unnamed: D810.1 (A), R814.2
unnamed: D812.1 (A), R816.2
unnamed: D803.1 (A), K802.16, Q802.3 (D), R802.2
unnamed: Q808.1 (G), R816.1, R820.2, U804.5 (OUT)
unnamed: Q805.1 (G), R809.1, R817.2, U801.5 (OUT)
unnamed: Q806.2 (D), TH802.2
unnamed: Q806.1 (G), R814.1, R818.2, U802.5 (OUT)
unnamed: Q807.1 (G), R815.1, R819.2, U803.5 (OUT)
unnamed: Q807.2 (D), TH803.2
unnamed: Q808.2 (D), TH804.2
unnamed: Q805.2 (D), TH801.2
unnamed: D801.1 (A), K801.16, Q801.3 (D), R801.2
unnamed: D802.2 (K), R801.1
unnamed: D804.2 (K), R802.1
unnamed: D807.1 (A), K804.16, Q804.3 (D), R807.2
unnamed: D805.1 (A), K803.16, Q803.3 (D), R803.2
unnamed: D806.2 (K), R803.1
unnamed: D808.2 (K), R807.1

Notes on the sheet:
Salidas digitales a Relé por bornes (P11). Corriente máxima de contactos: 5A.
SALIDAS DIGITALES
Salidas digitales Open-Drain por bornes (P10). Corriente limitada a 1A por PTC.
En caso de manejar los MOSFET directamente por GPIO, es necesario soldar las resistencias de 0R y no soldar U801/4 ni sus capacitores.
