ciaa/Hardware/PCB/FSL/CIAA_K60/CIAA_K60.kicad_pcb

## KiCad design PCB/FSL/CIAA_K60/CIAA_K60.kicad_pcb (continued)

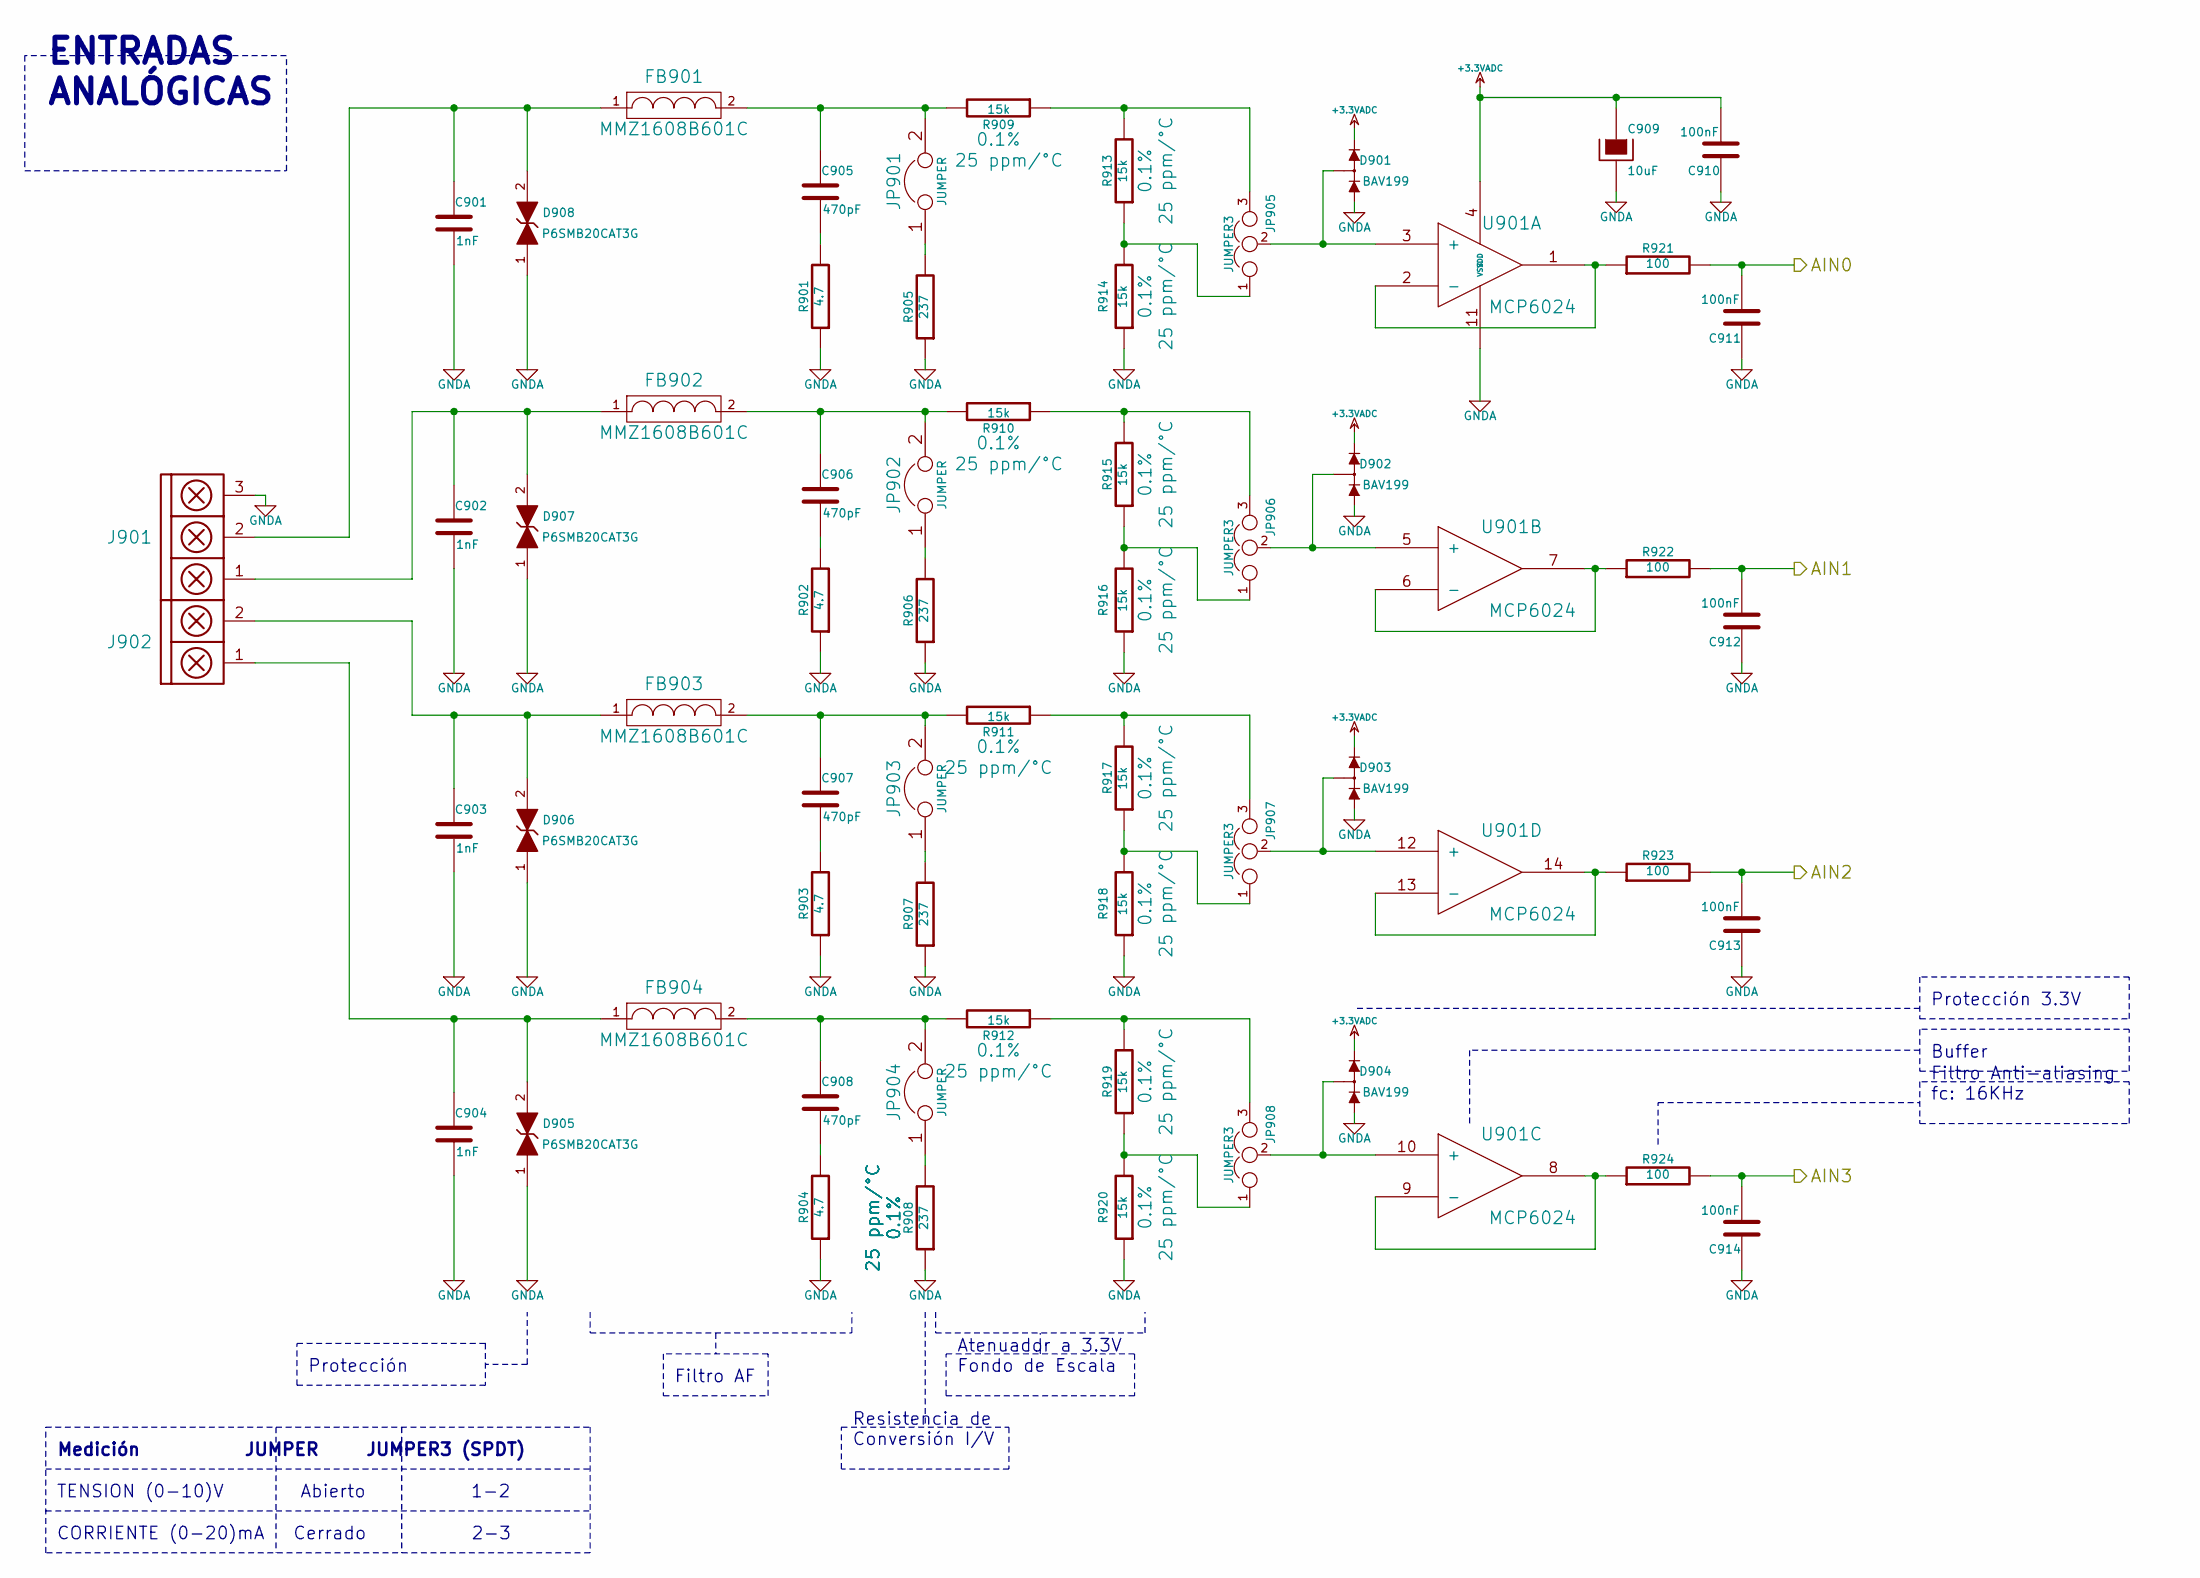
[picture p284: schematic analog.sch, CIAA - Entradas Analogicas]

Parts:
C901, C902, C903, C904: 1nF; c_0603; Digikey/Mouser 399-1082-1-ND
C905, C906, C907, C908: 470pF; c_0603; Digikey/Mouser 399-1075-1-ND
C909: 10uF; c_1206POL; Digikey/Mouser 399-10116-1-ND
C910, C911, C912, C913, C914: 100nF; c_0603; Digikey/Mouser 399-1096-1-ND
D901, D902, D903, D904: BAV199; SOT-23; Digikey/Mouser BAV199LT1GOSCT-ND
D905, D906, D907, D908: P6SMB20CAT3G; DO-214AA_SMB; Digikey/Mouser P6SMB20CAT3GOSCT-ND
FB901, FB902, FB903, FB904: MMZ1608B601C; fb_0603; Digikey/Mouser 445-2166-1-ND
J901: ANALOG INPUT 1; bornier3; Digikey/Mouser 571-7969493
J902: ANALOG INPUT 2; bornier2; Digikey/Mouser 571-7969492
JP901, JP902, JP903, JP904: JUMPER; PIN_ARRAY_2x1
JP905, JP906, JP907, JP908: JUMPER3; PIN_ARRAY_3x1
R901, R902, R903, R904: 4.7; r_0603; Digikey/Mouser 311-4.7GRCT-ND
R905, R906, R907, R908: 237; r_0603; Digikey/Mouser P237DBCT-ND
R909, R910, R911, R912, R913, R914, R915, R916, R917, R918, R919, R920: 15k; r_0603; Digikey/Mouser RG16P15.0KBCT-ND
R921, R922, R923, R924: 100; r_0603; Digikey/Mouser 311-100GRCT-ND
U901: MCP6024; TSSOP-14; Digikey/Mouser MCP6024-I/ST-ND

Connections:
+3.3VADC: C909.1, C910.2, D901.2 (K), D902.2 (K), D903.2 (K), D904.2 (K), U901.4 (VDD); also elsewhere on the board
/CPU/AIN0: C911.2, R921.2; also elsewhere on the board
/CPU/AIN1: C912.2, R922.2; also elsewhere on the board
/CPU/AIN2: C913.2, R923.2; also elsewhere on the board
/CPU/AIN3: C914.2, R924.2; also elsewhere on the board
GNDA: C901.2, C902.2, C903.2, C904.2, C909.2, C910.1, C911.1, C912.1, C913.1, C914.1, D901.1 (A), D902.1 (A), D903.1 (A), D904.1 (A), D905.1, D906.1, D907.1, D908.1, J901.3, R901.1, R902.1, R903.1, R904.1, R905.1, R906.1, R907.1, R908.1, R914.1, R916.1, R918.1, R920.1, U901.11 (VSS); also elsewhere on the board
unnamed: JP907.1, R917.1, R918.2
unnamed: C907.1, FB903.2, JP903.2, R911.2
unnamed: JP907.3, R911.1, R917.2
unnamed: JP908.3, R912.1, R919.2
unnamed: JP906.1, R915.1, R916.2
unnamed: C903.1, D906.2, FB903.1, J902.2
unnamed: JP903.1, R907.2
unnamed: D903.3 (KA), JP907.2, U901.12 (+)
unnamed: D904.3 (KA), JP908.2, U901.10 (+)
unnamed: JP908.1, R919.1, R920.2
unnamed: JP904.1, R908.2
unnamed: C906.1, FB902.2, JP902.2, R910.2
unnamed: C908.1, FB904.2, JP904.2, R912.2
unnamed: R924.1, U901.8, U901.9 (-)
unnamed: R923.1, U901.13 (-), U901.14
unnamed: C905.2, R901.2
unnamed: C905.1, FB901.2, JP901.2, R909.2
unnamed: R921.1, U901.1, U901.2 (-)
unnamed: C902.1, D907.2, FB902.1, J901.1
unnamed: JP905.3, R909.1, R913.2
unnamed: JP905.1, R913.1, R914.2
unnamed: JP901.1, R905.2
unnamed: D901.3 (KA), JP905.2, U901.3 (+)
unnamed: D902.3 (KA), JP906.2, U901.5 (+)
unnamed: JP906.3, R910.1, R915.2
unnamed: JP902.1, R906.2
unnamed: C901.1, D908.2, FB901.1, J901.2
unnamed: C908.2, R904.2
unnamed: R922.1, U901.6 (-), U901.7
unnamed: C906.2, R902.2
unnamed: C907.2, R903.2
unnamed: C904.1, D905.2, FB904.1, J902.1

Notes on the sheet:
Filtro AF
Resistencia de Conversión I/V
Atenuador a 3.3V Fondo de Escala
Protección 3.3V
Buffer
Filtro Anti-aliasing fc: 16KHz
Protección
ENTRADAS ANALÓGICAS
Medición JUMPER JUMPER3 (SPDT)
TENSION (0-10)V Abierto 1-2
CORRIENTE (0-20)mA Cerrado 2-3

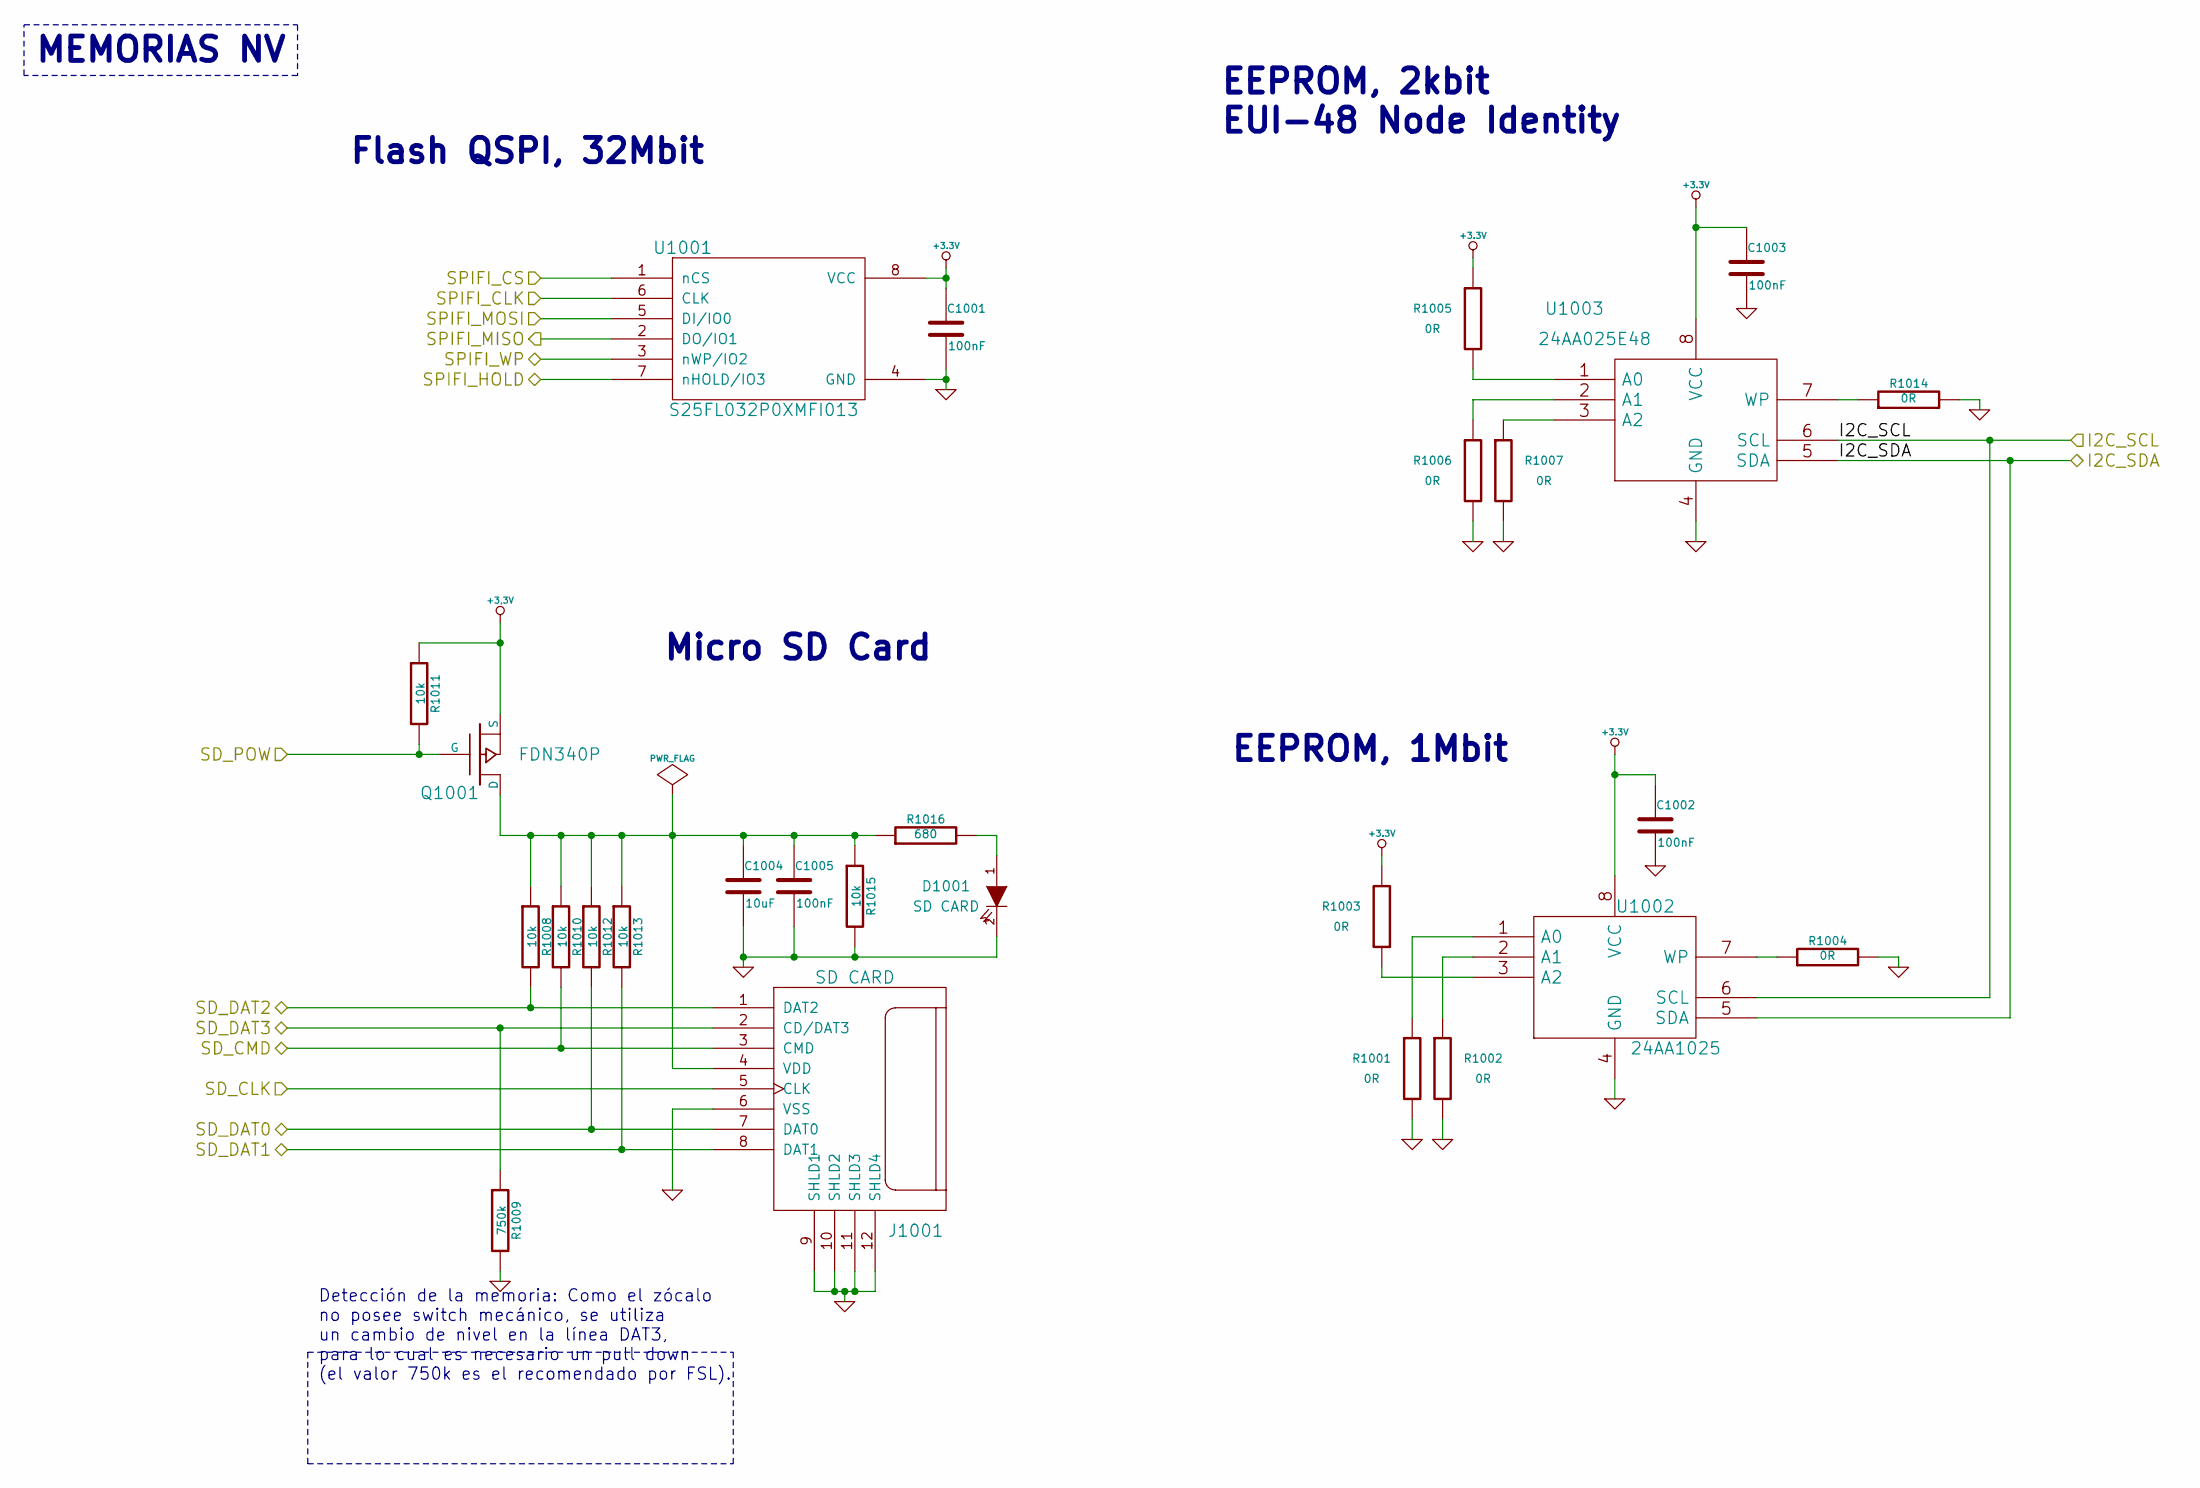
[picture p285: schematic memories.sch, CIAA Memorias NV]

Parts:
C1001, C1002, C1003, C1005: 100nF; c_0603; Digikey/Mouser 399-1096-1-ND
C1004: 10uF; c_1206POL; Digikey/Mouser 399-10116-1-ND
D1001: SD CARD; LED-0603; Digikey/Mouser 1080-1399-1-ND
J1001: SD CARD; MicroSD_Hinged; Digikey/Mouser WM6698CT-ND
Q1001: FDN340P; SOT-23; Digikey/Mouser FDN340PCT-ND
R1001, R1002, R1003, R1004, R1005, R1006, R1007, R1014: 0R; r_0603; Digikey/Mouser 311-0.0GRCT-ND
R1008, R1010, R1011, R1012, R1013, R1015: 10k; r_0603; Digikey/Mouser 311-10KGRCT-ND
R1009: 750k; r_0603; Digikey/Mouser 311-750KGRCT-ND
R1016: 680; r_0603; Digikey/Mouser 311-680GRCT-ND
U1001: S25FL032P0XMFI013; SOIC-8_WIDE; Digikey/Mouser S25FL032P0XMFI013-ND
U1002: 24AA1025; SOIC-8; Digikey/Mouser 24AA1025-I/SN-ND
U1003: 24AA025E48; SOIC-8; Digikey/Mouser 24AA025E48-I/SN-ND

Connections:
/CPU/I2C_SCL: U1002.6 (SCL), U1003.6 (SCL); also elsewhere on the board
/CPU/I2C_SDA: U1002.5 (SDA), U1003.5 (SDA); also elsewhere on the board
/CPU/SD_CLK: J1001.5 (CLK); also elsewhere on the board
/CPU/SD_CMD: J1001.3 (CMD), R1010.2; also elsewhere on the board
/CPU/SD_DAT0: J1001.7 (DAT0), R1012.2; also elsewhere on the board
/CPU/SD_DAT1: J1001.8 (DAT1), R1013.2; also elsewhere on the board
/CPU/SD_DAT2: J1001.1 (DAT2), R1008.2; also elsewhere on the board
/CPU/SD_DAT3: J1001.2 (CD/DAT3), R1009.1; also elsewhere on the board
/CPU/SD_POW: Q1001.1 (G), R1011.2; also elsewhere on the board
/CPU/SPIFI_CLK: U1001.6 (CLK); also elsewhere on the board
/CPU/SPIFI_CS: U1001.1 (nCS); also elsewhere on the board
/CPU/SPIFI_HOLD: U1001.7 (nHOLD/IO3); also elsewhere on the board
/CPU/SPIFI_MISO: U1001.2 (DO/IO1); also elsewhere on the board
/CPU/SPIFI_MOSI: U1001.5 (DI/IO0); also elsewhere on the board
/CPU/SPIFI_WP: U1001.3 (nWP/IO2); also elsewhere on the board
GND: C1001.2, C1002.2, C1003.2, C1004.2, C1005.2, D1001.2 (K), J1001.6 (VSS), J1001.9 (SHLD1), J1001.10 (SHLD2), J1001.11 (SHLD3), J1001.12 (SHLD4), R1001.2, R1002.2, R1004.2, R1006.2, R1007.2, R1009.2, R1014.2, R1015.2, U1001.4 (GND), U1002.4 (GND), U1003.4 (GND); also elsewhere on the board
unnamed: R1014.1, U1003.7 (WP)
unnamed: R1005.2, U1003.1 (A0)
unnamed: R1004.1, U1002.7 (WP)
unnamed: D1001.1 (A), R1016.2
unnamed: R1003.1, U1002.3 (A2)
unnamed: R1002.1, U1002.2 (A1)
unnamed: R1001.1, U1002.1 (A0)
unnamed: R1007.1, U1003.3 (A2)
unnamed: R1006.1, U1003.2 (A1)
unnamed: C1004.1, C1005.1, J1001.4 (VDD), Q1001.3 (D), R1008.1, R1010.1, R1012.1, R1013.1, R1015.1, R1016.1

Notes on the sheet:
EEPROM, 1Mbit
EEPROM, 2kbit EUI-48 Node Identity
Flash QSPI, 32Mbit
Micro SD Card
MEMORIAS NV
Detección de la memoria: Como el zócalo no posee switch mecánico, se utiliza un cambio de nivel en la línea DAT3, para lo cual es necesario un pull down (el valor 750k es el recomendado por FSL).

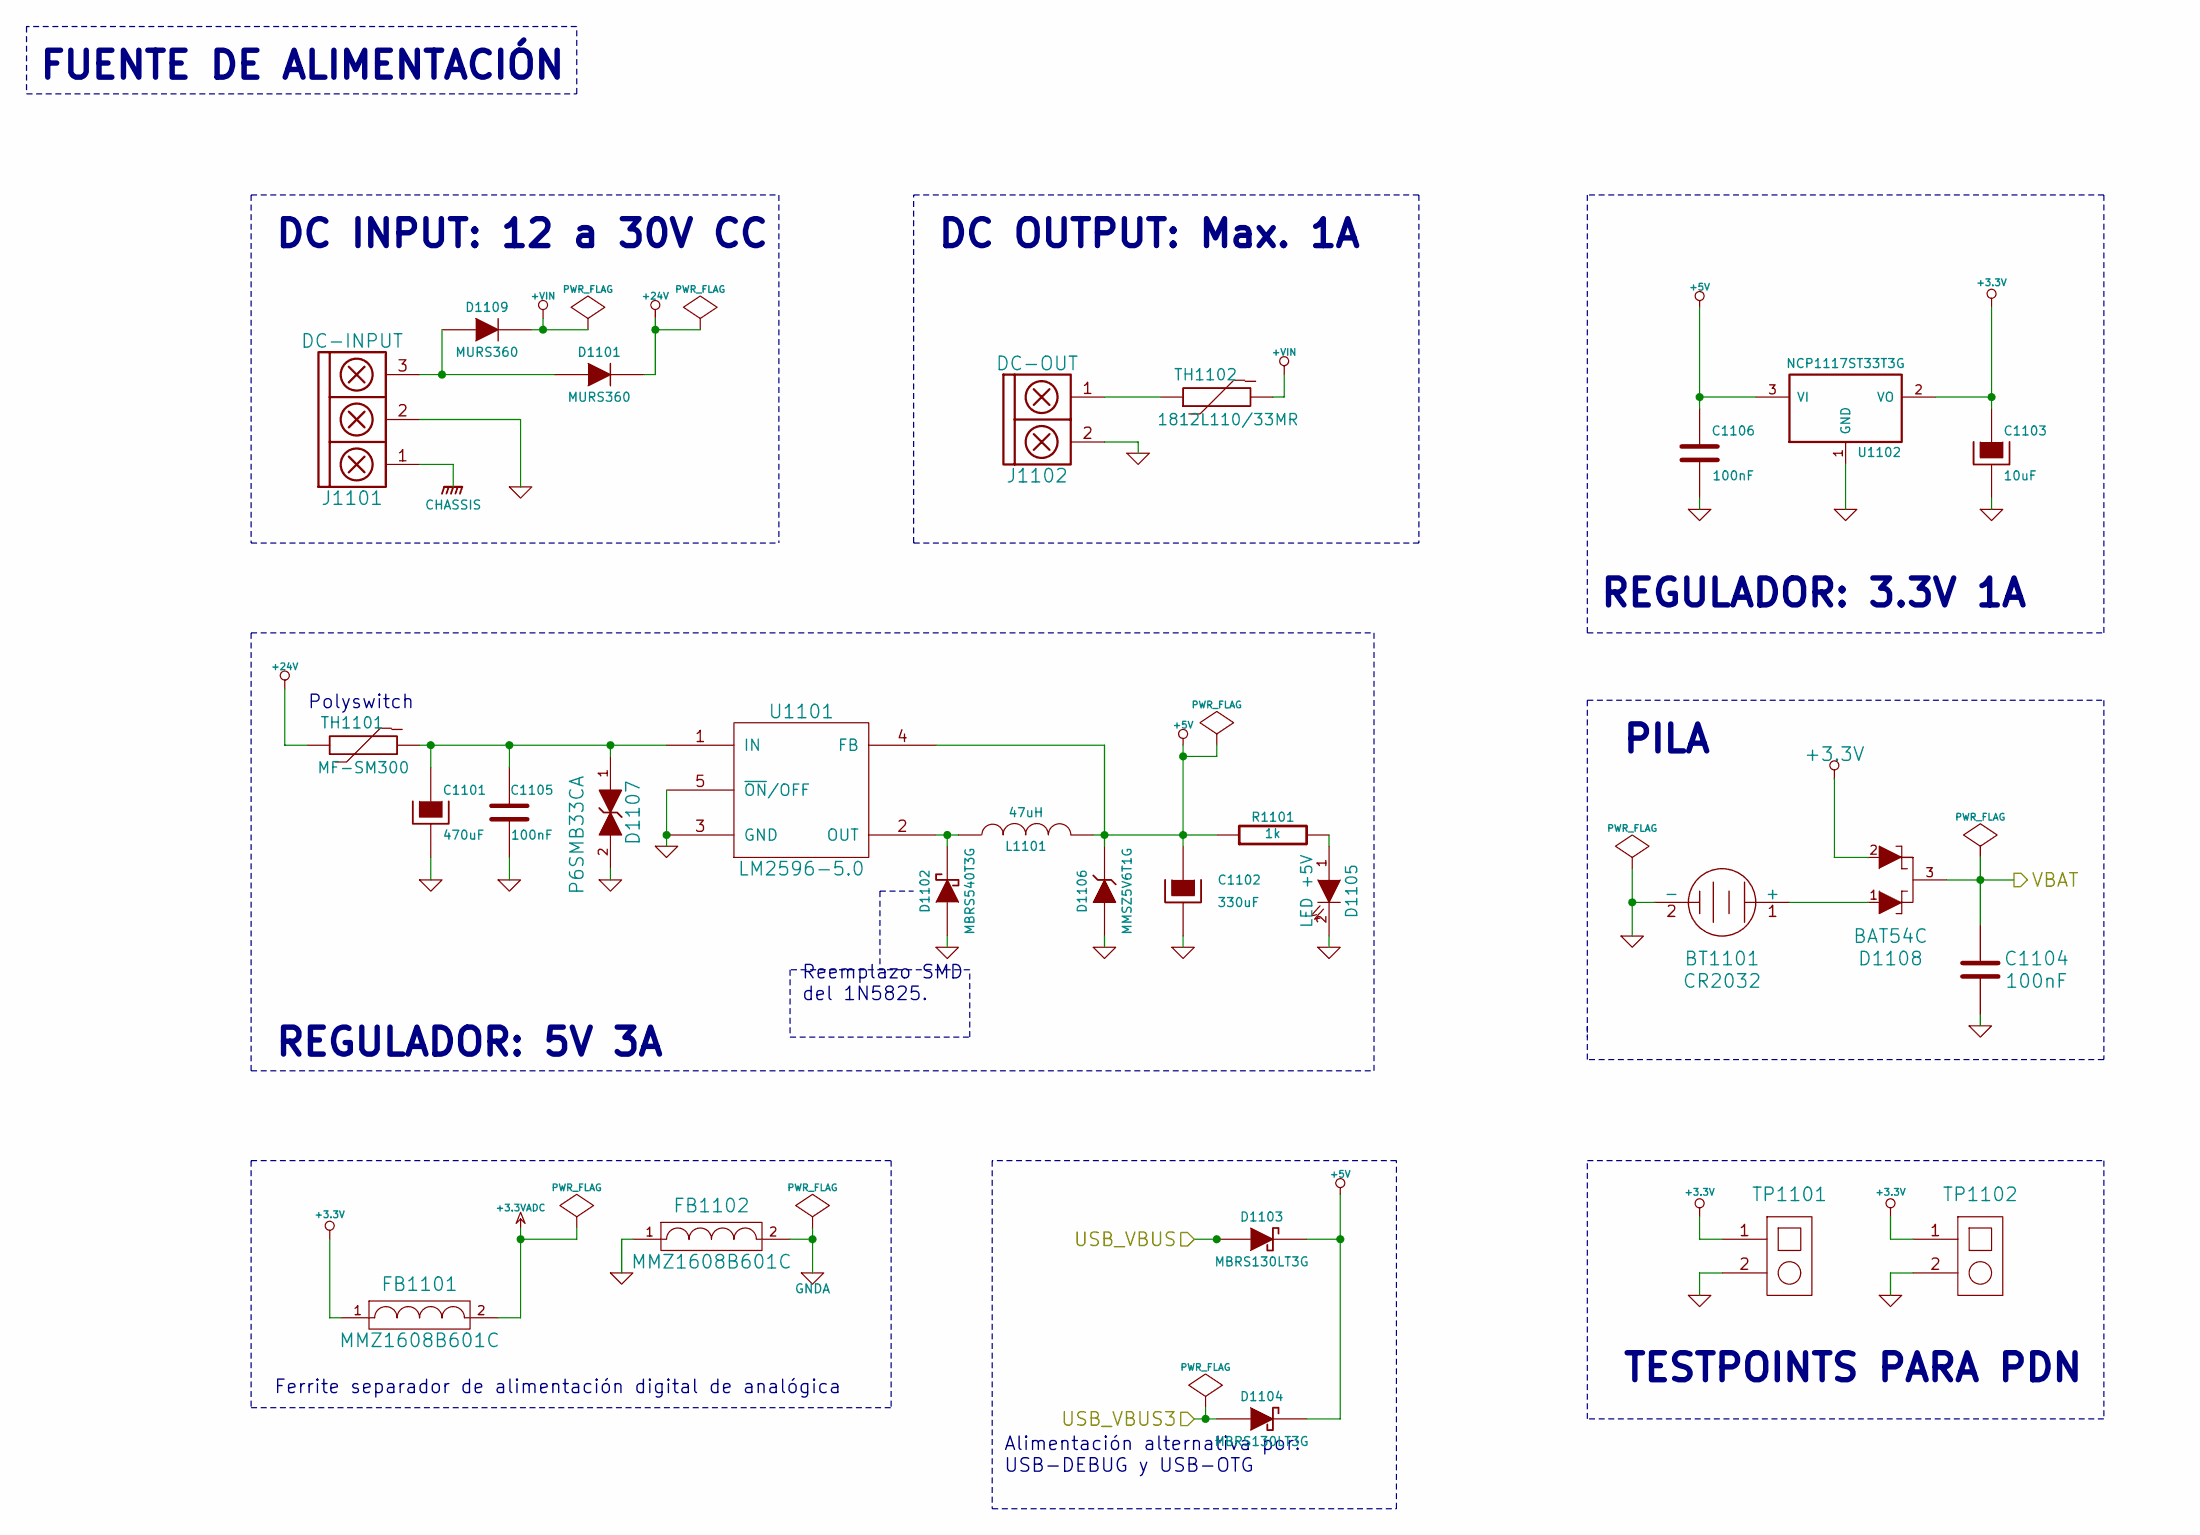
[picture p286: schematic fuente.sch, Fuente de Alimentación]

Parts:
BT1101: CR2032; 2032batPTH; Digikey/Mouser BH32T-C-ND
C1101: 470uF; c_elec_10x13_5; Digikey/Mouser 493-3961-1-ND
C1102: 330uF; c_elec_8x10; Digikey/Mouser 493-9422-1-ND
C1103: 10uF; c_1206POL; Digikey/Mouser 399-10116-1-ND
C1104, C1106: 100nF; c_0603; Digikey/Mouser 399-1096-1-ND
C1105: 100nF; c_0603; Digikey/Mouser 1276-1936-1-ND
D1101, D1109: MURS360; DO-214AB_SMC; Digikey/Mouser MURS360T3GOSCT-ND
D1102: MBRS540T3G; DO-214AB_SMC; Digikey/Mouser MBRS540T3GOSCT-ND
D1103, D1104: MBRS130LT3G; DO-214AA_SMB; Digikey/Mouser MBRS130LT3GOSCT-ND
D1105: LED +5V; LED-0603; Digikey/Mouser 1080-1400-1-ND
D1106: MMSZ5V6T1G; SOD-123; Digikey/Mouser MMSZ5V6T1GOSCT-ND
D1107: P6SMB33CA; DO-214AA_SMB; Digikey/Mouser P6SMB33CA-E3/52GICT-ND
D1108: BAT54C; SOT-23; Digikey/Mouser BAT54FSCT-ND
FB1101, FB1102: MMZ1608B601C; fb_0603; Digikey/Mouser 445-2166-1-ND
J1101: DC-INPUT; bornier3; Digikey/Mouser 571-7969493
J1102: DC-OUT; bornier2; Digikey/Mouser 571-7969492
L1101: 47uH; L_10x9.8_SMD; Digikey/Mouser SRN1060-470MCT-ND
R1101: 1k; r_0603; Digikey/Mouser 311-1.0KGRCT-ND
TH1101: MF-SM300; Digikey/Mouser MF-SM300-2CT-ND
TH1102: 1812L110/33MR; ptc_1812; Digikey/Mouser F3486CT-ND
TP1101, TP1102: TESTPOINT_PDN
U1101: LM2596-5.0; LM2596; Digikey/Mouser LM2596SX-5.0/NOPBCT-ND
U1102: NCP1117ST33T3G; SOT-223; Digikey/Mouser NCP1117ST33T3GOSCT-ND

Connections:
+3.3VADC: FB1101.2; also elsewhere on the board
+5V: C1102.1, C1106.1, D1103.2 (K), D1104.2 (K), D1106.2 (K), L1101.2, R1101.1, U1101.4 (FB), U1102.3 (VI); also elsewhere on the board
+24V: D1101.2 (K), TH1101.1; also elsewhere on the board
+VIN: D1109.2 (K), TH1102.2
/CPU/VBAT: C1104.1, D1108.3 (C); also elsewhere on the board
/Fuente/USB_VBUS: D1103.1 (A); also elsewhere on the board
/JTAG/USB_DEBUG_VBUS: D1104.1 (A); also elsewhere on the board
GND: BT1101.2 (-), C1101.2, C1102.2, C1103.2, C1104.2, C1105.2, C1106.2, D1102.1 (A), D1105.2 (K), D1106.1 (A), D1107.2, FB1102.1, J1101.2, J1102.2, TP1101.2, TP1102.2, U1101.3 (GND), U1101.5 (~ON~/OFF), U1102.1 (GND); also elsewhere on the board
GNDA: FB1102.2; also elsewhere on the board
GNDPWR: J1101.1; also elsewhere on the board
unnamed: C1101.1, C1105.1, D1107.1, TH1101.2, U1101.1 (IN)
unnamed: D1102.2 (K), L1101.1, U1101.2 (OUT)
unnamed: BT1101.1 (+), D1108.1 (B)
unnamed: J1102.1, TH1102.1
unnamed: D1105.1 (A), R1101.2
unnamed: D1101.1 (A), D1109.1 (A), J1101.3

Notes on the sheet:
Polyswitch
Reemplazo SMD del 1N5825.
Ferrite separador de alimentación digital de analógica
FUENTE DE ALIMENTACIÓN
DC INPUT: 12 a 30V CC
REGULADOR: 5V 3A
REGULADOR: 3.3V 1A
Alimentación alternativa por: USB-DEBUG y USB-OTG
PILA
DC OUTPUT: Max. 1A
TESTPOINTS PARA PDN

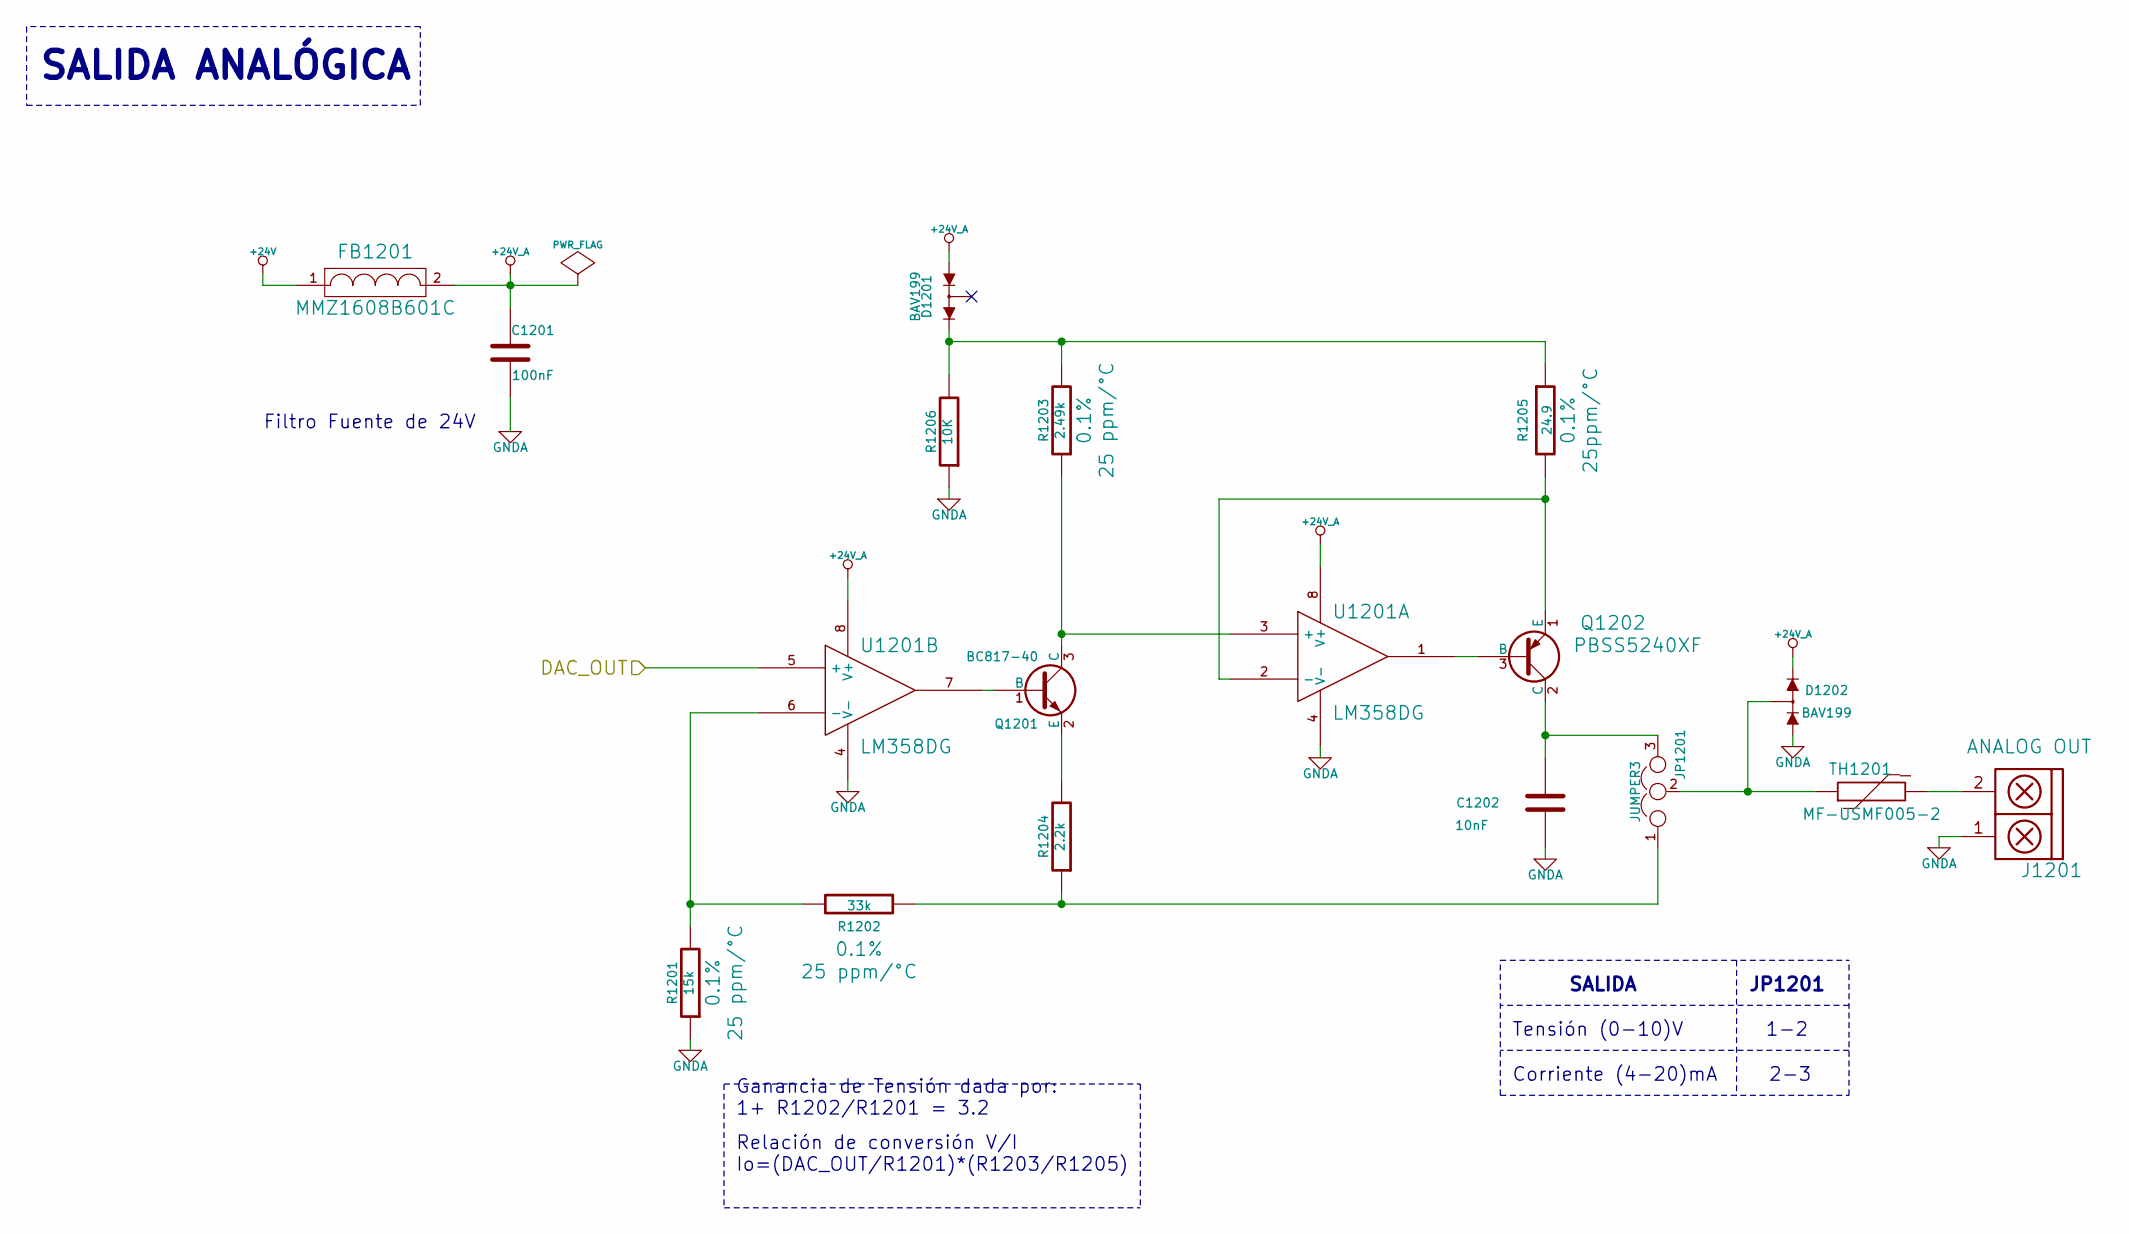
[picture p287: schematic analog_out.sch, CIAA - Salida Analógica]

Parts:
C1201: 100nF; c_0603; Digikey/Mouser 1276-1936-1-ND
C1202: 10nF; c_0603; Digikey/Mouser 399-1091-1-ND
D1201, D1202: BAV199; SOT-23; Digikey/Mouser BAV199LT1GOSCT-ND
FB1201: MMZ1608B601C; fb_0603; Digikey/Mouser 445-2166-1-ND
J1201: ANALOG OUT; bornier2; Digikey/Mouser 571-7969492
JP1201: JUMPER3; PIN_ARRAY_3x1; Digikey/Mouser S1212EC-40-ND
Q1201: BC817-40; SOT-23; Digikey/Mouser BC817-40LT3GOSCT-ND
Q1202: PBSS5240XF; SOT-89; Digikey/Mouser 568-10522-1-ND
R1201: 15k; r_0603; Digikey/Mouser RG16P15.0KBCT-ND
R1202: 33k; r_0603; Digikey/Mouser RG16P33.0KBCT-ND
R1203: 2.49k; r_0603; Digikey/Mouser RG16P2.49KBCT-ND
R1204: 2.2k; r_0603; Digikey/Mouser 311-2.2KGRCT-ND
R1205: 24.9; r_0603; Digikey/Mouser RT0603BRD0724R9L-ND
R1206: 10K; r_0603; Digikey/Mouser 311-10KGRCT-ND
TH1201: MF-USMF005-2; ptc_1210; Digikey/Mouser MF-USMF005-2CT-ND
U1201: LM358DG; SOIC-8; Digikey/Mouser LM358DGOS-ND

Connections:
+24V: FB1201.1; also elsewhere on the board
+24V_A: C1201.1, D1201.1 (A), D1202.2 (K), FB1201.2, U1201.8 (V+)
/CPU/DAC_OUT: U1201.5 (+); also elsewhere on the board
GNDA: C1201.2, C1202.1, D1202.1 (A), J1201.1, R1201.1, R1206.1, U1201.4 (V-); also elsewhere on the board
unnamed: Q1202.3 (B), U1201.1
unnamed: Q1202.1 (E), R1205.2, U1201.2 (-)
unnamed: Q1201.2 (E), R1204.2
unnamed: C1202.2, JP1201.3, Q1202.2 (C)
unnamed: J1201.2, TH1201.2
unnamed: R1201.2, R1202.2, U1201.6 (-)
unnamed: D1202.3 (KA), JP1201.2, TH1201.1
unnamed: JP1201.1, R1202.1, R1204.1
unnamed: Q1201.1 (B), U1201.7
unnamed: Q1201.3 (C), R1203.1, U1201.3 (+)
unnamed: D1201.2 (K), R1203.2, R1205.1, R1206.2

Notes on the sheet:
SALIDA ANALÓGICA
Filtro Fuente de 24V
Ganancia de Tensión dada por: 1+ R1202/R1201 = 3.2
Relación de conversión V/I Io=(DAC_OUT/R1201)*(R1203/R1205)
SALIDA JP1201
Corriente (4-20)mA 2-3
Tensión (0-10)V 1-2
