ciaa/Hardware/PCB/FSL/CIAA_K60/CIAA_K60.kicad_pcb

## KiCad design PCB/FSL/CIAA_K60/CIAA_K60.kicad_pcb (continued)

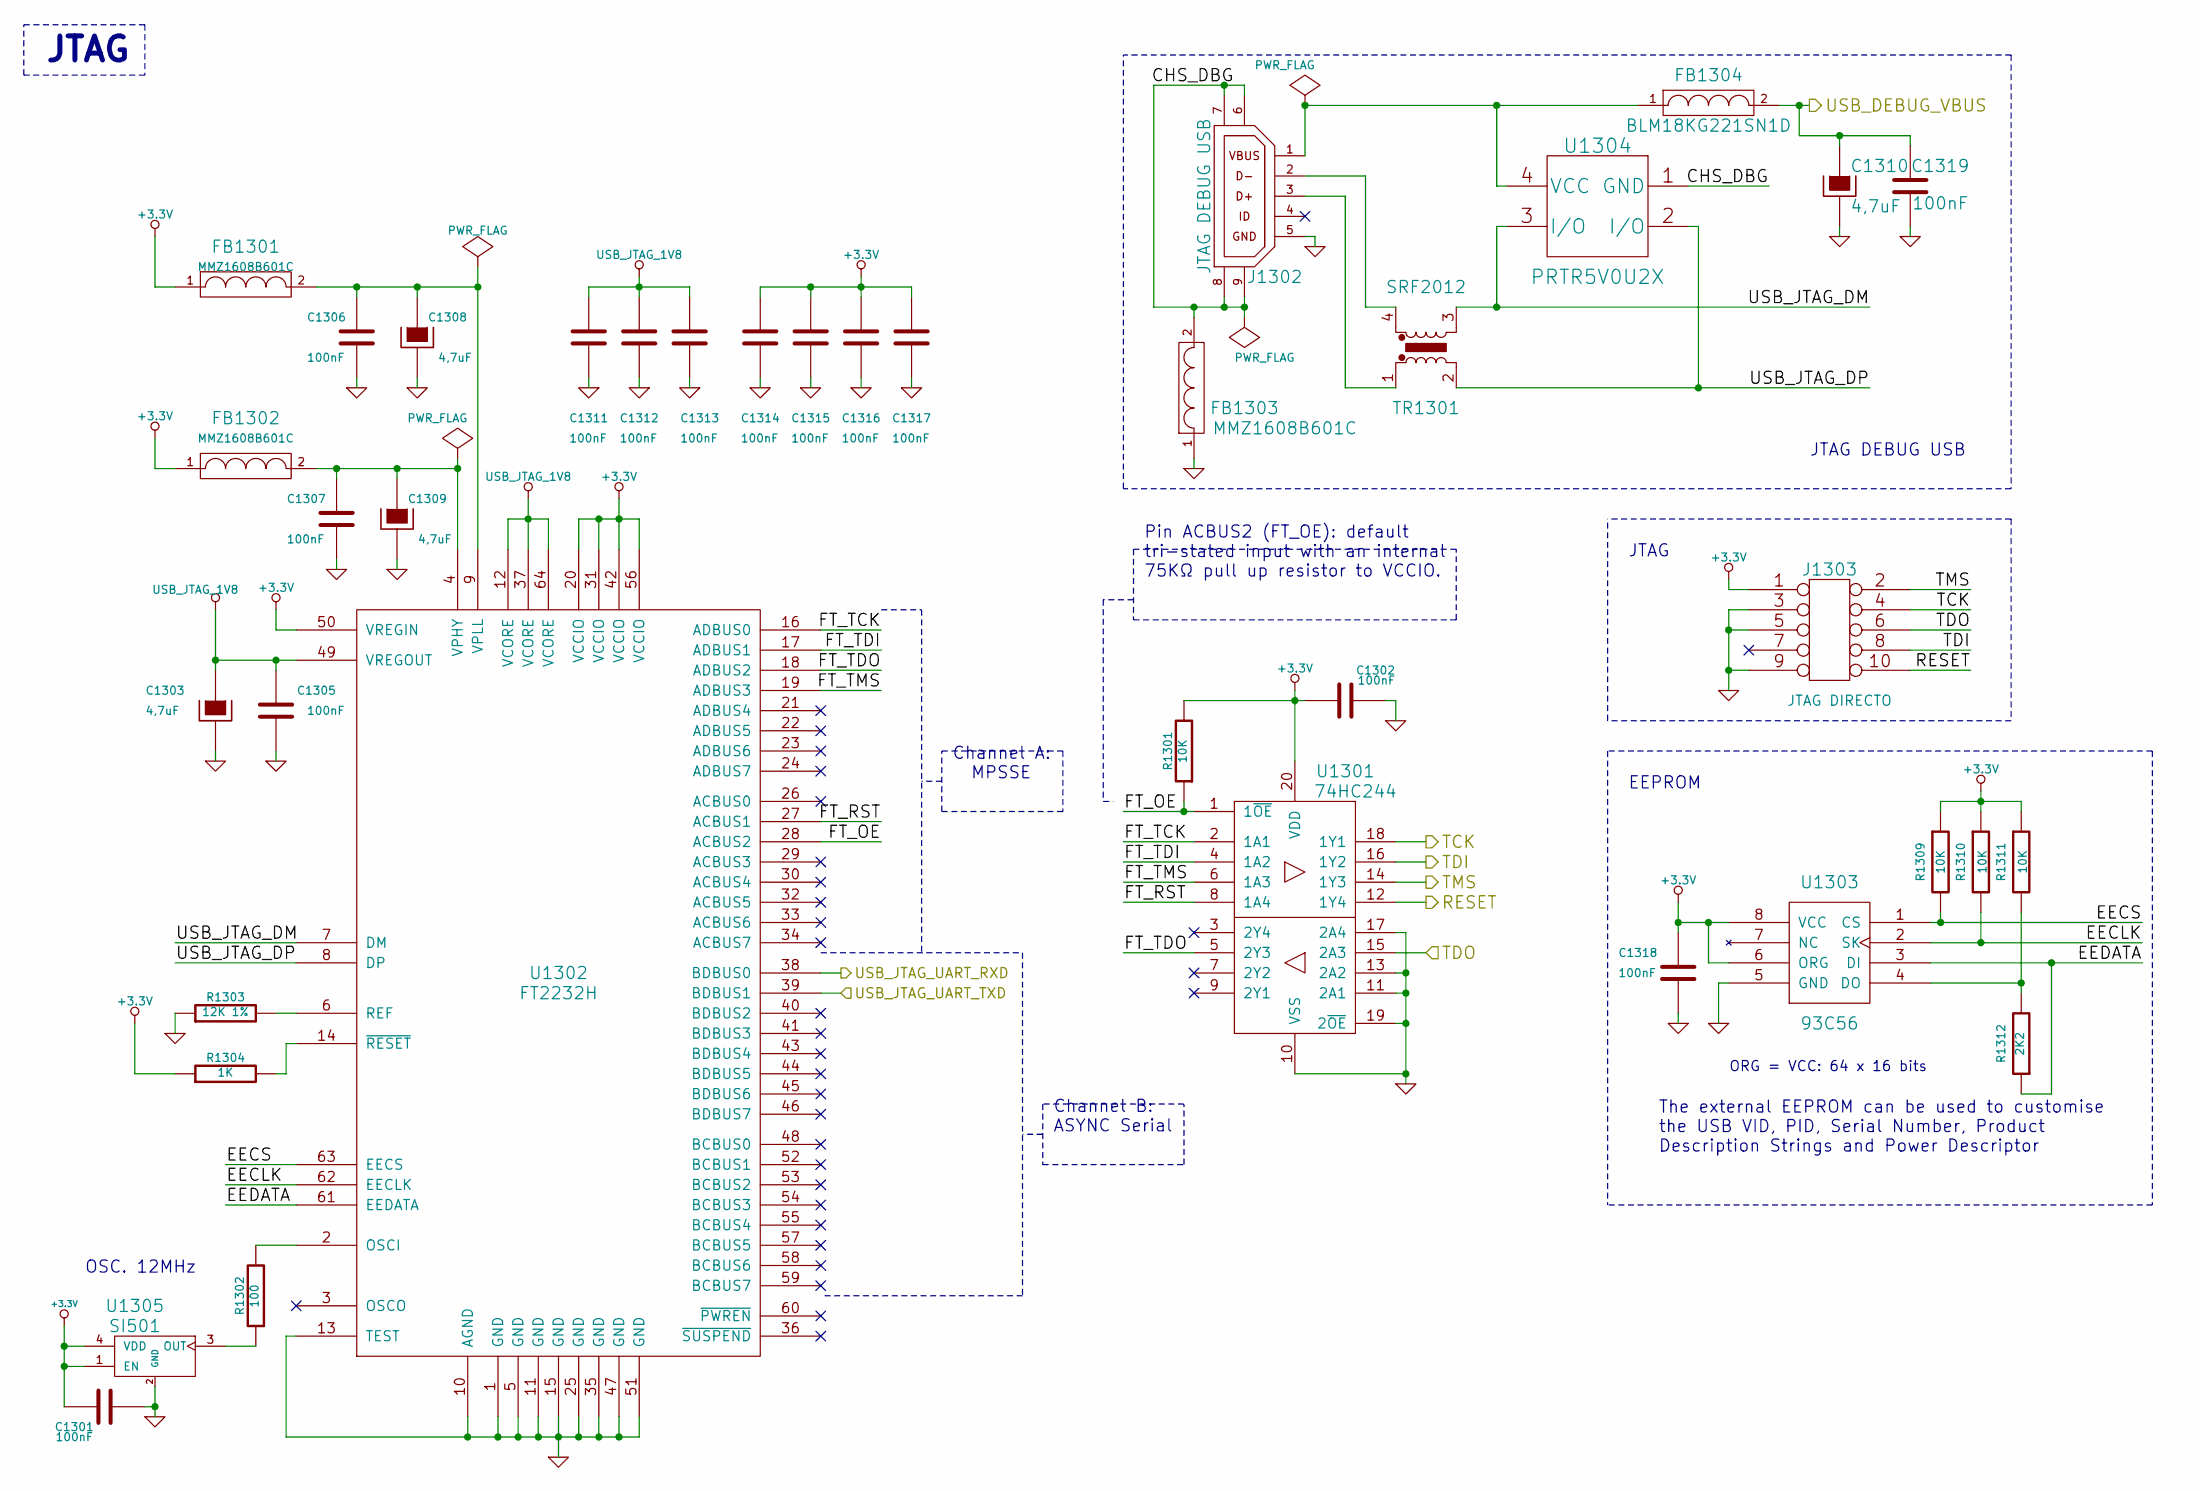
[picture p288: schematic JTAG.sch, Conectores JTAG y DEBUG USB]

Parts:
C1301, C1302, C1305, C1306, C1307, C1311, C1312, C1313, C1314, C1315, C1316, C1317, C1318, C1319: 100nF; c_0603; Digikey/Mouser 399-1096-1-ND
C1303, C1308, C1309, C1310: 4,7uF; c_1206POL; Digikey/Mouser 399-9717-1-ND
FB1301, FB1302, FB1303: MMZ1608B601C; fb_0603; Digikey/Mouser 445-2166-1-ND
FB1304: BLM18KG221SN1D; fb_0603; Digikey/Mouser 490-5255-1-ND
J1302: JTAG DEBUG USB; USB_MicroAB; Digikey/Mouser H11634CT-ND
J1303: JTAG DIRECTO; PIN_ARRAY_5x2_1.27_SMD; Digikey/Mouser 952-1389-ND
R1301, R1309, R1310, R1311: 10K; r_0603; Digikey/Mouser 311-10KGRCT-ND
R1302: 100; r_0603; Digikey/Mouser 311-100GRCT-ND
R1303: 12K 1%; r_0603; Digikey/Mouser 311-12.0KHRCT-ND
R1304: 1K; r_0603; Digikey/Mouser 311-1.0KGRCT-ND
R1312: 2K2; r_0603; Digikey/Mouser 311-2.2KGRCT-ND
TR1301: SRF2012; Digikey/Mouser SRF2012-900YCT-ND
U1301: 74HC244; TSSOP-20; Digikey/Mouser 568-8285-5-ND
U1302: FT2232H; TQFP64; Digikey/Mouser 768-1024-1-ND
U1303: 93C56; SOIC-8; Digikey/Mouser AT93C46DN-SH-B-ND
U1304: PRTR5V0U2X; SOT-143-4; Digikey/Mouser 568-4140-1-ND
U1305: SI501; SI501_C; Digikey/Mouser 336-2889-ND

Connections:
+USB_JTAG_1V8: C1303.1, C1305.1, C1311.1, C1312.1, C1313.1, U1302.12 (VCORE), U1302.37 (VCORE), U1302.49 (VREGOUT), U1302.64 (VCORE)
/CPU/RESET: J1303.10, U1301.12 (1Y4); also elsewhere on the board
/CPU/TCK: J1303.4, U1301.18 (1Y1); also elsewhere on the board
/CPU/TDI: J1303.8, U1301.16 (1Y2); also elsewhere on the board
/CPU/TDO: J1303.6, U1301.15 (2A3); also elsewhere on the board
/CPU/TMS: J1303.2, U1301.14 (1Y3); also elsewhere on the board
/CPU/USB_JTAG_UART_RXD: U1302.38 (BDBUS0); also elsewhere on the board
/CPU/USB_JTAG_UART_TXD: U1302.39 (BDBUS1); also elsewhere on the board
/JTAG/CHS_DBG: FB1303.2, J1302.6 (S2), J1302.7 (S1), J1302.8 (S3), J1302.9 (S4), U1304.1 (GND)
/JTAG/EECLK: R1310.2, U1302.62 (EECLK), U1303.2 (SK)
/JTAG/EECS: R1309.2, U1302.63 (EECS), U1303.1 (CS)
/JTAG/EEDATA: R1312.1, U1302.61 (EEDATA), U1303.3 (DI)
/JTAG/FT_OE: R1301.1, U1301.1 (1~OE), U1302.28 (ACBUS2)
/JTAG/FT_RST: U1301.8 (1A4), U1302.27 (ACBUS1)
/JTAG/FT_TCK: U1301.2 (1A1), U1302.16 (ADBUS0)
/JTAG/FT_TDI: U1301.4 (1A2), U1302.17 (ADBUS1)
/JTAG/FT_TDO: U1301.5 (2Y3), U1302.18 (ADBUS2)
/JTAG/FT_TMS: U1301.6 (1A3), U1302.19 (ADBUS3)
/JTAG/USB_DEBUG_VBUS: C1310.1, C1319.1, FB1304.2; also elsewhere on the board
/JTAG/USB_JTAG_DM: TR1301.3, U1302.7 (DM), U1304.3 (I/O)
/JTAG/USB_JTAG_DP: TR1301.2, U1302.8 (DP), U1304.2 (I/O)
GND: C1301.2, C1302.2, C1303.2, C1305.2, C1306.2, C1307.2, C1308.2, C1309.2, C1310.2, C1311.2, C1312.2, C1313.2, C1314.2, C1315.2, C1316.2, C1317.2, C1318.2, C1319.2, FB1303.1, J1302.5 (GND), J1303.3, J1303.5, J1303.9, R1303.1, U1301.10 (VSS), U1301.11 (2A1), U1301.13 (2A2), U1301.17 (2A4), U1301.19 (2~OE), U1302.1 (GND), U1302.5 (GND), U1302.10 (AGND), U1302.11 (GND), U1302.13 (TEST), U1302.15 (GND), U1302.25 (GND), U1302.35 (GND), U1302.47 (GND), U1302.51 (GND), U1303.5 (GND), U1305.2 (GND); also elsewhere on the board
unnamed: R1311.2, R1312.2, U1303.4 (DO)
unnamed: R1303.2, U1302.6 (REF)
unnamed: R1304.2, U1302.14 (~RESET)
unnamed: C1306.1, C1308.1, FB1301.2, U1302.9 (VPLL)
unnamed: C1307.1, C1309.1, FB1302.2, U1302.4 (VPHY)
unnamed: R1302.1, U1305.3 (OUT)
unnamed: R1302.2, U1302.2 (OSCI)
unnamed: FB1304.1, J1302.1 (VBUS), U1304.4 (VCC)
unnamed: J1302.3 (USB_DP), TR1301.1
unnamed: J1302.2 (USB_DN), TR1301.4

Notes on the sheet:
JTAG
EEPROM
JTAG DEBUG USB
ORG = VCC: 64 x 16 bits
Channel A: MPSSE
Channel B: ASYNC Serial
Pin ACBUS2 (FT_OE): default tri-stated input with an internal 75KΩ pull up resistor to VCCIO.
The external EEPROM can be used to customise the USB VID, PID, Serial Number, Product Description Strings and Power Descriptor
OSC. 12MHz

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
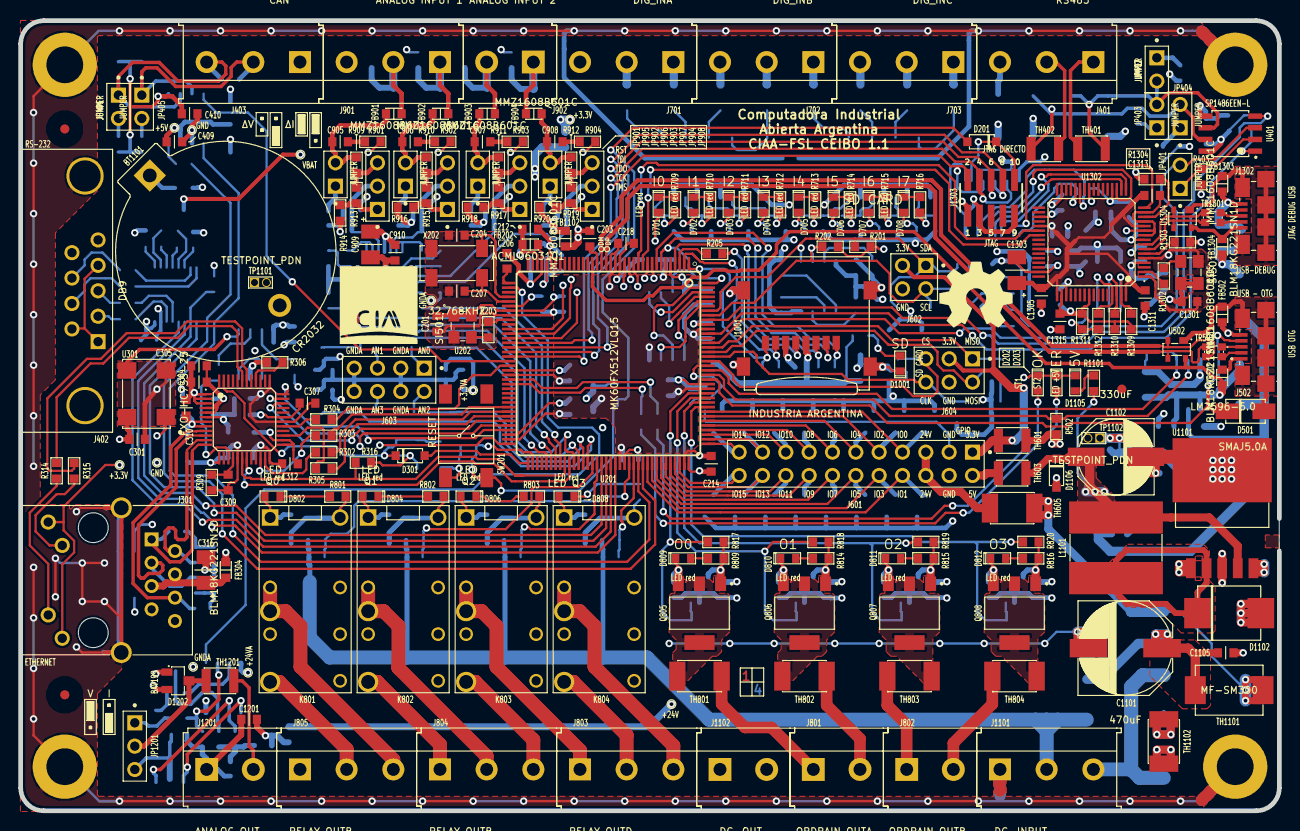
[picture p289: board CIAA_K60.kicad_pcb from above]

Board: 4 copper layers, 137.0 x 86.0 mm, 467 parts (0 on the bottom side), 326 nets.
