ciaa/Hardware/PCB/EDU-INTEL/edk.kicad_pcb

## KiCad design PCB/EDU-INTEL/edk.kicad_pcb (2015-05-10)

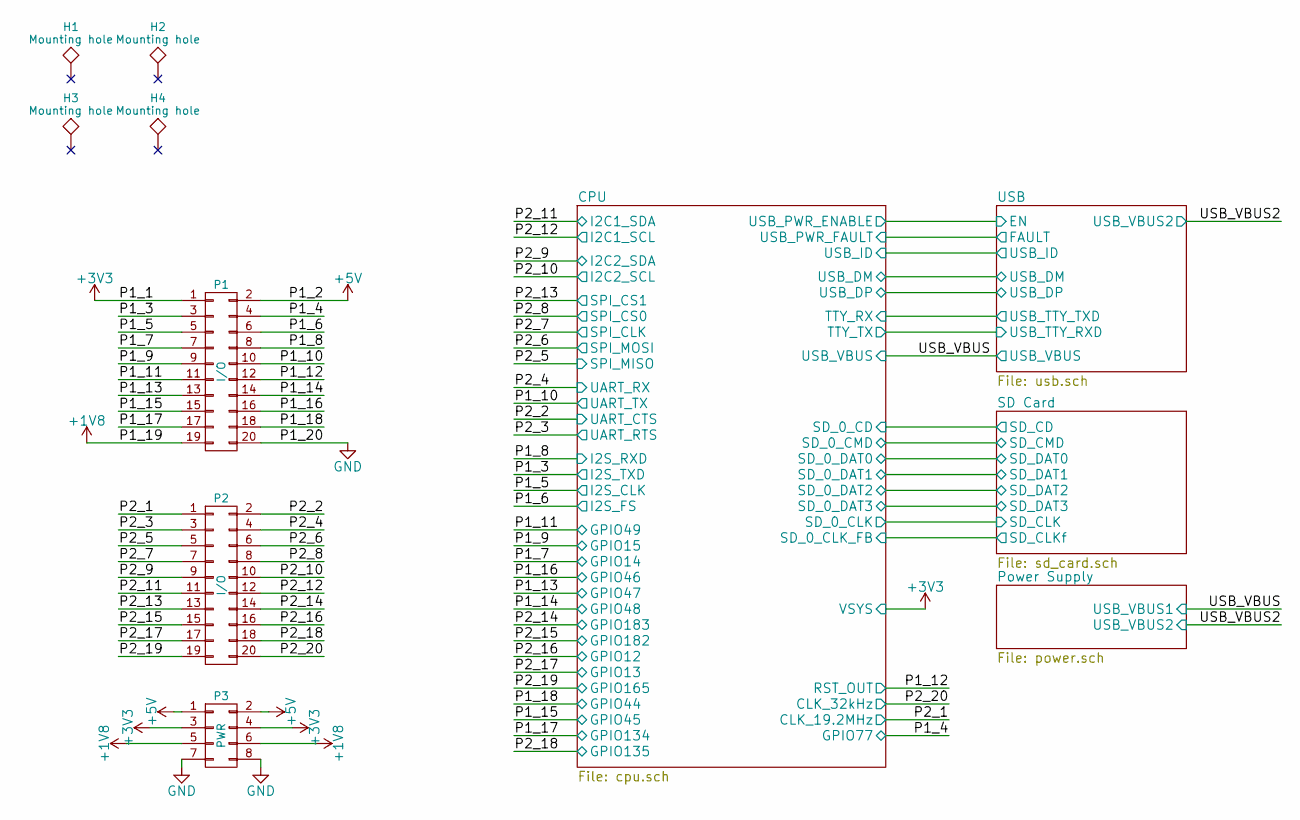
[picture p290: schematic edk.sch, EDU-CIAA-INTEL]

Parts:
H1, H2, H3, H4: Mounting hole; MountingHole_3mm
P1, P2: I/O; Pin_Header_Straight_2x10
P3: PWR; Pin_Header_Straight_2x04

Connections:
+1V8: P1.19, P3.5, P3.6; also elsewhere on the board
+3V3: P1.1, P3.3, P3.4; also elsewhere on the board
+5V: P1.2, P3.1, P3.2; also elsewhere on the board
/CPU/CLK_19.2MHz: P2.1; also elsewhere on the board
/CPU/CLK_32kHz: P2.20; also elsewhere on the board
/CPU/GPIO12: P2.16; also elsewhere on the board
/CPU/GPIO13: P2.17; also elsewhere on the board
/CPU/GPIO14: P1.7; also elsewhere on the board
/CPU/GPIO15: P1.9; also elsewhere on the board
/CPU/GPIO44: P1.18; also elsewhere on the board
/CPU/GPIO45: P1.15; also elsewhere on the board
/CPU/GPIO46: P1.16; also elsewhere on the board
/CPU/GPIO47: P1.13; also elsewhere on the board
/CPU/GPIO48: P1.14; also elsewhere on the board
/CPU/GPIO49: P1.11; also elsewhere on the board
/CPU/GPIO77: P1.4; also elsewhere on the board
/CPU/GPIO134: P1.17; also elsewhere on the board
/CPU/GPIO135: P2.18; also elsewhere on the board
/CPU/GPIO165: P2.19; also elsewhere on the board
/CPU/GPIO182: P2.15; also elsewhere on the board
/CPU/GPIO183: P2.14; also elsewhere on the board
/CPU/I2C1_SCL: P2.12; also elsewhere on the board
/CPU/I2C1_SDA: P2.11; also elsewhere on the board
/CPU/I2C2_SCL: P2.10; also elsewhere on the board
/CPU/I2C2_SDA: P2.9; also elsewhere on the board
/CPU/I2S_CLK: P1.5; also elsewhere on the board
/CPU/I2S_FS: P1.6; also elsewhere on the board
/CPU/I2S_RXD: P1.8; also elsewhere on the board
/CPU/I2S_TXD: P1.3; also elsewhere on the board
/CPU/RST_OUT: P1.12; also elsewhere on the board
/CPU/SPI_CLK: P2.7; also elsewhere on the board
/CPU/SPI_CS0: P2.8; also elsewhere on the board
/CPU/SPI_CS1: P2.13; also elsewhere on the board
/CPU/SPI_MISO: P2.5; also elsewhere on the board
/CPU/SPI_MOSI: P2.6; also elsewhere on the board
/CPU/UART_CTS: P2.2; also elsewhere on the board
/CPU/UART_RTS: P2.3; also elsewhere on the board
/CPU/UART_RX: P2.4; also elsewhere on the board
/CPU/UART_TX: P1.10; also elsewhere on the board
GND: P1.20, P3.7, P3.8; also elsewhere on the board

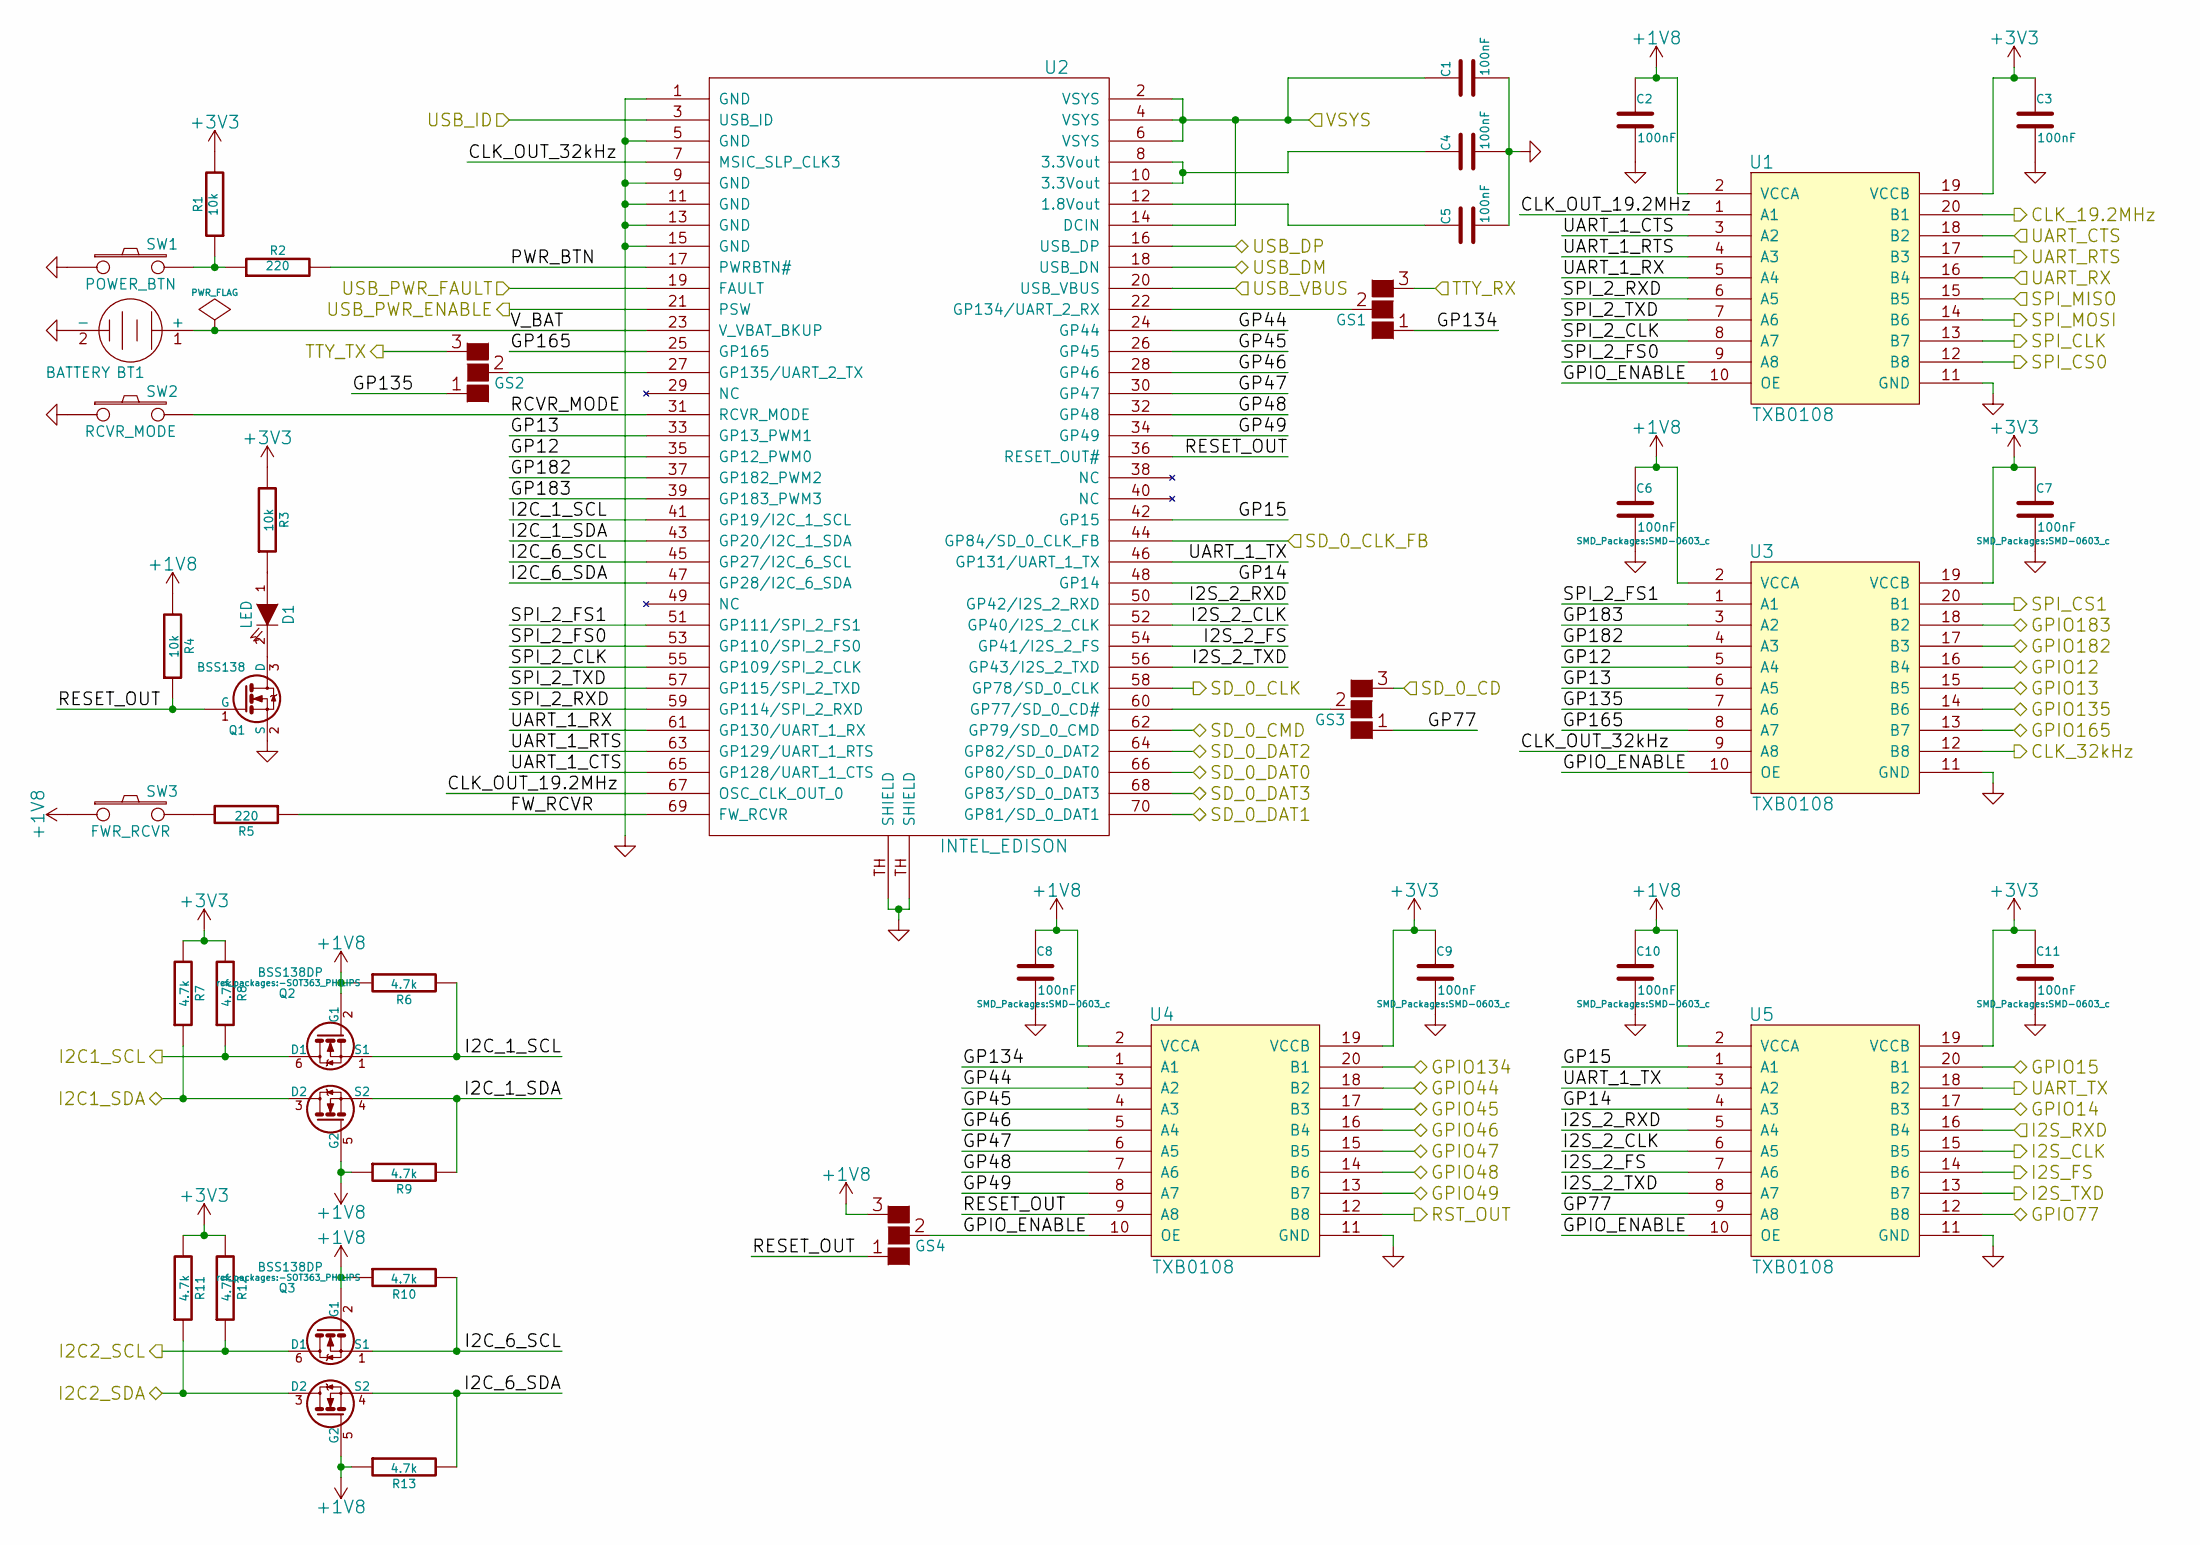
[picture p291: schematic cpu.sch, EDU-CIAA-INTEL]

Parts:
BT1: BATTERY; Pin_Header_Straight_1x02
C1, C2, C3, C4, C5, C6, C7, C8, C9, C10, C11: 100nF; SMD-0603_c
D1: LED; LED-0603
GS1, GS2, GS3, GS4: GS3
Q1: BSS138; SOT-23
Q2, Q3: BSS138DP; -SOT363_PHILIPS
R1, R3, R4: 10k; SMD-0603_r
R2, R5: 220; SMD-0603_r
R6, R7, R8, R9, R10, R11, R12, R13: 4.7k; SMD-0603_r
SW1: POWER_BTN; Pin_Header_Straight_1x02
SW2: RCVR_MODE; Pin_Header_Straight_1x02
SW3: FWR_RCVR; Pin_Header_Straight_1x02
U1, U3, U4, U5: TXB0108; SSOP-20_4.4x6.5mm_Pitch0.65mm
U2: INTEL_EDISON

Connections:
+1V8: C2.1, C6.1, C8.1, C10.1, GS4.3 (G3), Q2.2 (G1), Q2.5 (G2), Q3.2 (G1), Q3.5 (G2), R4.2, R6.1, R9.1, R10.1, R13.1, SW3.1, U1.2 (VCCA), U3.2 (VCCA), U4.2 (VCCA), U5.2 (VCCA); also elsewhere on the board
+3V3: C1.1, C3.1, C7.1, C9.1, C11.1, R1.2, R3.2, R7.2, R8.2, R11.2, R12.2, U1.19 (VCCB), U2.2 (VSYS), U2.4 (VSYS), U2.6 (VSYS), U2.14 (DCIN), U3.19 (VCCB), U4.19 (VCCB), U5.19 (VCCB); also elsewhere on the board
/CPU/CLK_19.2MHz: U1.20 (B1); also elsewhere on the board
/CPU/CLK_32kHz: U3.12 (B8); also elsewhere on the board
/CPU/CLK_OUT_19.2MHz: U1.1 (A1), U2.67 (OSC_CLK_OUT_0)
/CPU/CLK_OUT_32kHz: U2.7 (MSIC_SLP_CLK3), U3.9 (A8)
/CPU/FW_RCVR: R5.1, U2.69 (FW_RCVR)
/CPU/GP12: U2.35 (GP12_PWM0), U3.5 (A4)
/CPU/GP13: U2.33 (GP13_PWM1), U3.6 (A5)
/CPU/GP14: U2.48 (GP14), U5.4 (A3)
/CPU/GP15: U2.42 (GP15), U5.1 (A1)
/CPU/GP44: U2.24 (GP44), U4.3 (A2)
/CPU/GP45: U2.26 (GP45), U4.4 (A3)
/CPU/GP46: U2.28 (GP46), U4.5 (A4)
/CPU/GP47: U2.30 (GP47), U4.6 (A5)
/CPU/GP48: U2.32 (GP48), U4.7 (A6)
/CPU/GP49: U2.34 (GP49), U4.8 (A7)
/CPU/GP77: GS3.1 (G1), U5.9 (A8)
/CPU/GP134: GS1.1 (G1), U4.1 (A1)
/CPU/GP135: GS2.1 (G1), U3.7 (A6)
/CPU/GP165: U2.25 (GP165), U3.8 (A7)
/CPU/GP182: U2.37 (GP182_PWM2), U3.4 (A3)
/CPU/GP183: U2.39 (GP183_PWM3), U3.3 (A2)
/CPU/GPIO12: U3.16 (B4); also elsewhere on the board
/CPU/GPIO13: U3.15 (B5); also elsewhere on the board
/CPU/GPIO14: U5.17 (B3); also elsewhere on the board
/CPU/GPIO15: U5.20 (B1); also elsewhere on the board
/CPU/GPIO44: U4.18 (B2); also elsewhere on the board
/CPU/GPIO45: U4.17 (B3); also elsewhere on the board
/CPU/GPIO46: U4.16 (B4); also elsewhere on the board
/CPU/GPIO47: U4.15 (B5); also elsewhere on the board
/CPU/GPIO48: U4.14 (B6); also elsewhere on the board
/CPU/GPIO49: U4.13 (B7); also elsewhere on the board
/CPU/GPIO77: U5.12 (B8); also elsewhere on the board
/CPU/GPIO134: U4.20 (B1); also elsewhere on the board
/CPU/GPIO135: U3.14 (B6); also elsewhere on the board
/CPU/GPIO165: U3.13 (B7); also elsewhere on the board
/CPU/GPIO182: U3.17 (B3); also elsewhere on the board
/CPU/GPIO183: U3.18 (B2); also elsewhere on the board
/CPU/GPIO_ENABLE: GS4.2 (G2), U1.10 (OE), U3.10 (OE), U4.10 (OE), U5.10 (OE)
/CPU/I2C1_SCL: Q2.6 (D1), R8.1; also elsewhere on the board
/CPU/I2C1_SDA: Q2.3 (D2), R7.1; also elsewhere on the board
/CPU/I2C2_SCL: Q3.6 (D1), R12.1; also elsewhere on the board
/CPU/I2C2_SDA: Q3.3 (D2), R11.1; also elsewhere on the board
/CPU/I2C_1_SCL: Q2.1 (S1), R6.2, U2.41 (GP19/I2C_1_SCL)
/CPU/I2C_1_SDA: Q2.4 (S2), R9.2, U2.43 (GP20/I2C_1_SDA)
/CPU/I2C_6_SCL: Q3.1 (S1), R10.2, U2.45 (GP27/I2C_6_SCL)
/CPU/I2C_6_SDA: Q3.4 (S2), R13.2, U2.47 (GP28/I2C_6_SDA)
/CPU/I2S_2_CLK: U2.52 (GP40/I2S_2_CLK), U5.6 (A5)
/CPU/I2S_2_FS: U2.54 (GP41/I2S_2_FS), U5.7 (A6)
/CPU/I2S_2_RXD: U2.50 (GP42/I2S_2_RXD), U5.5 (A4)
/CPU/I2S_2_TXD: U2.56 (GP43/I2S_2_TXD), U5.8 (A7)
/CPU/I2S_CLK: U5.15 (B5); also elsewhere on the board
/CPU/I2S_FS: U5.14 (B6); also elsewhere on the board
/CPU/I2S_RXD: U5.16 (B4); also elsewhere on the board
/CPU/I2S_TXD: U5.13 (B7); also elsewhere on the board
/CPU/PWR_BTN: R2.2, U2.17 (PWRBTN#)
/CPU/RCVR_MODE: SW2.2, U2.31 (RCVR_MODE)
/CPU/RESET_OUT: GS4.1 (G1), Q1.1 (G), R4.1, U2.36 (RESET_OUT#), U4.9 (A8)
/CPU/RST_OUT: U4.12 (B8); also elsewhere on the board
/CPU/SD_0_CD: GS3.3 (G3); also elsewhere on the board
/CPU/SD_0_CLK: U2.58 (GP78/SD_0_CLK); also elsewhere on the board
/CPU/SD_0_CLK_FB: U2.44 (GP84/SD_0_CLK_FB); also elsewhere on the board
/CPU/SD_0_CMD: U2.62 (GP79/SD_0_CMD); also elsewhere on the board
/CPU/SD_0_DAT0: U2.66 (GP80/SD_0_DAT0); also elsewhere on the board
/CPU/SD_0_DAT1: U2.70 (GP81/SD_0_DAT1); also elsewhere on the board
/CPU/SD_0_DAT2: U2.64 (GP82/SD_0_DAT2); also elsewhere on the board
/CPU/SD_0_DAT3: U2.68 (GP83/SD_0_DAT3); also elsewhere on the board
/CPU/SPI_2_CLK: U1.8 (A7), U2.55 (GP109/SPI_2_CLK)
/CPU/SPI_2_FS0: U1.9 (A8), U2.53 (GP110/SPI_2_FS0)
/CPU/SPI_2_FS1: U2.51 (GP111/SPI_2_FS1), U3.1 (A1)
/CPU/SPI_2_RXD: U1.6 (A5), U2.59 (GP114/SPI_2_RXD)
/CPU/SPI_2_TXD: U1.7 (A6), U2.57 (GP115/SPI_2_TXD)
/CPU/SPI_CLK: U1.13 (B7); also elsewhere on the board
/CPU/SPI_CS0: U1.12 (B8); also elsewhere on the board
/CPU/SPI_CS1: U3.20 (B1); also elsewhere on the board
/CPU/SPI_MISO: U1.15 (B5); also elsewhere on the board
/CPU/SPI_MOSI: U1.14 (B6); also elsewhere on the board
/CPU/TTY_RX: GS1.3 (G3); also elsewhere on the board
/CPU/TTY_TX: GS2.3 (G3); also elsewhere on the board
/CPU/UART_1_CTS: U1.3 (A2), U2.65 (GP128/UART_1_CTS)
/CPU/UART_1_RTS: U1.4 (A3), U2.63 (GP129/UART_1_RTS)
/CPU/UART_1_RX: U1.5 (A4), U2.61 (GP130/UART_1_RX)
/CPU/UART_1_TX: U2.46 (GP131/UART_1_TX), U5.3 (A2)
/CPU/UART_CTS: U1.18 (B2); also elsewhere on the board
/CPU/UART_RTS: U1.17 (B3); also elsewhere on the board
/CPU/UART_RX: U1.16 (B4); also elsewhere on the board
/CPU/UART_TX: U5.18 (B2); also elsewhere on the board
/CPU/USB_DM: U2.18 (USB_DN); also elsewhere on the board
/CPU/USB_DP: U2.16 (USB_DP); also elsewhere on the board
/CPU/USB_ID: U2.3 (USB_ID); also elsewhere on the board
/CPU/USB_VBUS: U2.20 (USB_VBUS); also elsewhere on the board
/CPU/V_BAT: BT1.1 (+), U2.23 (V_VBAT_BKUP)
/USB/EN: U2.21 (PSW); also elsewhere on the board
/USB/FAULT: U2.19 (FAULT); also elsewhere on the board
GND: BT1.2 (-), C1.2, C2.2, C3.2, C4.2, C5.2, C6.2, C7.2, C8.2, C9.2, C10.2, C11.2, Q1.2 (S), SW1.1, SW2.1, U1.11 (GND), U2.1 (GND), U2.5 (GND), U2.9 (GND), U2.11 (GND), U2.13 (GND), U2.15 (GND), U2.TH (SHIELD), U3.11 (GND), U4.11 (GND), U5.11 (GND); also elsewhere on the board
unnamed: C4.1, U2.8 (3.3Vout), U2.10 (3.3Vout)
unnamed: C5.1, U2.12 (1.8Vout)
unnamed: D1.1 (A), R3.1
unnamed: D1.2 (K), Q1.3 (D)
unnamed: GS1.2 (G2), U2.22 (GP134/UART_2_RX)
unnamed: GS2.2 (G2), U2.27 (GP135/UART_2_TX)
unnamed: GS3.2 (G2), U2.60 (GP77/SD_0_CD#)
unnamed: R1.1, R2.1, SW1.2
unnamed: R5.2, SW3.2

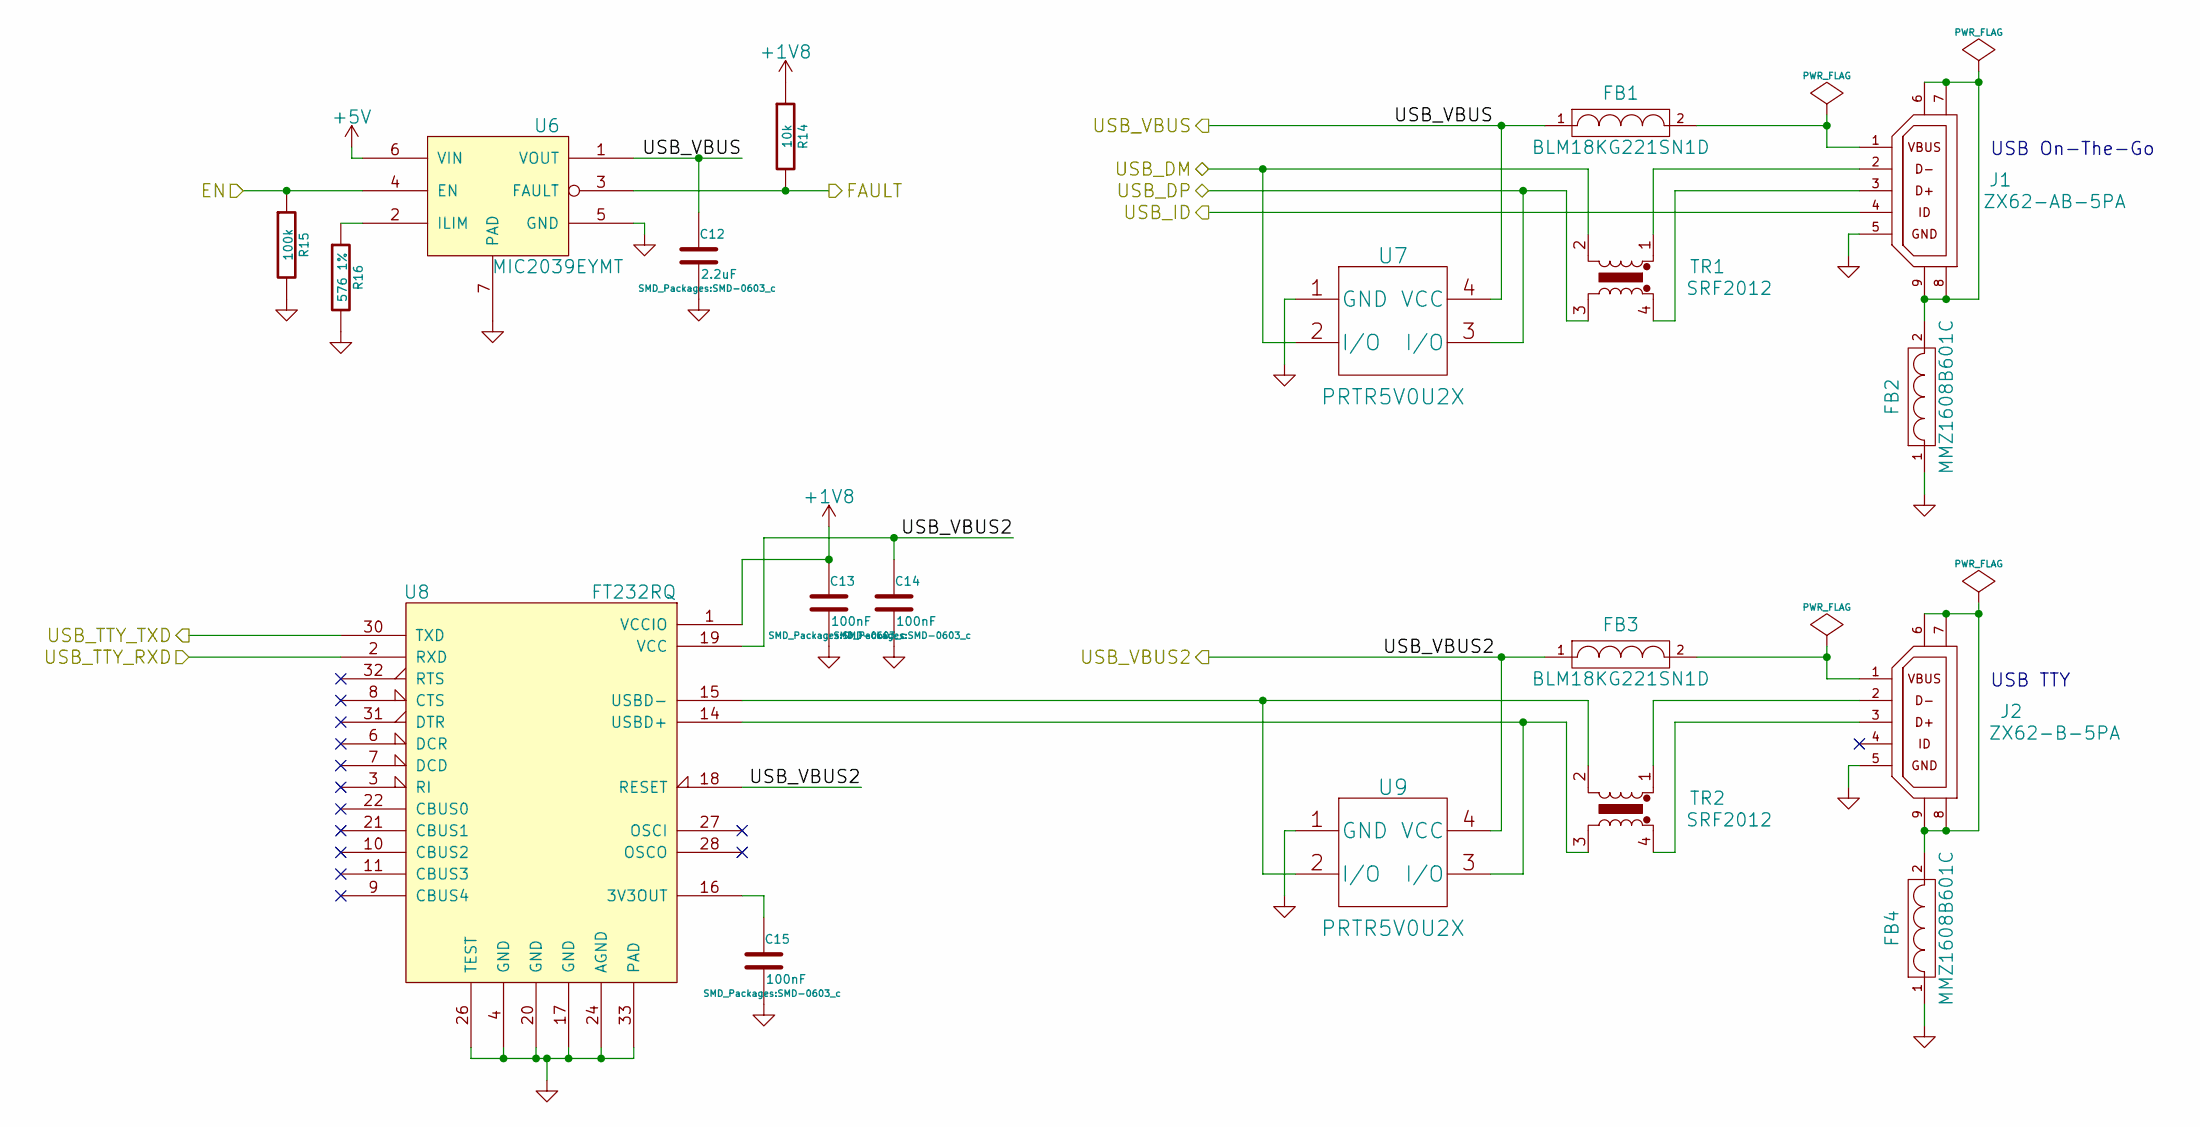
[picture p292: schematic usb.sch, EDU-CIAA-INTEL]

Parts:
C12: 2.2uF; SMD-0603_c
C13, C14, C15: 100nF; SMD-0603_c
FB1, FB3: BLM18KG221SN1D; SMD-0603
FB2, FB4: MMZ1608B601C; SMD-0603
J1: ZX62-AB-5PA; USB_microAB_ZX62-AB&B-5PA-11
J2: ZX62-B-5PA; USB_microAB_ZX62-AB&B-5PA-11
R14: 10k; SMD-0603_r
R15: 100k; SMD-0603_r
R16: 576 1%; SMD-0603_r
TR1, TR2: SRF2012
U6: MIC2039EYMT; DFN6_2x2mm_0.65Pitch
U7, U9: PRTR5V0U2X; SOT-143B
U8: FT232RQ; QFN-32-1EP

Connections:
+1V8: C13.1, R14.1, U8.1 (VCCIO); also elsewhere on the board
+5V: U6.6 (VIN); also elsewhere on the board
/CPU/TTY_RX: U8.30 (TXD); also elsewhere on the board
/CPU/TTY_TX: U8.2 (RXD); also elsewhere on the board
/CPU/USB_DM: TR1.2, U7.2 (I/O); also elsewhere on the board
/CPU/USB_DP: TR1.3, U7.3 (I/O); also elsewhere on the board
/CPU/USB_ID: J1.4 (USB_ID); also elsewhere on the board
/CPU/USB_VBUS: C12.1, FB1.1, U6.1 (VOUT), U7.4 (VCC); also elsewhere on the board
/Power Supply/USB_VBUS2: C14.1, FB3.1, U8.18 (RESET), U8.19 (VCC), U9.4 (VCC); also elsewhere on the board
/USB/EN: R15.1, U6.4 (EN); also elsewhere on the board
/USB/FAULT: R14.2, U6.3 (FAULT); also elsewhere on the board
GND: C12.2, C13.2, C14.2, C15.2, FB2.1, FB4.1, J1.5 (GND), J2.5 (GND), R15.2, R16.2, U6.5 (GND), U6.7 (PAD), U7.1 (GND), U8.4 (GND), U8.17 (GND), U8.20 (GND), U8.24 (AGND), U8.26 (TEST), U8.33 (PAD), U9.1 (GND); also elsewhere on the board
unnamed: C15.1, U8.16 (3V3OUT)
unnamed: FB1.2, J1.1 (VBUS)
unnamed: FB2.2, J1.6 (S2), J1.7 (S1), J1.8 (S3), J1.9 (S4)
unnamed: FB3.2, J2.1 (VBUS)
unnamed: FB4.2, J2.6 (S2), J2.7 (S1), J2.8 (S3), J2.9 (S4)
unnamed: J1.2 (USB_DN), TR1.1
unnamed: J1.3 (USB_DP), TR1.4
unnamed: J2.2 (USB_DN), TR2.1
unnamed: J2.3 (USB_DP), TR2.4
unnamed: R16.1, U6.2 (ILIM)
unnamed: TR2.2, U8.15 (USBD-), U9.2 (I/O)
unnamed: TR2.3, U8.14 (USBD+), U9.3 (I/O)

Notes on the sheet:
USB On-The-Go
USB TTY

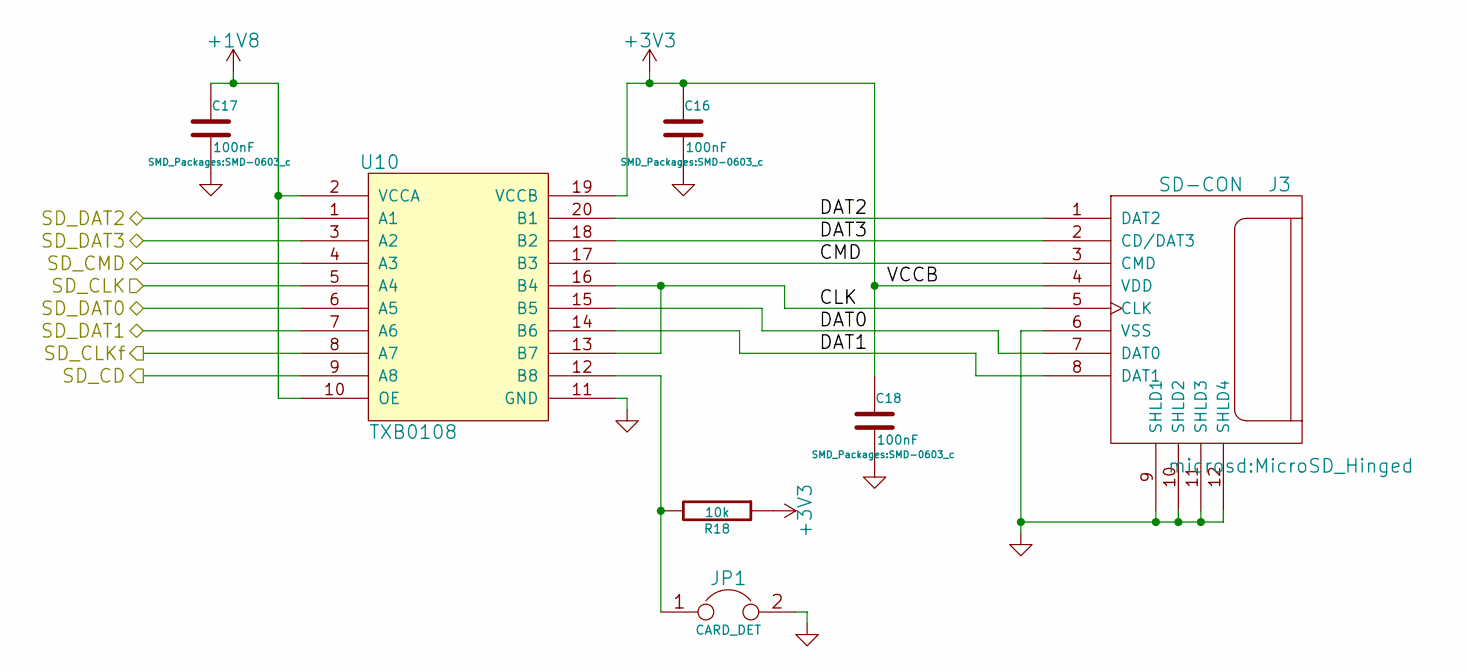
[picture p293: schematic sd_card.sch, EDU-CIAA-INTEL]

Parts:
C16, C17, C18: 100nF; SMD-0603_c
J3: SD-CON; MicroSD_Hinged
JP1: CARD_DET; Pin_Header_Straight_1x02
R18: 10k; SMD-0603_r
U10: TXB0108; SSOP-20_4.4x6.5mm_Pitch0.65mm

Connections:
+1V8: C17.1, U10.2 (VCCA), U10.10 (OE); also elsewhere on the board
+3V3: C16.1, C18.1, J3.4 (VDD), R18.1, U10.19 (VCCB); also elsewhere on the board
/CPU/SD_0_CD: U10.9 (A8); also elsewhere on the board
/CPU/SD_0_CLK: U10.5 (A4); also elsewhere on the board
/CPU/SD_0_CLK_FB: U10.8 (A7); also elsewhere on the board
/CPU/SD_0_CMD: U10.4 (A3); also elsewhere on the board
/CPU/SD_0_DAT0: U10.6 (A5); also elsewhere on the board
/CPU/SD_0_DAT1: U10.7 (A6); also elsewhere on the board
/CPU/SD_0_DAT2: U10.1 (A1); also elsewhere on the board
/CPU/SD_0_DAT3: U10.3 (A2); also elsewhere on the board
/SD Card/CLK: J3.5 (CLK), U10.13 (B7), U10.16 (B4)
/SD Card/CMD: J3.3 (CMD), U10.17 (B3)
/SD Card/DAT0: J3.7 (DAT0), U10.15 (B5)
/SD Card/DAT1: J3.8 (DAT1), U10.14 (B6)
/SD Card/DAT2: J3.1 (DAT2), U10.20 (B1)
/SD Card/DAT3: J3.2 (CD/DAT3), U10.18 (B2)
GND: C16.2, C17.2, C18.2, J3.6 (VSS), J3.9 (SHLD1), J3.10 (SHLD2), J3.11 (SHLD3), J3.12 (SHLD4), JP1.2, U10.11 (GND); also elsewhere on the board
unnamed: JP1.1, R18.2, U10.12 (B8)
