ciaa/Hardware/PCB/EDU-INTEL/edk.kicad_pcb

## KiCad design PCB/EDU-INTEL/edk.kicad_pcb (continued)

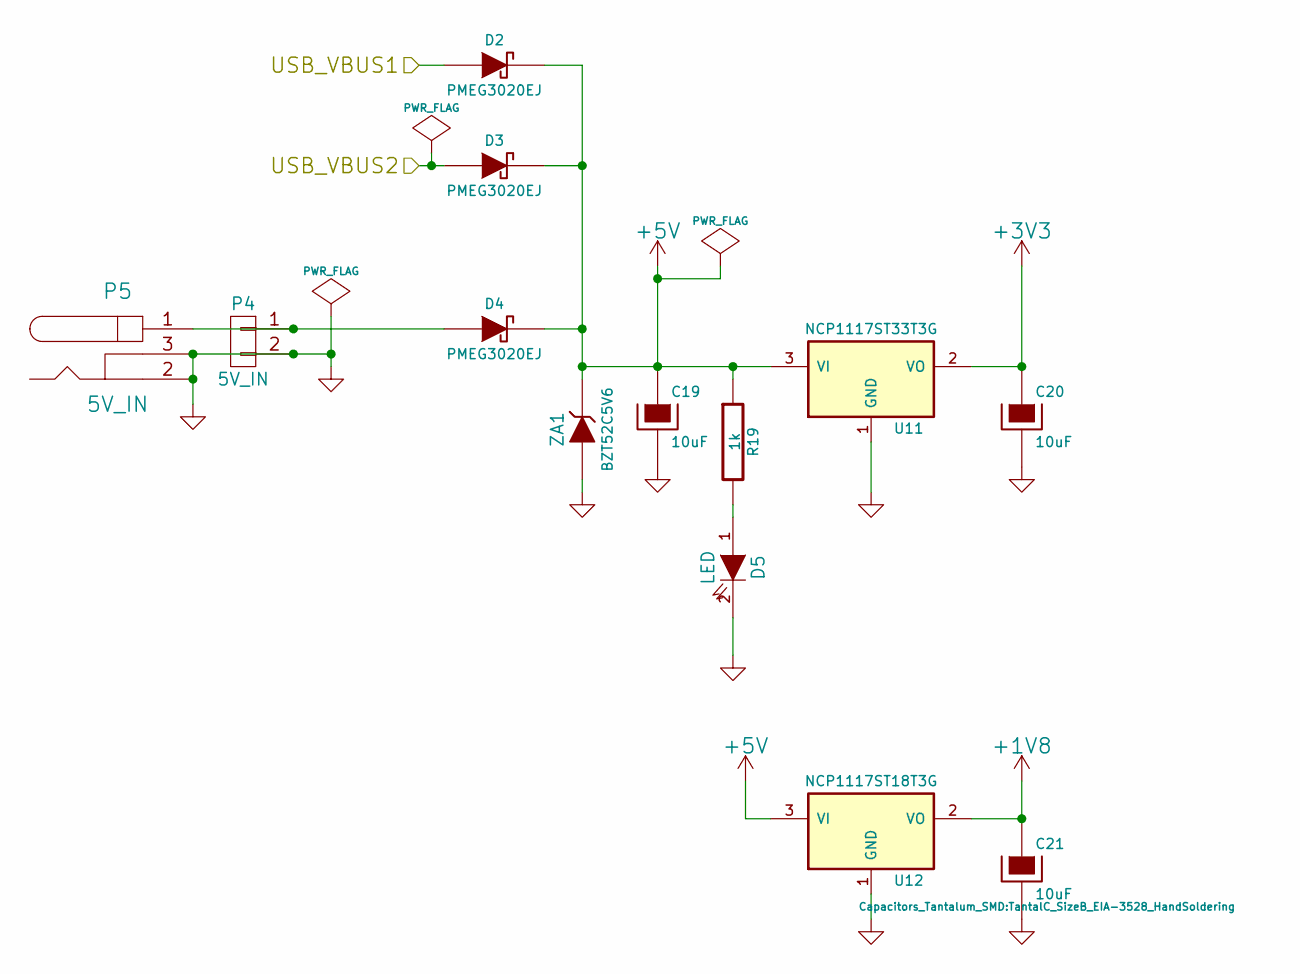
[picture p294: schematic power.sch, EDU-CIAA-INTEL]

Parts:
C19, C20, C21: 10uF; TantalC_SizeB_EIA-3528_HandSoldering
D2, D3, D4: PMEG3020EJ; SOD323
D5: LED; LED-0603
P4: 5V_IN; Pin_Header_Straight_1x02
P5: 5V_IN; BARREL_JACK
R19: 1k; SMD-0603_r
U11: NCP1117ST33T3G; SOT-223
U12: NCP1117ST18T3G; SOT-223
ZA1: BZT52C5V6; SOD123_INV

Connections:
+1V8: C21.1, U12.2 (VO); also elsewhere on the board
+3V3: C20.1, U11.2 (VO); also elsewhere on the board
+5V: C19.1, D2.2 (K), D3.2 (K), D4.2 (K), R19.1, U11.3 (VI), U12.3 (VI), ZA1.2 (K); also elsewhere on the board
/CPU/USB_VBUS: D2.1 (A); also elsewhere on the board
/Power Supply/USB_VBUS2: D3.1 (A); also elsewhere on the board
GND: C19.2, C20.2, C21.2, D5.2 (K), P4.2, P5.2, P5.3, U11.1 (GND), U12.1 (GND), ZA1.1 (A); also elsewhere on the board
unnamed: D4.1 (A), P4.1, P5.1
unnamed: D5.1 (A), R19.2

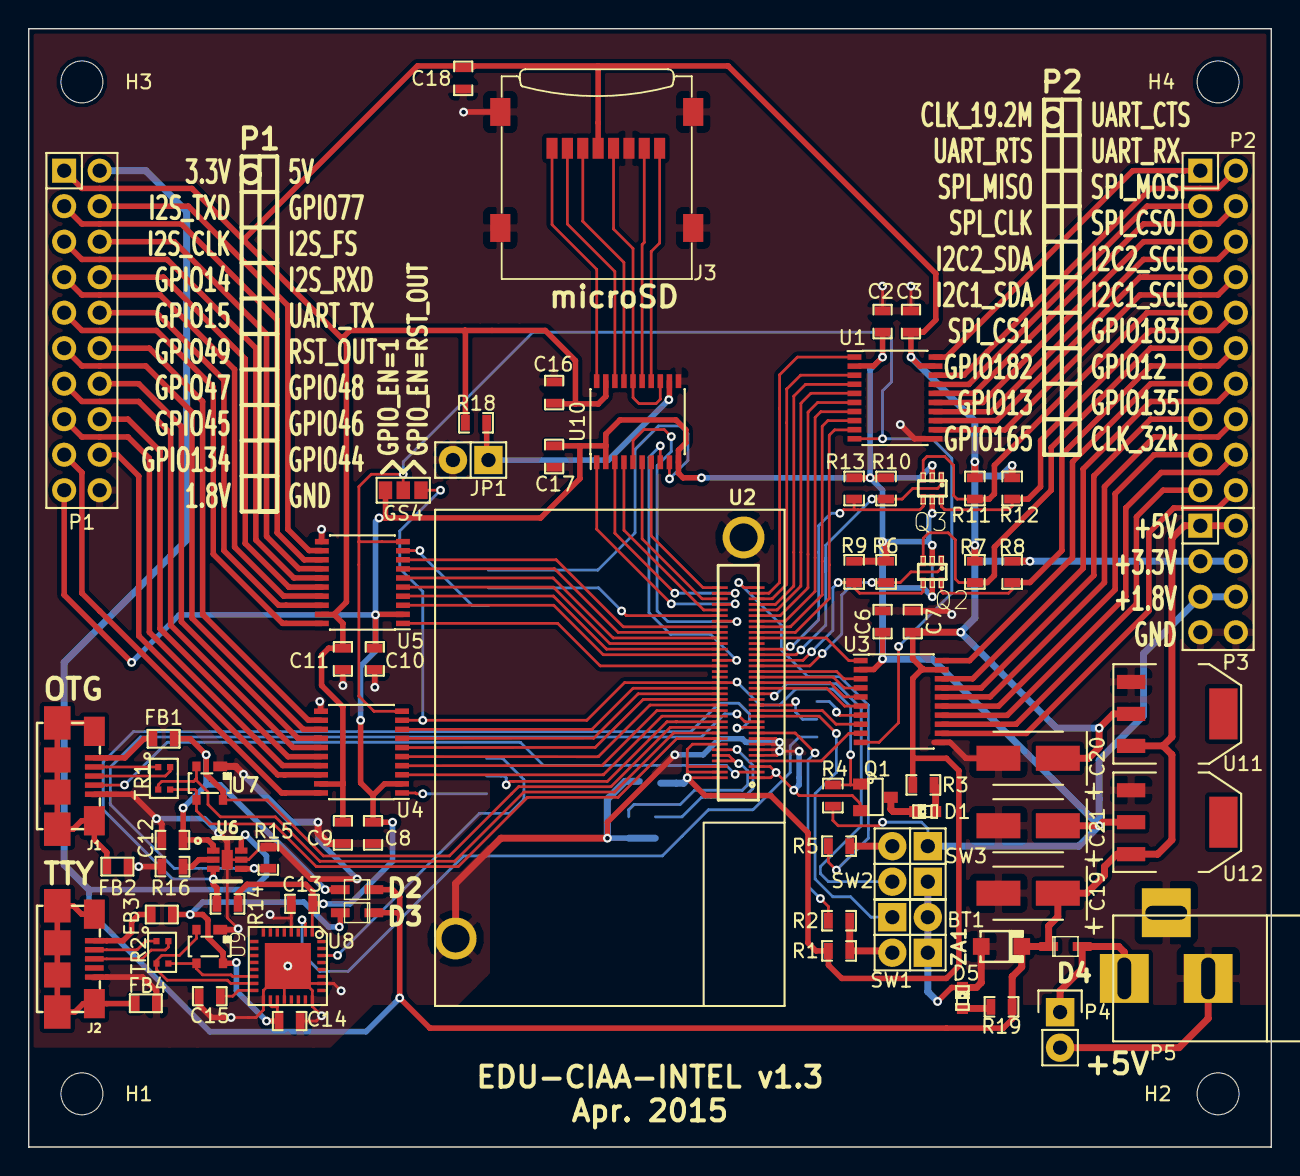
[picture p295: board edk.kicad_pcb from above]

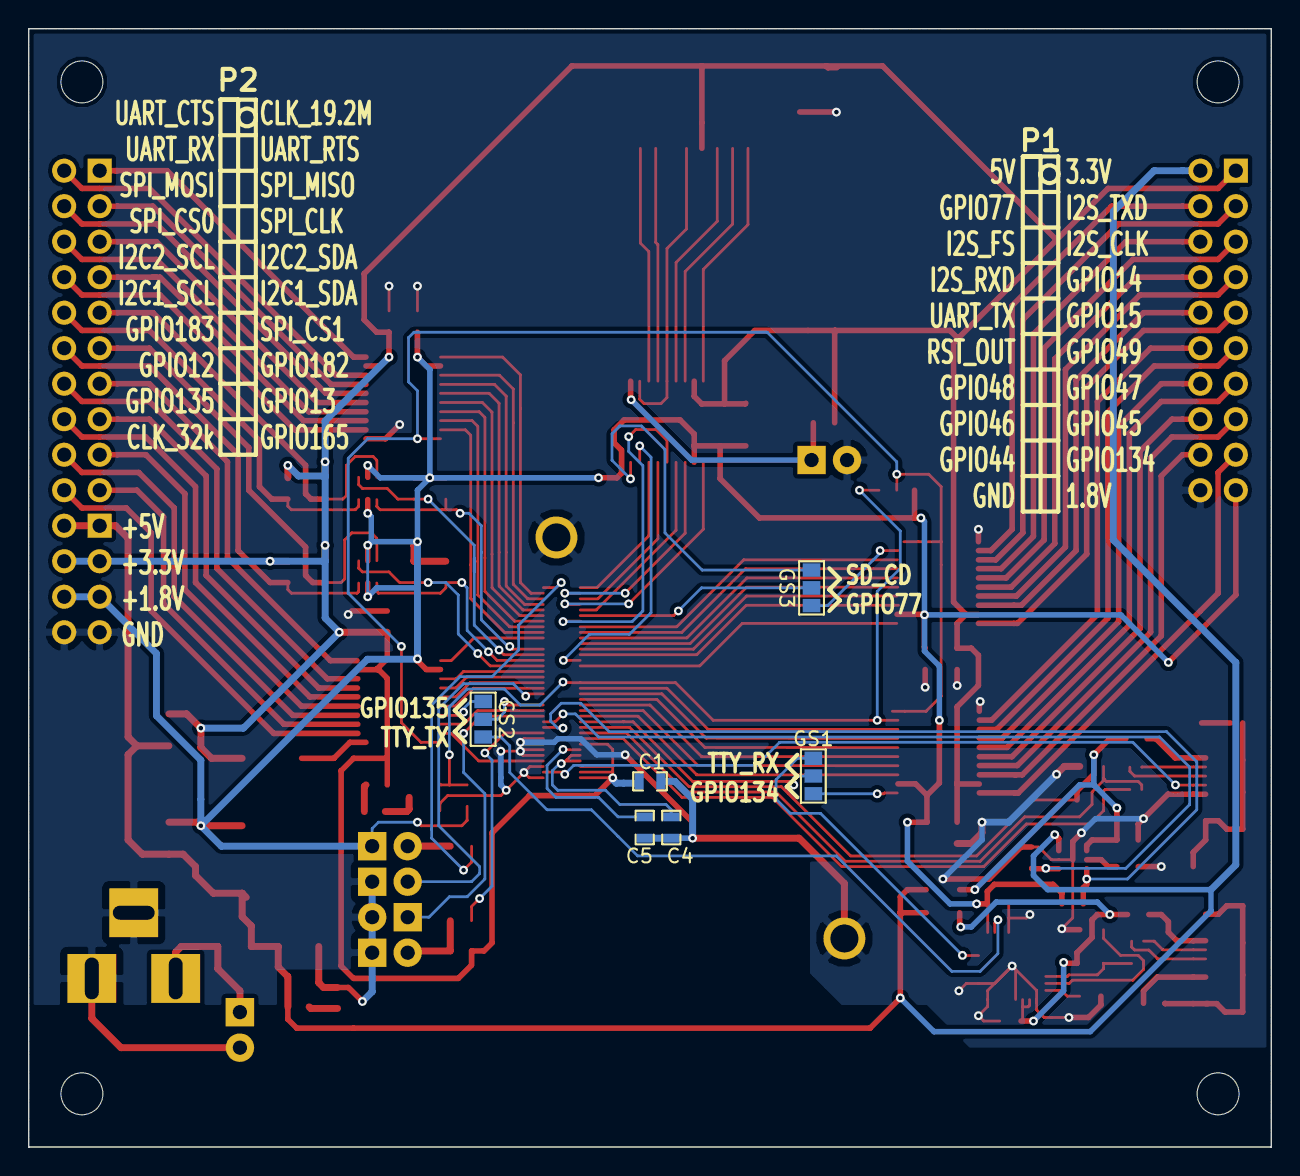
[picture p296: board edk.kicad_pcb from below]

Board: 2 copper layers, 88.9 x 80.0 mm, 87 parts (6 on the bottom side), 128 nets.
