ciaa/Hardware/PCB/ACC/CIAA_ACC/BANKS_HP.sch

## KiCad design PCB/ACC/CIAA_ACC/BANKS_HP.sch (2019-08-28)

Schematic: BANKS_HP.sch

Parts:
C266: 100nF; c_0201; Digikey# 490-5405-1-ND
J5: FMC_HPC; ASP-134486-01
R152: 1K; r_0402; Digikey# 311-1.0KJRCT-ND
R153: 100; r_0402; Digikey# 311-100LRCT-ND
U1: XC7Z030-2FBG676I; FBG676; Digikey# XC7Z030-2FBG676I-ND
U49: DSC1123DL5-200.0000; DSC1123D; Digikey# DSC1123DL5-200.0000-ND

Notes on the sheet:
PUCD: PUDC_B must be tied either directly (or through a 1KΩ or less resistor) to VCCO_34 or GND. Do not allow this pin to float before and during configuration.
FMC CC Type
SYSCLK: 200 MHz LVDS
FMC HB / FMC HA
