ciaa/Hardware/PCB/ACC/CIAA_ACC/BANKS_HR.sch

## KiCad design PCB/ACC/CIAA_ACC/BANKS_HR.sch (2019-08-28)

Schematic: BANKS_HR.sch

Parts:
C267, C268: 100nF; c_0201; Digikey# 490-5405-1-ND
DS12: OK; LED-0603; Digikey# 1080-1399-1-ND
DS13: ERR; LED-0603; Digikey# 1080-1400-1-ND
J5: FMC_HPC; ASP-134486-01
Q3, Q4: BSS806N; SOT-23; Digikey# BSS806N H6327CT-ND
R154: 220; r_0402; Digikey# 311-220JRCT-ND
R155: 330; r_0402; Digikey# 311-330JRCT-ND
U1: XC7Z030-2FBG676I; FBG676; Digikey# XC7Z030-2FBG676I-ND

Notes on the sheet:
LADO DERECHO LPC LADO IZQUIERDO HPC
FMC CC Type
FMC LA / FPGA BANKS 12, 13
