ciaa/Hardware/PCB/ACC/CIAA_ACC/BANK_0.sch

## KiCad design PCB/ACC/CIAA_ACC/BANK_0.sch (2019-08-28)

Schematic: BANK_0.sch

Parts:
C119: 10uF; c_0402; Digikey# 490-13233-1-ND
C128, C130: 100nF; c_0201; Digikey# 490-5405-1-ND
C129, C131: 100nF; c_0402; Digikey# 311-1336-1-ND
D2: 1N4148; SOD-323; Digikey# 1N4148WXTPMSCT-ND
DS2: ERR; LED-0603; Digikey# 1080-1400-1-ND
DS3: OK; LED-0603; Digikey# 1080-1399-1-ND
DS4: DONE; LED-0603; Digikey# 1080-1401-1-ND
DS5: CONNECTED; LED-0603; Digikey# 1080-1399-1-ND
DS6: RUNNING; LED-0603; Digikey# 1080-1401-1-ND
FB3: BLM15PX221SN1D; l_0402; Digikey# 490-11021-1-ND
FB4: MMZ1608B601CTAH0; l_0603; Digikey# 445-2166-1-ND
J5: FMC_HPC; ASP-134486-01
J6: JTAG DIRECT; PIN_ARRAY_5x2_1.27_SMD; Digikey# 952-1389-ND
J8: USB Micro B; ZX62-AB-5PA; Digikey# H125270CT-ND
J20: CJS-1200TA; Digikey# 563-1021-1-ND
JP3: JUMPER; Pin_Header_Straight_1x02; Digikey# WM50016-02-ND
Q1: DMP3099L; SOT-23; Digikey# DMP3099L-7DICT-ND
R79, R80, R92: 4.7K; r_0402; Digikey# 311-4.7KJRCT-ND
R87: 2K2; r_0402; Digikey# 311-2.2KJRCT-ND
R88: 3K3; r_0402; Digikey# 311-3.3KJRCT-ND
R89: 1.5K; r_0402; Digikey# 311-1.5KJRCT-ND
R90, R91, R95, R97: 33; r_0402; Digikey# 311-33JRCT-ND
R93: 330; r_0402; Digikey# 311-330JRCT-ND
R94, R96: 220; r_0402; Digikey# 311-220JRCT-ND
SW1: PROG_B; TACT_SMD_4.5X4.5; Digikey# 732-7003-1-ND
TR1: SRF2012; Digikey# SRF2012-900YCT-ND
U1: XC7Z030-2FBG676I; FBG676; Digikey# XC7Z030-2FBG676I-ND
U17: LPC11U35FHI33; LPC11U35; Digikey# 568-9586-ND
U18: 74AVC2T45; MSOP-8; Digikey# 568-8845-1-ND
U19: CM1213A; SOT-143; Digikey# CM1213A-02SROSCT-ND
X1: 12MHz; CSTCE_G; Digikey# 490-1220-1-ND

Notes on the sheet:
TDI: Output from LPC TDO: Input of LPC RESET: System reset (drive as open drain)
USB routing: Max. lenght: 14 inches Target Zo (diff): 90 Ohms +/- 15% Spacing to other signals: 50 mils Matching tolerance (intra-pair): 10 mils
BANK0 POWER: 3.3V
FPGA CFG LEDS
USB JTAG UART / FMC JTAG
