ciaa/Hardware/PCB/ACC/CIAA_ACC/BANK_112.sch

## KiCad design PCB/ACC/CIAA_ACC/BANK_112.sch (2019-08-28)

Schematic: BANK_112.sch

Parts:
J5: FMC_HPC; ASP-134486-01
R115: 100; r_0402; Digikey# 311-100LRCT-ND
U1: XC7Z030-2FBG676I; FBG676; Digikey# XC7Z030-2FBG676I-ND

Notes on the sheet:
DP0 belongs to LPC
PCIe routing: Target Zo (diff): 85 Ohms +/- 15% Spacing between links: 20 mils Matching tolerance (intra-pair): 5 mils Matching tolerance (inter-pair): Not required
Coupling capacitor for transceivers must be in FMC mezzanine card.
MGTRREF must have matched length with MGTAVTTRCAL.
PCIe / FMC Transceiver
