ciaa/Hardware/PCB/ACC/CIAA_ACC/BANK_500.sch

## KiCad design PCB/ACC/CIAA_ACC/BANK_500.sch (2019-08-28)

Schematic: BANK_500.sch

Parts:
C120, C121: 10uF; c_0402; Digikey# 490-13233-1-ND
C150: 10nF; c_0201; Digikey# 490-7223-1-ND
C151, C152, C153, C154, C157, C158: 100nF; c_0201; Digikey# 490-5405-1-ND
C159: 100nF; c_0402; Digikey# 311-1336-1-ND
FB5, FB6: MMZ1608B601CTAH0; l_0603; Digikey# 445-2166-1-ND
J7: CAS-D20TA; Digikey# CASD20JCT-ND
J13: UART2; Pin_Header_Straight_1x03; Digikey# WM50016-03-ND
J14: CAN; 1770898; Digikey# 277-2080-1-ND
J15: RS485; 1770898; Digikey# 277-2080-1-ND
JP4: PLL; JUMPER3_0603; Digikey# RMCF0603JT20K0CT-ND
JP5, JP6: JUMPER; Pin_Header_Straight_1x02; Digikey# WM50016-02-ND
R116: 100; r_0402; Digikey# 311-100JRCT-ND
R117, R118: 2.2K; r_0402; Digikey# 311-2.2KJRCT-ND
R119, R120: 10K; r_0402; Digikey# 311-10KJRCT-ND
R121, R122, R123, R124, R126, R129: 20K; r_0402; Digikey# 311-20KJRCT-ND
R125, R130: 4.7K; r_0402; Digikey# 311-4.7KJRCT-ND
R127, R128: 120; r_0402; Digikey# 311-120JRCT-ND
U1: XC7Z030-2FBG676I; FBG676; Digikey# XC7Z030-2FBG676I-ND
U32: 33.33MHz; ABRACON-ASDMB; Digikey# 535-11196-1-ND
U33, U34: 74AVC2T45; MSOP-8; Digikey# 568-8845-1-ND
U35: XR33038; SOIC-8; Digikey# 1016-2002-5-ND
U36: TCAN332; SOIC-8; Digikey# 296-43711-1-ND
U37: QSPI; WSON-8; Digikey# S25FL128SAGNFI011-ND
U39, U40: PESD1CAN; SOT-23; Digikey# 568-4032-1-ND

Notes on the sheet:
QSPI Routing: Target Zo: 50 Ohms +/- 5% Spacing to other signals: 3w Matching tolerance: 3 mm
I2C1
I2C0
UART0
UART1
QSPI0
GPIO0 (MIO)
GPIO7 (MIO)
BOOT SELECTOR
QSPI
SW1 OFF, SW2 OFF: JTAG BOOT SW1 OFF, SW2 ON: QSPI SW1 ON, SW2 OFF: N/A SW1 ON, SW2 ON: SD CARD
UART 2
RS-485
CAN
BANK500 POWER: 3.3V
UART, QSPI, I2C, CAN, RS485
20K resistor for PLL Please check the position! Must be in 2-3.
