ciaa/Hardware/PCB/ACC/CIAA_ACC/BANK_501.sch

## KiCad design PCB/ACC/CIAA_ACC/BANK_501.sch (2019-08-28)

Schematic: BANK_501.sch

Parts:
C209, C210, C211, C212, C214: 10uF; c_0402; Digikey# 490-13233-1-ND
C237: 2.2uF; c_0402; Digikey# 490-12532-2-ND
C238, C239, C240, C256, C261: 100nF; c_0402; Digikey# 311-1336-1-ND
C241: 1uF; c_0201; Digikey# 1276-6816-1-ND
C242, C243, C259: 10nF; c_0201; Digikey# 490-7223-1-ND
C244: 4.7uF; c_0603; Digikey# 490-10477-1-ND
C245, C248, C249, C250, C251, C253, C254, C255, C257, C258, C262, C263, C265: 100nF; c_0201; Digikey# 490-5405-1-ND
D6, D7, D9: 1N4148; SOD-323; Digikey# 1N4148WXTPMSCT-ND
D8: SD05T1G; SOD-323; Digikey# SD05T1GOSCT-ND
DS11: OVERCURRENT; LED-0603; Digikey# 1080-1400-1-ND
FB8: BLM15PX221SN1D; l_0402; Digikey# 490-11021-1-ND
FB9: MMZ1608B601CTAH0; l_0603; Digikey# 445-2166-1-ND
FB10, FB11, FB12: MPZ1608S601ATA00; l_0603; Digikey# 445-2205-1-ND
J16: USB Micro AB; ZX62-AB-5PA; Digikey# H125279CT-ND
J17: 1840461-1; Mouser# 530-1840437-1; Digikey# 1419-1060-1-ND
J18: microSD; MicroSD_Hinged; Digikey# WM6698CT-ND
R131, R133, R140: 4.7K; r_0402; Digikey# 311-4.7KJRCT-ND
R132: 49R9; r_0402; Digikey# 311-49.9LRCT-ND
R134: 680; r_0402; Digikey# 311-680JRCT-ND
R135, R147, R148: 1K; r_0402; Digikey# 311-1.0KJRCT-ND
R136: 8.06K; r_0402; Digikey# 311-8.06KLRCT-ND
R137, R143: 100; r_0402; Digikey# 311-100JRCT-ND
R138, R139: 1.0K; r_0402; Digikey# 311-1.00KLRCT-ND
R141, R142, R146: 10K; r_0402; Digikey# 311-10KJRCT-ND
R144: 12.1K; r_0402; Digikey# 311-12.1KLRCT-ND
R149: DNP; r_0402
R150, R151: 220; r_0402; Digikey# 311-220JRCT-ND
RP1: 10K; r_0402_4; Digikey# CAT10-103J4LFCT-ND
SW3: SRST; TACT_SMD_4.5X4.5; Digikey# 732-7003-1-ND
TR2: SRF2012; Digikey# SRF2012-900YCT-ND
U1: XC7Z030-2FBG676I; FBG676; Digikey# XC7Z030-2FBG676I-ND
U41: USB3320C; Digikey# USB3320C-EZK-ND
U42: 24MHz; ABRACON-ASDMB; Digikey# 535-11186-1-ND
U43: MIC2025; MSOP-8; Digikey# 576-1691-5-ND
U44: CM1213A; SOT-143; Digikey# CM1213A-02SROSCT-ND
U45: KSZ9031RNXIC; KSZ9031RNX; Digikey# KSZ9031RNXIC-ND
U46: TXS02612; Digikey# 296-23869-1-ND
U47: 25MHz; ABRACON-ASDMB; Digikey# 535-11188-1-ND
U48: 74AVC2T45; MSOP-8; Digikey# 568-8845-1-ND

Notes on the sheet:
BANK501 POWER: 1.8V
USB routing: Max. lenght: 14 inches Target Zo (diff): 90 Ohms +/- 15% Spacing to other signals: 50 mils Matching tolerance (intra-pair): 10 mils
Close to VDD18 and VDDIO
Close to VDD33
PHY ADDRESS: 0x00
Chassis filter included in jack
GIGABIT ETHERNET
SD CARD
USB 2.0 OTG
ETH, SDIO, USB OTG
