ciaa/Hardware/PCB/ACC/CIAA_ACC/BANK_502.sch

## KiCad design PCB/ACC/CIAA_ACC/BANK_502.sch (2019-08-28)

Schematic: BANK_502.sch

Parts:
C1, C28, C55, C56: 100uF; c_1206; Digikey# 490-10525-1-ND
C2, C5, C10, C13, C16, C19, C22, C25, C29, C32, C37, C40, C43, C46, C49, C52, C59, C60: 100nF; c_0201; Digikey# 490-5405-1-ND
C3, C6, C8, C9, C11, C12, C14, C15, C17, C18, C20, C21, C23, C24, C26, C27, C30, C33, C35, C36, C38, C39, C41, C42, C44, C45, C47, C48, C50, C51, C53, C54, C61, C62, C63, C64: 10nF; c_0201; Digikey# 490-7223-1-ND
C4, C7, C31, C34, C57, C58: 10uF; c_0402; Digikey# 490-13233-1-ND
R1, R2, R27: 80.6; r_0402; Digikey# 311-80.6LRCT-ND
R3, R4, R5, R6, R7, R8, R9, R10, R11, R12, R13, R14, R15, R16, R17, R18, R19, R20, R21, R22, R23, R24, R25, R26: 40.2; r_0402; Digikey# 311-40.2LRCT-ND
R28: 4.7K; r_0402; Digikey# 311-4.7KJRCT-ND
R29, R30: 240; r_0402; Digikey# 311-240LRCT-ND
U1: XC7Z030-2FBG676I; FBG676; Digikey# XC7Z030-2FBG676I-ND
U2, U3: MT41K256M16TW-107 IT; FBGA96; Mouser# 913-A4C25616D3B12BAN

Notes on the sheet:
Close to each chip
DDR3 routing: Max. lenght: 5 inches Target Zo (diff): 80 Ohms +/- 10% Target Zo (single): 40 Ohms +/- 10%
