ciaa/Hardware/PCB/ACC/CIAA_ACC/Digital_IO.sch

## KiCad design PCB/ACC/CIAA_ACC/Digital_IO.sch (2019-08-28)

Schematic: Digital_IO.sch

Parts:
C138, C139, C140, C141: 1.5nF; c_0402; Digikey# 311-1032-1-ND
C146, C147, C148, C149: 100nF; c_0201; Digikey# 490-5405-1-ND
DS7, DS8, DS9, DS10, DS14, DS15, DS16, DS17: LED; LED-0603; Digikey# 1080-1400-1-ND
J11: DIGITAL IN; 1770940; Digikey# 277-2085-1-ND
J12: DIGITAL OUT; 1770940; Digikey# 277-2085-1-ND
R99, R100, R101, R102: 3.3K 1/4W; r_1206; Digikey# 311-3.3KERCT-ND
R103, R104, R105, R106: 1K; r_0402; Digikey# 311-1.0KJRCT-ND
R107, R108, R109, R110: 33K; r_0402; Digikey# 311-33KJRCT-ND
R111, R112, R113, R114: 39; r_0402; Digikey# 311-39JRCT-ND
U23: TLP290-4; SOIC-16; Digikey# TLP290-4(TPECT-ND
U26, U27: 74AVC2T45; MSOP-8; Digikey# 568-8845-1-ND
U28, U29, U30, U31: VO14642AABTR; DIP-6-SMD; Digikey# VO14642AABCT-ND

Notes on the sheet:
ISOLATED DIGITAL INPUTS
ISOLATED DIGITAL OUTPUTS
Range: 12 to 24 V
Digital Inputs and Outputs
Range: up to 60 V
