ciaa/Hardware/PCB/ACC/CIAA_ACC/Expansion.sch

## KiCad design PCB/ACC/CIAA_ACC/Expansion.sch (2019-08-28)

Schematic: Expansion.sch

Parts:
C132, C133, C134, C135, C136, C137: 100nF; c_0201; Digikey# 490-5405-1-ND
D3: 1N4148; SOD-323; Digikey# 1N4148WXTPMSCT-ND
D4, D5: PESD3V3U1UA; SOD-323; Digikey# 568-4667-1-ND
F1, F2, F3, F4: FIDUCIAL; Fiducial_1mm
J9: FAN; B2B-PH-SM4-TB; Digikey# 455-1734-1-ND
J10: DNP; Pin_Header_Straight_2x10_SMD; Digikey# 952-2550-ND
Q2: BSS806N; SOT-23; Digikey# BSS806N H6327CT-ND
R98: 100K; r_0402; Digikey# 311-100KJRCT-ND
TH1, TH2, TH3: PTC 0.5A; ptc_1210; Digikey# 507-1786-1-ND
U20, U21, U22: LSF0204D; Digikey# 296-40401-1-ND

Notes on the sheet:
GPIO Only available when VCCO_HP = 1.8V
Expansion Header / FAN Connector
Expansion Header
Voltage level translator
FAN
