ciaa/Hardware/PCB/ACC/CIAA_ACC/FPGA-Power.sch

## KiCad design PCB/ACC/CIAA_ACC/FPGA-Power.sch (2019-08-28)

Schematic: FPGA-Power.sch

Parts:
C122, C123, C124, C125, C126, C127, C155, C156, C160, C165, C169, C171, C173, C175, C178, C182, C184, C186, C188, C190, C194, C197, C204, C205, C206, C207: 10uF; c_0402; Digikey# 490-13233-1-ND
C161, C163, C167, C180, C199, C203, C208, C216, C218, C221, C231: 100uF; c_1206; Digikey# 490-10525-1-ND
C162, C166, C170, C174: 330uF; tant_B_3528; Digikey# 399-11709-1-ND
C164, C168, C172, C176, C177, C179, C181, C183, C185, C187, C189, C191, C192, C193, C195, C196, C198, C200, C201, C202, C213, C215, C217, C219, C235, C236: 1uF; c_0201; Digikey# 1276-6816-1-ND
C220, C222, C224, C226, C227, C228, C229, C230, C232, C233, C234, C246, C247, C252, C260, C264, C277, C278, C279, C280, C281, C282, C283, C284, C285, C286, C287, C288: 100nF; c_0201; Digikey# 490-5405-1-ND
C223, C225: 10nF; c_0201; Digikey# 490-7223-1-ND
FB7: BLM15PX221SN1D; l_0402; Digikey# 490-11021-1-ND
U1: XC7Z030-2FBG676I; FBG676; Digikey# XC7Z030-2FBG676I-ND

Notes on the sheet:
BANK0
BANK13
BANK12
BANK33
BANK34
BANK35
MGTAVCC
MGTAVTT
MGTVCCAUX
DDR_VREF
BANK502
BANK500
BANK501
VCCAUX_IO
VCCAUX
VCCBRAM
VCCPAUX
VCCPINT
VCCINT
FPGA POWER PINS
Bulk and decoupling capacitors
