ciaa/Hardware/PCB/ACC/CIAA_ACC/OneBank.sch

## KiCad design PCB/ACC/CIAA_ACC/OneBank.sch (2019-08-28)

Schematic: OneBank.sch

Parts:
C107, C108, C109, C110, C111: 100nF; c_0201; Digikey# 490-5405-1-ND
C269, C270, C273, C274, C275: 10nF; c_0201; Digikey# 490-7223-1-ND
H1, H2, H3, H4: PCB_HOLE; PCIE104_HOLE
J2: OneBank Top; ASP-129637-13
J3: OneBank Bottom; ASP-129646-22
R64, R65: 10K; r_0402; Digikey# 311-10KJRCT-ND
R66: DNP; r_0402
U11: CBTL04083A; HVQFN42; Digikey# 568-6655-1-ND

Notes on the sheet:
Holes PCIe 104
PCIe OneBank device routing: Max. lenght: 4 inches Target Zo (diff): 85 Ohms +/- 15% Spacing between links: 20 mils Matching tolerance (intra-pair): 5 mils Matching tolerance (inter-pair): Not required
Mux/Demux Switch
PCIe/104 OneBank Connector
