ciaa/Hardware/PCB/ACC/CIAA_ACC/PMIC.sch

## KiCad design PCB/ACC/CIAA_ACC/PMIC.sch (2019-08-28)

Schematic: PMIC.sch

Parts:
C65, C66, C80, C81, C82, C83, C86, C276: 100uF; c_1206; Digikey# 490-10525-1-ND
C67: 470nF; c_0402; Digikey# 490-10462-1-ND
C68, C70, C77, C90, C96: 10uF; c_0402; Digikey# 490-13233-1-ND
C69, C89, C93, C94, C95, C105, C106: 100nF; c_0201; Digikey# 490-5405-1-ND
C71: 220nF; c_0402; Digikey# 490-10445-1-ND
C72: 2.2nF; c_0402; Digikey# 490-6330-1-ND
C73: 47nF; c_0402; Digikey# 490-6347-1-ND
C74: 22nF; c_0402; Digikey# 490-3884-1-ND
C75: 1nF; c_0402; Digikey# 399-10034-1-ND
C76, C78, C79: 330uF; tant_B_3528; Digikey# 399-11709-1-ND
C84, C85, C97, C98: 68nF; c_0402; Digikey# 490-12709-1-ND
C87: 2.2nF; c_0402; Digikey# 490-1305-1-ND
C88, C101: 1.2nF; c_0402; Digikey# 490-1304-1-ND
C91: 24pF; c_0402; Digikey# 490-5931-1-ND
C92: 11pF; c_0402; Digikey# 490-5923-1-ND
C99: 4.7uF; c_0603; Digikey# 490-10477-1-ND
C100: 1.5nF; c_0402; Digikey# 490-3245-1-ND
C102: 3.3uF; c_0603; Digikey# 490-6411-1-ND
C103: 16pF; c_0402; Digikey# 490-5926-1-ND
C104: 13pF; c_0402; Digikey# 490-5925-1-ND
J1: 5V 10A; PJ-082BH; Digikey# CP-082BHCT-ND
J19: 452403012014; Digikey# 732-10145-1-ND
L1: 220nH; SRP1238A; Digikey# SRP1238A-R22MCT-ND
L2, L5: 3uH; SRU1048; Digikey# SRU1048-3R0YCT-ND
L3, L6: 4.7uH; SRN6045; Digikey# SRN6045-4R7YCT-ND
L4: 6.2uH; SRR6038; Digikey# SRR6038-6R2YCT-ND
R31, R46, R57, R59: 10K; r_0402; Digikey# 311-10KJRCT-ND
R33: 200K; r_0402; Digikey# 311-200KJRCT-ND
R34, R36: 100K; r_0402; Digikey# 311-100KJRCT-ND
R35: 1K; r_0402; Digikey# 311-1.0KJRCT-ND
R37: 309K; r_0402; Digikey# YAG3108CT-ND
R38: 2; r_0402; Digikey# 311-2.0JRCT-ND
R39: 10.7K; r_0402; Digikey# 311-10.7KLRCT-ND
R40: 174K; r_0402; Digikey# YAG3008CT-ND
R41: 39.2K; r_0402; Digikey# 311-39.2KLRCT-ND
R42: 3; r_0402; Digikey# 311-3.0JRCT-ND
R43: 100; r_0402; Digikey# 311-100LRCT-ND
R44: 6.49K; r_0402; Digikey# 311-6.49KLRCT-ND
R45, R50: 10K; r_0402; Digikey# 311-10.0KLRCT-ND
R47: 6.81K; r_0402; Mouser# 603-RC0402FR-076K81L; Digikey# 311-6.81KLRCT-ND
R48: 8.87K; r_0402; Digikey# 311-8.87KLRCT-ND
R49: 100K; r_0402; Digikey# 311-100KLRCT-ND
R51: 20K; r_0402; Digikey# 311-20.0KLRCT-ND
R52, R63: 16K; r_0402; Digikey# 311-16.0KLRCT-ND
R53: 6.65K; r_0402; Digikey# YAG3219CT-ND
R54: 13.3K; r_0402; Digikey# YAG2974CT-ND
R55: 11.3K; r_0402; Digikey# 311-11.3KLRCT-ND
R56: 11K; r_0402; Digikey# 311-11.0KLRCT-ND
R58: 182K; r_0402; Digikey# YAG3015CT-ND
R60: 75K; r_0402; Digikey# 311-75KLRCT-ND
R61: 24K; r_0402; Digikey# 311-24KLRCT-ND
R62: 14K; r_0402; Digikey# 311-14.0KLRCT-ND
TP2: TESTPOINT
U4: TPS51206; Digikey# 296-28767-1-ND
U5: TPS53355; Digikey# 296-29538-1-ND
U7: LTV-817S; OPTO_SMD; Digikey# 160-1367-5-ND
U8: TPS563209; SOT-23-6; Digikey# 296-40813-1-ND
U9: TPS65400; Digikey# 296-40902-1-ND
U10: MCP4017; SC-70-6; Digikey# MCP4017T-503E/LTCT-ND

Notes on the sheet:
"EN" del TPS563209: Conectado a pines del FPGA para apagar antes de cambiar feedback. ver si va con 1.5V o poner transistor
I2C Address: 0x2F
I2C Address: 0x69
Power Supply
DC Input +5V 10A
DDR_VTT +0.75V
+1.0V 25A
VADJ 2A
+1.8V 2A
+3.3V 3.5A
+1.2V 0.5A
+1.5V 2A
+1V 25W +1.2V 0.6W +1.5V 3W +1.8V 3.6W +3.3V 11.55W VADJ 6.6W Total 50W
Last POWERGOOD signal, when it is active all voltages are in the right level.
Voltage Power
