ciaa/Hardware/PCB/ACC/CIAA_ACC/Principal.sch

## KiCad design PCB/ACC/CIAA_ACC/Principal.sch (2019-08-28)

Schematic: Principal.sch

Parts:
TP1, TP3, TP4, TP5, TP6, TP7, TP8: TESTPOINT

Notes on the sheet:
BOOTSTRAP QSPI DEBUG UART SMBUS & I2C RS-485 & CAN
DDR3
USB JTAG-UART IF FMC JTAG
PCIe FMC Transceiver
Banks 12, 13 FMC LA
Banks 33,34,35 FMC HA, HB SYSCLK
Ethernet SDIO USB OTG
FMC COMPATIBILITY NOTE:
Currents: 3.3V: 3A VADJ: 2A 12V: Not implemented
VIO_B_M2C: Not implemented VADJ: Powers the LA bank only Banks HA & HB: 1.5/1.8V only, selectable by switch
EXP Header Cooling Fan
Hierarchical Schematic
POWER SUPPLY
FPGA POWER PINS DECOUPLING CAPS BULK CAPS
FMC POWER PINS
PCIe/104 OneBank
Digital Inputs Digital Outputs
HDMI Dual Role RTC
