ciaa/Hardware/PCB/ACC/CIAA_ACC/RTC-HDMI.sch

## KiCad design PCB/ACC/CIAA_ACC/RTC-HDMI.sch (2019-08-28)

Schematic: RTC-HDMI.sch

Parts:
BT1: CR1220; BC501SM; Digikey# BC501SM-ND
C112, C113: 18pF; c_0201; Digikey# 490-6117-2-ND
C114, C115, C116, C117, C118: 100nF; c_0201; Digikey# 490-5405-1-ND
D1: PESD3V3U1UA; SOD-323; Digikey# 568-4667-1-ND
J4: HDMI; 10029449-111RLF; Digikey# 609-4614-1-ND
R68, R69, R70, R71, R72, R73, R74, R76: 49R9; r_0402; Digikey# 311-49.9LRCT-ND
R75: 51K; r_0402; Digikey# 311-51KJRCT-ND
R77: 27K; r_0402; Digikey# 311-27KJRCT-ND
U12: MCP79410; MSOP-8; Digikey# MCP79410-I/MS-ND
U13: TXB0101; SC-70-6; Digikey# 296-22861-1-ND
U14: MIC2090; SOT-23-5; Digikey# 576-3890-1-ND
Y1: 32.768kHz; ABRACON-ABS06; Digikey# 535-10247-1-ND

Notes on the sheet:
Note for HDMI: VCCO_HR must be 3.3V
HDMI DUAL ROLE
I2C Addresses: 0x6F & 0x57
Real Time Clock
HDMI / RTC
Mounting indication: Please remove battery holder pins before solder.
