ciaa/Hardware/PCB/ACC/CIAA_ACC/ciaa_acc.sch

## KiCad design PCB/ACC/CIAA_ACC/ciaa_acc.sch (2019-08-28)

Schematic: ciaa_acc.sch

Parts:
G1: LOGO_CIAA; LOGO-CIAA
G2: OSHWA
G3: LOGO_INTI

Notes on the sheet:
Gigabit Ethernet PHY
RJ45 Jack w/inductors
Micro-SDHC
USB 2.0 PHY
USB OTG Micro-AB
RS-485
CAN
HDMI (dual role)
FMC HPC
PCIe 1x
PCIe/104 OneBank Top
1 GB DDR3
Quad-SPI Flash
JTAG Header
LPC11U35 JTAG + EEPROM
USB Micro-B
Expansion Header SPI/I2C 8x GPIO (PL)
UART TTL
4x Digital Inputs (Isolated)
4x Digital Outputs (Isolated)
Status LEDs
Power Jack 5V
Power supply
RTC w/Battery
XC7Z030-2FBG676I
PCIe/104 OneBank Bottom
Gigabit MAC
SD/SDIO Controller
USB 0 Controller
UART 1 Controller
CAN Controller
PL IO
PL Banks
GTX
UART 2 (EMIO)
SPI 0
I2C 1 Controller
UART 0 Controller
JTAG
QSPI Controller
SDRAM Controller
I2C0 Controller
SMBus
Computadora Industrial Abierta Argentina CIAA-ACC Xilinx XC7Z030 (2x Cortex A9 + Kintex-7 FPGA)
