ciaa/Hardware/PCB/EDU-XILINX/ProyectoKicad/Bank14.sch

## KiCad design PCB/EDU-XILINX/ProyectoKicad/Bank14.sch (2015-11-17)

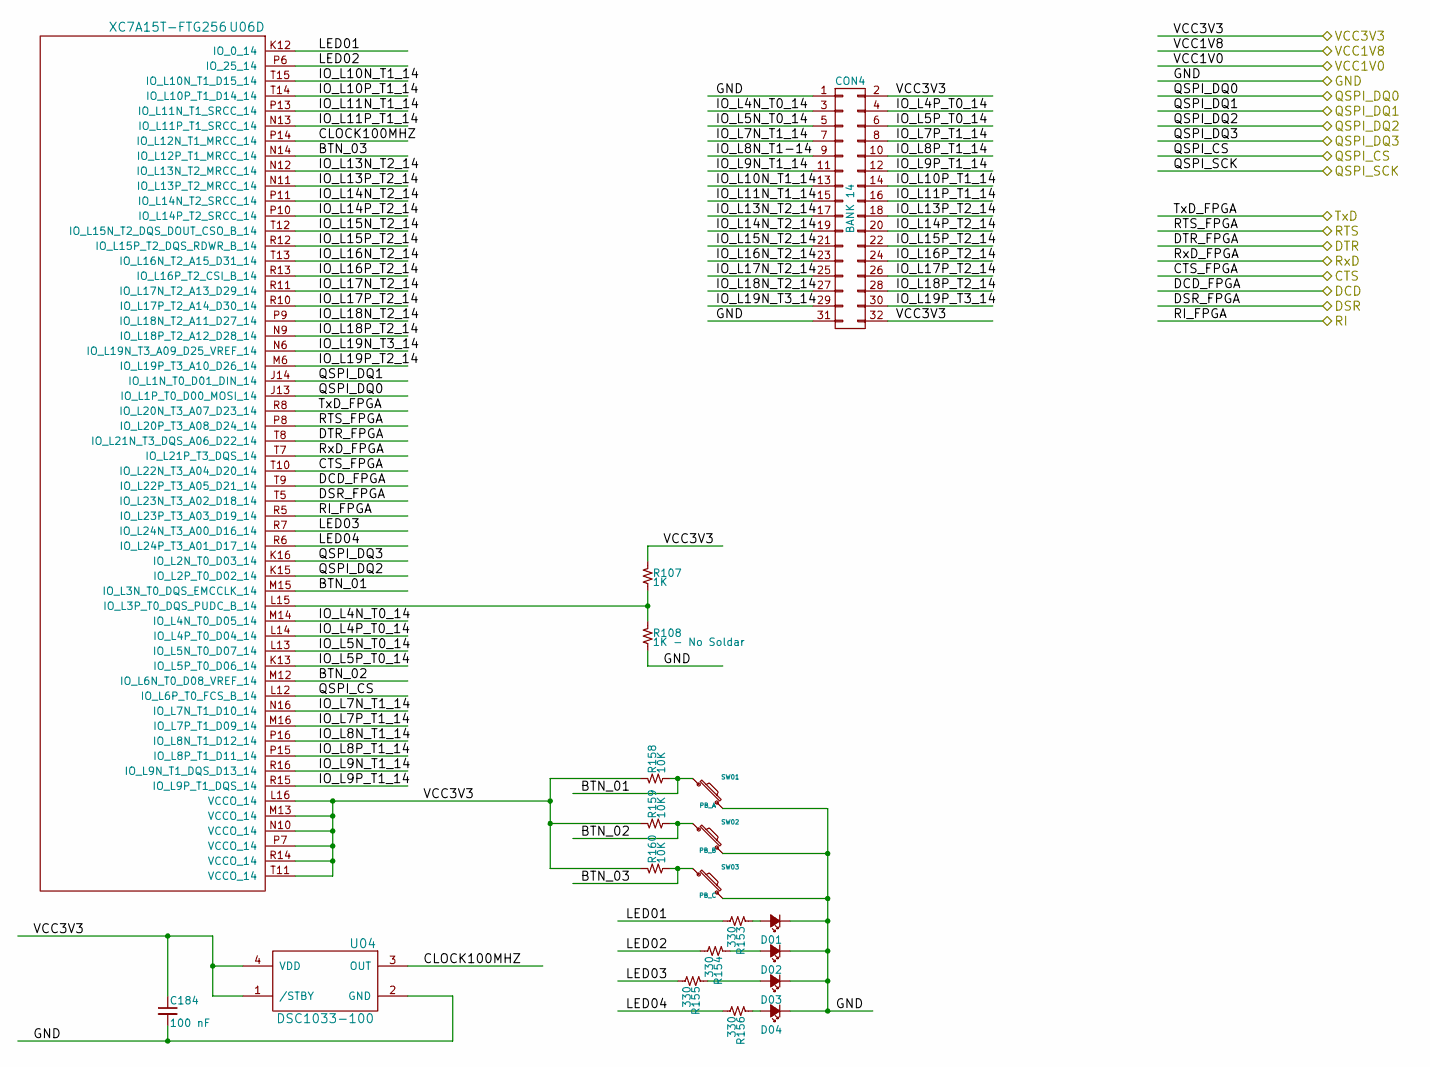
[picture p297: schematic Bank14.sch]

Parts:
C184: 100 nF
CON4: BANK 14
D01, D02, D03, D04: (no value)
R107: 1K
R108: 1K - No Soldar
R153, R154, R155, R156: 330
R158, R159, R160: 10K
SW01: PB_A
SW02: PB_B
SW03: PB_C
U04: DSC1033-100
U06: XC7A15T-FTG256

Connections:
BTN_01: R158.2, SW01.1, U06.M15 (IO_L3N_T0_DQS_EMCCLK_14)
BTN_02: R159.2, SW02.1, U06.M12 (IO_L6N_T0_D08_VREF_14)
BTN_03: R160.2, SW03.1, U06.N14 (IO_L12P_T1_MRCC_14)
CLOCK100MHZ: U04.3 (OUT), U06.P14 (IO_L12N_T1_MRCC_14)
CTS: U06.T10 (IO_L22N_T3_A04_D20_14)
DCD: U06.T9 (IO_L22P_T3_A05_D21_14)
DSR: U06.T5 (IO_L23N_T3_A02_D18_14)
DTR: U06.T8 (IO_L21N_T3_DQS_A06_D22_14)
GND: C184.2, CON4.1, CON4.31, D01.1 (K), D02.1 (K), D03.1 (K), D04.1 (K), R108.2, SW01.2, SW02.2, SW03.2, U04.2 (GND)
IO_L4N_T0_14: CON4.3, U06.M14 (IO_L4N_T0_D05_14)
IO_L4P_T0_14: CON4.4, U06.L14 (IO_L4P_T0_D04_14)
IO_L5N_T0_14: CON4.5, U06.L13 (IO_L5N_T0_D07_14)
IO_L5P_T0_14: CON4.6, U06.K13 (IO_L5P_T0_D06_14)
IO_L7N_T1_14: CON4.7, U06.N16 (IO_L7N_T1_D10_14)
IO_L7P_T1_14: CON4.8, U06.M16 (IO_L7P_T1_D09_14)
IO_L8N_T1-14: CON4.9
IO_L8N_T1_14: U06.P16 (IO_L8N_T1_D12_14)
IO_L8P_T1_14: CON4.10, U06.P15 (IO_L8P_T1_D11_14)
IO_L9N_T1_14: CON4.11, U06.R16 (IO_L9N_T1_DQS_D13_14)
IO_L9P_T1_14: CON4.12, U06.R15 (IO_L9P_T1_DQS_14)
IO_L10N_T1_14: CON4.13, U06.T15 (IO_L10N_T1_D15_14)
IO_L10P_T1_14: CON4.14, U06.T14 (IO_L10P_T1_D14_14)
IO_L11N_T1_14: CON4.15, U06.P13 (IO_L11N_T1_SRCC_14)
IO_L11P_T1_14: CON4.16, U06.N13 (IO_L11P_T1_SRCC_14)
IO_L13N_T2_14: CON4.17, U06.N12 (IO_L13N_T2_MRCC_14)
IO_L13P_T2_14: CON4.18, U06.N11 (IO_L13P_T2_MRCC_14)
IO_L14N_T2_14: CON4.19, U06.P11 (IO_L14N_T2_SRCC_14)
IO_L14P_T2_14: CON4.20, U06.P10 (IO_L14P_T2_SRCC_14)
IO_L15N_T2_14: CON4.21, U06.T12 (IO_L15N_T2_DQS_DOUT_CSO_B_14)
IO_L15P_T2_14: CON4.22, U06.R12 (IO_L15P_T2_DQS_RDWR_B_14)
IO_L16N_T2_14: CON4.23, U06.T13 (IO_L16N_T2_A15_D31_14)
IO_L16P_T2_14: CON4.24, U06.R13 (IO_L16P_T2_CSI_B_14)
IO_L17N_T2_14: CON4.25, U06.R11 (IO_L17N_T2_A13_D29_14)
IO_L17P_T2_14: CON4.26, U06.R10 (IO_L17P_T2_A14_D30_14)
IO_L18N_T2_14: CON4.27, U06.P9 (IO_L18N_T2_A11_D27_14)
IO_L18P_T2_14: CON4.28, U06.N9 (IO_L18P_T2_A12_D28_14)
IO_L19N_T3_14: CON4.29, U06.N6 (IO_L19N_T3_A09_D25_VREF_14)
IO_L19P_T2_14: U06.M6 (IO_L19P_T3_A10_D26_14)
IO_L19P_T3_14: CON4.30
LED01: R153.2, U06.K12 (IO_0_14)
LED02: R154.2, U06.P6 (IO_25_14)
LED03: R155.2, U06.R7 (IO_L24N_T3_A00_D16_14)
LED04: R156.2, U06.R6 (IO_L24P_T3_A01_D17_14)
unnamed: D01.2 (A), R153.1
unnamed: D02.2 (A), R154.1
unnamed: D03.2 (A), R155.1
unnamed: D04.2 (A), R156.1
unnamed: R107.2, R108.1, U06.L15 (IO_L3P_T0_DQS_PUDC_B_14)
QSPI_CS: U06.L12 (IO_L6P_T0_FCS_B_14)
QSPI_DQ0: U06.J13 (IO_L1P_T0_D00_MOSI_14)
QSPI_DQ1: U06.J14 (IO_L1N_T0_D01_DIN_14)
QSPI_DQ2: U06.K15 (IO_L2P_T0_D02_14)
QSPI_DQ3: U06.K16 (IO_L2N_T0_D03_14)
RI: U06.R5 (IO_L23P_T3_A03_D19_14)
RTS: U06.P8 (IO_L20P_T3_A08_D24_14)
RxD: U06.T7 (IO_L21P_T3_DQS_14)
TxD: U06.R8 (IO_L20N_T3_A07_D23_14)
VCC3V3: C184.1, CON4.2, CON4.32, R107.1, R158.1, R159.1, R160.1, U04.1 (/STBY), U04.4 (VDD), U06.L16 (VCCO_14), U06.M13 (VCCO_14), U06.N10 (VCCO_14), U06.P7 (VCCO_14), U06.R14 (VCCO_14), U06.T11 (VCCO_14)
