ciaa/Hardware/PCB/EDU-XILINX/ProyectoKicad/Bank15.sch

## KiCad design PCB/EDU-XILINX/ProyectoKicad/Bank15.sch (2015-11-12)

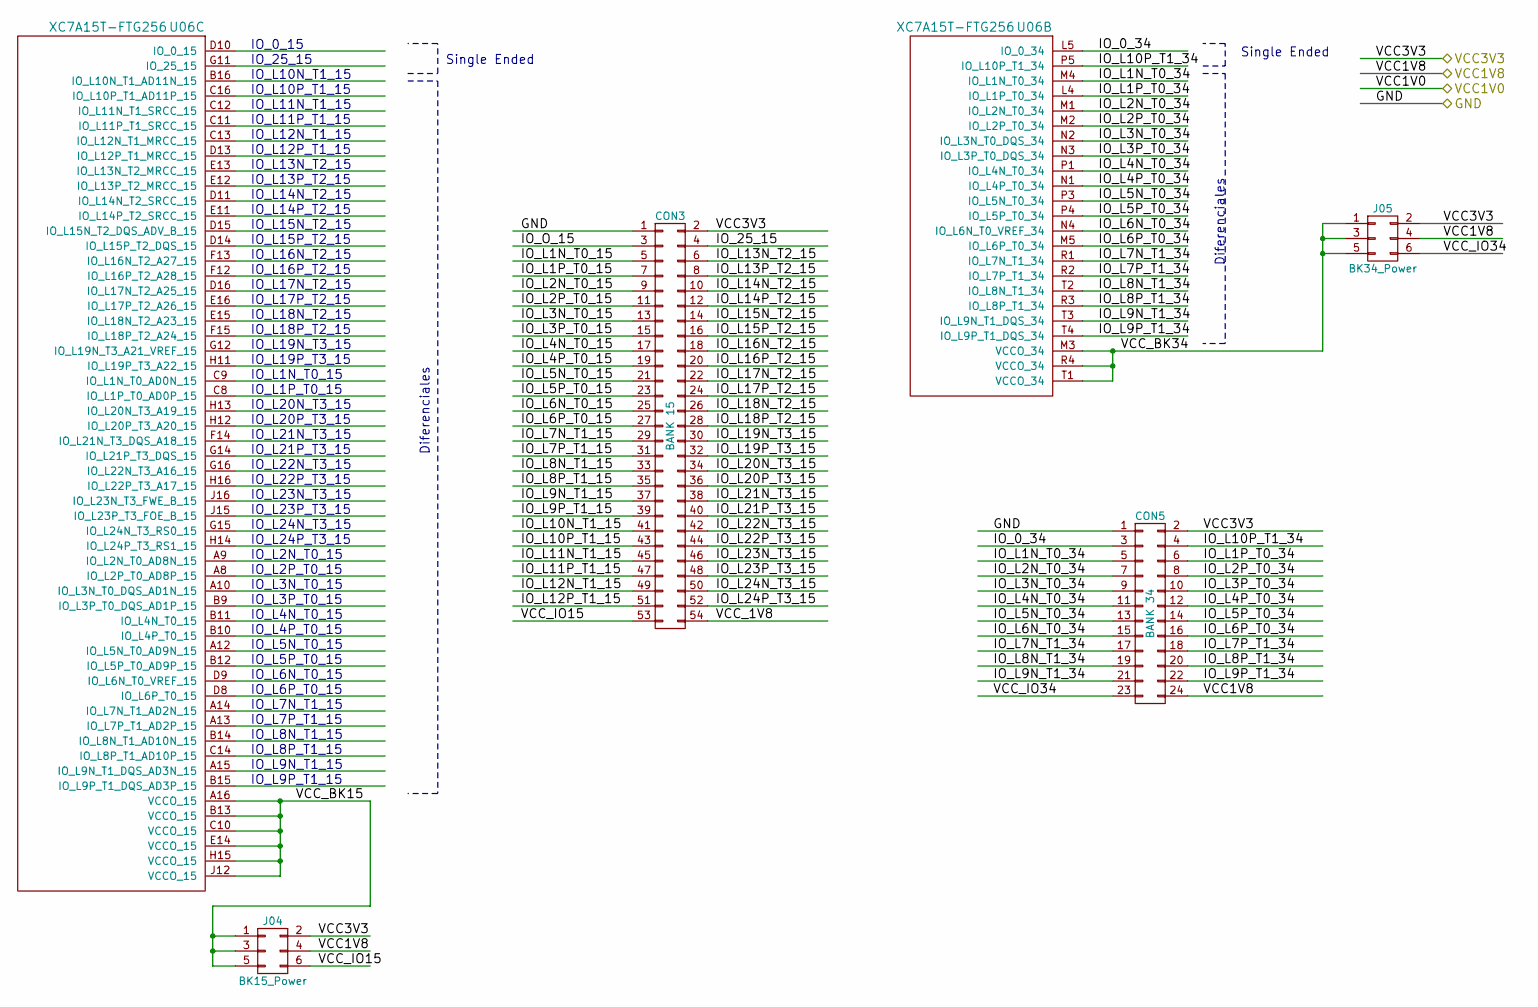
[picture p298: schematic Bank15.sch]

Parts:
CON3: BANK 15
CON5: BANK 34
J04: BK15_Power
J05: BK34_Power
U06: XC7A15T-FTG256

Connections:
GND: CON3.1, CON5.1
IO_0_34: CON5.3, U06.L5 (IO_0_34)
IO_25_15: CON3.4
IO_L1N_T0_15: CON3.5
IO_L1N_T0_34: CON5.5, U06.M4 (IO_L1N_T0_34)
IO_L1P_T0_15: CON3.7
IO_L1P_T0_34: CON5.6, U06.L4 (IO_L1P_T0_34)
IO_L2N_T0_15: CON3.9
IO_L2N_T0_34: CON5.7, U06.M1 (IO_L2N_T0_34)
IO_L2P_T0_15: CON3.11
IO_L2P_T0_34: CON5.8, U06.M2 (IO_L2P_T0_34)
IO_L3N_T0_15: CON3.13
IO_L3N_T0_34: CON5.9, U06.N2 (IO_L3N_T0_DQS_34)
IO_L3P_T0_15: CON3.15
IO_L3P_T0_34: CON5.10, U06.N3 (IO_L3P_T0_DQS_34)
IO_L4N_T0_15: CON3.17
IO_L4N_T0_34: CON5.11, U06.P1 (IO_L4N_T0_34)
IO_L4P_T0_15: CON3.19
IO_L4P_T0_34: CON5.12, U06.N1 (IO_L4P_T0_34)
IO_L5N_T0_15: CON3.21
IO_L5N_T0_34: CON5.13, U06.P3 (IO_L5N_T0_34)
IO_L5P_T0_15: CON3.23
IO_L5P_T0_34: CON5.14, U06.P4 (IO_L5P_T0_34)
IO_L6N_T0_15: CON3.25
IO_L6N_T0_34: CON5.15, U06.N4 (IO_L6N_T0_VREF_34)
IO_L6P_T0_15: CON3.27
IO_L6P_T0_34: CON5.16, U06.M5 (IO_L6P_T0_34)
IO_L7N_T1_15: CON3.29
IO_L7N_T1_34: CON5.17, U06.R1 (IO_L7N_T1_34)
IO_L7P_T1_15: CON3.31
IO_L7P_T1_34: CON5.18, U06.R2 (IO_L7P_T1_34)
IO_L8N_T1_15: CON3.33
IO_L8N_T1_34: CON5.19, U06.T2 (IO_L8N_T1_34)
IO_L8P_T1_15: CON3.35
IO_L8P_T1_34: CON5.20, U06.R3 (IO_L8P_T1_34)
IO_L9N_T1_15: CON3.37
IO_L9N_T1_34: CON5.21, U06.T3 (IO_L9N_T1_DQS_34)
IO_L9P_T1_15: CON3.39
IO_L9P_T1_34: CON5.22, U06.T4 (IO_L9P_T1_DQS_34)
IO_L10N_T1_15: CON3.41
IO_L10P_T1_15: CON3.43
IO_L10P_T1_34: CON5.4, U06.P5 (IO_L10P_T1_34)
IO_L11N_T1_15: CON3.45
IO_L11P_T1_15: CON3.47
IO_L12N_T1_15: CON3.49
IO_L12P_T1_15: CON3.51
IO_L13N_T2_15: CON3.6
IO_L13P_T2_15: CON3.8
IO_L14N_T2_15: CON3.10
IO_L14P_T2_15: CON3.12
IO_L15N_T2_15: CON3.14
IO_L15P_T2_15: CON3.16
IO_L16N_T2_15: CON3.18
IO_L16P_T2_15: CON3.20
IO_L17N_T2_15: CON3.22
IO_L17P_T2_15: CON3.24
IO_L18N_T2_15: CON3.26
IO_L18P_T2_15: CON3.28
IO_L19N_T3_15: CON3.30
IO_L19P_T3_15: CON3.32
IO_L20N_T3_15: CON3.34
IO_L20P_T3_15: CON3.36
IO_L21N_T3_15: CON3.38
IO_L21P_T3_15: CON3.40
IO_L22N_T3_15: CON3.42
IO_L22P_T3_15: CON3.44
IO_L23N_T3_15: CON3.46
IO_L23P_T3_15: CON3.48
IO_L24N_T3_15: CON3.50
IO_L24P_T3_15: CON3.52
IO_O_15: CON3.3
VCC1V8: CON5.24, J04.4, J05.4
VCC3V3: CON3.2, CON5.2, J04.2, J05.2
VCC_1V8: CON3.54
VCC_BK15: J04.1, J04.3, J04.5, U06.A16 (VCCO_15), U06.B13 (VCCO_15), U06.C10 (VCCO_15), U06.E14 (VCCO_15), U06.H15 (VCCO_15), U06.J12 (VCCO_15)
VCC_BK34: J05.1, J05.3, J05.5, U06.M3 (VCCO_34), U06.R4 (VCCO_34), U06.T1 (VCCO_34)
VCC_IO15: CON3.53, J04.6
VCC_IO34: CON5.23, J05.6

Notes on the sheet:
Diferenciales
Single Ended
IO_0_15
IO_25_15
IO_L10N_T1_15
IO_L10P_T1_15
IO_L11N_T1_15
IO_L11P_T1_15
IO_L12N_T1_15
IO_L12P_T1_15
IO_L13N_T2_15
IO_L13P_T2_15
IO_L14N_T2_15
IO_L14P_T2_15
IO_L15N_T2_15
IO_L15P_T2_15
IO_L16N_T2_15
IO_L16P_T2_15
IO_L17N_T2_15
IO_L17P_T2_15
IO_L18N_T2_15
IO_L18P_T2_15
IO_L19N_T3_15
IO_L19P_T3_15
IO_L1N_T0_15
IO_L1P_T0_15
IO_L20N_T3_15
IO_L20P_T3_15
IO_L21N_T3_15
IO_L21P_T3_15
IO_L22N_T3_15
IO_L22P_T3_15
IO_L23N_T3_15
IO_L23P_T3_15
IO_L24N_T3_15
IO_L24P_T3_15
IO_L2N_T0_15
IO_L2P_T0_15
IO_L3N_T0_15
IO_L3P_T0_15
IO_L4N_T0_15
IO_L4P_T0_15
IO_L5N_T0_15
IO_L5P_T0_15
IO_L6N_T0_15
IO_L6P_T0_15
IO_L7N_T1_15
IO_L7P_T1_15
IO_L8N_T1_15
IO_L8P_T1_15
IO_L9N_T1_15
IO_L9P_T1_15
