ciaa/Hardware/PCB/EDU-XILINX/ProyectoKicad/Bank35.sch

## KiCad design PCB/EDU-XILINX/ProyectoKicad/Bank35.sch (2015-11-12)

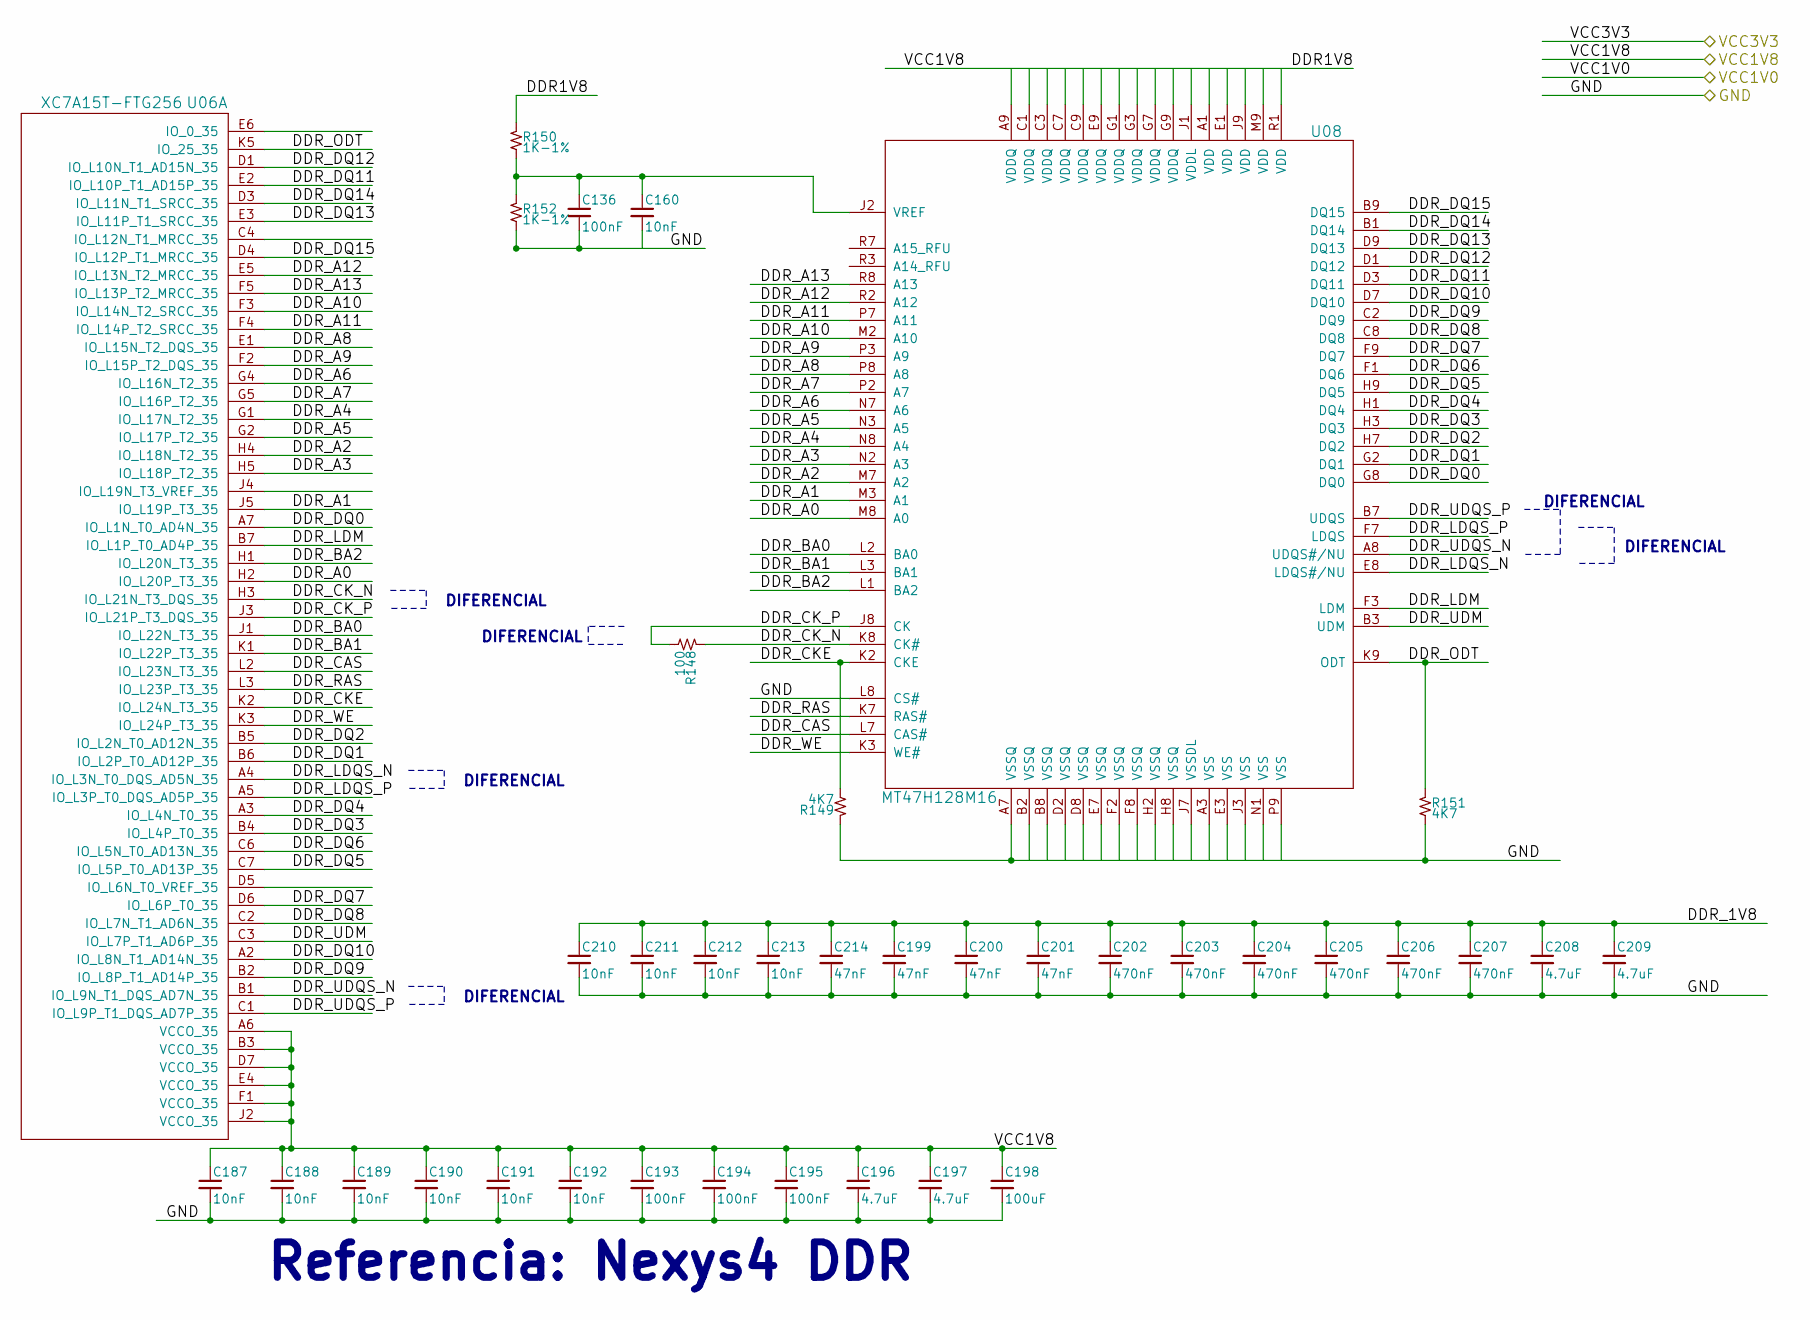
[picture p299: schematic Bank35.sch]

Parts:
C136, C193, C194, C195: 100nF
C160, C187, C188, C189, C190, C191, C192, C210, C211, C212, C213: 10nF
C196, C197, C208, C209: 4.7uF
C198: 100uF
C199, C200, C201, C214: 47nF
C202, C203, C204, C205, C206, C207: 470nF
R148: 100
R149, R151: 4K7
R150, R152: 1K-1%
U06: XC7A15T-FTG256
U8: MT47H128M16

Connections:
DDR1V8: C187.1, C188.1, C189.1, C190.1, C191.1, C192.1, C193.1, C194.1, C195.1, C196.1, C197.1, C198.1, R150.1, U06.A6 (VCCO_35), U06.B3 (VCCO_35), U06.D7 (VCCO_35), U06.E4 (VCCO_35), U06.F1 (VCCO_35), U06.J2 (VCCO_35)
DDR_1V8: C199.1, C200.1, C201.1, C202.1, C203.1, C204.1, C205.1, C206.1, C207.1, C208.1, C209.1, C210.1, C211.1, C212.1, C213.1, C214.1
DDR_A0: U06.H2 (IO_L20P_T3_35), U8.M8 (A0)
DDR_A1: U06.J5 (IO_L19P_T3_35), U8.M3 (A1)
DDR_A2: U06.H4 (IO_L18N_T2_35), U8.M7 (A2)
DDR_A3: U06.H5 (IO_L18P_T2_35), U8.N2 (A3)
DDR_A4: U06.G1 (IO_L17N_T2_35), U8.N8 (A4)
DDR_A5: U06.G2 (IO_L17P_T2_35), U8.N3 (A5)
DDR_A6: U06.G4 (IO_L16N_T2_35), U8.N7 (A6)
DDR_A7: U06.G5 (IO_L16P_T2_35), U8.P2 (A7)
DDR_A8: U06.E1 (IO_L15N_T2_DQS_35), U8.P8 (A8)
DDR_A9: U06.F2 (IO_L15P_T2_DQS_35), U8.P3 (A9)
DDR_A10: U06.F3 (IO_L14N_T2_SRCC_35), U8.M2 (A10)
DDR_A11: U06.F4 (IO_L14P_T2_SRCC_35), U8.P7 (A11)
DDR_A12: U06.E5 (IO_L13N_T2_MRCC_35), U8.R2 (A12)
DDR_A13: U06.F5 (IO_L13P_T2_MRCC_35), U8.R8 (A13)
DDR_BA0: U06.J1 (IO_L22N_T3_35), U8.L2 (BA0)
DDR_BA1: U06.K1 (IO_L22P_T3_35), U8.L3 (BA1)
DDR_BA2: U06.H1 (IO_L20N_T3_35), U8.L1 (BA2)
DDR_CAS: U06.L2 (IO_L23N_T3_35), U8.L7 (CAS#)
DDR_CKE: R149.2, U06.K2 (IO_L24N_T3_35), U8.K2 (CKE)
DDR_CK_N: R148.1, U06.H3 (IO_L21N_T3_DQS_35), U8.K8 (CK#)
DDR_CK_P: R148.2, U06.J3 (IO_L21P_T3_DQS_35), U8.J8 (CK)
DDR_DQ0: U06.A7 (IO_L1N_T0_AD4N_35), U8.G8 (DQ0)
DDR_DQ1: U06.B6 (IO_L2P_T0_AD12P_35), U8.G2 (DQ1)
DDR_DQ2: U06.B5 (IO_L2N_T0_AD12N_35), U8.H7 (DQ2)
DDR_DQ3: U06.B4 (IO_L4P_T0_35), U8.H3 (DQ3)
DDR_DQ4: U06.A3 (IO_L4N_T0_35), U8.H1 (DQ4)
DDR_DQ5: U06.C7 (IO_L5P_T0_AD13P_35), U8.H9 (DQ5)
DDR_DQ6: U06.C6 (IO_L5N_T0_AD13N_35), U8.F1 (DQ6)
DDR_DQ7: U06.D6 (IO_L6P_T0_35), U8.F9 (DQ7)
DDR_DQ8: U06.C2 (IO_L7N_T1_AD6N_35), U8.C8 (DQ8)
DDR_DQ9: U06.B2 (IO_L8P_T1_AD14P_35), U8.C2 (DQ9)
DDR_DQ10: U06.A2 (IO_L8N_T1_AD14N_35), U8.D7 (DQ10)
DDR_DQ11: U06.E2 (IO_L10P_T1_AD15P_35), U8.D3 (DQ11)
DDR_DQ12: U06.D1 (IO_L10N_T1_AD15N_35), U8.D1 (DQ12)
DDR_DQ13: U06.E3 (IO_L11P_T1_SRCC_35), U8.D9 (DQ13)
DDR_DQ14: U06.D3 (IO_L11N_T1_SRCC_35), U8.B1 (DQ14)
DDR_DQ15: U06.D4 (IO_L12P_T1_MRCC_35), U8.B9 (DQ15)
DDR_LDM: U06.B7 (IO_L1P_T0_AD4P_35), U8.F3 (LDM)
DDR_LDQS_N: U06.A4 (IO_L3N_T0_DQS_AD5N_35), U8.E8 (LDQS#/NU)
DDR_LDQS_P: U06.A5 (IO_L3P_T0_DQS_AD5P_35), U8.F7 (LDQS)
DDR_ODT: R151.1, U06.K5 (IO_25_35), U8.K9 (ODT)
DDR_RAS: U06.L3 (IO_L23P_T3_35), U8.K7 (RAS#)
DDR_UDM: U06.C3 (IO_L7P_T1_AD6P_35), U8.B3 (UDM)
DDR_UDQS_N: U06.B1 (IO_L9N_T1_DQS_AD7N_35), U8.A8 (UDQS#/NU)
DDR_UDQS_P: U06.C1 (IO_L9P_T1_DQS_AD7P_35), U8.B7 (UDQS)
DDR_WE: U06.K3 (IO_L24P_T3_35), U8.K3 (WE#)
GND: C136.2, C187.2, C188.2, C189.2, C190.2, C191.2, C192.2, C193.2, C194.2, C195.2, C196.2, C197.2, C198.2, C199.2, C200.2, C201.2, C202.2, C203.2, C204.2, C205.2, C206.2, C207.2, C208.2, C209.2, C210.2, C211.2, C212.2, C213.2, C214.2, R149.1, R151.2, R152.2, U8.A7 (VSSQ), U8.L8 (CS#)
unnamed: C136.1, C160.1, R150.2, R152.1, U8.J2 (VREF)

Notes on the sheet:
Referencia: Nexys4 DDR
DIFERENCIAL
