ciaa/Hardware/PCB/EDU-XILINX/ProyectoKicad/FPGAConfig.sch

## KiCad design PCB/EDU-XILINX/ProyectoKicad/FPGAConfig.sch (2015-11-12)

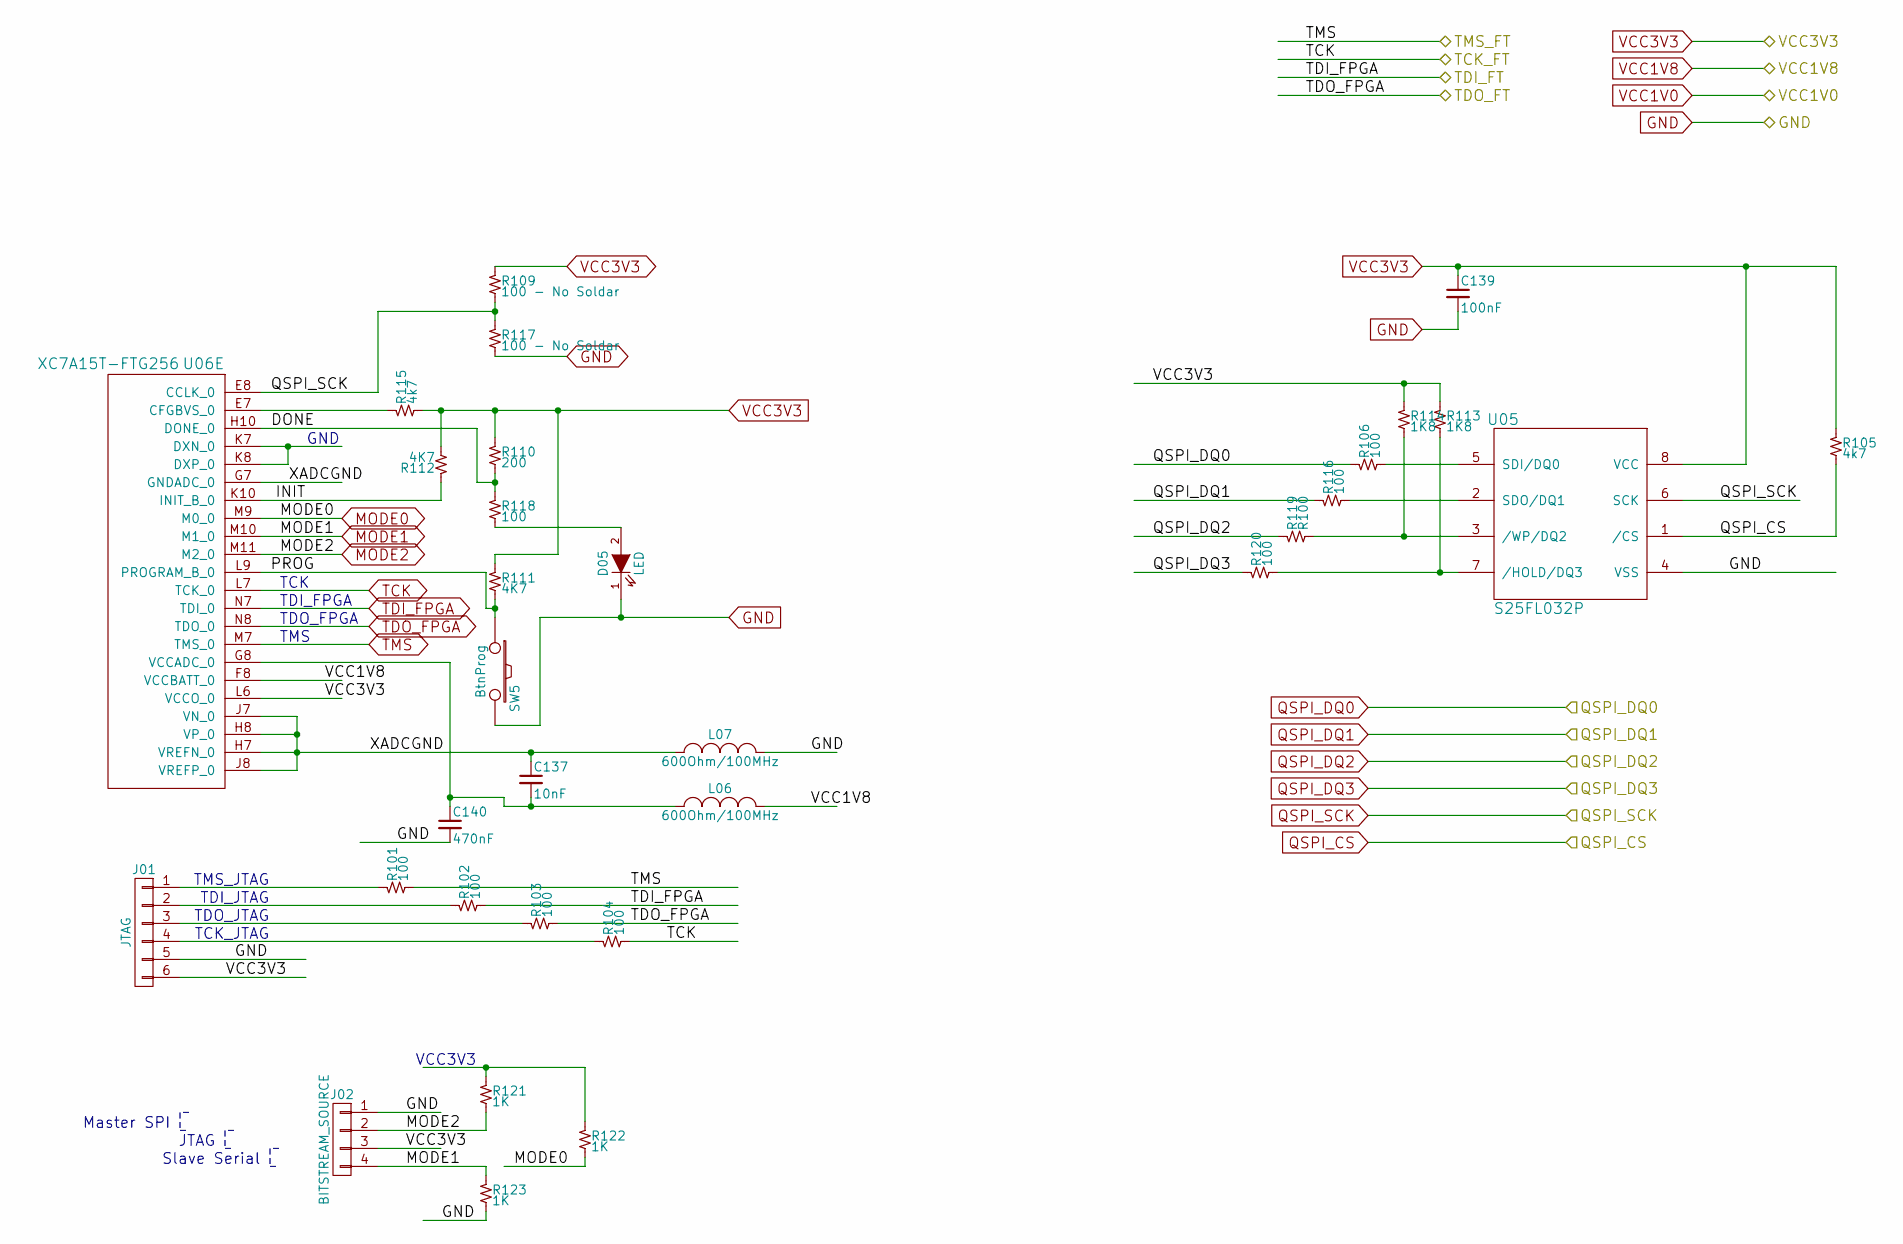
[picture p300: schematic FPGAConfig.sch]

Parts:
C137: 10nF
C139: 100nF
C140: 470nF
D05: LED
J01: JTAG
J02: BITSTREAM_SOURCE
L06, L07: 600Ohm/100MHz
R101, R102, R103, R104, R106, R116, R118, R120: 100
R105, R115: 4k7
R109, R117: 100 - No Soldar
R110: 200
R111, R112: 4K7
R113, R114: 1K8
R119: R100
R121, R122, R123: 1K
SW5: BtnProg
U05: S25FL032P
U06: XC7A15T-FTG256

Connections:
DONE: R110.2, R118.1, U06.H10 (DONE_0)
GND: C139.2, C140.2, D05.1 (K), J01.5, J02.1, L07.2, R117.2, R123.2, SW5.2, U05.4 (VSS)
INIT: R112.1, U06.K10 (INIT_B_0)
MODE0: R122.2, U06.M9 (M0_0)
MODE1: J02.4, R123.1, U06.M10 (M1_0)
MODE2: J02.2, R121.2, U06.M11 (M2_0)
unnamed: C137.2, C140.1, L06.1, U06.G8 (VCCADC_0)
unnamed: D05.2 (A), R118.2
unnamed: J01.1, R101.1
unnamed: J01.2, R102.1
unnamed: J01.3, R103.1
unnamed: J01.4, R104.1
unnamed: R106.2, U05.5 (SDI/DQ0)
unnamed: R113.2, R120.2, U05.7 (/HOLD/DQ3)
unnamed: R114.2, R119.2, U05.3 (/WP/DQ2)
unnamed: R115.1, U06.E7 (CFGBVS_0)
unnamed: R116.2, U05.2 (SDO/DQ1)
unnamed: R121.1, R122.1
unnamed: U06.K7 (DXN_0), U06.K8 (DXP_0)
PROG: R111.2, SW5.1, U06.L9 (PROGRAM_B_0)
QSPI_CS: R105.2, U05.1 (/CS)
QSPI_DQ0: R106.1
QSPI_DQ1: R116.1
QSPI_DQ2: R119.1
QSPI_DQ3: R120.1
QSPI_SCK: R109.2, R117.1, U05.6 (SCK), U06.E8 (CCLK_0)
TCK: R104.2, U06.L7 (TCK_0)
TDI_FPGA: R102.2, U06.N7 (TDI_0)
TDO_FPGA: R103.2, U06.N8 (TDO_0)
TMS: R101.2, U06.M7 (TMS_0)
VCC1V8: L06.2, U06.F8 (VCCBATT_0)
VCC3V3: C139.1, J01.6, J02.3, R105.1, R109.1, R110.1, R111.1, R112.2, R113.1, R114.1, R115.2, U05.8 (VCC), U06.L6 (VCCO_0)
XADCGND: C137.1, L07.1, U06.G7 (GNDADC_0), U06.H7 (VREFN_0), U06.H8 (VP_0), U06.J7 (VN_0), U06.J8 (VREFP_0)

Notes on the sheet:
Master SPI
JTAG
Slave Serial
VCC3V3
TMS_JTAG
TDI_JTAG
TDO_JTAG
TCK_JTAG
GND
TCK
TDI_FPGA
TDO_FPGA
TMS
