ciaa/Hardware/PCB/EDU-XILINX/ProyectoKicad/FPGAPower.sch

## KiCad design PCB/EDU-XILINX/ProyectoKicad/FPGAPower.sch (2015-11-12)

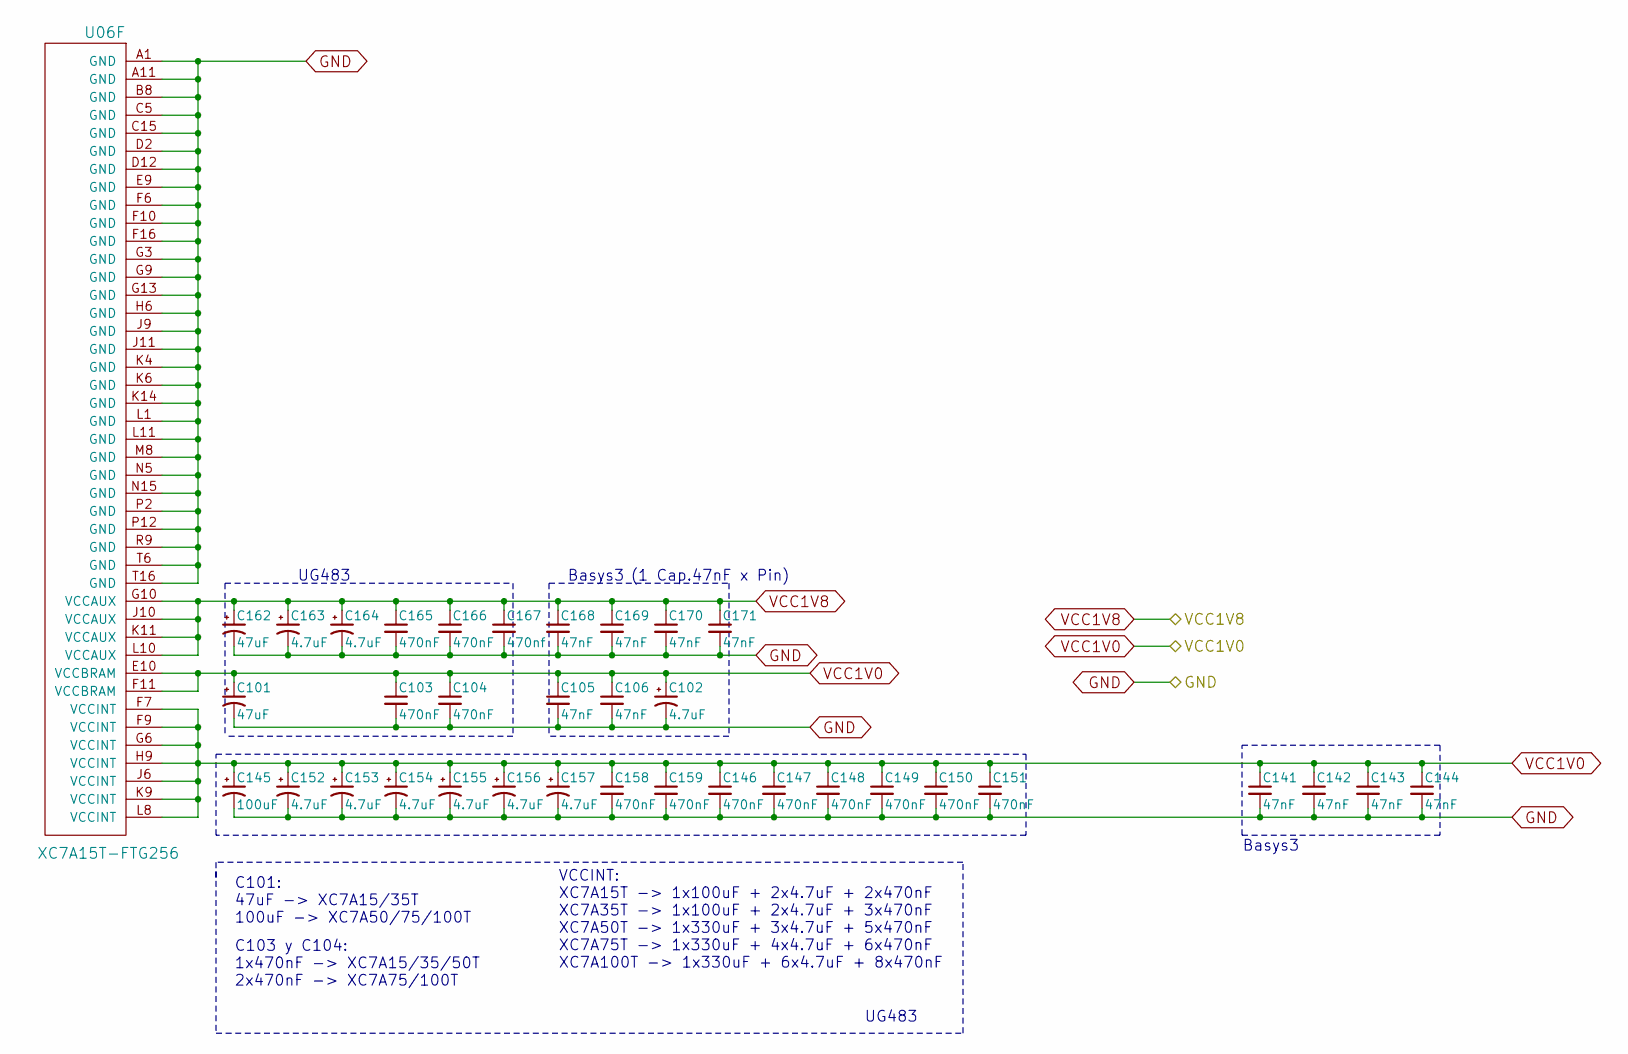
[picture p301: schematic FPGAPower.sch]

Parts:
C101, C162: 47uF
C102, C152, C153, C154, C155, C156, C157, C163, C164: 4.7uF
C103, C104, C146, C147, C148, C149, C150, C151, C158, C159, C165, C166: 470nF
C105, C106, C141, C142, C143, C144, C168, C169, C170, C171: 47nF
C145: 100uF
C167: 470nf
U06: XC7A15T-FTG256

Connections:
GND: C101.2, C102.2, C103.2, C104.2, C105.2, C106.2, C141.2, C142.2, C143.2, C144.2, C145.2, C146.2, C147.2, C148.2, C149.2, C150.2, C151.2, C152.2, C153.2, C154.2, C155.2, C156.2, C157.2, C158.2, C159.2, C162.2, C163.2, C164.2, C165.2, C166.2, C167.2, C168.2, C169.2, C170.2, C171.2, U06.A1 (GND), U06.A11 (GND), U06.B8 (GND), U06.C5 (GND), U06.C15 (GND), U06.D2 (GND), U06.D12 (GND), U06.E9 (GND), U06.F6 (GND), U06.F10 (GND), U06.F16 (GND), U06.G3 (GND), U06.G9 (GND), U06.G13 (GND), U06.H6 (GND), U06.J9 (GND), U06.J11 (GND), U06.K4 (GND), U06.K6 (GND), U06.K14 (GND), U06.L1 (GND), U06.L11 (GND), U06.M8 (GND), U06.N5 (GND), U06.N15 (GND), U06.P2 (GND), U06.P12 (GND), U06.R9 (GND), U06.T6 (GND), U06.T16 (GND)
VCC1V0: C101.1, C102.1, C103.1, C104.1, C105.1, C106.1, C141.1, C142.1, C143.1, C144.1, C145.1, C146.1, C147.1, C148.1, C149.1, C150.1, C151.1, C152.1, C153.1, C154.1, C155.1, C156.1, C157.1, C158.1, C159.1, U06.E10 (VCCBRAM), U06.F7 (VCCINT), U06.F9 (VCCINT), U06.F11 (VCCBRAM), U06.G6 (VCCINT), U06.H9 (VCCINT), U06.J6 (VCCINT), U06.K9 (VCCINT), U06.L8 (VCCINT)
VCC1V8: C162.1, C163.1, C164.1, C165.1, C166.1, C167.1, C168.1, C169.1, C170.1, C171.1, U06.G10 (VCCAUX), U06.J10 (VCCAUX), U06.K11 (VCCAUX), U06.L10 (VCCAUX)

Notes on the sheet:
UG483
Basys3
C101: 47uF -> XC7A15/35T 100uF -> XC7A50/75/100T
C103 y C104: 1x470nF -> XC7A15/35/50T 2x470nF -> XC7A75/100T
VCCINT: XC7A15T -> 1x100uF + 2x4.7uF + 2x470nF XC7A35T -> 1x100uF + 2x4.7uF + 3x470nF XC7A50T -> 1x330uF + 3x4.7uF + 5x470nF XC7A75T -> 1x330uF + 4x4.7uF + 6x470nF XC7A100T -> 1x330uF + 6x4.7uF + 8x470nF
(1 Cap.47nF x Pin)
