ciaa/Hardware/PCB/EDU-XILINX/ProyectoKicad/Power.sch

## KiCad design PCB/EDU-XILINX/ProyectoKicad/Power.sch (2015-11-12)

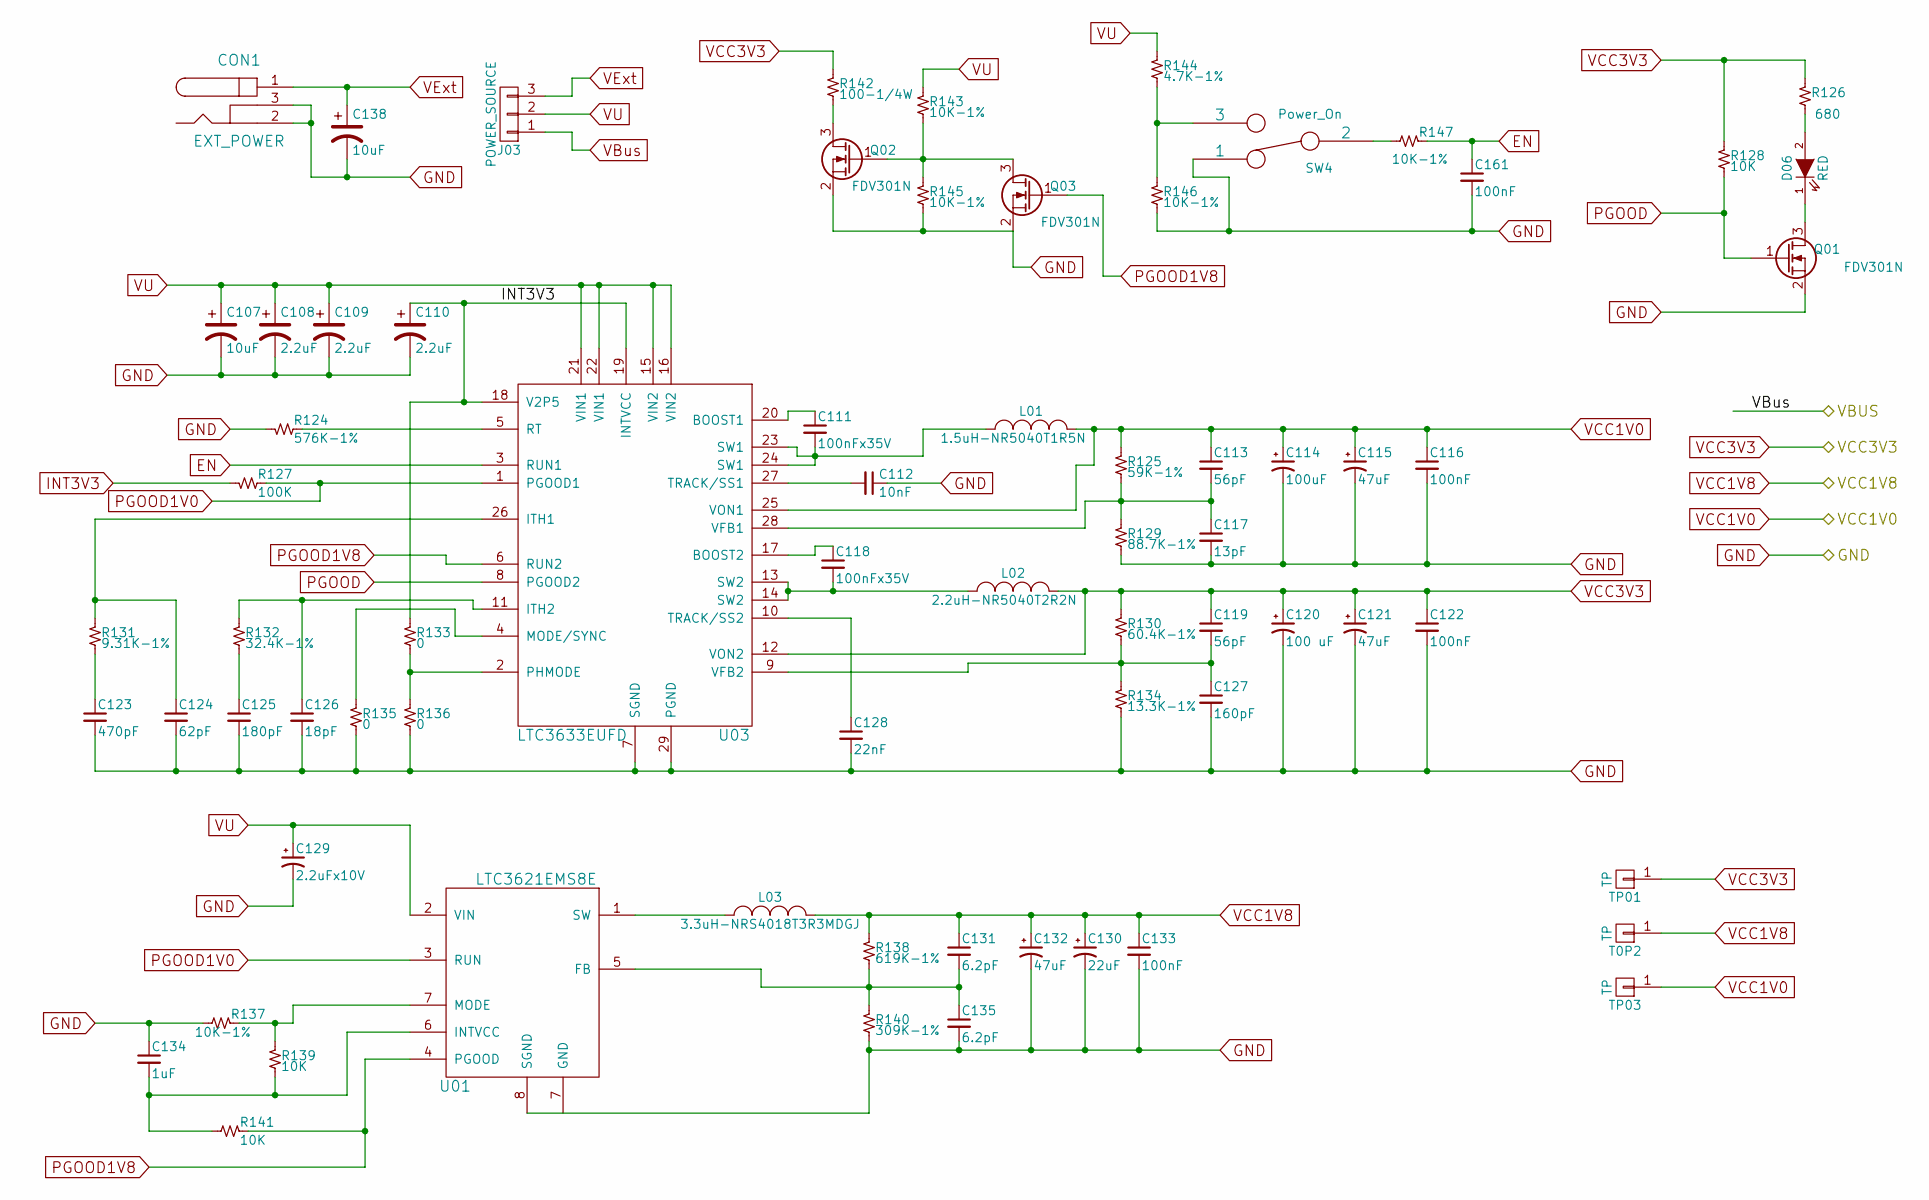
[picture p302: schematic Power.sch]

Parts:
C107, C138: 10uF
C108, C109, C110: 2.2uF
C111, C118: 100nFx35V
C112: 10nF
C113, C119: 56pF
C114: 100uF
C115, C121, C132: 47uF
C116, C122, C133, C161: 100nF
C117: 13pF
C120: 100 uF
C123: 470pF
C124: 62pF
C125: 180pF
C126: 18pF
C127: 160pF
C128: 22nF
C129: 2.2uFx10V
C130: 22uF
C131, C135: 6.2pF
C134: 1uF
CON1: EXT_POWER
D06: RED
J03: POWER_SOURCE
L01: 1.5uH-NR5040T1R5N
L02: 2.2uH-NR5040T2R2N
L03: 3.3uH-NRS4018T3R3MDGJ
Q3, Q4, Q5: FDV301N
R124: 576K-1%
R125: 59K-1%
R126: 680
R127: 100K
R128, R139, R141: 10K
R129: 88.7K-1%
R130: 60.4K-1%
R131: 9.31K-1%
R132: 32.4K-1%
R133, R135, R136: 0
R134: 13.3K-1%
R137, R143, R145, R146, R147: 10K-1%
R138: 619K-1%
R140: 309K-1%
R142: 100-1/4W
R144: 4.7K-1%
SW4: Power_On
T0P2: TP
TP01, TP03: TP
U01: LTC3621EMS8E
U03: LTC3633EUFD

Connections:
EN: C161.1, R147.1, U03.3 (RUN1)
GND: C107.2, C108.2, C109.2, C110.2, C112.1, C114.2, C115.2, C116.2, C117.2, C120.2, C121.2, C122.2, C123.2, C124.2, C125.2, C126.2, C127.2, C128.2, C129.2, C130.2, C132.2, C133.2, C134.1, C135.2, C138.2, C161.2, CON1.2, CON1.3, Q3.2 (S), Q4.2 (S), Q5.2 (S), R124.1, R129.2, R134.2, R135.2, R136.2, R137.2, R140.2, R145.2, R146.2, SW4.1, U01.8 (SGND), U03.7 (SGND), U03.29 (PGND)
INT3V3: C110.1, R127.1, R133.1, U03.18 (V2P5), U03.19 (INTVCC)
unnamed: C111.1, U03.20 (BOOST1)
unnamed: C111.2, L01.1, U03.23 (SW1), U03.24 (SW1)
unnamed: C112.2, U03.27 (TRACK/SS1)
unnamed: C113.2, C117.1, R125.2, R129.1, U03.28 (VFB1)
unnamed: C118.1, U03.17 (BOOST2)
unnamed: C118.2, L02.1, U03.13 (SW2), U03.14 (SW2)
unnamed: C119.2, C127.1, R130.2, R134.1, U03.9 (VFB2)
unnamed: C123.1, R131.2
unnamed: C124.1, R131.1, U03.26 (ITH1)
unnamed: C125.1, R132.2
unnamed: C126.1, R132.1, U03.11 (ITH2)
unnamed: C128.1, U03.10 (TRACK/SS2)
unnamed: C131.2, C135.1, R138.2, R140.1, U01.5 (FB)
unnamed: C134.2, R139.2, R141.2, U01.6 (INTVCC)
unnamed: D06.1 (K), Q3.3 (D)
unnamed: D06.2 (A), R126.2
unnamed: L03.1, U01.1 (SW)
unnamed: Q4.1 (G), Q5.3 (D), R143.2, R145.1
unnamed: Q4.3 (D), R142.2
unnamed: R124.2, U03.5 (RT)
unnamed: R133.2, R136.1, U03.2 (PHMODE)
unnamed: R135.1, U03.4 (MODE/SYNC)
unnamed: R137.1, R139.1, U01.7 (GND)
unnamed: R144.2, R146.1, SW4.3
unnamed: R147.2, SW4.2
PGOOD: Q3.1 (G), R128.2, U03.8 (PGOOD2)
PGOOD1V0: R127.2, U01.3 (RUN), U03.1 (PGOOD1)
PGOOD1V8: Q5.1 (G), R141.1, U01.4 (PGOOD), U03.6 (RUN2)
VBus: J03.1
VCC1V0: C113.1, C114.1, C115.1, C116.1, L01.2, R125.1, TP03.1, U03.25 (VON1)
VCC1V8: C130.1, C131.1, C132.1, C133.1, L03.2, R138.1, T0P2.1
VCC3V3: C119.1, C120.1, C121.1, C122.1, L02.2, R126.1, R128.1, R130.1, R142.1, TP01.1, U03.12 (VON2)
VExt: C138.1, CON1.1, J03.3
VU: C107.1, C108.1, C109.1, C129.1, J03.2, R143.1, R144.1, U01.2 (VIN), U03.15 (VIN2), U03.16 (VIN2), U03.21 (VIN1), U03.22 (VIN1)
