ciaa/Hardware/PCB/EDU-XILINX/ProyectoKicad/Usb.sch

## KiCad design PCB/EDU-XILINX/ProyectoKicad/Usb.sch (2015-11-12)

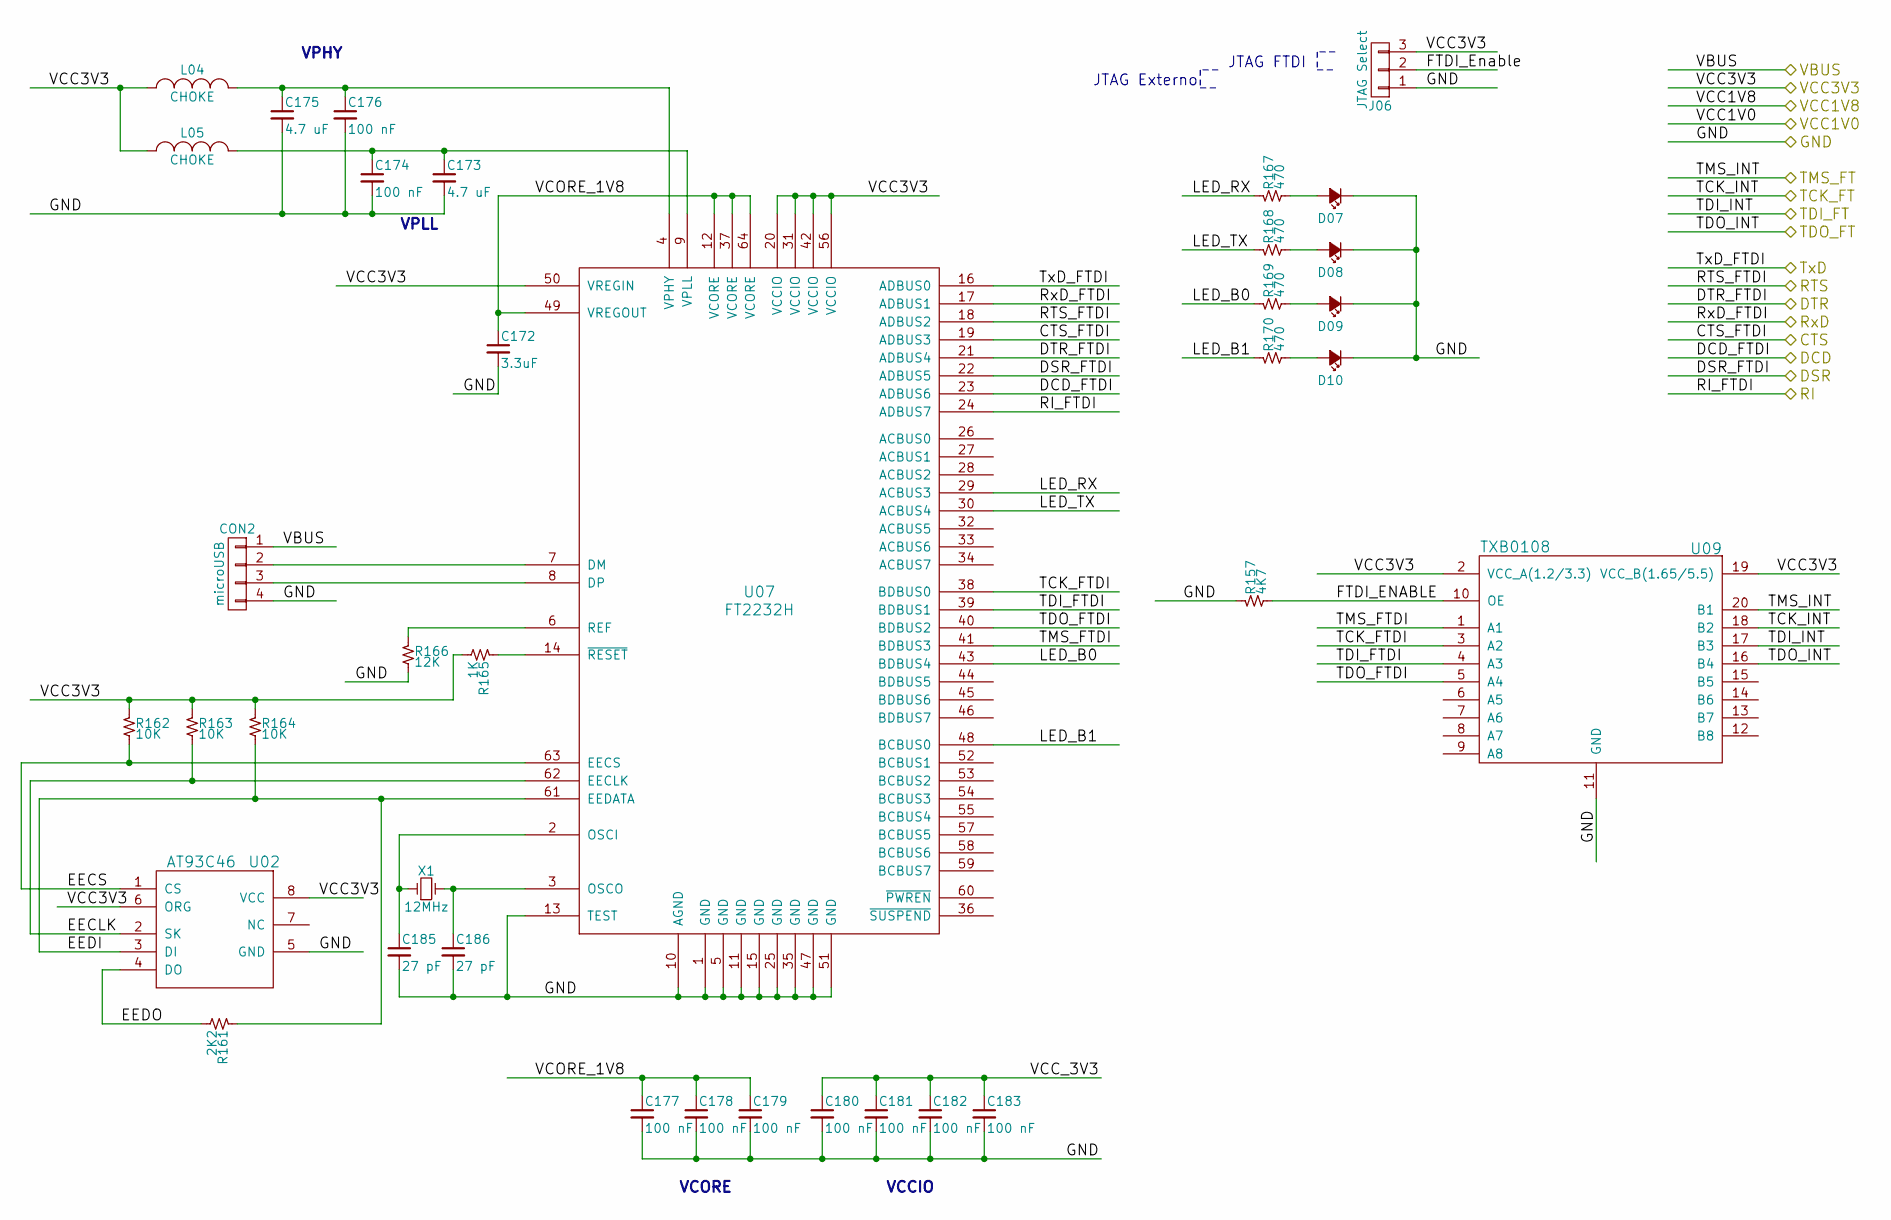
[picture p303: schematic Usb.sch]

Parts:
C172: 3.3uF
C173, C175: 4.7 uF
C174, C176, C177, C178, C179, C180, C181, C182, C183: 100 nF
C185, C186: 27 pF
CON2: microUSB
D07, D08, D09, D10: Led_Small
J06: JTAG Select
L04, L05: CHOKE
R157: 4K7
R161: 2K2
R162, R163, R164: 10K
R165: 1K
R166: 12K
R167, R168, R169, R170: 470
U02: AT93C46
U07: FT2232H
U09: TXB0108
X1: 12MHz

Connections:
CTS: U07.19 (ADBUS3)
DCD: U07.23 (ADBUS6)
DSR: U07.22 (ADBUS5)
DTR: U07.21 (ADBUS4)
EECLK: R163.2, U02.2 (SK), U07.62 (EECLK)
EECS: R162.2, U02.1 (CS), U07.63 (EECS)
EEDI: R161.1, R164.2, U02.3 (DI), U07.61 (EEDATA)
EEDO: R161.2, U02.4 (DO)
FTDI_ENABLE: J06.2, R157.2, U09.10 (OE)
GND: C172.2, C173.2, C174.2, C175.2, C176.2, C177.2, C178.2, C179.2, C180.2, C181.2, C182.2, C183.2, C185.2, C186.2, CON2.4, D07.1 (K), D08.1 (K), D09.1 (K), D10.1 (K), J06.1, R157.1, R166.2, U02.5 (GND), U07.1 (GND), U07.5 (GND), U07.10 (AGND), U07.11 (GND), U07.13 (TEST), U07.15 (GND), U07.25 (GND), U07.35 (GND), U07.47 (GND), U07.51 (GND), U09.11 (GND)
LED_B0: R169.1, U07.43 (BDBUS4)
LED_B1: R170.1, U07.48 (BCBUS0)
LED_RX: R167.1, U07.29 (ACBUS3)
LED_TX: R168.1, U07.30 (ACBUS4)
unnamed: C173.1, C174.1, L05.2, U07.9 (VPLL)
unnamed: C175.1, C176.1, L04.2, U07.4 (VPHY)
unnamed: C185.1, U07.2 (OSCI), X1.1
unnamed: C186.1, U07.3 (OSCO), X1.2
unnamed: CON2.2, U07.7 (DM)
unnamed: CON2.3, U07.8 (DP)
unnamed: D07.2 (A), R167.2
unnamed: D08.2 (A), R168.2
unnamed: D09.2 (A), R169.2
unnamed: D10.2 (A), R170.2
unnamed: R165.1, U07.14 (~RESET)
unnamed: R166.1, U07.6 (REF)
RI: U07.24 (ADBUS7)
RTS: U07.18 (ADBUS2)
RxD: U07.17 (ADBUS1)
TCK_FT: U09.18 (B2)
TCK_FTDI: U07.38 (BDBUS0), U09.3 (A2)
TDI_FT: U09.17 (B3)
TDI_FTDI: U07.39 (BDBUS1), U09.4 (A3)
TDO_FT: U09.16 (B4)
TDO_FTDI: U07.40 (BDBUS2), U09.5 (A4)
TMS_FT: U09.20 (B1)
TMS_FTDI: U07.41 (BDBUS3), U09.1 (A1)
TxD: U07.16 (ADBUS0)
VBUS: CON2.1
VCC3V3: J06.3, L04.1, L05.1, R162.1, R163.1, R164.1, R165.2, U02.6 (ORG), U02.8 (VCC), U07.20 (VCCIO), U07.31 (VCCIO), U07.42 (VCCIO), U07.50 (VREGIN), U07.56 (VCCIO), U09.2 (VCC_A(1.2/3.3)), U09.19 (VCC_B(1.65/5.5))
VCC_3V3: C180.1, C181.1, C182.1, C183.1
VCORE_1V8: C172.1, C177.1, C178.1, C179.1, U07.12 (VCORE), U07.37 (VCORE), U07.49 (VREGOUT), U07.64 (VCORE)

Notes on the sheet:
JTAG Externo
JTAG FTDI
VPHY
VPLL
VCORE
VCCIO
