ciaa/Hardware/(commit log)

2014-04-19 Creación de estructura de directorios inicial
2014-04-19 CIAA-NXP PCB: Pushed version 1.0.
    [.kicad_pcb.kicad_pcb, analog.sch, analog_out.sch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]
2014-04-19 CIAA-NXP: BOM updated
    BOM updated. Modified Profibus transceiver SN65HVD1176DR.
    [analog.sch, analog_out.sch, ciaa-nxp-bom.xlsx, ciaa-nxp.csv, ciaa-nxp.sch, cpu.sch, din.sch, dout.sch]
2014-04-21 Fixed #6: H1 to H4 pad size 5mm, drill size 4mm.
    [ciaa-nxp-B_Cu.gbl, ciaa-nxp-B_Mask.gbs, ciaa-nxp-B_Paste.gbp, ciaa-nxp-B_SilkS.gbo, ciaa-nxp-Edge_Cuts.gbr, ciaa-nxp-F_Cu.gtl, ciaa-nxp-F_Mask.gts, ciaa-nxp-F_Paste.gtp]
2014-05-01 Change in via specs: pad 25mil, drill 10mil.
    [analog.sch, analog_out.sch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]
2014-05-01 Added Digi-Key prices to BOM.
    Also added License to NXP.txt.
    [ciaa-nxp-bom.xlsx]
2014-05-01 BOM updated with pluggable terminal blocks.
    [ciaa-nxp-bom.xlsx]
2014-05-01 Corrected format error in BOM.
    [ciaa-nxp-bom.xlsx]
2014-05-02 Working on BOM.
    [ciaa-nxp-bom.xlsx]
2014-05-02 BOM changed to ODS format.
    [ciaa-nxp-bom.ods, ciaa-nxp-bom.xlsx]
2014-05-02 BOM: Restored XLSX format. Corrected shipping calculation for each CIAA.
    [ciaa-nxp-bom.ods, ciaa-nxp-bom.xlsx]
2014-05-05 BOM: Corrected error in import fees formula.
    [ciaa-nxp-bom.ods, ciaa-nxp-bom.xlsx]
2014-05-06 Initial draft.
    [.kicad_pcb.kicad_pcb, analog.sch, analog_out.sch, ciaa-rx.kicad_pcb, ciaa-rx.sch, cpu.sch, din.sch, dout.sch]
2014-06-10 Comienzo de correcciones al esquemático. P12 ruteado (#2), P9 quitado. DRC verificado.
    [analog.sch, analog_out.sch, ciaa-nxp.sch, cpu.sch, din.sch, dout.sch, ethernet.sch, fuente.sch]
2014-06-16 EDU-CIAA-NXP Ini
    Se trata de una modificación del proyecto original en busca de una simplificación del hardware de modo que permita una implementación sencilla. De esta forma se busca que sea un prototipo que permita a alumnos de escuelas Secundarias, Terciarios e Ingenierias iniciarse en el desarrollo de aplicaciones con la CIAA.
    [CIAA_KIDS_Pinouts_Rev_0.0.xlsx, Modulos_hardwar_a_incluir.xlsx, ON_BOARD_IO.sch, cpu.sch, edu-ciaa-nxp.sch, fuente.sch, gpio.sch, rsS485_rs232_can.sch]
2014-06-16 Modificación de directorio
    [CIAA_KIDS_Pinouts_Rev_0.0.xlsx, Modulos_hardwar_a_incluir.xlsx, ON_BOARD_IO.sch, cpu.sch, edu-ciaa-nxp.sch, fuente.sch, gpio.sch, rsS485_rs232_can.sch]
2014-06-16 Versión 1.0 de la EDU-CIAA-NXP
    [CIAA_KIDS_Pinouts_Rev_0.0.xlsx, Modulos_hardwar_a_incluir.xlsx, ON_BOARD_IO.sch, cpu.sch, edu-ciaa-nxp.sch, fuente.sch, gpio.sch, rsS485_rs232_can.sch]
2014-06-18 CIAA-NXP: #32 corrected in schematic. Close #32
    [analog.sch, analog_out.sch, ciaa-nxp.sch, cpu.sch, din.sch, dout.sch, ethernet.sch, fuente.sch]
2014-06-24 Versión completa del esquemático con todos los componentes ya definidos
    [ON_BOARD_IO.sch, cpu.sch, edu-ciaa-nxp.kicad_pcb, edu-ciaa-nxp.sch, fuente.sch, gpio.sch, rsS485_rs232_can.sch, usb_otg.sch]
2014-06-28 Updating BOM for CIAA-NXP.
    [ciaa-nxp-bom.ods]
2014-06-28 Added first release of CIAA-FSL (Freescale K60).
    [CIAA_K60.kicad_pcb, CIAA_K60.sch, CIAA_K60.xls, JTAG.sch, analog.sch, analog_out.sch, cpu.sch, din.sch]
2014-06-29 El PCB tiene el tamaño de la CIAA-NXP y se colocaron los componentes en una distribución provisoria
    [ON_BOARD_IO.sch, cpu.sch, edu-ciaa-nxp.kicad_pcb, edu-ciaa-nxp.sch, fuente.sch, gpio.sch, rsS485_rs232_can.sch, usb_otg.sch]
2014-06-30 Borrado de archivos viejos
    [CIAA_K60.xls]
2014-07-01 Se eliminaron archivos en uso.
    [CIAA_K60.kicad_pcb]
2014-07-07 Modified Profibus termination resistors (#3). Removed backup PCB file.
    [analog.sch, analog_out.sch, ciaa-nxp.sch, cpu.sch, din.sch, dout.sch, ethernet.sch, fuente.sch]
2014-07-07 RS232 shield pads to GND (#4).
    [analog.sch, analog_out.sch, ciaa-nxp.kicad_pcb, din.sch, dout.sch, fuente.sch, gpio.sch, mem.sch]
2014-07-07 Corrected X1 pin assignment in CPU schematic (#7).
    [cpu.sch]
2014-07-07 Corrected BAV199 pin assignment (#17).
2014-07-07 Corrected C68 placement in schematic (#18).
    [cpu.sch]
2014-07-08 Se cambiaron los leds - Avances sobre el ruteo del PCB
    [ON_BOARD_IO.sch, cpu.sch, edu-ciaa-nxp.kicad_pcb, edu-ciaa-nxp.sch, fuente.sch, gpio.sch, rsS485_rs232_can.sch, usb_otg.sch]
2014-07-10 Corrected component and pin assignment for reset switch in schematic (#19).
    [analog.sch, analog_out.sch, ciaa-nxp.sch, cpu.sch, din.sch, dout.sch, ethernet.sch, fuente.sch]
2014-07-10 CPU sch: R92 value to 100k. TRST/nTRST and RESET/RST connected with jumper (#34).
    [cpu.sch]
2014-07-10 CPU sch: DBG USB connector to type micro-B.
    [cpu.sch]
2014-07-10 CPU sch: Reset RC network changed to 100k/10nF. Close #36.
    [cpu.sch]
2014-07-10 Fuente sch: Se corrigió símbolo de ZA14 (#15).
    [cpu.sch, fuente.sch]
2014-07-11 Updated DB9 symbol including TH shield pins.
    [analog.sch, analog_out.sch, ciaa-nxp.sch, cpu.sch, din.sch, dout.sch, ethernet.sch, fuente.sch]
2014-07-11 Documento original de revisión, prueba de pushh para GitHub desde PC de Mauro (Emtech)
2014-07-12 Current limiters changed to NSI50010 (10mA). U5 updated for profibus networks (SN65HVD1176DR).
    [analog.sch, analog_out.sch, ciaa-nxp.sch, cpu.sch, din.sch, dout.sch, ethernet.sch, fuente.sch]
2014-07-12 Se completó el ruteo del PCB
    [ON_BOARD_IO.sch, cpu.sch, edu-ciaa-bom_x100_v1.0.xlsx, edu-ciaa-nxp.kicad_pcb, edu-ciaa-nxp.sch, fuente.sch, gpio.sch, rsS485_rs232_can.sch]
2014-07-14 PCB V0.0 finalizado - Se agregaron planos de masa, control de dimensiones y perforaciones, se agregó el LOGO
    [ON_BOARD_IO.sch, cpu.sch, edu-ciaa-nxp.kicad_pcb, edu-ciaa-nxp.sch, fuente.sch, gpio.sch, rsS485_rs232_can.sch, usb_otg.sch]
2014-07-17 Teclas THT y conectores micro USB THT
    [Copia de edu-ciaa-bom_x100_v1.0.xlsx, ON_BOARD_IO.sch, cpu.sch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]
2014-07-21 agregados los GS11 y 13. (#34) falta rutearlos
    [ciaa-nxp.kicad_pcb]
2014-07-21 Borrado P9 (#2)
    [ciaa-nxp.kicad_pcb]
2014-07-22 corregidos los planos de disipación
    [ciaa-nxp.kicad_pcb]
2014-07-23 Conectados los pads TH de J3 a GND (#4)
    [ciaa-nxp.kicad_pcb]
2014-07-23 Cambio de filtros en 0603 por MI0805M221R-10 (encapsulado 0805)
    [ON_BOARD_IO.sch, cpu.sch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]
2014-07-24 Corregida la asignación de pines de X1 (#7)
    [ciaa-nxp.kicad_pcb]
2014-07-25 Se cambio el ancho de las pistas asociadas a las borneras (#5) Excepto las del bus can y RS-485.
    [ciaa-nxp.kicad_pcb]
2014-07-28 Actualizacion de esquematicos. Circuito impreso y modelos 3D
    [CIAA_K60.kicad_pcb, CIAA_K60.sch, JTAG.sch, analog.sch, analog_out.sch, cpu.sch, din.sch, dout.sch]
2014-07-28 Hojas de datos
2014-07-28 Indicador de orientación de IC1 e IC2 en el exterior de la parte, capa SSB. (#11)
    [ciaa-nxp.kicad_pcb]
2014-07-28 Pads de D2 de mayor tamaño, correspondiente a el footprint DO-214AB, SMC CASE 403-03 (PN: MURSxxxxT3G) (#12)
    [ciaa-nxp.kicad_pcb]
2014-07-28 R40 pasado a SMD1210n (#13)
    [ciaa-nxp.kicad_pcb]
2014-07-28 Cambio de encapsulado: TH9=TH2,3,4,5,6,7 TH8==>SMD1812 TH1 sin cambios (#14)
    [ciaa-nxp.kicad_pcb]
2014-07-29 Se umento la marca de polaridad de ZA14 en SB (#15)
    [ciaa-nxp.kicad_pcb]
2014-07-29 Aumentada la marca en Silkscreen de polaridad de T1 a T12 (#16)
    [ciaa-nxp.kicad_pcb]
2014-07-29 Corregido pines de los BAV199, D9,10,11,12,46 y D48 (#17)
    [ciaa-nxp.kicad_pcb]
2014-07-29 Cambiado la polaridad de C68 (#18)
    [ciaa-nxp.kicad_pcb]
2014-07-29 Corregido asignación de pines del pulsador SW1 (#19)
    [ciaa-nxp.kicad_pcb]
2014-07-30 Modificdo el footprint de C16 (PN:UCL1V471MNL1GS) (#20)
    [ciaa-nxp.kicad_pcb]
2014-07-30 Movido el contorno de la placa 1mm en todos sus lados para aumentar su tamaño. H2 y H3 1mm hacia arriba. H1 y H4 1mm hacia abajo. (#21)
    [ciaa-nxp.kicad_pcb]
2014-07-31 Cambiado los footprint de D6,7 y D8 a DO-214AA. (#31)
    [ciaa-nxp.kicad_pcb]
2014-07-31 ruteo de RST y nRST (#34)
    [ciaa-nxp.kicad_pcb]
2014-07-31 conexión del TAB de U4 a GND (#38)
    [ciaa-nxp.kicad_pcb]
2014-07-31 Asignado TAB de U4 a +3.3V (#38)
    [ciaa-nxp.kicad_pcb]
2014-07-31 Ser agregaron planos asociados a los pinesde SW1 para aumentar la rigidez mecánica (#38)
    [ciaa-nxp.kicad_pcb]
2014-07-31 AGREGADO EL LOGO Y EL NÚMERO DE VERSIÓN (#10)
    [ciaa-nxp.kicad_pcb]
2014-08-04 Ruteado P12 (#2) falta mejorar el diseño, textos, formas, correr el DRC y generar gerbers.
    [ciaa-nxp.kicad_pcb]
2014-08-05 BOM updated with latest changes. Part numbers updated: - 10mA current regulators. - MURS360T3G diode.
    [analog.sch, analog_out.sch, ciaa-nxp-bom.ods, ciaa-nxp-bom.xlsx, ciaa-nxp.csv, ciaa-nxp.sch, cpu.sch, din.sch]
2014-08-05 correcciones de forma
    [ciaa-nxp.kicad_pcb]
2014-08-05 Resistors added on open drain outputs.
    [ciaa-nxp-bom.ods, ciaa-nxp-bom.xlsx, ciaa-nxp.csv, dout.sch]
2014-08-07 fin de ruteo-falta revisión
    [ciaa-nxp-B_Cu.gbl, ciaa-nxp-B_Mask.gbs, ciaa-nxp-B_Paste.gbp, ciaa-nxp-B_SilkS.gbo, ciaa-nxp-Edge_Cuts.gbr, ciaa-nxp-F_Cu.gtl, ciaa-nxp-F_Mask.gts, ciaa-nxp-F_Paste.gtp]
2014-08-08 Actualizacion de Licencia y avances
    [CIAA_K60.kicad_pcb, CIAA_K60.sch, JTAG.sch, cpu.sch, dout.sch, usb_otg.sch]
2014-08-08 agregado algunos modelos 3d
    [ciaa-nxp.kicad_pcb]
2014-08-13 Cambidas las lasidas OD de orden y la disponibilidad de +24v y tierra en corneras. Falta cambio de salidas de relé
    [analog.sch, analog_out.sch, ciaa-nxp.kicad_pcb, ciaa-nxp.sch, cpu.sch, din.sch, dout.sch, ethernet.sch]
2014-08-15 Reacomodado el PIN OUT de borneras de salidas y pines de soporte de batería (#40) Falta corregir planos, textos y generar los gerbers
    [analog.sch, analog_out.sch, ciaa-nxp.kicad_pcb, ciaa-nxp.sch, cpu.sch, din.sch, dout.sch, ethernet.sch]
2014-08-15 detalles y generación de gerbers
    [ciaa-nxp-B_Cu.gbl, ciaa-nxp-B_Mask.gbs, ciaa-nxp-B_Paste.gbp, ciaa-nxp-B_SilkS.gbo, ciaa-nxp-Edge_Cuts.gbr, ciaa-nxp-F_Cu.gtl, ciaa-nxp-F_Mask.gts, ciaa-nxp-F_Paste.gtp]
2014-08-17 #8 corrected C80 Digi-Key code in BOM. Closed.
    [ciaa-nxp-bom.ods, ciaa-nxp-bom.xlsx]
2014-08-18 #41 Open-Drain outputs and Optocoupler input circuits enhanced.
    [analog.sch, analog_out.sch, ciaa-nxp.sch, cpu.sch, din.sch, dout.sch, ethernet.sch, fuente.sch]
2014-08-18 #43 BOM-NXP Updated
    [ciaa-nxp-bom.ods, ciaa-nxp-bom.xls, ciaa-nxp-bom.xlsx]
2014-08-19 #45 added PoE connector (P1) and expansion (P3).
    [analog.sch, analog_out.sch, ciaa-nxp.sch, cpu.sch, din.sch, dout.sch, ethernet.sch, fuente.sch]
2014-08-19 #45 P3 enhanced.
    [analog.sch, analog_out.sch, din.sch, dout.sch, ethernet.sch, fuente.sch, gpio.sch, mem.sch]
2014-08-20 #46 BOM updated. Close #46.
    [ciaa-nxp-bom.ods, ciaa-nxp-bom.xls, ciaa-nxp.csv]
2014-08-20 #46 BOM updated again. Qty correction for P6SMB33CA.
    [ciaa-nxp-bom.ods, ciaa-nxp-bom.xls]
2014-08-21 Removed old, confusing files from PCB/NXP/docs :(
    [ciaa-nxp.sch]
2014-08-21 - Actualización del diseño
    [CIAA_K60.kicad_pcb, CIAA_K60.sch, dout.sch]
2014-08-21 - Actualización de esquemático
2014-08-21 - Actualización documentación y 3D - Agregado de datasheets
2014-08-21 #48 BOM updated: using 100nF/50V and 10nF/50V ceramic capacitors.
    [ciaa-nxp-bom.ods, ciaa-nxp-bom.xls]
2014-08-21 #48 BOM updated: using 330uF/16V aluminum capacitor.
    [ciaa-nxp-bom.ods, ciaa-nxp-bom.xls]
2014-08-22 modificaciones varias. Reemplazo de conector ethernet, jumpers a thruhole, agregado de P1 etc. Falta Place y rutear
    [ciaa-nxp-bom.xls, ciaa-nxp.kicad_pcb]
2014-08-25 - Actualizado PCB - Actualizado documentación - Agregado scripts complementarios de kicad.
    [CIAA_K60.kicad_pcb, CIAA_K60.ods, CIAA_K60.sch, cpu.sch, din.sch, rsS485_rs232_can.sch]
2014-08-28 BOM actualizado
    [Copia de edu-ciaa-bom_x100_v1.0.xlsx, ON_BOARD_IO.sch, cpu.sch, edu-ciaa-bom_x100_v1.3.xlsx, edu-ciaa-nxp - copia.kicad_pcb, edu-ciaa-nxp.kicad_pcb, edu-ciaa-nxp.sch, fuente.sch]
2014-08-31 Se reordenaron las librerías de componentes
    [edu-ciaa-nxp - copia.kicad_pcb]
2014-08-31 README Actualizado
    [edu-ciaa-nxp-B_Cu.gbl, edu-ciaa-nxp-B_Mask.gbs, edu-ciaa-nxp-B_Paste.gbp, edu-ciaa-nxp-B_SilkS.gbo, edu-ciaa-nxp-Edge_Cuts.gbr, edu-ciaa-nxp-F_Cu.gtl, edu-ciaa-nxp-F_Mask.gts, edu-ciaa-nxp-F_Paste.gtp]
2014-09-03 ciaa-nxp-bom: Jumper qty corrected.
    [ciaa-nxp-bom.ods, ciaa-nxp-bom.xls]
2014-09-07 Actualización de librerías 3D
2014-09-07 PCB Actualizado para comenzar el ruteo
    [edu-ciaa-nxp.kicad_pcb]
2014-09-15 - Corregido PCB, según revisiones en doc/revisiones - Actualizado documentación - Modificados 3D para que se vean bien en Freecad
    [CIAA_K60.kicad_pcb, CIAA_K60.sch, JTAG.sch, analog.sch, analog_out.sch, cpu.sch, din.sch, dout.sch]
2014-09-16 Versión pcb 0.1
    [edu-ciaa-nxp.kicad_pcb]
2014-09-17 Actualizado PCB, CIAA-FSL versión CEIBO 1.0 Actualizado documentación Agregado Gerber y documentos para la fabricación versión CEIBO 1.0
    [CIAA_K60-BOT.gbl, CIAA_K60-B_Mask.gbs, CIAA_K60-B_Paste.gbp, CIAA_K60-B_SilkS.gbo, CIAA_K60-Dwgs_User.gbr, CIAA_K60-Edge_Cuts.gbr, CIAA_K60-F_Mask.gts, CIAA_K60-F_Paste.gtp]
2014-09-18 Pcb finalizado
    [edu-ciaa-nxp.kicad_pcb]
2014-09-19 Modificado script para optimizar el BoM. Ahora agrega info del PCB. El BoM se encuentra ahora en CIAA_K60/doc/CIAA_K60-BoM.csv
    [CIAA_K60-BoM.csv, CIAA_K60.ods]
2014-09-25 Se agregó USB-OTH en los esquemáticos
    [ON_BOARD_IO.sch, cpu.sch, edu-ciaa-nxp.kicad_pcb, edu-ciaa-nxp.sch, fuente.sch, gpio.sch, rsS485_can.sch, usb.sch]
2014-09-26 se termino el place y ruteo, falta DRC y estetico.
    [ciaa-nxp.kicad_pcb]
2014-09-26 DRC y textos revisados- Falta revisión final para generar gerbers
    [ciaa-nxp.kicad_pcb]
2014-09-29 BOM updated with new revision of LPC4337.
    [ciaa-nxp-bom.ods, ciaa-nxp-bom.xls]
2014-09-29 gerbers generados y actualizada la descripción del PCB
    [analog.sch, analog_out.sch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]
2014-10-09 PCB: se completó USB-OTH Se agregó conector de alimentación Se agregó una alimentación analógica en el conector P1 Se mejoraron algunos aspectos del ruteado Se verificaron las posiciones de los conec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
    [edu-ciaa-nxp.kicad_pcb]
2014-10-15 Placa con mejoras en los pads de tierra
    [edu-ciaa-nxp.kicad_pcb]
2014-10-22 La documentación se modificó a formato OpenDocument
    [CIAA_KIDS_Pinouts_Rev_0.0.ods, CIAA_KIDS_Pinouts_Rev_0.0.xlsx, Modulos_hardwar_a_incluir.ods, Modulos_hardwar_a_incluir.xlsx, edu-ciaa-bom_x100_v1.3.ods, edu-ciaa-bom_x100_v1.3.xlsx]
2014-10-22 Se eliminó un archivo del BOM mal ubicado
    [edu-ciaa-bom_x100_v1.0.xlsx]
2014-10-22 Modificaciones del PCB propuestos por la segunda revisión
    [ON_BOARD_IO.sch, cpu.sch, edu-ciaa-bom_x100_v1.3.ods, edu-ciaa-bom_x100_v1.4.ods, edu-ciaa-nxp.sch, fuente.sch, gpio.sch, rsS485_can.sch]
2014-10-22 Modificaciones en el silkscreen
    [edu-ciaa-nxp.kicad_pcb]
2014-10-25 Se modificaron las librerías para que el silkscreen no pise los pads de soldadura
2014-10-26 Logo Open Hardware
    [ON_BOARD_IO.sch, cpu.sch, edu-ciaa-nxp.sch, fuente.sch, gpio.sch, rsS485_can.sch, rsS485_rs232_can.sch, usb.sch]
2014-10-26 PCB Actualizado, Gerber plots y Drill file
    [edu-ciaa-nxp-B_Cu.gbl, edu-ciaa-nxp-B_Mask.gbs, edu-ciaa-nxp-B_Paste.gbp, edu-ciaa-nxp-B_SilkS.gbo, edu-ciaa-nxp-Edge_Cuts.gbr, edu-ciaa-nxp-F_Cu.gtl, edu-ciaa-nxp-F_Mask.gts, edu-ciaa-nxp-F_Paste.gtp]
2014-10-29 Gerber plots finales
    [edu-ciaa-nxp-B_Cu.gbl, edu-ciaa-nxp-B_Mask.gbs, edu-ciaa-nxp-B_Paste.gbp, edu-ciaa-nxp-B_SilkS.gbo, edu-ciaa-nxp-Edge_Cuts.gbr, edu-ciaa-nxp-F_Cu.gtl, edu-ciaa-nxp-F_Mask.gts, edu-ciaa-nxp-F_Paste.gtp]
2014-11-27 BOM corregido
    [edu-ciaa-bom_x100_v2.0.ods]
2014-11-27 Modificaciones propuestas por JMCruz
    [ON_BOARD_IO.sch, cpu.sch, edu-ciaa-bom_x100_v2.0.ods, edu-ciaa-nxp.kicad_pcb, edu-ciaa-nxp.sch, fuente.sch, gpio.sch, rsS485_can.sch]
2014-11-29 Se cargaron los datasheets en EDU-NXP/Datasheets y en el BOM
    [ON_BOARD_IO.sch, cpu.sch, edu-ciaa-bom_x100_v2.0.ods, edu-ciaa-nxp.sch, fuente.sch, gpio.sch, rsS485_can.sch, usb.sch]
2014-12-06 Se documentaron todos los componentes en el esquemático
    [ON_BOARD_IO.sch, cpu.sch, edu-ciaa-bom_x100_v2.0.ods, edu-ciaa-nxp.sch, fuente.sch, gpio.sch, rsS485_can.sch, usb.sch]
2014-12-19 CIAA PIC sch layers preliminar
    [Asignacion pines CIAA-PIC.ods, analog.sch, analog_out.sch, ciaa-pic.sch, cpu.sch, din.sch, dout.sch, ethernet.sch]
2014-12-22 CIAA-FSL Versión CEIBO 1.1 - Resumen de cambios en FSL/CIAA_K60/doc/modificaciones - Agregado info de puesta en marcha CEIBO 1.0 - Agregado info de fabricación de la CEIBO 1.0
    [CIAA_K60-BoM.csv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]
2014-12-26 Primeros pasos de la EDU-CIAA-FSL
    [CIAA_K60-BoM.csv, EDU_CIAA_K60.kicad_pcb, EDU_CIAA_K60.sch, JTAG.sch, cpu.sch, fuente.sch, gpio.sch, on_board_io.sch]
2014-12-27 Conectores GPIO actualizados
    [EDU_CIAA_K60.sch, JTAG.sch, cpu.sch, fuente.sch, gpio.sch, on_board_io.sch, rsS485.sch, usb_otg.sch]
2015-01-01 Primer versión del Esquemático de la EDU-CIAA-FSL completo sujeto a revisión
    [EDU_CIAA_K60.sch, JTAG.sch, cpu.sch, fuente.sch, gpio.sch, on_board_io.sch, rsS485.sch, usb_otg.sch]
2015-01-02 Letras de identificación de los componentes en el SCH modificados según la AppNote 10834: "Class Designation Letters For Reference Designations"
    [EDU_CIAA_K60.kicad_pcb, EDU_CIAA_K60.sch, JTAG.sch, cpu.sch, fuente.sch, gpio.sch, on_board_io.sch, rsS485.sch]
2015-01-02 CIAA PIC correccion FT232RL
    [analog.sch, analog_out.sch, ciaa-pic.sch, cpu.sch, din.sch, dout.sch, ethernet.sch, fuente.sch]
2015-01-05 Borrado de archivos innecesarios
2015-01-06 Se agregó la librería
    [EDU_CIAA_K60.sch, JTAG.sch, cpu.sch, fuente.sch, gpio.sch, on_board_io.sch, rsS485.sch, usb_otg.sch]
2015-01-13 Componentes en el PCB sin acomodar
    [.kicad_pcb.kicad_pcb, EDU_CIAA_K60.sch, JTAG.sch, cpu.sch, fuente.sch, gpio.sch, on_board_io.sch, rsS485.sch]
2015-01-15 Modificaciones en los puertos de expansión para que sea compatible con la EDU-CIAA-NXP
    [.kicad_pcb.kicad_pcb, EDU_CIAA_K60.kicad_pcb, EDU_CIAA_K60.sch, JTAG.sch, cpu.sch, fuente.sch, gpio.sch, on_board_io.sch]
2015-01-19 Componentes ubicados en el PCB para comenzar el ruteo
    [EDU_CIAA_K60.kicad_pcb, EDU_CIAA_K60.sch, JTAG.sch, cpu.sch, fuente.sch, gpio.sch, on_board_io.sch, rsS485.sch]
2015-02-03 EDU-CIAA-NXP V1.0 lista para la producción
    [edu-ciaa-nxp-B_Cu.gbl, edu-ciaa-nxp-B_Mask.gbs, edu-ciaa-nxp-B_Paste.gbp, edu-ciaa-nxp-B_SilkS.gbo, edu-ciaa-nxp-Edge_Cuts.gbr, edu-ciaa-nxp-F_Cu.gtl, edu-ciaa-nxp-F_Mask.gts, edu-ciaa-nxp-F_Paste.gtp]
2015-02-09 C5 modificado en el BOM
    [edu-ciaa-bom_x100_v2.0.ods]
2015-02-11 BOM actualizado a versión 2.1
    [edu-ciaa-bom_x100_v2.0.ods, edu-ciaa-bom_x100_v2.1.ods]
2015-02-16 minor corrections after probattery's feedback
    [ciaa-nxp-B_Cu.gbl, ciaa-nxp-B_Mask.gbs, ciaa-nxp-B_Paste.gbp, ciaa-nxp-B_SilkS.gbo, ciaa-nxp-Edge_Cuts.gbr, ciaa-nxp-F_Cu.gtl, ciaa-nxp-F_Mask.gts, ciaa-nxp-F_Paste.gtp]
2015-03-07 PCB Versión 1.1: Se reordenaron las leyendas y graficos del silkscreen
    [edu-ciaa-nxp-B_Cu.gbl, edu-ciaa-nxp-B_Mask.gbs, edu-ciaa-nxp-B_Paste.gbp, edu-ciaa-nxp-B_SilkS.gbo, edu-ciaa-nxp-Edge_Cuts.gbr, edu-ciaa-nxp-F_Cu.gtl, edu-ciaa-nxp-F_Mask.gts, edu-ciaa-nxp-F_Paste.gtp]
2015-03-17 ,lst actualizado
    [ON_BOARD_IO.sch, cpu.sch, edu-ciaa-bom_x100_v2.2.ods, edu-ciaa-nxp.sch, fuente.sch, gpio.sch, rsS485_can.sch, usb.sch]
2015-03-18 Agrego el BOM en formato .csv. Uno generado con Kicad y otro con script Perl.
    [edu-ciaa-nxp-BoM.csv, edu-ciaa-nxp.csv]
2015-03-21 Footprint de D4, D5, D10, X2 y X3 modificados para adaptar a los componentes del BoM. Silkscreen de BT1 modificado para ser mas clara la colocación de la batería
    [edu-ciaa-nxp.kicad_pcb]
2015-03-25 #50 SDRAM replaced, close #50.
    [analog.sch, analog_out.sch, ciaa-nxp-bom.ods, ciaa-nxp-bom.xls, ciaa-nxp.kicad_pcb, ciaa-nxp.sch, cpu.sch, din.sch]
2015-03-25 * Regenerados el Doc/edu-ciaa-nxp-BoM.csv, edu-ciaa-nxp.lst y Doc/edu-ciaa-nxp.csv
    [edu-ciaa-nxp-BoM.csv, edu-ciaa-nxp.csv]
2015-03-25 * Agregados permisos de ejecuci�n para el script perl que genera el BOM agrupado de la CIAA-FSL y la EDU-CIAA-NXP (PCB/FSL/kicad_scripts/bom_opt.pl).
2015-03-25 * Agregado Hardware/PCB/EDU-NXP/Doc/actualizacion_manual_archivos.txt con el listado de archivos que se deben actualizar para mantener la informaci�n consistente en el git y en la web/wiki.
2015-03-25 Gerbers actualizados
    [ON_BOARD_IO.sch, cpu.sch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]
2015-03-26 Cambió el footprint del D11
    [ON_BOARD_IO.sch, cpu.sch, edu-ciaa-nxp.sch, fuente.sch, gpio.sch, rsS485_can.sch, usb.sch]
2015-03-27 BoM revisado y modificado
    [edu-ciaa-bom_x100_v2.2.ods, edu-ciaa-bom_x100_v2.4.ods]
2015-03-31 new file: PCB/EDU-NXP/.gitignore
2015-03-31 modified: PCB/EDU-NXP/edu-ciaa-nxp.sch. Some new text added in the main schematic (sheet 1), full title, some links, and version updated to 1.1.
    [edu-ciaa-nxp.sch]
2015-03-31 modified: PCB/EDU-NXP/rsS485_can.sch. Errors in text about jumpers JP1,2,4 -> now JP2,3,4. Clarification about resistor values. Clarification about fig 27. Some changes in the label.
    [rsS485_can.sch]
2015-03-31 modified: PCB/EDU-NXP/usb.sch Clarifications on subcircuits an lines. Changes in the label.
    [usb.sch]
2015-03-31 modified: PCB/EDU-NXP/gpio.sch. Minor changes.
    [gpio.sch]
2015-04-04 Actualizado archivo del pinout (EDU_CIAA_Pinout_Rev_1.0.ods)
    [CIAA_KIDS_Pinouts_Rev_0.0.ods, EDU_CIAA_Pinout_Rev_1.0.ods]
2015-04-17 Added design files for EDU-CIAA-INTEL
    [cpu.sch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]
2015-04-17 PCB silkscreen renamed to EDU-CIAA-INTEL
    [edk-B_Cu.gbr, edk-B_Mask.gbr, edk-B_SilkS.gbr, edk-Edge_Cuts.gbr, edk-F_Cu.gbr, edk-F_Mask.gbr, edk-F_SilkS.gbr, edk.drl]
2015-04-20 EDU-CIAA-INTEL: replaced terminal block for DC barrel jack connector
    [edk.kicad_pcb, power.sch]
2015-04-20 EDU-CIAA-INTEL: gerbers generated
    [edk-B_Cu.gbr, edk-B_Mask.gbr, edk-B_SilkS.gbr, edk-Edge_Cuts.gbr, edk-F_Cu.gbr, edk-F_Mask.gbr, edk-F_SilkS.gbr, edk.drl]
2015-04-22 EDU-CIAA-INTEL v1.3: gpio can be enabled permanently via GS4
    [cpu.sch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]
2015-04-23 #52 added descriptive text for pcb jumpers
    [edk-B_Cu.gbr, edk-B_Mask.gbr, edk-B_SilkS.gbr, edk-Edge_Cuts.gbr, edk-F_Cu.gbr, edk-F_Mask.gbr, edk-F_SilkS.gbr, edk.drl]
2015-04-23 Added script and .csv used for K60 schematic component (CIAA-FSL).
    [MK60FX512VLQ15.csv]
2015-04-28 #52 C18 moved to TOP
    [edk.kicad_pcb]
2015-05-10 Modificaciones al esquemático: Se agregaron lineas de Ethernet en el conector Se modificaron algunos pines de IO para compatibilidad con la CIAA-FSL
    [EDU_CIAA_K60.sch, JTAG.sch, cpu.sch, fuente.sch, gpio.sch, on_board_io.sch, rsS485.sch, usb_otg.sch]
2015-05-11 #54 CIAA-NXP flash qSPI memory part updated in schematic and BOM. No need to change PCB.
    [analog.sch, analog_out.sch, ciaa-nxp-bom.ods, ciaa-nxp-bom.xls, ciaa-nxp.sch, cpu.sch, din.sch, dout.sch]
2015-05-21 Modificaciones de las salidas ETH_RST y ETH_RXER para mantener compatibilidad con la EDU_CIAA_NXP
    [EDU_CIAA_K60.sch, JTAG.sch, cpu.sch, fuente.sch, gpio.sch, on_board_io.sch, rsS485.sch, usb_otg.sch]
2015-05-21 Completado el último commit
    [cpu.sch]
2015-05-22 Footprint del PCB
    [edu-ciaa-nxp.kicad_pcb]
2015-05-22 Componentes reordenados en el PCB listo para rutear
    [EDU_CIAA_K60.kicad_pcb]
2015-05-26 Gerbers modificados (Se modificó footprint de LED1)
    [edu-ciaa-nxp-B_Cu.gbl, edu-ciaa-nxp-B_Mask.gbs, edu-ciaa-nxp-B_Paste.gbp, edu-ciaa-nxp-B_SilkS.gbo, edu-ciaa-nxp-Edge_Cuts.gbr, edu-ciaa-nxp-F_Cu.gtl, edu-ciaa-nxp-F_Mask.gts, edu-ciaa-nxp-F_Paste.gtp]
2015-06-19 Cambio del cristal del microcontrolador
    [EDU_CIAA_K60.sch, JTAG.sch, cpu.sch, fuente.sch, gpio.sch, on_board_io.sch, rsS485.sch, usb_otg.sch]
2015-06-23 Se actualizaron los numeros de parte de todos los inductores
    [EDU_CIAA_K60.kicad_pcb, EDU_CIAA_K60.sch, JTAG.sch, cpu.sch, fuente.sch, gpio.sch, on_board_io.sch, rsS485.sch]
2015-06-23 Limpieza de archivos innecesarios PCB V0.0
    [EDU_CIAA_K60.kicad_pcb, EDU_CIAA_K60.sch, JTAG.sch, cpu.sch, fuente.sch, gpio.sch, on_board_io.sch, rsS485.sch]
2015-07-01 ciaa-nxp: added component position files for pcb
2015-07-05 Modificados los pines de las teclas
    [EDU_CIAA_K60.kicad_pcb, EDU_CIAA_K60.sch, JTAG.sch, cpu.sch, fuente.sch, gpio.sch, on_board_io.sch, rsS485.sch]
2015-07-16 #60 BOM updated, still need to be tested
    [ciaa-nxp-bom.ods, ciaa-nxp-bom.xls]
2015-07-27 Schematic.pdf de la EDU-CIAA corregido
2015-09-11 CIAA PIC footprints done
    [analog.sch, analog_out.sch, ciaa-pic.kicad_pcb, ciaa-pic.sch, cpu.sch, din.sch, dout.sch, ethernet.sch]
2015-09-19 updated list of components in EDU-CIAA-FSL
    [EDU_CIAA_K60.sch, JTAG.sch, cpu.sch, fuente.sch, gpio.sch, on_board_io.sch, rsS485.sch, usb_otg.sch]
2015-09-26 Nueva versión 1.2 de la EDU-CIAA-NXP
    [ON_BOARD_IO.sch, cpu.sch, edu-ciaa-bom_x100_v2.4.ods, edu-ciaa-bom_x100_v2.5.ods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]
2015-10-01 Documento de modificaciones de v1.2
2015-10-04 EDU-CIAA-FSL V0.0 actualización del PCB
    [EDU_CIAA_K60.kicad_pcb, EDU_CIAA_K60.sch, JTAG.sch, ON_BOARD_IO.sch, cpu.sch, edu-ciaa-nxp.sch, fuente.sch, gpio.sch]
2015-10-05 Esquemático EDU-CIAA-FSL corregido
    [EDU_CIAA_K60.csv, EDU_CIAA_K60.sch, JTAG.sch, ON_BOARD_IO.sch, cpu.sch, edu-ciaa-nxp.sch, fuente.sch, gpio.sch]
2015-10-10 Actualización y reordenamiento de los directorios de la EDU-CIAA-FSL
    [CIAA_K60-BoM.csv, EDU_CIAA_K60.csv, EDU_CIAA_K60.sch, JTAG.sch, cpu.sch, fuente.sch, gpio.sch, on_board_io.sch]
2015-10-19 Elimino .pro en directorio de footprints.
2015-11-11 Esquematicos y BOM de la Edu-Ciaa-Xilinx
    [EduCiaaX.ods]
2015-11-12 Proyecto Kicad y documentacion del proyecto edu-ciaa-xilinx
    [7_Series_Schematic_Review_Recommendations_xart_040714.xls, 7_Series_Schematic_Review_Recommendations_xart_040714_Artix7_35T.xls, Bank14.sch, Bank15.sch, Bank35.sch, EduCiaaX.csv, EduCiaaX.sch, EduCiaaX.xls]
2015-11-17 Conexion Puerto Serie-FPGA
    [Bank14.sch, EduCiaaX.ods, EduCiaaX.sch]
2015-12-11 Agregado de encapsulados a la planilla
    [EduCiaaX.ods]
2016-05-02 [ciaa-nxp] schematic layout fixed for newer versions of kicad
    [analog.sch, analog_out.sch, ciaa-nxp.sch, cpu.sch, din.sch, dout.sch, ethernet.sch, fuente.sch]
2016-05-29 Added CIAA-FSL footprints in the new .kicad_mod format.
2016-05-29 Moving footprints/packages3d/ to footprints.3dshapes for better organization.
2016-05-29 Fixing 3d view using in path. Was broken for a modern KiCad.
    [CIAA_K60.kicad_pcb]
2016-06-01 Agrego esquemáticos CIAA-FSL-MINI basados en la CIAA-FSL.
    [CIAA_FSL_MINI.sch, JTAG.sch, analog.sch, analog_out.sch, cpu.sch, din.sch, dout.sch, ethernet.sch]
2016-06-02 Primer recorte realizado con Esteban Volentini <evolentini@gmail.com>.
    [CIAA_FSL_MINI.sch, JTAG.sch, analog.sch, analog_out.sch, cpu.sch, din.sch, dout.sch, ethernet.sch]
2016-06-02 Added temporal connectors to avoid ERC.
    [CIAA_FSL_MINI.sch, cpu.sch, ethernet.sch, fuente.sch, memories.sch, usb_otg.sch]
2016-06-02 Added some footprints.
2016-06-02 Footprint information in schematics.
    [CIAA_FSL_MINI.sch, cpu.sch, ethernet.sch, fuente.sch, memories.sch, usb_otg.sch]
2016-06-02 Added .kicad_pcb
    [CIAA_FSL_MINI.kicad_pcb]
2016-06-02 3d view in .kicad_pcb
    [CIAA_FSL_MINI.kicad_pcb]
2016-06-02 adding schematic Ciaa Safety
    [CAN.sch, CIAA_Safety_VTI_1.0.kicad_pcb, CIAA_Safety_VTI_1.0.sch, ETHERNET.sch, MEM_FLASH_SPI.sch, RM48L952.sch, USB.sch]
2016-06-02 add Label
    [CAN.sch, CIAA_Safety_VTI_1.0.sch, ETHERNET.sch, MEM_FLASH_SPI.sch, RM48L952.sch]
2016-06-03 3dview fix.
    [CIAA_Safety_VTI_1.0.kicad_pcb]
2016-06-06 Adding pdf with board dimensions.
2016-06-07 Sch files adapted to new eeschema. Fixing some text locations.
    [CIAA_K60.sch, JTAG.sch, analog.sch, analog_out.sch, cpu.sch, din.sch, dout.sch, ethernet.sch]
2016-06-07 Renaming symbol field-names in .sch files for KiCost integration.
    [CIAA_K60.sch, JTAG.sch, analog.sch, analog_out.sch, cpu.sch, din.sch, dout.sch, ethernet.sch]
2016-06-07 Adding KiCost spreadsheet for CIAA-FSL.
    [CIAA_K60_KiCost.xlsx]
2016-06-08 Agregada hoja con conectores de entradas/salidas. Las pineras reemplazan a las del commit anterior. Ambas pineras poseen las mismas líneas asignadas que las pineras eliminidas, pero sin respetar la m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
    [CIAA_FSL_MINI.sch, IO.sch, cpu.sch, ethernet.sch, fuente.sch, memories.sch, usb_otg.sch]
2016-06-15 Add schematic and PCB component for Arduino UNO shield. The libraries downloaded from http://meta-blog.eklablog.com/kicad-librairie-arduino-pretty-p930786. Add jumper selector between Arduino VrefH o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
    [CIAA_FSL_MINI.kicad_pcb, CIAA_FSL_MINI.sch, IO.sch, cpu.sch, ethernet.sch, fuente.sch, memories.sch, usb_otg.sch]
2016-06-23 Correción de lineas entre micro y Arduino. Eliminado TXB0108. Pinera arduino será solo 3v3 compatible. I2C1 del micro asignado a I2C de Arduino. Pines I2C de Arduino quedan imposibilitadas como entra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
    [CIAA_FSL_MINI.sch, IO.sch, cpu.sch]
2016-06-25 Terminated proposal pin assignment to expansion connector. Correction pinout of general purpose connectors. Correction of CON5v y CONBAT signals.
    [CIAA_FSL_MINI.sch, IO.sch, cpu.sch]
2016-06-29 picoCIAA v1.0
    [cpu.sch, debugger.sch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]
2016-07-07 Swap ethernet schematic sheet for CIAA NXP ethernet sheet. Preliminary schematic finished. Add notas.txt file.
    [CIAA_FSL_MINI.kicad_pcb, CIAA_FSL_MINI.sch, IO.sch, cpu.sch, ethernet.sch, fuente.sch, memories.sch, usb_otg.sch]
2016-07-14 3 fiducials marks deleted. Relocate and rename 3d shapes folder. PCB routing...
    [CIAA_FSL_MINI.kicad_pcb, CIAA_FSL_MINI.sch]
2016-07-17 Correcciones al esquematico segun rev01
    [Asignacion pines CIAA-PIC.ods, JTAG.sch, analog.sch, analog_out.sch, ciaa-pic.kicad_pcb, ciaa-pic.sch, cpu.sch, din.sch]
2016-07-18 Esquemático y primer placement de la CIAA-ACC.
    [BANKS_HP.sch, BANKS_HR.sch, BANK_0.sch, BANK_112.sch, BANK_500.sch, BANK_501.sch, BANK_502.sch, Digital_IO.sch]
2016-07-18 Documentation Update
    [EDU_CIAA_K60.sch, JTAG.sch, cpu.sch, fuente.sch, gpio.sch, on_board_io.sch, rsS485.sch, usb_otg.sch]
2016-07-18 Update File CHANGES.TXT in EDU-CIAA-FSL
    [FMC-POWER.sch, FPGA-POWER.sch]
2016-07-19 Schematics updated according to the review.
    [EDU_CIAA_K60.csv, EDU_CIAA_K60.sch, JTAG.sch, cpu.sch, fuente.sch, gpio.sch, on_board_io.sch, rsS485.sch]
2016-07-21 EDU CIAA FSL accommodated libraries
    [EDU_CIAA_K60.kicad_pcb, EDU_CIAA_K60.sch, fuente.sch]
2016-07-23 rev02, enumeracion componentes JTAG
    [JTAG.sch, analog_out.sch, cpu.sch, fuente.sch, gpio.sch, mem.sch]
2016-07-24 elimino conector salida reles
    [JTAG.sch, analog.sch, analog_out.sch, ciaa-pic.sch, cpu.sch, din.sch, dout.sch, ethernet.sch]
2016-08-07 rev02 aignacion footprint
    [JTAG.sch, analog.sch, ciaa-pic.sch, cpu.sch, din.sch, dout.sch, fuente.sch, gpio.sch]
2016-08-07 rev02 CIAA-PIC
    [din.sch, mem.sch]
2016-08-08 rev.02 CIAA-PIC
    [din.sch, dout.sch, gpio.sch, mem.sch, rsS485_rs232_can.sch]
2016-08-11 rev02 se completa campo num. de frabicante(#manf) CIAA-PIC
    [JTAG.sch, analog.sch, analog_out.sch, ciaa-pic.sch, cpu.sch, dout.sch, ethernet.sch, fuente.sch]
2016-08-16 rev02 se completa campo num. de frabicante(manf#) CIAA-PIC
    [JTAG.sch, analog.sch, analog_out.sch, cpu.sch, din.sch, dout.sch, ethernet.sch, fuente.sch]
2016-08-22 se completa campo num. de frabicante(manf#) CIAA-PIC
    [JTAG.sch, analog.sch, analog_out.sch, cpu.sch, din.sch, dout.sch, ethernet.sch, fuente.sch]
2016-08-23 se completa campo num. de frabicante(manf#) CIAA-PIC, correccion indice
    [JTAG.sch, analog.sch, ciaa-pic.sch, cpu.sch, rsS485_rs232_can.sch]
2016-08-23 se completan pisadas componentes CIAA-PIC
    [JTAG.sch, analog.sch, analog_out.sch, cpu.sch, ethernet.sch, fuente.sch, gpio.sch, mem.sch]
2016-08-24 BOM File CIAA-PIC
    [JTAG.sch, analog.sch, analog_out.sch, ciaa-pic_BOM.xlsx, cpu.sch, rsS485_rs232_can.sch, usb_otg.sch]
2016-08-27 Added Phy ethernet PCB routing application note. Added 3D shape of auxiliar connector. Deleted DIN4-7 lines. Found and corrected pagination error in eesquema.
    [CIAA_FSL_MINI.kicad_pcb, CIAA_FSL_MINI.sch, IO.sch, cpu.sch, ethernet.sch]
2016-08-29 cambio reles salida digital CIAA-PIC
    [ciaa-pic_BOM.xlsx, dout.sch]
2016-08-30 correccion masa rj45 CIAA-PIC
    [JTAG.sch, analog.sch, analog_out.sch, ciaa-pic.sch, cpu.sch, din.sch, dout.sch, ethernet.sch]
2016-09-03 Change SPI port for extern connector.
    [CIAA_FSL_MINI.kicad_pcb, CIAA_FSL_MINI.sch, IO.sch, cpu.sch]
2016-09-04 correccion cristal FTDI,Moedlo RJ45 CIAA-PIC
    [JTAG.sch, analog.sch, analog_out.sch, ciaa-pic.sch, ciaa-pic_BOM.xlsx, cpu.sch, din.sch, dout.sch]
2016-09-04 completo BOM y pisadas
    [analog_out.sch, dout.sch]
2016-09-05 cambio en plano de masa eth - CIAA-PIC
    [JTAG.sch, analog.sch, analog_out.sch, ciaa-pic.kicad_pcb, cpu.sch, din.sch, dout.sch, ethernet.sch]
2016-09-05 correcciones pcb
    [ciaa-pic.kicad_pcb]
2016-09-06 Asignación de entradas del ADC, específicas para el conector de expansión.
    [CIAA_FSL_MINI.kicad_pcb, CIAA_FSL_MINI.sch, IO.sch, cpu.sch]
2016-09-06 correccion pcb
    [JTAG.sch, analog.sch, analog_out.sch, ciaa-pic.kicad_pcb, cpu.sch, din.sch, dout.sch, ethernet.sch]
2016-09-08 Asignación de salidas PWM, exclusivas para el conector de expansión. Asignación de linea GPIO, exclusiva para el conector de expansión.
    [CIAA_FSL_MINI.kicad_pcb, CIAA_FSL_MINI.sch, IO.sch, cpu.sch, ethernet.sch, fuente.sch, memories.sch, usb_otg.sch]
2016-09-13 correcion pcb
    [ciaa-pic.kicad_pcb, cpu.sch]
2016-09-15 correccion pcb, stackup
    [ciaa-pic.kicad_pcb]
2016-09-17 Cambio en fuente de pullup de LED2 del phy ethernet según recomendación de hoja de datos.
    [CIAA_FSL_MINI.kicad_pcb, ethernet.sch]
2016-09-24 Cambio de capa VCC por GND, respetando requerimiento del stack de capas para ethernet, según nota de aplicación.
    [CIAA_FSL_MINI.kicad_pcb]
2016-09-29 Agregadas notas de aplicación.
    [CIAA_FSL_MINI.kicad_pcb, ethernet.sch]
2016-10-11 Fin de la primer versión del ruteo. Se generaron los Gerbers en la carpeta output_files.
    [BANKS_HP.sch, BANKS_HR.sch, BANK_0.sch, BANK_112.sch, BANK_500.sch, BANK_501.sch, BANK_502.sch, Digital_IO.sch]
2016-10-12 docs
    Agrego el archivo con la descripción de la licencia y el archivo
    CHANGES.txt.
2016-10-14 [CIAA-ACC] Edité los rótulos del sch.
    [BANKS_HP.sch, BANKS_HR.sch, BANK_0.sch, BANK_112.sch, BANK_500.sch, BANK_501.sch, BANK_502.sch, Digital_IO.sch]
2016-10-14 Elimino archivos con problemas.
    [FMC-POWER.sch, FMC-Power.sch, FPGA-POWER.sch, FPGA-Power.sch]
2016-10-14 [CIAA-ACC] Vuelvo a subir FMC-Power.sch y FPGA-Power.sch.
    [FMC-Power.sch, FPGA-Power.sch]
2016-10-17 Se cambió el conector de alimentación por uno de 10A.
    [BANKS_HP.sch, BANKS_HR.sch, BANK_0.sch, BANK_112.sch, BANK_500.sch, BANK_501.sch, BANK_502.sch, Digital_IO.sch]
2016-10-17 Footprint y librería 3D del conector de alimentación.
2016-10-17 Trabajando en el cálculo de las lineas diferenciales ethernet.
2016-10-18 FSL-NUCLEO: new footprint for ETH oscillator. Must replace old one.
2016-10-19 Agregado nuevo archivo de info a pcb.
2016-10-19 [CIAA-ACC] Added v1.1 pdf file. Added titles on schematics sheets.
    [BANKS_HP.sch, BANKS_HR.sch, BANK_0.sch, BANK_112.sch, BANK_500.sch, BANK_501.sch, BANK_502.sch, Digital_IO.sch]
2016-10-20 Haciendo nota sobre cálculo de impedancias de lineas diferenciales.
2016-10-21 [CIAA-ACC] Added INTI logo on sch and pcb. Added version, date and stackup on pcb.
    [ciaa_acc.sch]
2016-10-25 Se generaron los gerbers con el logo de INTI.
    [ciaa_acc-B.Mask.gbr, ciaa_acc-B.Paste.gbr, ciaa_acc-B.SilkS.gbr, ciaa_acc-Bot.Sig.gbr, ciaa_acc-Edge.Cuts.gbr, ciaa_acc-F.Mask.gbr, ciaa_acc-F.Paste.gbr, ciaa_acc-F.SilkS.gbr]
2016-10-27 [CIAA-ACC] Added doc files and BOM.
    [BOM_ciaa_acc_v1.1.xlsx, costos.xlsx, stackup.xlsx]
2016-10-31 [CIAA-ACC] XADC block removed from block diagram (ADC lines were not routed because lack of space on the .PCB).
    [ciaa_acc.sch]
2016-11-05 Making notes of impedance calculation of differential pcb paths.
2016-11-08 Ethernet differential pair paths routed.
    [CIAA_FSL_MINI.kicad_pcb]
2016-11-09 Routing ethernet paths.
    [CIAA_FSL_MINI.kicad_pcb]
2016-11-10 Add chassis ground plane attached to both board mounting and RJ45 shield holes.
    [CIAA_FSL_MINI.kicad_pcb, IO.sch, cpu.sch, ethernet.sch, fuente.sch, memories.sch, usb_otg.sch]
2016-11-12 Routed USB diferential pair paths.
    [CIAA_FSL_MINI.kicad_pcb, CIAA_FSL_MINI.sch, cpu.sch, ethernet.sch, usb_otg.sch]
2016-11-12 PCB tentative finish without principal connector routed.
    [CIAA_FSL_MINI.kicad_pcb]
2016-11-12 Corrected PCB outline.
    [CIAA_FSL_MINI.kicad_pcb]
2016-11-15 Principal connector pins redistributed.
    [CIAA_FSL_MINI.kicad_pcb, IO.sch]
2016-11-19 Ajustes EdgeCut
    Se acomodaron las coordenadas de las lineas de contorno para que
    coincidan los semi-circulos con las lineas rectas
    [edu-ciaa-nxp.kicad_pcb]
2016-11-19 Modelos 3D
    Ajuste de las referencias a los modelos 3D en los footprints. Se utilizo
    la ruta relativa "model ${KIPRJMOD}/footprints/EESTN5.3dshapes/"
    [edu-ciaa-nxp.kicad_pcb]
2016-11-19 Minnor path fixes in EDU-NXP 3D models.
    [edu-ciaa-nxp.kicad_pcb]
2016-11-19 Bornier 3 scale now fixed in EDU-NXP.
    [edu-ciaa-nxp.kicad_pcb]
2016-11-19 Added pushbuttons 3D models for EDU-NXP.
    [edu-ciaa-nxp.kicad_pcb]
2016-11-19 Added 0805 leds 3D models for EDU-NXP.
    [edu-ciaa-nxp.kicad_pcb]
2016-11-19 Added SOIC-8 3D for EDU-NXP.
    [edu-ciaa-nxp.kicad_pcb]
2016-11-19 Fixed 3d for battery holder.
    [edu-ciaa-nxp.kicad_pcb]
2016-11-20 3d models USB circuit for EDU-NXP.
    [edu-ciaa-nxp.kicad_pcb]
2016-11-20 Added debug and power connectors 3D models for EDU-NXP.
    [edu-ciaa-nxp.kicad_pcb]
2016-11-20 Added RGB led 3d model for EDU-NXP.
    [edu-ciaa-nxp.kicad_pcb]
2016-11-22 Routing ...
    [CIAA_FSL_MINI.kicad_pcb, CIAA_FSL_MINI.sch, IO.sch, cpu.sch, ethernet.sch, fuente.sch, memories.sch, usb_otg.sch]
2016-11-23 Error fixed in USB 3d model. EDU-NXP.
    [edu-ciaa-nxp.kicad_pcb]
2017-03-11 Modelos 3D y libreria de footprint
    Actualización de modelos 3D y de la libreria de footprint del proyecto.
    [edu-ciaa-nxp.kicad_pcb]
2017-04-03 Deleted kicad backup file.
2017-04-03 Deleted -rescue.lib from edu-nxp schematic.
2017-04-20 Modificación en esquemático del conector JTAG. Eliminación en esquemático y pcb del conector PoE.
    [CIAA_FSL_MINI.kicad_pcb, CIAA_FSL_MINI.sch, IO.sch, cpu.sch, ethernet.sch, fuente.sch, memories.sch, usb_otg.sch]
2017-05-04 Deleted CAN_STB signal. This was a dedicated signal to no-existent transceivers. Deleted GPIO_AN0-3 signals. Instead place PoE lines.
    [CIAA_FSL_MINI.kicad_pcb, CIAA_FSL_MINI.sch, IO.sch, cpu.sch]
2017-05-10 CIAA-ACC 1.1B version. Added layer number on every copper layer.
    [ciaa_acc-B.Mask.gbr, ciaa_acc-B.Paste.gbr, ciaa_acc-B.SilkS.gbr, ciaa_acc-Bot.Sig.gbr, ciaa_acc-Edge.Cuts.gbr, ciaa_acc-F.Mask.gbr, ciaa_acc-F.Paste.gbr, ciaa_acc-F.SilkS.gbr]
2017-05-16 Routing Finished.
    [CIAA_FSL_MINI.kicad_pcb]
2017-05-18 Edited several tracks and silkscreens.
    [CIAA_FSL_MINI.kicad_pcb]
2017-05-22 CIAA-ACC 1.1C version. Added fiducial points.
    [BANKS_HP.sch, BANKS_HR.sch, BANK_0.sch, BANK_112.sch, BANK_500.sch, BANK_501.sch, BANK_502.sch, Digital_IO.sch]
2017-05-22 Inserted UNLAM logo. Placed fiducial marks. Deleted 3.3v test points. Adding pinhead's pins names on silkscreen.
    [CIAA_FSL_MINI.kicad_pcb, fuente.sch]
2017-05-23 Adding pinhead's pins names on silkscreen.
    [CIAA_FSL_MINI.kicad_pcb]
2017-05-25 Inserted pinheads pins name on silkscreen. Changing expansion connector 3D shape.
    [CIAA_FSL_MINI.kicad_pcb]
2017-05-27 Adding 3D shape.
    [CIAA_FSL_MINI.kicad_pcb, IO.sch, cpu.sch, fuente.sch]
2017-05-27 3D shapes. Aligning principal connector with expansion connector.
    [CIAA_FSL_MINI.kicad_pcb]
2017-05-29 Align connectors.
    [CIAA_FSL_MINI.kicad_pcb]
2017-06-02 Added another stackup file because the valid impedance value for inner layers are in another file.
    [stackup.xlsx, stackup_inner_layers.xlsx, stackup_top_bottom.xlsx]
2017-06-16 Cambios en esquemático propuestos en el patch recibido el 26/5/17.
    [CIAA_FSL_MINI.sch, IO.sch, cpu.sch]
2017-06-16 CIAA-ACC V1.1D. Changes in solder mask and solder paste layers (requested by manufacturer).
    [ciaa_acc-B.Mask.gbr, ciaa_acc-B.Paste.gbr, ciaa_acc-B.SilkS.gbr, ciaa_acc-BOT_L12.Sig.gbr, ciaa_acc-Edge.Cuts.gbr, ciaa_acc-F.Mask.gbr, ciaa_acc-F.Paste.gbr, ciaa_acc-F.SilkS.gbr]
2017-06-19 Reassignment between expansion and principal connector pins.
    [CIAA_FSL_MINI.kicad_pcb, CIAA_FSL_MINI.sch, IO.sch, cpu.sch]
2017-06-22 Subí el stackup utilizado para fabricar la placa y los gerber que editó el fabricante.
    [ciaa_acc-b.mask.gbr, ciaa_acc-b.paste.gbr, ciaa_acc-b.silks.gbr, ciaa_acc-bot_l12.sig.gbr, ciaa_acc-f.mask.gbr, ciaa_acc-f.paste.gbr, ciaa_acc-f.silks.gbr, ciaa_acc-l10.sig.gbr]
2017-06-26 Revisando ruteado...
    [CIAA_FSL_MINI.kicad_pcb]
2017-06-27 Add GNDA shield zone in VCC layer, shielding analog signal in back layer. Correction of connector pin names on silkscreen .
    [CIAA_FSL_MINI.kicad_pcb]
2017-07-04 Working in copper areas.
    [CIAA_FSL_MINI.kicad_pcb, CIAA_FSL_MINI.sch]
2017-07-12 Add stack-up description.
    [CIAA_FSL_MINI.kicad_pcb]
2017-07-13 Add notes in PCB. Adding notes and reorganize sheets in schematic.
    [CIAA_FSL_MINI.kicad_pcb, CIAA_FSL_MINI.sch, IO.sch, ethernet.sch, fuente.sch]
2017-08-02 New version (-4) from Fusari,s Drive.
    [BUS_ISA.sch, CAN.sch, CIAA_Safety_VTI_1.0.kicad_pcb, CIAA_Safety_VTI_1.0.sch, CPU.sch, ETHERNET.sch, MEM_FLASH_SPI.sch, USB HOST - MEM SD.sch]
2017-08-02 Added doc files.
    [Part Number - Analisis de Costo.xlsx]
2017-08-17 Relocated some components. Adding RJ45 3D shape (https://github.com/s-light/CONN_RJ45_MagJack_POEp.3dshapes).
    [CIAA_FSL_MINI.kicad_pcb]
2017-12-08 add CIAA-Z3R0 design files and update license
    [bom_v0.1.xls, bom_v0.2.xls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]
2018-01-23 [CIAA-ACC] Added Hyperlynx simulation reports.
    [DDR_audit-ciaa_acc-.csv, DDR_report_Jedec_measurements_Typ.csv, DDR_report_address_allcases_Typ.csv, DDR_report_address_violations_Typ.csv, DDR_report_address_worstcases_Typ.csv, DDR_report_data_allcases_Typ.csv, DDR_report_data_violations_Typ.csv, DDR_report_data_worstcases_Typ.csv]
2018-01-26 [CIAA-ACC] Changes in component field names for using Kicost.
    [BANKS_HP.sch, BANKS_HR.sch, BANK_0.sch, BANK_112.sch, BANK_500.sch, BANK_501.sch, BANK_502.sch, Digital_IO.sch]
2018-02-26 CIAA-ACC: Changed details on schematic, just only notes. Updated schematic on pdf format.
    [Digital_IO.sch, PMIC.sch, ciaa_acc.sch]
2019-03-29 Subí esquemático V1.3, ver archivo doc/CHANGES.txt. Subí lista de materiales actualizada y pdf del esquemático actualizado.
    [BANKS_HP.sch, BANKS_HR.sch, BANK_0.sch, BANK_112.sch, BANK_500.sch, BANK_501.sch, BANK_502.sch, BOM_ciaa_acc_v1.3.xlsx]
2019-03-29 CIAA-ACC PCB V1.1F. See doc/CHANGES.txt.
    [ciaa_acc-B.Mask.gbr, ciaa_acc-B.Paste.gbr, ciaa_acc-B.SilkS.gbr, ciaa_acc-BOT_L12.Sig.gbr, ciaa_acc-Dwgs.User.gbr, ciaa_acc-Edge.Cuts.gbr, ciaa_acc-F.Mask.gbr, ciaa_acc-F.Paste.gbr]
2019-08-02 Added file with CIAA-ACC PCB "owners".
2019-08-28 Subí versión 1.4 del esquemático con corrección en una nota sobre JP4.
    [BANKS_HP.sch, BANKS_HR.sch, BANK_0.sch, BANK_112.sch, BANK_500.sch, BANK_501.sch, BANK_502.sch, Digital_IO.sch]
2019-09-02 Documented Zynq Marking code of the last 5 CIAA-ACC boards.
2019-09-19 Update PCB owners text file.
2019-10-21 Upload an interactive HTML BOM, very useful for finding components.
2019-10-25 Updated PCB owners file.
2020-02-26 Added Diego Fusari's last version. Changes in texts, title blocks and sheet names.
    [BUS_ISA.sch, CAN.sch, CIAA_Safety_VTI_1.0.kicad_pcb, CIAA_Safety_VTI_1.0.sch, CPU.sch, ETHERNET.sch, MEM_FLASH_SPI.sch, RM48L952.sch]
2020-03-30 Agrego directorio de modelos 3D intentando reconstruir los modelos originales que no estaban en el repo.
2020-03-30 Reparo contorno de pcb, cambio rutas de modelos 3D, ajusto modelos 3d de las borneras.
    [ciaa-nxp.kicad_pcb]
2020-05-07 EDU-FPGA Hardware added
    [BOM.ods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]
2020-09-16 Update in BOM.ods of EDU-CIAA-FPGA: Pushbuttons Part Number
    [BOM.ods]
