ciaa/Hardware/(notices)

Notices in the files:
PCB/ACC/CIAA_ACC/Digital_IO.sch:
Authors: See 'doc/CHANGES.txt' file. License: See 'doc/LICENCIA_CIAA_ACC.txt' file.
